DD1SB/ARDF-TX/hardware/2m/review/M5B-E6R2/README.md

# RF2M M5B-E6R2 evaluation review

**GO for five bare evaluation PCBs.** Independent engineering review reported
no concrete blocker for that evaluation scope. Physical RF, thermal and
operational qualification remains **NOT_RUN**. No boards or stencils have been
ordered and no hardware energized. No acceptance tag or production release.

The implementation is published as commit
[`2fff321`](https://github.com/DD1SB/ARDF-TX/commit/2fff32131dd0f7da3c46fef47c04713a55df89d8).
See the [final reproduction/publication record](../../../../docs/M5B_E6R2_FINAL_PUBLICATION.md)
for the fresh verification run and publication scope. Existing implementation
logs and gate records retain their original execution-time provenance.

- [Decision](../../../../docs/M5B_E6R2_REVIEW_DECISION.md),[implementation](../../../../docs/M5B_E6R2_IMPLEMENTATION.md),[first article](../../../../docs/M5B_E6R2_FIRST_ARTICLE_TEST.md).
- [Native project](../../RF2M.kicad_pro),[native snapshot](RF2M-M5B-E6R2-native.zip),[schematic PDF](RF2M.pdf),[netlist](RF2M.net.xml).
- [Fabrication ZIP](fabrication/RF2M-M5B-E6R2_JLCPCB_5boards.zip),[full top stencil](fabrication/RF2M-M5B-E6R2_FULL_TOP_STENCIL.zip),[manufacturing](../../../../docs/M5B_E6R2_MANUFACTURING.md).
- [ERC](ERC.json),[DRC](DRC.rpt),[DFM](JLCPCB-DFM.json),[electrical/native results](verification.json),[final gate record](final-review.json).
- [Complete native3D](RF2M-3D.png),[top](RF2M-3D-top.png),[bottom](RF2M-3D-bottom.png),[mechanical drawings/STEP](mechanical/).
- Population BOMs: [BUCK4S](BOM_BUCK4S.csv),[BOOST2S](BOM_BOOST2S.csv),[TRAIN_ONLY](BOM_TRAIN_ONLY.csv),[shared cooler](shared-heatsink-BOM.csv),[costs](costs.json).
- [Package audit](COMPONENT_FOOTPRINT_AUDIT.md),[simulation](simulation-results.json),[source regressions](source-assembly-regression.json),[ground graph](ground-contact-audit.json).
- [Executed final report](FINAL_REPRODUCTION.md), [reproduce](REPRODUCE.md), [fresh CAM comparison](final-reproduction.json), [repeat ZIP comparison](archive-repack-comparison.json), [SHA256 inventory](SHA256SUMS).

Historical E5/E6/E6R1 evidence is immutable. `baseline-E5-native.zip` captures
starting native sources. Development drafts/failures are retained for audit;
**development/** is not manufacturing data. In particular,the initial mirrored
BD139 draft is deliberately rejected. Use only the final fabrication directory.

The complete new cooling geometry is dimensioned. Upper controller/carrier
views retain the historical study transform and are identified reference
envelopes,not a newly qualified housing. Package plastic/fin details are
simplifications; mounting planes,formed leads,hardware and cutouts are explicit.
