DD1SB/ARDF-TX/hardware/controller/review/M6-L2/README.md

# M6-L2 controller engineering candidate

The authoritative editable design is [CTRL.kicad_pro](../../CTRL.kicad_pro), [root schematic](../../CTRL.kicad_sch), [PCB](../../CTRL.kicad_pcb), its referenced sheets, [symbol library](../../ARDF_CTL.kicad_sym) and [footprint library](../../ARDF_CTL.pretty/). This is a focused revision of the independently reviewed [M6-L1 baseline](../M6-L1/README.md), not a controller architecture replacement. RF80, RF2M and historical reviews are unchanged.

Start with the [engineering GO/HOLD decision](../../../../docs/M6_L2_REVIEW_DECISION.md), [electrical change report](ELECTRICAL-CHANGES.md) and [reproduction commands](REPRODUCE.md). All physical qualification is NOT_RUN. Nothing here constitutes a supplier upload, purchase, manufacturing order, production release or acceptance tag.

| Review subject | Evidence |
|---|---|
| Exact ESP32 identity, all 40 contacts and exposed pad | [Module review](../../../../docs/M6_L2_ESP32_MODULE.md), [manufacturer pin matrix](ESP32-manufacturer-pin-matrix.json), [separate manufacturer DXF comparison](ESP32-footprint-DXF-audit.json) |
| External antenna access, coax routing and conditional RF-board installation | [Mechanical drawing](antenna-mechanical-review.svg), [native anchors and clearances](mechanical-interface.json), [module/mechanical discussion](../../../../docs/M6_L2_ESP32_MODULE.md) |
| Original FoxPro2 references and independently written protocol | [Protocol specification](../../../../docs/M6_L2_FOXPRO2_PROTOCOL.md), [reference URLs/hashes and rights](source-register.json), [third-party notices](../../../../THIRD_PARTY_NOTICES.md) |
| FoxPro connector, analog decision and UART selection | [Hardware review](../../../../docs/M6_L2_FOXPRO2_HARDWARE.md), [TRS cable continuity drawing](FoxPro-TRS-continuity.svg), [native schematic PDF](CTRL-M6-L2.pdf) |
| Electrical fault/logic/current bounds | [Actual resistor-derived calculations](FoxPro-GPIO-electrical-calculations.json), [routed bus/power scenarios](L2-bus-power-layout-calculations.json), [actual connected ground network](native-ground-connectivity.json) |
| Eight-line expansion and strap limitations | [GPIO review](../../../../docs/M6_L2_GPIO_EXPANSION.md), [complete actual MCU allocation](GPIO-allocation.csv), [GPIO45 access limitation](GPIO45-access-limitation.json) |
| Component identities, package terminals and lands | [Native component audit](new-component-footprint-audit.json), [independent critical-map/mutation audit](L2-native-negative-regression.json), [historical pad/copper comparison](L1-L2-change-audit.json) |
| Population and costs | [All-parts BOM](BOM-all.csv), [reference delta](BOM-delta.csv), [48 populations](population-variants.json), [stock/MOQ observations](sourcing-index.json), [quantity costs](costs.json), [MOQ purchase rounding](MOQ-purchase-model.csv), [manufacturing review](../../../../docs/M6_L2_MANUFACTURING.md) |
| Protocol encoder/decoder and timed peer | [C11 core](../../../../firmware/controller_hw/foxpro2.c), [transport](../../../../firmware/controller_hw/foxpro2_transport.c), [independent simulator/tests](../../../../firmware/controller_hw/test_foxpro2.py), [coverage and limits](TEST-COVERAGE.md), [actual host logs](host-test-results.json) |
| Original protection and RF regressions | [Electrical](electrical-regression.json), [protection](protection-regression.json), [USB](USB-ESD-review.json), [RF80](RF80-protocol-regression.json), [RF2M](RF2M-protocol-regression.json), [frozen RF/historical files](frozen-files.json) |
| KiCad checks and standard manufacturing | [CAD counts](CAD-results.json), [ERC](ERC.json), [DRC](DRC.json), [readable DRC](DRC.rpt), [exported connectivity](CTRL.net.xml), [DFM](JLCPCB-DFM.json), [DFM mutations](DFM-regression.json), [standard fabrication profile](JLCPCB-standard-profile.json) |
| Fresh schematic and board views | [Schematic PDF](CTRL-M6-L2.pdf), [top](PCB-top.svg), [mirrored bottom](PCB-bottom.svg), [assembly top](assembly-top.pdf), [mirrored assembly bottom](assembly-bottom.pdf) |
| Real native 3D views | [Base isometric](assembly-3D-isometric.png), [top](assembly-3D-top.png), [bottom](assembly-3D-bottom.png), [both options and LoRa](assembly-3D-BOTH-top.png), [both options underside](assembly-3D-BOTH-bottom.png) |
| Fabrication and stencil | [Gerbers and separate PTH/NPTH drills](fabrication/), [five bare-board ZIP](ARDF_TX_CTRL_M6-L2_JLCPCB_5pcs_BARE.zip), [full top stencil ZIP](ARDF_TX_CTRL_M6-L2_FULL_TOP_STENCIL.zip), [package contents/hashes](fabrication-package-audit.json), [actual export geometry/hole/paste checks](fabrication-geometry-audit.json), [settings](FABRICATION-INSTRUCTIONS.txt) |
| Reproducibility and integrity | [Commands](REPRODUCE.md), [SHA-256 list](SHA256SUMS), [review/source inventory](inventory.json), [compatibility contract](../../../../docs/M6_L2_COMPATIBILITY.md) |

Each `BOM-<RF>__<LoRa>__<option>.csv` and corresponding placement CSV is a specific population. BASE/GPIO retain recovery R300/R301; FOXPRO/BOTH replace them with R302/R303. The open service links are never fitted in standard builds. A no-LoRa/no-FoxPro/no-GPIO build remains valid. FoxPro battery voltage is unavailable for both 2S and 4S; it is not a calibrated voltage-reading mode.

The manufacturer STEP is retrieved into a local reference cache for rendering, not redistributed as MIT material. Existing connector/RTC dimension-only envelopes retain their qualifications. Conditional spacing in the mechanical review is an installation constraint, not measured fit or RF coexistence evidence. Physical qualification of assembled controllers, genuine FoxPro2, antennas, accessories, protection faults, power sequencing and RF/thermal integration is Gate G and remains NOT_RUN.
