DD1SB/ARDF-TX/hardware/2m/review/M5B-E5/README.md

# RF2M M5B-E5 review candidate

**GO for independent evaluation-board review.** Active native authority: `hardware/2m/RF2M.kicad_pcb`. Baseline E4R1 `2f9982c1b72cd97ba4dad6c992143032b309cca7` is archived. This package is for independent engineering review, not manufacturing release.

Read the six `docs/M5B_E5_*.md` reports, review-gates.json, current ERC/DRC/DFM, compact-engineering.json, thermal-model.json and dimensioned mechanical views. `development/` holds intermediate placement/routing analysis and is not a fabrication dataset. The revisioned fabrication ZIP is distinct from native source and stencil archives. Historical controller, RF80 and E4R1 packages are unchanged. All physical tests are NOT_RUN.
