DD1SB/ARDF-TX/hardware/2m/review/M5A-R0/README.md

# M5A-R0 review package

**Electrical candidate only. Not a PCB manufacturing package.**

- [Schematic PDF](RF2M.pdf), [XML netlist](RF2M.net.xml), [actual ERC report](erc.json).
- [Critical physical/function pin assertions](pinout-audit.json), [digital verification](verification.json), [preserved earlier-work hashes](preserved-baseline.json).
- [Itemized6/10/20 variant BOM](RF2M_BOM.csv), [all reference positions](RF2M_positions.csv), [cost classification/totals](costs.json).
- [Explicit power/RF assumptions and arithmetic](calculations.json), [pack/runtime rows](endurance.csv), [ideal behavioral-loop result](am-loop-result.json).
- [Engineering decision](../../../../docs/M5_2M_REVIEW_DECISION.md), [staged physical gates](../../../../docs/M5_2M_TEST_PLAN.md), [source/access log](../../../../docs/M5_2M_SOURCES.md).

The native project is two directories above. Package drawings/large-signal matching/hot SOA and real power/reset/isolation tests remain OPEN. Zero ERC and static logic tests do not demonstrate RF performance, safe analog startup or manufacturing readiness. The checksums generated by the finish script identify these review files, not a hardware release.
