DD1SB/ARDF-TX/hardware/2m/review/M5B-E4R1/stencil/README.md

Q501-onlyF.Paste exportedfromtheactualnativefootprint. Standard0.12mmframeless304stainless,laser-cut. Source5windows+G/Dpaste,nootherparts. NOTpartofbare-PCBfabricationZIP. Verifyalignment/depositsandqualifyprofile/firstjointbeforeenergy. Noorderauthorized.
