DD1SB/ARDF-TX/hardware/80m/review/M3B-E1/routing/README.md

# Local routing provenance

2026-10-14. Initial placement/constrained RF trees, ordinary ground fanout and local FreeRouting2.5.0 session. **Historical routing input**, preceding final KiCad via/clearance/package/metadata corrections. These do not replace the reviewed native PCB or current manufacturing exports. No design was uploaded.

Ground was ignored by the local router and subsequently filled/connected in native KiCad. Final native edits resolved minimum-width neckdowns, one Fox enable tree, ground islands, pin/footprint fields and silkscreen. Rerunning the initial placement is destructive to final routing and is not part of normal verification. See the current board and [review record](../../../../../docs/M3B_PCB_LAYOUT_REVIEW.md).
