DD1SB/ARDF-TX/hardware/2m/review/M5B-E6R2/development/pre-flat-pin-correction/README.md

# REJECTED DRAFT — DO NOT MANUFACTURE

The initial flat BD139 footprint mirrored the ST front-view lead order.
This snapshot is deliberately incorrect negative evidence,not a fabrication candidate.
Only the final review/fabrication directory contains the corrected E6R2 dataset.
The native negative test must reject this saved draft. No board was ordered or energized.
