DD1SB/ARDF-TX/hardware/2m/review/M5B-E5/development/source-evidence/README.md

Fresh native plots,translated coordinate frames E4R1vsE5. Colored mask is opening,not ink. Via automatic mask suppression is not guaranteed closure:one explicit opening exposes16holes. Analysis only,not fabrication data.
