DD1SB/ARDF-TX/hardware/2m/review/M5B-E4/development/evidence/README.md

# Native source-area comparison

E3 files are freshly plotted from the frozen E3 native board; E4 files are
freshly plotted from the active candidate. These are analysis views only.
Colored F.Mask regions are openings, and the white source squares are mask
islands. F.Paste shows the proposed stencil slots. SVG plotting can include
drill marks; the separate Gerber mask/paste layers are authoritative fabrication
artwork. Cropping changes the viewport only. No physical assembly is depicted.
