DD1SB/ARDF-TX/hardware/2m/review/M5B-E3/development/implementation/README.md

# Point-in-time layout implementation aids

Non-final development provenance. These scripts record intermediate E2-to-E3 edits and routing investigations; some intermediate trials were deliberately replaced. They are not a regeneration pipeline and must not be run against the finished board. The final native KiCad design and Git delta are authoritative. Routine checks use the active tools/m5b_e3.py workflow in the review README.
