DD1SB/ARDF-TX/docs/M5B_E5_THERMAL_MECHANICAL.md

# M5B-E5 thermal and mechanical review

The E4R1 source joint is retained: 16 intentionally open source vias + 20 side + 8 end + 54 wing = 98. Source copper is 2.7 × 5 mm, continuous mask opening 2.1 × 5 mm, five paste windows total 6.765 mm², local stainless stencil 0.12 mm. No mask islands, filled/capped vias, guaranteed tenting or solder-fill conduction credit. [Source geometry/assembly gate](../hardware/2m/review/M5B-E5/source-assembly-DFM.json) and the Gerber/drill region audit bind this to the final board. The preserved controlled print/reflow, first-article X-ray and thermal process still applies. Edge inspection cannot establish hidden wet area.

PA cooling retains the 15 × 44 × 10 mm bar and Fischer SK81 100 SA (100 × 100 × 15 mm). The square sink rotates in plane so its channels run along board X; bar/contact/mount coordinates do not change relative to Q501. Sink native bounds X42..142/Y20..120, bar X84.5..99.5/Y28..72; holes H5/H6 (92,32)/(92,68). Extrusion-local taps are (12,50)/(48,50) after rotation. Minimum SK81-to-OD9 corner washer clearance is 12.5 mm. Underside projection is 25.2 mm; lowest Z=−26.8 relative to RF top. No package pressure or mounting load through solder joints.

Same-boundary FVM predictions at 40°C/4 W remain approximately 91°C nominal, 122°C conservative and 138°C with poor joint/contact. The conservative 110°C target remains NOT_MET. The 125°C engineering limit is conditional and physically OPEN. Selected mesh 0.1→0.05 mm changes source-to-bar resistance about 0.021 K/W; the retained 1 K/W allowance is not a bound on physical assembly uncertainty. All 2/3/4/5 W, 25/40°C, barrel 10/15/18/25 µm, solder/TIM/contact and lost-via sensitivities are retained. Fin rotation adds an explicit +0.25 K/W (+1°C at 4 W) sensitivity, not an asserted measurement. A 5°C inlet rise adds 5°C; sink 4→6 K/W adds 8°C. A sealed warm box is unsupported.

The existing Fischer SK10075SA pass heatsink is retained, rotated in its mounting plane: 75 mm along X, 40 mm forward projection, 66 mm along Z. A simple 15 × 20 × 5 mm stock aluminum spacer with one 4 mm clearance hole separates it from D45H11. Native sink box X80.04..155.04/Y−22.5..17.5/Z−20..46 leaves 2.5 mm from the PA sink. Both fin channels are upright with UP=−boardX. Independently support the heavy sink using ordinary brackets; do not hang it from transistor leads. [Manufacturer-authored drawing](https://docs.rs-online.com/0660/0900766b80f3d711.pdf).

Insulate the VPA collector tab with GS220P mica/grease and correctly installed IB6 shoulder hardware, M3×12 with verified thread engagement. At 4.24 W pass loss, catalogue sink 1.9 K/W + 1 K/W interface predicts case 52.3°C at 40°C. Conservative 2.85 + 1.5 K/W predicts 58.4°C. The 60°C case stop is unchanged; raised inlet temperature or 5.5 W can violate it. Hot SOA, sensor contact/lag, interface pressure and airflow remain unqualified.

BD139 remains at its original compact location, with an 8.5 mm body standoff and separately insulated MOD_SINK tab. Fischer FK213SA32 SOT32 catalogue dimensions 25.4 × 18 × 13 mm / 21 K/W support a reserved installed envelope X126.28..144.28/Y22.55..37.55/Z2..42. Verify exact incoming hole pattern, pose, lead protrusion and small-quantity supply before assembly. GS32P and suitable nylon hardware; do not force a TO220 shoulder washer into BD139. At 1.1 W, the conservative case/junction estimates are about 76/87°C, not measurements. [Manufacturer-authored catalogue](https://www.farnell.com/datasheets/17590.pdf).

Native 3D additions are explicitly clearance envelopes, not manufacturer STEP or proof of enclosure fit. Copper, source joint and PA values remain unchanged; real assembly fit and all thermal qualifications remain OPEN.
