DD1SB/ARDF-TX/docs/M5B_E3_THERMAL_MECHANICAL.md

# M5B-E3 thermal, power and mechanical review

The board remains180 ×140 mm with the six original3.2 mm NPTH mounts. The1.6 mm material adds0.8 mm to the clamping stack; do not bend the board to compensate. The source, flange and connector pad mappings remain manufacturer-specific. [critical-package-audit.json](../hardware/2m/review/M5B-E3/critical-package-audit.json) and [engineering-regression.json](../hardware/2m/review/M5B-E3/engineering-regression.json) verify actual nets and copper geometry, with the two documented connector-hole changes.

The PD source remains2.7 ×5 mm copper, electricalGND. Its array is now **32 ordinary0.80/0.30 vias**,4×8 on 0.6 mm pitch, with 1.6/0.3=5.33 nominal aspect ratio. The thermal calculation uses a copper barrel only, k385 W/mK. Parallel barrel resistance is approximately 7.66 K/W at 18 µm plating,9.19 K/W at 15 µm and 13.78 K/W at 10 µm. E2's12 vias at 0.8 mm/25 µm were approximately 7.35 K/W. JLC publishes **18 µm average**, not a guaranteed minimum at every barrel. No minimum-plating negotiation or solder-fill credit is required or claimed.

With RθJC3 K/W, spreading/contact2, TIM1 and sink3.5 K/W,4 W PA heat at 40°C ambient predicts approximately 109°C junction at 18 µm,115°C at 15 µm and 133°C at 10 µm. Thus the barrel model is not thermal qualification. The initial heat budget is≤4 W and engineering junction limit125°C; the real path must be measured on the first staged assembly. At1 W carrier ERP,−1 dBd gain,0.75 dB output loss and 80% AM, average PA-planeRF is approximately 1.98 W. Assumed PA efficiencies35–50% imply approximately 3.67–1.98 W heat;30% would exceed the budget. Measure averageV(t)I(t), RF power and temperature; do not infer efficiency from the ST fixed-supply reference.

Ordinary top mask caps are0.4 mm squares over0.3 mm holes. Segmented source mask/paste allows wetting around them; bottom holes/contact are open. Mask tenting is not a hermetic plug. It is not electrical insulation or proof against solder wicking. Inspect hidden-pad joint quality, mask coverage and solder loss during controlled manual reflow. No filled/capped via process is requested. The14 ×12 mm bottom window x105–119/y49–61 has no foreign copper. Use the retained16 ×44 ×8 mm spreader,0.15–0.25 mm insulatingTIM k≥3 W/mK and dielectric rating≥100 V, a separate GND strap, and the lower sink. Verify flatness, pressure and electrical isolation rather than assuming ideal contact.

D45H11 pin2/tab is liveVPA; BD139 pin2/tab is liveMOD_SINK. Keep their insulated thermal hardware separate from the grounded PA assembly. Retain pass-sink≤3.5 K/W plus≤1 K/W interface, measured case≤60°C, junction≤125°C and the approximately 66°C NTC trip. The insulated NTC must be bonded to the case and strain-relieved. The unchanged no-tone/high-current model can exceed60°C at continuous full power; competition duty and sine-AM average reduce heat, but **continuous full-carrier operation is unqualified**. Do not raise the trip threshold to hide this. Reduce energy and stop if the acceptance limits are exceeded.

[power-native-main-paths.json](../hardware/2m/review/M5B-E3/power-native-main-paths.json) finds actual contacting pad/track/via paths for all11 main-current connections. It charges every traversed track its full80°C resistance and excludes thin long sense branches. Input routes are evaluated at 3 A, regulator/pass rails2 A andPA supply1.8 A. Calculated worst individual connection drop is 0.290 V (VMOD); VPA is 0.130 V. These are conservative full-current bounds, not measured droop. Main routes are predominantly0.7–1.5 mm; the 0.3502 mm boost-pad necks are only1.56/0.77 mm. Their spreading estimate is separated from an inappropriate isolated-long-trace current rule. The all-branch net totals deliberately overcount branches and must not be read as actual full-load heating of sense stubs.

Copper30 µm would raise the 35 µm resistance estimates17%; inspect rail headroom under crest current. The nominal upstream9.02 V,7.2 V crest and series-pass operating point are unchanged. Include shunt, switch, inductor and connector drops separately. The0.068 Ω shunt dissipates0.272 W at 2 A; R413 dissipates0.152 W at 180 mA. Ground-plane resistance is modeled separately; actual return distribution and converter loops require current/temperature qualification.

J101's20 holes are now1.30 mm with 1.90 mm lands. The Wurth61202021621 drawing002.001 specifies square0.64±0.15 mm pins: maximum diagonal1.117 mm, below JLC's1.22 mm minimum finished hole. Its3±0.15 mm tail leaves≥1.09 mm below a1.76 mm board. J301's1.80 mm holes retain existing lands; its nominal1.14 mm square posts have1.612 mm diagonal versus 1.72 mm minimum holes. JST specifies1.6 mm boards. The normalSMA retains1.50/1.70 mm holes; its nominal1.02 mm square shell pins and 3.94 mm tails remain compatible with 1.6 mm construction. Confirm incoming plating/burrs, lead dimensions, fit and polarity before soldering. TRAINMMCX is SMT and thickness-independent.

Retain40 mm corner standoffs, trim leads≤2.5 mm and keep≥5 mm from unrelated conductive fixture parts. Adjust external sink mounting by 0.8 mm; do not use transistor leads as mechanical supports. Cable strain relief and open-bench support remain required. Actual KiCad top/bottom/isometric views were inspected; custom models are dimensional envelopes and three standard connector body models remain absent. The2D package audit is authoritative. No final enclosure fit is claimed. All physical thermal/mechanical tests are **NOT_RUN**.
