DD1SB/ARDF-TX/docs/M3_80M_SCHEMATIC_REVIEW.md

# M3A-R1 — 80 m electrical schematic review

> **2026-10-15 correction notice:** This is a historical pre-E2 record. E1/R1 ST BD140 pin/orientation claims and the E1 manufacturing recommendation are superseded by [M3B-E2 corrections](M3B_E2_CORRECTIONS.md) and the [E2 decision](M3B_E2_REVIEW_DECISION.md). Use E2 assembly/netlist files: Q403 **1B/2C/3E**, illustrated ST face toward **PCB+Y**, and U311 TI DBZ **1K/2REF/3A**. E1 drawings are not build instructions. Frozen historical checks are not current E2 verification.

Date: **2026-10-14**. Revision **M3A-R0**. **Review schematic; no hardware built or measured.** No previous ARDF-TX KiCad schematic existed in this repository; the M2 source designs were research material. The new design is under [hardware/80m](../hardware/80m/README.md), with a [KiCad project](../hardware/80m/RF80.kicad_pro), [editable root schematic](../hardware/80m/RF80.kicad_sch), [PDF](../hardware/80m/review/RF80.pdf), [netlist](../hardware/80m/review/RF80.xml), [electrical manifest](../hardware/80m/RF80.electrical.json) and project symbol/footprint libraries. There is **no PCB file**. Proposed ADR-0010/0011 remain proposed; this mission supplies narrowly scoped schematic authority.

Current control verification: [R1 logic audit](M3A_R1_LOGIC_AUDIT.md), [simplification](M3A_R1_SIMPLIFICATION.md) and [verification](M3A_R1_VERIFICATION.md). R0 is retained in Git tag `m3a-r0`; no prior functional PASS applies to its incorrect timer polarity.

## Sheet map and provenance

| Sheets | Electrical implementation | Reuse / new work |
| --- | --- | --- |
|01 | Dedicated3.3 V controller interface, Si5351A-B-GT,25 MHz crystal, pulls/decoupling/probe pads | OpenARDF local-source principle; crystal mode rather than copied TCXO. No extra MCU, RTC, EEPROM or UI. |
|02–04 | MCP100 POR; dual74HC123 lease/SCL inhibit; real multiunit gates; rearm latch; latched power bits; independent key/path permits | ARDF-TX autonomous fail-off implementation. Spare gates provide shared key-tail logic for both paths. |
|05–07 | Shared fused/reverse-protected pack input; TPS54302 buck, feedback selection, TPS22810 output isolation; reference/comparators; high-side current sense; thermal window | New bounded4S implementation replacing proposed boost+LTC3600. Fox retains input/sense only; watt converter/driver/final DNP. |
|08/08b–09 | LM5134B, IRF610,9+9T bifilar transformer and original elliptic LPF; BD140 drain integrator and shared key-tail inhibit | SignalSlinger/Flex RF core and filter; QCX/W6JL shaping mechanism adapted in transistor/RC/base drive. |
|10–11 | TinyFox three-NAND mechanism with SN74AC00DR buffer, shaped low rail, rail-following NPN clock/mute, separate filter/pad/JST port | TinyFox buffer mechanism with stronger AC-family output drive; our isolation, shaped input,50 Ω filter/calibration and protection are **new unmeasured adaptations**. |

Named global nets provide explicit sheet connections; native resistor/capacitor/transistor/gate symbols and actual pin numbers are used throughout. The extracted library is local and editable. [Attribution/licences](../hardware/80m/LICENSES.md) retain OpenARDF MIT and KiCad library notices; original drawings and firmware are not represented as ARDF-TX work.

## Power and normal PA

J301 supplies an **externally protected** pack; F3011.5 A candidate fuse and SS34 reverse barrier are shared. Only NORMAL population contains the buck, output switch, shunt/sensor, driver, final, shaper, transformer, normal filter and terminal. 4S input12.0/14.4/16.8 V is the normal test envelope. Fox-only uses protected2S1P and the controller's separately regulated3.3 V; it still connects J301 for safe pack sensing. No raw battery pin feeds an ESP32/Si5351/HC00 rail.

TPS54302 supports4.5–28 V input,3 A output and400 kHz switching; **EN maximum7 V** is respected by3.3 V permission and a local pull-down. Its factory250-piece DDCT reel does not impose a customer MOQ: cut tape1 is the observed procurement form. The original candidate SRP5030TA-100M was rejected because3.5 A saturation is below possible converter fault-current peaks. **SRP7050TA-100M** has4 A thermal /7.5 A saturation rating at25°C and69 mΩ maximum DCR. Its manufacturer land pattern is supplied separately. [TI buck](https://www.ti.com/lit/ds/symlink/tps54302.pdf), [Bourns selected inductor](https://www.bourns.com/docs/product-datasheets/srp7050ta.pdf).

At16.8 V/7.96 V/10 µH/400 kHz, nominal ripple is `Vout(1−Vout/Vin)/(L f)=1.05 A pp`; at−20% L it is1.31 A. With an estimated0.85 A output load, peak is1.51 A, well below7.5 A nominal saturation. Actual current-limit tolerance, hot saturation, input diode loss, effective output capacitance and stability remain gates. Two22 µF/25 V output ceramics are **not44 µF guaranteed under bias**. Input10 µF/35 V ceramics and100 nF bypass are named in the BOM. SMBJ17A is provisional: its nominal27.6 V clamp is close to the buck's operating ceiling. Capture real cable transients; no clamp rating substitutes for that test.

Feedback uses typical0.596 V reference,137 kΩ upper and20 kΩ base lower resistor. Latched selections connect91 kΩ or24.9 kΩ in parallel with the lower resistor:

| PWR1/PWR0 sampled at arm | Initial pre-shaper rail | Intended calibrated output |
| --- | ---: | --- |
|00 |4.679 V | Sprint0.85 W initially; independently calibrate within0.3–1 W |
|01 |5.576 V | Extended Classic1.2 W |
|10 |7.958 V | Full Classic3 W; calibration aim3.15 W so uncertainty can establish≥3 W |
|11 | Buck would be8.855 V from the resistor network | **Hardware fault; no operation permitted** |

These are calculated voltages, **not predicted measured RF powers**. Calibrate fixed E96 feedback resistors per mode, with driver≥4.0 V and permitted pre-shaper rail≤8.6 V. Power depends on drive, shaper drop, transformer, filter, load and device temperature; no linear-voltage assumption. Supply selection is held until rearm, preventing GPIO glitches from changing an armed PA rail. Driver supply is unshaped; drain is shaped. LM5134 **B**, not A, accepts3.3 V with2.4 V VIH;4–12.6 V operating limit applies even though14 V is the absolute maximum. Its input rating is independent of VDD; local47 kΩ pulls prevent a floating input when the source disappears.

TPS22810 input must remain≤18 V (20 V absolute), including failed-buck/input transients. The28 V passive stress model is outside that system rating and cannot qualify the provisional input clamp or upstream parts. This coordination is OPEN before unrestricted4S. TPS22810 after the buck provides an actual rail-disconnect element independently of buck switching state. It is **not reverse-blocking**: external rail injection is prohibited. QOD through100 Ω discharges the isolated reservoir; CT4.7 nF is an initial slew value to accommodate the new driver reservoir. Startup inrush and rise time must be measured. Retuning/faults mute the driver and remove both enables. Safe driver voltage during a converter-short trip remains unmeasured: the OV threshold is about8.97 V, and fault testing must keep LM5134 VDD≤12.6 V. Current-limited power tests precede unrestricted4S operation.

The shared key-tail receives raw CW_KEY, while captured ARM_ACCEPT requires KEY low at the raw ARM edge. Driver INB is pulled to VDRV and requires both PA_PERMIT and KEY_TAIL through series sinks; Fox mute requires FOX_PERMIT and that same tail. R453 is now100 Ω, rather than1 kΩ, to clamp the unarmed tail decisively. Qualify10–80 ms hold and3–8 ms RF edges; no measured edge exists. Fresh ARM low≥20 ms and first KEY≥250 ms after ARM remain required. Captured path/withdrawal reset prevents a tail passing to the other branch.

R4104.7 Ω/1 W and C40447 µF/25 V Panasonic25SVPF47M provide driver dV/dt limitation, with fast bypass remaining on VDRV. The manufacturer's C6 lands match the native KiCad capacitor pattern. [Actual passive simulation](M3A_R1_DRIVER_SIMULATION.json) gives12.107 V maximum for an imposed28 V/20 µs fault and0.5 Ω ESR; slower isolation or higher ESR fails. Neither comparator/load-switch timing nor full clamp/thermal behavior is proven. Require measured VDRV≤12.6 V, isolation≤20 µs, ESR≤0.5 Ω over0–50°C and pulse-resistor qualification before unrestricted4S. Low-current sink switches are BSS138BK with±20 V gate tolerance; Q404's ≈70 mA base sink remains DMN2056U. R409 grounds the driver stack midpoint.

## Drain shaping, current and thermal calculations

BD140 emitter=VPA_LOAD, collector=VPA_SHAPED, base=SHAPE_BASE;100 Ω/1 W key resistor to a logic-level DMN2056U sink,1 kΩ emitter-base pull-up and22 µF nonpolar integration capacitor. This implements the documented PNP integrator; its new capacitance and operating point require measured3–8 ms RF edges. No large PA reservoir follows the shaper. The driver decoupling is upstream.

For3.15 W, assumed60% drain efficiency and7.6 V drain give0.691 A. At7.96 V rail, pessimistic1.0 V VBE gives `(7.96−1.0)/100−1.0/1000=68.6 mA` base drive: forced beta10.1. Key resistor dissipation is0.484 W; at8.98 V the calculation is0.637 W. Its2512/1 W rating must still be temperature-derated. At an assumed0.5 V pass drop, steady shaper loss is0.346 W. A resistive edge surrogate gives approximately `Vs I/4=1.38 W` peak; this is **not the switching-PA SOA trajectory**. Measure collector current and VCE during every edge/mismatch, apply hot repetitive SOA, and bound junction temperature. ST BD140 has80 V/1.5 A limits,10 K/W junction-case and100 K/W junction-ambient reference figures; at0.5 W/50°C the simple free-air estimate is100°C. It is not a thermal pass.

The referenceMPS751 alternative would have less useful thermal margin and weaker pulse evidence; it is not populated. The 2 m modulator remains untouched. [ST BD140 datasheet](https://www.st.com/resource/en/datasheet/bd140.pdf).

R3300.05 Ω high-side shunt and INA180A1 gain20 produce1 V/A. A filtered comparator trips nominal 1.251 A. The input pair uses 10 Ω/10 nF to reject RF; a 30 kΩ/10 kΩ output divider produces 0.25 V/A, and its 1 nF capacitor gives 7.5 µs filtering. The independently divided trip reference is 0.312657 V. Require≤100 µs complete fault mute, or a faster limit if hot SOA demands it. Grounded instruments cannot bypass this high-side shunt. Sensor pins are **1 OUT,2 GND,3 IN+,4 IN−,5 VS**. The T packaging is selected because the cheaper R package had contradictory/OOS stock. Price at ten remains estimated. [INA180](https://www.ti.com/lit/ds/symlink/ina180.pdf).

TL431A provides the regulated 2.495 V reference, biased from 3.3 V through 180 Ω. Voltage and current thresholds each have independent dividers from this node. Pack and PA signals divide by 31.9, keeping them below 0.878 V even at 28 V. Nominal protected-input UV thresholds are 5.810 V common and 11.070 V for the 4S backstop; PA OV is 8.973 V. Add the measured reverse-barrier drop to obtain raw-pack thresholds. These are backstops, not replacements for controller operational endpoints of 6.0/12.0 V or external cell-level BMS protection. The thermal hub uses 1.5 kΩ/1 kΩ and is about 0.897–0.940 V under its varying loads; both thermal comparisons use ratios from that same hub. The design calculation establishes at least 2.10 mA TL431 cathode current at the stated worst low supply after branch loads, and comparator inputs below 0.941 V versus the conservative 1.135 V common-mode ceiling at 3.135 V supply. No capacitor is placed directly across the TL431. Reference stability, offsets, input bias and tolerance remain physical gates. See [reproducible calculations](M3_80M_CALCULATIONS.json). Thermal divider10 kΩ/NTC10 kΩ (B25/50=3380 K; approximate trip calculation uses3434 K25/85 reference) with60.4 kΩ/10 kΩ reference gives nominal case trip near80°C. Second comparator detects an open sensor; a short trips hot. **TH301 must be thermally attached to the insulated IRF610 case**, not merely placed somewhere on the board. Its wire/attachment and thermal lag are unquoted ancillary work. Fox-only omits U312 and all watt references/thermal branches; R336 is removed. U314 retains independent common UV; R228 clamps the unused PA guard low and R348/R349 bias its unused comparator half. The full population omits those three Fox-only links.

Aim heat sink **≤10 K/W**, insulated from the drain tab, and measure TJ≤110°C at50°C ambient. The €2 sink/interface/attachment provision is an estimate; exact mechanical MPN/SOA sign-off remains open. A minimum duty cycle does not remove continuous beacon or edge stress.

## Windings and independent antennas

| Part | Reproducible starting recipe / connections | Qualification |
| --- | --- | --- |
| T401 | **Amidon FT-50A-43**, material43,12.7 mm OD/7.92 mm ID/6.35 mm high; AL480 nH/turn² supplier data. Two24 cm lengths AWG24 enameled Cu (~0.51 mm bare), laid bifilar, **9 core passages each**. Identify Astart1, Afinish2, Bstart3, Bfinish4; join2+3 at drain,1 at shaped supply,4 at RF_RAW. Series-aiding; effective2:1 RF voltage /4:1 impedance transform. Each winding nominal38.9 µH. | Verify continuity, start marks and polarity at low voltage before connecting PA. Correct core is the taller **50A**, not unverified50-43 or material61. Source [Amidon](https://www.amidoncorp.com/ft-50a-43/); small-quantity material price/stock is OPEN. |
| L410/L411 | **Micrometals T60-2** material2 red/clear iron powder,20 passages AWG24; author's46 cm length is a start, provide leads. OD15.24/15.75 mm coated maximum; ID8.53/8.03 mm minimum; height5.94/6.45 mm max. AL6.5 nH gives2.60 µH theoretical; reference labels2.7 µH. | Measure actual inductance/Q and filter response, adjust turns only from measurements. [Manufacturer](https://datasheets.micrometals.com/T60-2-DataSheet.pdf), [TME sourcing route](https://www.tme.eu/en/details/t60-2/ring-ferrites/micrometals/). Own formed-lead footprint; dry-fit required. |
| L510/L511 | **Bourns78F2R7J-RC**, purchased axial2.7 µH±5%, ferrite DR core/wound copper. Body≤7.11×2.79 mm; lead0.51 mm;10.16 mm formed lead pitch. | Published Q≥50 at7.9 MHz, SRF≥95 MHz/DCR≤0.28 Ω; **3.55 MHz loss unmeasured**. Low-power branch only. [Manufacturer](https://www.bourns.com/docs/product-datasheets/78f_series.pdf). |

Normal elliptic LPF retains series470 nF, two2.7 µH, shunts1100/1800/1100 pF and91 pF **across the second coil**. Each1100 pF is1000+100 pF. C0G100 V parts are named;470 nF100 V X7R block needs RF loss/voltage verification. It is not a generic Butterworth filter. Coil axes/spacing, shielding and drain-loop geometry remain evaluation-layout requirements.

Long antenna: J401 defined50 Ω plane → separate L-match/loading accessory → long vertical and defined counterpoise;15–50 µH variometer is a DF1FO starting precedent, **not a final universal match**. Compact: J502 → dedicated loading/coupling accessory → approximately30 cm radiator and explicitly recorded compact return. TinyFox100 µH +1.6–15 pF is a reference starting network, not a validated30 cm/50 Ω solution. Effective5–15 pF requires roughly402–134 µH for simple resonance at3.55 MHz; tap/coupling and coil loss must match the actual enclosure/pack. Exact accessory winding/return dimensions remain **OPEN**, honestly outside the completed RF-board winding recipes. Do not send normal RF into it or substitute a Classic wire. Retain8.38/10.25 EUR compact/long accessory budgets pending measurements and quotations.

## Foxoring branch and its limits

R50127 Ω/1 W feeds the PNP integrator; Q501MMBT3906 shapes VFOX. Q503MMBT3904 collector pull-up to VFOX and a Schottky Baker clamp translate the clock, so the AC00 clock input follows its own supply rather than injecting3.3 V during the ramp. R50510 kΩ limits source drive to roughly0.26 mA; Si5351's smallest2 mA drive setting is adequate in this **calculation**, loaded edge quality remains a test. RC and saturation delay affect duty cycle.

Three SN74AC00DR NAND outputs have **individual 22 Ω ballast**, rather than directly tied push-pull pins, and own DC block/elliptic filter/calibration pi pad. Gate enable follows VFOX through Q504; both Fox permission and a genuine shared key-tail are required. This independently masks RF during startup and even if the shaping transistor shorts. The spare gate's inputs are grounded. No watt output selector or relay exists. The PA converter, driver and final are entirely unnecessary in Fox-only population.

The HC00 option was evaluated at 3.3 V. Its CMOS input thresholds and low input-current requirements are compatible, but its small-current output guarantees and the loss of shaped rail voltage leave little conducted-power margin. For example, a 3.0 V rail, 20 Ω internal resistance per gate, original 47 Ω ballast, 0.7 dB filter loss and a 2.4 dB pad give only about **8.5 mW**. That internal resistance is an assumption, not a datasheet guarantee. Therefore select **SN74AC00DR**, retaining the TinyFox NAND mechanism but adapting the drive family, ballast and fixed pad. It costs €0.278 versus €0.103 for HC00 at ten. The DR reel/cut-tape device is Active; the D tube SKU's end-of-life listing is not substituted. [TI AC00 datasheet](https://www.ti.com/lit/ds/symlink/sn74ac00.pdf), [current price/stock](https://eu.mouser.com/en/ProductDetail/Texas-Instruments/SN74AC00DR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).

AC00 recommends 2–6 V supply and ±12 mA output operation at 3 V, with 2.1/0.9 V input thresholds. Rail-following inputs address the level requirement. Input and output conditions below 2 V during shaping remain uncharacterized. Measure the loaded amplitude, each gate current, clock edges, envelope and supply ramp; do not infer nominal RF power from drive-current ratings.

For the selected branch, R501 is **27 Ω/1 W**, ballast is **22 Ω per gate**, and the starting 50 Ω pi pad is **750 Ω shunts /6.8 Ω series**, about **1.17 dB** ideally. Fixed calibration may increase attenuation; **at least 1 dB** is required by the fault budget. A 2.6 V rail and assumed 20 Ω internal resistance per gate give about **10.8 mW after 0.7 dB filter loss and the starting pad**. This is a feasibility calculation, not a guarantee: rail drop, actual output impedance, filter input reactance and gate-current peaks need measurements. If 9–11 mW cannot be achieved with all ratings/shaping/fault limits, stop for the retained BJT-buffer fallback review; do not silently raise the supply or reuse the watt PA.

With the valid controller maximum 3.6 V, the maximum extractable power through 27 Ω is `V²/(4R)=120 mW`. Two conservative input-drive budgets add `2×V²/10k=2.6 mW`; minimum 1 dB available-power attenuation gives **less than 98.4 mW available fault power**, including −1% feed/input resistor tolerance. Qualify the pad loss and tolerance across the fault spectrum/load cases, not just nominal matched S21. This is not nominal 10 mW, a spectral result, or a claim that a damaged logic chip survives every short. The compact network must withstand **100 mW fault input plus measured stored-energy transients**. The 1 W feed resistor withstands `3.6²/27=0.48 W` under a short. Pad bypass, raw battery injection into J101 and deliberately miswired external adapters are outside this bound and prohibited. Normal PA copper cannot route to J502; layout/near-field isolation still needs testing. An RF detector is omitted conditionally because of this bounded source, independent RF mute and separate port; external calibration and physical fault tests remain mandatory.

## Interface and fail-off contract

J101 keyed2×8 IDC, candidate Wurth61201621621; pinout viewed by numbered PCB pads:

| Pin | Function | Pin | Function |
| ---: | --- | ---: | --- |
|1 | V3V3 bounded3.3 V |2 | logic ground |
|3 | SCL open drain |4 | logic ground |
|5 | SDA open drain |6 | LEASE20 Hz waveform, rising edges every50 ms |
|7 | ARM |8 | CW_KEY |
|9 | PA_REQ |10 | FOX_REQ |
|11 | PWR0 |12 | PWR1 |
|13 | MUTE_N, low inhibits |14 | FAULT_N open drain |
|15 | PACK4_OK from controller validated pack/voltage |16 | logic ground |

J301 VH2:1 pack positive,2 dedicated power return. J401 screw terminal:1 normal RF,2 RF return. J502 XH3:1 Fox RF,2 compact return,3 accessory-presence short to2. Dissimilar shells prevent direct mating. J502 does not guarantee sequential contacts: **disarm before plugging**; its presence trips normal permission independently. No raw voltage travels in the IDC harness. Proposed logic budget≤100 mA steady/200 mA startup, normal pack branch≤1.5 A; these are connector/fixture requirements, not measured currents. Dedicated raw return and short RF current loops meet at a controlled ground point; measure any current diverted through the control-ground harness.

One dedicated HF I²C bus is preferred: each module's Si5351 has0x60, and any local SCL activity trips HF. Do not assume unrestricted shared HF/VHF bus traffic while HF is armed. No I²C isolation switch is needed **on this RF module** because all source/control logic uses the same always-powered3.3 V domain; controller/fixture must not drive bus lines when that domain is absent. The source powers down PLL/outputs during idle when validated; no unmeasured standby saving is booked.

HC123 physical Q13 now supplies LEASE_OK; /Q12 supplies BUS_HOLDOFF_N. A spare HC74 witness blocks reset-release false progress. BUS_QUIET additionally requires POR_N and SCL/SDA high. Timing capacitors connect to grounded CEXT6/14; D201/D202 retain power-down clamps. R201330 kΩ/1 µF gives132.3–220.0 ms in the assumed K/RC range;47 kΩ/100 nF bus holdoff gives1.884–3.133 ms. These bounds are not manufacturer worst-case guarantees.

One HC174 captures path/power/key-low acceptance at raw ARM; health faults asynchronously clear it. A delayed HC74 clock can only arm a surviving accepted context. Mode changes while armed are ignored; invalid11, conflicting requests, selected-request withdrawal and any common/request-conditioned health loss clear acceptance. Restoration with ARM high cannot rearm in the pin-derived model. PA trips share open collectors, so Fox can omit watt monitoring. Asynchronous reset pulse widths/races, diode margins, collapse/backpower and physical fail-off remain OPEN. [Exact physical pins, equations and state table](M3A_R1_LOGIC_AUDIT.md) supersede R0 control descriptions.

Startup:3.3 V stable/POR complete; ARM/KEY/requests/MUTE low; configure/verify Si5351; choose path/mode and validated pack; ensure both dummy loads/accessories appropriate; MUTE high, regular software-progress lease, ARM low≥20 ms then high; wait≥250 ms before keying. Key-up retains the source/driver until the measured envelope tail completes. Before retune, disarm/MUTE low; any unannounced SCL transition also trips hardware. Emergency shutdown can truncate an edge. Communications loss is covered by the **progress lease contract**; hardware detects SCL activity but does not authenticate bus transactions/frequency readback.

## Remaining electrical decisions

Before an evaluation PCB: close active-part/local stock and passive voltage/footprint reviews; sign off transformer winding polarity; confirm bulk effective capacitance/stability and OV transient protection calculations; attach the NTC reliably; review3–8 ms shaping starts on both branches and the Fox current/output uncertainty. Generic schematic ERC cannot close these. Low-cost external loads, current logger, probes and spectrum instruments replace onboard meters; the [test plan](M3_80M_TEST_PLAN.md) specifies the physical go/no-go gates.
