DD1SB/ARDF-TX/docs/M2_POWER_ARCHITECTURE_CHECKS.md

# Power-review documentation and arithmetic checks

Date: **2026-10-14**. **Documentation/calculation checks only; all hardware gates NOT RUN.** The five requested review documents, dated source/requirement supplements, candidate workbook and proposed ADR-0011 are complete. Earlier workbooks, simulations and accepted ADR bodies are preserved, with explicit dated annotations where the user changed the requirement.

| Check | Result |
| --- | --- |
| `python3 tools/m1_analysis.py --check` | PASS: local document links, 73 traced requirements, original M1 deliverables and arithmetic. Parser now catches whitespace in local link destinations. |
| `python3 tools/m1_costs.py --check` | PASS: preserved 117-line/68-part M1 catalog and 6/10/20 baskets. |
| `python3 tools/m2_rf_analysis.py --check` | PASS: preserved eight AM calculation cases; not a transistor simulation. |
| `python3 tools/m2_system_costs.py --check` | PASS: preserved 48 original M2 material baskets. |
| `python3 tools/m2_checks.py` | PASS: preserved preparation requirements/gates and existing ideal-filter simulation consistency. No RF gate passed. |
| `python3 tools/foxoring_costs.py --check` | PASS: original ten/twenty-unit audit and EUR48.05 historical bridge preserved. |
| `python3 tools/m2_80m_analysis.py --check` | PASS: preserved 16 reference/proposal baskets, ten HF profiles and six comparison deliverables. |
| `python3 tools/m2_power_architecture.py --check` | PASS: 70 profiles, all six packs and four capacity/energy cases, 48 complete fleet baskets, 63 standalone board/pack baskets; generated files, manual board/pack summaries, equal-cell energy, manufacturer minimum Wh and AM-headroom assertions. |

The source reachability command was:

```bash
python3 tools/m1_analysis.py --external-links --link-date 2026-10-14 --link-report docs/M2_POWER_EXTERNAL_LINKS.json --link-scope docs/M2_POWER_ARCHITECTURE_SOURCES.md
```

[Separate dated report](M2_POWER_EXTERNAL_LINKS.json): **36 requested URLs, 28 HTTP200, eight unresolved**. Restricted requests: Littelfuse mobile PDF, DigiKey AP63200, DigiKey TPS54302 and Microchip MCP1703A. Timeouts: LTC3600, Micro Crystal RTC, ST D45H11 and ST PD55008-E. Browser/manufacturer evidence available through other retrievals is distinguished in [the source register](M2_POWER_ARCHITECTURE_SOURCES.md); failed direct requests are not erased or replaced by guesses. A 200 response/first 1024 bytes does not verify stock, document contents or regulatory compliance. Earlier full-repository source audit remains unchanged.

No battery discharge experiment, RF power/PEP, envelope/gain, thermal/SOA, spectrum, pack-fault or field-range measurement exists for the derived design. No new battery/RF simulation was run. [P1–P6](M2_POWER_ARCHITECTURE_DECISION.md) and [H0–H9](M2_80M_VALIDATION_GATES.md) remain required physical tests. No project CAD, Gerber, order, fabrication or production firmware was created.
