DD1SB/ARDF-TX/docs/M2_POWER_ARCHITECTURE_SOURCES.md

# Power reassessment: dated evidence register

Retrieved **2026-10-14** unless an earlier observation is explicitly retained. OBSERVED prices are source observations, often indexed/cached, not reserved baskets or qualified parts. ESTIMATE and RESERVE are not supplier prices. No original datasheet/CAD artwork is redistributed in this reassessment. [Earlier RF schematic provenance](M2_80M_REFERENCE_COMPARISON.md), [M2 sources](M2_SOURCES.md) and [Fox audit sources](FOXORING_COST_SOURCES.md) remain intact.

| ID | Primary source / variant | Verified facts used | Missing evidence / access boundary |
| --- | --- | --- | --- |
| PWR-RULE | [Official IARU index](https://www.iaru-r1.org/about-us/committees-and-working-groups/ardf/documents/ardf-rules/); [2025 Part B](https://www.iaru-r1.org/wp-content/uploads/2025/01/ARDF-Rules_B_2025.pdf), pp.10,14–15,17 | Index still lists 2025; T2.6/T2.8/S6/FT2.6/F27.3 power/mode/antenna limits reread. T2.2 requires common parameters and T2.4 off-slot silence. | Legal authorization remains national. ERP carrier convention and receiver field protocol remain organiser inputs. No IARU battery/endurance rule invented. |
| PWR-25R | [Samsung manufacturer document via NKON](https://www.nkon.nl/en/amfile/file/download/file/229/product/1754/), version 1.0,2014, §§3/7 | 2.45 Ah minimum at 10 A to 2.5 V;2.50 Ah at 0.2C;20A25°C; AC1kHz initial impedance≤18mΩ; temperature and 250-cycle 60% condition. | Browser text retrieved. Direct curl 403; no proprietary PDF copied to repository. Lot/DC resistance/3.0 V energy unknown. |
| PWR-25R-PRICE | [NKON new 25R](https://www.nkon.nl/en/samsung-18650-inr18650-25r.html), product 1754/EAN8438493100709 | NetEUR1.94 single,1.73≥10,1.64≥50,1.56≥100,1.48≥200; supplier welded U/Z tagsEUR0.62/cell. Shows 08-10-2026 date and add-to-cart. | Stock quantity not guaranteed. Tags add average 3 business days, possibly 2weeks. Old/reclaimed clearance excluded. |
| PWR-M35A | [Molicel M35A V2-80096](https://www.molicel.com/wp-content/uploads/INR18650M35A-V2-80096.pdf); [same manufacturer document via NKON](https://www.nkon.nl/en/amfile/file/download/file/126/product/4518/) | 3.35 Ah minimum/3.50 Ah typical,10 A maximum discharge,1.7 A standard/maximum charge,2.5 V discharge endpoint; temperature limits. | Both PDFs readable. DC resistance and cycling requirements not established from this one-page sheet; no claim of equivalent 25R current/temperature/life. |
| PWR-M35A-PRICE | [NKON M35A](https://www.nkon.nl/en/molicel-inr18650-m35a-3500mah-10a.html), product 4518/EAN7417940530154 | In stock; netEUR3.30 single,3.16≥30,3.00≥100; U/Z tagsEUR0.62. | No invented ten-piece discount. Total same-cell demand across one fleet determines break. Stock not reserved. |
| PWR-ALT-CELL | [NKON GA Green product 4519](https://www.nkon.nl/en/catalog/product/view/id/4519); [35E](https://www.nkon.nl/en/samsung-inr18650-35e.html) | GA stock listing and 3.45 Ah/10 A supplier class, net singleEUR3.21 indexed. Existing 35E direct out-of-stock audit retained. | GA manufacturer/lot/full breaks unresolved; no costed substitution.35E/reclaimed prices not used as available production basis. |
| PWR-BUCK | [TI TPS54302 Rev.C, March 2026](https://www.ti.com/lit/ds/symlink/tps54302.pdf); [product](https://www.ti.com/product/TPS54302) | Active;4.5–28 V,3 A,400 kHz,45 µA typical quiescent/2 µA shutdown, internal compensation/soft start/pulse skip. EN absolute maximum 7 V, floating EN can start. | Readable primary PDF. Efficiency/dropout/RF noise on our hardware unknown. DDCT/DDCR are reel packaging variants, not forced reel customerMOQ. |
| PWR-BUCK-PRICE | [Mouser 595-TPS54302DDCT](https://www.mouser.de/ProductDetail/Texas-Instruments/TPS54302DDCT?qs=zEmsApcVOkXGTx6CMk2KtQ%3D%3D); [DDCR](https://www.mouser.de/de/ProductDetail/Texas-Instruments/TPS54302DDCR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) | DDCT indexedEUR1.59/1.18/1.08 at 1/10/25, stock 7661 in older cache; newer family search 4639. DDCR cheaperEUR0.86@10 but incoming 31Dec 2026/May 2027 listing. | DDCT is priced candidate, **live basket OPEN**. DigiKey 296-44542-1-ND [page](https://www.digikey.ie/en/products/detail/texas-instruments/TPS54302DDCT/6123254) found; DE page cache miss, no new quote. No cheap backorder or factoryreelMOQ substituted. |
| PWR-AP | [Diodes AP63200/01/03/05 DS41326Rev 3-2](https://www.diodes.com/assets/Datasheets/AP63200-AP63201-AP63203-AP63205.pdf); [MouserAP63200](https://www.mouser.de/de/ProductDetail/Diodes-Incorporated/AP63200WU-7?qs=u16ybLDytRZrauj7eRB5tw%3D%3D); [DigiKey](https://www.digikey.de/de/products/detail/diodes-incorporated/AP63200WU-7/9858423) | 3.8–32 V/2 A; AP63200 adjustable 500 kHz,03 fixed 3.3V1.1 MHz. Indexed prices .501@10Mouser / .446@10DigiKey. | Mouser 0 stock with late 2026 incoming. DigiKey oldAT index 1619 conflicts with directDE out-of-stock. Not preferred currently buildable cost basis. No package pin compatibility assumed. |
| PWR-OLD-REG | [TPS62160](https://www.ti.com/lit/ds/symlink/tps62160.pdf); [LTC3600](https://www.analog.com/media/en/technical-documentation/data-sheets/3600fd.pdf); [MCP1703A](https://www.microchip.com/en-us/product/MCP1703A) | Input operating ceilings 17 V /15 V /16 V respectively. | Original regulators cannot be silently carried onto raw 4S; LTC also needs bounded old 2S boost output. Readable manufacturer sources. |
| PWR-FET | [Nexperia PMPB20XPE](https://assets.nexperia.com/documents/data-sheet/PMPB20XPE.pdf); [Diodes DMP4015SPS manufacturer datasheet hosted by Mouser](https://www.mouser.com/datasheet/2/115/DMP4015SPS-219285.pdf) | Original raw FET20V lacks transient margin. Existing DMP candidate is 40 V with package/rating review retained. | Original exact DMP suffix/lifecycle and measured hot current/gate-clamp limits must close. DMP4015SPSW is a different variant; its data not silently used to qualifySPS-13. |
| PWR-TVS | [Littelfuse SMBJ series](https://m.littelfuse.com/~/media/electronics/datasheets/tvs_diodes/littelfuse_tvs_diode_smbj_datasheet.pdf.pdf) | SMBJ17A:17 V standoff,18.9–20.9 V breakdown,27.6 V clamp at specified pulse test. | Exact-vendor cost estimatedEUR0.35, not observed quote. Clamp/parasitics/charger tolerance must satisfy 28 V buck operation. SMBJ8.5A removed, not paralleled. |
| PWR-PA | [ST PD55008-E Rev 2](https://www.st.com/resource/en/datasheet/pd55008-e.pdf), pp.3–4 | Drain breakdown 40 V, gate±20 V;8 W/15–17dB gain at 500 MHz,12.5 V,150 mA; output changes with voltage in manufacturer plots. | Correct -e primary PDF browser-readable. Non-e direct PDF failed HTTP/2; no numerical 144 MHz AM/gain or 16.8 V performance guarantee. |
| PWR-AM | [ST D45H11](https://www.st.com/resource/en/datasheet/d45h11.pdf); [existing detailed review](M2_VHF_RF_REVIEW.md) | Exact-vendor SOA/thermal requirements and feedback concept retained. | Hot DC SOA digitization, loop stability, helper heat, MMIC drive margin still OPEN. No simulation/measurement replaced by ratings. |
| PWR-PCM4 | [LaskaKit LA123070](https://www.laskakit.cz/en/ochrana-li-ion-baterie-4s-30a/) | NetEUR1.91, indexed 27 stock; vendorOV4.25±.05 V,UV 2.54 V,OC35A, S-8254 A/AOD403 references. | Exact IC suffix/threshold/lot/balancing unknown. **Balancing not established**; reserve and balance allowance added.35 A claim is not our fault limit. |
| PWR-CHARGE4 | [LaskaKit LA123020C,16.8V2A](https://www.laskakit.cz/en/nabijecka-li-ion-baterii-do-zasuvky-4s-16-8v-2a/); [LA123103B,4 A](https://www.laskakit.cz/en/nabijecka-li-ion-baterii-do-zasuvky-4s-16-8v-4a/) |2 A comparatorEUR8.07 net/stock 1;4 A comparatorEUR19.96 net/stock 8. Seller calls CC-CV; no balancing. |2 A exceeds M35A 1P maximum charge 1.7 A.4 A not universal cell-safe. Qualified 1A16.8 V charger budgetEUR20 is an **estimate**, accuracy/termination/protection OPEN. |
| PWR-RTC/LORA | [MicroCrystal RV-3032](https://www.microcrystal.com/en/products/real-time-clock-rtc-modules/rv-3032-c7); [Semtech primary RF selection guide](https://www.semtech.com/uploads/design-support/SG-SEMTECH-WIRELESSRF.pdf) | RTC backup switchover and typical 160 nA timekeeping; SX1262 bare-chip typicalRX4.6 mA. | Neither establishes complete controller/Silicontra module current, hold-up leakage or lawful LoRa airtime. Exact Silicontra MPN remains OPEN. |
| PWR-REFS | [ON7YD](https://www.qsl.net/on7yd/atx80.htm), [SignalSlinger](https://github.com/OpenARDF/SignalSlinger), [FlexFox80](https://github.com/OpenARDF/FlexFox80), [QCX](https://qrp-labs.com/qcx.html), [DF1FO](https://df1fo.darc.de/index.html#80mTX), [HG0HK](https://ardf.hu/content/technika/UTX80m/andras_paal.html) | Actual previously pinned schematics/BOMs and publisher measurement conditions retained from completed 80 m milestone. | No new 4S hardware test exists. HG0HK circuit/licence still incomplete; no invented adaptation. Source links/dates/versions remain in earlier evidence matrix. |

Price treatment: use sources' explicit net EUR where shown; retain M1/M2 distributor exVAT planning convention. Supplier checkout VAT, freight and stock can differ. Illustrative German 19% VAT is separate, not attributed to every foreign source. External reachability checks test status/first bytes, not actual stock, authenticity, safe thresholds or license rights.
