DD1SB/ARDF-TX/docs/M2_POWER_ARCHITECTURE_TABLES.md

# Reproducible power and material tables

Date: 2026-10-14. **MODELED / ESTIMATED, NOT MEASURED.**

Generated by `python3 tools/m2_power_architecture.py --write`. Read the five power-review documents for qualifications.

## Profiles and minimum modeled packs

| Profile | Mean W | 12h Wh | 24h Wh | 2.45Ah minimum 12 / 24h | 3.35Ah minimum 12 / 24h | Energy window |
| --- | ---: | ---: | ---: | --- | --- | ---: |
| HF 1W 2S economy | 0.652 | 7.82 | 15.64 | 2S1P / 2S2P | 2S1P / 2S2P | 1.00 |
| HF 1.2W 2S economy | 0.692 | 8.30 | 16.61 | 2S1P / 2S2P | 2S1P / 2S2P | 1.00 |
| Sprint 0.3W 2S economy | 0.341 | 4.09 | 8.17 | 2S1P / 2S1P | 2S1P / 2S1P | 1.00 |
| Sprint 0.5W 2S economy | 0.429 | 5.15 | 10.31 | 2S1P / 2S1P | 2S1P / 2S1P | 1.00 |
| Sprint 0.85W 2S economy | 0.585 | 7.02 | 14.04 | 2S1P / 2S2P | 2S1P / 2S1P | 1.00 |
| Sprint 1W 2S economy | 0.652 | 7.82 | 15.64 | 2S1P / 2S2P | 2S1P / 2S2P | 1.00 |
| HF 1W 2S high | 0.733 | 8.80 | 17.59 | 2S1P / 2S2P | 2S1P / 2S2P | 1.00 |
| HF 1.2W 2S high | 0.781 | 9.37 | 18.73 | 2S1P / 2S2P | 2S1P / 2S2P | 1.00 |
| HF 1.5W 2S high | 0.923 | 11.08 | 22.15 | 2S1P / 2S2P | 2S1P / 2S2P | 1.00 |
| HF 2W 2S high | 1.100 | 13.20 | 26.41 | 2S2P / 2S3P | 2S1P / 2S2P | 1.00 |
| HF 3W 2S high | 1.536 | 18.43 | 36.87 | 2S2P / 2S4P | 2S2P / 2S3P | 1.00 |
| HF 5W 2S high | 2.431 | 29.17 | 58.35 | 2S3P / NONE | 2S2P / 2S4P | 1.00 |
| Sprint 0.3W 2S high | 0.367 | 4.40 | 8.81 | 2S1P / 2S1P | 2S1P / 2S1P | 1.00 |
| Sprint 0.5W 2S high | 0.472 | 5.66 | 11.32 | 2S1P / 2S1P | 2S1P / 2S1P | 1.00 |
| Sprint 0.85W 2S high | 0.655 | 7.85 | 15.71 | 2S1P / 2S2P | 2S1P / 2S2P | 1.00 |
| Sprint 1W 2S high | 0.733 | 8.80 | 17.59 | 2S1P / 2S2P | 2S1P / 2S2P | 1.00 |
| HF 1W 4S buck | 0.659 | 7.90 | 15.81 | 4S1P / 4S1P | 4S1P / 4S1P | 1.00 |
| HF 1.2W 4S buck | 0.699 | 8.39 | 16.78 | 4S1P / 4S1P | 4S1P / 4S1P | 1.00 |
| HF 1.5W 4S buck | 0.820 | 9.84 | 19.69 | 4S1P / 4S1P | 4S1P / 4S1P | 1.00 |
| HF 2W 4S buck | 0.973 | 11.67 | 23.35 | 4S1P / 4S2P | 4S1P / 4S1P | 1.00 |
| HF 3W 4S buck | 1.343 | 16.12 | 32.23 | 4S1P / 4S2P | 4S1P / 4S2P | 1.00 |
| HF 5W 4S buck | 2.106 | 25.27 | 50.55 | 4S2P / NONE | 4S1P / 4S2P | 1.00 |
| Sprint 0.3W 4S buck | 0.348 | 4.17 | 8.34 | 4S1P / 4S1P | 4S1P / 4S1P | 1.00 |
| Sprint 0.5W 4S buck | 0.436 | 5.24 | 10.47 | 4S1P / 4S1P | 4S1P / 4S1P | 1.00 |
| Sprint 0.85W 4S buck | 0.592 | 7.10 | 14.21 | 4S1P / 4S1P | 4S1P / 4S1P | 1.00 |
| Sprint 1W 4S buck | 0.659 | 7.90 | 15.81 | 4S1P / 4S1P | 4S1P / 4S1P | 1.00 |
| Fox 10mW 2S | 0.350 | 4.20 | 8.40 | 2S1P / 2S1P | 2S1P / 2S1P | 1.00 |
| VHF 0.25W ERP 2S boost | 1.273 | 15.27 | 30.55 | 2S2P / 2S3P | 2S1P / 2S2P | 1.00 |
| VHF 0.3W ERP 2S boost | 1.376 | 16.51 | 33.02 | 2S2P / 2S3P | 2S2P / 2S3P | 1.00 |
| VHF 0.5W ERP 2S boost | 1.651 | 19.81 | 39.62 | 2S2P / 2S4P | 2S2P / 2S3P | 1.00 |
| VHF 0.75W ERP 2S boost | 1.994 | 23.92 | 47.85 | 2S3P / NONE | 2S2P / 2S4P | 1.00 |
| VHF 1W ERP 2S boost | 2.355 | 28.26 | 56.52 | 2S3P / NONE | 2S2P / 2S4P | 1.00 |
| VHF 0.25W ERP 4S buck | 1.244 | 14.93 | 29.86 | 4S1P / 4S2P | 4S1P / 4S1P | 1.00 |
| VHF 0.3W ERP 4S buck | 1.343 | 16.11 | 32.22 | 4S1P / 4S2P | 4S1P / 4S2P | 1.00 |
| VHF 0.5W ERP 4S buck | 1.605 | 19.27 | 38.53 | 4S1P / 4S2P | 4S1P / 4S2P | 1.00 |
| VHF 0.75W ERP 4S buck | 1.934 | 23.20 | 46.40 | 4S2P / NONE | 4S2P / NONE | 0.65 |
| VHF 1W ERP 4S buck | 2.279 | 27.35 | 54.70 | 4S2P / NONE | 4S2P / NONE | 0.65 |
| VHF 0.25W ERP 4S direct | 1.615 | 19.39 | 38.77 | 4S1P / 4S2P | 4S1P / 4S2P | 1.00 |
| VHF 0.3W ERP 4S direct | 1.761 | 21.13 | 42.26 | 4S1P / 4S2P | 4S1P / 4S2P | 1.00 |
| VHF 0.5W ERP 4S direct | 1.906 | 22.87 | 45.74 | 4S2P / NONE | 4S1P / 4S2P | 1.00 |
| VHF 0.75W ERP 4S direct | 1.906 | 22.87 | 45.74 | 4S2P / NONE | 4S2P / NONE | 0.65 |
| VHF 1W ERP 4S direct | 2.245 | 26.94 | 53.88 | 4S2P / NONE | 4S2P / NONE | 0.65 |
| HF beacon 1W 2S high | 3.105 | 37.26 | 74.52 | 2S4P / NONE | 2S3P / NONE | 1.00 |
| HF beacon 1.2W 2S high | 3.343 | 40.11 | 80.22 | 2S4P / NONE | 2S3P / NONE | 1.00 |
| HF beacon 3W 2S high | 7.121 | 85.45 | 170.89 | NONE / NONE | NONE / NONE | 1.00 |
| HF beacon 5W 2S high | 11.596 | 139.15 | 278.29 | NONE / NONE | NONE / NONE | 1.00 |
| HF beacon 1W 4S buck | 2.705 | 32.46 | 64.93 | 4S2P / NONE | 4S2P / NONE | 1.00 |
| HF beacon 1.2W 4S buck | 2.907 | 34.89 | 69.78 | 4S2P / NONE | 4S2P / NONE | 1.00 |
| HF beacon 3W 4S buck | 6.128 | 73.53 | 147.06 | NONE / NONE | NONE / NONE | 1.00 |
| HF beacon 5W 4S buck | 9.942 | 119.31 | 238.62 | NONE / NONE | NONE / NONE | 1.00 |
| Sprint beacon 0.3W 2S economy | 1.143 | 13.71 | 27.43 | 2S2P / 2S3P | 2S1P / 2S2P | 1.00 |
| Sprint beacon 0.5W 2S economy | 1.587 | 19.05 | 38.09 | 2S2P / 2S4P | 2S2P / 2S3P | 1.00 |
| Sprint beacon 0.85W 2S economy | 2.365 | 28.38 | 56.76 | 2S3P / NONE | 2S2P / 2S4P | 1.00 |
| Sprint beacon 1W 2S economy | 2.698 | 32.38 | 64.76 | 2S3P / NONE | 2S3P / NONE | 1.00 |
| Sprint beacon 0.3W 4S buck | 1.150 | 13.80 | 27.59 | 4S1P / 4S2P | 4S1P / 4S1P | 1.00 |
| Sprint beacon 0.5W 4S buck | 1.594 | 19.13 | 38.26 | 4S1P / 4S2P | 4S1P / 4S2P | 1.00 |
| Sprint beacon 0.85W 4S buck | 2.372 | 28.46 | 56.93 | 4S2P / NONE | 4S1P / 4S2P | 1.00 |
| Sprint beacon 1W 4S buck | 2.705 | 32.46 | 64.93 | 4S2P / NONE | 4S2P / NONE | 1.00 |
| VHF beacon 0.25W ERP 2S boost | 5.804 | 69.65 | 139.29 | NONE / NONE | NONE / NONE | 1.00 |
| VHF beacon 0.3W ERP 2S boost | 6.320 | 75.84 | 151.67 | NONE / NONE | NONE / NONE | 1.00 |
| VHF beacon 0.5W ERP 2S boost | 7.693 | 92.32 | 184.64 | NONE / NONE | NONE / NONE | 1.00 |
| VHF beacon 1W ERP 2S boost | 11.214 | 134.57 | 269.14 | NONE / NONE | NONE / NONE | 1.00 |
| Dual full 5W HF + 1W ERP 2S boost | 4.656 | 55.87 | 111.74 | NONE / NONE | 2S4P / NONE | 1.00 |
| Dual reduced 1.2W HF + .30W ERP 2S boost | 1.938 | 23.26 | 46.51 | 2S3P / NONE | 2S2P / 2S4P | 1.00 |
| VHF beacon 0.25W ERP 4S buck | 5.632 | 67.58 | 135.17 | NONE / NONE | NONE / NONE | 1.00 |
| VHF beacon 0.3W ERP 4S buck | 6.125 | 73.51 | 147.01 | NONE / NONE | NONE / NONE | 1.00 |
| VHF beacon 0.5W ERP 4S buck | 7.439 | 89.27 | 178.54 | NONE / NONE | NONE / NONE | 1.00 |
| VHF beacon 1W ERP 4S buck | 10.807 | 129.68 | 259.37 | NONE / NONE | NONE / NONE | 0.65 |
| Dual full 5W HF + 1W ERP 4S buck | 4.248 | 50.98 | 101.95 | NONE / NONE | NONE / NONE | 0.65 |
| Dual reduced 1.2W HF + .30W ERP 4S buck | 1.905 | 22.86 | 45.71 | 4S1P / 4S2P | 4S1P / 4S2P | 1.00 |

## Complete candidate material and shared fleet allocations

| Configuration | Batch | Unit material EUR | Fleet cash EUR/unit | Observed material EUR | Estimates/reserves EUR |
| --- | ---: | ---: | ---: | ---: | ---: |
| Fox 2S1P 25R | 6 | 64.47 | 77.97 | 23.75 | 40.72 |
| Fox 2S1P 25R | 10 | 57.83 | 65.93 | 21.12 | 36.72 |
| Fox 2S1P 25R | 20 | 57.83 | 62.68 | 21.12 | 36.72 |
| HF economy 2S2P 25R | 6 | 101.36 | 114.86 | 32.87 | 68.50 |
| HF economy 2S2P 25R | 10 | 92.92 | 101.02 | 28.42 | 64.50 |
| HF economy 2S2P 25R | 20 | 92.56 | 97.41 | 28.06 | 64.50 |
| HF high 2S2P 25R | 6 | 114.43 | 127.93 | 41.65 | 72.79 |
| HF high 2S2P 25R | 10 | 104.02 | 112.12 | 35.23 | 68.79 |
| HF high 2S2P 25R | 20 | 103.66 | 108.51 | 34.87 | 68.79 |
| HF high 4S1P 25R | 6 | 105.78 | 120.11 | 32.36 | 73.43 |
| HF high 4S1P 25R | 10 | 98.24 | 106.84 | 28.81 | 69.43 |
| HF high 4S1P 25R | 20 | 97.68 | 103.03 | 28.25 | 69.43 |
| HF 5W 2S2P M35A | 6 | 120.71 | 134.21 | 47.93 | 72.79 |
| HF 5W 2S2P M35A | 10 | 109.74 | 117.84 | 40.95 | 68.79 |
| HF 5W 2S2P M35A | 20 | 109.74 | 114.59 | 40.95 | 68.79 |
| HF 5W 4S1P M35A | 6 | 112.06 | 126.39 | 38.64 | 73.43 |
| HF 5W 4S1P M35A | 10 | 103.96 | 112.56 | 34.53 | 69.43 |
| HF 5W 4S1P M35A | 20 | 103.76 | 109.11 | 34.33 | 69.43 |
| VHF 2S2P M35A | 6 | 132.22 | 145.72 | 54.49 | 77.73 |
| VHF 2S2P M35A | 10 | 121.29 | 129.39 | 47.57 | 73.73 |
| VHF 2S2P M35A | 20 | 121.09 | 125.94 | 47.37 | 73.73 |
| VHF 2S3P 25R | 6 | 131.24 | 144.74 | 52.91 | 78.33 |
| VHF 2S3P 25R | 10 | 120.33 | 128.43 | 46.01 | 74.33 |
| VHF 2S3P 25R | 20 | 119.65 | 124.50 | 45.33 | 74.33 |
| VHF 2S3P M35A | 6 | 139.82 | 153.32 | 61.49 | 78.33 |
| VHF 2S3P M35A | 10 | 129.45 | 137.55 | 55.13 | 74.33 |
| VHF 2S3P M35A | 20 | 128.29 | 133.14 | 53.97 | 74.33 |
| VHF 2S4P 25R | 6 | 136.54 | 150.04 | 57.61 | 78.93 |
| VHF 2S4P 25R | 10 | 125.45 | 133.55 | 50.53 | 74.93 |
| VHF 2S4P 25R | 20 | 124.61 | 129.46 | 49.69 | 74.93 |
| VHF 4S1P M35A | 6 | 134.66 | 148.99 | 53.50 | 81.16 |
| VHF 4S1P M35A | 10 | 124.13 | 132.73 | 46.98 | 77.16 |
| VHF 4S1P M35A | 20 | 124.13 | 129.48 | 46.98 | 77.16 |
| VHF 4S2P 25R | 6 | 138.98 | 153.31 | 56.62 | 82.36 |
| VHF 4S2P 25R | 10 | 128.29 | 136.89 | 49.94 | 78.36 |
| VHF 4S2P 25R | 20 | 127.65 | 133.00 | 49.30 | 78.36 |
| VHF direct 4S2P 25R | 6 | 139.65 | 153.98 | 55.44 | 84.21 |
| VHF direct 4S2P 25R | 10 | 129.26 | 137.86 | 49.06 | 80.21 |
| VHF direct 4S2P 25R | 20 | 128.42 | 133.77 | 48.22 | 80.21 |
| Universal 2S4P 25R | 6 | 198.15 | 211.65 | 74.59 | 123.57 |
| Universal 2S4P 25R | 10 | 183.42 | 191.52 | 65.86 | 117.57 |
| Universal 2S4P 25R | 20 | 181.39 | 186.24 | 63.82 | 117.57 |
| Universal 4S2P 25R | 6 | 190.49 | 204.82 | 65.50 | 125.00 |
| Universal 4S2P 25R | 10 | 177.12 | 185.72 | 58.13 | 119.00 |
| Universal 4S2P 25R | 20 | 175.63 | 180.98 | 56.63 | 119.00 |
| Universal 4S2P M35A | 6 | 201.93 | 216.26 | 76.94 | 125.00 |
| Universal 4S2P M35A | 10 | 189.28 | 197.88 | 70.29 | 119.00 |
| Universal 4S2P M35A | 20 | 187.15 | 192.50 | 68.15 | 119.00 |

## Thermal calculations (same assumed PA conversion component)

| ERP W | Upstream V | Center V | Crest headroom V | Tone pass mean / peak W | No-tone pass W |
| ---: | ---: | ---: | ---: | --- | ---: |
| 1.00 | 12.0 | 6.667 | -0.001 | 2.31 / 3.54 | 3.31 |
| 1.00 | 13.5 | 6.667 | 1.499 | 3.24 / 4.33 | 4.24 |
| 1.00 | 14.4 | 6.667 | 2.399 | 3.80 / 4.84 | 4.80 |
| 1.00 | 16.8 | 6.667 | 4.799 | 5.29 / 6.35 | 6.29 |
| 0.30 | 12.0 | 4.000 | 4.800 | 3.23 / 3.71 | 3.62 |
| 0.30 | 13.5 | 4.000 | 6.300 | 3.91 / 4.55 | 4.30 |
| 0.30 | 14.4 | 4.000 | 7.200 | 4.32 / 5.09 | 4.71 |
| 0.30 | 16.8 | 4.000 | 9.600 | 5.41 / 6.67 | 5.79 |

## Sensitivity

| Case | Added state | Pack | Cell Ah | W | Runtime h |
| --- | --- | --- | ---: | ---: | ---: |
| HF3 4S nominal | absent | 4S1P | 2.45 | 1.343 | 17.0 |
| HF3 4S nominal | 10% RX | 4S1P | 2.45 | 1.349 | 16.9 |
| HF3 4S nominal | continuous RX | 4S1P | 2.45 | 1.388 | 16.5 |
| HF3 4S nominal | poor controller idle | 4S1P | 2.45 | 1.523 | 15.0 |
| HF3 4S poor PA/converter | absent | 4S1P | 2.45 | 2.001 | 11.4 |
| HF3 4S poor PA/converter | 10% RX | 4S1P | 2.45 | 2.007 | 11.4 |
| HF3 4S poor PA/converter | continuous RX | 4S1P | 2.45 | 2.046 | 11.2 |
| HF3 4S poor PA/converter | poor controller idle | 4S1P | 2.45 | 2.181 | 10.5 |
| HF5 4S nominal | absent | 4S1P | 3.35 | 2.106 | 14.6 |
| HF5 4S nominal | 10% RX | 4S1P | 3.35 | 2.112 | 14.6 |
| HF5 4S nominal | continuous RX | 4S1P | 3.35 | 2.151 | 14.3 |
| HF5 4S nominal | poor controller idle | 4S1P | 3.35 | 2.286 | 13.5 |
| HF5 4S poor PA/converter | absent | 4S1P | 3.35 | 3.201 | 9.6 |
| HF5 4S poor PA/converter | 10% RX | 4S1P | 3.35 | 3.207 | 9.6 |
| HF5 4S poor PA/converter | continuous RX | 4S1P | 3.35 | 3.246 | 9.5 |
| HF5 4S poor PA/converter | poor controller idle | 4S1P | 3.35 | 3.381 | 9.1 |
| VHF full 4S nominal | absent | 4S2P | 2.45 | 2.279 | 13.0 |
| VHF full 4S nominal | 10% RX | 4S2P | 2.45 | 2.285 | 13.0 |
| VHF full 4S nominal | continuous RX | 4S2P | 2.45 | 2.324 | 12.8 |
| VHF full 4S nominal | poor controller idle | 4S2P | 2.45 | 2.459 | 12.1 |
| VHF full 4S poor PA | absent | 4S2P | 2.45 | 2.674 | 11.1 |
| VHF full 4S poor PA | 10% RX | 4S2P | 2.45 | 2.680 | 11.1 |
| VHF full 4S poor PA | continuous RX | 4S2P | 2.45 | 2.719 | 10.9 |
| VHF full 4S poor PA | poor controller idle | 4S2P | 2.45 | 2.854 | 10.4 |
| VHF reduced fixed bias | absent | 4S1P | 3.35 | 1.343 | 23.0 |
| VHF reduced fixed bias | 10% RX | 4S1P | 3.35 | 1.349 | 22.9 |
| VHF reduced fixed bias | continuous RX | 4S1P | 3.35 | 1.388 | 22.2 |
| VHF reduced fixed bias | poor controller idle | 4S1P | 3.35 | 1.523 | 20.3 |
| VHF reduced optimistic lower bias | absent | 4S1P | 3.35 | 1.007 | 30.6 |
| VHF reduced optimistic lower bias | 10% RX | 4S1P | 3.35 | 1.013 | 30.4 |
| VHF reduced optimistic lower bias | continuous RX | 4S1P | 3.35 | 1.052 | 29.3 |
| VHF reduced optimistic lower bias | poor controller idle | 4S1P | 3.35 | 1.187 | 26.0 |
| VHF full lower crest, UNQUALIFIED | absent | 4S1P | 3.35 | 2.257 | 11.6 |
| VHF full lower crest, UNQUALIFIED | 10% RX | 4S1P | 3.35 | 2.263 | 11.6 |
| VHF full lower crest, UNQUALIFIED | continuous RX | 4S1P | 3.35 | 2.302 | 11.4 |
| VHF full lower crest, UNQUALIFIED | poor controller idle | 4S1P | 3.35 | 2.437 | 10.8 |
| Fox retained audit allowance | absent | 2S1P | 2.45 | 0.350 | 32.7 |
| Fox retained audit allowance | 10% RX | 2S1P | 2.45 | 0.356 | 32.1 |
| Fox retained audit allowance | continuous RX | 2S1P | 2.45 | 0.395 | 28.9 |
| Fox retained audit allowance | poor controller idle | 2S1P | 2.45 | 0.530 | 21.6 |
