DD1SB/ARDF-TX/hardware/2m/review/M5B-E5/THREE_BOARD_READINESS.md

# Three separate five-board prototype datasets

No combined promotional order,upload,CAMacceptance,quote orpurchase is implied.

|PCB|Revision|Dimensions|Five-boardarchive|Physical|
|---|---|---|---|---|
|Controller|M6-L1|[100, 100]|hardware/80m/production/review/M4A-V1R1/three-board-order/CTRL_M6-L1_JLCPCB_5boards.zip|NOT_RUN|
|RF80|M4A-V1R1|[150, 110]|hardware/80m/production/review/M4A-V1R1/fabrication/RF80-V1R1_JLCPCB_5boards.zip|NOT_RUN|
|RF2M|M5B-E5|[150, 110]|hardware/2m/review/M5B-E5/fabrication/RF2M-M5B-E5_JLCPCB_5boards.zip|NOT_RUN|

All2L/1.6mm/1oz/green/white/lead-freeHASL. SourcecommitsandhashesareintheJSONmatrix. Controller/RF80archivesandE4R1remainimmutable. SupplierCAMmustcheckordinaryholes/mask/drillinterpretation;sourceassemblyreflowandthermalqualificationremainOPEN. E5 replacesE4R1onlyafterindependentreviewanduserauthorization.
