DD1SB/ARDF-TX/docs/M5B_E5_COMMON_ENCLOSURE.md

# M5B-E5 common enclosure study

The mandatory controller+RF80 and controller+RF2M configurations share 150 × 110 mm RF boards and the 140 × 100 mm mounting pattern. Read-only controller dimensions remain 100 × 100 mm with asymmetric holes. Rotate it 180°, local origin (65,20), independent posts (160,78),(70,115),(70,25),(160,25). Controller bottom Z=53 mm. A 170 × 120 × 3 mm insulating carrier, bottom Z45, uses 40 mm nylon posts + 5 mm spacers and 5 mm controller posts. It is simple drilled/cut stock sheet, not a fourth electrical PCB.

The primary internal envelope study is 180 × 200 × 125 mm, external protected battery, UP=−boardX. Reserve separate open inlet/exhaust paths for the rear PA plenum and front pass sink; do not seal both into a shared warm air volume. Begin thermal qualification on the supported open frame, then measure the actual case inlet temperature. A weatherproof final enclosure is not qualified. The front bay supports the pass heatsink outside the RF outline; the underside PA sink has a vented plenum. Fin channels must remain upright and inlet temperature must be measured. RF80 retains its own thermal/service envelope unmodified. This is a dimensioned compatible envelope study, not a selected or thermally qualified final enclosure.

The carrier has a rear antenna cutout X109..162/Y110..120. ESP antenna keepout is approximately X111..159/Y111.75..132.75, with 15 mm surrounding clearance, no metal/battery/cable and 53 mm separation from RF PCB. USB near X165/Y100 needs an open service bay and accessible plug opening. LoRa pigtail routes left/rear outside ESP clearance, using the controller's band-specific antenna. Follow Espressif guidance; RF immunity and cable fit remain NOT_RUN.

RF2M initially uses a 150 mm keyed, continuity-tested IDC; RF80 220 mm. Pin 1 remains straight-through, with a cable half-twist where connector orientation requires. Start I²C at 100 kHz: 4.7 kΩ/200 pF illustrative rise ≈0.80 µs; measure actual cable capacitance and fail-off. Normal/training outputs use side-access right-angle pigtails and strain relief. Separate fused battery harnesses carry PA current. Four corner supports are insulating; only grounded bar fixings use metal washers.

Beside the RF board, the controller needs at least 260 × 110 mm board plane with a 10 mm gap; a wider case is the alternative, not a claimed fit in the RF footprint. Optional dual-RF study places RF2M top Z0, RF80 top Z55 and controller bottom Z100, requiring at least 170 mm case depth, separate vent paths and verified RF shielding/service access. It remains HOLD for thermal/EMC integration. Neither simultaneous transmission nor acceptance of this taller arrangement is required for the two mandatory configurations.

See dimensioned top, bottom and section SVGs and common-mechanical-platform.json in the E5 review. Actual plug fit, cooling, insulator integrity and mounting preload must be verified before operation.
