DD1SB/ARDF-TX/docs/M5B_E5_RF_PRESERVATION.md

# M5B-E5 RF preservation

The seven ST-derived TL603–TL609 structures retain their actual 2.741 mm widths, pad-to-pad lengths, orientations, L/C values and internal placement. The PHA-1+, PD54008L-E and normal matching/filter group translates 20 mm left. This preserves its analytical distributed network; it does not prove physical gain, stability, AM or spectrum. [Native assertions](../hardware/2m/review/M5B-E5/compact-engineering.json) verify each line and package, not only schematic equality.

The recalculated nominal model at 144.7 MHz uses H=1.50 mm, Er=4.5, copper=0.035 mm: Z0≈50.005 Ω, effective Er≈3.3947. Broad ordinary-FR4 thickness/material/etch sensitivity spans approximately 39.4–63.4 Ω. Dielectric loss is about 0.044 dB/100 mm plus a conductor lower bound about 0.020 dB/100 mm. Solder mask and component transitions remain model uncertainties. Exact line delays, electrical lengths, input match and elliptic response are in [RF analysis](../hardware/2m/review/M5B-E5/RF-analysis.json) and its CSVs. No controlled-impedance service is required or claimed.

A local bottom-layer control corridor opens between X29 and X35.5 under the synthesizer/buffer periphery. This permits the isolated slow I²C branch to escape congested clock/power fanouts. No controlled matching line or PA ground return is moved. The resulting narrow control slot and source-clock return require spectral/jitter/immunity commissioning; see source-control-corridor.json.

Si5351-to-buffer clock wiring and the independent training clock are rerouted; they are not ST matching lines. CLK_NORMAL total copper shortens 15.956→13.258 mm (minimum width 0.20→0.15 mm, no vias); CLK_TRAIN increases 190.839→210.954 mm and 5→9 vias. NORMAL_CLOCK_BUF remains 2 mm / 0.35 mm, and TRAIN_CLOCK_BUF 3.280 mm / 0.20 mm. These totals include branches. An ideal uniform 0.15 mm microstrip over 1.5 mm FR4 is about 142 Ω / effective Er2.985, not a 50 Ω port. The additional training wire contributes roughly 6° at 144.7 MHz in that comparison. Actual mixed-layer returns, via transitions, CMOS source impedance and high-impedance buffer loading require waveform/ringing and off-path emission tests; these simple line estimates do not establish S11 or clock noise margins. Their full widths, lengths, via counts and nominal phase comparisons are reported separately. Clock ringing, buffer loading, source harmonics and local returns require commissioning. Training connector and filter membership remain unchanged. Normal/training connector centre separation decreases from approximately 87.94 mm to 63.794 mm; measured port isolation remains NOT_RUN.

One bottom-layer routing corridor changes: the matching-region track keepout ends at X168.6 instead of X170, allowing the modulator control conductor near X169 beyond the matching structures. Continuous ground beneath the distributed line bodies and all SMA ground contacts is retained. A simple infinite-plane estimate assigns about 0.4% of return-current density to a 0.15 mm slot at 4 mm lateral offset and 1.5 mm height; this is a locality estimate, not an EM solution or measured S11. See [peripheral return change](../hardware/2m/review/M5B-E5/RF-peripheral-return-change.json). RF pickup/stability and harmonics must be measured with the new placement.

The final native audit additionally compares all 36 original normal RF signal copper tracks/vias under the rigid translation; redundant autorouter additions are removed, not treated as matching improvements. All 26 ST component poses are preserved.

The complete source → PHA → final → filter → output path must be accepted at controlled dummy-load commissioning, including 144.500–144.900 MHz and configured legal training frequencies. Physical gain, carrier/PEP/ERP, sinusoidal AM depth, compression, oscillation, harmonics and port isolation remain NOT_RUN.
