DD1SB/ARDF-TX/docs/M6_L1_ANTENNA_FEED.md

# M6-L1 antenna-feed analysis

Retain the existing **0.45 mm × 5.25 mm** straight F.Cu route, (97.89,33.75) to (97.89,28.50) mm. There are no series components, signal vias or RF stubs. The endpoints are U70 antenna pin 21 and J7 signal pad 1. Neither module nor connector moves. The native geometry audit identifies the local top-ground correction and unchanged signal/pad/mask/paste/drill geometry in [native-preservation.json](../hardware/controller/review/M6-L1/native-preservation.json) and [fabrication-equivalence.json](../hardware/controller/review/M6-L1/fabrication-equivalence.json).

This is a **locally discontinuous grounded-coplanar/microstrip hybrid**. The middle section has approximately 0.255 mm top-ground gaps; the module land widens to 0.80 mm and the U.FL land to 1.05 mm. At the connector the right top-ground gap grows to about 2.4 mm because of the required underbody keep-out. Bottom GND is continuous under the route and the sampled ±1 mm corridor. The local GND stitch is at (95,29) mm, roughly 3 mm from the launch; top ground also joins the module's ground terminals. That is not zero-inductance grounding. Native 5 µm transverse / 50 µm longitudinal sections and the actual via geometry are exported in [antenna-native-geometry.json](../hardware/controller/review/M6-L1/antenna-native-geometry.json), with [an annotated view](../hardware/controller/review/M6-L1/antenna-feed-detail.svg).

The model uses Qucs' conductor-backed CPW conformal mapping (equations 12.10–12.17, elliptic integrals evaluated by AGM), cascaded lossy ABCD sections, with a conventional narrow microstrip comparison. Larger measured gaps bracket the asymmetric launch. Nominal substrate separation is 1.53 mm after two nominal 35 µm copper layers; ordinary finished-board thickness is 1.6 mm. Nominal FR4 Er = 4.5. The independent sensitivity sweep includes substrate separation 1.37–1.69 mm, Er 4.0–5.0, copper 30–45 µm, width ±20%, extra gap ±0.05 mm, loss tangent 0.015–0.030, conductor-loss allowance and effective-permittivity mask increment 0–0.25. These are engineering ranges, not a factory RF-material guarantee. JLCPCB publishes ±10% finished thickness, ±20% track-width tolerance, nominal two-layer Er 4.5 and mask Er 3.8; no controlled impedance is ordered. [JLCPCB](https://jlcpcb.com/capabilities/pcb-capabilities/), [Qucs model](https://qucs.github.io/tech/node86.html).

| Band | Electrical length | Delay | Calculated line RL | Calculated line IL | Worst material/model IL |
|---|---:|---:|---:|---:|---:|
| 433 MHz | 4.67° | 30.0 ps | 33.4 dB | 0.025 dB | 0.061 dB |
| 868 MHz | 9.37° | 30.0 ps | 27.4 dB | 0.045 dB | 0.160 dB |

Nominal local characteristic impedance varies approximately **52–105 Ω** over the pads/launch; the whole-line arithmetic mean is about **65.5 Ω** in the segmented model. It is not a uniform 50 Ω line. Nominal effective Er is about 2.88–3.19. Calculated dissipative line loss alone is 0.022/0.035 dB at 433/868 MHz; the table adds matched-port mismatch. The full material/model sweep gives minimum line-only return loss about 22.3/16.3 dB. The worst calculated line insertion loss corresponds to less than 4% power loss. The short line is therefore credible for this evaluation PCB without adding a matching network or widening it into adjacent module ground lands.

Reference planes are explicitly the **module terminal-21 carrier solder-land centre and U.FL signal solder-land centre**, with nominal 50 Ω module/load assumptions. To relate those to the internal module antenna port and the mated cable, a separate sensitivity adds 0–1.5 nH series and 0–0.35 pF shunt at each end. Its nominal-material minimum calculated return loss is about 19.9/14.1 dB at 433/868 MHz. Those parasitics are illustrative, not measured or guaranteed bounds. Infinite equipotential grounds, HASL roughness, mask fields, the finite ground plane and unequal return geometry limit the model. The microstrip comparison is a topology sensitivity, not a statement that actual top copper disappears. It does not replace a 3D EM model or VNA measurement, and does not bound an arbitrarily mismatched antenna.

The same connector/feed serves both bands; external antennas differ. A band-correct 50 Ω antenna and commissioned pigtail are mandatory. No dual-band antenna is assumed. Preserve the ESP32 antenna all-layer keep-out; route the coax north along the J7 side, away from its printed antenna and the RF-module heatsinks. RF2M harmonics can fall near both LoRa bands, so initial LoRa TX uses quiet/off-slot windows. Receiver blocking, actual antenna match, emissions and coexistence are NOT_RUN. See [variant and power contract](M6_L1_LORA_VARIANTS.md).
