DD1SB/ARDF-TX/docs/M6_L1_LORA_VARIANTS.md

# M6-L1 optional radio, power and assembly contract

One PCB and one U70/J7 footprint support these independent radio options on any of the four existing base-controller populations:

| Assembly option | Trusted configuration | U70 | Antenna |
|---|---|---|---|
| NO_LORA | NONE | DNP | None; J7/R70/R71/C70/C71 DNP |
| LORA_433 | SX1262TR4_GC_433 | SX1262TR4-GC, C42381681 | Commissioned 433 MHz system |
| LORA_868 | SX1262TR8_GC_868 | SX1262TR8-GC, C42381682 | Commissioned 868 MHz system |

The native master retains an 868 MHz orderable MPN as its **DNP default**, with the 433 alternate selected in its own assembly BOM. All six optional positions must be fitted together for either radio option. Both options share identical copper; no GPIO, IDC connector, RTC, battery protection, USB or RF enable changes. [Twelve complete population BOMs and costs](../hardware/controller/review/M6-L1/LoRa-populations.json) cover the orthogonal choices; the old UNIVERSAL_LORA_OPEN name is superseded.
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
