DD1SB/ARDF-TX/docs/M6_L1_MODULE_COMPATIBILITY.md

# M6-L1 module and connector compatibility

The existing single U70 landing is nominally compatible with **SX1262TR4-GC / SX1262ZTR4-GC** and **SX1262TR8-GC / SX1262ZTR8-GC**. This is a documented supplier alias, not an inference from the SX1262 chip name. LCSC C42381681 links a manufacturer ZTR4 V2.0 PDF byte-identical to the official download. C42381682 links ZTR8 V2.0, also byte-identical to Silicontra's newer official download. The requested ZTR8 V1.0 has the same pin/land topology. Revision V2.0 versus V1.0 is a document revision; no TR-prefix-specific alternate package is indicated. The source URLs and exact downloaded hashes are in [manufacturer-evidence.json](../hardware/controller/review/M6-L1/manufacturer-evidence.json).
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
