DD1SB/ARDF-TX/docs/assets/80m-reference/FlexFox80-RF-source.png

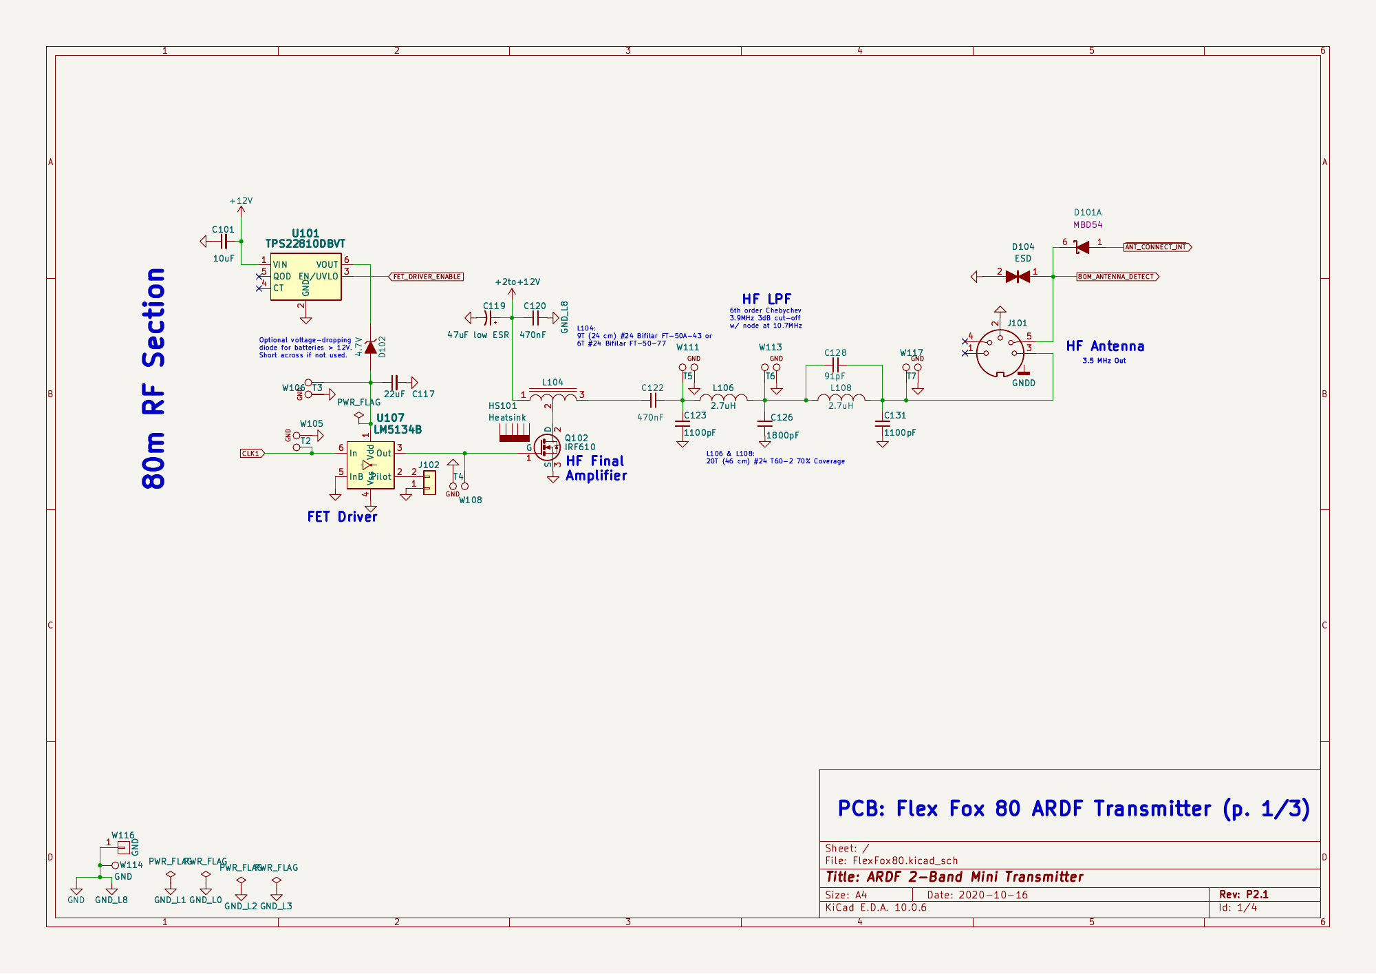
docs/assets/80m-reference/FlexFox80-RF-source.png
