DD1SB/ARDF-TX/docs/assets/80m-reference/SignalSlinger-filter-source.png

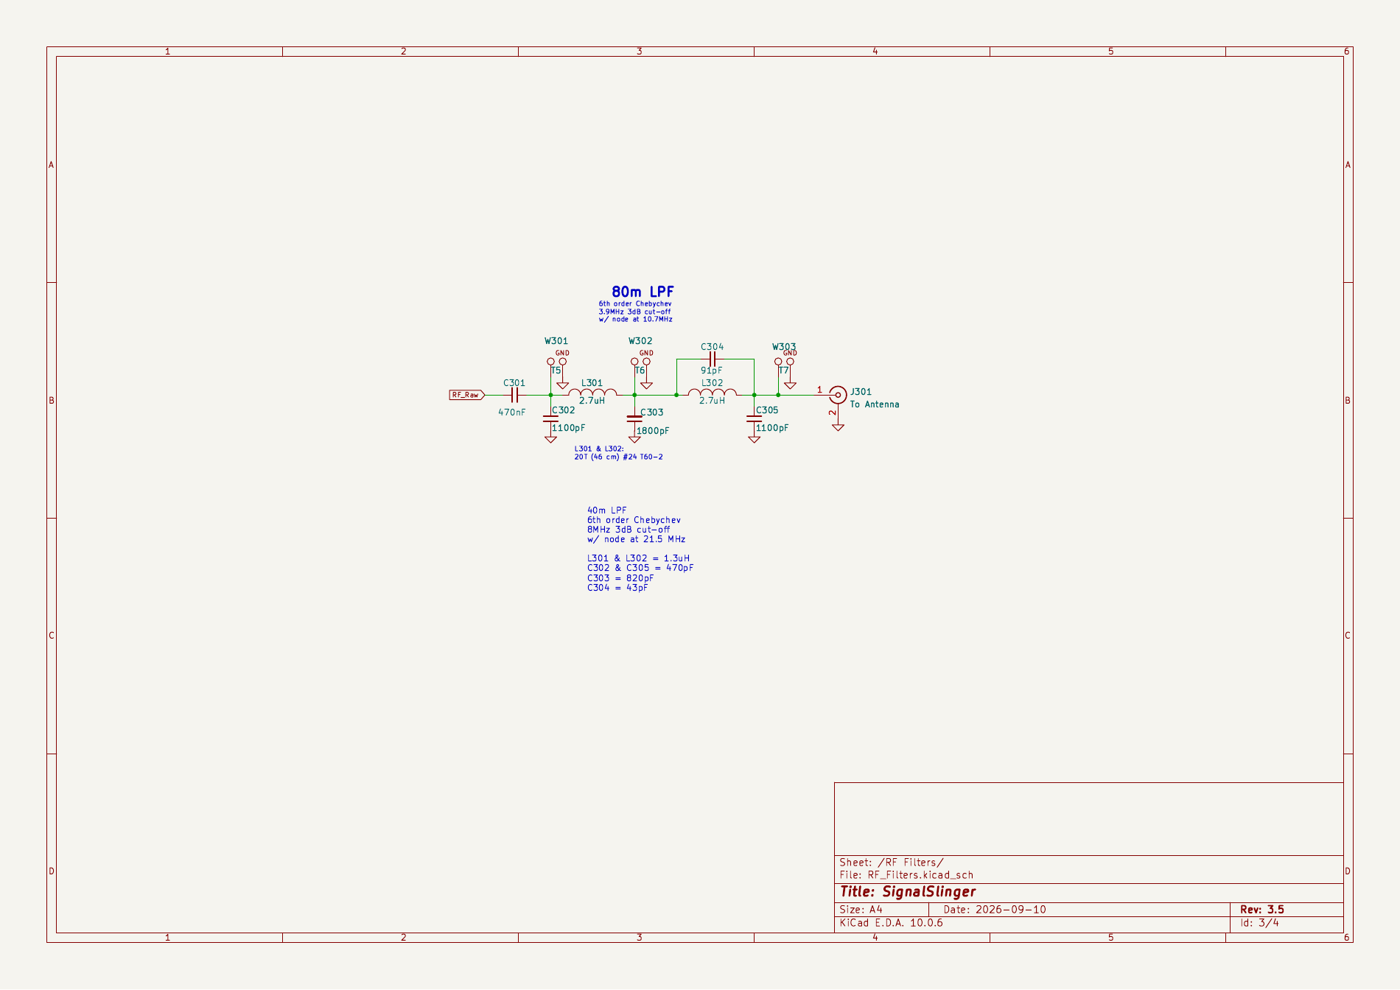
docs/assets/80m-reference/SignalSlinger-filter-source.png
