DD1SB/ARDF-TX/docs/assets/80m-reference/SignalSlinger-RF-source.png

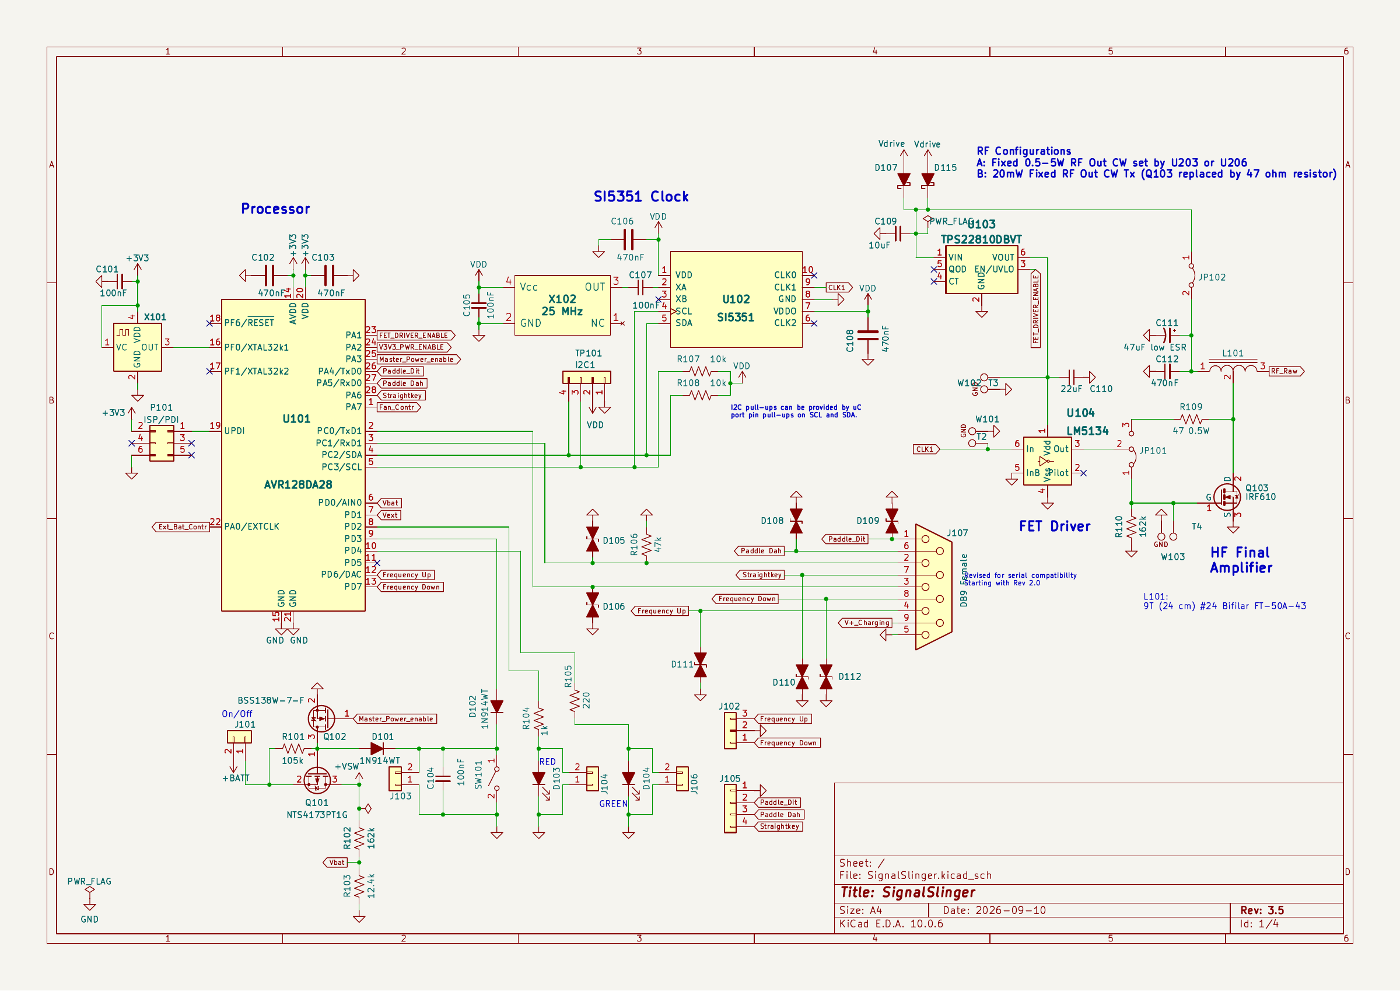
docs/assets/80m-reference/SignalSlinger-RF-source.png
