DD1SB/ARDF-TX/hardware/2m/review/M5B-E2/copper-after.png

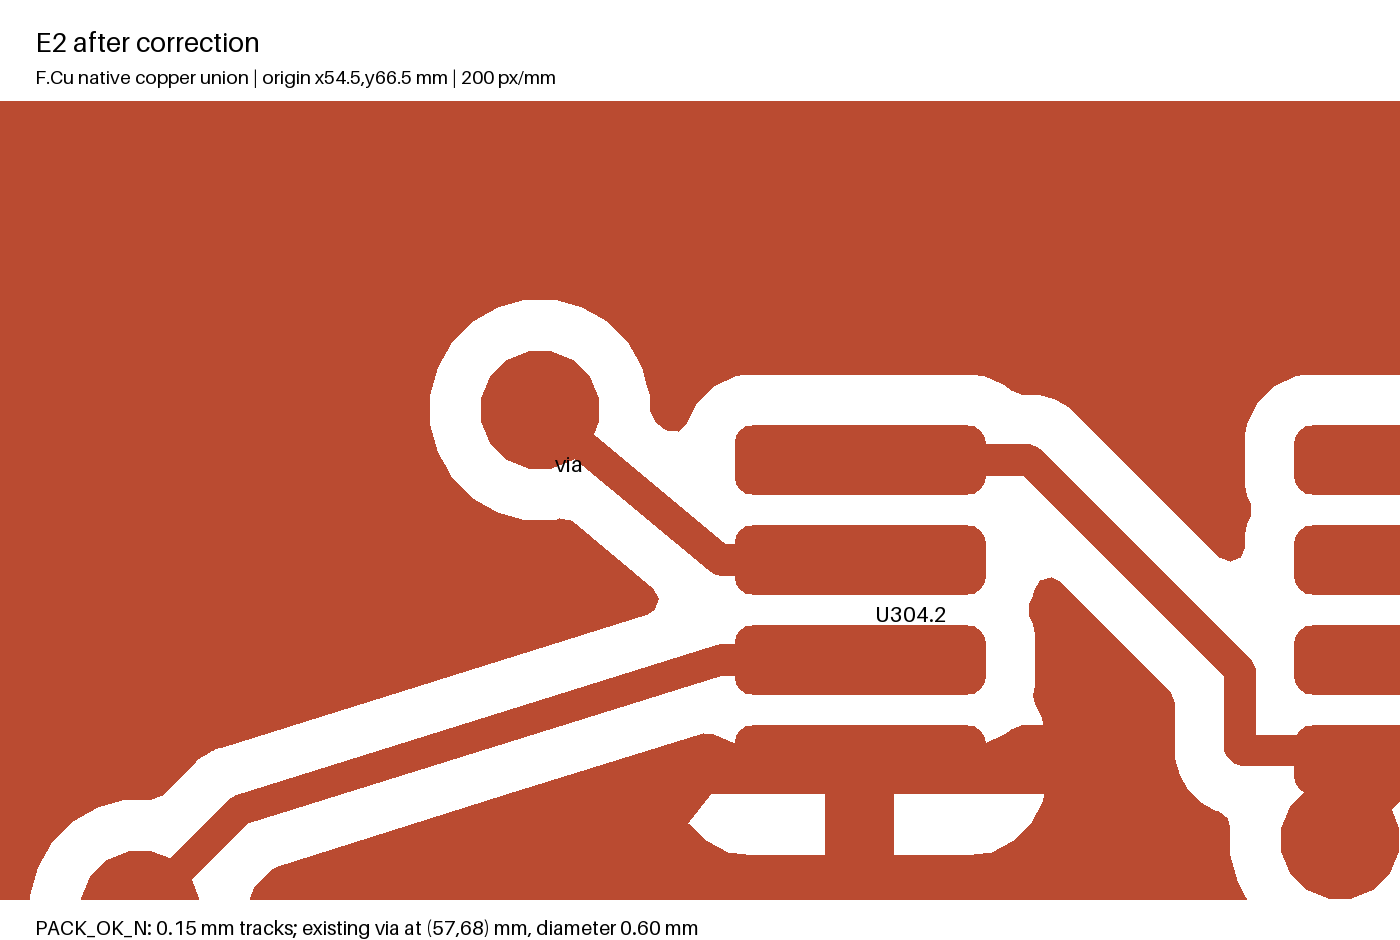
hardware/2m/review/M5B-E2/copper-after.png
