DD1SB/ARDF-TX/hardware/2m/review/M5B-E2/copper-before.png

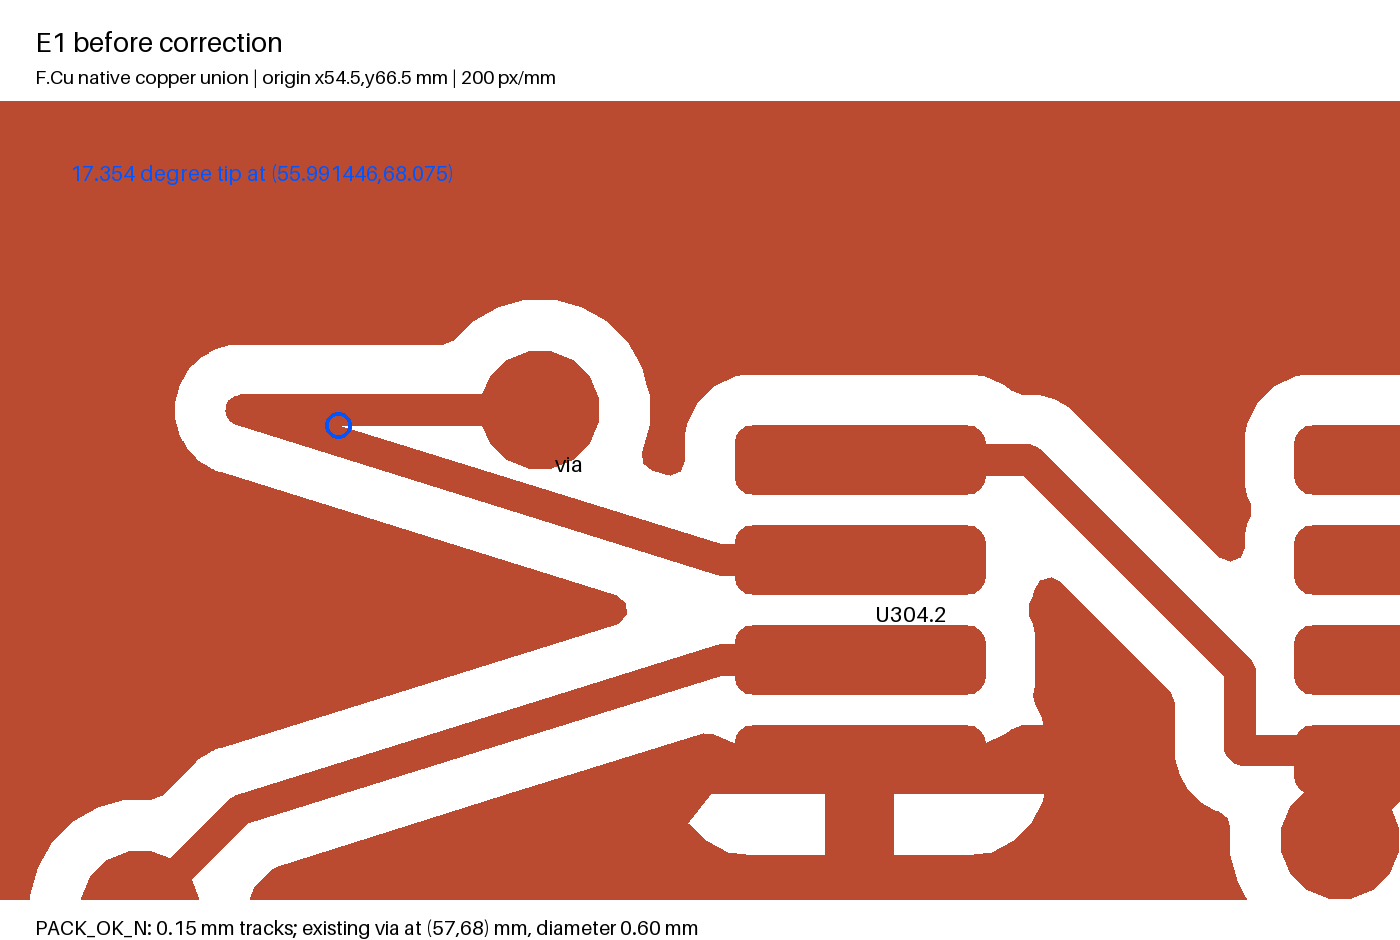
hardware/2m/review/M5B-E2/copper-before.png
