DD1SB/ARDF-TX/hardware/2m/review/M5B-E4R1/RF2M-3D-bottom.png

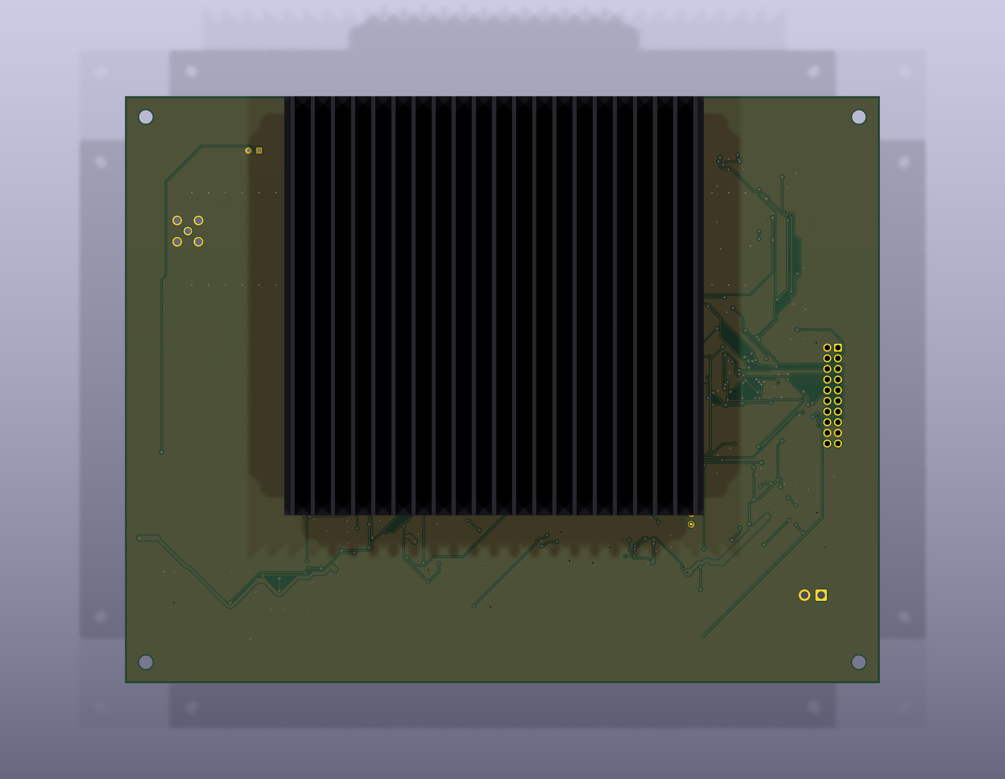
hardware/2m/review/M5B-E4R1/RF2M-3D-bottom.png
