DD1SB/ARDF-TX/hardware/2m/review/M5B-E5/development/current-3D.png

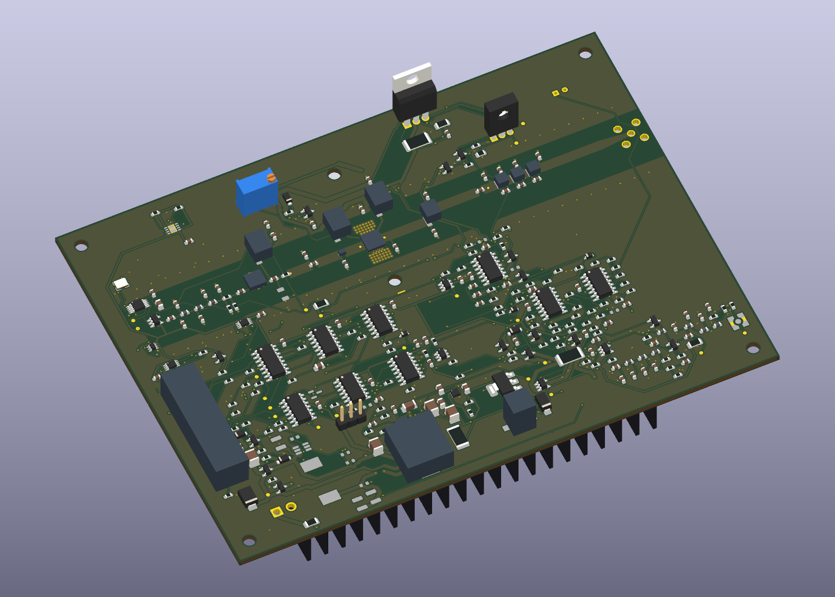
hardware/2m/review/M5B-E5/development/current-3D.png
