DD1SB/ARDF-TX/hardware/2m/review/M5B-E5/RF2M-3D-top.png

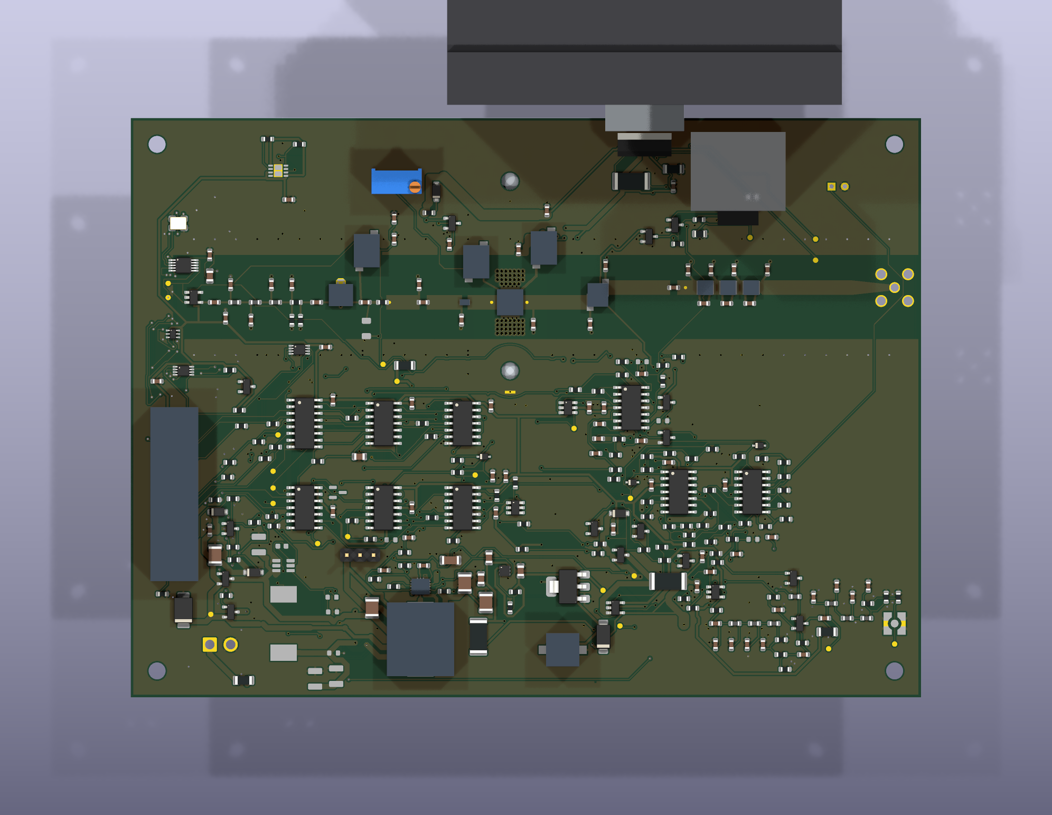
hardware/2m/review/M5B-E5/RF2M-3D-top.png
