DD1SB/ARDF-TX/hardware/2m/review/M5B-E6/common-cooler-concept.png

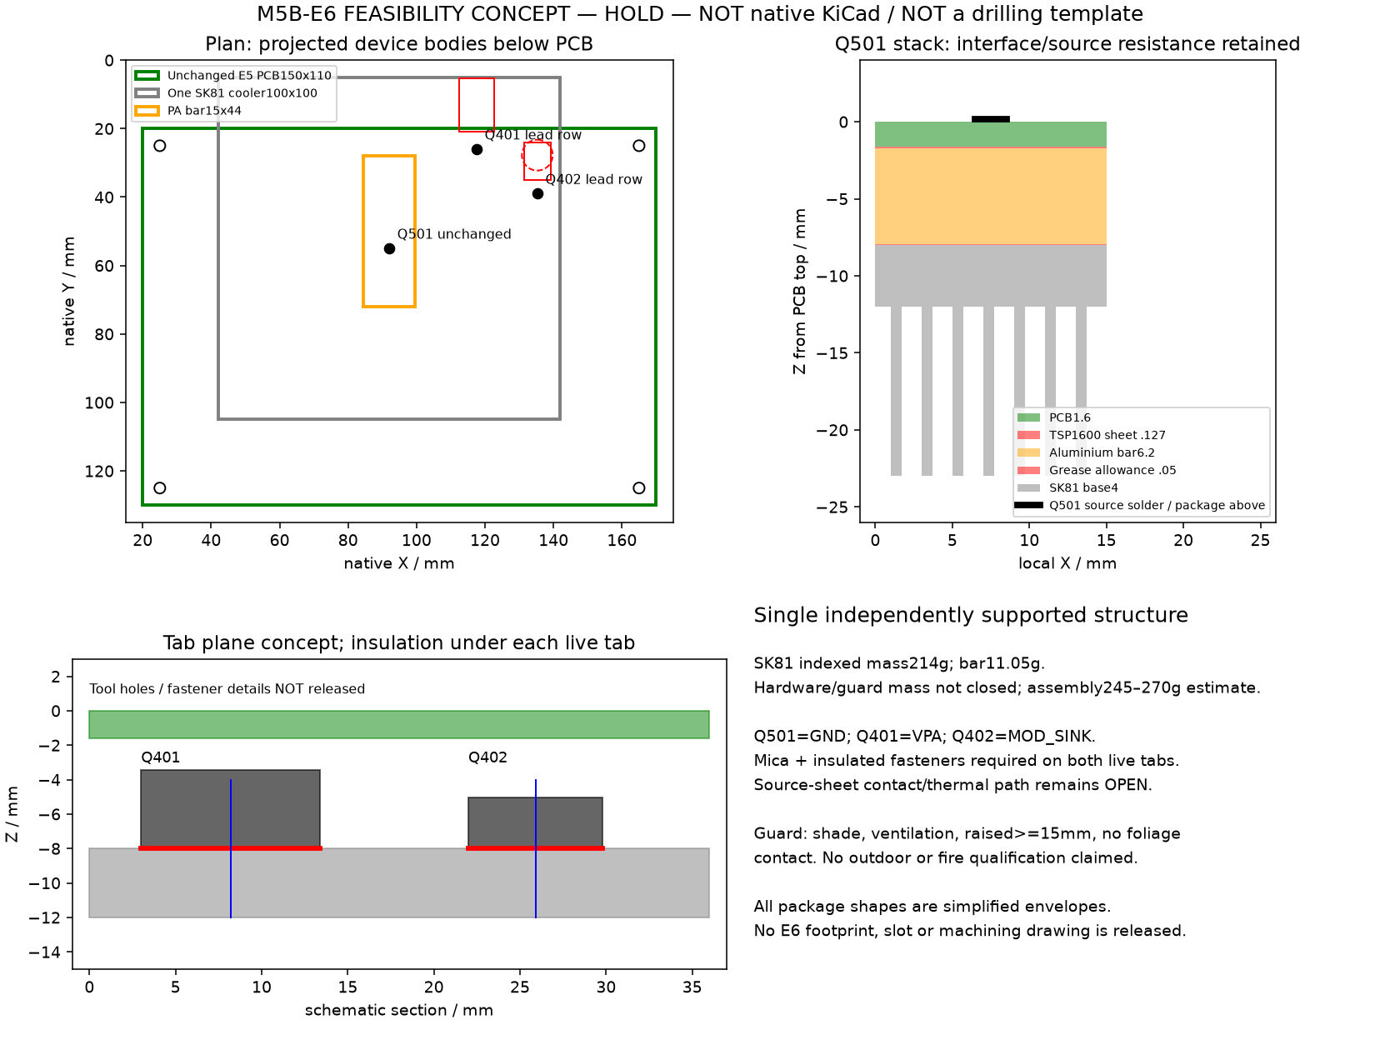
hardware/2m/review/M5B-E6/common-cooler-concept.png
