DD1SB/ARDF-TX/hardware/2m/review/M5B-E6/fault-response.png

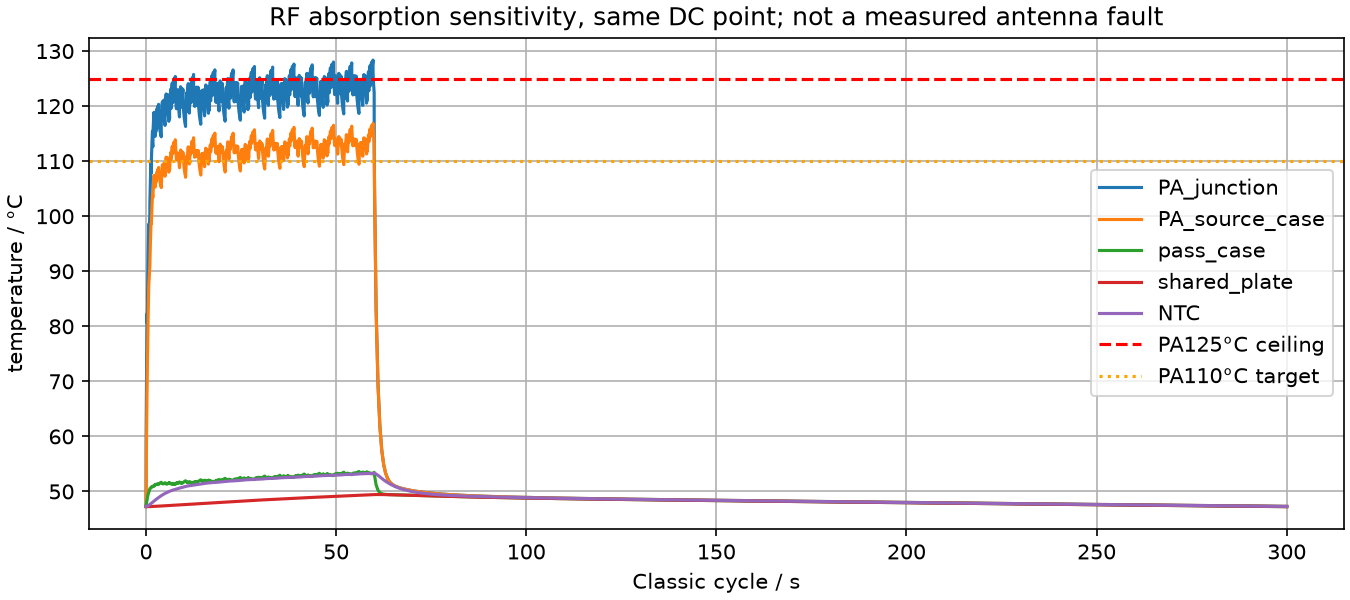
hardware/2m/review/M5B-E6/fault-response.png
