DD1SB/ARDF-TX/hardware/2m/review/M5B-E6/transient-responses.png

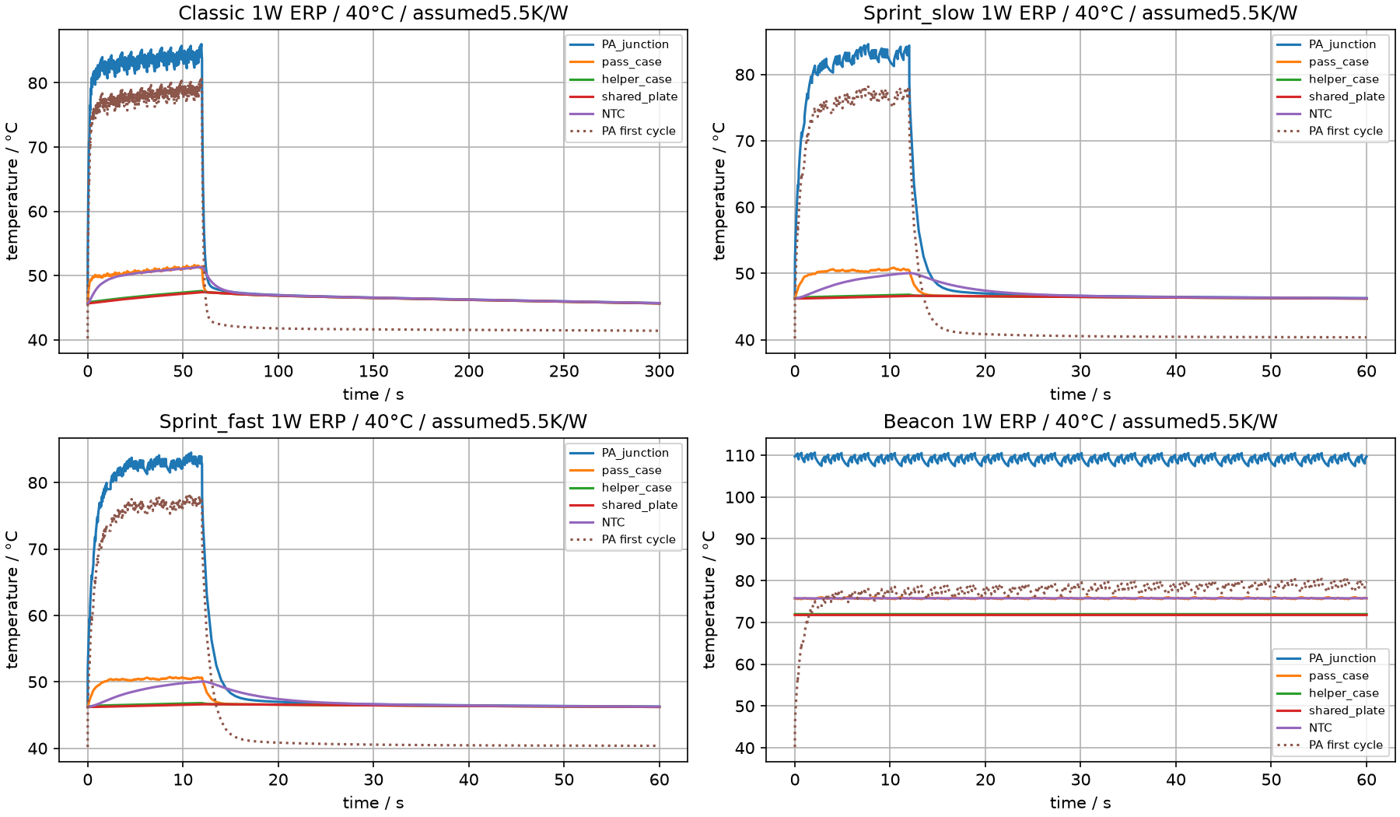
hardware/2m/review/M5B-E6/transient-responses.png
