DD1SB/ARDF-TX/hardware/2m/review/M5B-E6R1/01-carrier-comparison.png

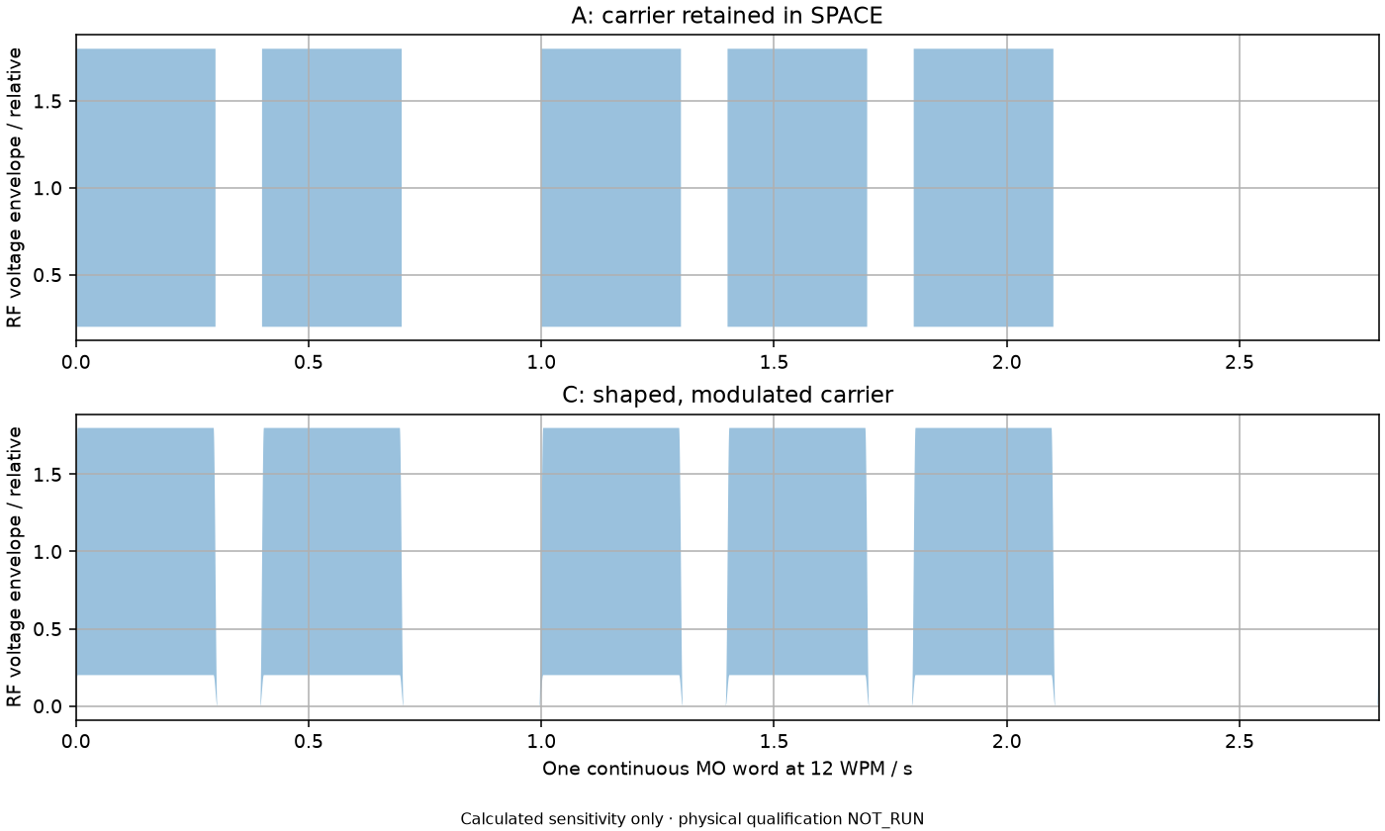
hardware/2m/review/M5B-E6R1/01-carrier-comparison.png
