DD1SB/ARDF-TX/hardware/2m/review/M5B-E6R1/02-device-power.png

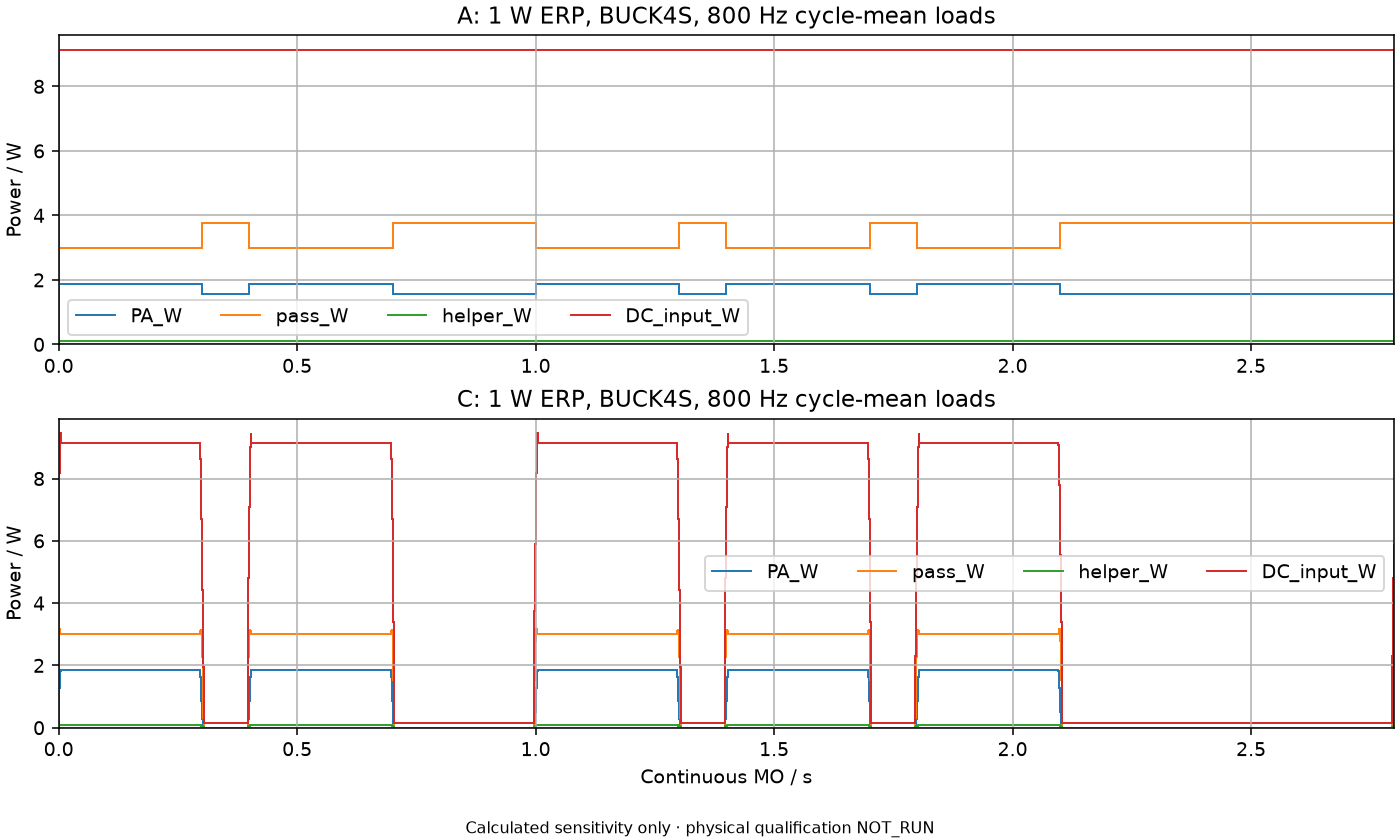
hardware/2m/review/M5B-E6R1/02-device-power.png
