DD1SB/ARDF-TX/hardware/2m/review/M5B-E6R1/03-PA-junction.png

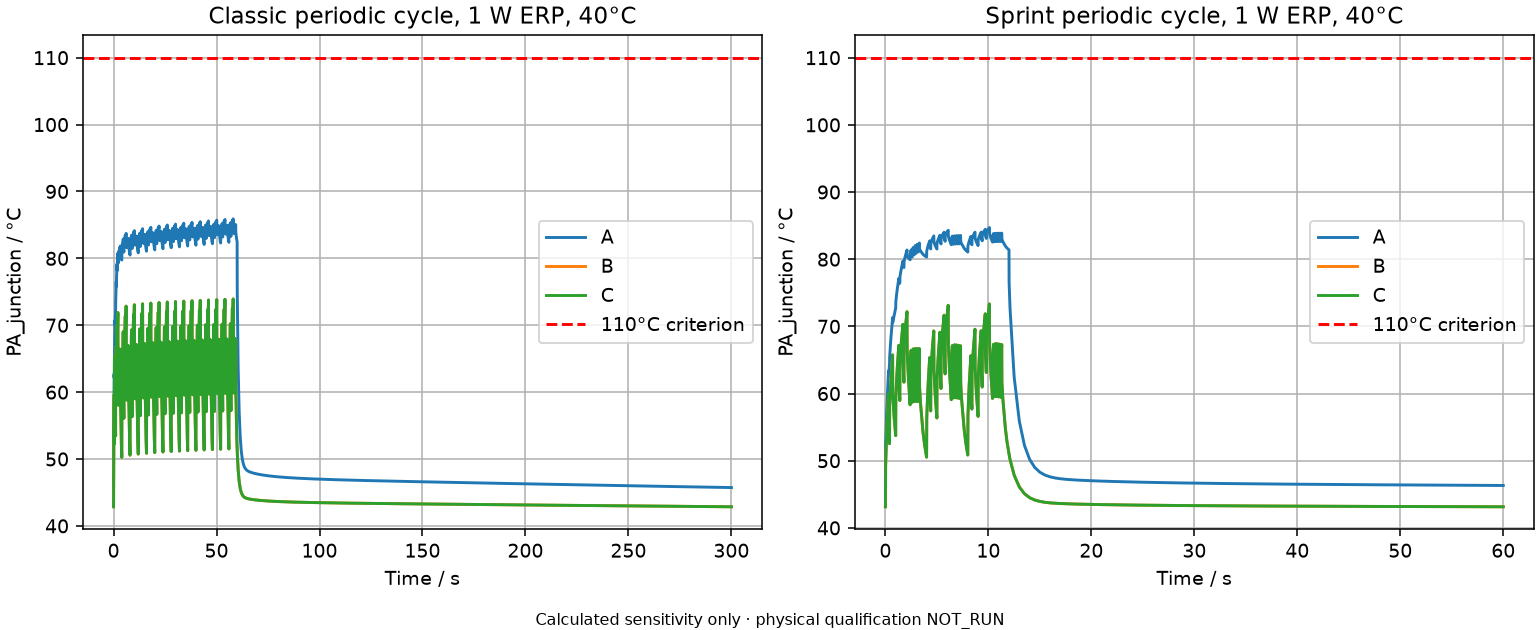
hardware/2m/review/M5B-E6R1/03-PA-junction.png
