DD1SB/ARDF-TX/hardware/2m/review/M5B-E6R1/04-pass-case.png

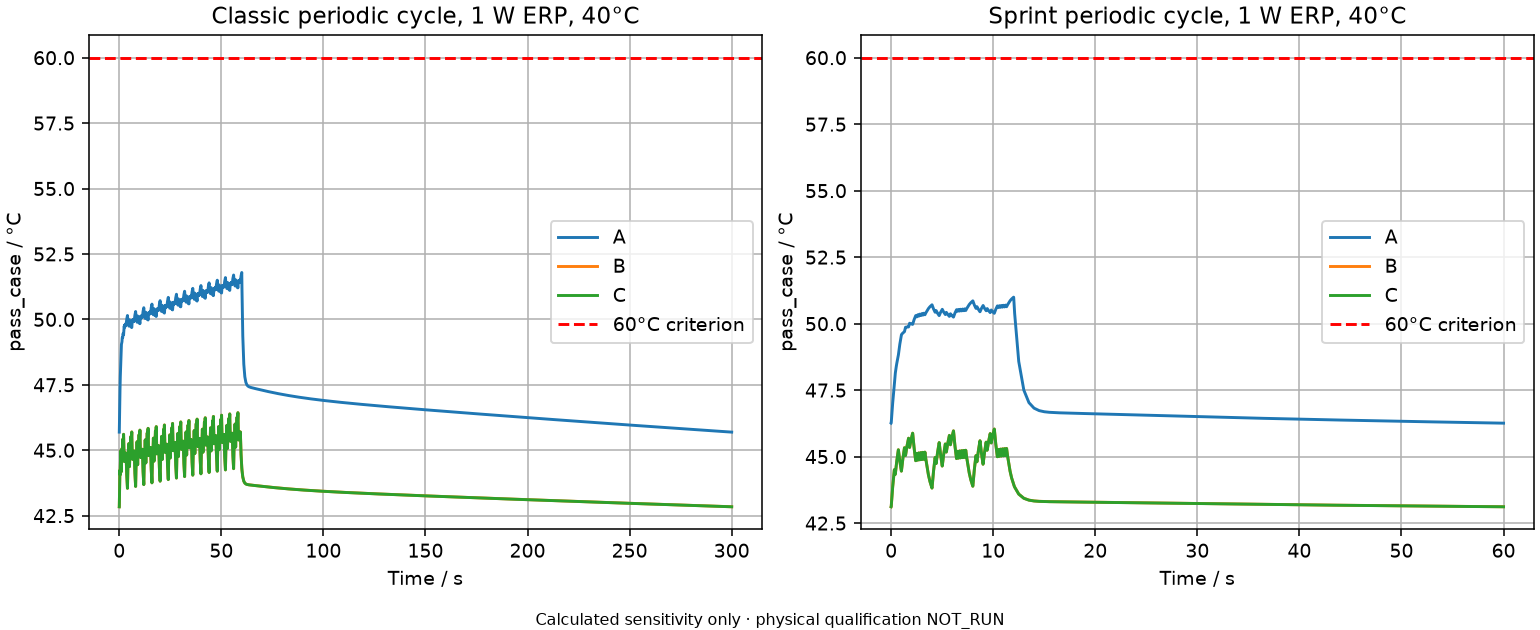
hardware/2m/review/M5B-E6R1/04-pass-case.png
