DD1SB/ARDF-TX/hardware/2m/review/M5B-E6R1/05-continuous-MO.png

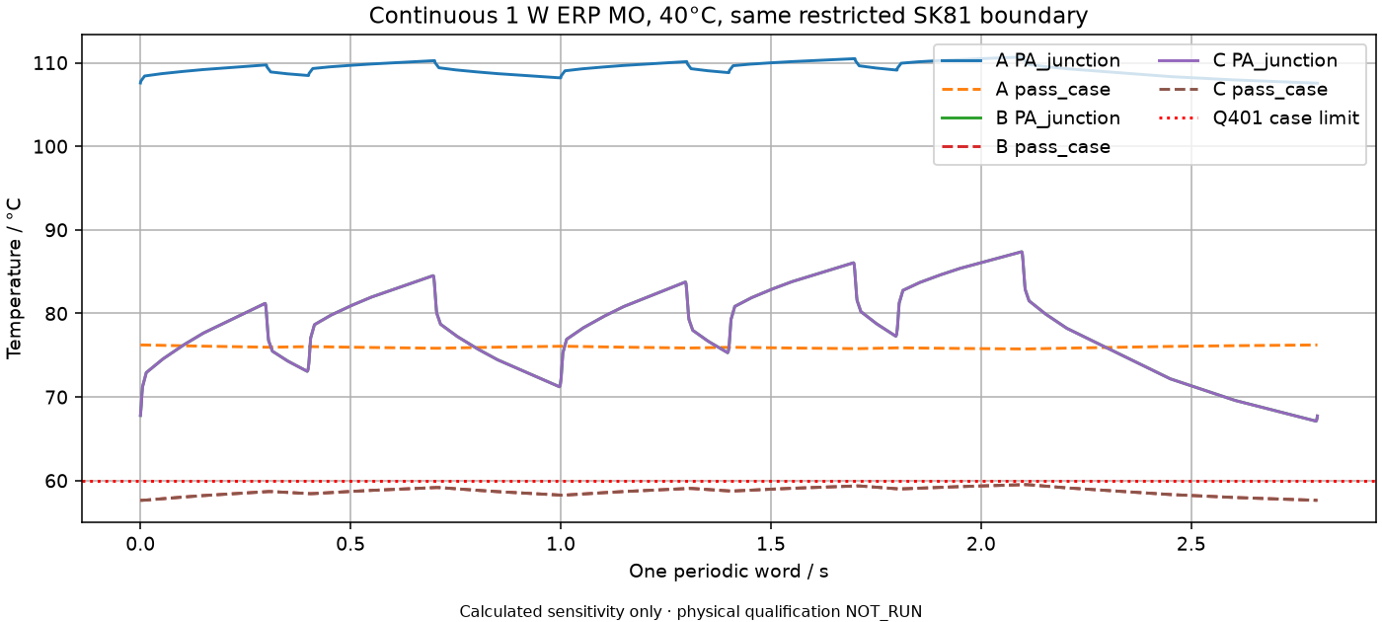
hardware/2m/review/M5B-E6R1/05-continuous-MO.png
