DD1SB/ARDF-TX/hardware/2m/review/M5B-E6R1/06-local-fault-sensitivity.png

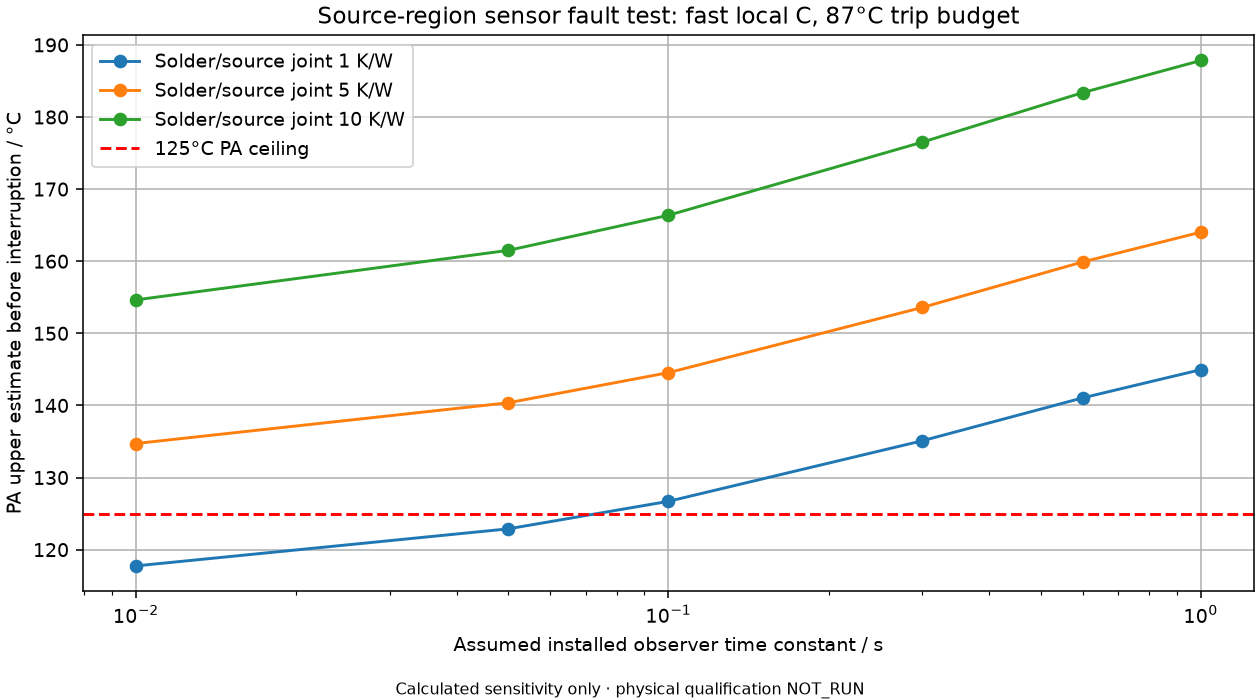
hardware/2m/review/M5B-E6R1/06-local-fault-sensitivity.png
