DD1SB/ARDF-TX/hardware/2m/review/M5B-E6R1/08-ideal-keying-spectrum.png

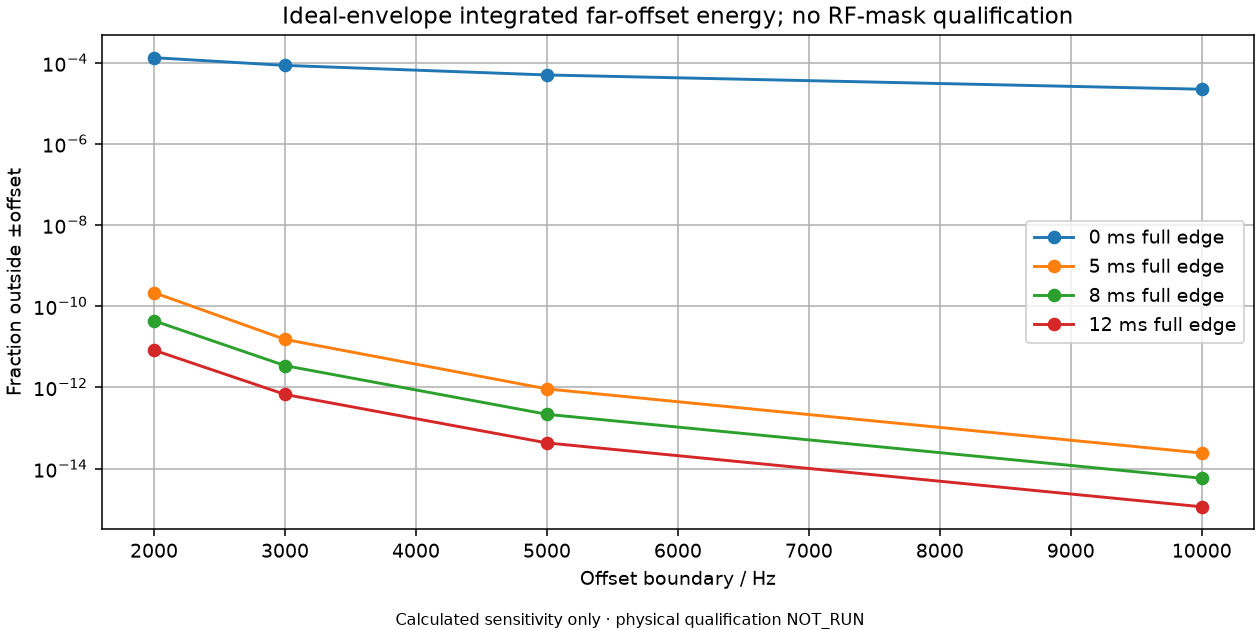
hardware/2m/review/M5B-E6R1/08-ideal-keying-spectrum.png
