DD1SB/ARDF-TX/hardware/2m/review/M5B-E6R2/development/route-mask-CLOCK_OFF-0.png

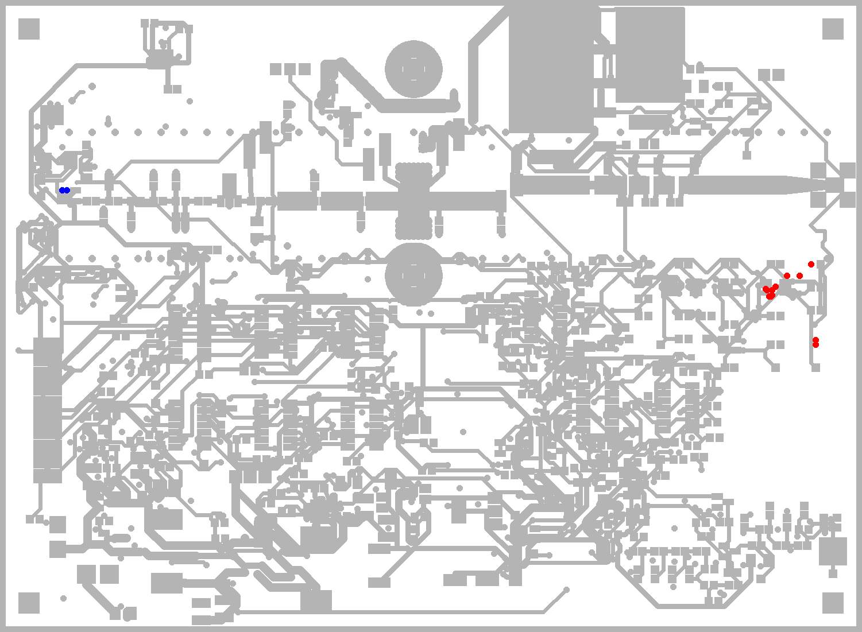
hardware/2m/review/M5B-E6R2/development/route-mask-CLOCK_OFF-0.png
