DD1SB/ARDF-TX/hardware/2m/review/M5B-E6R2/mechanical/complete-isometric.png

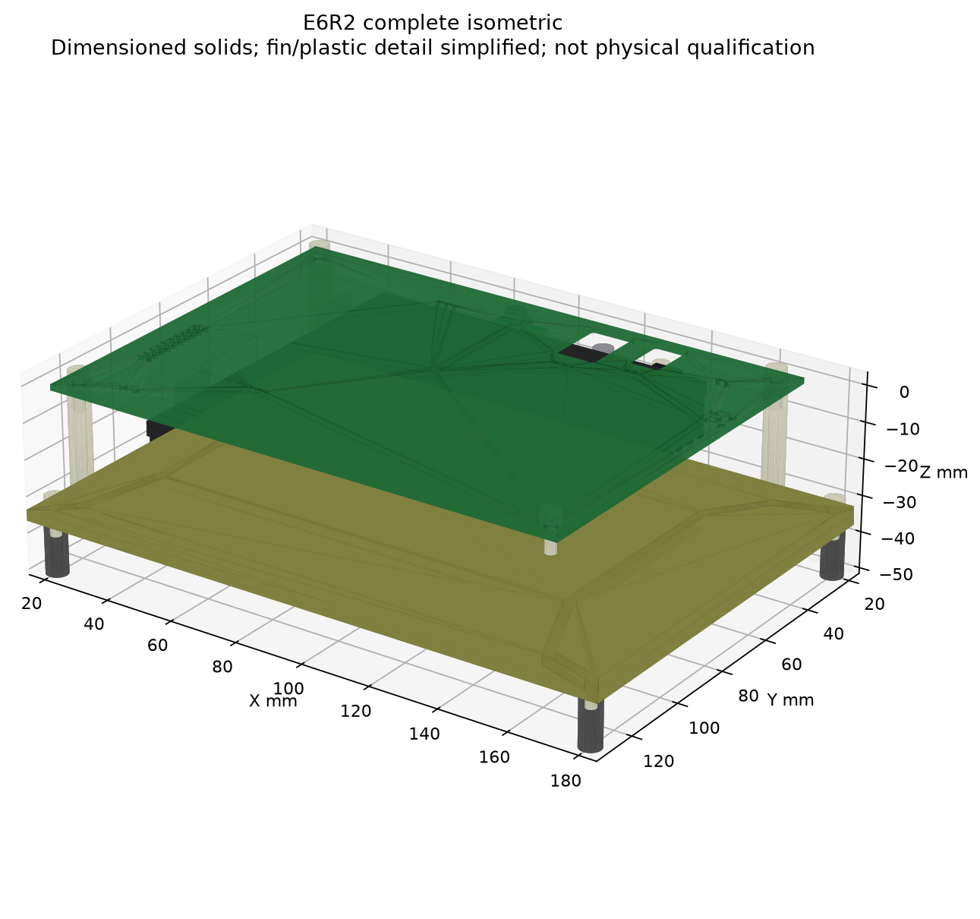
hardware/2m/review/M5B-E6R2/mechanical/complete-isometric.png
