DD1SB/ARDF-TX/hardware/2m/review/M5B-E6R2/mechanical/section-Q401-Q402.png

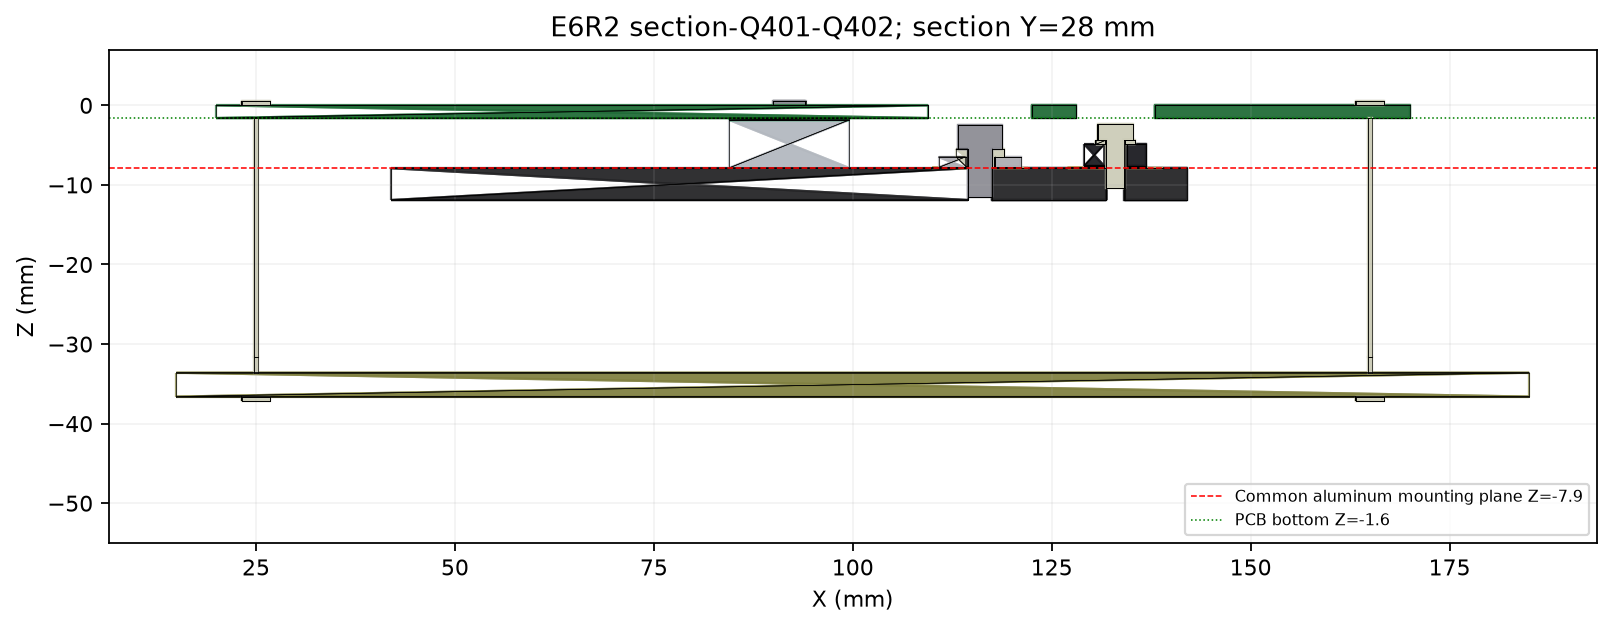
hardware/2m/review/M5B-E6R2/mechanical/section-Q401-Q402.png
