DD1SB/ARDF-TX/hardware/2m/review/M5B-E6R2/mechanical/section-Q401.png

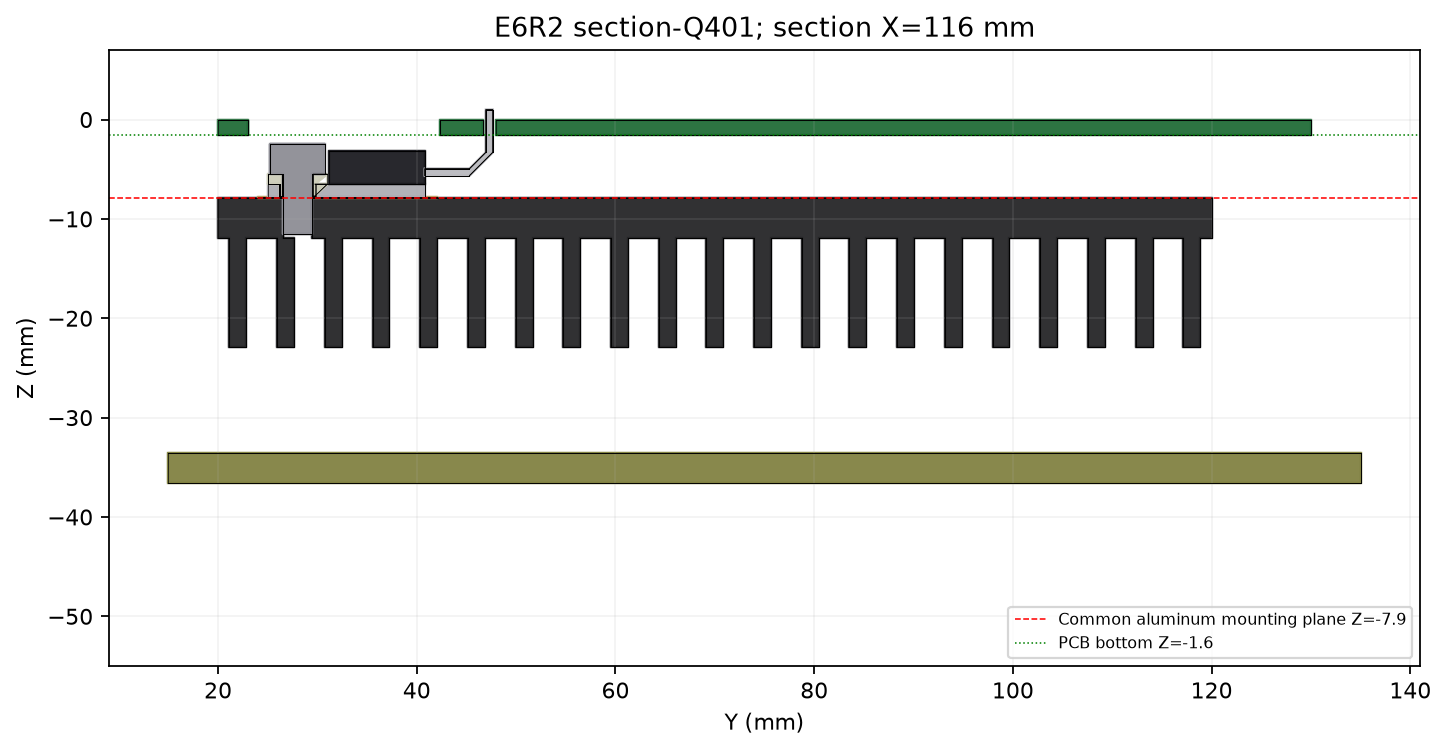
hardware/2m/review/M5B-E6R2/mechanical/section-Q401.png
