DD1SB/ARDF-TX/hardware/80m/handoff/M4A-E2/reference-package/RF80-3D-top.png

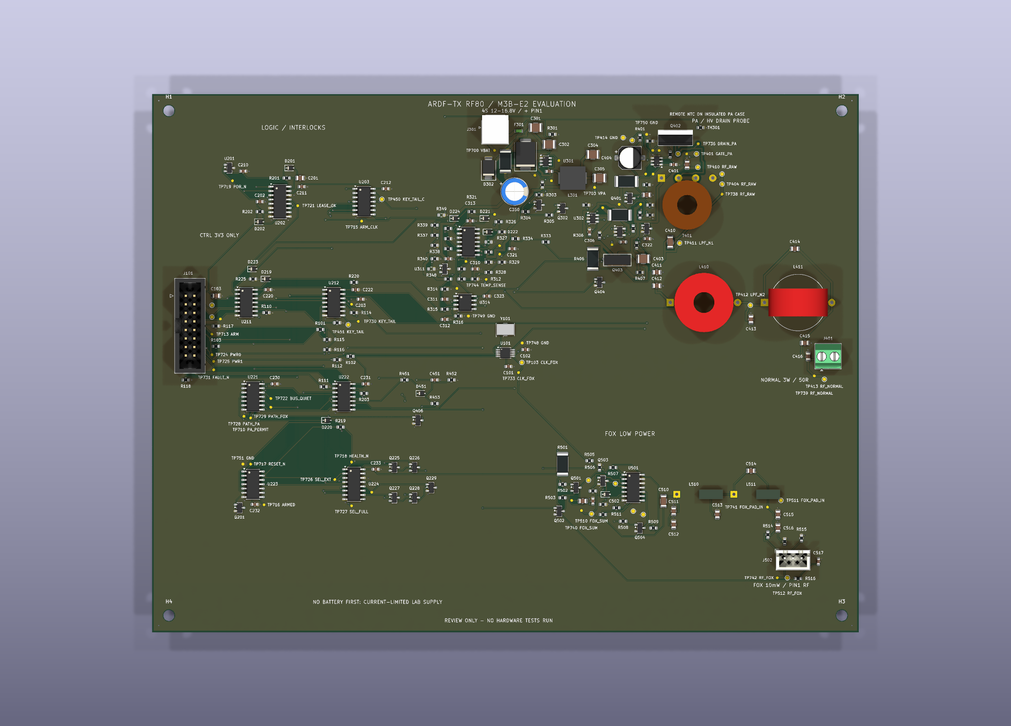
hardware/80m/handoff/M4A-E2/reference-package/RF80-3D-top.png
