DD1SB/ARDF-TX/hardware/80m/handoff/M4A-E2/reference-package/RF80-Q403-3D.png

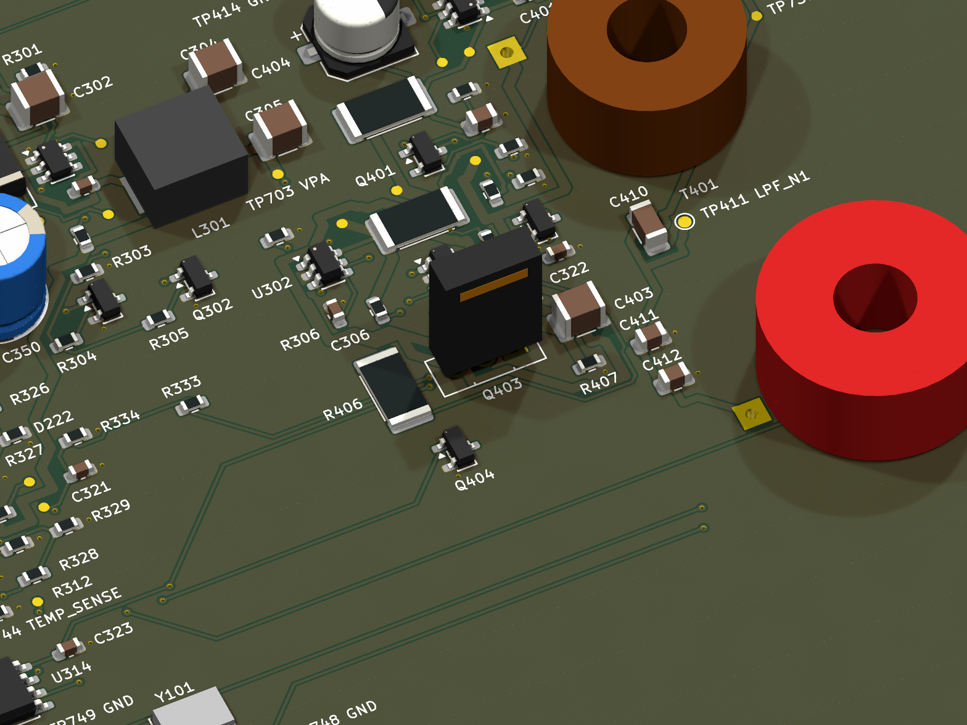
hardware/80m/handoff/M4A-E2/reference-package/RF80-Q403-3D.png
