DD1SB/ARDF-TX/hardware/80m/production/review/M4A-V1R1/RF80_V1-3D.png

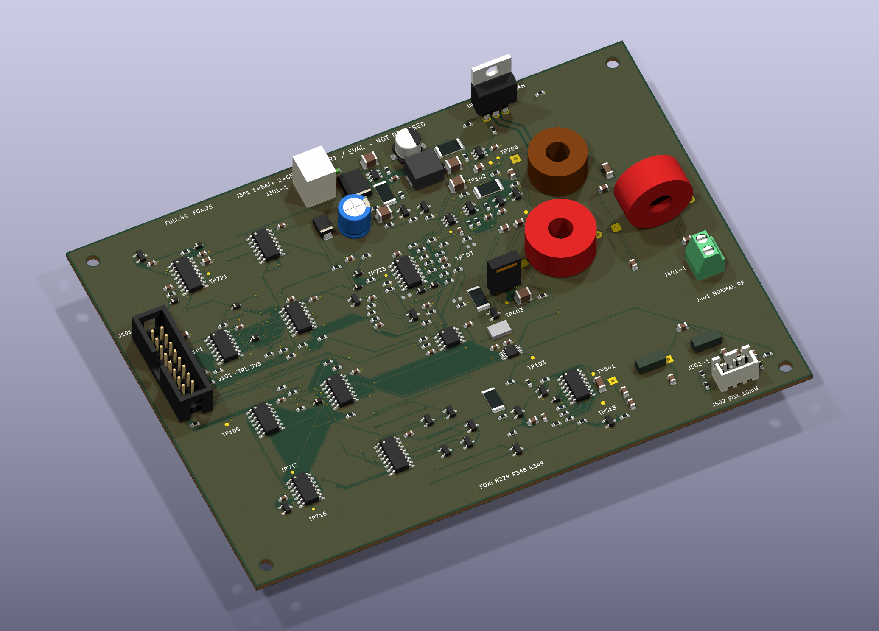
hardware/80m/production/review/M4A-V1R1/RF80_V1-3D.png
