DD1SB/ARDF-TX/hardware/controller/review/M6-C1R1/CTRL-3D-bottom.png

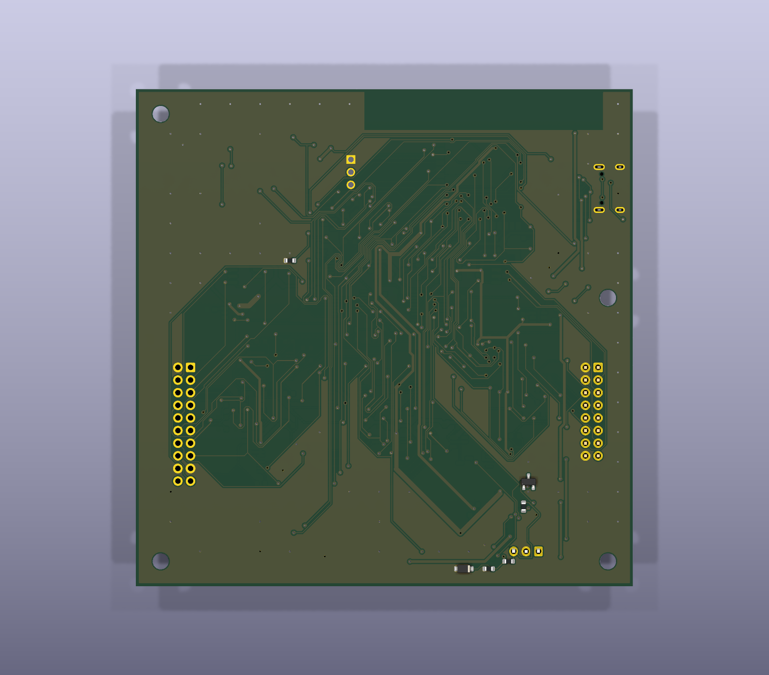
hardware/controller/review/M6-C1R1/CTRL-3D-bottom.png
