DD1SB/ARDF-TX/hardware/controller/review/M6-L1/antenna-feed-detail.png

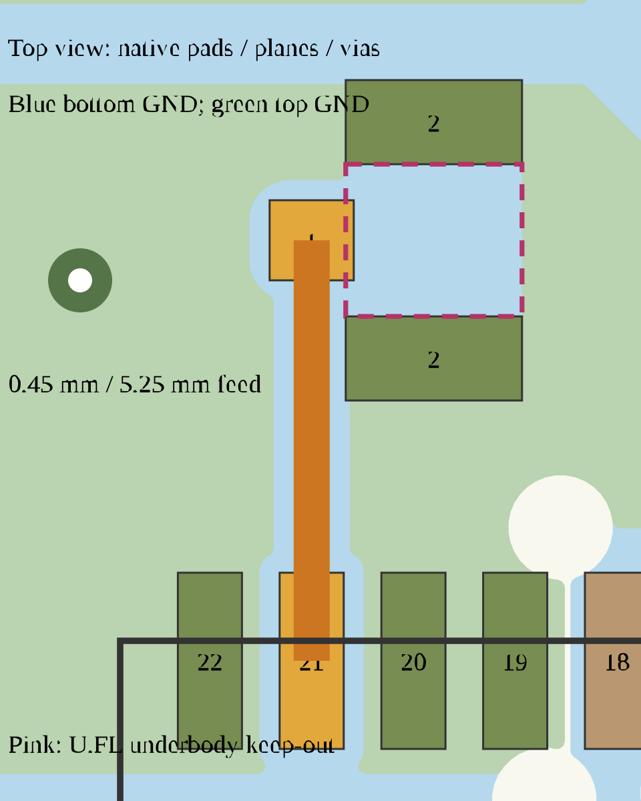
hardware/controller/review/M6-L1/antenna-feed-detail.png
