DD1SB/ARDF-TX/hardware/controller/review/M6-L1/Hirose-keepout-comparison.png

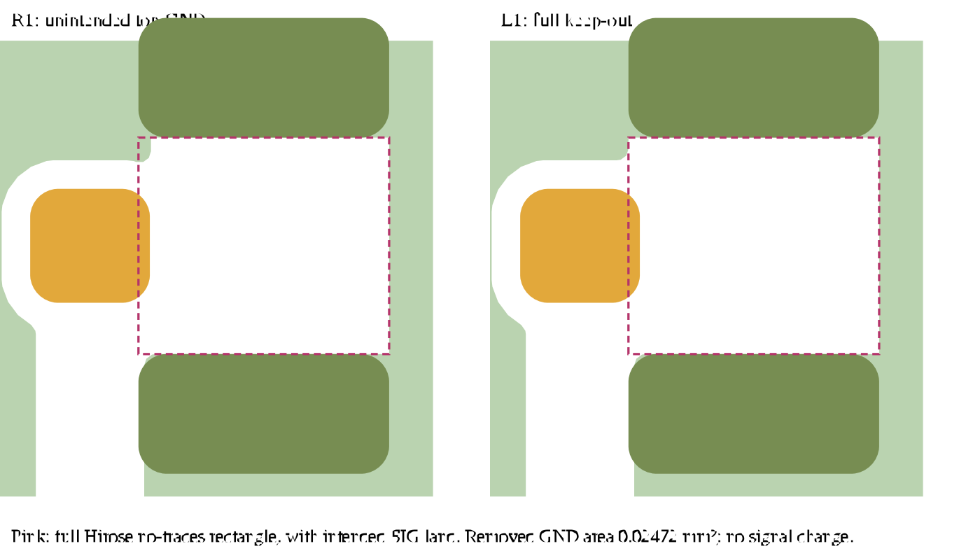
hardware/controller/review/M6-L1/Hirose-keepout-comparison.png
