DD1SB/ARDF-TX/hardware/controller/review/M6-L1/LoRa-native-overview.png

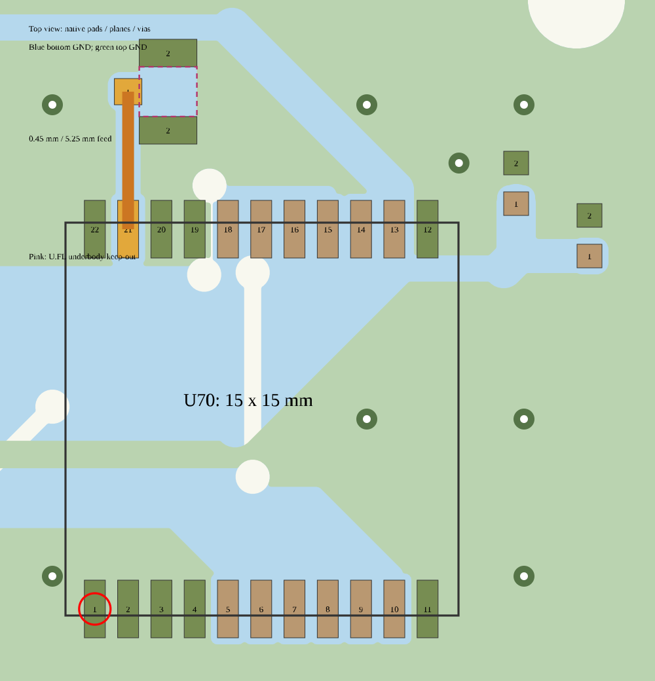
hardware/controller/review/M6-L1/LoRa-native-overview.png
