DD1SB/ARDF-TX/hardware/controller/review/M6-L1/normalized-module-views.png

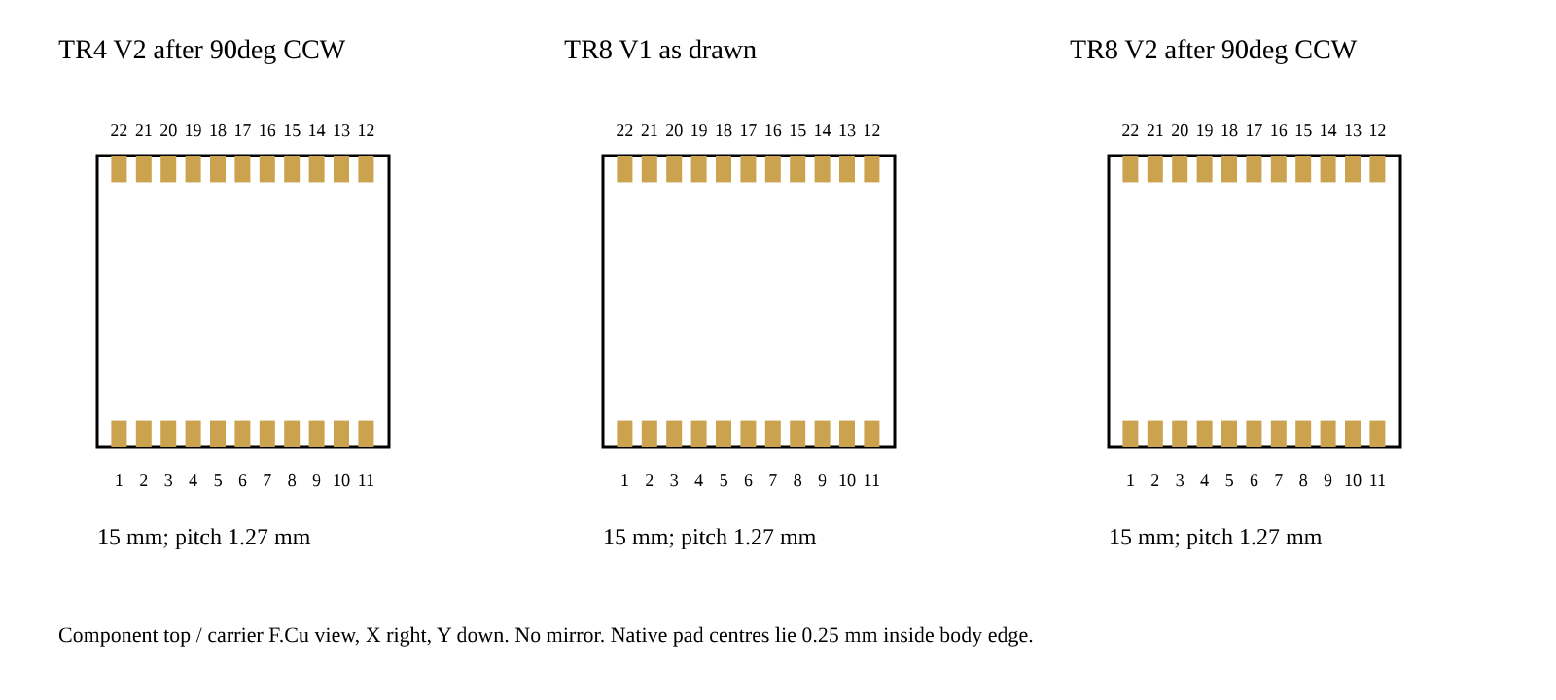
hardware/controller/review/M6-L1/normalized-module-views.png
