DD1SB/ARDF-TX/docs/M5B_E2_COST_DELTA.md

# M5B-E2 cost delta

EUR net; VAT, shipping and labor separate. **No component, MPN, value, population or quantity changes. E1-to-E2 component delta is €0.00 at every quantity.** Copper corrections and the rule change require no purchased parts.

| Population | 6 each | 10 each | 20 each | Fitted parts / ICs | Unquoted at10 |
| --- | ---: | ---: | ---: | ---: | ---: |
| BOOST2S | €54.33 | €50.27 | €49.94 | 272 / 25 | €28.09 |
| BUCK4S | €52.76 | €49.03 | €48.71 | 268 / 25 | €27.95 |
| TRAIN_ONLY | €14.11 | €14.11 | €14.11 | 103 / 13 | €10.02 |

These totals are regenerated from the unchanged manifest using E1 price inputs. [The itemized ledger](../hardware/2m/review/M5B-E2/RF2M_BOM.csv) includes exact MPN, package, block, supplier, MOQ/multiple, pooled demand, availability, price and evidence class for 6/10/20 units. `costs.json`, `E1-E2-cost-delta.json` and generated `COST_SUMMARY.md` preserve full totals. Probe pads and TL structures are not purchased components or ICs.

No new quotation or stock assurance was obtained. Observed prices retain their dates; historical observations remain historical; estimated positions remain unquoted. Critical holds remain: L301 SRP1265A-100M indexed zero stock/backorder; L634 0603HC-47NXJRW non-stocked MOQ1 with indicated nine-week lead time and €0.75 estimated price; U950 conflicting regional inventory and €0.664 estimate. J701, C409 and choke observations are not reserved stock. Confirm exact suffixes and fleet/spare delivery before procurement.

Five 180 × 140 mm, 0.8 mm/70 µm/ENIG bare boards remain an **engineering estimate of €60–100 net per batch**, with €10–25 shipping separately. No actual quote, promotional price or guaranteed supplier premium is assumed. The combined 0.15 mm/70 µm, core, annulus and mask requirements can affect cost. Retained 6/10/20 production-context PCB estimates are €12/€9/€7 each, conditional on the real process.

External thermal materials remain €12/full board estimated: separate sinks, spreader, insulation and fasteners. Harness €3 and antenna/feed €12 are separate allowances. At ten, a 4S installed-module allowance remains €49.03 + €9 PCB + €12 thermal + €3 harness = **€73.03**, or €85.03 with provisional antenna/feed. Controller, battery/BMS, charging, enclosure and labor are excluded. Training does not require the normal PA, converter or watt-level heat hardware.

The optional R651 49.9 Ω driver-test load is approximately €0.025 estimated; reusable coax, probes and shared RF instruments are separate test accessories. No fictitious assembly/calibration labor saving is booked. All tables exclude VAT; destination-specific tax and import treatment remain procurement matters.
