DD1SB/ARDF-TX/docs/M5A_R3_COMPONENT_MODERNIZATION.md

# M5A-R3 — component modernization and sourcing

Dated 2026-10-15. **PRIVATE CONSTRUCTION DERIVATIVE / NOT RELEASED. All ARDF-TX hardware tests NOT_RUN.** No orders, PCB fabrication, assembly or transmission. M5A-R1 remains the archived fallback; RF80, M4A, the controller and accepted ADRs are unchanged.

**No current-production, quote-backed fleet RF component set was established.** The chosen circuit is a faithful review candidate with a blocked physical implementation, not a claim that NOS labels prove reproducibility.

| Original function | R3 choice | Why/change | Current evidence and pin/package consequence |
| --- | --- | --- | --- |
| Crystal oscillator/first doubler | Si5351 plus gated72MHz fundamental filter | Programmability; removes T1/T2 and original local scheduler | CLK0=RF/2, retained T3 doubles; CLK2=RF for training. Same PLL_A=6×RF with MS0=12/MS2=6. New input level requires end-to-end alignment |
| T3 BF981 | Philips BF981 retained | Retain original doubler and matching; do not substitute an unqualified BF998 | [Dönberg](https://www.donberg.ie/search?group=&maxlines=100&page=1&query=PHILIPS&wordflag=and) lists Philips,pack5/€15net. Six boards allocate10devices,€5/board;10/20 allocate€3. NOS quantity/spares not confirmed. [Philips Dec1990](https://datasheet.octopart.com/BF981-NXP-Semiconductors-datasheet-180991380.pdf),p155:1S2D3G2 4G1,SOT103; physical landing OPEN |
| T4 2N4427 | Central2N4427 numeric symbol; exact supplier manufacturer OPEN | Retain RF stage, not a new MMIC | [Central datasheet/PDN](https://my.centralsemi.com/datasheets/2n4427.PDF):1E2B3C,TO39,400mA. Appended PDN01114(2019) explicitly EOL. [Dönberg](https://www.donberg.ie/catalogue/semiconductors/semiconductors_2-2n/2n_4427.html) €5.90net,pack1,unidentified maker. **Not a Central quote**;≥10mm body stand-off/possible sink retained |
| T5 MRF237 | ASI MRF237 evaluation symbol ONLY | Exact original part family, not a newly designed LDMOS PA; manufacturer remains unresolved at available EU listing | [ASI manufacturer datasheet RevA, mirror](https://pdf.dzsc.com/F23/MRF237.pdf):1E2B3C,TO39,1A,22°C/W. [Manufacturer MRF catalog](https://www.adsemi.com/families/MRF) lists device, no fleet quote or delivery commitment. [Dönberg](https://www.donberg.ie/catalogue/semiconductors/semiconductors_md-mz/mrf_237.html) €31.90net,pack1 but maker unspecified. **Cannot apply that listing to ASI as verified sourcing** |
| Motorola MRF237 alternative identity | Not substituted into ASI symbol/PCB | User warned physical manufacturer variants differ | [Original Motorola sheet](https://datasheet4u.com/pdf/1114783/MRF237.pdf) specifies case79-03 STYLE5 and **640mA** continuous, not ASI1A. Retrieved two-page sheet lacks the separate complete case-style pin legend. Motorola numeric pin mapping remains UNVERIFIED. Original article's1A statement cannot override the exact maker's sheet |
| L4–8 | Original Neosid00511732 /00511830 /00511631 | Keep factory tuning coils and original coupling/placement | [Neosid geometry/table](https://neosid.de/import-data/product-pdf/neoFilterspulen_5_7_10.pdf),p3.29,7.1E:bottom view A/E,7.5mm can dimension,12mm height,3.5±0.3mm leads. Current [red-coil listing](https://neosid.de/produkte/filter-und-spulenbausaetze/abgleichbare-filterspulen/53506/helix-filter-7.1e/51-nh) conflicts in nominal label with catalog range. [BEC](https://bec.co.uk/product-category/neosid/helix-filter-7-1e-51-nh/) says in stock,price by request. €3 each is **estimate**, not quote; count/lot/landing confirmation OPEN |
| DR2/3/4 | Original choke ranges and VK200 construction | No arbitrary RF chip substitution | Exact current maker, SRF/current, mechanical outline and supply OPEN. Minimum requirements and ranges are on schematic. Not counted as qualified magnetics |
| BD676 T8 | ST TIP127 | Currently listed ST Darlington; same series collector-supply mechanism, different package | [ST product](https://www.st.com/en/power-transistors/tip127.html), [DS0854 Rev5](https://www.st.com/resource/en/datasheet/tip127.pdf):1B2C/tab3E,TO220. Original onsemi BD6761E2C3B is **not pin-compatible**. Retain bias/filter values; recalibrate current, carrier and sine depth. €0.75 estimate,not factory500-unit price |
| NE555/local timing | Common ESP32-S3 filteredPWM, existing RF2M reconstruction | Avoid duplicate contest controller; provide sineAM | No S3 analog DAC assumed. Preserve AF filter and Darlington input mechanism; controller must store new revision-specific calibration |
| R0/R1 premium driver/final chain | Removed from active R3 | Not the selected proven RF circuit | PHA-1+/PHA-13HLN+,PD54008/PD55008,D45H11 and dedicated5V MMIC regulator absent from fitted R3 positions; original fallback archived |

RF Parts genuine Motorola/Microsemi listings encountered export restrictions; they are not booked as a German fleet source. Marketplace assertions and broker inventories were not accepted as production sourcing. No contacts or quote requests were sent.

## Physical pin audit versus actual footprint readiness

[Machine-readable pin audit](../hardware/2m/review/M5A-R3/pinout-audit.json) checks **31 numeric schematic device maps** against actual exported nets. It explicitly separates verified terminal numbers from approved PCB landings. Mutations swapping ASI base/collector, Central emitter/collector, TIP127 base/emitter and BF981 gates must fail.

**No RF power footprint is guessed.** Q901/Q902/Q903 lack approved footprints. SOT103 lead trimming, original TO39 height/cooling and exact final manufacturer must be resolved together. The ASI drawing does not authorize placing a different MRF237 maker on its pin numbering. TIP127 tab is modulatedVPA; use electrical insulation from ground/other live devices and account for interface thermal resistance. Choke/trimmer/connector geometry and TPS611781 RNW landing are also OPEN.

There are19 unset physical footprint fields, including optional populations; ERC's warning count is smaller because some custom symbols have no footprint filter. **An unflagged custom symbol is not a qualified footprint.** The PDF/netlist are electrically reviewable; a manufacture-ready PCB is not defensible yet.
