DD1SB/ARDF-TX/docs/M3B_COMPONENT_QUALIFICATION.md

# M3B — component and footprint qualification

> **2026-10-15 correction notice:** This is a historical pre-E2 record. E1/R1 ST BD140 pin/orientation claims and the E1 manufacturing recommendation are superseded by [M3B-E2 corrections](M3B_E2_CORRECTIONS.md) and the [E2 decision](M3B_E2_REVIEW_DECISION.md). Use E2 assembly/netlist files: Q403 **1B/2C/3E**, illustrated ST face toward **PCB+Y**, and U311 TI DBZ **1K/2REF/3A**. E1 drawings are not build instructions. Frozen historical checks are not current E2 verification.

Date: **2026-10-14**, M3B-E1. This is a package/pinout/landing review, **not incoming inspection or a released procurement list**. Current materials and exact supplier codes are in the generated [workbook](M3B_COMPONENT_WORKBOOK.md)/[CSV](M3B_BOM.csv). Historical indexed prices are not fresh stock reservations. The [dated source log](M3B_SOURCES.md) identifies inaccessible documents and model substitutions.

## Critical mappings

| Reference / exact candidate | Package and physical pin verification | Footprint / mechanical treatment | Remaining gate |
| --- | --- | --- | --- |
|U401 **LM5134BMF/NOPB** |TI DBV/SOT23-6:1 VDD,2 PILOT NC,3 OUT,4 GND,5 INB active-high inhibit,6 IN;0.95 mm pitch, body2.9×1.6 mm nominal |KiCad SOT-23-6: center columns±1.1375 mm,1.325×0.6 lands; standard3D body. Clock/inhibit physical pad nets checked |Exact EU cut-tape basket and hot rail-fault response OPEN; do not substitute LM5134 suffix/pin mapping blindly |
|Q402 **IRF610PBF-BE3** |Vishay TO220AB:1 G,2 D,3 S; tab D;200 V rating is not a measured RF peak margin |Local **TO220_Vertical_1p3Drill** derived from KiCad vertical TO220.2.54 mm pitch,1.905 mm lands, **1.3 mm finished holes** |Vishay general TO220AB max lead1.01×0.61 mm has1.18 mm diagonal;1.3 mm is a conservative drill correction. Exact IRF610-specific body/lead forming and incoming part dry-fit required; general outline is not claimed as an exact lot drawing |
|Q403 **ST BD140** |SOT32/TO126; **1 emitter,2 collector,3 base** from retained original internal diagram; ST device, no alternate-vendor pinout assumed |KiCad TO126-3 vertical,2.28 mm pitch,1.0 mm drill, native standard body model |ST primary PDF text accessible, new binary/screenshot fetch incomplete; retained R1 pin review used. Exact incoming lead fit, face orientation and hot SOA remain mandatory; no arbitrary same-name substitution |
|U301 **TPS54302DDCT** |TI DDC/TSOT23-6:1 GND,2 SW,3 VIN,4 FB,5 EN,6 BOOT; EN is not raw-pack tolerant |Native TSOT-23-6; compare DDC drawing, not a generic SOT footprint by pin count. Local boot/input/output loops preserved |Supply startup, feedback selection, hot inductor and converter fault response OPEN |
|U302 **TPS22810DBVR** |TI DBV:1 VIN,2 GND,3 ON,4 CT,5 QOD,6 VOUT |Native SOT-23-6, correct device orientation and logical source/VOUT nets |18 V operation/20 V absolute; actual fault opening≤20 µs not guaranteed by typical timing. Input/driver gates must pass |
|R330 **WSL2512R0500FEA**, U313 **INA180A1IDBVT** |2512 50 mΩ/1%; INA180 DBV1 OUT,2 GND,3 IN+,4 IN−,5 VS |Native2512 and SOT23-5; sense pair independently leaves shunt lands; actual pad mapping checked |Two-terminal shunt is not a four-terminal resistor; Kelvin placement/offset/RF rejection need differential measurement |
|U202 **74HC123D,653** |Nexperia SO16: Q1 **13**, /Q1 **4**, Q2 **5**, /Q2 **12**. Correct R1 Q13 lease and /Q12 holdoff retained |Native SOIC16 3.9×9.9 mm,1.27 pitch; power8/16; RC/trigger pins verified in current netlist |RC sensitivity bounds are not guaranteed manufacturer timing corners; power/reset/propagation qualification OPEN |
|U224 **74HC174D,653** |Nexperia SO16: MR1, CP9, GND8,VCC16; D/Q pairs3/2,4/5,6/7,11/10,13/12,14/15 |Same SOIC16 geometry; original raw-ARM context capture and health-clear pins retained |Exact current distributor basket OPEN; reset recovery and delay races physical gate |
|Other HC logic |Original HC00/08/11/21/32/74/14 manufacturer physical-pin maps retained; no pin-polynomial rewrite for routing |Native SOIC14/16 according to actual MPN; HC21 package NC pins remain unconnected |Static truth table does not prove startup under a collapsing rail |
|U501 **SN74AC00DR** |TI SOIC14:1/2→3,4/5→6,9/10→8,12/13→11;GND7,VCC14; fourth gate grounded/NC output |Native SOIC14 3.9×8.7 mm,1.27 pitch. Three outputs retain individual summing resistors; no direct CMOS output paralleling |Supply shaping passes below2 V during edges; output/logic behavior, rail-following input clamp, backpower and10 mW calibration must be measured |
|U101 **SI5351A-B-GT** |Skyworks MSOP10,3×3 mm,0.5 pitch:1 VDD,2 XA,3 XB,4 SCL,5 SDA,6 CLK2,7 VDDO,8 GND,9 CLK1 NC,10 CLK0 |Native MSOP10; 0.15 mm rule suits its pad gap; standard3D model resolves |Frequency/reference calibration, clock-off leakage/spurs and source/LoRa immunity remain OPEN |
|Y101 **ABM3B-25.000MHZ-10-1-U-T** |Abracon5×3.2 mm, active pads1/3; pads2/4 grounded. CL10 pF part, not the similarly named18 pF version |Native5032 four-pad land. Local conservative dimension envelope replaces missing installed KiCad model; source height1.1 mm max, model allows1.3 mm |Chamfer may be on1 or4 per maker; inspect drawing/marking, not chamfer alone. No claim of shipped frequency stability/calibration |
|L301 **SRP7050TA-100M** |Bourns10 µH, maker body7.3±0.3×6.6±0.3 mm,4.8±0.2 high; original recommendation outer land width8.4/gap2.5/height3.5 mm |Local SRP7050TA lands follow maker recommendation; conservative7.6×6.9×5 mm model |Heat/ripple/peak-current qualification at real frequency/load; broad “≥3 A” schematic caption does not replace actual part selection |
|C404 **25SVPF47M** |Panasonic47 µF25 V ±20%, native6.3 mm polymer can. Manufacturer30 mΩ at100 kHz20°C is not all-temperature transient ESR |Native6.3×5.9 mm body/land; polarity visible |Minimum37.6 µF credited; ESR≤0.5 Ω at relevant temperature/fault waveform remains qualification gate |
|C350 **EEUFR1V101** |Panasonic100 µF35 V ±20%,8 mm diameter,11.5 mm long,3.5 mm lead pitch,0.6 mm lead |Native CP radialD8/P3.5;0.8 mm drill; polarity/body verified against original table |Hot/inrush/pulse life and exact basket OPEN |
|F301 **046701.5NR** |Littelfuse467 is **0603**, not the R1 assigned1206.1.5 A32 V; nominalI²t0.0766 A²s; interrupt35 A |Corrected local maker reflow lands: outer2.54 mm,gap0.36,width1.02;0.725 mm pad centers. Own dimension model |Upstream BMS/fault-current and pulse-life coordination; no assumption of unlimited Li-ion interruption |
|J101 **Wurth61201621621** |2×8 IDC,2.54 pitch; body27.98±0.2 mm; row span17.78; maker finished hole1.1±0.15 mm |Cached native keyed body, pads1.9 mm, **holes1.2 mm** within maker recommendation; same pin1/keying, native3D |Exact mating cable key/pin1 and hole-finish tolerance check before assembly |
|J301 **B2P-VH(LF)(SN)** |JST VH vertical2way,3.96 pitch, makerB=7.86 mm; height10.9 mm/header envelope8.5 mm |NativeJST VH pad/drill1.7 mm. Missing installed/downloadable model replaced by **own labeled dimensional envelope**, not a false supplier model |Verify mating housing/contact/wire gauge/pin1 polarity; common keyed power interface remains only for protected4S normal use |
|J401 **Phoenix1727010** |MKDS1/2-3.81, **3.81 mm**, not3.50 mm1751248 |Native exact3.81 terminal footprint,1.1 mm drill/native body |Coax/load adapter is external; short RF return and manual screw orientation inspection |
|J502 **B3B-XH-A(LF)(SN)** |JST XH vertical3way,2.50 pitch, separate from normal terminal |Native exactXH footprint and body |Pin1 RF/pin2 return/pin3 identity; matching accessory and mating cable still required |

## Wound parts and assembly checks

**T401** is the original **FT-50A-43**, not the thinner FT50-43 substituted by name. Core dimensions are nominal12.7 mm OD/7.92 mm ID/6.35 mm high. Wind two **9-turn AWG24 enamel wires**, about24 cm each as a starting length, bifilar and same sense. Astart1/dot, Afinish2, Bstart3/dot, Bfinish4;2+3 join the drain. One pass through the hole is one turn. Confirm series-aiding phasing with a low-energy generator before fitting the PA. Starting AL480 nH implies38.9 µH per winding; this is a calculation, not a measured transformer. The formed-lead fixture now has inline1/2/3/4 at5.08 mm pitch,2/3 adjacent,1 mm drills. The magnetic/electrical reference is unchanged; lead geometry is new and needs dry-fit and RF testing.

**L410/L411** retain MicrometalsT60-2, **20 turns AWG24**, approximately46 cm starting wire length. Nominal AL6.5 nH gives2.60 µH; original labeled2.7 µH is retained pending measurement/trimming to the original filter response. Core nominal15.24/8.53/5.94 mm; use max15.75/min8.03/max6.45 envelope plus winding. L410 flat, L411 upright and orthogonal. Do not substitute unidentified powdered-iron material or explain away a wrong measured inductance. Local models include winding allowance and do not certify winding parasitics.

**L510/L511** retain Bourns **78F2R7J-RC**2.7 µH ±5%, original axial landing/forming and current limits; these are not the watt filter toroids. Core/wire suppliers and estimate status are retained in the BOM. No unknown marketplace “equivalent” has been qualified.

## Availability and procurement blockers

Manufacturer pin/package documentation was reviewed or retained from R1; **no blanket statement of all parts in stock is justified**. Existing observations retain date/localization limitations. LM5134B exact EU cut-tape supply, HC174 basket, custom-wound core availability, capacitor ESR evidence, pulse-resistor qualification and harness/contact exact codes must be settled before component procurement. MOQ1 cut-tape assumptions are explicit in the CSV; no reel-only purchase or nonexistent supplier number is invented. Exact incoming component inspection and a1:1 printed-footprint fit are Stage0 gates.

The board has no purchased test connectors beyond the original module connectors. Native standard-body models and eight own dimensional envelopes are identified separately. No heatsink, sensor bond or exact connector mating clearance is qualified merely by a3D picture. These uncertainties do not prevent a **bare evaluation board** from being independently reviewed; they block unrestricted hardware commissioning and product release.
