DD1SB/ARDF-TX/docs/M3B_E2_COMPONENT_WORKBOOK.md

# M3B-E2 — itemized component workbook

Date: **2026-10-15**. Generated from the current manifest; E1 preserved separately. EUR net. Same MPNs pooled across each population; **ordered quantities are per MPN pool**, not repeated per reference. Historical observations retain the exact source limitations; estimated values and OPEN supplier codes are unquoted. No order is authorized. PCB, batteries, antenna, harness mates, thermal fixture, labor and instruments are separate. All 74 test pads and four mounting holes are fabricated features, not purchased parts. TH301 is one purchased remote sensor, not two.

| Population | Physical purchases | ICs | 1 board | 3 boards, each | 5 boards, each | 6 | 10 | 20 |
| --- | ---: | ---: | ---: | ---: | ---: | ---: | ---: | ---: |
| Full | 196 | 18 | 32.317 | 32.065 | 31.981 | 31.896 | 27.311 | 27.311 |
| Fox | 115 | 13 | 13.759 | 12.273 | 12.081 | 12.081 | 10.815 | 10.468 |

## Full

| MPN / refs | Footprint | Supplier / code / MOQ / multiple | Price provenance / availability | Unit price at batch 1 / 6 / 10 / 20 | Allocated per board at 1 / 6 / 10 / 20 |
| --- | --- | --- | --- | ---: | ---: |
| 1727010; J401 | TerminalBlock_Phoenix:TerminalBlock_Phoenix_MKDS-1-2-3.81_1x02_P3.81mm_Horizontal | Phoenix/TME/DigiKey; 1727010; distributorcode OPEN; MOQ1; multiple1 | ESTIMATE; Exact basket/stock OPEN; [source](https://www.phoenixcontact.com/en-us/products/pcb-terminal-block-mkds-1-2-381-1727010) | 1.0000 / 1.0000 / 1.0000 / 1.0000 | 1.0000 / 1.0000 / 1.0000 / 1.0000 |
| 25SVPF47M; C404 | Capacitor_SMD:CP_Elec_6.3x5.9 | DigiKey; P16513CT-ND; MOQ1; multiple1 | OBSERVED_R1_INDEX; DE index48247; direct fetch cache miss; Active/cut tape MOQ1; basket recheck; [source](https://www.digikey.de/en/products/detail/panasonic-electronic-components/25SVPF47M/4204845) | 1.5000 / 1.5000 / 0.9730 / 0.9730 | 1.5000 / 1.5000 / 0.9730 / 0.9730 |
| 74HC00D,653; U212 | Package_SO:SOIC-14_3.9x8.7mm_P1.27mm | Mouser; 771-74HC00D-T; MOQ1; multiple1 | OBSERVED_M2; M2 indexedNexperia SOICstock; exactcurrentcut-tapebasketOPEN; [source](https://assets.nexperia.com/documents/data-sheet/74HC_HCT00.pdf) | 0.1720 / 0.1720 / 0.1030 / 0.1030 | 0.1720 / 0.1720 / 0.1030 / 0.1030 |
| 74HC08D,653; U222 | Package_SO:SOIC-14_3.9x8.7mm_P1.27mm | Mouser; 771-74HC08D-T; MOQ1; multiple1 | OBSERVED_M2; 37703 cached EU; [source](https://eu.mouser.com/ProductDetail/Nexperia/74HC08D653?qs=P62ublwmbi%2FQCxm29EB%2FyA%3D%3D) | 0.1630 / 0.1630 / 0.1140 / 0.1140 | 0.1630 / 0.1630 / 0.1140 / 0.1140 |
| 74HC11D,653; U221 | Package_SO:SOIC-14_3.9x8.7mm_P1.27mm | Mouser; 771-74HC11D-T; MOQ1; multiple1 | ESTIMATE; Exact basket/stock OPEN; [source](https://assets.nexperia.com/documents/data-sheet/74HC_HCT11.pdf) | 0.1600 / 0.1600 / 0.1600 / 0.1600 | 0.1600 / 0.1600 / 0.1600 / 0.1600 |
| 74HC123D,653; U202 | Package_SO:SOIC-16_3.9x9.9mm_P1.27mm | Mouser; 771-74HC123D-T; MOQ1; multiple1 | OBSERVED_M2; 1037 newer EU vs zero older NL/BR; conflict; [source](https://eu.mouser.com/en/ProductDetail/Nexperia/74HC123D653?qs=P62ublwmbi%2FMZUrC9zEqyg%3D%3D) | 0.3270 / 0.3270 / 0.2190 / 0.2190 | 0.3270 / 0.3270 / 0.2190 / 0.2190 |
| 74HC14D,653; U203 | Package_SO:SOIC-14_3.9x8.7mm_P1.27mm | Mouser; 771-74HC14D-T; MOQ1; multiple1 | OBSERVED_M3; Mouser indexed862904; actualbasketOPEN; [source](https://www.mouser.es/ProductDetail/Nexperia/74HC14D653?qs=P62ublwmbi8OHaKXqv2GmQ%3D%3D) | 0.1720 / 0.1720 / 0.1180 / 0.1180 | 0.1720 / 0.1720 / 0.1180 / 0.1180 |
| 74HC174D,653; U224 | Package_SO:SOIC-16_3.9x9.9mm_P1.27mm | Nexperia/DigiKey/Mouser; OPEN exact74HC174D,653 cut-tape SKU; MOQ1; multiple1 | ESTIMATE; Nexperia Production; exact local basket OPEN; 175/Toshiba NRND not substituted; [source](https://assets.nexperia.com/documents/data-sheet/74HC_HCT174.pdf) | 0.3500 / 0.3500 / 0.2500 / 0.2500 | 0.3500 / 0.3500 / 0.2500 / 0.2500 |
| 74HC21D,653; U211 | Package_SO:SOIC-14_3.9x8.7mm_P1.27mm | Mouser; 771-74HC21D-T; MOQ1; multiple1 | OBSERVED_M3; IndexedCanada18895,EURSpainprice; localizedbasketOPEN; [source](https://assets.nexperia.com/documents/data-sheet/74HC21.pdf) | 0.2410 / 0.2410 / 0.1660 / 0.1660 | 0.2410 / 0.2410 / 0.1660 / 0.1660 |
| 74HC74D,653; U223 | Package_SO:SOIC-14_3.9x8.7mm_P1.27mm | Mouser; 771-74HC74D-T; MOQ1; multiple1 | OBSERVED_M2; 623 older NL;1590 newer USD; [source](https://nl.mouser.com/ProductDetail/Nexperia/74HC74D653?qs=P62ublwmbi8VnJ1KG1%2FblQ%3D%3D) | 0.1810 / 0.1810 / 0.1230 / 0.1230 | 0.1810 / 0.1810 / 0.1230 / 0.1230 |
| 78F2R7J-RC; L510, L511 | ARDF_TX:78F_Axial | DigiKey/Mouser; OPEN; exactSKU78F2R7J-RC; MOQ1; multiple1 | ESTIMATE; Exact basket/stock OPEN; [source](https://www.bourns.com/docs/product-datasheets/78f_series.pdf) | 0.3000 / 0.3000 / 0.3000 / 0.3000 | 0.6000 / 0.6000 / 0.6000 / 0.6000 |
| ABM3B-25.000MHZ-10-1-U-T; Y101 | Crystal:Crystal_SMD_5032-4Pin_5.0x3.2mm | Mouser/DigiKey; 815-ABM3B-25-T / 300-8218-1-ND; MOQ1; multiple1 | ESTIMATE; Mouser indexed 2381; net EUR price not captured; [source](https://abracon.com/parametric/crystals/ABM3B-25.000MHZ-10-1-U-T) | 0.4000 / 0.4000 / 0.4000 / 0.4000 | 0.4000 / 0.4000 / 0.4000 / 0.4000 |
| Amidon FT-50A-43 + AWG24 enamel Cu; T401 | ARDF_TX:FT50A43_Inline_4Terminal | Amidon/Akizuki; FT-50A-43 / Akizuki131662; MOQ1; multiple1 | ESTIMATE; Exact basket/stock OPEN; [source](https://www.amidoncorp.com/ft-50a-43/) | 0.9500 / 0.9500 / 0.9500 / 0.9500 | 0.9500 / 0.9500 / 0.9500 / 0.9500 |
| B2P-VH(LF)(SN); J301 | Connector_JST:JST_VH_B2P-VH_1x02_P3.96mm_Vertical | Mouser; 306-B2P-VHLFSN; MOQ1; multiple1 | OBSERVED_M3; 108526 indexed EUR MOQ1; [source](https://www.jst-mfg.com/product/pdf/eng/eVH.pdf) | 0.1380 / 0.1380 / 0.1150 / 0.1150 | 0.1380 / 0.1380 / 0.1150 / 0.1150 |
| B3B-XH-A(LF)(SN); J502 | Connector_JST:JST_XH_B3B-XH-A_1x03_P2.50mm_Vertical | Mouser; 306-B3BXHALFSNP; MOQ1; multiple1 | ESTIMATE; Exact basket/stock OPEN; [source](https://www.jst-mfg.com/product/pdf/eng/eXH.pdf) | 0.1600 / 0.1600 / 0.1600 / 0.1600 | 0.1600 / 0.1600 / 0.1600 / 0.1600 |
| BAT54WS-7-F; D201, D202, D219, D220, D221, D222, D223, D224, D451, D501 | Diode_SMD:D_SOD-323 | OPEN; OPEN; MOQ1; multiple1 | ESTIMATE; Exact basket/stock OPEN; [source](https://www.diodes.com/datasheet/download/BAT54WS.pdf) | 0.1000 / 0.1000 / 0.1000 / 0.1000 | 1.0000 / 1.0000 / 1.0000 / 1.0000 |
| BD140; Q403 | ARDF_TX:ST_BD140_SOT32_1p3Drill | Mouser; 511-BD140; MOQ1; multiple1 | OBSERVED_M3; STActive;MouserDEindexed5060;basketOPEN; [source](https://www.st.com/resource/en/datasheet/bd140.pdf) | 0.5850 / 0.5850 / 0.2640 / 0.2640 | 0.5850 / 0.5850 / 0.2640 / 0.2640 |
| BSS138BK,215; Q201, Q225, Q226, Q227, Q228, Q229, Q301, Q302, Q401, Q405, Q406, Q502 | Package_TO_SOT_SMD:SOT-23 | Mouser; 771-BSS138BK215; MOQ1; multiple1 | MIXED_ESTIMATE; EUR ten-price indexed0.099; single/100 estimates; EU stock conflict OPEN; [source](https://assets.nexperia.com/documents/data-sheet/BSS138BK.pdf) | 0.0990 / 0.0990 / 0.0600 / 0.0600 | 1.1880 / 1.1880 / 0.7200 / 0.7200 |
| C0805C101J1GACTU; C412, C416, C512, C516 | Capacitor_SMD:C_0805_2012Metric | OPEN; OPEN; MOQ1; multiple1 | ESTIMATE; Exact basket/stock OPEN; Unquoted | 0.1000 / 0.1000 / 0.1000 / 0.1000 | 0.4000 / 0.4000 / 0.4000 / 0.4000 |
| C0805C102J1GACTU; C411, C415, C511, C515 | Capacitor_SMD:C_0805_2012Metric | OPEN; OPEN; MOQ1; multiple1 | ESTIMATE; Exact basket/stock OPEN; Unquoted | 0.1000 / 0.1000 / 0.1000 / 0.1000 | 0.4000 / 0.4000 / 0.4000 / 0.4000 |
| C0805C182J1GACTU; C413, C513 | Capacitor_SMD:C_0805_2012Metric | OPEN; OPEN; MOQ1; multiple1 | ESTIMATE; Exact basket/stock OPEN; Unquoted | 0.1200 / 0.1200 / 0.1200 / 0.1200 | 0.2400 / 0.2400 / 0.2400 / 0.2400 |
| C0805C910J1GACTU; C414, C514 | Capacitor_SMD:C_0805_2012Metric | OPEN; OPEN; MOQ1; multiple1 | ESTIMATE; Exact basket/stock OPEN; Unquoted | 0.1200 / 0.1200 / 0.1200 / 0.1200 | 0.2400 / 0.2400 / 0.2400 / 0.2400 |
| C3216X7R2A474K160AB; C410, C510 | Capacitor_SMD:C_1206_3216Metric | OPEN; OPEN; MOQ1; multiple1 | ESTIMATE; Exact basket/stock OPEN; Unquoted | 0.2200 / 0.2200 / 0.2200 / 0.2200 | 0.4400 / 0.4400 / 0.4400 / 0.4400 |
| C3225X7R1V106M250AC; C301, C302 | Capacitor_SMD:C_1210_3225Metric | OPEN; OPEN; MOQ1; multiple1 | ESTIMATE; Exact basket/stock OPEN; Unquoted | 0.4500 / 0.4500 / 0.4500 / 0.4500 | 0.9000 / 0.9000 / 0.9000 / 0.9000 |
| CC0603JRNPO9BN102; C321 | Capacitor_SMD:C_0603_1608Metric | OPEN; OPEN; MOQ1; multiple1 | ESTIMATE; Exact basket/stock OPEN; Unquoted | 0.0400 / 0.0400 / 0.0400 / 0.0400 | 0.0400 / 0.0400 / 0.0400 / 0.0400 |
| CC0603JRNPO9BN472; C306 | Capacitor_SMD:C_0603_1608Metric | OPEN; OPEN; MOQ1; multiple1 | ESTIMATE; Exact basket/stock OPEN; Unquoted | 0.0400 / 0.0400 / 0.0400 / 0.0400 | 0.0400 / 0.0400 / 0.0400 / 0.0400 |
| CC0603KRX7R8BB104; C101, C102, C202, C203, C210, C211, C212, C220, C222, C230, C231, C232, C233, C303, C310, C313, C322, C323, C401, C451, C502 | Capacitor_SMD:C_0603_1608Metric | Mouser; 603-CC603KRX7R8BB104; MOQ1; multiple1 | OBSERVED_M2; 20401272 newer EU index; DE20582958; [source](https://www.mouser.de/de/ProductDetail/YAGEO/CC0603KRX7R8BB104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) | 0.0400 / 0.0240 / 0.0240 / 0.0240 | 0.8400 / 0.5040 / 0.5040 / 0.5040 |
| CC0603KRX7R9BB103; C311, C312, C320, C517 | Capacitor_SMD:C_0603_1608Metric | OPEN; OPEN; MOQ1; multiple1 | ESTIMATE; Exact basket/stock OPEN; Unquoted | 0.0350 / 0.0350 / 0.0350 / 0.0350 | 0.1400 / 0.1400 / 0.1400 / 0.1400 |
| CC0603KRX7R9BB104; C314 | Capacitor_SMD:C_0603_1608Metric | Mouser; OPEN; MOQ1; multiple1 | ESTIMATE; 20401272 newer EU index; DE20582958; [source](https://yageogroup.com/download/specsheet/CC0603KRX7R9BB104) | 0.0350 / 0.0350 / 0.0350 / 0.0350 | 0.0350 / 0.0350 / 0.0350 / 0.0350 |
| CC0805KKX7R9BB105; C103, C201, C402, C501 | Capacitor_SMD:C_0805_2012Metric | OPEN; OPEN; MOQ1; multiple1 | ESTIMATE; Exact basket/stock OPEN; Unquoted | 0.0800 / 0.0800 / 0.0800 / 0.0800 | 0.3200 / 0.3200 / 0.3200 / 0.3200 |
| CRCW2512100RFKEG; R406 | Resistor_SMD:R_2512_6332Metric | OPEN; OPEN; MOQ1; multiple1 | ESTIMATE; Exact basket/stock OPEN; Unquoted | 0.1000 / 0.1000 / 0.1000 / 0.1000 | 0.1000 / 0.1000 / 0.1000 / 0.1000 |
| CRCW25121R50FKEG; R350 | Resistor_SMD:R_2512_6332Metric | Vishay/Mouser; OPEN; MOQ1; multiple1 | ESTIMATE; Exact basket/stock OPEN; [source](https://www.vishay.com/docs/20035/dcrcwe3.pdf) | 0.1500 / 0.1500 / 0.1500 / 0.1500 | 0.1500 / 0.1500 / 0.1500 / 0.1500 |
| CRCW25124R70FKEG; R410 | Resistor_SMD:R_2512_6332Metric | OPEN; OPEN; MOQ1; multiple1 | ESTIMATE; Exact basket/stock OPEN; Unquoted | 0.1000 / 0.1000 / 0.1000 / 0.1000 | 0.1000 / 0.1000 / 0.1000 / 0.1000 |
| DMN2056U-7; Q404 | Package_TO_SOT_SMD:SOT-23 | Mouser; 621-DMN2056U-7; MOQ1; multiple1 | OBSERVED_M3; Retained R0 stock observation; [source](https://www.diodes.com/datasheet/download/DMN2056U.pdf) | 0.3350 / 0.3350 / 0.1470 / 0.1470 | 0.3350 / 0.3350 / 0.1470 / 0.1470 |
| EEUFR1V101; C350 | Capacitor_THT:CP_Radial_D8.0mm_P3.50mm | Panasonic/Mouser; OPEN; exact manufacturer MPN EEUFR1V101; MOQ1; multiple1 | ESTIMATE; Exact basket/stock OPEN; [source](https://na.industrial.panasonic.com/products/capacitors/aluminum-electrolytic-capacitors/aluminum-electrolytic-capacitors-radial-lead-type/series/83367/model/83807) | 0.4500 / 0.4500 / 0.4500 / 0.4500 | 0.4500 / 0.4500 / 0.4500 / 0.4500 |
| GRM21BR71H104KA01L; C405 | Capacitor_SMD:C_0805_2012Metric | OPEN; OPEN; MOQ1; multiple1 | ESTIMATE; Exact basket/stock OPEN; [source](https://www.murata.com/en-eu/products/productdetail?partno=GRM21BR71H104KA01L) | 0.1000 / 0.1000 / 0.1000 / 0.1000 | 0.1000 / 0.1000 / 0.1000 / 0.1000 |
| GRM32ER71E226KE15L; C304, C305, C403 | Capacitor_SMD:C_1210_3225Metric | OPEN; OPEN; MOQ1; multiple1 | ESTIMATE; Exact basket/stock OPEN; Unquoted | 0.4500 / 0.4500 / 0.4500 / 0.4500 | 1.3500 / 1.3500 / 1.3500 / 1.3500 |
| INA180A1IDBVT; U313 | Package_TO_SOT_SMD:SOT-23-5 | Mouser/DigiKey; 595-INA180A1IDBVT / exact DigiKey code OPEN; MOQ1; multiple1 | MIXED_ESTIMATE; Mouser indexed2890; price0.96 one observed, ten0.70 ESTIMATE; R package OOS not substituted; [source](https://www.ti.com/lit/ds/symlink/ina180.pdf) | 0.9600 / 0.9600 / 0.7000 / 0.7000 | 0.9600 / 0.9600 / 0.7000 / 0.7000 |
| IRF610PBF-BE3; Q402 | ARDF_TX:TO220_Vertical_1p3Drill | Farnell; 4853567; MOQ1; multiple1 | OBSERVED_M2; 614 in Farnell DE index (about 2-month-old cache); no reservation; [source](https://de.farnell.com/vishay/irf610pbf-be3/mosfet-n-kanal-200v-3-3a-to-220ab/dp/4853567) | 1.1100 / 1.1100 / 0.6220 / 0.6220 | 1.1100 / 1.1100 / 0.6220 / 0.6220 |
| LM339BIDR; U312 | Package_SO:SOIC-14_3.9x8.7mm_P1.27mm | OPEN; OPEN; MOQ1; multiple1 | ESTIMATE; Exact basket/stock OPEN; [source](https://www.ti.com/lit/ds/symlink/lm339b.pdf) | 0.2500 / 0.2500 / 0.2500 / 0.2500 | 0.2500 / 0.2500 / 0.2500 / 0.2500 |
| LM393BIDR; U314 | Package_SO:SOIC-8_3.9x4.9mm_P1.27mm | Mouser; 595-LM393BIDR; MOQ1; multiple1 | OBSERVED_M2; 6986 cached EU vs7644 US; basket OPEN; [source](https://eu.mouser.com/en/ProductDetail/Texas-Instruments/LM393BIDR?qs=BJlw7L4Cy78N8CV%252BGpRosA%3D%3D) | 0.1980 / 0.1980 / 0.1400 / 0.1400 | 0.1980 / 0.1980 / 0.1400 / 0.1400 |
| LM5134BMF/NOPB; U401 | Package_TO_SOT_SMD:SOT-23-6 | Mouser; 595-LM5134BMF/NOPB; MOQ1; multiple1 | OBSERVED_M2; EU stock conflict:510 US indexed; DE incoming30Nov. Local basket MUST close.; [source](https://www.ti.com/lit/ds/symlink/lm5134.pdf) | 2.1700 / 2.1700 / 1.6200 / 1.6200 | 2.1700 / 2.1700 / 1.6200 / 1.6200 |
| Littelfuse 046701.5NR; F301 | ARDF_TX:Fuse_467_0603 | OPEN; OPEN; MOQ1; multiple1 | ESTIMATE; Exact basket/stock OPEN; [source](https://www.littelfuse.com/assetdocs/fuse-467-datasheet?assetguid=4a59f034-1cca-460e-a5ba-e1e66247c76d) | 0.3000 / 0.3000 / 0.3000 / 0.3000 | 0.3000 / 0.3000 / 0.3000 / 0.3000 |
| MCP100T-300I/TT; U201 | Package_TO_SOT_SMD:SOT-23 | Mouser; 579-MCP100T-300I/TT; MOQ1; multiple1 | OBSERVED_M2; 3723 US vs3538 AU indexed; EU live basket OPEN; aggregator counts excluded; [source](https://www.mouser.it/ProductDetail/Microchip-Technology/MCP100T-300I-TT?qs=8U9qMIGhlkokseONjNxnUg%3D%3D) | 0.3610 / 0.3610 / 0.3610 / 0.3610 | 0.3610 / 0.3610 / 0.3610 / 0.3610 |
| MMBT3904,215; Q503, Q504 | Package_TO_SOT_SMD:SOT-23 | OPEN; OPEN; MOQ1; multiple1 | ESTIMATE; Exact basket/stock OPEN; [source](https://assets.nexperia.com/documents/data-sheet/MMBT3904.pdf) | 0.1000 / 0.1000 / 0.1000 / 0.1000 | 0.2000 / 0.2000 / 0.2000 / 0.2000 |
| MMBT3906,215; Q501 | Package_TO_SOT_SMD:SOT-23 | OPEN; OPEN; MOQ1; multiple1 | ESTIMATE; Exact basket/stock OPEN; [source](https://assets.nexperia.com/documents/data-sheet/MMBT3906.pdf) | 0.1000 / 0.1000 / 0.1000 / 0.1000 | 0.1000 / 0.1000 / 0.1000 / 0.1000 |
| Micrometals T60-2 + AWG24 Cu; L410, L411 | ARDF_TX:T60_2_20T | TME; T60-2; MOQ1; multiple1 | ESTIMATE; Exact basket/stock OPEN; [source](https://datasheets.micrometals.com/T60-2-DataSheet.pdf) | 0.8500 / 0.8500 / 0.8500 / 0.8500 | 1.7000 / 1.7000 / 1.7000 / 1.7000 |
| NCP18XH103F03RB; TH301 | Resistor_SMD:R_0603_1608Metric | OPEN; OPEN; MOQ1; multiple1 | ESTIMATE; Exact basket/stock OPEN; [source](https://www.murata.com/en-us/products/productdetail?partno=NCP18XH103F03RB) | 0.1000 / 0.1000 / 0.1000 / 0.1000 | 0.1000 / 0.1000 / 0.1000 / 0.1000 |
| RC0603FR-07100KL; R103, R409, R506 | Resistor_SMD:R_0603_1608Metric | OPEN; OPEN; MOQ1; multiple1 | ESTIMATE; Exact basket/stock OPEN; Unquoted | 0.0300 / 0.0300 / 0.0300 / 0.0300 | 0.0900 / 0.0900 / 0.0900 / 0.0900 |
| RC0603FR-07100RL; R306, R453 | Resistor_SMD:R_0603_1608Metric | OPEN; OPEN; MOQ1; multiple1 | ESTIMATE; Exact basket/stock OPEN; Unquoted | 0.0300 / 0.0300 / 0.0300 / 0.0300 | 0.0600 / 0.0600 / 0.0600 / 0.0600 |
| RC0603FR-0710KL; R225, R314, R325, R316, R318, R327, R329, R334, R335, R338, R340, R401, R404, R505, R508, R509, R516 | Resistor_SMD:R_0603_1608Metric | Mouser; 603-RC0603FR-0710KL; MOQ1; multiple1 | OBSERVED_M2; 3405942 cached DE; [source](https://www.mouser.de/en/ProductDetail/YAGEO/RC0603FR-0710KL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) | 0.0120 / 0.0070 / 0.0070 / 0.0070 | 0.2040 / 0.1190 / 0.1190 / 0.1190 |
| RC0603FR-0710RL; R331, R332 | Resistor_SMD:R_0603_1608Metric | OPEN; OPEN; MOQ1; multiple1 | ESTIMATE; Exact basket/stock OPEN; Unquoted | 0.0300 / 0.0300 / 0.0300 / 0.0300 | 0.0600 / 0.0600 / 0.0600 / 0.0600 |
| RC0603FR-07127KL; R315 | Resistor_SMD:R_0603_1608Metric | OPEN; OPEN; MOQ1; multiple1 | ESTIMATE; Exact basket/stock OPEN; Unquoted | 0.0300 / 0.0300 / 0.0300 / 0.0300 | 0.0300 / 0.0300 / 0.0300 / 0.0300 |
| RC0603FR-07137KL; R302 | Resistor_SMD:R_0603_1608Metric | OPEN; OPEN; MOQ1; multiple1 | ESTIMATE; Exact basket/stock OPEN; Unquoted | 0.0300 / 0.0300 / 0.0300 / 0.0300 | 0.0300 / 0.0300 / 0.0300 / 0.0300 |
| RC0603FR-07180RL; R310 | Resistor_SMD:R_0603_1608Metric | OPEN; OPEN; MOQ1; multiple1 | ESTIMATE; Exact basket/stock OPEN; Unquoted | 0.0300 / 0.0300 / 0.0300 / 0.0300 | 0.0300 / 0.0300 / 0.0300 / 0.0300 |
| RC0603FR-071K3L; R339 | Resistor_SMD:R_0603_1608Metric | OPEN; OPEN; MOQ1; multiple1 | ESTIMATE; Exact basket/stock OPEN; Unquoted | 0.0300 / 0.0300 / 0.0300 / 0.0300 | 0.0300 / 0.0300 / 0.0300 / 0.0300 |
| RC0603FR-071K5L; R311, R503 | Resistor_SMD:R_0603_1608Metric | OPEN; OPEN; MOQ1; multiple1 | ESTIMATE; Exact basket/stock OPEN; Unquoted | 0.0300 / 0.0300 / 0.0300 / 0.0300 | 0.0600 / 0.0600 / 0.0600 / 0.0600 |
| RC0603FR-071KL; R312, R405, R451, R502, R504 | Resistor_SMD:R_0603_1608Metric | OPEN; OPEN; MOQ1; multiple1 | ESTIMATE; Exact basket/stock OPEN; Unquoted | 0.0300 / 0.0300 / 0.0300 / 0.0300 | 0.1500 / 0.1500 / 0.1500 / 0.1500 |
| RC0603FR-0720KL; R303 | Resistor_SMD:R_0603_1608Metric | OPEN; OPEN; MOQ1; multiple1 | ESTIMATE; Exact basket/stock OPEN; Unquoted | 0.0300 / 0.0300 / 0.0300 / 0.0300 | 0.0300 / 0.0300 / 0.0300 / 0.0300 |
| RC0603FR-0722RL; R510, R511, R512 | Resistor_SMD:R_0603_1608Metric | OPEN; OPEN; MOQ1; multiple1 | ESTIMATE; Exact basket/stock OPEN; Unquoted | 0.0300 / 0.0300 / 0.0300 / 0.0300 | 0.0900 / 0.0900 / 0.0900 / 0.0900 |
| RC0603FR-0724K9L; R305 | Resistor_SMD:R_0603_1608Metric | OPEN; OPEN; MOQ1; multiple1 | ESTIMATE; Exact basket/stock OPEN; Unquoted | 0.0300 / 0.0300 / 0.0300 / 0.0300 | 0.0300 / 0.0300 / 0.0300 / 0.0300 |
| RC0603FR-072K2L; R219, R220, R321 | Resistor_SMD:R_0603_1608Metric | OPEN; OPEN; MOQ1; multiple1 | ESTIMATE; Exact basket/stock OPEN; Unquoted | 0.0300 / 0.0300 / 0.0300 / 0.0300 | 0.0900 / 0.0900 / 0.0900 / 0.0900 |
| RC0603FR-07309KL; R313, R324 | Resistor_SMD:R_0603_1608Metric | OPEN; OPEN; MOQ1; multiple1 | ESTIMATE; Exact basket/stock OPEN; Unquoted | 0.0300 / 0.0300 / 0.0300 / 0.0300 | 0.0600 / 0.0600 / 0.0600 / 0.0600 |
| RC0603FR-0730KL; R333 | Resistor_SMD:R_0603_1608Metric | OPEN; OPEN; MOQ1; multiple1 | ESTIMATE; Exact basket/stock OPEN; Unquoted | 0.0300 / 0.0300 / 0.0300 / 0.0300 | 0.0300 / 0.0300 / 0.0300 / 0.0300 |
| RC0603FR-07330KL; R201, R452 | Resistor_SMD:R_0603_1608Metric | OPEN; OPEN; MOQ1; multiple1 | ESTIMATE; Exact basket/stock OPEN; Unquoted | 0.0300 / 0.0300 / 0.0300 / 0.0300 | 0.0600 / 0.0600 / 0.0600 / 0.0600 |
| RC0603FR-07470RL; R507 | Resistor_SMD:R_0603_1608Metric | OPEN; OPEN; MOQ1; multiple1 | ESTIMATE; Exact basket/stock OPEN; Unquoted | 0.0300 / 0.0300 / 0.0300 / 0.0300 | 0.0300 / 0.0300 / 0.0300 / 0.0300 |
| RC0603FR-0747KL; R110, R111, R112, R113, R114, R115, R116, R117, R118, R202, R203, R301, R307, R402, R408 | Resistor_SMD:R_0603_1608Metric | OPEN; OPEN; MOQ1; multiple1 | ESTIMATE; Exact basket/stock OPEN; Unquoted | 0.0300 / 0.0300 / 0.0300 / 0.0300 | 0.4500 / 0.4500 / 0.4500 / 0.4500 |
| RC0603FR-074K7L; R101, R102, R407 | Resistor_SMD:R_0603_1608Metric | OPEN; OPEN; MOQ1; multiple1 | ESTIMATE; Exact basket/stock OPEN; Unquoted | 0.0300 / 0.0300 / 0.0300 / 0.0300 | 0.0900 / 0.0900 / 0.0900 / 0.0900 |
| RC0603FR-0760K4L; R337 | Resistor_SMD:R_0603_1608Metric | OPEN; OPEN; MOQ1; multiple1 | ESTIMATE; Exact basket/stock OPEN; Unquoted | 0.0300 / 0.0300 / 0.0300 / 0.0300 | 0.0300 / 0.0300 / 0.0300 / 0.0300 |
| RC0603FR-0761K9L; R317 | Resistor_SMD:R_0603_1608Metric | OPEN; OPEN; MOQ1; multiple1 | ESTIMATE; Exact basket/stock OPEN; Unquoted | 0.0300 / 0.0300 / 0.0300 / 0.0300 | 0.0300 / 0.0300 / 0.0300 / 0.0300 |
| RC0603FR-0769K8L; R328 | Resistor_SMD:R_0603_1608Metric | OPEN; OPEN; MOQ1; multiple1 | ESTIMATE; Exact basket/stock OPEN; Unquoted | 0.0300 / 0.0300 / 0.0300 / 0.0300 | 0.0300 / 0.0300 / 0.0300 / 0.0300 |
| RC0603FR-076R8L; R514 | Resistor_SMD:R_0603_1608Metric | OPEN; OPEN; MOQ1; multiple1 | ESTIMATE; Exact basket/stock OPEN; Unquoted | 0.0300 / 0.0300 / 0.0300 / 0.0300 | 0.0300 / 0.0300 / 0.0300 / 0.0300 |
| RC0603FR-07750RL; R513, R515 | Resistor_SMD:R_0603_1608Metric | OPEN; OPEN; MOQ1; multiple1 | ESTIMATE; Exact basket/stock OPEN; Unquoted | 0.0300 / 0.0300 / 0.0300 / 0.0300 | 0.0600 / 0.0600 / 0.0600 / 0.0600 |
| RC0603FR-0778K7L; R326 | Resistor_SMD:R_0603_1608Metric | OPEN; OPEN; MOQ1; multiple1 | ESTIMATE; Exact basket/stock OPEN; Unquoted | 0.0300 / 0.0300 / 0.0300 / 0.0300 | 0.0300 / 0.0300 / 0.0300 / 0.0300 |
| RC0603FR-0791KL; R304 | Resistor_SMD:R_0603_1608Metric | OPEN; OPEN; MOQ1; multiple1 | ESTIMATE; Exact basket/stock OPEN; Unquoted | 0.0300 / 0.0300 / 0.0300 / 0.0300 | 0.0300 / 0.0300 / 0.0300 / 0.0300 |
| RC0603JR-070RL; R403 | Resistor_SMD:R_0603_1608Metric | OPEN; OPEN; MOQ1; multiple1 | ESTIMATE; Exact basket/stock OPEN; Unquoted | 0.0300 / 0.0300 / 0.0300 / 0.0300 | 0.0300 / 0.0300 / 0.0300 / 0.0300 |
| RC2512FR-0727RL; R501 | Resistor_SMD:R_2512_6332Metric | OPEN; OPEN; MOQ1; multiple1 | ESTIMATE; Exact basket/stock OPEN; Unquoted | 0.0800 / 0.0800 / 0.0800 / 0.0800 | 0.0800 / 0.0800 / 0.0800 / 0.0800 |
| SI5351A-B-GT; U101 | Package_SO:MSOP-10_3x3mm_P0.5mm | DigiKey; 336-2399-5-ND; MOQ1; multiple1 | OBSERVED_M2; 10254 earlier index; [source](https://www.digikey.de/en/products/detail/skyworks-solutions-inc/SI5351A-B-GT/3679847) | 1.8700 / 1.8700 / 1.3880 / 1.3880 | 1.8700 / 1.8700 / 1.3880 / 1.3880 |
| SMBJ17A; D302 | Diode_SMD:D_SMB | OPEN; OPEN; MOQ1; multiple1 | ESTIMATE; Exact basket/stock OPEN; [source](https://www.littelfuse.com/assetdocs/littelfuse_tvs_diode_smbj_datasheet.pdf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) | 0.3500 / 0.3500 / 0.3500 / 0.3500 | 0.3500 / 0.3500 / 0.3500 / 0.3500 |
| SN74AC00DR; U501 | Package_SO:SOIC-14_3.9x8.7mm_P1.27mm | Mouser; 595-SN74AC00DR; MOQ1; multiple1 | OBSERVED_M3; 2369EUindexed;ActiveDRcut-tapeMOQ1;D-tubeEOLnotselected; [source](https://www.ti.com/lit/ds/symlink/sn74ac00.pdf) | 0.4040 / 0.4040 / 0.2780 / 0.2780 | 0.4040 / 0.4040 / 0.2780 / 0.2780 |
| SRP7050TA-100M; L301 | ARDF_TX:SRP7050TA | Mouser; 652-SRP7050TA-100M; MOQ1; multiple1 | OBSERVED_M3; CurrentEURindex; exactstocknumberOPEN; [source](https://www.bourns.com/docs/product-datasheets/srp7050ta.pdf) | 0.9630 / 0.9630 / 0.7920 / 0.7920 | 0.9630 / 0.9630 / 0.7920 / 0.7920 |
| SS34-E3/57T; D301 | Diode_SMD:D_SMC | OPEN; OPEN; MOQ1; multiple1 | ESTIMATE; Exact basket/stock OPEN; Unquoted | 0.1800 / 0.1800 / 0.1800 / 0.1800 | 0.1800 / 0.1800 / 0.1800 / 0.1800 |
| TL431AIDBZR; U311 | Package_TO_SOT_SMD:SOT-23 | OPEN; OPEN; MOQ1; multiple1 | ESTIMATE; Exact basket/stock OPEN; [source](https://www.ti.com/lit/ds/symlink/tl431.pdf) | 0.2500 / 0.2500 / 0.2500 / 0.2500 | 0.2500 / 0.2500 / 0.2500 / 0.2500 |
| TPS22810DBVR; U302 | Package_TO_SOT_SMD:SOT-23-6 | OPEN; OPEN; MOQ1; multiple1 | ESTIMATE; Exact basket/stock OPEN; [source](https://www.ti.com/lit/ds/symlink/tps22810.pdf) | 0.5200 / 0.5200 / 0.5200 / 0.5200 | 0.5200 / 0.5200 / 0.5200 / 0.5200 |
| TPS54302DDCT; U301 | Package_TO_SOT_SMD:TSOT-23-6 | Mouser; 595-TPS54302DDCT; MOQ1; multiple1 | OBSERVED_M2; New EUR index3137; direct browser failed; basket OPEN; [source](https://www.ti.com/lit/ds/symlink/tps54302.pdf) | 1.5900 / 1.5900 / 1.1800 / 1.1800 | 1.5900 / 1.5900 / 1.1800 / 1.1800 |
| WSL2512R0500FEA; R330 | Resistor_SMD:R_2512_6332Metric | OPEN; OPEN; MOQ1; multiple1 | ESTIMATE; Exact basket/stock OPEN; Unquoted | 0.1800 / 0.1800 / 0.1800 / 0.1800 | 0.1800 / 0.1800 / 0.1800 / 0.1800 |
| Wurth 61201621621; J101 | ARDF_TX:Wurth_61201621621 | Wurth/Mouser; OPEN; MOQ1; multiple1 | ESTIMATE; Exact basket/stock OPEN; Unquoted | 0.6000 / 0.6000 / 0.6000 / 0.6000 | 0.6000 / 0.6000 / 0.6000 / 0.6000 |

## Fox

| MPN / refs | Footprint | Supplier / code / MOQ / multiple | Price provenance / availability | Unit price at batch 1 / 6 / 10 / 20 | Allocated per board at 1 / 6 / 10 / 20 |
| --- | --- | --- | --- | ---: | ---: |
| 74HC00D,653; U212 | Package_SO:SOIC-14_3.9x8.7mm_P1.27mm | Mouser; 771-74HC00D-T; MOQ1; multiple1 | OBSERVED_M2; M2 indexedNexperia SOICstock; exactcurrentcut-tapebasketOPEN; [source](https://assets.nexperia.com/documents/data-sheet/74HC_HCT00.pdf) | 0.1720 / 0.1720 / 0.1030 / 0.1030 | 0.1720 / 0.1720 / 0.1030 / 0.1030 |
| 74HC08D,653; U222 | Package_SO:SOIC-14_3.9x8.7mm_P1.27mm | Mouser; 771-74HC08D-T; MOQ1; multiple1 | OBSERVED_M2; 37703 cached EU; [source](https://eu.mouser.com/ProductDetail/Nexperia/74HC08D653?qs=P62ublwmbi%2FQCxm29EB%2FyA%3D%3D) | 0.1630 / 0.1630 / 0.1140 / 0.1140 | 0.1630 / 0.1630 / 0.1140 / 0.1140 |
| 74HC11D,653; U221 | Package_SO:SOIC-14_3.9x8.7mm_P1.27mm | Mouser; 771-74HC11D-T; MOQ1; multiple1 | ESTIMATE; Exact basket/stock OPEN; [source](https://assets.nexperia.com/documents/data-sheet/74HC_HCT11.pdf) | 0.1600 / 0.1600 / 0.1600 / 0.1600 | 0.1600 / 0.1600 / 0.1600 / 0.1600 |
| 74HC123D,653; U202 | Package_SO:SOIC-16_3.9x9.9mm_P1.27mm | Mouser; 771-74HC123D-T; MOQ1; multiple1 | OBSERVED_M2; 1037 newer EU vs zero older NL/BR; conflict; [source](https://eu.mouser.com/en/ProductDetail/Nexperia/74HC123D653?qs=P62ublwmbi%2FMZUrC9zEqyg%3D%3D) | 0.3270 / 0.3270 / 0.2190 / 0.2190 | 0.3270 / 0.3270 / 0.2190 / 0.2190 |
| 74HC14D,653; U203 | Package_SO:SOIC-14_3.9x8.7mm_P1.27mm | Mouser; 771-74HC14D-T; MOQ1; multiple1 | OBSERVED_M3; Mouser indexed862904; actualbasketOPEN; [source](https://www.mouser.es/ProductDetail/Nexperia/74HC14D653?qs=P62ublwmbi8OHaKXqv2GmQ%3D%3D) | 0.1720 / 0.1720 / 0.1180 / 0.1180 | 0.1720 / 0.1720 / 0.1180 / 0.1180 |
| 74HC174D,653; U224 | Package_SO:SOIC-16_3.9x9.9mm_P1.27mm | Nexperia/DigiKey/Mouser; OPEN exact74HC174D,653 cut-tape SKU; MOQ1; multiple1 | ESTIMATE; Nexperia Production; exact local basket OPEN; 175/Toshiba NRND not substituted; [source](https://assets.nexperia.com/documents/data-sheet/74HC_HCT174.pdf) | 0.3500 / 0.3500 / 0.2500 / 0.2500 | 0.3500 / 0.3500 / 0.2500 / 0.2500 |
| 74HC21D,653; U211 | Package_SO:SOIC-14_3.9x8.7mm_P1.27mm | Mouser; 771-74HC21D-T; MOQ1; multiple1 | OBSERVED_M3; IndexedCanada18895,EURSpainprice; localizedbasketOPEN; [source](https://assets.nexperia.com/documents/data-sheet/74HC21.pdf) | 0.2410 / 0.2410 / 0.1660 / 0.1660 | 0.2410 / 0.2410 / 0.1660 / 0.1660 |
| 74HC74D,653; U223 | Package_SO:SOIC-14_3.9x8.7mm_P1.27mm | Mouser; 771-74HC74D-T; MOQ1; multiple1 | OBSERVED_M2; 623 older NL;1590 newer USD; [source](https://nl.mouser.com/ProductDetail/Nexperia/74HC74D653?qs=P62ublwmbi8VnJ1KG1%2FblQ%3D%3D) | 0.1810 / 0.1810 / 0.1230 / 0.1230 | 0.1810 / 0.1810 / 0.1230 / 0.1230 |
| 78F2R7J-RC; L510, L511 | ARDF_TX:78F_Axial | DigiKey/Mouser; OPEN; exactSKU78F2R7J-RC; MOQ1; multiple1 | ESTIMATE; Exact basket/stock OPEN; [source](https://www.bourns.com/docs/product-datasheets/78f_series.pdf) | 0.3000 / 0.3000 / 0.3000 / 0.3000 | 0.6000 / 0.6000 / 0.6000 / 0.6000 |
| ABM3B-25.000MHZ-10-1-U-T; Y101 | Crystal:Crystal_SMD_5032-4Pin_5.0x3.2mm | Mouser/DigiKey; 815-ABM3B-25-T / 300-8218-1-ND; MOQ1; multiple1 | ESTIMATE; Mouser indexed 2381; net EUR price not captured; [source](https://abracon.com/parametric/crystals/ABM3B-25.000MHZ-10-1-U-T) | 0.4000 / 0.4000 / 0.4000 / 0.4000 | 0.4000 / 0.4000 / 0.4000 / 0.4000 |
| B2P-VH(LF)(SN); J301 | Connector_JST:JST_VH_B2P-VH_1x02_P3.96mm_Vertical | Mouser; 306-B2P-VHLFSN; MOQ1; multiple1 | OBSERVED_M3; 108526 indexed EUR MOQ1; [source](https://www.jst-mfg.com/product/pdf/eng/eVH.pdf) | 0.1380 / 0.1380 / 0.1150 / 0.1150 | 0.1380 / 0.1380 / 0.1150 / 0.1150 |
| B3B-XH-A(LF)(SN); J502 | Connector_JST:JST_XH_B3B-XH-A_1x03_P2.50mm_Vertical | Mouser; 306-B3BXHALFSNP; MOQ1; multiple1 | ESTIMATE; Exact basket/stock OPEN; [source](https://www.jst-mfg.com/product/pdf/eng/eXH.pdf) | 0.1600 / 0.1600 / 0.1600 / 0.1600 | 0.1600 / 0.1600 / 0.1600 / 0.1600 |
| BAT54WS-7-F; D201, D202, D219, D220, D223, D224, D451, D501 | Diode_SMD:D_SOD-323 | OPEN; OPEN; MOQ1; multiple1 | ESTIMATE; Exact basket/stock OPEN; [source](https://www.diodes.com/datasheet/download/BAT54WS.pdf) | 0.1000 / 0.1000 / 0.1000 / 0.1000 | 0.8000 / 0.8000 / 0.8000 / 0.8000 |
| BSS138BK,215; Q201, Q225, Q226, Q227, Q228, Q229, Q406, Q502 | Package_TO_SOT_SMD:SOT-23 | Mouser; 771-BSS138BK215; MOQ1; multiple1 | MIXED_ESTIMATE; EUR ten-price indexed0.099; single/100 estimates; EU stock conflict OPEN; [source](https://assets.nexperia.com/documents/data-sheet/BSS138BK.pdf) | 0.2200 / 0.0990 / 0.0990 / 0.0600 | 1.7600 / 0.7920 / 0.7920 / 0.4800 |
| C0805C101J1GACTU; C512, C516 | Capacitor_SMD:C_0805_2012Metric | OPEN; OPEN; MOQ1; multiple1 | ESTIMATE; Exact basket/stock OPEN; Unquoted | 0.1000 / 0.1000 / 0.1000 / 0.1000 | 0.2000 / 0.2000 / 0.2000 / 0.2000 |
| C0805C102J1GACTU; C511, C515 | Capacitor_SMD:C_0805_2012Metric | OPEN; OPEN; MOQ1; multiple1 | ESTIMATE; Exact basket/stock OPEN; Unquoted | 0.1000 / 0.1000 / 0.1000 / 0.1000 | 0.2000 / 0.2000 / 0.2000 / 0.2000 |
| C0805C182J1GACTU; C513 | Capacitor_SMD:C_0805_2012Metric | OPEN; OPEN; MOQ1; multiple1 | ESTIMATE; Exact basket/stock OPEN; Unquoted | 0.1200 / 0.1200 / 0.1200 / 0.1200 | 0.1200 / 0.1200 / 0.1200 / 0.1200 |
| C0805C910J1GACTU; C514 | Capacitor_SMD:C_0805_2012Metric | OPEN; OPEN; MOQ1; multiple1 | ESTIMATE; Exact basket/stock OPEN; Unquoted | 0.1200 / 0.1200 / 0.1200 / 0.1200 | 0.1200 / 0.1200 / 0.1200 / 0.1200 |
| C3216X7R2A474K160AB; C510 | Capacitor_SMD:C_1206_3216Metric | OPEN; OPEN; MOQ1; multiple1 | ESTIMATE; Exact basket/stock OPEN; Unquoted | 0.2200 / 0.2200 / 0.2200 / 0.2200 | 0.2200 / 0.2200 / 0.2200 / 0.2200 |
| CC0603KRX7R8BB104; C101, C102, C202, C203, C210, C211, C212, C220, C222, C230, C231, C232, C233, C323, C451, C502 | Capacitor_SMD:C_0603_1608Metric | Mouser; 603-CC603KRX7R8BB104; MOQ1; multiple1 | OBSERVED_M2; 20401272 newer EU index; DE20582958; [source](https://www.mouser.de/de/ProductDetail/YAGEO/CC0603KRX7R8BB104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) | 0.0400 / 0.0280 / 0.0240 / 0.0240 | 0.6400 / 0.4480 / 0.3840 / 0.3840 |
| CC0603KRX7R9BB103; C311, C312, C517 | Capacitor_SMD:C_0603_1608Metric | OPEN; OPEN; MOQ1; multiple1 | ESTIMATE; Exact basket/stock OPEN; Unquoted | 0.0350 / 0.0350 / 0.0350 / 0.0350 | 0.1050 / 0.1050 / 0.1050 / 0.1050 |
| CC0603KRX7R9BB104; C314 | Capacitor_SMD:C_0603_1608Metric | Mouser; OPEN; MOQ1; multiple1 | ESTIMATE; 20401272 newer EU index; DE20582958; [source](https://yageogroup.com/download/specsheet/CC0603KRX7R9BB104) | 0.0350 / 0.0350 / 0.0350 / 0.0350 | 0.0350 / 0.0350 / 0.0350 / 0.0350 |
| CC0805KKX7R9BB105; C103, C201, C501 | Capacitor_SMD:C_0805_2012Metric | OPEN; OPEN; MOQ1; multiple1 | ESTIMATE; Exact basket/stock OPEN; Unquoted | 0.0800 / 0.0800 / 0.0800 / 0.0800 | 0.2400 / 0.2400 / 0.2400 / 0.2400 |
| LM393BIDR; U314 | Package_SO:SOIC-8_3.9x4.9mm_P1.27mm | Mouser; 595-LM393BIDR; MOQ1; multiple1 | OBSERVED_M2; 6986 cached EU vs7644 US; basket OPEN; [source](https://eu.mouser.com/en/ProductDetail/Texas-Instruments/LM393BIDR?qs=BJlw7L4Cy78N8CV%252BGpRosA%3D%3D) | 0.1980 / 0.1980 / 0.1400 / 0.1400 | 0.1980 / 0.1980 / 0.1400 / 0.1400 |
| Littelfuse 046701.5NR; F301 | ARDF_TX:Fuse_467_0603 | OPEN; OPEN; MOQ1; multiple1 | ESTIMATE; Exact basket/stock OPEN; [source](https://www.littelfuse.com/assetdocs/fuse-467-datasheet?assetguid=4a59f034-1cca-460e-a5ba-e1e66247c76d) | 0.3000 / 0.3000 / 0.3000 / 0.3000 | 0.3000 / 0.3000 / 0.3000 / 0.3000 |
| MCP100T-300I/TT; U201 | Package_TO_SOT_SMD:SOT-23 | Mouser; 579-MCP100T-300I/TT; MOQ1; multiple1 | OBSERVED_M2; 3723 US vs3538 AU indexed; EU live basket OPEN; aggregator counts excluded; [source](https://www.mouser.it/ProductDetail/Microchip-Technology/MCP100T-300I-TT?qs=8U9qMIGhlkokseONjNxnUg%3D%3D) | 0.3610 / 0.3610 / 0.3610 / 0.3610 | 0.3610 / 0.3610 / 0.3610 / 0.3610 |
| MMBT3904,215; Q503, Q504 | Package_TO_SOT_SMD:SOT-23 | OPEN; OPEN; MOQ1; multiple1 | ESTIMATE; Exact basket/stock OPEN; [source](https://assets.nexperia.com/documents/data-sheet/MMBT3904.pdf) | 0.1000 / 0.1000 / 0.1000 / 0.1000 | 0.2000 / 0.2000 / 0.2000 / 0.2000 |
| MMBT3906,215; Q501 | Package_TO_SOT_SMD:SOT-23 | OPEN; OPEN; MOQ1; multiple1 | ESTIMATE; Exact basket/stock OPEN; [source](https://assets.nexperia.com/documents/data-sheet/MMBT3906.pdf) | 0.1000 / 0.1000 / 0.1000 / 0.1000 | 0.1000 / 0.1000 / 0.1000 / 0.1000 |
| RC0603FR-07100KL; R103, R506 | Resistor_SMD:R_0603_1608Metric | OPEN; OPEN; MOQ1; multiple1 | ESTIMATE; Exact basket/stock OPEN; Unquoted | 0.0300 / 0.0300 / 0.0300 / 0.0300 | 0.0600 / 0.0600 / 0.0600 / 0.0600 |
| RC0603FR-07100RL; R453 | Resistor_SMD:R_0603_1608Metric | OPEN; OPEN; MOQ1; multiple1 | ESTIMATE; Exact basket/stock OPEN; Unquoted | 0.0300 / 0.0300 / 0.0300 / 0.0300 | 0.0300 / 0.0300 / 0.0300 / 0.0300 |
| RC0603FR-0710KL; R225, R314, R316, R505, R508, R509, R516 | Resistor_SMD:R_0603_1608Metric | Mouser; 603-RC0603FR-0710KL; MOQ1; multiple1 | OBSERVED_M2; 3405942 cached DE; [source](https://www.mouser.de/en/ProductDetail/YAGEO/RC0603FR-0710KL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) | 0.0860 / 0.0120 / 0.0120 / 0.0070 | 0.6020 / 0.0840 / 0.0840 / 0.0490 |
| RC0603FR-07127KL; R315 | Resistor_SMD:R_0603_1608Metric | OPEN; OPEN; MOQ1; multiple1 | ESTIMATE; Exact basket/stock OPEN; Unquoted | 0.0300 / 0.0300 / 0.0300 / 0.0300 | 0.0300 / 0.0300 / 0.0300 / 0.0300 |
| RC0603FR-07180RL; R310 | Resistor_SMD:R_0603_1608Metric | OPEN; OPEN; MOQ1; multiple1 | ESTIMATE; Exact basket/stock OPEN; Unquoted | 0.0300 / 0.0300 / 0.0300 / 0.0300 | 0.0300 / 0.0300 / 0.0300 / 0.0300 |
| RC0603FR-071K5L; R503 | Resistor_SMD:R_0603_1608Metric | OPEN; OPEN; MOQ1; multiple1 | ESTIMATE; Exact basket/stock OPEN; Unquoted | 0.0300 / 0.0300 / 0.0300 / 0.0300 | 0.0300 / 0.0300 / 0.0300 / 0.0300 |
| RC0603FR-071KL; R451, R502, R504 | Resistor_SMD:R_0603_1608Metric | OPEN; OPEN; MOQ1; multiple1 | ESTIMATE; Exact basket/stock OPEN; Unquoted | 0.0300 / 0.0300 / 0.0300 / 0.0300 | 0.0900 / 0.0900 / 0.0900 / 0.0900 |
| RC0603FR-0722RL; R510, R511, R512 | Resistor_SMD:R_0603_1608Metric | OPEN; OPEN; MOQ1; multiple1 | ESTIMATE; Exact basket/stock OPEN; Unquoted | 0.0300 / 0.0300 / 0.0300 / 0.0300 | 0.0900 / 0.0900 / 0.0900 / 0.0900 |
| RC0603FR-072K2L; R219, R220 | Resistor_SMD:R_0603_1608Metric | OPEN; OPEN; MOQ1; multiple1 | ESTIMATE; Exact basket/stock OPEN; Unquoted | 0.0300 / 0.0300 / 0.0300 / 0.0300 | 0.0600 / 0.0600 / 0.0600 / 0.0600 |
| RC0603FR-07309KL; R313 | Resistor_SMD:R_0603_1608Metric | OPEN; OPEN; MOQ1; multiple1 | ESTIMATE; Exact basket/stock OPEN; Unquoted | 0.0300 / 0.0300 / 0.0300 / 0.0300 | 0.0300 / 0.0300 / 0.0300 / 0.0300 |
| RC0603FR-07330KL; R201, R452 | Resistor_SMD:R_0603_1608Metric | OPEN; OPEN; MOQ1; multiple1 | ESTIMATE; Exact basket/stock OPEN; Unquoted | 0.0300 / 0.0300 / 0.0300 / 0.0300 | 0.0600 / 0.0600 / 0.0600 / 0.0600 |
| RC0603FR-07470RL; R507 | Resistor_SMD:R_0603_1608Metric | OPEN; OPEN; MOQ1; multiple1 | ESTIMATE; Exact basket/stock OPEN; Unquoted | 0.0300 / 0.0300 / 0.0300 / 0.0300 | 0.0300 / 0.0300 / 0.0300 / 0.0300 |
| RC0603FR-0747KL; R110, R111, R112, R113, R114, R115, R116, R117, R118, R202, R203 | Resistor_SMD:R_0603_1608Metric | OPEN; OPEN; MOQ1; multiple1 | ESTIMATE; Exact basket/stock OPEN; Unquoted | 0.0300 / 0.0300 / 0.0300 / 0.0300 | 0.3300 / 0.3300 / 0.3300 / 0.3300 |
| RC0603FR-074K7L; R101, R102 | Resistor_SMD:R_0603_1608Metric | OPEN; OPEN; MOQ1; multiple1 | ESTIMATE; Exact basket/stock OPEN; Unquoted | 0.0300 / 0.0300 / 0.0300 / 0.0300 | 0.0600 / 0.0600 / 0.0600 / 0.0600 |
| RC0603FR-076R8L; R514 | Resistor_SMD:R_0603_1608Metric | OPEN; OPEN; MOQ1; multiple1 | ESTIMATE; Exact basket/stock OPEN; Unquoted | 0.0300 / 0.0300 / 0.0300 / 0.0300 | 0.0300 / 0.0300 / 0.0300 / 0.0300 |
| RC0603FR-07750RL; R513, R515 | Resistor_SMD:R_0603_1608Metric | OPEN; OPEN; MOQ1; multiple1 | ESTIMATE; Exact basket/stock OPEN; Unquoted | 0.0300 / 0.0300 / 0.0300 / 0.0300 | 0.0600 / 0.0600 / 0.0600 / 0.0600 |
| RC0603JR-070RL; R228, R348, R349 | Resistor_SMD:R_0603_1608Metric | OPEN; OPEN; MOQ1; multiple1 | ESTIMATE; Exact basket/stock OPEN; Unquoted | 0.0300 / 0.0300 / 0.0300 / 0.0300 | 0.0900 / 0.0900 / 0.0900 / 0.0900 |
| RC2512FR-0727RL; R501 | Resistor_SMD:R_2512_6332Metric | OPEN; OPEN; MOQ1; multiple1 | ESTIMATE; Exact basket/stock OPEN; Unquoted | 0.0800 / 0.0800 / 0.0800 / 0.0800 | 0.0800 / 0.0800 / 0.0800 / 0.0800 |
| SI5351A-B-GT; U101 | Package_SO:MSOP-10_3x3mm_P0.5mm | DigiKey; 336-2399-5-ND; MOQ1; multiple1 | OBSERVED_M2; 10254 earlier index; [source](https://www.digikey.de/en/products/detail/skyworks-solutions-inc/SI5351A-B-GT/3679847) | 1.8700 / 1.8700 / 1.3880 / 1.3880 | 1.8700 / 1.8700 / 1.3880 / 1.3880 |
| SN74AC00DR; U501 | Package_SO:SOIC-14_3.9x8.7mm_P1.27mm | Mouser; 595-SN74AC00DR; MOQ1; multiple1 | OBSERVED_M3; 2369EUindexed;ActiveDRcut-tapeMOQ1;D-tubeEOLnotselected; [source](https://www.ti.com/lit/ds/symlink/sn74ac00.pdf) | 0.4040 / 0.4040 / 0.2780 / 0.2780 | 0.4040 / 0.4040 / 0.2780 / 0.2780 |
| SS34-E3/57T; D301 | Diode_SMD:D_SMC | OPEN; OPEN; MOQ1; multiple1 | ESTIMATE; Exact basket/stock OPEN; Unquoted | 0.1800 / 0.1800 / 0.1800 / 0.1800 | 0.1800 / 0.1800 / 0.1800 / 0.1800 |
| TL431AIDBZR; U311 | Package_TO_SOT_SMD:SOT-23 | OPEN; OPEN; MOQ1; multiple1 | ESTIMATE; Exact basket/stock OPEN; [source](https://www.ti.com/lit/ds/symlink/tl431.pdf) | 0.2500 / 0.2500 / 0.2500 / 0.2500 | 0.2500 / 0.2500 / 0.2500 / 0.2500 |
| Wurth 61201621621; J101 | ARDF_TX:Wurth_61201621621 | Wurth/Mouser; OPEN; MOQ1; multiple1 | ESTIMATE; Exact basket/stock OPEN; Unquoted | 0.6000 / 0.6000 / 0.6000 / 0.6000 | 0.6000 / 0.6000 / 0.6000 / 0.6000 |

[CSV with required/ordered/leftover quantities](M3B_E2_BOM.csv). [All basket and functional-block totals](M3B_E2_COSTS.json). [Evaluation versus production scope](M3B_EVALUATION_BOM.md).
