DD1SB/ARDF-TX/docs/FOXORING_COST_BOM.md

# Foxoring-only itemized candidate BOM

Date: **2026-10-13**. **No parts purchased; no ordering release or hardware validation.**

Generated by `python3 tools/foxoring_costs.py --write`. Read [the audit](FOXORING_COST_AUDIT.md) for scope, sources, safety/qualification and TinyFox/Fixle comparison. The original M1/M2 figures remain historical records.

ESP32-S3/RTC controller and the **same 80 m PCB with the M1 Fox-only population** are unchanged. Silicontra LoRa footprint remains unpopulated; optional module and RF/antenna additions cost zero in this population. The optional-footprint contract is retained; exact Silicontra MPN/land pattern remains OPEN as in M1, with no layout claim. No fourth transmitter PCB or replacement MCU. The protection circuit to be procured belongs inside the external battery pack.

Prices are EUR ex VAT planning. OBSERVED means a supplier observation, not purchased or qualified. ESTIMATE means unquoted material allowance; RESERVE is unspent provision, not a physical line item. Exact electrical values, footprints and stock remain open. All quoted discounts use actual aggregated same-MPN quantities.

## Totals and cost scopes

| Scope | Ten units: EUR/unit | Twenty units: EUR/unit |
| --- | ---: | ---: |
| Preserved M1 controller/RF/compact antenna | 29.06 | 29.02 |
| Old M2 scope, individual charger + allocations | 77.11 | 73.82 |
| Candidate complete unit material, including protected pack | 53.53 | 53.49 |
| Recommended unit material budget, including BMS replacement reserve | 55.24 | 55.20 |
| Recommended fleet cash budget per unit, shared charging + EUR60 freight | 63.34 | 60.05 |
| Candidate fleet if EUR1.29 BMS passes qualification | 61.63 | 58.34 |
| Unquoted consolidation sensitivity: EUR40 fleet freight | 61.34 | 59.05 |
| Individual EUR15 chargers + EUR1 adapters, same audited hardware | 77.74 | 74.45 |

Shared charging uses **one charger per ten packs**: one/two chargers for ten/twenty transmitters. It changes fleet logistics, not the transmitter's RF/timing/safety. Charger and adapter are fleet equipment to purchase, reusable across events, itemized separately below. A serial schedule may take roughly 30–40 h per ten fully discharged packs at 1 A including CV tail; this is a planning example, not a measured charging time. No packs are paralleled.

## Exact bridge from M1 to old M2

| Addition beyond M1 baseline | Ten-unit EUR/unit | Twenty-unit EUR/unit |
| --- | ---: | ---: |
| Additional RF guard provision | 0.75 | 0.75 |
| Mandatory transmitter power/RF connector material | 2.20 | 2.20 |
| Wire/coax/crimps/strain relief | 2.50 | 2.50 |
| Bare PCB fabrication incl assumed MOQ5 leftovers | 6.00 | 6.00 |
| Outer enclosure/seals/mounting | 4.50 | 4.50 |
| External qualified 2S charger, one per unit | 10.00 | 10.00 |
| Shared provisioning fixture allocation | 0.50 | 0.25 |
| Shipping allocation for consolidated fleet baskets | 6.00 | 3.00 |
| New reference cells, 2 x P | 8.00 | 8.00 |
| Qualified balancing/protection BMS | 3.00 | 3.00 |
| Pack fuse/tabs/insulation/restraint/assembly material | 4.00 | 4.00 |
| Pack-side mating power connector | 0.60 | 0.60 |
| Total difference | 48.05 | 44.80 |

## Itemized unit material and functional provisions

Batch purchase allocation, rather than rounded row sums, determines totals. Unit/extended prices below retain four decimals where useful; the CSV/JSON keep exact decimals and pooled purchases. Group labels are accounting scopes, not additional boards. Quantities for functional material sets are explicit allowances; supplier minimums and unused bulk spools remain unquoted rather than being presented as confirmed purchase counts.

| Assembly / part | Qty/unit; needed 10 / 20 | Candidate / supplier code | Price evidence / stock | MOQ / multiple | Unit EUR at 10 / 20 fleets | Extended EUR/unit at 10 / 20 |
| --- | --- | --- | --- | --- | --- | --- |
| controller / S3 | 1; 10 / 20 | ESP32-S3-WROOM-1-N4; [Mouser](https://eu.mouser.com/en/ProductDetail/Espressif-Systems/ESP32-S3-WROOM-1-N4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): 356-ESP32-S3WROOM1N4 | OBSERVED; 3318 earlier index; new price page stock uncaptured | 1 / 1 | 3.8800 / 3.8800 | 3.8800 / 3.8800 |
| controller / RTC | 1; 10 / 20 | RV-3032-C7-32.768KHZ-2.5PPM-TA-QA; [DigiKey](https://www.digikey.de/en/products/detail/micro-crystal-ag/RV-3032-C7-32-768KHZ-2-5PPM-TA-QA/16273065): 2195-RV-3032-C7-32.768KHZ-2.5PPM-TA-QACT-ND | OBSERVED; 759 earlier EUR; 1389 newer USD index | 1 / 1 | 2.0320 / 2.0320 | 2.0320 / 2.0320 |
| controller / BUCK | 1; 10 / 20 | TPS62160DGKT; [DigiKey](https://www.digikey.de/de/products/detail/texas-instruments/TPS62160DGKT/3074519): 296-30318-1-ND | OBSERVED; 4588 earlier index | 1 / 1 | 1.4080 / 1.4080 | 1.4080 / 1.4080 |
| controller / RAWFET | 2; 20 / 40 | PMPB20XPE,115; [DigiKey](https://www.digikey.de/en/products/detail/nexperia-usa-inc/PMPB20XPE-115/4021003): 1727-1368-1-ND | OBSERVED; 6245 earlier index | 1 / 1 | 0.4460 / 0.4460 | 0.8920 / 0.8920 |
| controller / TVS | 1; 10 / 20 | SMBJ8.5A; [Mouser](https://www.mouser.de/de/ProductDetail/Littelfuse/SMBJ8.5A?qs=JJML70Qc14ta9WvVjIPjwg%3D%3D): 576-SMBJ8.5A | OBSERVED; 211 DE vs130 FR cached | 1 / 1 | 0.2360 / 0.2360 | 0.2360 / 0.2360 |
| controller / POR | 1; 10 / 20 | MCP100T-300I/TT; [Mouser](https://www.mouser.it/ProductDetail/Microchip-Technology/MCP100T-300I-TT?qs=8U9qMIGhlkokseONjNxnUg%3D%3D): 579-MCP100T-300I/TT | OBSERVED; 3723 US vs3538 AU indexed; EU live basket OPEN; aggregator counts excluded | 1 / 1 | 0.3610 / 0.3610 | 0.3610 / 0.3610 |
| controller / CMP | 1; 10 / 20 | LM393BIDR; [Mouser](https://eu.mouser.com/en/ProductDetail/Texas-Instruments/LM393BIDR?qs=BJlw7L4Cy78N8CV%252BGpRosA%3D%3D): 595-LM393BIDR | OBSERVED; 6986 cached EU vs7644 US; basket OPEN | 1 / 1 | 0.1400 / 0.1240 | 0.1400 / 0.1240 |
| controller / BUCKIND | 1; 10 / 20 | Buck inductor MPN/value OPEN; OPEN: OPEN | ESTIMATE; UNVERIFIED | 1 / 1 assumed | 0.4500 / 0.4500 | 0.4500 / 0.4500 |
| controller / FUSE | 3; 30 / 60 | Branch fuse exact MPN/rating OPEN; OPEN: OPEN | ESTIMATE; UNVERIFIED | 1 / 1 assumed | 0.2200 / 0.2200 | 0.6600 / 0.6600 |
| controller / INTERFACE | 2; 20 / 40 | Polarized logic PCB connector candidate family OPEN; OPEN: OPEN | ESTIMATE; UNVERIFIED | 1 / 1 assumed | 0.4500 / 0.4500 | 0.9000 / 0.9000 |
| controller / BUTTON | 1; 10 / 20 | Momentary pushbutton exact MPN OPEN; OPEN: OPEN | ESTIMATE; UNVERIFIED | 1 / 1 assumed | 0.1200 / 0.1200 | 0.1200 / 0.1200 |
| controller / C100N | 6; 60 / 120 | CC0603KRX7R8BB104; [Mouser](https://www.mouser.de/de/ProductDetail/YAGEO/CC0603KRX7R8BB104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): 603-CC603KRX7R8BB104 | OBSERVED; 20401272 newer EU index; DE20582958 | 1 / 1 | 0.0240 / 0.0240 | 0.1440 / 0.1440 |
| controller / CBULK | 3; 30 / 60 | 10-22uF25V X7R MPN/value OPEN; OPEN: OPEN | ESTIMATE; UNVERIFIED | 1 / 1 assumed | 0.1600 / 0.1600 | 0.4800 / 0.4800 |
| controller / R10K | 8; 80 / 160 | RC0603FR-0710KL; [Mouser](https://www.mouser.de/en/ProductDetail/YAGEO/RC0603FR-0710KL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): 603-RC0603FR-0710KL | OBSERVED; 3405942 cached DE | 1 / 1 | 0.0070 / 0.0070 | 0.0560 / 0.0560 |
| controller / RES | 12; 120 / 240 | E24/E96 resistor other values MPN OPEN; OPEN: OPEN | ESTIMATE; UNVERIFIED | 1 / 1 assumed | 0.0250 / 0.0250 | 0.3000 / 0.3000 |
| controller / SMALLBJT | 3; 30 / 60 | MMBT3904/MMBT3906 equivalent stocked MPN OPEN; OPEN: OPEN | ESTIMATE; UNVERIFIED | 1 / 1 assumed | 0.1000 / 0.1000 | 0.3000 / 0.3000 |
| controller / DIODE | 3; 30 / 60 | Small signal/clamp diode exact MPN OPEN; OPEN: OPEN | ESTIMATE; UNVERIFIED | 1 / 1 assumed | 0.0800 / 0.0800 | 0.2400 / 0.2400 |
| controller / BEAD | 2; 20 / 40 | Ferrite bead exact MPN OPEN; OPEN: OPEN | ESTIMATE; UNVERIFIED | 1 / 1 assumed | 0.0800 / 0.0800 | 0.1600 / 0.1600 |
| 80m / SYNTH | 1; 10 / 20 | SI5351A-B-GT; [DigiKey](https://www.digikey.de/en/products/detail/skyworks-solutions-inc/SI5351A-B-GT/3679847): 336-2399-5-ND | OBSERVED; 10254 earlier index | 1 / 1 | 1.3880 / 1.3880 | 1.3880 / 1.3880 |
| 80m / CRYSTAL | 1; 10 / 20 | 25/27MHz crystal exact MPN OPEN; OPEN: OPEN | ESTIMATE; UNVERIFIED | 1 / 1 assumed | 0.4000 / 0.4000 | 0.4000 / 0.4000 |
| 80m / MONO | 1; 10 / 20 | 74HC123D,653; [Mouser](https://eu.mouser.com/en/ProductDetail/Nexperia/74HC123D653?qs=P62ublwmbi%2FMZUrC9zEqyg%3D%3D): 771-74HC123D-T | OBSERVED; 1037 newer EU vs zero older NL/BR; conflict | 1 / 1 | 0.2190 / 0.2190 | 0.2190 / 0.2190 |
| 80m / LATCH | 1; 10 / 20 | 74HC74D,653; [Mouser](https://nl.mouser.com/ProductDetail/Nexperia/74HC74D653?qs=P62ublwmbi8VnJ1KG1%2FblQ%3D%3D): 771-74HC74D-T | OBSERVED; 623 older NL;1590 newer USD | 1 / 1 | 0.1230 / 0.1230 | 0.1230 / 0.1230 |
| 80m / AND | 1; 10 / 20 | 74HC08D,653; [Mouser](https://eu.mouser.com/ProductDetail/Nexperia/74HC08D653?qs=P62ublwmbi%2FQCxm29EB%2FyA%3D%3D): 771-74HC08D-T | OBSERVED; 37703 cached EU | 1 / 1 | 0.1140 / 0.1140 | 0.1140 / 0.1140 |
| 80m / POR | 1; 10 / 20 | MCP100T-300I/TT; [Mouser](https://www.mouser.it/ProductDetail/Microchip-Technology/MCP100T-300I-TT?qs=8U9qMIGhlkokseONjNxnUg%3D%3D): 579-MCP100T-300I/TT | OBSERVED; 3723 US vs3538 AU indexed; EU live basket OPEN; aggregator counts excluded | 1 / 1 | 0.3610 / 0.3610 | 0.3610 / 0.3610 |
| 80m / CMP | 1; 10 / 20 | LM393BIDR; [Mouser](https://eu.mouser.com/en/ProductDetail/Texas-Instruments/LM393BIDR?qs=BJlw7L4Cy78N8CV%252BGpRosA%3D%3D): 595-LM393BIDR | OBSERVED; 6986 cached EU vs7644 US; basket OPEN | 1 / 1 | 0.1400 / 0.1240 | 0.1400 / 0.1240 |
| 80m / INTERFACE | 1; 10 / 20 | Polarized logic PCB connector candidate family OPEN; OPEN: OPEN | ESTIMATE; UNVERIFIED | 1 / 1 assumed | 0.4500 / 0.4500 | 0.4500 / 0.4500 |
| 80m / SHUNT | 1; 10 / 20 | Low-ohm1% current shunt MPN/value OPEN; OPEN: OPEN | ESTIMATE; UNVERIFIED | 1 / 1 assumed | 0.1000 / 0.1000 | 0.1000 / 0.1000 |
| 80m / NTC | 1; 10 / 20 | 10k NTC MPN OPEN; OPEN: OPEN | ESTIMATE; UNVERIFIED | 1 / 1 assumed | 0.1000 / 0.1000 | 0.1000 / 0.1000 |
| 80m / BEAD | 3; 30 / 60 | Ferrite bead exact MPN OPEN; OPEN: OPEN | ESTIMATE; UNVERIFIED | 1 / 1 assumed | 0.0800 / 0.0800 | 0.2400 / 0.2400 |
| 80m / DIODE | 6; 60 / 120 | Small signal/clamp diode exact MPN OPEN; OPEN: OPEN | ESTIMATE; UNVERIFIED | 1 / 1 assumed | 0.0800 / 0.0800 | 0.4800 / 0.4800 |
| 80m / SMALLFET | 3; 30 / 60 | 2N7002 equivalent exact stocked MPN OPEN; OPEN: OPEN | ESTIMATE; UNVERIFIED | 1 / 1 assumed | 0.1000 / 0.1000 | 0.3000 / 0.3000 |
| 80m / SHIELD | 1; 10 / 20 | RF shield frame/lid material exact MPN OPEN; OPEN: OPEN | ESTIMATE; UNVERIFIED | 1 / 1 assumed | 0.7000 / 0.7000 | 0.7000 / 0.7000 |
| 80m / R10K | 8; 80 / 160 | RC0603FR-0710KL; [Mouser](https://www.mouser.de/en/ProductDetail/YAGEO/RC0603FR-0710KL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): 603-RC0603FR-0710KL | OBSERVED; 3405942 cached DE | 1 / 1 | 0.0070 / 0.0070 | 0.0560 / 0.0560 |
| 80m / OPAMP | 1; 10 / 20 | LM2904BIDR; [Mouser](https://eu.mouser.com/ProductDetail/Texas-Instruments/LM2904BIDR?qs=9r4v7xj2LnnFewvbXZMeJA%3D%3D): 595-LM2904BIDR | OBSERVED; 546 cached EU | 1 / 1 | 0.1420 / 0.1420 | 0.1420 / 0.1420 |
| 80m / RFCOIL | 2; 20 / 40 | VHF aircoil/80m choke MPN or winding recipe OPEN; OPEN: OPEN | ESTIMATE; UNVERIFIED | 1 / 1 assumed | 0.1200 / 0.1200 | 0.2400 / 0.2400 |
| 80m / C0G | 4; 40 / 80 | C0G50-100V RF capacitor MPN/value OPEN; OPEN: OPEN | ESTIMATE; UNVERIFIED | 1 / 1 assumed | 0.1000 / 0.1000 | 0.4000 / 0.4000 |
| 80m / RFDET | 1; 10 / 20 | RF Schottky detector exact MPN OPEN; OPEN: OPEN | ESTIMATE; UNVERIFIED | 1 / 1 assumed | 0.1500 / 0.1500 | 0.1500 / 0.1500 |
| 80m / SMALLBJT | 2; 20 / 40 | MMBT3904/MMBT3906 equivalent stocked MPN OPEN; OPEN: OPEN | ESTIMATE; UNVERIFIED | 1 / 1 assumed | 0.1000 / 0.1000 | 0.2000 / 0.2000 |
| 80m / PADRES | 6; 60 / 120 | RF pad/current-limit resistor MPN/value OPEN; OPEN: OPEN | ESTIMATE; UNVERIFIED | 1 / 1 assumed | 0.0600 / 0.0600 | 0.3600 / 0.3600 |
| 80m / TRIM | 1; 10 / 20 | Calibration trimmer exact MPN/value OPEN; OPEN: OPEN | ESTIMATE; UNVERIFIED | 1 / 1 assumed | 0.1800 / 0.1800 | 0.1800 / 0.1800 |
| 80m / C100N | 6; 60 / 120 | CC0603KRX7R8BB104; [Mouser](https://www.mouser.de/de/ProductDetail/YAGEO/CC0603KRX7R8BB104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): 603-CC603KRX7R8BB104 | OBSERVED; 20401272 newer EU index; DE20582958 | 1 / 1 | 0.0240 / 0.0240 | 0.1440 / 0.1440 |
| 80m / CBULK | 2; 20 / 40 | 10-22uF25V X7R MPN/value OPEN; OPEN: OPEN | ESTIMATE; UNVERIFIED | 1 / 1 assumed | 0.1600 / 0.1600 | 0.3200 / 0.3200 |
| 80m / RES | 12; 120 / 240 | E24/E96 resistor other values MPN OPEN; OPEN: OPEN | ESTIMATE; UNVERIFIED | 1 / 1 assumed | 0.0250 / 0.0250 | 0.3000 / 0.3000 |
| compact80 / FOXTUNE | 1; 10 / 20 | Compact highL loading/coupling coil former/core/wire OPEN; OPEN: OPEN | ESTIMATE; UNVERIFIED | 1 / 1 assumed | 1.3000 / 1.3000 | 1.3000 / 1.3000 |
| compact80 / RFCAPTRIM | 1; 10 / 20 | RF-voltage-rated tuning element exact MPN OPEN; OPEN: OPEN | ESTIMATE; UNVERIFIED | 1 / 1 assumed | 3.0000 / 3.0000 | 3.0000 / 3.0000 |
| compact80 / HVCAP | 4; 40 / 80 | RF C0G capacitor >=500 V candidate, exact values/MPN OPEN; OPEN: OPEN | ESTIMATE; UNVERIFIED | 1 / 1 assumed | 0.2500 / 0.2500 | 1.0000 / 1.0000 |
| compact80 / PADRES | 3; 30 / 60 | RF pad/current-limit resistor MPN/value OPEN; OPEN: OPEN | ESTIMATE; UNVERIFIED | 1 / 1 assumed | 0.0600 / 0.0600 | 0.1800 / 0.1800 |
| compact80 / ACCESSKEY | 1; 10 / 20 | Keyed accessory plug/identity/contact exact MPN OPEN; OPEN: OPEN | ESTIMATE; UNVERIFIED | 1 / 1 assumed | 0.5500 / 0.5500 | 0.5500 / 0.5500 |
| compact80 / ACCESSCASE | 1; 10 / 20 | Cartridge support/insulation/strain relief OPEN; OPEN: OPEN | ESTIMATE; UNVERIFIED | 1 / 1 assumed | 0.6000 / 0.6000 | 0.6000 / 0.6000 |
| compact80 / FOXRAD | 1; 10 / 20 | 30cm radiator and defined compact counterpoise material OPEN; OPEN: OPEN | ESTIMATE; UNVERIFIED | 1 / 1 assumed | 1.4000 / 1.4000 | 1.4000 / 1.4000 |
| compact80 / LOWPROTECT | 1; 10 / 20 | Compact-network lowcap protection/damping components OPEN; OPEN: OPEN | ESTIMATE; UNVERIFIED | 1 / 1 assumed | 0.3500 / 0.3500 | 0.3500 / 0.3500 |
| 80m / BUSISO | 1; 10 / 20 | Dual I2C bus isolation switch e.g. SN74LVC2G66DCUR; exact selection OPEN; OPEN: OPEN | ESTIMATE; UNVERIFIED | 1 / 1 assumed | 0.2500 / 0.2500 | 0.2500 / 0.2500 |
| controller / LED | 1; 10 / 20 | Status LED exact MPN OPEN; OPEN: OPEN | ESTIMATE; UNVERIFIED | 1 / 1 assumed | 0.0600 / 0.0600 | 0.0600 / 0.0600 |
| low_guard / LOWGUARD | 1; 10 / 20 | M2 low-branch guard and drive-input limit reserve; OPEN: Exact incremental parts/counts OPEN | RESERVE; Not a separately quoted component | 1 / 1 assumed | 0.7500 / 0.7500 | 0.7500 / 0.7500 |
| pack / CELL25R | 2; 20 / 40 | New Samsung INR18650-25R flat-top cell, regular listing; [NKON](https://www.nkon.nl/en/samsung-18650-inr18650-25r.html): INR18650-25R; product 1754, EAN 8438493100709 | OBSERVED; Orderable page/category; exact stock count not captured; direct page date 08-10-2026 | 1 / 1 | 1.7300 / 1.7300 | 3.4600 / 3.4600 |
| pack / CELLTABS | 2; 20 / 40 | Supplier pre-welded U or Z solder tags per cell; [NKON](https://www.nkon.nl/en/samsung-18650-inr18650-25r.html): Solder-tag option for product 1754; geometry OPEN | OBSERVED; Production on demand, average 3 business days, up to 2 weeks quoted | 1 / 1 | 0.6200 / 0.6200 | 1.2400 / 1.2400 |
| pack / PACKPCM | 1; 10 / 20 | External-pack 2S protection and balancing candidate; [LaskaKit](https://www.laskakit.cz/en/ochrana-li-ion-baterie-2s-20a/): LA123112 | OBSERVED; 25 pieces shown; delivery 16-10-2026; stock not reserved | 1 / 1 | 1.2900 / 1.2900 | 1.2900 / 1.2900 |
| qualification_reserve / PCMRESERVE | 1; 10 / 20 | Protection-device replacement/qualification material reserve; OPEN: OPEN | RESERVE; Not a physical purchased component | 1 / 1 assumed | 1.7100 / 1.7100 | 1.7100 / 1.7100 |
| pack / PACKFUSE | 1; 10 / 20 | Pack fuse/current-protective element; OPEN: OPEN | ESTIMATE; Unquoted | 1 / 1 assumed | 0.2200 / 0.2200 | 0.2200 / 0.2200 |
| pack / PACKPAPER | 1; 10 / 20 | Cell positive-ring and fish-paper/barrier material set; OPEN: OPEN | ESTIMATE; Unquoted bulk-material allocation | 1 / 1 assumed | 0.3500 / 0.3500 | 0.3500 / 0.3500 |
| pack / PACKSHRINK | 1; 10 / 20 | Pack heat-shrink sleeve and tape; OPEN: OPEN | ESTIMATE; Unquoted bulk-material allocation | 1 / 1 assumed | 0.2500 / 0.2500 | 0.2500 / 0.2500 |
| pack / PACKREST | 1; 10 / 20 | Cell spacer/restraint and terminal cover set; OPEN: OPEN | ESTIMATE; Unquoted | 1 / 1 assumed | 0.4000 / 0.4000 | 0.4000 / 0.4000 |
| pack / PACKLEADS | 1; 10 / 20 | Short protected-pack and cell-sense leads/strain relief; OPEN: OPEN | ESTIMATE; Unquoted material set | 1 / 1 assumed | 0.2800 / 0.2800 | 0.2800 / 0.2800 |
| power_connector / POWERPLUG | 4; 40 / 80 | Polarized 2S power plug half e.g. XT30, exact supplier MPN OPEN; OPEN: OPEN | ESTIMATE; UNVERIFIED | 1 / 1 assumed | 0.6000 / 0.6000 | 2.4000 / 2.4000 |
| low_connector / LOWPORT | 1; 10 / 20 | Dissimilar keyed low-power PCB socket with identity/interlock MPN OPEN; OPEN: OPEN | ESTIMATE; UNVERIFIED | 1 / 1 assumed | 0.4000 / 0.4000 | 0.4000 / 0.4000 |
| harness / POWERWIRE | 1; 10 / 20 | Transmitter-side power/return wire and crimps; OPEN: OPEN | ESTIMATE; Unquoted set | 1 / 1 assumed | 0.6000 / 0.6000 | 0.6000 / 0.6000 |
| harness / LOGICWIRE | 1; 10 / 20 | Controller-RF logic harness mating contacts/ribbon; OPEN: OPEN | ESTIMATE; Unquoted set | 1 / 1 assumed | 0.9000 / 0.9000 | 0.9000 / 0.9000 |
| harness / RFWIRE | 1; 10 / 20 | Short low-power RF interconnect and return termination; OPEN: OPEN | ESTIMATE; Unquoted set | 1 / 1 assumed | 0.4000 / 0.4000 | 0.4000 / 0.4000 |
| harness / HARNESSREST | 1; 10 / 20 | Transmitter harness tie/heat-shrink/strain restraint; OPEN: OPEN | ESTIMATE; Unquoted set | 1 / 1 assumed | 0.6000 / 0.6000 | 0.6000 / 0.6000 |
| fabrication / FABCTRL | 1; 10 / 20 | Bare existing controller PCB fabrication; OPEN: Existing design, no fabrication files released | ESTIMATE; No quote; outline/layers/finish open | 5 / 5 assumed | 3.0000 / 3.0000 | 3.0000 / 3.0000 |
| fabrication / FABRF | 1; 10 / 20 | Bare existing full-outline 80m PCB, Fox-only population; OPEN: Existing design, no fabrication files released | ESTIMATE; No quote; unchanged common outline | 5 / 5 assumed | 3.0000 / 3.0000 | 3.0000 / 3.0000 |
| enclosure / SHELL | 1; 10 / 20 | ABS transmitter enclosure with supplied lid gasket/screws, candidate 115x90x55mm; [Pollin](https://www.pollin.de/p/modulgehaeuse-abs-115x90x55-mm-ip65-lichtgrau-460311): 460311 | OBSERVED_LIST_BASIS; 1-3 business days shown; stock quantity uncaptured | 1 / 1 | 3.2800 / 3.2800 | 3.2800 / 3.2800 |
| enclosure / BOARDMOUNT | 1; 10 / 20 | Board standoff/internal screw/retaining material set; OPEN: OPEN | ESTIMATE; Unquoted | 1 / 1 assumed | 0.4000 / 0.4000 | 0.4000 / 0.4000 |
| enclosure / GROMMETS | 1; 10 / 20 | Cable/antenna penetration grommet or boot material set; OPEN: OPEN | ESTIMATE; Unquoted | 1 / 1 assumed | 0.4500 / 0.4500 | 0.4500 / 0.4500 |
| enclosure / CASESEAL | 1; 10 / 20 | Penetration sealing/anchor/strain-restraint material; OPEN: OPEN | ESTIMATE; Unquoted | 1 / 1 assumed | 0.3000 / 0.3000 | 0.3000 / 0.3000 |
| assembly_material / CONSUMABLE | 1; 10 / 20 | Solder/flux/cleaning material allocation; OPEN: OPEN | ESTIMATE; Unquoted material-use allocation | 1 / 1 assumed | 0.4000 / 0.4000 | 0.4000 / 0.4000 |
| assembly_material / LABEL | 1; 10 / 20 | Unit/pack identification and setup label; OPEN: OPEN | ESTIMATE; Unquoted | 1 / 1 assumed | 0.1000 / 0.1000 | 0.1000 / 0.1000 |

## Assembly/scope subtotals

| Scope | EUR/unit: 10 | EUR/unit: 20 |
| --- | ---: | ---: |
| controller | 12.82 | 12.80 |
| 80m | 7.86 | 7.84 |
| compact80 | 8.38 | 8.38 |
| low_guard | 0.75 | 0.75 |
| pack | 7.49 | 7.49 |
| qualification_reserve | 1.71 | 1.71 |
| power_connector | 2.40 | 2.40 |
| low_connector | 0.40 | 0.40 |
| harness | 2.50 | 2.50 |
| fabrication | 6.00 | 6.00 |
| enclosure | 4.43 | 4.43 |
| assembly_material | 0.50 | 0.50 |

## Price evidence exposure of unit budget

These classify prices, not proof that supplier claims or the hardware are qualified. The RF guard and BMS reserve are separated from material quotes. Labor, tooling capital and freight are not hidden inside component lines.

| Class | Batch EUR: 10 | Batch EUR: 20 |
| --- | ---: | ---: |
| OBSERVED | 211.06 | 421.48 |
| ESTIMATE | 316.70 | 633.40 |
| RESERVE | 24.60 | 49.20 |

## Shared fleet equipment, freight and cash budgets

| Equipment / scope | Qty/fleet: 10 / 20 | Unit EUR | Batch EUR: 10 / 20 | Class |
| --- | --- | ---: | --- | --- |
| Qualified external 8.4V CC-CV 0.5-1A 2S charger / CHARGER | 1 / 2 | 15.00 | 15.00 / 30.00 | ESTIMATE; quote/qualification open |
| Shared charger-to-protected-pack keyed adapter / CHARGEADAPTER | 1 / 2 | 1.00 | 1.00 / 2.00 | ESTIMATE; quote/qualification open |
| Shared passive service-pad programming cable/probe fixture / PROVISION | 1 / 1 | 5.00 | 5.00 / 5.00 | ESTIMATE; quote/qualification open |
| Consolidated fleet freight | one budget / one budget | — | 60.00 / 60.00 | ESTIMATE; actual routes/baskets open |

| Fleet budget | Ten units EUR | Twenty units EUR |
| --- | ---: | ---: |
| Budgeted unit material | 552.36 | 1104.08 |
| Shared equipment | 21.00 | 37.00 |
| Freight | 60.00 | 60.00 |
| Total, before labor/instruments/spares/VAT | 633.36 | 1201.08 |

A shared EUR5 provisioning cable is not the RF test laboratory. Assembly/pack/tab soldering, winding, programming, calibration, field work and instrument access are **labor/capital OPEN**, not paid/free services implicitly supplied with the BOM. Consumables are included. The scope assumes one accepted unit per planned component set; reject/spare allowance and bulk-material leftovers need separate cash planning.

## Protected 2S1P endurance check — calculations only

Two 25R cells preserve the 2S domain and use a lower capacity explicitly. Aging80% × discharge-window90% × temperature90% is still an assumption. The 0.350 W Foxoring load is the M2 full-key-down allowance, not a measured current.

| Cell capacity basis | Usable Wh | Runtime at 0.350 W | Runtime with +0.045 W LoRa RX | 24h mean-power ceiling |
| --- | ---: | ---: | ---: | ---: |
| 2.50 Ah | 11.664 | 33.3 h | 29.5 h | 0.486 W |
| 2.45 Ah | 11.431 | 32.7 h | 28.9 h | 0.476 W |

No LoRa is populated here. Pack compatibility does not mean this smaller capacity meets full-power Classic/Sprint/VHF endurance. Use the conservative 2.45 Ah ceiling for this Foxoring candidate; actual pack capacity, cold performance, cell imbalance, RF end-of-run level and peak/trip behavior remain measured gates.

[Machine-readable bill](FOXORING_COST_BOM.csv), [totals](FOXORING_COST_TOTALS.json), [additional part/allowance catalog](FOXORING_COST_PARTS.json) and [source log](FOXORING_COST_SOURCES.md).
