DD1SB/ARDF-TX/docs/FOXORING_COST_SOURCES.md

# Foxoring cost audit — dated source log

Retrieved **2026-10-13**. OBSERVED is an inspected listing, PUBLISHER is a source's report, ESTIMATE is our allowance, CALCULATION is our model. **No purchases, supplier contacts, project measurements or new simulations occurred.** Earlier [M1 sources](M1_COST_SOURCES.md) and [M2 sources](M2_SOURCES.md) remain attributed historical records; this log resolves the Foxoring-specific price/scope questions.

| ID | Primary/source location | Inspected evidence | Boundary / cost treatment |
| --- | --- | --- | --- |
| FOX-BASE | [M1 workbook](M1_COSTED_BOM.md), [catalog](M1_COST_PARTS.json), [CSV](M1_COST_BOM.csv) | €29.06/€29.02 controller + reduced RF + compact accessory at 10/20. Complete accessories €8.38. | Internal calculations, partly unquoted counts/material. Preserve populations/prices; no current inventory guarantee. |
| FOX-OLD-M2 | [M2 JSON](M2_SYSTEM_COST.json), Fox-only/2S1P ten-unit row | €77.11: core + guard + complete accessory + pack/outer mechanics/fabrication/wiring + individual charger/fixture/freight allocations. | Internal original planning model, no quote/purchase. All €48.05 additions traced. |
| FOX-CELL | [NKON new regular 25R](https://www.nkon.nl/en/samsung-18650-inr18650-25r.html), specification and quantity table | Product 1754/EAN8438493100709; net €1.94/€1.73/€1.64 at 1/10/50. 2500 mAh typical, 2450 mAh supplier minimum; unprotected flat-top. | Page allows Add to Cart, category orderable; exact count not captured, page date 08-10-2026. New regular listing selected, old/reclaimed excluded. Buy demand20/40; both use ≥10 break. Stock/lot and shipping open. |
| FOX-CELL-DS | [Samsung SDI 25R specification via NKON](https://www.nkon.nl/en/amfile/file/download/file/229/product/1754/), Feb2014 Rev1.0 §3/§7 | Primary cell capacity, 3.6 V, standard CC-CV conditions, operating temperature and cycle-test conditions inspected. | Manufacturer primary document via distributor; exact delivered revision/lot required. Old high-current cycle/cold tests are not low-drain pack-runtime measurements. No confidential-marked complete source copy committed. |
| FOX-TABS | Same NKON product, solder-tag options | U/Z pre-attached tabs €0.75 gross / **€0.62 net per cell**; on-demand time average3 business days, possibly2 weeks. | Observed service price, two per pack; no unpriced spot welder. Geometry/pack assembly review open. |
| FOX-35E-STATUS | [NKON 35E](https://www.nkon.nl/en/samsung-inr18650-35e.html) | Direct page now shows **out of stock**, €2.14 net single, next break50 €1.85. | Supersedes the earlier index's in-stock observation. Not assumed available; no false ten-piece break. Two cells cost €4.28 net if stock returns, €0.82 more than selected 25R pair. |
| FOX-PCM | [LaskaKit 2S protection/balancer](https://www.laskakit.cz/en/ochrana-li-ion-baterie-2s-20a/), codeLA123112 | **€1.29 net / €1.56 gross**, stock25, arrival16-10-2026. Seller describes both-cell voltage/short/current protection and balancing, <30 µA idle; seller's datasheet discussion says no manufacturer datasheet available. | Candidate publisher specification only. Samples/lot identity, balancing, trips/leakage/current coordination remain mandatory. Reserve €1.71 to retain €3 protection budget until qualified; no free-shipping/20A qualification claim. |
| FOX-PCM-NOT | [NKON 2S2004-D5A](https://www.nkon.nl/en/2s-bms-1mos-2004d.html) | €1.20 net; direct product page **out of stock, discontinued, will not be restocked**. | Category still appeared orderable; direct page governs. Excluded. Balancing/threshold evidence also incomplete. |
| FOX-CASE | [Pollin ABS case](https://www.pollin.de/p/modulgehaeuse-abs-115x90x55-mm-ip65-lichtgrau-460311), code460311 | Current €3.80 gross, regular€3.90, delivery1–3 business days; lid gasket and screws supplied, nominal115×90×55 mm. | Exact stock count/unchanged-board fit and modified weather performance open. Use conservative regular-price net€3.28, German19% VAT basis; no sale/quantity discount assumed. Internal mounting/penetration material separately estimated. |
| FOX-CASE-COMP | [Farnell G3107](https://de.farnell.com/multicomp-pro/g3107/box-abs-ip65-120x80x55mm/dp/1526653), code1526653; [RS2069101](https://de.rs-online.com/web/p/universalgehause/2069101) | Farnell net€11.24/9.67/9.19 at1/5/15 for120×80×55; RS net€12.13 single,120×80×75.2. | Valid costlier alternatives if fit/environment demands them; do not silently budget industrial branded case at €3. Direct final stock/quantity open. |
| FOX-CHARGE | [Accessoires Energie 2S charger](https://accessoires-energie.com/en/de-de/products/chargeur-8-4v-1a-pour-batterie-lithium-ion-2s), SKU CH-8.4V-1A-ION-5.5X2.1 | €12.50 **gross**, 8.4 V/1 A, EU mains, barrel output; in-stock page, related snippet only2 available. | CC-CV/termination accuracy and VAT jurisdiction not fully documented. Comparator only; €15 **estimated net qualified charger budget**, not a converted quote, +€1 keyed adapter. No parallel charging. |
| FOX-CHARGE-COMP | [Reichelt ANSMANN1001-0085](https://www.reichelt.de/de/de/shop/produkt/ladegeraet_powerline_vario_x_fuer_akkupacks_und_akkus-266318), ANS1001-0085; [Enerpower 2S manual](https://enerpower.de/wp/wp-content/uploads/2016/03/Enerpower_2S_Charger_Manual_DE_EN.pdf) | Reichelt €22.40 incl19% VAT, in-stock; sliding-contact universal pack charger uses external USB supply. Enerpower manual documents a dedicated CCCV family. | Different connector/supply/current scopes; not substituted at €15 without full source/specification/adapter price. Exact appropriate charging option remains open. |
| FOX-FREIGHT | [NKON order/shipping policy](https://www.nkon.nl/pt/orderingshipping) | Shipping price depends on destination/cart; no fixed verified fleet quote. | Retain old €60 fleet estimate; €40 consolidation sensitivity remains unquoted. No assumed free delivery or current old promotional coupon. |
| FOX-TINY-MANUAL | [TinyFox author manual, ARDF-France mirror](https://ardf.r-e-f.org/ressources/vente/Tinyfox-Documentation-fr-site.pdf), documentation2.2pre4 dated2011-03-26, hardware2.0 | Authors DL3SDO/DL3SFB; AA/boost, crystal/logic RF, ATtiny13, 30cm antenna and environment-dependent tuning; firmware GNU GPL declaration. | Inspected primary-authored translated manual. No conducted10mW/250m/off-slot qualification established. Public drawings/code not copied; GPL declaration does not license every external artifact. |
| FOX-TINY-COST | [OE6AVD first-person report, QSP07–08/2019](https://www.oevsv.at/export/shared/.content/.galleries/qsp_downloadgallery/2019_qsp_downloadgallery/QSP_07-08_2019.pdf), p.12 | Historical material cost€15–30 depending sources; kit not then offered. Author reports ~500m audibility without ground with30cm telescopic antenna. | Historical author costs/field experience, not current quote or modern competition pass. Source country observations are not project transmission authorization. |
| FOX-FIXLE | [DF1FO Fixle.doc](https://df1fo.darc.de/DOC/Fixle.doc), current link from [author index](https://df1fo.darc.de/) datedSeptember2026 | Downloaded and read with antiword. Larger-batch table€5.65/about€6; includes PCB/case/holder/wire, CR2032 not priced. Coin-cell/ATtiny25/crystal RF, longer antenna/return and author field experience. | No current distributor basket/tax normalization or calibrated conducted10mW/spectrum/compact30cm qualification. Author limited-stock component kit is not repeatable distributor pricing. No full document/code/CAD copied. |

Access failures: TinyFox HTTP/HTTPS website opens failed, so its current price is unknown. Browser cannot render Fixle's MS Word type; direct download/antiword succeeded. NKON category direct download returned HTTP403; direct product/browser text and quantity tables were available. Early guessed NKON short URLs failed; only the subsequently verified product1754 canonical URL supports the selected cell. The Ansmann specialist-shop page returned a cache miss; no price is inferred from it. Inventory/date differences are retained, rather than turning category/index claims into reserved stock.

Fixle source identity: downloaded2026-10-13, SHA-256 `cbcf76118949498c05f94ba7b3e820edab2aaeac83f169b565fbf34813e6cfdb`. The source file remains temporary, outside deliverables. Only short factual summaries and original calculations are published here. No third-party schematic, firmware, PCB, footprint or complete article is reproduced.
