DD1SB/ARDF-TX/docs/M1_COST_SOURCES.md

# M1 cost-rework dated source supplement

Retrieved **2026-10-13**. This extends [research-register.md](research-register.md); source identifiers below are research evidence, not approval to copy or order. OBSERVED means a distributor/manufacturer page or search-index extract inspected on this date. Cache age, conflicting country views and failed detailed access prevent a claim of live reserved stock or binding price. The [catalog](M1_COST_PARTS.json) records each
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
