DD1SB/ARDF-TX/hardware/2m/review/M5B-E6R1/07-cooler-mass-cost.png

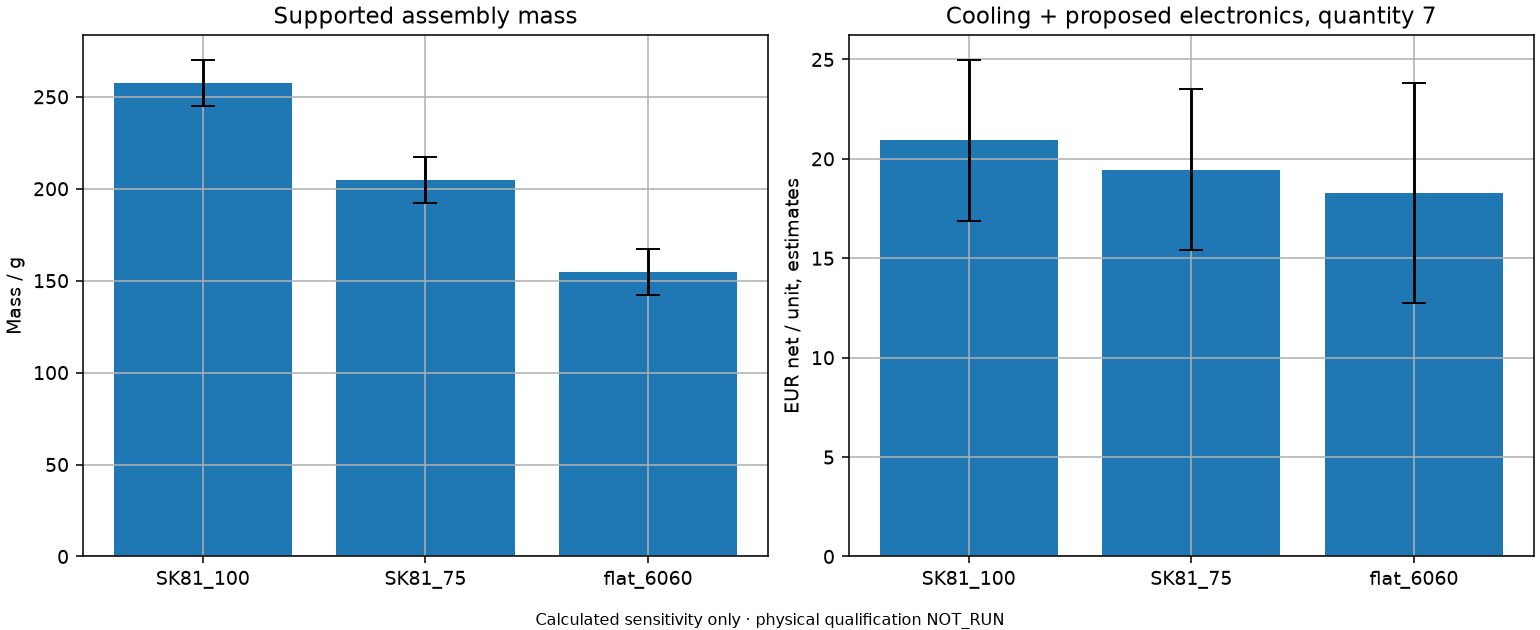
hardware/2m/review/M5B-E6R1/07-cooler-mass-cost.png
