DD1SB/ARDF-TX/hardware/2m/review/M5B-E6R2/mechanical/complete-mechanical-stack.step

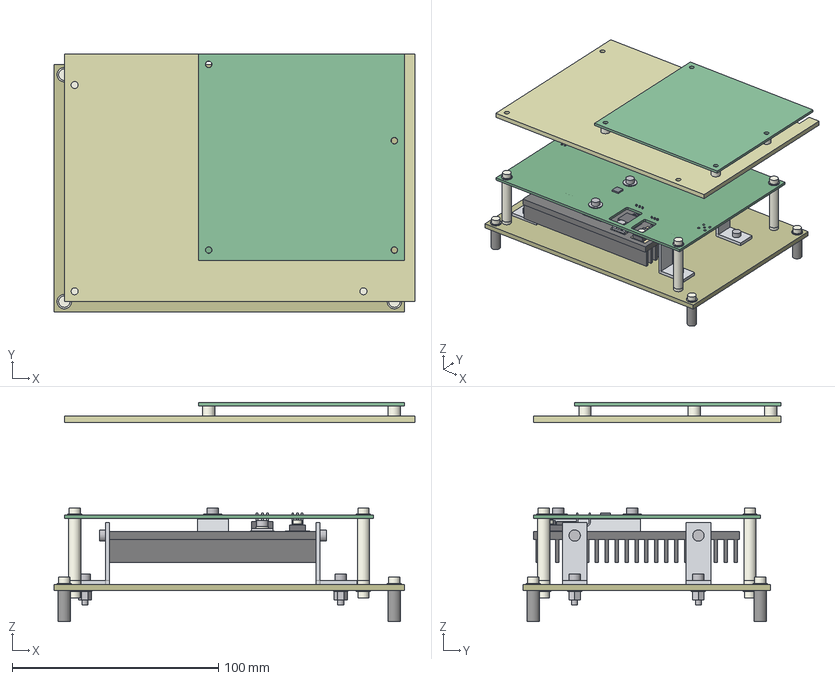
[picture p54: CAD file, 2026-10-21]
hardware/2m/review/M5B-E6R2/mechanical/complete-mechanical-stack.step
175.0 x 125.0 x 106.2 mm
SK81_100
source_bar_15x44x6
source_insulating_TIM
Q401_mica
Q401_tab
Q401_body
Q401_lead1
Q401_lead2
Q401_lead3
Q401_IB6
Q401_M3x6
Q402_mica
Q402_tab
Q402_body
Q402_lead3
Q402_lead2
Q402_lead1
Q402_PA66washer
Q402_M2p5x6_PA66
bracket_42_40
support_M3_42_40
bracket_42_100
support_M3_42_100
bracket_142_40
support_M3_142_40
bracket_142_100
support_M3_142_100
barwasher_32.0
bar_M3x12_32.0
barwasher_68.0
bar_M3x12_68.0
foot_M3x12_30.0_40.0
foot_washer_30.0_40.0
foot_locknut_30.0_40.0
foot_M3x12_30.0_100.0
foot_washer_30.0_100.0
foot_locknut_30.0_100.0
foot_M3x12_154.0_40.0
foot_washer_154.0_40.0
foot_locknut_154.0_40.0
foot_M3x12_154.0_100.0
foot_washer_154.0_100.0
foot_locknut_154.0_100.0
RF2M_native_board
Q501_package_envelope
insulating_carrier_170x120x3
PCB_post_0
PCB_spacer_0
PCB_top_PA66bolt_0
PCB_top_PA66washer_0
PCB_bottom_PA66bolt_0
PCB_bottom_PA66washer_0
PCB_post_1
PCB_spacer_1
PCB_top_PA66bolt_1
PCB_top_PA66washer_1
PCB_bottom_PA66bolt_1
PCB_bottom_PA66washer_1
PCB_post_2
PCB_spacer_2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
