DD1SB/ARDF-TX/hardware/2m/review/M5B-E6R2/development/pre-flat-pin-correction/Q402_CommonPlane_E6R2.step

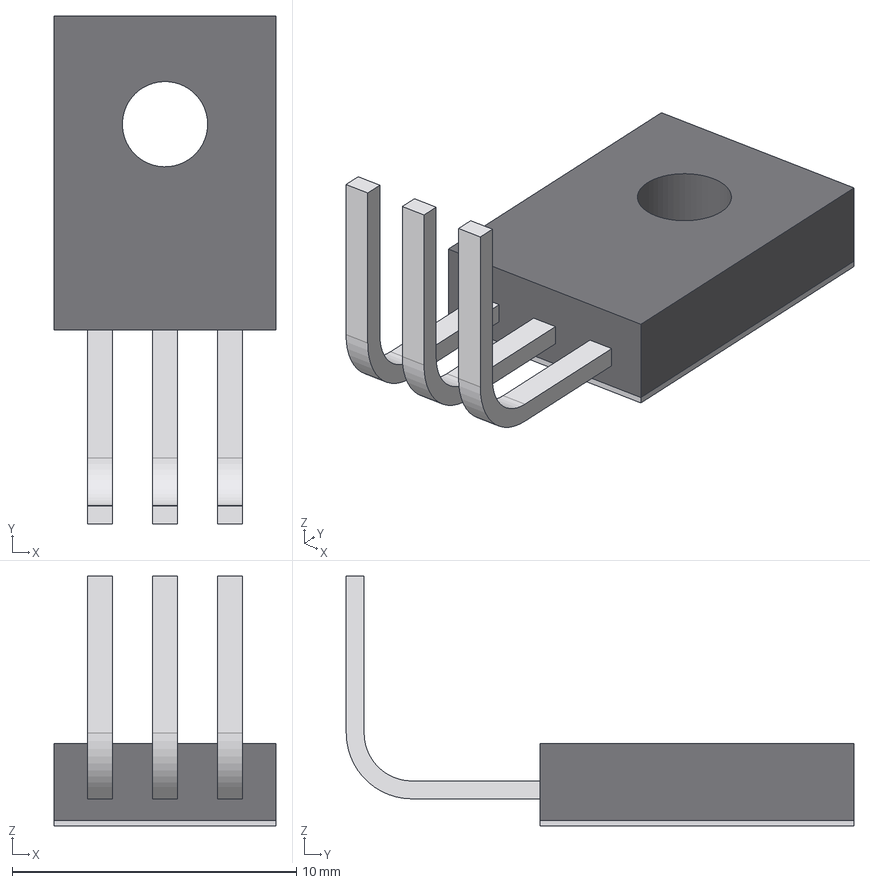
[picture p55: CAD file, 2026-10-21]
hardware/2m/review/M5B-E6R2/development/pre-flat-pin-correction/Q402_CommonPlane_E6R2.step
7.80 x 17.9 x 8.80 mm
Q402_tab
Q402_body
Q402_lead1
Q402_lead2
Q402_lead3
