DD1SB/ARDF-TX/docs/M6_C1_MANUFACTURING.md

# M6-C1 — manufacturing and assembly contract

Order options are ordinary JLCPCB2-layer FR4,1.6mm,1oz, green mask, white legend, lead-free HASL and ordinary unfilled plated through vias. No controlled-impedance service, filled vias, blind vias, custom stackup or factory assembly is required. The controller outline is100×100mm. The native stack metadata uses a nominal FR4 core for visualization/calculation only; it is not a custom factory dielectric specification.

Design policy is0.15mm minimum copper width/spacing, generally0.20mm signal and0.50mm power routes;0.80/0.30mm vias give0.25mm nominal annuli. Preferred copper-edge margin is0.50mm. Green mask webs are≥0.10mm, with0.03mm pad expansion. Finished-hole tolerance is treated as−0.08/+0.13mm and hole position±0.075mm, rather than specifying an exceptional finished-hole process. Consult the generated native-geometry audit for actual minima and any explicit findings. No commercial CAM acceptance or quotation has occurred.

IDC connectors use1.10mm nominal finished holes: expected1.02–1.23mm fits the Würth0.95–1.25mm recommended interval. JST XH straight leads are0.64mm square; a1.10mm hole allows the0.905mm diagonal plus assembly tolerance. JST's drawing explicitly calls its hole dimensions guidelines and permits larger holes for hard board material. The footprint has adequate solder annulus. Verify actual connector identity and first-article fit rather than relying on schematic symbols or distributor preview drawings.

ESP32-WROOM's optional tiny thermal through holes are omitted. Its manufacturer-size SMD ground lands remain, with ground planes and ordinary vias outside the hidden solder land. No guaranteed tenting or solder-filled vias are credited. USB4105 shield lands are enlarged locally to preserve0.25mm nominal annuli; outer land tips are trimmed0.10mm to protect locator-hole clearance without moving any terminal/hole. These deliberate land deviations require first-part fit/fillet inspection. Copper test pads are intentional bodyless features; their geometry is audited, not given decorative component courtyards.

Use a standard stainless stencil and controlled reflow for the RTC, ESP module and fine-pitch logic. Keep paste off the CR1220 holder's central PCB negative contact; inspect cleanliness, spring pressure and HASL contact flatness, then test backup retention. Do not install the primary coin cell before cleaning/reflow. The exact optional Silicontra module identity and land-pattern tolerance remain an explicit population HOLD; leave the entire LoRa group DNP on the first base controller. No primary function depends on LoRa.

Assembly variants and every DNP reference are exported separately. FOX_MIN additionally omits the PACK4 buffer and PA/PWR/pack4 series/pull components (ten positions listed in the population export), physically withholding the normal-PA request path. RTC, source isolation and safe Fox controls remain necessary. Its component saving versus RF80_FULL is modest; the MCU and compensated RTC dominate the base cost. RF2M_FULL omits the RF80 connector/bank; UNIVERSAL fits both banks. DEBUG UART and LoRa are independently optional. The single universal board avoids another controller platform; no simultaneous full-power dual-band requirement is introduced.

The final review directory separates `fabrication/` outputs from analysis artifacts. Regenerate Gerbers/drills from the final native board, inspect layer names and PTH/NPTH division, then run the inventory/checksum command. The package is for independent engineering review only. Upload, quote submission, ordering and manufacture require separate authorization.

Published capability references, retrieved2026-10-18: [JLCPCB capabilities](https://jlcpcb.com/capabilities/pcb-capabilities/), [copper weight](https://jlcpcb.com/help/article/jlcpcb-copper-weight). The versioned JSON profile distinguishes vendor limits, preferred design margins and manual/physical review items.
