DD1SB/ARDF-TX/docs/M5A_R3_BUILD_PLAN.md

# M5A-R3 — one integrated build and acceptance plan

Dated 2026-10-15. **PRIVATE CONSTRUCTION DERIVATIVE / NOT RELEASED. All ARDF-TX hardware tests NOT_RUN.** No orders, PCB fabrication, assembly or transmission. M5A-R1 remains the archived fallback; RF80, M4A, the controller and accepted ADRs are unchanged.

**Build is presently NO_GO.** No PA coupon or repeated transistor-development program is requested. Resolve the short purchasing/package list and independent schematic review first; only then prepare one integrated PCB following the original RF placement. No procurement/layout/fabrication is authorized by this document.

## Before a board can be prepared

1. Confirm one genuine manufacturer-specific BF981/2N4427/MRF237 fleet set and spare stock, with supplier price/quantity/lead time and actual package drawings. An unbranded listing cannot be placed on the ASI pin map. Resolve Neosid00511830 range/core and all five coil outlines; approve original chokes/trimmers or explicitly re-review any change. Do not substitute another PA type.
2. Close the defined OPEN landings, particularly RF power packages, coils/trimmers, TPS611781 RNW and connectors. Preserve private-use attribution and obtain written author permission before commercial distribution. No article is copied into the handoff.
3. Independent reviewer checks the editable [RF2M schematic](../hardware/2m/RF2M.kicad_sch), [PDF](../hardware/2m/review/M5A-R3/RF2M.pdf), physical pin report and source-to-net table. Retain RF placement/ground copper from original Fig3/4; keep switching converter/source apart from final/output and training port. Do not assert the raster is a calibrated CAD board.

## Limited-step commissioning of that one board — all NOT_RUN

| Step | Action and limit | Pass / stop condition |
| --- | --- | --- |
|1 Inspection | Check actual device makers/pins; coil colors/values; TO39 geometry, T4≥10mm stand-off, final-to-ground thermal contact, TIP127 live-tab insulation; continuity/shorts | Every actual lead matches signed pin report; unconfirmed manufacturer STOP |
|2 Low-voltage control | Bounded3.3V bench supply initially100mA limit, PA battery absent. Configure clocks only into fixtures/dummy loads. Exercise reset, missing progress, MUTE, SCL, rawARM, invalid modes, heldARM recovery | Normal/training enables never overlap; no heldARM recovery after fault; RF normal source gate inhibited. Any unexpected state STOP |
|3 Power only | No RF source/final activation. Current-limited6–8.4V for2S population, initially0.1A input then raise only for dummy-load tests;4S only correct assembly. Verify rails on dummy load before RF; no direct pack | Boost10.90/13.81V or buck10.79/13.79V within reviewed tolerance; measure current trip≈0.594A, OV≈15.04V, NTC window/open/short. No oscillatory restart or overshoot exposing parts |
|4 Slot supply sequencing | Scope permit, NORMAL_RC/NORMAL_OFF, VMOD/VPA/current and source. Bound inrush at low energy; inspect470u upstream,1u switched rail and gateRC. Measure shutdown as well as start | RF source starts only after stable rail; clock disables promptly and drain discharges within a bounded interval. Initial engineering shutdown gate≤20ms total, source≤1ms, no unscheduled emission above documented analyzer floor. These are targets, not simulated PASS |
|5 Original RF alignment | One integrated board,50ohm≥10W load. Start reduced rail/current limit; original L4/L5 with≤1pF weak RF probe, then L6/C19, then L7/C23/L8. Do not confuse fixed C20 with C23 trimmer. Initial tuning pulses≤2s with cooling; no unattended carrier | Desired doubled RF, adequate drive and no self-oscillation. Do not exceed approved current/temperature. If source adaptation cannot drive retained chain, STOP for the smallest reviewed correction; do not start a separate PA redesign |
|6 Carrier and AM calibration | Set both PWM offsets equal, KEY initially0; set VR2 from RF carrier. Increase sine from small depth; use RF detector/oscilloscope at calibrated connector. Calibrate full/reduced converter and AF amplitude profiles |70–80% depth, nominal75%;≤5% engineering envelope THD; sidebands within1dB engineering symmetry; no clipping/strong AM-to-PM impairment. Expected ERP includes measured antenna/feed and uncertainty. Full target capability5.135W connectorPEP at m=.8 sizing basis, not claimed from original3W lower bound. If missing, do not silently lower target |
|7 Spectrum/thermal/faults | All required frequencies, both supply endpoints/profiles, carrier-only and sineAM; long active slot and continuous-beacon special case. Controlled mismatch/low-energy faults only; no destructive pack faults | Legal national unwanted-emission mask, <50ppm stability, output belowERP ceiling with uncertainty; safe maker-specific junction/SOA/case limits and66C sensor response. Inhibit/reset/lease/bus faults must remove both source and supply and require a fresh ARM |
|8 Training and final installation | Normal PA off/DNP; calibrate separateMCX1uW nominal, optional1–10uW fixed-pad variants. Exercise normal PA while observing isolated training port on one complete board. Horizontal omnidirectional antenna at2–3m | No electrical watt-path transfer, bounded off/normal-to-training coupling; initial isolation goal≥60dB and no damaging leaked power. Finite sensitivity/noise floor documented. Field range as separately agreed; no invented IARU2mtraining distance |
|9 Endurance and records | Log actual power, currents, temperatures, cell voltage/cutoff and modulation over12h full/24h reduced at20% scheduled duty; run continuous beacon separately | Both RF settings remain compliant for required duration under defined cell/temperature conditions. One serial-numbered end-to-end record per transmitter; modeled hours do not pass this test |

## Necessary shared instruments

Current-limited adjustable laboratory supply; calibrated50ohm≥10W dummy load; VHF power meter plus calibrated RF detector/oscilloscope or a power instrument that measures PEP; spectrum analyzer with suitable attenuation/protection; counter/reference; low-capacitance RF probe; DMM/current and temperature logging. VNA is useful to resolve a failed output/input alignment, not a separate mandatory development board. Use a rated low-capacitance probe for final collector peaks: probe capacitance itself alters VHF tuning. Exact instrument frequency/accuracy/noise floors must be recorded.

One full commissioning process may be performed by an experienced amateur-radio technician. Batch units then use the same recorded reference settings plus per-unit carrier/depth, spectrum, quiet/fault and thermal acceptance. Assembly/calibration labor remains unmeasured; it cannot be booked as savings. Unrestricted field use, continuous beacon operation and Li-ion pack activation require the prior safety/RF gates to pass and separate user authorization.
