DD1SB/ARDF-TX/hardware/controller/review/M6-L2/FABRICATION-INSTRUCTIONS.txt

ARDF-TX controller M6-L2 — controlled bare evaluation candidate
Quantity: five bare PCBs. No assembly or component procurement.
100 x 100 mm; 2 copper layers; standard FR4; 1.6 mm; 1 oz.
Green solder mask; white legend; lead-free HASL.
Separate plated and non-plated Excellon drill files.
Ordinary unfilled through-vias: no blind/micro/filled via or special stackup.
Component PTH and optional headers are soldered conventionally.
The separate full-top stencil export includes optional top SMD lands.
Check the revision decision, CAD/DFM results and SHA-256 inventory first.
Independent review remains required. This local archive is not an order,
an acceptance tag, production release or authorization to upload/order.
