DD1SB/ARDF-TX/hardware/2m/review/M5B-E4R1/MANUFACTURING.md

# E4R1 standard fabrication dataset

Review only:5bareboards,180×140 mm,2layerstandardFR4,1.6 mm,1oz, green/white, lead-freeHASL, ordinaryPTHvias, no impedancecontrol/customstackup/fill/cap/plug/assembly service. SeparatePTH/NPTHdrills and physical-nettieE-test accompany9Gerbers. Do not include development analysis or stencil artwork in the bare-PCBZIP. No supplierCAMorquotehasoccurred. See docs/M5B_E4R1_MANUFACTURING.md for exact assembly, thermalcontact and first-jointqualification requirements. Source-onlystencil0.12 mm is a separate ordinary accessory, not a premium PCBprocess.
