DD1SB/ARDF-TX/hardware/80m/production/review/M4A-V1R1/manufacturing-notes.md

# RF80-V1R1 — five individual bare boards

Order configuration: standard two-layer FR4,150×110mm,1.6mm,1oz,green mask,white legend,lead-free HASL,ordinary PTH,quantity5. No press-fit precision, special drilling, controlled impedance, custom stackup, via filling or panelization. **No upload/order authorized.**

Use only `fabrication/RF80-V1R1_JLCPCB_5boards.zip`. Nine Gerber layers plus separate PTH/NPTH. Keep drill maps, job data and reports outside the manufacturing ZIP. Factory must route the closed150×110mm Edge.Cuts centreline; do not add its plottingstroke to finishedsize.

Component finished holes ordinary−0.08/+0.13mm. J101/Q402/Q4031.4mm,J502/J4011.3mm,J3011.9mm. Vias0.6/0.3mm retained; their finished diameters are not component-fit guarantees. Maskweb0.10mm/expansion0.025mm. Details: [profile](JLCPCB-standard-profile.json), [nativeDFM](JLCPCB-DFM.json), [holes](finished-hole-audit.json).

After independent review and explicit upload approval, verify standard order settings, recognizeddimensions/layers, separatedPTH/NPTH, no premium precision service, ordinaryHASL and quote/CAM result. Nothing submitted yet. No individually negotiated process is required. Final incoming-hole/lead-fit and solderability inspection is required before soldering. Full andFox builds share identical barePCB; use population.csv, not fullrender, forFox-onlyDNP.
