DD1SB/ARDF-TX/hardware/80m/handoff/M4A-E2/reference-package/manufacturing-notes.md

# RF80 M3B-E2 — manufacturing/assembly review notes

Date: **2026-10-15**. Review data only; do not transmit to a manufacturer or place an order without explicit user authorization and independent review. This document does not authorize soldering or power-up.

- Profile centerline **210.00×160.00mm**,2copper layers,FR4 nominal1.60mm,35µm outer copper. The Gerber job's210.05×160.05mm bounding box includes the0.05mm profile stroke; manufacture to the edge centerline. No controlled-impedance/blind/buried/microvia requirement.
- Minimum copper width/spacing0.15/0.15mm; drain spacing0.60mm; copper-edge0.50mm. Ordinary0.60/0.30mm vias, tented. Global mask expansion0.025mm, minimum web0.075mm. Confirm supplier capability, registration/annular-ring allowances and economical solderable finish; CAD finish is unspecified, not a request for unsolderable bare copper.
- **372PTH**, including329vias; **4NPTH3.20mm**. Keep NPTH unplated. Finished-hole requirements: J101 **1.20±0.05mm**, J502 **0.95±0.05mm**; Q402/Q403 **1.30±0.05mm**, require≥1.25mm and incoming lead dry-fit. Do not accept an ordinary±0.10mm connector tolerance without a reviewed landing change. PCB nominal hole values must be treated consistently with finished-hole compensation.
- Q403 **ST BD140 only**, SOT32: **1B→SHAPE_BASE,2C→VPA_SHAPED,3E→VPA_LOAD**. Installed ST illustrated face toward **PCB+Y/bottom edge**; top view west3E/middle2C/east1B. Gold stripe in the own model marks that face only. Do not infer the actual device's orientation from another vendor's BD140 label. Form2.28mm pitch without body stress; body stand-off2mm. Own model is an envelope, not a drilling template or qualified heatsink drawing.
- U311 **TI TL431AIDBZR/DBZ**:1K+2REF→VREF_2V5,3A→GND. Do not substitute TL432 or another package pinout. Verify1:1 footprint orientation/diode bands/IC pin1 before soldering.
- Q402 **Vishay IRF610**:1G2D3S/tabD. Heatsink and thermocouple electrically insulated where needed; verify sink/bolt/washer/body clearances. BD140/PA hot SOA and actual cooling are not qualified. Bond/insulate remote NTC and provide strain relief; detached intact sensor is a separate mechanical hazard.
- T401 FT-50A-43 retains9+9turnAWG24 same-sense bifilar, Astart1(dot),Afinish2,Bstart3(dot),Bfinish4;2+3drain. Original L410/L411 T60-2,20turnAWG24, orthogonal mounting, original elliptic filter values. Wind/phase/measure/dry-fit before power; stabilize without conductive clamps near RF nodes. Own winding envelopes include allowance but do not prove parasitics or winding quality.
- All purchased parts mount on top except the remote NTC; bottom has tracks/vias/protruding THT leads, no fitted SMD population. Bottom assembly view includes mask openings to locate holes. Fit ≥10mm insulating bench standoffs, trim leads, keep exposed drain/collector and probes away from conductive supports.
- **195 rows** in full placement CSV; remote purchased NTC is not a pick-and-place footprint. Optional/DNP features/test pads are omitted. Use population-map.csv and BOM for actual full/Fox populations, not a placement file as a purchase list. Fox-only omits all NORMAL parts and fits its population links. No expensive test connectors are required by the probe pads.
- First tests after separate authorization use isolated current-limited lab supplies. **U401/Q402 absent until bounded input/driver fault gates pass**. No unrestricted4S battery, wrong positive-voltage supply, direct24/28V injection or destructive Li-ion fault test. Follow E2 Stage0 pin corrections and power restrictions.

All footprints/models are CAD artifacts; independent assembly/mechanical review and incoming dimensional inspection remain necessary. [Full footprint audit](../../../../docs/M3B_E2_FOOTPRINT_AUDIT.md), [power gates](../../../../docs/M3B_E2_POWER_PROTECTION.md), [mechanical drill/model data](mechanical-stackup.json). The material/fabrication quote is pending, not a released manufacturing basket.
