DD1SB/ARDF-TX/hardware/2m/review/M5B-E3/MANUFACTURING.md

# Proposed standard web-order configuration

Select **5 individual PCBs, 180 × 140 mm, 2 layers, standard FR4, 1.6 mm, 1 oz, green mask, white legend and lead-free HASL**. Use ordinary through-vias and standard electrical test. Assembly is manual and staged.

No controlled impedance, custom core, filled/capped/plugged vias, special laminate, edge plating or factory assembly is requested. Do not substitute 2 oz or historical E2 fabrication files. The 1.50 mm dielectric / Dk 4.5 record is an analytical model, not a separately negotiated purchase tolerance.

After explicit authorization, the proposed upload file is `RF2M-M5B-E3-fabrication-review.zip`: nine Gerbers and separate PTH/NPTH drills. Job metadata, drill maps, source CAD, IPC references and analysis are deliberately outside that ZIP. Standard factory electrical test derives physical connectivity from the copper; keep the physical IPC/alias report as an independent reference.

Check SHA-256 inventory and ordinary automated checkout options/price before any order. No RF copper resizing is authorized. HASL planarity, ordinary mask tenting, connector fit and hidden solder joints require incoming/assembly inspection. Tenting is not plugging or insulation. No quotation, factory CAM acceptance, upload or order has occurred.
