DD1SB/ARDF-TX/hardware/2m/review/M5B-E1/MANUFACTURING.md

# RF2M M5B-E1 review-only manufacturing notes

NOT AN ORDER / NOT A PRODUCTION RELEASE. Use final-native files and checksums; do not reuse R4 exports. One integrated two-layer180×140mm board. Proposed0.8mm finished,0.64mm FR4 dielectric,70µm copper each side,ENIG,mask both sides. No blind/buried vias or impedance premium is assumed. Confirm Dk/tolerance,2oz0.15mm features,0.3mm PTH with0.15mm annular rings and0.1mm mask webs. Copper-edge≥0.5mm;NPTH mounts3.2mm. Finished holes:IDC1.1mm,SMA center1.5mm/ground1.7mm;confirm manufacturer drawings and hole tolerance±0.1mm candidate. See drill report for all exact sizes. Dimensions are millimeters.

Review GerberX2 layers/drills and outline as one matched set. The B.Mask thermal window exposes GND with two mask strips retained over source-via columns. Do not remove these tents or merge RNW center pads. Source stencil is a proposal;100µm initial stencil and segmented apertures need assembler review. No via-fill premium assumed. Do not resize RF traces or shorten TL603–609. Confirm intentional net ties against fabrication-net-aliases.json and use RF2M-physical-netties.ipc for E-test; RF2M-logical.ipc retains schematic nets and will otherwise report intentional ties as shorts.

Independent CAM must close the visible unlocated F.Cu sliver warning before an order. Eleven courtyard warnings are non-component TL/probe features. All other manufacturing/connectivity checks remain enabled; no DRC exclusion is present. Do not silently apply CAM edits to RF, thermal or safety nets. Request a real five-board quote;€60–100net/batch plus shipping is an estimate only. Procurement, assembly, controlled power-up and RF activation each need separate authorization.
