DD1SB/ARDF-TX/hardware/controller/review/M6-L2/assembly-3D-BOTH-top.png

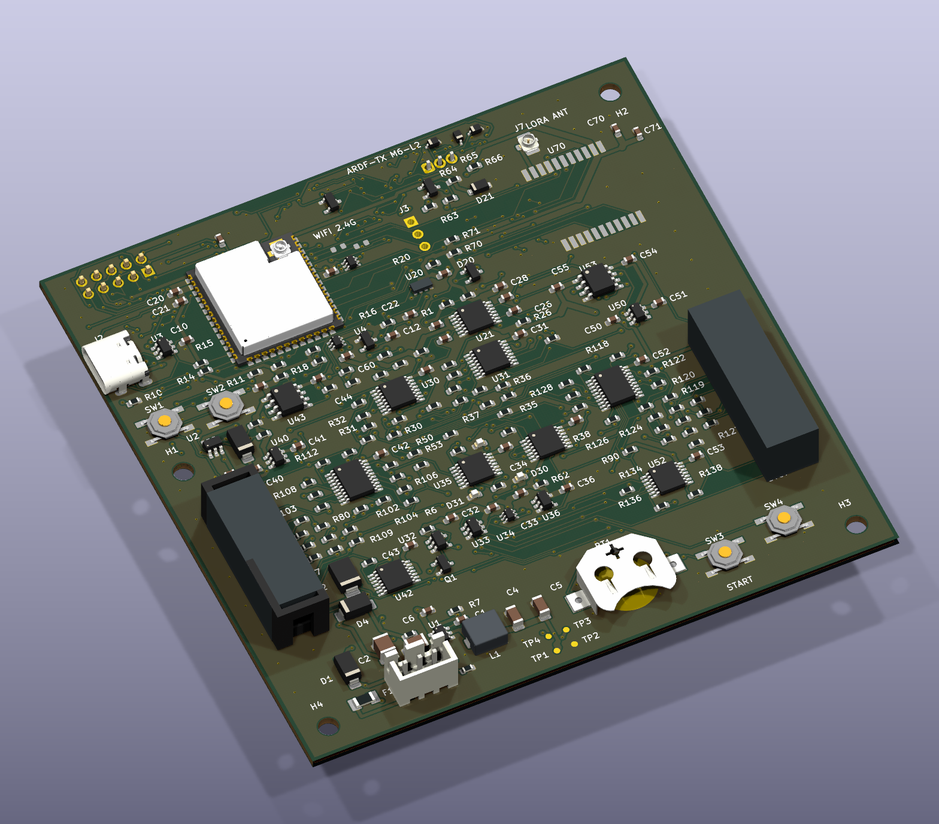
hardware/controller/review/M6-L2/assembly-3D-BOTH-top.png
