DD1SB/ARDF-TX/docs/M5B_E3_BRINGUP.md

# M5B-E3 single-board bring-up considerations

All entries in `review/M5B-E3/acceptance-register.csv` begin **NOT_RUN**. No assembly or power-up is authorized by this CAD milestone. Preserve the detailed [E1 procedure](M5B_E1_BRINGUP.md) and [E2 sequence](M5B_E2_BRINGUP.md), with the E3 changes below. Use one integrated transmitter and one acceptance record; no separate RF coupons.

1. **Unpowered inspection.** Confirm the exact E3 revision,1.6 mm board and standard1 oz construction, connector holes/identity/polarity, all manufacturer-specific pins, mutually exclusive2S/4S links andTRAIN_ONLYDNP population. Inspect HASL planarity, source mask caps and hidden-pad reflow. Inspect source and RNW joints with suitable magnification and hidden-joint inspection/rework capability. Do not mistake tenting for filled vias. Verify spreader/TIM insulation, its separate GND strap, live pass/helper tabs and adjusted1.6 mm clamping stack. No board bending or conductive sink bridge is acceptable.
2. **Logic only.** Initially omit normal converters, MMIC and final. Apply3.3 V with 100 mA current limit, increasing only after explaining consumption. Verify reset, watchdog, captured ARM/path/profile, key-inactive arming, retuning inhibit, mutually exclusive ports and deliberate rearm. Both physical outputs must remain inactive outside permission. Use only bounded logic fixtures; Boolean tests do not qualify asynchronous pulse widths.
3. **Power only.** Fit exactly one converter population. Start with a current-limited lab input:2Svariant6.0 V/100 mA or4Svariant12.0 V/100 mA; raise current in documented steps with dummy loads. Confirm pack window and 9.02 V/full orselected reduced rail. KeepR952 open and driver/final absent until driver preregulation,5 V regulation and shutdown pass. Sweep normal input6–8.4 or12–16.8 V as applicable. Do not connect wrong-pack voltage as a trial. Test specified faults with bounded current/energy, not a Li-ion pack.
4. **Driver-supply qualification.** Retain E1's two regulators and 18 V-ratedTPS22810. Verify normal approximately 4.8–5.2 V and the defined fault acceptance≤5.7 V before fittingPHA. A bounded16.8 V upstreamfault can exceedTLV767's16 V recommended input while below18 V absolute maximum; this is a fault test, not normal operation or surge immunity. Measure isolation/inhibit timing and repetition. No sole20 µsRC guarantee is assumed.
5. **AM/dummy load.** Test D45H11/BD139 with bounded representative load and proper insulated sinks. Verify sine reconstruction, feedback sign/stability,7.2/4.0/0.8 V starting crest/center/trough and shutdown. These voltages do not establish RF modulation depth. Record crest droop and power-path temperature on 35 µm copper. Limit pass case 60°C and engineering junction 125°C; verify the approximately 66°C sensor trip/lag. Never raise the trip to overcome insufficient cooling.
6. **Normal RF.** Fit the verified RF parts, connect an adequately rated50 Ω load, attenuator/coupler and analyzer. Start with the 10 dB source pad, low bias and low PA supply/current. Use the retained C631/C633/L634 adjustment set only when needed. Measure source/driver level/compression, frequency/stability, carrier power, averageRF, PEP, true 70–80% RF sine AM, sidebands, harmonics and spurs. New microstrip/taper/FR4 behavior requires end-to-end alignment; no manufacturer2-stage power claim proves the derivative. Record off-slot silence and controlled fault withdrawal. Derive PA heat conservatively from averageV(t)I(t)+driveRF−connectorRF. Start below1 W heat; increase in steps only while case/junction estimates remain bounded. Qualify the E3 heat path up to its≤4 W initial budget; at 40°C ambient require inferredTj≤125°C and adequate margin. Stop on excessive heat, drift, instability or poor joints.
7. **Training/isolation.** Normal converter/PA remain absent inTRAIN_ONLY. Verify independentµW output, modulation, calibration, silence and measured normal-to-training isolation. Never infer isolation from separate schematic nets alone.
8. **Operational acceptance.** Verify permitted training frequencies and championship144.500–144.900 MHz configuration, slot timing, watchdog/fault/rearm and both power profiles. ERP calibration must include actual antenna/feed gain and uncertainty. At−1 dBd,1 W carrier ERP needs1.259 Wconductedcarrier and 4.079 WconnectorPEP at 80%AM; these are calculations, not outputs achieved. Assess12 hfull/24 hreduced competition duty separately from continuous beacons. Record RF/thermal/endurance results before any operational release.

Required shared instruments remain a current-limited supply, calibrated RF power/PEP measurement,50 Ω load, spectrum analyzer, oscilloscope/envelope detector, appropriate attenuation/probes and temperature/current logging. A VNA is useful for the bounded alignment if required. Ordinary passive probes can detune exposed RF contacts; prefer calibrated pickup or output-coupler measurements. Hardware qualification and antenna/field tests remain NOT_RUN.
