DD1SB/ARDF-TX/docs/M5A_R4_BUILD_AND_TEST.md

# M5A-R4 — one complete-device build and acceptance

Dated **2026-10-16**. **M5A-R4 electrical candidate — NOT RELEASED.**
All physical tests are **NOT_RUN**. No purchasing, fabrication, assembly or RF operation has occurred.
RF80, M4A and accepted ADRs are unchanged. R3 is preserved at tag `m5a-r3`
(`daf994c`); R0/R1 tags and the R1 native archive remain available.

The next physical implementation is **one integrated transmitter**, not separate coupons. Close the input-network and package holds, review the complete PCB, then obtain manufacturing authorization. This future procedure does not authorize construction or RF operation.

Shared equipment: bounded current-limited DC supply; 50 Ω dummy load rated ≥10 W; calibrated CW/PEP meter or RF envelope detector/scope; spectrum analyzer and suitable attenuation; VNA for limited input/filter alignment; current and temperature logging. An RF generator may inject an existing integrated driver test node. Protect instruments from watt-level RF and drain-node DC. Record exact MPNs, serial, variant, calibration, ambient, pack, antenna/feed and uncertainty.

1. **Inspect unpowered.** Confirm gate-left/drain-right/center-source orientation, source soldering, ST pass/helper pinouts and live tabs. Verify exclusive converter population, pack ID/UV settings, DNPs and independent connectors. Check no normal-to-training conductive RF connection. Inspect sink insulation and thermistor attachment. Never install a generic unverified final footprint.
2. **Commission 3.3 V.** Disconnect the PA pack. Start at 3.30 V with 100 mA limit and raise only after demand is explained; the ≤150 mA header budget is not measured. Configure clocks into bounded loads. Check fresh ARM with KEY/SLOT low, heartbeat expiry, reset, I²C activity/stuck levels, held-ARM recovery, invalid requests and captured selections. Fault/reset must remove both permits. Scope clear, clock/OE and driver timing; Boolean tests do not prove it.
3. **Check supply and AM using temporary loads on the same board.** Ground bias trim and inhibit RF. Start 2S at 6 V or 4S at 12 V with 100 mA limit and no final conduction. Verify 9.02 V boost or 9.00/7.51 V buck, initially ±3%. Increase to 0.5 A only for explained bounded loads. Precharge the reservoir before ARM; measure inrush, 5 V stability and reduced-rail dropout. Calibrate current/OV trips. Observe pass center/crest/trough and ringing into a temporary resistive load. No unrestricted pack.
4. **Align normal RF at low energy.** Connect dummy load and protected meters. Enable the driver only after rail qualification; start low source drive. Establish gate Idq from 50 mA; exceeding 200 mA requires thermal justification. Begin with low drain command and ≤0.5 A PSU limit. Increase only as demand is explained; never bypass the nominal 1.8 A trip. Adjust documented input-network positions in one integrated alignment. If gain/backoff cannot be met with a small documented change, stop instead of silently adding a premium chain.
5. **Calibrate carrier/AM.** Measure carrier, PEP and envelope at 144.5/144.7/144.9 MHz and battery endpoints. Establish final gain and ≥3 dB driver backoff. Nominal depth 75%, acceptance 70–80%; initial engineering limits are THD ≤5%, sideband asymmetry ≤1 dB and no clipping. PEP must agree with carrier ×(1+m)² within uncertainty. Measured antenna/feed gain must yield ERP upper bound ≤1 W, reduced lower bound ≥0.25 W. Do not label full power until near-upper performance is demonstrated. Frequency error must stay better than 50 ppm over the temperature/aging budget.
6. **Run one spectrum, shutdown, training and thermal acceptance.** Apply the national emission mask; initially screen harmonics at ≤−60 dBc as an engineering target, not an IARU legal limit. Inspect fractional/PWM products. Exercise SLOT, MUTE, reset, heartbeat loss, I²C and bounded analog faults. Held ARM must not recover. Record off-slot output floor and RBW; initial internal goals normal ≤−70 dBm/training ≤−90 dBm are not literal zero-RF proof. Calibrate training to nominal 1 µW carrier (−30 dBm), declared tolerance and 70–80% AM with the PA/converter off. Measure maximum normal-to-training leakage and bounded-fault isolation. Require no damaging power or uncommanded output. Run 60 s on/240 s off at worst ambient: case ≤60°C, estimated junction ≤125°C, no ordinary thermal trip. Continuous beacons have separate limits.
7. **Qualify bounded faults/endurance.** Initially disconnect the RF driver when injecting representative converter/LDO faults at existing nodes. Require isolation ≤20 µs from worst threshold crossing, driver ≤5.9 V and no reverse/backpower. Qualify input hot-plug before unrestricted 4S use; never short a pack to test the fuse. Measure current and sensor open/short response, RF/drain withdrawal and real 12 h full/24 h reduced profiles under stated cell, aging, temperature and LoRa conditions. Replace assumed currents/efficiencies before selecting fleet packs.

Every hardware test is **NOT_RUN**. A failed envelope, drive, thermal or off-state test blocks replication. The first complete unit may require a recorded correction; original ST fixed-supply results do not validate this derivative. After acceptance, freeze actual alignment values, traces, tolerances and test minutes for repeatable fleet assembly.
