DD1SB/ARDF-TX/docs/M5A_R1_PA_TEST_PLAN.md

# M5A-R1 — smallest decisive PA/AM coupon

Date: **2026-10-15**. **M5A-R1 electrical evaluation candidate — NOT RELEASED. All physical tests NOT_RUN.**

**No PCB is laid out or authorized for fabrication.** The coupon layout is currently NO-GO until readable original ST circuit/package drawings close the named topology/pad/land blockers. Thereafter a small standalone PA coupon, not the integrated transmitter PCB, is the next useful engineering step. Its purpose is to settle final-stage gain, drain-to-RF transfer, stability and crest capability. It may omit the controller/source/watchdog because laboratory enable/current limits control this isolated fixture; the integrated R1 schematic retains full-system interlocks.

## Coupon scope and interfaces

- One PD54008L-E, exact verified Power FLAT land and source thermal contact, removable/tunable 144 MHz input and output matches, gate stopper/bias isolation, output LPF and 50 Ω SMA reference port. Original ST final/output topology must first be traced; do not manufacture the OPEN assumed-impedance harness.
- Separate 50 Ω drive input for a laboratory generator. The PHA-1+ driver may be evaluated on a removable adjoining fixture later; no need to populate both complete alternative MMICs. Keep a calibrated interstage measurement plane and DC block. Integrated board test injection uses C602 omitted and TP604/PA_IN50; never connect a source across an active MMIC output.
- Independent adjustable gate bias with default ground, measurable drain current and separate bounded drain supply. External modulated supply can characterize AM before D45H11/BD139 or a battery converter is fitted. Start gate trim grounded; constrain VGS from−0.5to+15 V, and use a much lower conservative practical drive/bias limit.
- Target the original 0.508 mm FR4/70 µm construction, supplier-declared dielectric/mask. Recalculate every changed microstrip width/length/launch. No0.92 mm trace copied to 1.6 mm FR4. RF ground/vias, exposed source land, thermal attachment and tunable-value pads must be reviewed before routing approval.
- Kelvin DC current connection, drain RF choke/bypass arrangement verified for AM bandwidth, removable load/filter links, thermocouple attachment and short RF probe ground. No large capacitor on the modulated drain. External lab enclosure/attenuation prevents unintended radiation.

## Shared instruments

Current-limited 0–12 V lab supply with bounded overshoot, gate-bias supply, RF generator with calibrated output (external laboratory booster if more drive is needed), VNA with bias isolation, spectrum analyzer through rated 40–60 dB attenuation, calibrated≥10W50Ω dummy load, carrier/PEP power meter, oscilloscope with RF envelope detector, active RF probes≤0.5 pF where needed and appropriate differential voltage probes and current/temperature logging. Use a calibrated directional coupler for mismatch/reflected power. Account for load/filter/cable loss and detector response. Bench connections are conducted into loads; no antenna/RF transmission authorization is implied.

## Staged gates — all NOT_RUN

| Stage | Bounded method | Objective pass/stop criteria |
| --- | --- | --- |
| 0Package/continuity | Microscope, meter; verify exact installed marking/orientation and source thermal land | Exact physical G/D/S assignment agrees with audited symbol/PCB. Any unknown land is STOP. |
| 1Bias only | RF input terminated; drain 1 V/current limit 50 mA, bias 0 V; increase drain toward 4 V in small steps with≤100 mA initial limit | No unexpected current/oscillation; then set proposed Idq 50 mA and investigate 100–200 mA only intentionally. Never turn the trim while unrestricted. |
| 2S mall-signal/stability | Low drive, drain 2/4/6/7.2 V, selected biases; VNA/calibrated gain plus wideband spectrum | Measured match/gain repeatable across 144.5–144.9 MHz; no autonomous oscillation over 50 MHz–1 GHz initially, extend analyzer range for harmonics.50 Ω stability alone does not qualify mismatch. |
| 3CW map | Start−20 dBm input, increase stepwise with output load; drain bounded≤7.5 V initially and current≤1.8 A | Map connector power/gain/current/compression versus voltage. Demonstrate 4.079 W operational crest and investigate 5.135 W connector capability; stop if gain/temperature/current precludes it. Final plane must cover measured filter loss. |
| 4Driver | Independently measure PHA-1+ gain/P1dB at 4.8/5.0/5.2 V and hot/cold conditions | At actual required final drive, ≥3 dB backoff including 1.25 dB input-loss budget/uncertainty. At 20 dB final gain this needs P1dB≥22.11 dBm at the capability test. If failed, retain stronger driver/fallback basket; do not call a cheap MMIC adequate. |
| 5Drain transfer | Fixed drive/bias; slow sweep≈0.5–7.5 V, monitor gate/drain currents and output amplitude/phase | Reproducible monotonic usable transfer; map RF knee, trough leakage and AM-to-PM. Record changing input/output match. No irreversible current, oscillation or hysteresis. |
| 6Low AM | External bounded supply, initially 10%, then 30% RF depth at 800Hz | No envelope clipping, unstable sidebands or bias runaway. Calibrate from RF amplitude, not supply percentage. |
| 7Full AM | Calibrated 75% target, prove 70–80% across band/profile/supply/temperature; then integrate pass loop | RF-envelope THD≤5%, sidebands symmetric≤1 dB initially; maintain carrier/crest capability. Reject if an inverse command cannot produce a sine safely or if trough behavior is unstable. |
| 8Carrier/PEP/ERP | Calibrated carrier, true PEP detector/coupler; actual antenna/feeder measured separately |1.259 W connector carrier corresponds to 1 ERP only under unqualified−1 dBd assumption. Guard event setting below 1 ERP and reduced setting above 0.25ERP including uncertainty. |
| 9Thermal/SOA | Log 1 min on/4 min off, carrier-only and 80% AM at 45 °C intended ambient; energy-limited soak | Case/sensor≤60 °C normal target, estimated Tj≤125 °C, no hot DC/repetitive SOA violation; verify 66 °C sensor trip with mounting delay. No continuous beacon approval from contest test. |
| 10Spectrum | Source, driver and output analyzer measurements; safe attenuators | Applicable country unwanted-emission mask plus project headroom; no imported ST−70 dBc claim. Initial harmonic target≤−60 dBc and no anomalous out-of-band oscillation, revise only to justified stricter legal/project mask. |
| 11Faults/shutdown | Dummy-load rail, MMIC/PA omitted first; bounded LDO-short and converter fault fixtures | Driver≤5.9 V until physical Q304 isolation≤20 µs under defined 10.5 V fixture; no VGS breach, pass short caught, thermal/current/window trip clears ARM. Fault recovery requires deliberate rearm. |
| 12Integrated isolation | Normal output loaded; training port terminated/detected, both directions and off-slot cases | No simultaneous permission; off-slot/inhibited connector output initially≤−60 dBc relative to active carrier and≤1 µW absolute. These are engineering detection gates, not a definition of legal silence. If coupling fails, investigate shielding/layout before release. |

Mismatch testing starts at low voltage/power with a tunable load and reflected-power monitoring, never the original board's claimed 20:1 test applied blindly. Establish a conservative 2:1 all-phase survival gate first; severe/open/short cases require a separate bounded plan. No unrestricted Li-ion fault injection. Check source waveform, local bias/decoupling and switcher spur interaction before connecting the synthesized chain. Training retains calibrated nominal 1 µW/optional 1–10 µW output and true keyed-tone AM; calibrate at its own reference connector.

## Decisive outcome

Accept the economical chain only if the same configuration simultaneously closes gain/backoff, connector carrier/PEP, full 70–80% RF sine AM, spectral, thermal and supply gates. If required gain is too low, use the stronger driver basket and recompute heat/endurance. If the low-voltage final cannot provide the RF envelope or crest safely, return to preserved R0; do not lower the competition requirement to save money. Document raw instrument files, calibration planes, firmware/generator settings, temperature and uncertainty. No test is PASS until actual data exists.

Thermal instruments must have insulated junctions or appropriate isolation: D45H11 and BD139 exposed collectors are different live nets. Never infer PA junction temperature from plastic-top temperature using a source-land RθJC without the actual package heat-flow definition. Use de-embedded couplers at50Ω ports; an ordinary10pF probe can substantially change144MHz matching. A separateDC-coupled modulation amplifier/supply must provide the proposed0–8V envelope at≥2A with sufficient audio bandwidth (initially≥20kHz) and bounded current; an ordinary bench supply is not assumed to follow800Hz. Use insulated thermocouple junctions/isolated logging on live tabs.
