DD1SB/ARDF-TX/docs/M5_2M_TEST_PLAN.md

# M5A staged 2 m evaluation gates

Date: **2026-10-15**. **All physical tests NOT_RUN.** This is a future laboratory procedure after separate approval, not authorization to assemble, energize or transmit. Use the actual RF2M schematic/BOM variants and record instruments, calibration, reference planes, ambient/case temperature, supply limits and raw data. Initial work needs one source/driver/PA assembly, not6–20 transmitters.

## Shared equipment and reference planes

Current-limited3.3 V and adjustable6–17 V laboratory supplies; energy-limited pulse/fault fixture; calibrated RF generator plus a qualified≥+25 dBm temporary driver for standalone PA tests; VNA with DC blocks/bias-safe fixtures; spectrum analyzer covering at least1 GHz; calibrated mean/PEP or envelope measurement;10 W or greater50 Ω dummy load;40 dB protection attenuation with the first section rated for full continuous input; oscilloscope suitable for144 MHz waveforms (approximately500 MHz preferred), differential/low-inductance probes, RF envelope detector, DMM/current logging and independent thermocouples. A low-bandwidth scope/envelope detector can measure AM but cannot qualify the RF gate/drain waveform.

Do not connect the normal PA directly to an analyzer. At5.14 W PEP,40 dB attenuation leaves approximately−2.9 dBm; verify the actual chain's power, peak and DC ratings. De-embed pads, detector, cables and filter loss. Training uses its own calibratedµW-sensitive50 Ω plane; avoid analyzer noise-floor claims without a calibrated source/substitution method.

| Gate | Assembly and bounded stimulus | Objective acceptance / stop condition | Status |
| --- | --- | --- | --- |
| G0 package/inspection | Exact MPN pinouts, RF landing/thermal pad, fuse, shunt, magnetics, mating connectors | No OPEN critical footprint or pulse/current rating; independent review of physical orientation. No assembly based on generic pin count. | NOT_RUN |
| G1 low-voltage logic | Only3.3 V source/logic; start50 mA limit, raise to150 mA after shorts absent; no raw PA supply | Reset default off; valid ARM only with PREPARE and KEY/SLOT low; settled measured ARM delay covers captured-output settling; no false permission on clear release/brownout. | NOT_RUN |
| G2 lease/config/fault state | Inject progress0–100 ms intervals, then loss; SCL pulses/stuck levels; mute; reset with ARM high; conflicting/live path/profile changes | Missing progress disables both paths within250 ms including physical withdrawal. Any SCL low destroys ARM; health recovery while ARM high never rearms. KEY pause leaves intentional in-slot carrier. Capture must not transfer live RF paths. | NOT_RUN |
| G3 converter dummy load | PA/MMIC omitted. Test correct2S or4S population; begin6.5 V2S or12.5 V4S at100 mA input limit with outputs lightly loaded; then increase limits under load |10 V/13.5 V profile rails within agreed±3% target, no excessive startup/feedback-switch overshoot; actual raw UV/OV thresholds and4S full dropout documented. Input FET off for wrong pack; verify PA_RAIL_ADC accuracy and refusal to assert SLOT on missing/low converter rail. Boost compensation/current limit stable with chosen effective L/C. | NOT_RUN |
| G4 driver-fault fixture | MMIC omitted;33 Ω/5 W dummy at driver plane. Bounded step up to14.5 V through actual2.2 Ω/≥80 µF network; initial pulses≤100 µs, energy and peak current limited by fixture | Driver plane remains≤9.5 V, hard trip/disconnect including Q304≤20 µs, no parasitic spike approaching10 V absolute maximum. Verify capacitor ESR≤0.2 Ω and resistor pulse rating; measure PACK_RUN/RAIL_RUN and actual gate decay under the relevant fault. Fail means NO-GO for driver connection. | NOT_RUN |
| G5 AF/series modulator | RF final absent; use a bounded electronic/RF-equivalent load, startVMOD≤6 V and0.2 A; qualify current/thermal control before13.5 V and approximately1 A envelope peaks | Stable load/command steps and sine response with no sustained oscillation; no stored-command burst; correct no-tone baseline; supply feedback/command clipping documented. ≤5% engineering envelopeTHD,70–80% nominal depth after calibration. SOA trajectory/hot case acceptable. Inject the VPA sense threshold using a bounded source with the pass device absent; verify the nominal12.63 V equivalent trip and deliberate rearm. | NOT_RUN |
| G6 synthesizer/source | Source only into calibrated50 Ω, selected clock only;144–148 MHz sweep and repeated power/configuration cycles | Championship range and better50 ppm over qualified temperature/supply/aging budget. Source fundamental sufficient for calculated driver input without violating continuous input ratings. Close-in products/phase noise recorded; harmonic filtering/clock-disable behavior demonstrated. | NOT_RUN |
| G7 driver standalone | CalibratedRF generator,50 Ω load, correct thermal grounding; actual7.75–8.25 V driver rail | Across band/hot samples: P1dB≥27.2 dBm or recalculated gain/backoff gate; required output24.11 dBm at conservative15 dB PA gain has≥3 dB compression reserve. Measure actual compression/spurs and source-drive adequacy. No reliance on bracketing typical data alone. | NOT_RUN |
| G8 PA/matching standalone | Variable drain and calibratedRF generator; initial1–2 V drain/≤0.1 A, grounded bias trim, no modulator connected. Increase only after stability checked | No oscillation during biased/muted/drive/source/load sweeps. Establish≥6.103 W capability before output-filter loss, or recompute for measured filter;≥5.135 W connector capability. Record gain vs drain voltage, drive, temperature and mismatch. Native matching is EVAL TUNE. | NOT_RUN |
| G9 integrated trueAM | Correct50 Ω dummy, full RF load and envelope instrumentation; start reduced carrier | At full sizing plane,1.259 W carrier/4.079 W PEP at80% is an investigation target; actual operatingERP guarded by measured antenna/uncertainty. Depth70–80%, initial envelopeTHD≤5%, sideband symmetry≤1 dB; no flattened crests or unacceptable AM-to-PM. Measure carrier-only and all PWM/tone profiles. | NOT_RUN |
| G10 spectrum/shaping | All band edges/profiles, CW tone marks and scheduled ramps; source, converter and optionalLoRa active combinations | National mask must be selected before compliance claim. Provisional internal harmonic/spur objective≤−60 dBc; close-in products recorded separately. No unapproved keying bursts, PWM sidebands or retune chirp. Reference analyzer dynamic range and attenuation. | NOT_RUN |
| G11 thermal/mismatch | Full/reduced and no-tone, normal20% duty plus continuous-beacon cases;45°C design ambient; bounded2:1 mismatch all phases, then approved worse cases | PA/pass/helper estimated junction≤125°C design gate and within exact SOA; no driver ground lead above95°C. MOSFET drain waveform≤32 V engineering ceiling, never40 V absmax. Current/thermal trip deterministic, no automatic rearm. Mechanically intact thermal contact verified. | NOT_RUN |
| G12 training | Normal stage and converters absent first;3.3 V only, own50 ΩµW reference | Calibrate nominal1 µW carrier, optional1–10 µW pads; record PEP/mean/depth and emission spectrum. Unarmed/between-slot output target<0.1 µW and<−60 dBc where measurement permits; this finite threshold is not an IARU exemption. Correct keyed sine waveform. | NOT_RUN |
| G13 port isolation/faults | Normal into rated load, training port protected instrumented load; source on/off; controlled single faults and external coupling | No conductive watt path; off-port measured below the agreed training ceiling, no damaging power. Initialnormal-to-training isolation target≥80 dB and off-slot silence test with sensitive receiver. PCB/antenna coupling cannot be proven by Boolean or netlist tests. | NOT_RUN |
| G14 endurance/system | Calibrated guard-banded ERP and real pack/cutoff,20% slot duty, cold/aged proxy and optionalLoRa profiles |≥12 h selected maximum and≥24 h selected reduced setting still meeting ERP minimum/modulation; no automatic power reduction. Log every rail/current/temperature and full4S accessible energy. Beacons tested against a separate duration requirement. | NOT_RUN |
| G15 radiated field/legal | Qualified antenna with horizontal near-omnidirectional pattern,2–3 m height, calibrated feeder/gain and lawful site | ERP uncertainty supports selected0.25–1 W interval; no off-slot antenna radiation; country/profile permission valid; correct>200 kHz simultaneous separation. Training field criteria recorded separately. | NOT_RUN |

Before normal RF, G0–G5 must pass; source/driver/PA can then be tested independently. A failed high-energy gate stops that stage while other bounded low-voltage work may continue. At least three independently assembled RF samples must eventually demonstrate repeatability; one tuned sample does not qualify a6–20-unit fleet.

## Measurements simulation cannot replace

Actual144 MHz large-signal gain/stability/matching; driver compression/hot current; RF-envelope depth/THD/AM-to-PM/PEP; off-slot and cross-port leakage; national unwanted emissions; supply fault timing/overshoot and asynchronous reset races; hot SOA/thermal contact; antenna ERP/pattern; real discharge energy and12/24 h runtime. Every resulting report must retain raw data and a NOT_RUN/FAIL/PASS disposition, rather than changing a calculation into a measurement.
