DD1SB/ARDF-TX/docs/M3_80M_TEST_PLAN.md

# M3A — prototype measurements and acceptance gates

**M3A-R1 additions:** [R1-L1–L4/P1/R1–R2/T1/I1](M3A_R1_VERIFICATION.md) supplement every gate below and remain NOT RUN. Test actual Q13//Q12 and heartbeat witness; raw ARM context, pending delayed clock, selected-request withdrawal and KEY-high refusal; comparator/diode/FET margins and asynchronous clear feedback. Converter fault acceptance additionally requires measured≤20 µs total isolation, VDRV≤12.6 V and C404 transient ESR≤0.5 Ω over0–50°C. Power-only/logic qualification precedes unrestricted4S and RF. Tests explicitly reject recovery while ARM stays high.

Date: **2026-10-14**. **Every physical test below is NOT RUN.** ERC, netlist and Boolean checks are design checks, not measurements. No PCB, component order or physical assembly has been authorized or produced.

Propose one small evaluation assembly of the selected IRF610 core, supply, shaper and interlocks, with the separate Fox section. It is a temporary fixture, not a fourth primary product PCB. No competing complete QCX transmitter is needed. Keep replaceable fixed feedback/pad values, gate link R403, removable DC block C410 and labelled current/probe access. Do not key an unfiltered or unmatched bare final because a point is called RF_RAW.

## Shared equipment and reference planes

Use a current-limited programmable 0–20 V supply and a separate bounded 3.3 V logic supply; external ESP32/host fixture for GPIO/I²C/lease; calibrated 50 Ω load rated at least10 W/HF wattmeter; low-level RF sensor/voltmeter for10 mW; oscilloscope of at least100 MHz with suitable low-capacitance drain-rated probe and current measurement; spectrum analyzer with calibrated attenuation through at least1 GHz; VNA/impedance bridge; stable reference/counter; current/Wh logger; thermocouples and controlled ambient to50°C; mismatch fixture; surveyed field locations and representative ARDF receivers. Instrument access, calibration, adapters and laboratory capital remain OPEN.

The 50 Ω planes are **PCB terminals J401** (normal) and **J502 pins1/2** (Fox), using short calibrated/de-embedded adapters. Probe pads are high-impedance observation points, not automatically50 Ω ports. Grounded instruments cannot bypass the high-side current shunt; scope ground must never connect to the drain or positive rail.

## Go/no-go gates

| Gate | Required physical evidence | NO-GO response |
| --- | --- | --- |
| **E0: power-only** | Signed pin/footprint/core review. Valid rails at12.0/14.4/16.8 V; reverse-input blocking, 3.3 V startup/POR, reference thresholds and default-off states. Characterize effective capacitance, buck stability/ripple and soft-start before attaching PA load. | Do not arm RF if any voltage/current or startup behavior is unsafe. |
| **E1: autonomous fail-off** | Test boot, reset/brownout, control unplug, static/stopped lease, stale ARM, conflicting requests, mode11, wrong pack/UV, SCL activity, MUTE low, open/short/hot NTC and OC/OV. Force the RF clock high/low or absent, including key-start; verify OC prevents destructive DC drain conduction. Both RF paths mute; normal rail disconnects; fresh ARM cycle required. Include armed-without-key startup on both paths, shaper shorts, stale key-tail/reset and power-cycle permutations. Qualify key-tail 10–80 ms, longer than both RF decays; ARM low≥20 ms resets it and first KEY waits≥250 ms after arm. Direct inhibit≤1 ms; stopped lease≤250 ms; OC complete mute≤100 µs or faster if SOA requires. Converter-short test must keep LM5134 VDD≤12.6 V without damaging fault energy. | Any uncommanded carrier, automatic restart or excessive transient blocks armed testing. GPIO state alone is insufficient evidence. |
| **E2: source/retuning** | Every channel/divider boundary across3.510–3.600 MHz. Total accuracy better than50 ppm over0–50°C, supply and calibration/aging cases; aim≤10 ppm. Verify independent CLK0/CLK2 mute/readback, quiet retuning and actual off-slot radiation. | Correct source/reference/grounding without silently dropping channels. Test internal clock radiation and inactive VHF-board coupling. |
| **E3: normal power** | Reproduce the reference core with regulated laboratory rails, then add the buck/shaper. Full-power uncertainty interval entirely **3.0–3.3 W**, calibrated near3.15 W. Extended **1.10–1.30 W**, within IARU1–5 W. Initial Sprint target **0.75–0.95 W**, entirely within0.3–1 W. Meet each at all channels and three battery test points. Record post-filter mark power/PEP and scheduled average separately. | Adjust fixed feedback values while driver stays4.0–8.6 V. Otherwise review drive/matching; publisher voltage points do not validate our circuit. |
| **E4: waveforms/efficiency** | Loaded driver/gate/drain voltage and current, all modes/supplies; repetitive drain peak≤100 V, gate peak≤12 V and negative excursions within ratings. Record buck input/output, shaper pass/base, driver and delivered RF power separately. | Resolve ringing, core/polarity/loop or drive problems. DC ratings do not prove RF stress margin. Replace energy assumptions with measured losses. |
| **E5: CW/spectrum** | Both paths have3–8 ms10–90% RF edges, ≤10% overshoot, no DUT clicks in adjacent±20 kHz receiver tests; analyzer settings stated. Project harmonic/spur aim≤−50 dBc where applicable, plus applicable national mask/absolute limits. Off-slot bench search aim≤−70 dBm with declared RBW/detector, receiver on/off and near-field comparisons. | Fix shaping/filter/converter spurs/backfeed. The finite analyzer floor does not redefine IARU silence. Emergency edges may be truncated, but faults must not damage hardware. |
| **E6: Fox output/isolation** |9–11 mW including uncertainty in50 Ω across channels and the allowed3.3 V supply range while the controller is powered from2S6.0–8.4 V. Fixed pad≥1 dB available-power attenuation with tolerances and relevant load/fault-spectrum cases, not only nominal matched insertion loss. Measure AC00 per-gate/supply currents, operation below2 V during ramps, input energy, stored energy and startup/disable transients. Test shaping-transistor shorts and independent RF mute. Retain≥47 dB main-to-Fox isolation; at3.3 W this means≤66 µW at the Fox plane. Compact accessory withstands100 mW fault input plus measured transients. | If the buffer cannot meet10 mW, shaping and ratings together, review the retained BJT fallback. Do not increase supply or attenuate the watt PA into the compact port. Any unintended carrier or unsafe coupling blocks antenna use. |
| **E7: thermal/mismatch** |50°C ambient, actual code/duty and continuous beacon case. Final/shaper/driver/buck junction estimate≤110°C with documented thermal path. Case trip near80°C and open/short detection work. VSWR3:1 phase sweep, then controlled open/short with bounded current/time; trip before hot repetitive SOA is exceeded. | Reprice necessary sink/shaper/core/protection. Indefinite open/short survival and free-air pulse SOA are not presumed. |
| **E8: separate antennas/field** | Long wire plus defined return: complex impedance, tuner loss/reactive voltage/current and≤2:1 source VSWR; symmetric Sprint installation. Separate approximately30 cm Fox radiator, compact return, enclosure/pack and loading/coupling: C/Q/SRF/tap measurements and wet/dry/proximity tests. Independently verify10 mW before/after field testing; **30 m audible /250 m not audible** under an agreed procedure. | Change matching/coupling/geometry/loss while retaining nominal10 mW. A long wire at low power or a dummy-load result alone cannot pass Fox field reach. |
| **E9: endurance/integration/repeatability** | Existing S3/RTC, no-LoRa and optional-LoRa profiles; Classic20%, two concurrent Sprint groups with12 s slots/20%, Fox continuous. Maintain selected full RF output for≥12 h and extended compliant output for≥24 h. Log weakest cell/BMS/aging/cold/peak cases and end-of-run timing/output. Treat continuous finish/spectator beacons separately. Repeat critical RF results on three independent builds before fleet layout. | Improve idle/efficiency or choose a larger allowed pack and recost. Do not claim modeled endurance or automatically change competition power. |

Competition constraints come from [IARU Part B2025](https://www.iaru-r1.org/wp-content/uploads/2025/01/ARDF-Rules_B_2025.pdf), T2.6/S6/FT2.6. Other limits above are **project acceptance targets**. National authorization/emission masks remain the [regulatory review](M1_REGULATORY.md). 80 m connector power is conducted power; A1A mark power equals PEP, whereas duty average depends on schedule/keying. The separate VHF carrier ERP/AM PEP requirements are unchanged.

Retain the [M2 field method](M2_80M_VALIDATION_GATES.md): fixed code/speed/receiver gain/bandwidth/headphones; record radiator/return/coil/tap/case height, pack orientation, soil and weather. Survey multiple30/250 m azimuths including the strongest direction. Use blinded on/off audio trials with a sensitive competition receiver and a beginner receiver. Proposed criterion is≥9/10 correct code at30 m and no above-chance detection at250 m; referee agreement remains OPEN. Physical field work requires later authorization and applicable legal conditions.

Simulation cannot replace drain/gate/current waveforms, delivered power/efficiency, envelope/clicks, spurs/retune/leakage radiation, fault response/energy, winding/filter/hot SOA/thermal behavior, nominal10 mW/field range or battery/timing/LoRa tests. **No analogue RF simulation or prototype measurement was performed in M3A.** Boolean and connectivity checks establish only the stated logical/electrical connections.
