DD1SB/ARDF-TX/hardware/controller/review/M6-L1/BRINGUP.md

# M6-L1 staged option assembly and qualification — NOT_RUN

Retain the R1 [controller procedure](../M6-C1R1/BRINGUP.md) without bypassing pack-ID/USB/power/RTC/default-off tests. No activity below is authorized by this CAD review. RF80/RF2M packs and antennas stay disconnected during controller-only tests.

1. Select the exact base/radio BOM. NO_LORA leaves all six optional positions absent and must pass normal standalone RTC operation. For 433/868, record the purchased label, LCSC code/lot, supplier-linked datasheet hash and actual package measurements. Check pin 1, pitch, 15 mm body, row contact edges, pad depth, height and courtyard fit. Do not mirror the module. Reject an unexplained variant rather than probing RF frequencies.
2. Inspect ordinary HASL flatness and clean/dry flux residue. The castellated lands have no hidden centre solder pad. Use fresh compatible lead-free paste, a standard 0.10 mm stainless stencil and controlled reflow, or controlled edge soldering where the module supplier permits it. Native module aperture area ratio is about2.93 at0.10 mm thickness; nominal deposited volume is0.176 mm³ per land, before metal-content/shrinkage. No source-joint-style filled vias are needed. Inspect each visible castellation for wetting/bridges and continuity; there is no invented guaranteed void fraction. The module's complete assembly profile is not specified: use a profiled initial build within component/paste limits and retain thermal/process records before fleet reproduction.
3. For J7, a practical manual-assembly route is to mask its stencil apertures during paste application and solder its three lands separately with controlled minimal solder. Hirose publishes manual350°C/5s and0.10–0.12 mm metal-mask guidance. Its newer recommended metal apertures are smaller than full native copper lands; do not assume a full-pad paste file exactly reproduces that recommendation. If J7 is reflowed, use the maker's aperture pattern/profile instead of blindly increasing paste. Inspect seating and signal/ground separation with magnification. This stencil/hand-assembly choice uses ordinary processes and changes no PCB fabrication geometry.
4. After the R1 power gates pass, verify3.3 V at U70.13 and local C70/C71 with a scope and bounded source. Exercise a150 mA load-step scenario before relying on the module. Record minimum voltage, ringing, RF-board rail offsets and buck temperature. The local10 µF nominal capacitance is not a transient guarantee. USB-only LoRa TX remains inhibited in the initial contract.
5. With the correct radio identified, hold NSS inactive, reset deliberately and check BUSY/DIO1 and SPI response without transmitting. A chip response cannot determine433 versus868. Configure the selected oscillator/RF-switch/image-calibration settings using its actual supplier driver. Confirm shared-SPI locking: radio clocks never latch595 control bits; control words always reload16 bits atomically before SHIFT_LATCH. Failure of the option must leave autonomous ARDF operation available.
6. Fit a matching50 Ω dummy load/attenuator before any separately authorized RF test. Validate the trusted assembly/antenna/region/airtime record and start at bounded power. Measure actual frequency, power, harmonics, receiver sensitivity and TX current at the selected band; do not discover the band by transmission. VNA checks need calibrated module/connector reference planes, fixtures and de-embedding; do not call a sweep through an energized PA a passive S11 test.
7. Commission the chosen pigtail/antenna in its installation. Keep coax outside the ESP32 antenna keep-out, provide independent strain relief and vertical U.FL insertion/extraction access. Do not load the soldered receptacle with cable tension. Verify LoRa immunity/blocking/coexistence with RF80/RF2M using their existing acceptance procedures. Initial LoRa TX stays in RF-off slots. Record all results; CAD simulation does not close physical Gate E.
