DD1SB/ARDF-TX/hardware/2m/review/M5B-E4R1/BRINGUP.md

# One integrated-board commissioning sequence — all physical tests NOT_RUN

Only after separate authorizations: Stage0unpowered identity/pinout/population/GND/isolation inspection; qualify source print/reflow and first-jointXray before highenergy. Confirm bottomflatness, barcontact, live-tabinsulation and NTCAttachment. Source DCcontinuity does not validate the hiddenjoint or RFreturn.

Stage1bounded3.3V/current-limitedlogic, watchdog/reset/rearm/portdefaultoff. Stage2selectedBOOST2S/BUCK4Spopulation only, bounded benchinput, RFdriver/finalunfitteduntilrails, startup, shutdown and faultresponsepass; keepR952openuntil its railqualification. Never inject unqualified supplyfaults withLi-ionpacks. Stage3modulator representative boundedload, sinecontrol, startup/shutdown, current/thermalprotection, passcase60 °C stop. PreserveE1/E3powerprotection improvements.

Stage4normalRFwith50ohmdummyload, calibratedprotectedpower/PEP/spectrum/envelopemeasurement. Begin≤0.5 W estimatedPAheat, then2/3/4 W stagesonlyifmeasuredthermalmarginpermits. DetermineheatfromaverageV(t) I(t) minusPA-planeRFwithlossuncertainty. Log25/40 °C ambient, source wing, bar, sink, passcaseandcurrenttoequilibrium(<0.2 °C/10min). Do not callplastic-toptemperatureTj. EstablishacceptedjointR/temperaturecorrelationbefore125 °C junctionacceptance; conservative 110 °C targetismissedanalytically. Stopifjoint/contact/SOAconditionsfail; no4 W qualificationpassispreclaimed. Checksourcegroundchangesforoscillationandchangedmatchingwhileadjustingonlyexistingnetworkoptions.

Measurefrequency/stability, carrierpower/PEP, true70–80%RF AM, distortion, harmonics/spursandshutdown/offslotsilence. Stage5independentµWtrainingoutput, modulationandnormal-portisolation, withnormalPAoff/DNPasapplicable. Stage6schedule/legalconfiguration, faults, antennaERP/fieldqualification, and12h/24henduranceunderdefinedconditions. Closed-enclosurethermalperformanceisaseparategate. No stagehasbeenperformed. PreservefullE3/E4bring-up detailswhereunchanged.
