DD1SB/ARDF-TX/hardware/80m/production/review/M4A-V1R1/verification.md

# Current native verification

KiCad10.0.6 ERC0errors/0warnings; DRC0errors/0warnings/unrouted0/parity0. No DRCexclusions, no disabledconfiguredcategories; three inherited ERC informational defaults disclosed in drc-coverage.json. This is current native evidence, not copied E2 acceptance.

Current export tests:604 pad memberships,55 manufacturer devices;256 logiccombinations,31 states,16 timingcorners;12 retained plus28 new negativecases. StandardDFM PASS with29packageholes,354standardvias,all 401drilllocations,26 essentiallegendmarks,actualGerberoutline/strokes/criticalflashesandIPC. Full196purchasedparts includingone off-boardTH301;Fox115. Full on-board placement195,FOX115. All217footprints remain;positions/tracks/vias unchanged.

The historical E1/R1 suite outputs in the preservedM4Areview remain version-specific references, not new proof for this revision. Current actual circuits use correctedBD140/TL431 maps. Groundcontinuity is DC geometry, not RF/thermal qualification. Physicaltests allNOT_RUN; upload/order/assembly/power/RF allnot authorized.

[Reproduction](REPRODUCE.md), [electrical](electrical-equivalence.json), [logic](logic-results.json), [DFMmutations](DFM-regression.json), [holemutations](hole-regression.json), [interfacemutations](interface-regression.json).
