DD1SB/ARDF-TX/hardware/2m/review/M5B-E4/BRINGUP.md

# E4 physical qualification — every test NOT_RUN

HOLD before procurement/manufacture. Resolve the source-joint process and independent engineering review first. No operation is authorized here. Preserve the full [E3 bring-up](../../../../docs/M5B_E3_BRINGUP.md) and E1/E2 procedures; the order remains unpowered→logic→power→modulator→normalRF→training/isolation→operational acceptance.

After separate authorization, inspect exact devices, source joint, ordinary via caps, paste/voiding, selected mutually exclusive population, trimmed leads, bar flatness and screw engagement. Verify PA metal<0.1Ω toGND; D45/BD139 live tabs isolated from both cooling assemblies, and sensor bonded/strain relieved. Record the accepted source-joint inspection method. Do not equate resistance continuity with adequate solder coverage.

Use external bounded current-limited supplies before any battery. Start3.3V logic at100mA limit with driver/final unpopulated. Verify watchdog/interlock/default-off and retained4096/39 CAD behavior in hardware. Test the selected2S or4S converter population at its specified bounded laboratory input, not raw unqualified Li-ion faults. Keep R952 open until driver rail startup/shutdown/fault conditions pass. Preserve E1 independent regulation/isolation; no return to the old conditionalRC protection. Test the modulator into a bounded load before RF, including pass-short shutdown/current/temperature response; case60°C is the acceptance stop, not the higher sensor trip.

For normalRF use a rated50Ω dummy load, calibrated directional/average/PEP power measurement, spectrum analyzer with protection/attenuation, scope/envelope detector, voltage/current logging and insulated fine thermocouples. Start≤0.5W estimated heat, then2/3/4W heat stages. Determine PA average heat from measured averageV(t)I(t) minus calibrated PA-plane averageRF, including output-network loss uncertainty. Keep4W continuous as the qualification case; do not use contest duty to hide a failed continuous thermal path. Log ambient25/40°C, top source-wing temperature, bottom contact/bar, sink base, D45case and sensor readings to equilibrium (temperature change<0.2°C/10min). No plastic-top temperature may be called junction temperature. Inferring junction temperature requires an accepted, uncertainty-bounded source/joint model or calibrated electrical thermometry. Until that exists, the125°C engineering-junction gate remains OPEN and unrestricted high-energy operation is prohibited. Record source-joint quality and measured thermal resistance; stop on unexpected temperature rise, mounting loss, estimated4W excess or passcase60°C.

With thermal limits established, align only the existing documented matching options. Measure carrierfrequency/stability, power/PEP,70–80% RF AM envelope (nominal75%), distortion, spectrum/harmonics, off-slot silence and fault withdrawal. Confirm cooling metal does not introduce oscillation/coupling. Independently measure training µW output, AM and normal/training isolation. AntennaERP, legalfrequency configuration,12h/24h endurance and enclosed/outdoor thermal behavior require later measurements. Preserve each result with instruments/uncertainties/operator; no test is presently PASS.
