DD1SB/ARDF-TX/hardware/2m/review/M5B-E6R2/assembly-bottom.pdf

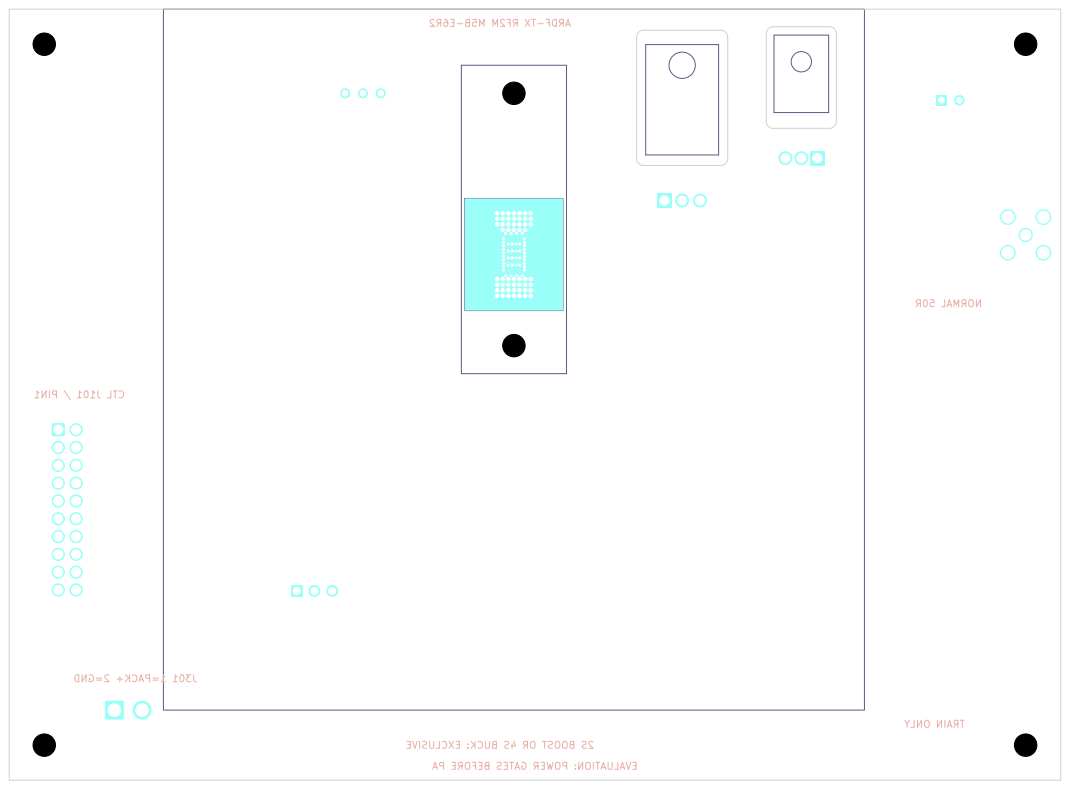
[picture p60: page 1]

EXCLUSIVE BUCK: 4S OR BOOST 2S PA BEFORE GATES POWER EVALUATION: ONLY TRAIN 50R NORMAL
