DD1SB/ARDF-TX/hardware/2m/review/M5B-E6R2/RF2M.pdf

1 | 2 | 3 | 4 | 5 | 6 | 7 | 8 | 9 | 10 | 11

AB

C

D

E

## FGH

AB

C

D

E

# FGH Date: 2026-10-21

Size: A2 | Rev: M5B-E6R2
KiCad E.D.A. 10.0.6 | Id: 1/21

# Title: ARDF-TX 2 m A2A evaluation schematic

# File: RF2M.kicad_sch

# Sheet: /

# ARDF-TX / NOT RELEASED

## 05 Sine reconstruction and series AM modulator File: 05_am.kicad_sch

13 Carrier-keyed A2A: prepared converter, drain/driver readiness and probes File: 13_carrier_keying.kicad_sch 12 Independent driver regulator and integrated alignment links File: 12_m5b_qualification.kicad_sch | 10 Local physical switches and clock sequencing

## File: 10_enable_detail.kicad_sch 06c Original ST elliptic harmonic LPF

File: 06c_st_lpf.kicad_sch | 08 Local voltage, current and thermal trip continued

## File: 08_protectionb1.kicad_sch 07 Independent very-low-power sine-AM training path

## File: 07_training.kicad_sch 05 Sine reconstruction and series AM modulator continued

## File: 05_amb1.kicad_sch 08 Local voltage, current and thermal trip

File: 08_protection.kicad_sch 06 Source filter, economical driver and fixed bias continued

## File: 06_source_driver_biasb1.kicad_sch

02 Minimal independent fail-off and captured ARM context File: 02_interlocks.kicad_sch 03 External protected pack and exclusive conversion populations File: 03_input_power.kicad_sch 01 Interface and local Si5351 source

## File: 01_interface_source.kicad_sch

## 11 External supplies and integrated commissioning

# File: 11_external_contract.kicad_sch 06b ST final-stage matching derivative

File: 06b_st_matching.kicad_sch 07 Independent very-low-power sine-AM training path continued

File: 07_trainingb1.kicad_sch 06 Source filter, economical driver and fixed bias File: 06_source_driver_bias.kicad_sch 04 2S boost and regulated MMIC rail File: 04_boost_driver_supply.kicad_sch 03 External protected pack and exclusive conversion populations continued

File: 03_input_powerb1.kicad_sch | 02 Minimal independent fail-off and captured ARM context continued

File: 02_interlocksb1.kicad_sch M5B-E6R2 / ONE INTEGRATED 144MHz TRUE-AM EVALUATION PCB / NOT RELEASED PHA-1+ and PD54008L-E retained; documented ST output match and elliptic LPF.
2S9Vboost OR4S9V/7.5Vbuck exclusive populations. Separate3.3Vtraining.
Driver: independent5.456V/5V regulation and18V-rated switch. Power-only qualification beforeR952/MMIC.
Input match has bounded same-board tuning;RF gain/AM/thermal/endurance tests NOT_RUN. Review-only PCB/Gerbers. No ordering,fabrication,assembly or RF operation authorized.

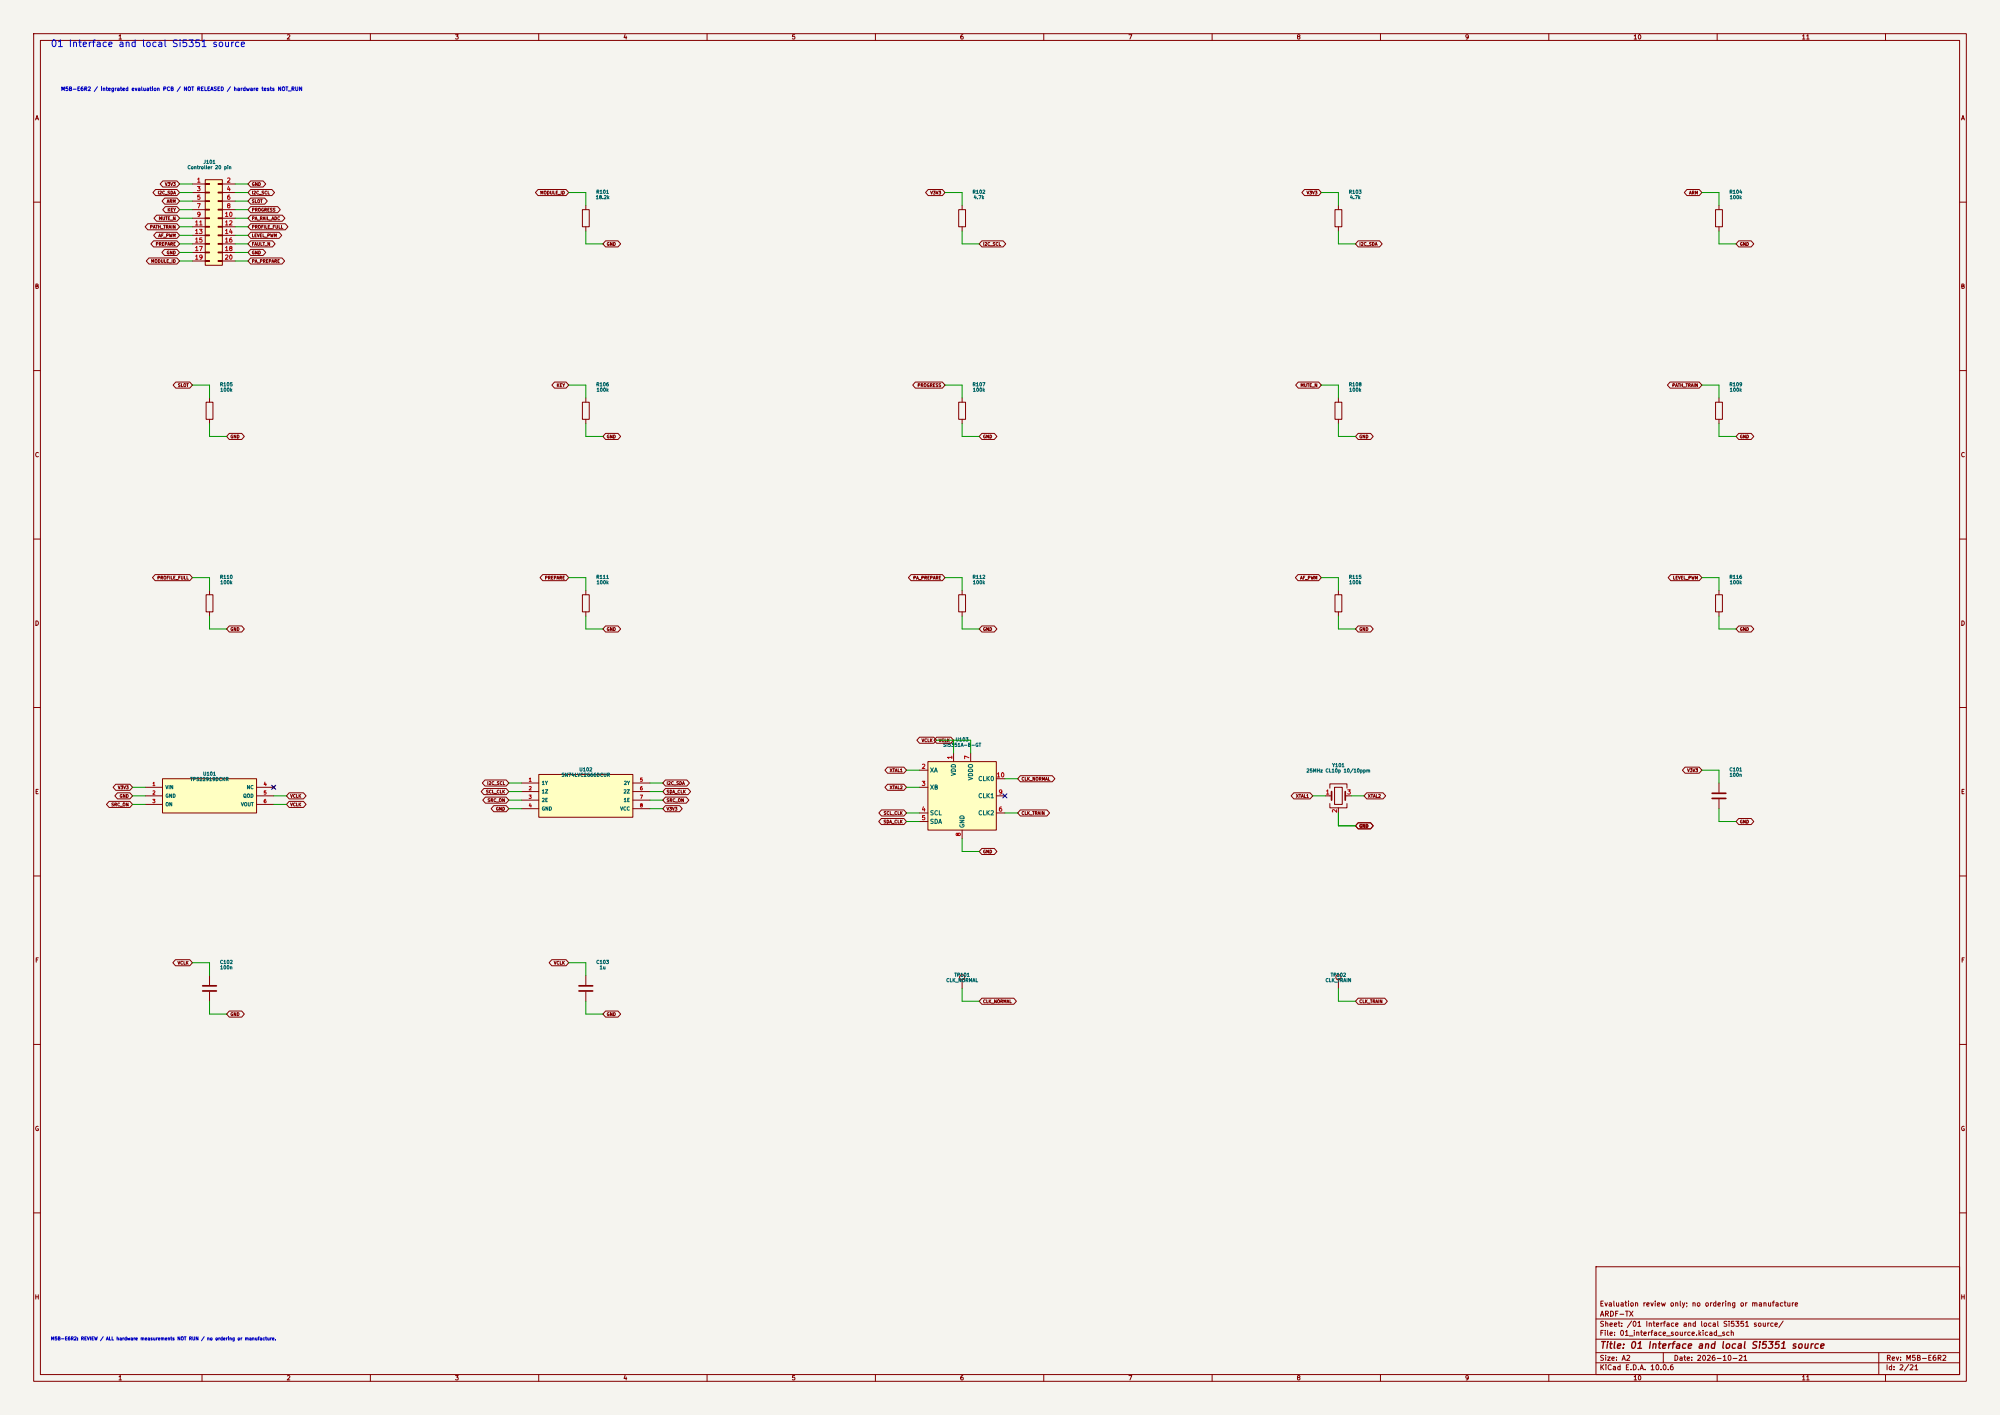
[picture p61: page 2]

SLOT 01 Interface and local Si5351 source

M5B-E6R2 / integrated evaluation PCB / NOT RELEASED / hardware tests NOT_RUN

Evaluation review only; no ordering or manufacture
ARDF-TX
Sheet: /01 Interface and local Si5351 source/
File: 01_interface_source.kicad_sch
Title: 01 Interface and local Si5351 source

M5B-E6R2: REVIEW / ALL hardware measurements NOT RUN / no ordering or manufacture.

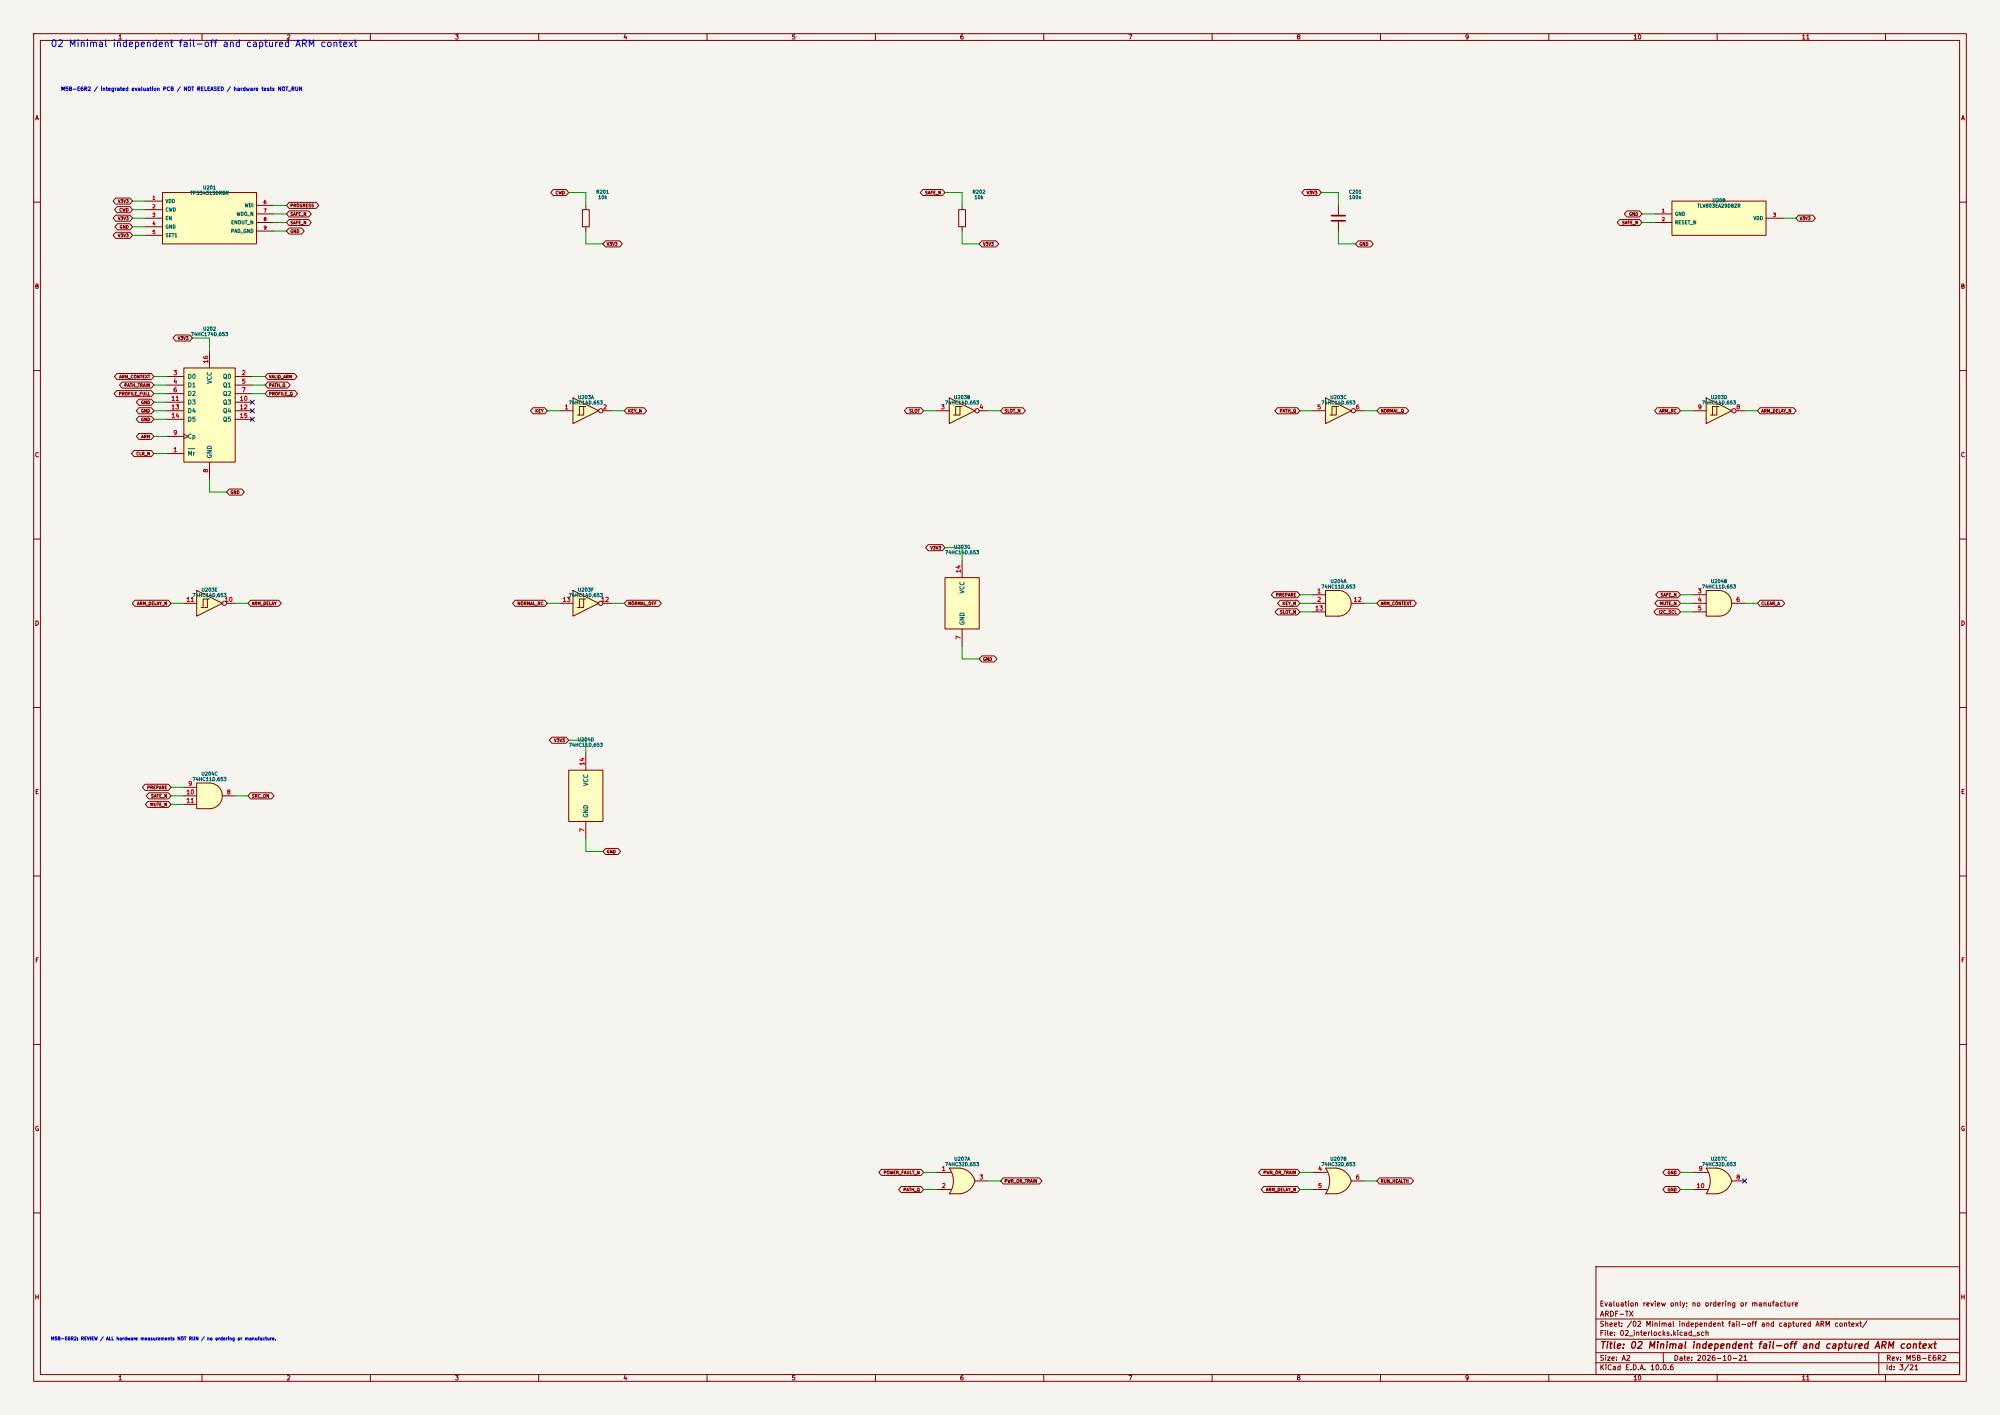
[picture p62: page 3]

02 Minimal independent fail-off and captured ARM context

Sheet: /02 Minimal independent fail-off and captured ARM context/
File: 02_interlocks.kicad_sch
Title: 02 Minimal independent fail-off and captured ARM context

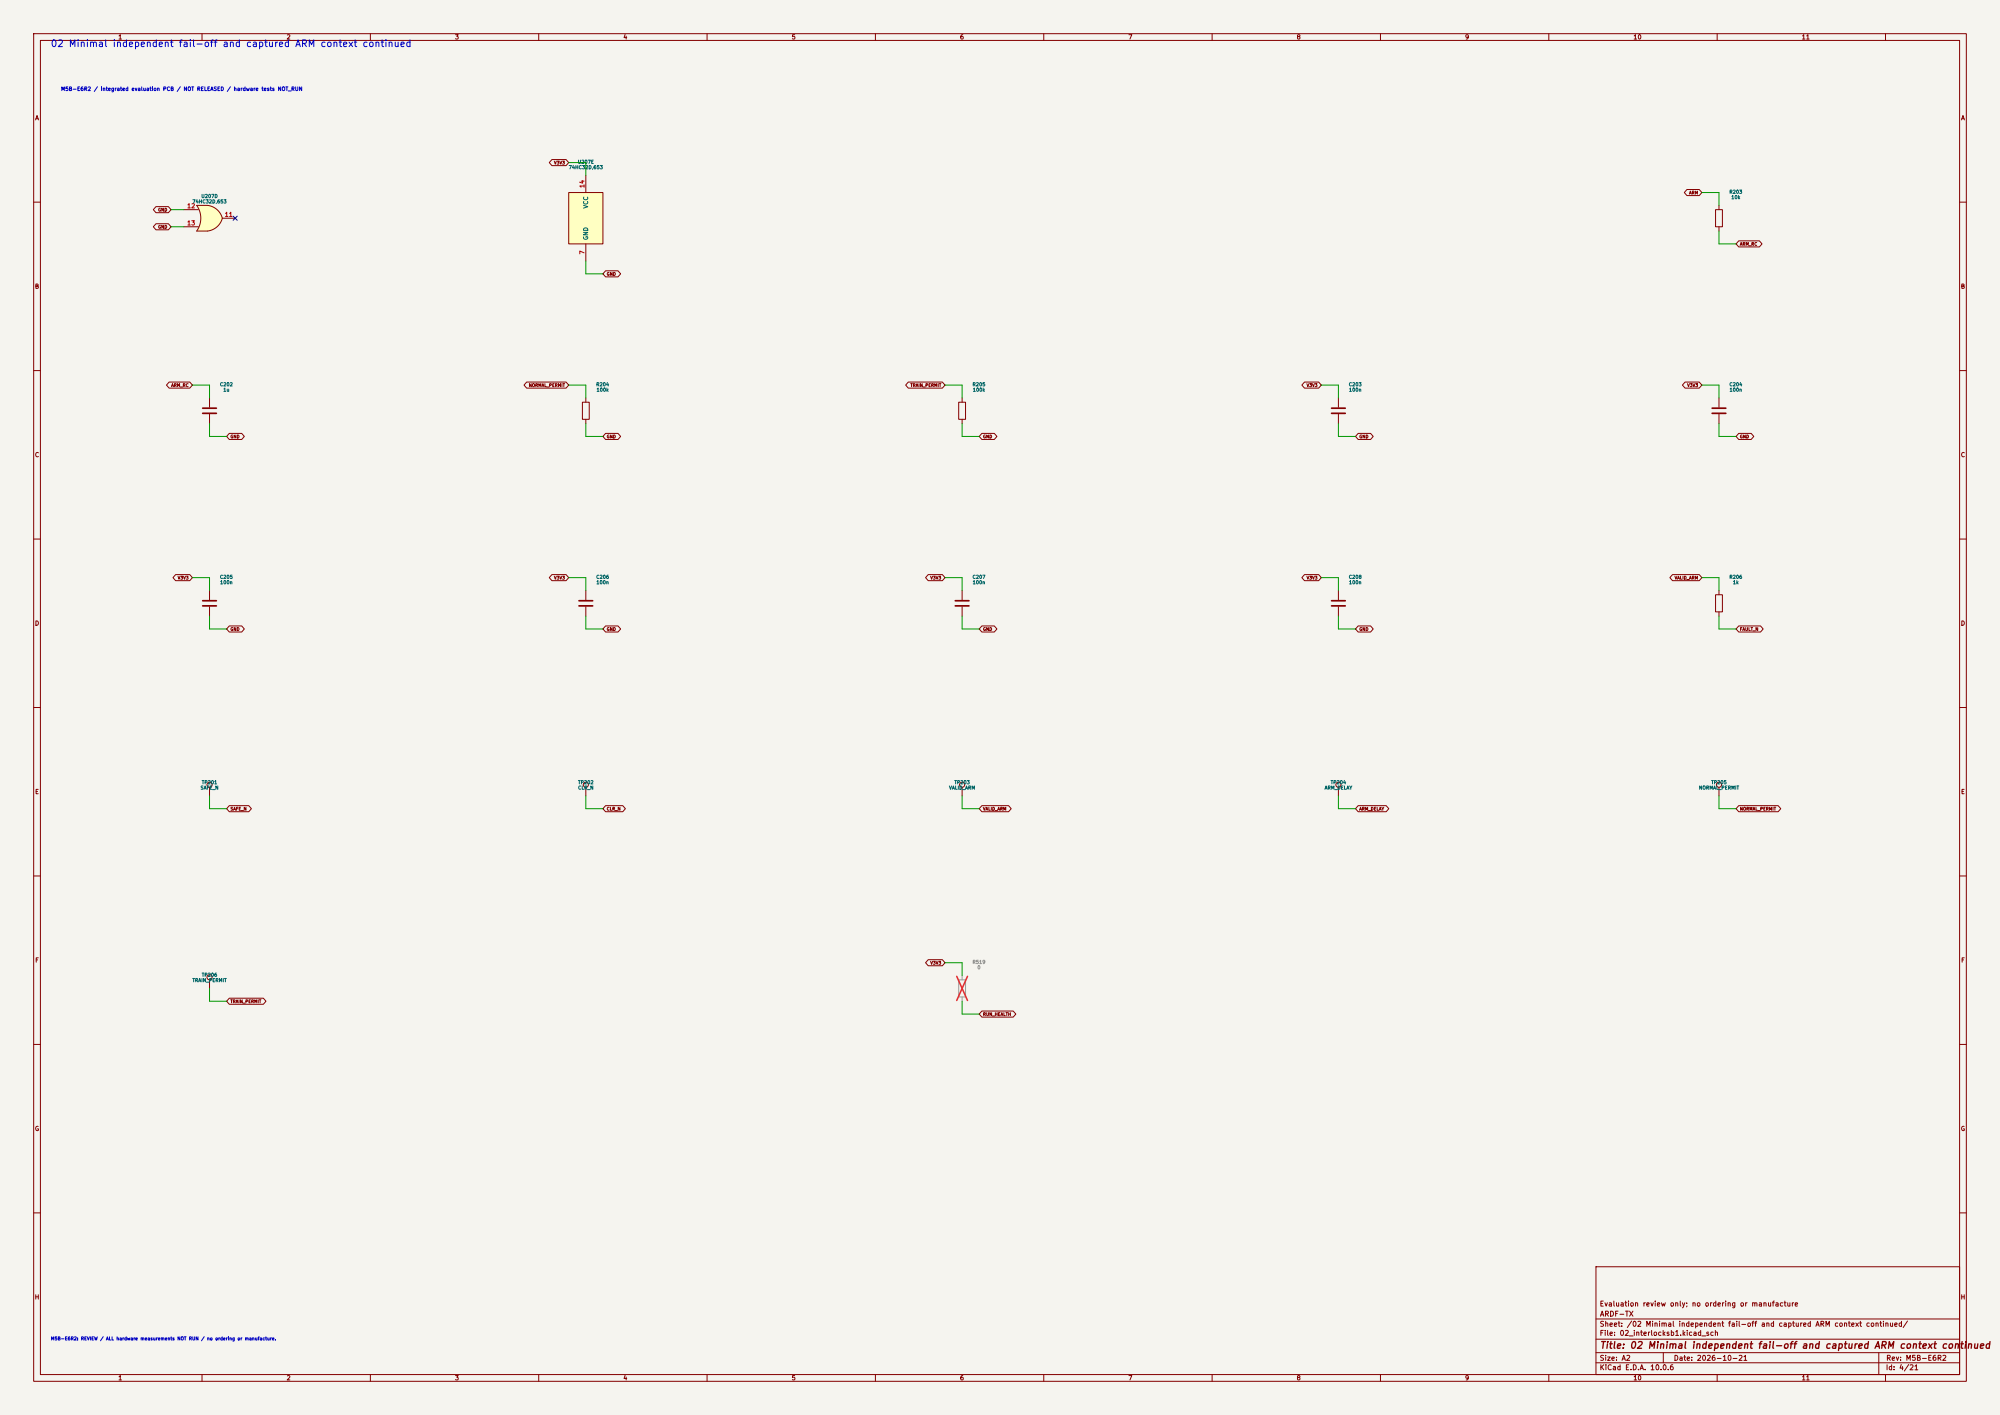
[picture p63: page 4]

02 Minimal independent fail-off and captured ARM context continued

Sheet: /02 Minimal independent fail-off and captured ARM context continued/
File: 02_interlocksb1.kicad_sch
Title: 02 Minimal independent fail-off and captured ARM context continued

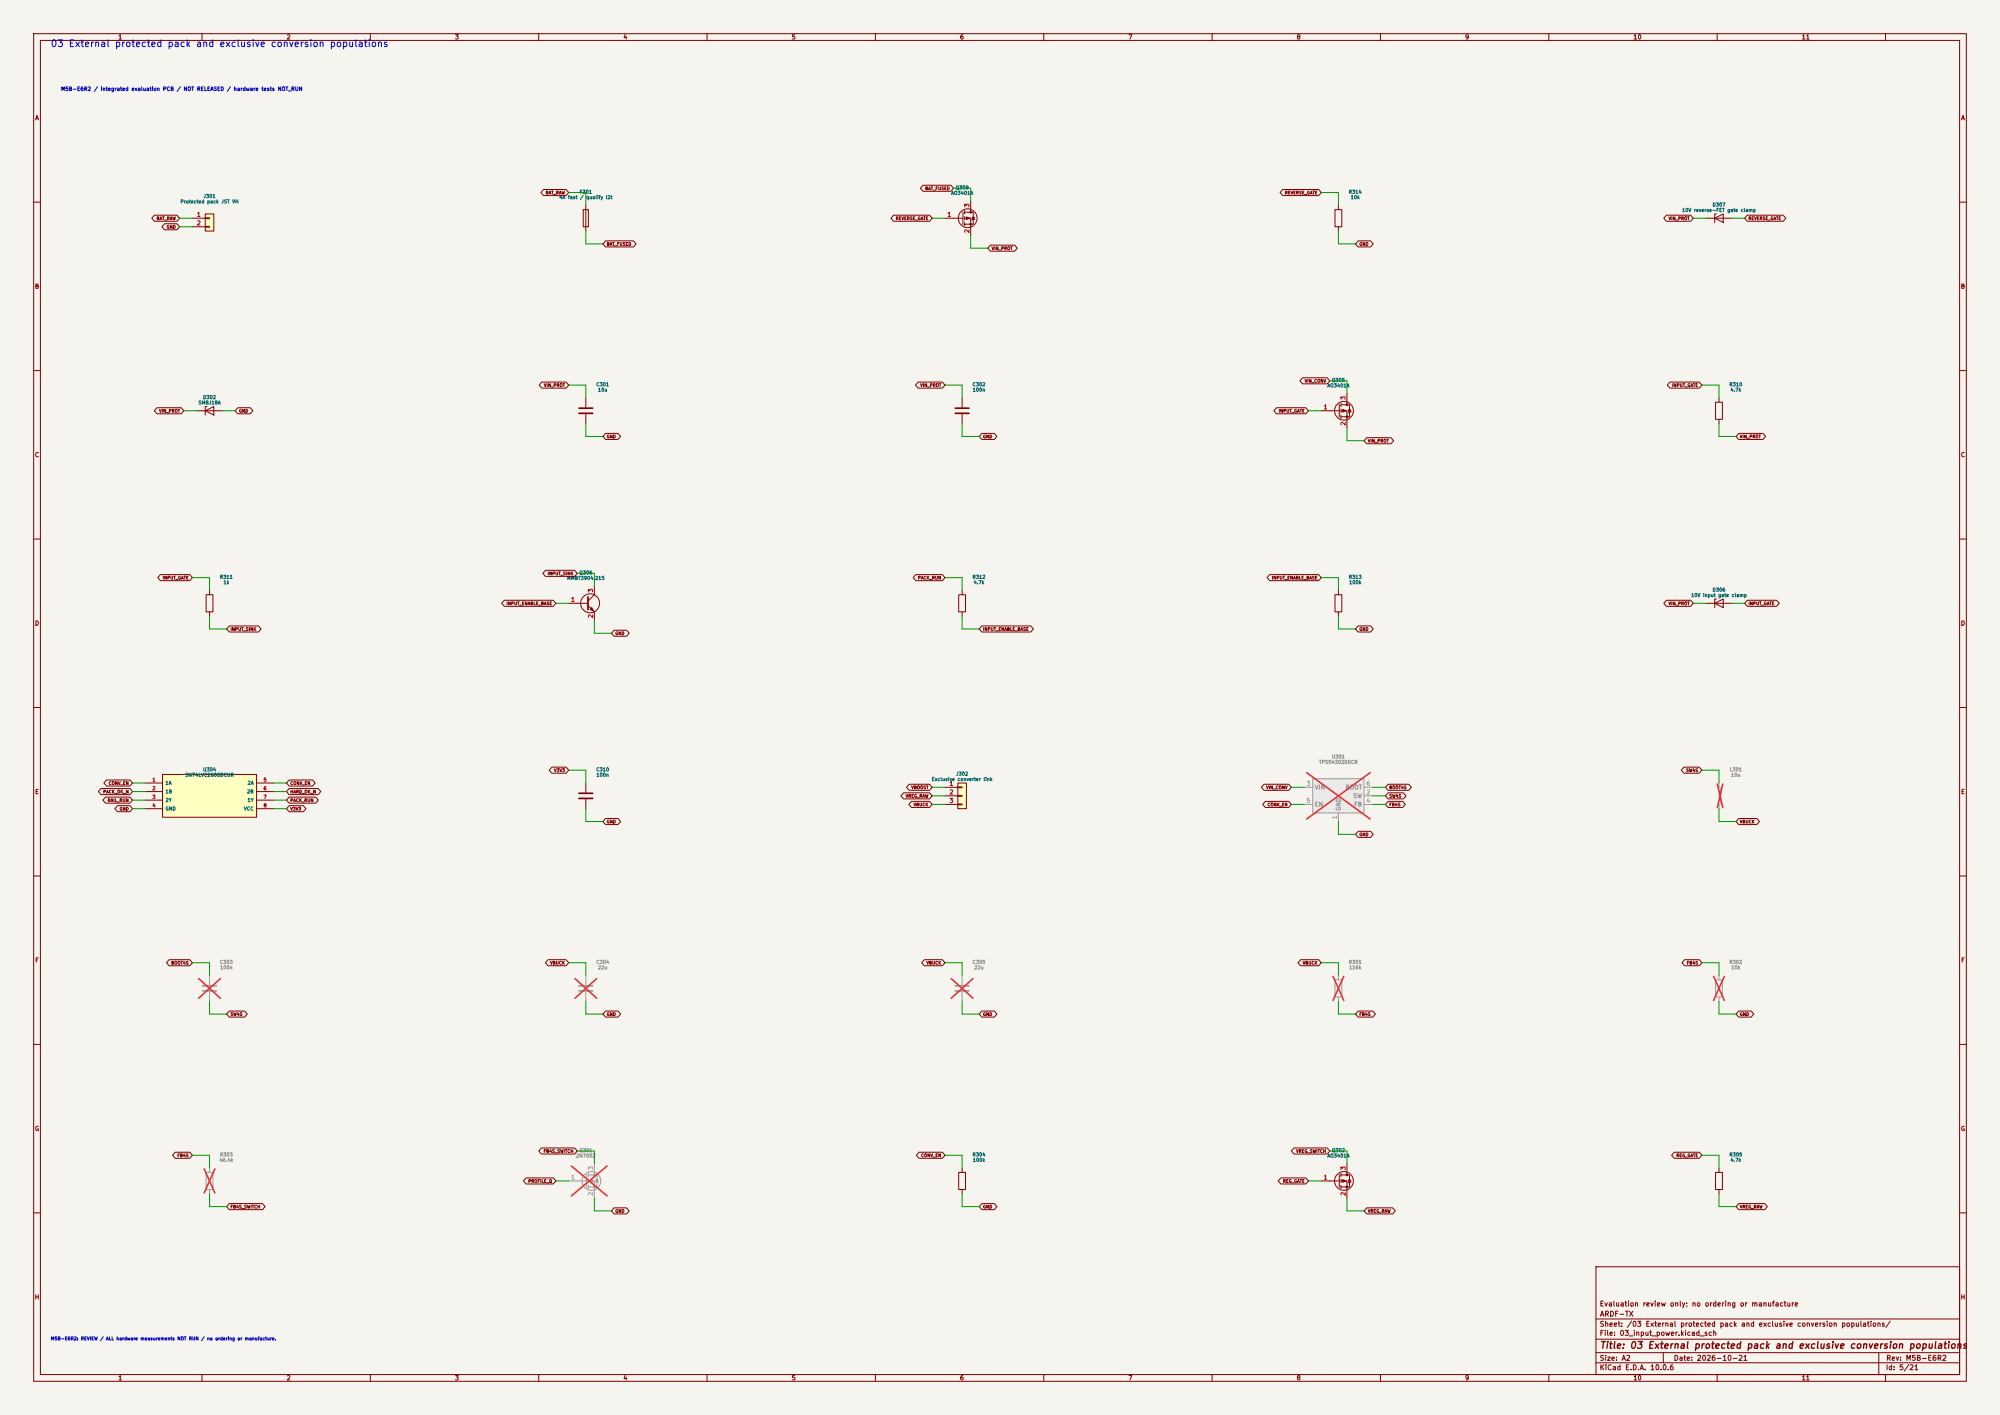
[picture p64: page 5]

BAT_RAW 03 External protected pack and exclusive conversion populations

J301 Protected pack JST VH

10V reverse-FET gate clamp

Sheet: /03 External protected pack and exclusive conversion populations/
File: 03_input_power.kicad_sch
Title: 03 External protected pack and exclusive conversion populations

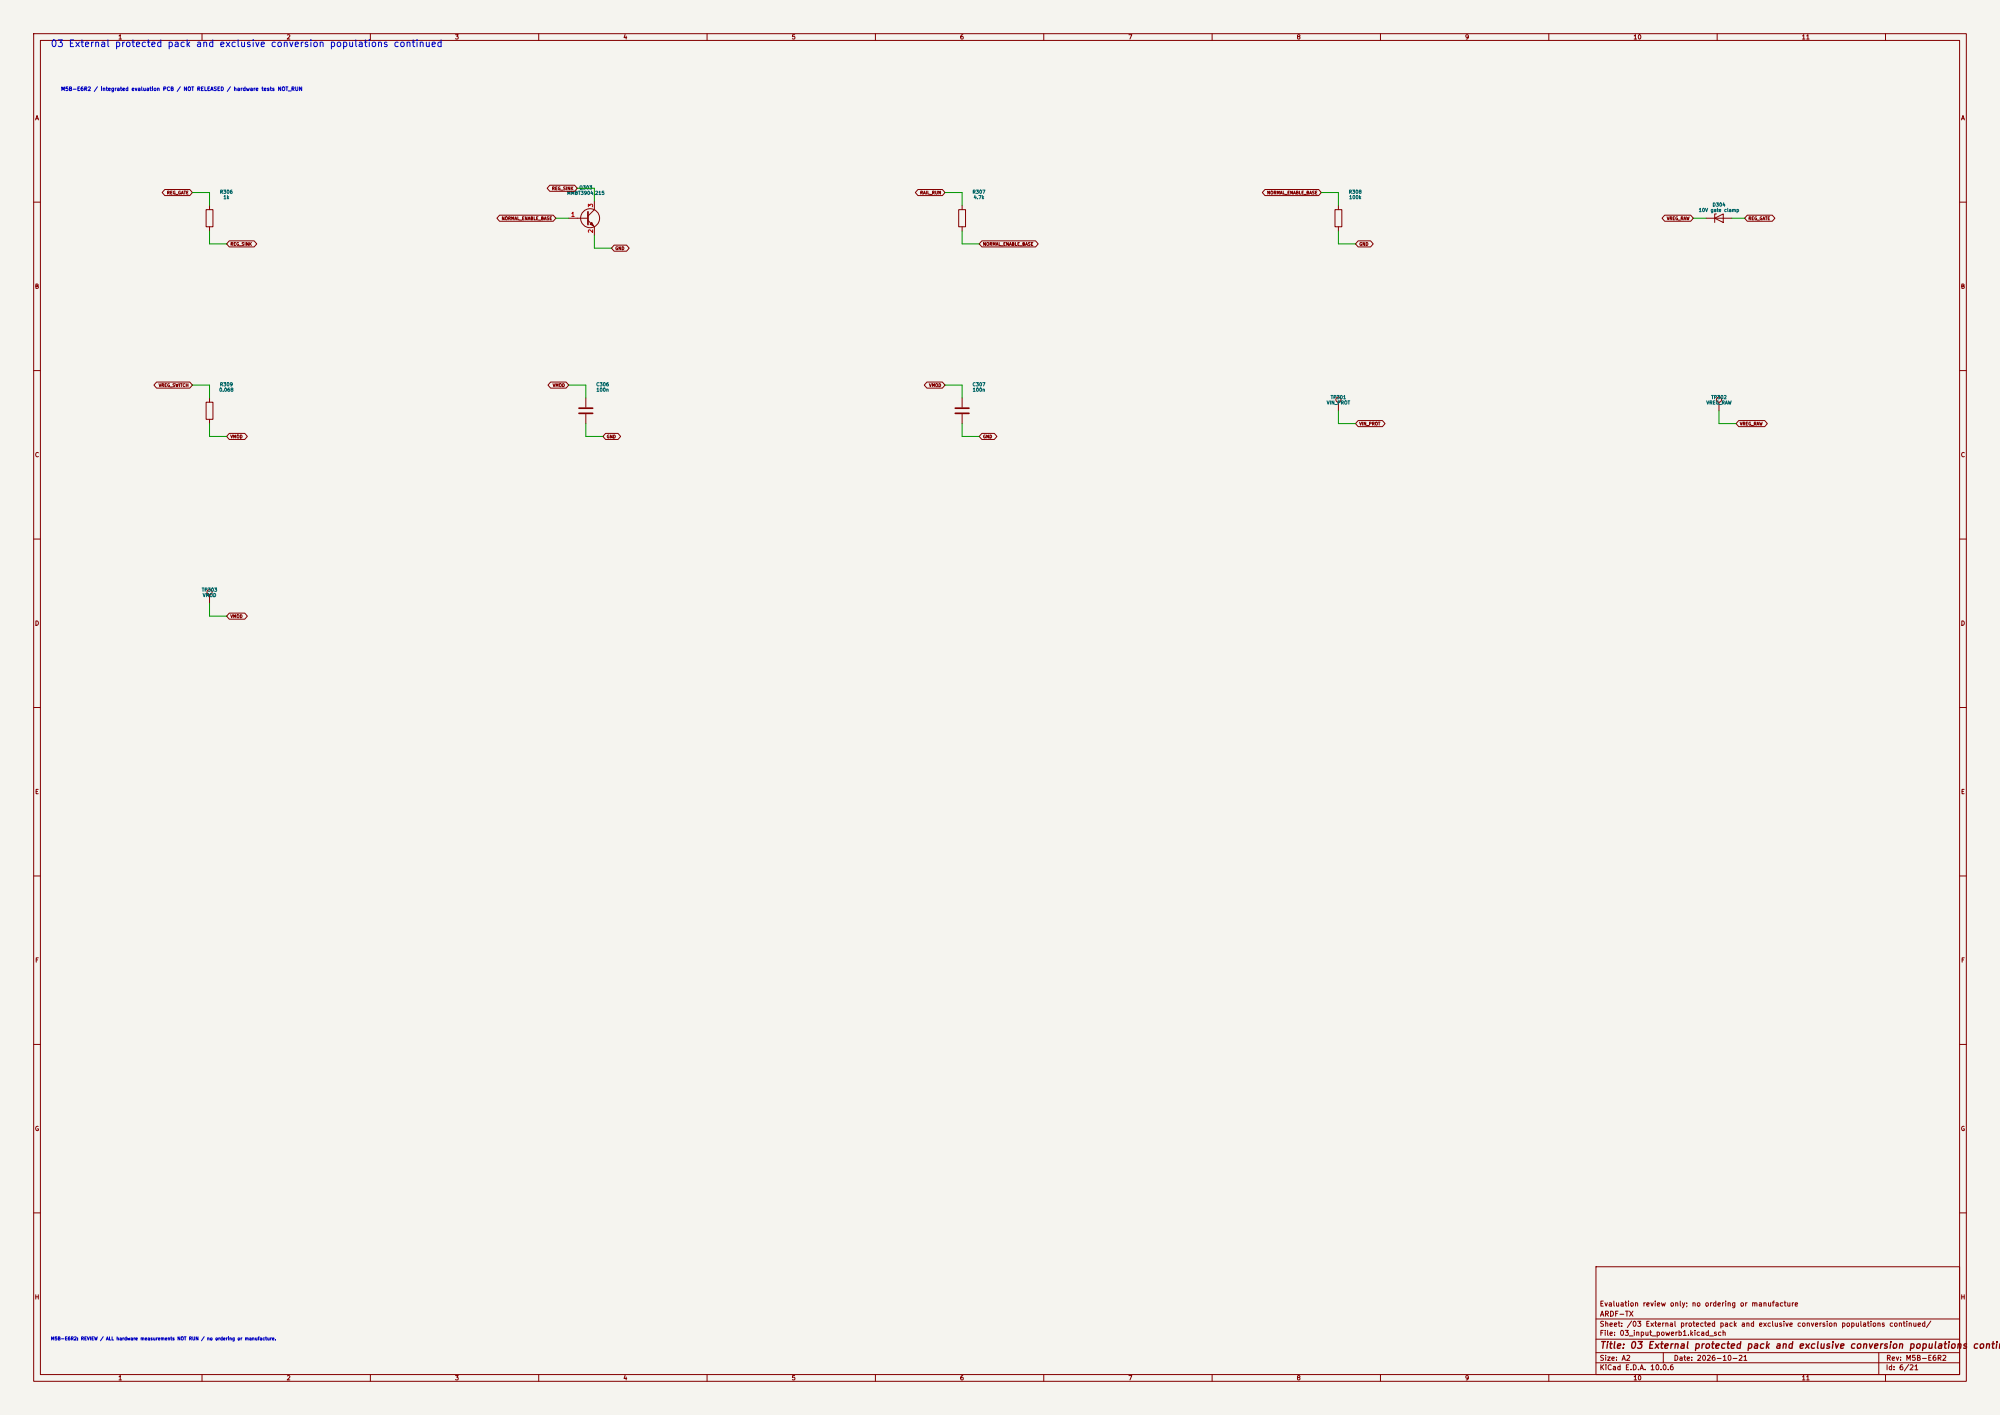
[picture p65: page 6]

GND 03 External protected pack and exclusive conversion populations continued

Sheet: /03 External protected pack and exclusive conversion populations continued/
File: 03_input_powerb1.kicad_sch
Title: 03 External protected pack and exclusive conversion populations continued

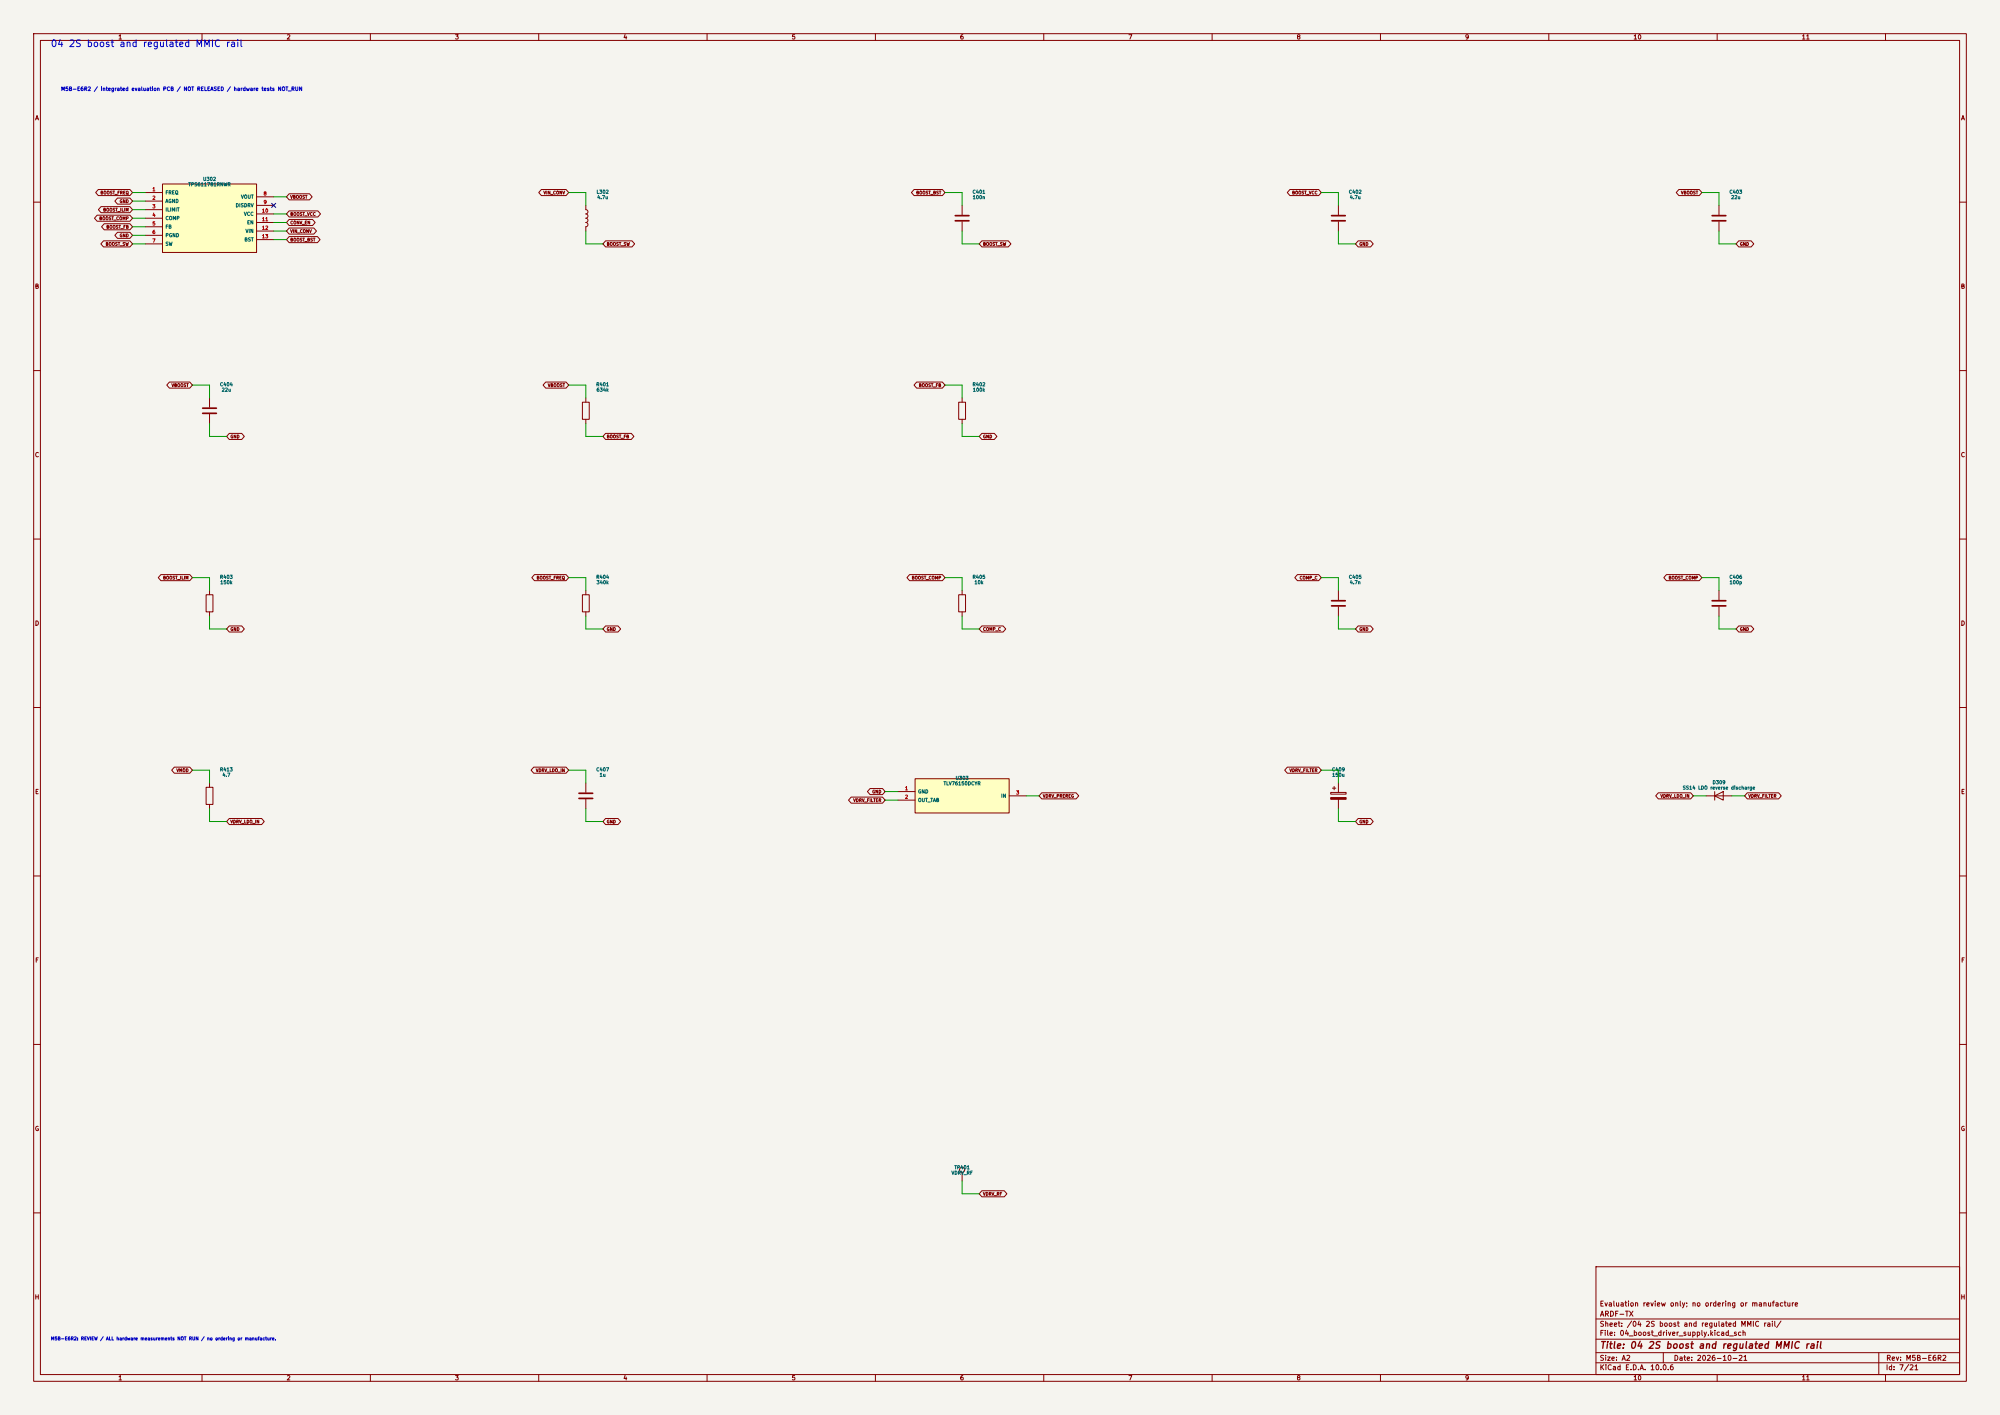
[picture p66: page 7]

04 2S boost and regulated MMIC rail

Sheet: /04 2S boost and regulated MMIC rail/
File: 04_boost_driver_supply.kicad_sch
Title: 04 2S boost and regulated MMIC rail

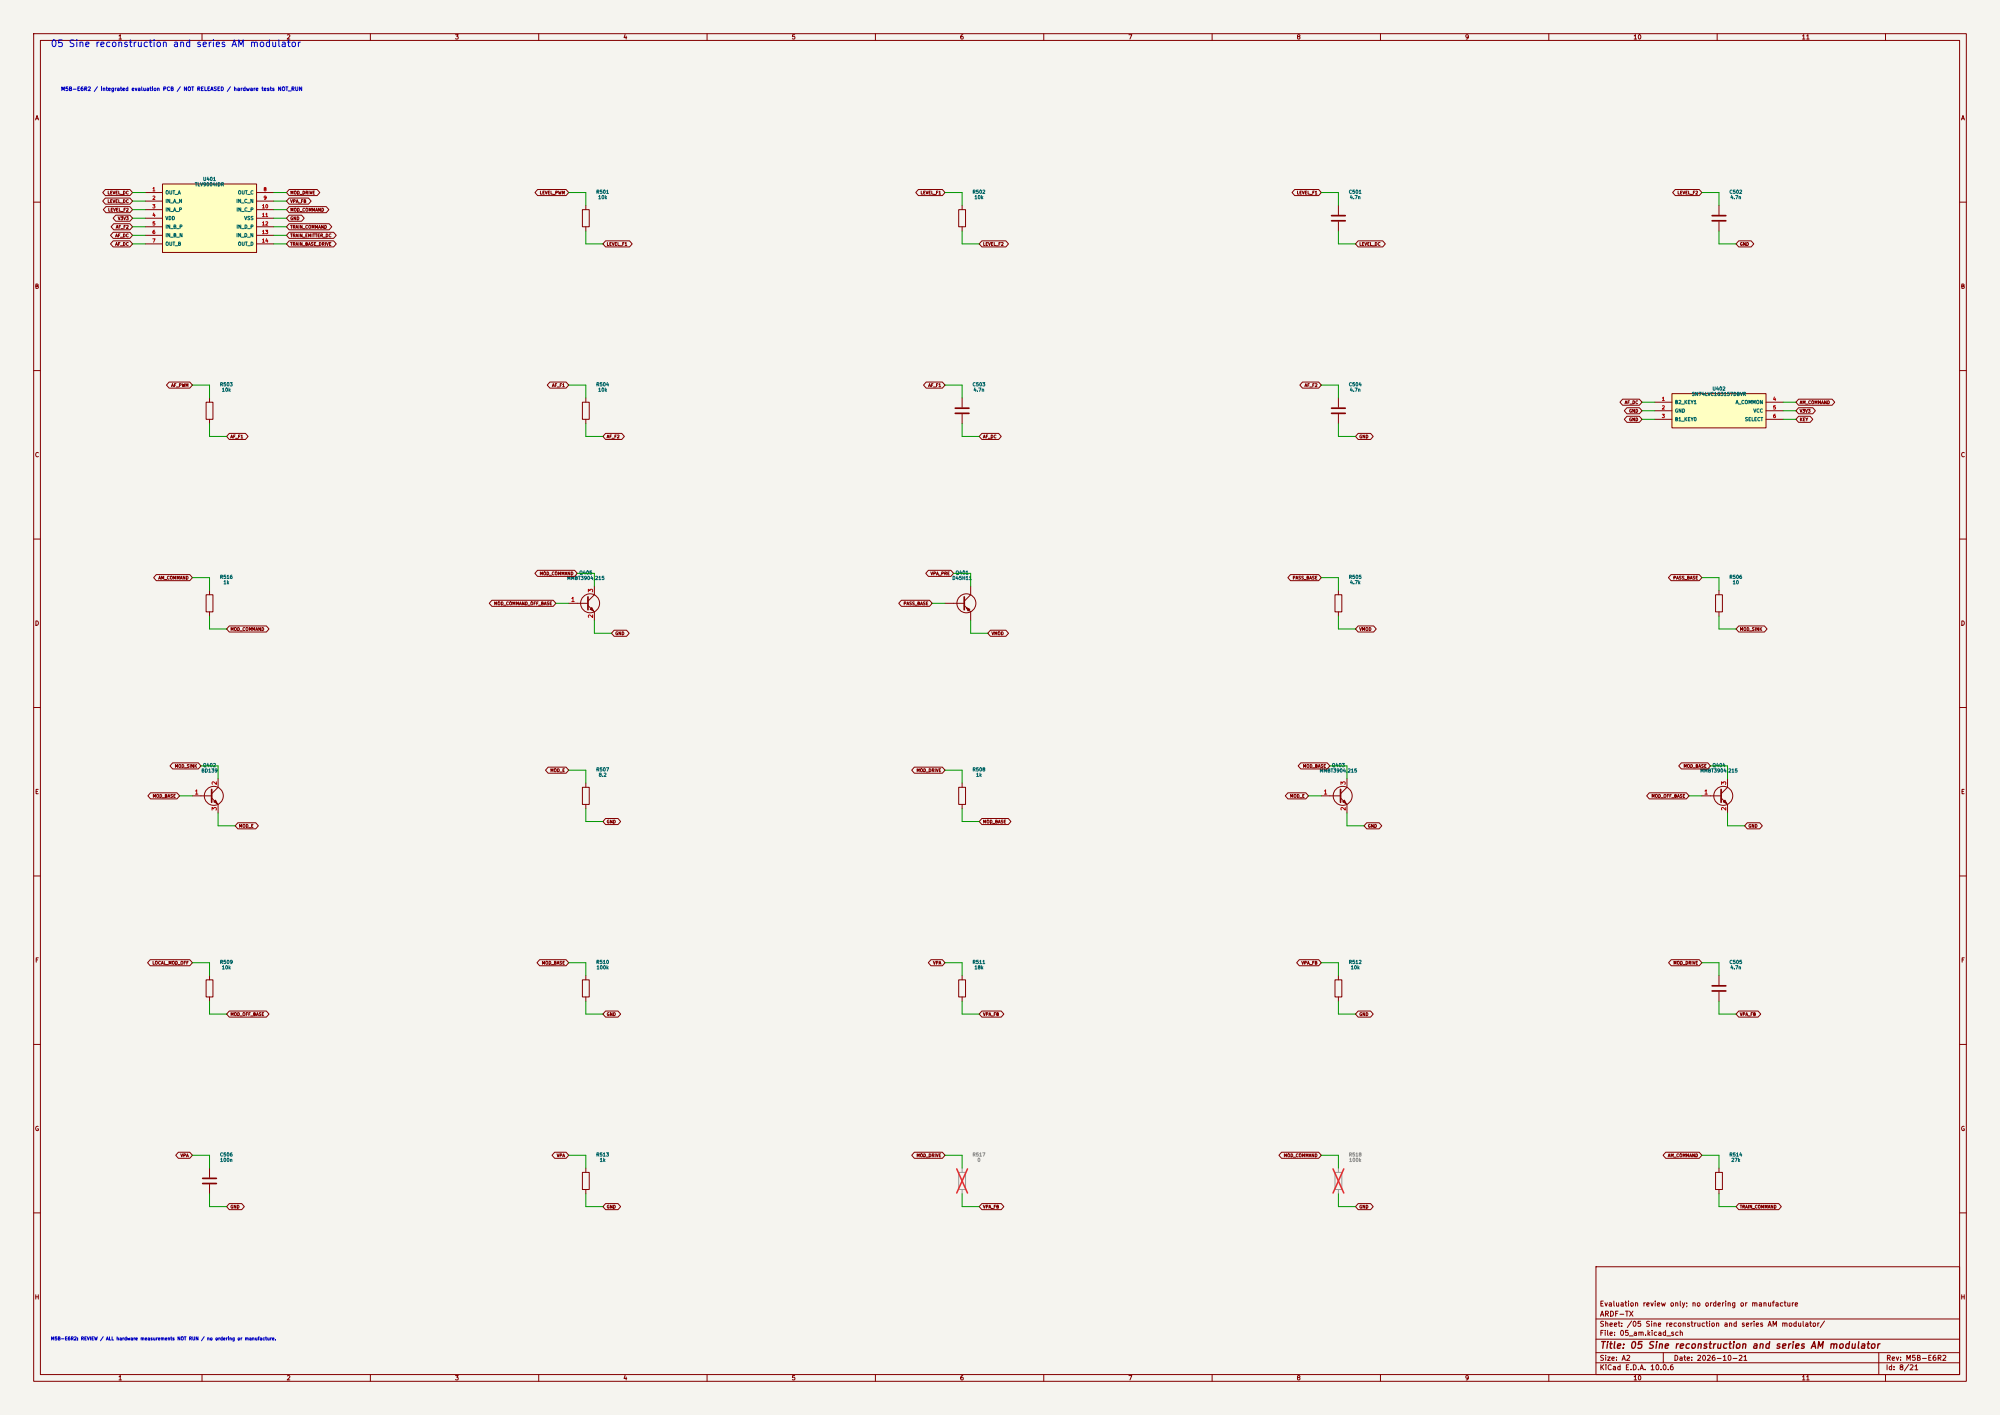
[picture p67: page 8]

05 Sine reconstruction and series AM modulator M5B-E6R2 / integrated evaluation PCB / NOT RELEASED / hardware tests NOT_RUN

Sheet: /05 Sine reconstruction and series AM modulator/
File: 05_am.kicad_sch
Title: 05 Sine reconstruction and series AM modulator

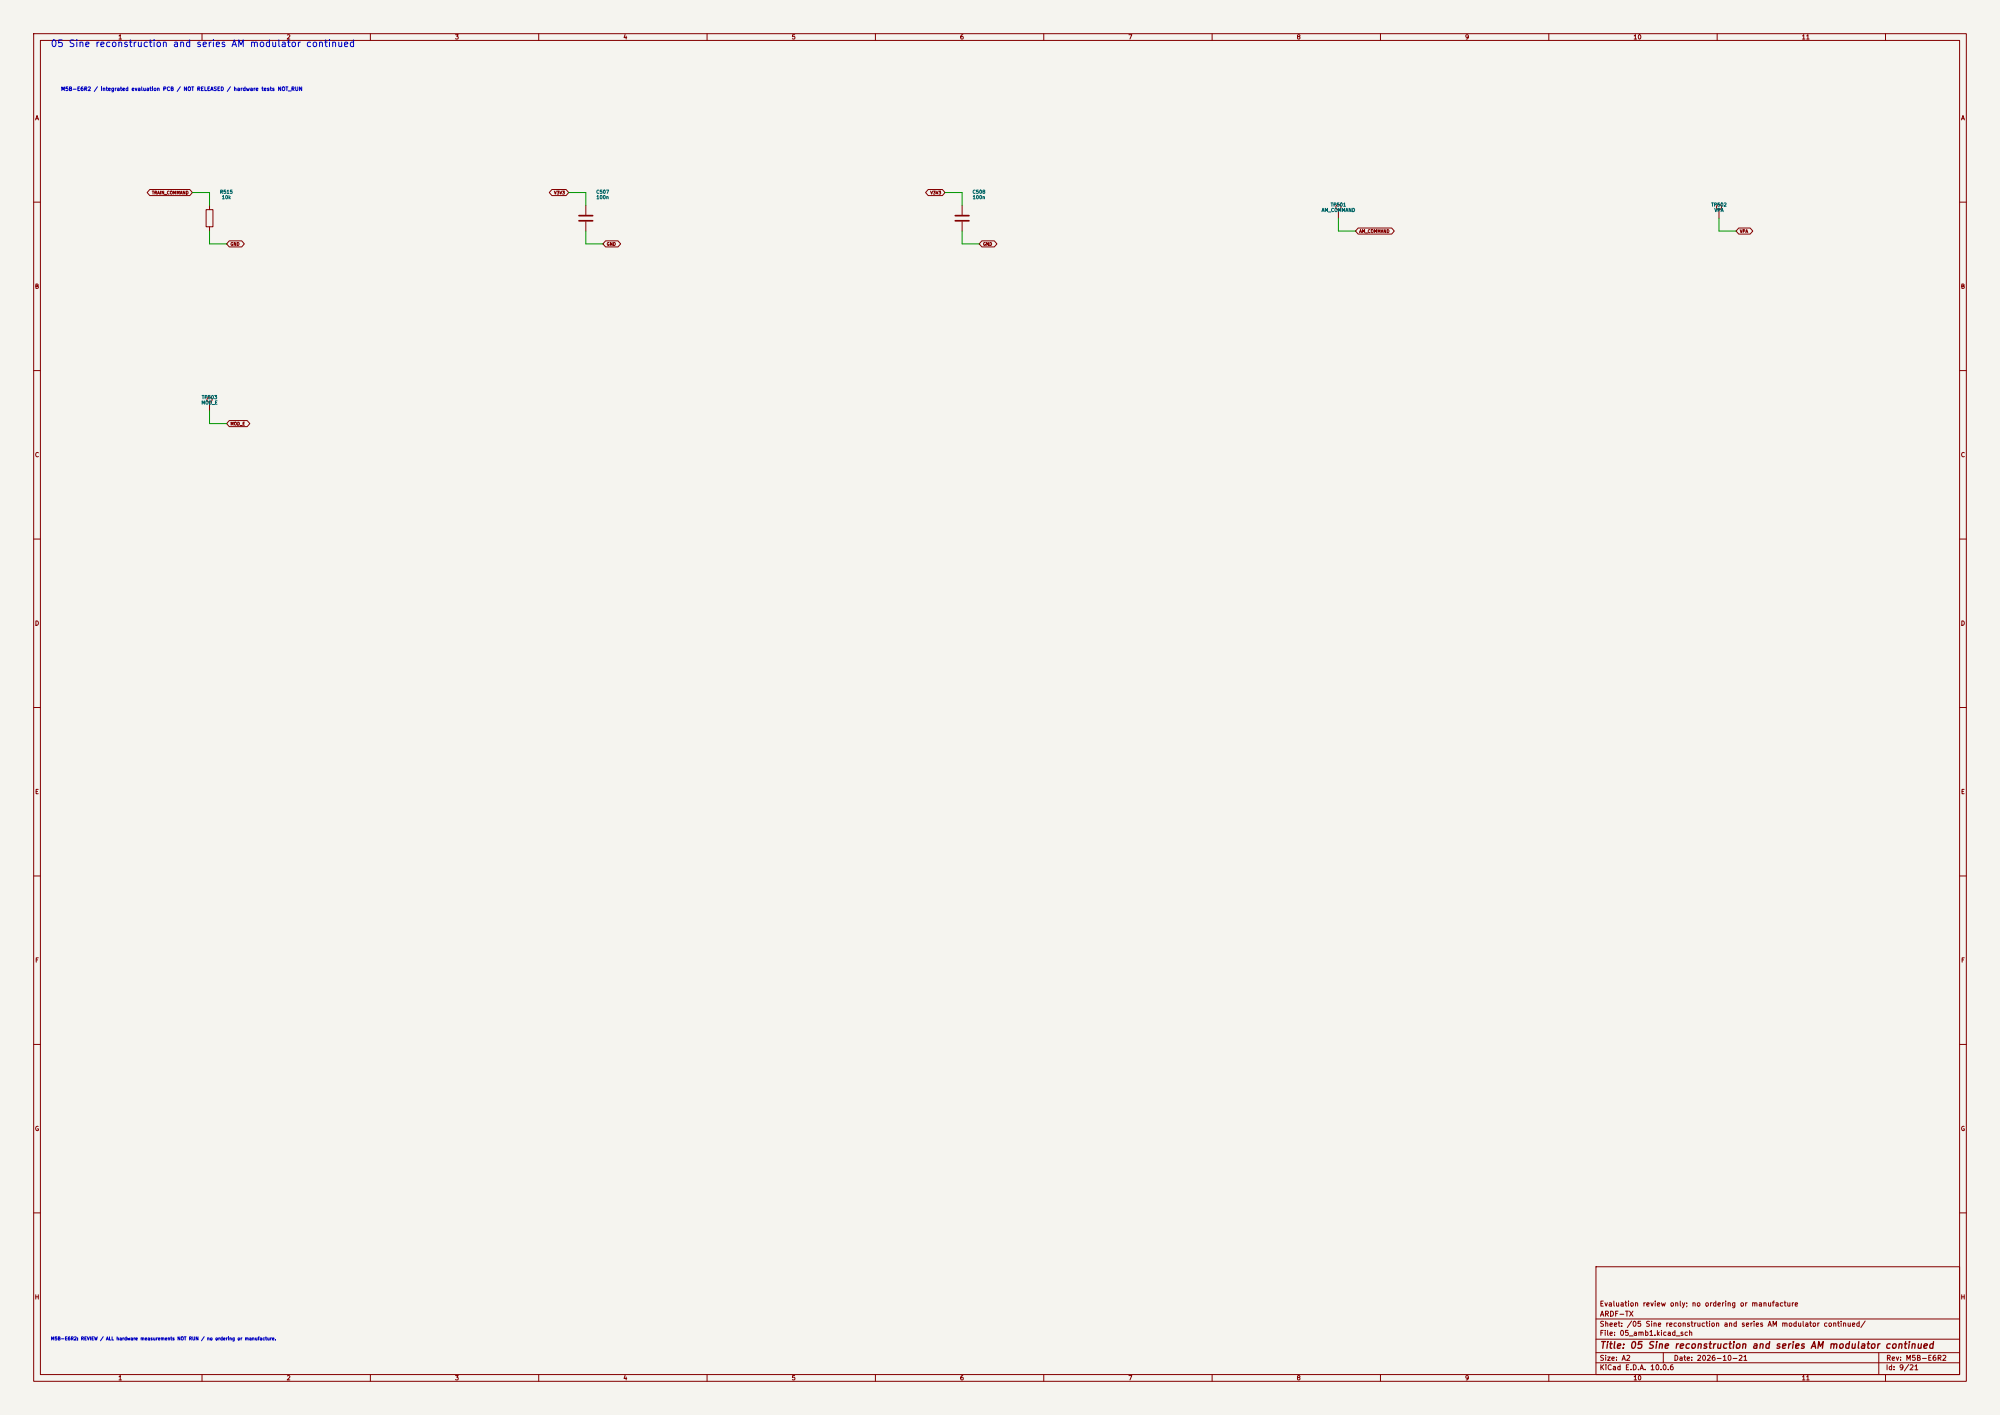
[picture p68: page 9]

Sheet: /05 Sine reconstruction and series AM modulator continued/
File: 05_amb1.kicad_sch
Title: 05 Sine reconstruction and series AM modulator continued

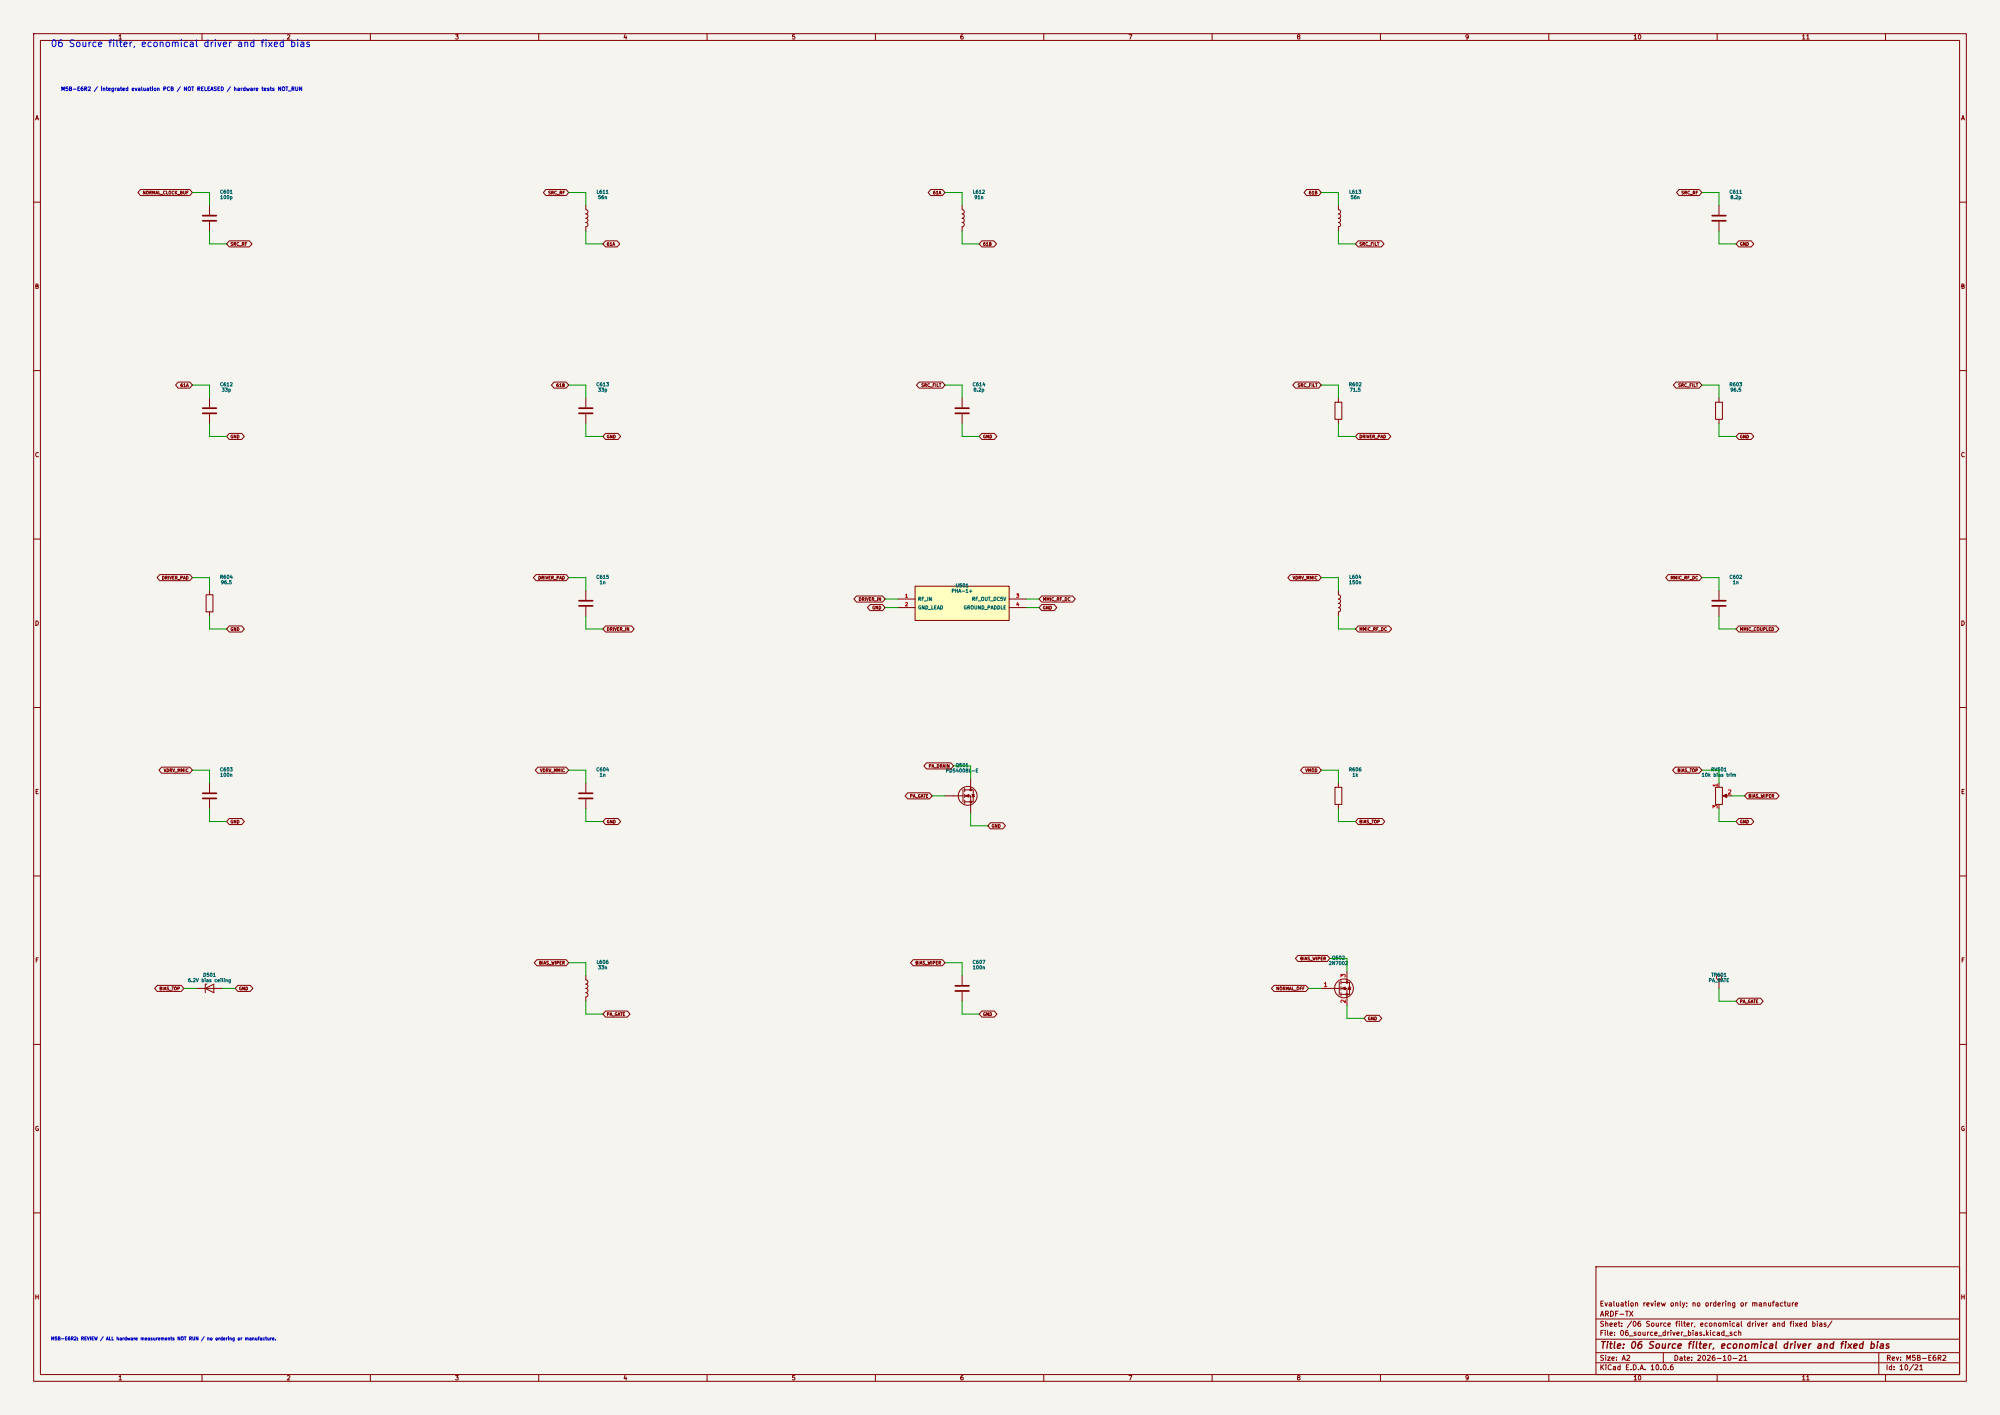
[picture p69: page 10]

06 Source filter, economical driver and fixed bias

Sheet: /06 Source filter, economical driver and fixed bias/
File: 06_source_driver_bias.kicad_sch
Title: 06 Source filter, economical driver and fixed bias

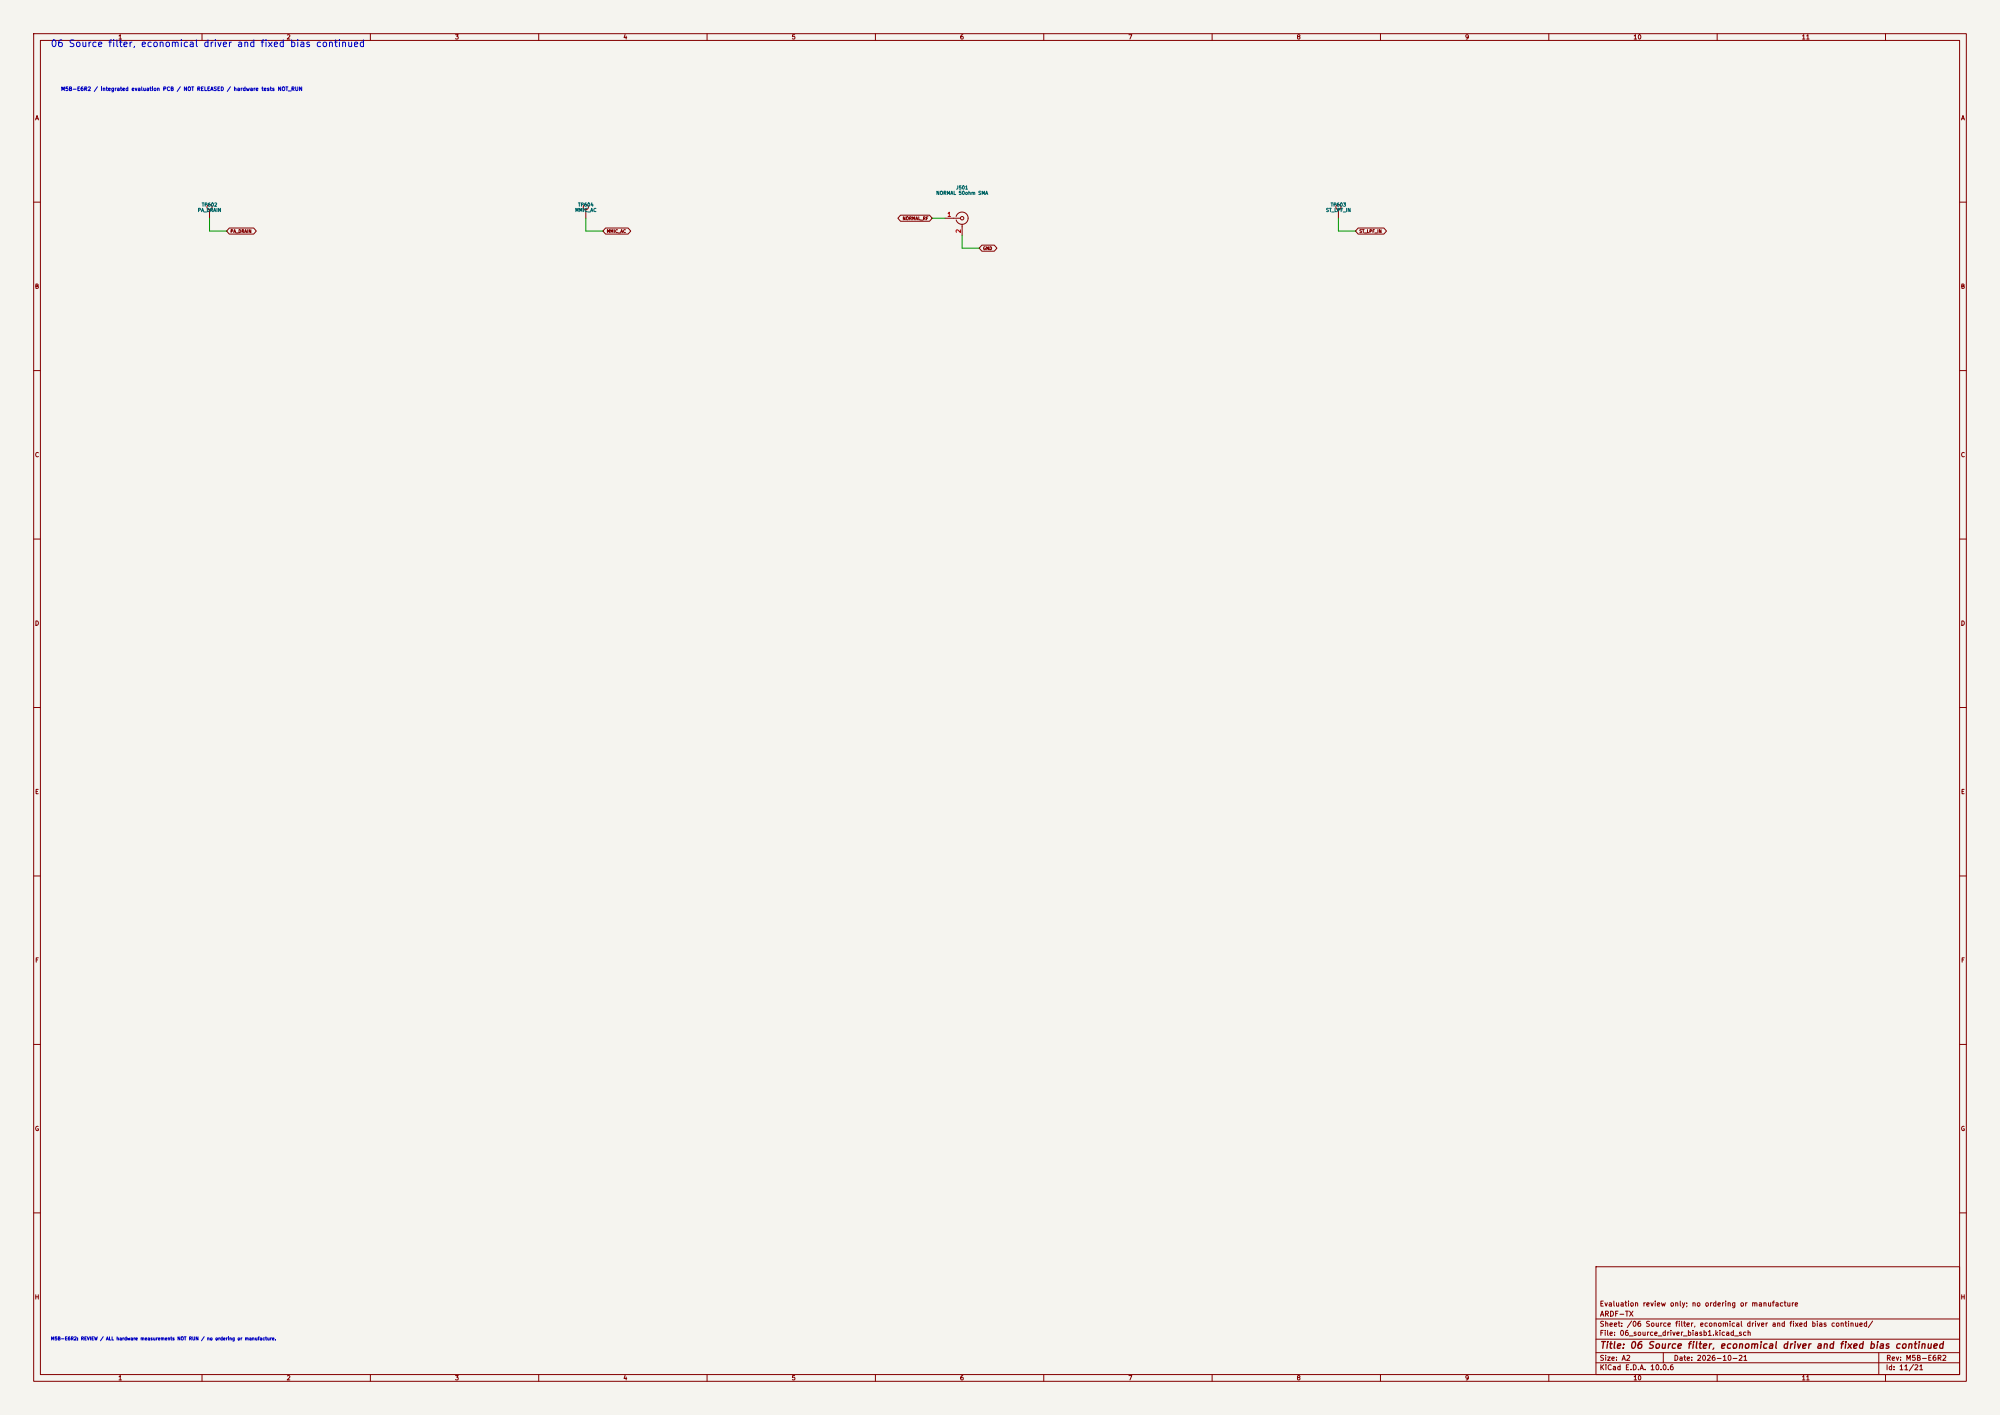
[picture p70: page 11]

GND NORMAL_RF 06 Source filter, economical driver and fixed bias continued

Sheet: /06 Source filter, economical driver and fixed bias continued/
File: 06_source_driver_biasb1.kicad_sch
Title: 06 Source filter, economical driver and fixed bias continued

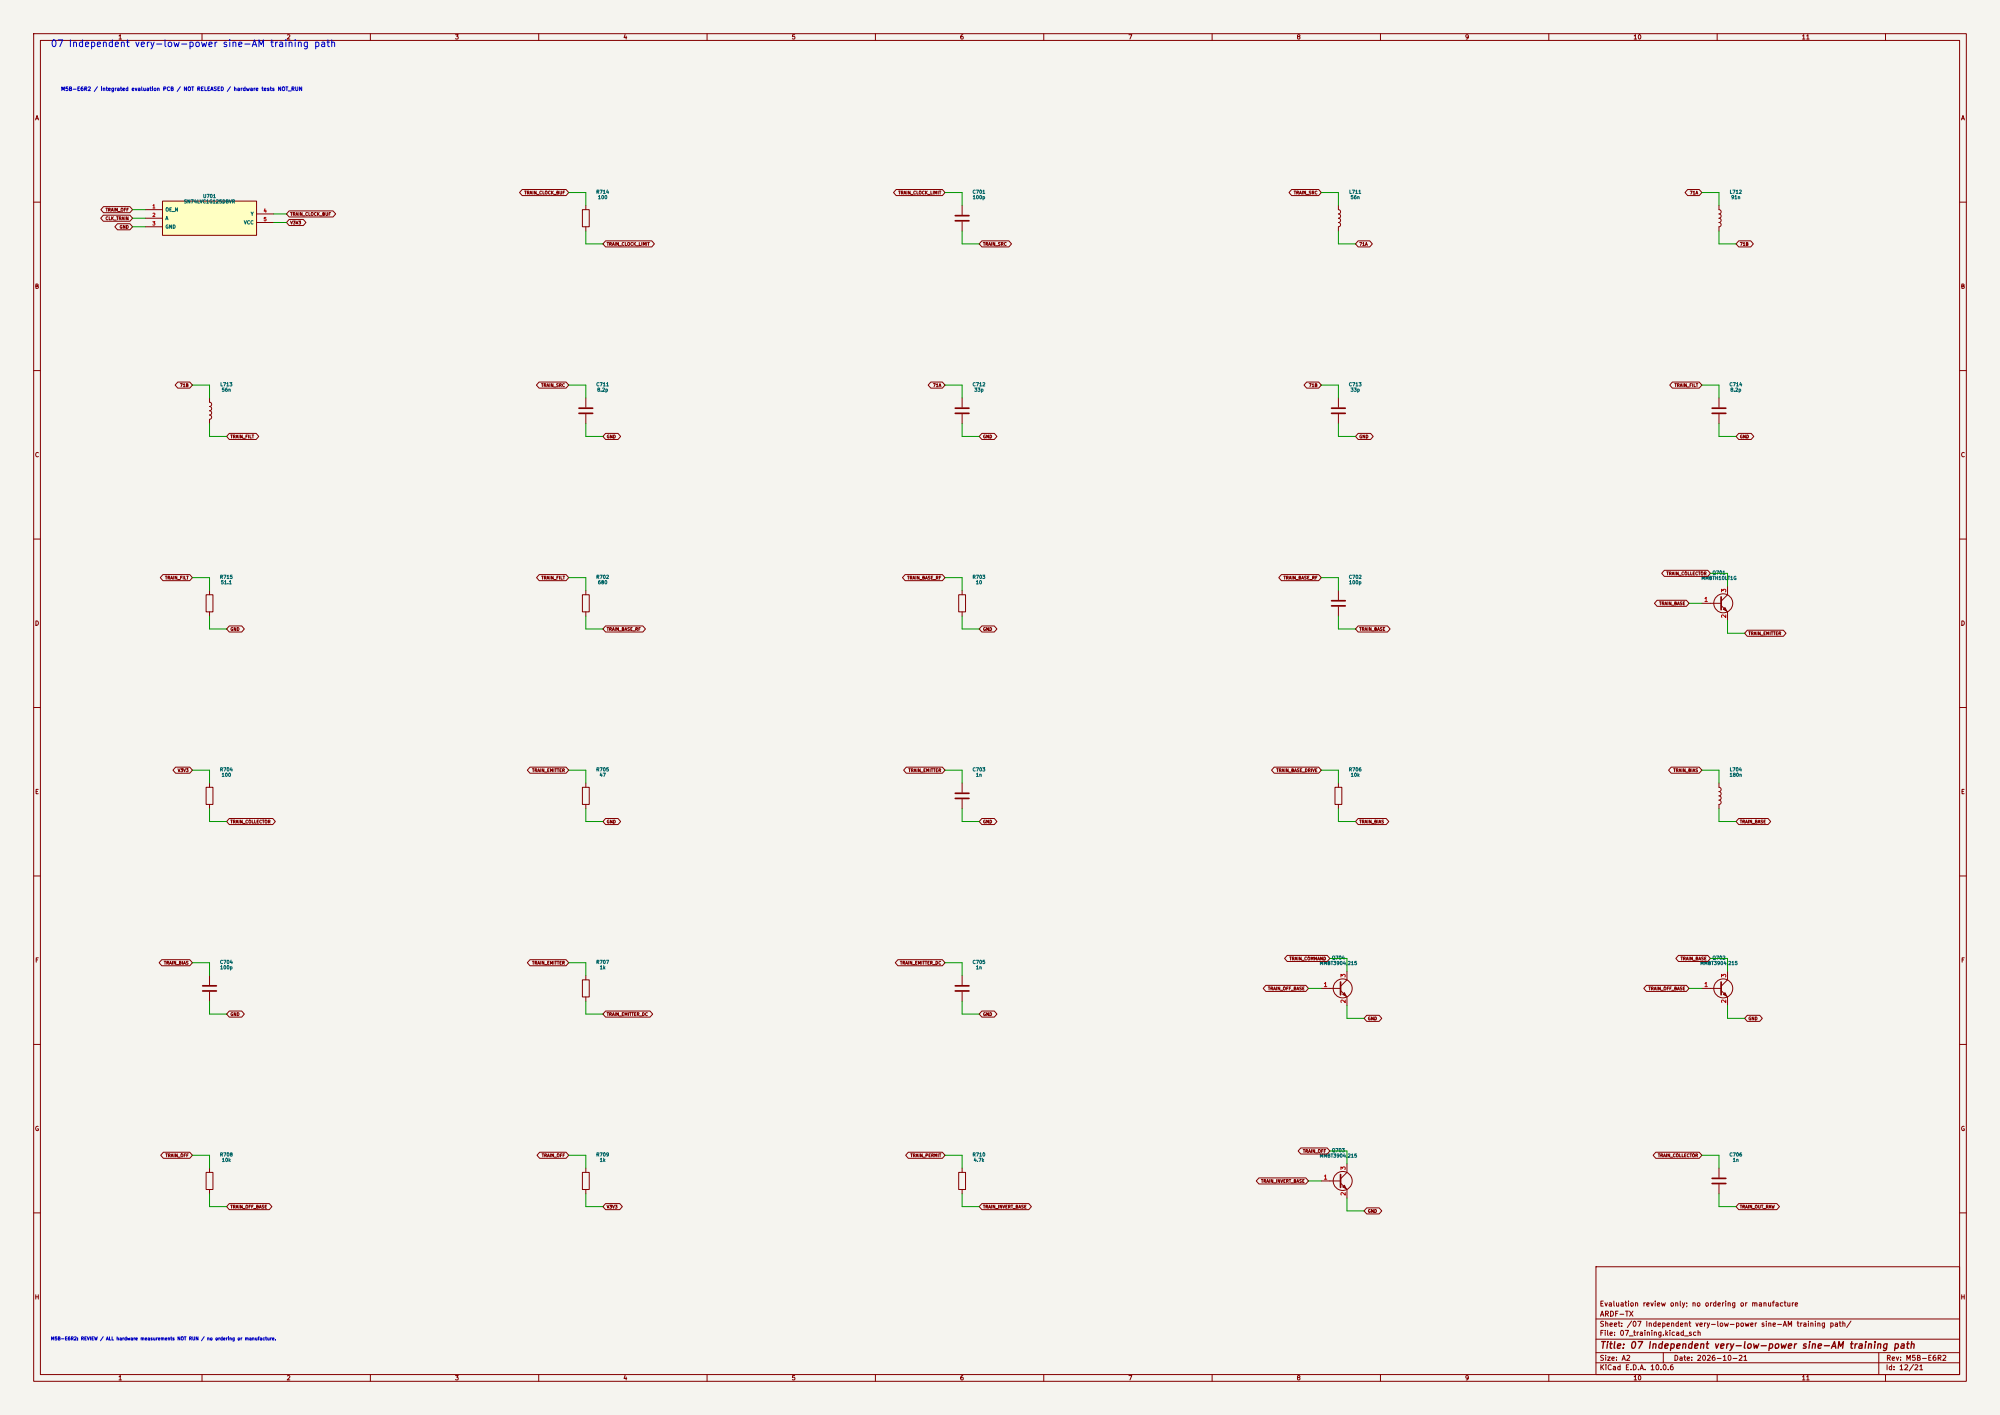
[picture p71: page 12]

07 Independent very-low-power sine-AM training path

Sheet: /07 Independent very-low-power sine-AM training path/
File: 07_training.kicad_sch
Title: 07 Independent very-low-power sine-AM training path

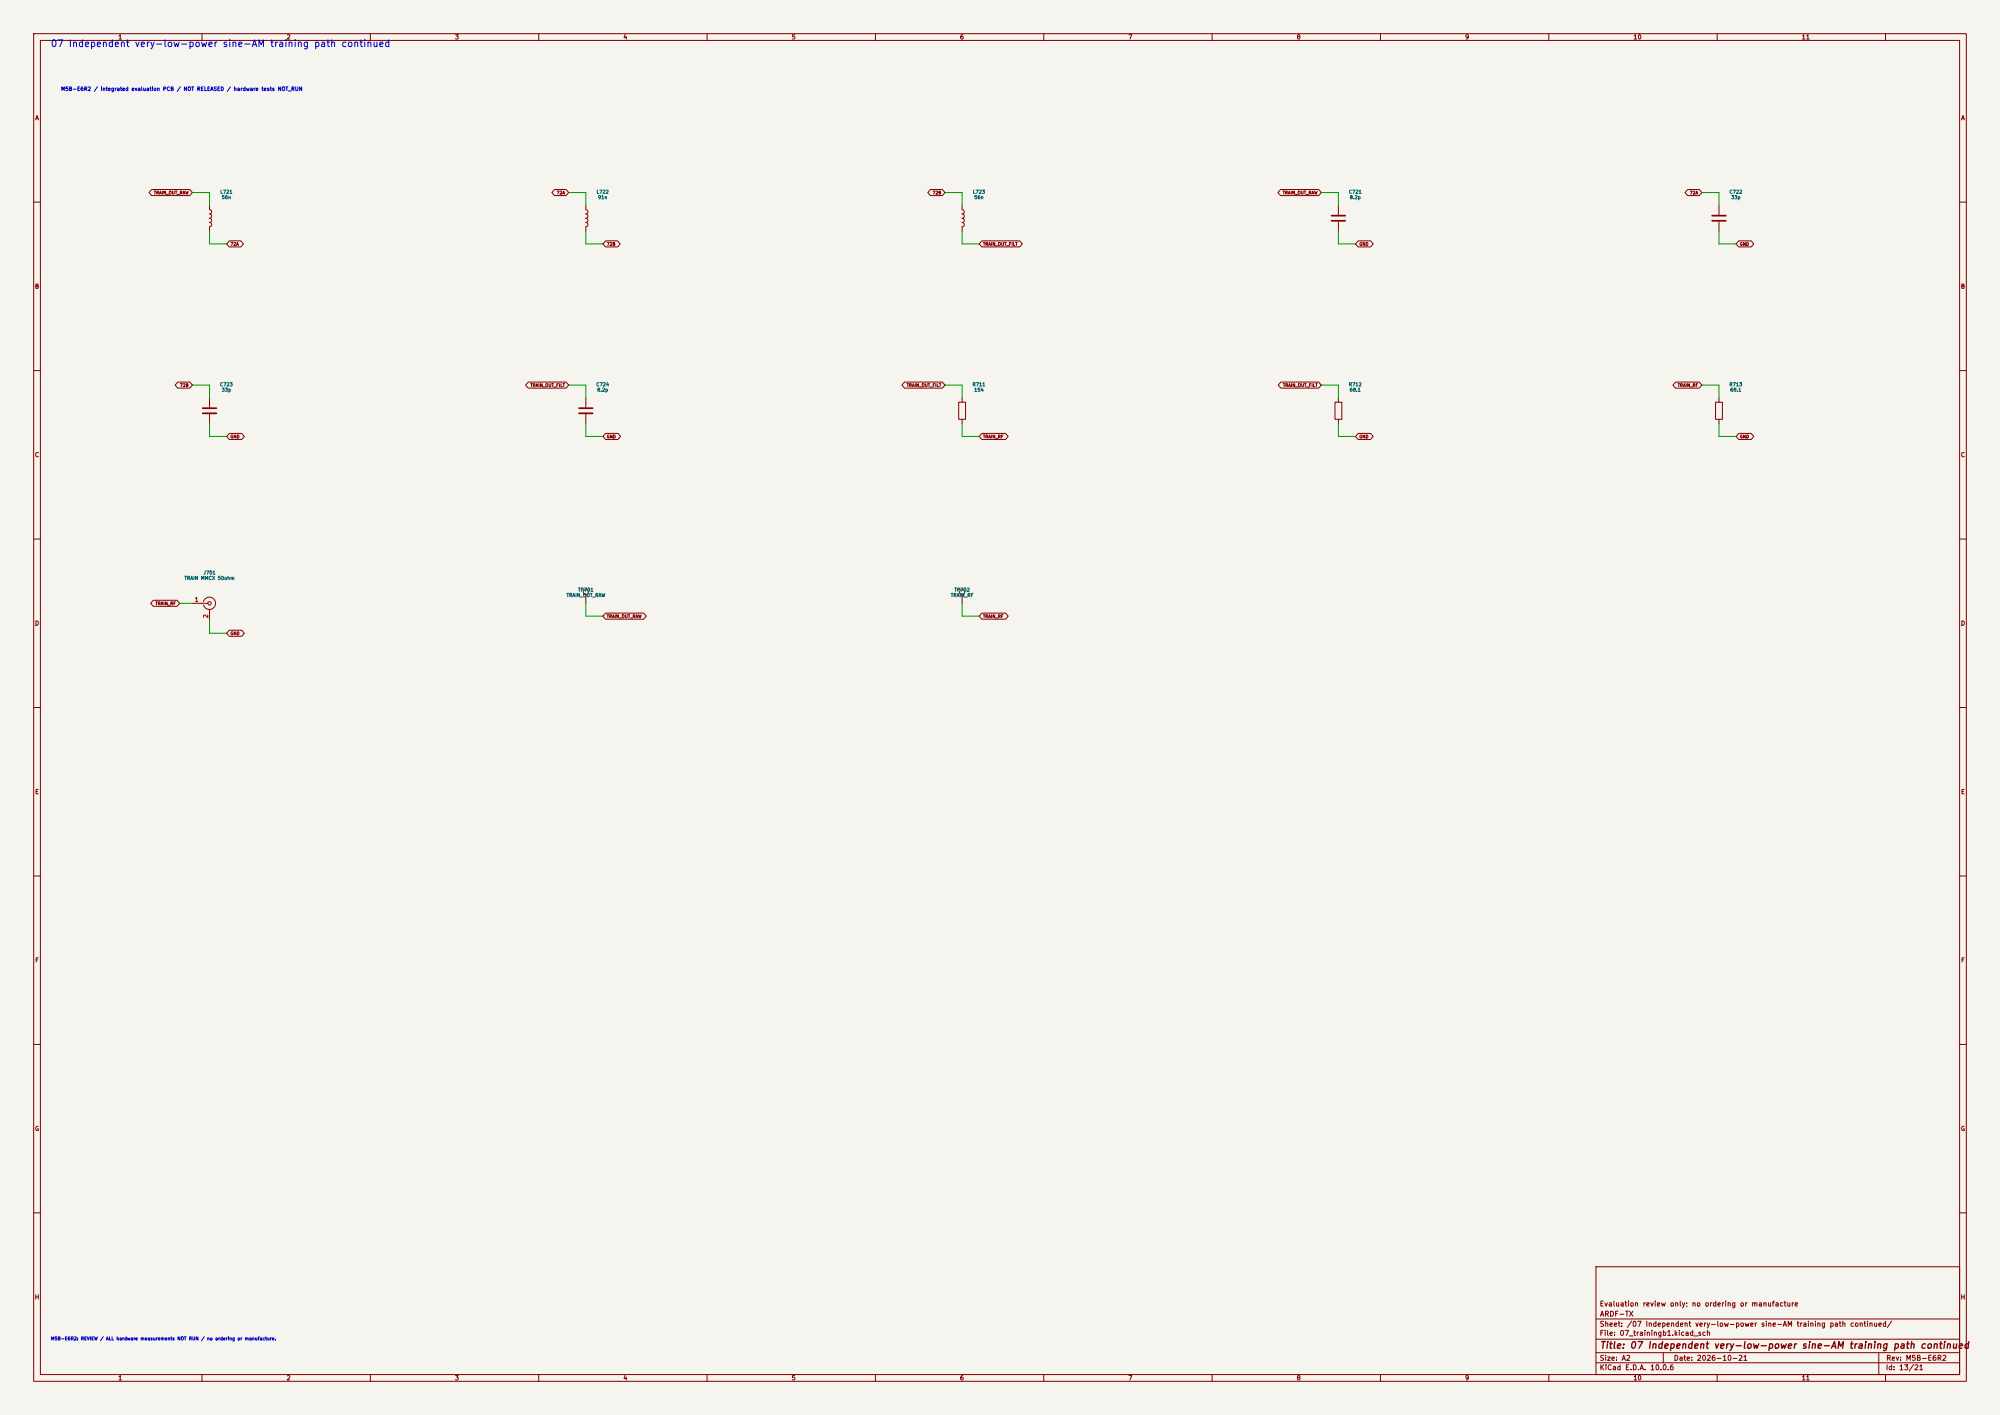
[picture p72: page 13]

07 Independent very-low-power sine-AM training path continued

Sheet: /07 Independent very-low-power sine-AM training path continued/
File: 07_trainingb1.kicad_sch
Title: 07 Independent very-low-power sine-AM training path continued

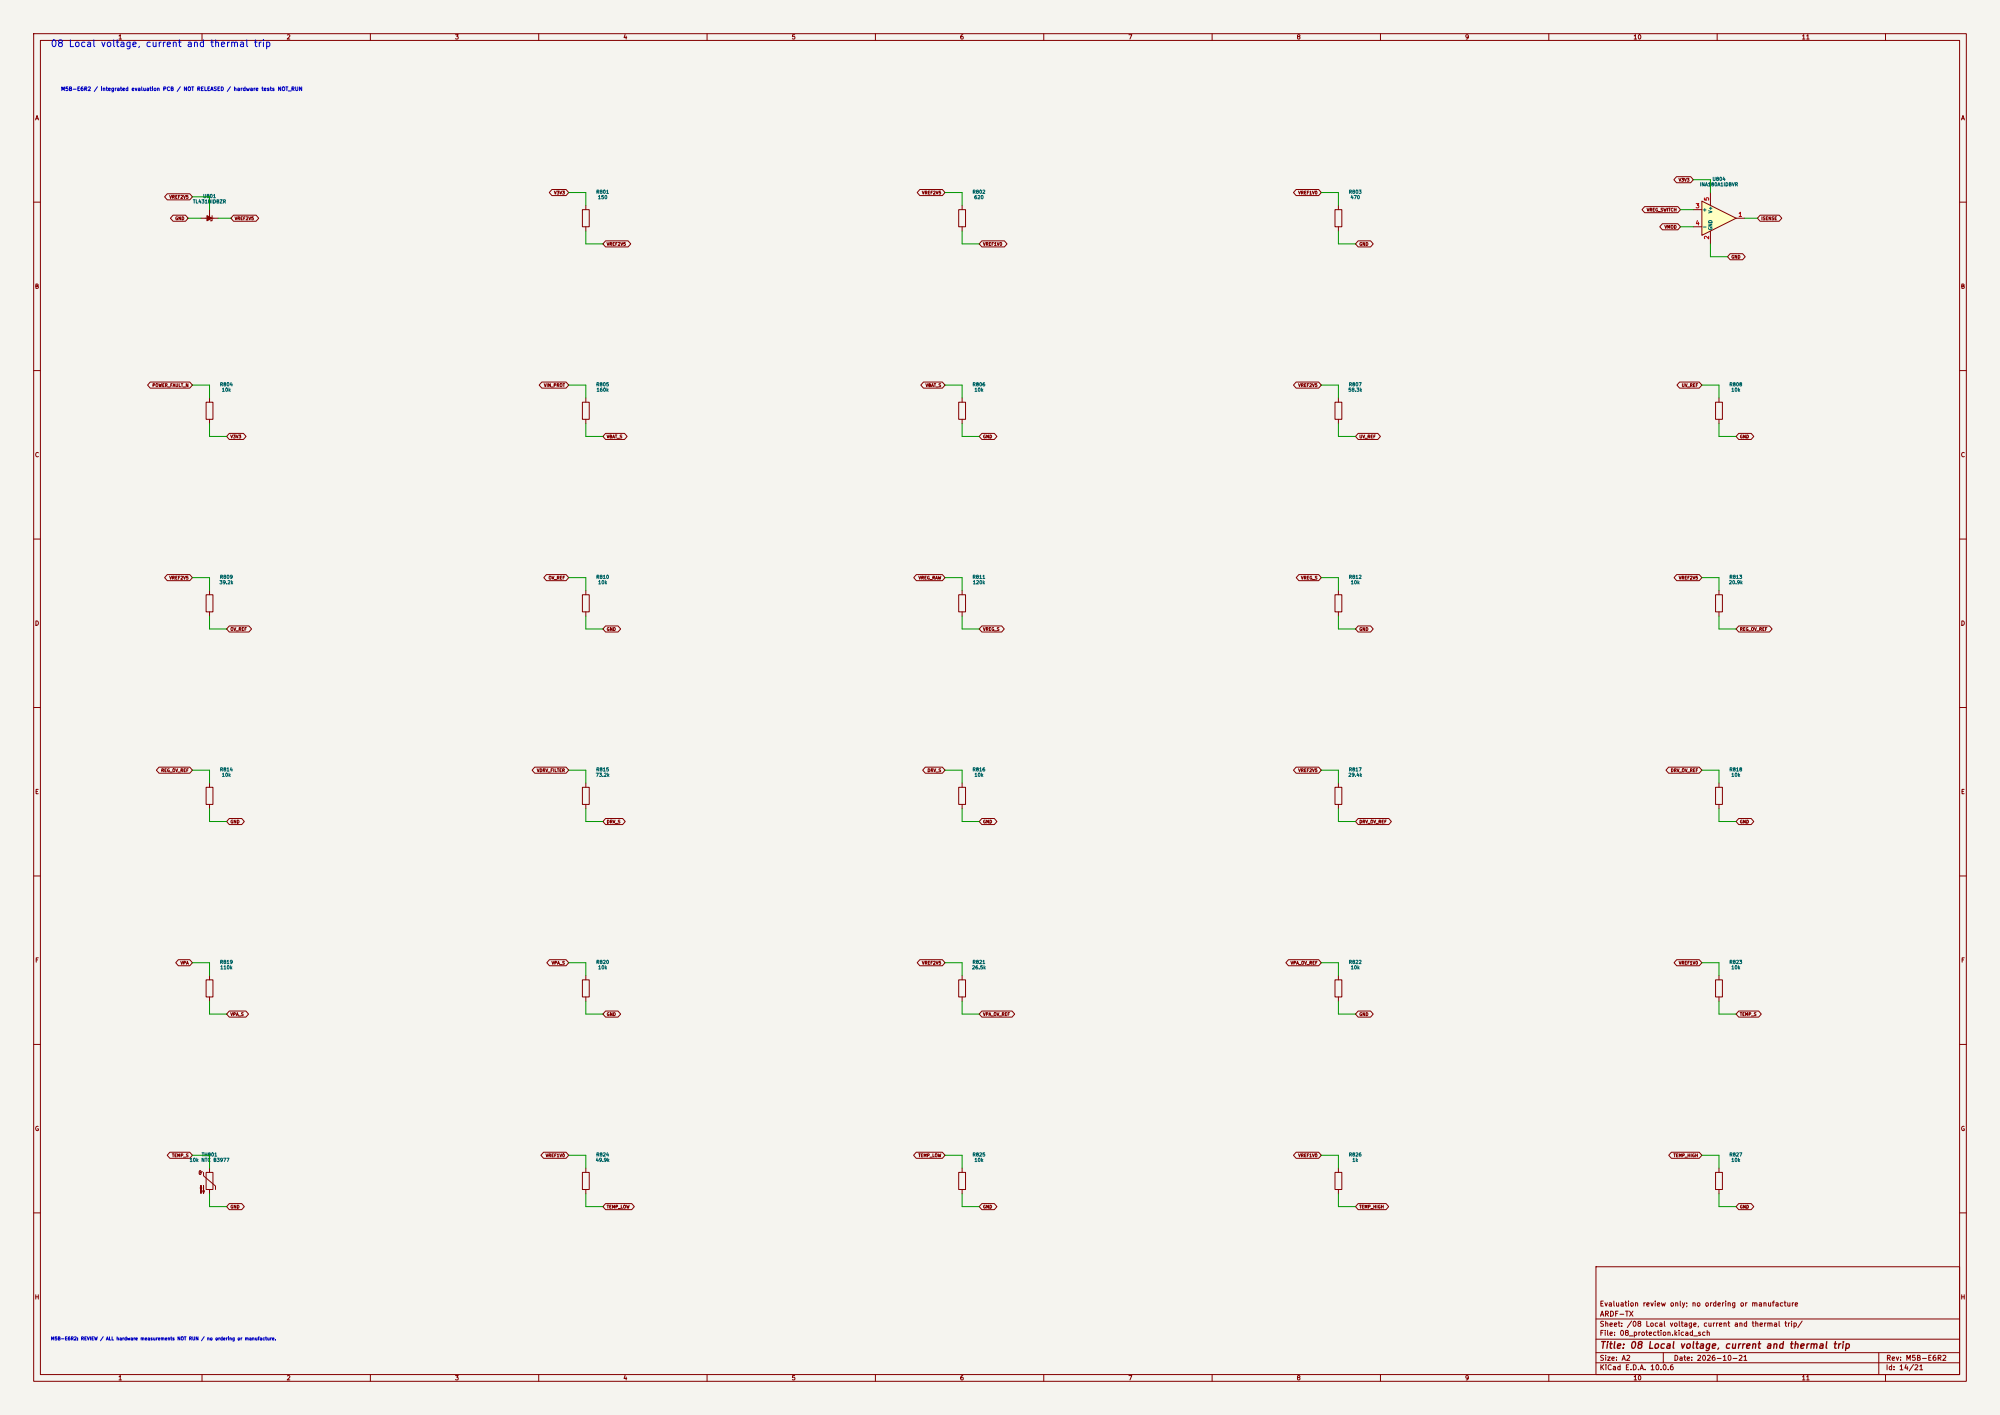
[picture p73: page 14]

08 Local voltage, current and thermal trip

Sheet: /08 Local voltage, current and thermal trip/
File: 08_protection.kicad_sch
Title: 08 Local voltage, current and thermal trip

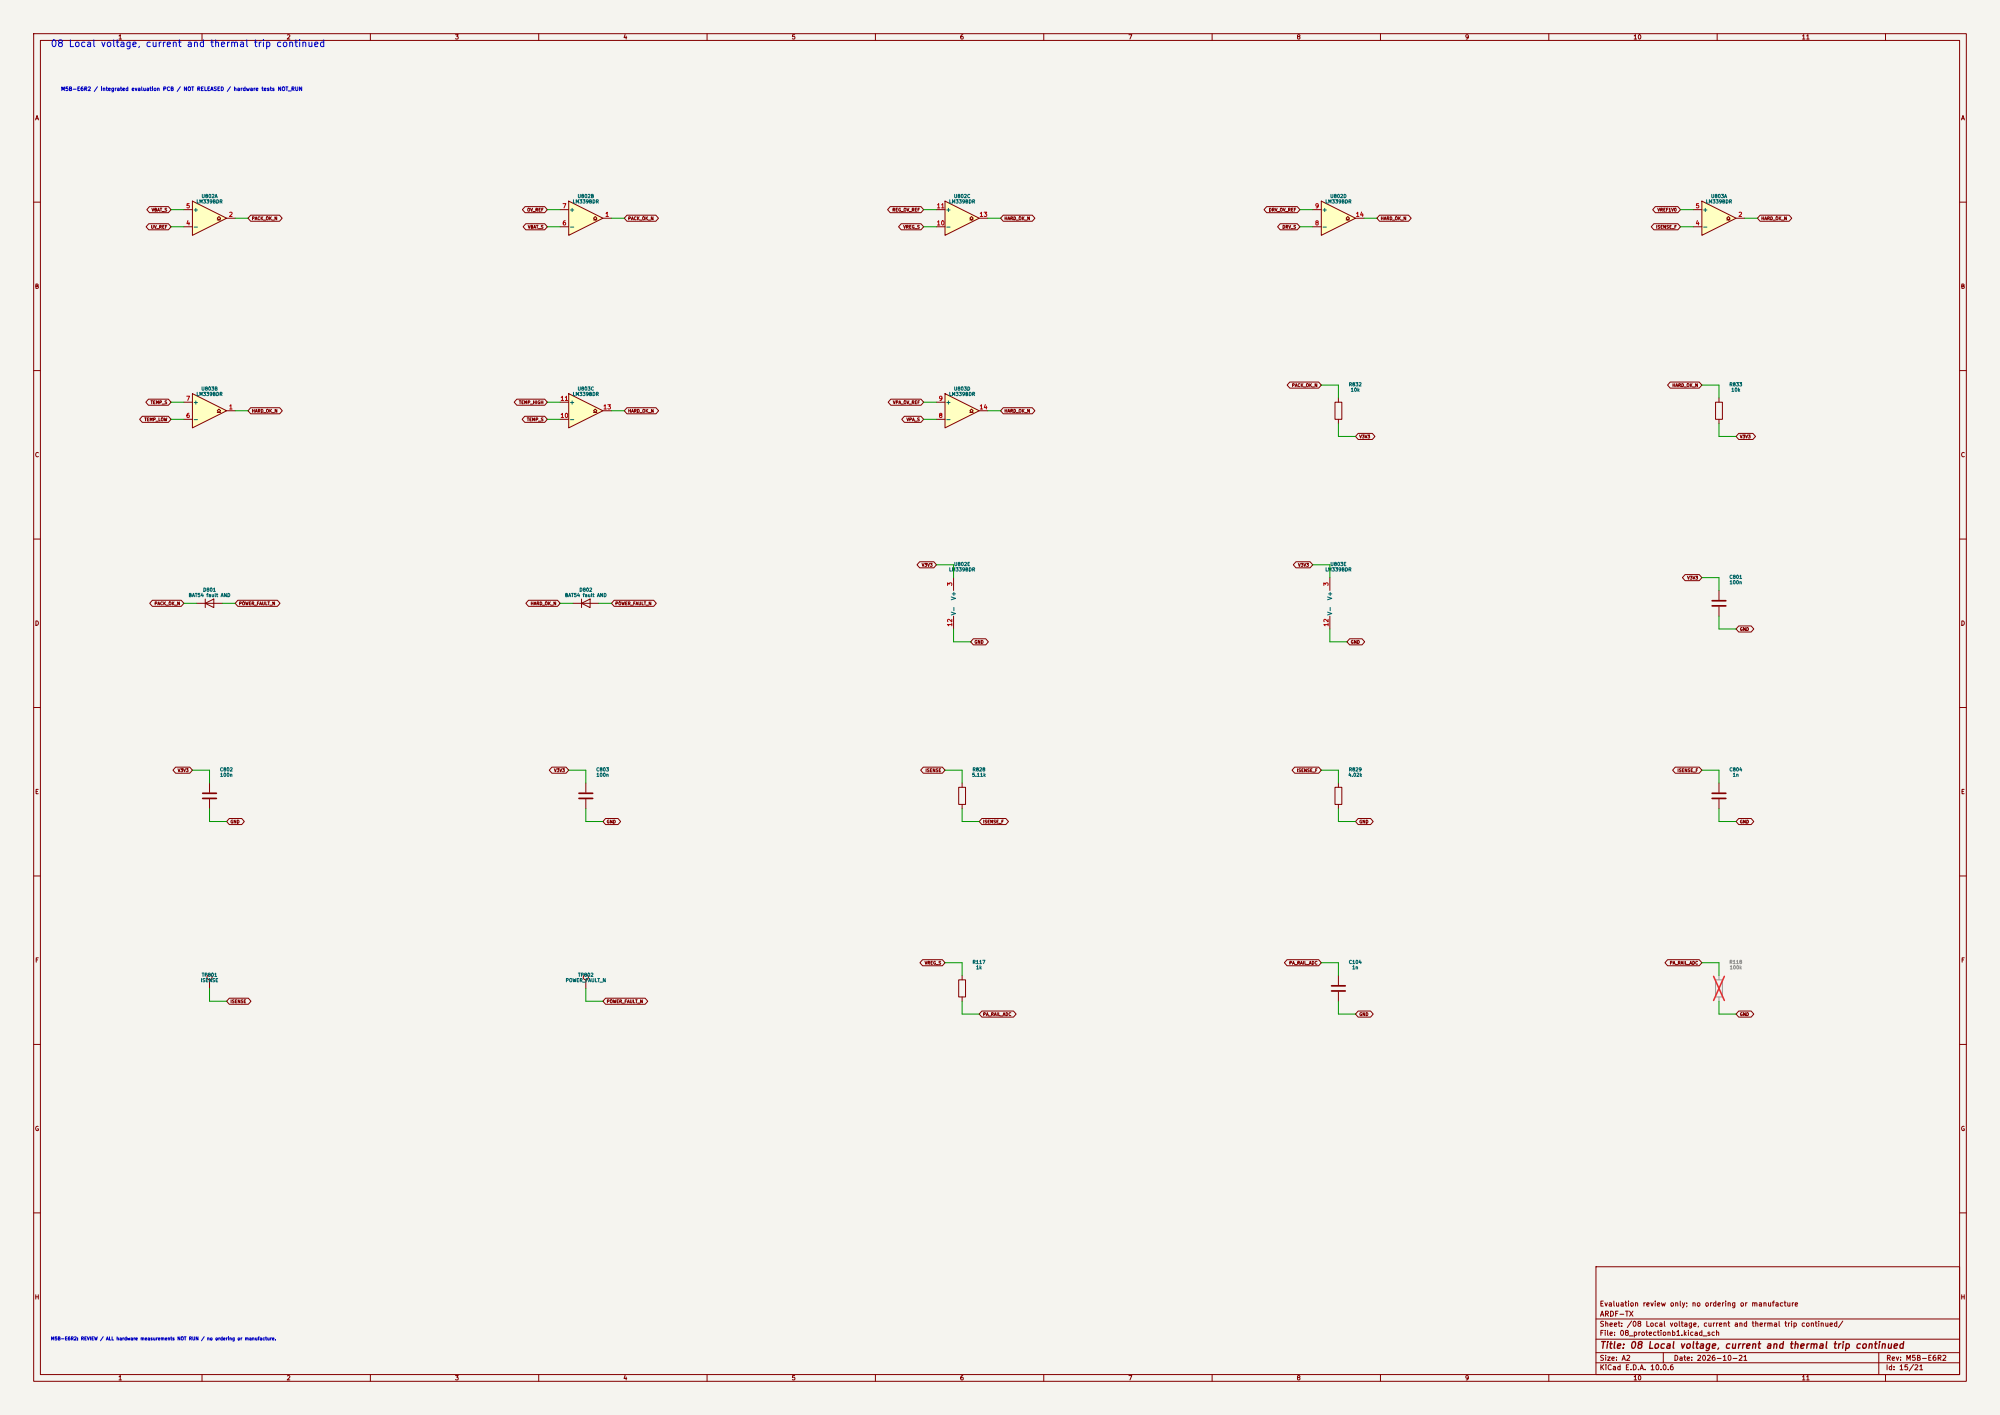
[picture p74: page 15]

V3V3 08 Local voltage, current and thermal trip continued

Sheet: /08 Local voltage, current and thermal trip continued/
File: 08_protectionb1.kicad_sch
Title: 08 Local voltage, current and thermal trip continued

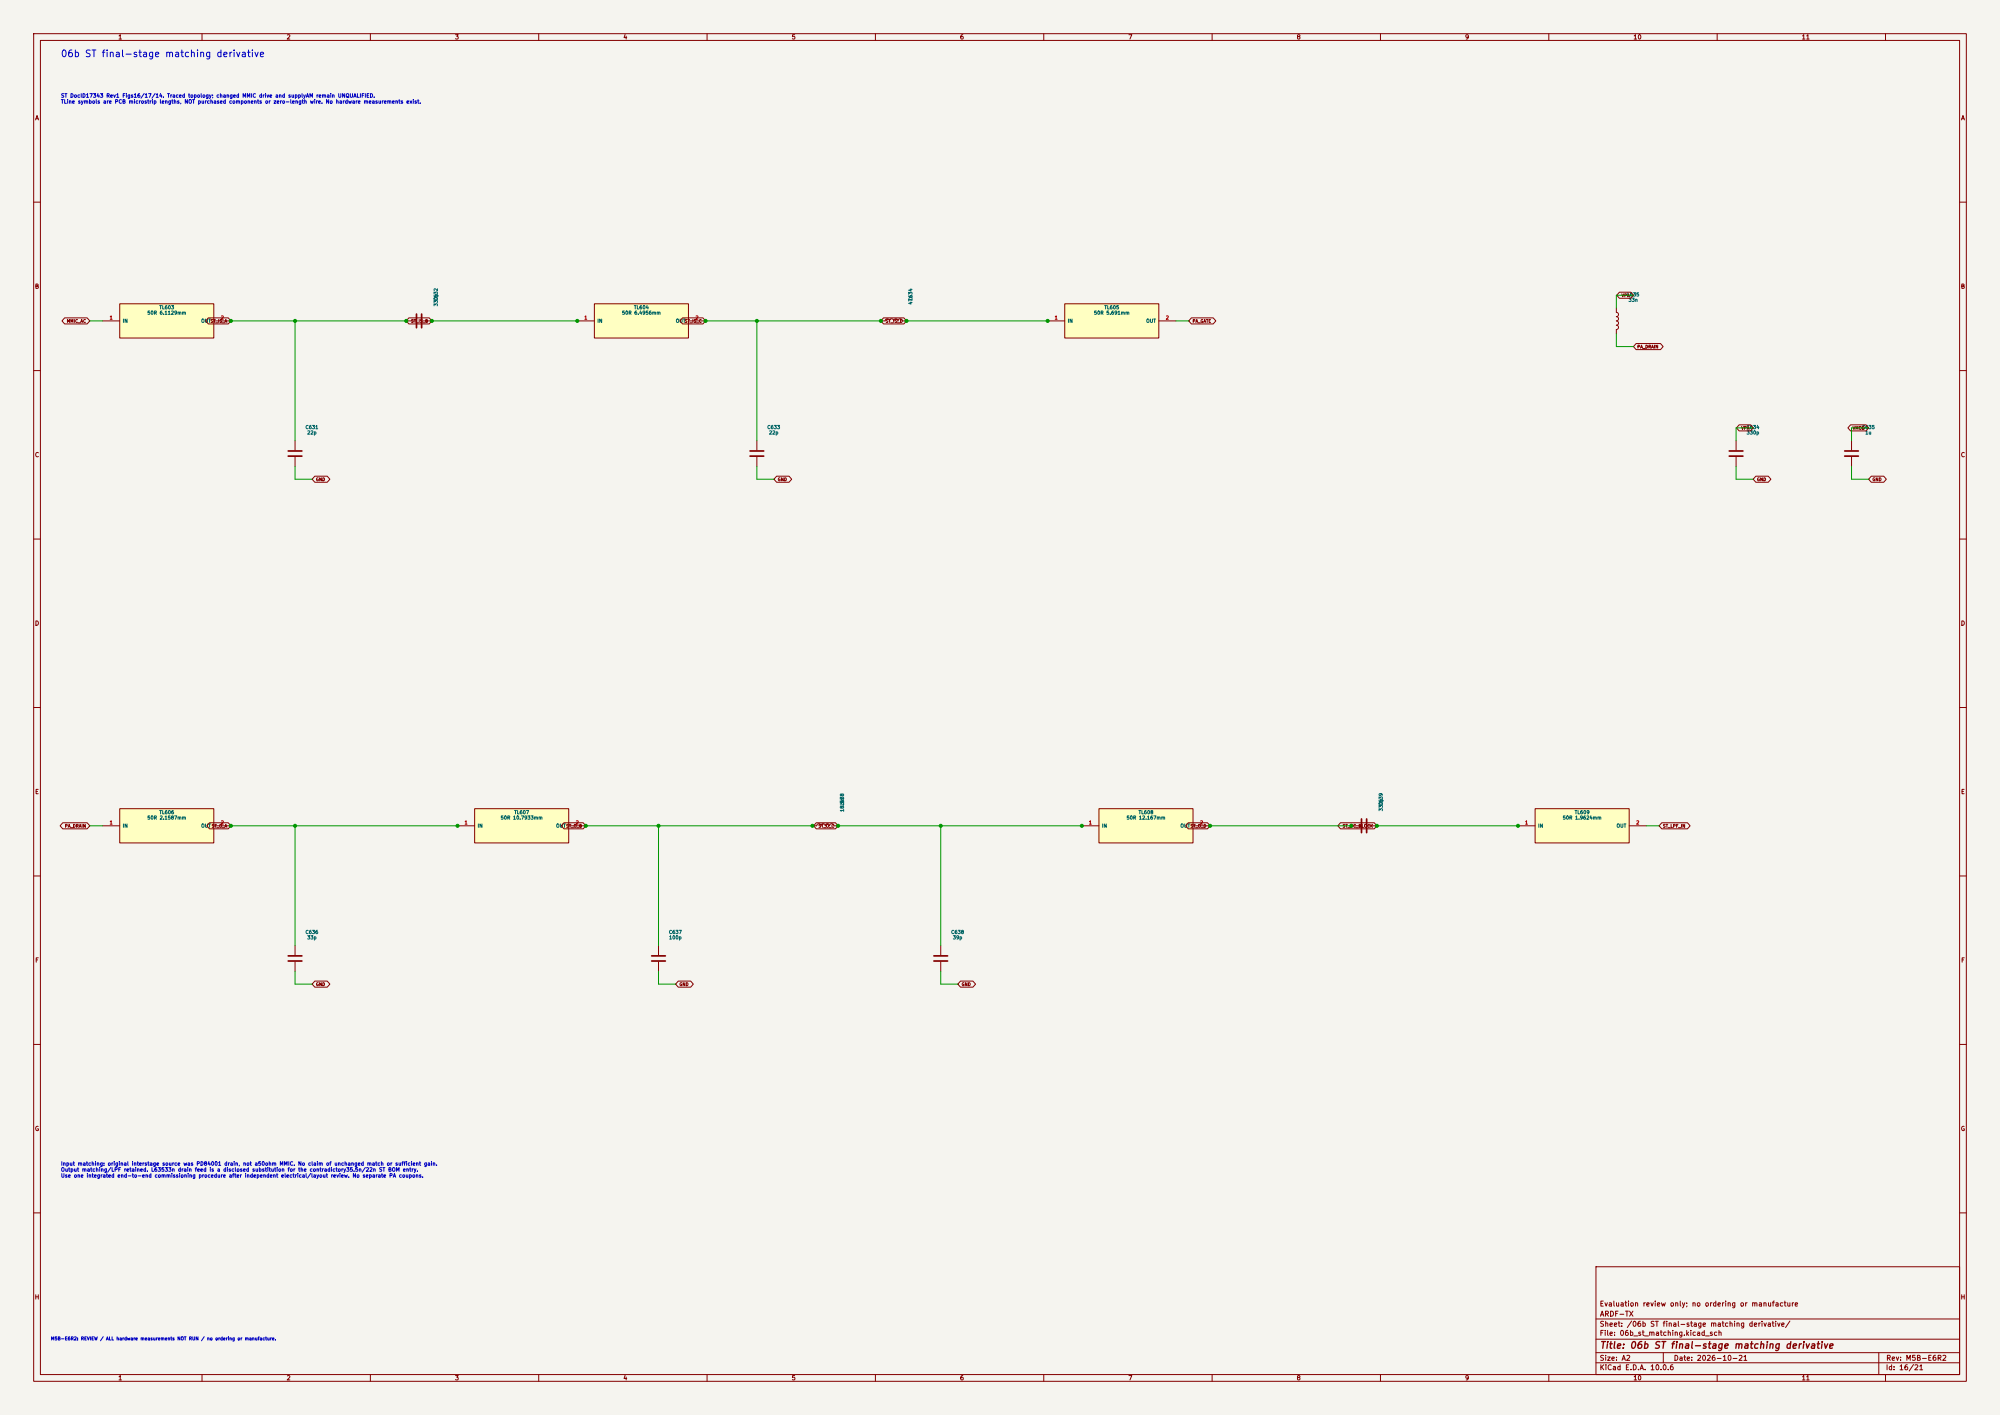
[picture p75: page 16]

06b ST final-stage matching derivative

ST DocID17343 Rev1 Figs16/17/14. Traced topology; changed MMIC drive and supplyAM remain UNQUALIFIED. TLine symbols are PCB microstrip lengths, NOT purchased components or zero-length wire. No hardware measurements exist.

Evaluation review only; no ordering or manufacture C639 330p

Input matching: original interstage source was PD84001 drain, not a50ohm MMIC. No claim of unchanged match or sufficient gain.
Output matching/LPF retained. L63533n drain feed is a disclosed substitution for the contradictory35.5n/22n ST BOM entry. Use one integrated end-to-end commissioning procedure after independent electrical/layout review. No separate PA coupons. M5B-E6R2: REVIEW / ALL hardware measurements NOT RUN / no ordering or manufacture.

Sheet: /06b ST final-stage matching derivative/
File: 06b_st_matching.kicad_sch
Title: 06b ST final-stage matching derivative

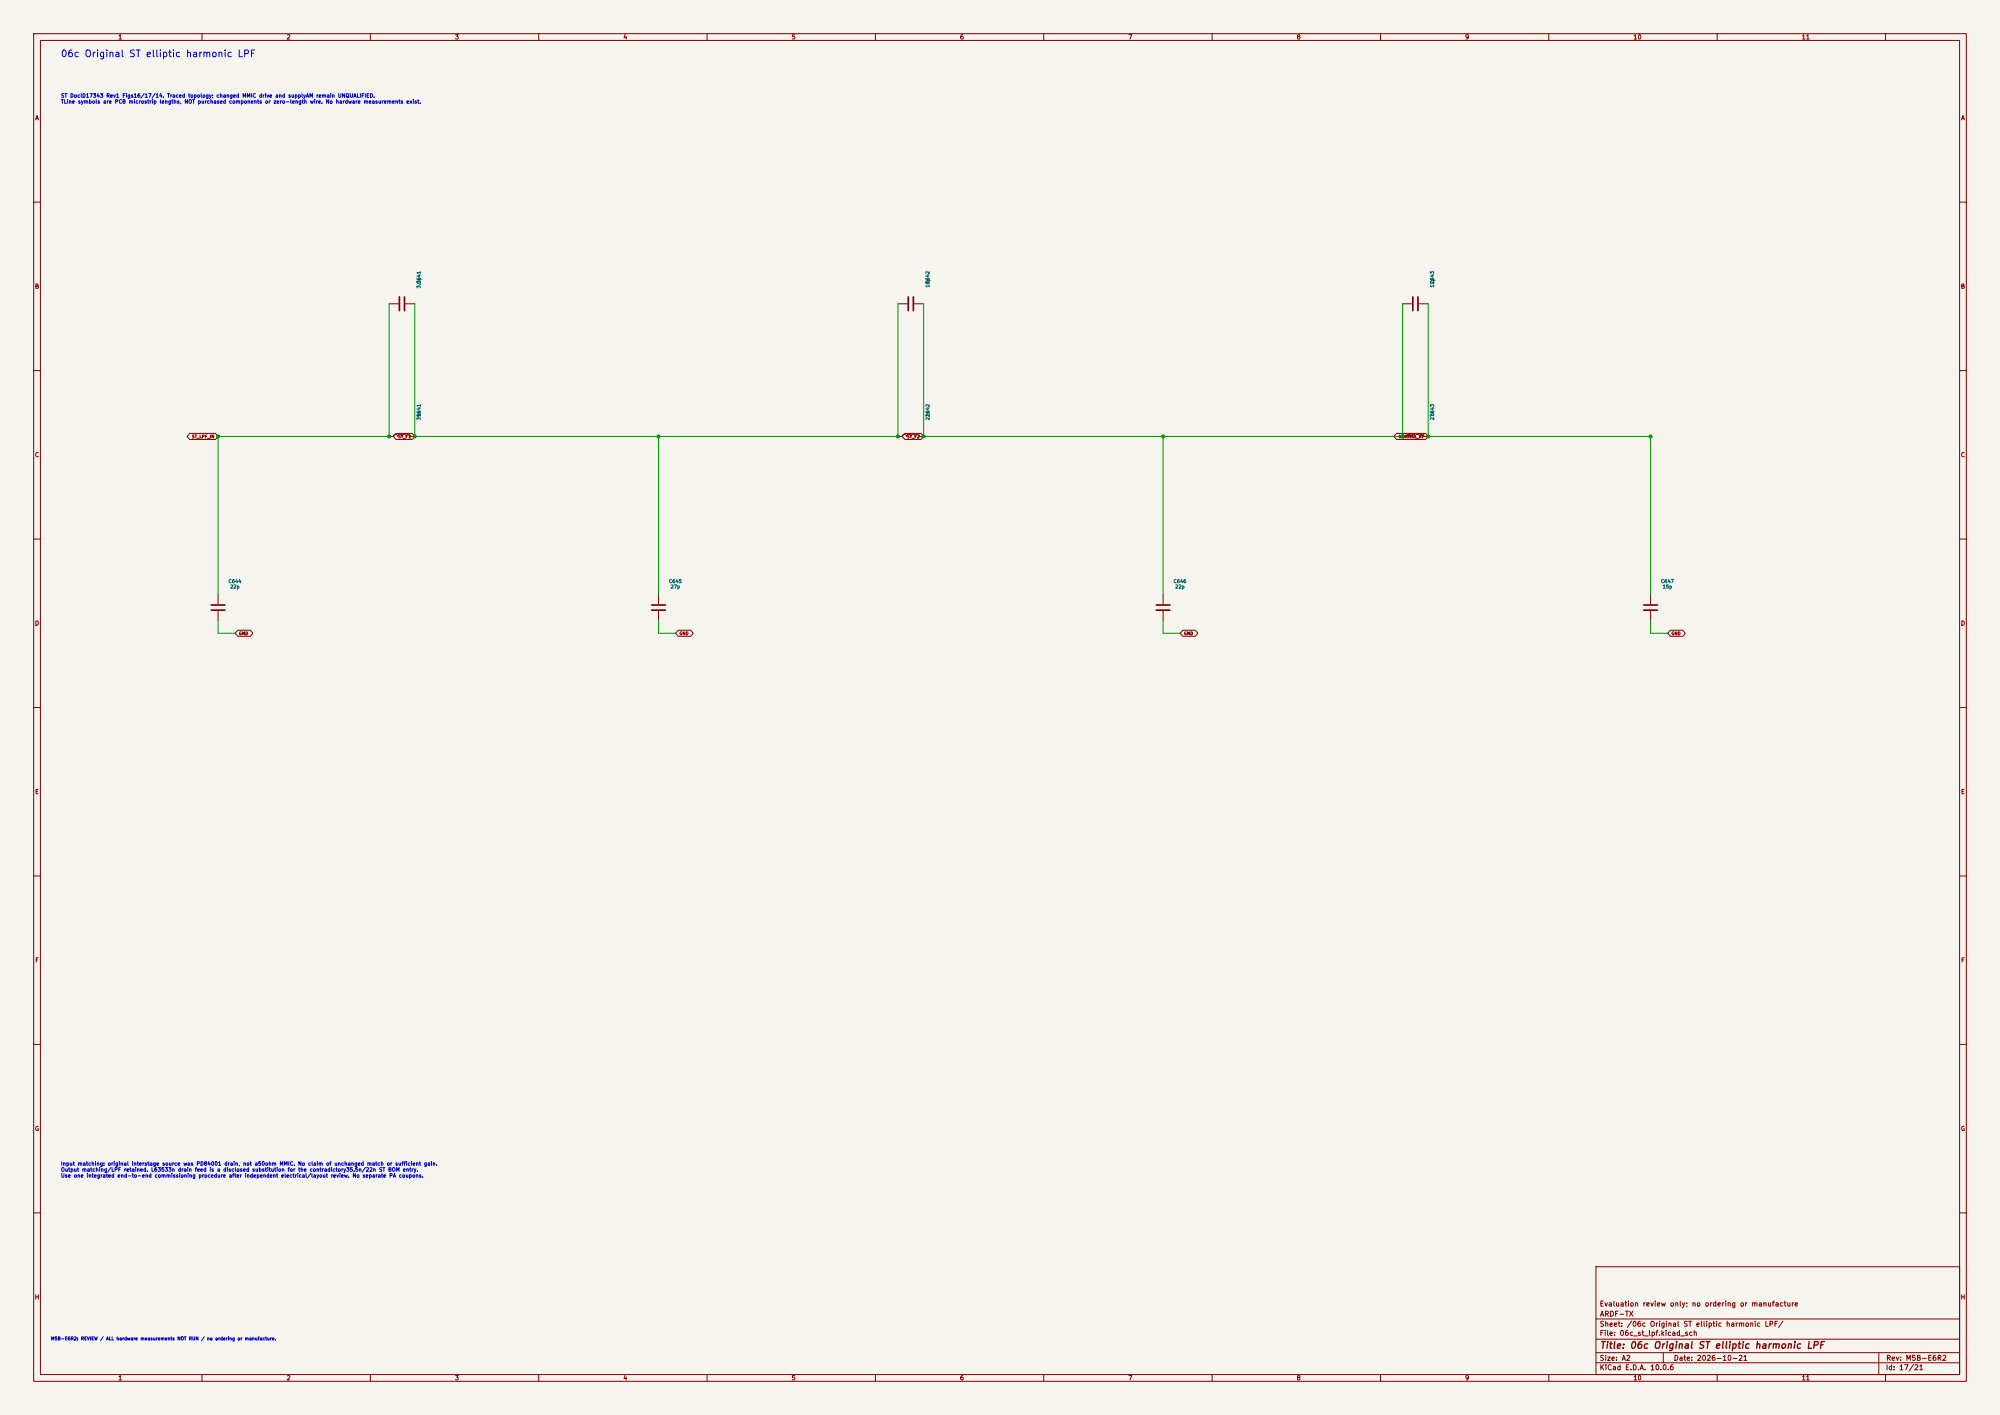
[picture p76: page 17]
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

Sheet: /06c Original ST elliptic harmonic LPF/
File: 06c_st_lpf.kicad_sch
Title: 06c Original ST elliptic harmonic LPF

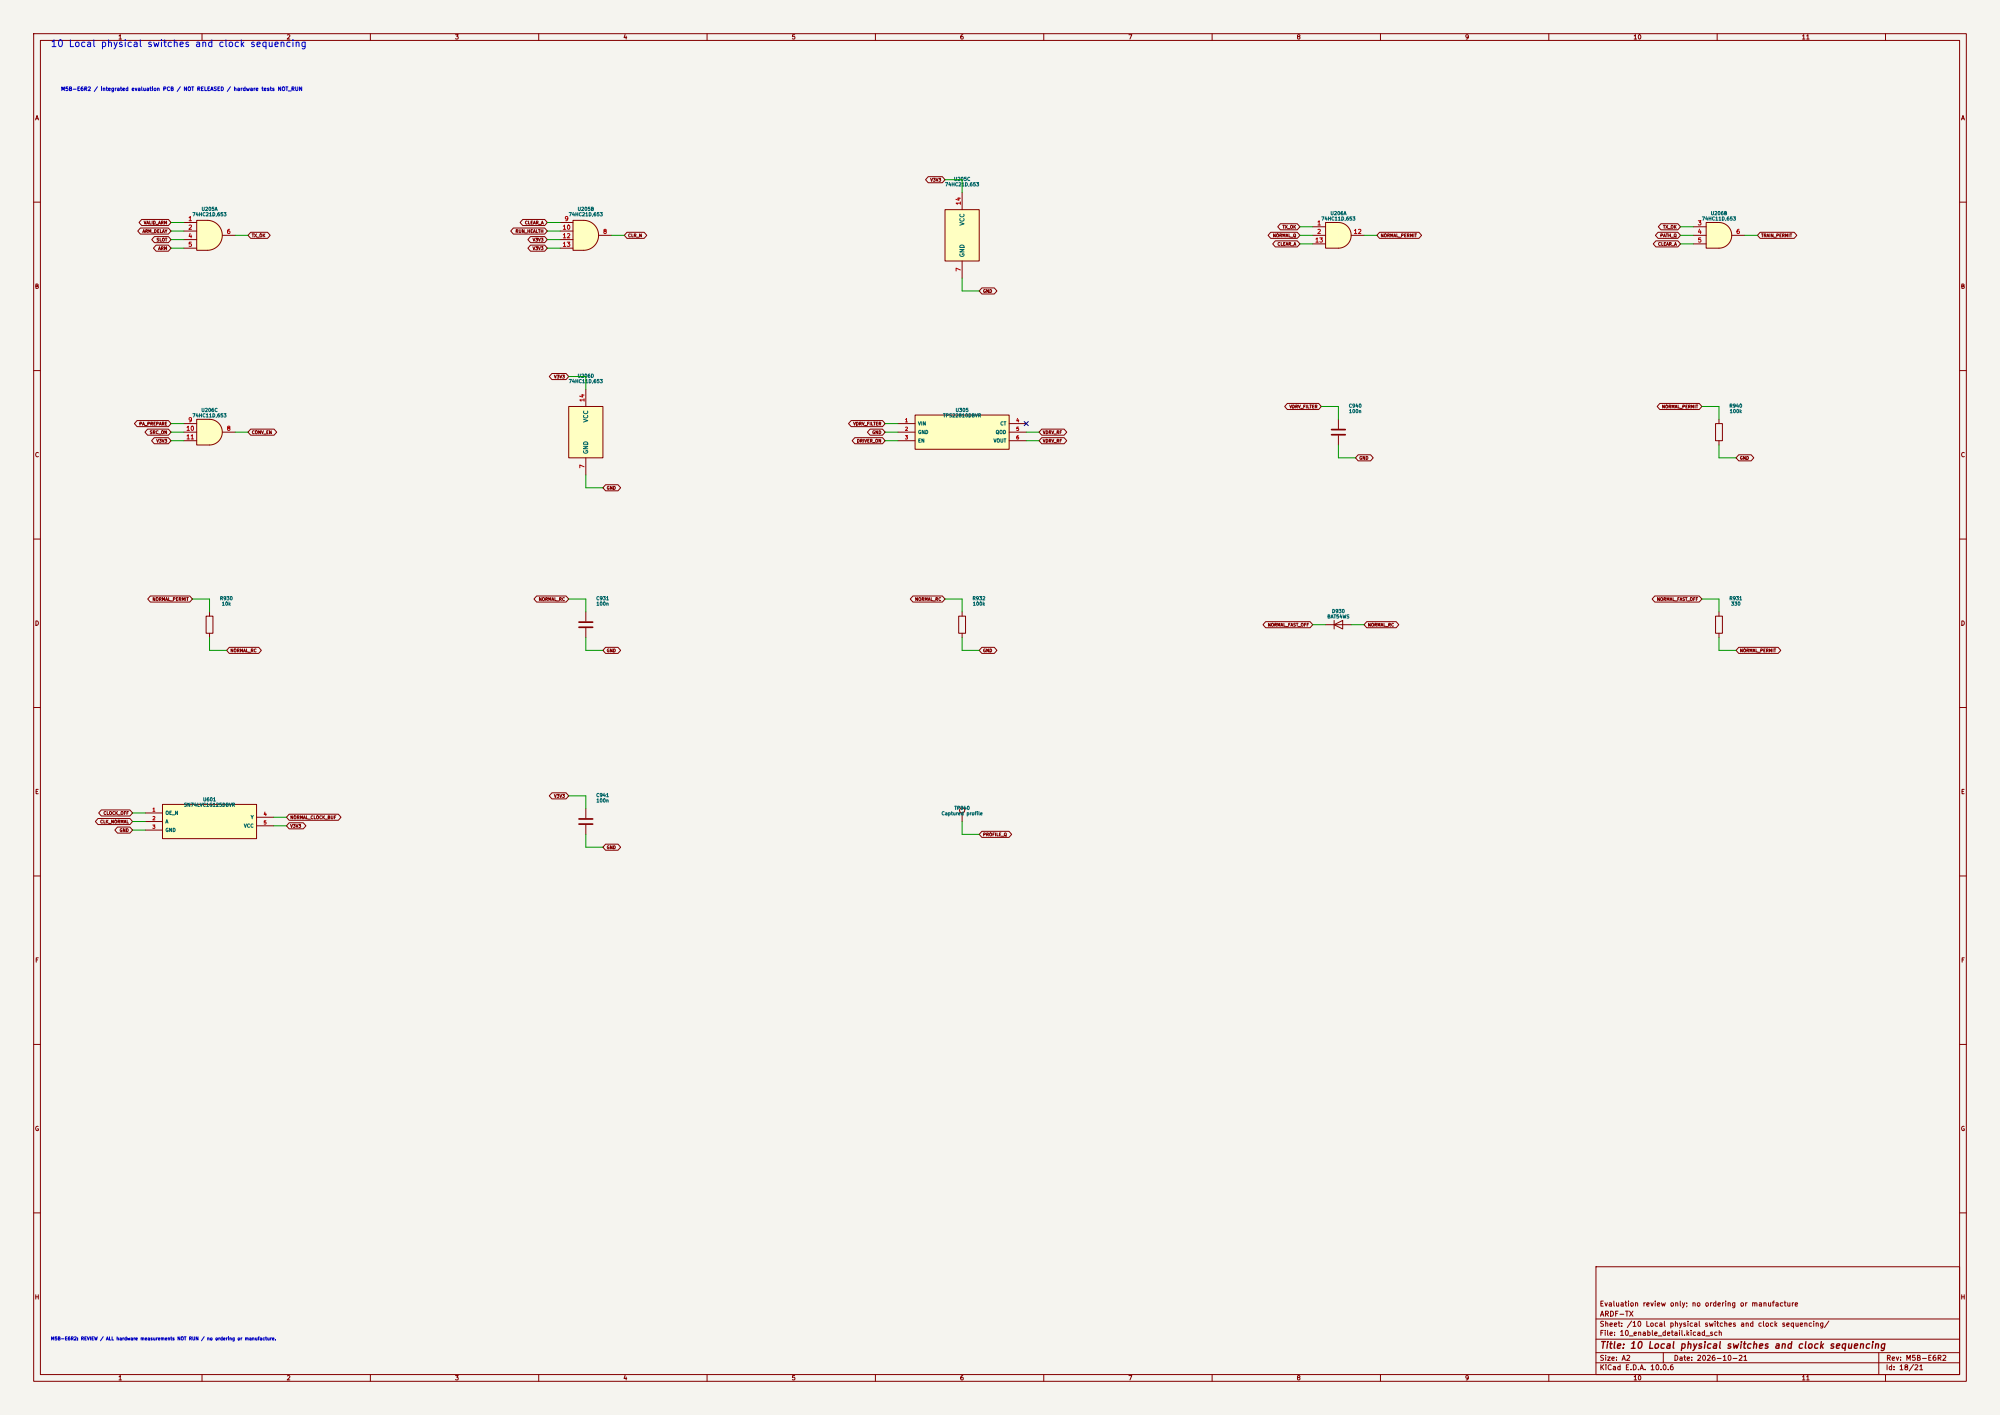
[picture p77: page 18]

10 Local physical switches and clock sequencing

Sheet: /10 Local physical switches and clock sequencing/
File: 10_enable_detail.kicad_sch
Title: 10 Local physical switches and clock sequencing

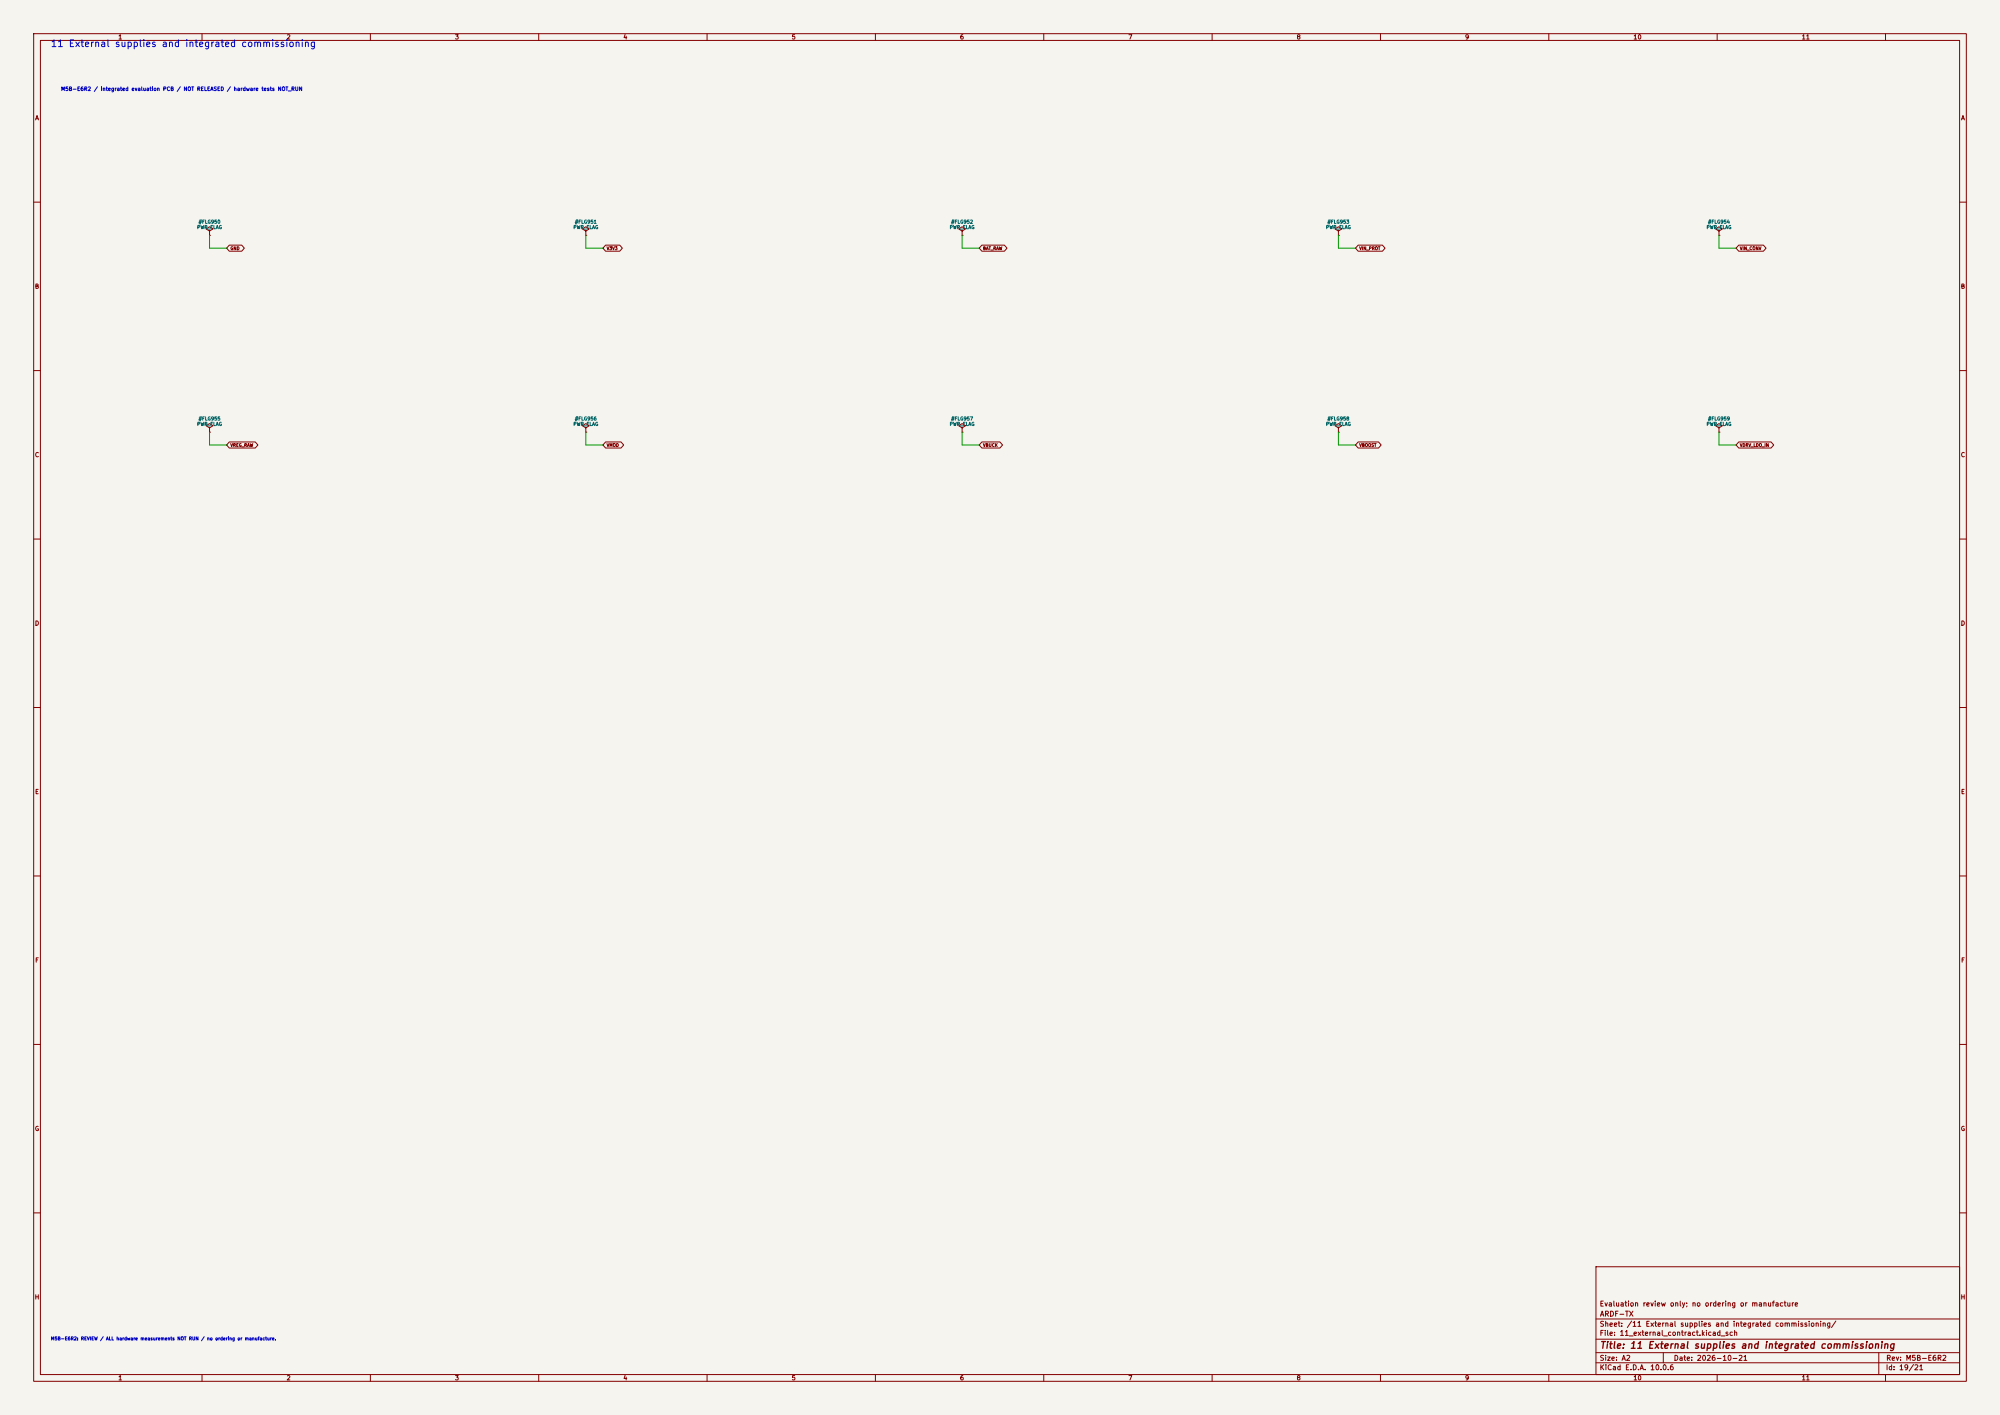
[picture p78: page 19]

11 External supplies and integrated commissioning

Sheet: /11 External supplies and integrated commissioning/
File: 11_external_contract.kicad_sch
Title: 11 External supplies and integrated commissioning

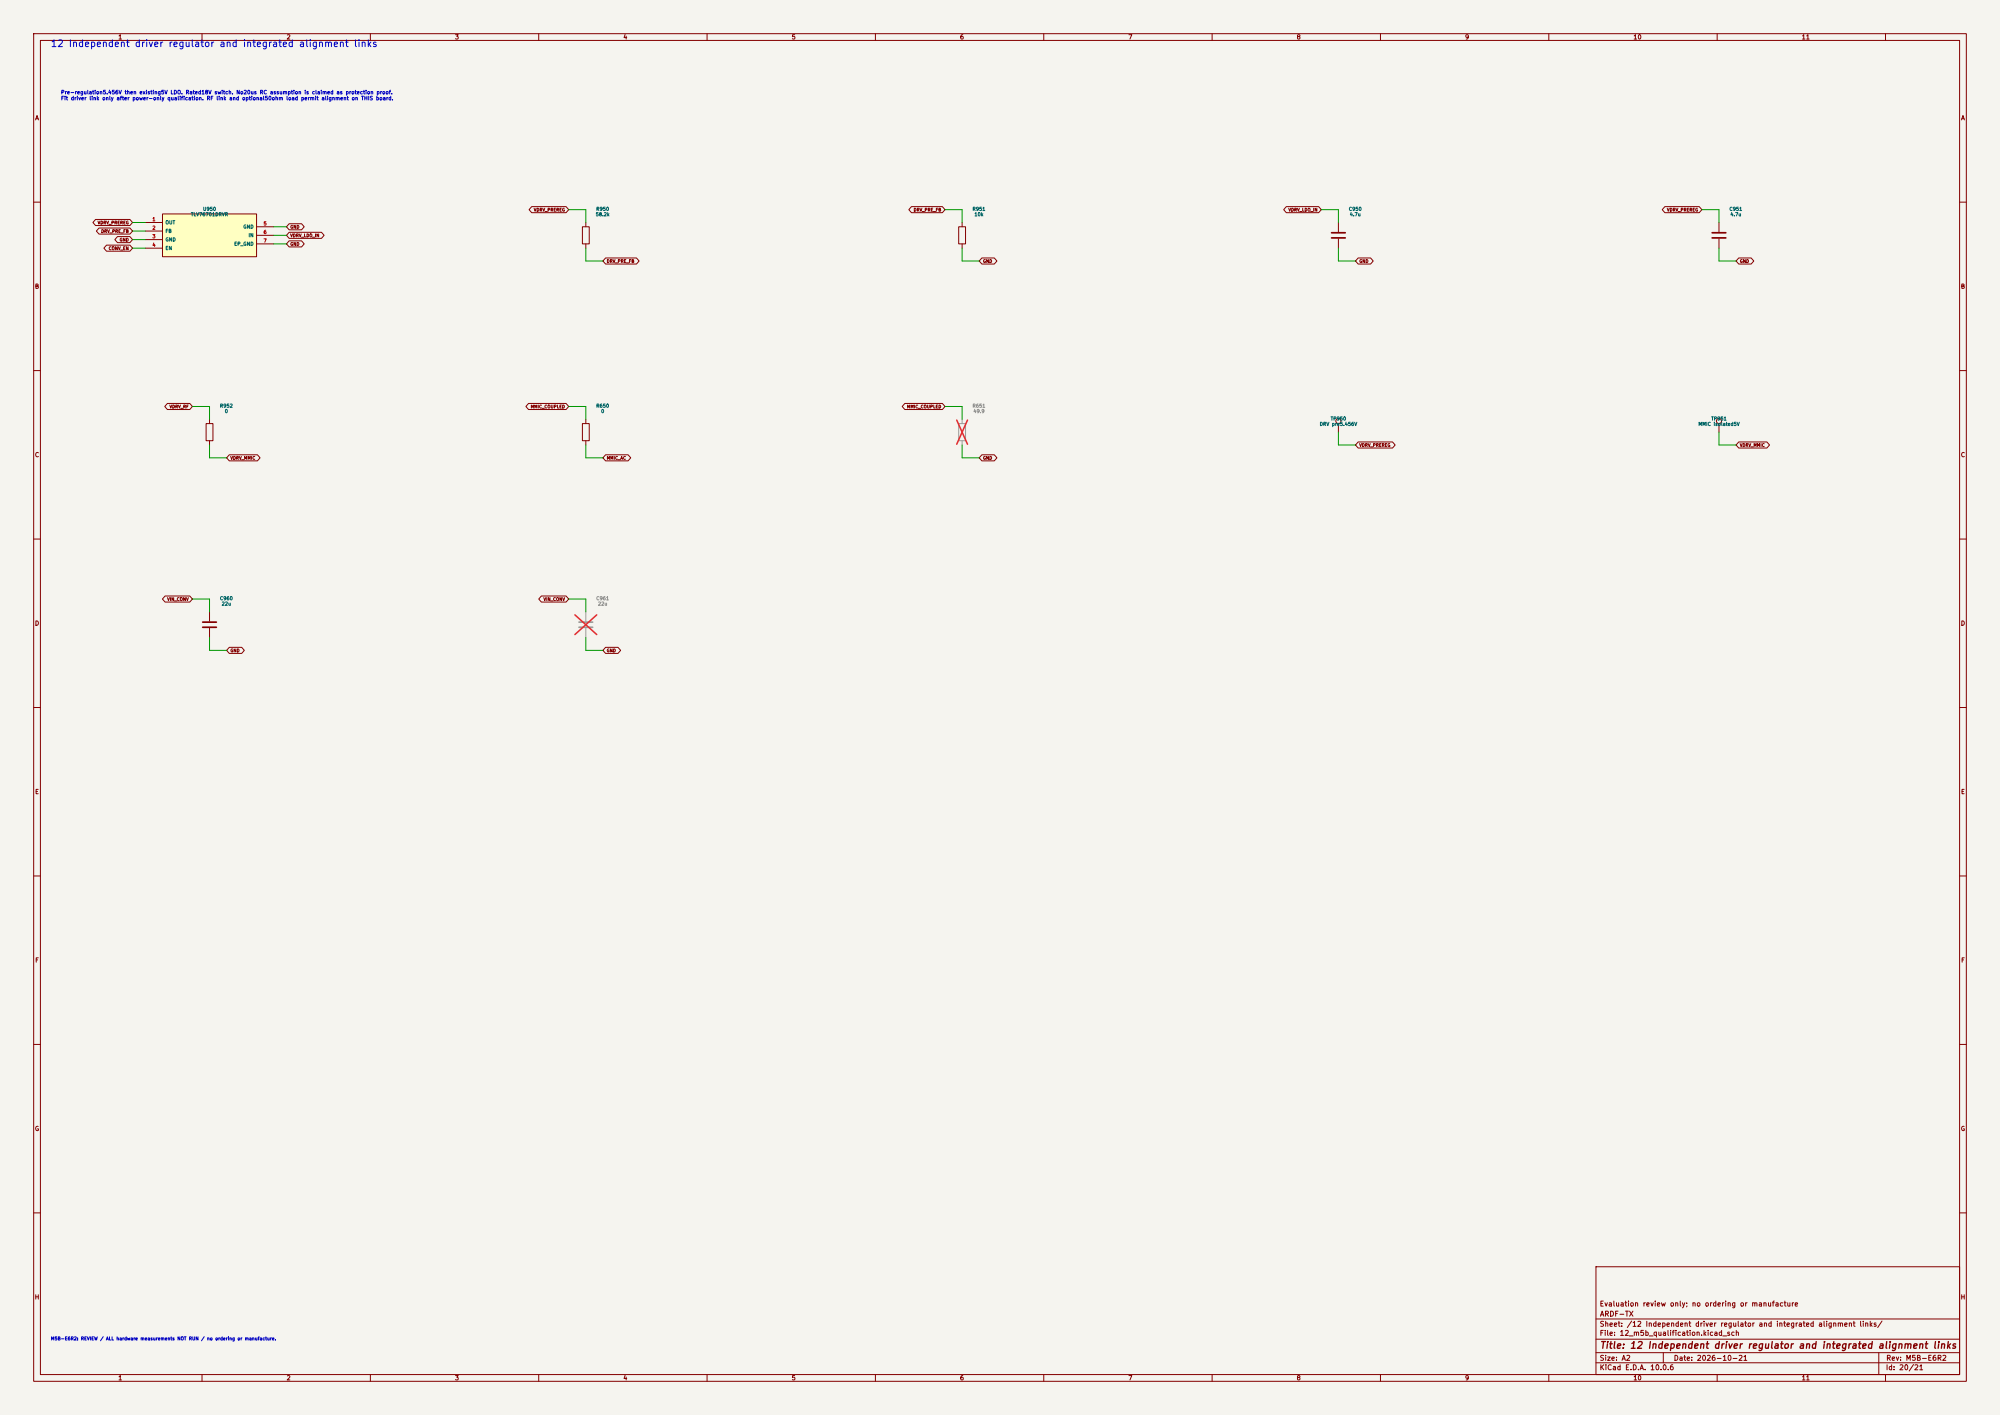
[picture p79: page 20]

DRV_PRE_FB 12 Independent driver regulator and integrated alignment links

Pre-regulation5.456V then existing5V LDO. Rated18V switch. No20us RC assumption is claimed as protection proof. Fit driver link only after power-only qualification. RF link and optional50ohm load permit alignment on THIS board.

Sheet: /12 Independent driver regulator and integrated alignment links/
File: 12_m5b_qualification.kicad_sch
Title: 12 Independent driver regulator and integrated alignment links

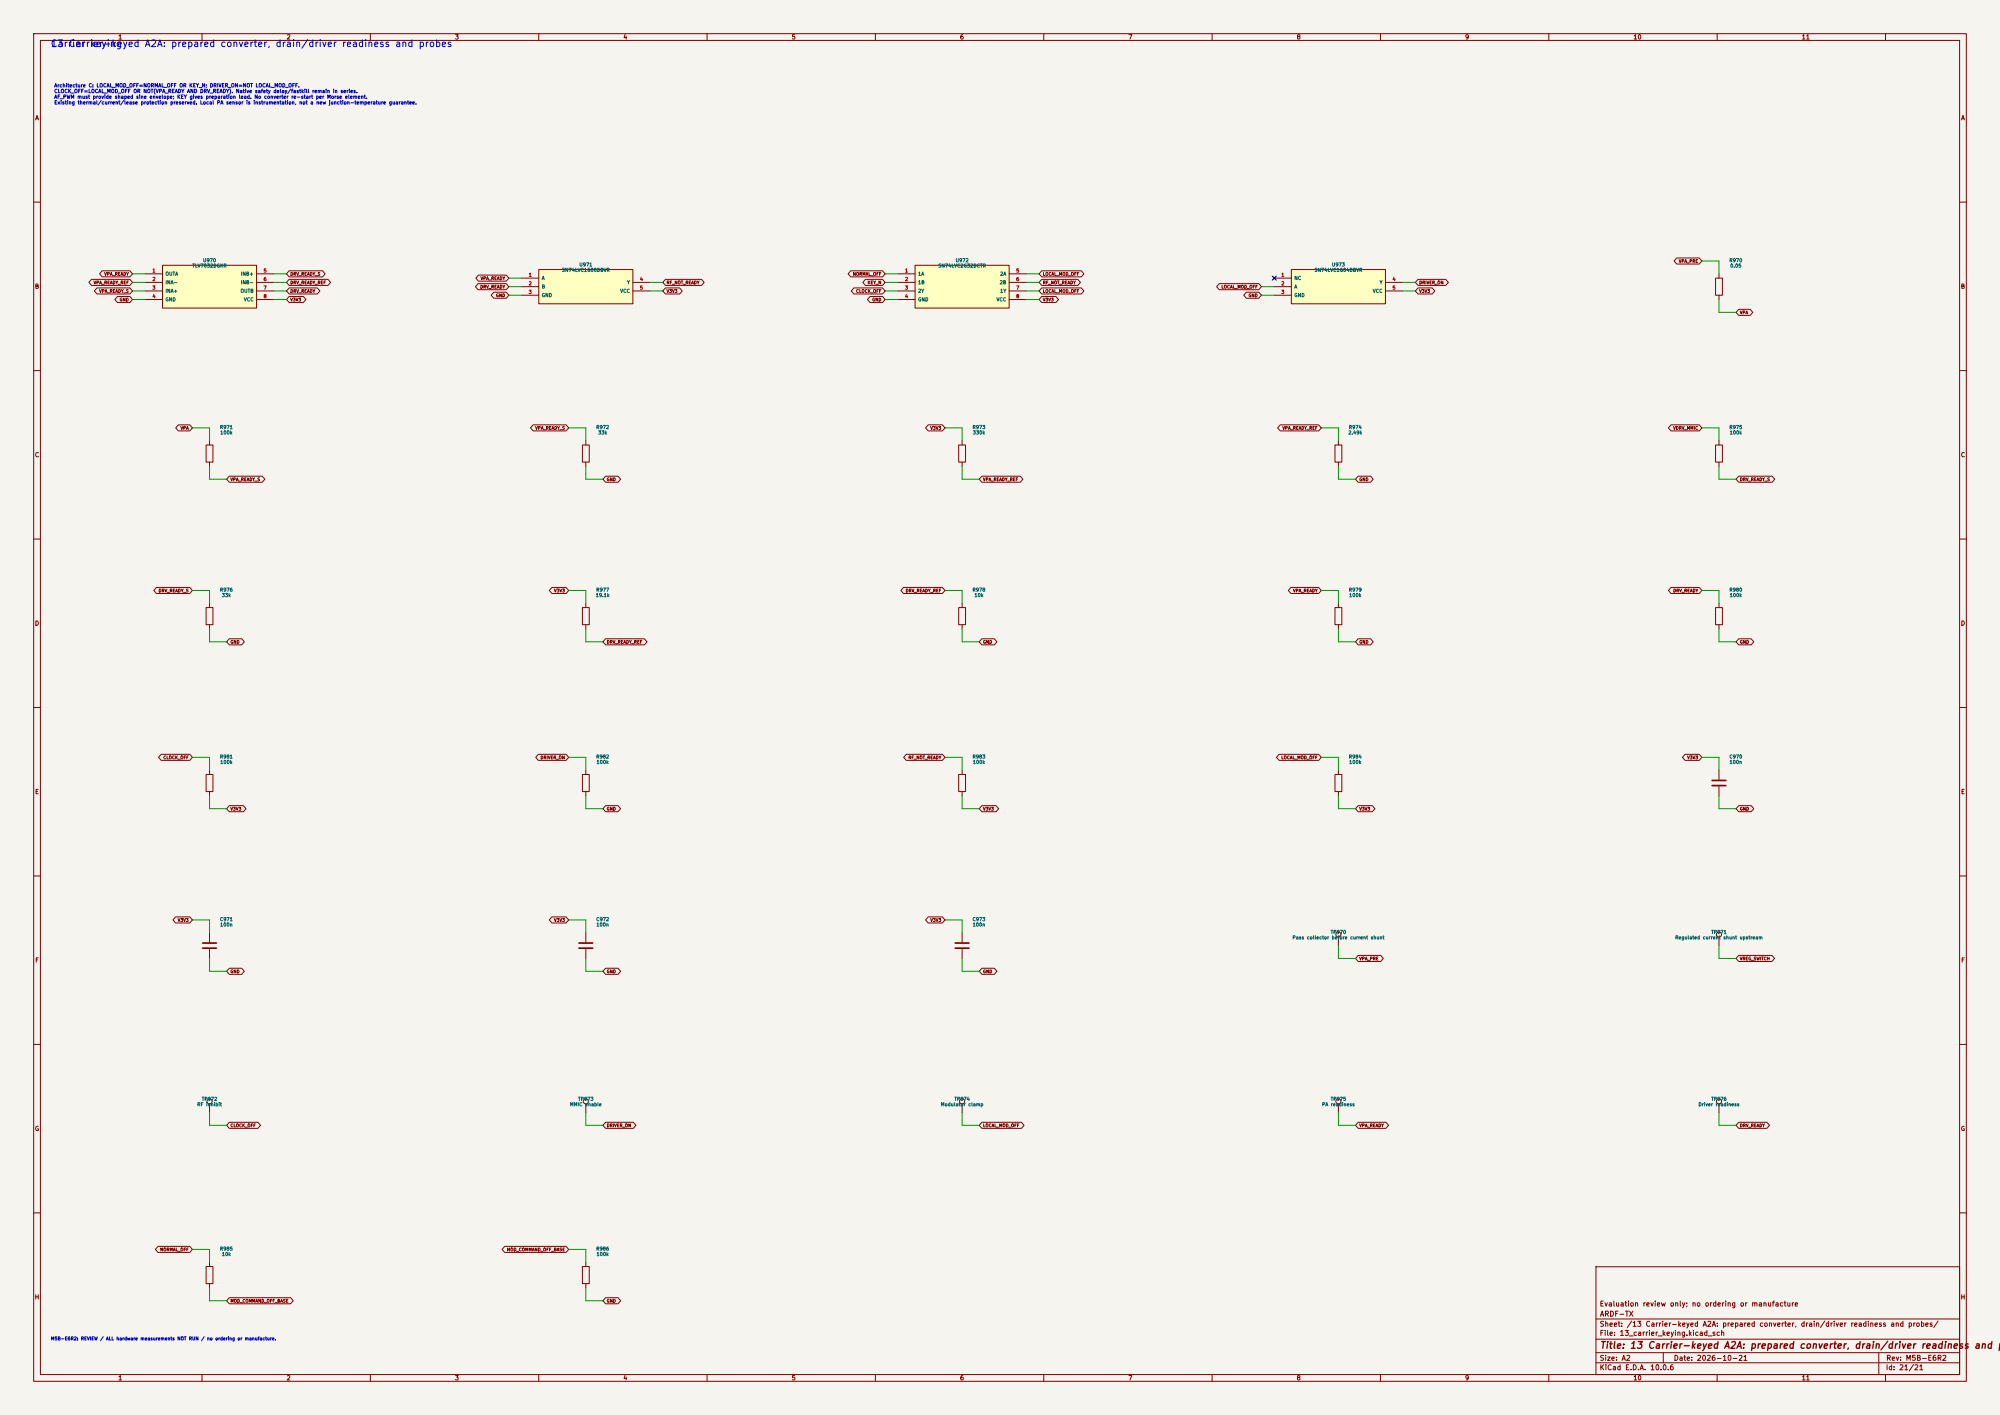
[picture p80: page 21]

LOCAL_MOD_OFF Architecture C: LOCAL_MOD_OFF=NORMAL_OFF OR KEY_N; DRIVER_ON=NOT LOCAL_MOD_OFF. CLOCK_OFF=LOCAL_MOD_OFF OR NOT(VPA_READY AND DRV_READY). Native safety delay/fastkill remain in series. AF_PWM must provide shaped sine envelope; KEY gives preparation lead. No converter re-start per Morse element. Existing thermal/current/lease protection preserved. Local PA sensor is instrumentation, not a new junction-temperature guarantee. Carrier keying

13 Carrier-keyed A2A: prepared converter, drain/driver readiness and probes

TP970 Pass collector before current shunt R981

TP971 Regulated current shunt upstream

Sheet: /13 Carrier-keyed A2A: prepared converter, drain/driver readiness and probes/
File: 13_carrier_keying.kicad_sch
Title: 13 Carrier-keyed A2A: prepared converter, drain/driver readiness and probes
