DD1SB/ARDF-TX/hardware/2m/review/M5B-E6R1/01-carrier-comparison.pdf

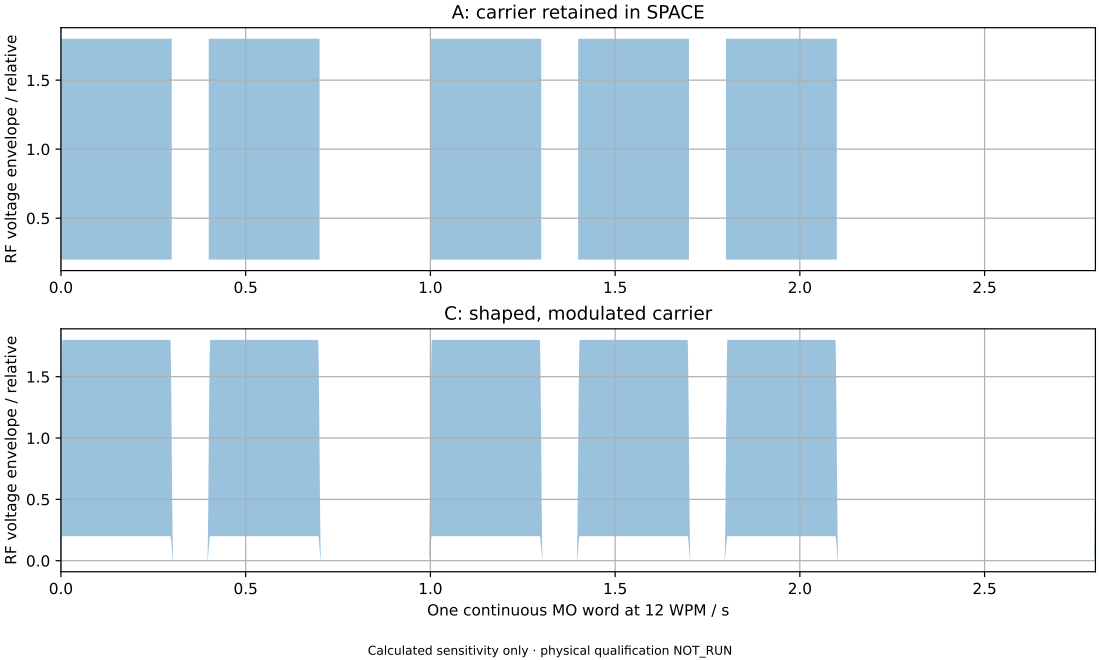
[picture p81: page 1]
fication NOT_RUN

A: carrier retained in SPACE

RF voltage envelope / relative

C: shaped, modulated carrier

One continuous MO word at 12 WPM / s

Calculated sensitivity only · physical quali
