DD1SB/ARDF-TX/hardware/2m/review/M5B-E6R1/05-continuous-MO.pdf

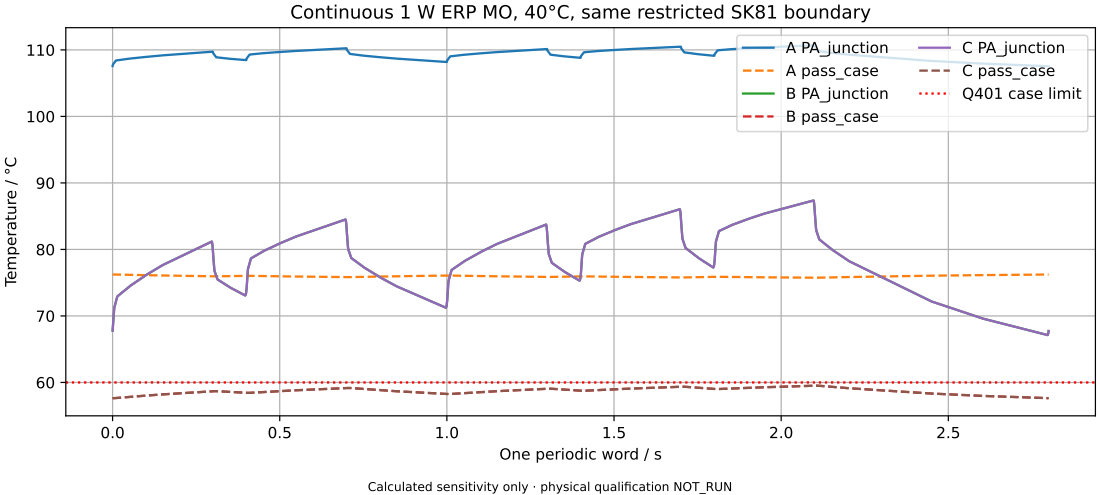
[picture p82: page 1]
Temperature / °C

Continuous 1 W ERP MO, 40°C, same restricted SK81 boundary

A PA_junction | C PA_junction
A pass_case B PA_junction | C pass_case Q401 case limit

B pass_case

One periodic word / s

Calculated sensitivity only · physical qualification NOT_RUN
