DD1SB/ARDF-TX/hardware/2m/review/M5B-E6R1/06-local-fault-sensitivity.pdf

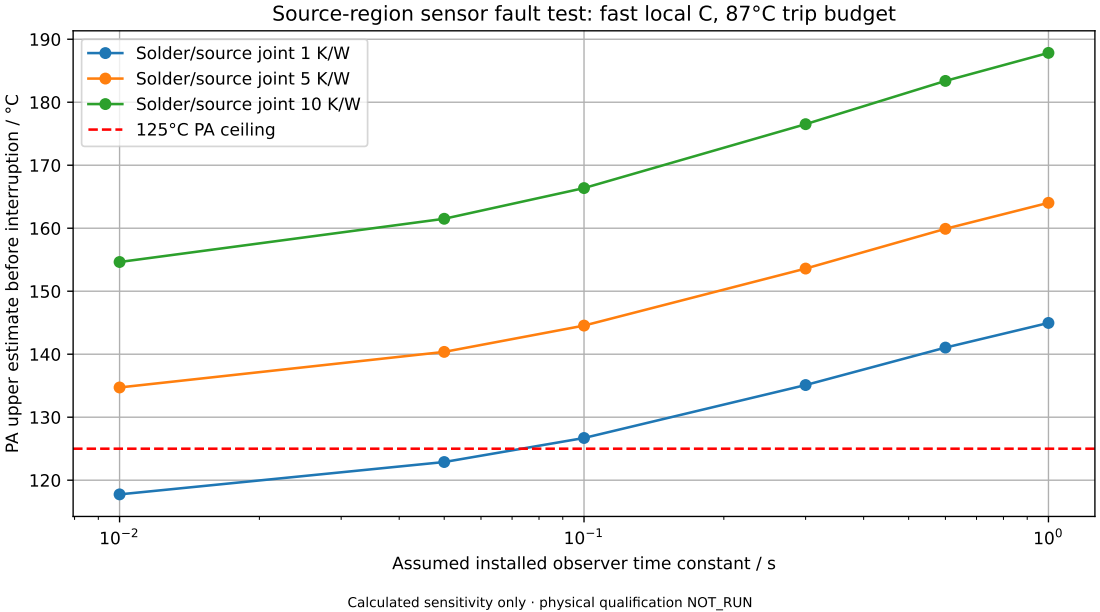
[picture p83: page 1]

Source-region sensor fault test: fast local C, 87°C trip budget

Solder/source joint 1 K/W Solder/source joint 5 K/W

PA upper estimate before interruption / °C

Solder/source joint 10 K/W 125°C PA ceiling

Assumed installed observer time constant / s

Calculated sensitivity only · physical qualification NOT_RUN
