DD1SB/ARDF-TX/hardware/2m/review/M5B-E6/common-cooler-concept.pdf

−5

### M5B-E6 FEASIBILITY CONCEPT — HOLD — NOT native KiCad / NOT a drilling template

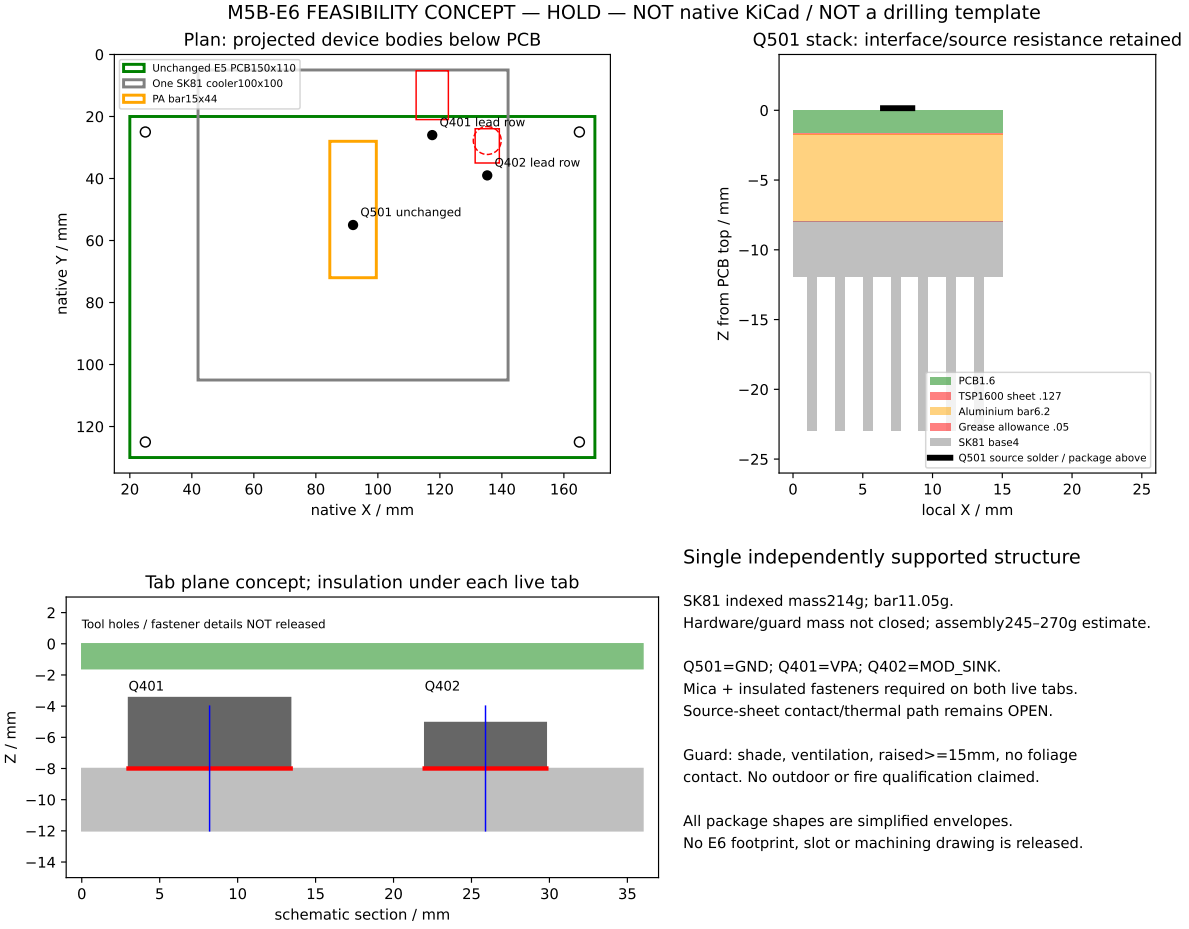
[picture p84: page 1]
native X / mm; native Y / mm; Q501 unchanged; Q401 lead row; Q402 lead row; Unchanged E5 PCB150x110; One SK81 cooler100x100; PA bar15x44; local X / mm; PCB1.6; TSP1600 sheet .127; Aluminium bar6.2; Grease allowance .05; SK81 base4; Q501 source solder / package above; Tool holes / fastener details NOT released

Plan: projected device bodies below PCB

Q501 stack: interface/source resistance retained

Z from PCB top / mm

Single independently supported structure

Tab plane concept; insulation under each live tab

SK81 indexed mass214g; bar11.05g.
Hardware/guard mass not closed; assembly245–270g estimate.

Q501=GND; Q401=VPA; Q402=MOD_SINK.
Mica + insulated fasteners required on both live tabs.
Source-sheet contact/thermal path remains OPEN.

Guard: shade, ventilation, raised>=15mm, no foliage
contact. No outdoor or fire qualification claimed.

All package shapes are simplified envelopes.

No E6 footprint, slot or machining drawing is released.

schematic section / mm
