DD1SB/ARDF-TX/hardware/2m/review/M5B-E6/fault-response.pdf

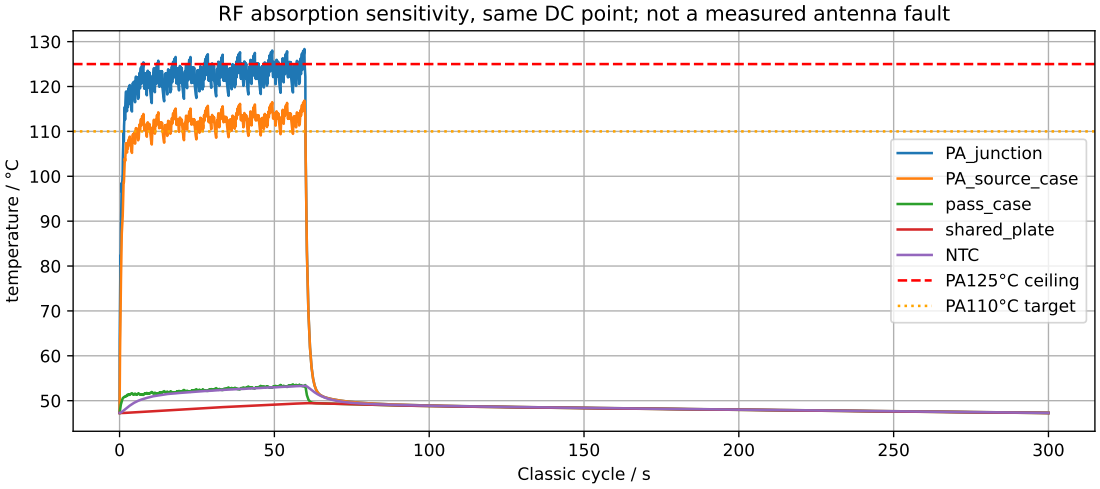
[picture p85: page 1]
Classic cycle / s; temperature / °C

RF absorption sensitivity, same DC point; not a measured antenna fault

PA_junction
PA_source_case pass_case

shared_plate NTC

PA125°C ceiling PA110°C target
