DD1SB/ARDF-TX/hardware/controller/review/M6-L2/CTRL-M6-L2.pdf

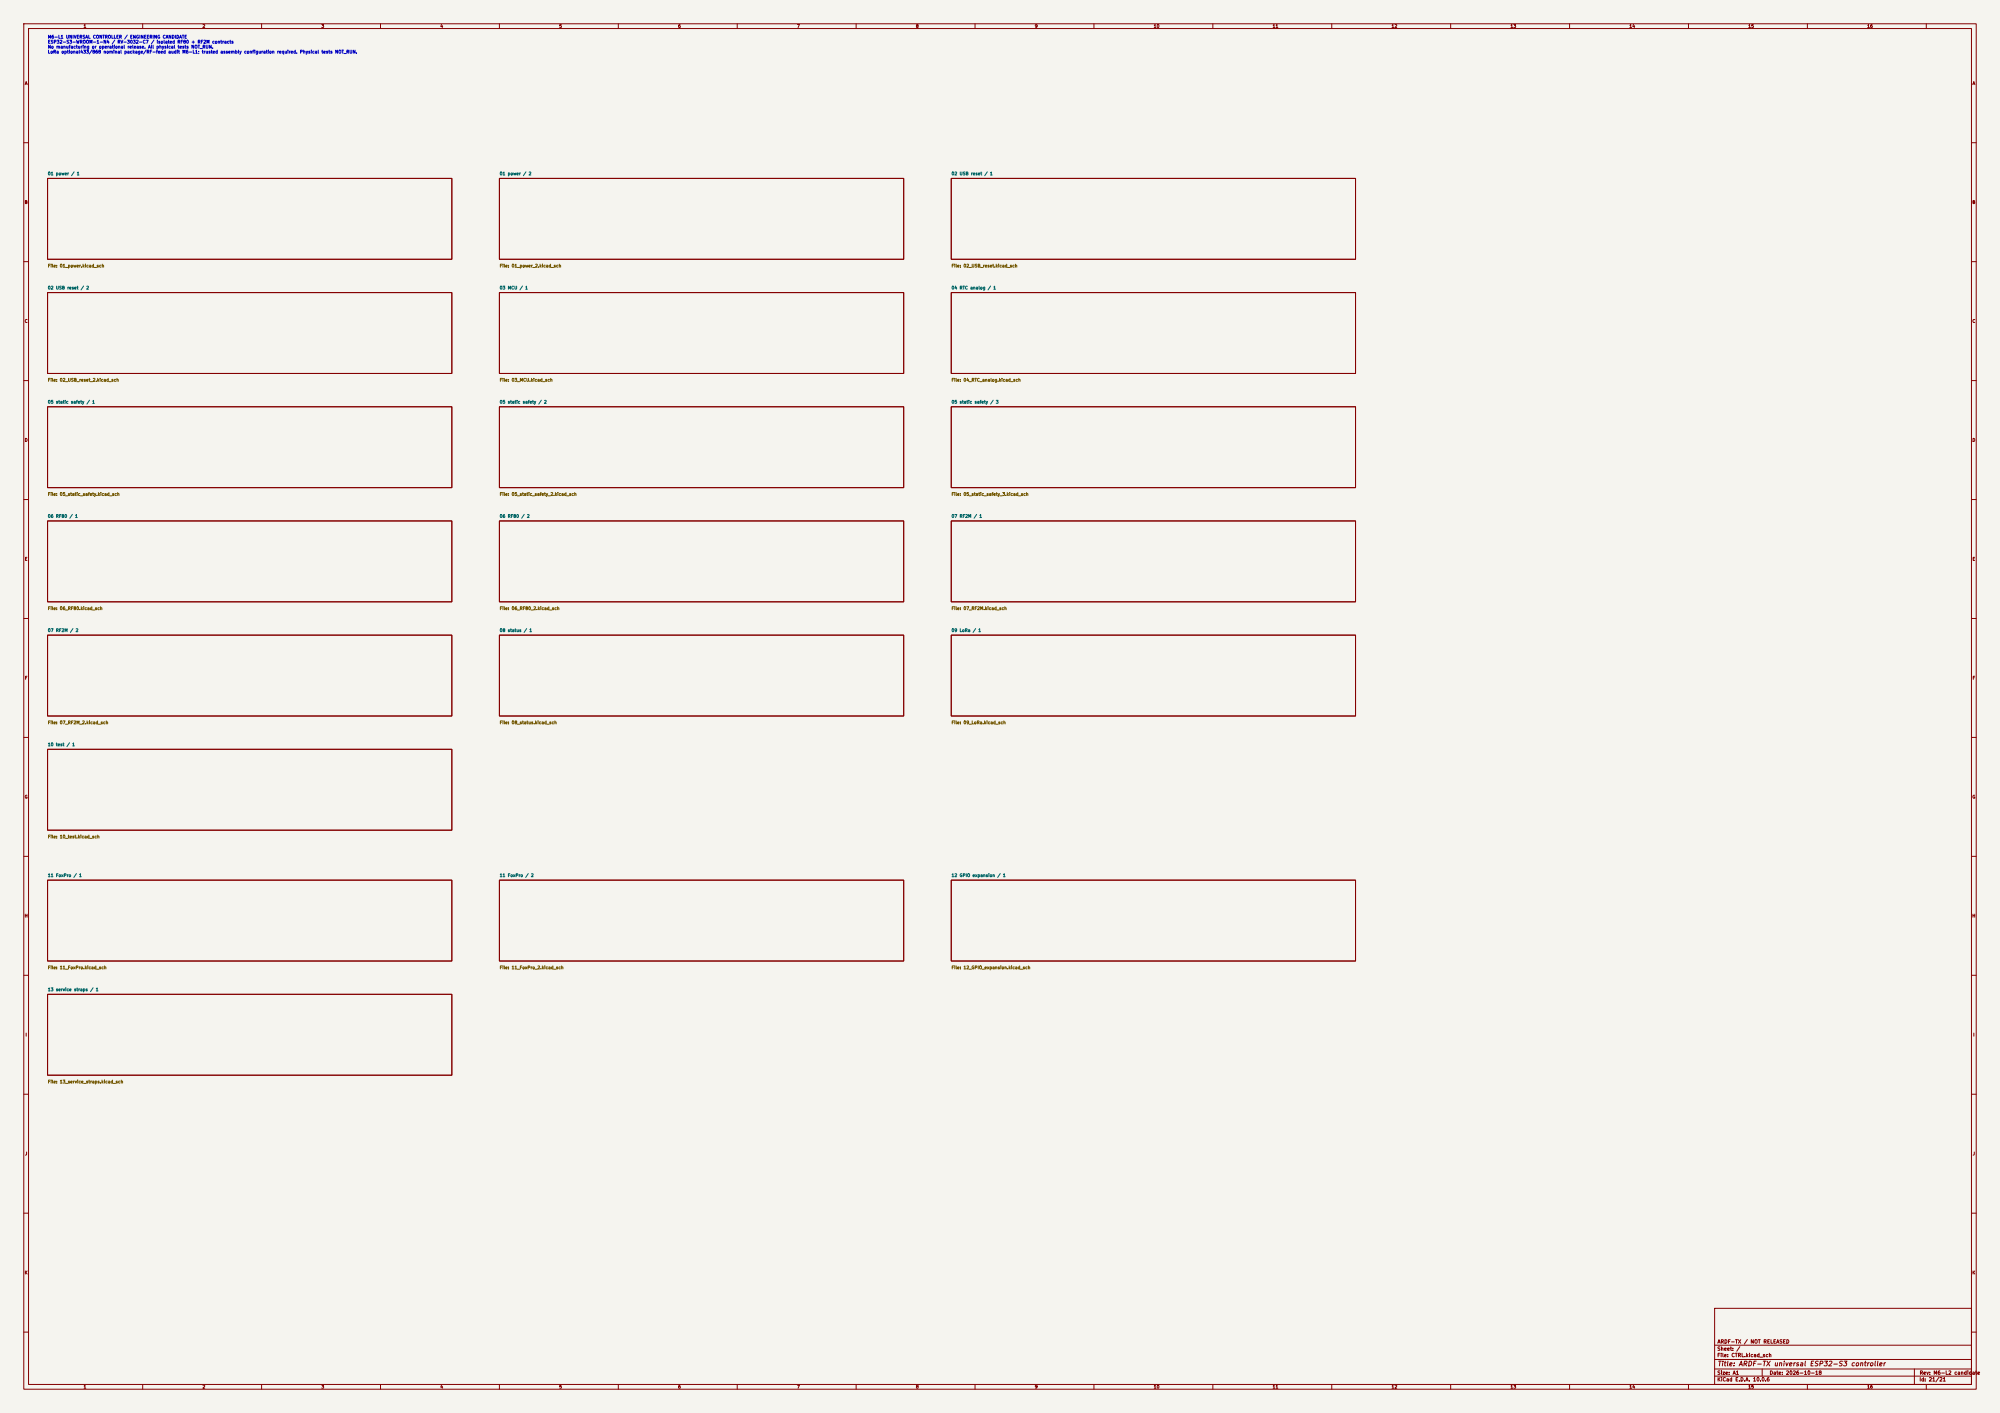
[picture p86: page 1]

File: 02_USB_reset.kicad_sch M6-L1 UNIVERSAL CONTROLLER / ENGINEERING CANDIDATE
ESP32-S3-WROOM-1-N4 / RV-3032-C7 / isolated RF80 + RF2M contracts No manufacturing or operational release. All physical tests NOT_RUN. LoRa optional433/868 nominal package/RF-feed audit M6-L1; trusted assembly configuration required. Physical tests NOT_RUN.

ARDF-TX / NOT RELEASED
Sheet: /
File: CTRL.kicad_sch
Title: ARDF-TX universal ESP32-S3 controller
KiCad E.D.A. 10.0.6

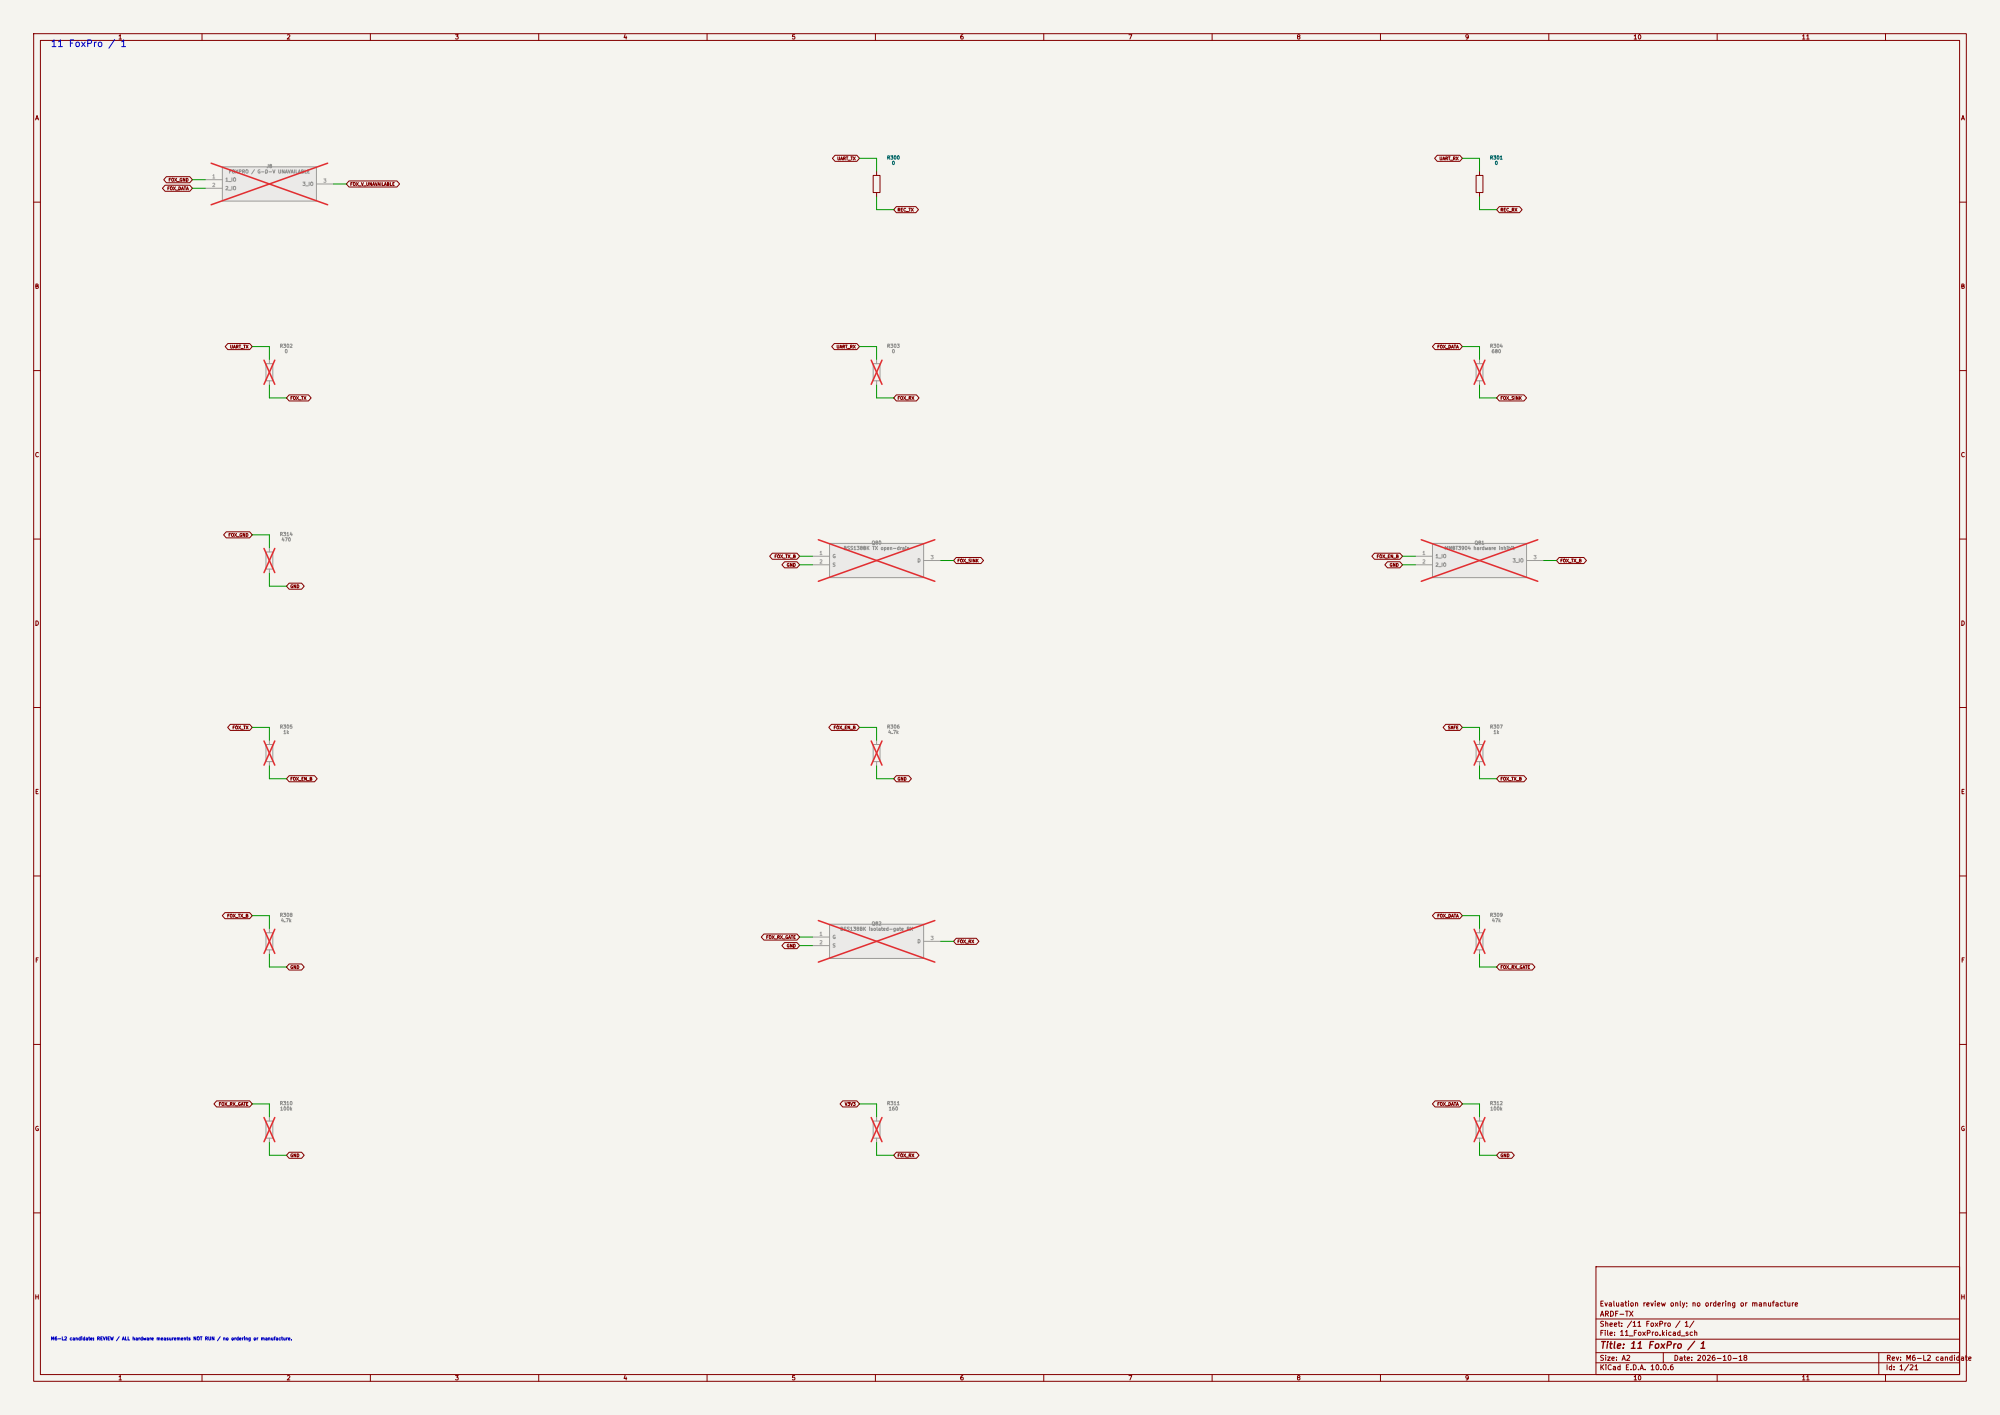
[picture p87: page 2]

Evaluation review only; no ordering or manufacture
ARDF-TX
Sheet: /11 FoxPro / 1/
File: 11_FoxPro.kicad_sch
Title: 11 FoxPro / 1

M6-L2 candidate: REVIEW / ALL hardware measurements NOT RUN / no ordering or manufacture.

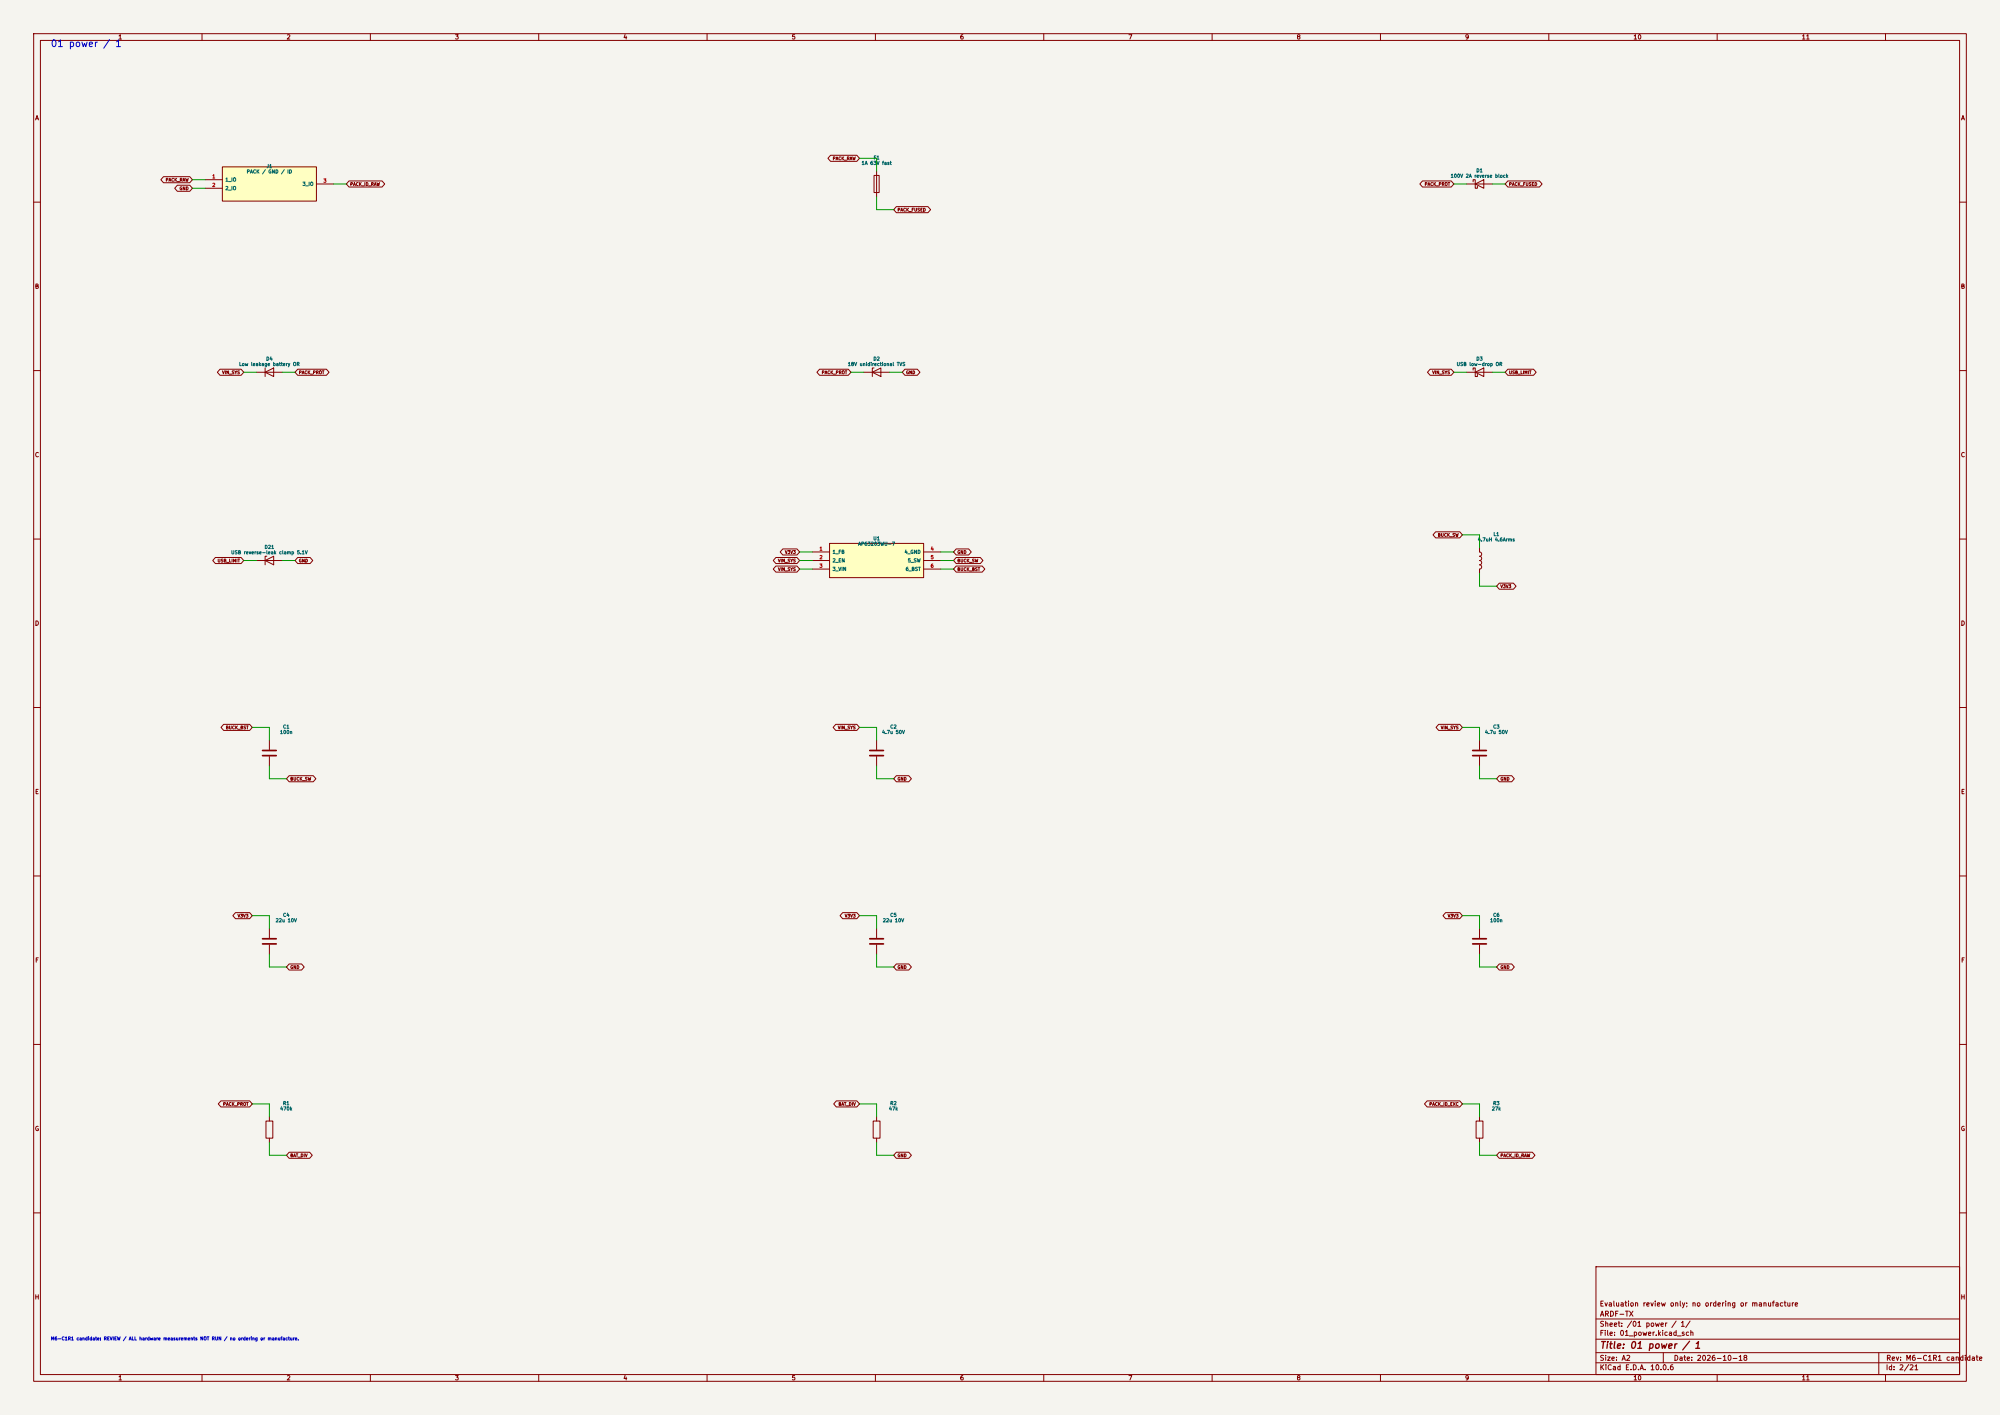
[picture p88: page 3]

100V 2A reverse block D3 USB low-drop OR

Low leakage battery OR

M6-C1R1 candidate: REVIEW / ALL hardware measurements NOT RUN / no ordering or manufacture.

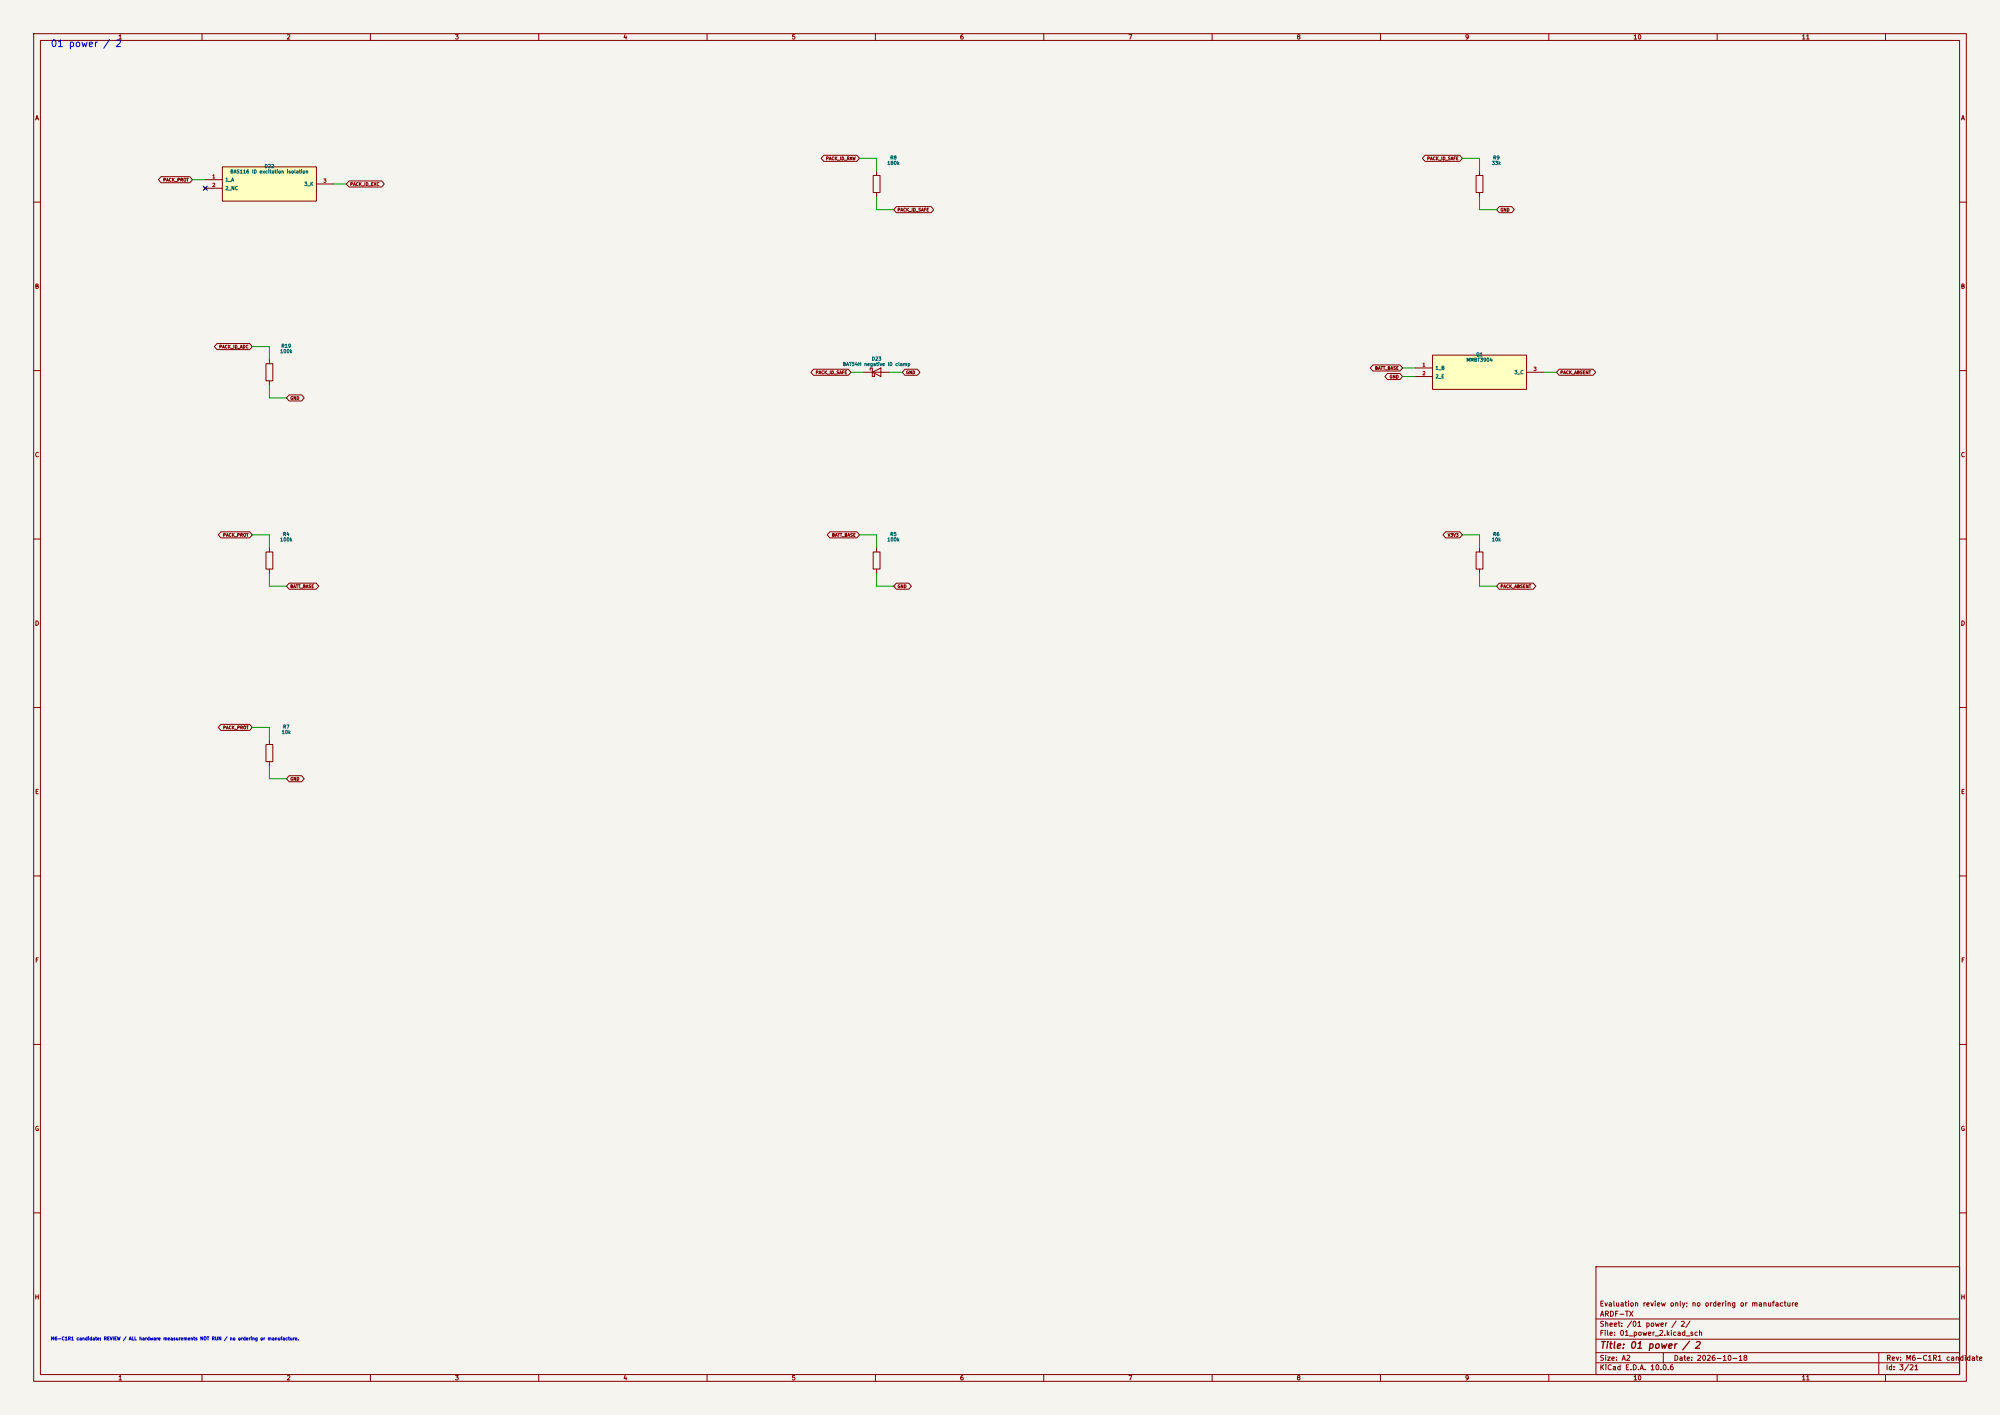
[picture p89: page 4]

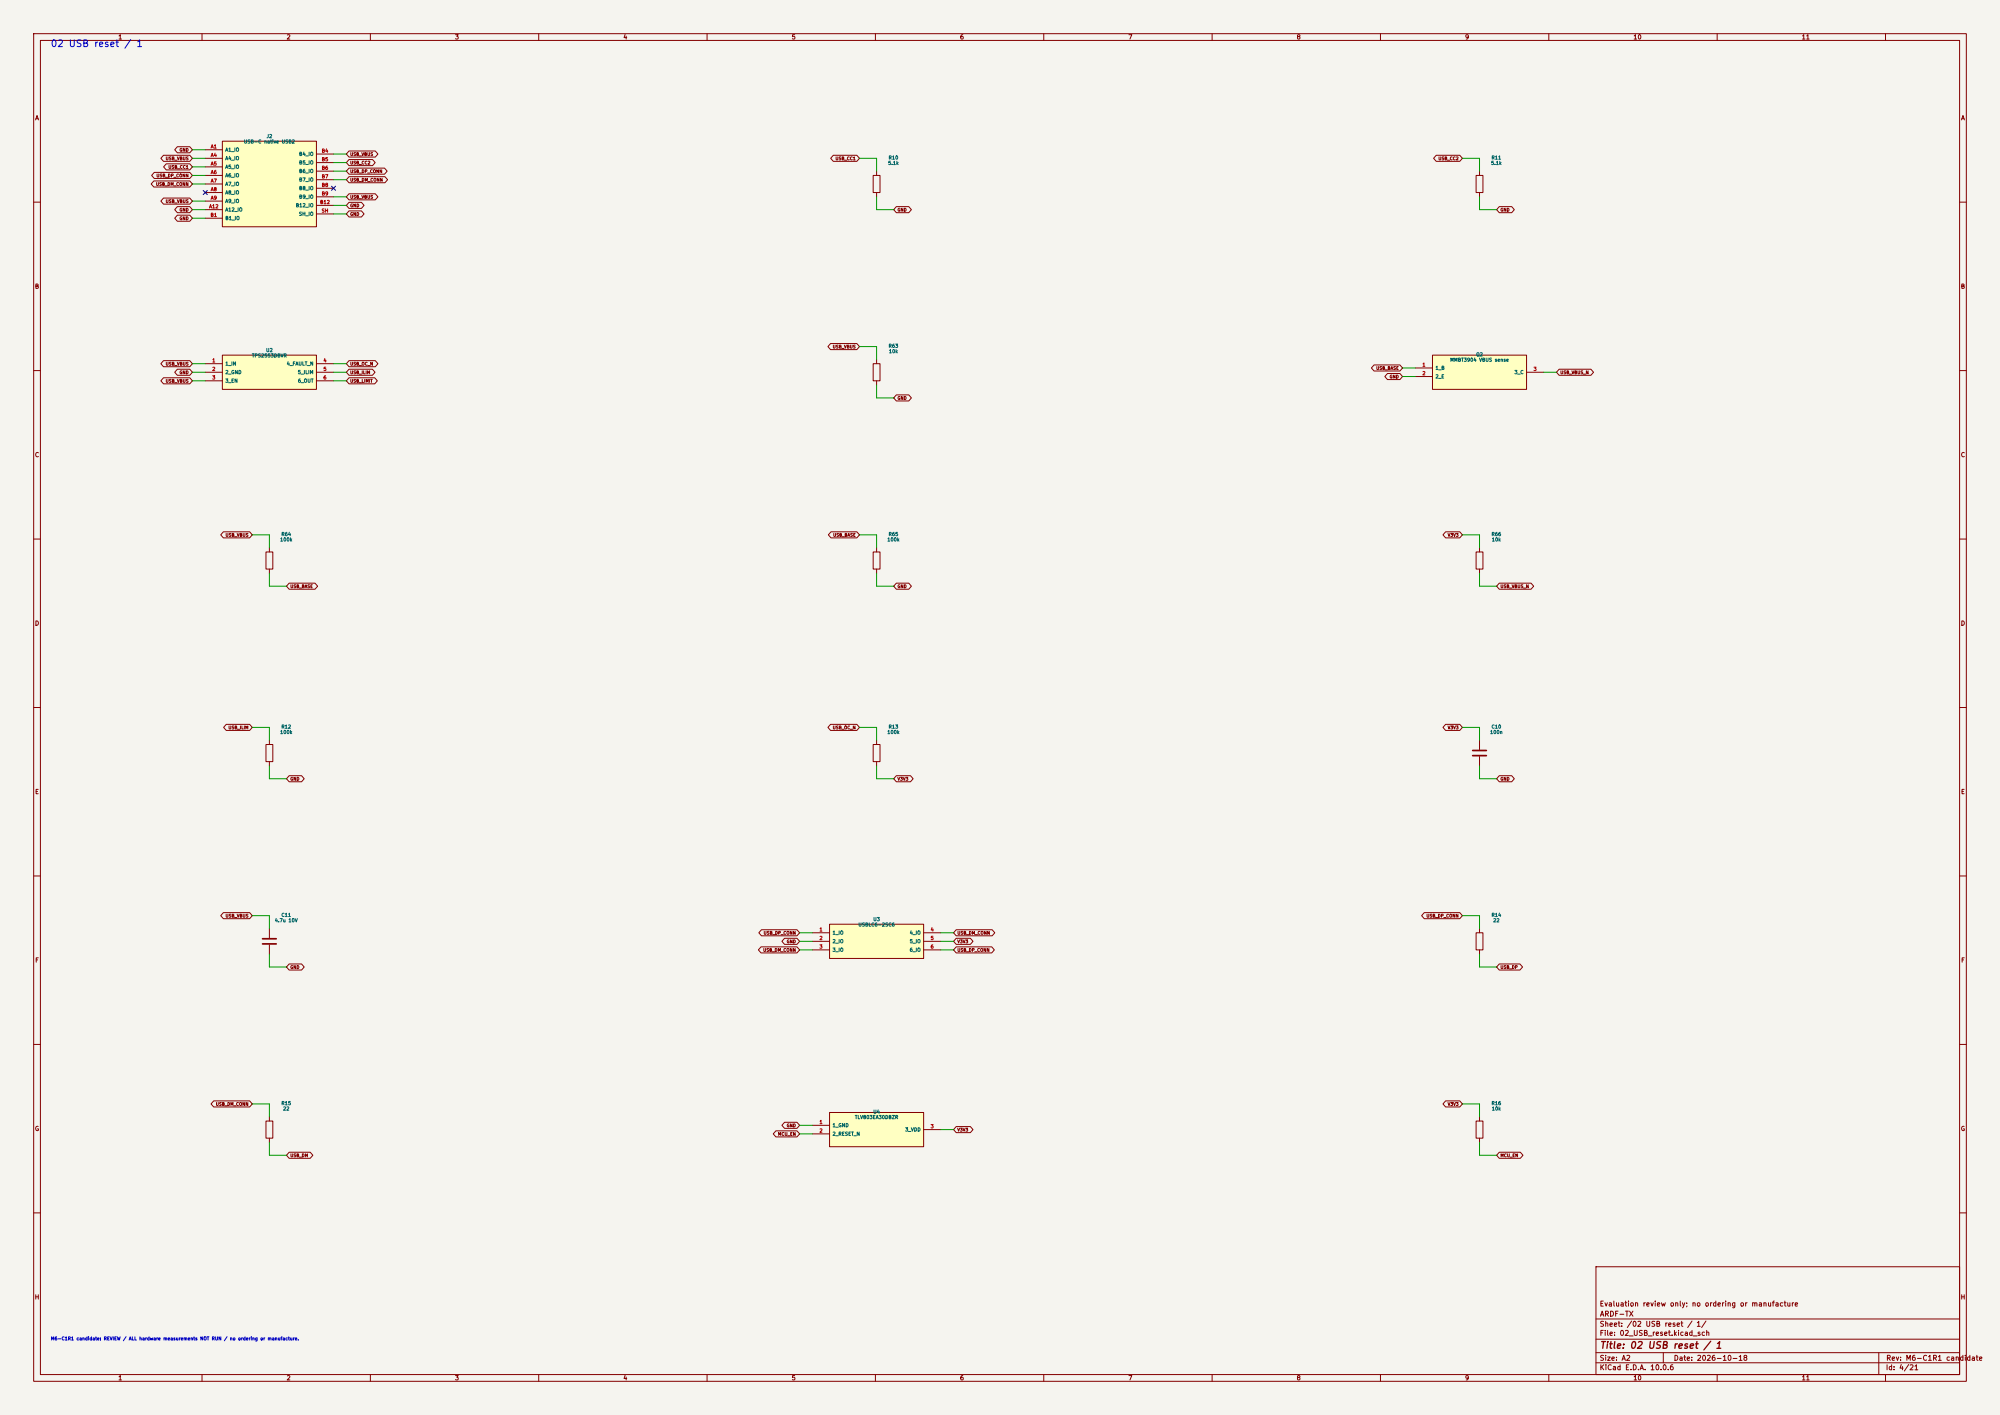
[picture p90: page 5]

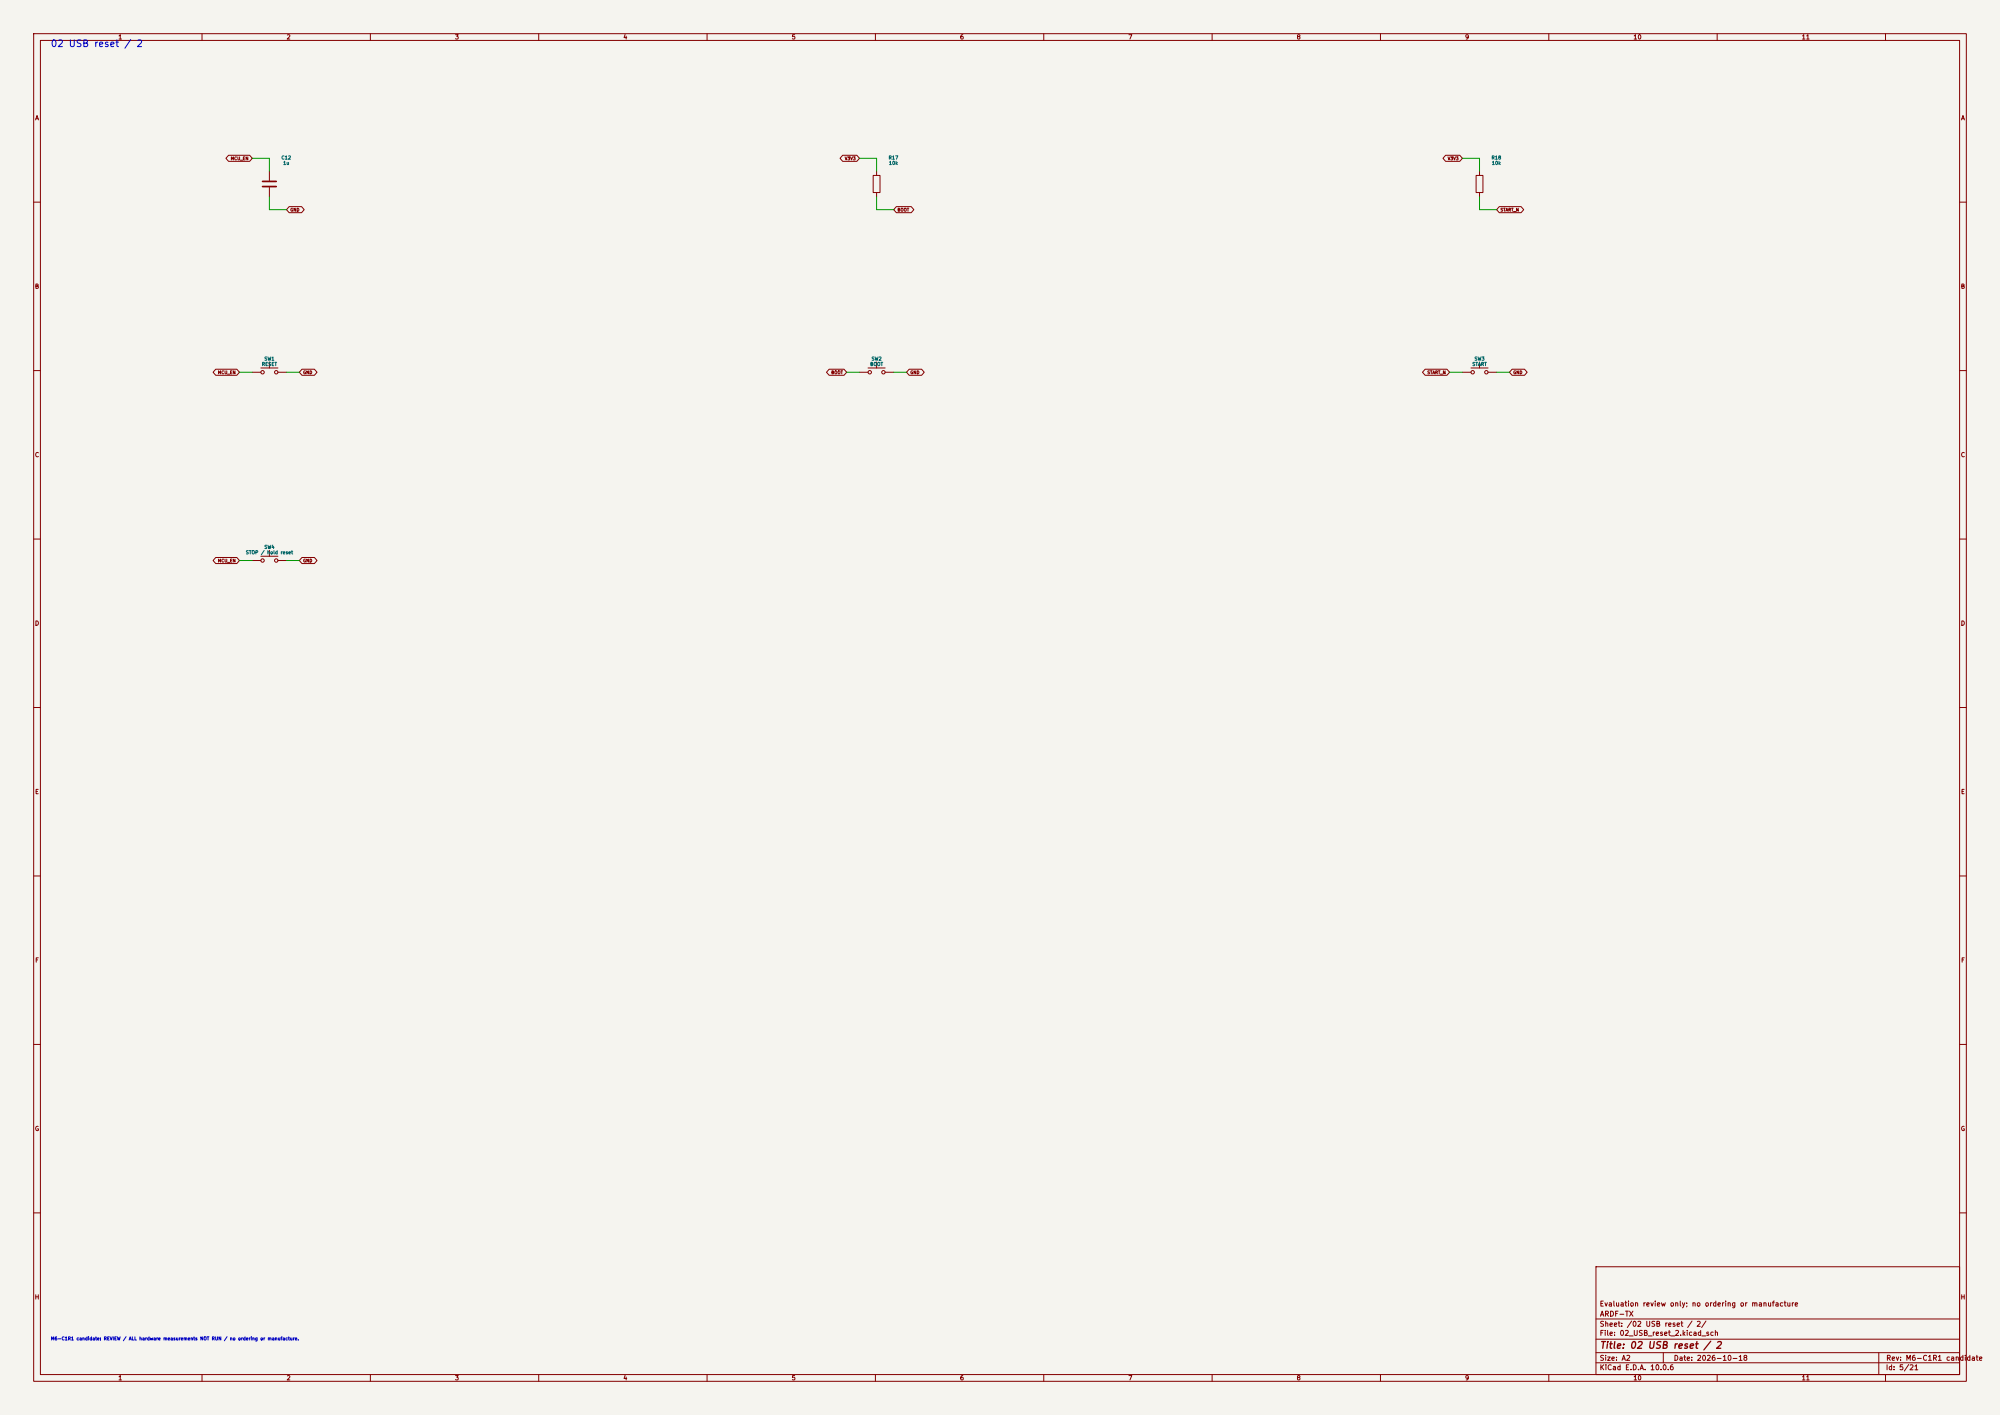
[picture p91: page 6]

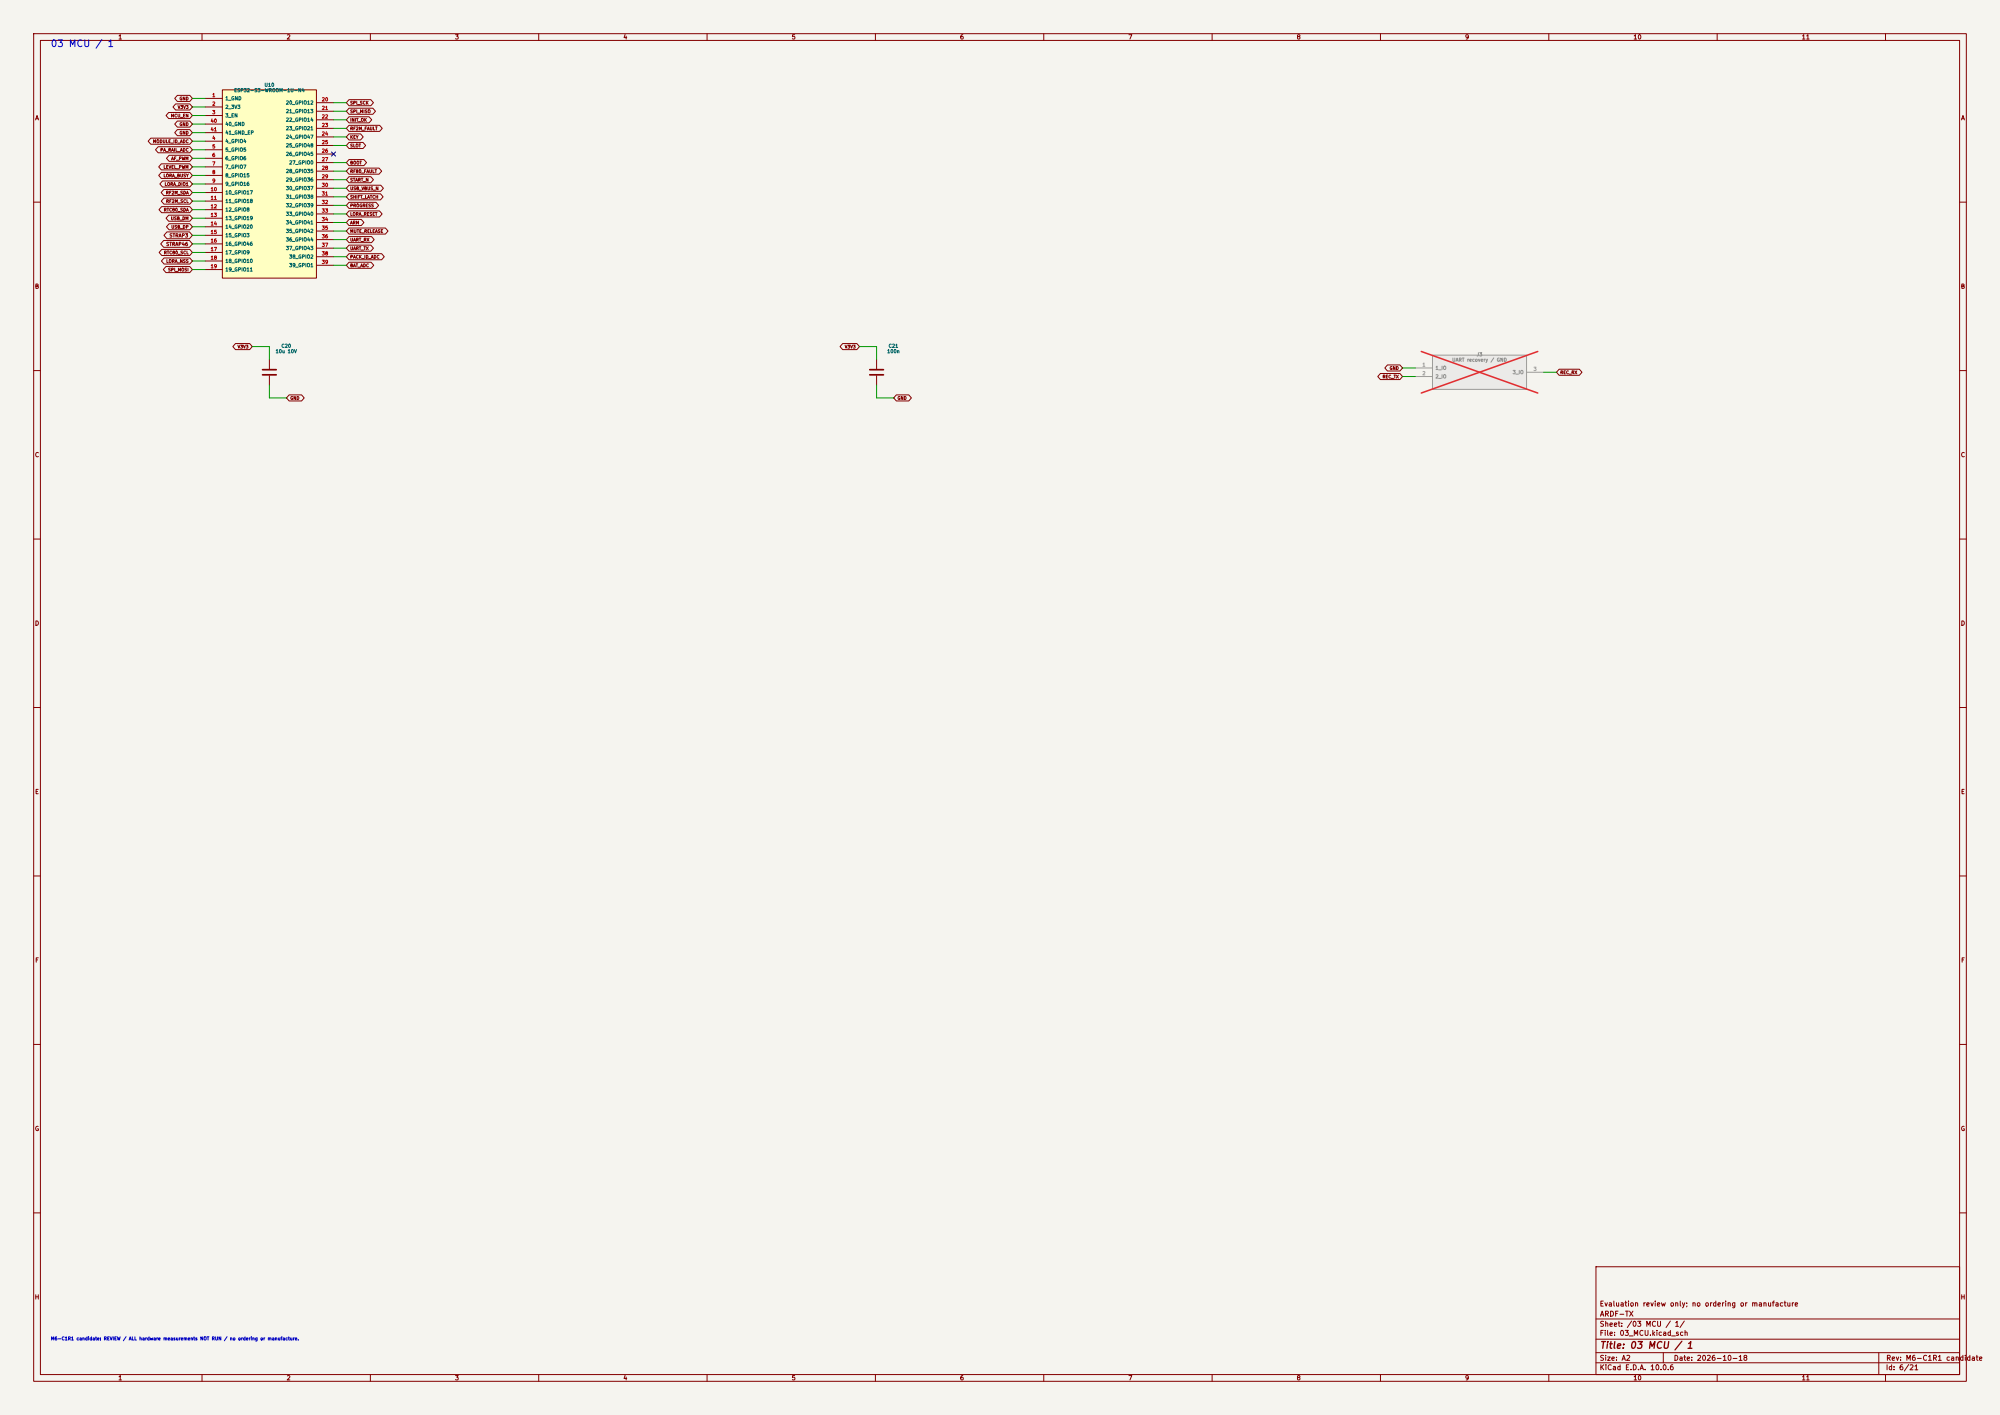
[picture p92: page 7]

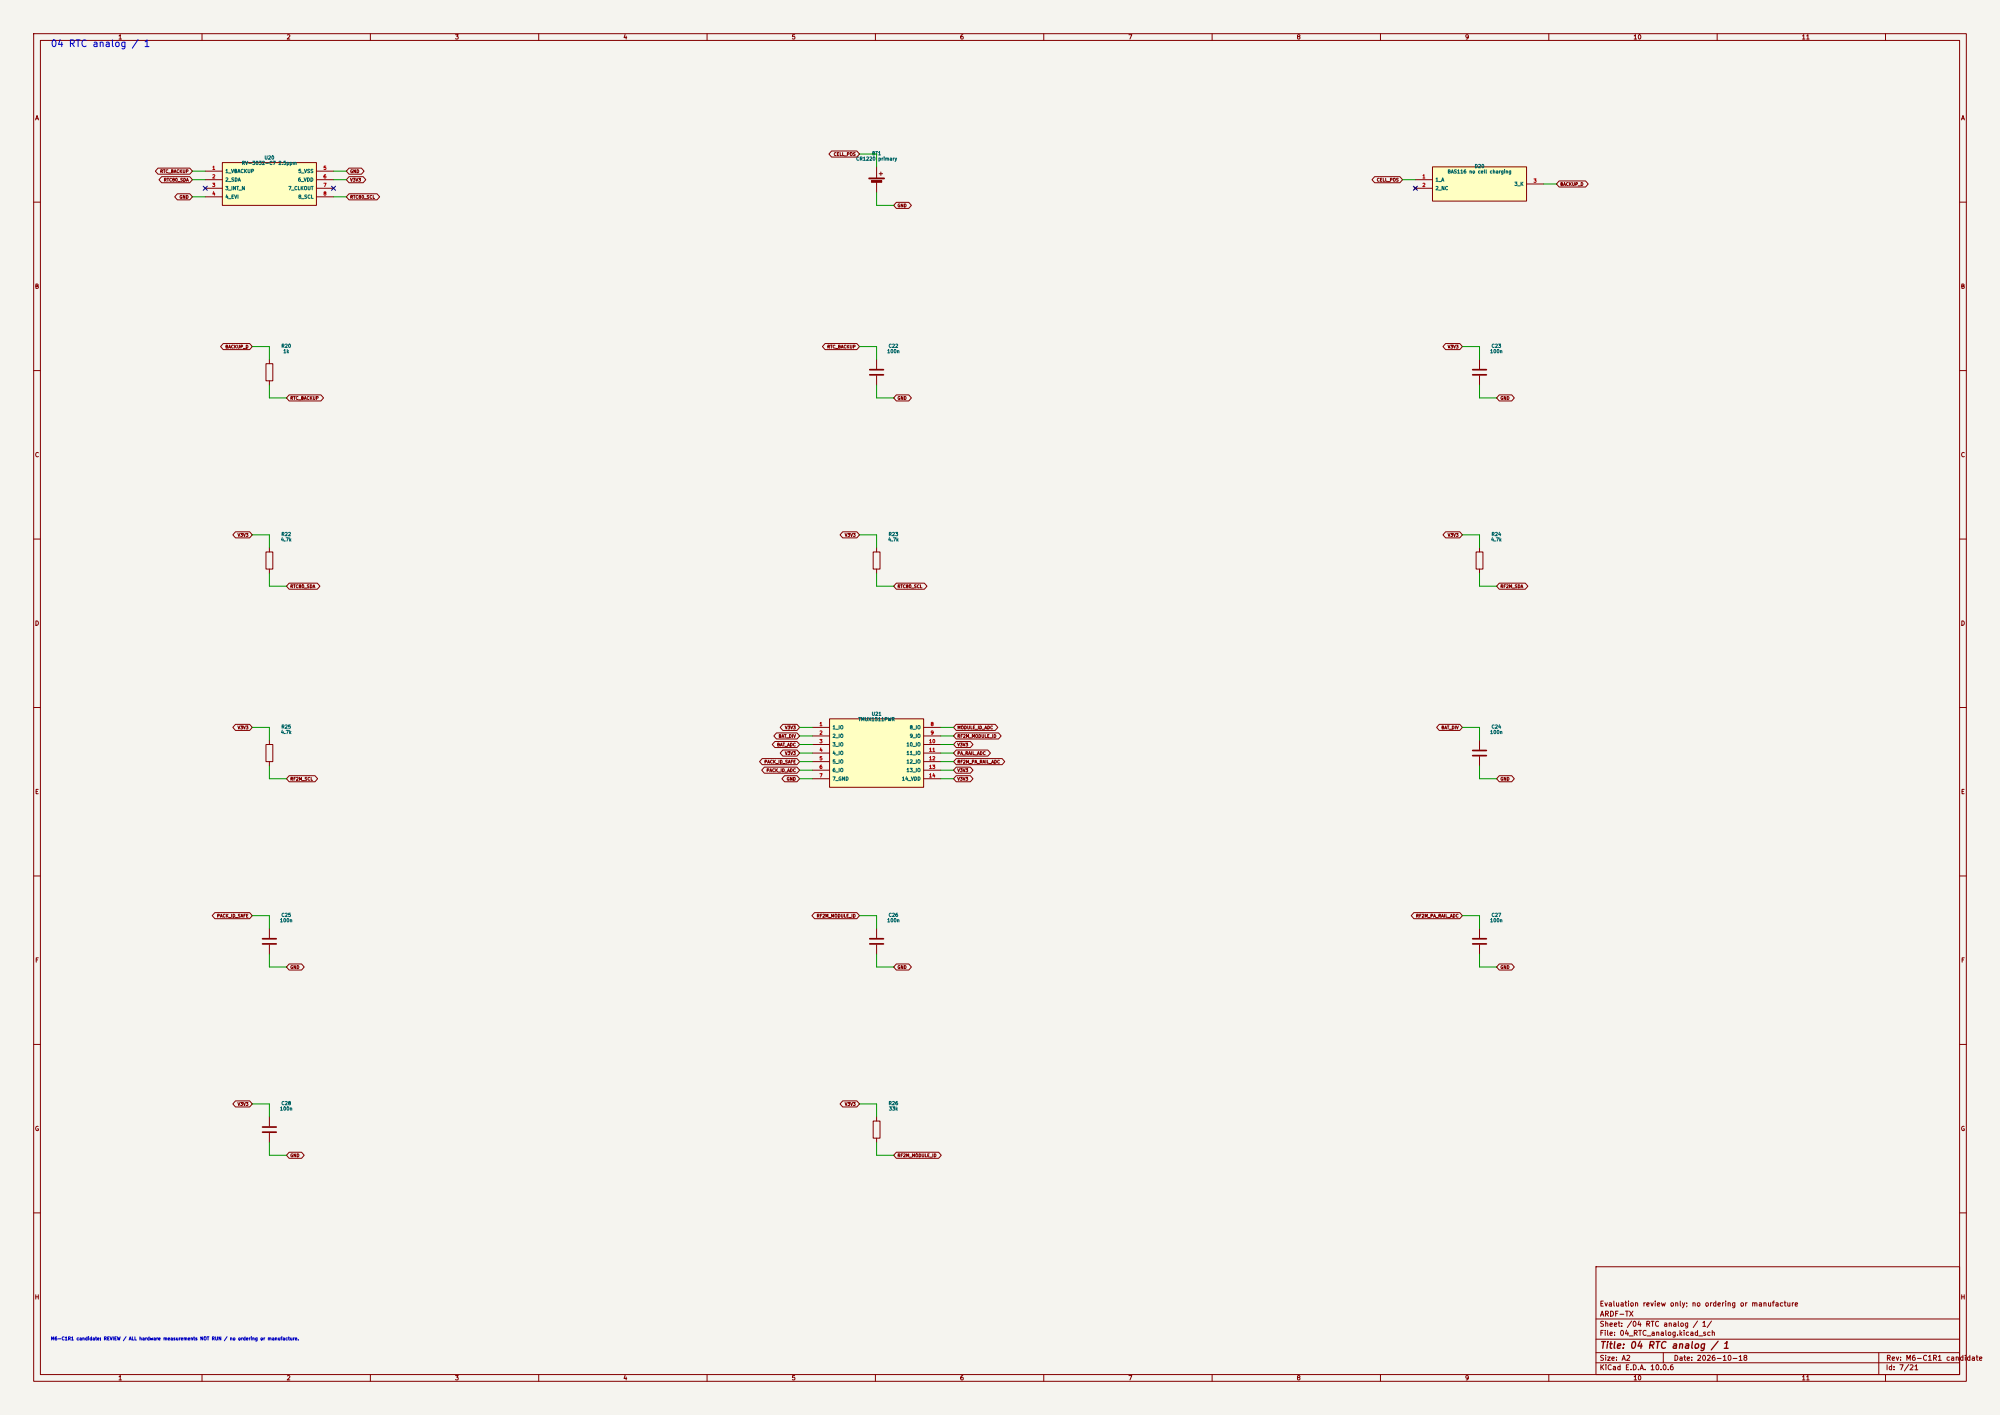
[picture p93: page 8]

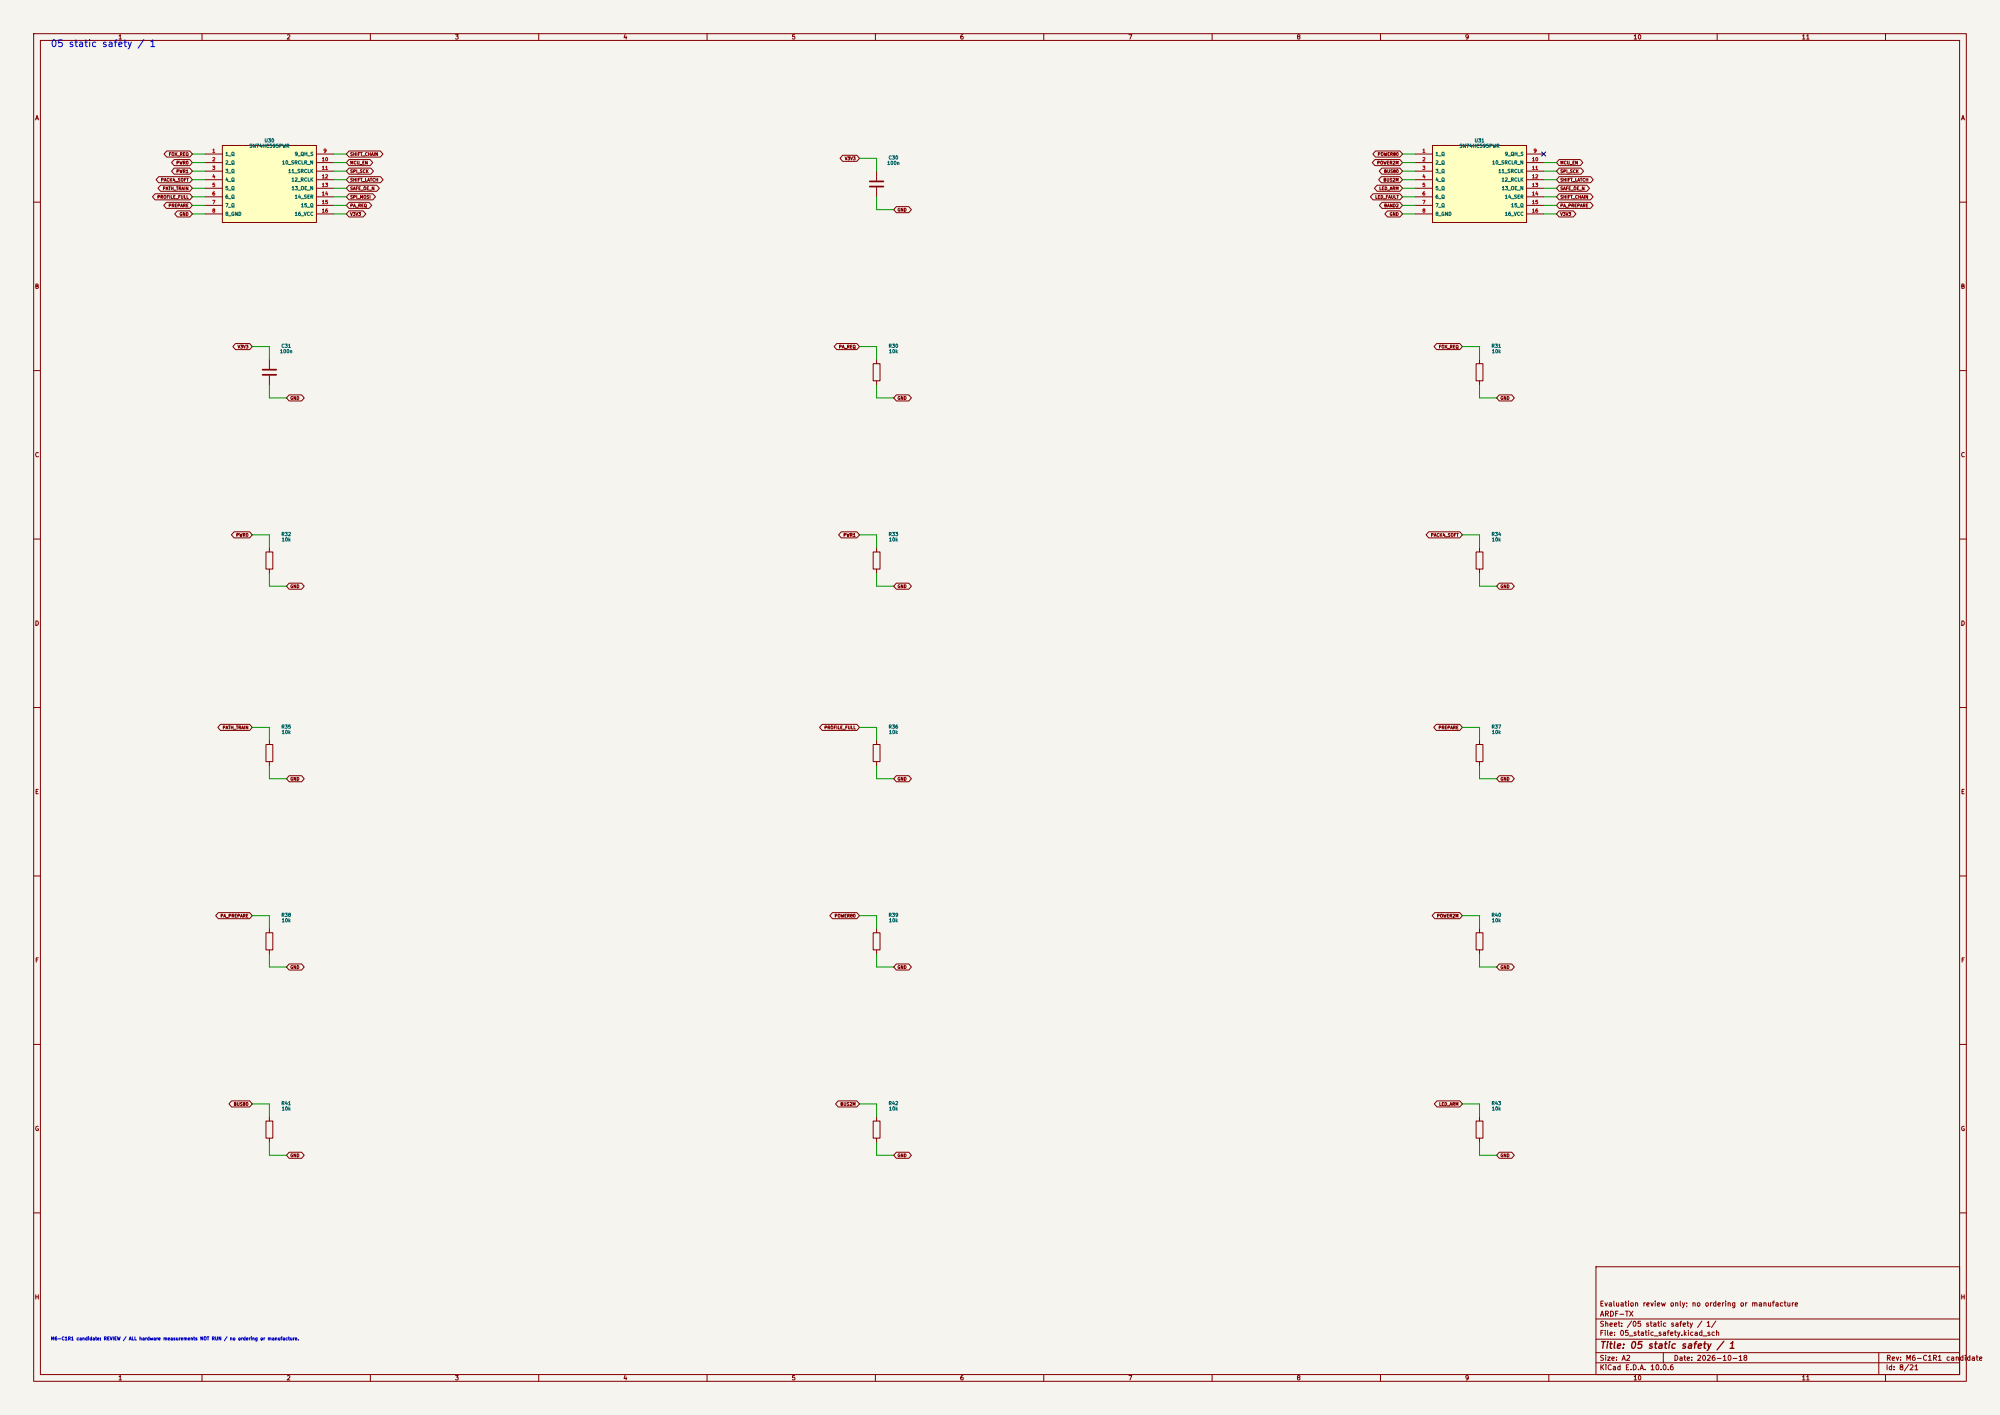
[picture p94: page 9]

BUS2M M6-C1R1 candidate: REVIEW / ALL hardware measurements NOT RUN / no ordering or manufacture.

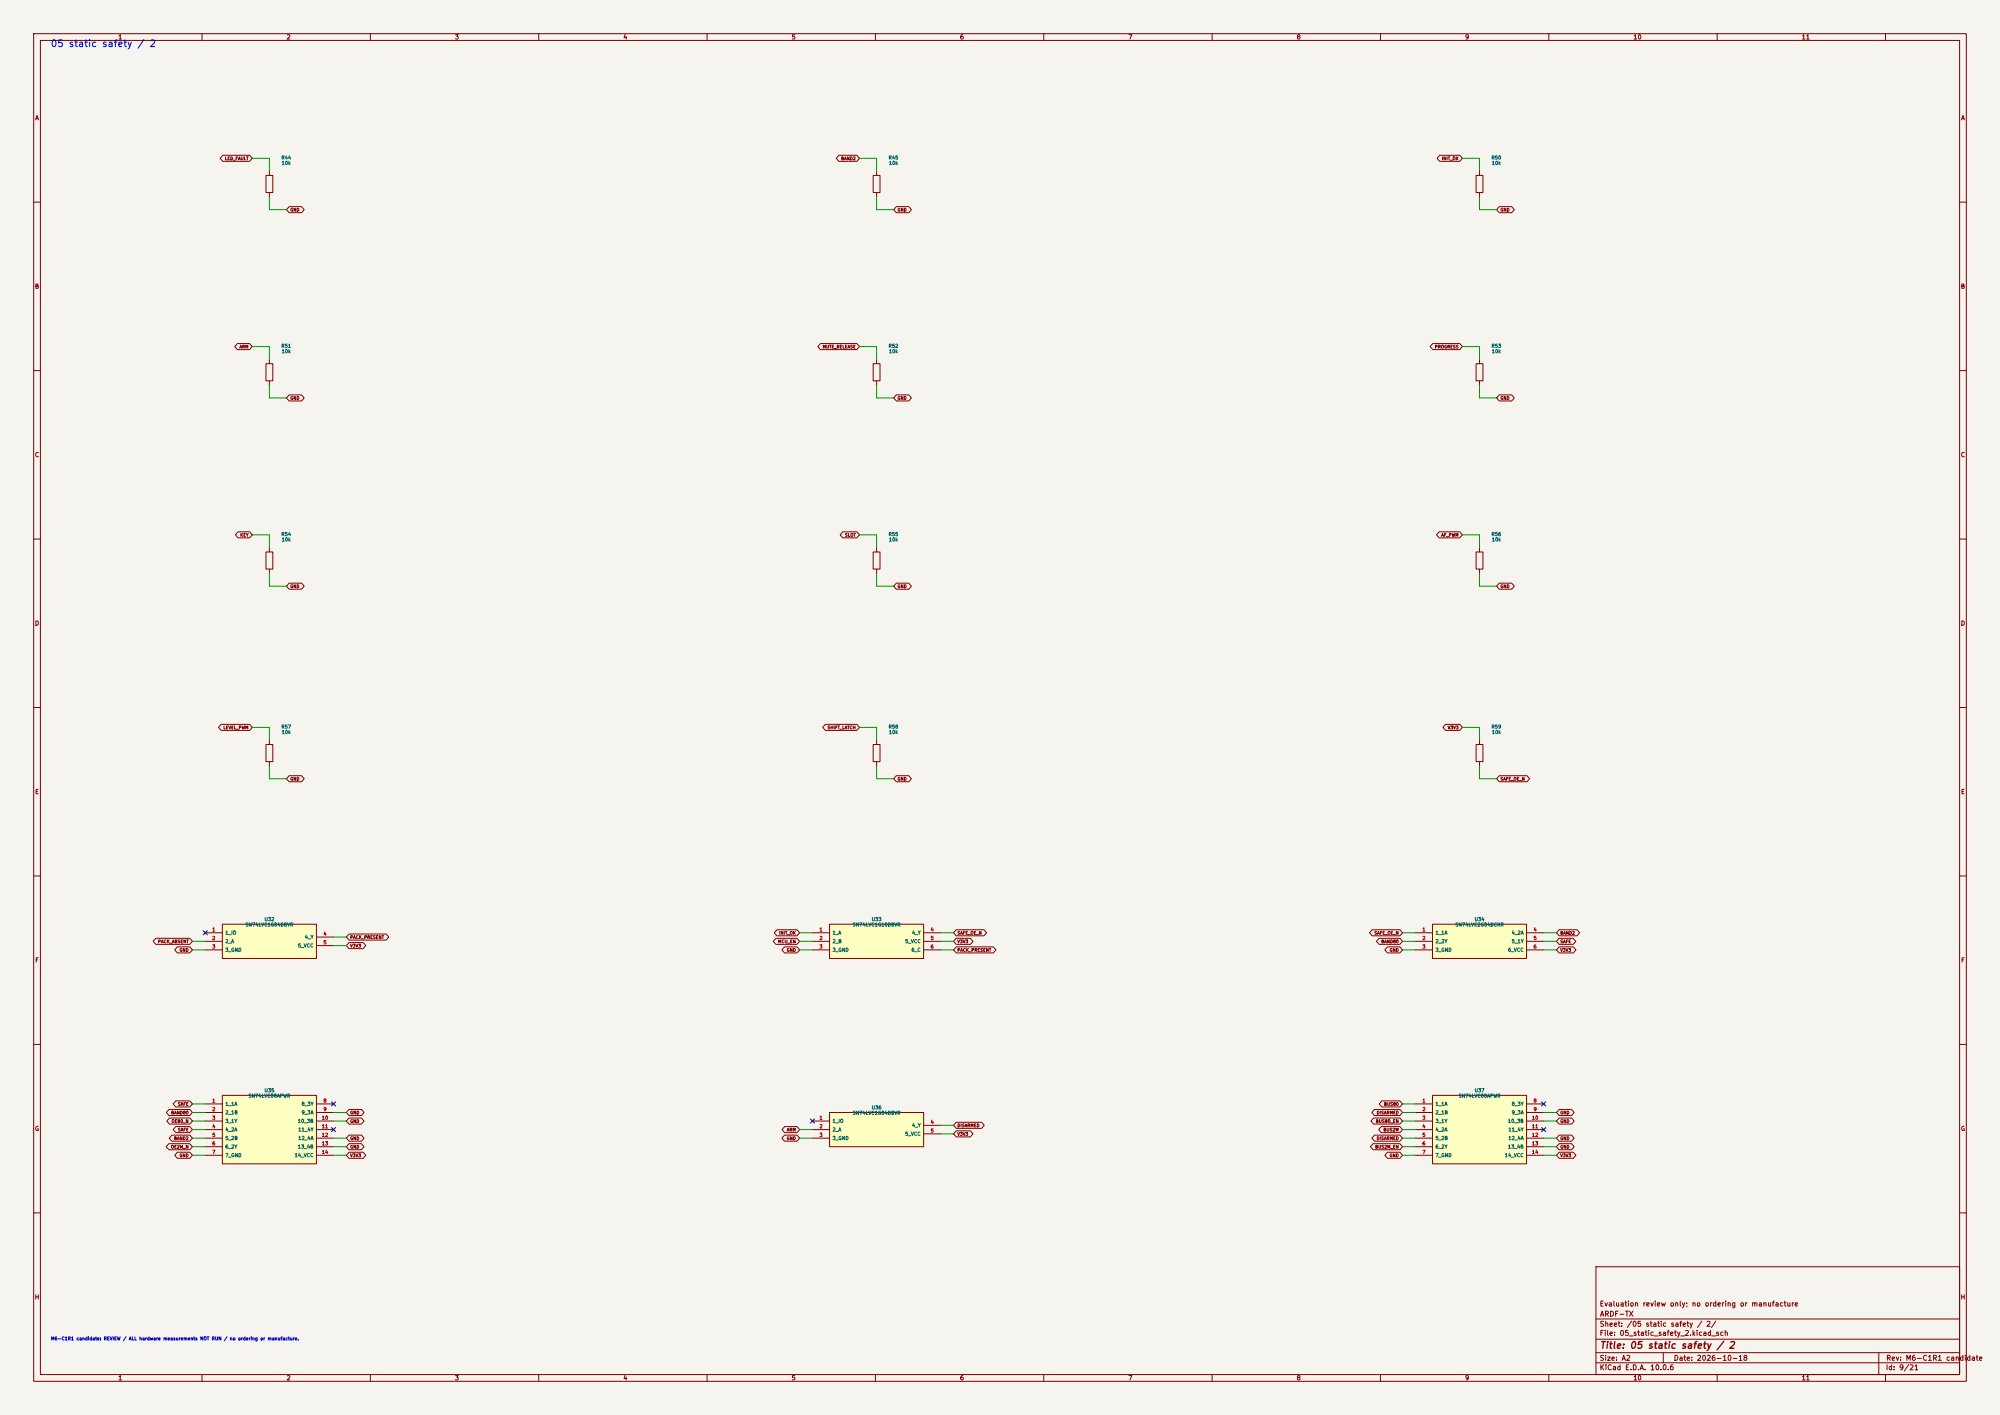
[picture p95: page 10]

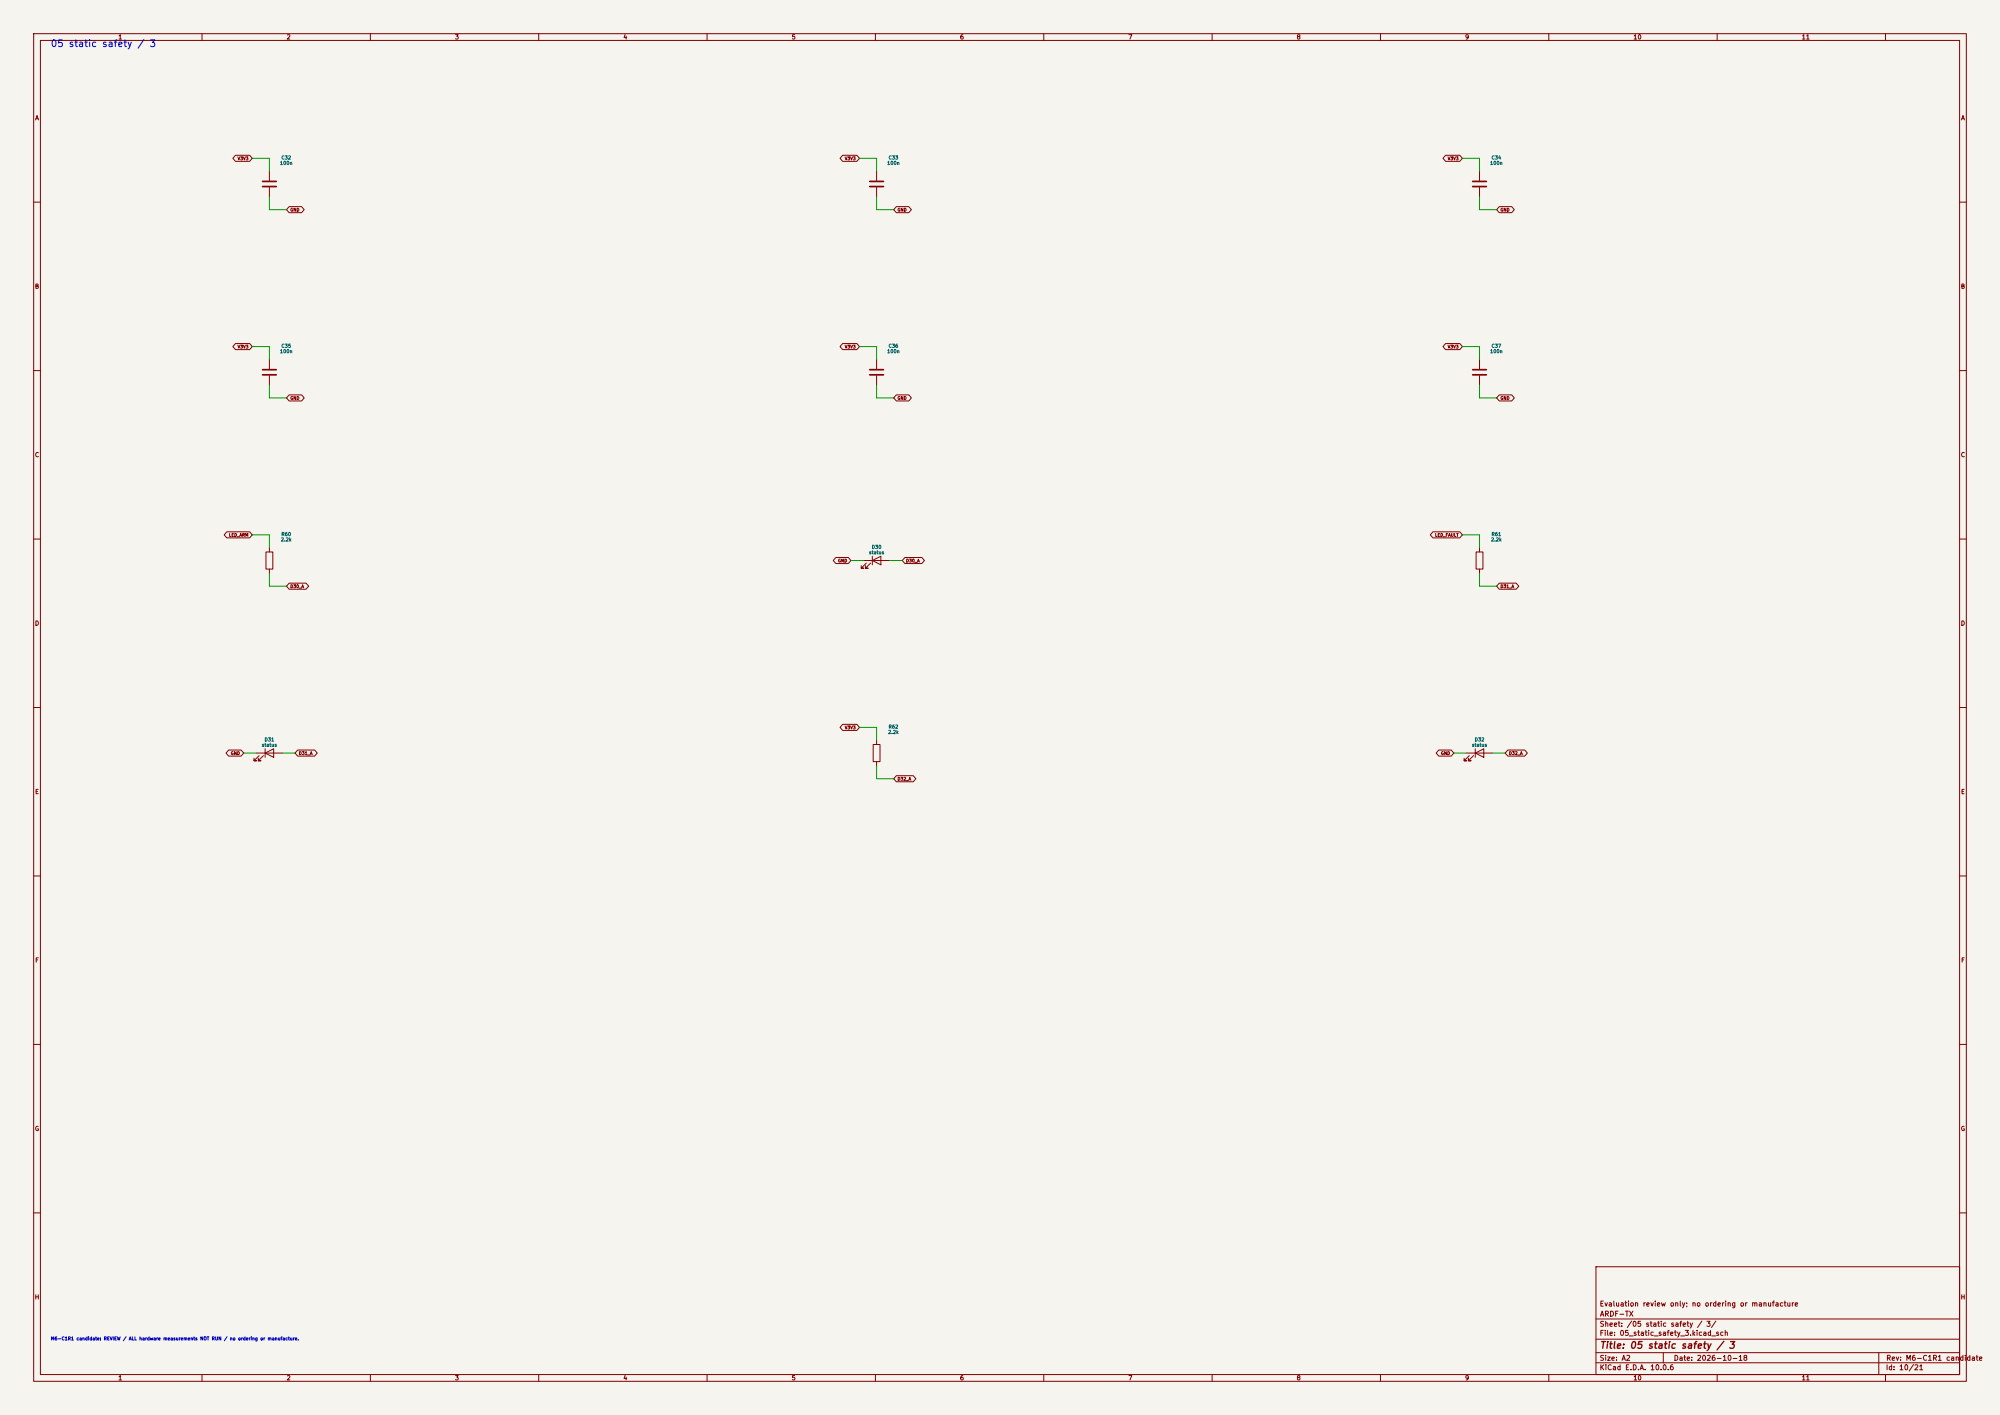
[picture p96: page 11]

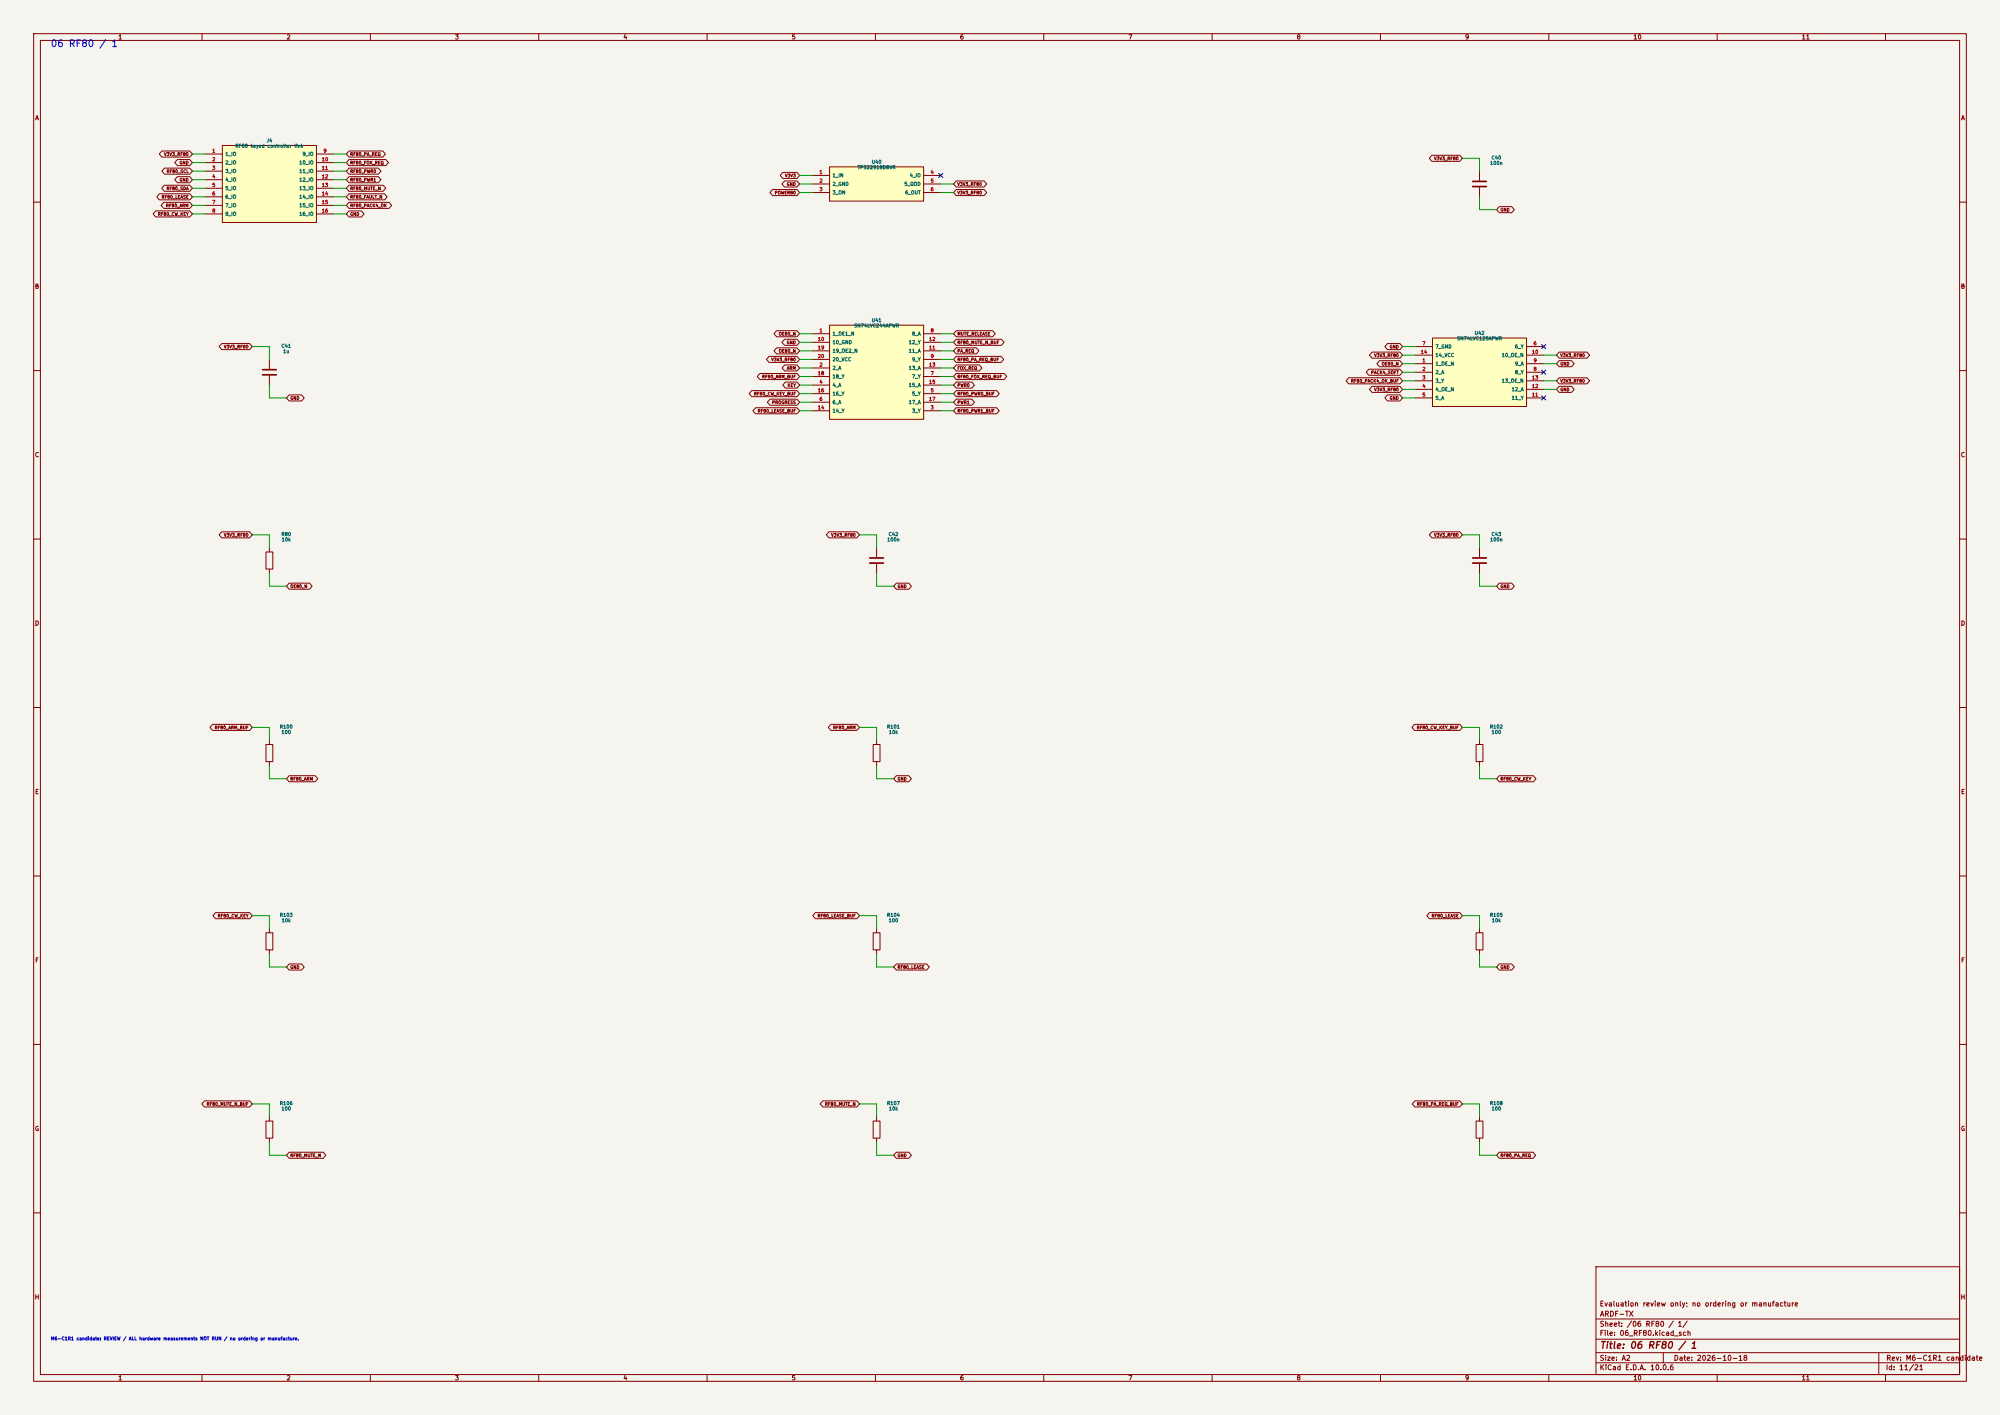
[picture p97: page 12]

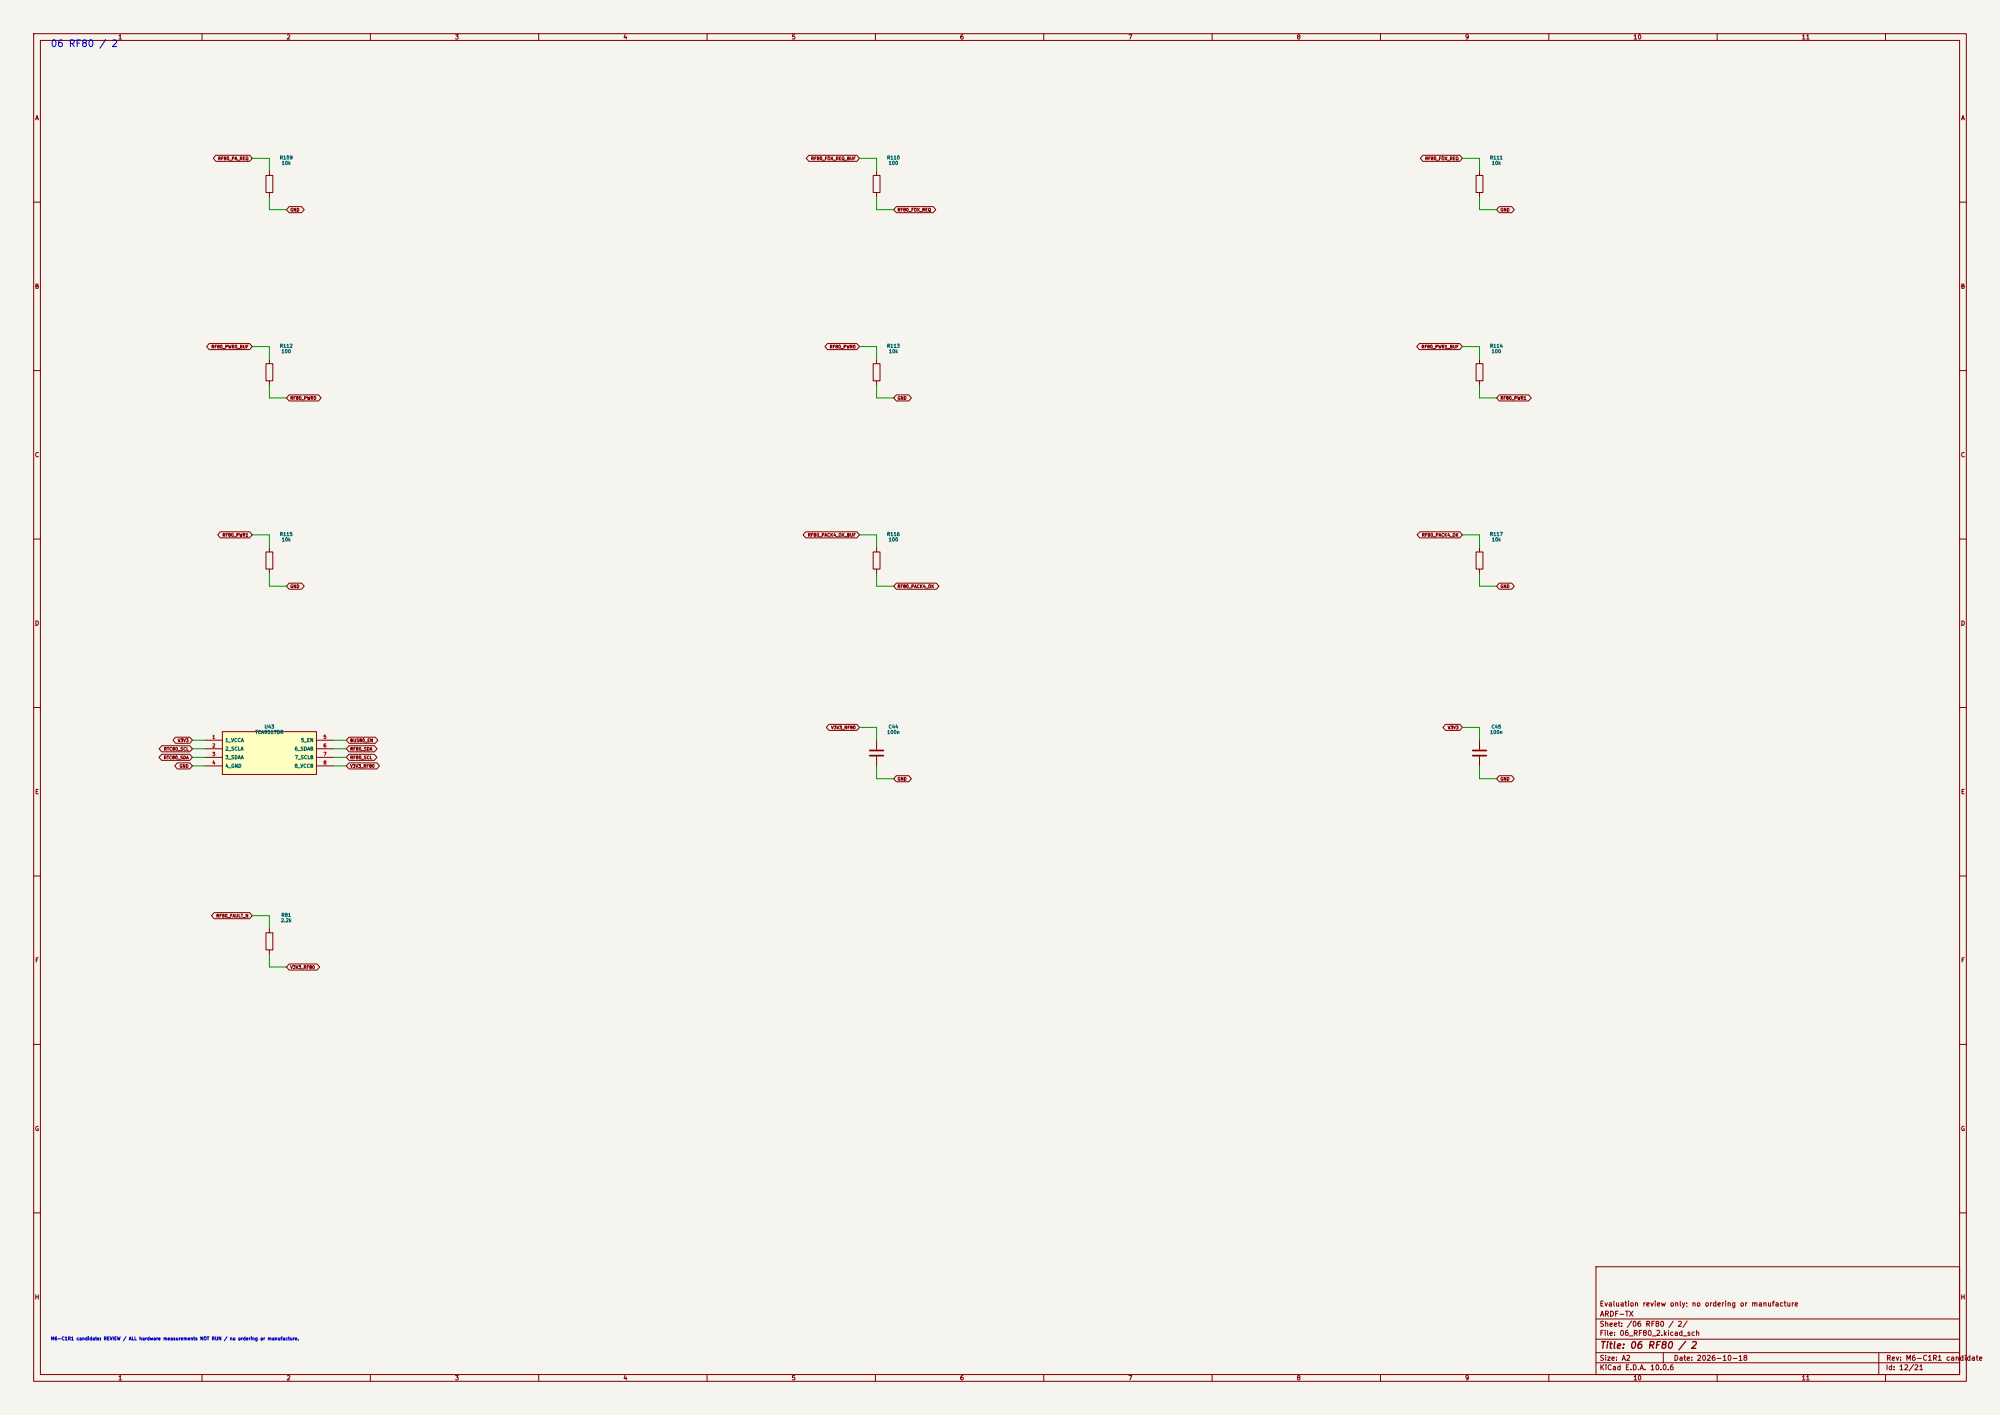
[picture p98: page 13]

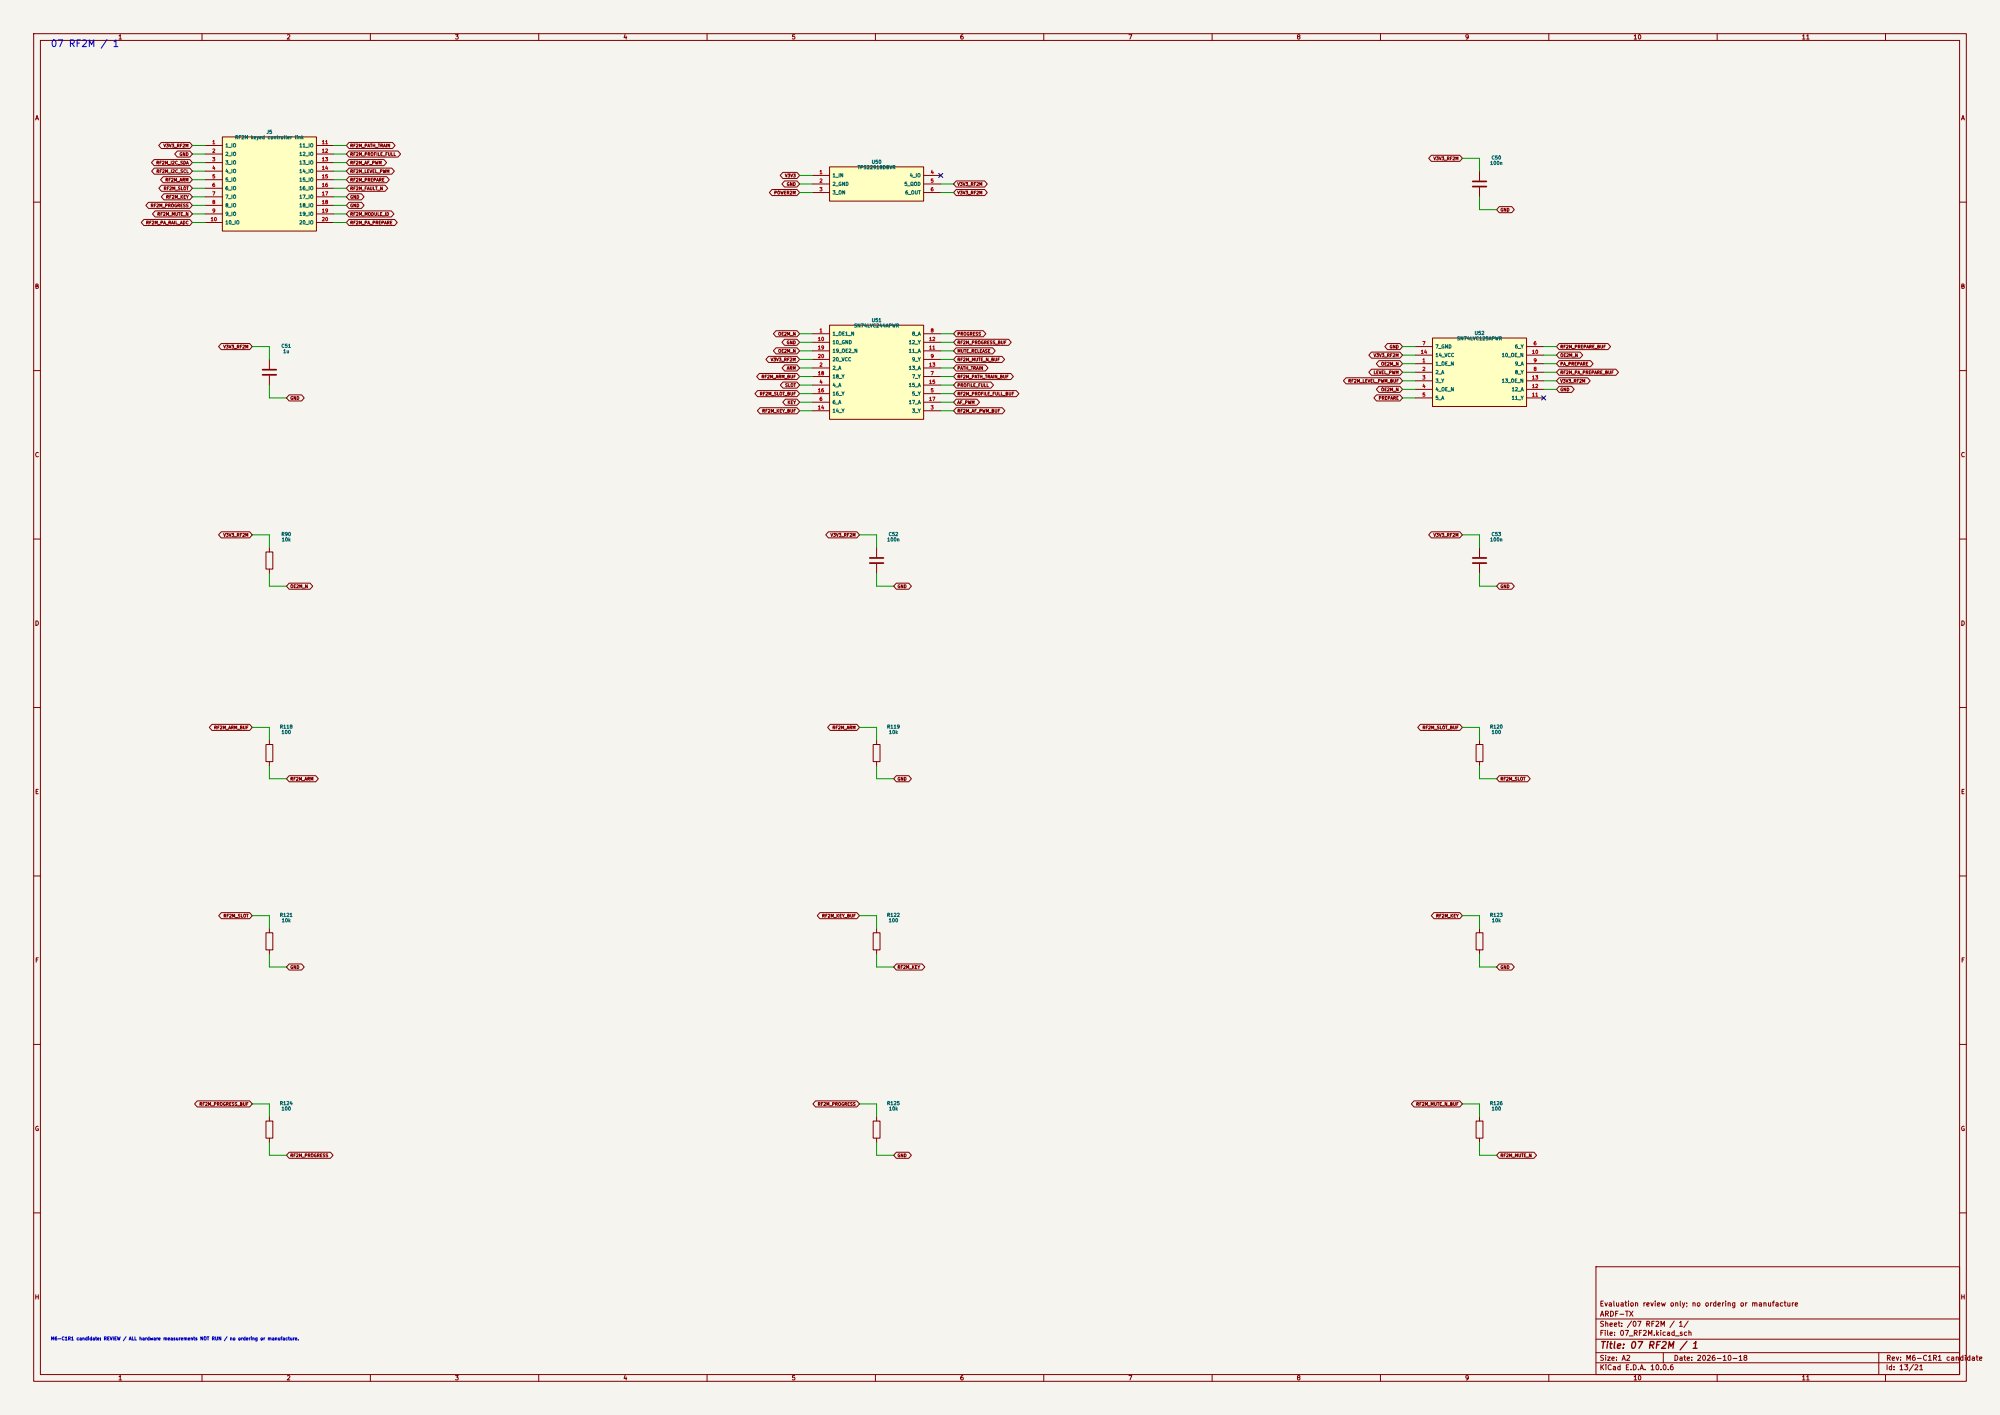
[picture p99: page 14]

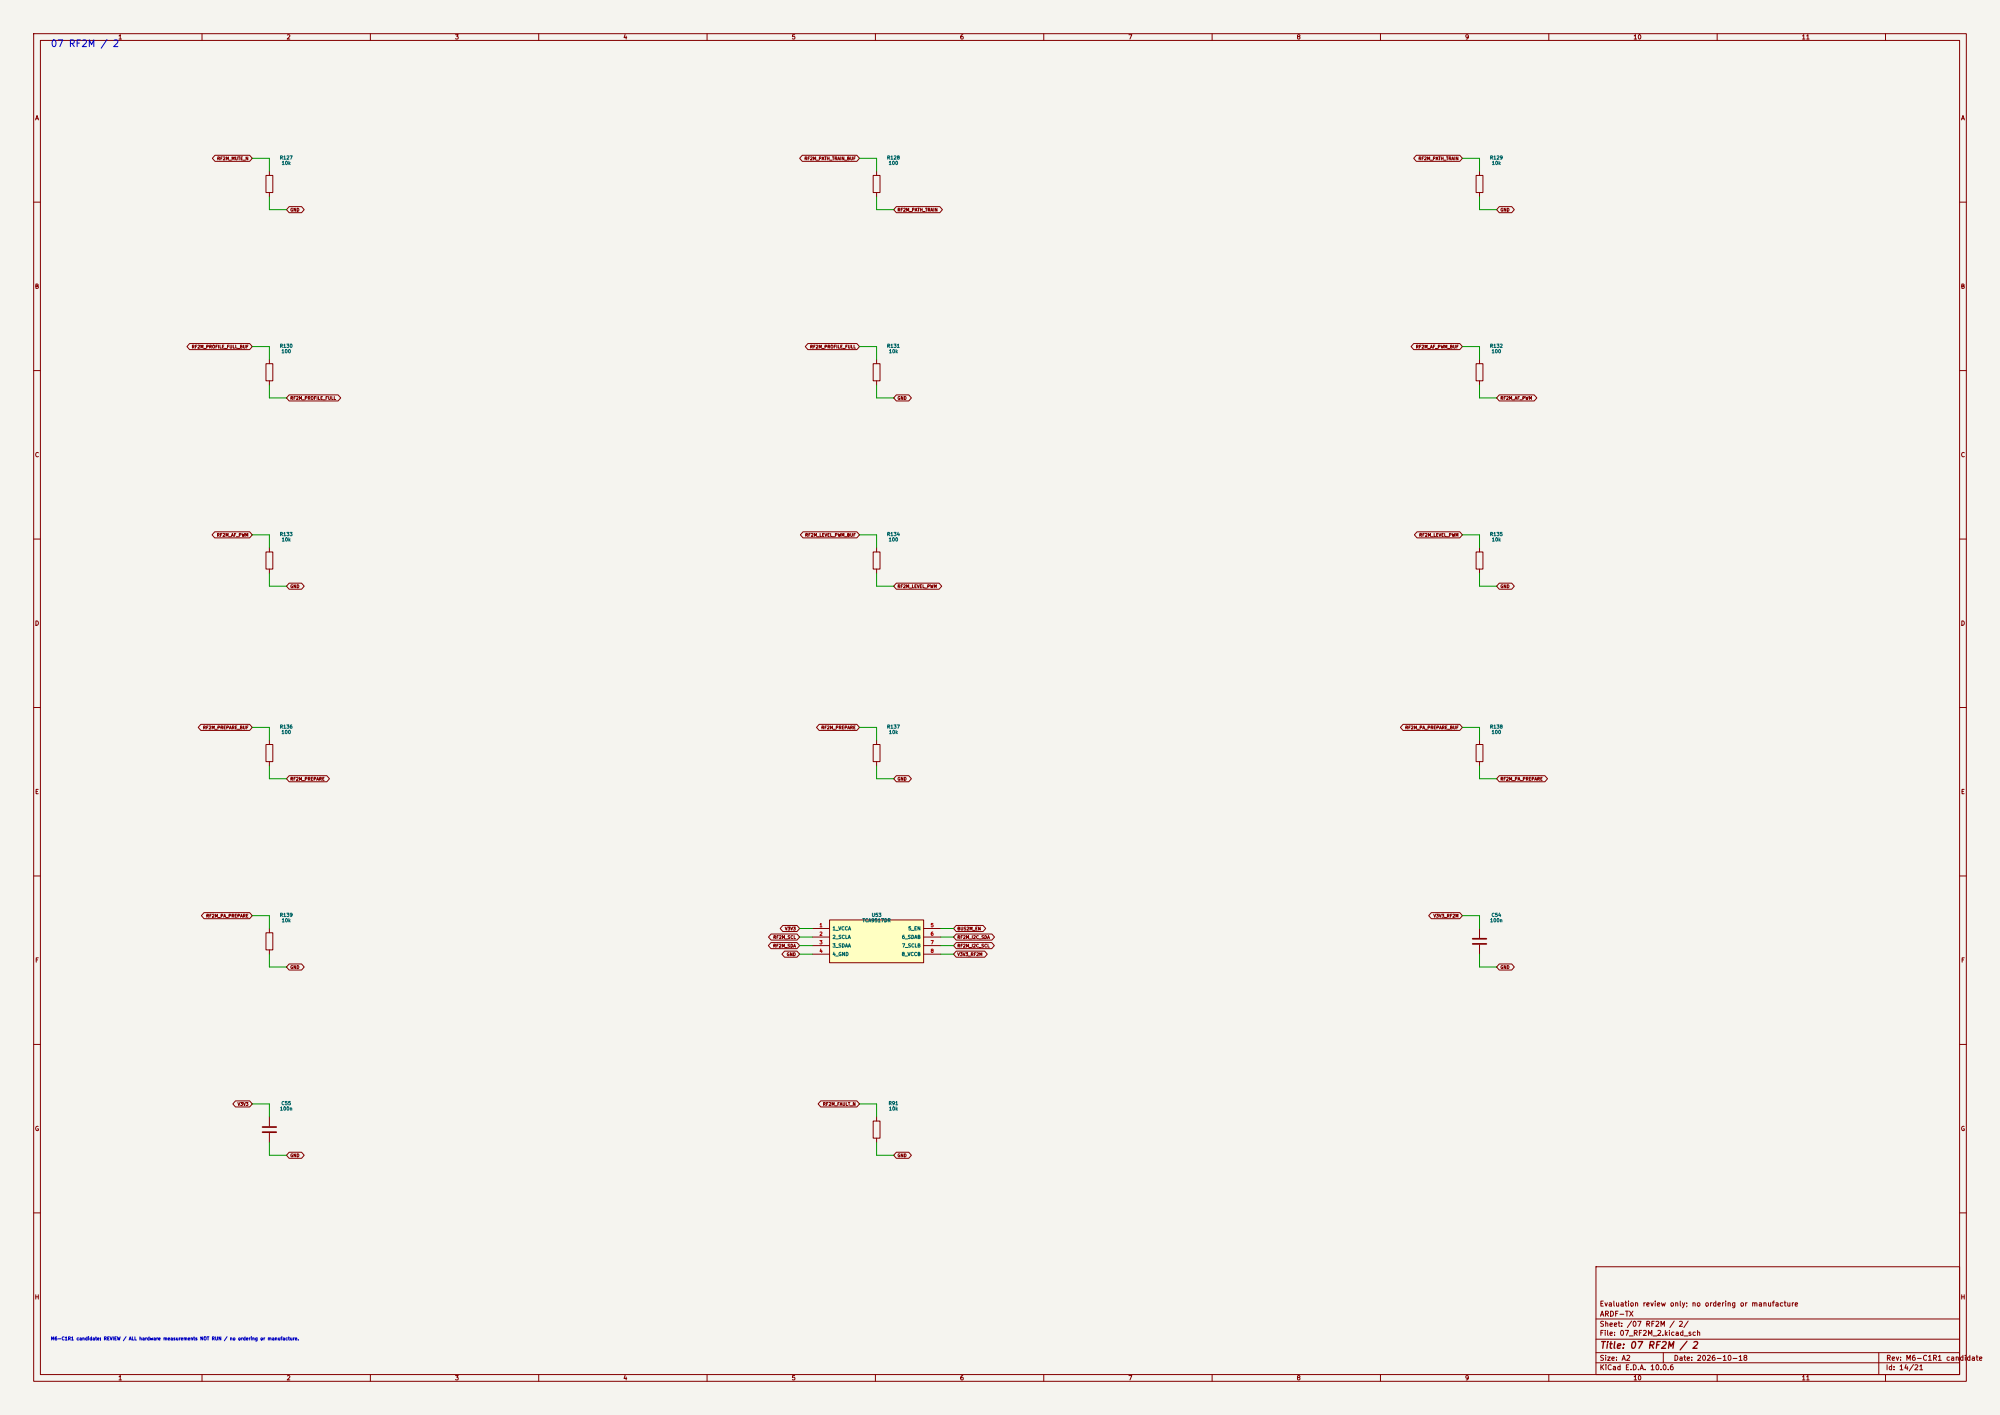
[picture p100: page 15]

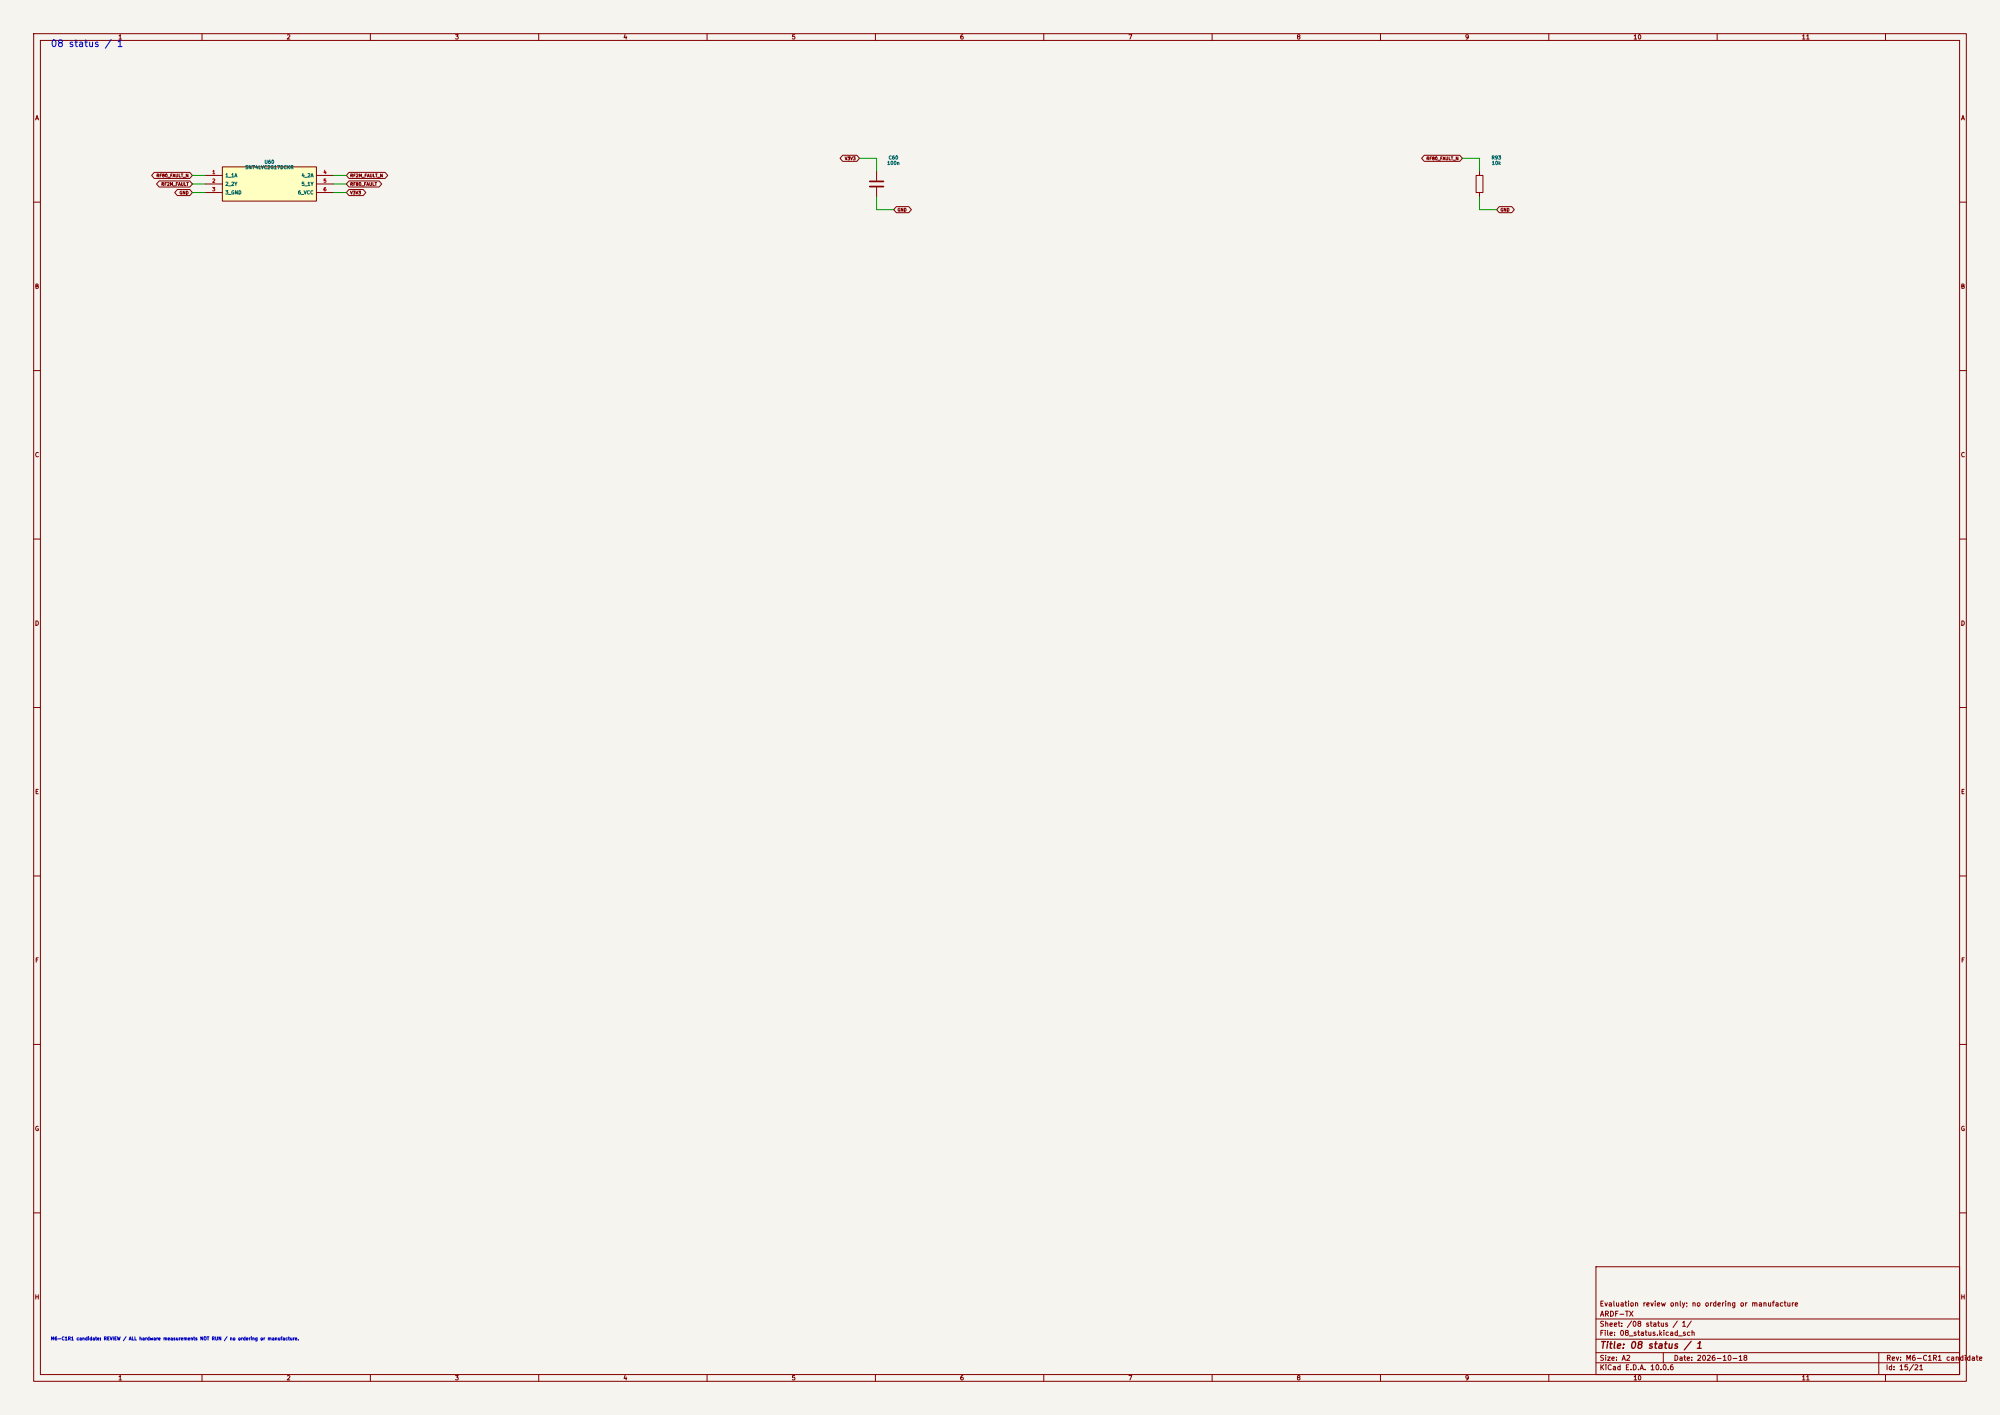
[picture p101: page 16]

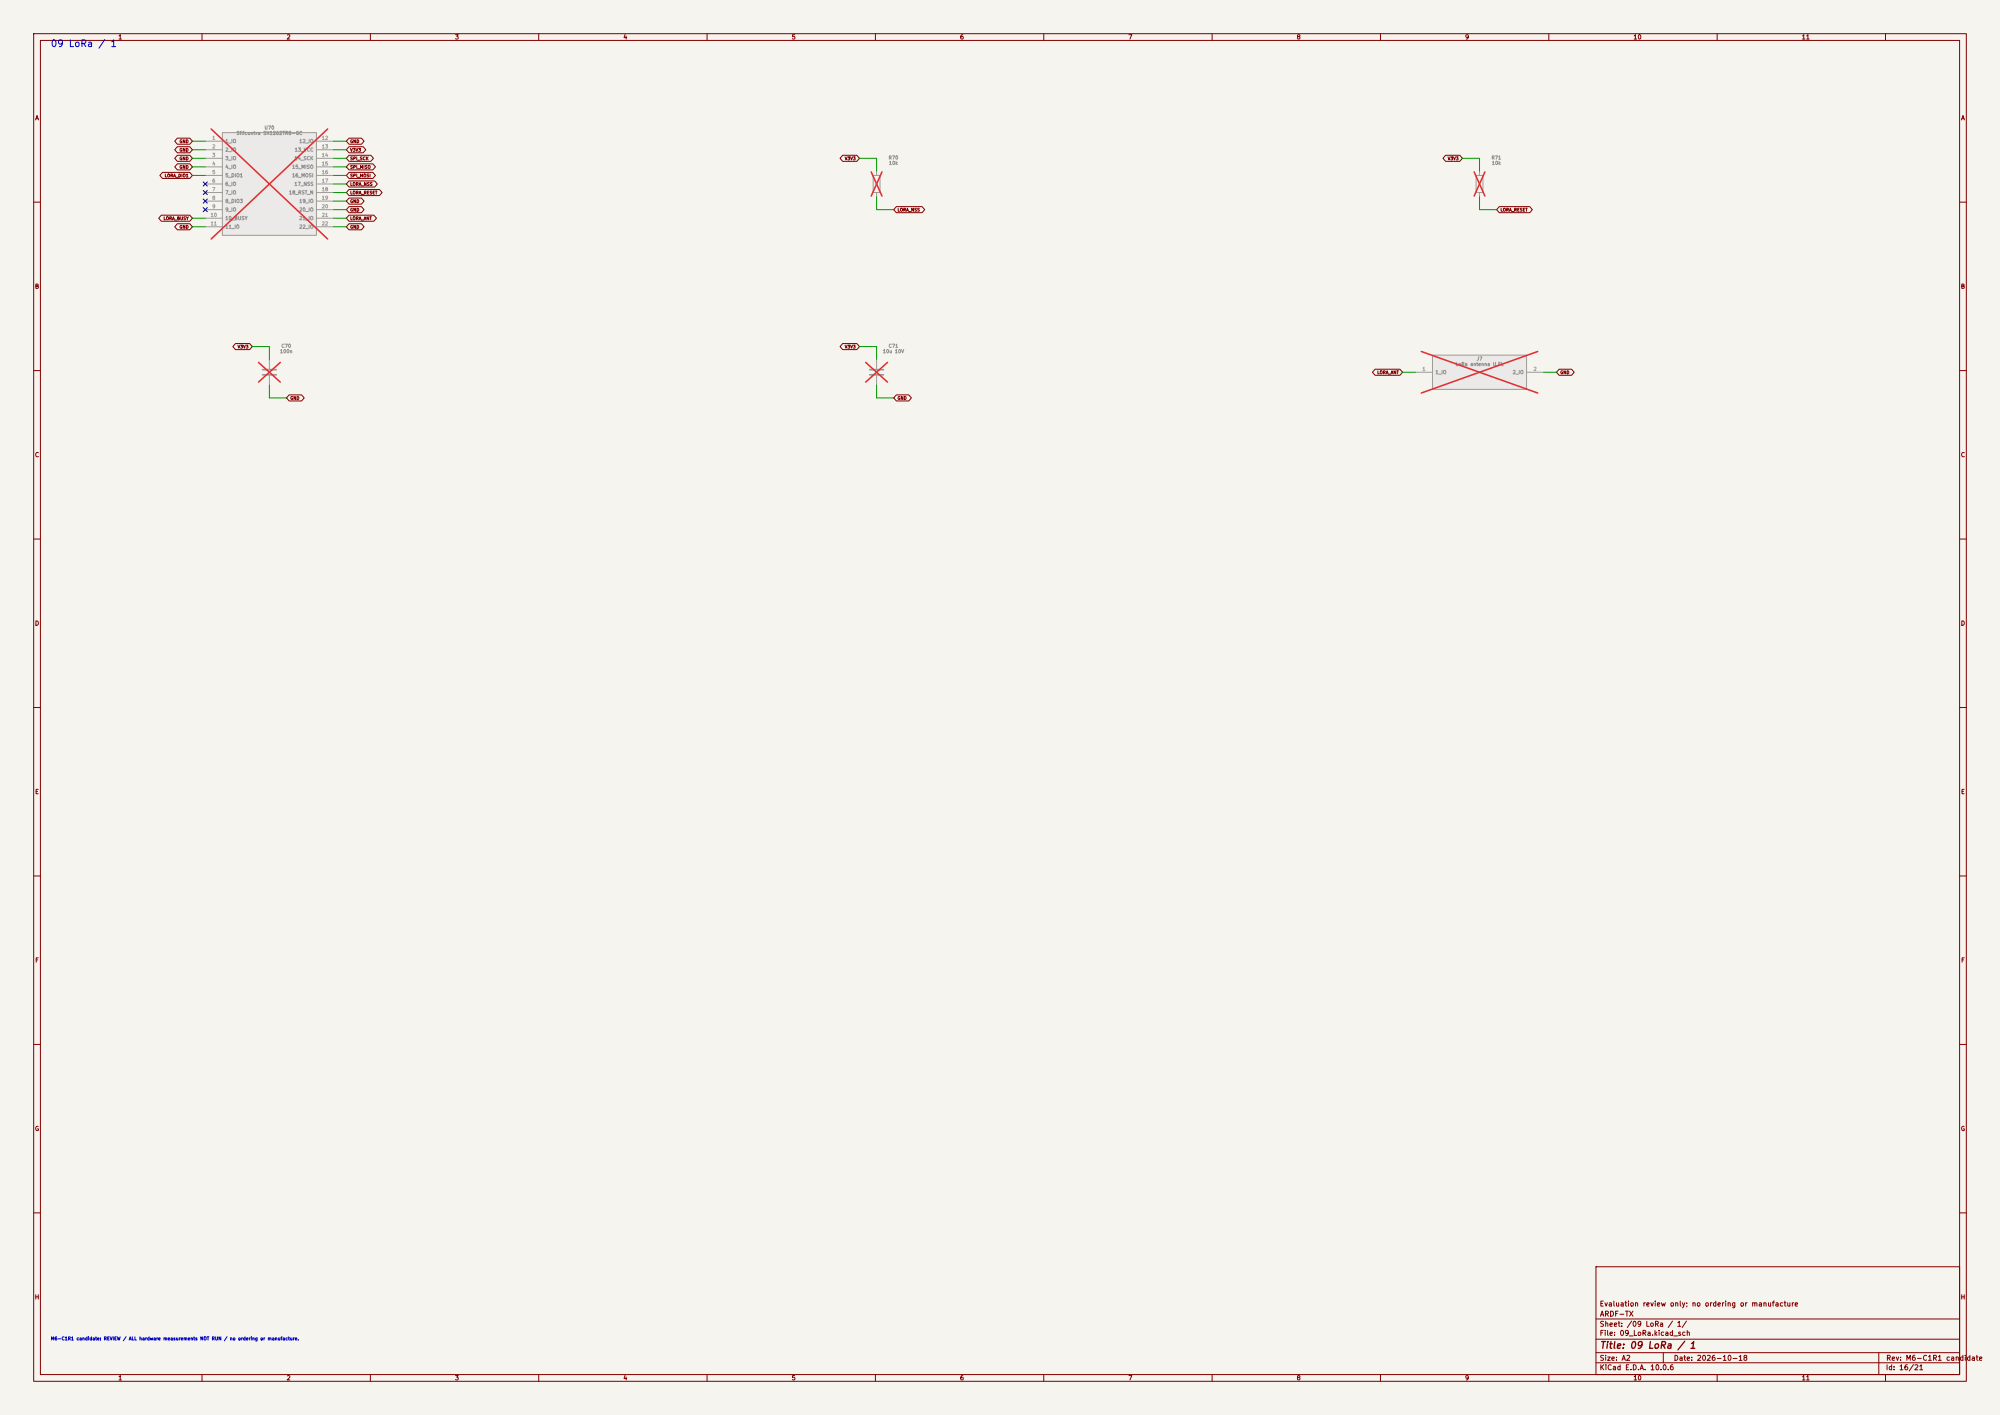
[picture p102: page 17]

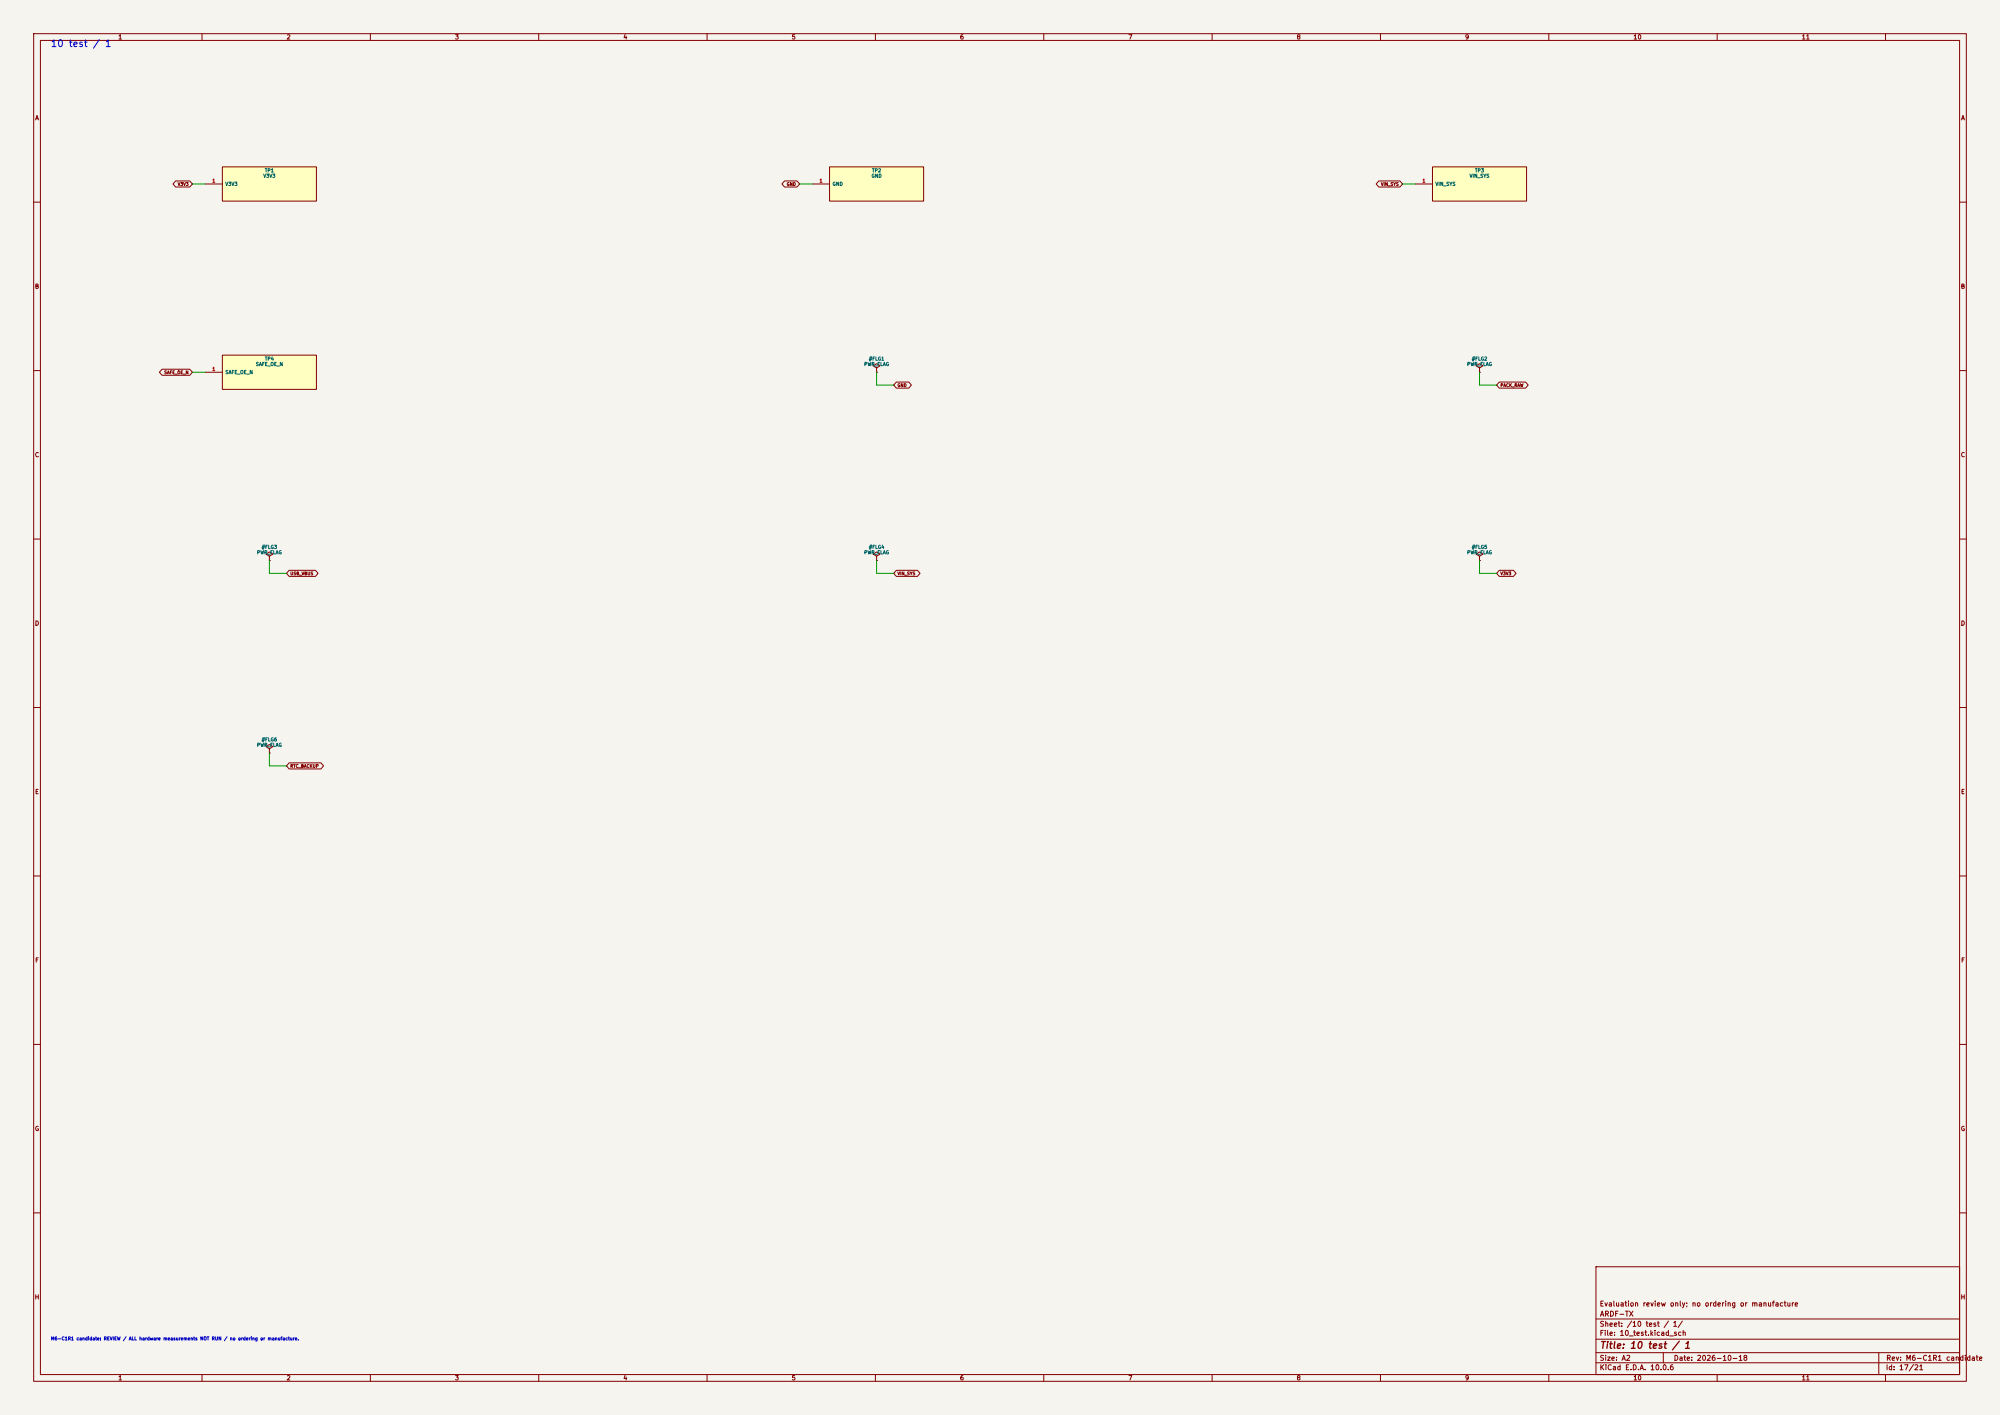
[picture p103: page 18]

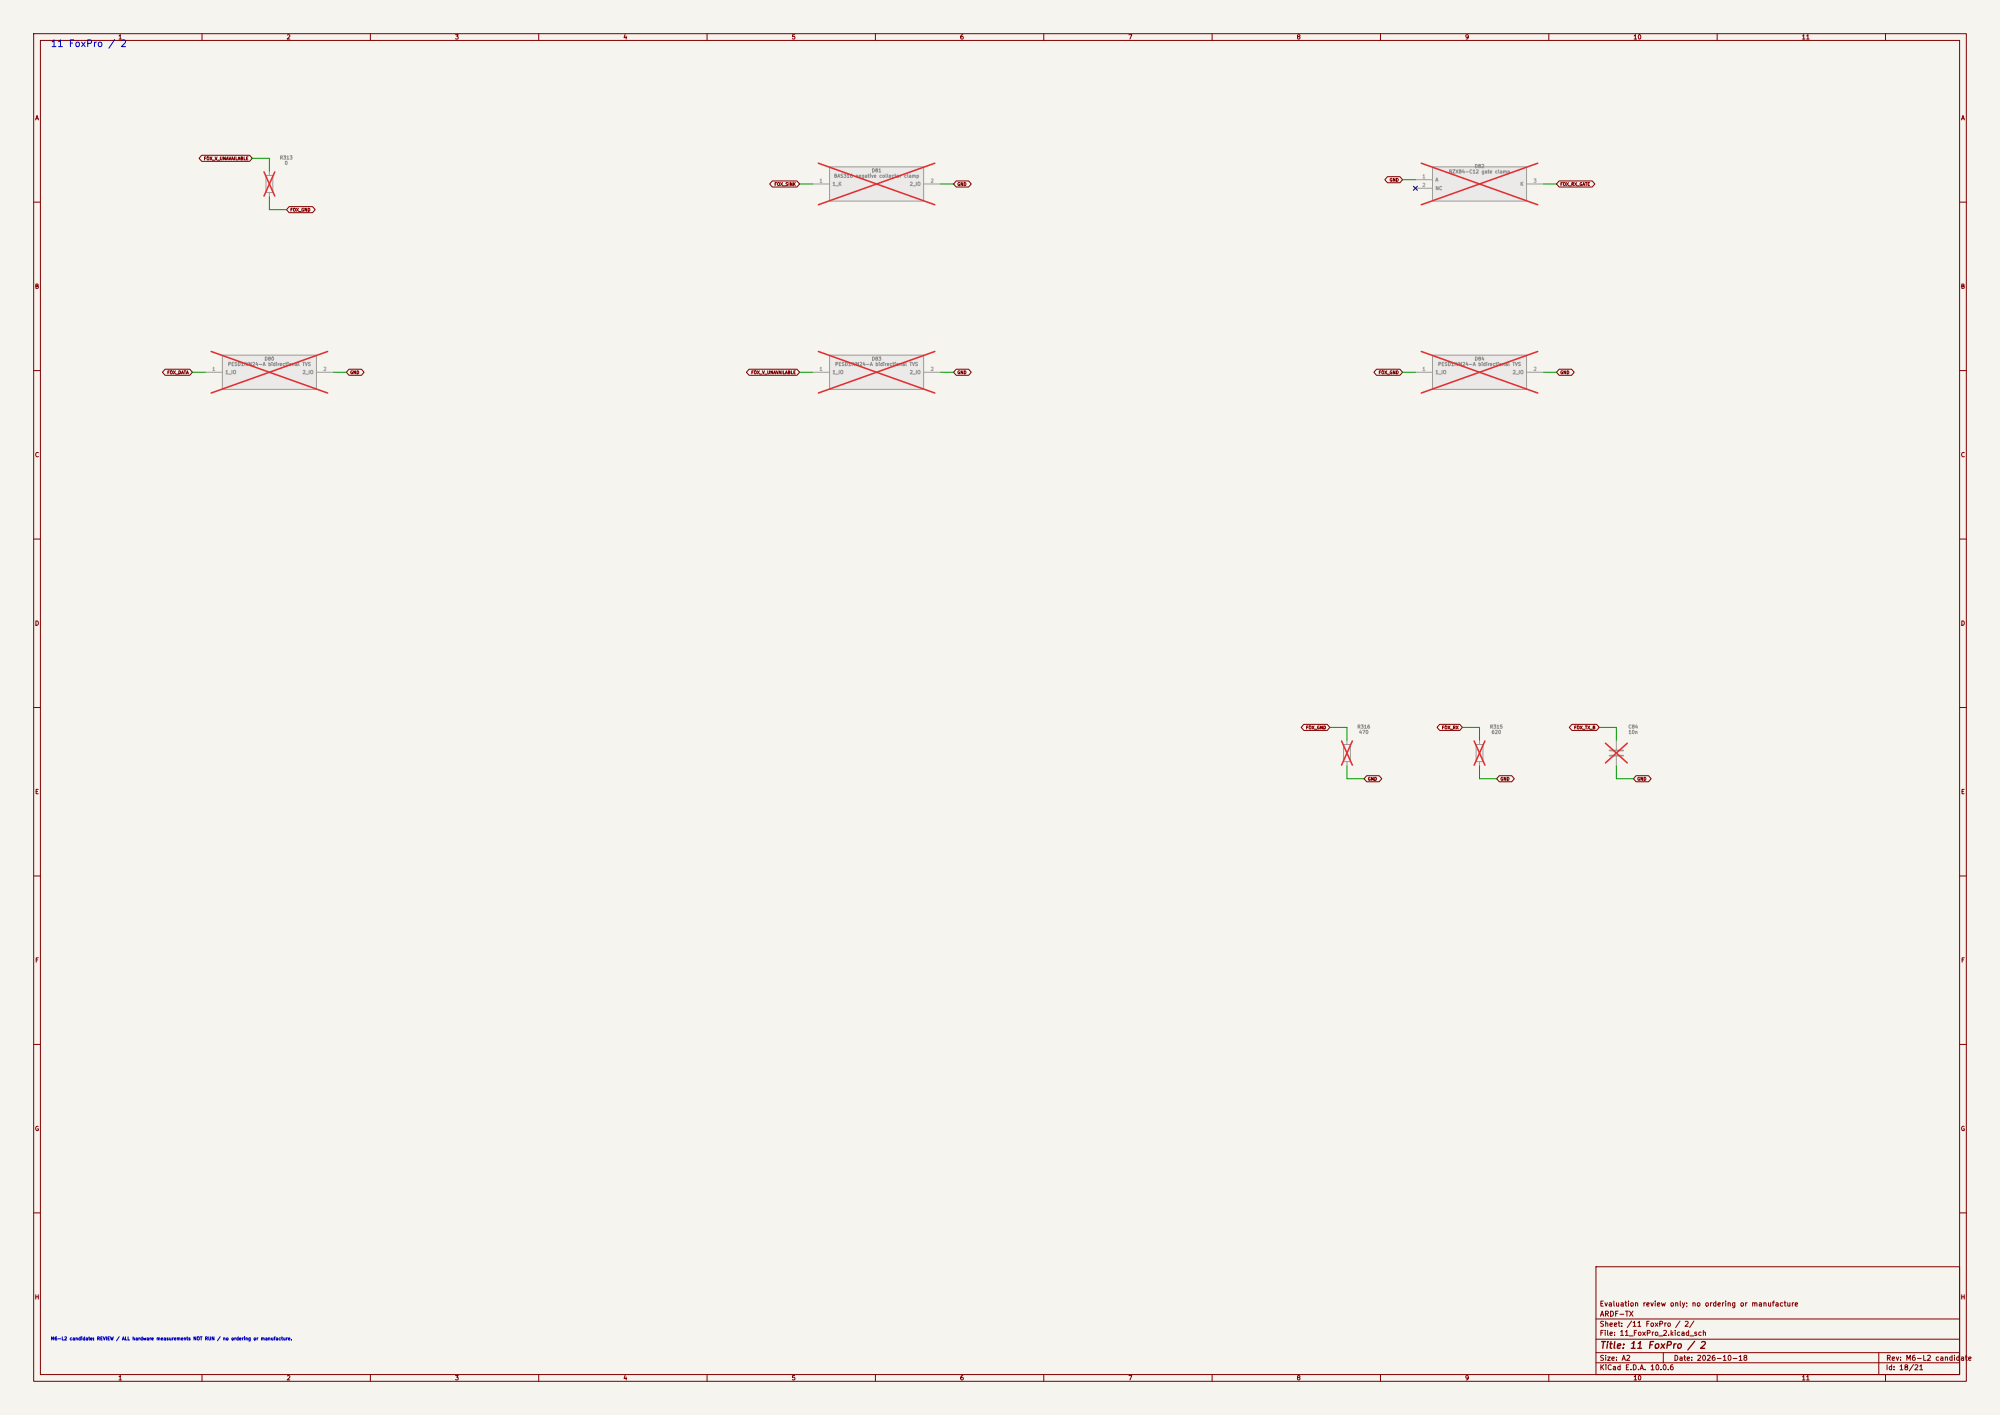
[picture p104: page 19]

M6-L2 candidate: REVIEW / ALL hardware measurements NOT RUN / no ordering or manufacture.

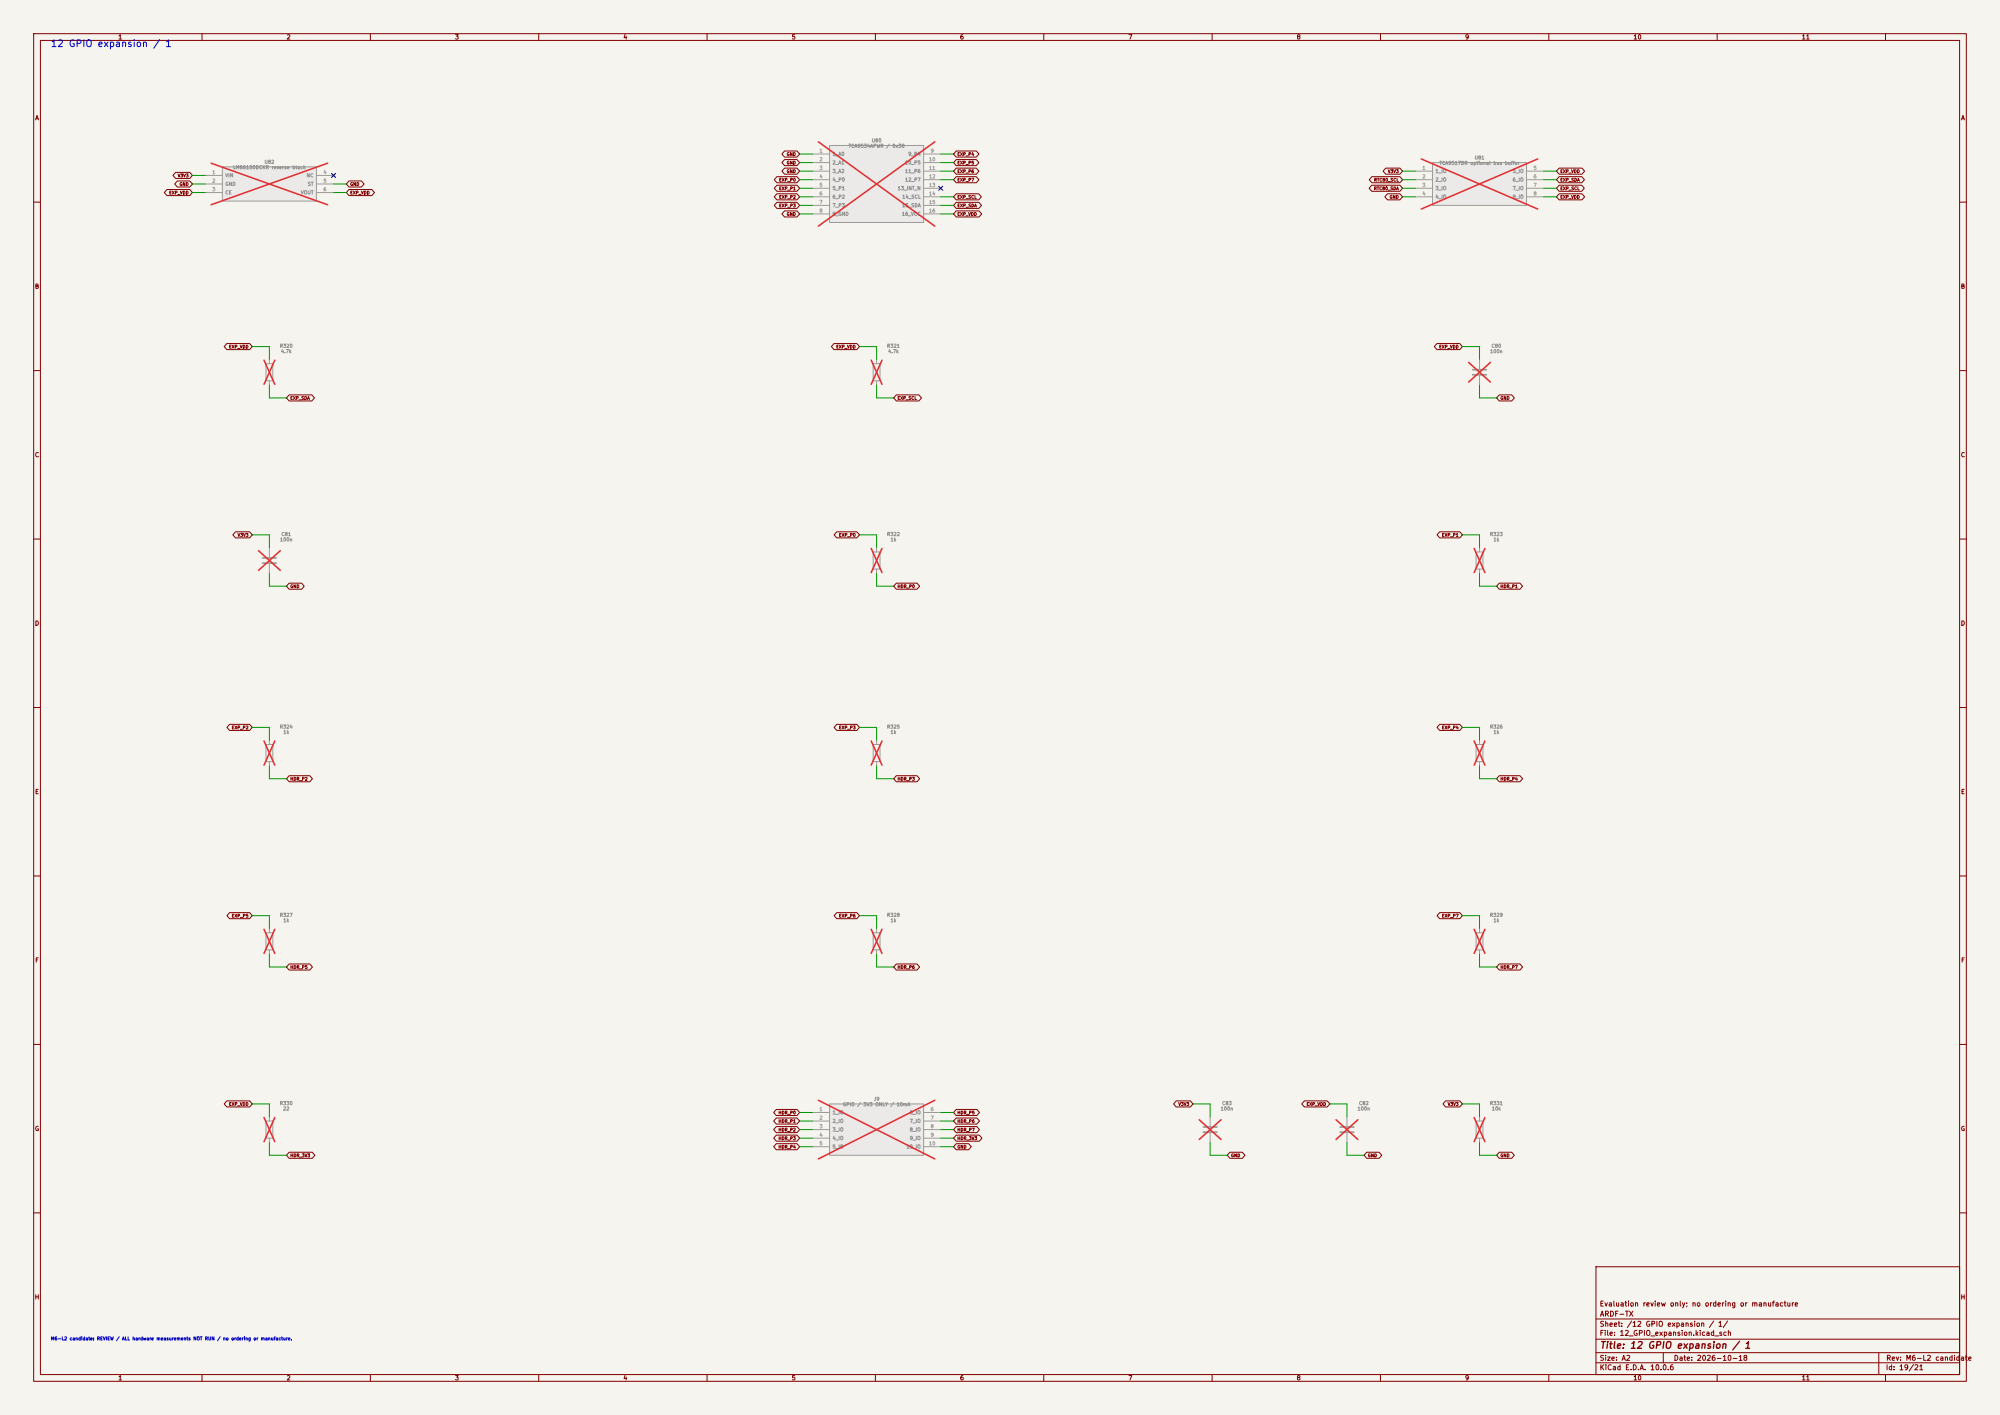
[picture p105: page 20]

M6-L2 candidate: REVIEW / ALL hardware measurements NOT RUN / no ordering or manufacture.

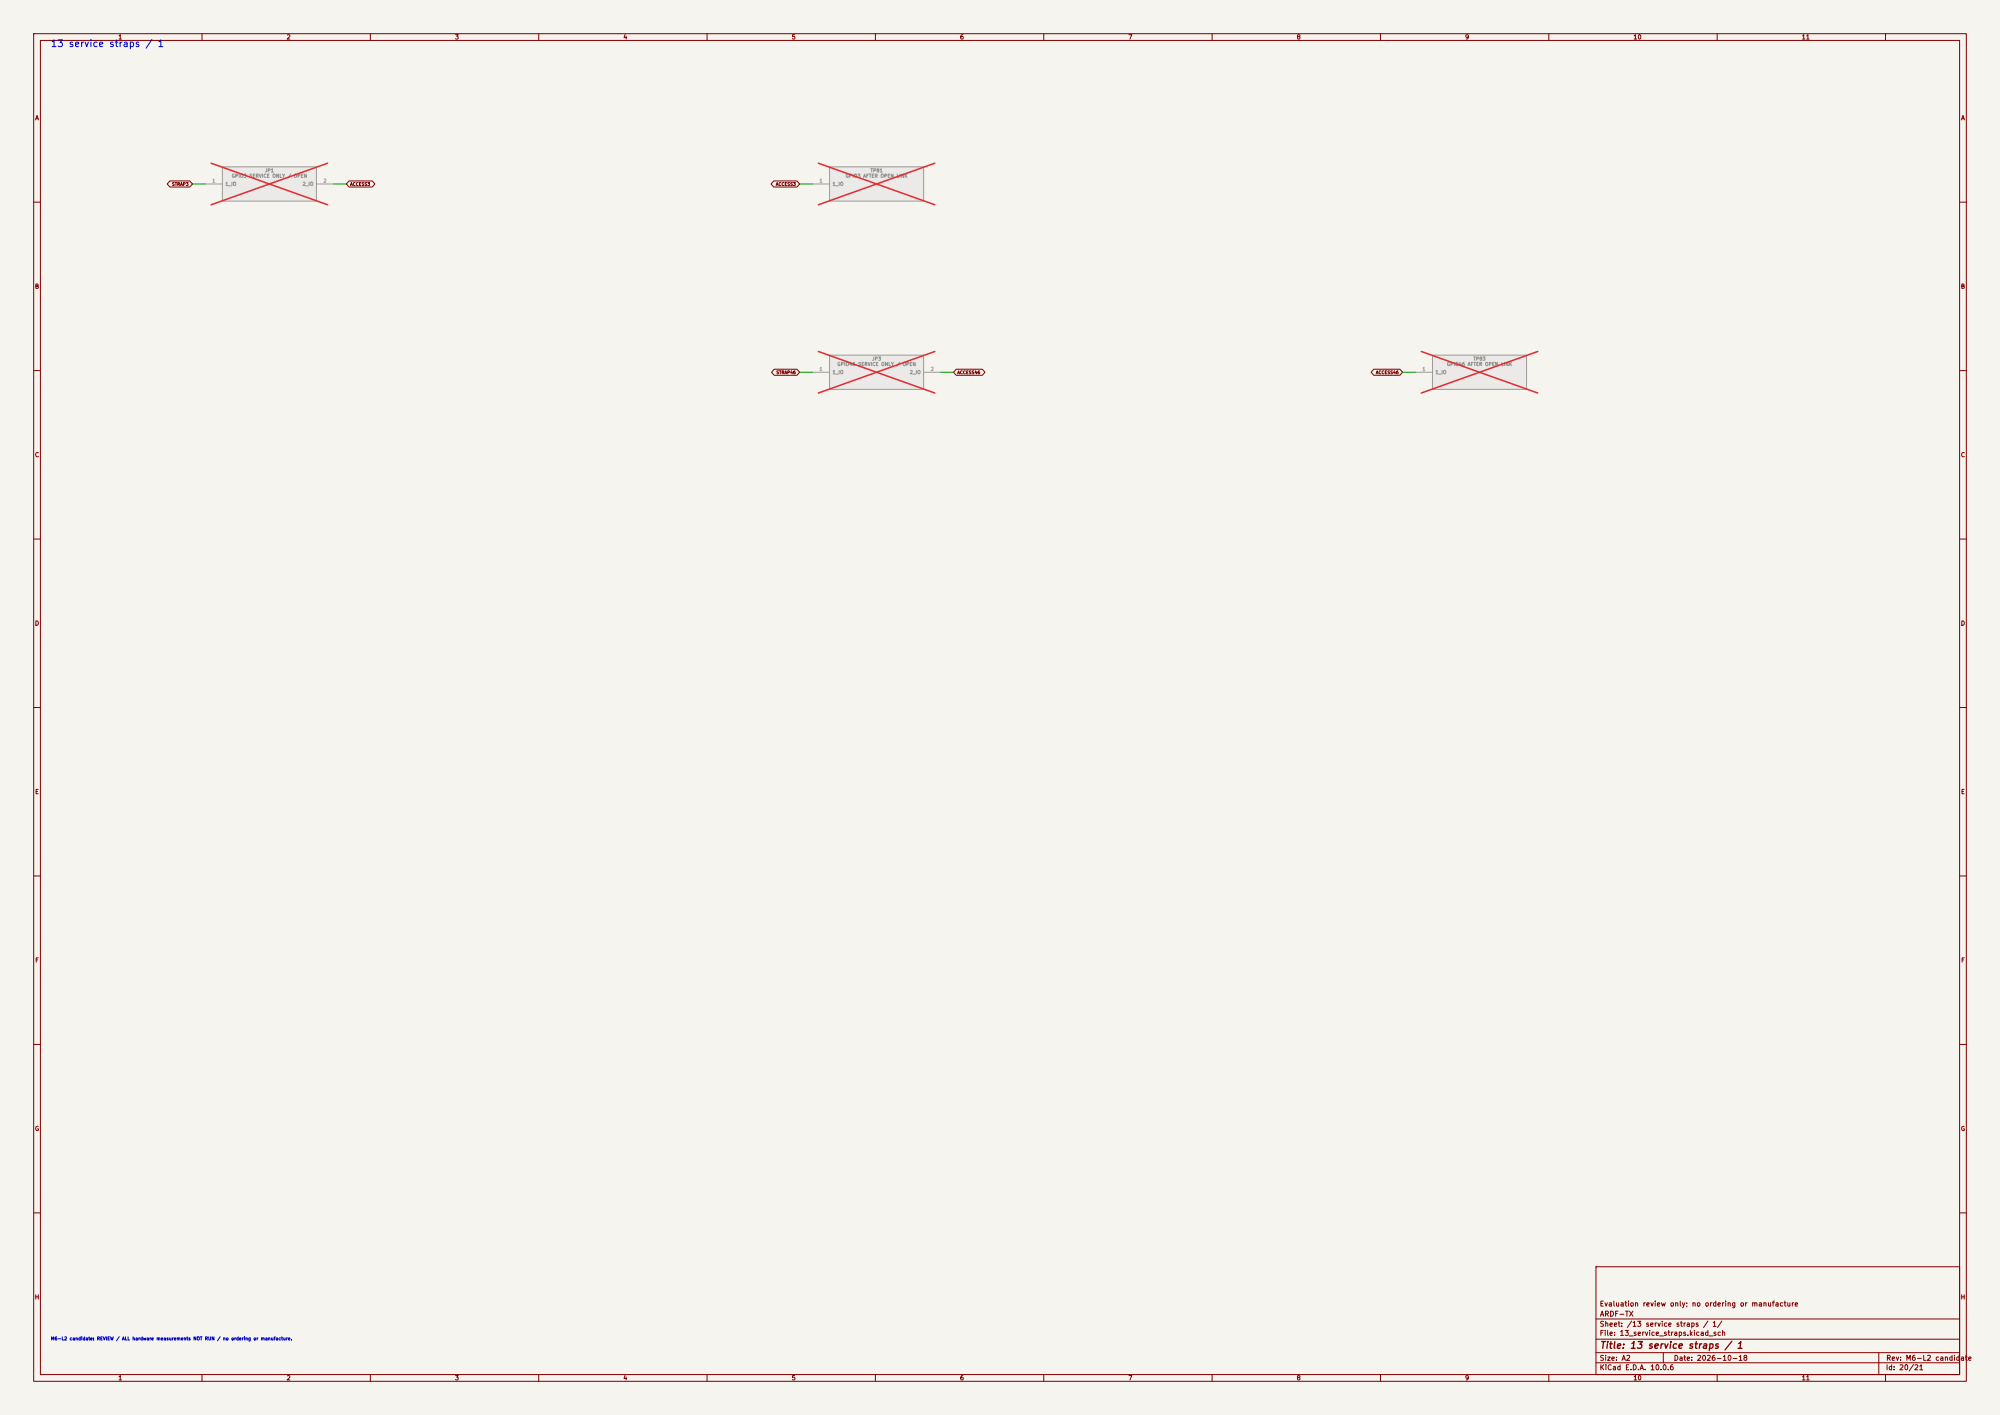
[picture p106: page 21]

M6-L2 candidate: REVIEW / ALL hardware measurements NOT RUN / no ordering or manufacture.
