DD1SB/ARDF-TX/hardware/2m/review/M5B-E5/assembly-bottom.pdf

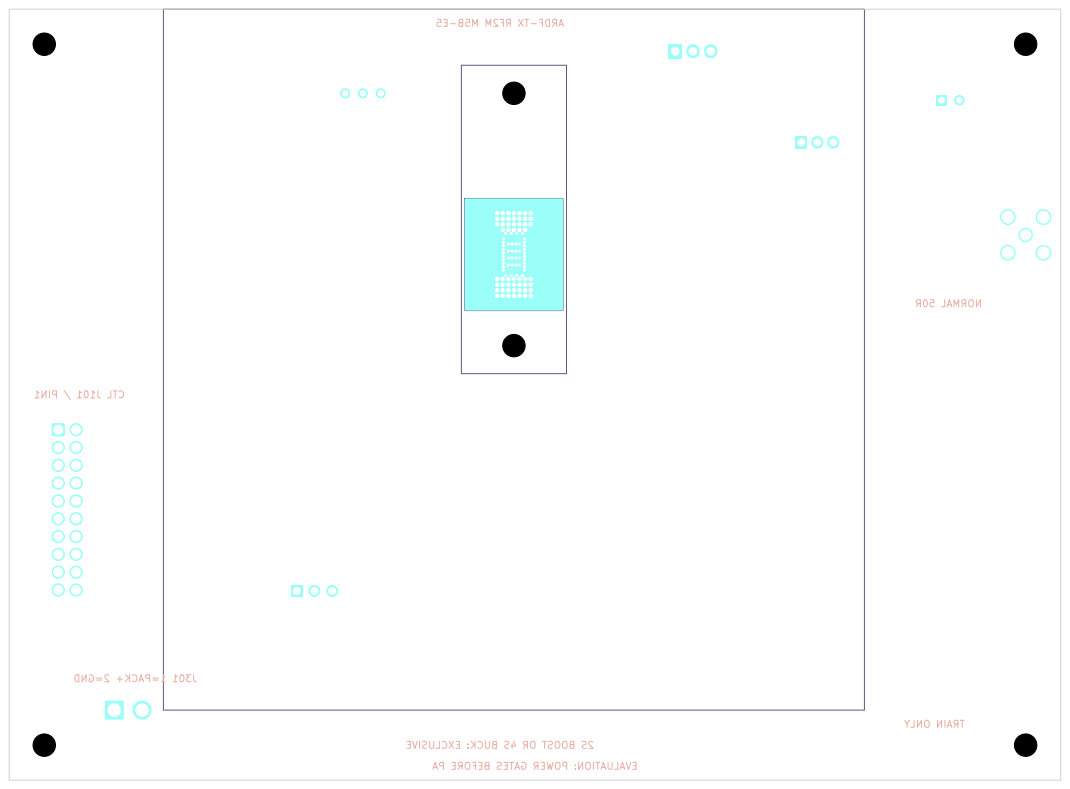
[picture p107: page 1]

EXCLUSIVE BUCK: 4S OR BOOST 2S PA BEFORE GATES POWER EVALUATION: ONLY TRAIN 50R NORMAL
