DD1SB/ARDF-TX/hardware/controller/review/M6-L1/CTRL.pdf

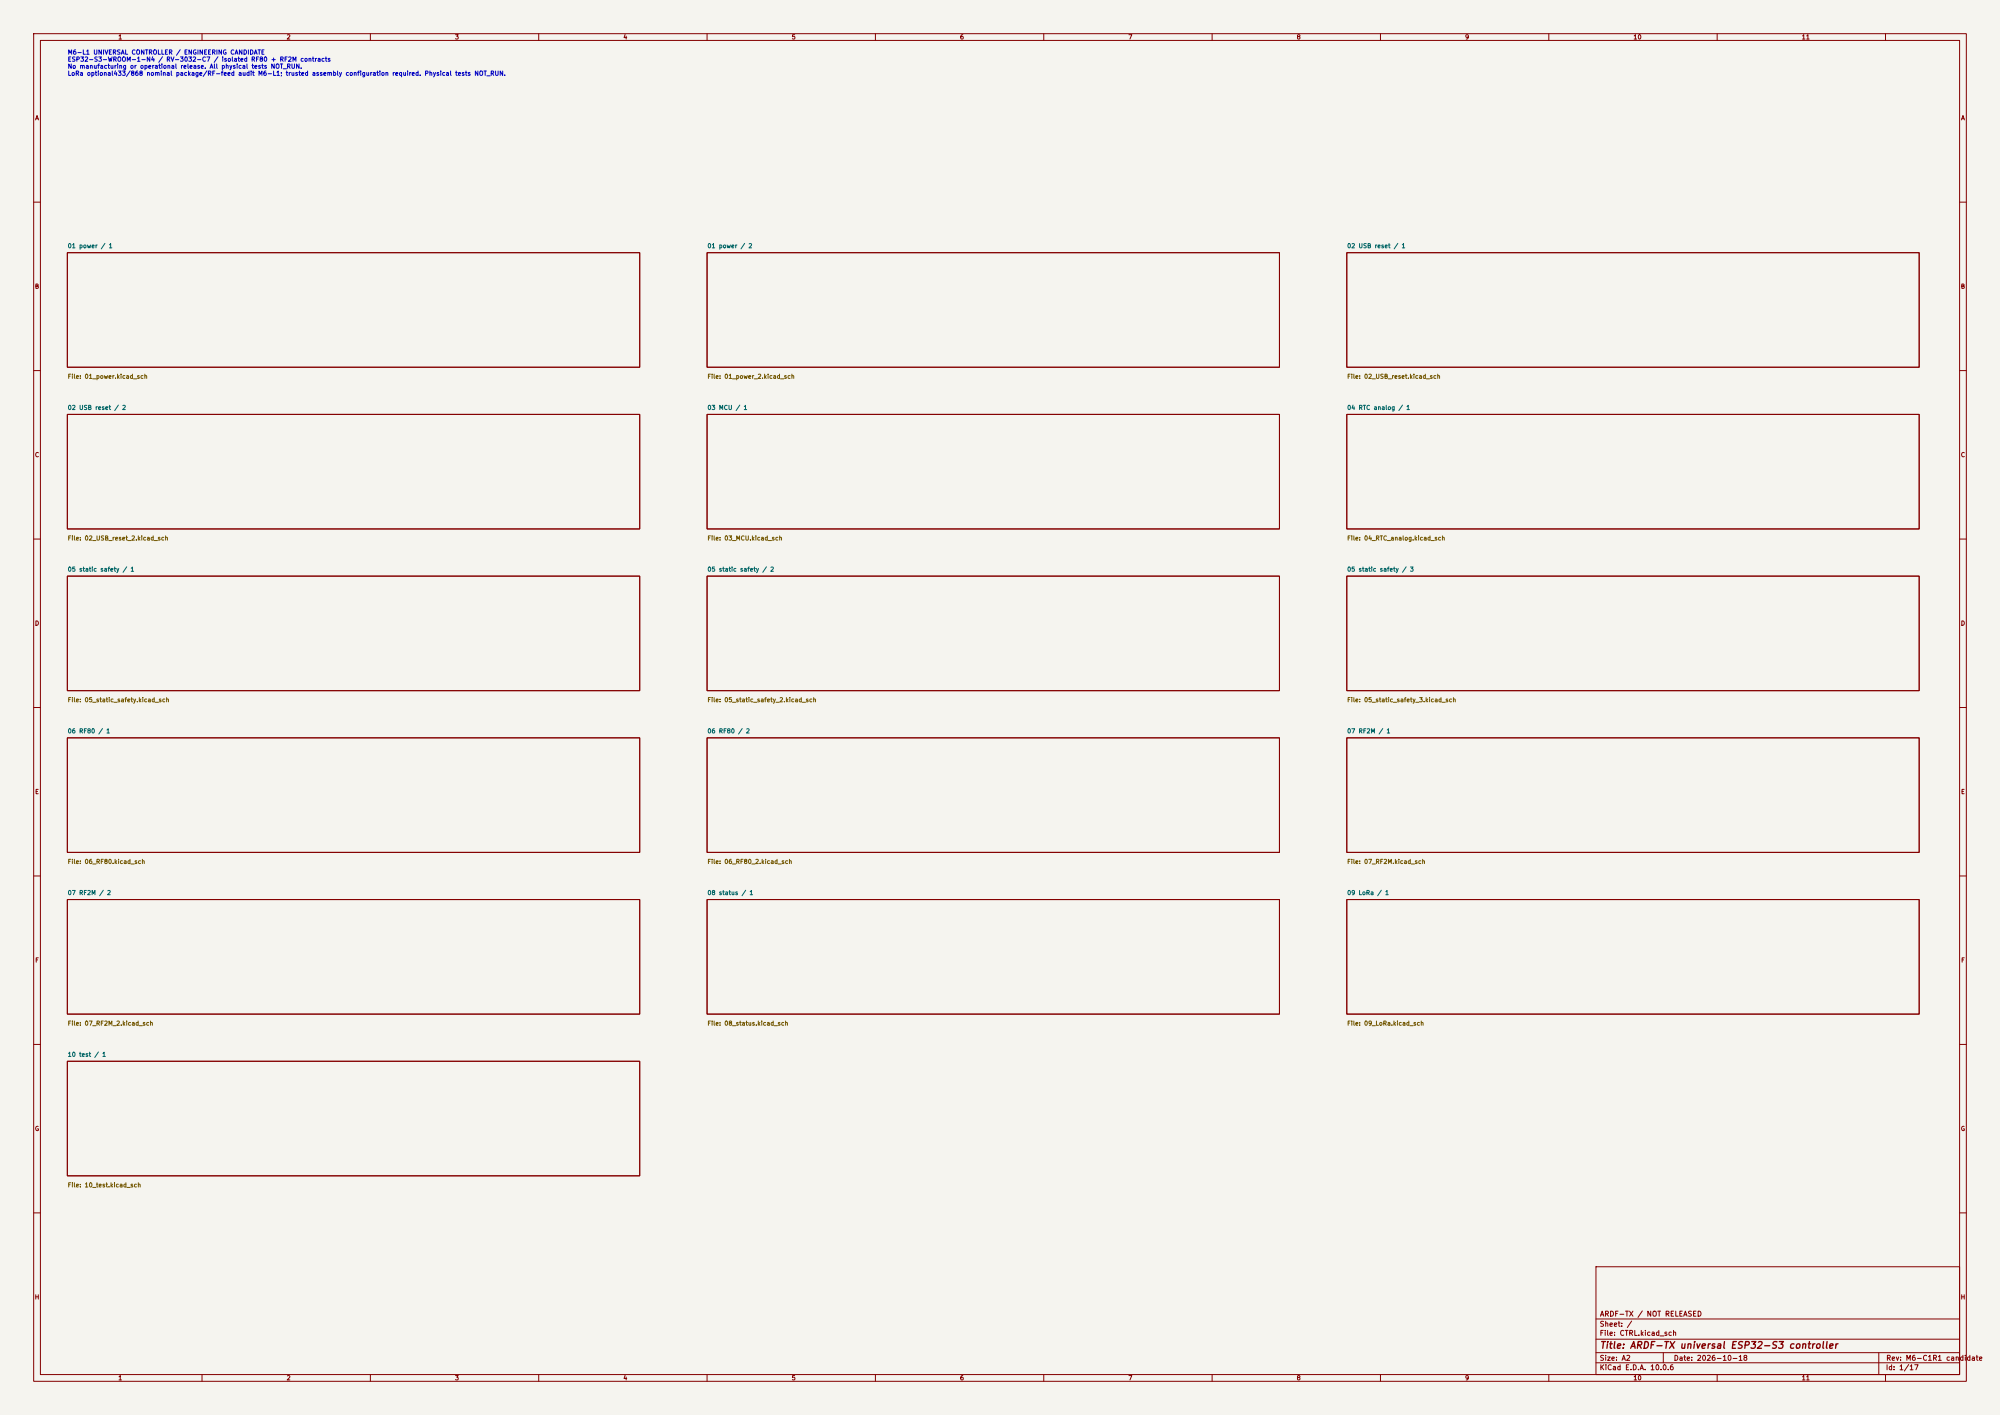
[picture p127: page 1]

File: 02_USB_reset.kicad_sch M6-L1 UNIVERSAL CONTROLLER / ENGINEERING CANDIDATE
ESP32-S3-WROOM-1-N4 / RV-3032-C7 / isolated RF80 + RF2M contracts No manufacturing or operational release. All physical tests NOT_RUN. LoRa optional433/868 nominal package/RF-feed audit M6-L1; trusted assembly configuration required. Physical tests NOT_RUN.

ARDF-TX / NOT RELEASED
Sheet: /
File: CTRL.kicad_sch
Title: ARDF-TX universal ESP32-S3 controller
KiCad E.D.A. 10.0.6

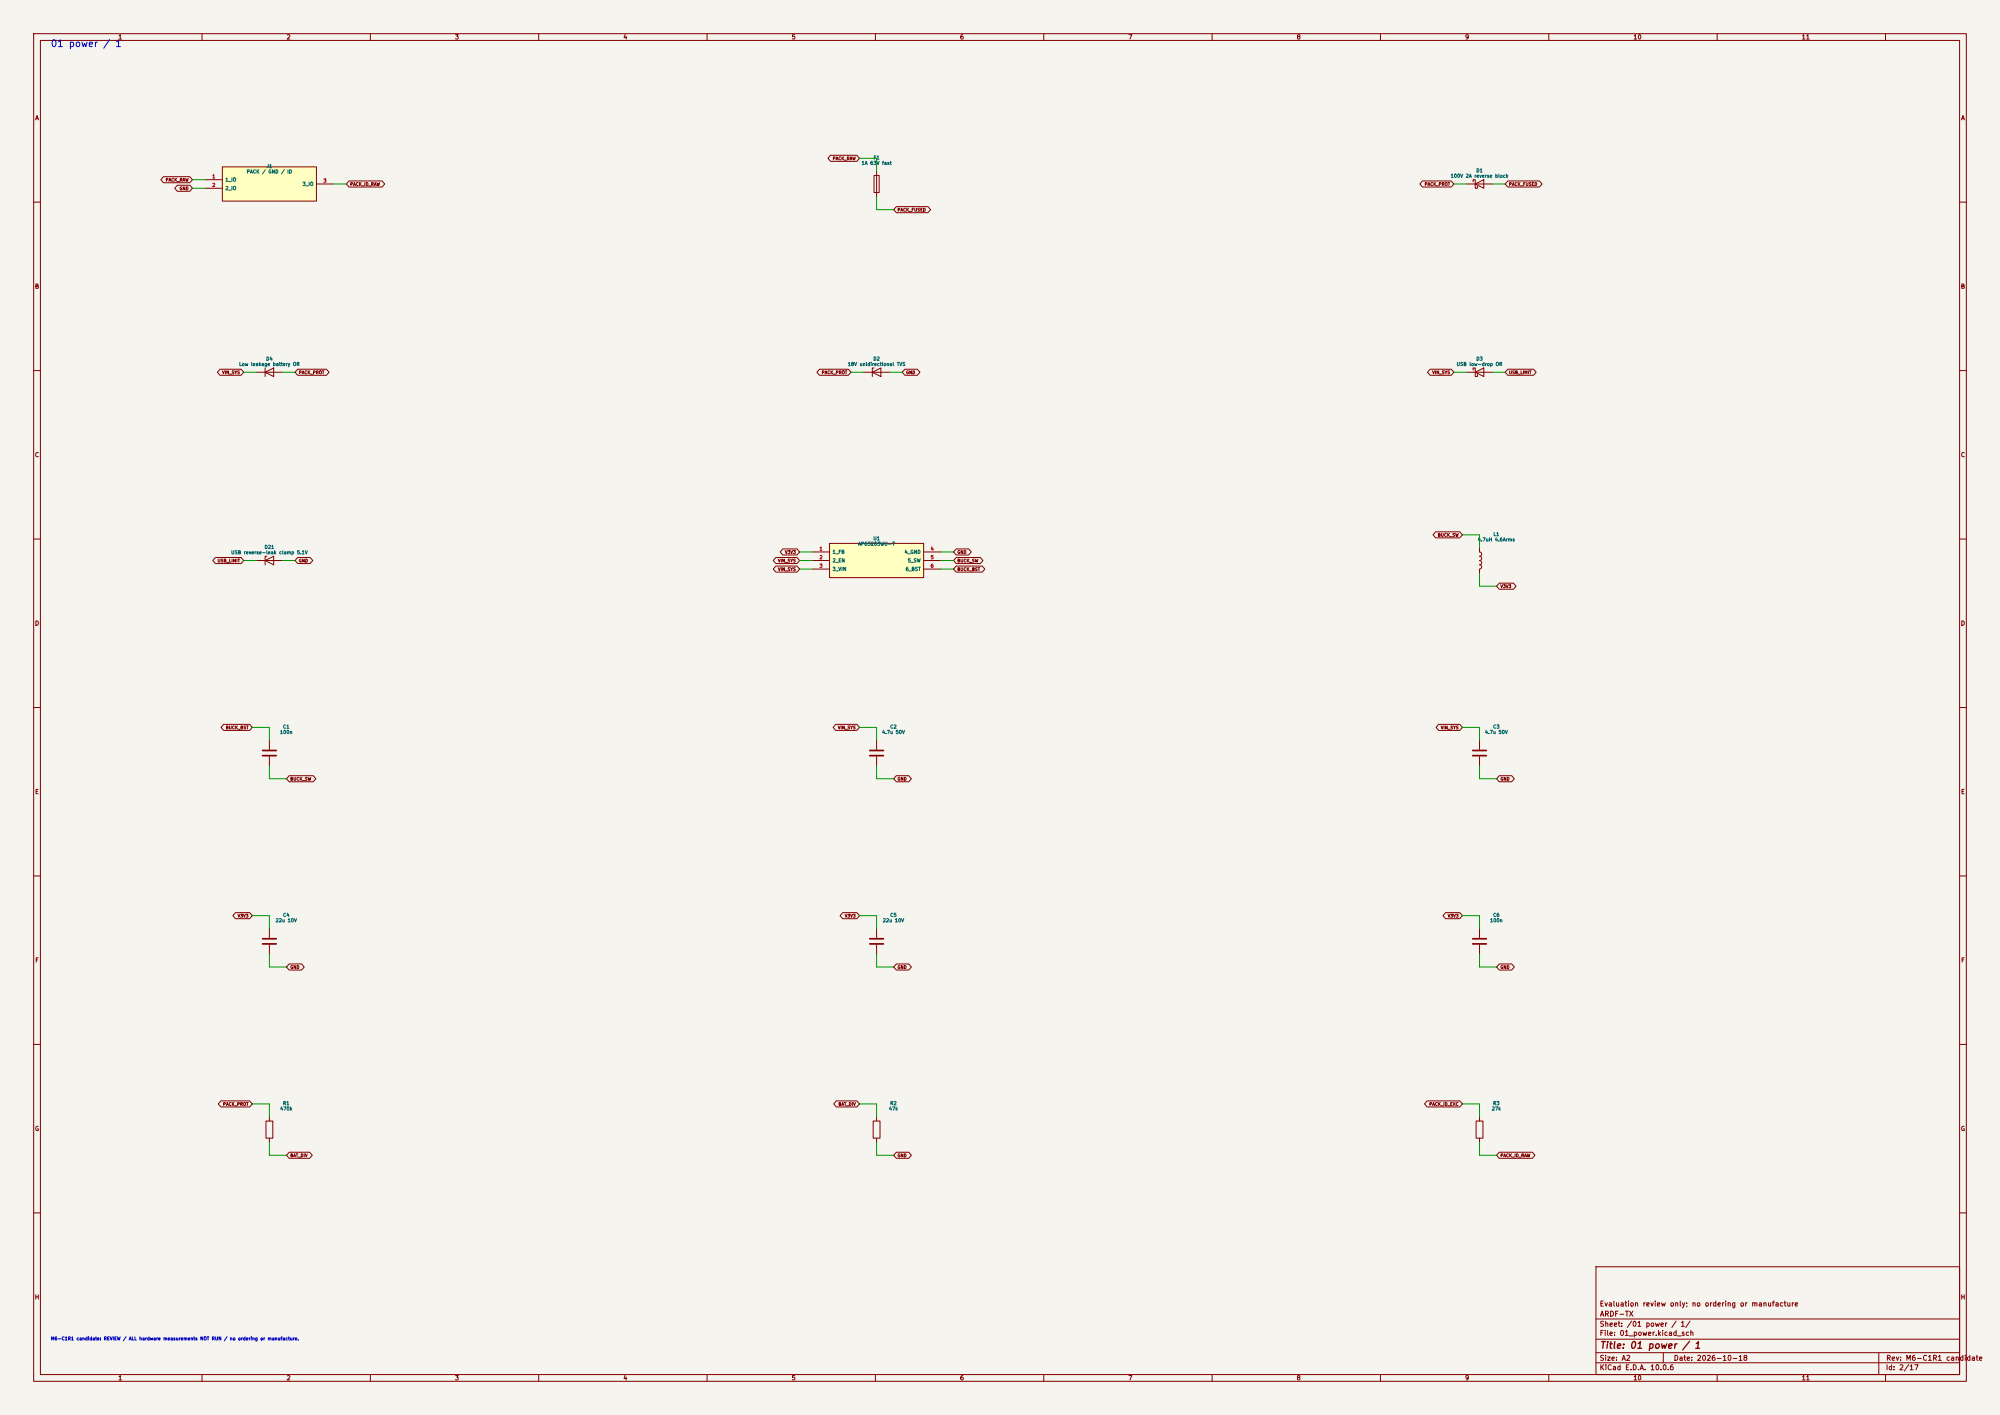
[picture p128: page 2]

100V 2A reverse block D3 USB low-drop OR

Low leakage battery OR

Evaluation review only; no ordering or manufacture
ARDF-TX
Sheet: /01 power / 1/
File: 01_power.kicad_sch
Title: 01 power / 1

M6-C1R1 candidate: REVIEW / ALL hardware measurements NOT RUN / no ordering or manufacture.

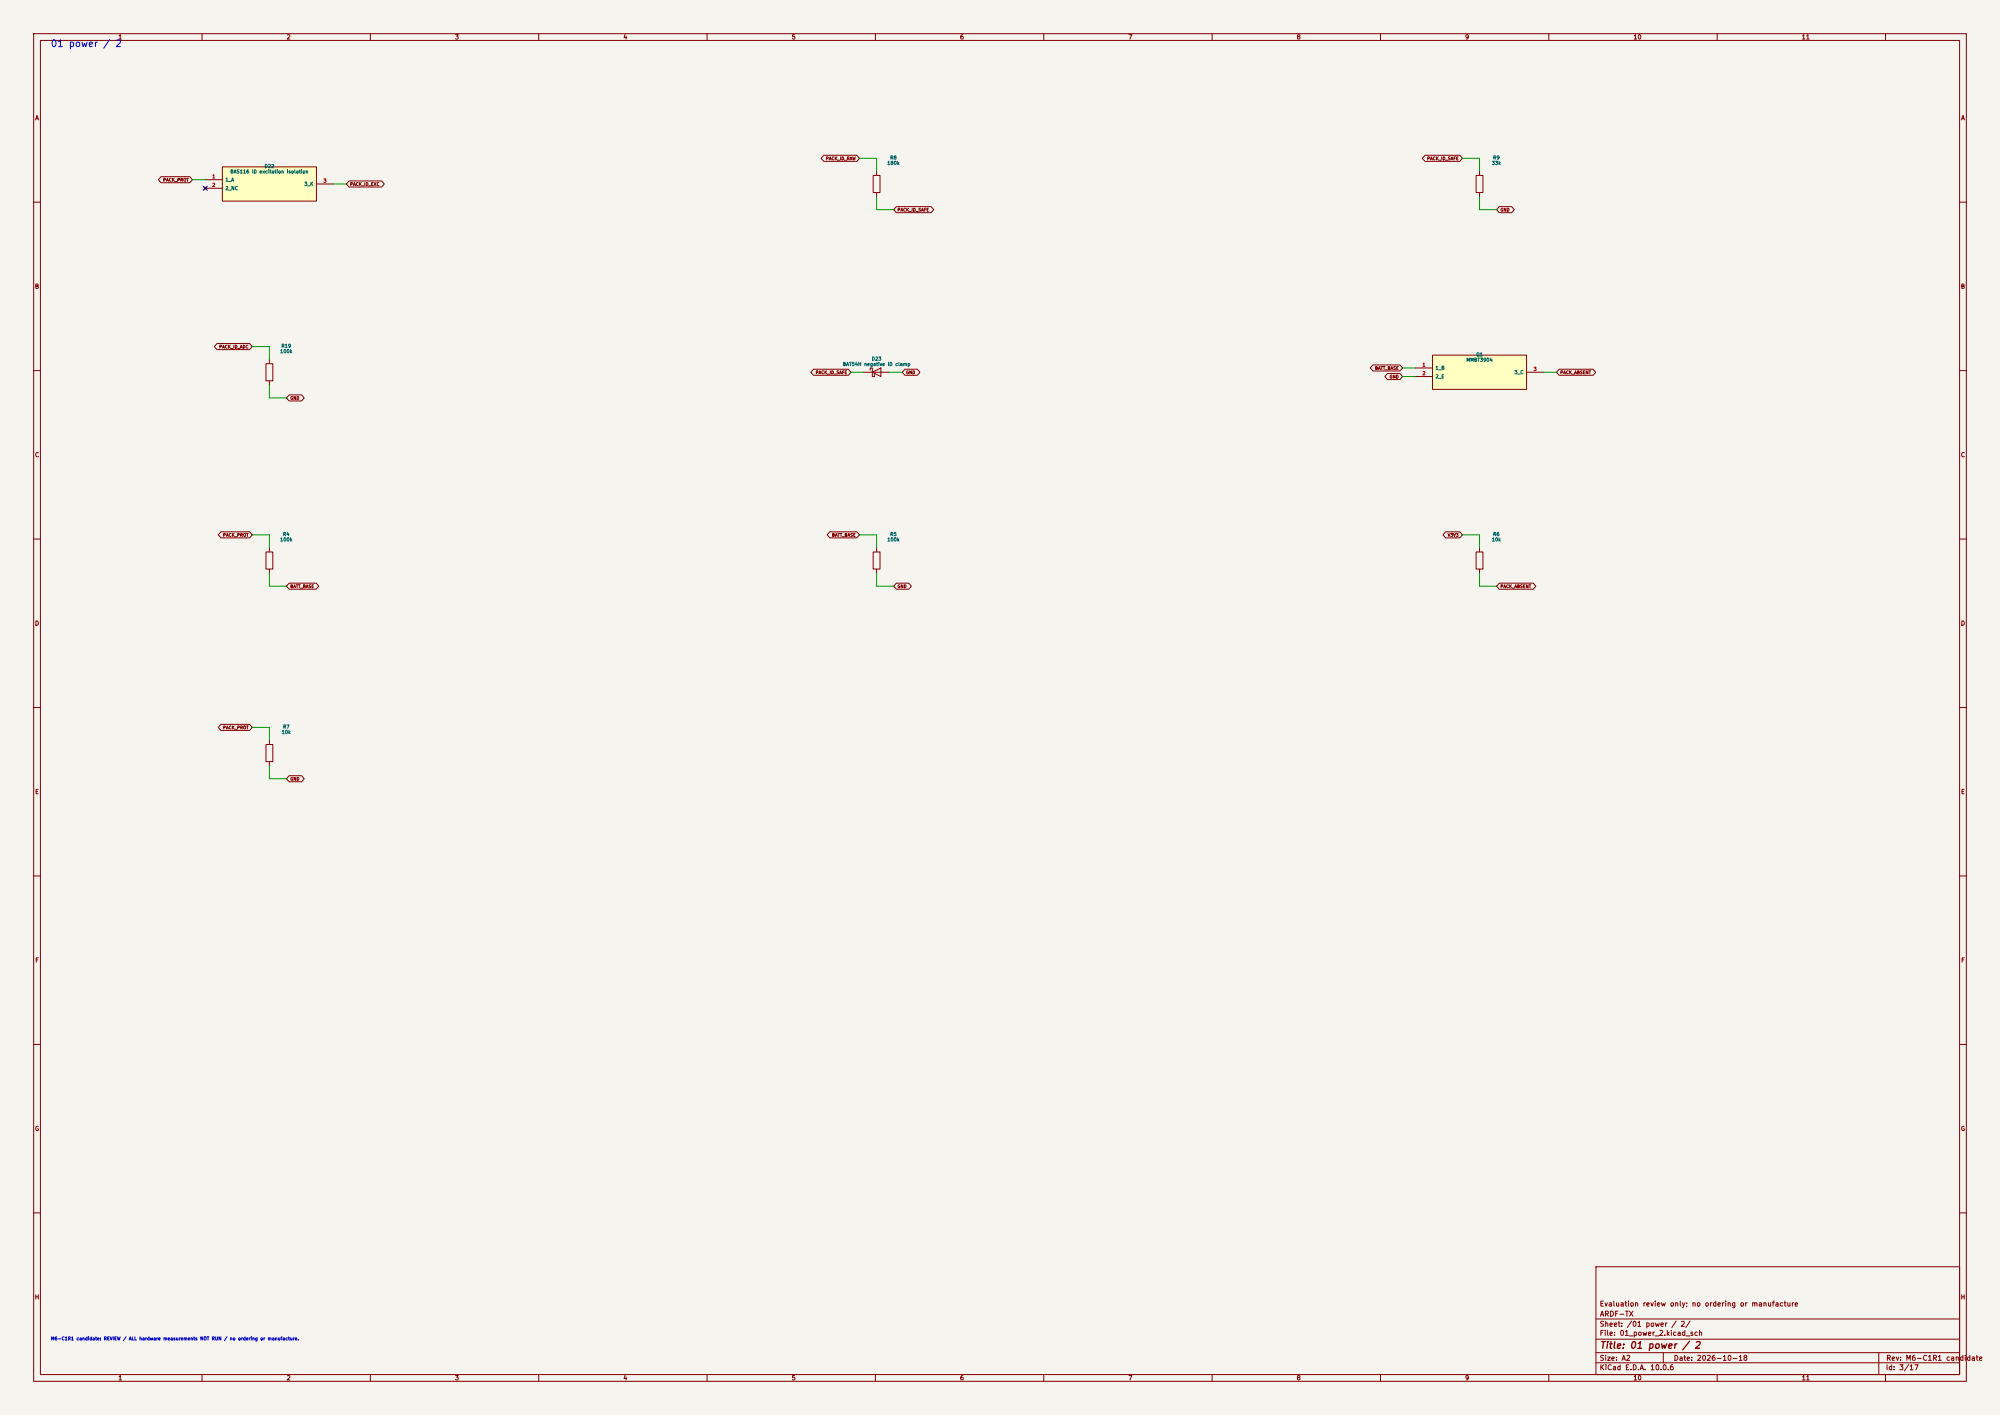
[picture p129: page 3]

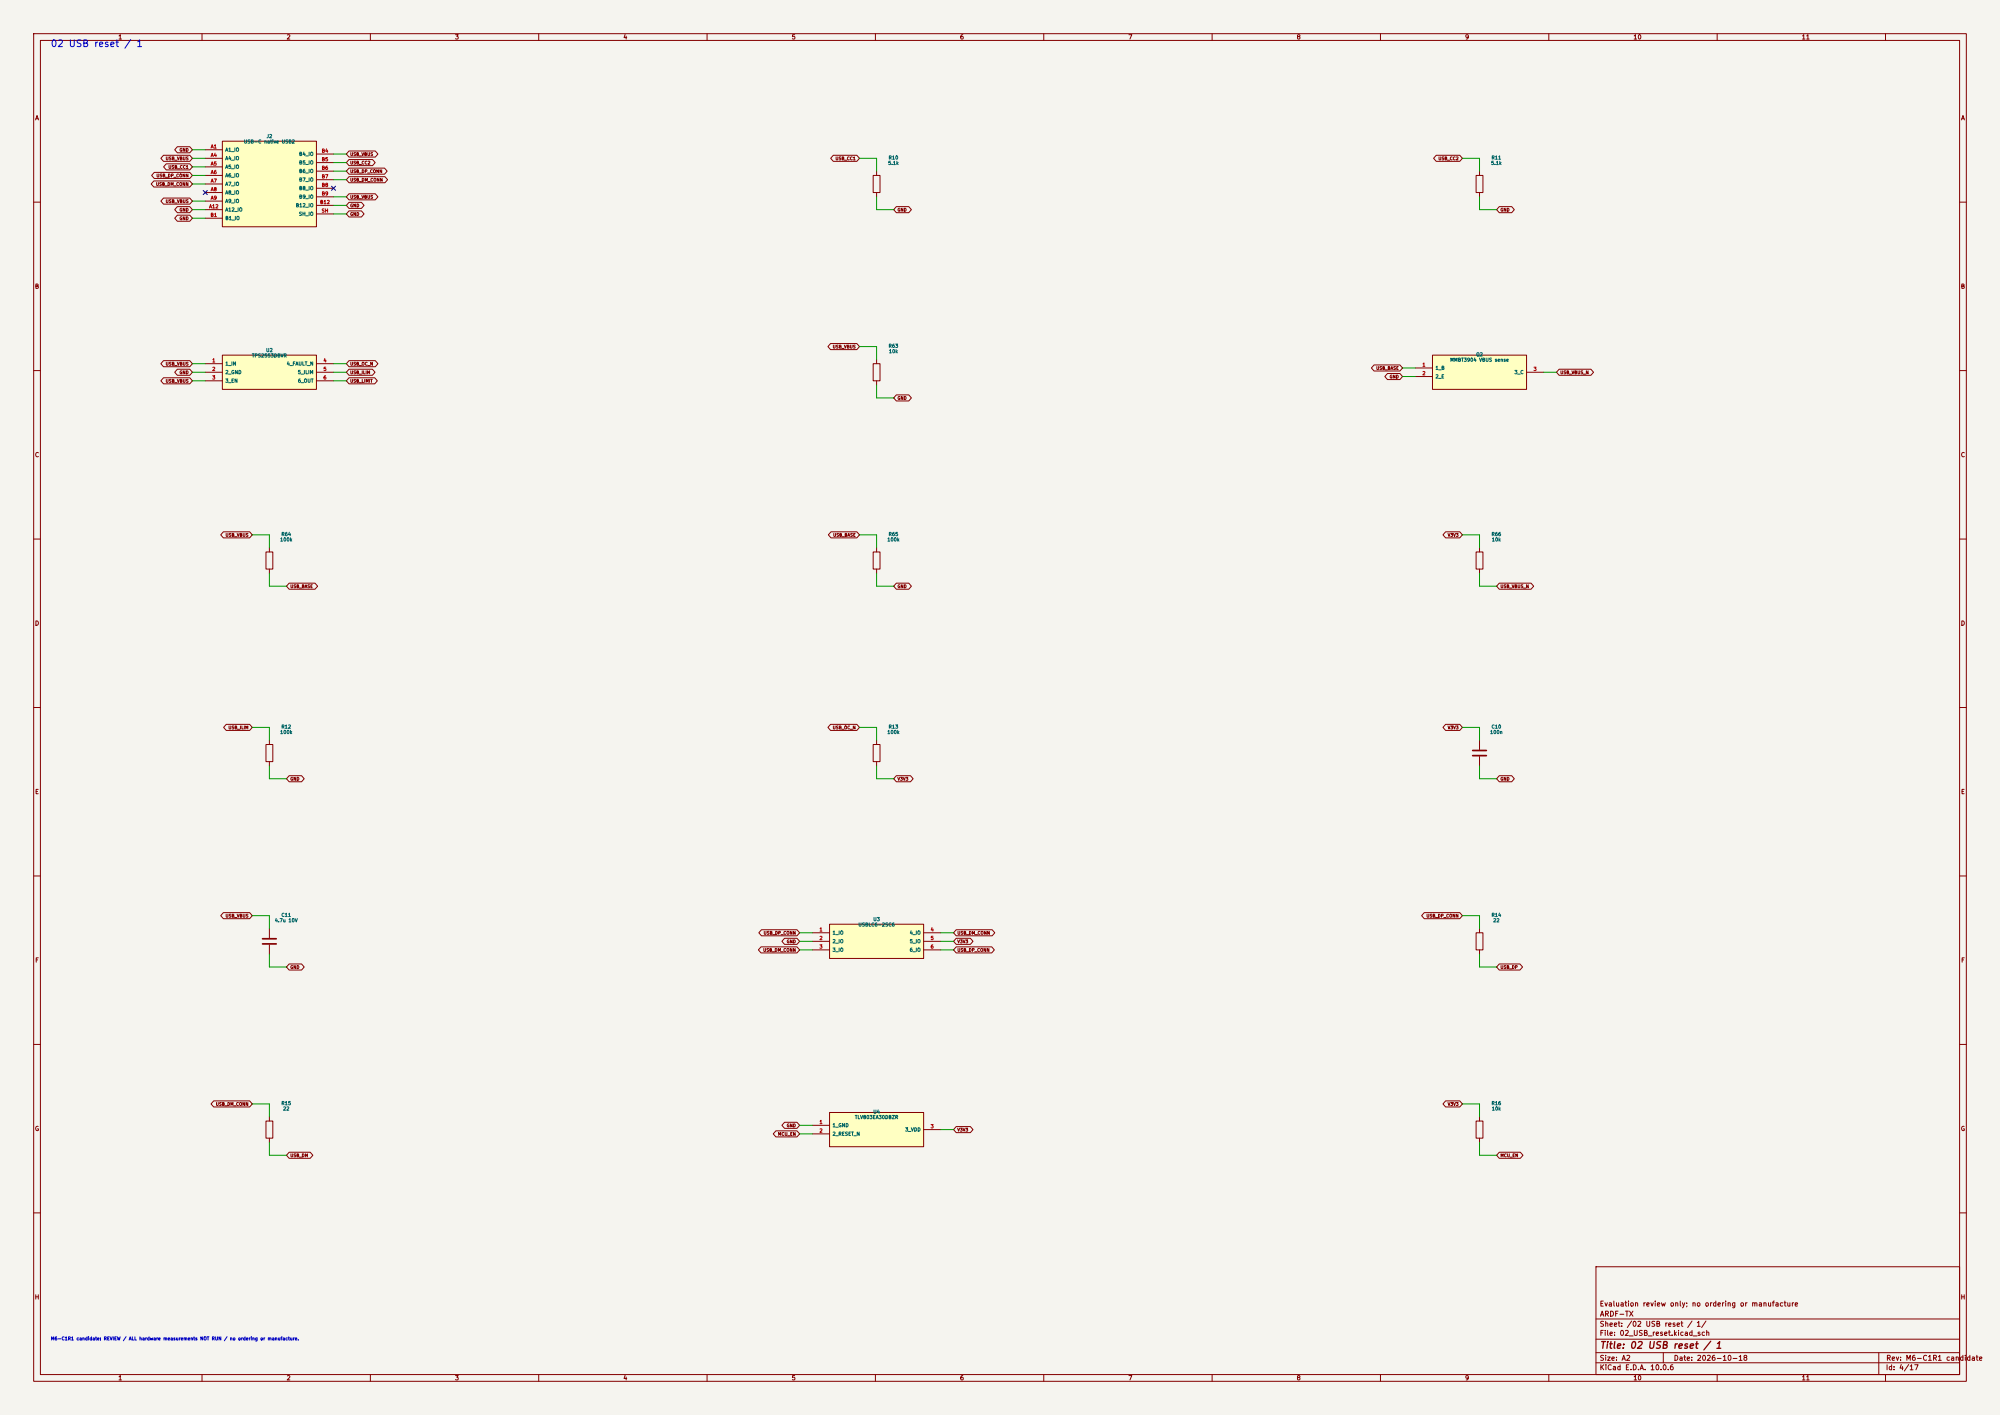
[picture p130: page 4]

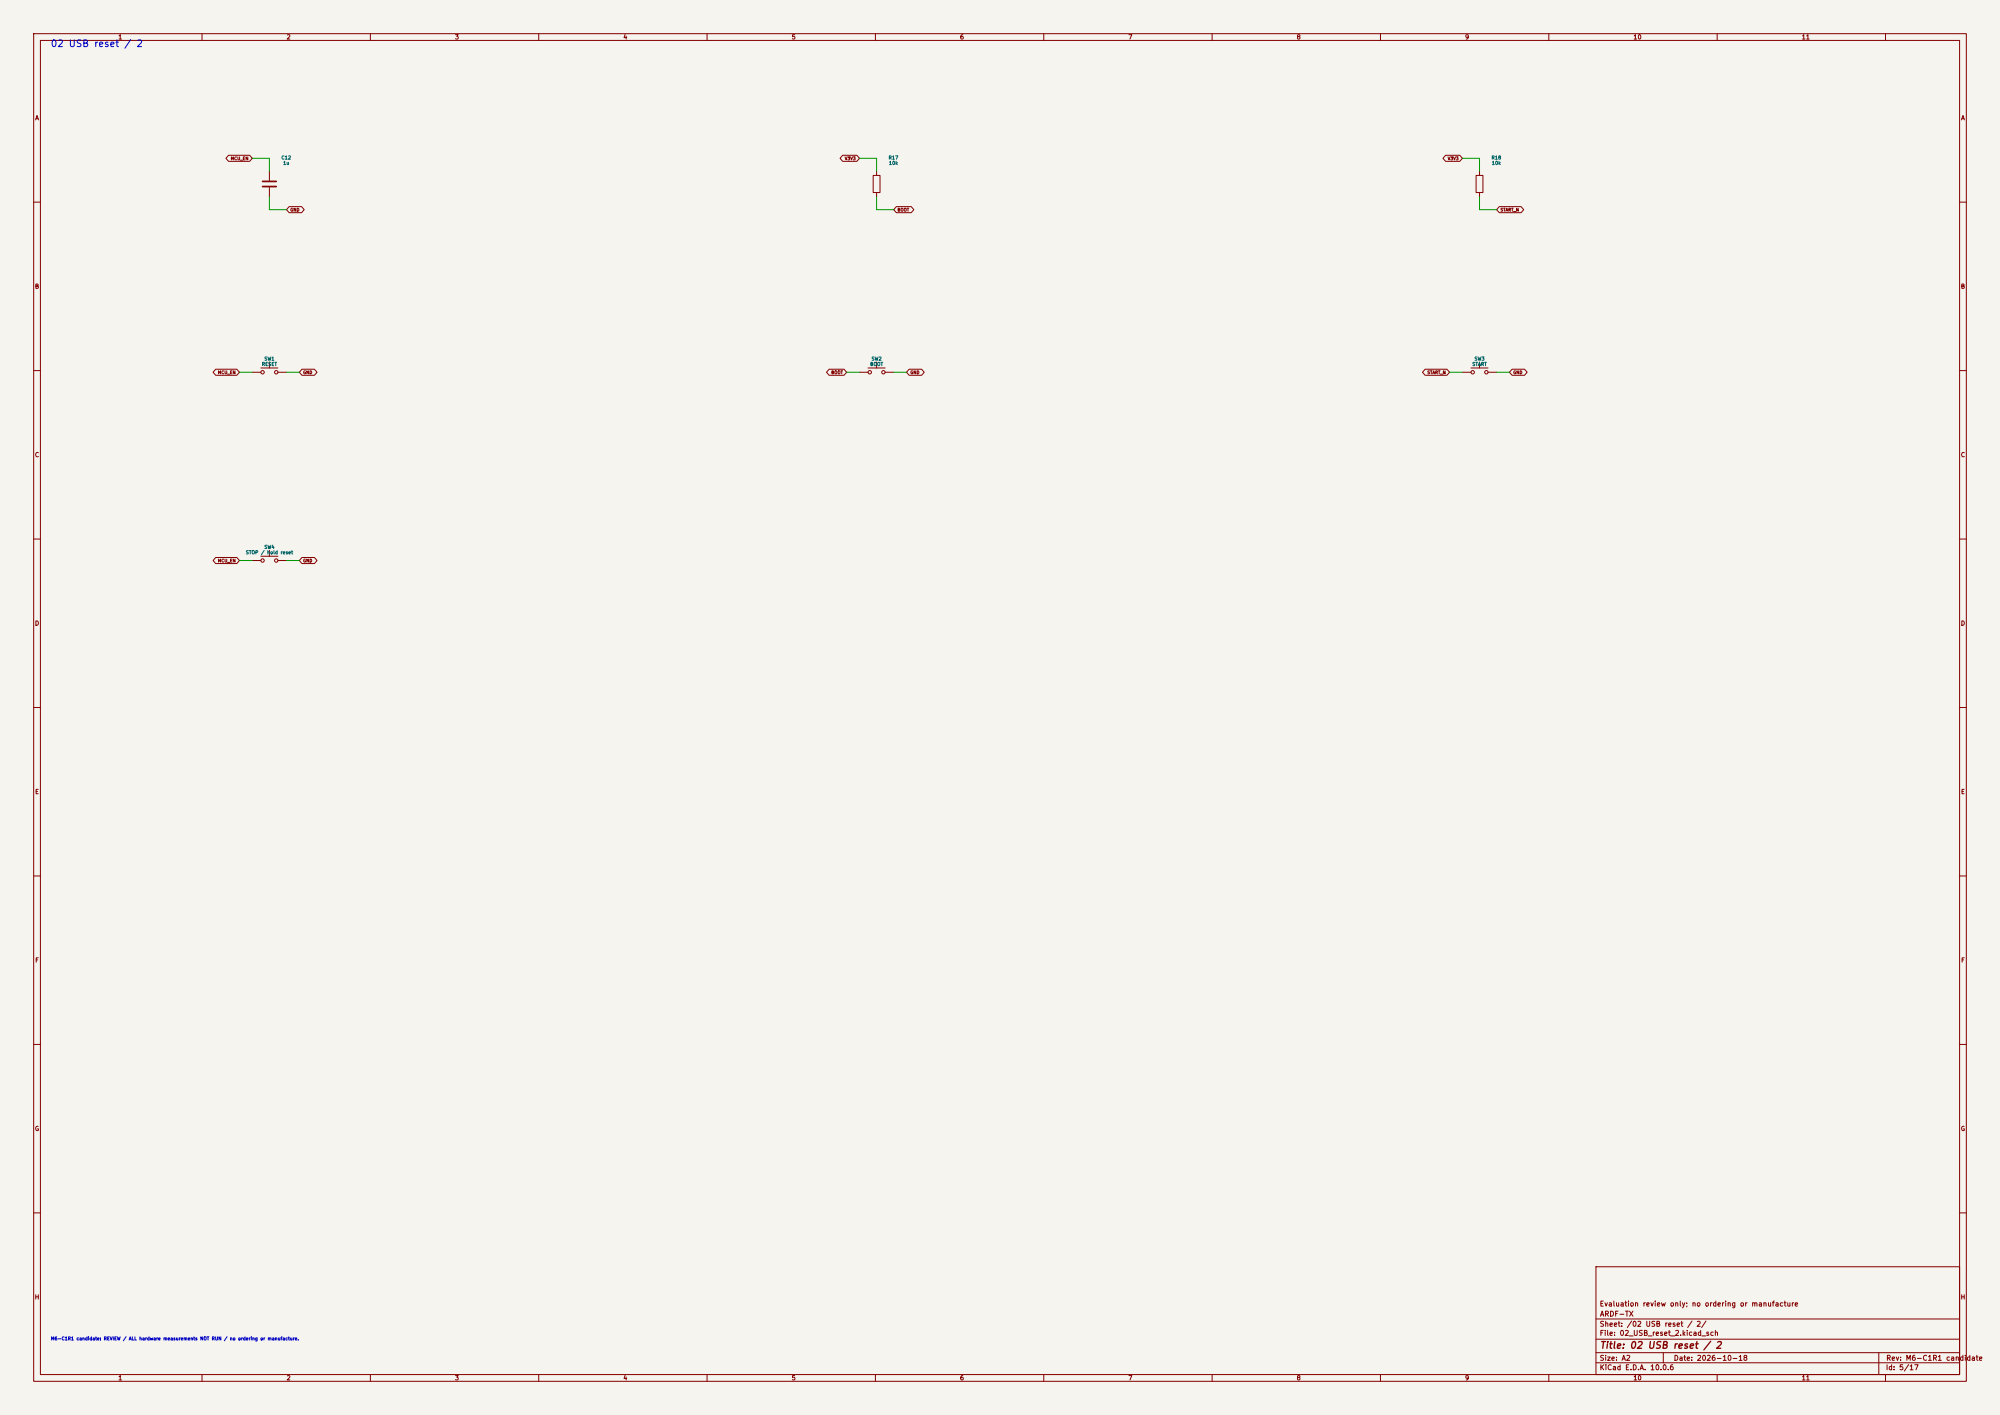
[picture p131: page 5]

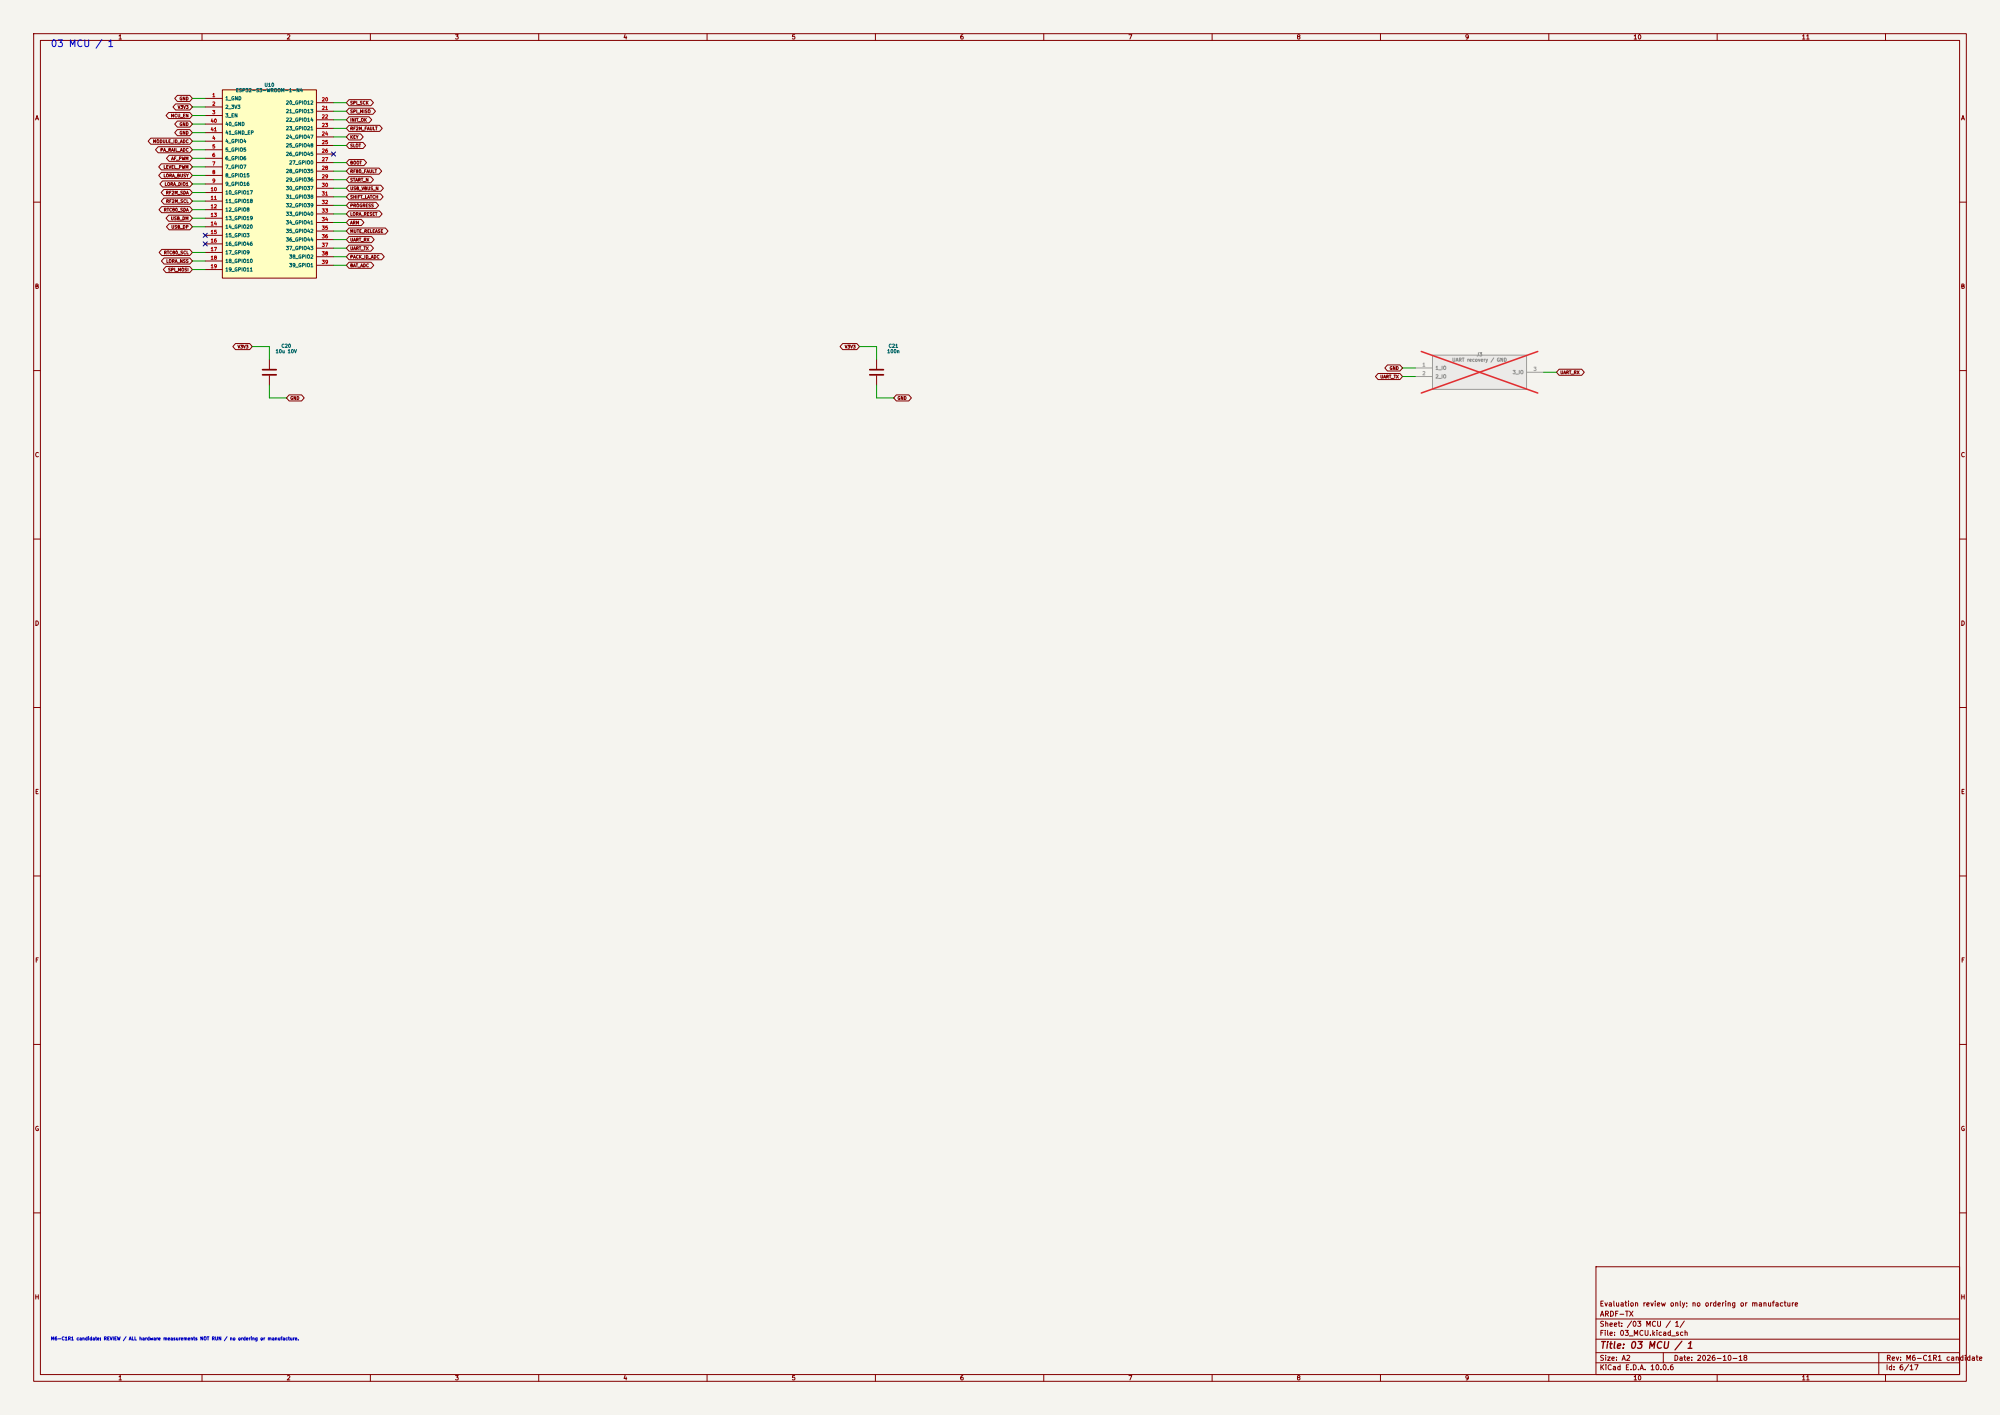
[picture p132: page 6]

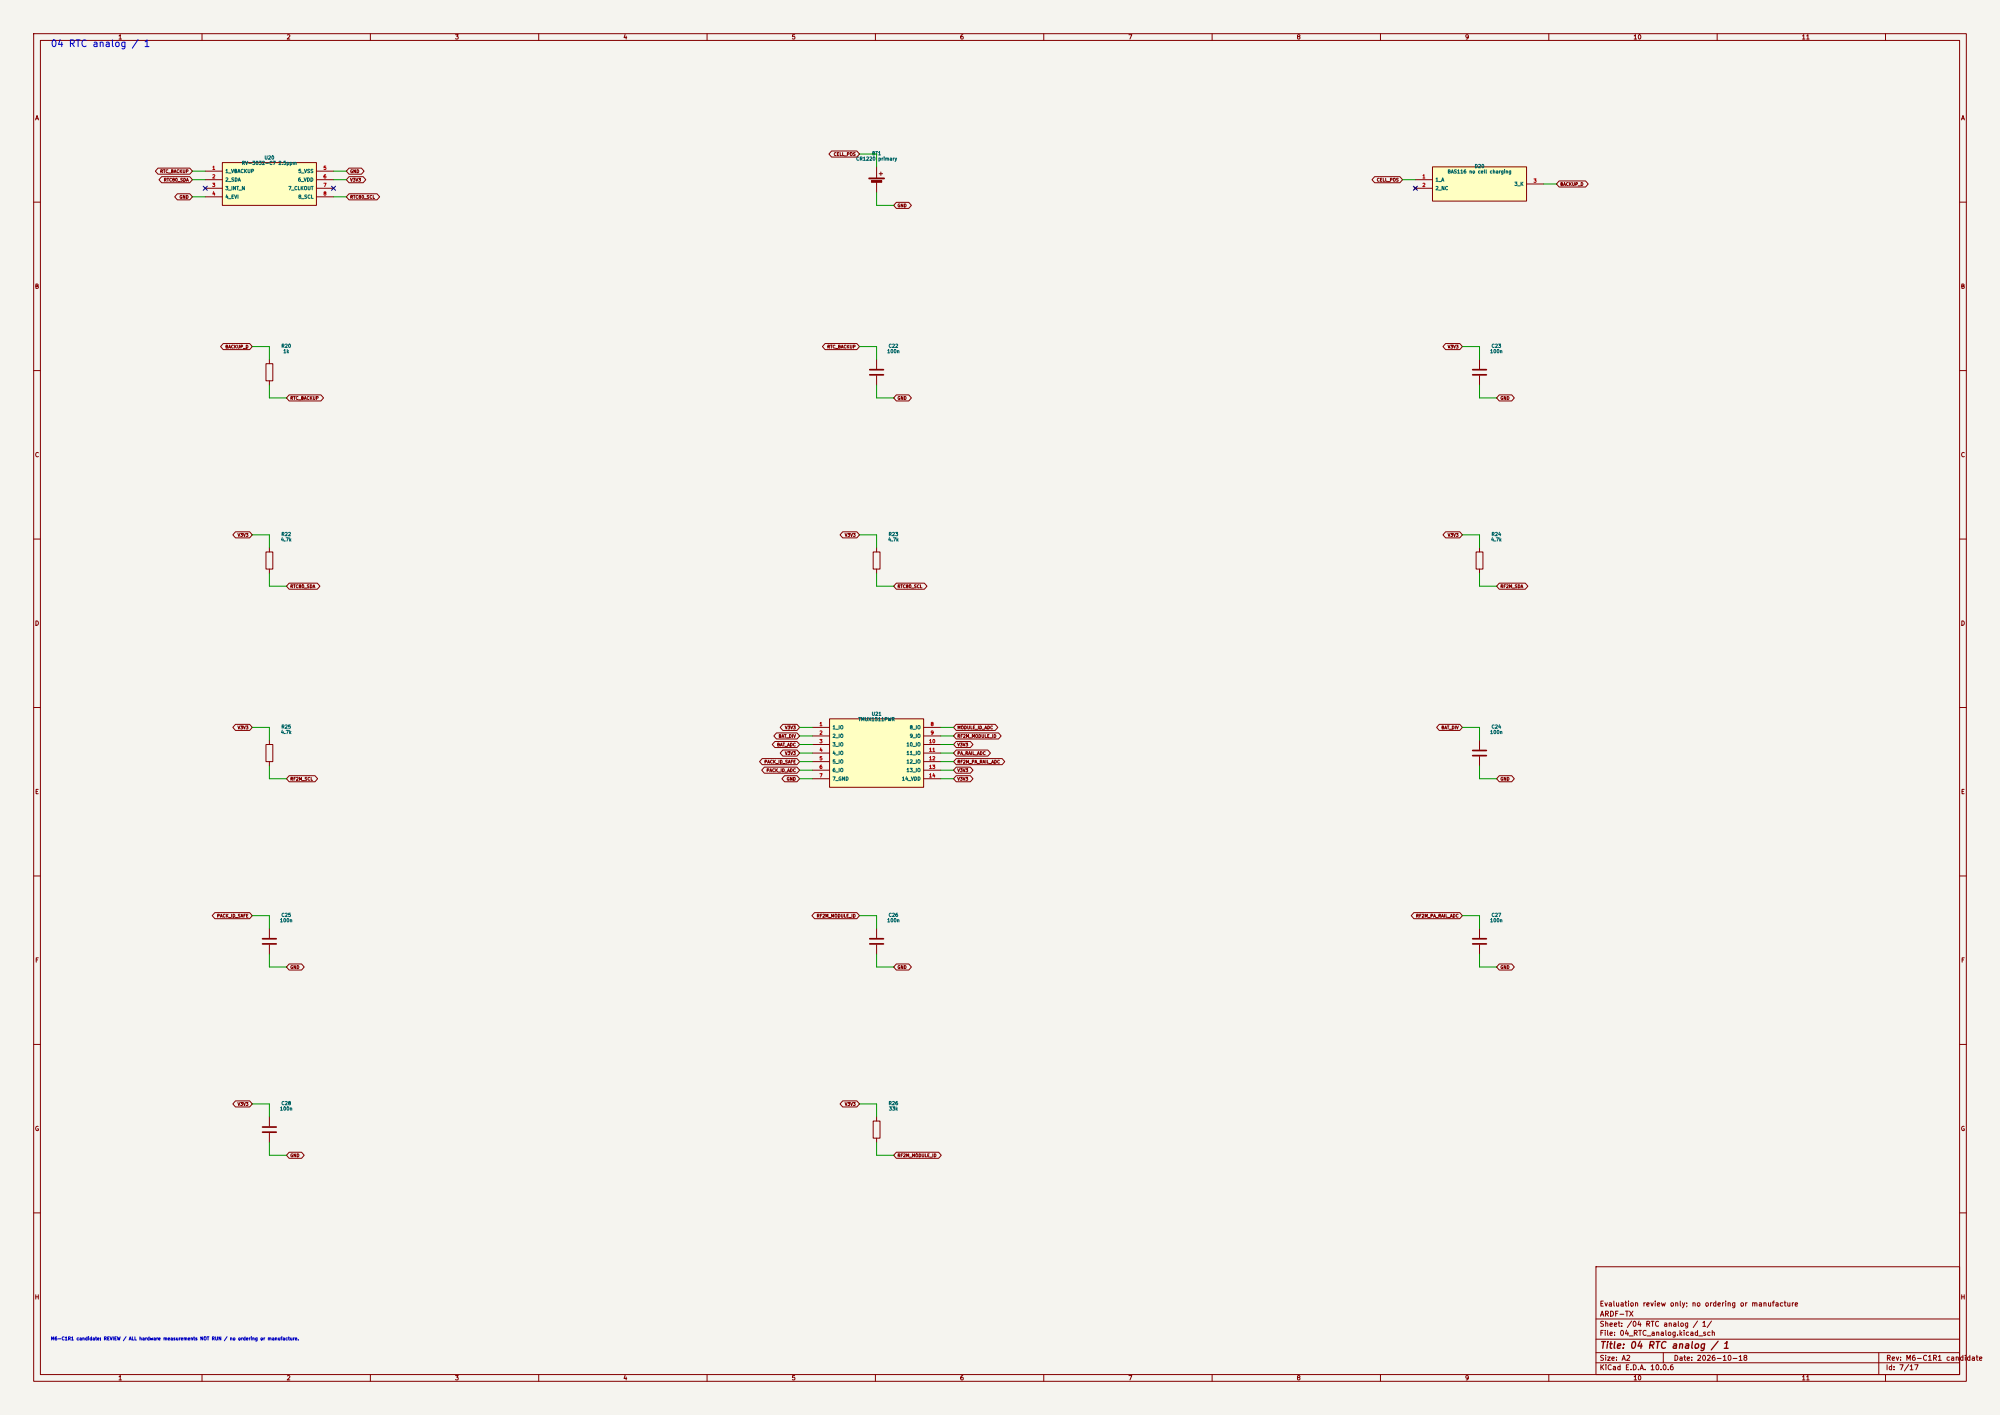
[picture p133: page 7]

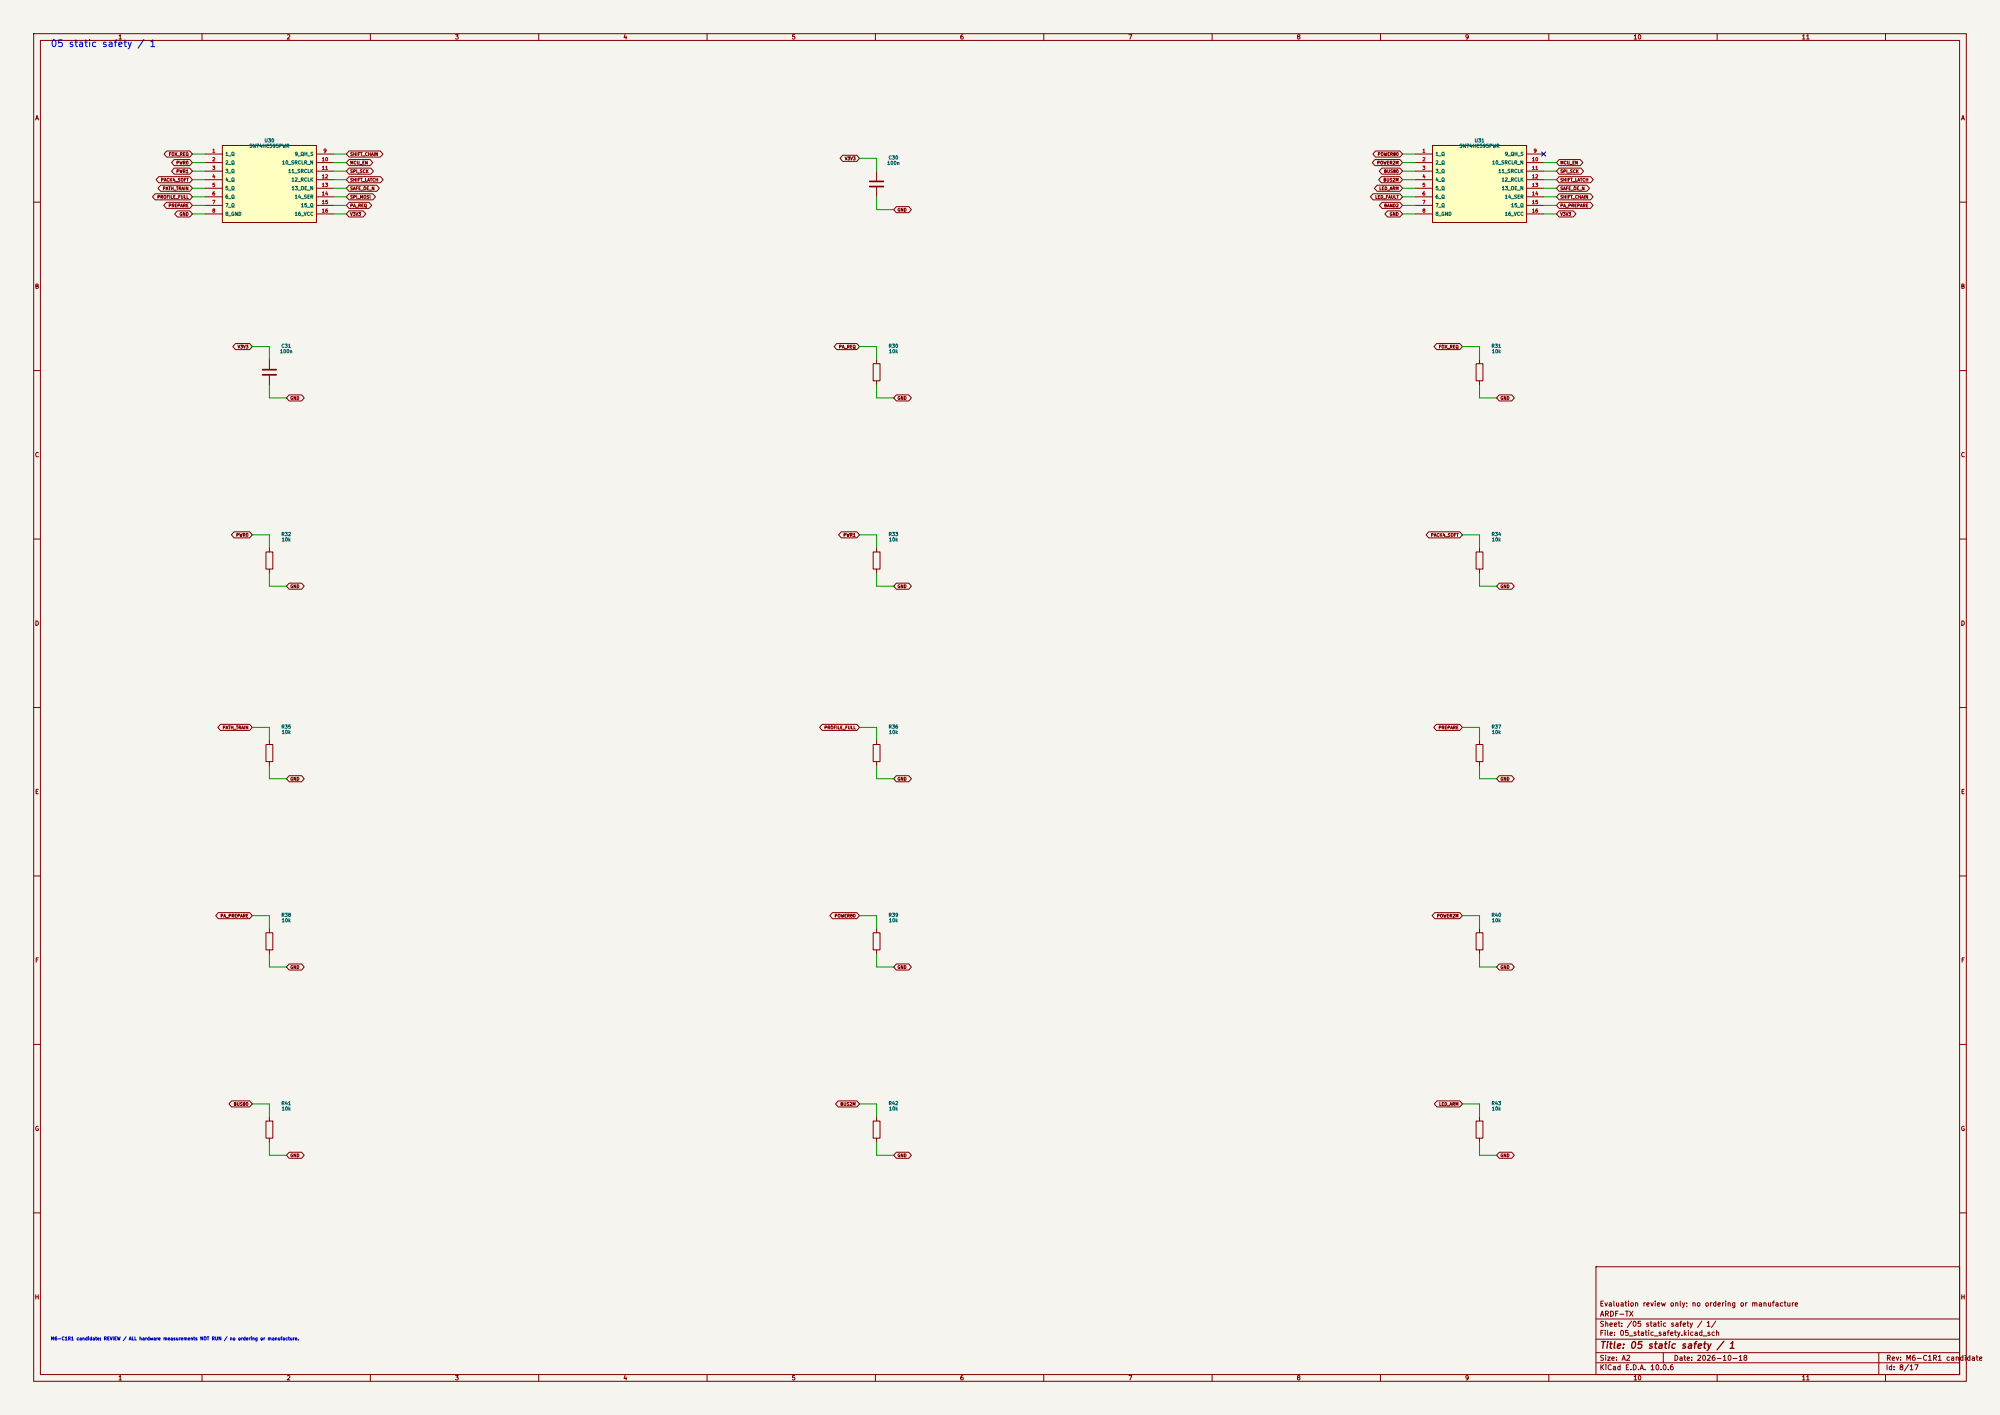
[picture p134: page 8]

BUS2M M6-C1R1 candidate: REVIEW / ALL hardware measurements NOT RUN / no ordering or manufacture.

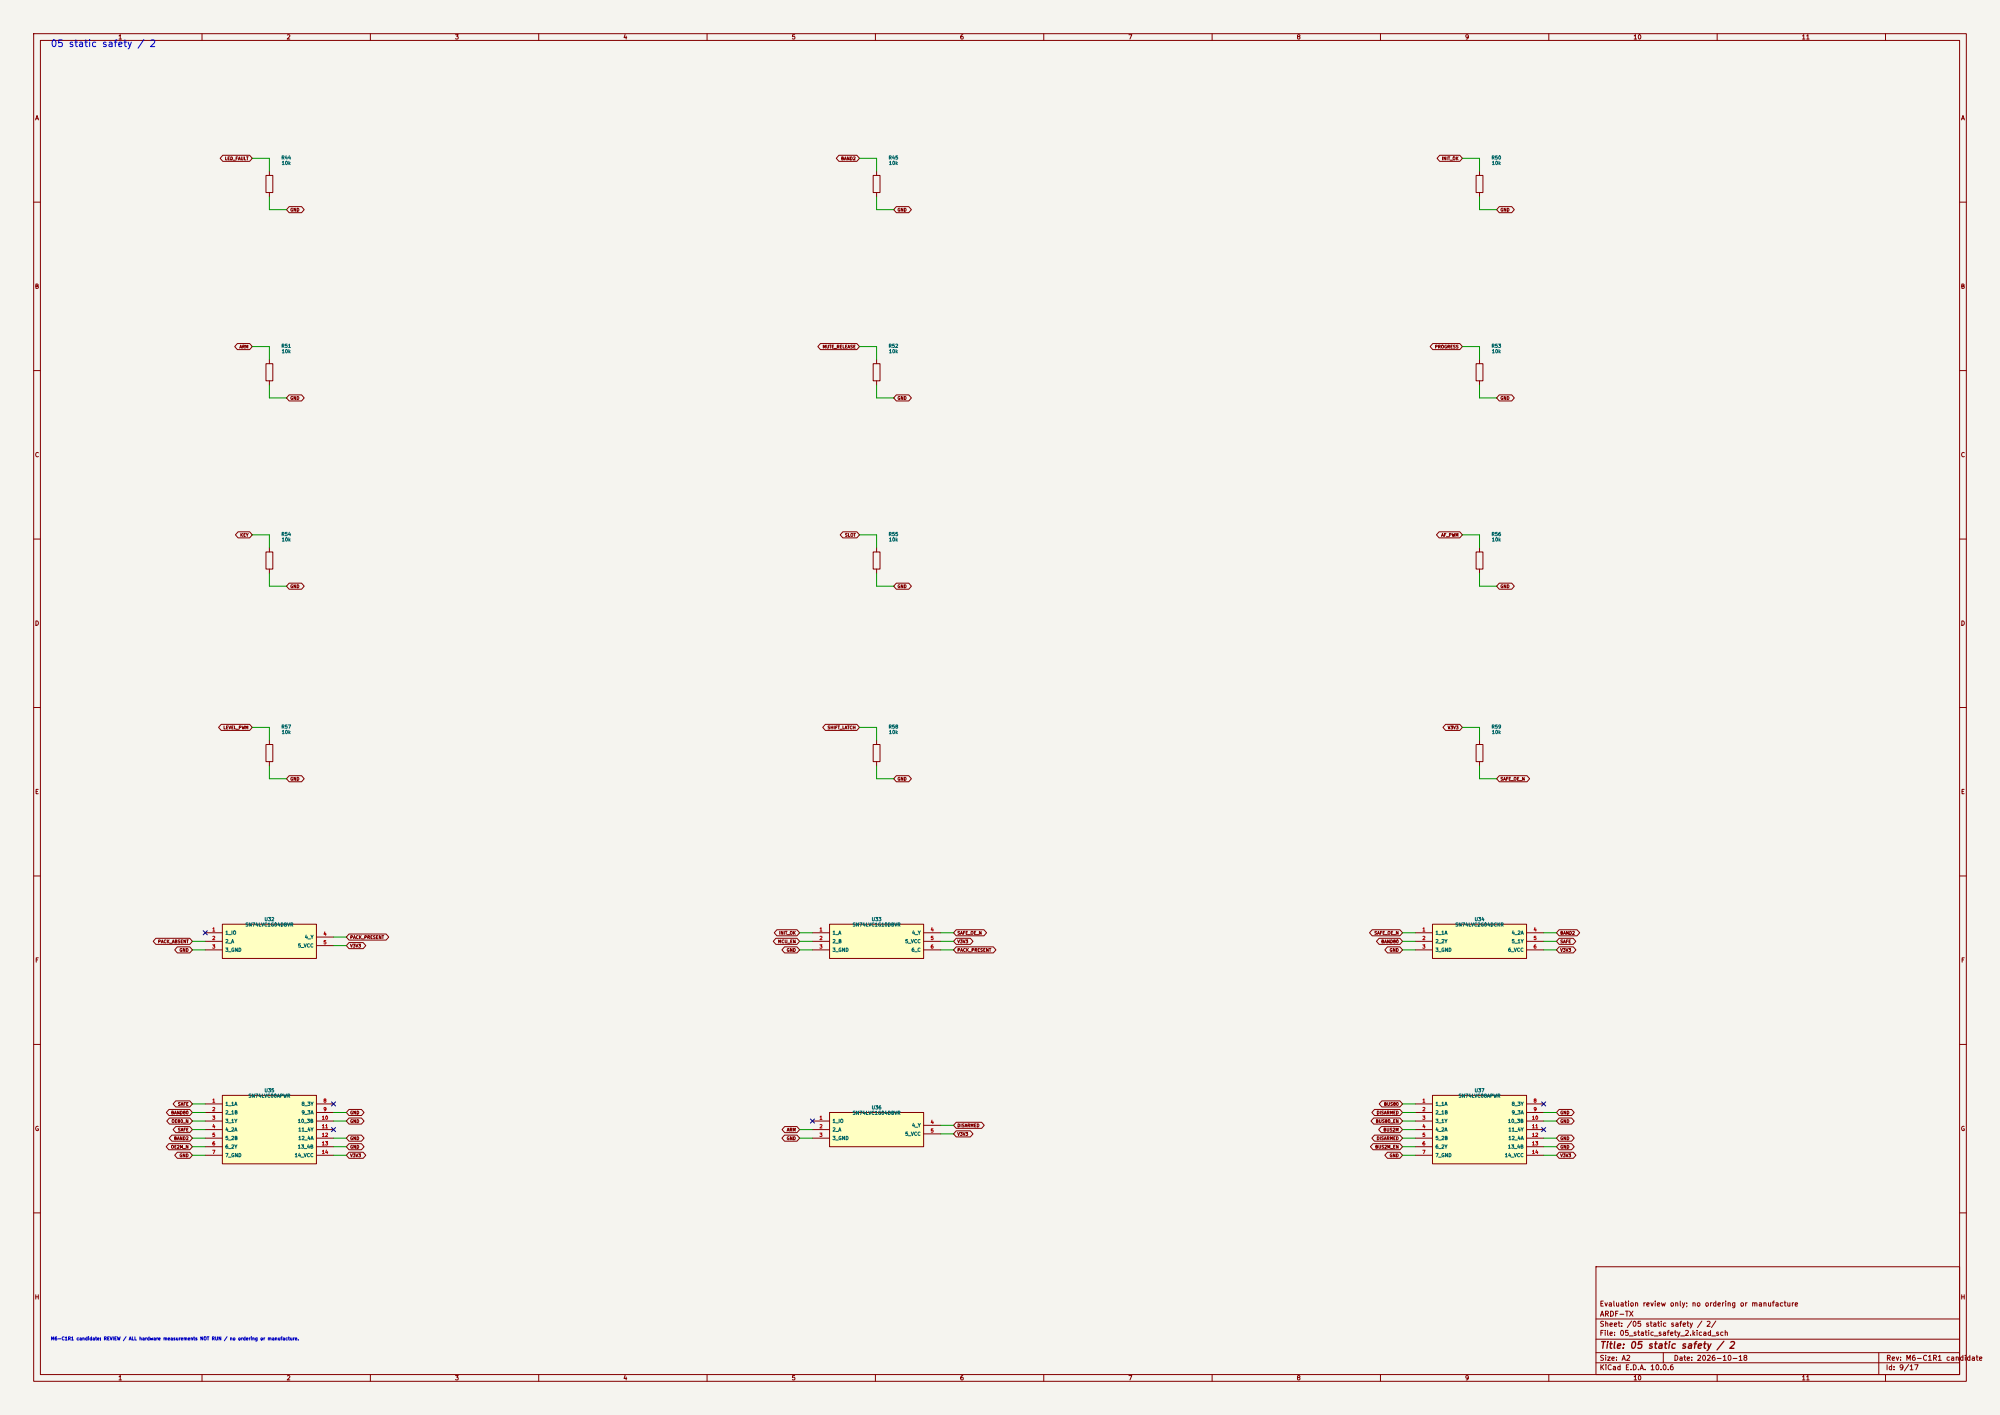
[picture p135: page 9]

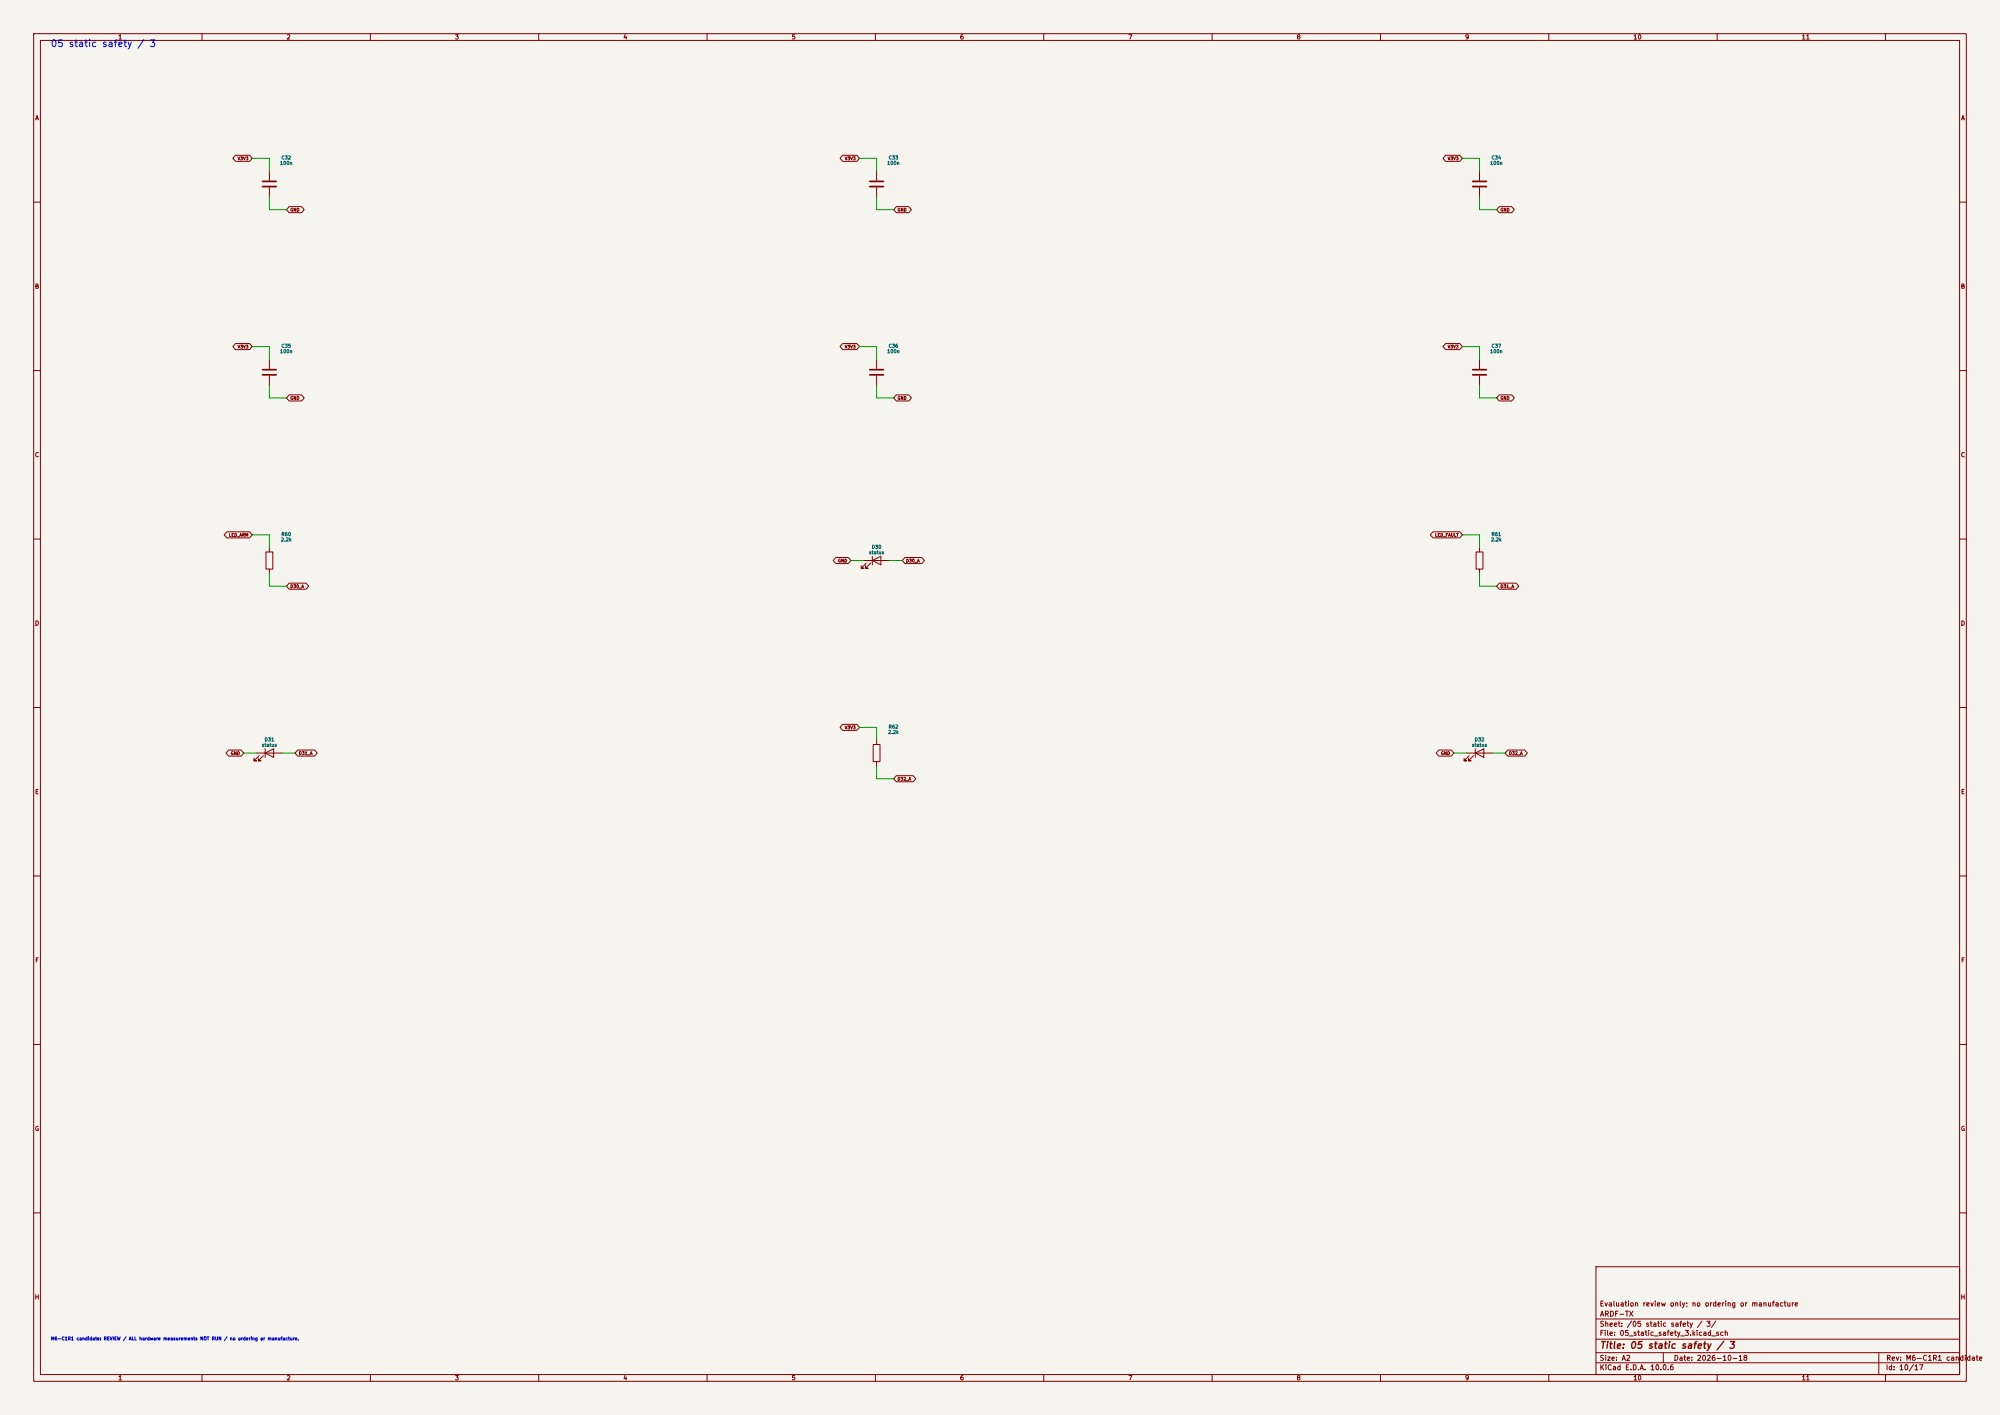
[picture p136: page 10]

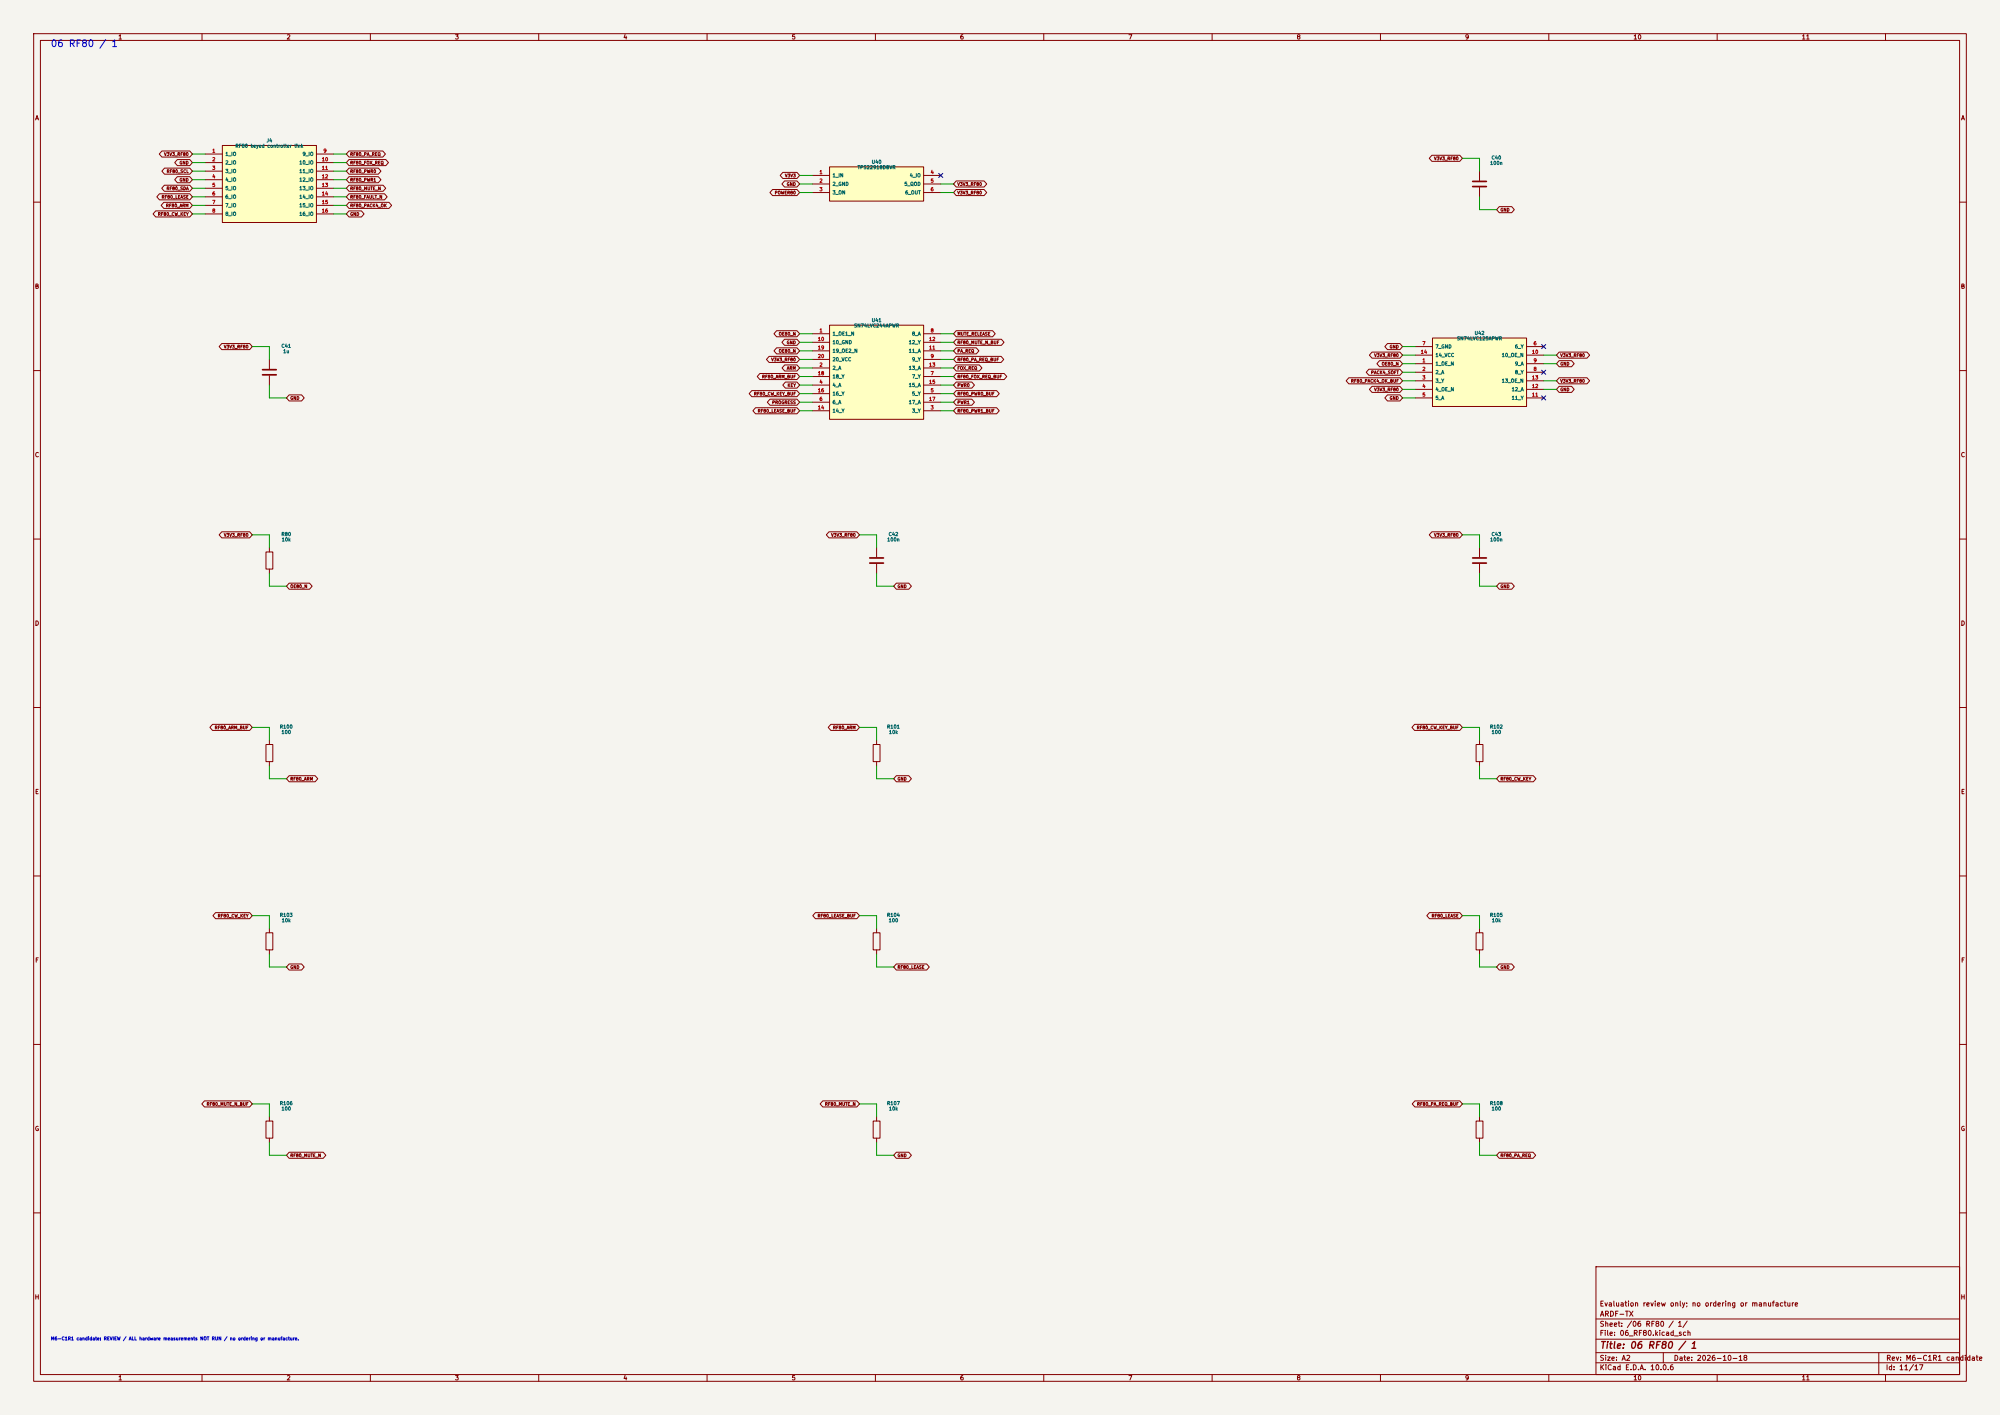
[picture p137: page 11]

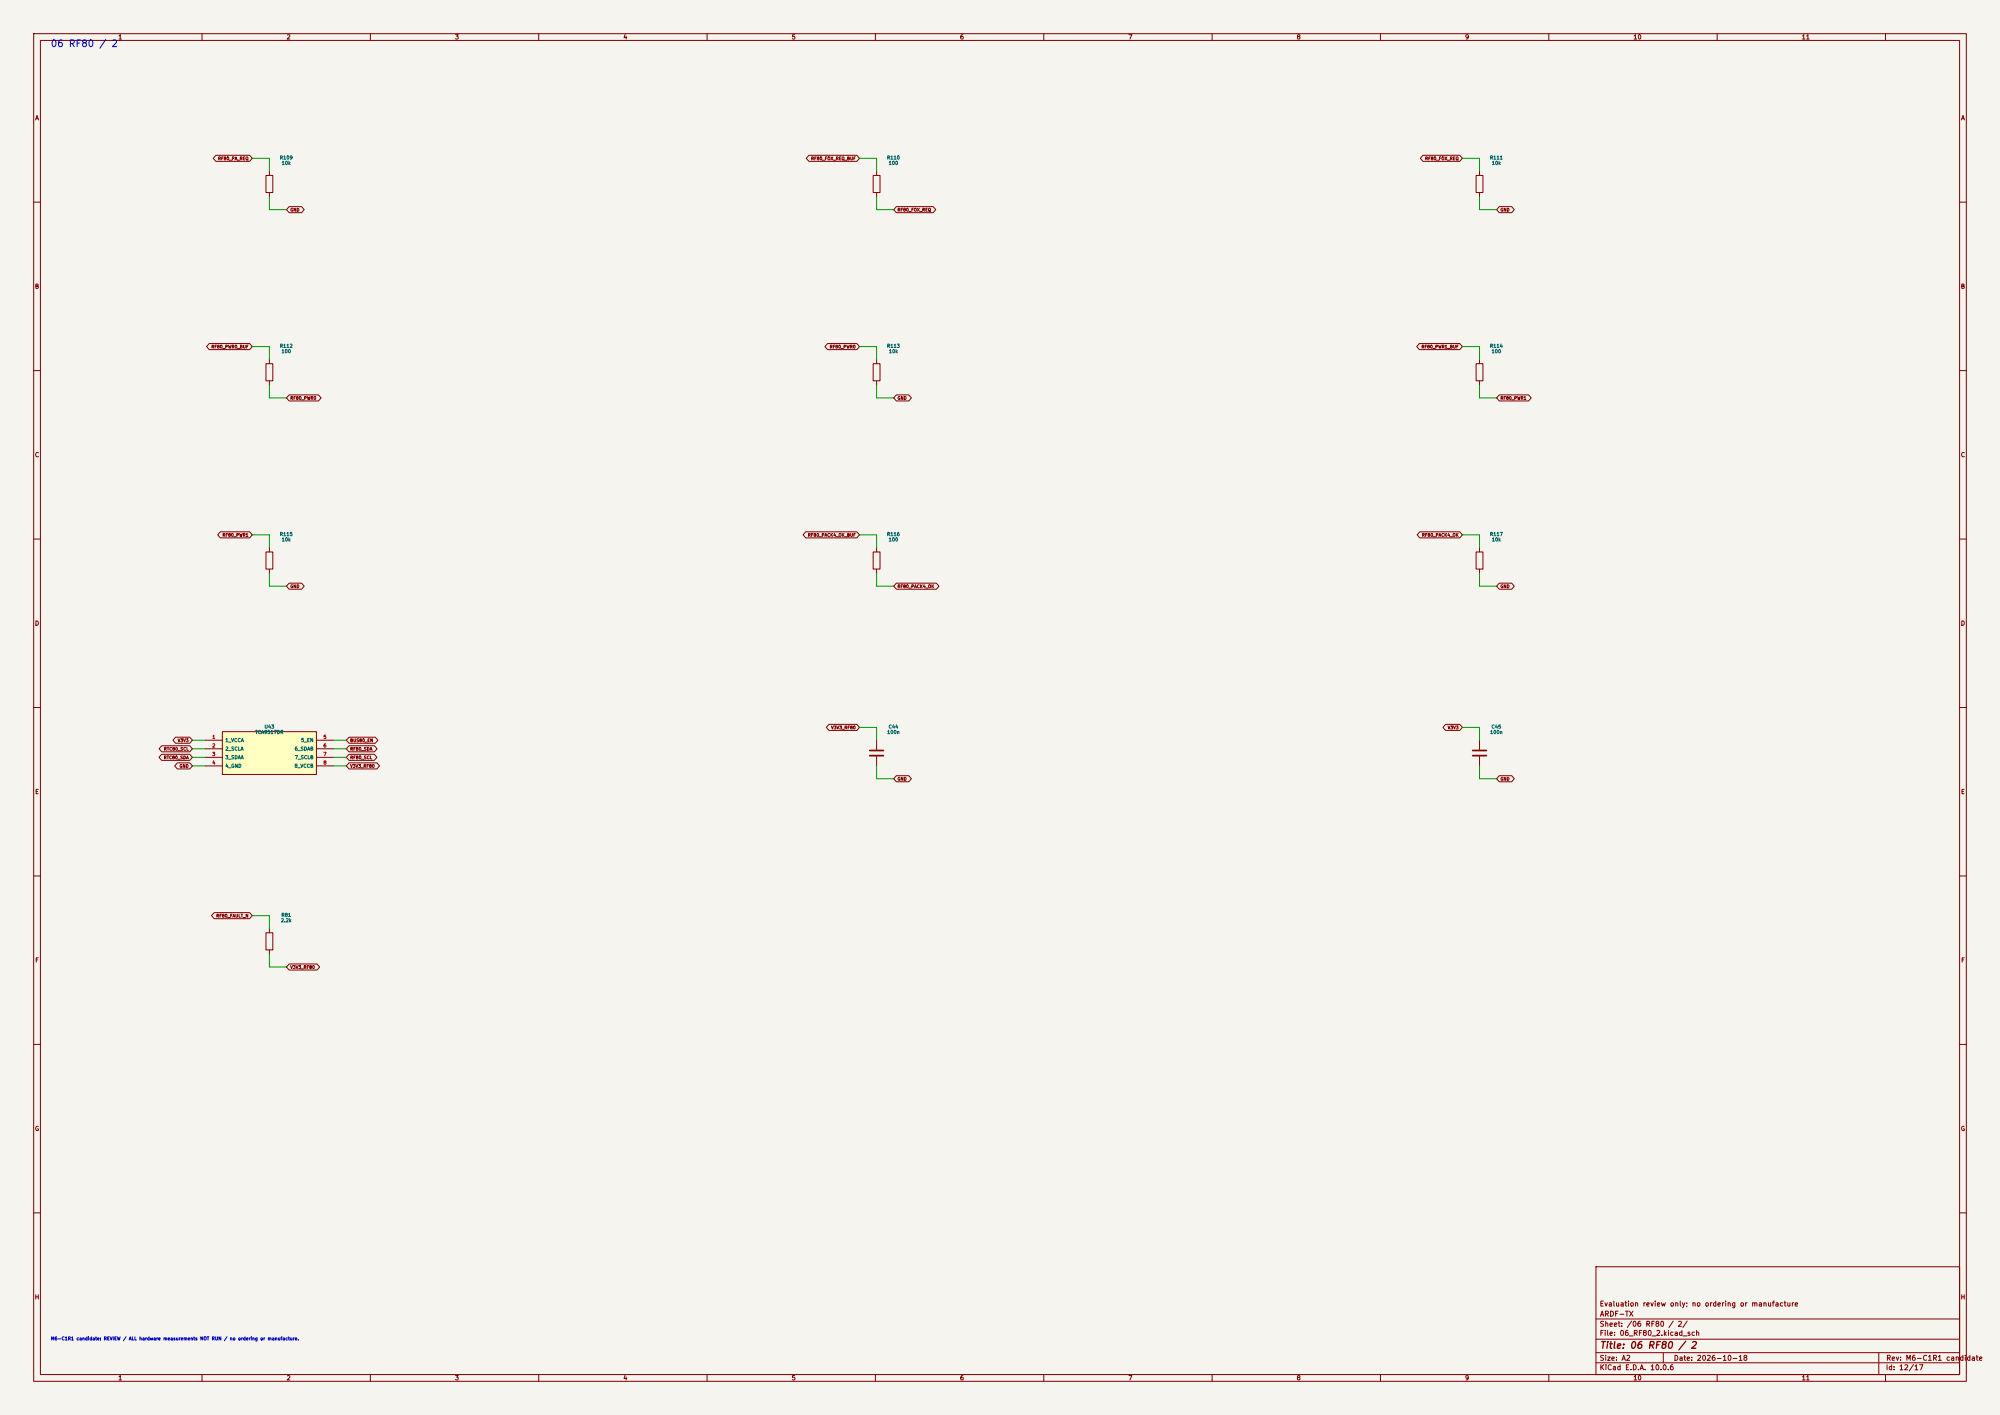
[picture p138: page 12]

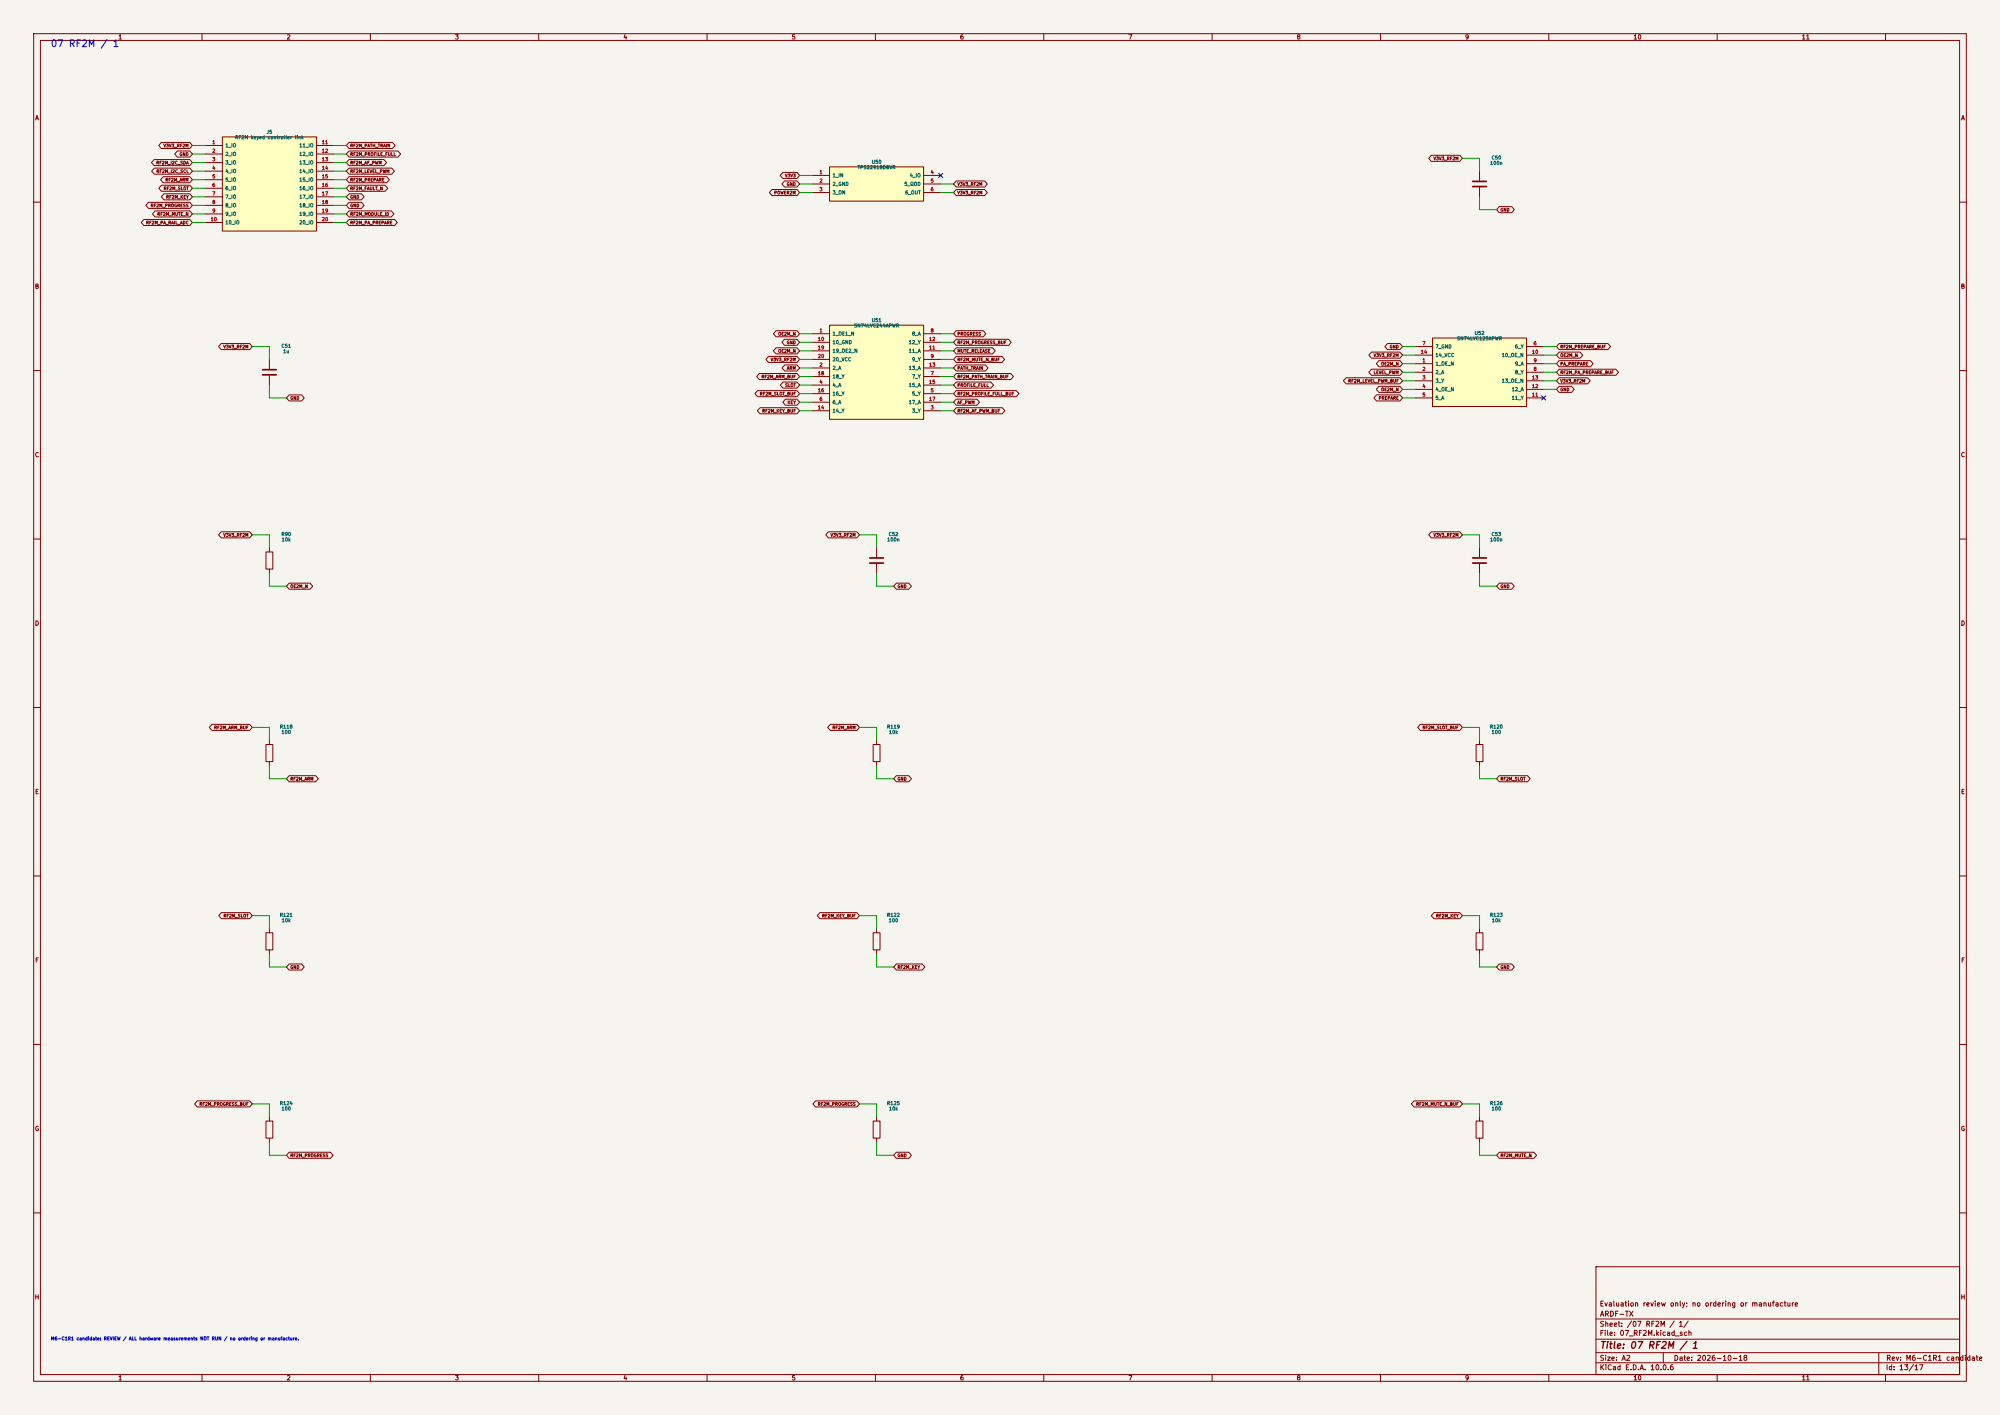
[picture p139: page 13]

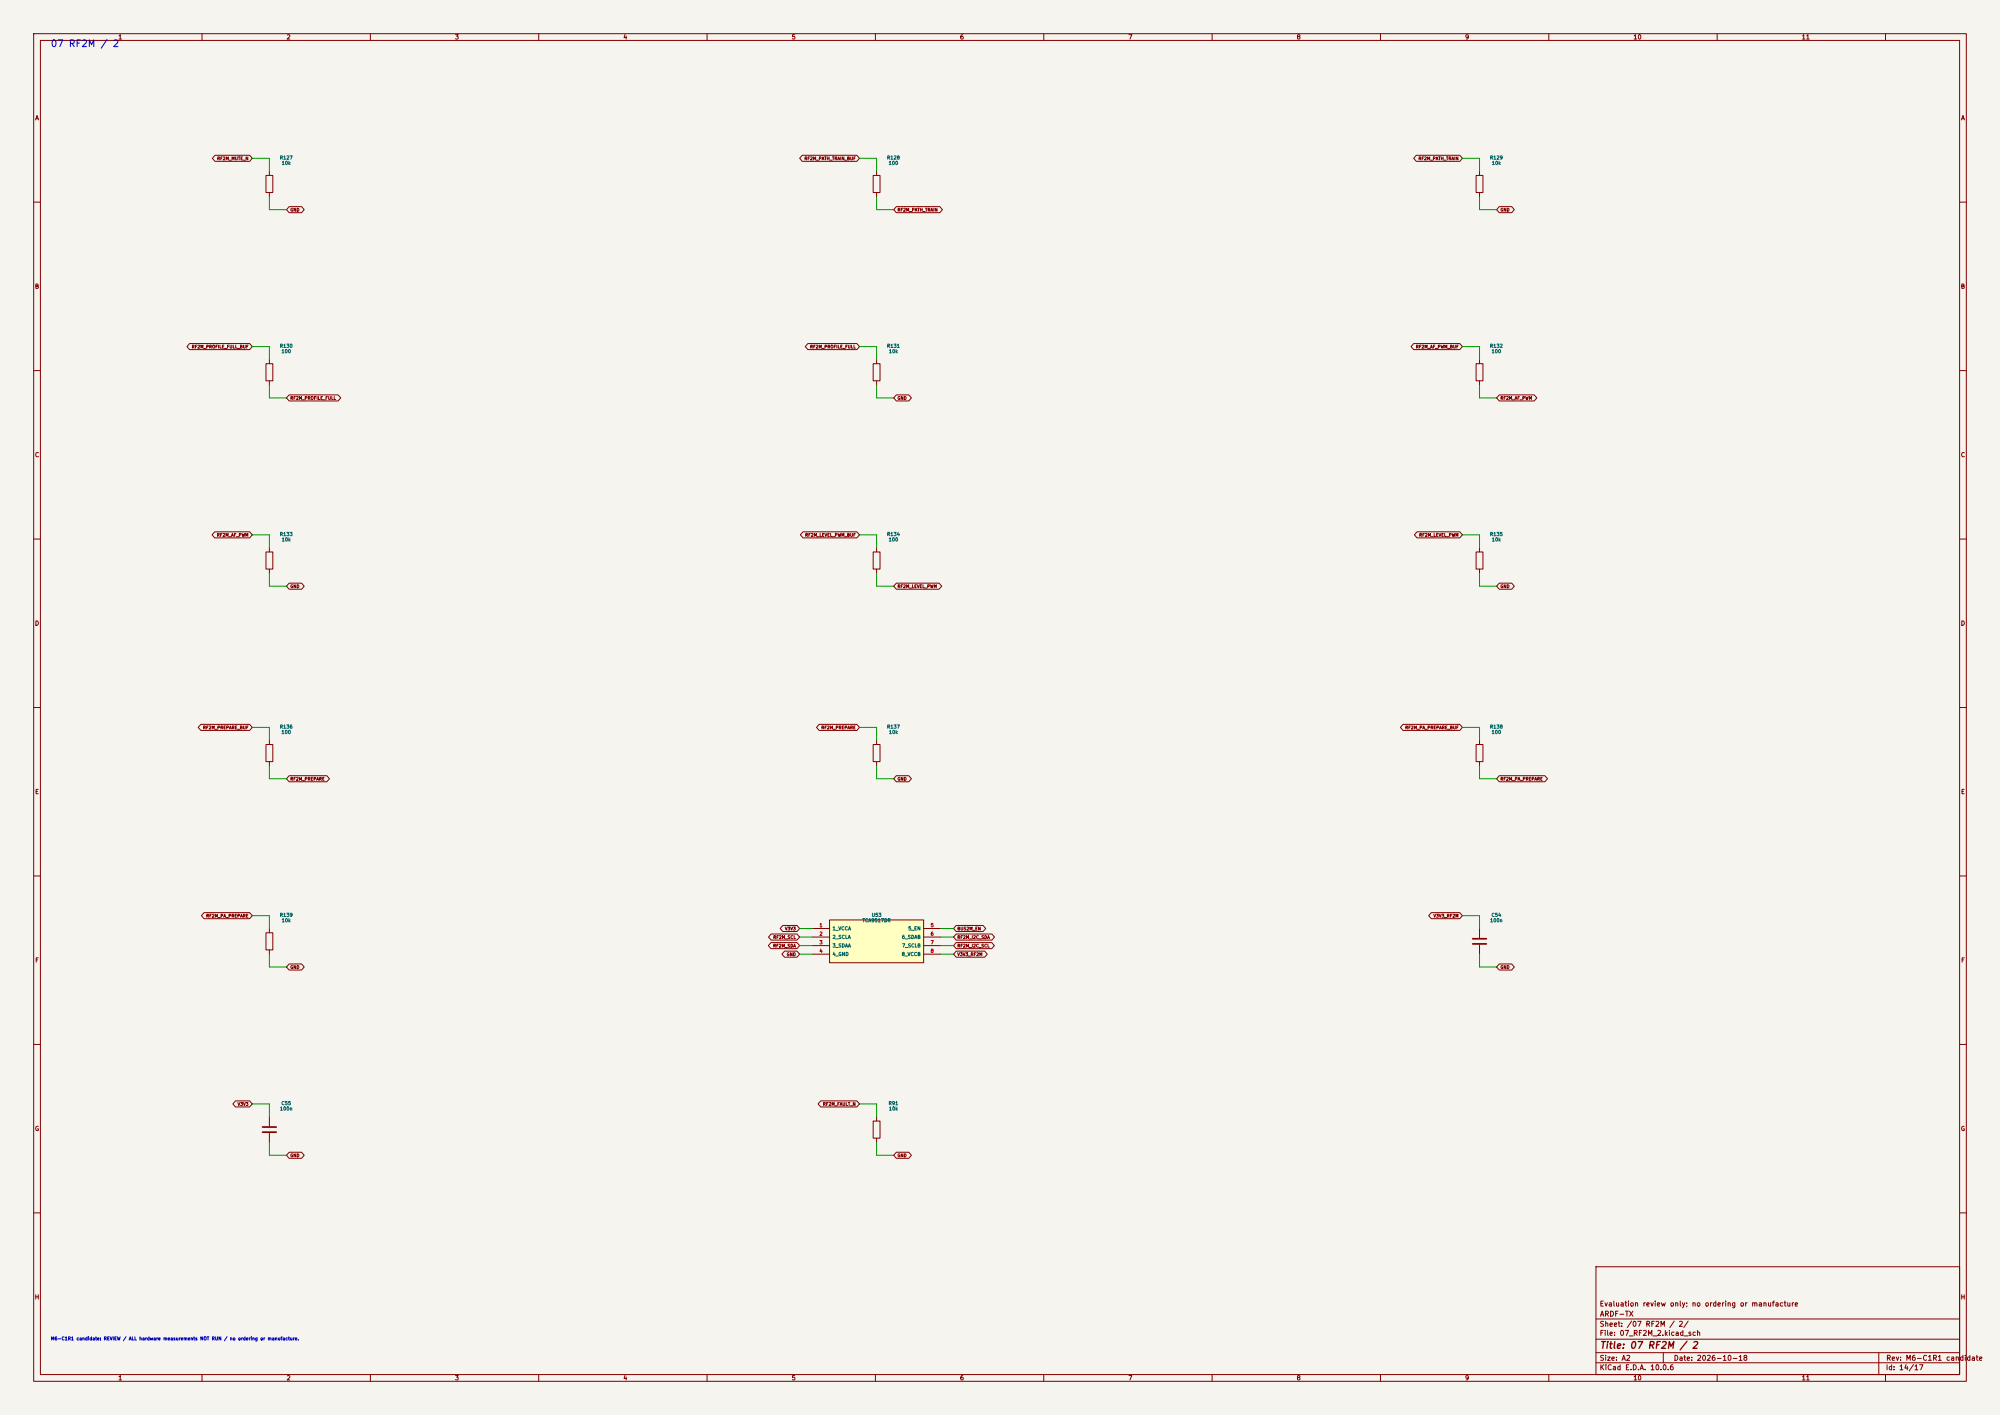
[picture p140: page 14]

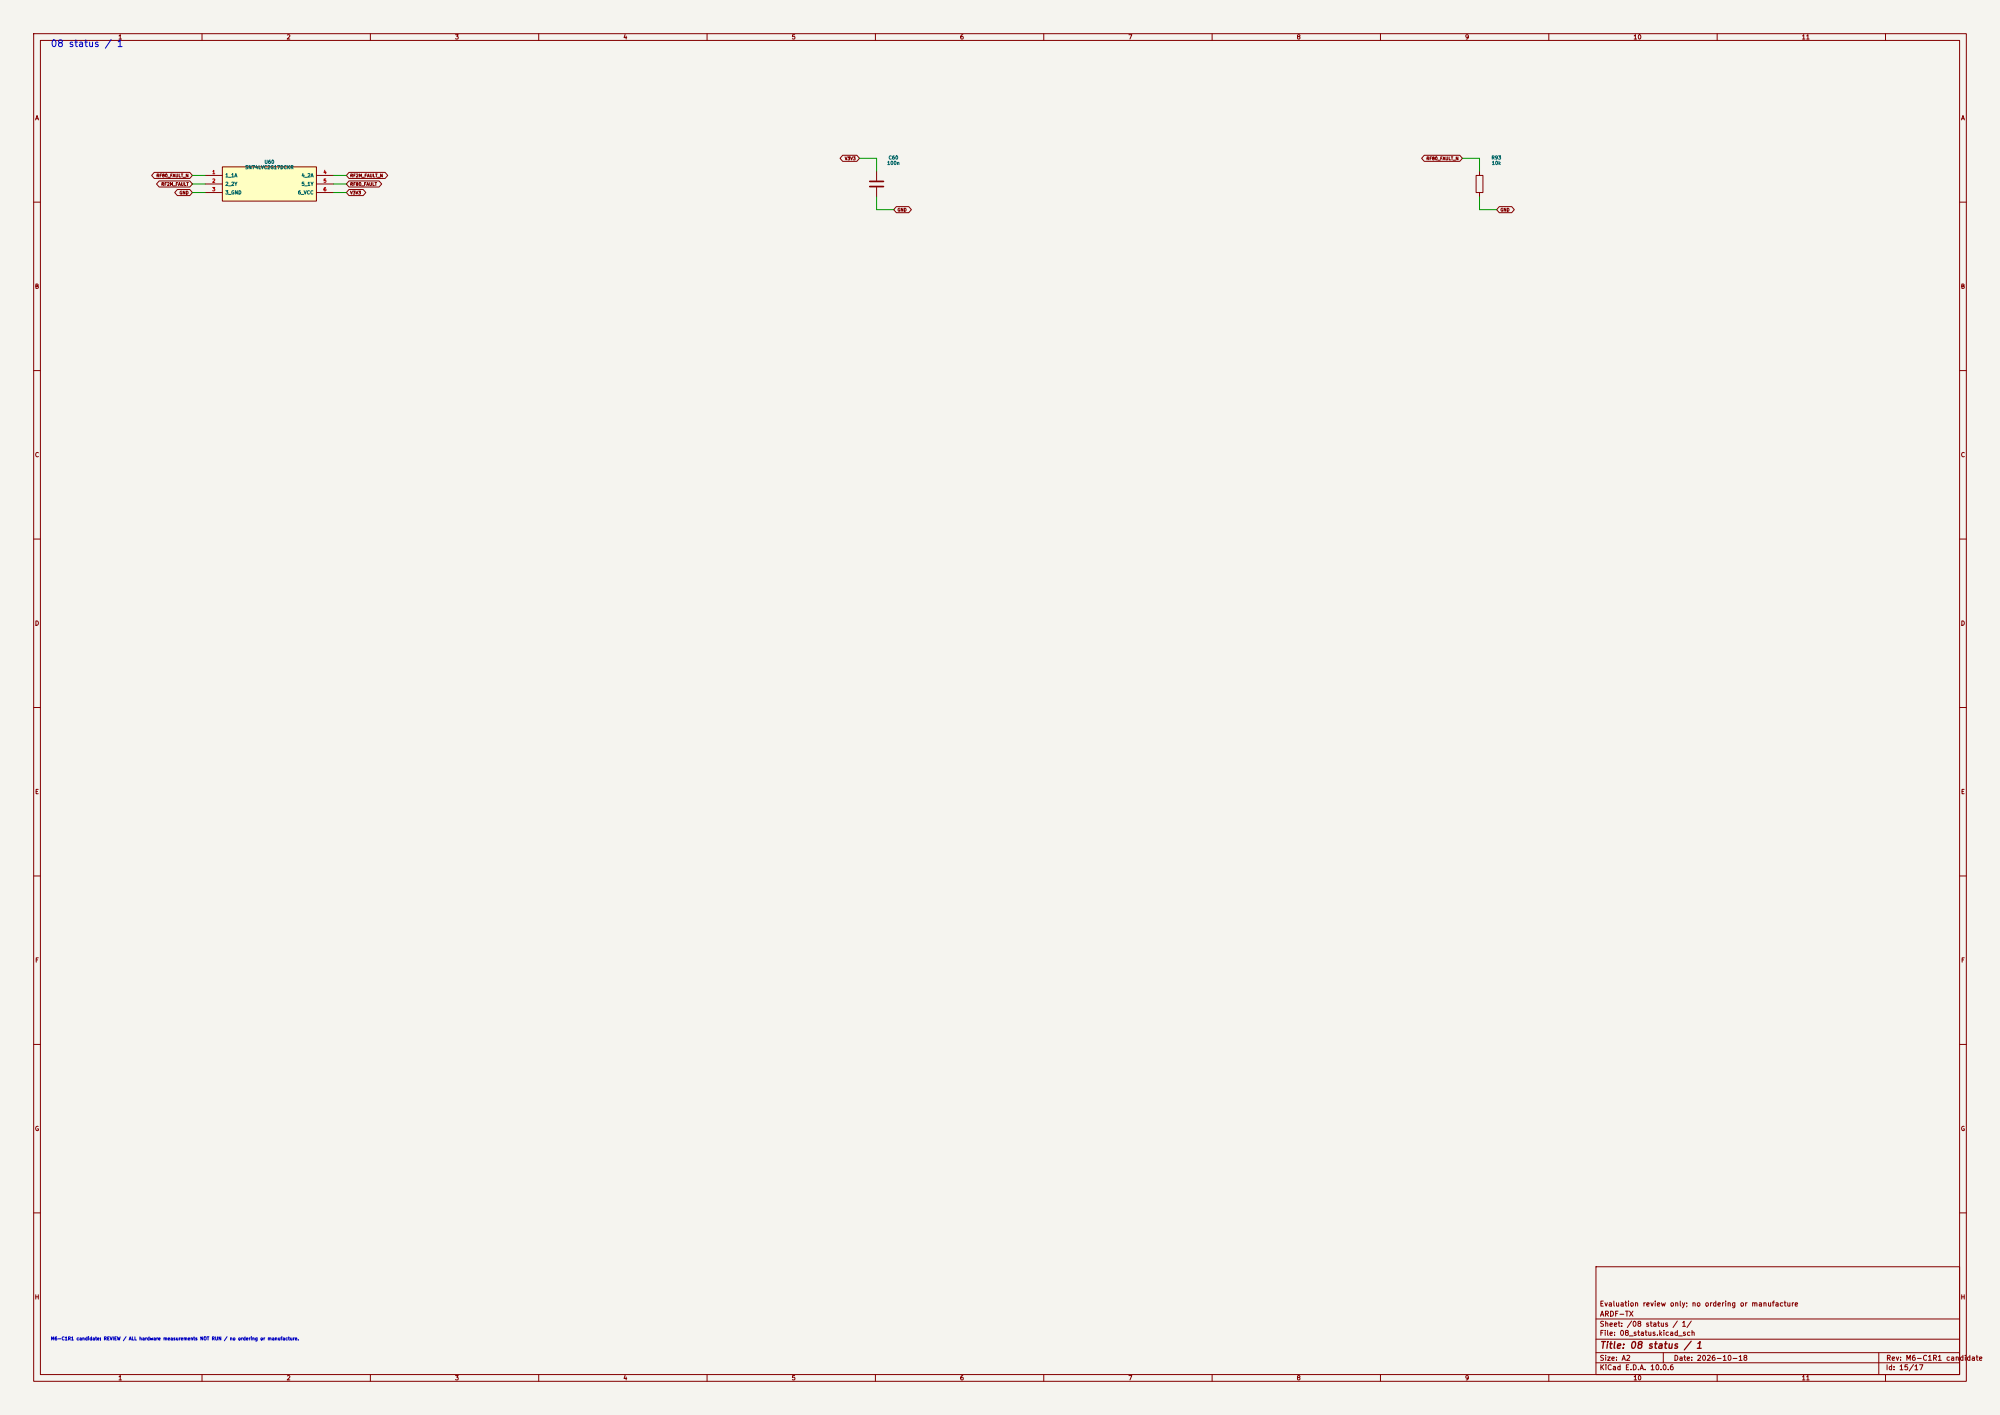
[picture p141: page 15]

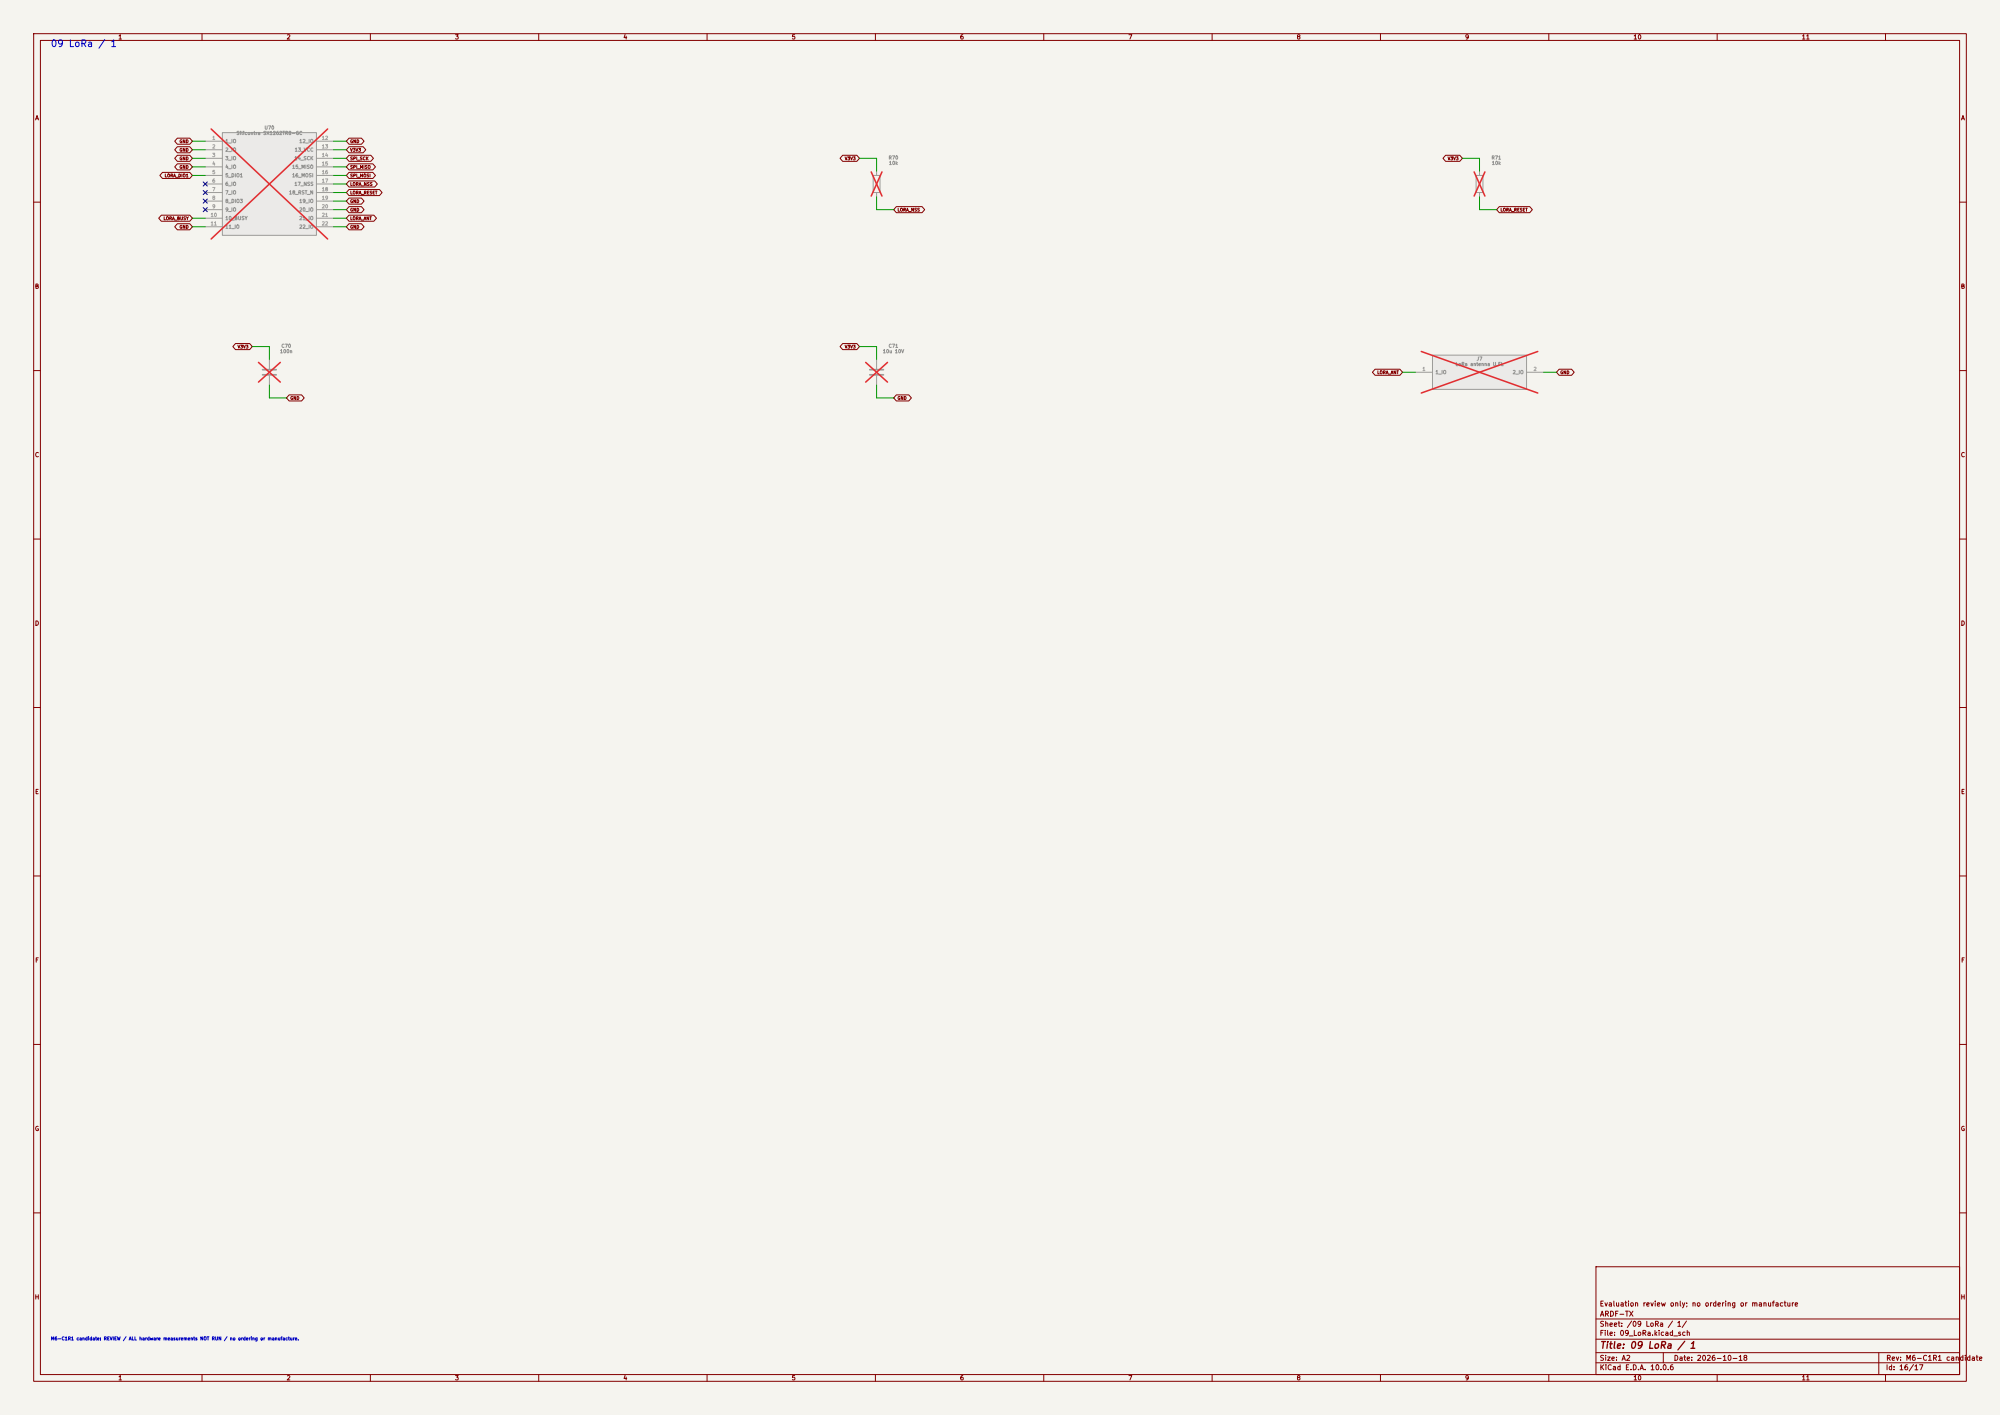
[picture p142: page 16]

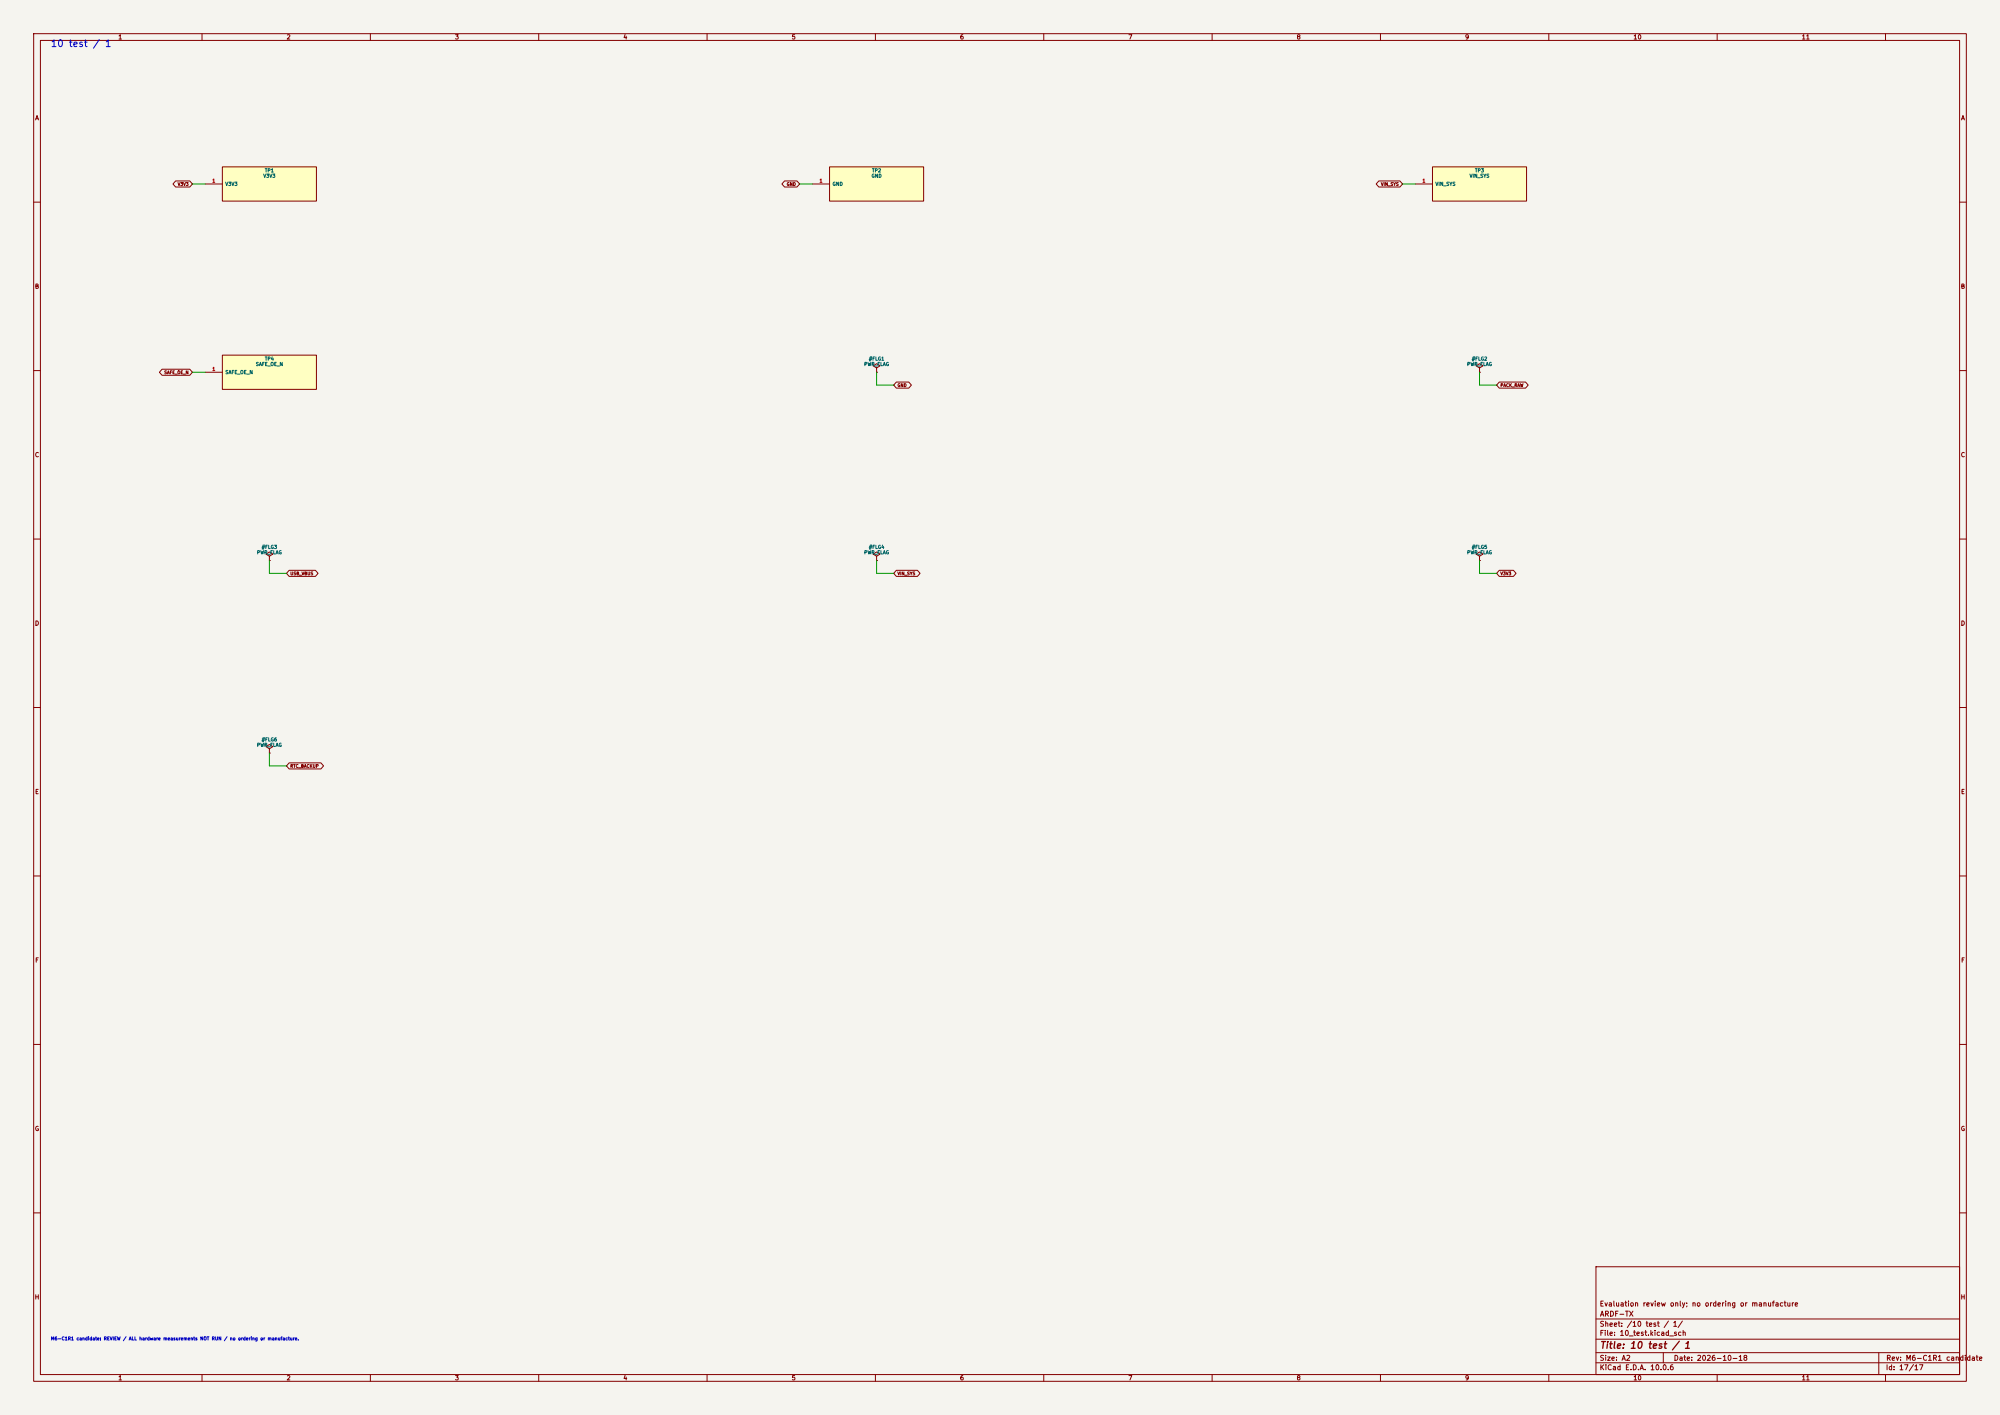
[picture p143: page 17]
