DD1SB/ARDF-TX/hardware/controller/review/M6-C1R1/CTRL.pdf

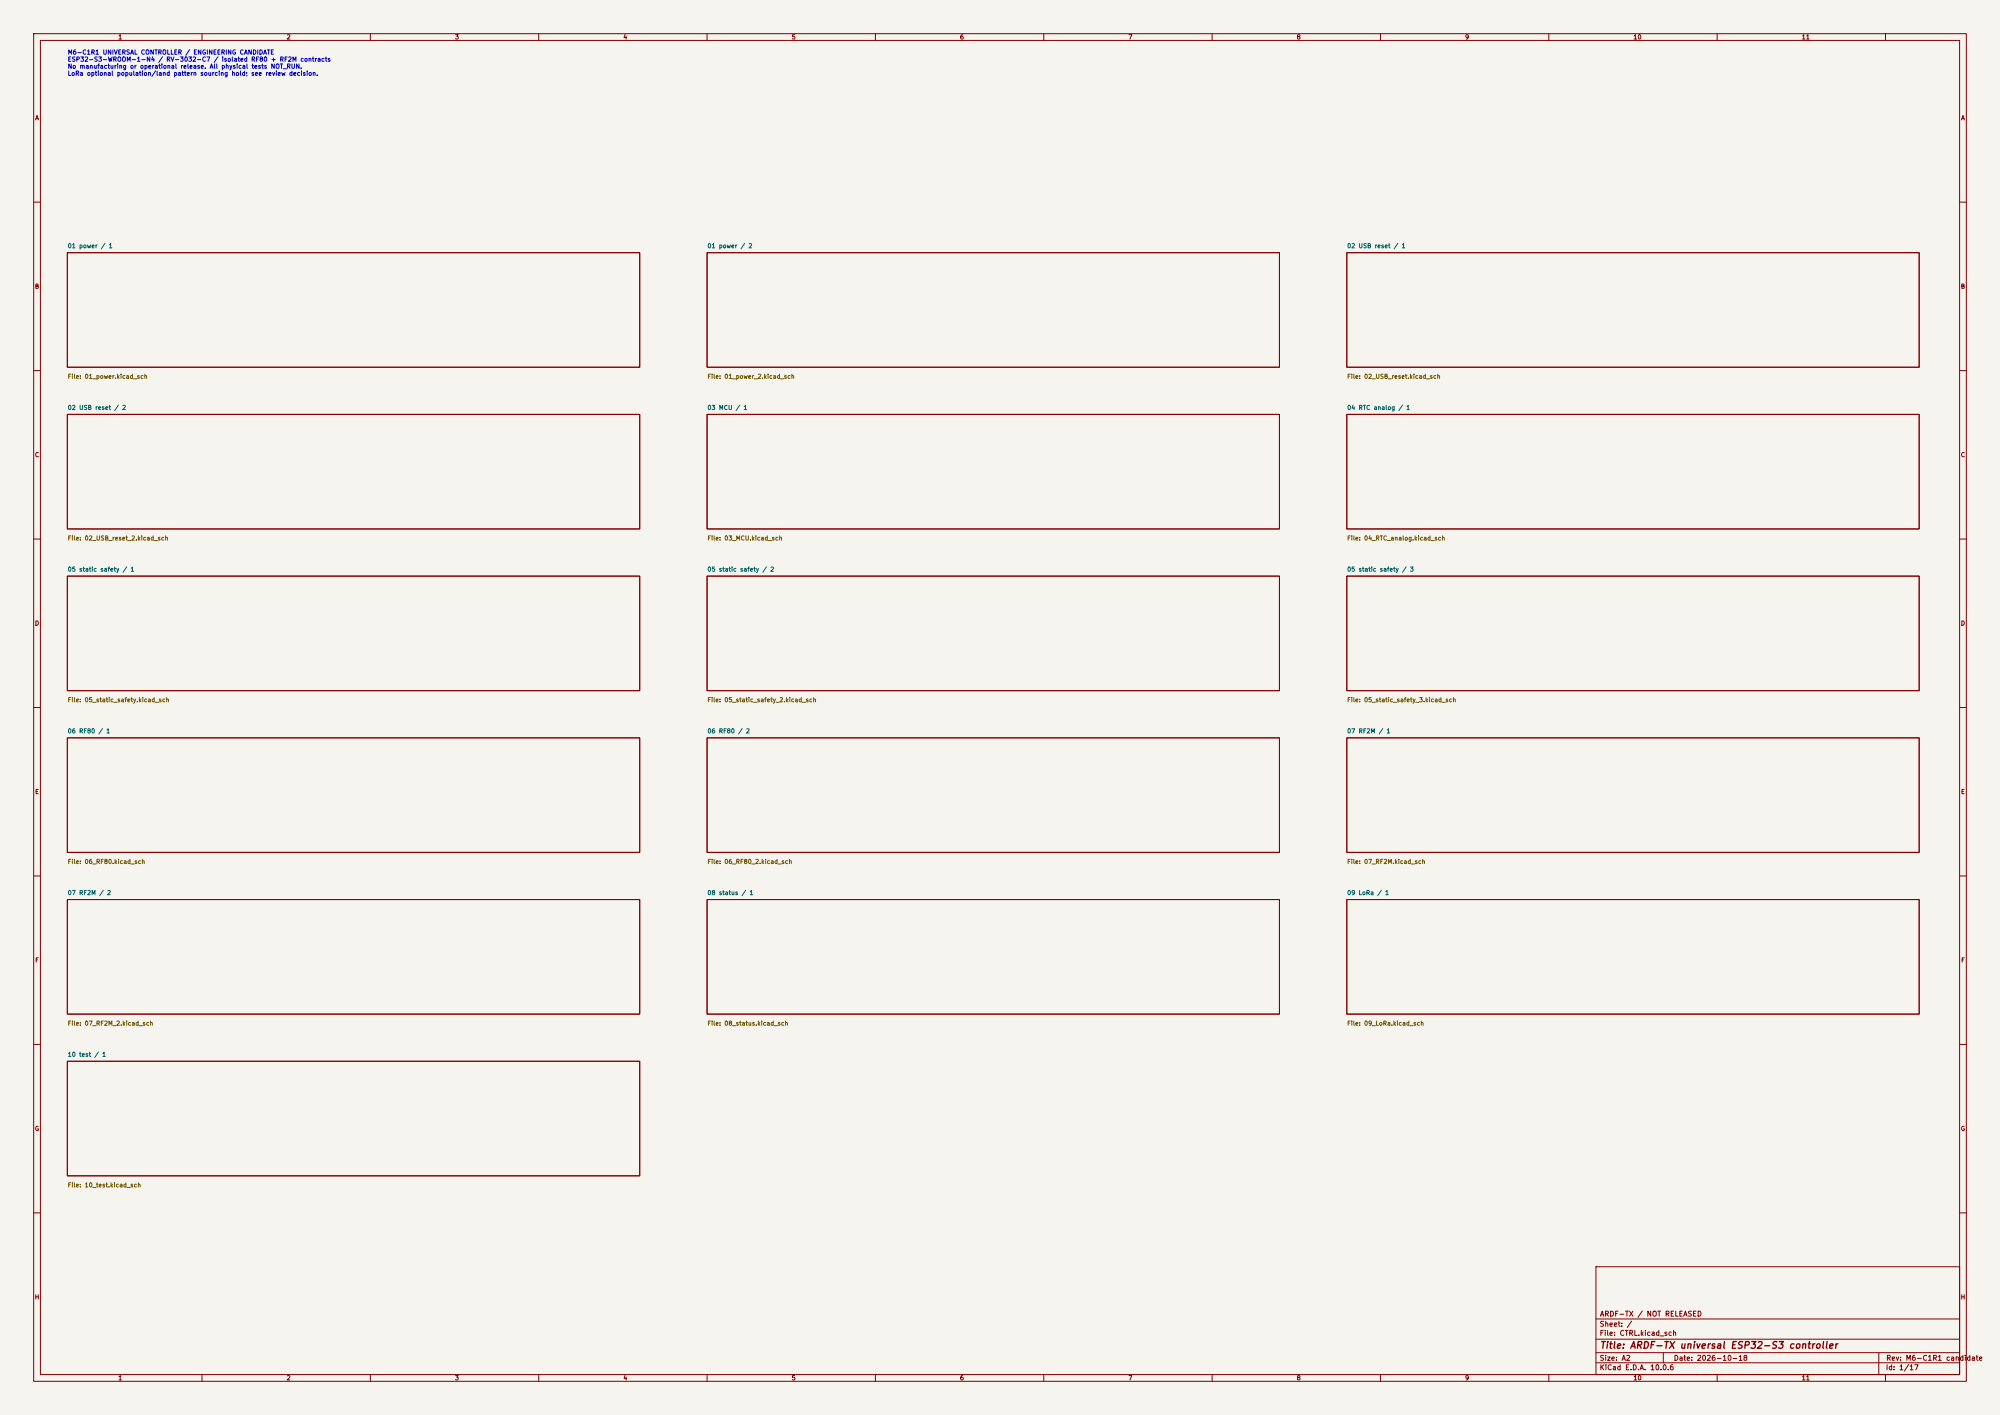
[picture p144: page 1]

File: 02_USB_reset.kicad_sch M6-C1R1 UNIVERSAL CONTROLLER / ENGINEERING CANDIDATE
ESP32-S3-WROOM-1-N4 / RV-3032-C7 / isolated RF80 + RF2M contracts No manufacturing or operational release. All physical tests NOT_RUN. LoRa optional population/land pattern sourcing hold; see review decision.

ARDF-TX / NOT RELEASED
Sheet: /
File: CTRL.kicad_sch
Title: ARDF-TX universal ESP32-S3 controller
KiCad E.D.A. 10.0.6


100V 2A reverse block D3 USB low-drop OR

Low leakage battery OR

Evaluation review only; no ordering or manufacture
ARDF-TX
Sheet: /01 power / 1/
File: 01_power.kicad_sch
Title: 01 power / 1

M6-C1R1 candidate: REVIEW / ALL hardware measurements NOT RUN / no ordering or manufacture.







BUS2M M6-C1R1 candidate: REVIEW / ALL hardware measurements NOT RUN / no ordering or manufacture.








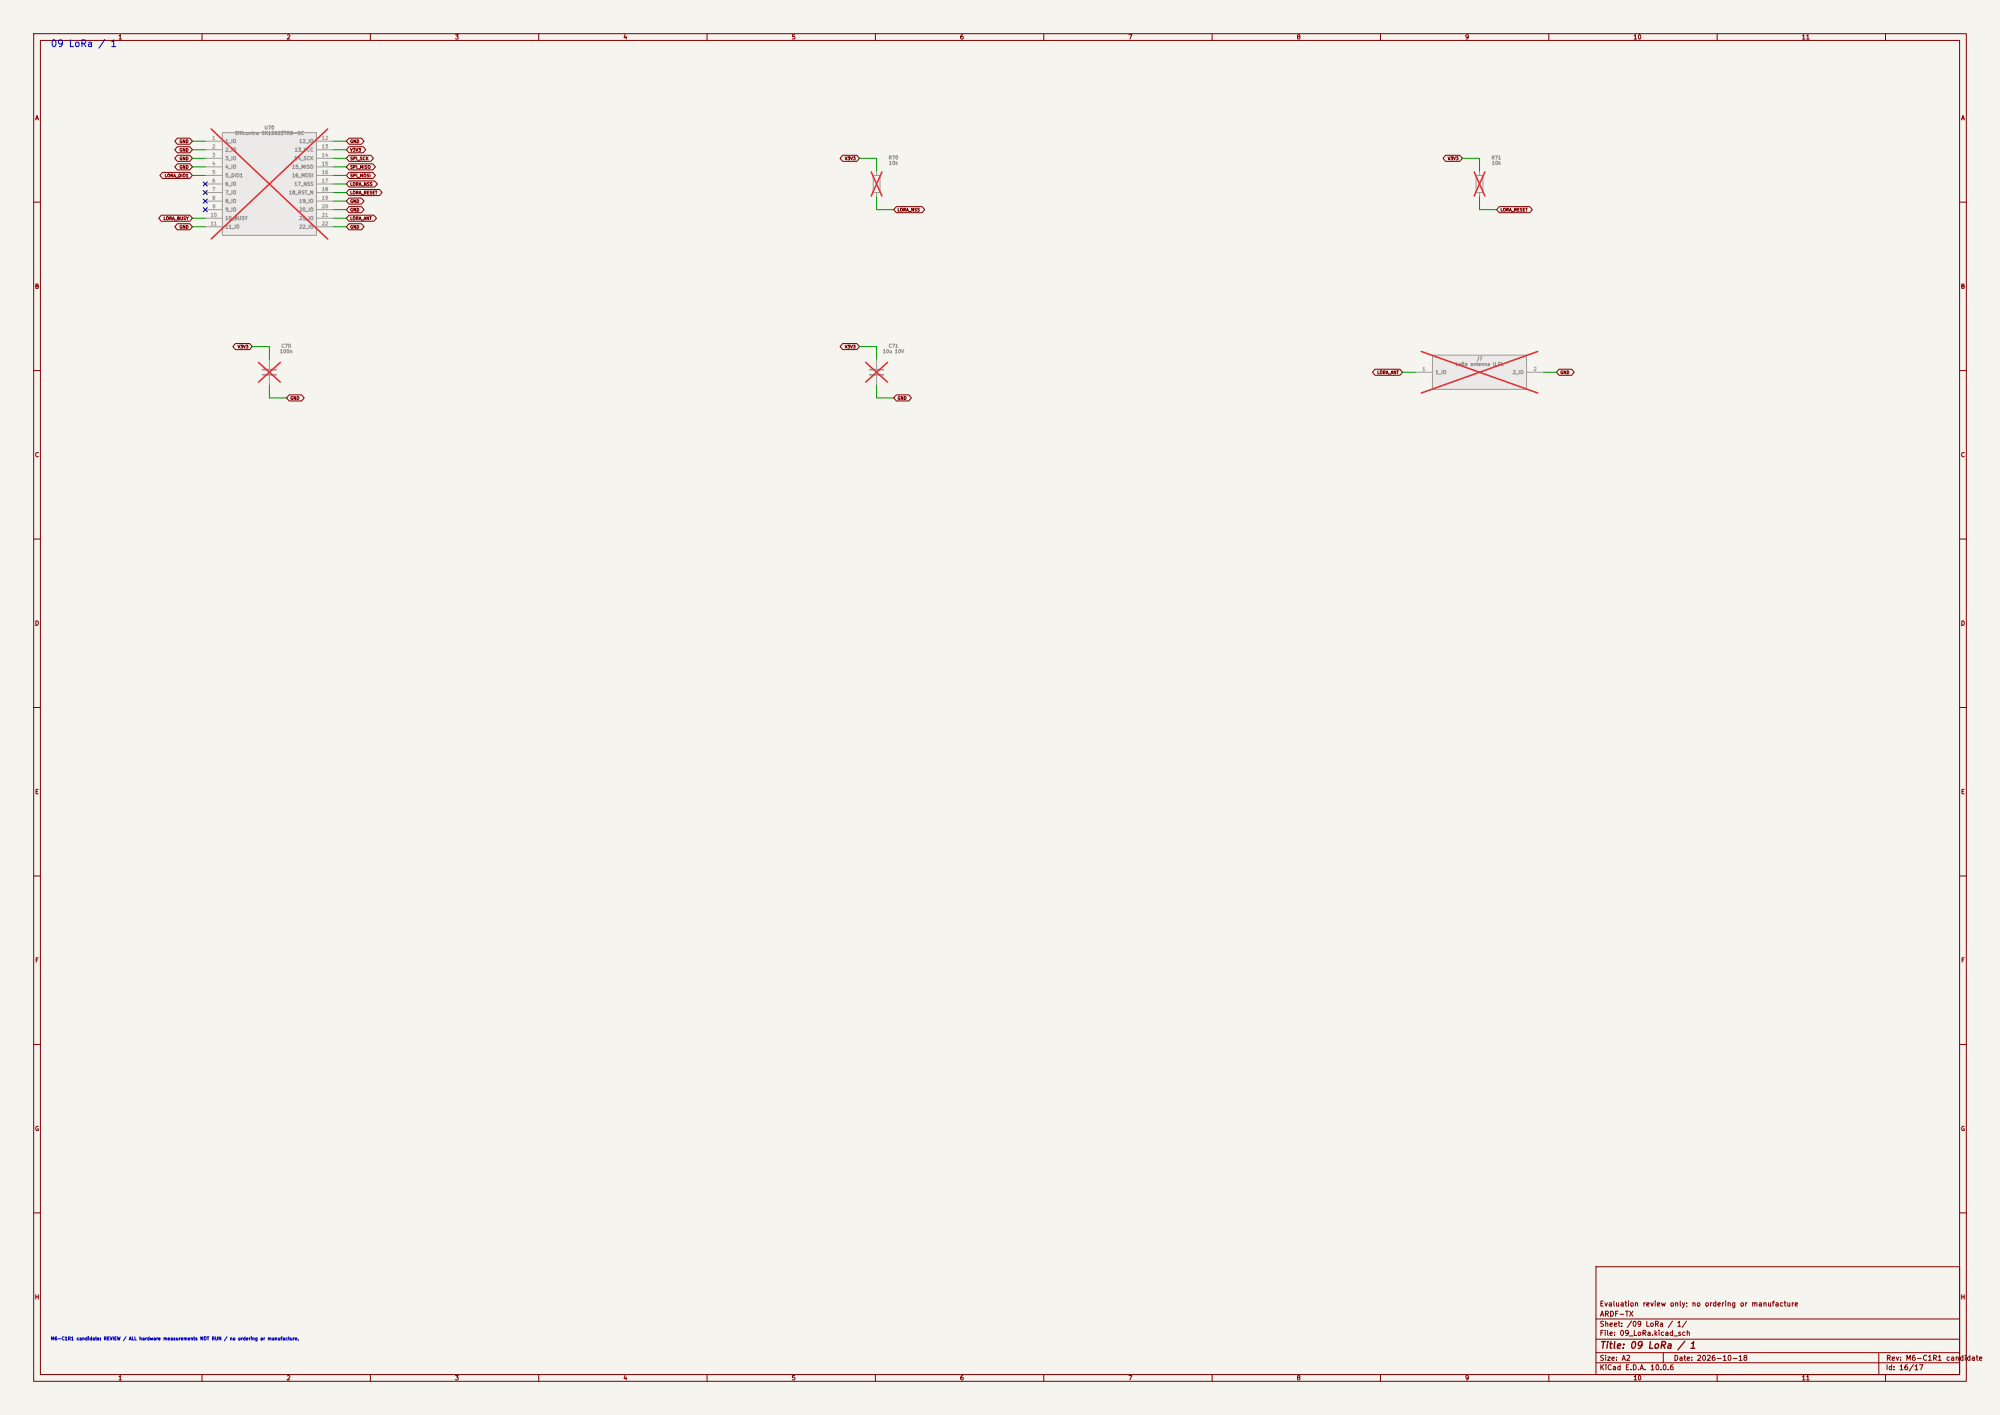
[picture p145: page 16]
