DD1SB/ARDF-TX/hardware/2m/review/M5B-E4R1/assembly-BOOST2S.pdf

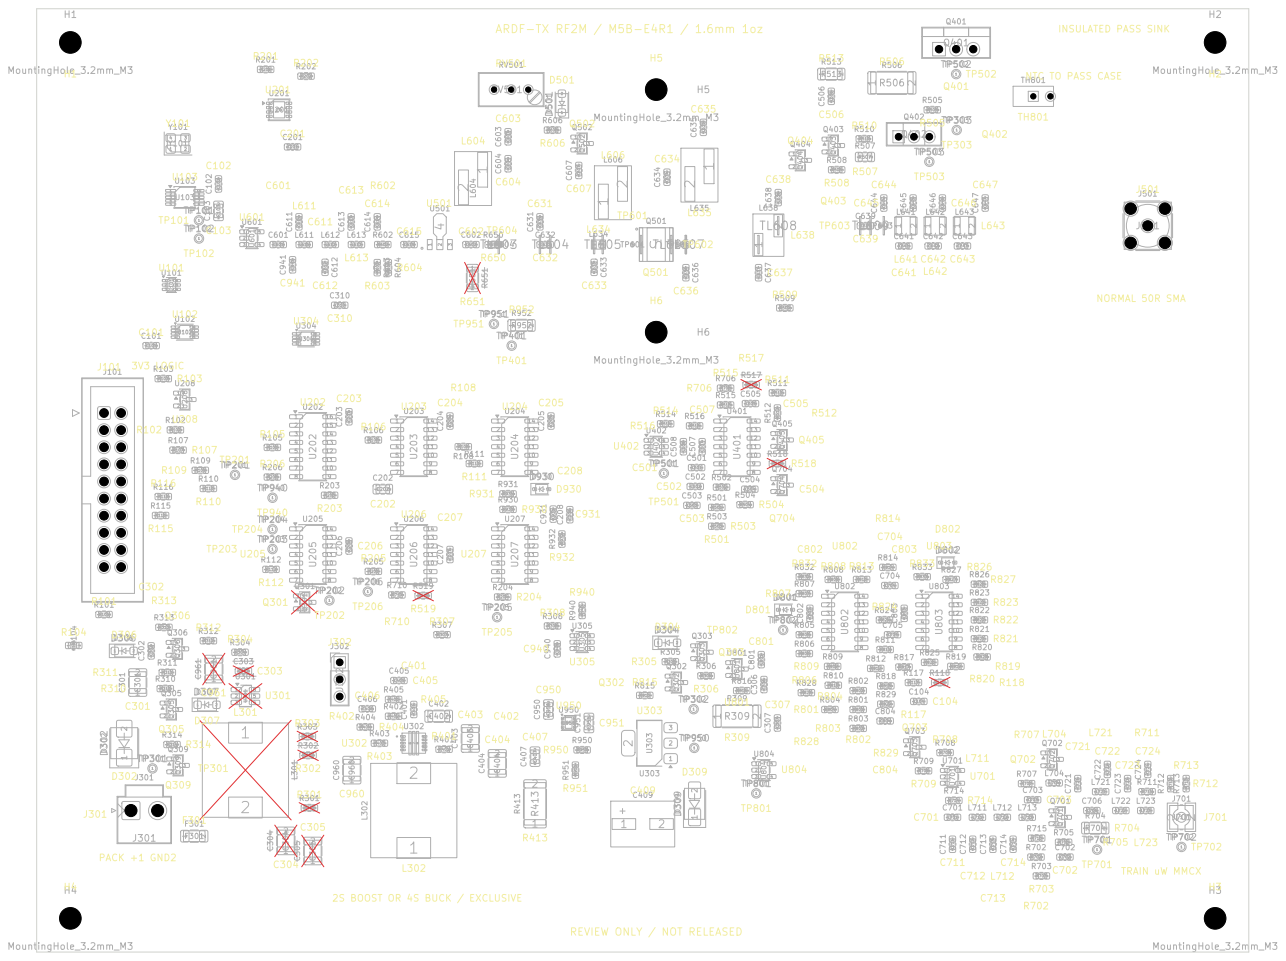
[picture p146: page 1]

INSULATED PASS SINK
NTC TO PASS CASE C721

2S BOOST OR 4S BUCK / EXCLUSIVE R405

J701 REVIEW ONLY / NOT RELEASED
