DD1SB/ARDF-TX/hardware/2m/review/M5B-E2/assembly-BOOST2S.pdf

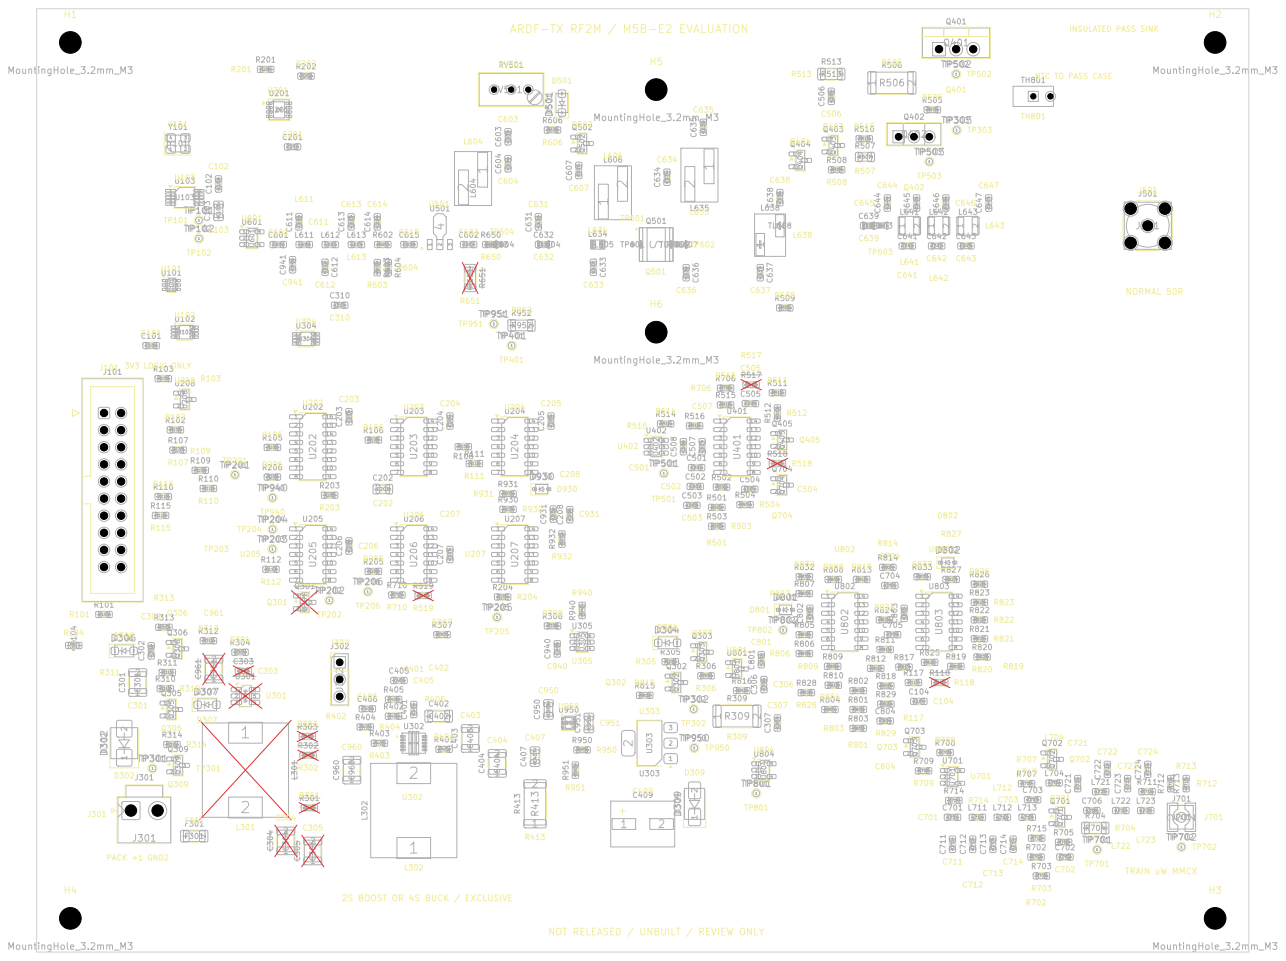
[picture p166: page 1]

NTC TO PASS CASE

J701 2S BOOST OR 4S BUCK / EXCLUSIVE

TRAIN uW MMCX NOT RELEASED / UNBUILT / REVIEW ONLY
