DD1SB/ARDF-TX/hardware/2m/review/M5A-R4/RF2M.pdf

1 | 2 | 3 | 4 | 5 | 6 | 7 | 8 | 9 | 10 | 11

AB

C

D

E

### FGH

AB

C

D

E

## FGH Date: 2026-10-16

Size: A2 | Rev: M5A-R4
KiCad E.D.A. 10.0.6 | Id: 1/19

# Title: ARDF-TX 2 m A2A evaluation schematic

## File: RF2M.kicad_sch

## Sheet: /

## ARDF-TX / NOT RELEASED

03 External protected pack and exclusive conversion populations File: 03_input_power.kicad_sch

## 10 Local physical switches and clock sequencing

## File: 10_enable_detail.kicad_sch 06c Original ST elliptic harmonic LPF

File: 06c_st_lpf.kicad_sch | 08 Local voltage, current and thermal trip continued

## File: 08_protectionb1.kicad_sch 07 Independent very-low-power sine-AM training path

## File: 07_training.kicad_sch 05 Sine reconstruction and series AM modulator continued

## File: 05_amb1.kicad_sch 08 Local voltage, current and thermal trip

File: 08_protection.kicad_sch 06 Source filter, economical driver and fixed bias continued

File: 06_source_driver_biasb1.kicad_sch 05 Sine reconstruction and series AM modulator File: 05_am.kicad_sch

02 Minimal independent fail-off and captured ARM context File: 02_interlocks.kicad_sch 01 Interface and local Si5351 source

## File: 01_interface_source.kicad_sch

## 11 External supplies and integrated commissioning

# File: 11_external_contract.kicad_sch 06b ST final-stage matching derivative

File: 06b_st_matching.kicad_sch 07 Independent very-low-power sine-AM training path continued

File: 07_trainingb1.kicad_sch 06 Source filter, economical driver and fixed bias File: 06_source_driver_bias.kicad_sch 04 2S boost and regulated MMIC rail File: 04_boost_driver_supply.kicad_sch 03 External protected pack and exclusive conversion populations continued

File: 03_input_powerb1.kicad_sch | 02 Minimal independent fail-off and captured ARM context continued

# File: 02_interlocksb1.kicad_sch M5A-R4 / ONE INTEGRATED TRUE-AM CANDIDATE / NOT RELEASED

ST PD54008L-E output network and elliptic LPF traced; PHA-1 interstage adaptation unqualified.
2S BOOST9Vfixed OR4S BUCK9Vfull/7.5Vreduced;exclusive populations. Training3.3V only.
No obsolete multiplier chain or adjustable RF coils. Full RF/AM/thermal acceptance NOT_RUN.
OPEN reservoir/coil/connector definitions and changed interstage match; NO MANUFACTURING. DF782 and TI RNW manufacturer-derived candidate lands checked; thermal/stencil review OPEN. See docs/M5A_R4_REVIEW_DECISION.md.

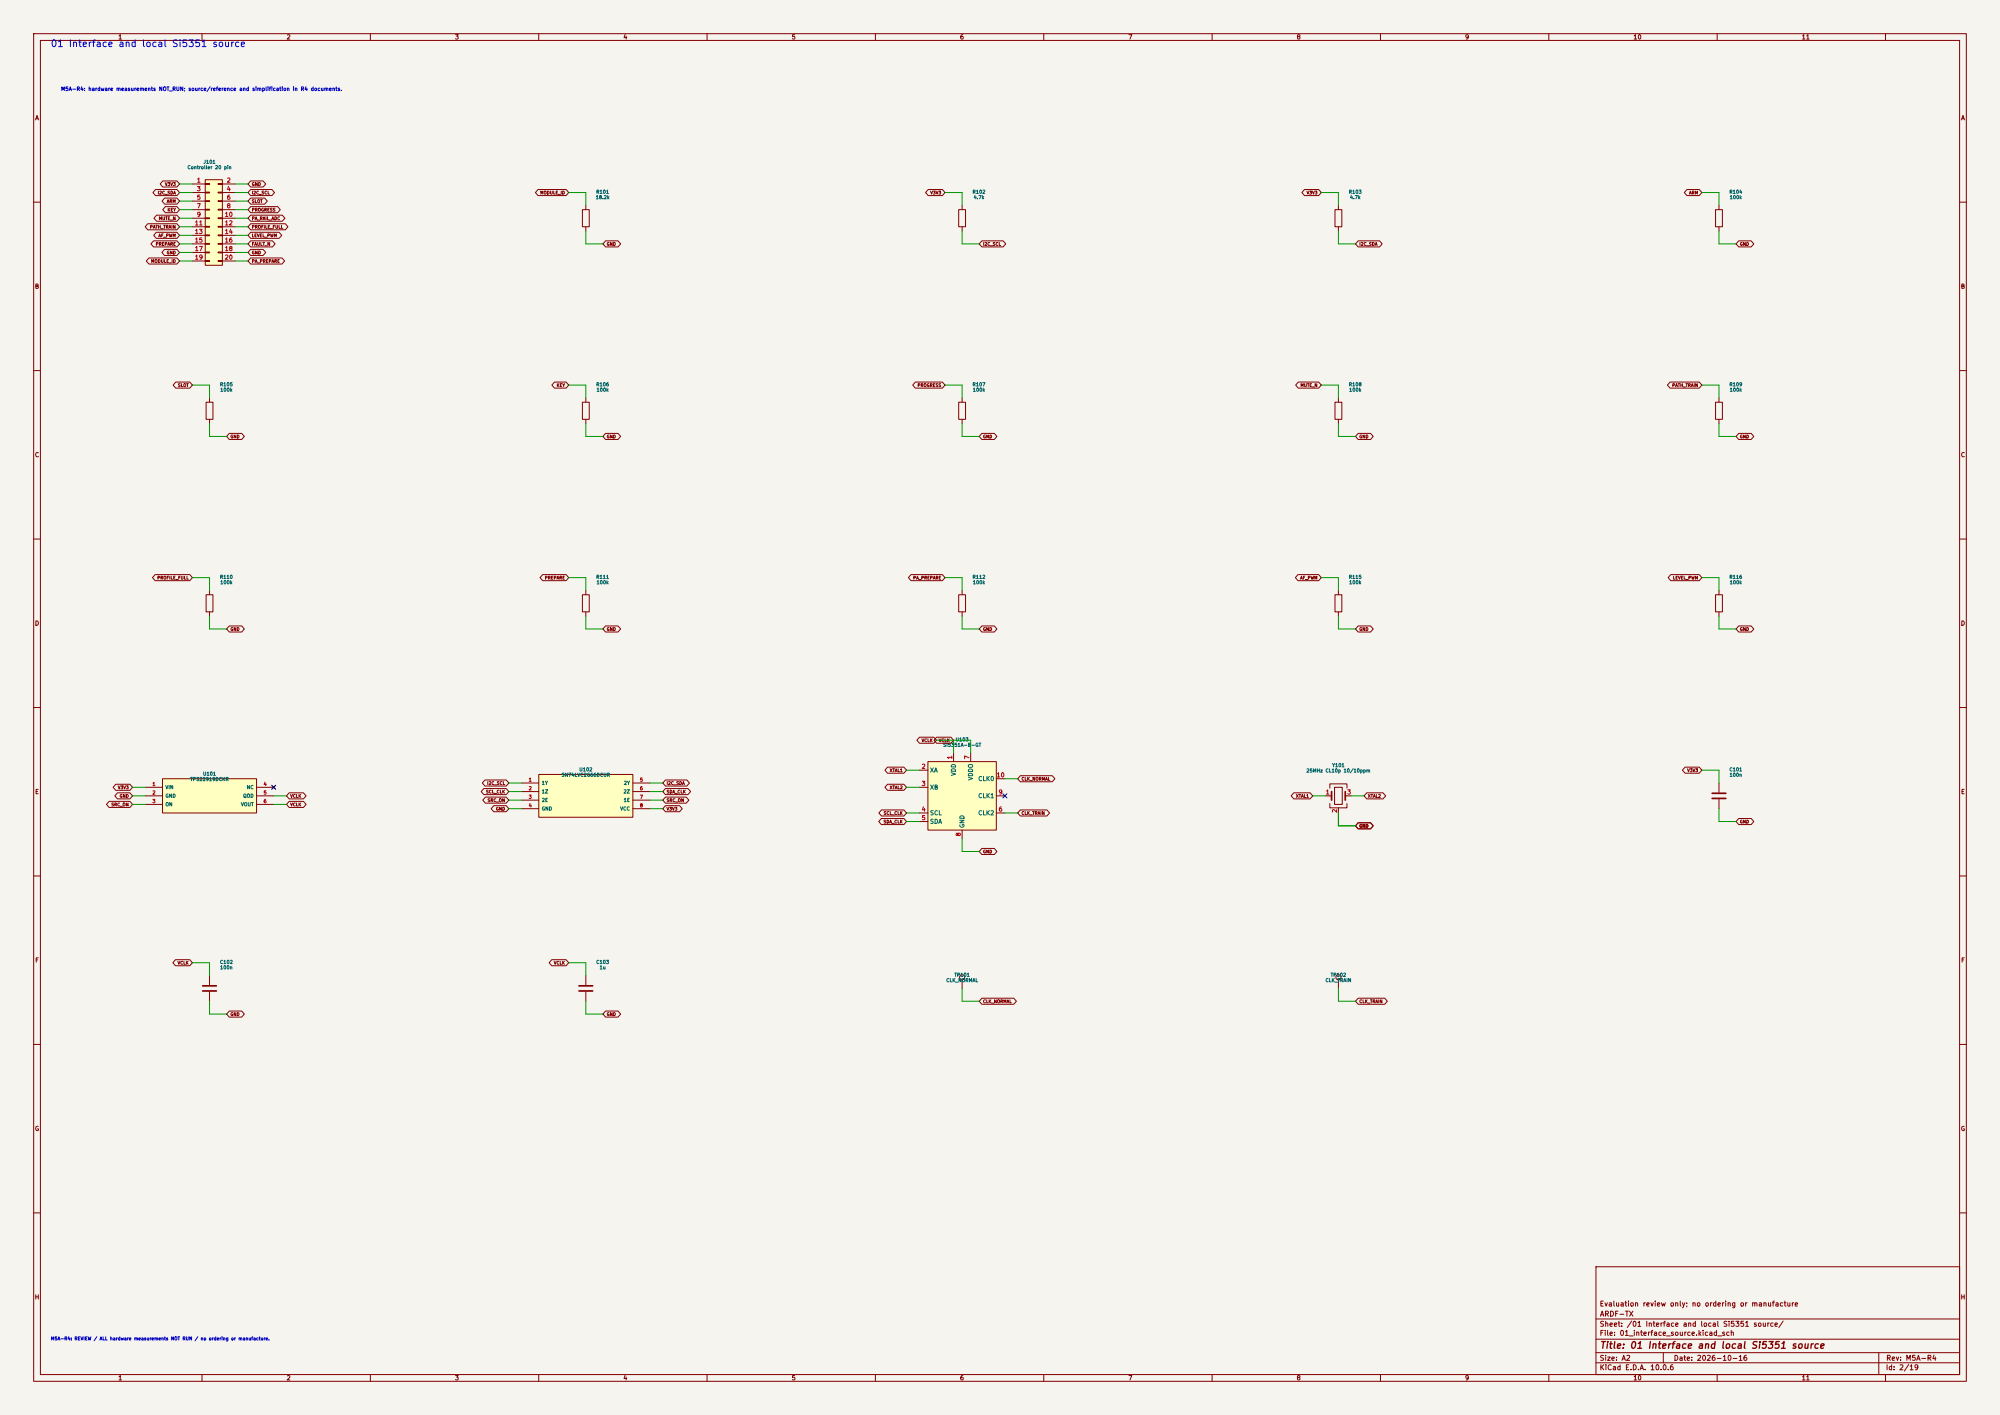
[picture p186: page 2]

SLOT 01 Interface and local Si5351 source

M5A-R4: hardware measurements NOT_RUN; source/reference and simplification in R4 documents.

Evaluation review only; no ordering or manufacture
ARDF-TX
Sheet: /01 Interface and local Si5351 source/
File: 01_interface_source.kicad_sch
Title: 01 Interface and local Si5351 source

M5A-R4: REVIEW / ALL hardware measurements NOT RUN / no ordering or manufacture.

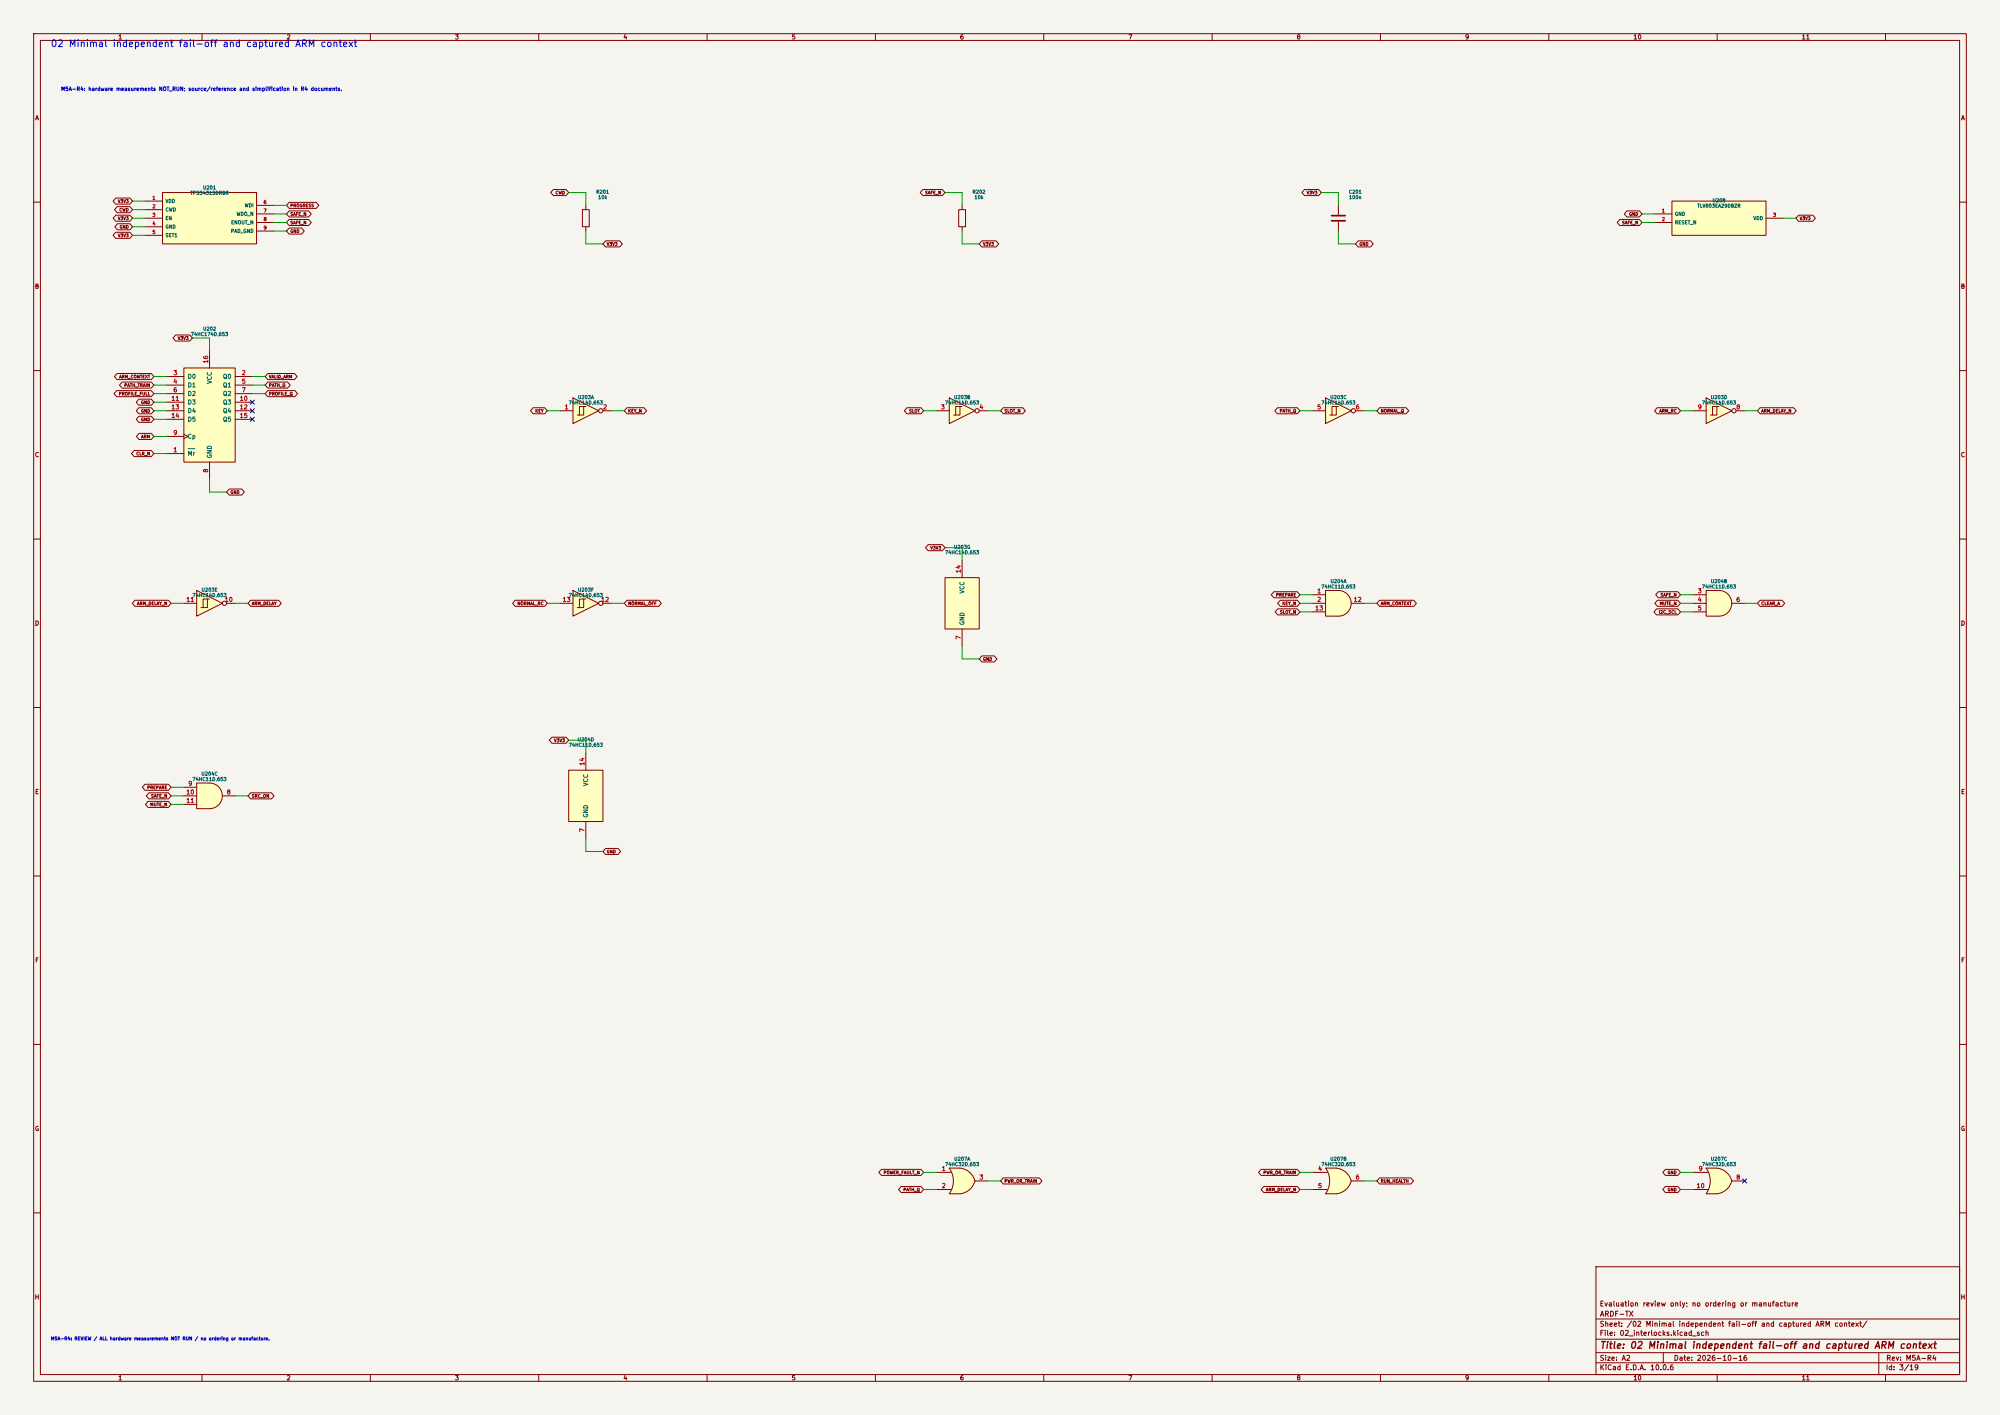
[picture p187: page 3]

02 Minimal independent fail-off and captured ARM context

Sheet: /02 Minimal independent fail-off and captured ARM context/
File: 02_interlocks.kicad_sch
Title: 02 Minimal independent fail-off and captured ARM context

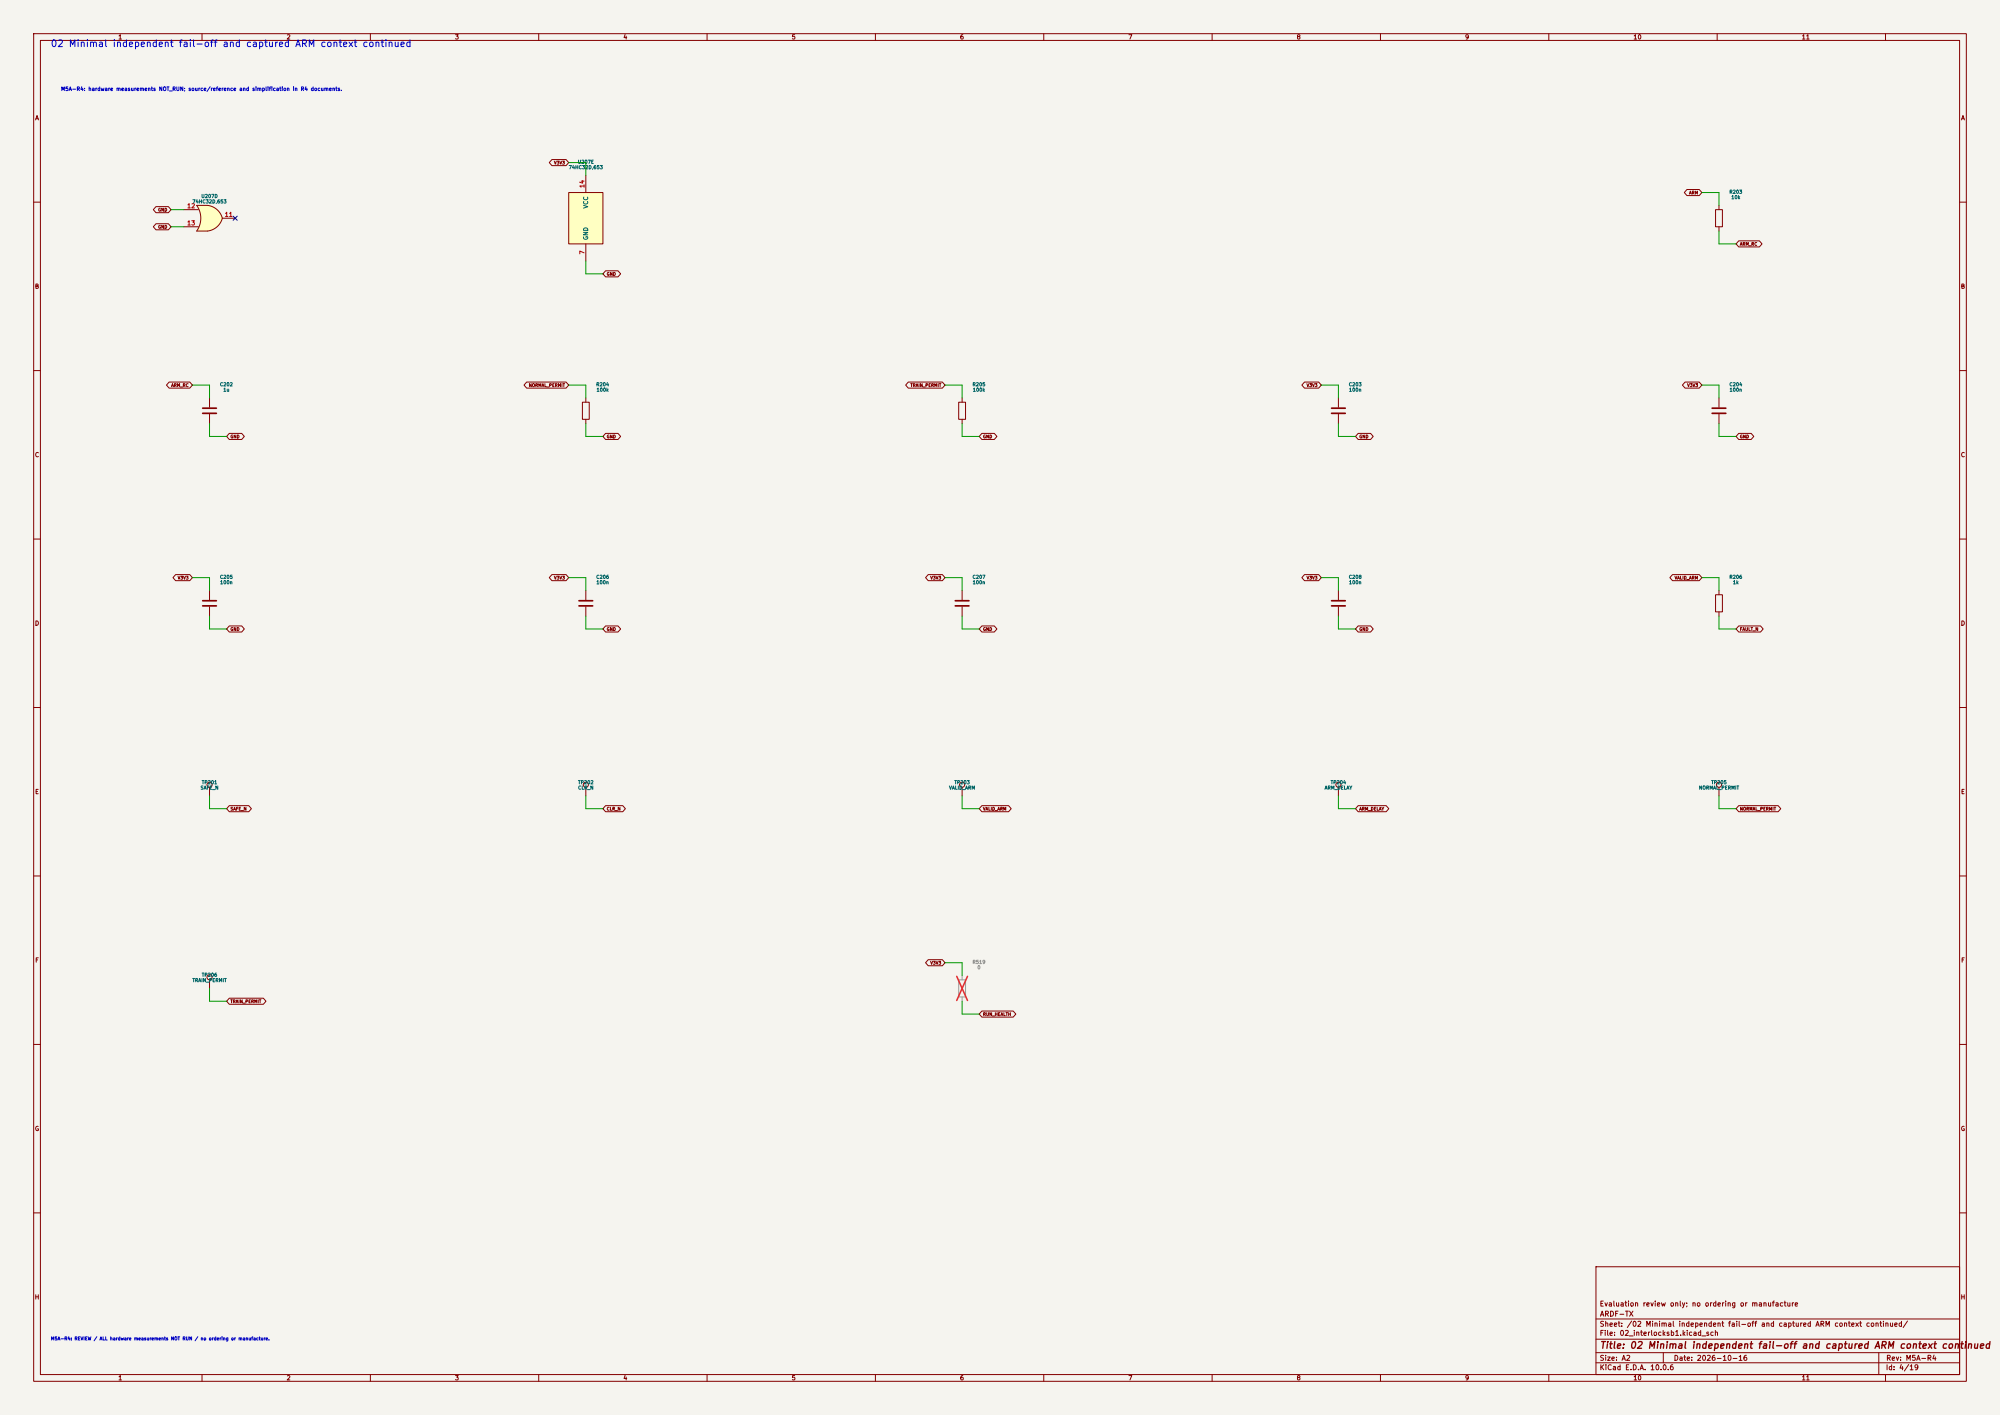
[picture p188: page 4]

02 Minimal independent fail-off and captured ARM context continued

Sheet: /02 Minimal independent fail-off and captured ARM context continued/
File: 02_interlocksb1.kicad_sch
Title: 02 Minimal independent fail-off and captured ARM context continued

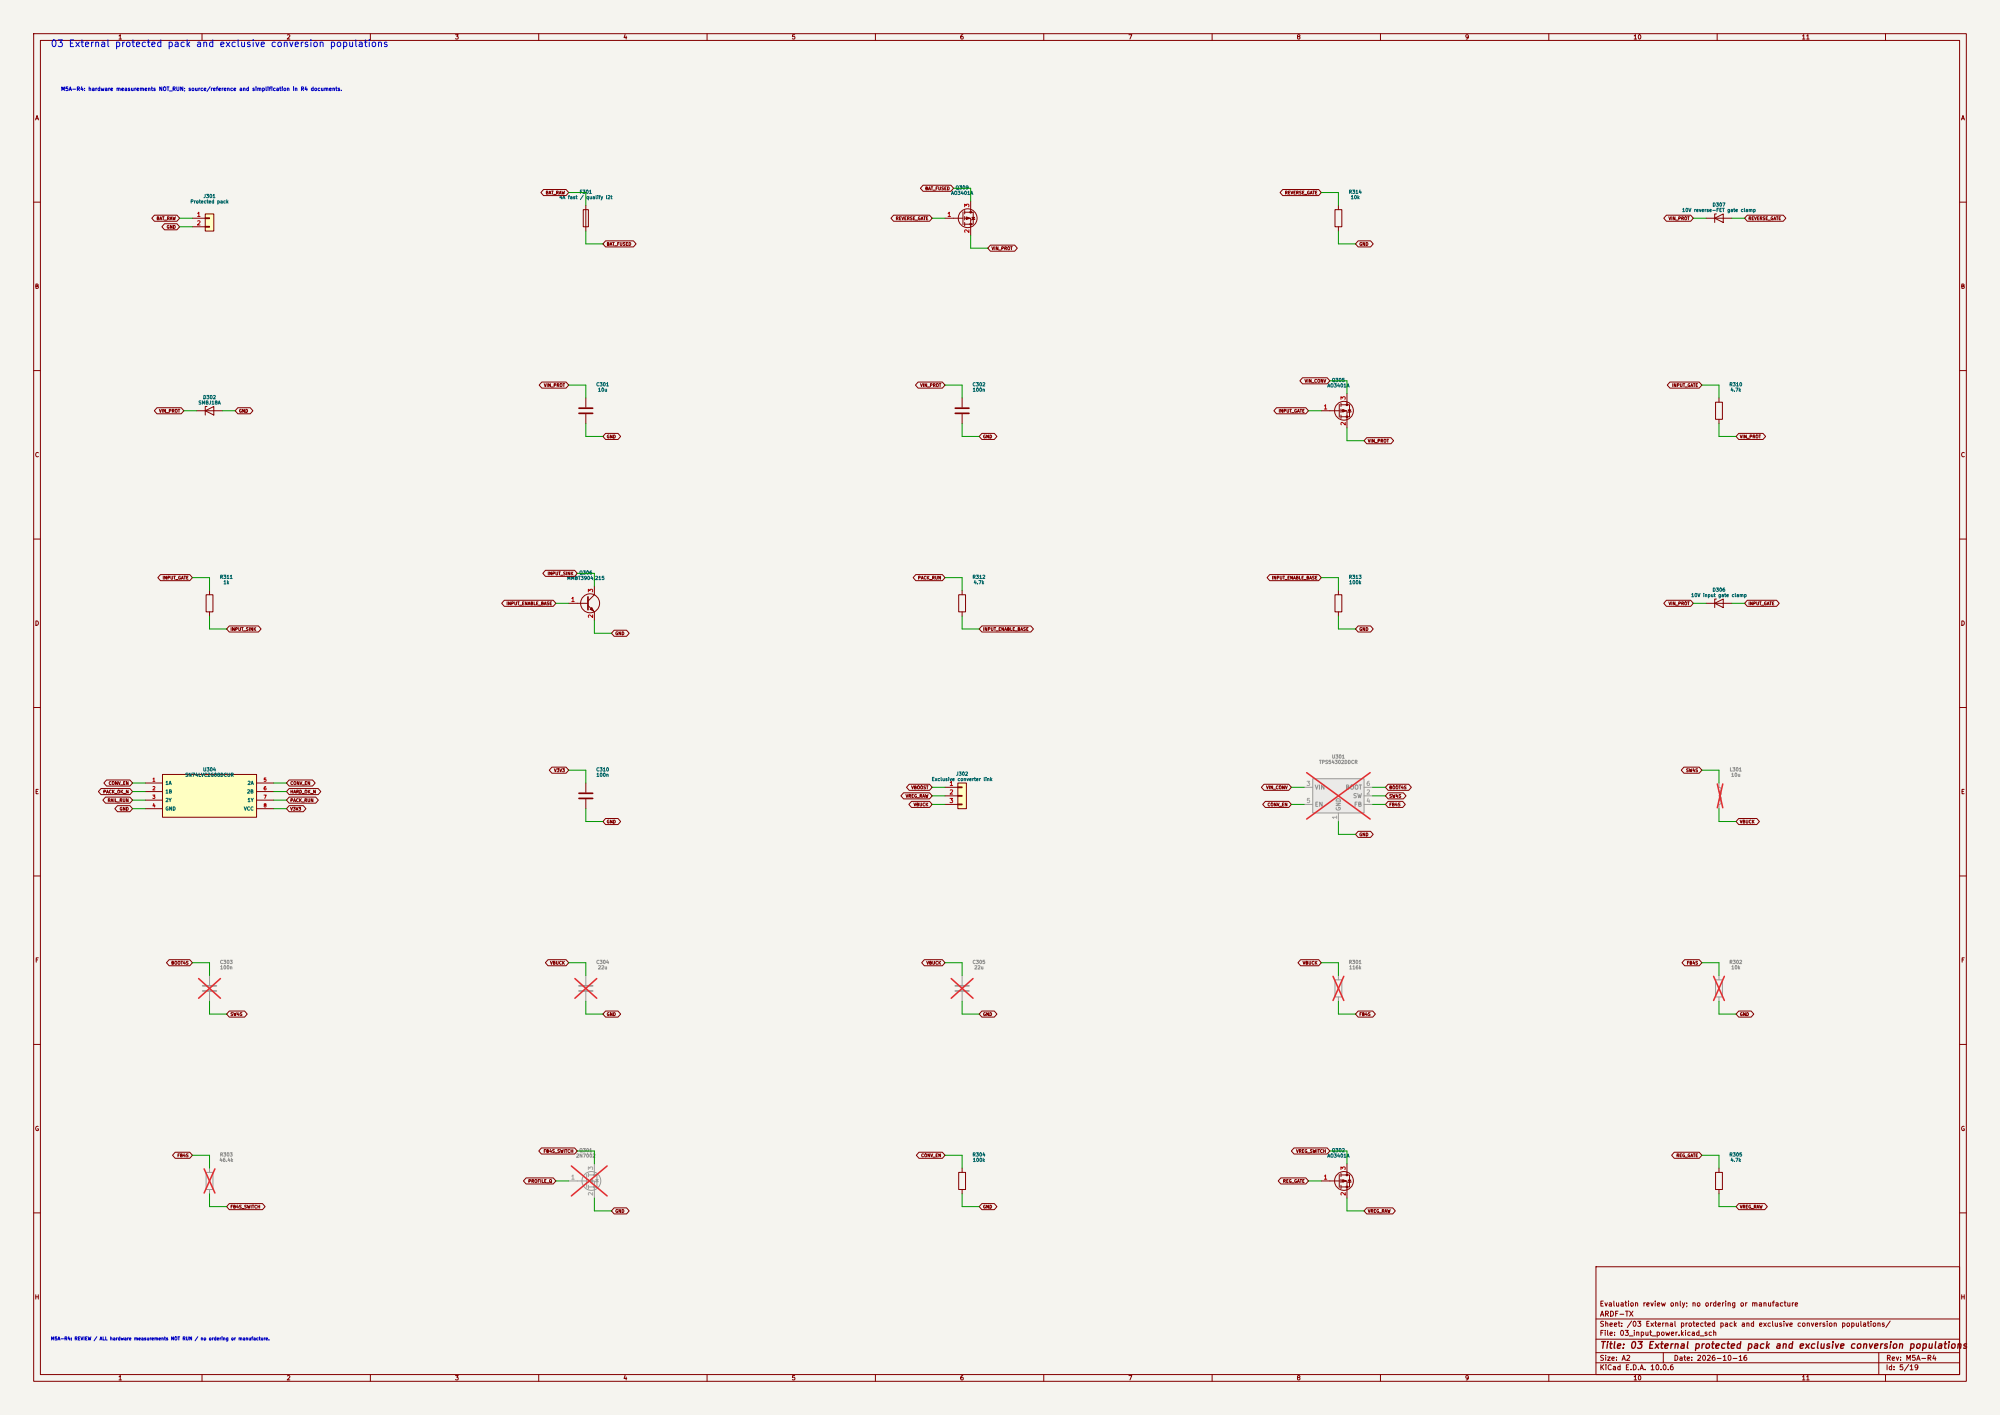
[picture p189: page 5]

BAT_RAW 03 External protected pack and exclusive conversion populations

10V reverse-FET gate clamp

Sheet: /03 External protected pack and exclusive conversion populations/
File: 03_input_power.kicad_sch
Title: 03 External protected pack and exclusive conversion populations

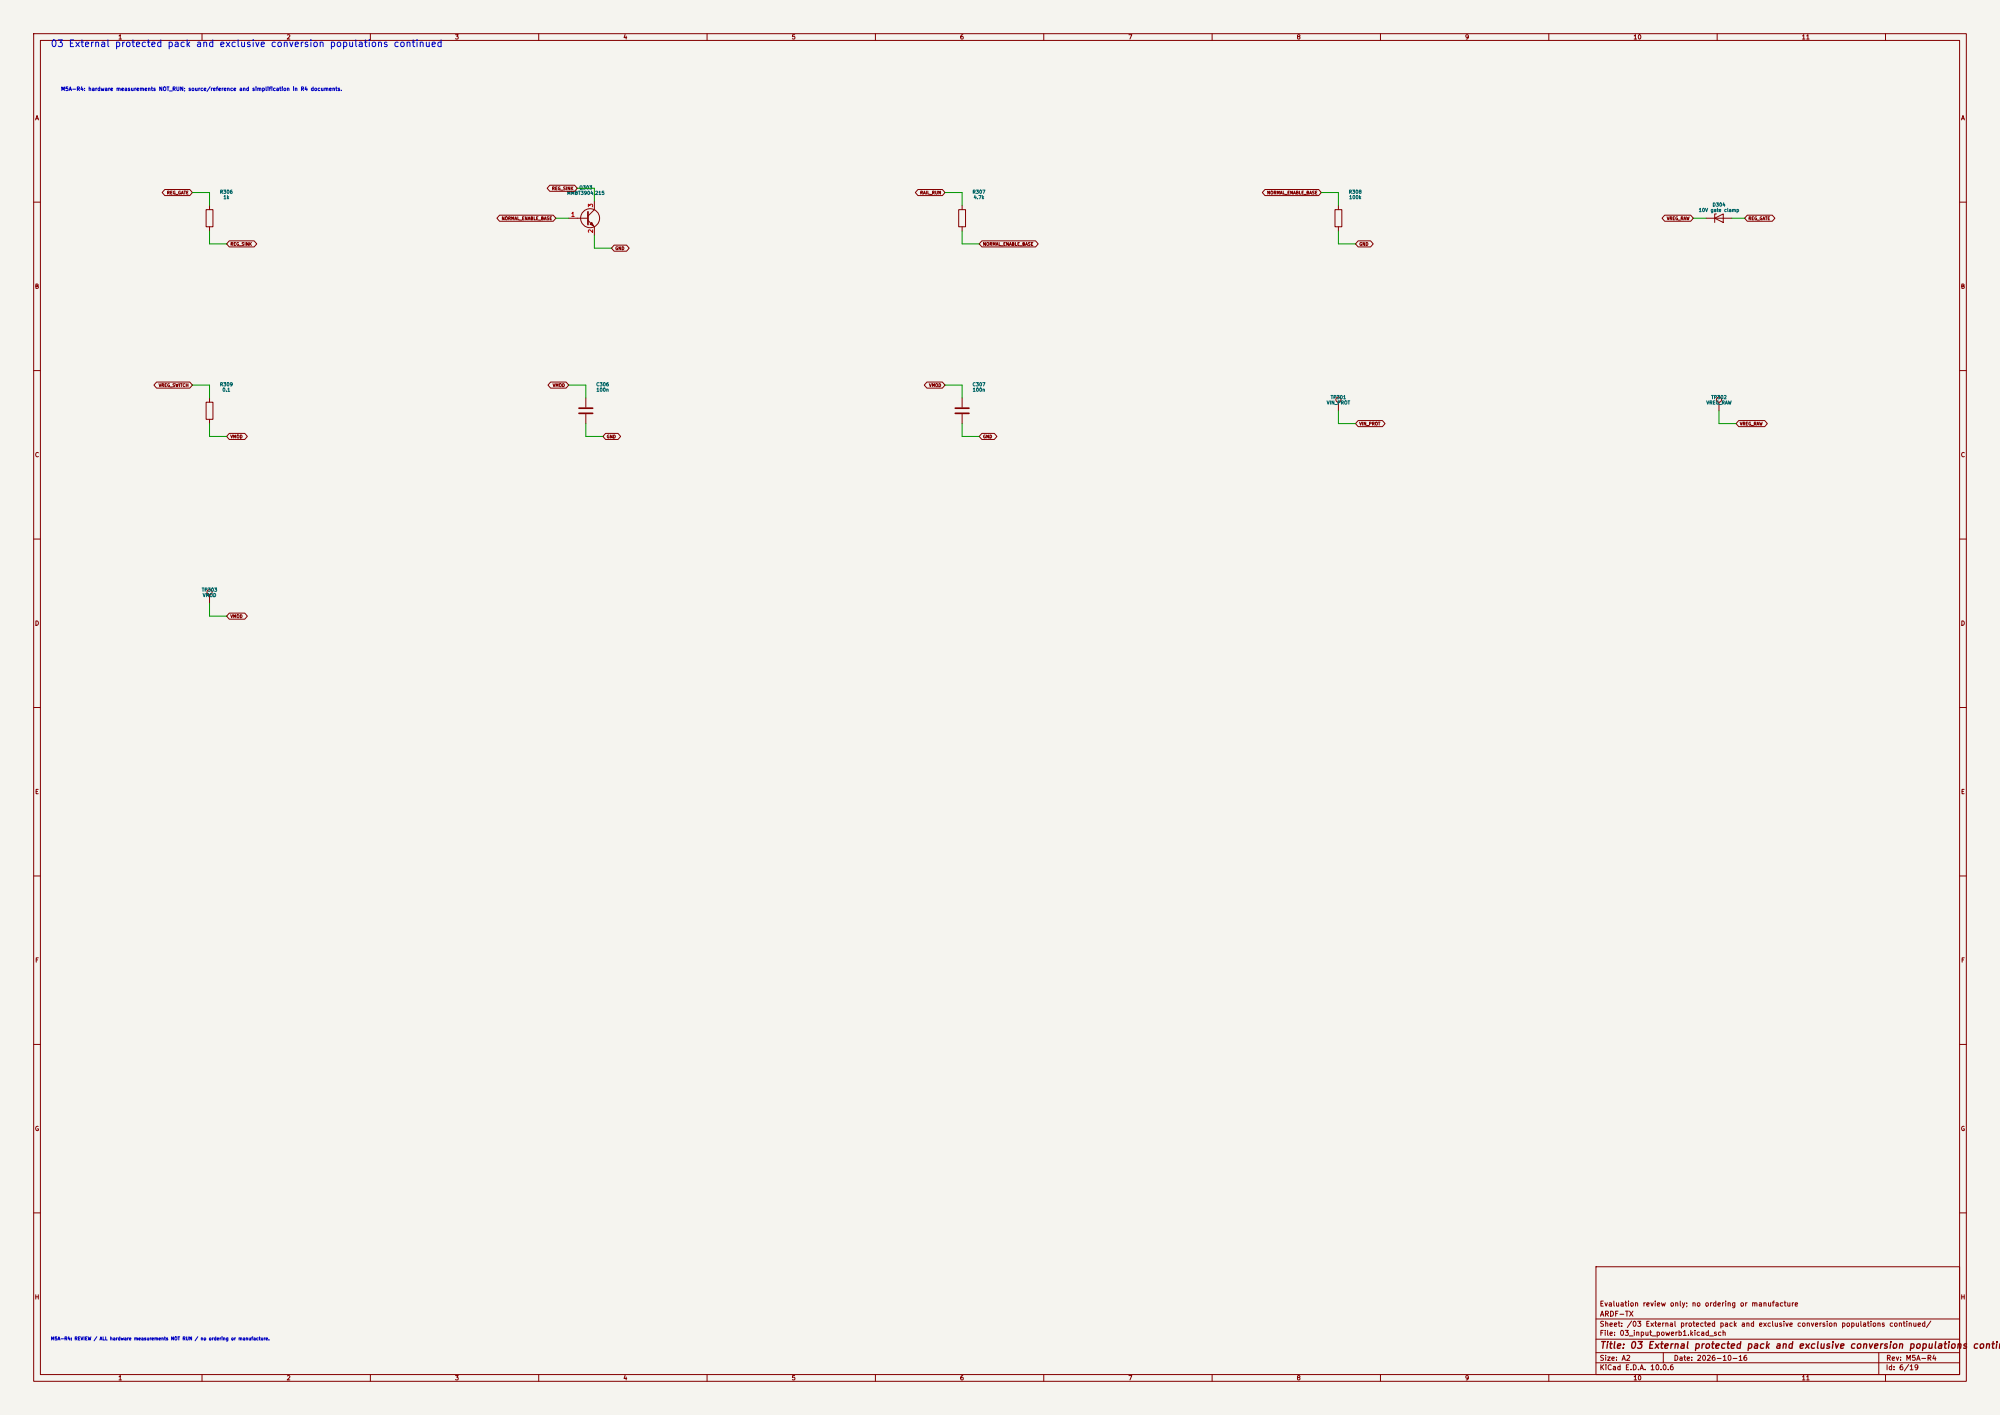
[picture p190: page 6]

GND 03 External protected pack and exclusive conversion populations continued

Sheet: /03 External protected pack and exclusive conversion populations continued/
File: 03_input_powerb1.kicad_sch
Title: 03 External protected pack and exclusive conversion populations continued

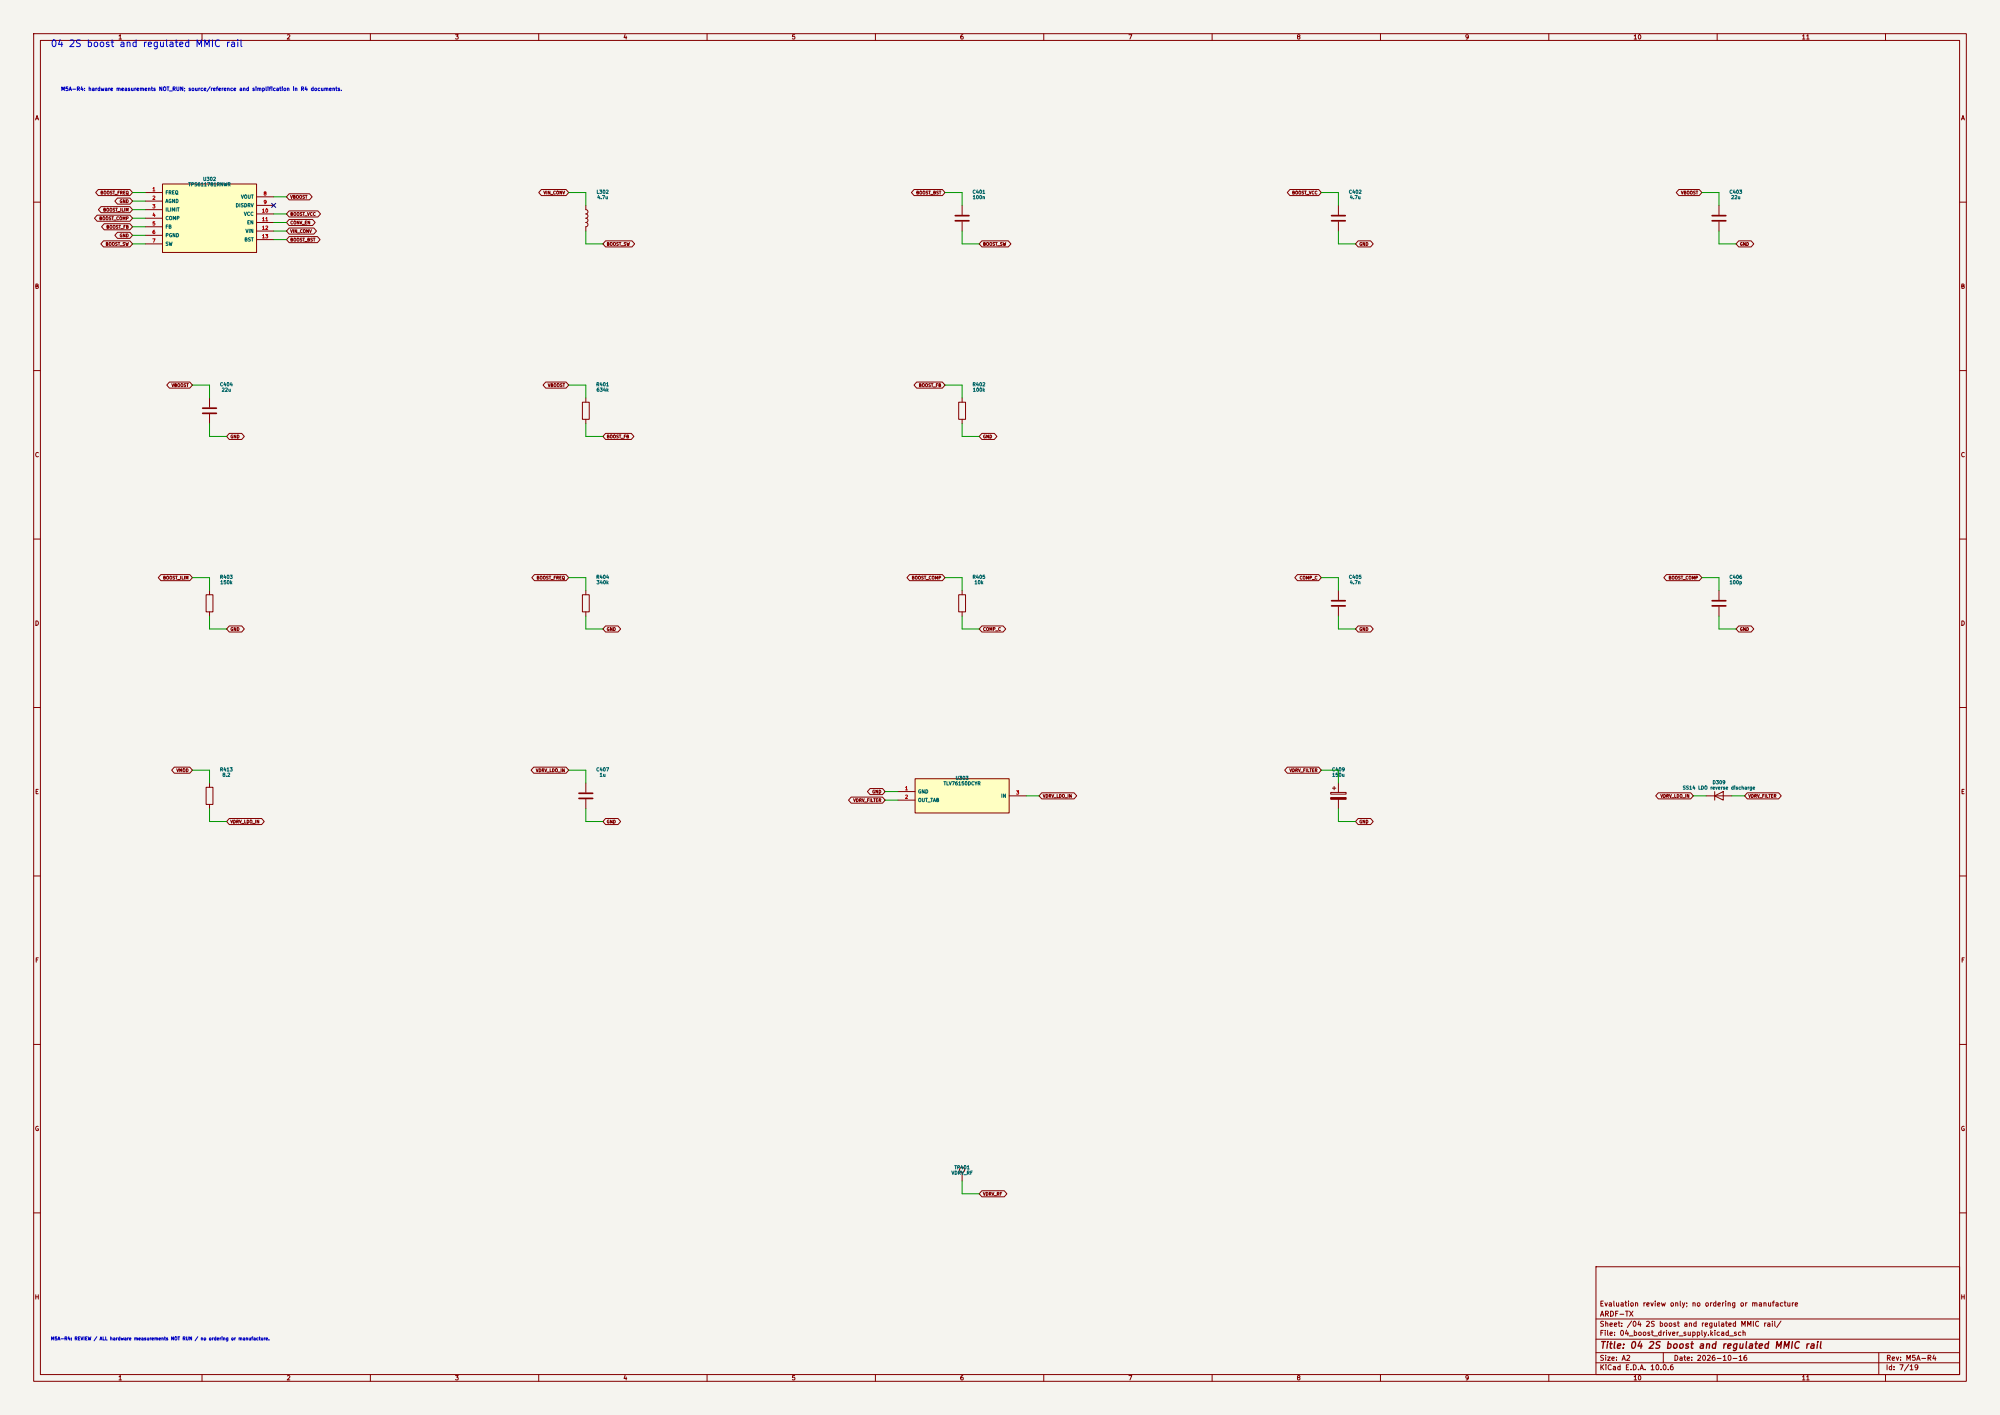
[picture p191: page 7]

04 2S boost and regulated MMIC rail

Sheet: /04 2S boost and regulated MMIC rail/
File: 04_boost_driver_supply.kicad_sch
Title: 04 2S boost and regulated MMIC rail

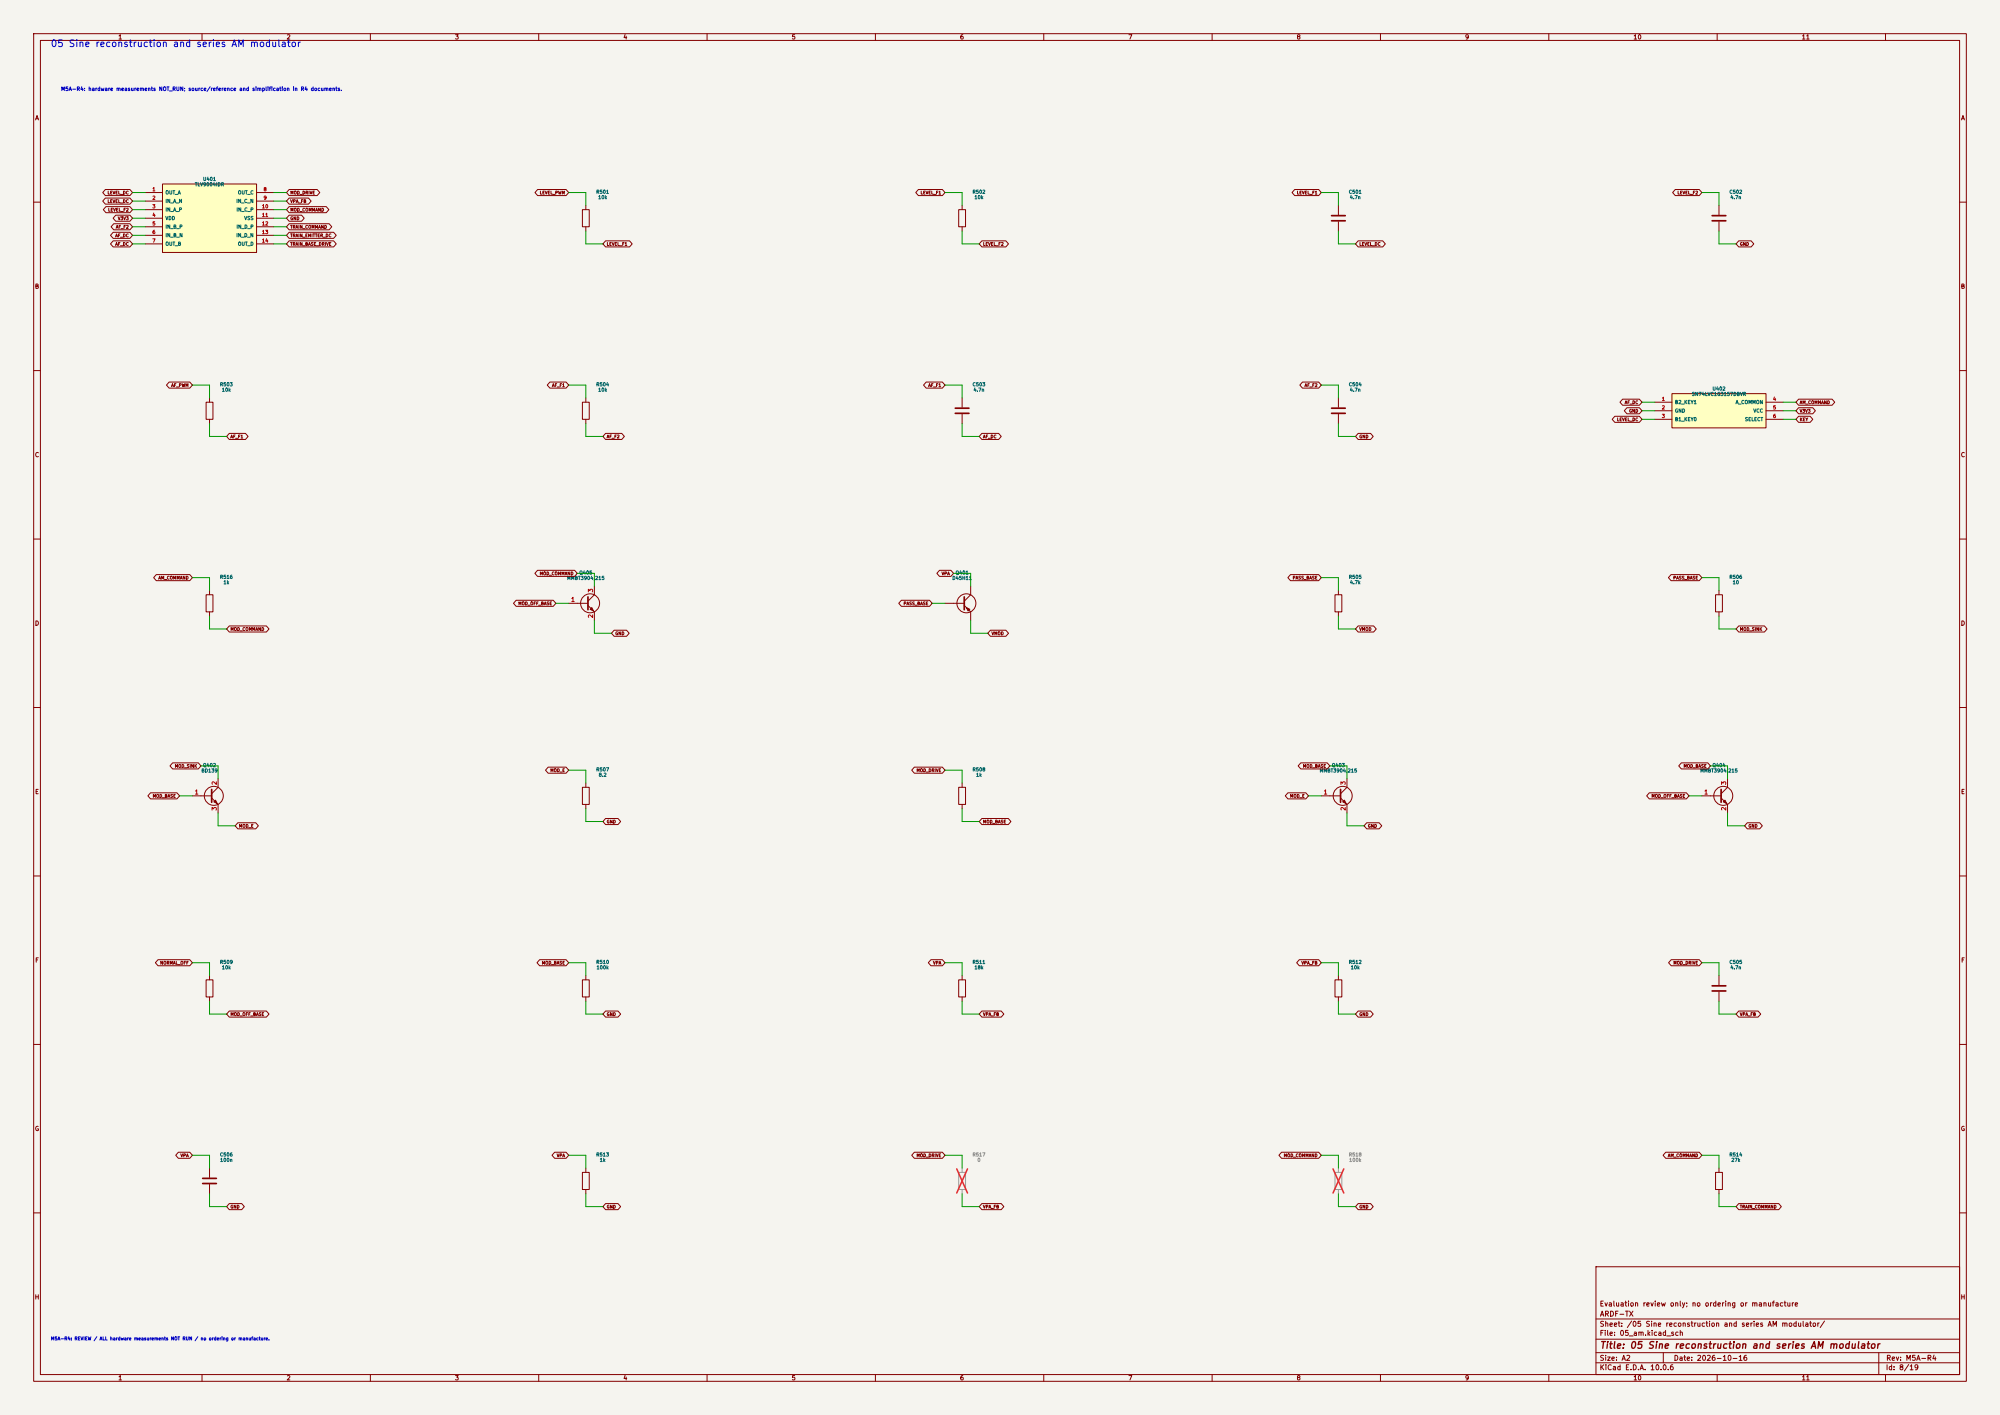
[picture p192: page 8]

05 Sine reconstruction and series AM modulator M5A-R4: hardware measurements NOT_RUN; source/reference and simplification in R4 documents.

Sheet: /05 Sine reconstruction and series AM modulator/
File: 05_am.kicad_sch
Title: 05 Sine reconstruction and series AM modulator

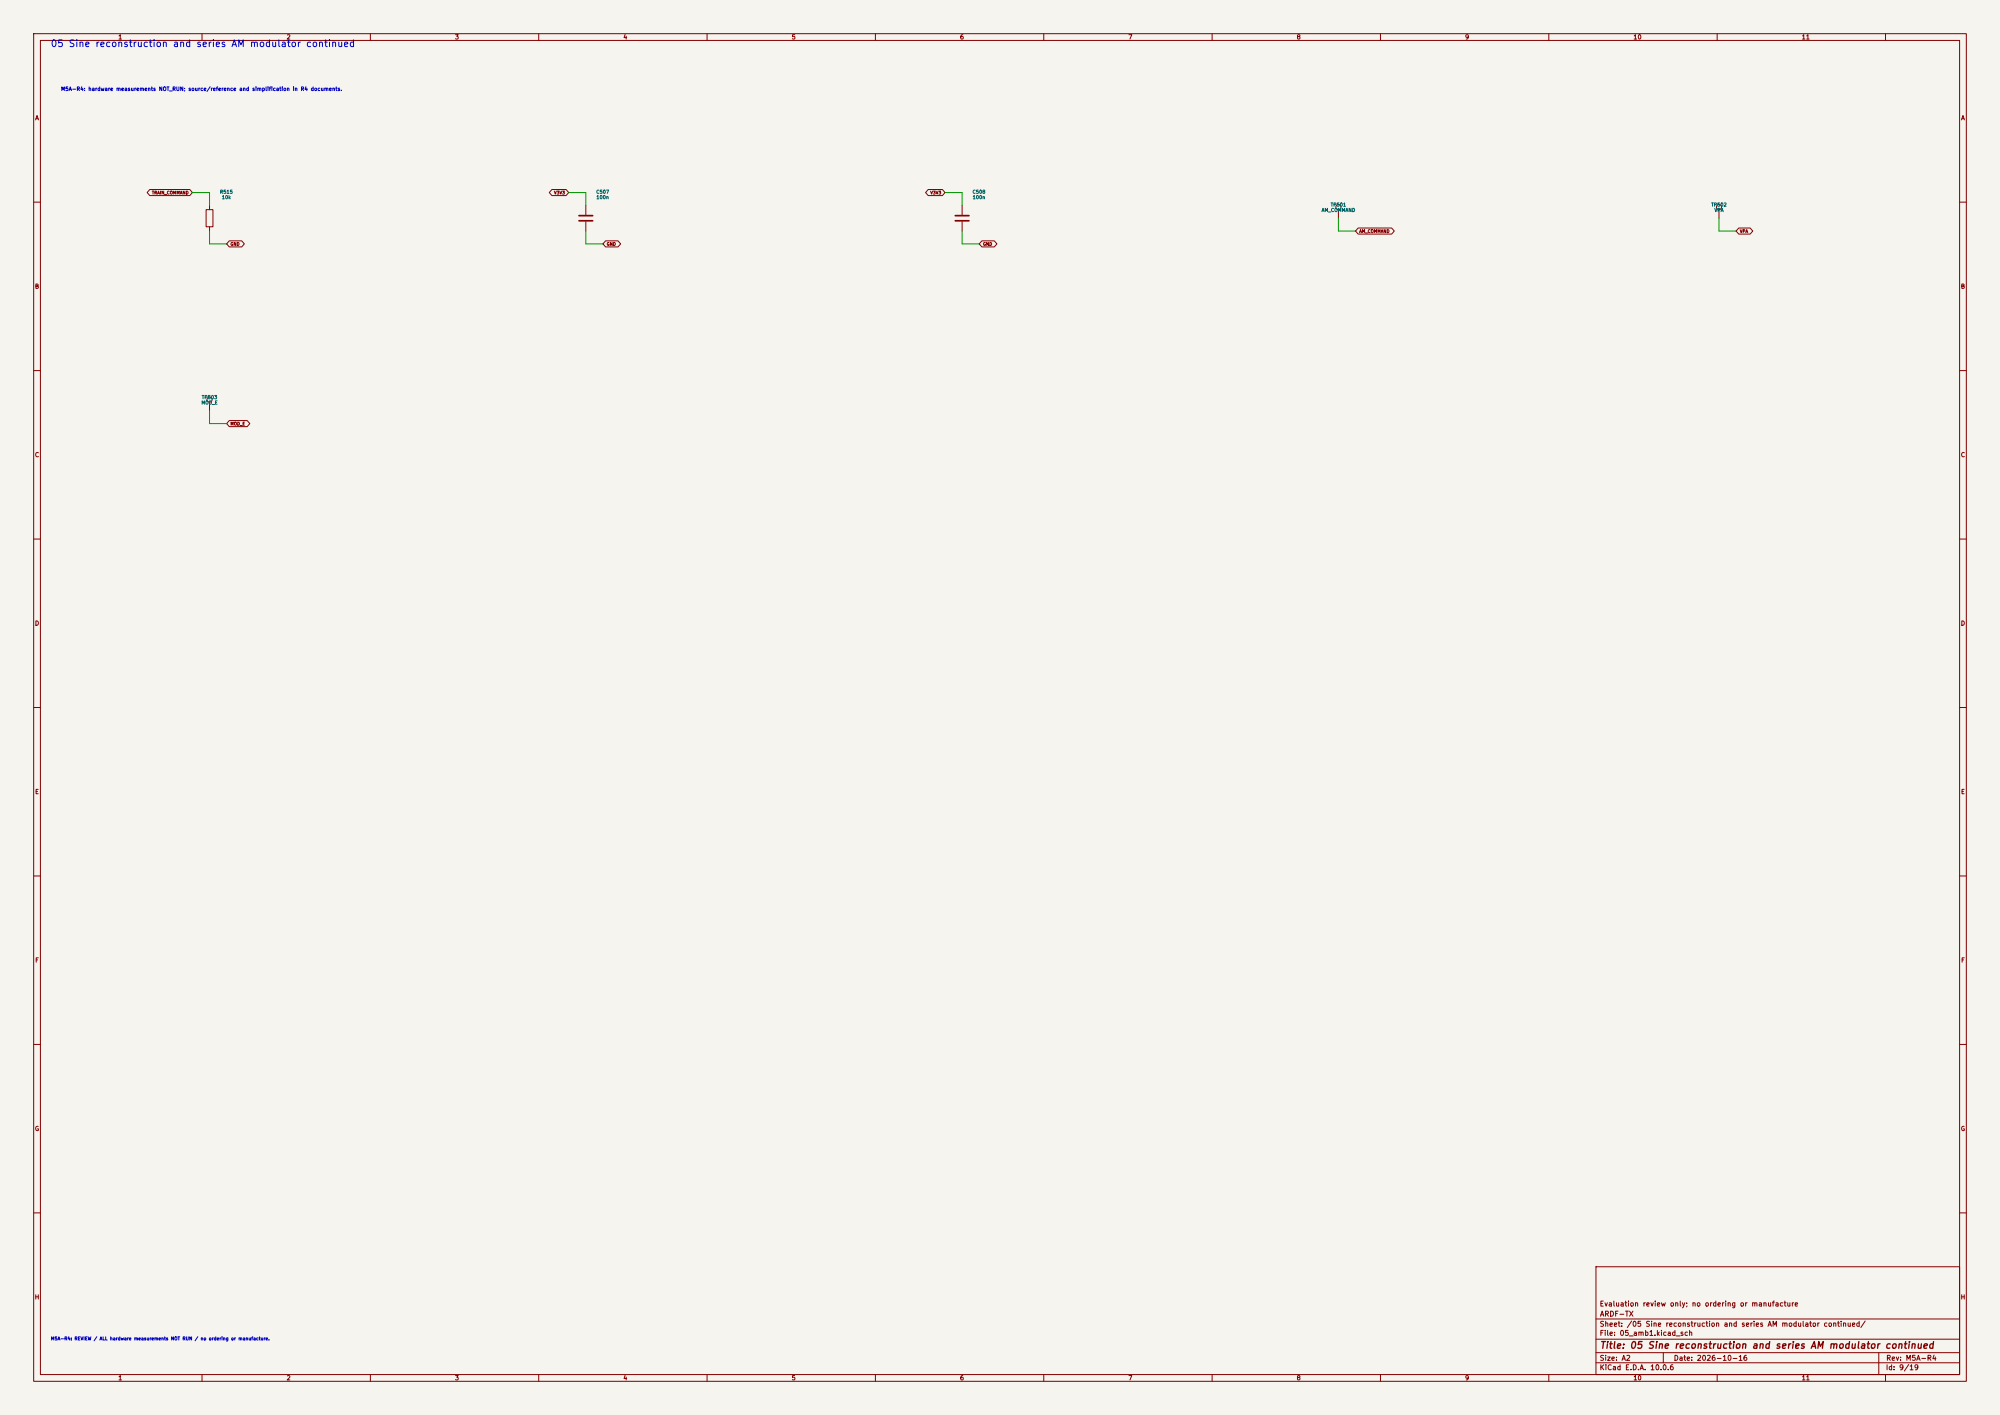
[picture p193: page 9]

Sheet: /05 Sine reconstruction and series AM modulator continued/
File: 05_amb1.kicad_sch
Title: 05 Sine reconstruction and series AM modulator continued

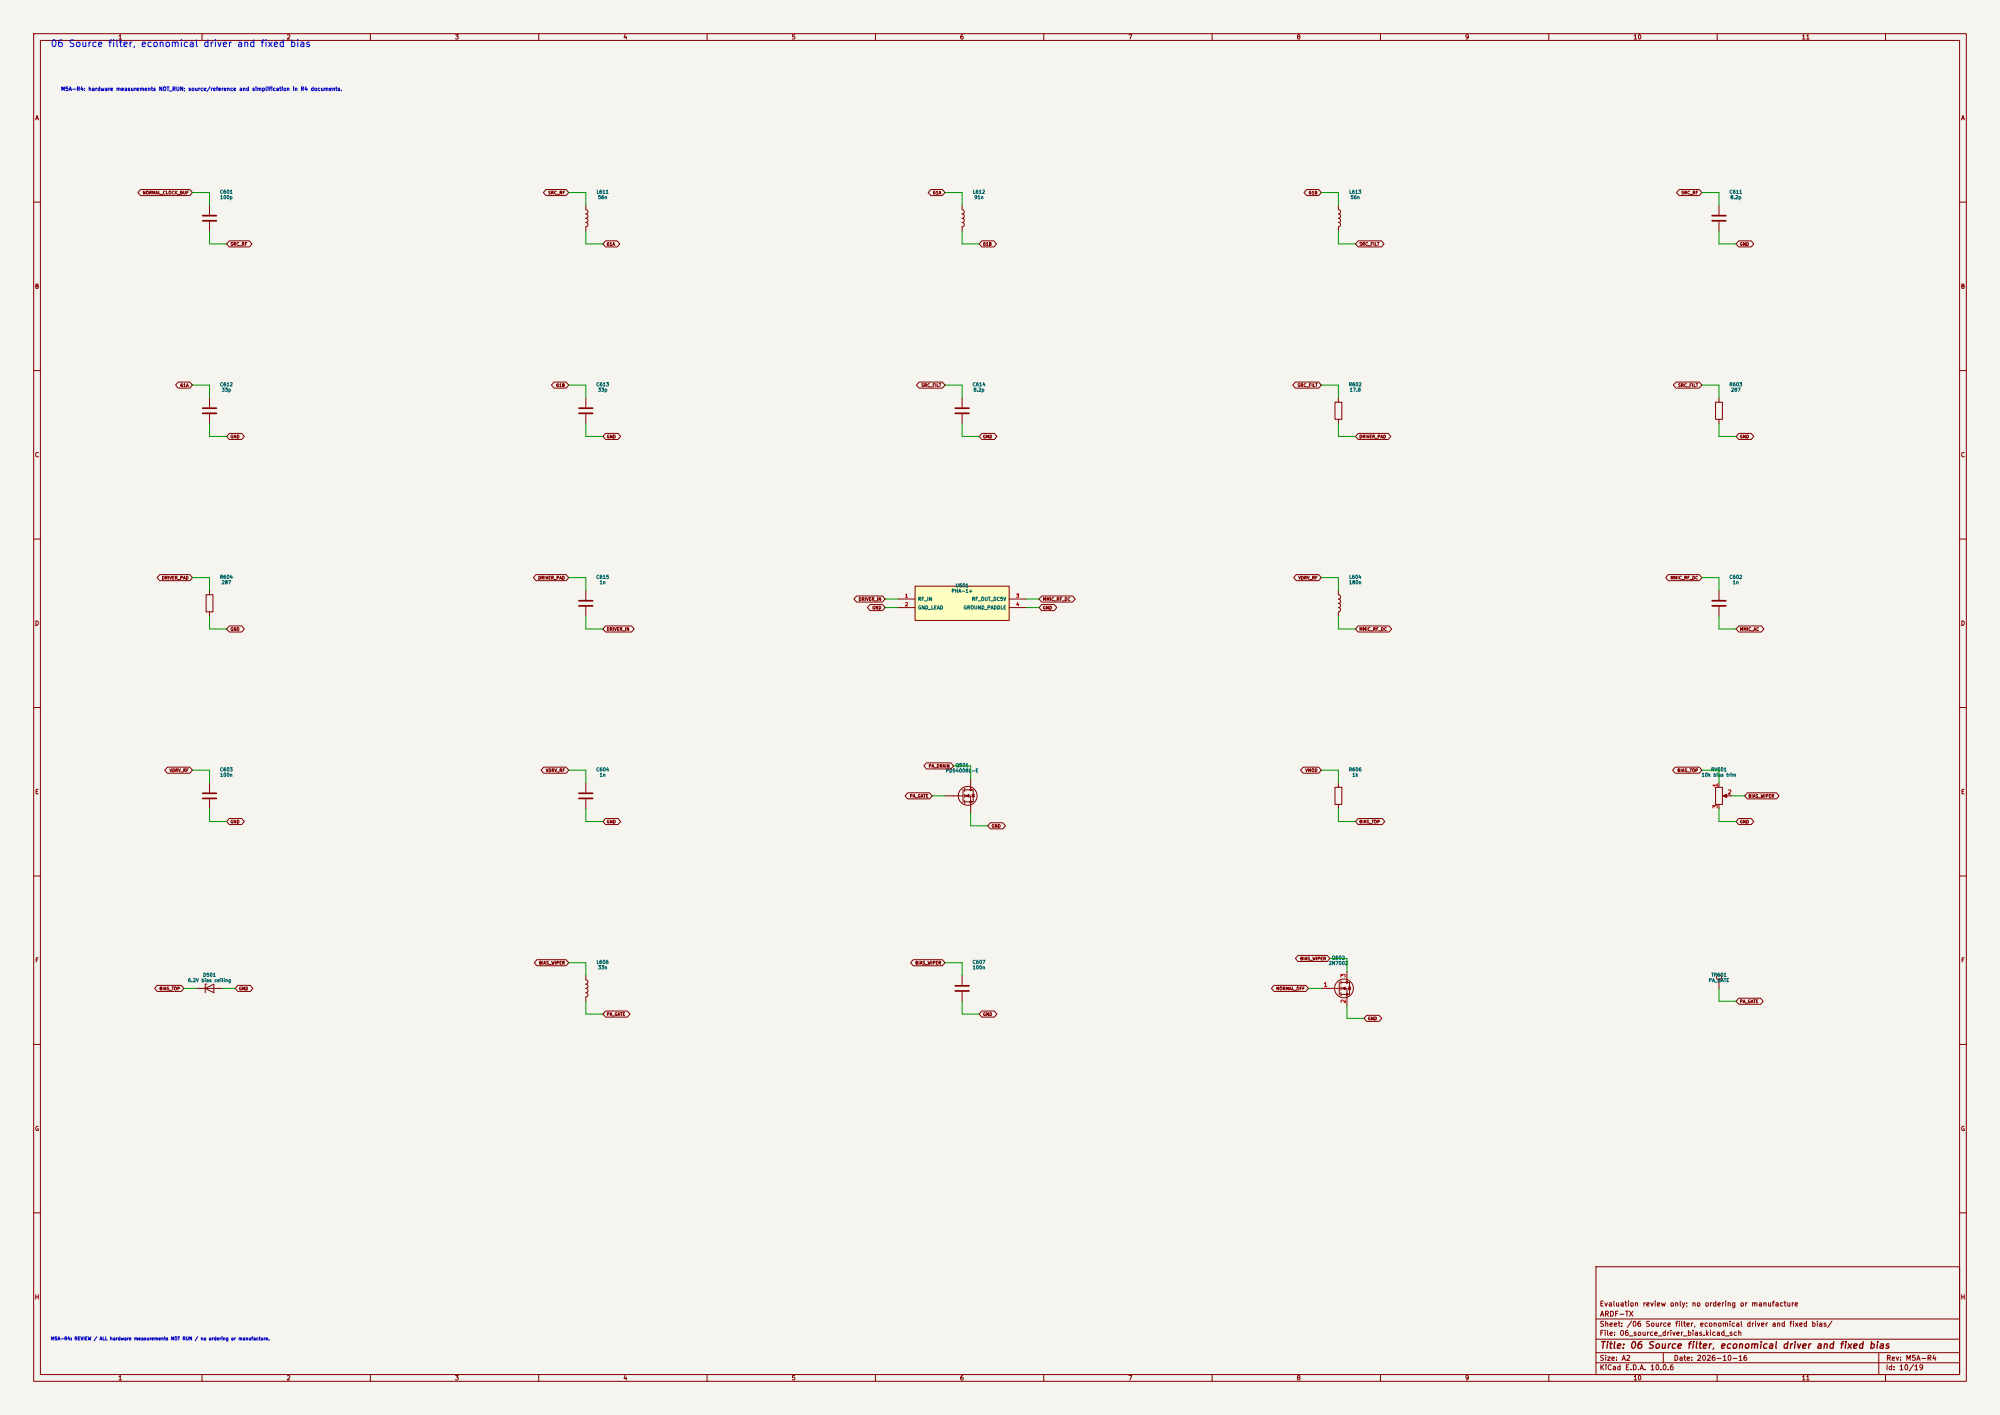
[picture p194: page 10]

06 Source filter, economical driver and fixed bias

Sheet: /06 Source filter, economical driver and fixed bias/
File: 06_source_driver_bias.kicad_sch
Title: 06 Source filter, economical driver and fixed bias

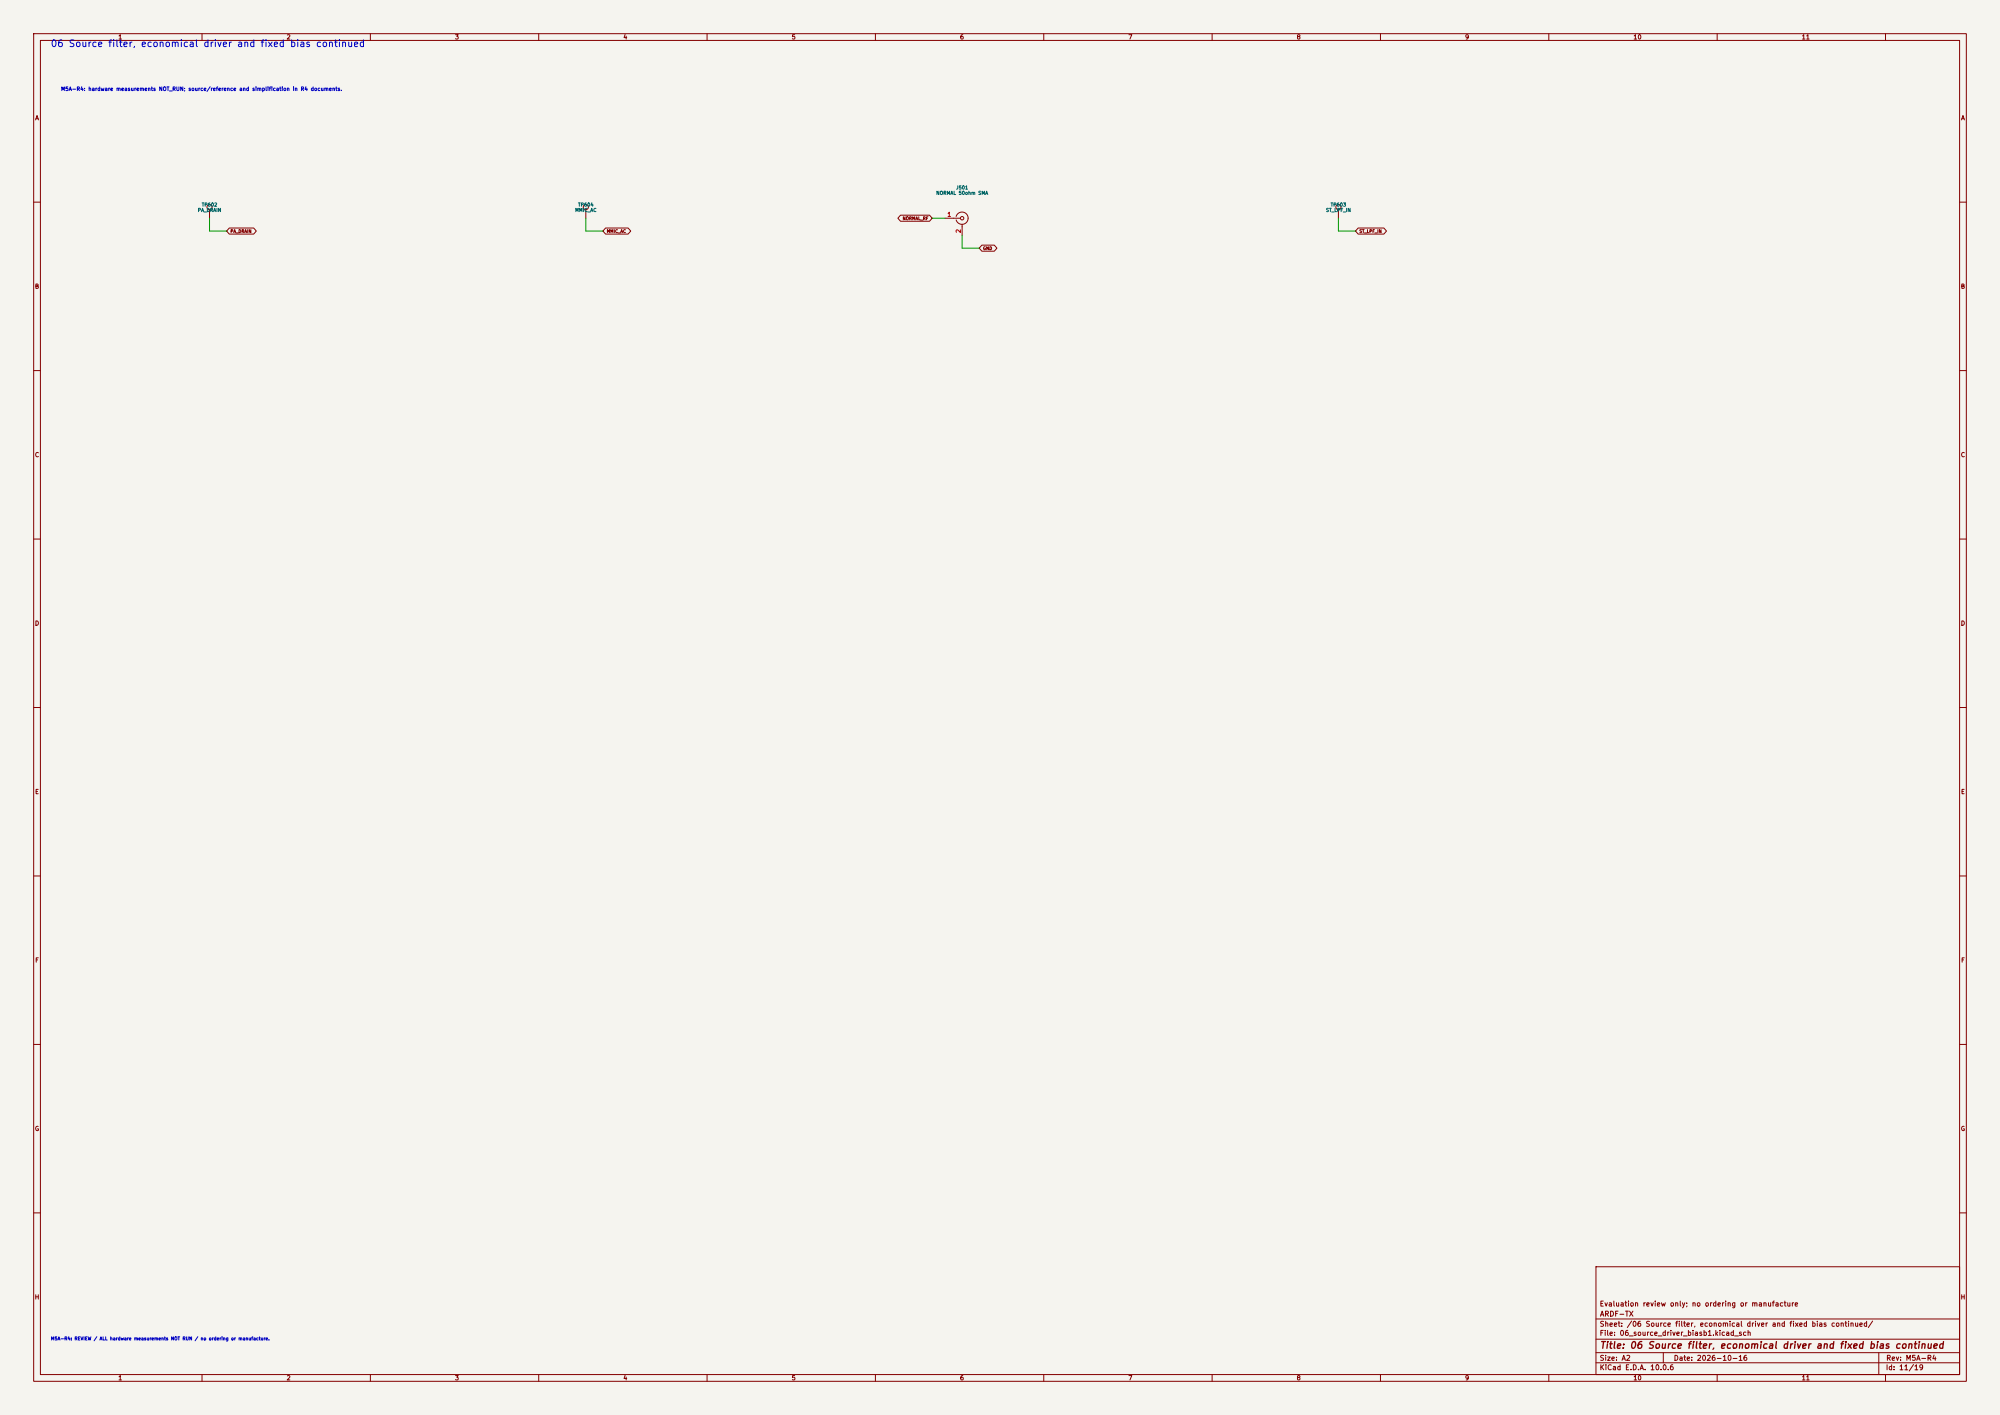
[picture p195: page 11]

GND NORMAL_RF 06 Source filter, economical driver and fixed bias continued

Sheet: /06 Source filter, economical driver and fixed bias continued/
File: 06_source_driver_biasb1.kicad_sch
Title: 06 Source filter, economical driver and fixed bias continued

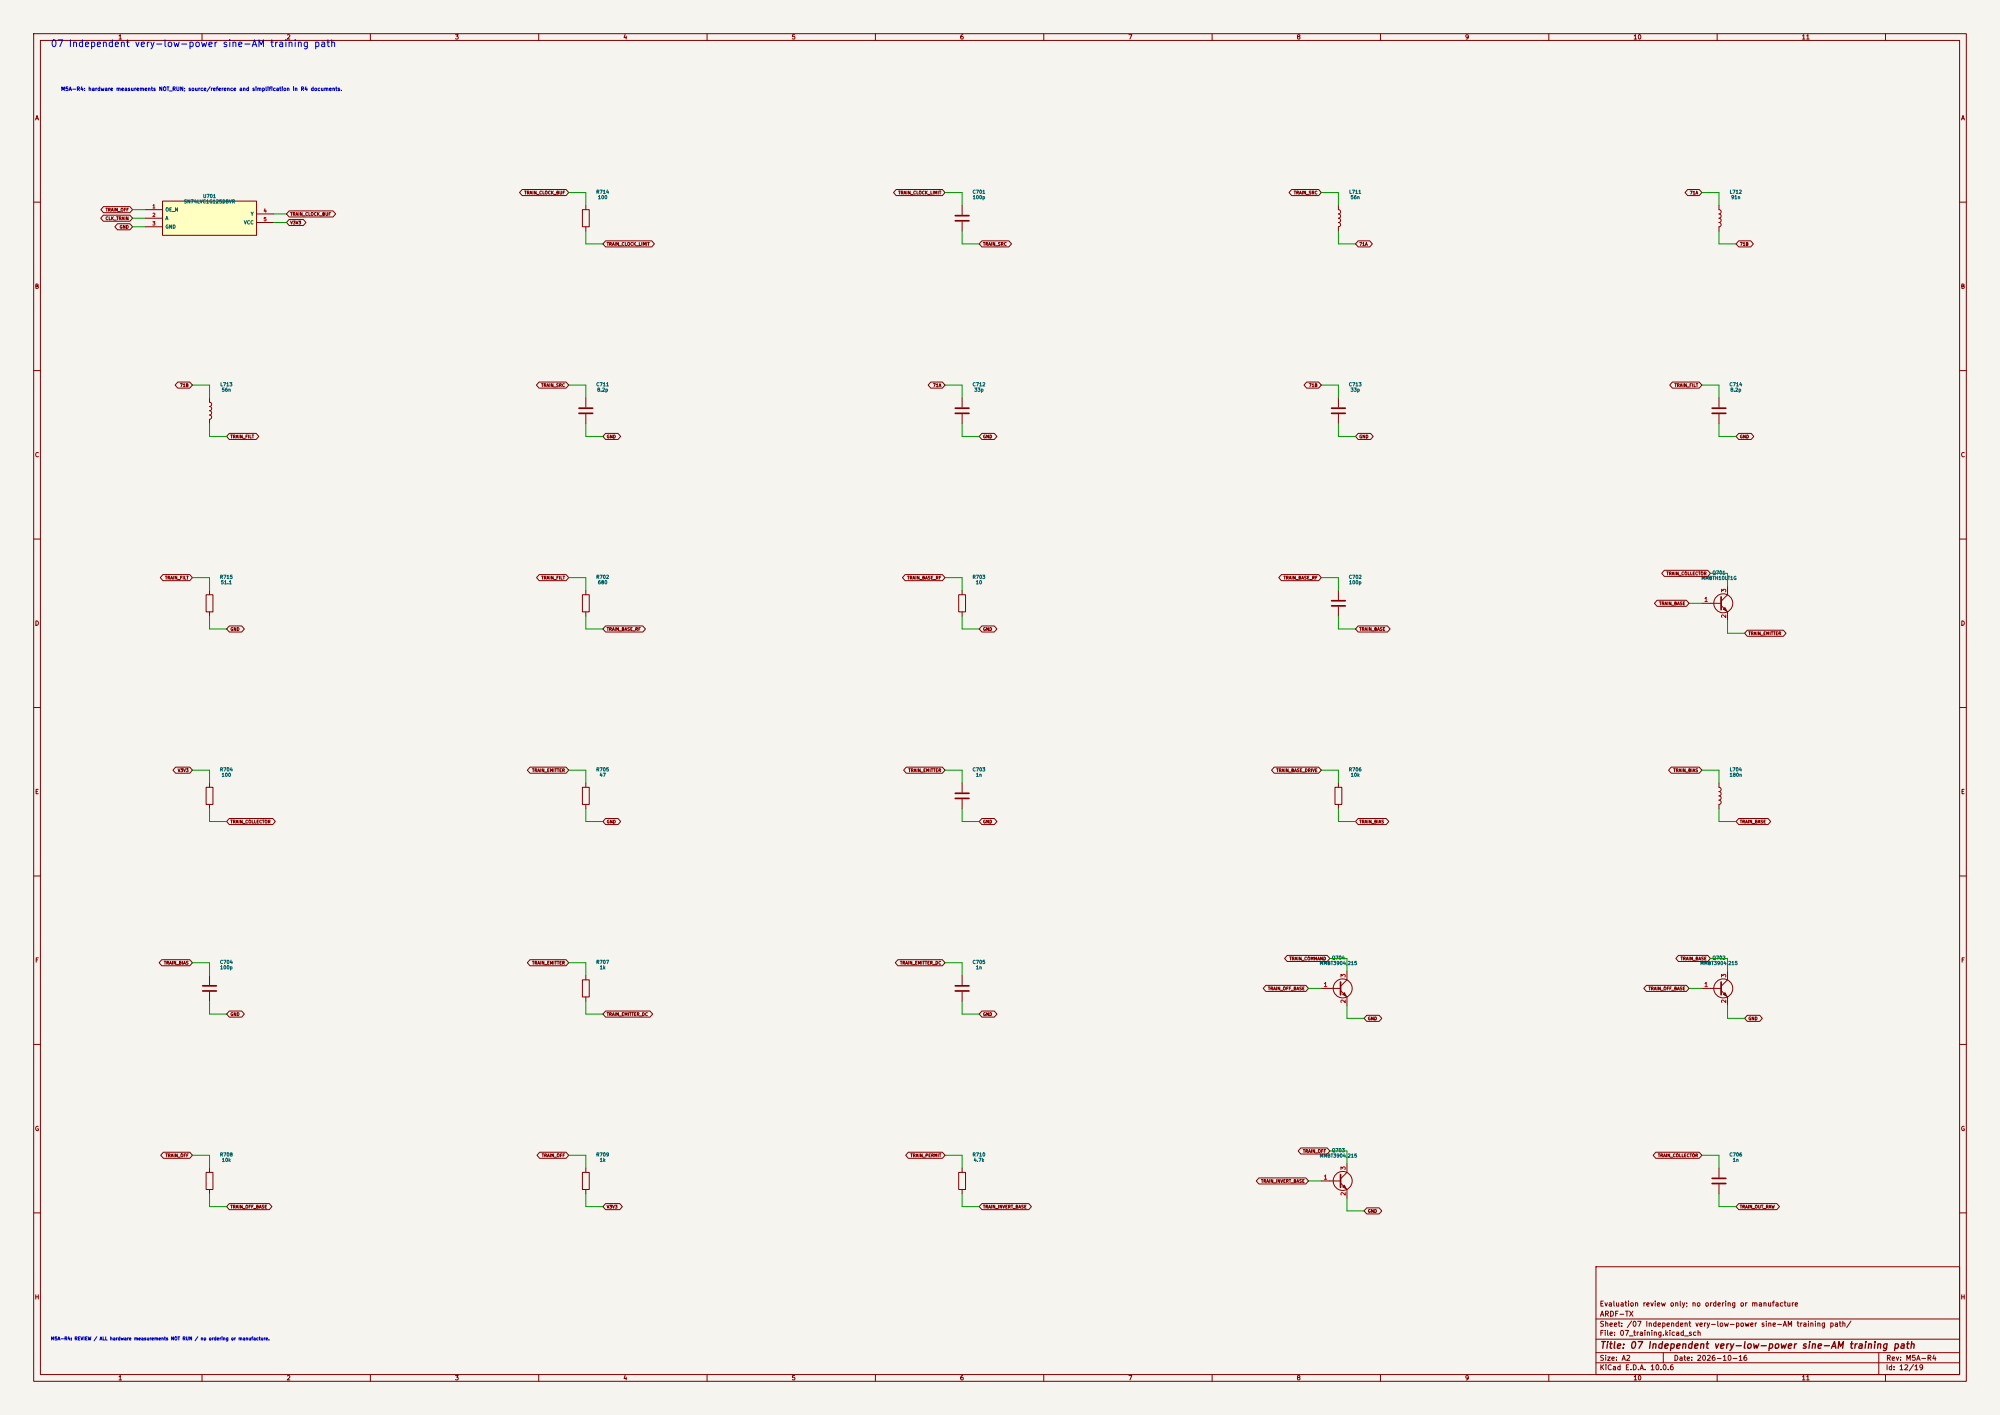
[picture p196: page 12]

07 Independent very-low-power sine-AM training path

Sheet: /07 Independent very-low-power sine-AM training path/
File: 07_training.kicad_sch
Title: 07 Independent very-low-power sine-AM training path

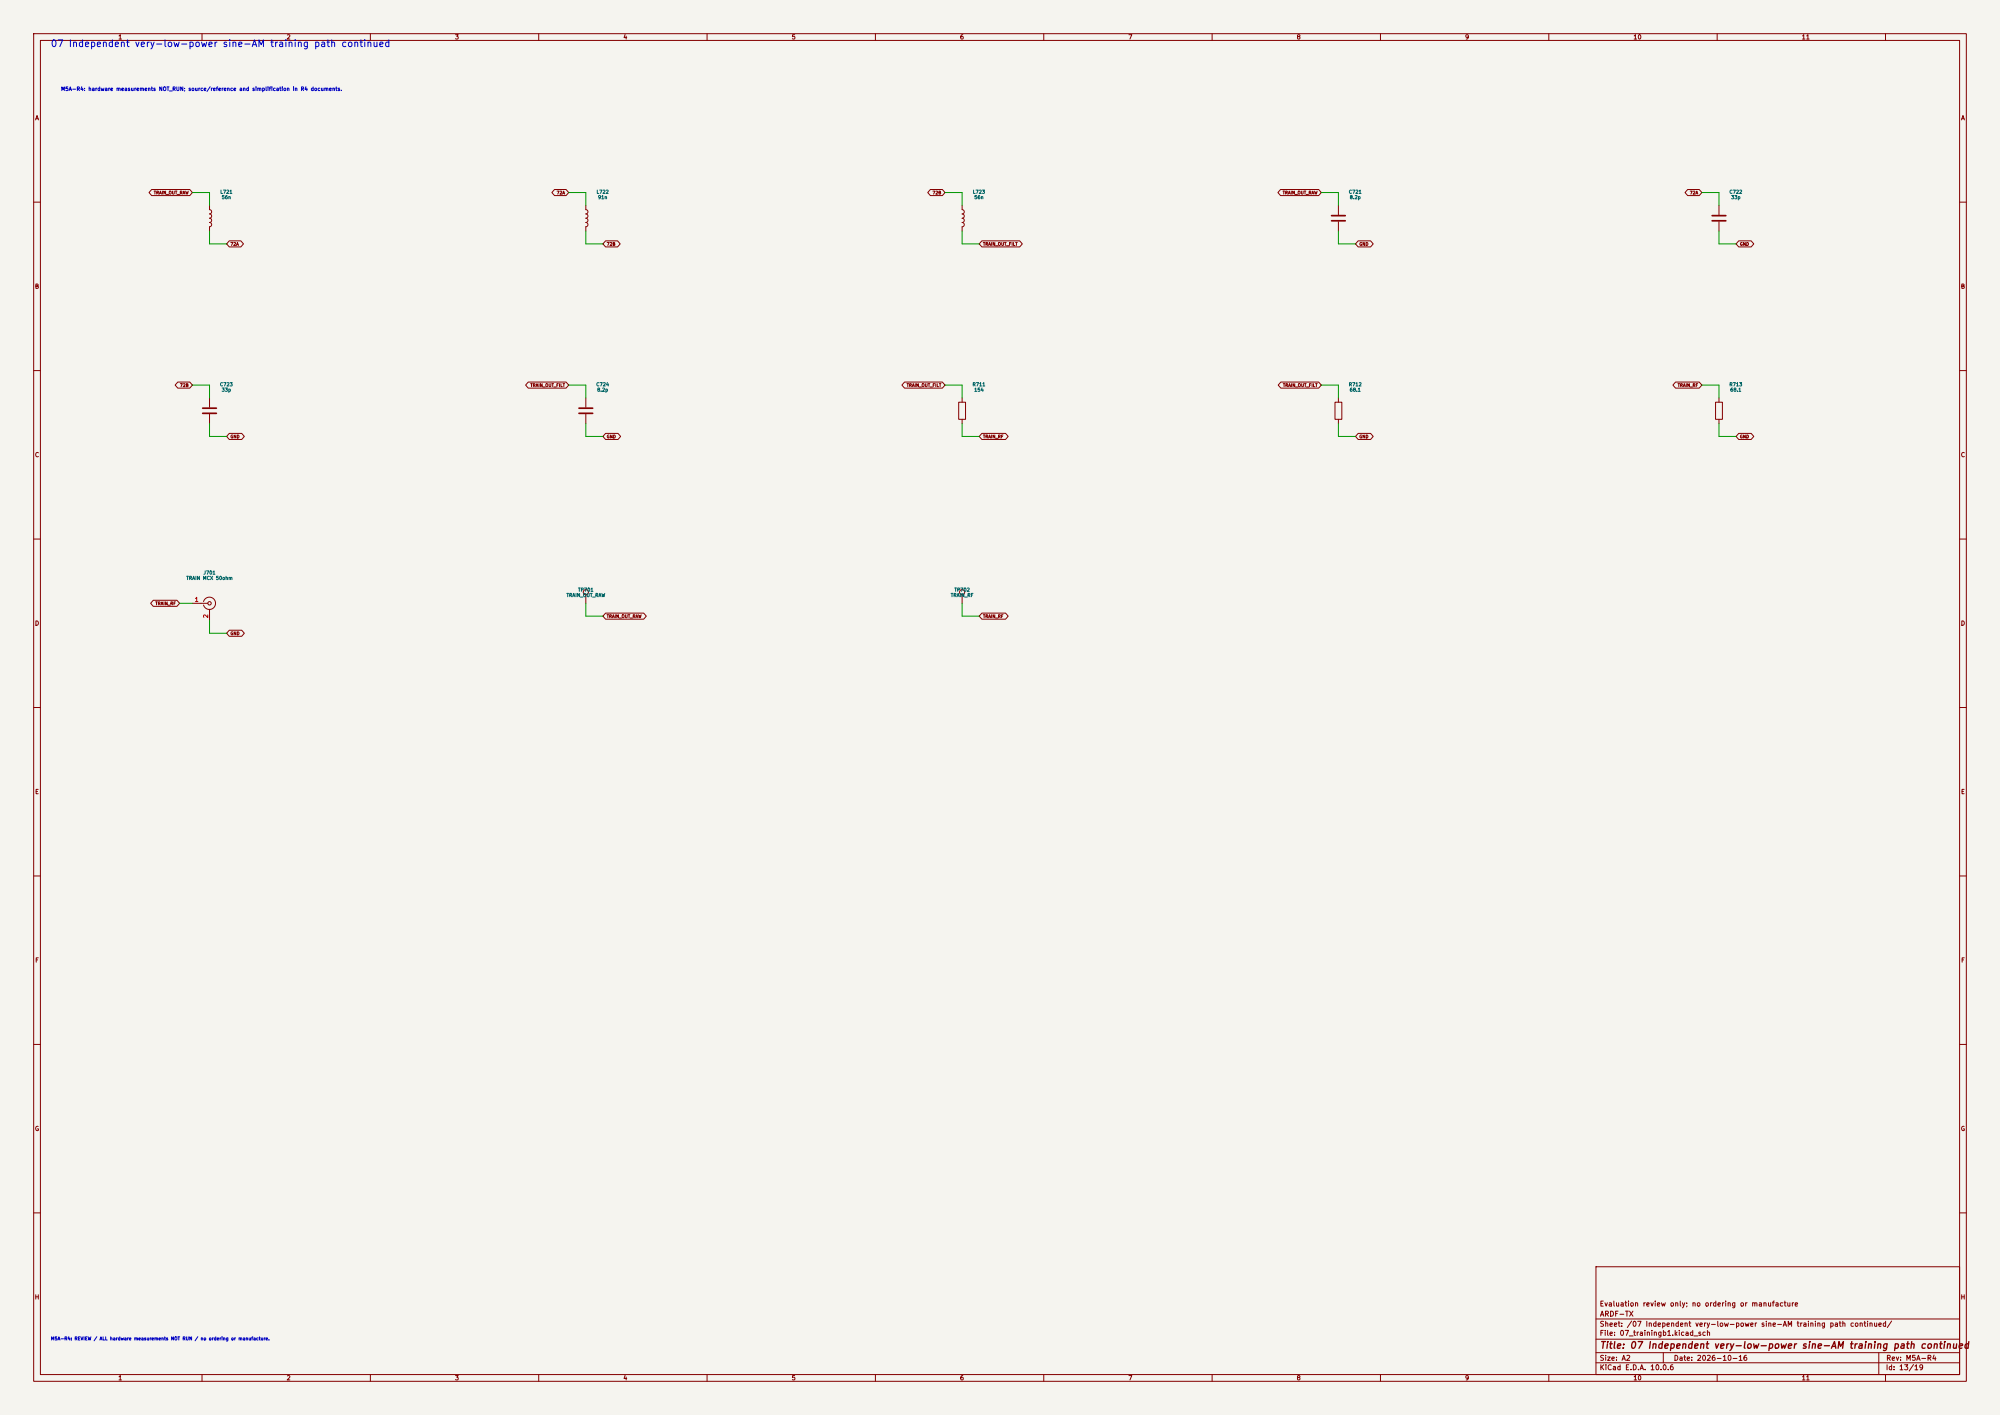
[picture p197: page 13]

07 Independent very-low-power sine-AM training path continued

Sheet: /07 Independent very-low-power sine-AM training path continued/
File: 07_trainingb1.kicad_sch
Title: 07 Independent very-low-power sine-AM training path continued

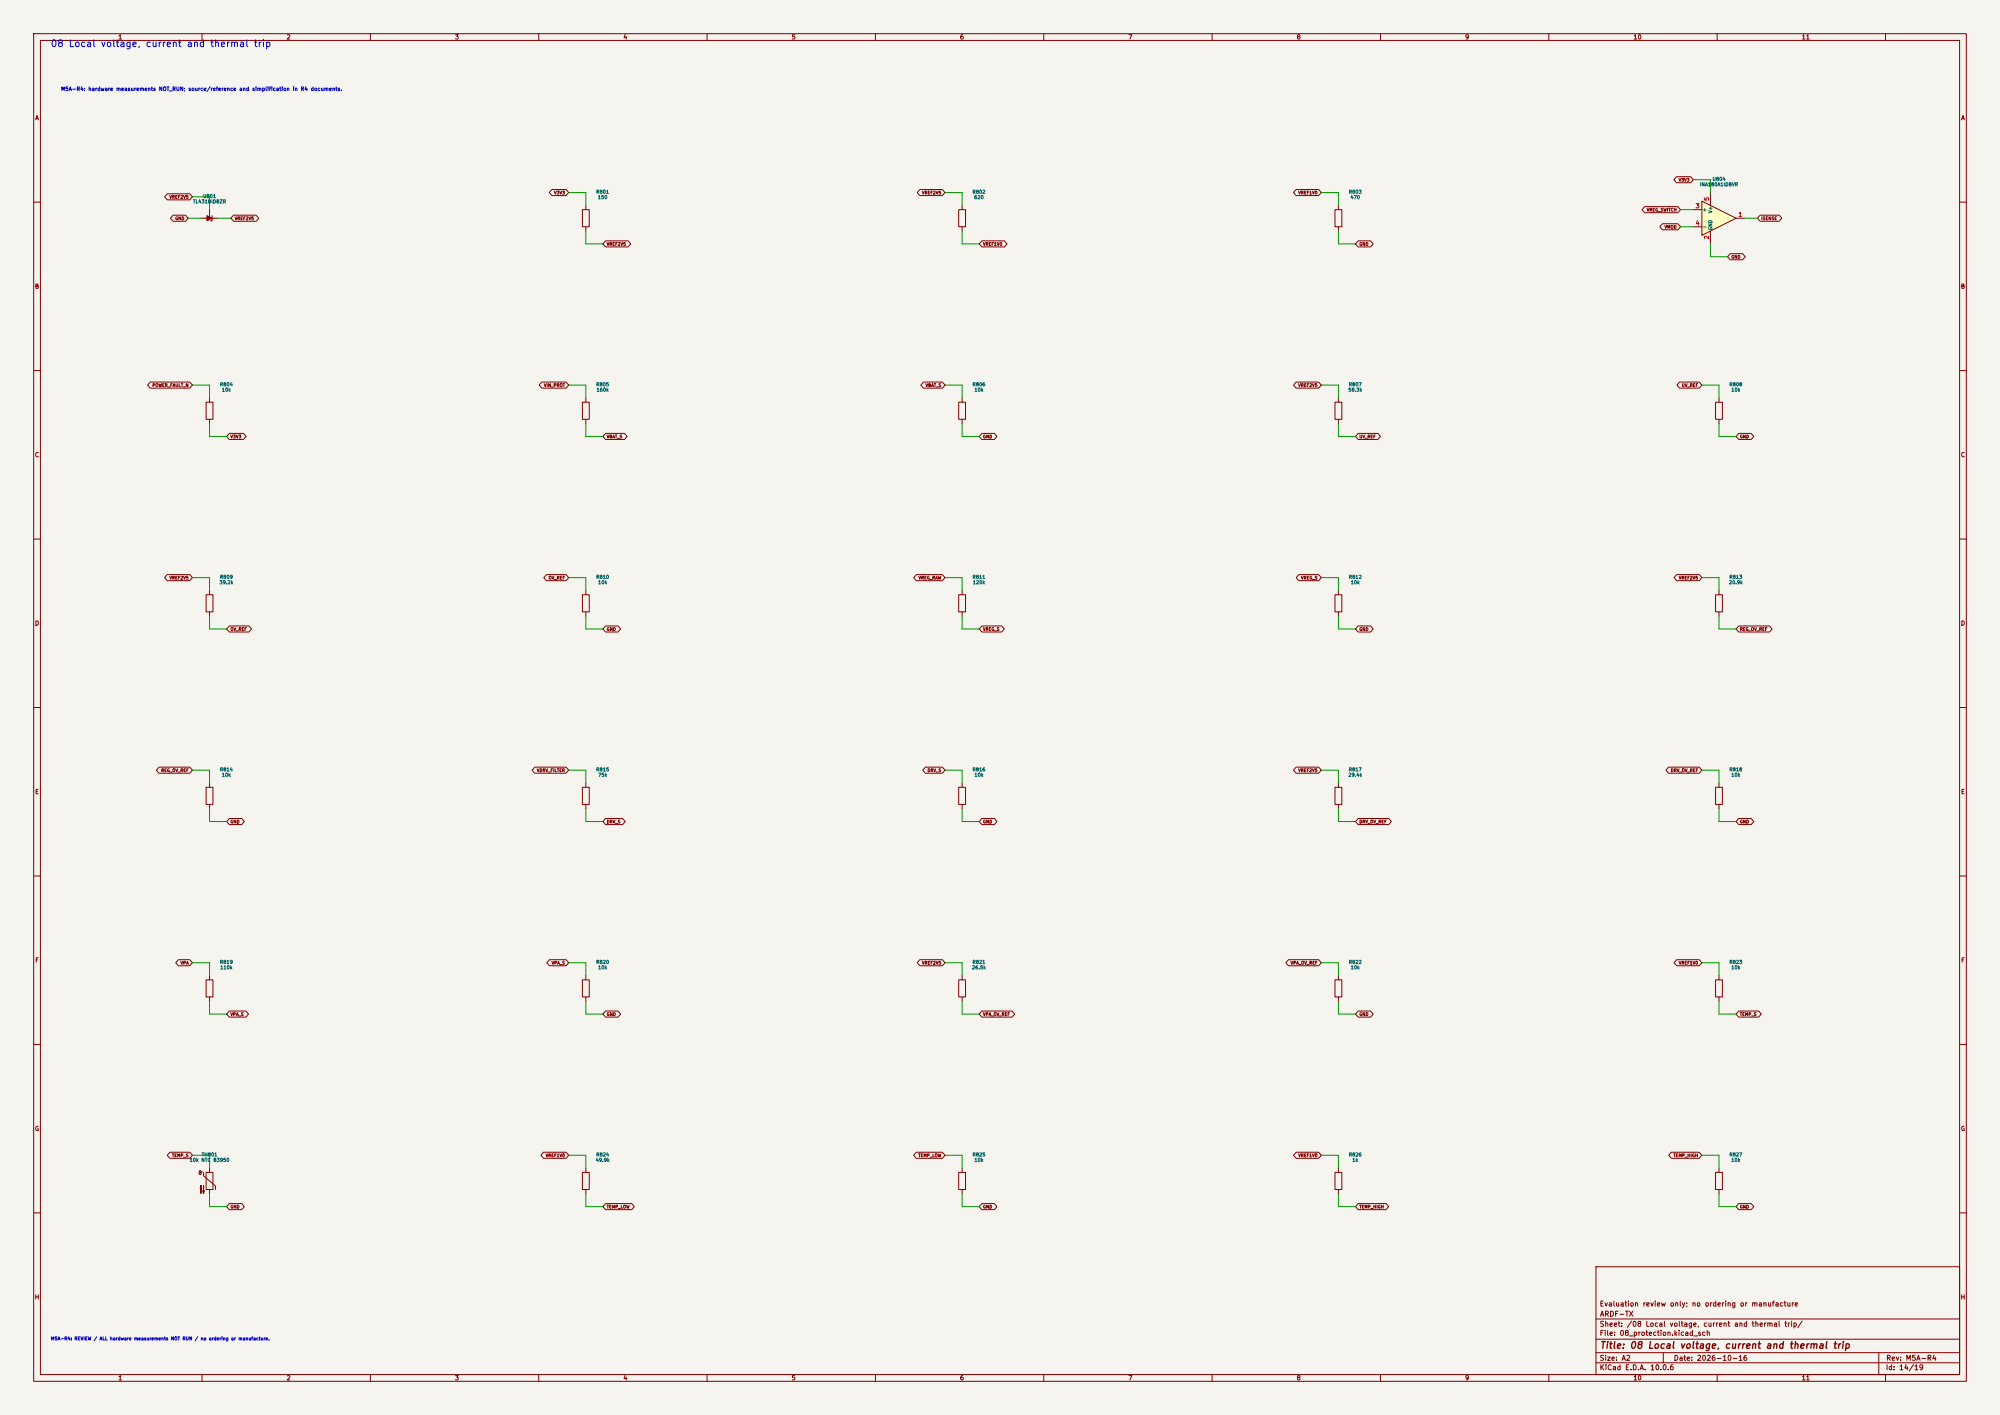
[picture p198: page 14]

08 Local voltage, current and thermal trip

Sheet: /08 Local voltage, current and thermal trip/
File: 08_protection.kicad_sch
Title: 08 Local voltage, current and thermal trip

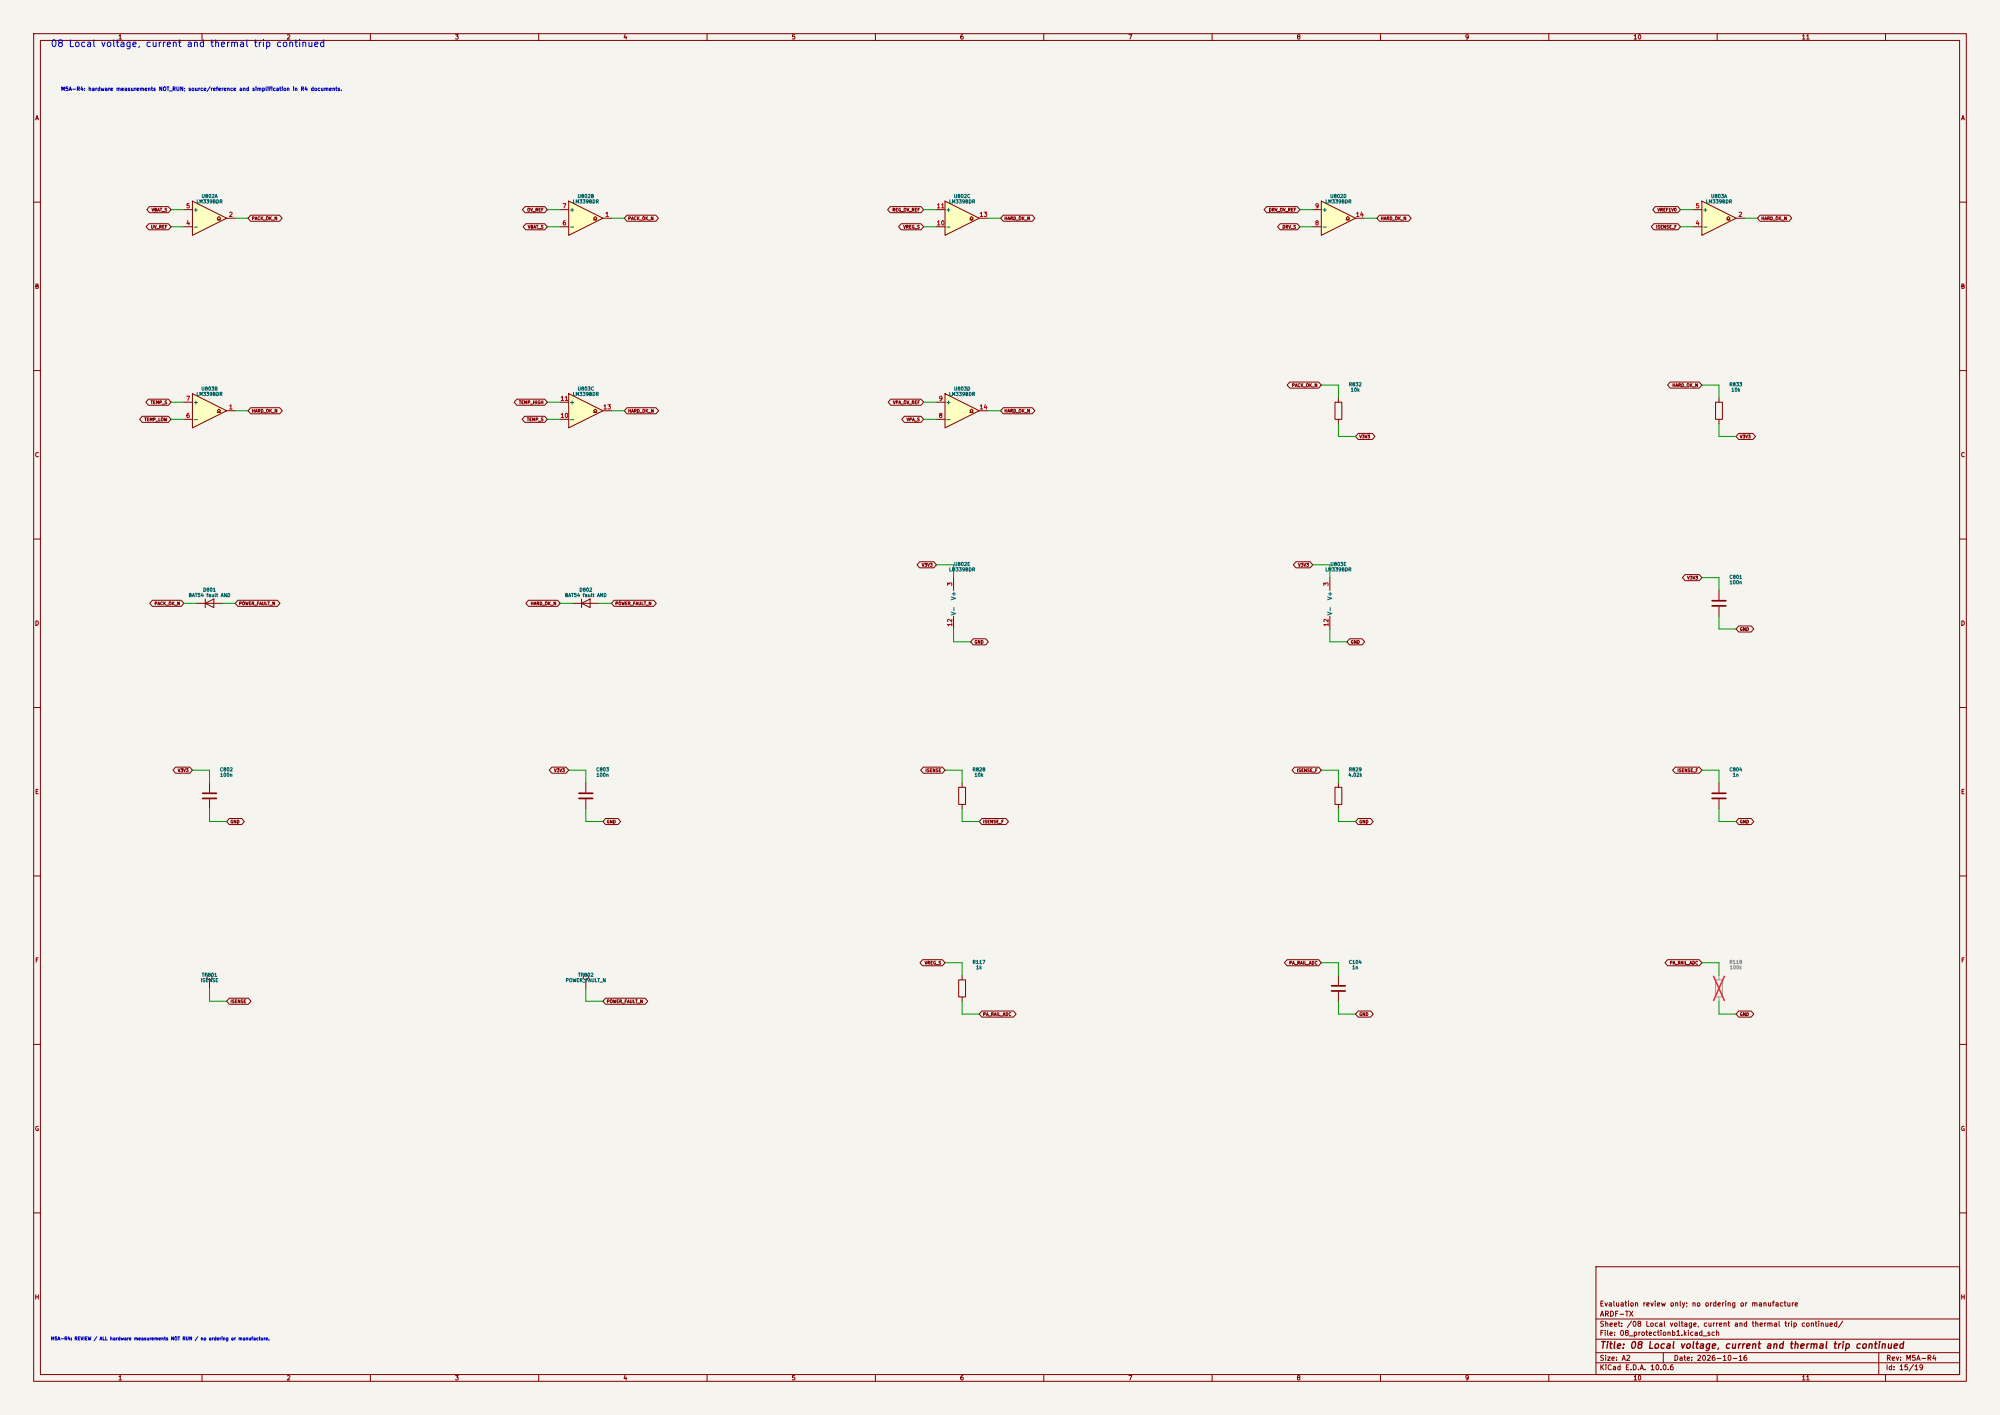
[picture p199: page 15]

V3V3 08 Local voltage, current and thermal trip continued

Sheet: /08 Local voltage, current and thermal trip continued/
File: 08_protectionb1.kicad_sch
Title: 08 Local voltage, current and thermal trip continued

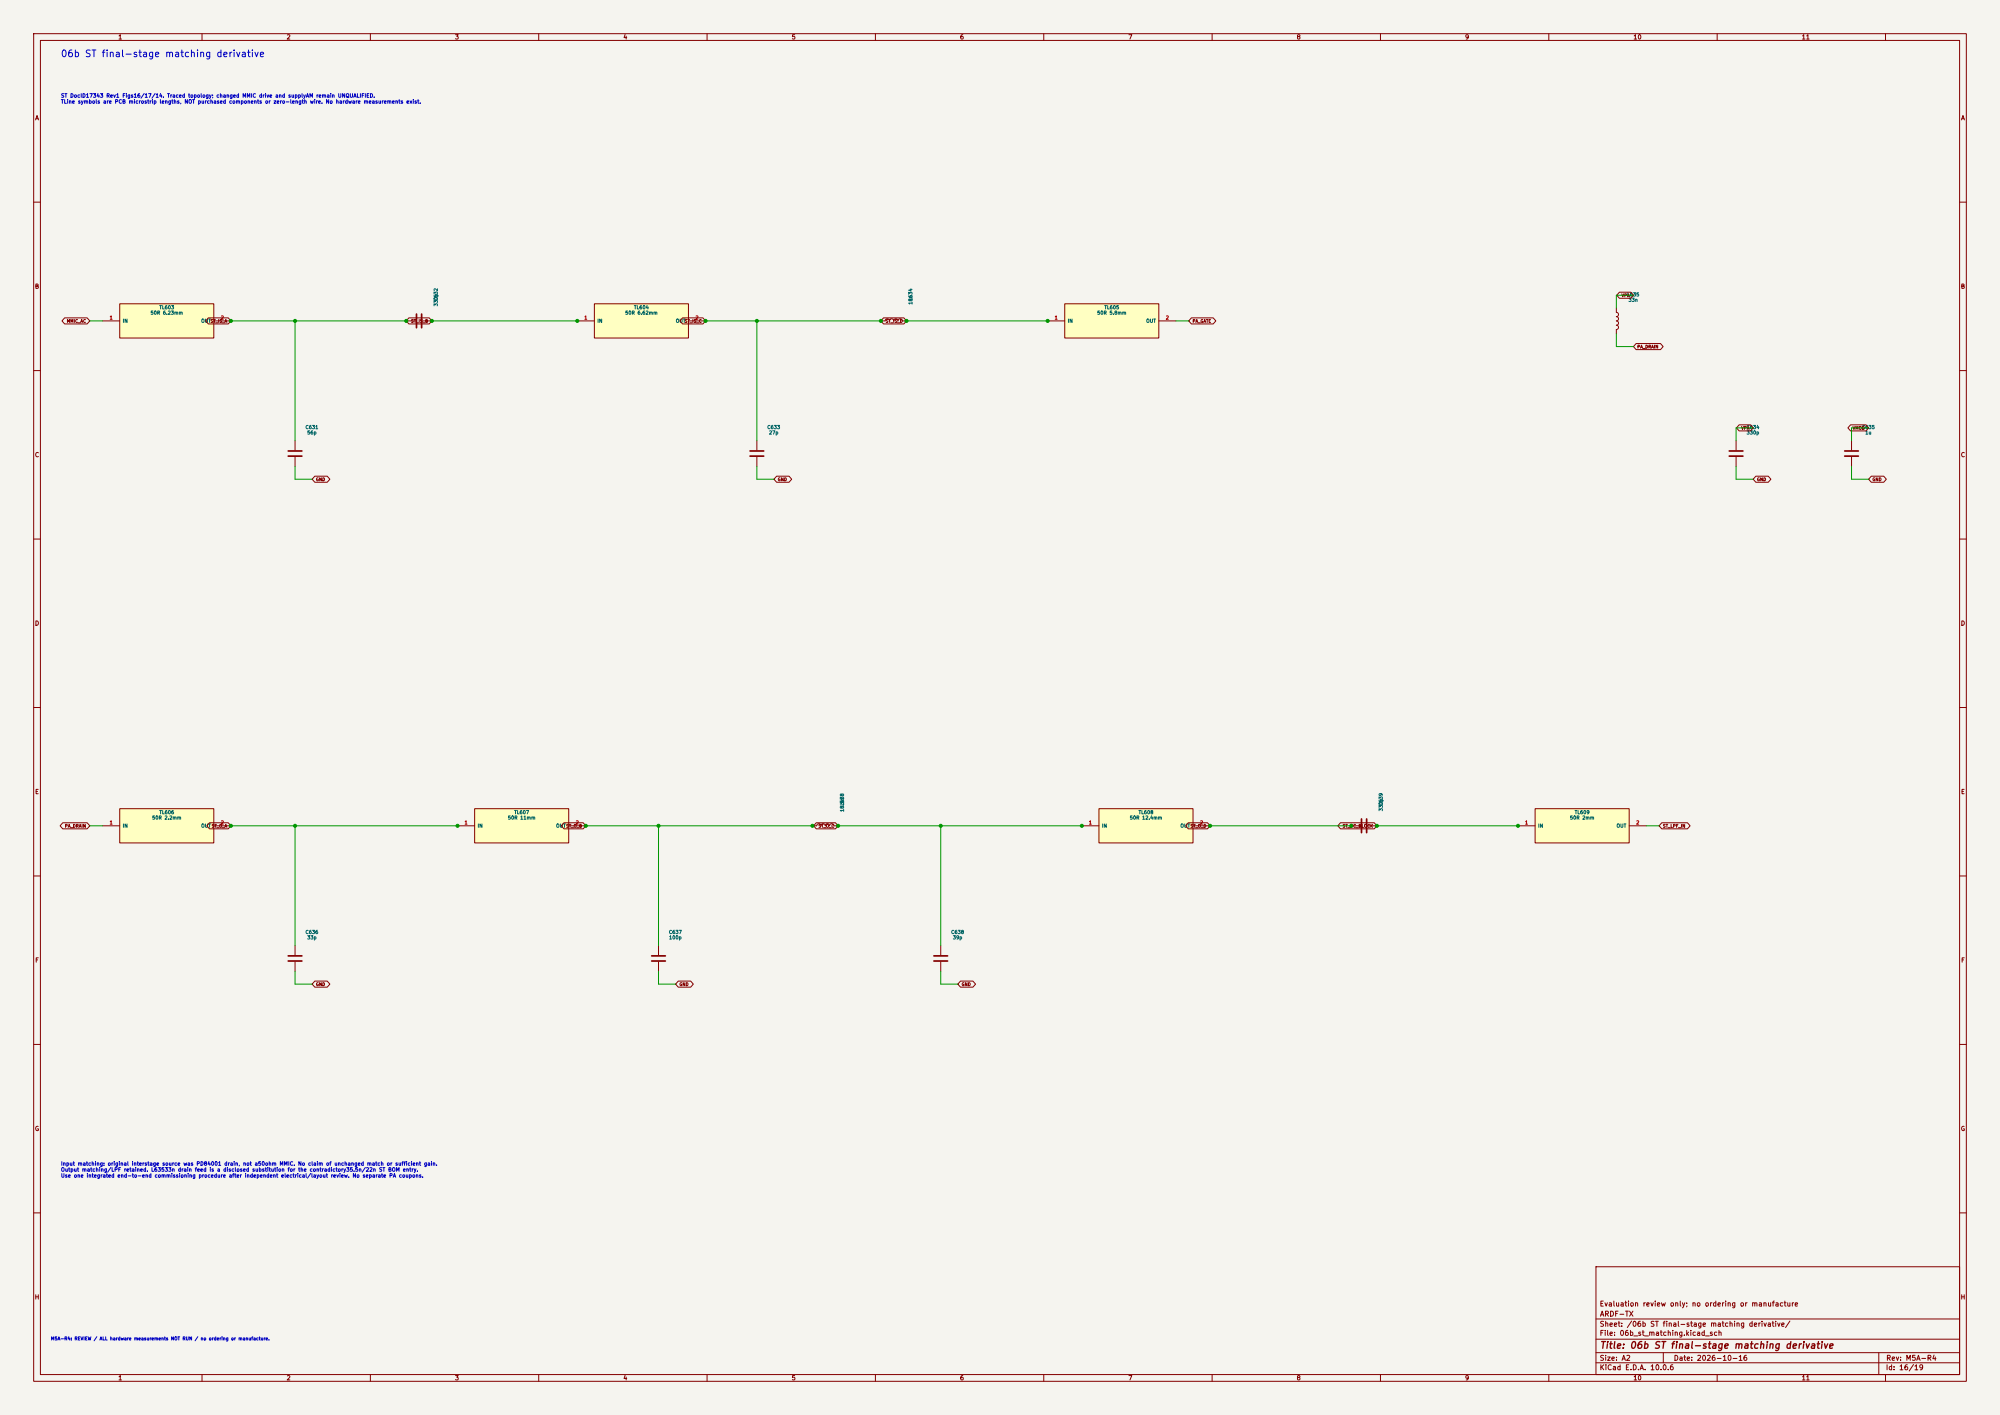
[picture p200: page 16]

06b ST final-stage matching derivative

ST DocID17343 Rev1 Figs16/17/14. Traced topology; changed MMIC drive and supplyAM remain UNQUALIFIED. TLine symbols are PCB microstrip lengths, NOT purchased components or zero-length wire. No hardware measurements exist.

Evaluation review only; no ordering or manufacture C639 330p

Input matching: original interstage source was PD84001 drain, not a50ohm MMIC. No claim of unchanged match or sufficient gain.
Output matching/LPF retained. L63533n drain feed is a disclosed substitution for the contradictory35.5n/22n ST BOM entry. Use one integrated end-to-end commissioning procedure after independent electrical/layout review. No separate PA coupons. M5A-R4: REVIEW / ALL hardware measurements NOT RUN / no ordering or manufacture.

Sheet: /06b ST final-stage matching derivative/
File: 06b_st_matching.kicad_sch
Title: 06b ST final-stage matching derivative

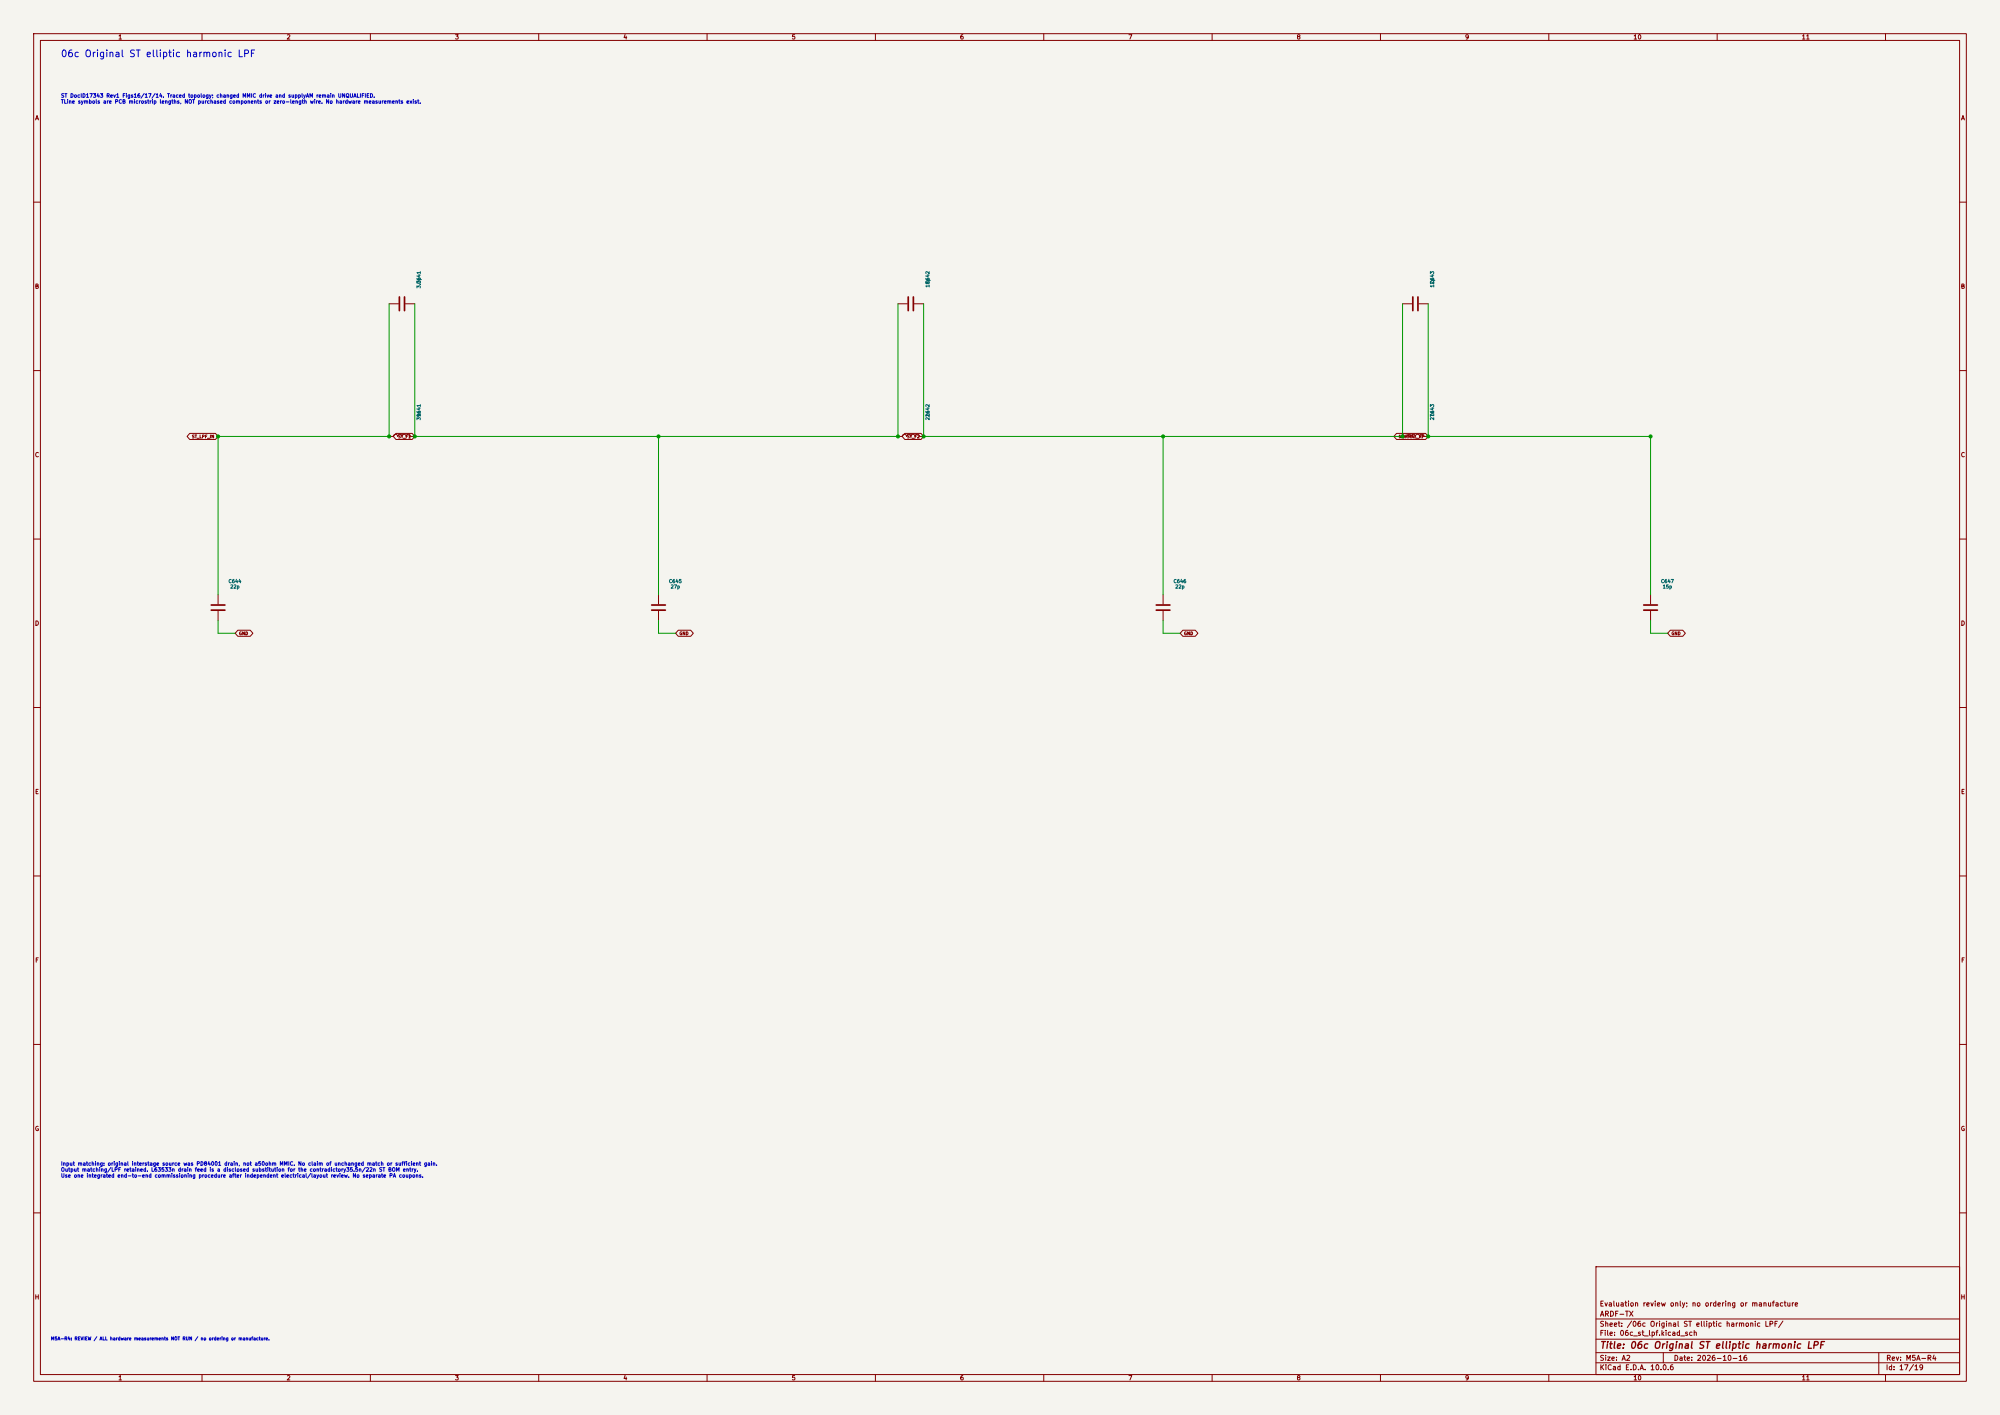
[picture p201: page 17]
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

Sheet: /06c Original ST elliptic harmonic LPF/
File: 06c_st_lpf.kicad_sch
Title: 06c Original ST elliptic harmonic LPF

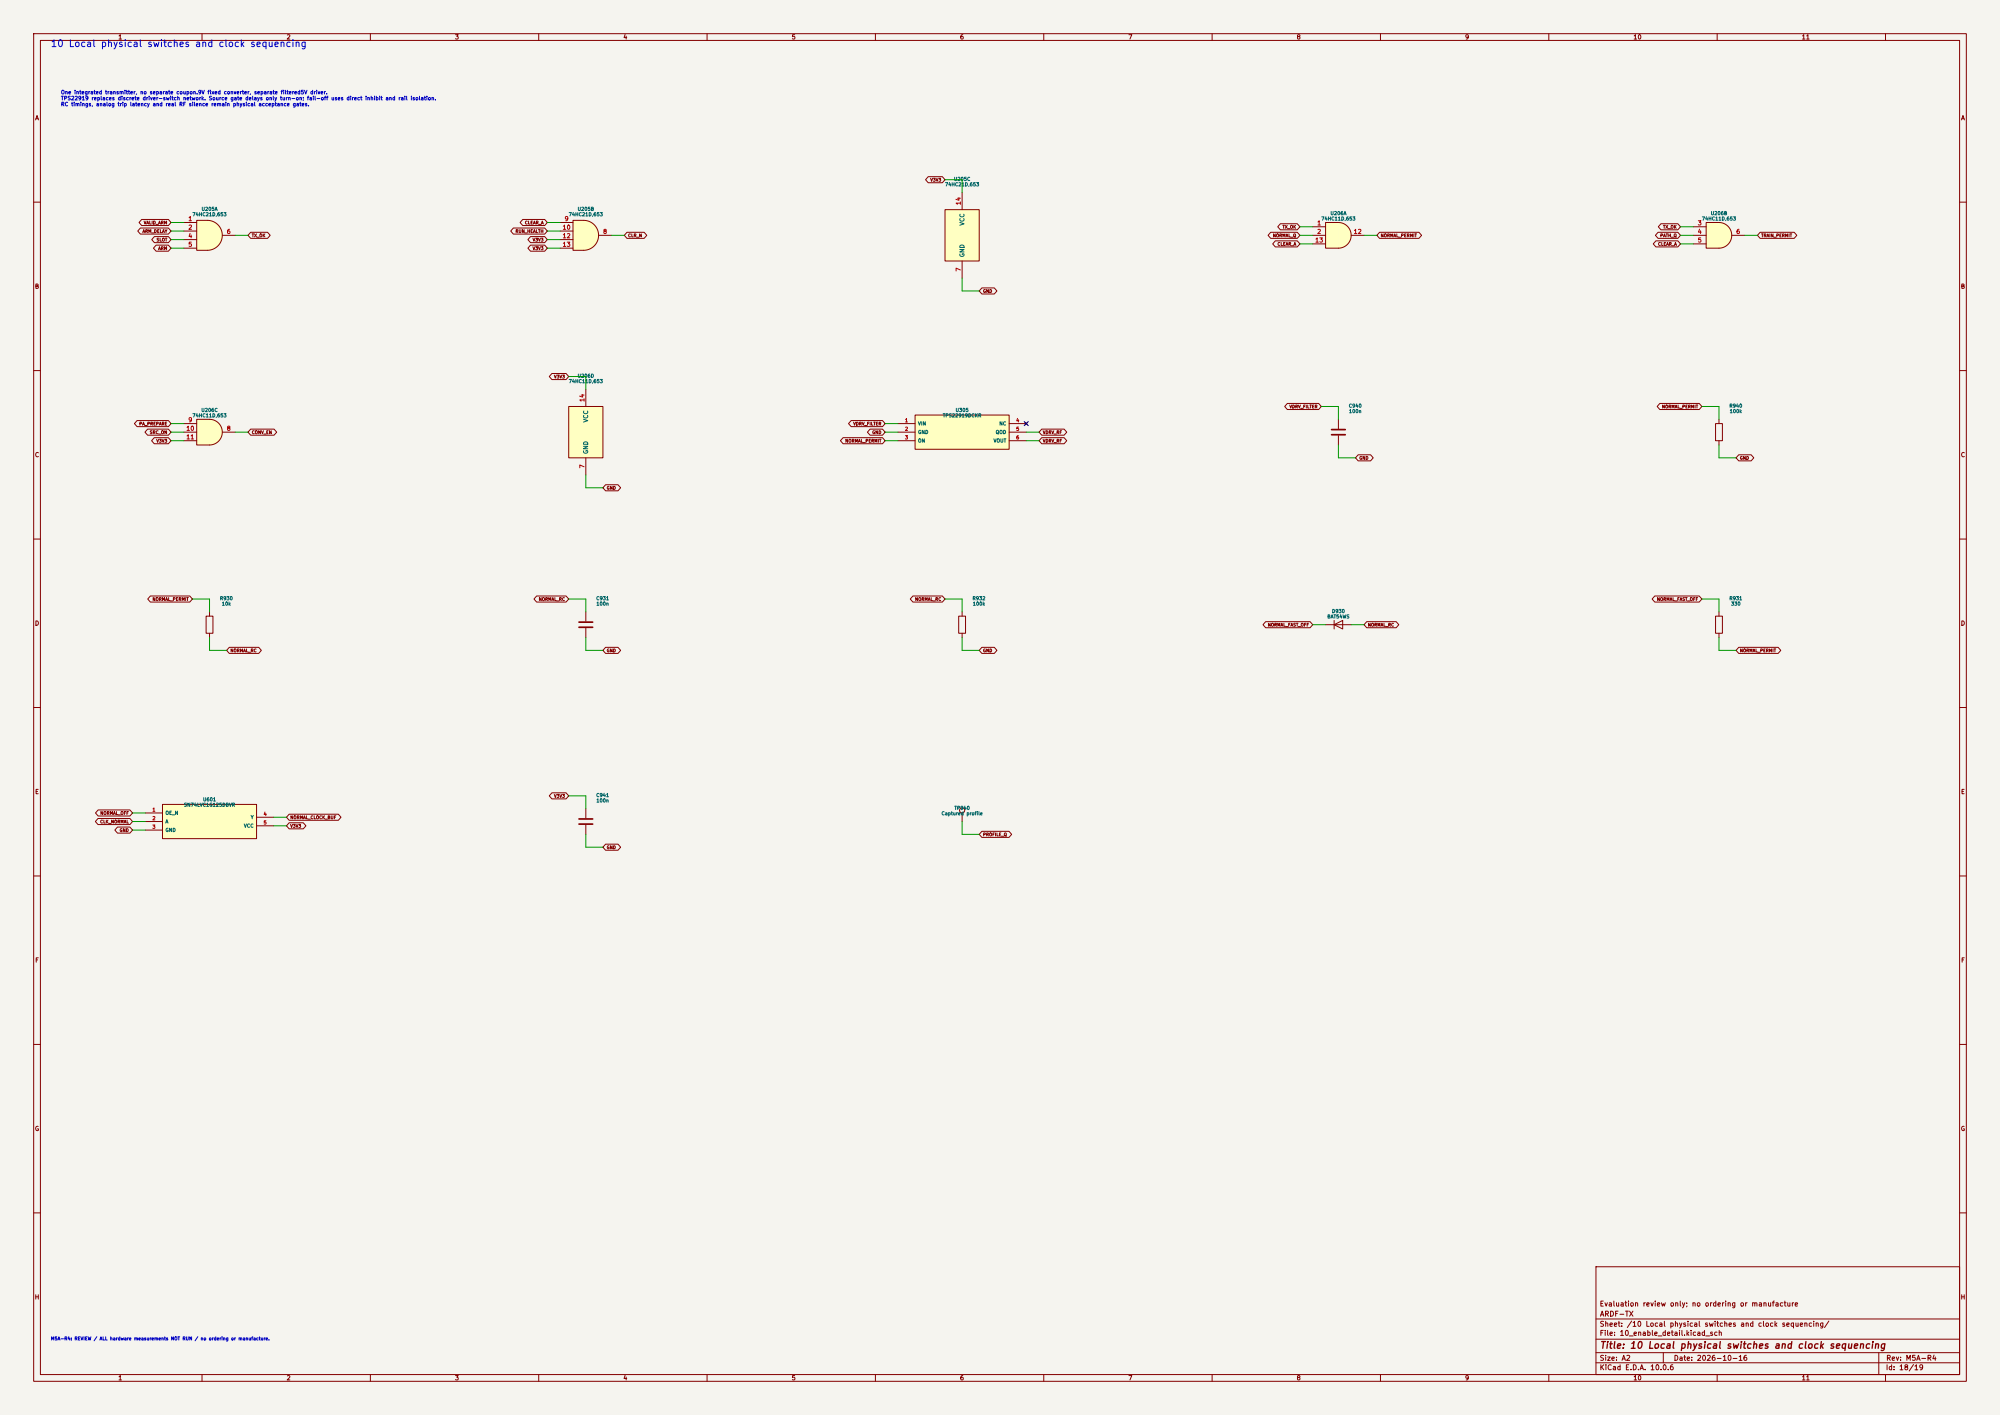
[picture p202: page 18]

10 Local physical switches and clock sequencing

One integrated transmitter, no separate coupon.9V fixed converter, separate filtered5V driver. TPS22919 replaces discrete driver-switch network. Source gate delays only turn-on; fail-off uses direct inhibit and rail isolation. RC timings, analog trip latency and real RF silence remain physical acceptance gates.

Sheet: /10 Local physical switches and clock sequencing/
File: 10_enable_detail.kicad_sch
Title: 10 Local physical switches and clock sequencing

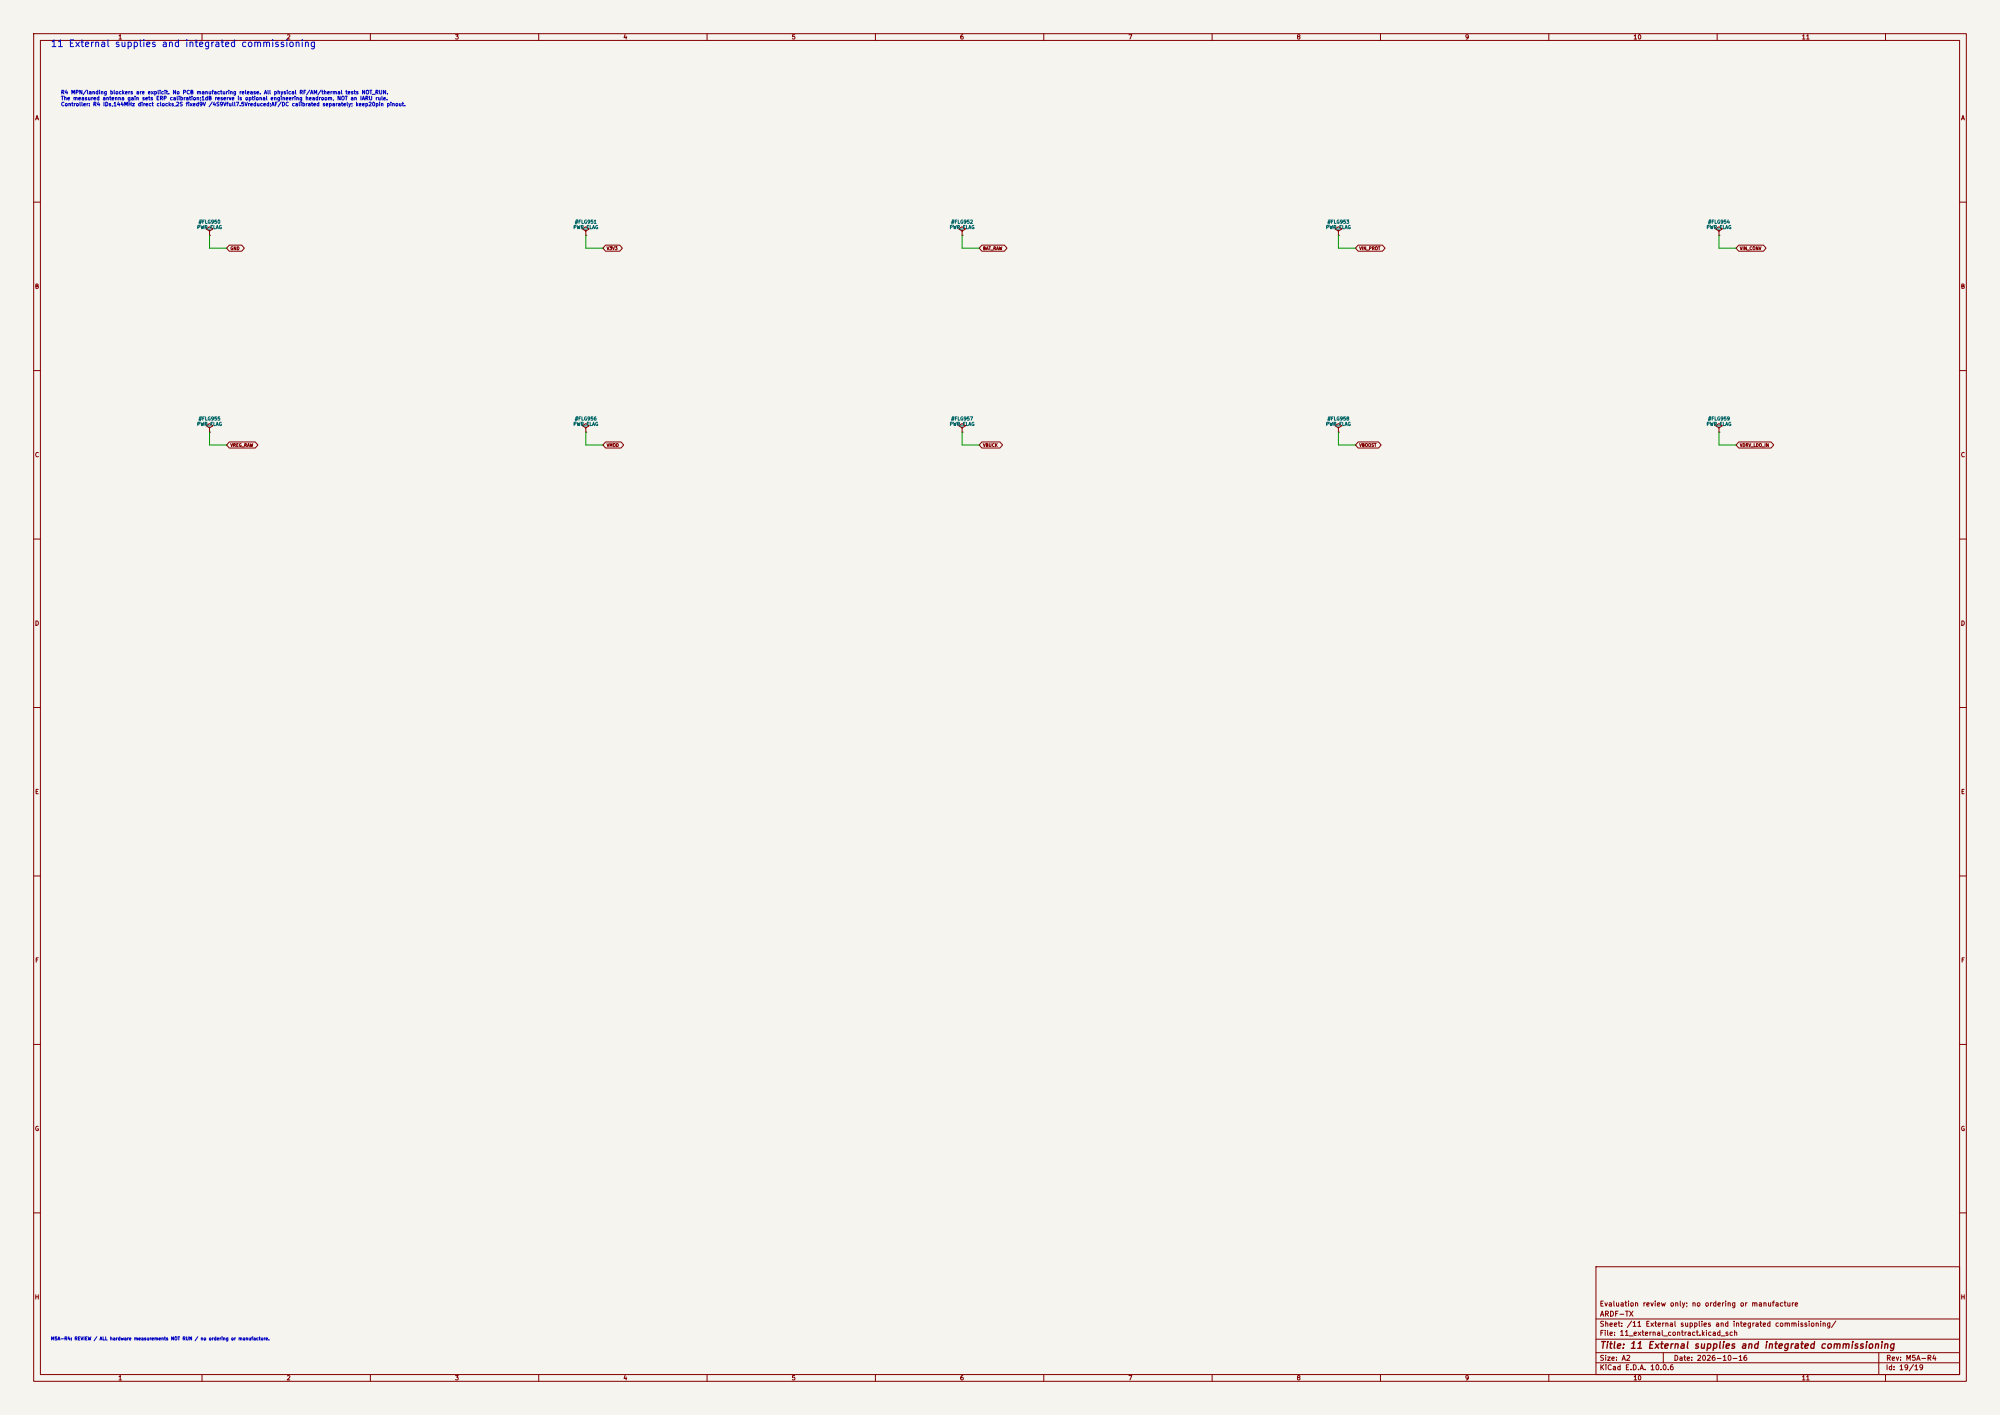
[picture p203: page 19]

11 External supplies and integrated commissioning

R4 MPN/landing blockers are explicit. No PCB manufacturing release. All physical RF/AM/thermal tests NOT_RUN. The measured antenna gain sets ERP calibration;1dB reserve is optional engineering headroom, NOT an IARU rule. Controller: R4 IDs,144MHz direct clocks,2S fixed9V /4S9Vfull7.5Vreduced;AF/DC calibrated separately; keep20pin pinout.

Sheet: /11 External supplies and integrated commissioning/
File: 11_external_contract.kicad_sch
Title: 11 External supplies and integrated commissioning
