DD1SB/ARDF-TX/hardware/80m/review/M3B-E1/assembly.pdf

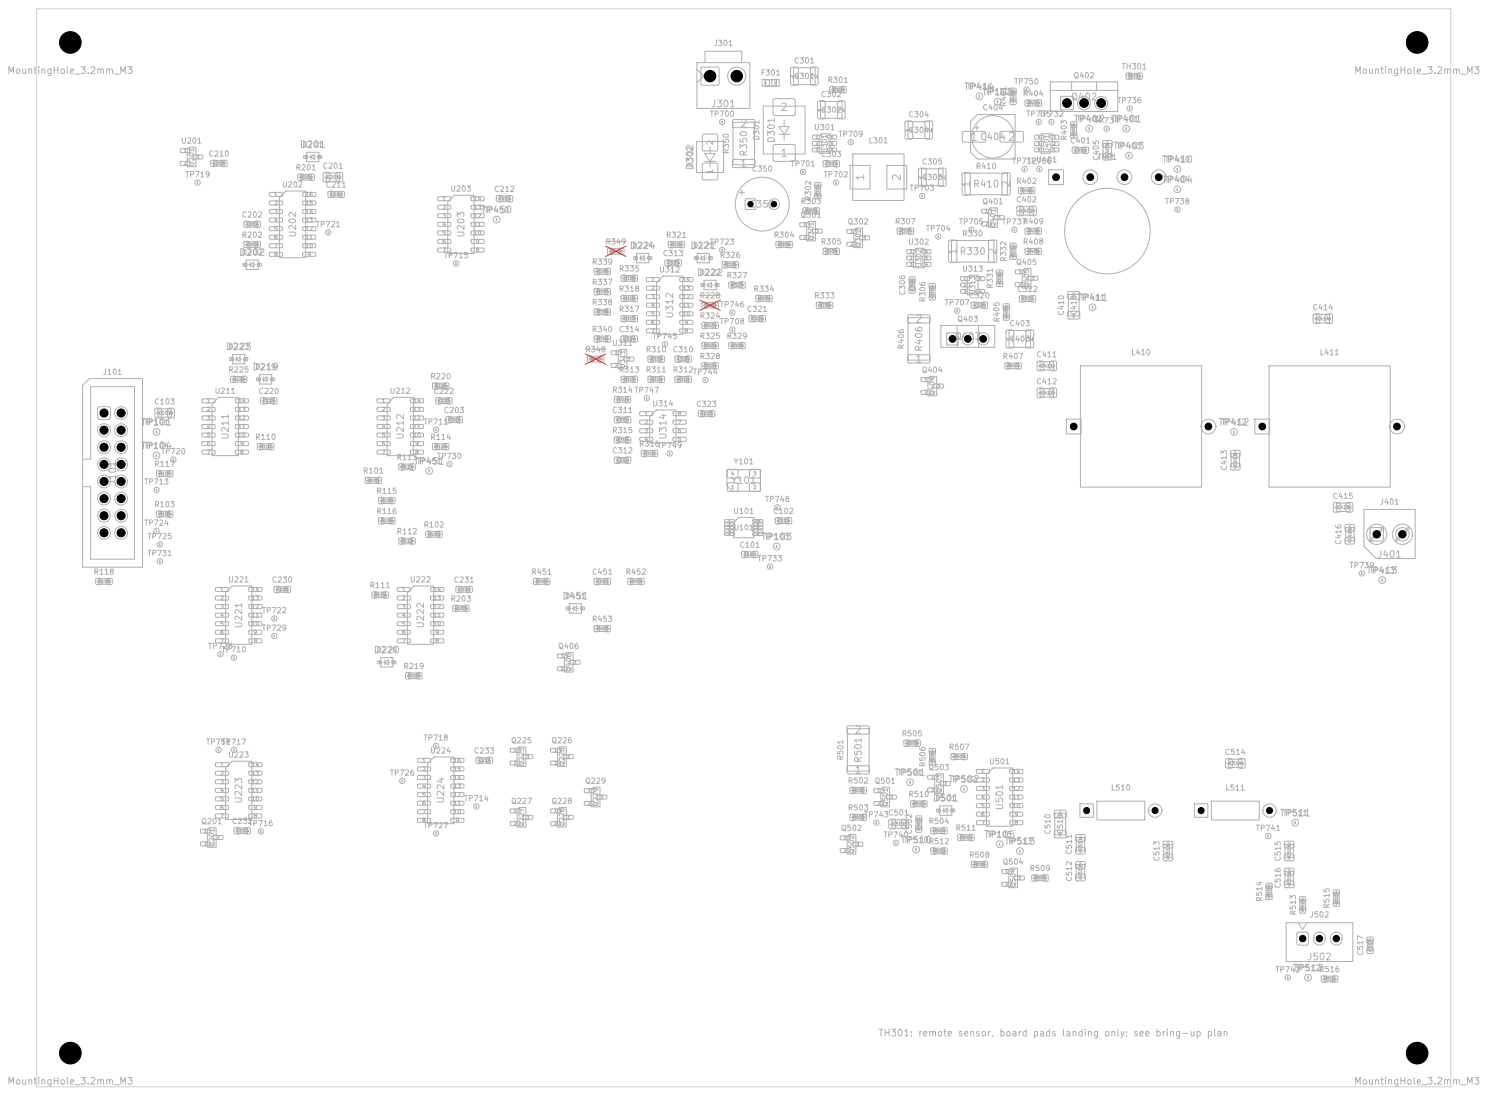
[picture p204: page 1]

TH301: remote sensor, board pads landing only; see bring-up plan
