DD1SB/ARDF-TX/hardware/2m/review/M5B-E6R2/mechanical/dimensioned-mounting.pdf

20

40

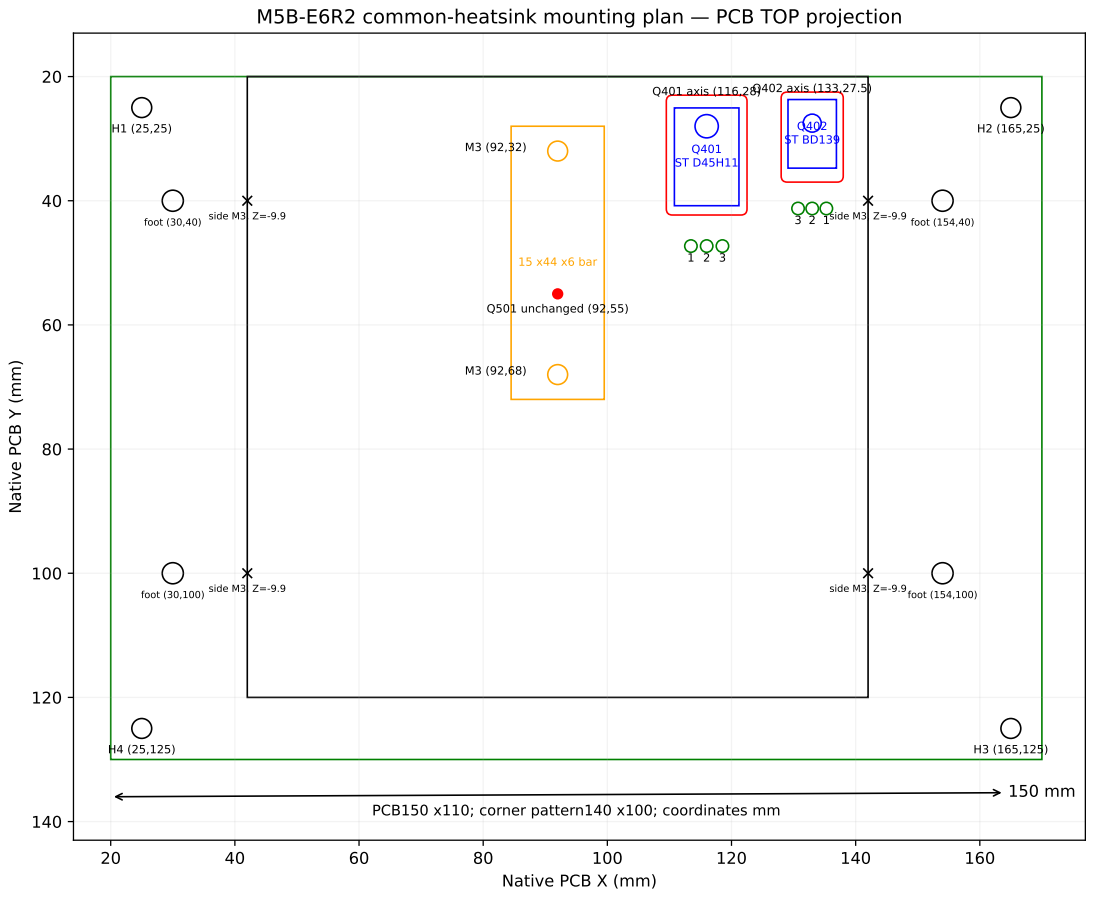
[picture p216: page 1]

M5B-E6R2 common-heatsink mounting plan — PCB TOP projection

H1 (25,25) | M3 (92,32) | | Q401 axis (116,28) Q401 ST D45H11 | Q402 axis (133,27.5) Q402 ST BD139 | H2 (165,25)

side M3, Z=-9.9 foot (30,40) | | 15 x44 x6 bar Q501 unchanged (92,55) | 1 2 3 | side M3, Z=-9.9 3 2 1 | foot (154,40)

Native PCB Y (mm)

side M3, Z=-9.9 foot (30,100) | | side M3, Z=-9.9 | foot (154,100)

H4 (25,125) | PCB150 x110; corner pattern140 x100; coordinates mm | | H3 (165,125) | 150 mm

Native PCB X (mm)
