DD1SB/ARDF-TX/hardware/2m/review/M5B-E6R2/mechanical/keying-transient.pdf

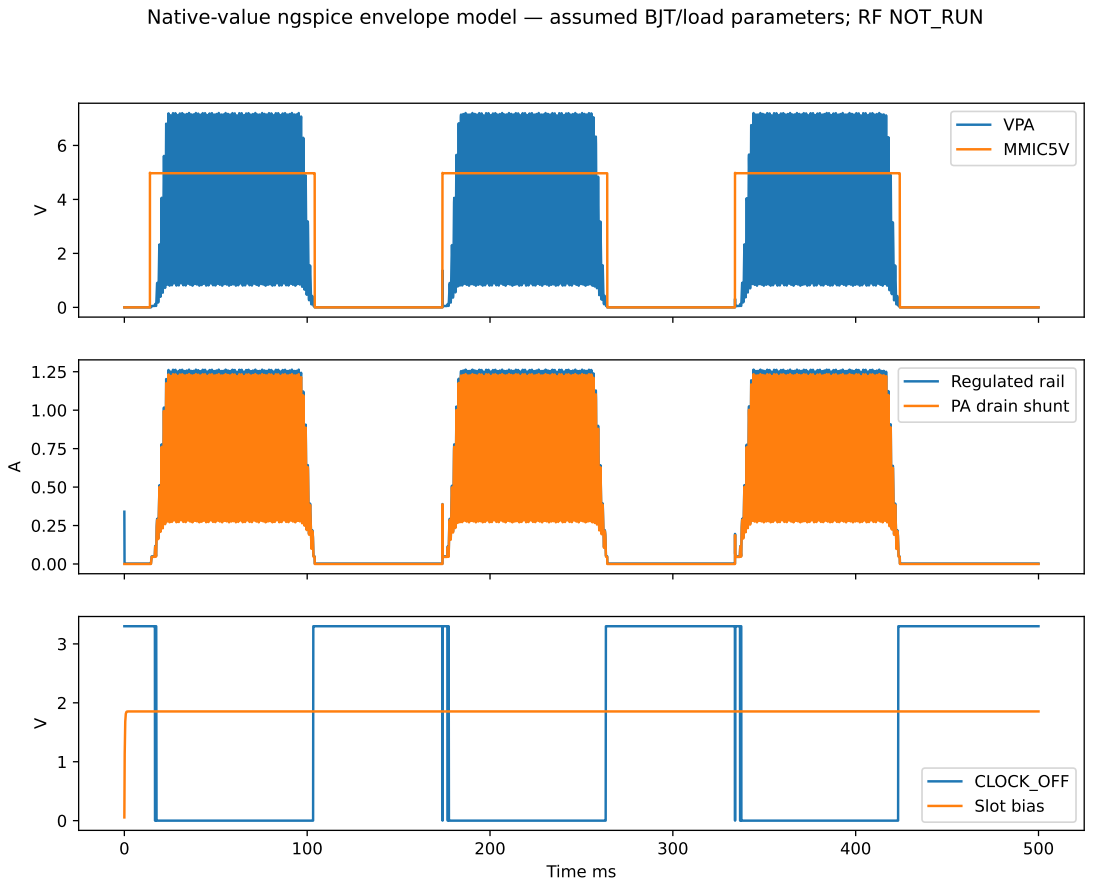
[picture p217: page 1]
VPA; MMIC5V; Time ms; CLOCK_OFF; Slot bias

Native-value ngspice envelope model — assumed BJT/load parameters; RF NOT_RUN

Regulated rail
PA drain shunt
