DD1SB/ARDF-TX/hardware/2m/review/M5B-E6R2/mechanical/section-Q401-Q402.pdf

0

# E6R2 section-Q401-Q402; section Y=28 mm

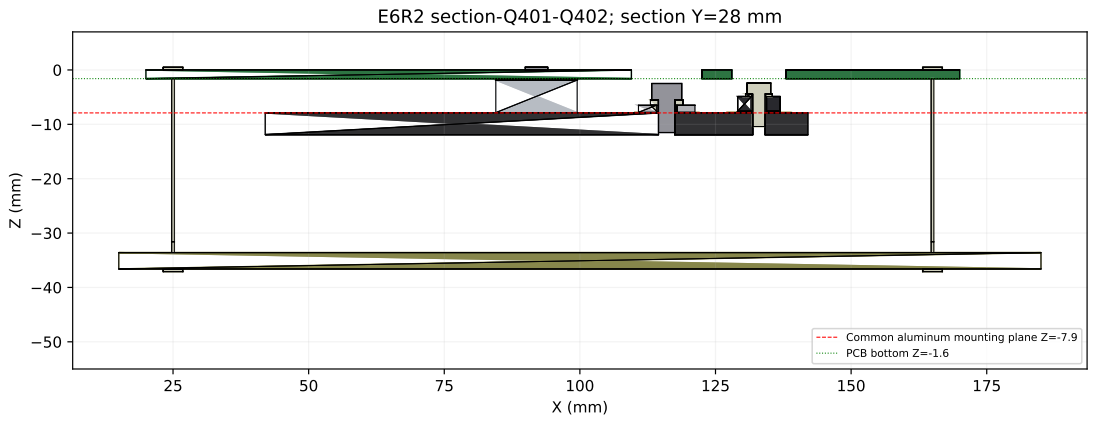
[picture p218: page 1]

Common aluminum mounting plane Z=-7.9
PCB bottom Z=-1.6
