DD1SB/ARDF-TX/hardware/80m/production/review/M4A-V1R1/assembly.pdf

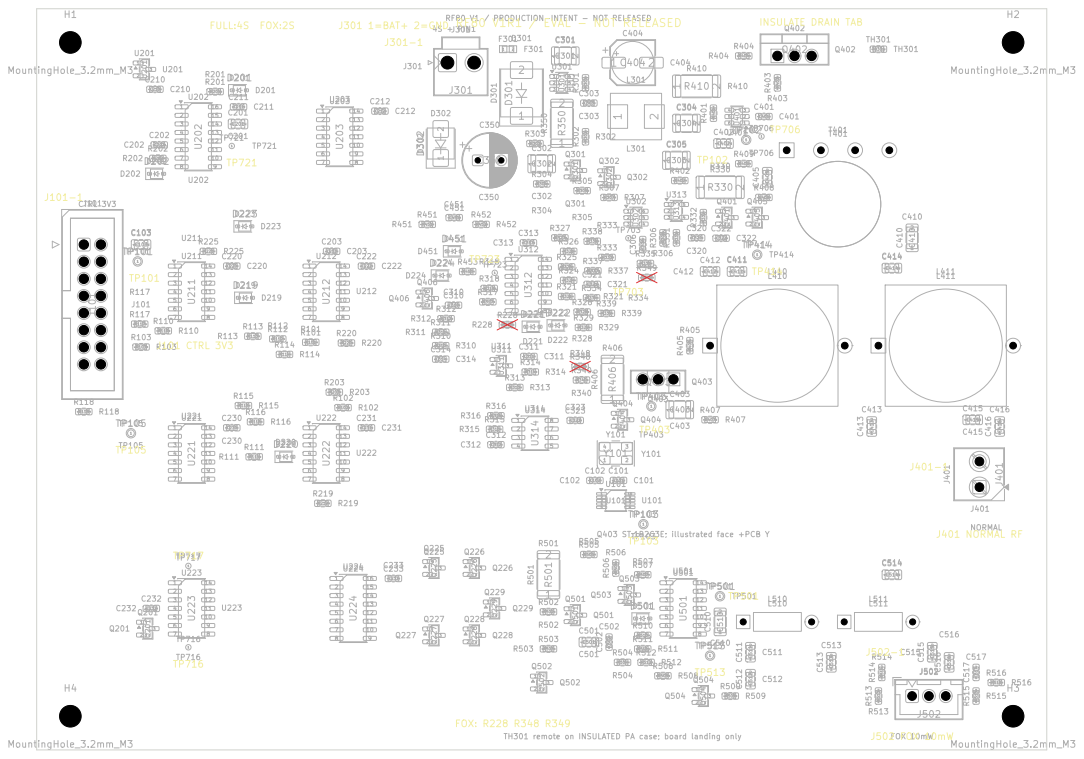
[picture p219: page 1]

F301 U314 R313 C302 R304 RF80 V1 / PRODUCTION-INTENT - NOT RELEASED
J401 NORMAL RF RF80 V1R1 / EVAL - NOT RELEASED

TH301 remote on INSULATED PA case; board landing only
