DD1SB/ARDF-TX/hardware/80m/production/review/M4A-V1/assembly.pdf

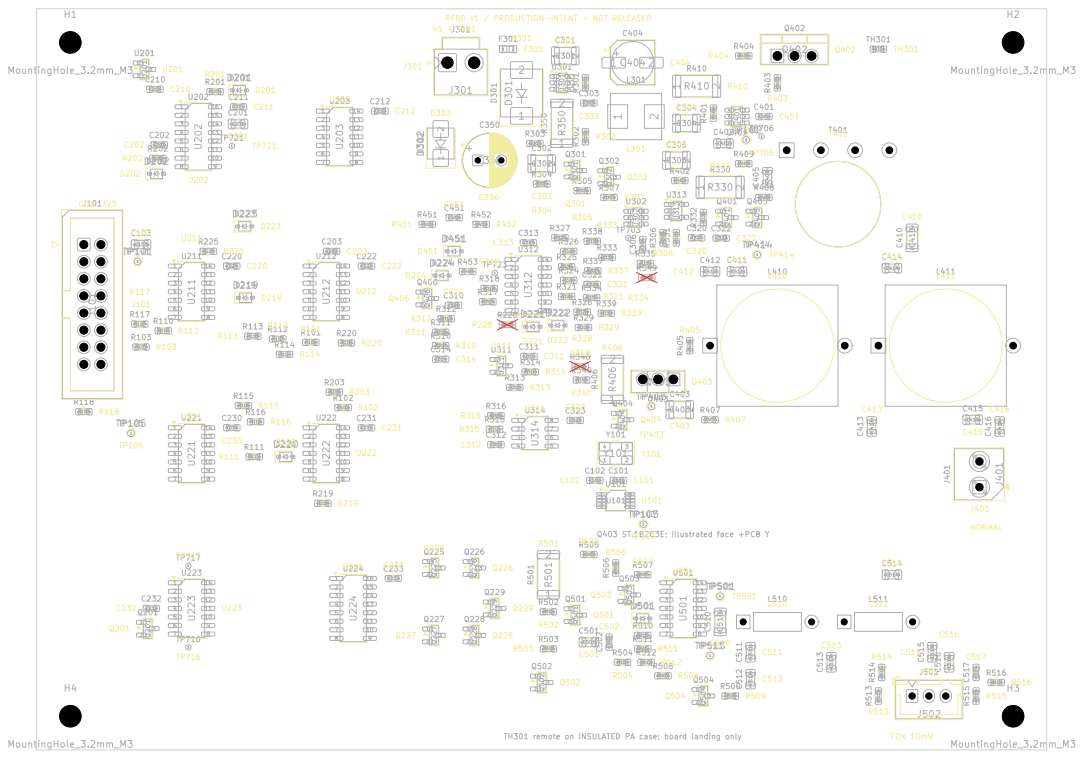
[picture p231: page 1]

F301 U314 R313 C302 R304 RF80 V1 / PRODUCTION-INTENT - NOT RELEASED

TH301 remote on INSULATED PA case; board landing only Q403 ST:1B2C3E; illustrated face +PCB Y
