DD1SB/ARDF-TX/hardware/80m/handoff/M4A-E2/reference-package/assembly.pdf

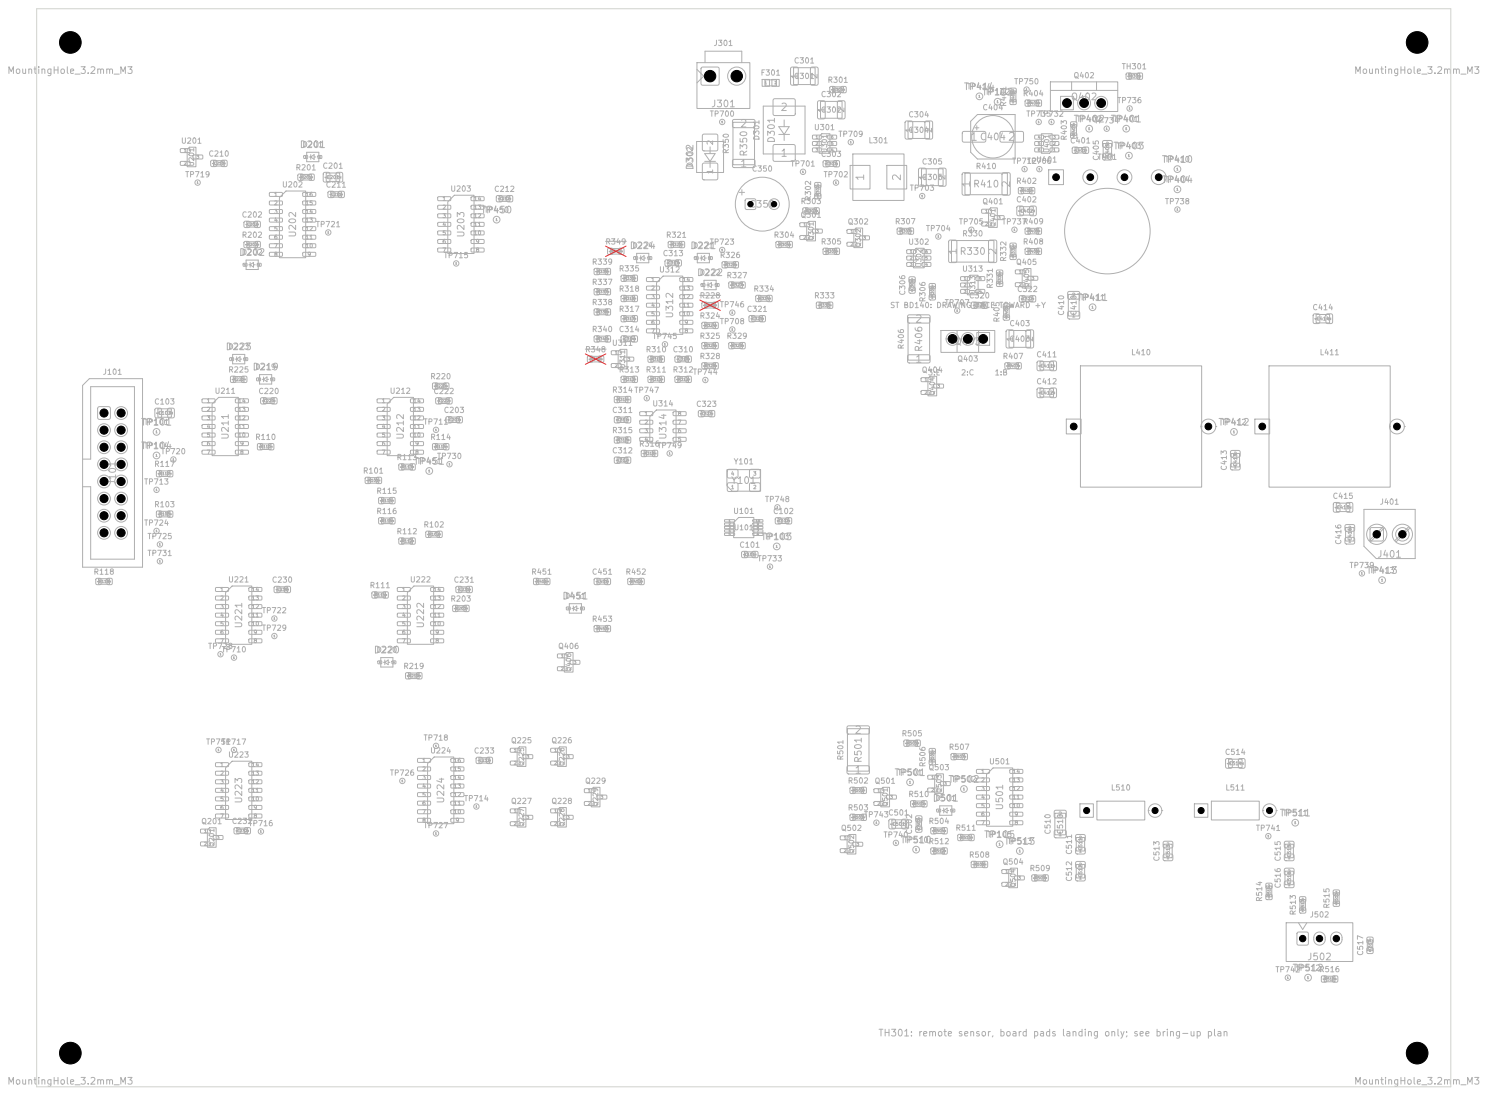
[picture p232: page 1]

ST BD140: DRAWING FACE TOWARD +Y

TH301: remote sensor, board pads landing only; see bring-up plan
