DD1SB/ARDF-TX/hardware/2m/review/M5B-E6R2/assembly-BUCK4S.pdf

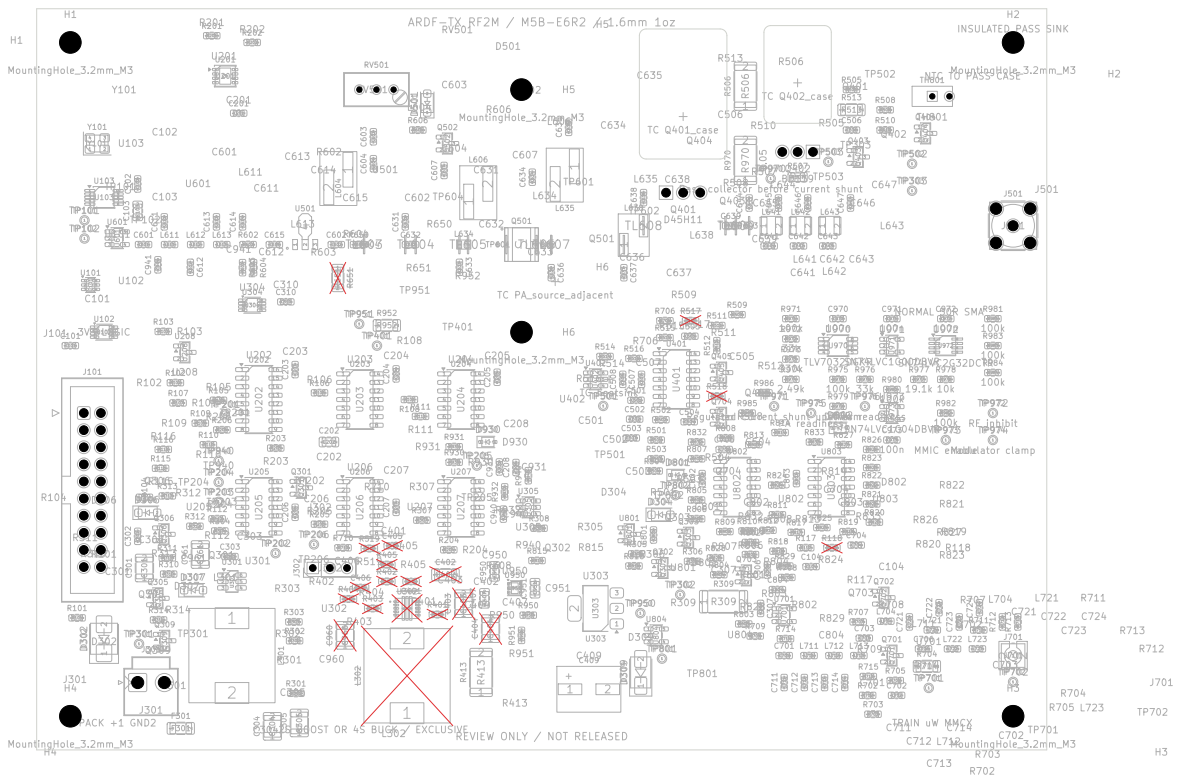
[picture p246: page 1]

TRAIN uW MMCX NORMAL 50R SMA C713

J701 REVIEW ONLY / NOT RELEASED
