DD1SB/ARDF-TX/hardware/2m/review/M5B-E6R1/03-PA-junction.pdf

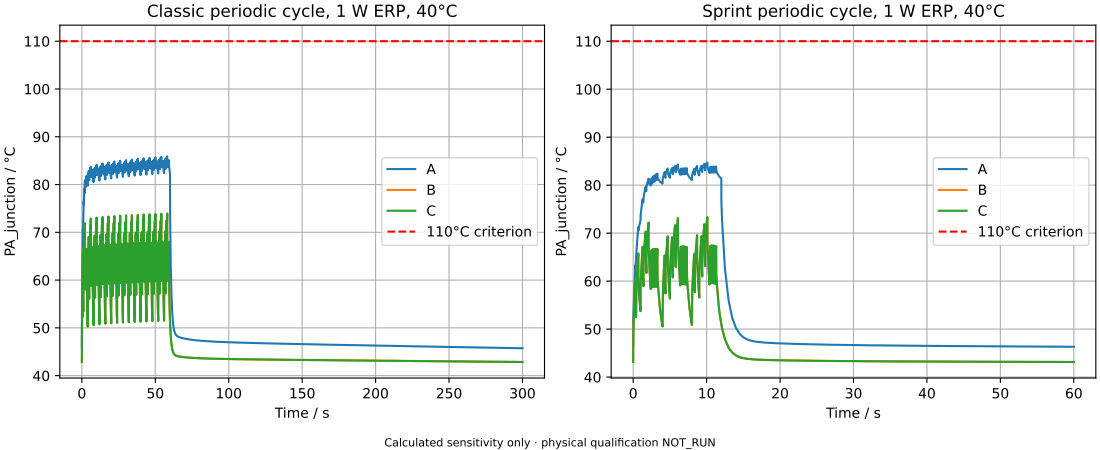
[picture p248: page 1]
Time / s; PA_junction / °C; A B C 110°C criterion

Classic periodic cycle, 1 W ERP, 40°C

Sprint periodic cycle, 1 W ERP, 40°C

Calculated sensitivity only · physical qualification NOT_RUN
