DD1SB/ARDF-TX/hardware/2m/review/M5B-E6R1/04-pass-case.pdf

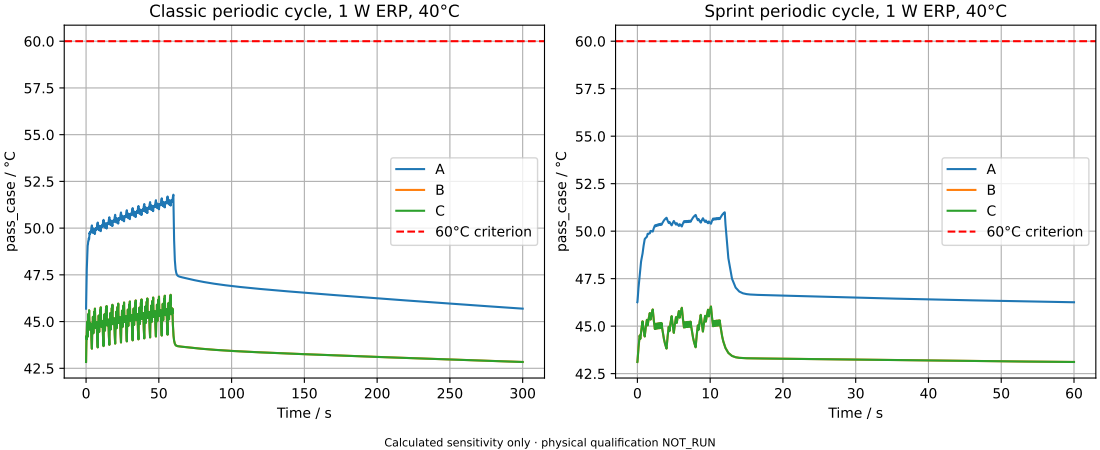
[picture p249: page 1]
Time / s; pass_case / °C; A B C 60°C criterion

Classic periodic cycle, 1 W ERP, 40°C

Sprint periodic cycle, 1 W ERP, 40°C

Calculated sensitivity only · physical qualification NOT_RUN
