DD1SB/ARDF-TX/hardware/2m/review/M5B-E6R1/08-ideal-keying-spectrum.pdf

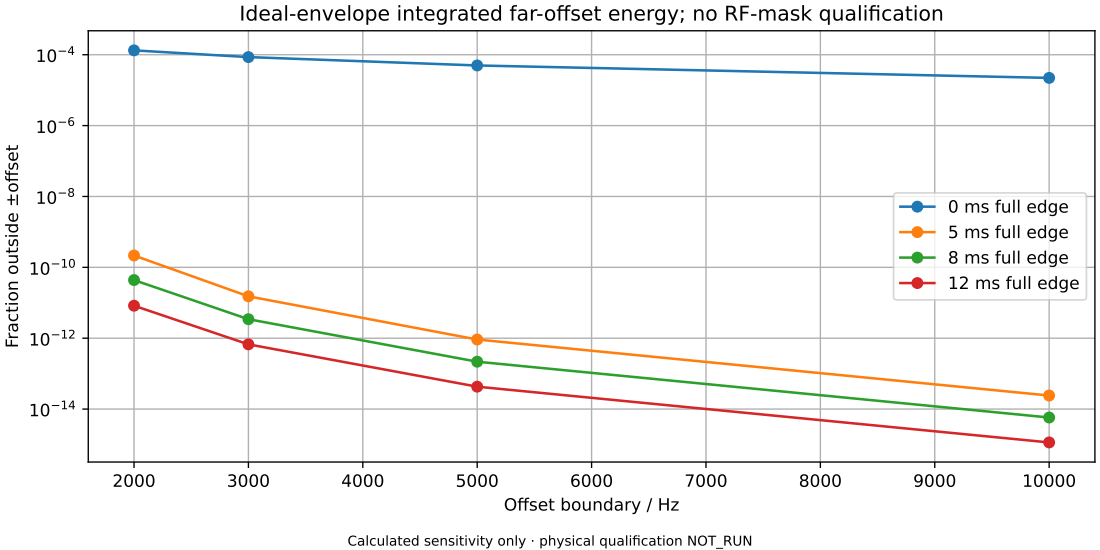
[picture p250: page 1]
Fraction outside ±o; ffset

Ideal-envelope integrated far-offset energy; no RF-mask qualification

0 ms full edge 5 ms full edge 8 ms full edge

12 ms full edge

Offset boundary / Hz

Calculated sensitivity only · physical qualification NOT_RUN
