DD1SB/ARDF-TX/hardware/2m/review/M5B-E6/transient-responses.pdf

70

80

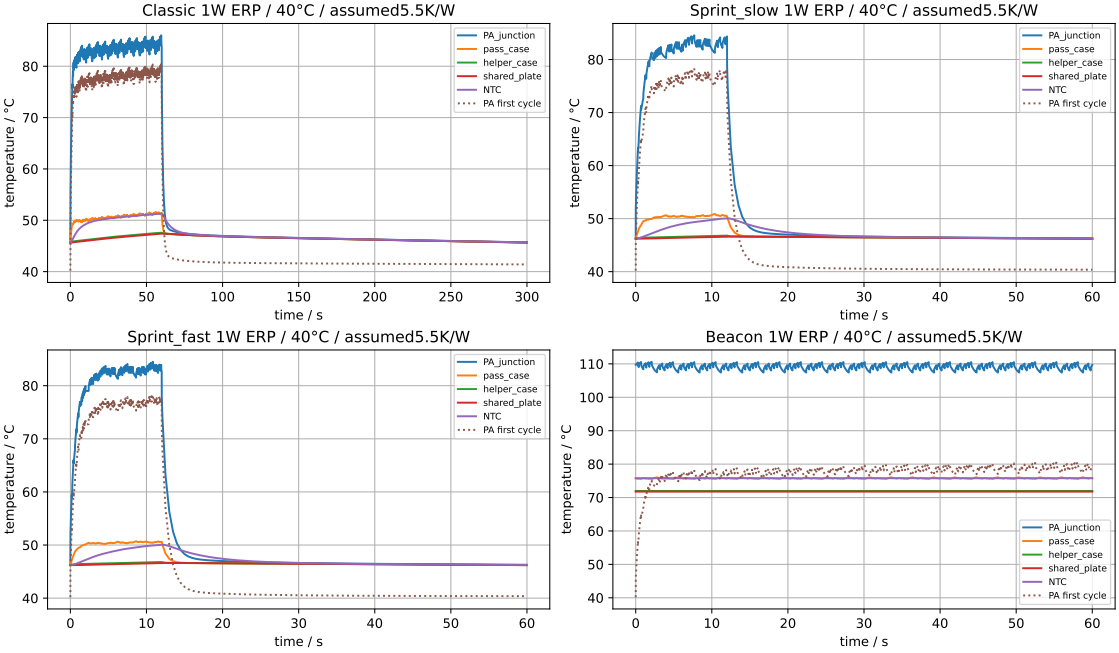
[picture p251: page 1]
time / s; temperature / °C; Classic 1W ERP / 40°C / assumed5.5K/W; PA_junction pass_case helper_case shared_plate NTC PA first cycle; Sprint_slow 1W ERP / 40°C / assumed5.5K/W; Sprint_fast 1W ERP / 40°C / assumed5.5K/W; Beacon 1W ERP / 40°C / assumed5.5K/W

PA_junction pass_case

helper_case shared_plate NTC PA first cycle

PA_junction
pass_case helper_case

shared_plate NTC PA first cycle
