DD1SB/ARDF-TX/hardware/controller/review/M6-L2/assembly-BASE-bottom.pdf

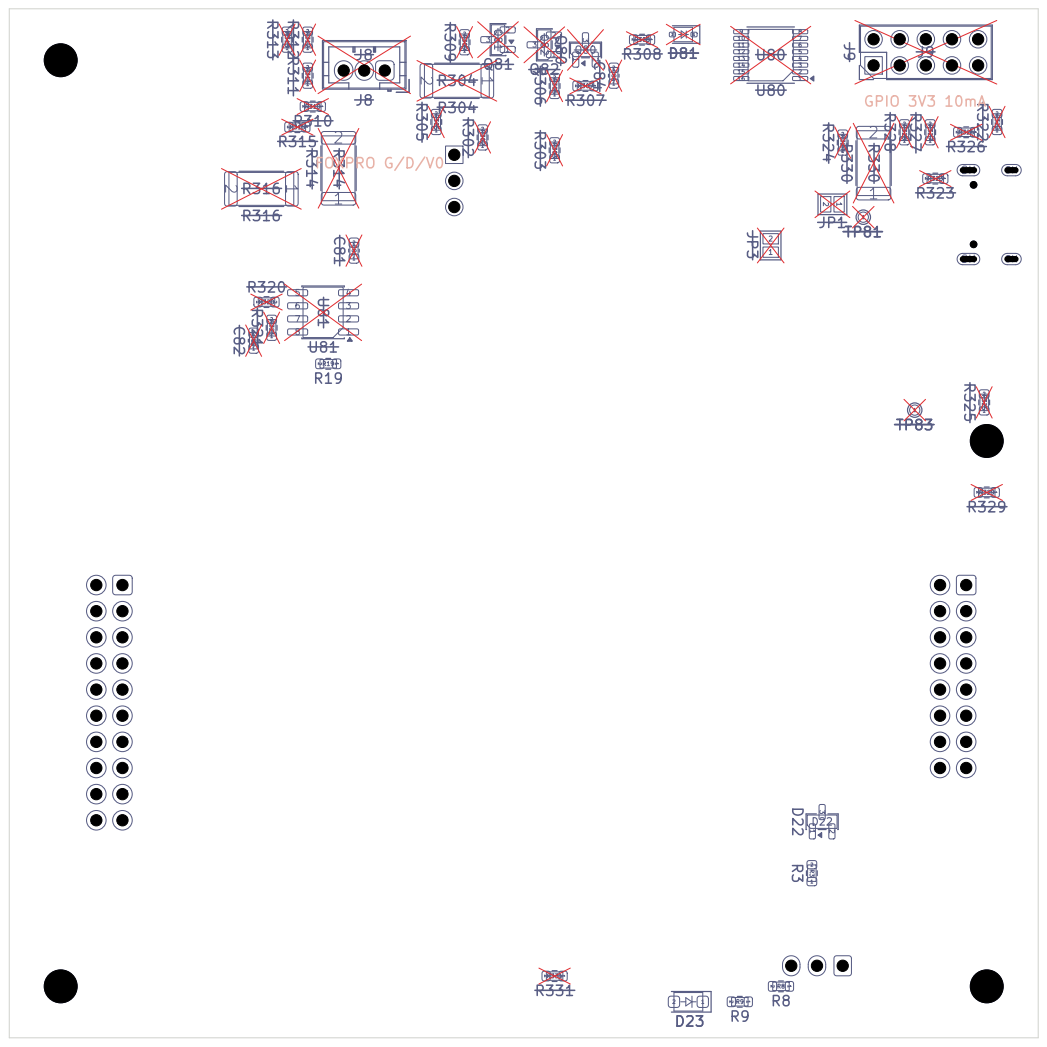
[picture p252: page 1]
