DD1SB/ARDF-TX/hardware/controller/review/M6-L2/assembly-BASE-top.pdf

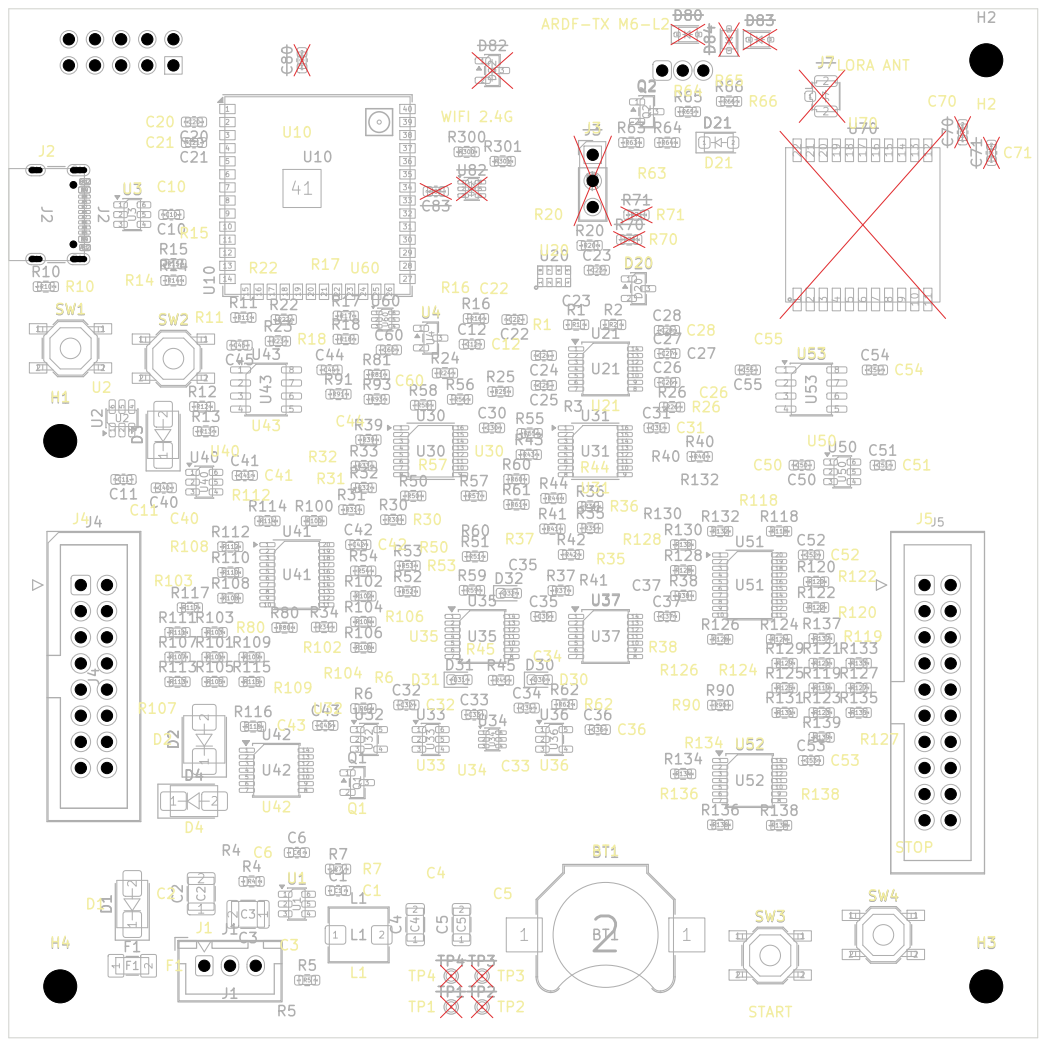
[picture p253: page 1]
