DD1SB/ARDF-TX/hardware/controller/review/M6-L2/assembly-BOTH-bottom.pdf

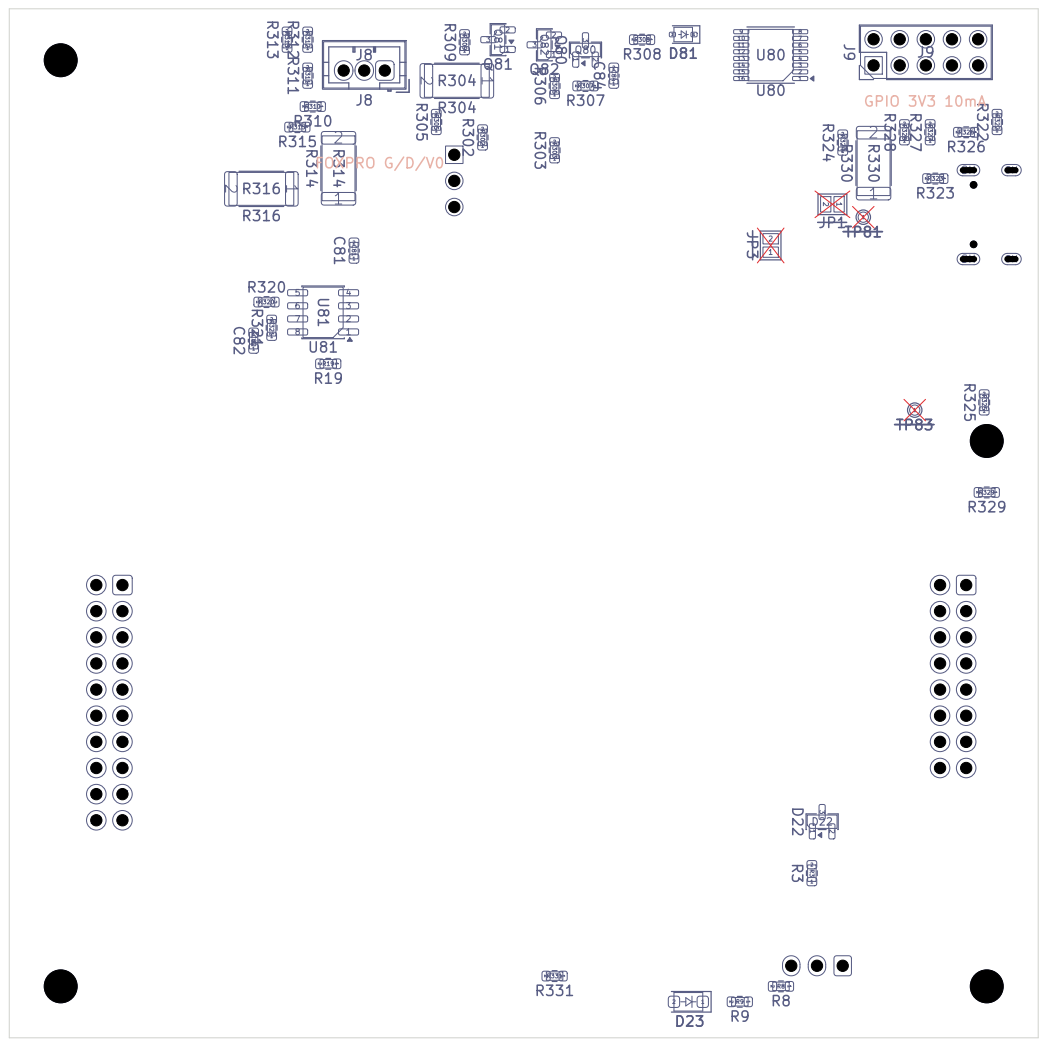
[picture p254: page 1]
