DD1SB/ARDF-TX/hardware/controller/review/M6-L2/assembly-BOTH-top.pdf

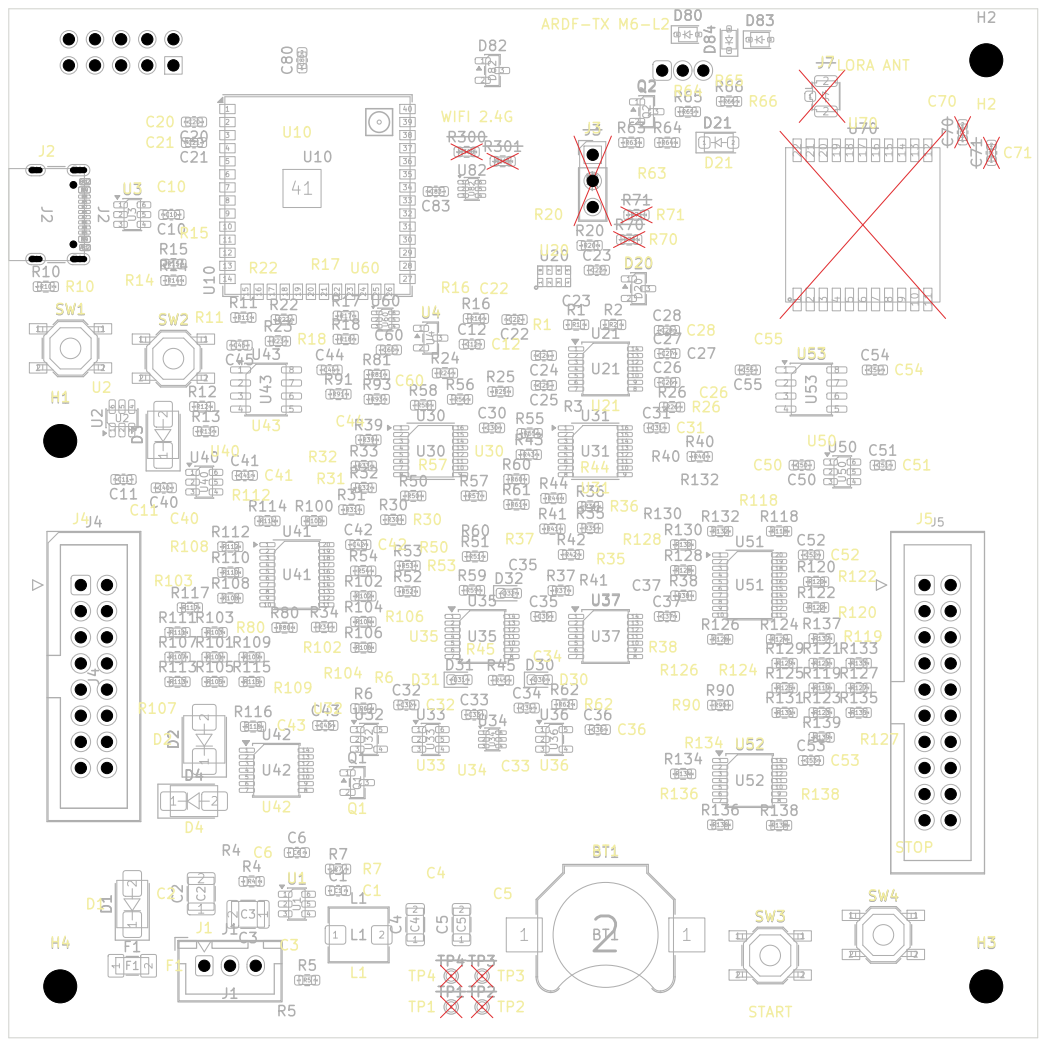
[picture p255: page 1]
