DD1SB/ARDF-TX/hardware/controller/review/M6-L2/assembly-bottom.pdf

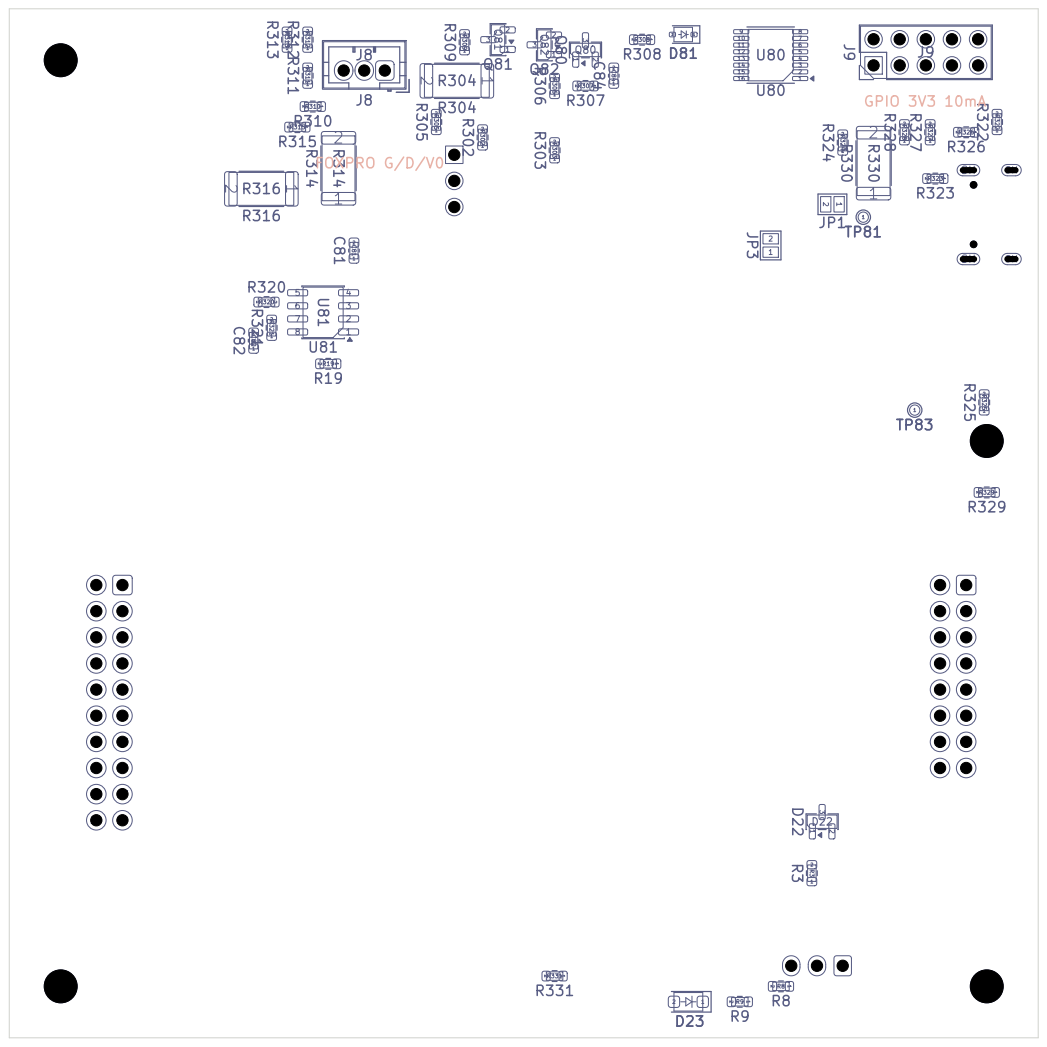
[picture p256: page 1]
