DD1SB/ARDF-TX/hardware/controller/review/M6-L2/assembly-FOXPRO-bottom.pdf

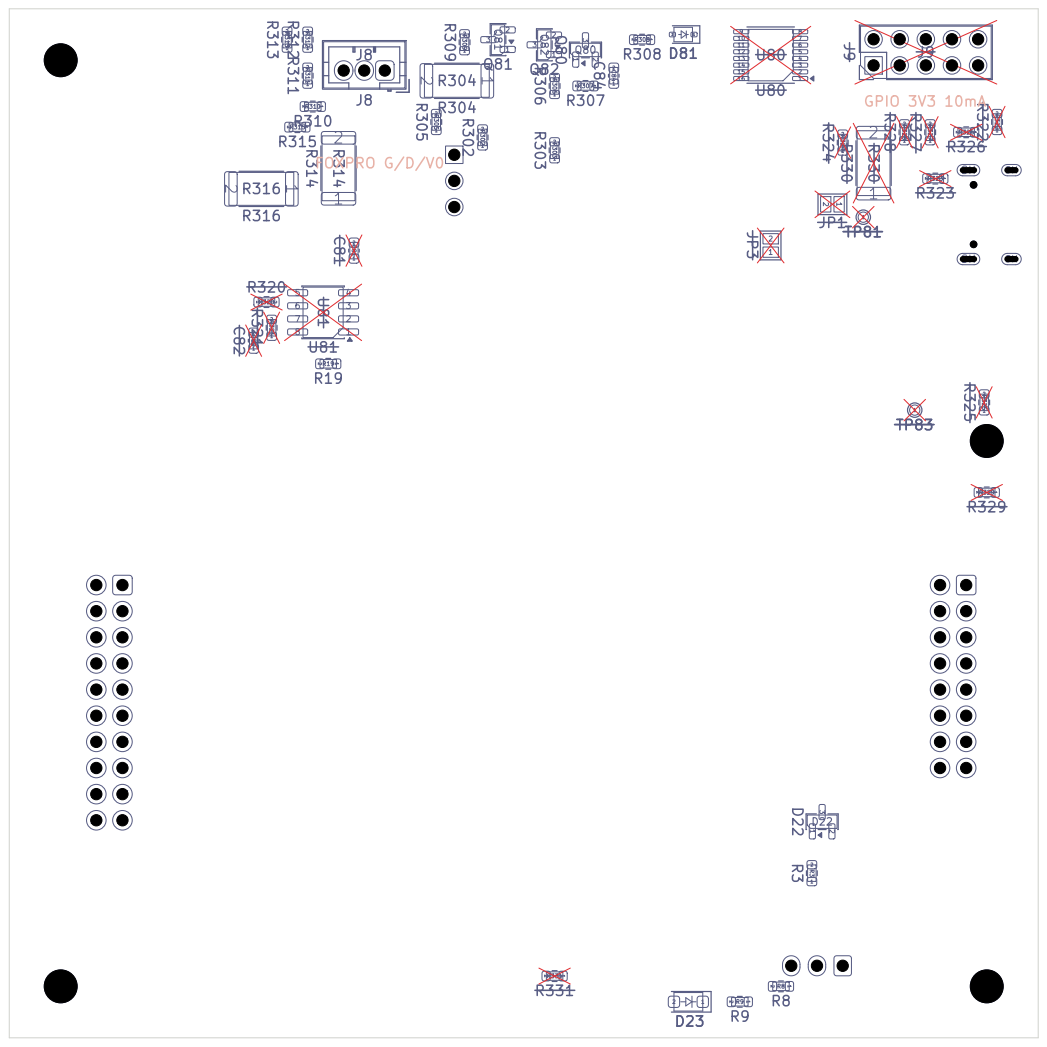
[picture p257: page 1]
