DD1SB/ARDF-TX/hardware/controller/review/M6-L2/assembly-FOXPRO-top.pdf

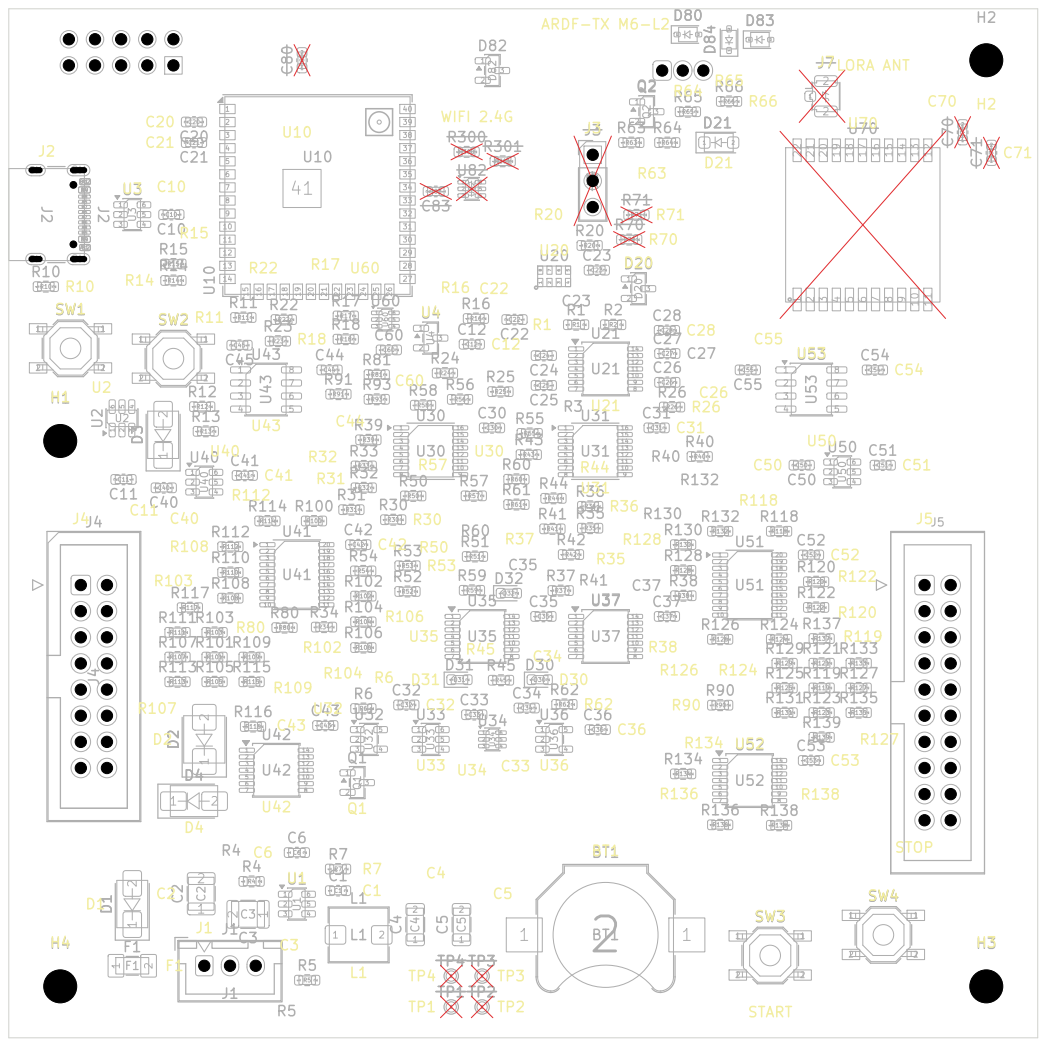
[picture p258: page 1]
