DD1SB/ARDF-TX/hardware/controller/review/M6-L2/assembly-GPIO-bottom.pdf

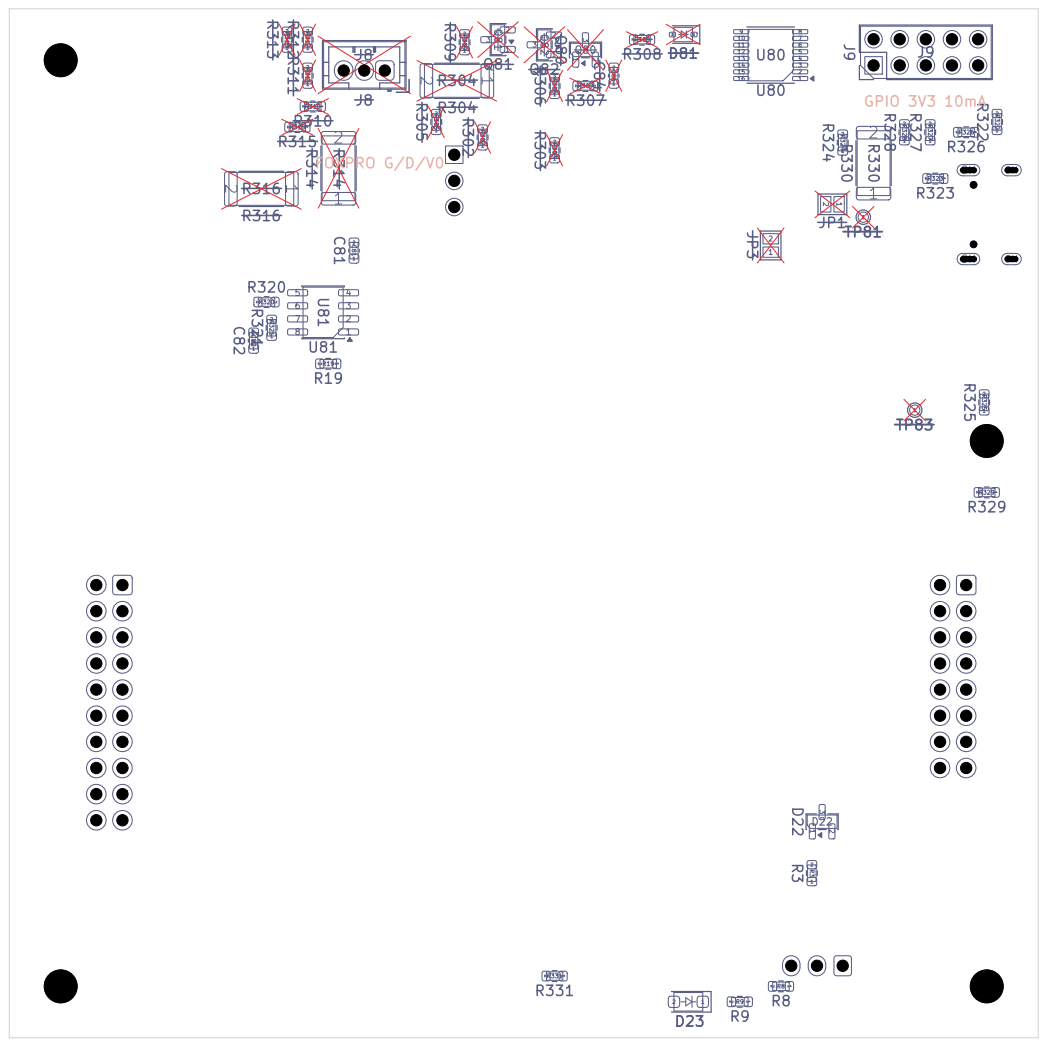
[picture p259: page 1]
