DD1SB/ARDF-TX/hardware/2m/review/M5B-E5/assembly-BOOST2S.pdf

TRAIN uW MMCX NORMAL 50R SMA C713

J701 REVIEW ONLY / NOT RELEASED
