DD1SB/ARDF-TX/hardware/2m/review/M5B-E6R2/mechanical/carrier-stack.pdf

E6R2 carrier stack

Dimensioned solids; fin/plastic detail simplified; not physical qualification
