DD1SB/ARDF-TX/hardware/2m/review/M5B-E6R2/mechanical/complete-isometric.pdf

E6R2 complete isometric

Dimensioned solids; fin/plastic detail simplified; not physical qualification
