DD1SB/ARDF-TX/hardware/2m/review/M5B-E6R2/mechanical/exploded-cooling.pdf

E6R2 exploded cooling

Dimensioned solids; fin/plastic detail simplified; not physical qualification
