DD1SB/ARDF-TX/hardware/2m/review/M5B-E6R2/mechanical/underside.pdf

E6R2 underside

Dimensioned solids; fin/plastic detail simplified; not physical qualification
