DD1SB/ARDF-TX/hardware/2m/review/M5B-E6R2/simulation/BUCK4S-beta60-fault-8ms.cir

* E6R2 native-value transient, BUCK4S, BFpass60, fault, edge0.008s
* TI model per-amplifier family proxy: not a package-coupling model.
.include /tmp/m5b-e6r2/references/tlv9002.lib
.options reltol=.002 abstol=1n vntol=10u method=gear
Vlogic V3V3 0 3.3
Vconv vsource 0 8.9996
Rconv vsource vreg .12
Lfeed vreg vreg_l 100n
Creservoir vreg_l 0 44u
Vfault EXTERNAL_FAULT 0 PWL(0 0 .384999 0 .385 3.3 .5 3.3)
* Behavioral proxy of native INA180/LM339 and asynchronous fault latch.
*10us detector RC is a sensitivity assumption, not a measured delay guarantee.
BCURRENT raw_current_fault 0 V=if(v(VREG_SWITCH,VMOD)>.122196,3.3,0)
Rdelay raw_current_fault current_fault_delay 10k
Cdelay current_fault_delay 0 1n
BLATCH latch_drive 0 V=if(v(current_fault_delay)>1.65 || v(FAULT_LATCH)>1.65,3.3,0)
Rlatch latch_drive FAULT_LATCH 1k
Clatch FAULT_LATCH 0 1n
BEMERGENCY NORMAL_OFF 0 V=if(v(EXTERNAL_FAULT)>1.65 || v(FAULT_LATCH)>1.65,3.3,0)
Vkey KEY 0 PWL(0.000000000 0 0.013999900 0 0.014000000 3.3 0.104099900 3.3 0.104100000 0 0.173999900 0 0.174000000 3.3 0.264099900 3.3 0.264100000 0 0.333999900 0 0.334000000 3.3 0.424099900 3.3 0.424100000 0 0.500000000 0)
BkeyN KEY_N 0 V=3.3-v(KEY)
Boff LOCAL_MOD_OFF 0 V=if(v(NORMAL_OFF)>1.65 || v(KEY_N)>1.65,3.3,0)
Bdriver DRIVER_ON 0 V=3.3-v(LOCAL_MOD_OFF)
Smain vreg_l VREG_SWITCH V3V3 NORMAL_OFF SWMAIN
.model SWMAIN SW(Ron=.03 Roff=1G Vt=1.65 Vh=.05)
R309 VREG_SWITCH VMOD 0.068
C635 VMOD 0 1u
C306 VMOD 0 100n
C307 VMOD 0 100n
* Prepared independent driver regulators, reservoir upstream of U305.
Vdriver drvsource 0 5
Rdriver drvsource VDRV_FILTER .12
C409 VDRV_FILTER 0 150u
S305 VDRV_FILTER VDRV_MMIC DRIVER_ON 0 SWDRV
.model SWDRV SW(Ron=.079 Roff=1G Vt=1.65 Vh=.05)
C603 VDRV_MMIC 0 100n
C604 VDRV_MMIC 0 1n
Bmmic VDRV_MMIC 0 I=.1463*max(v(VDRV_MMIC),0)/5
Bqod VDRV_MMIC 0 I=if(v(DRIVER_ON)<1.65,v(VDRV_MMIC)/120,0)
* Existing slot-qualified gate-bias clamp remains independent of MorseKEY.
R606 VMOD BIAS_TOP 1k
D501 0 BIAS_TOP DBIAS
.model DBIAS D(IS=1p N=1 BV=6.2 IBV=5m)
Rpot_top BIAS_TOP BIAS_WIPER 7k
Rpot_bottom BIAS_WIPER 0 3k
C607 BIAS_WIPER 0 100n
L606 BIAS_WIPER PA_GATE_DC 33n
Cgate PA_GATE_DC 0 80p
M502 BIAS_WIPER NORMAL_OFF 0 0 NCLAMP
.model NCLAMP NMOS(LEVEL=1 VTO=1.5 KP=.1 RD=1 RS=1)
* Actual divider thresholds;3us typical comparator pole is a scenario.
R971 VPA VPA_READY_S 100k
R972 VPA_READY_S 0 33k
R973 V3V3 VPA_READY_REF 330k
R974 VPA_READY_REF 0 2.49k
R975 VDRV_MMIC DRV_READY_S 100k
R976 DRV_READY_S 0 33k
R977 V3V3 DRV_READY_REF 19.1k
R978 DRV_READY_REF 0 10k
BVREADY vr_raw 0 V=if(v(VPA_READY_S)>v(VPA_READY_REF),3.3,0)
Rvr vr_raw VPA_READY 3k
Cvr VPA_READY 0 1n
BDREADY dr_raw 0 V=if(v(DRV_READY_S)>v(DRV_READY_REF),3.3,0)
Rdr dr_raw DRV_READY 3k
Cdr DRV_READY 0 1n
BCLOCK CLOCK_OFF 0 V=if(v(LOCAL_MOD_OFF)>1.65 || v(VPA_READY)<1.65 || v(DRV_READY)<1.65,3.3,0)
Vaf AF_PWM 0 PWL(0.000000000 0 0.000025000 0 0.000050000 0 0.000075000 0 0.000100000 0 0.000125000 0 0.000150000 0 0.000175000 0 0.000200000 0 0.000225000 0 0.000250000 0 0.000275000 0 0.000300000 0 0.000325000 0 0.000350000 0 0.000375000 0 0.000400000 0 0.000425000 0 0.000450000 0 0.000475000 0 0.000500000 0 0.000525000 0 0.000550000 0 0.000575000 0 0.000600000 0 0.000625000 0 0.000650000 0 0.000675000 0 0.000700000 0 0.000725000 0 0.000750000 0 0.000775000 0 0.000800000 0 0.000825000 0 0.000850000 0 0.000875000 0 0.000900000 0 0.000925000 0 0.000950000 0 0.000975000 0 0.001000000 0 0.001025000 0 0.001050000 0 0.001075000 0 0.001100000 0 0.001125000 0 0.001150000 0 0.001175000 0 0.001200000 0 0.001225000 0 0.001250000 0 0.001275000 0 0.001300000 0 0.001325000 0 0.001350000 0 0.001375000 0 0.001400000 0 0.001425000 0 0.001450000 0 0.001475000 0 0.001500000 0 0.001525000 0 0.001550000 0 0.001575000 0 0.001600000 0 0.001625000 0 0.001650000 0 0.001675000 0 0.001700000 0 0.001725000 0 0.001750000 0 0.001775000 0 0.001800000 0 0.001825000 0 0.001850000 0 0.001875000 0 0.001900000 0 0.001925000 0 0.001950000 0 0.001975000 0 0.002000000 0 0.002025000 0 0.002050000 0 0.002075000 0 0.002100000 0 0.002125000 0 0.002150000 0 0.002175000 0 0.002200000 0 0.002225000 0 0.002250000 0 0.002275000 0 0.002300000 0 0.002325000 0 0.002350000 0 0.002375000 0 0.002400000 0 0.002425000 0 0.002450000 0 0.002475000 0 0.002500000 0 0.002525000 0 0.002550000 0 0.002575000 0 0.002600000 0 0.002625000 0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
