DD1SB/ARDF-TX/hardware/2m/RF2M.kicad_pcb

## KiCad design hardware/2m/RF2M.kicad_pcb (2026-10-21)

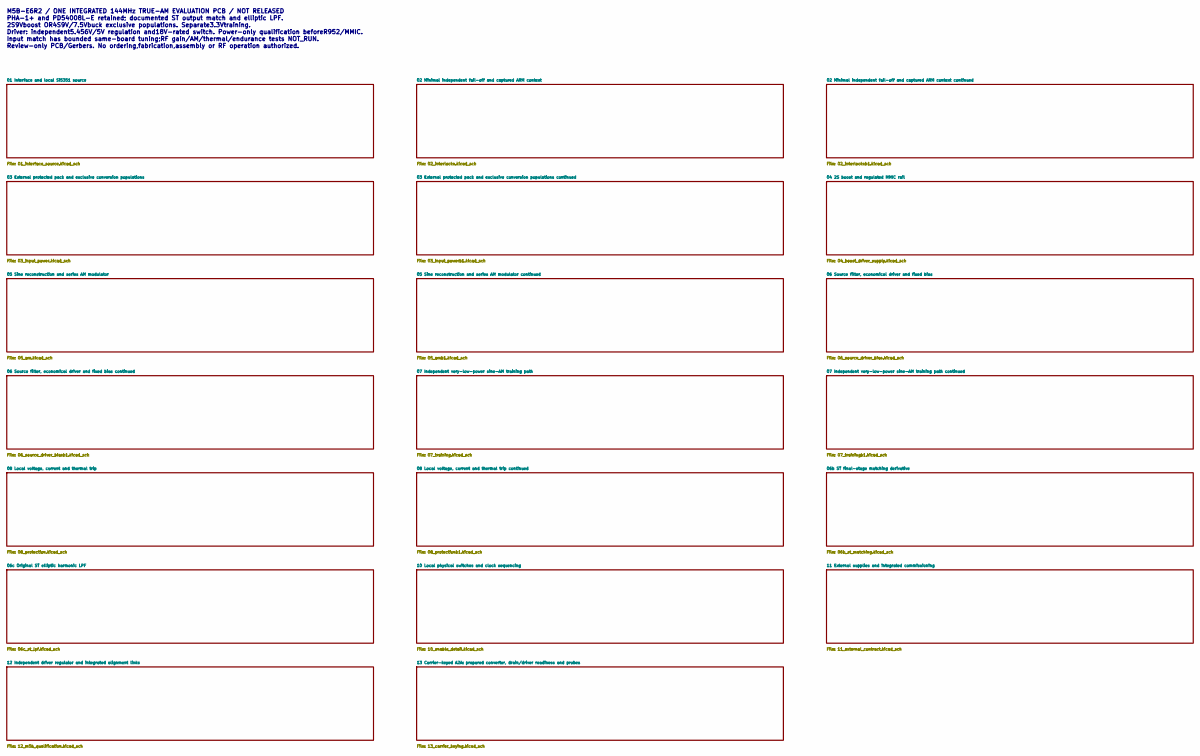
[picture p260: schematic RF2M.kicad_sch, ARDF-TX 2 m A2A evaluation schematic]

Notes on the sheet:
M5B-E6R2 / ONE INTEGRATED 144MHz TRUE-AM EVALUATION PCB / NOT RELEASED PHA-1+ and PD54008L-E retained; documented ST output match and elliptic LPF. 2S9Vboost OR4S9V/7.5Vbuck exclusive populations. Separate3.3Vtraining. Driver: independent5.456V/5V regulation and18V-rated switch. Power-only qualific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

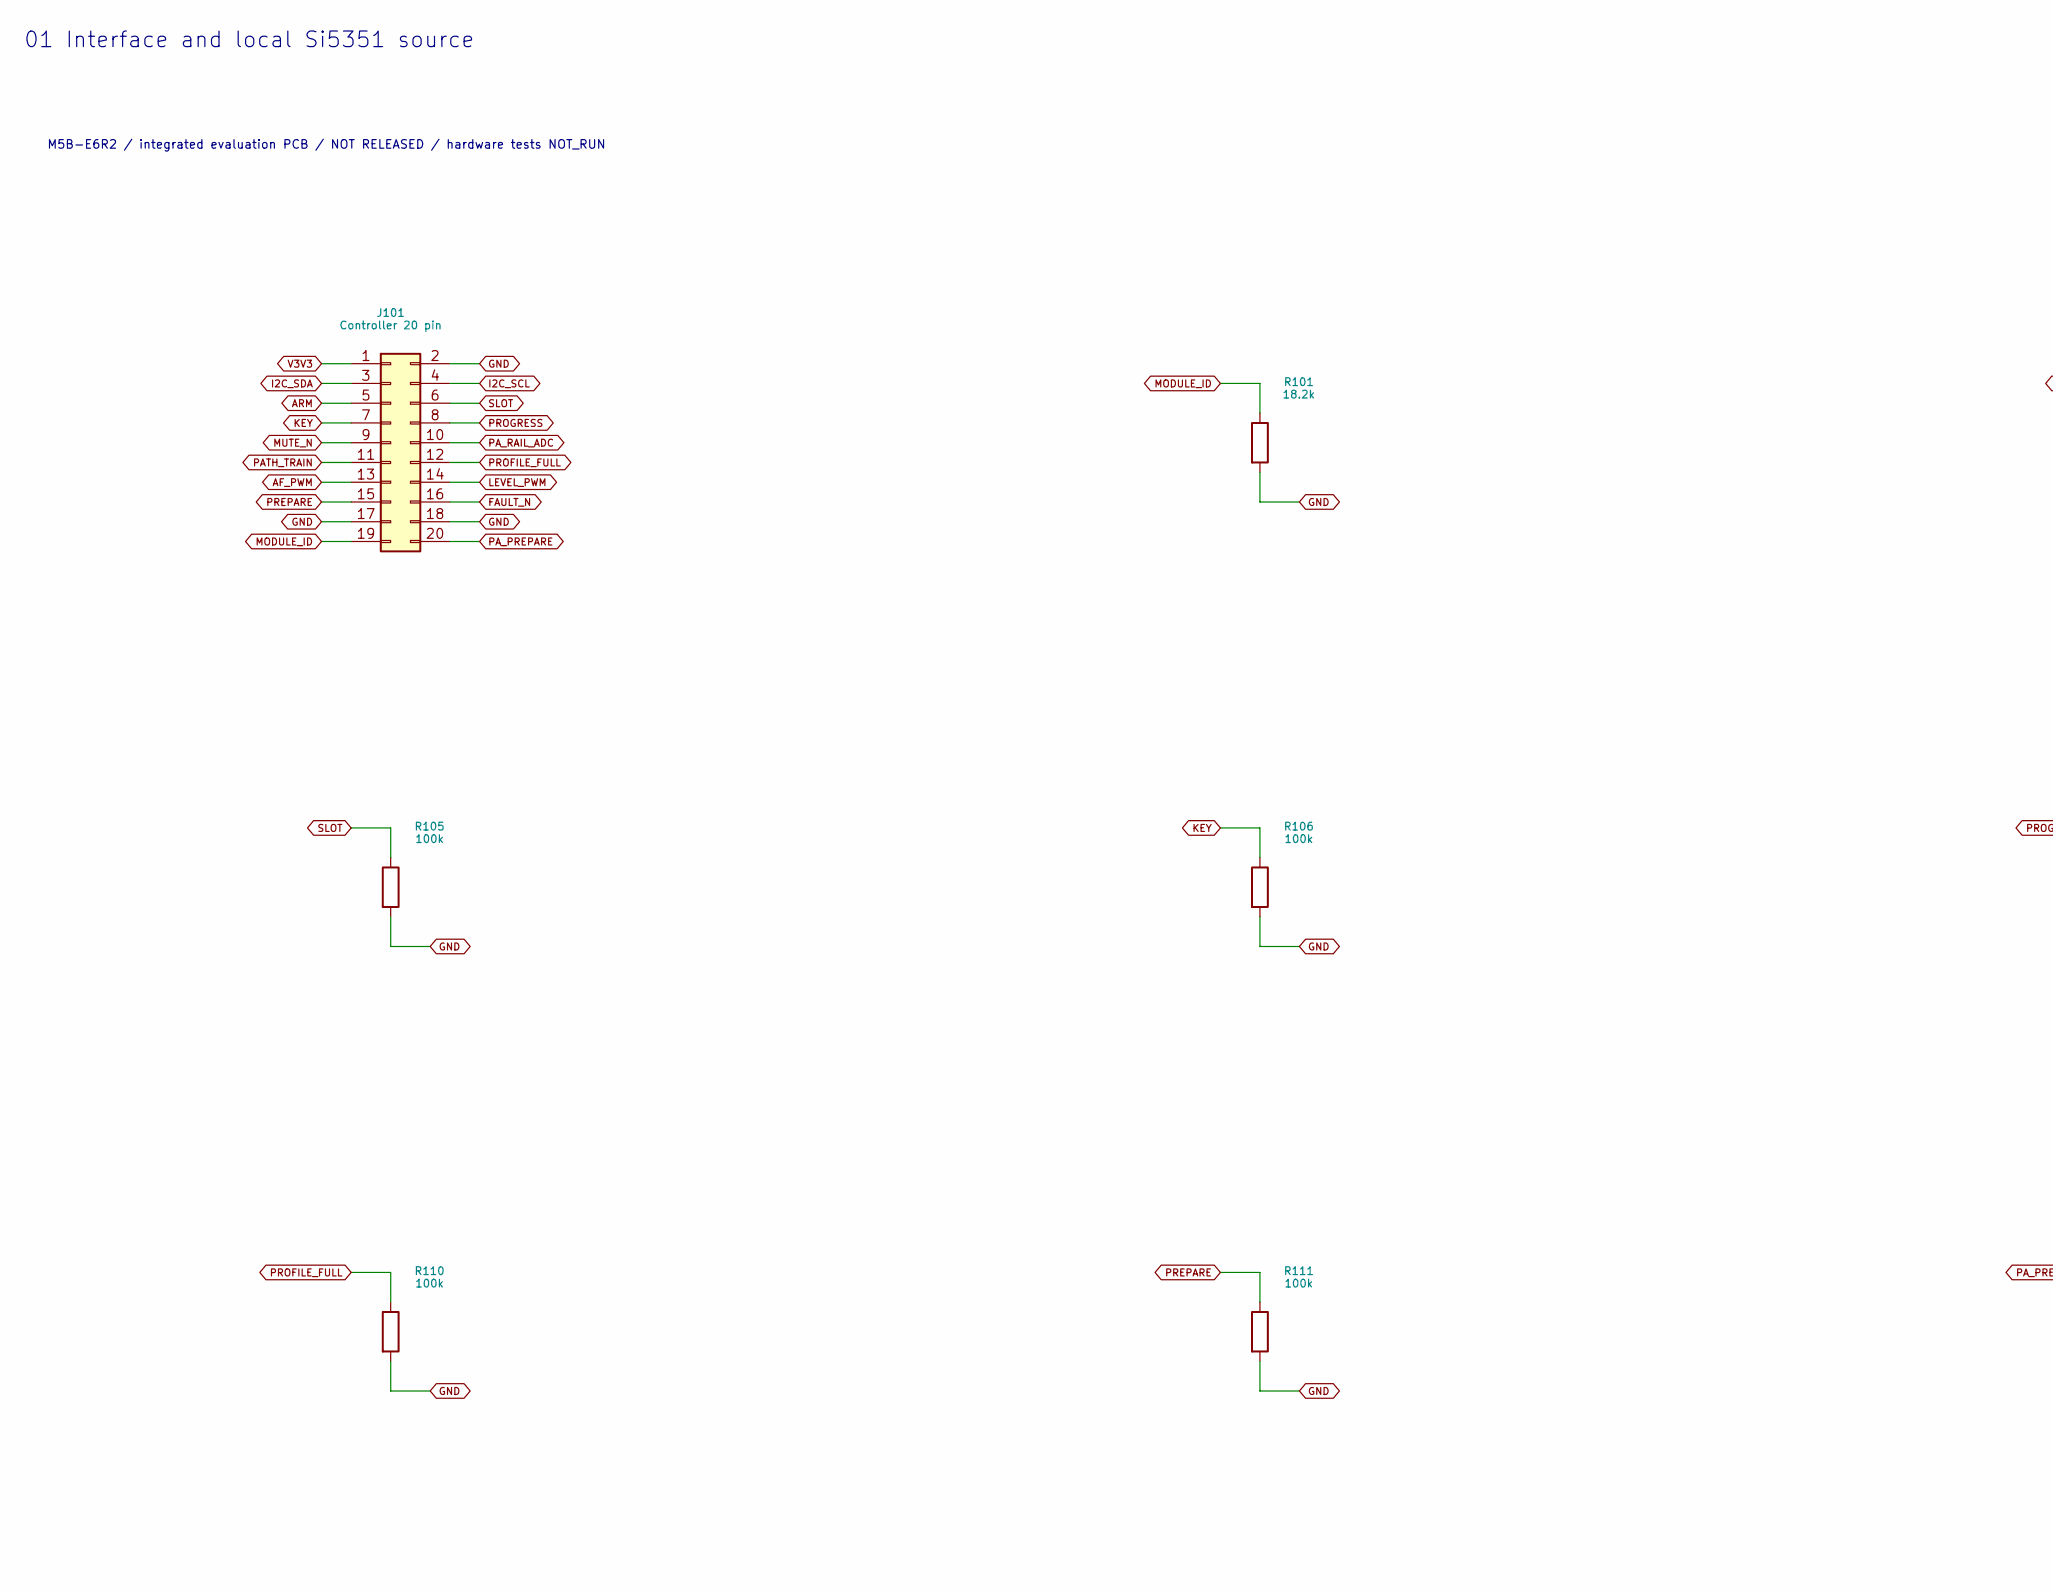
[picture p261: schematic 01_interface_source.kicad_sch, 01 Interface and local Si5351 source, part in row 1, column 1]

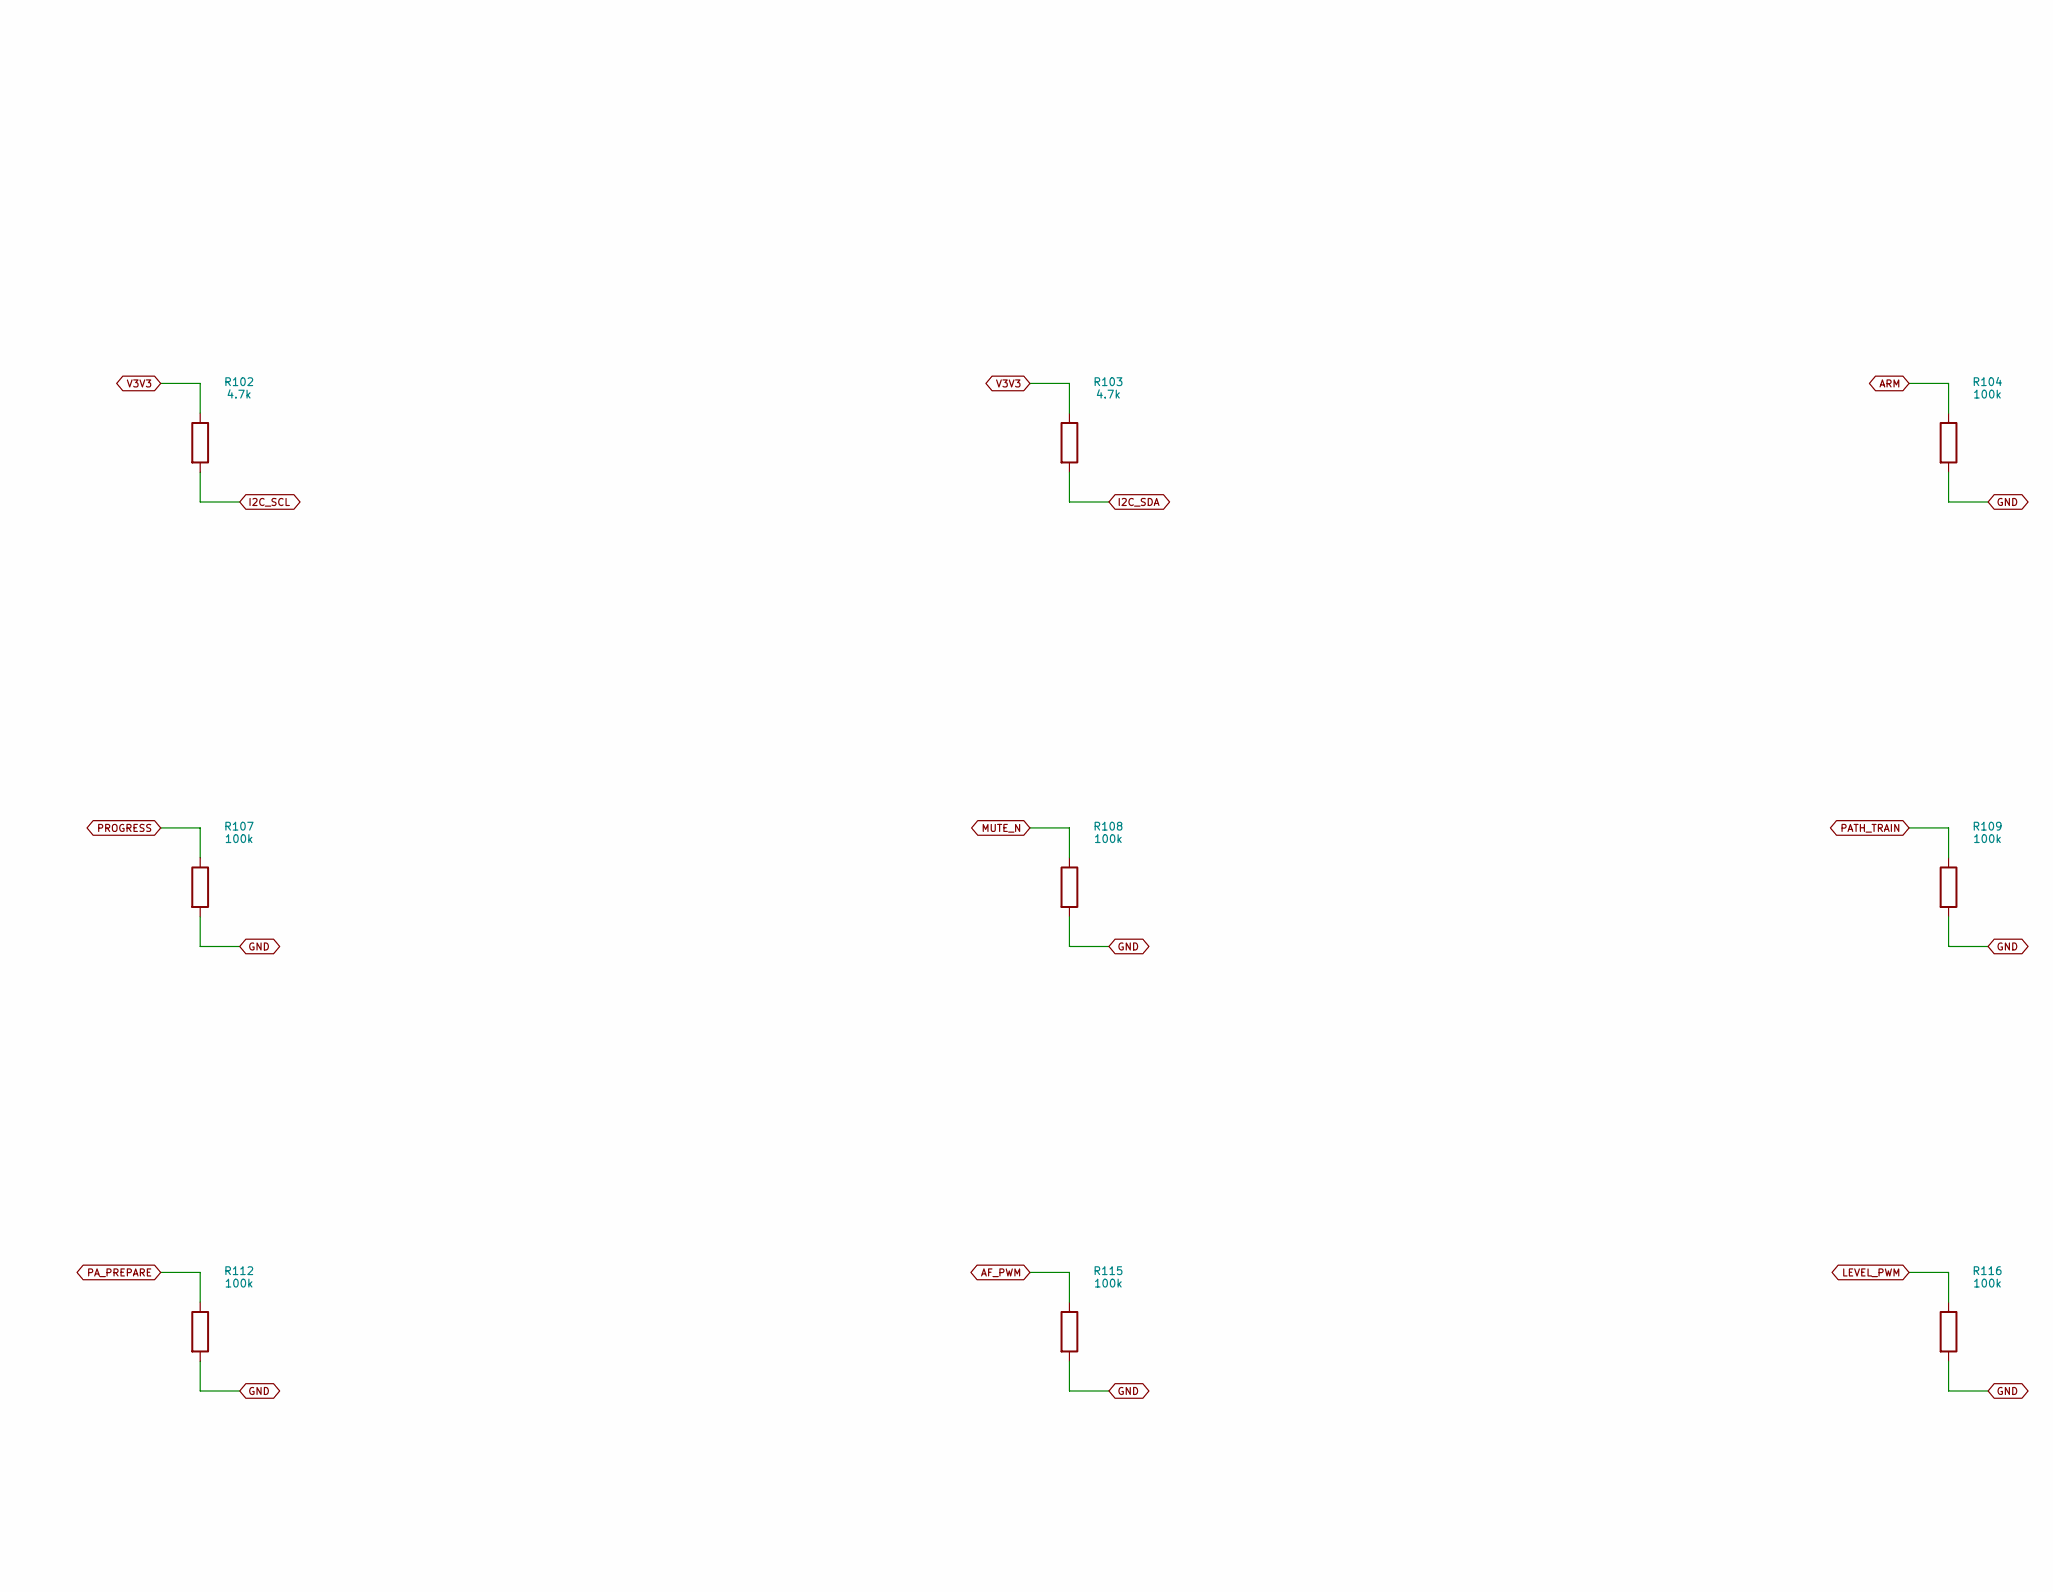
[picture p262: schematic 01_interface_source.kicad_sch, 01 Interface and local Si5351 source, part in row 1, column 2]

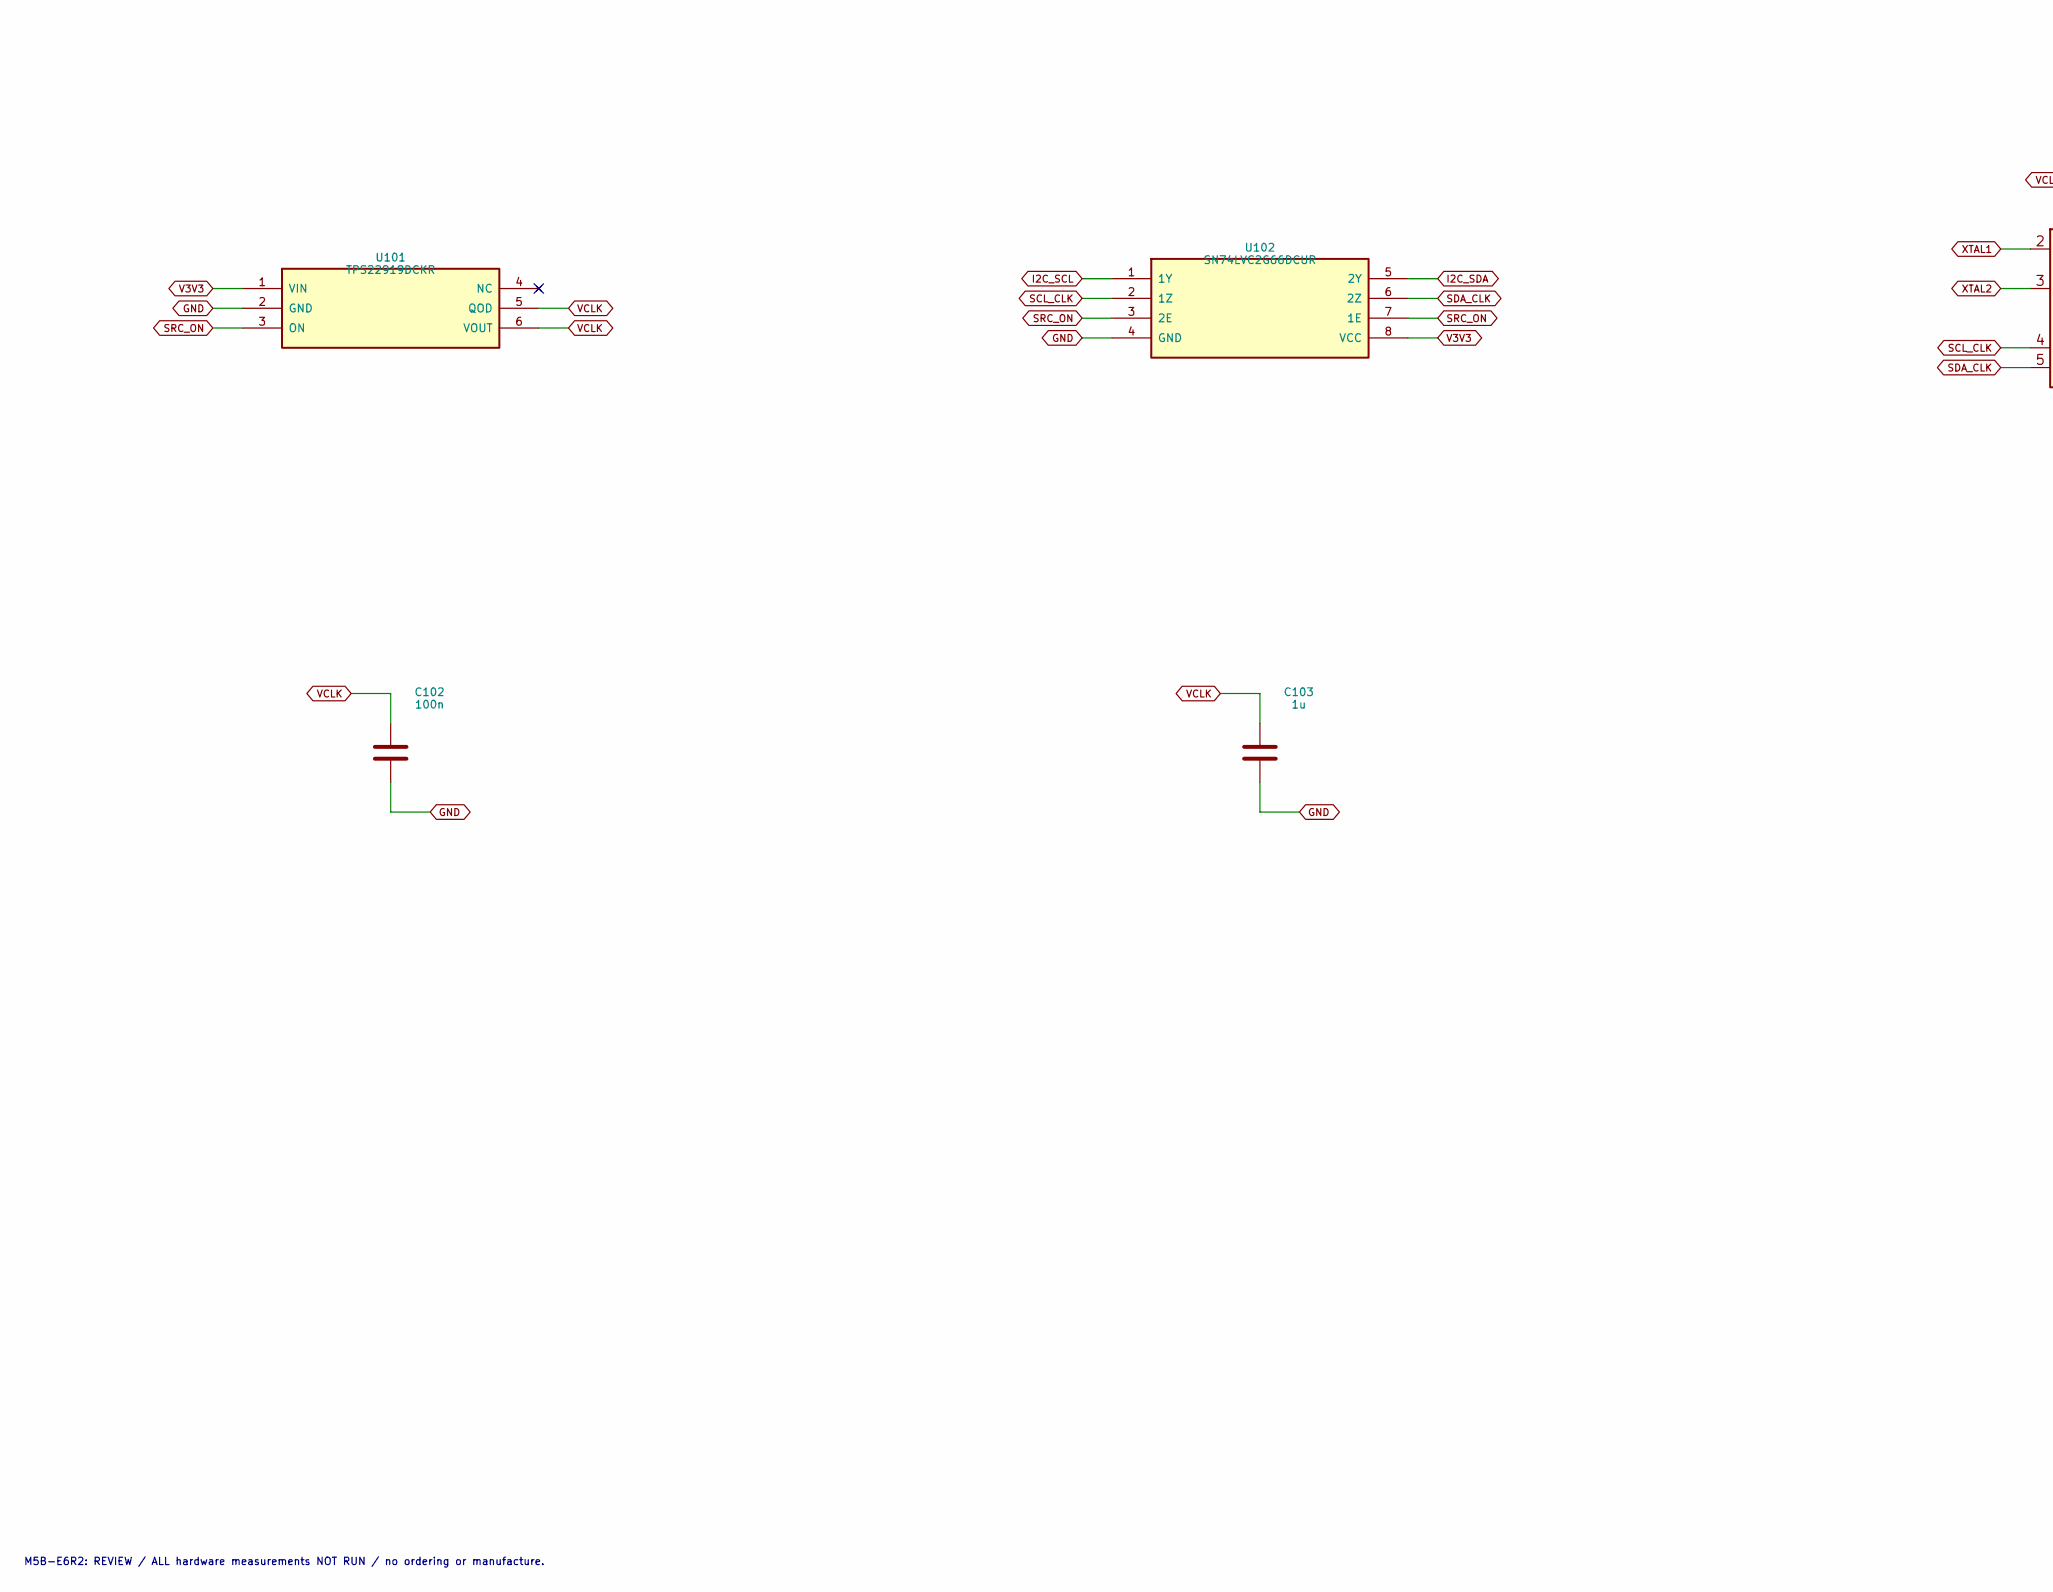
[picture p263: schematic 01_interface_source.kicad_sch, 01 Interface and local Si5351 source, part in row 2, column 1]

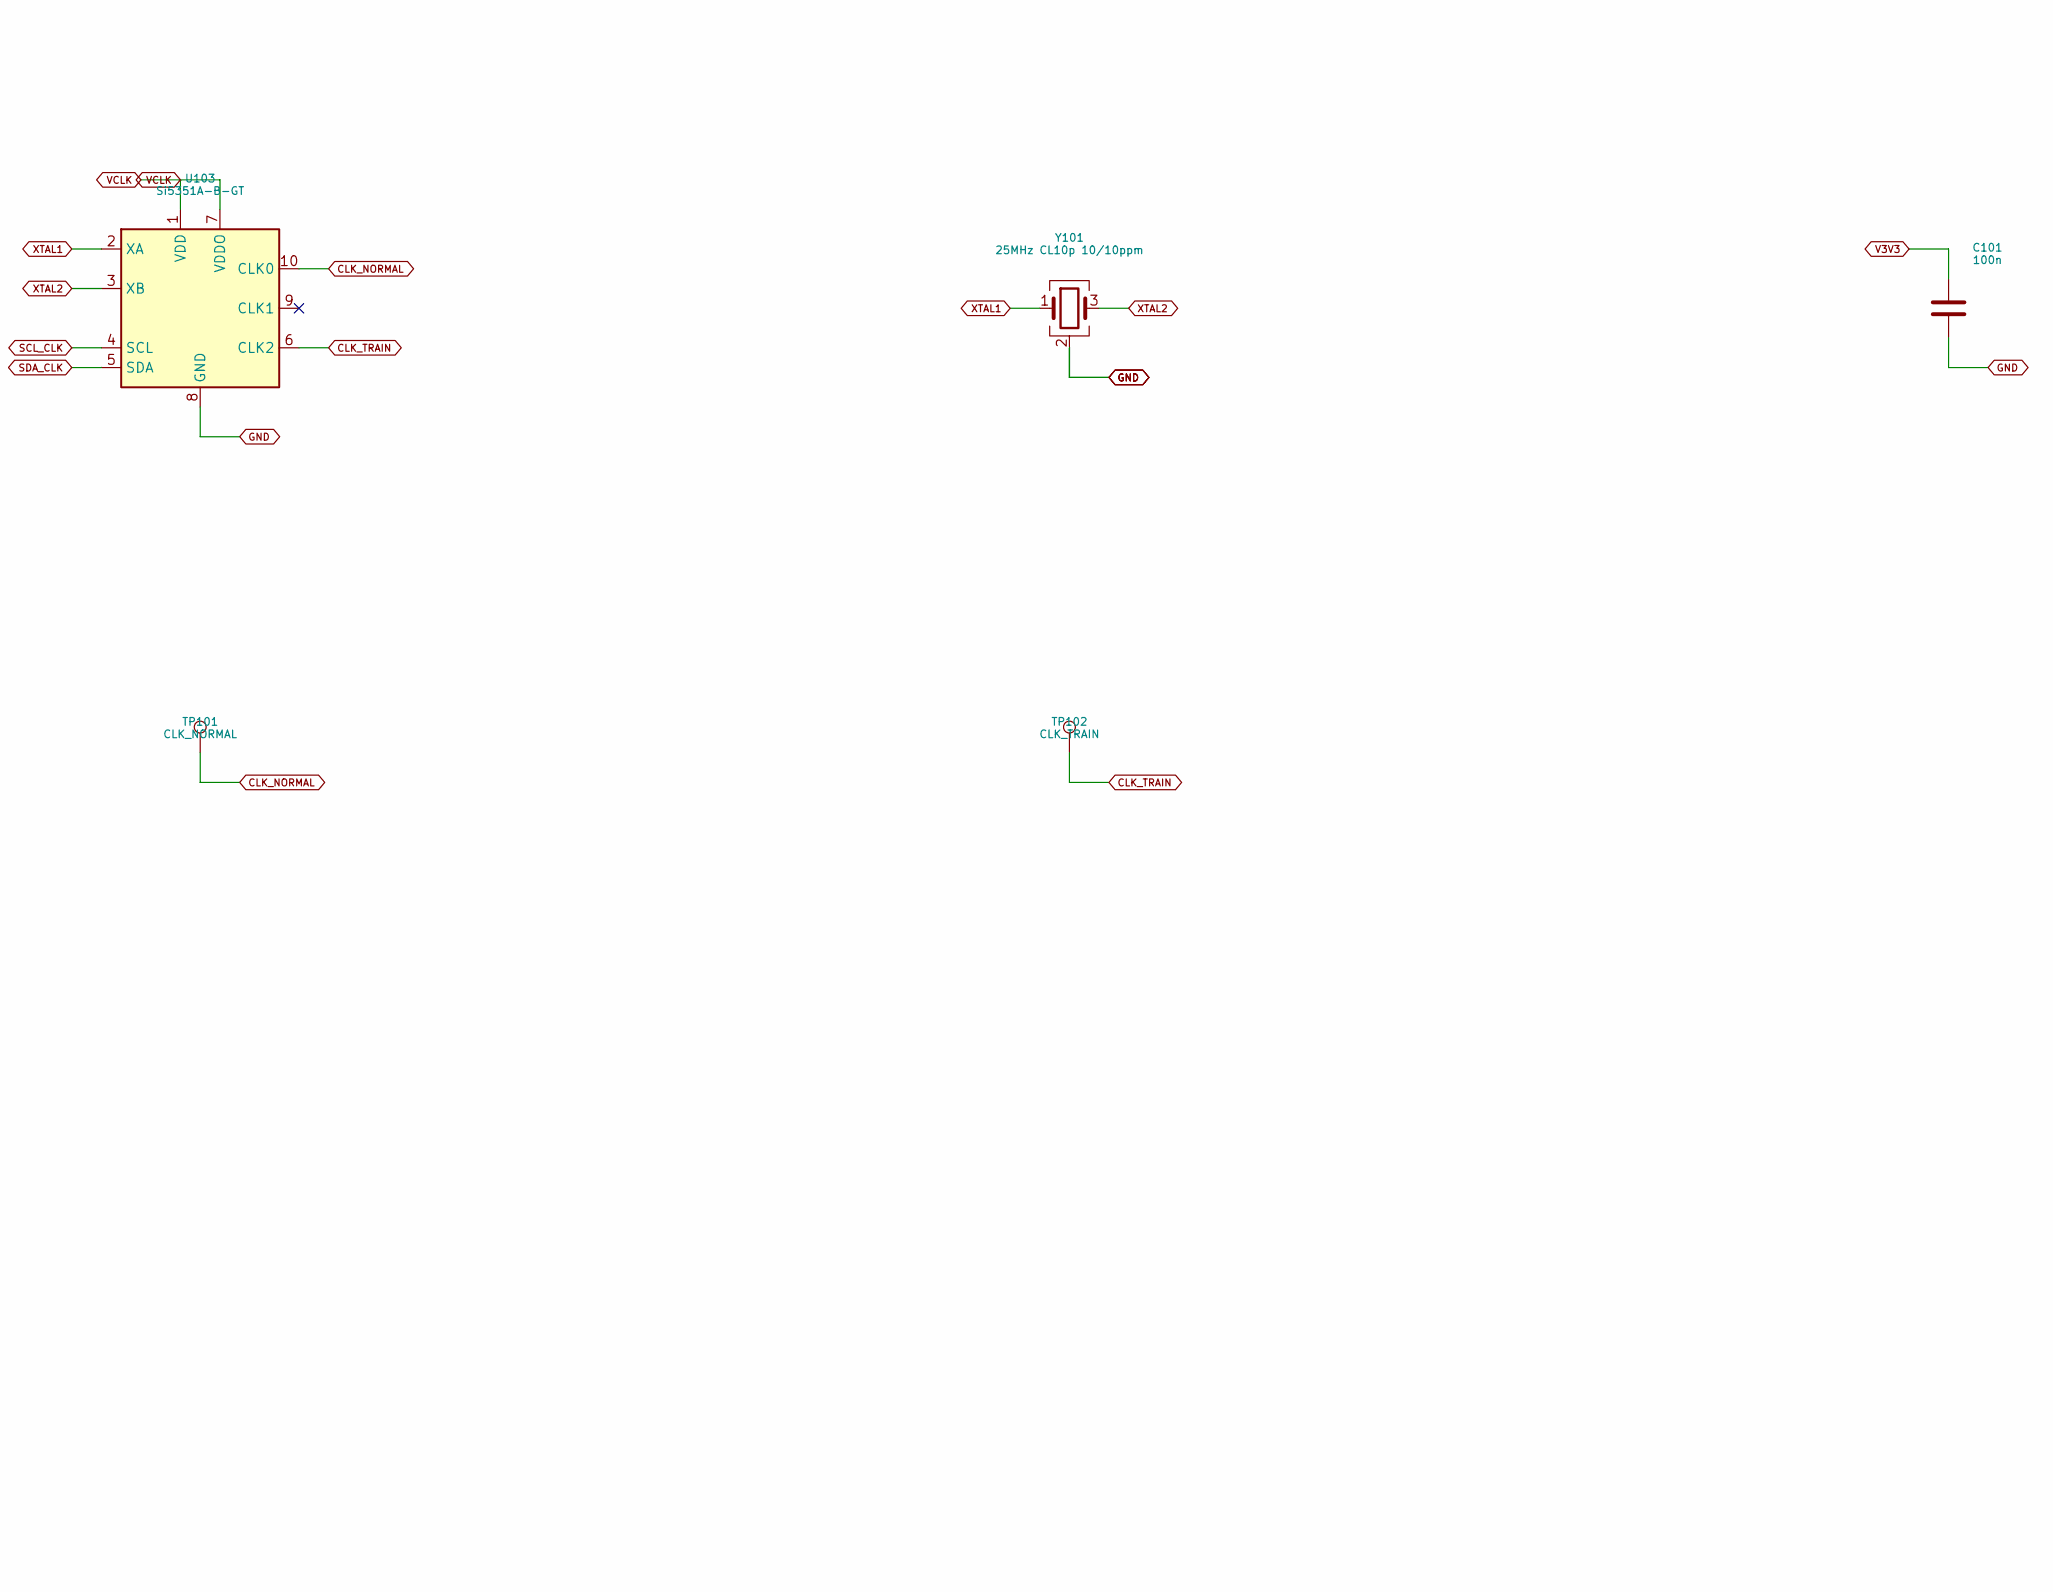
[picture p264: schematic 01_interface_source.kicad_sch, 01 Interface and local Si5351 source, part in row 2, column 2]

Parts:
C101, C102: 100n; C_0603_1608Metric_E3; MPN CC0603KRX7R8BB104
C103: 1u; C_0805_2012Metric_E3; MPN CC0805KKX7R9BB105
J101: Controller 20 pin; WR_BHD_61202021621; MPN 61202021621
R101: 18.2k; R_0603_1608Metric_E3; MPN RC0603FR-0718K2L
R102, R103: 4.7k; R_0603_1608Metric_E3; MPN RC0603FR-074K7L
R104, R105, R106, R107, R108, R109, R110, R111, R112, R115, R116: 100k; R_0603_1608Metric_E3; MPN RC0603FR-07100KL
TP101: CLK_NORMAL; TestPoint_Pad_D1.0mm_E3; MPN PCB feature
TP102: CLK_TRAIN; TestPoint_Pad_D1.0mm_E3; MPN PCB feature
U101: TPS22919DCKR; SOT-363_SC-70-6_E3; MPN TPS22919DCKR
U102: SN74LVC2G66DCUR; VSSOP-8_2.3x2mm_P0.5mm_E3; MPN SN74LVC2G66DCUR
U103: Si5351A-B-GT; MSOP-10_3x3mm_P0.5mm_E3; MPN Si5351A-B-GT
Y101: 25MHz CL10p 10/10ppm; Crystal_SMD_3225-4Pin_3.2x2.5mm_E3; MPN ABM8-25.000MHZ-10-B1U-T

Connections:
AF_PWM: J101.13, R115.1; also elsewhere on the board
ARM: J101.5, R104.1; also elsewhere on the board
CLK_NORMAL: TP101.1, U103.10 (CLK0); also elsewhere on the board
CLK_TRAIN: TP102.1, U103.6 (CLK2); also elsewhere on the board
FAULT_N: J101.16; also elsewhere on the board
GND: C101.2, C102.2, C103.2, J101.2, J101.17, J101.18, R101.2, R104.2, R105.2, R106.2, R107.2, R108.2, R109.2, R110.2, R111.2, R112.2, R115.2, R116.2, U101.2 (GND), U102.4 (GND), U103.8 (GND), Y101.2 (G), Y101.4 (G); also elsewhere on the board
I2C_SCL: J101.4, R102.2, U102.1 (1Y); also elsewhere on the board
I2C_SDA: J101.3, R103.2, U102.5 (2Y)
KEY: J101.7, R106.1; also elsewhere on the board
LEVEL_PWM: J101.14, R116.1; also elsewhere on the board
MODULE_ID: J101.19, R101.1
MUTE_N: J101.9, R108.1; also elsewhere on the board
PATH_TRAIN: J101.11, R109.1; also elsewhere on the board
PA_PREPARE: J101.20, R112.1; also elsewhere on the board
PA_RAIL_ADC: J101.10; also elsewhere on the board
PREPARE: J101.15, R111.1; also elsewhere on the board
PROFILE_FULL: J101.12, R110.1; also elsewhere on the board
PROGRESS: J101.8, R107.1; also elsewhere on the board
SCL_CLK: U102.2 (1Z), U103.4 (SCL)
SDA_CLK: U102.6 (2Z), U103.5 (SDA)
SLOT: J101.6, R105.1; also elsewhere on the board
SRC_ON: U101.3 (ON), U102.3 (2E), U102.7 (1E); also elsewhere on the board
V3V3: C101.1, J101.1, R102.1, R103.1, U101.1 (VIN), U102.8 (VCC); also elsewhere on the board
VCLK: C102.1, C103.1, U101.5 (QOD), U101.6 (VOUT), U103.1 (VDD), U103.7 (VDDO)
XTAL1: U103.2 (XA), Y101.1
XTAL2: U103.3 (XB), Y101.3

Notes on the sheet:
01 Interface and local Si5351 source
M5B-E6R2 / integrated evaluation PCB / NOT RELEASED / hardware tests NOT_RUN
M5B-E6R2: REVIEW / ALL hardware measurements NOT RUN / no ordering or manufacture.
