DD1SB/ARDF-TX/hardware/2m/RF2M.kicad_pcb

## KiCad design hardware/2m/RF2M.kicad_pcb (continued)

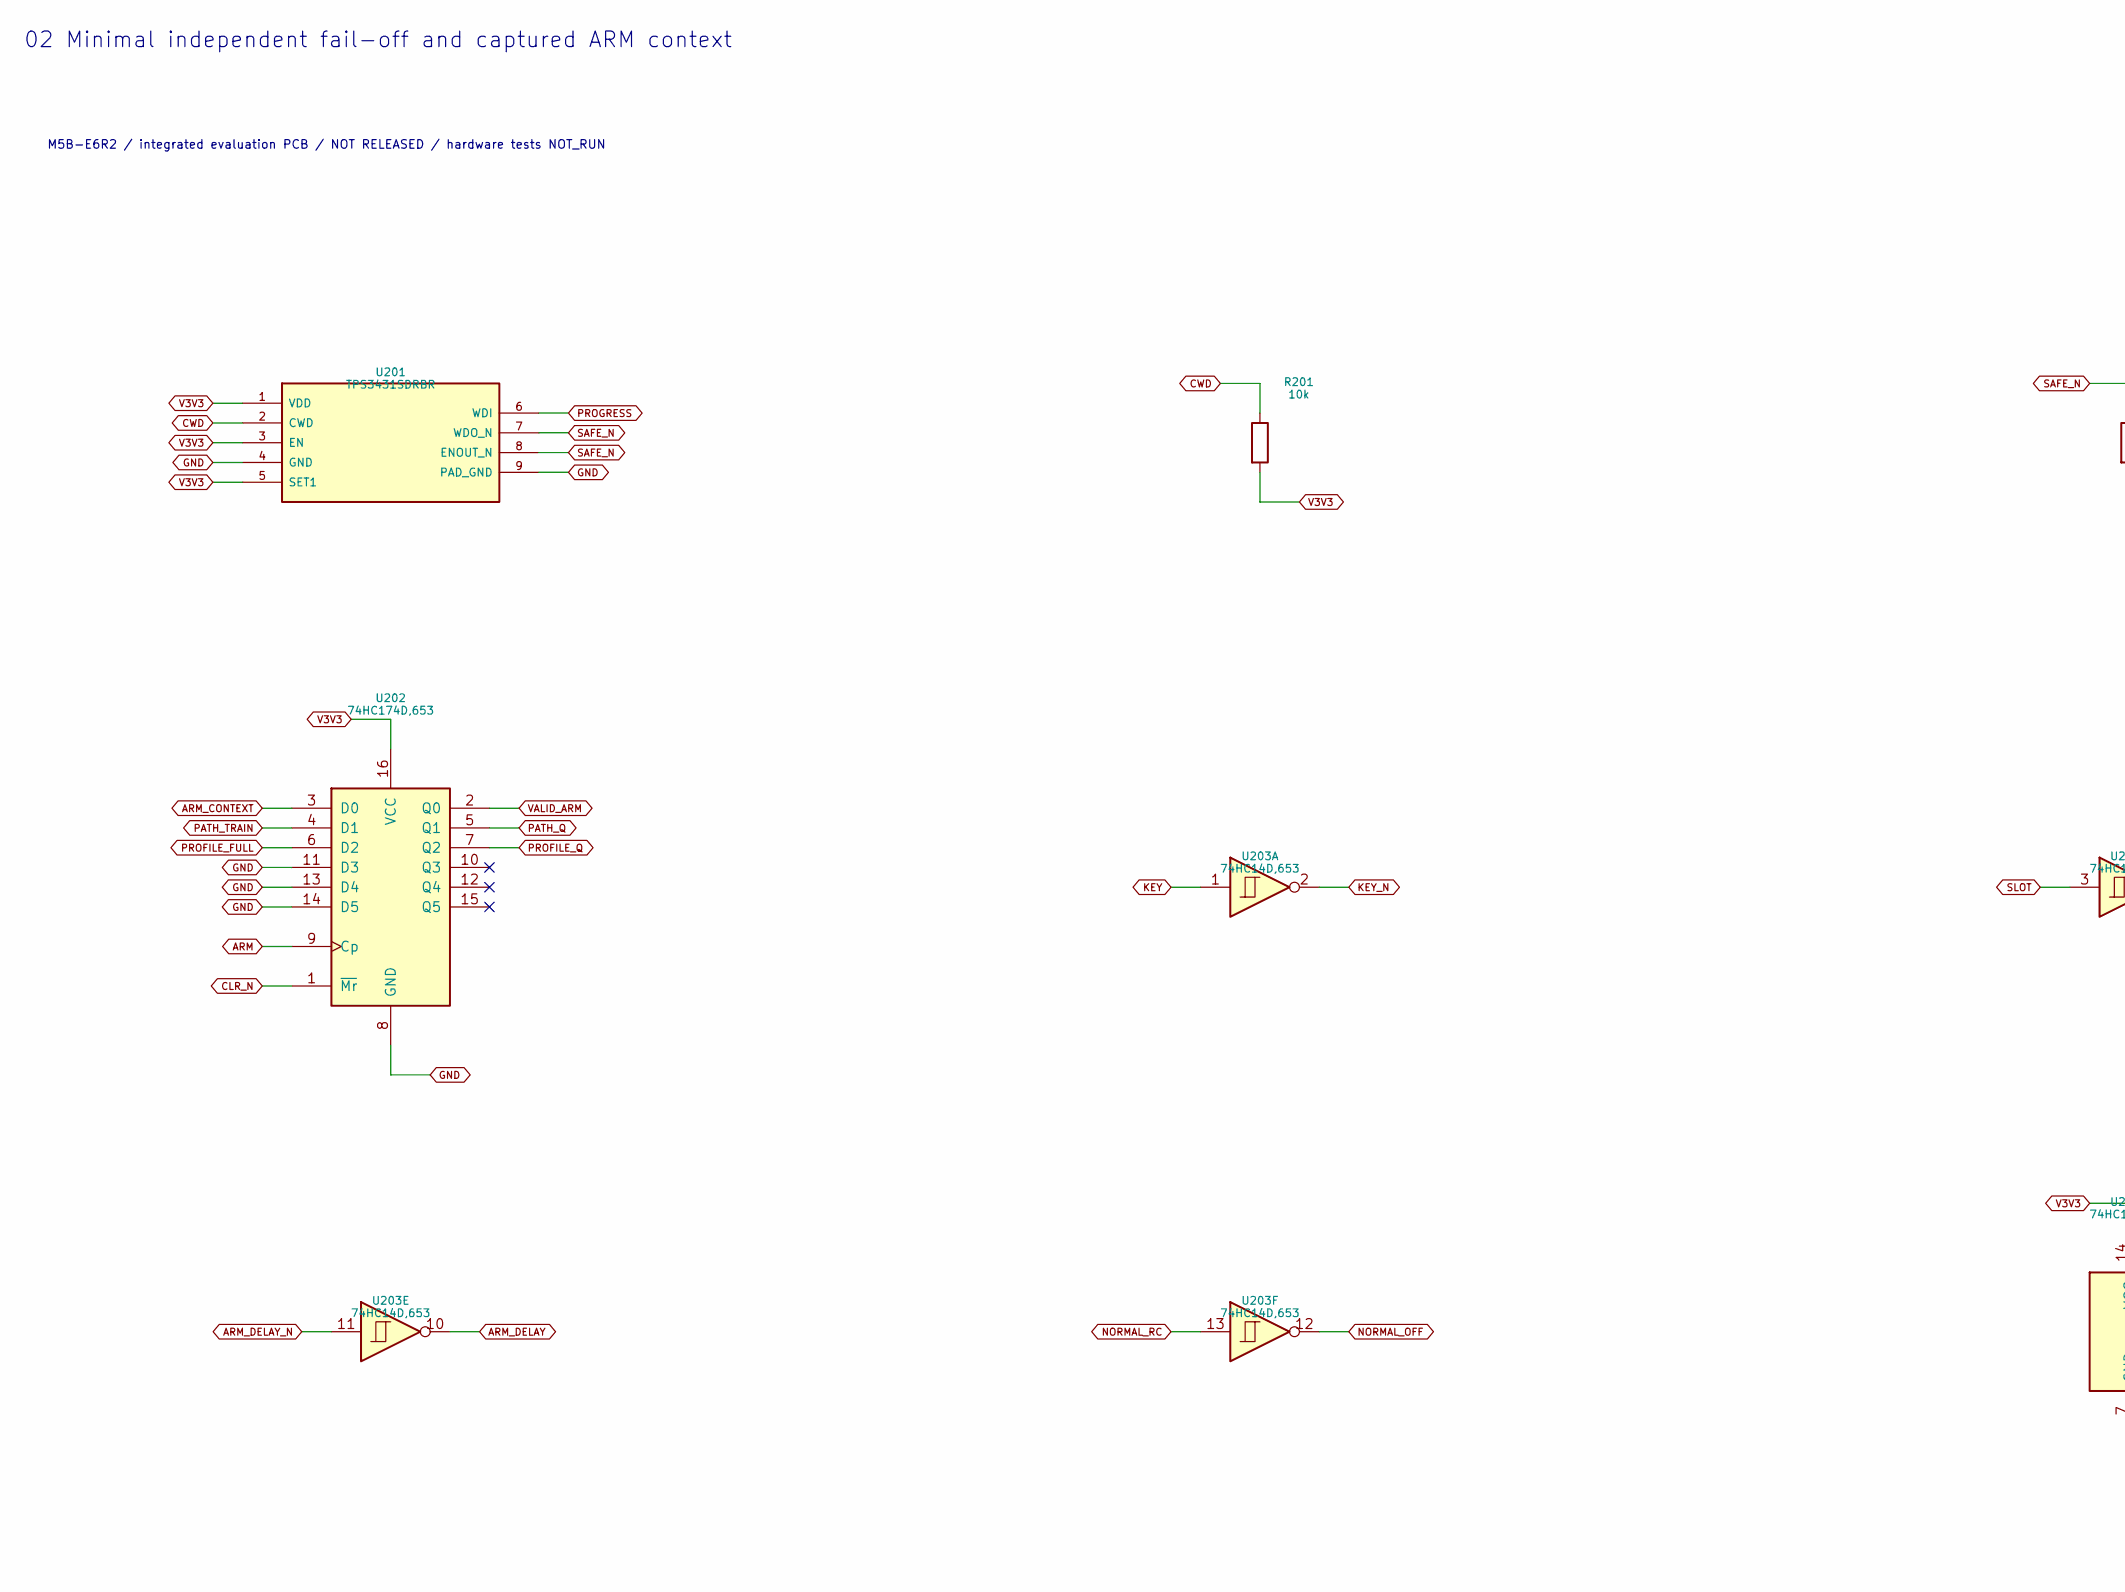
[picture p265: schematic 02_interlocks.kicad_sch, 02 Minimal independent fail-off and captured ARM context, part in row 1, column 1]

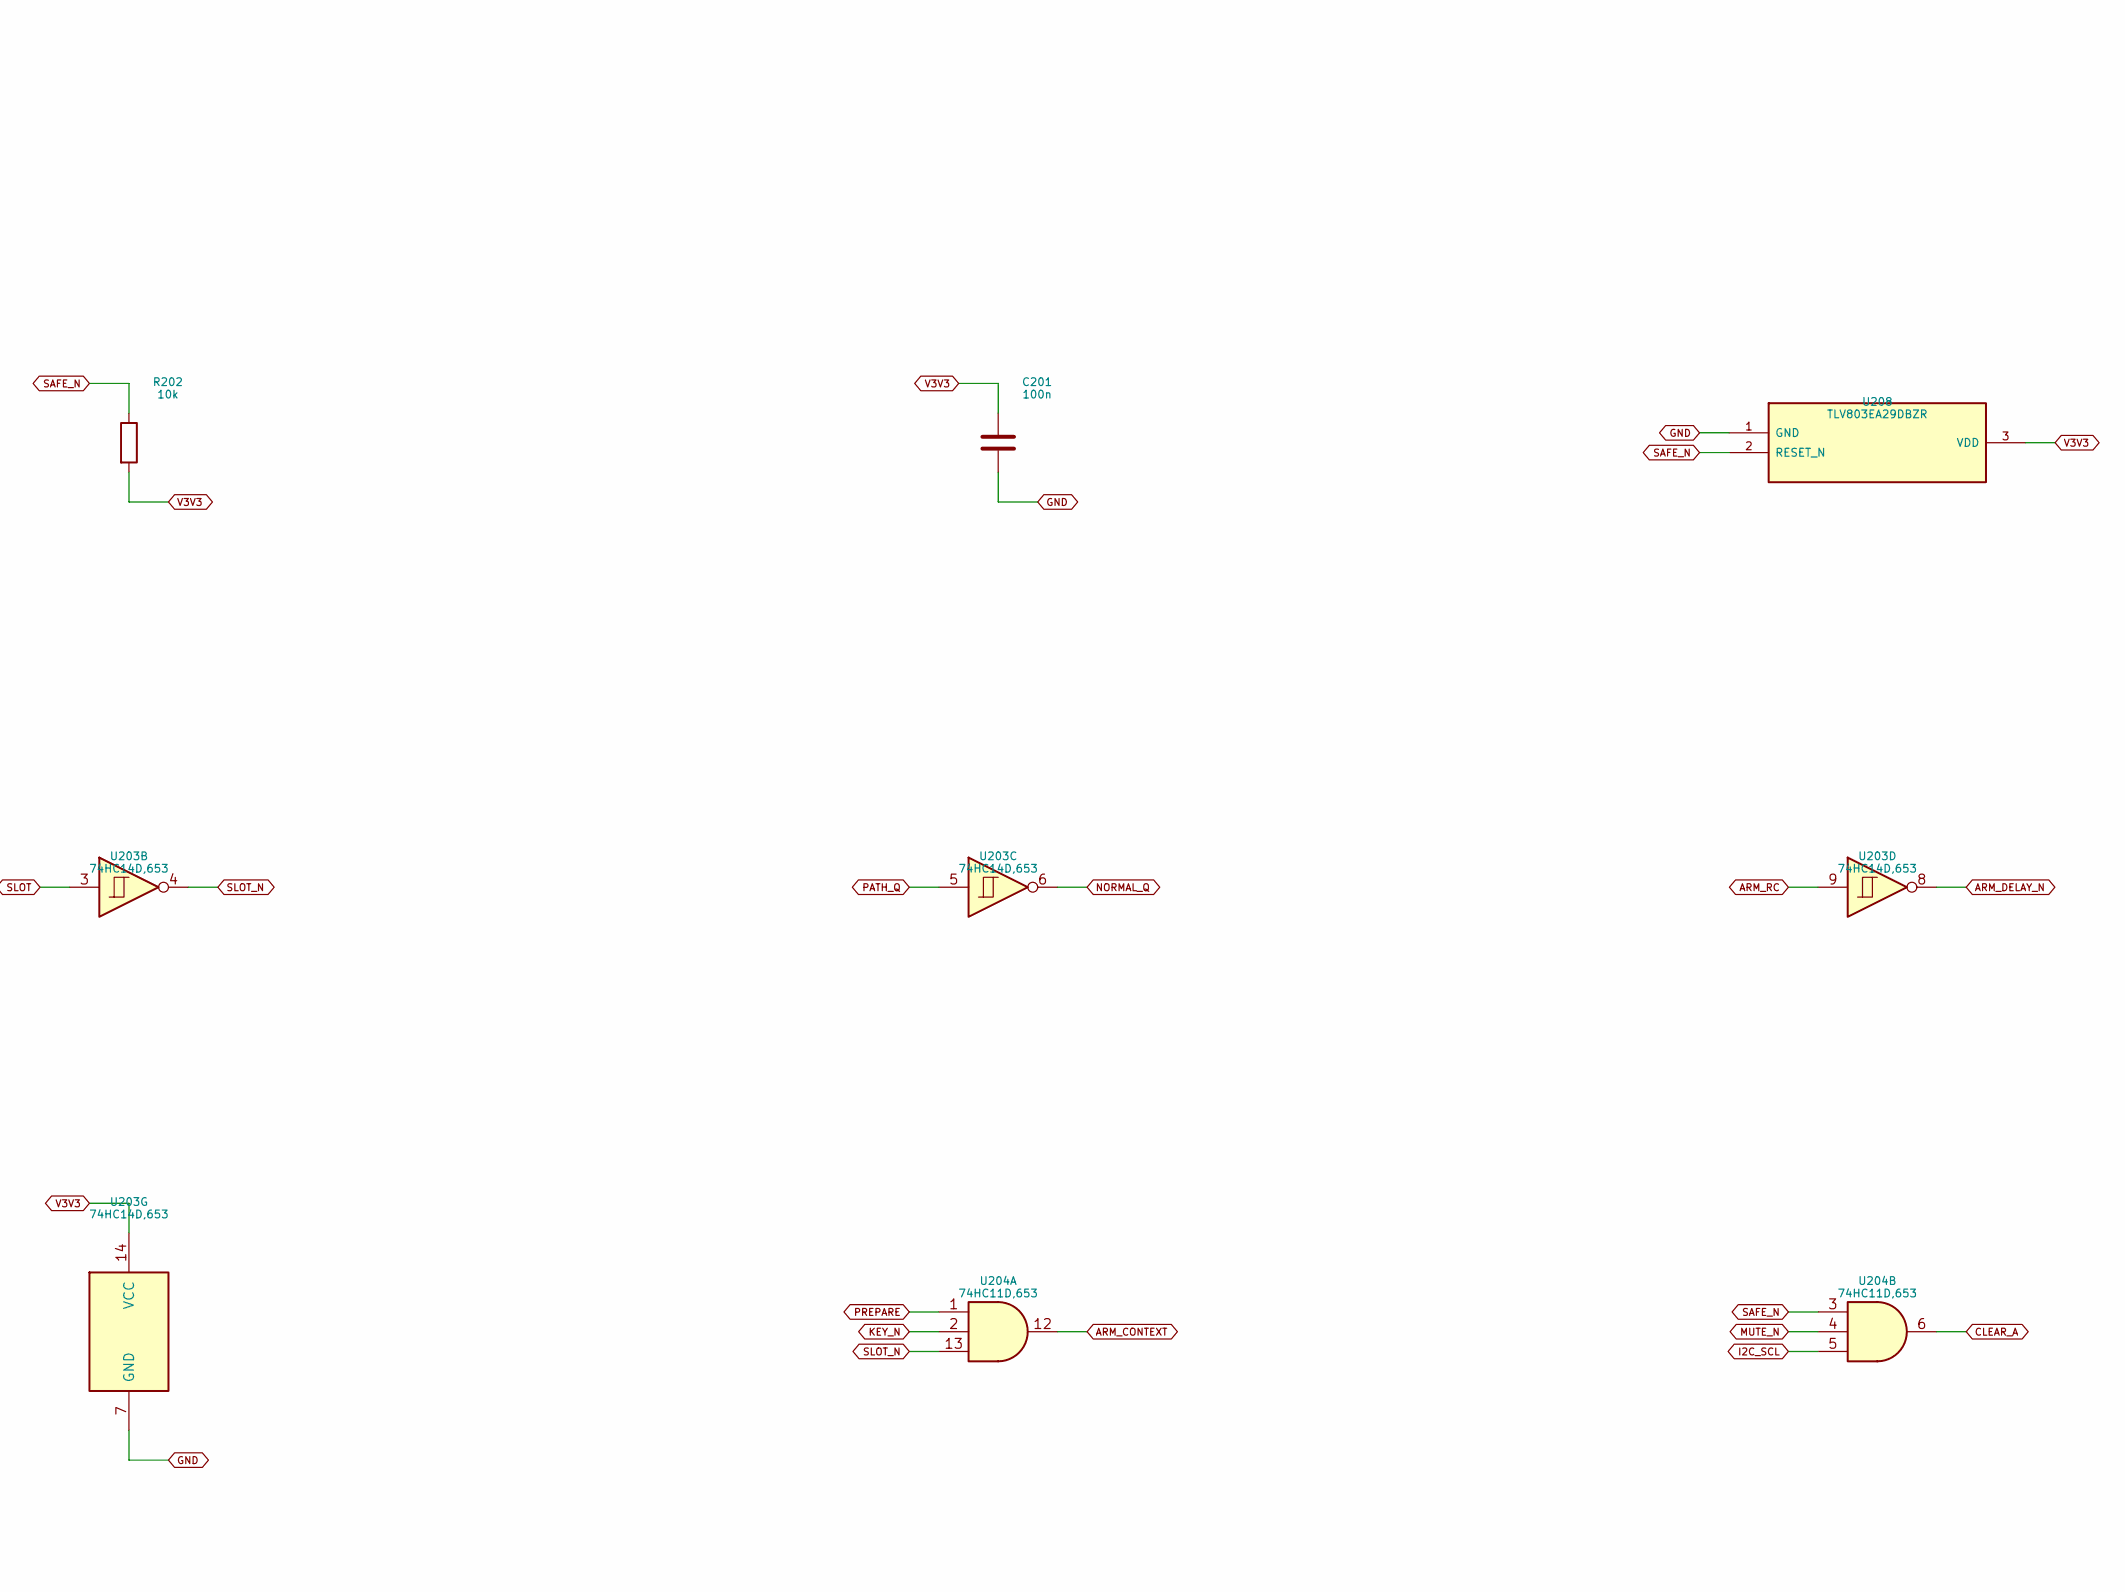
[picture p266: schematic 02_interlocks.kicad_sch, 02 Minimal independent fail-off and captured ARM context, part in row 1, column 2]

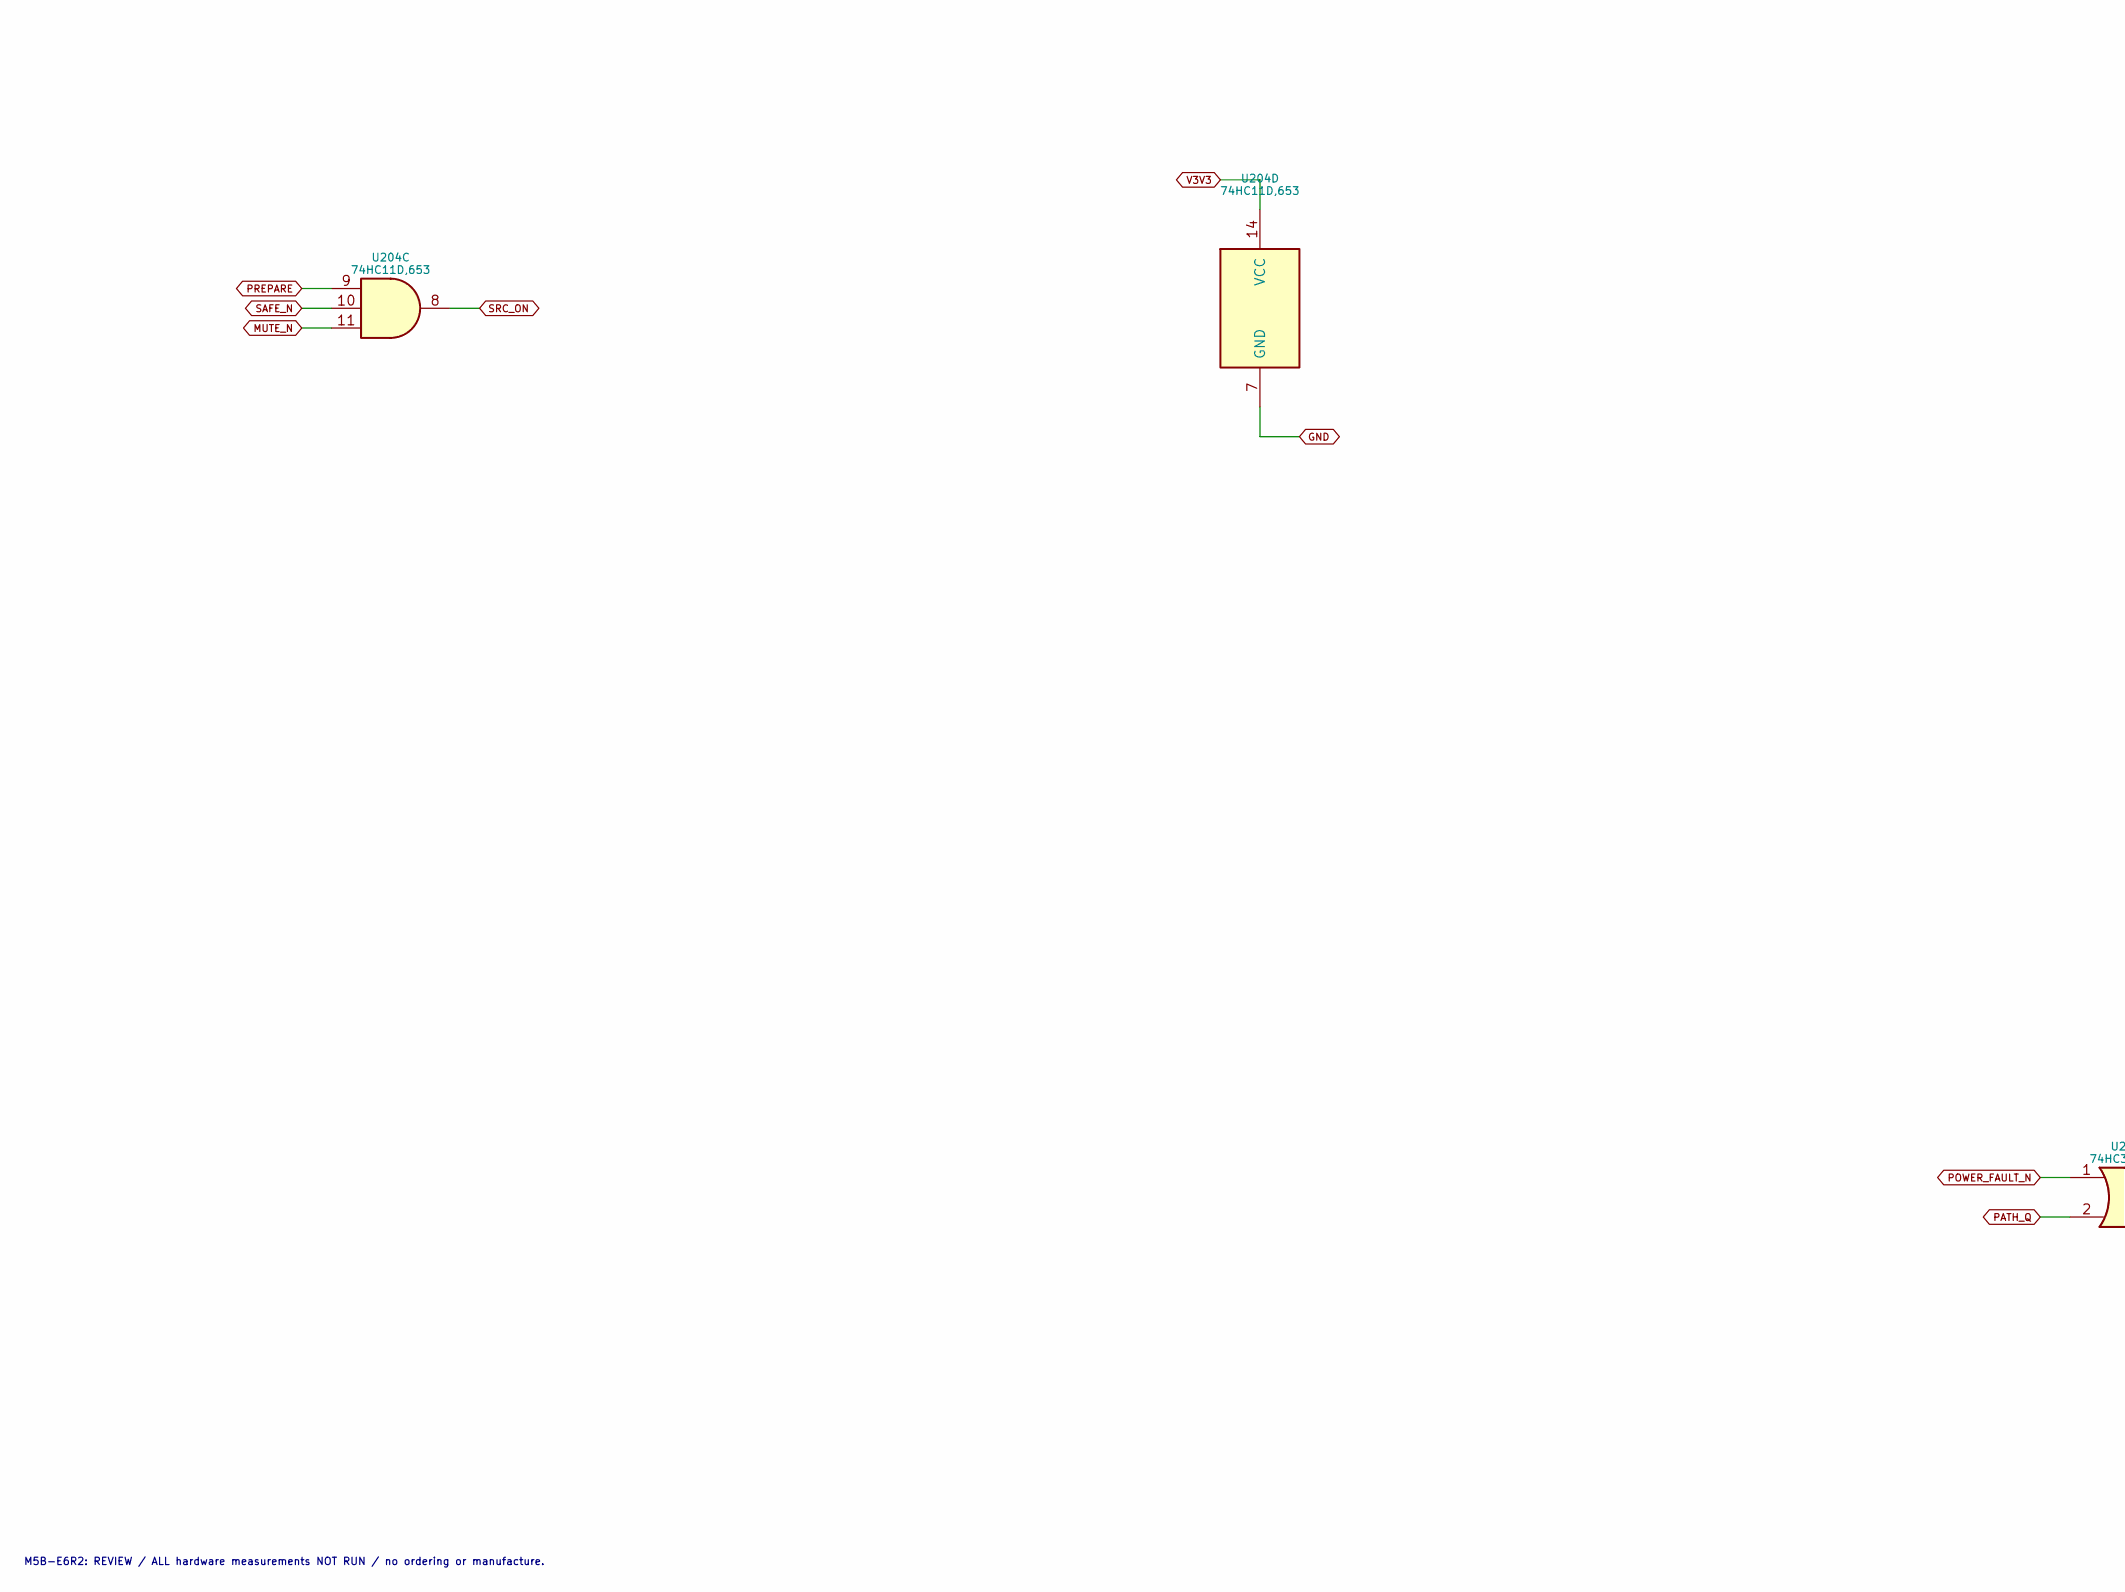
[picture p267: schematic 02_interlocks.kicad_sch, 02 Minimal independent fail-off and captured ARM context, part in row 2, column 1]

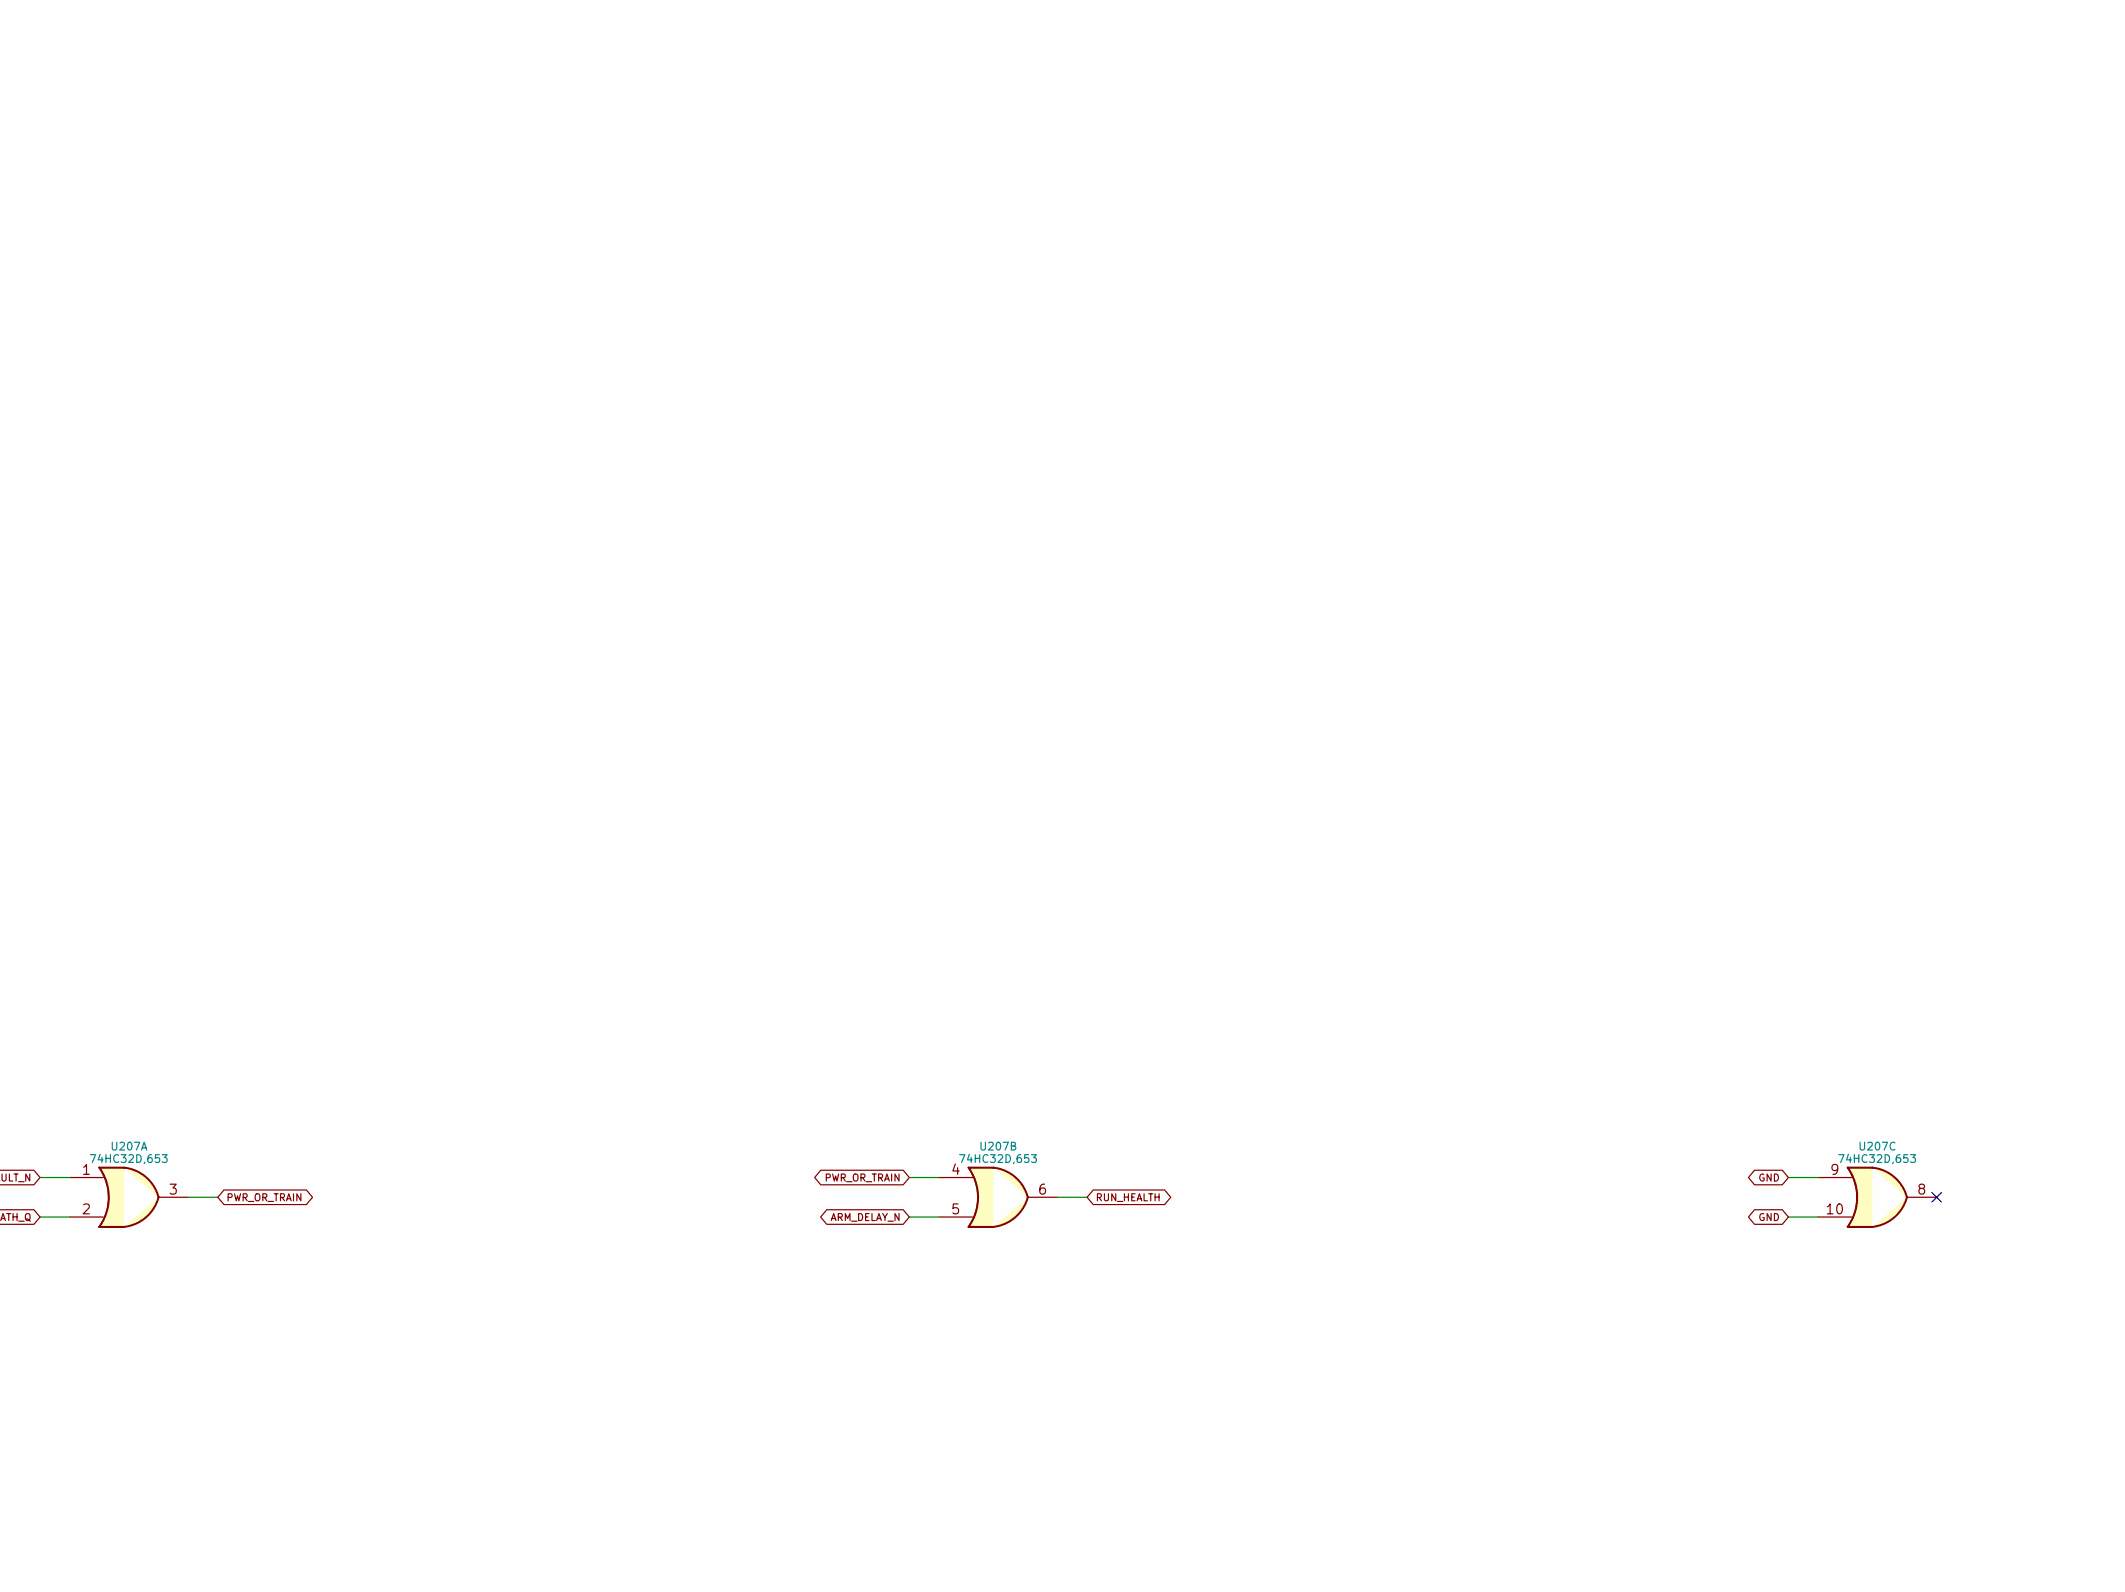
[picture p268: schematic 02_interlocks.kicad_sch, 02 Minimal independent fail-off and captured ARM context, part in row 2, column 2]

Parts:
C201: 100n; C_0603_1608Metric_E3; MPN CC0603KRX7R8BB104
R201, R202: 10k; R_0603_1608Metric_E3; MPN RC0603FR-0710KL
U201: TPS3431SDRBR; VSON-8-1EP_3x3mm_P0.65mm_EP1.65x2.4mm_E3; MPN TPS3431SDRBR
U202: 74HC174D,653; SOIC-16_3.9x9.9mm_P1.27mm_E3; MPN 74HC174D,653
U203: 74HC14D,653; SOIC-14_3.9x8.7mm_P1.27mm_E3; MPN 74HC14D,653
U204: 74HC11D,653; SOIC-14_3.9x8.7mm_P1.27mm_E3; MPN 74HC11D,653
U207: 74HC32D,653; SOIC-14_3.9x8.7mm_P1.27mm_E3; MPN 74HC32D,653
U208: TLV803EA29DBZR; SOT-23_E3; MPN TLV803EA29DBZR

Connections:
ARM: U202.9 (Cp); also elsewhere on the board
ARM_CONTEXT: U202.3 (D0), U204.12
ARM_DELAY: U203.10; also elsewhere on the board
ARM_DELAY_N: U203.8, U203.11, U207.5
ARM_RC: U203.9; also elsewhere on the board
CLEAR_A: U204.6; also elsewhere on the board
CLR_N: U202.1 (~Mr); also elsewhere on the board
CWD: R201.1, U201.2 (CWD)
GND: C201.2, U201.4 (GND), U201.9 (PAD_GND), U202.8 (GND), U202.11 (D3), U202.13 (D4), U202.14 (D5), U203.7 (GND), U204.7 (GND), U207.9, U207.10, U208.1 (GND); also elsewhere on the board
I2C_SCL: U204.5; also elsewhere on the board
KEY: U203.1; also elsewhere on the board
KEY_N: U203.2, U204.2; also elsewhere on the board
MUTE_N: U204.4, U204.11; also elsewhere on the board
NORMAL_OFF: U203.12; also elsewhere on the board
NORMAL_Q: U203.6; also elsewhere on the board
NORMAL_RC: U203.13; also elsewhere on the board
PATH_Q: U202.5 (Q1), U203.5, U207.2; also elsewhere on the board
PATH_TRAIN: U202.4 (D1); also elsewhere on the board
POWER_FAULT_N: U207.1; also elsewhere on the board
PREPARE: U204.1, U204.9; also elsewhere on the board
PROFILE_FULL: U202.6 (D2); also elsewhere on the board
PROFILE_Q: U202.7 (Q2); also elsewhere on the board
PROGRESS: U201.6 (WDI); also elsewhere on the board
PWR_OR_TRAIN: U207.3, U207.4
RUN_HEALTH: U207.6; also elsewhere on the board
SAFE_N: R202.1, U201.7 (WDO_N), U201.8 (ENOUT_N), U204.3, U204.10, U208.2 (RESET_N); also elsewhere on the board
SLOT: U203.3; also elsewhere on the board
SLOT_N: U203.4, U204.13
SRC_ON: U204.8; also elsewhere on the board
V3V3: C201.1, R201.2, R202.2, U201.1 (VDD), U201.3 (EN), U201.5 (SET1), U202.16 (VCC), U203.14 (VCC), U204.14 (VCC), U208.3 (VDD); also elsewhere on the board
VALID_ARM: U202.2 (Q0); also elsewhere on the board

Notes on the sheet:
02 Minimal independent fail-off and captured ARM context
M5B-E6R2 / integrated evaluation PCB / NOT RELEASED / hardware tests NOT_RUN
M5B-E6R2: REVIEW / ALL hardware measurements NOT RUN / no ordering or manufacture.
