DD1SB/ARDF-TX/hardware/2m/RF2M.kicad_pcb

## KiCad design hardware/2m/RF2M.kicad_pcb (continued)

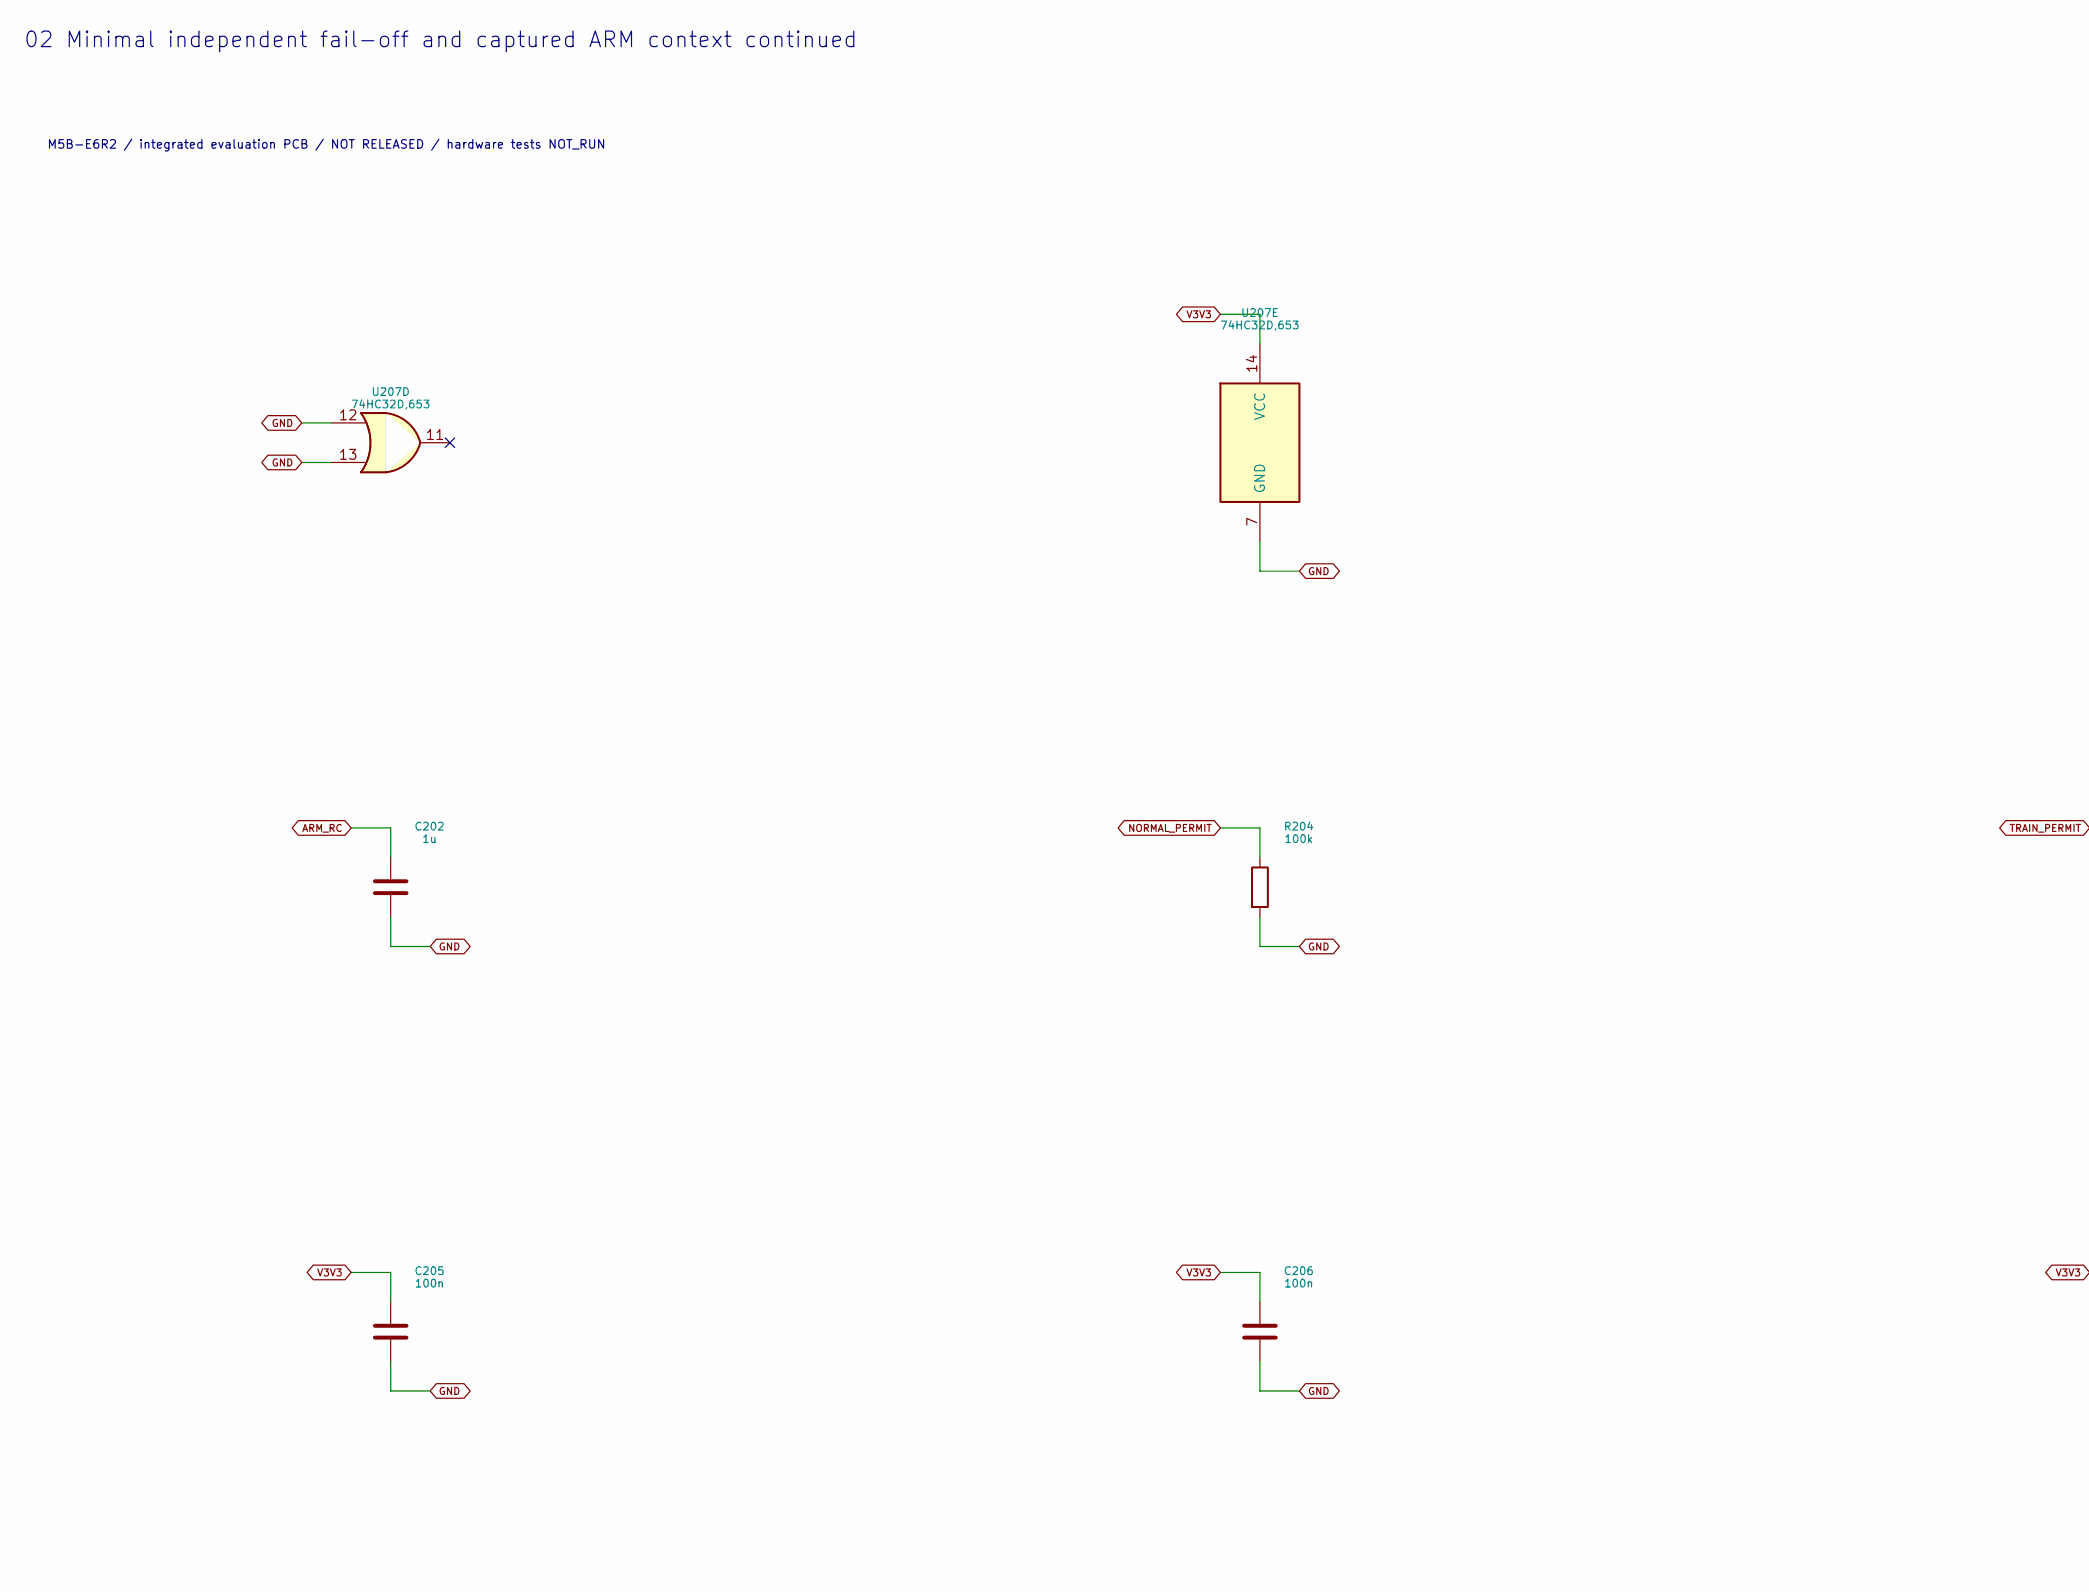
[picture p269: schematic 02_interlocksb1.kicad_sch, 02 Minimal independent fail-off and captured ARM context co…, part in row 1, column 1]

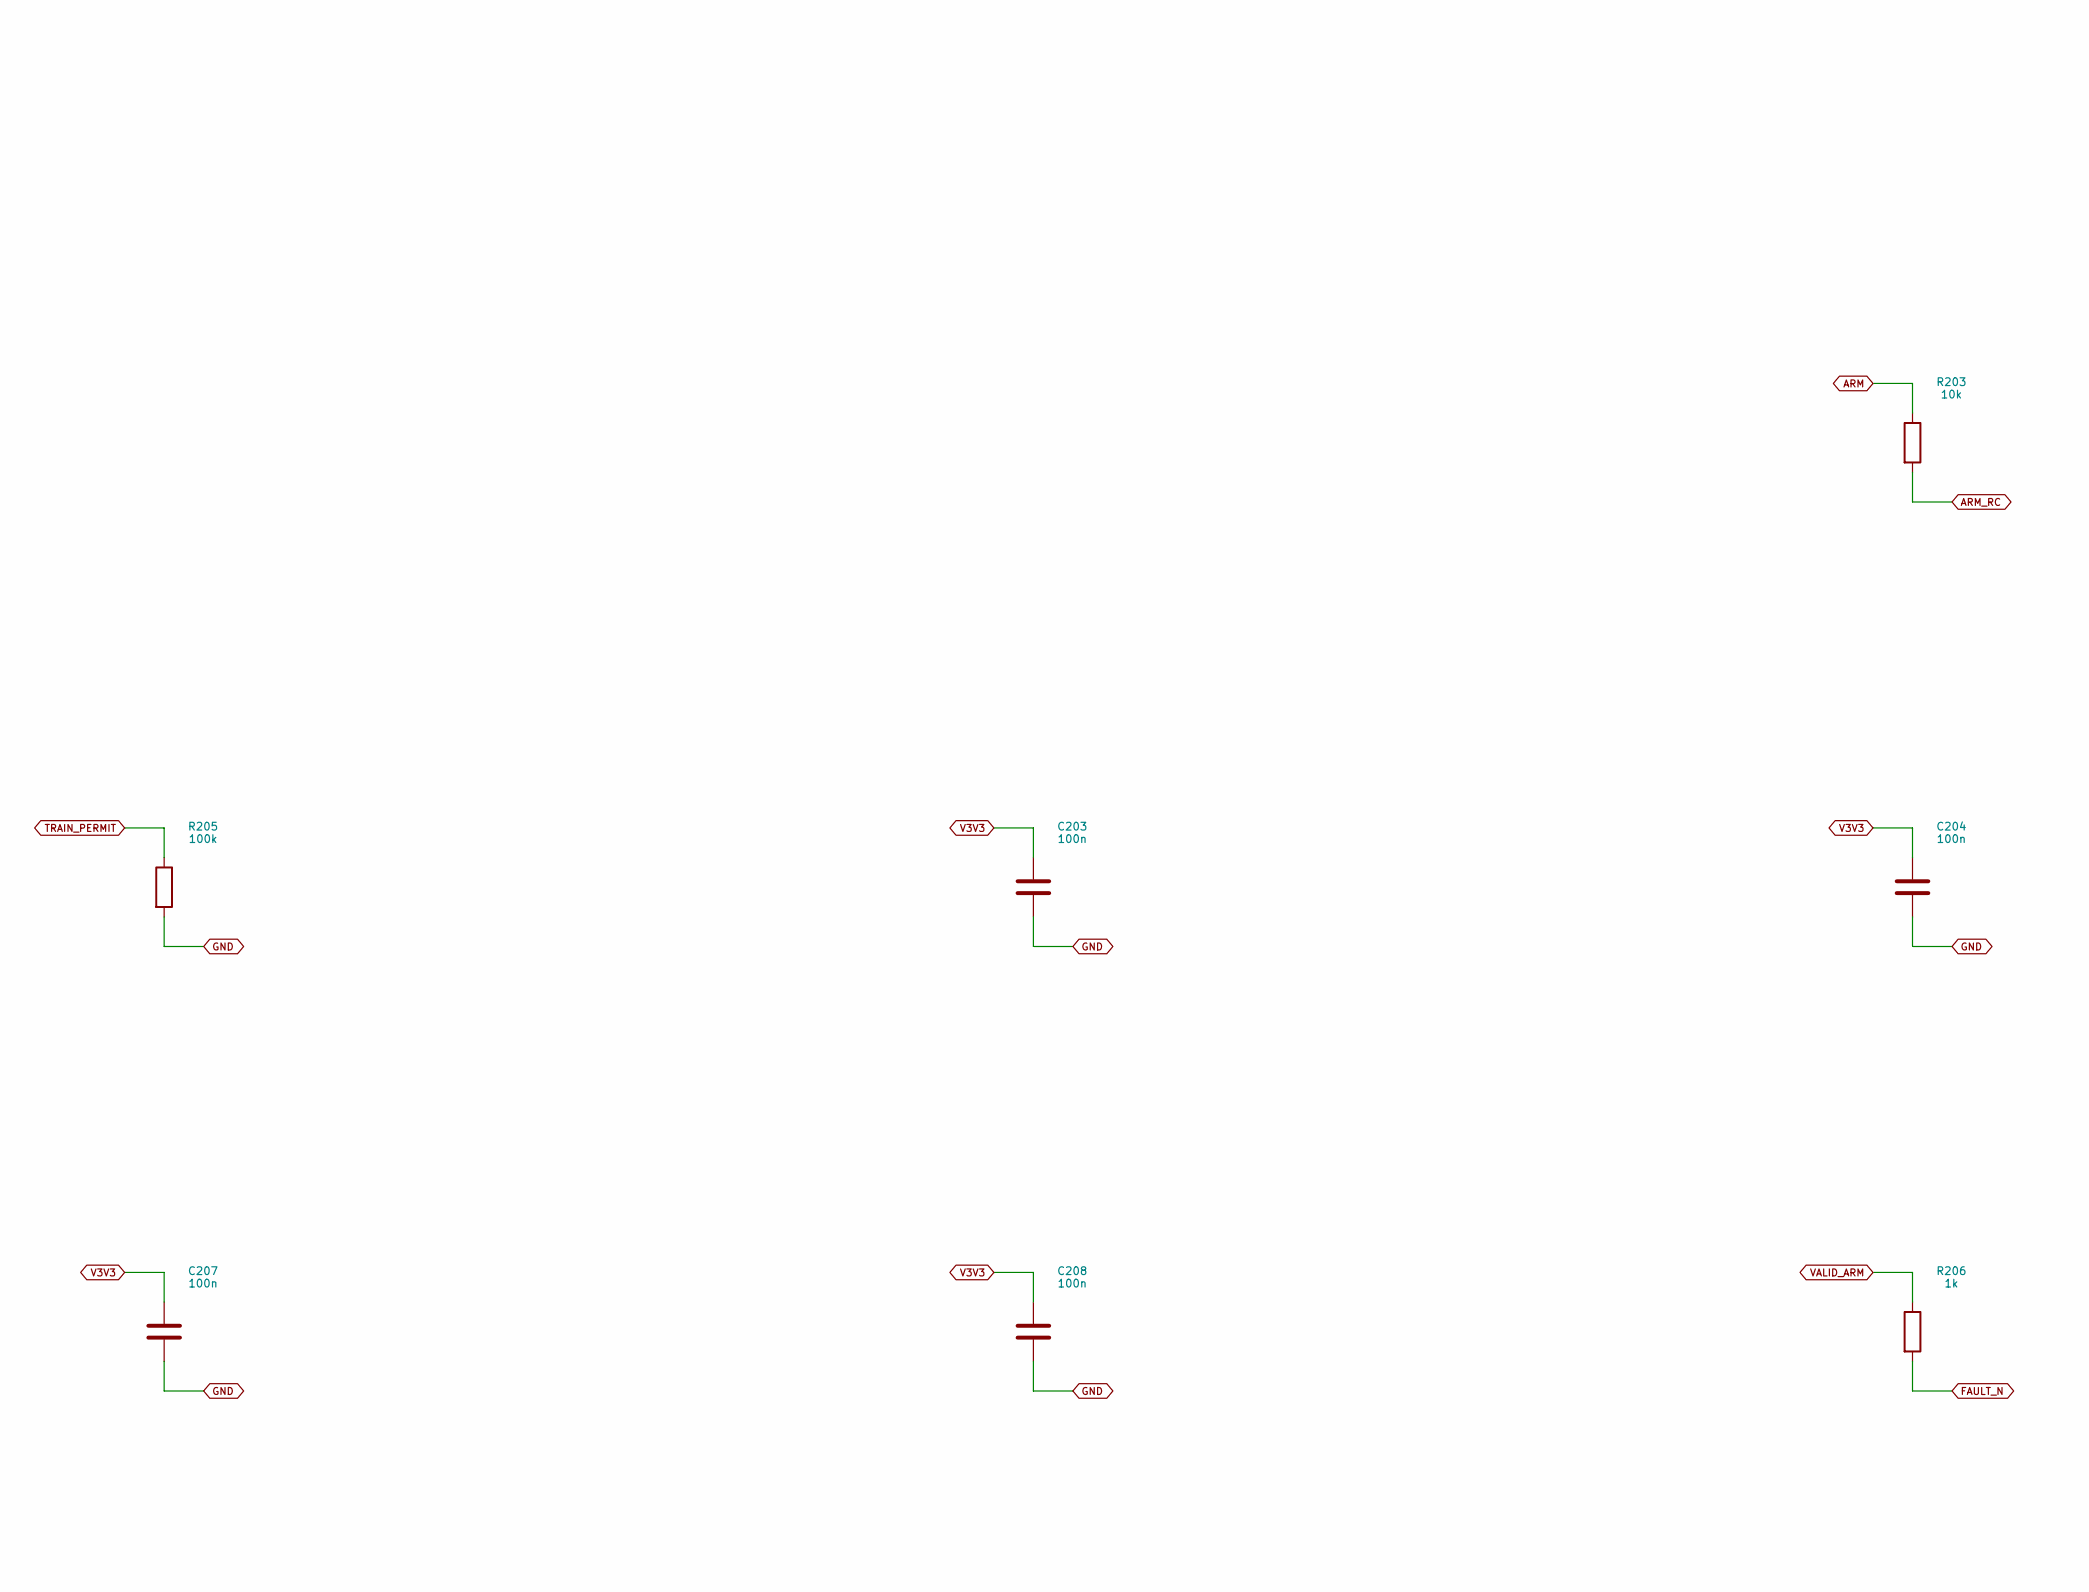
[picture p270: schematic 02_interlocksb1.kicad_sch, 02 Minimal independent fail-off and captured ARM context co…, part in row 1, column 2]

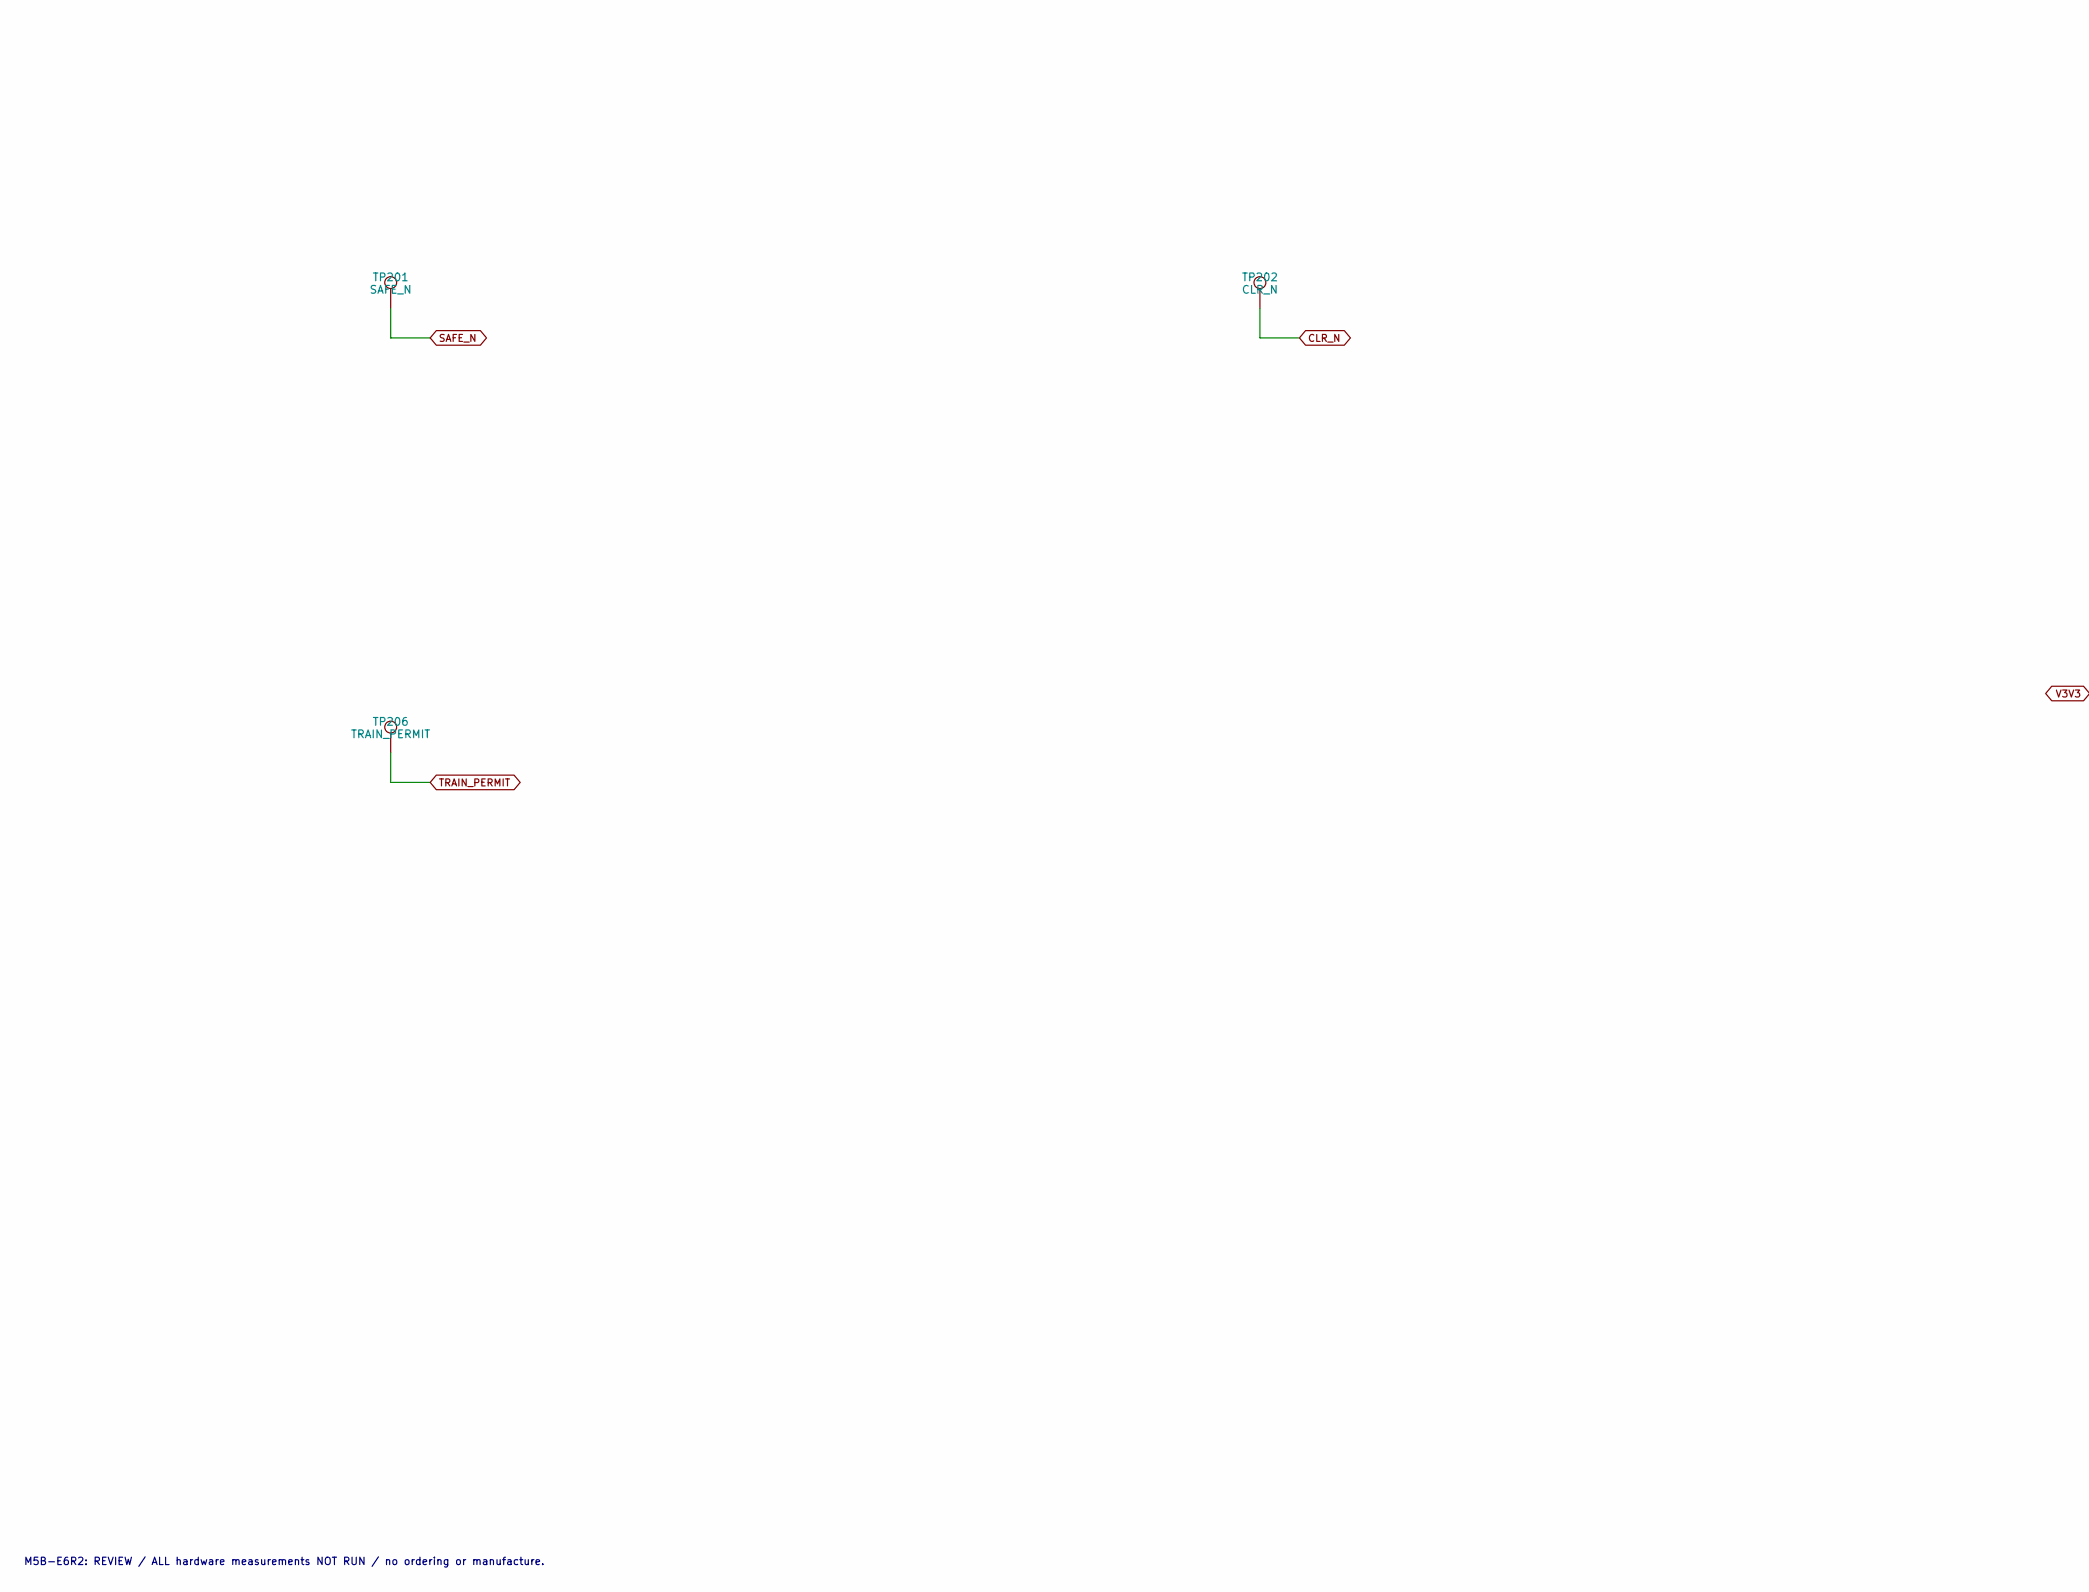
[picture p271: schematic 02_interlocksb1.kicad_sch, 02 Minimal independent fail-off and captured ARM context co…, part in row 2, column 1]

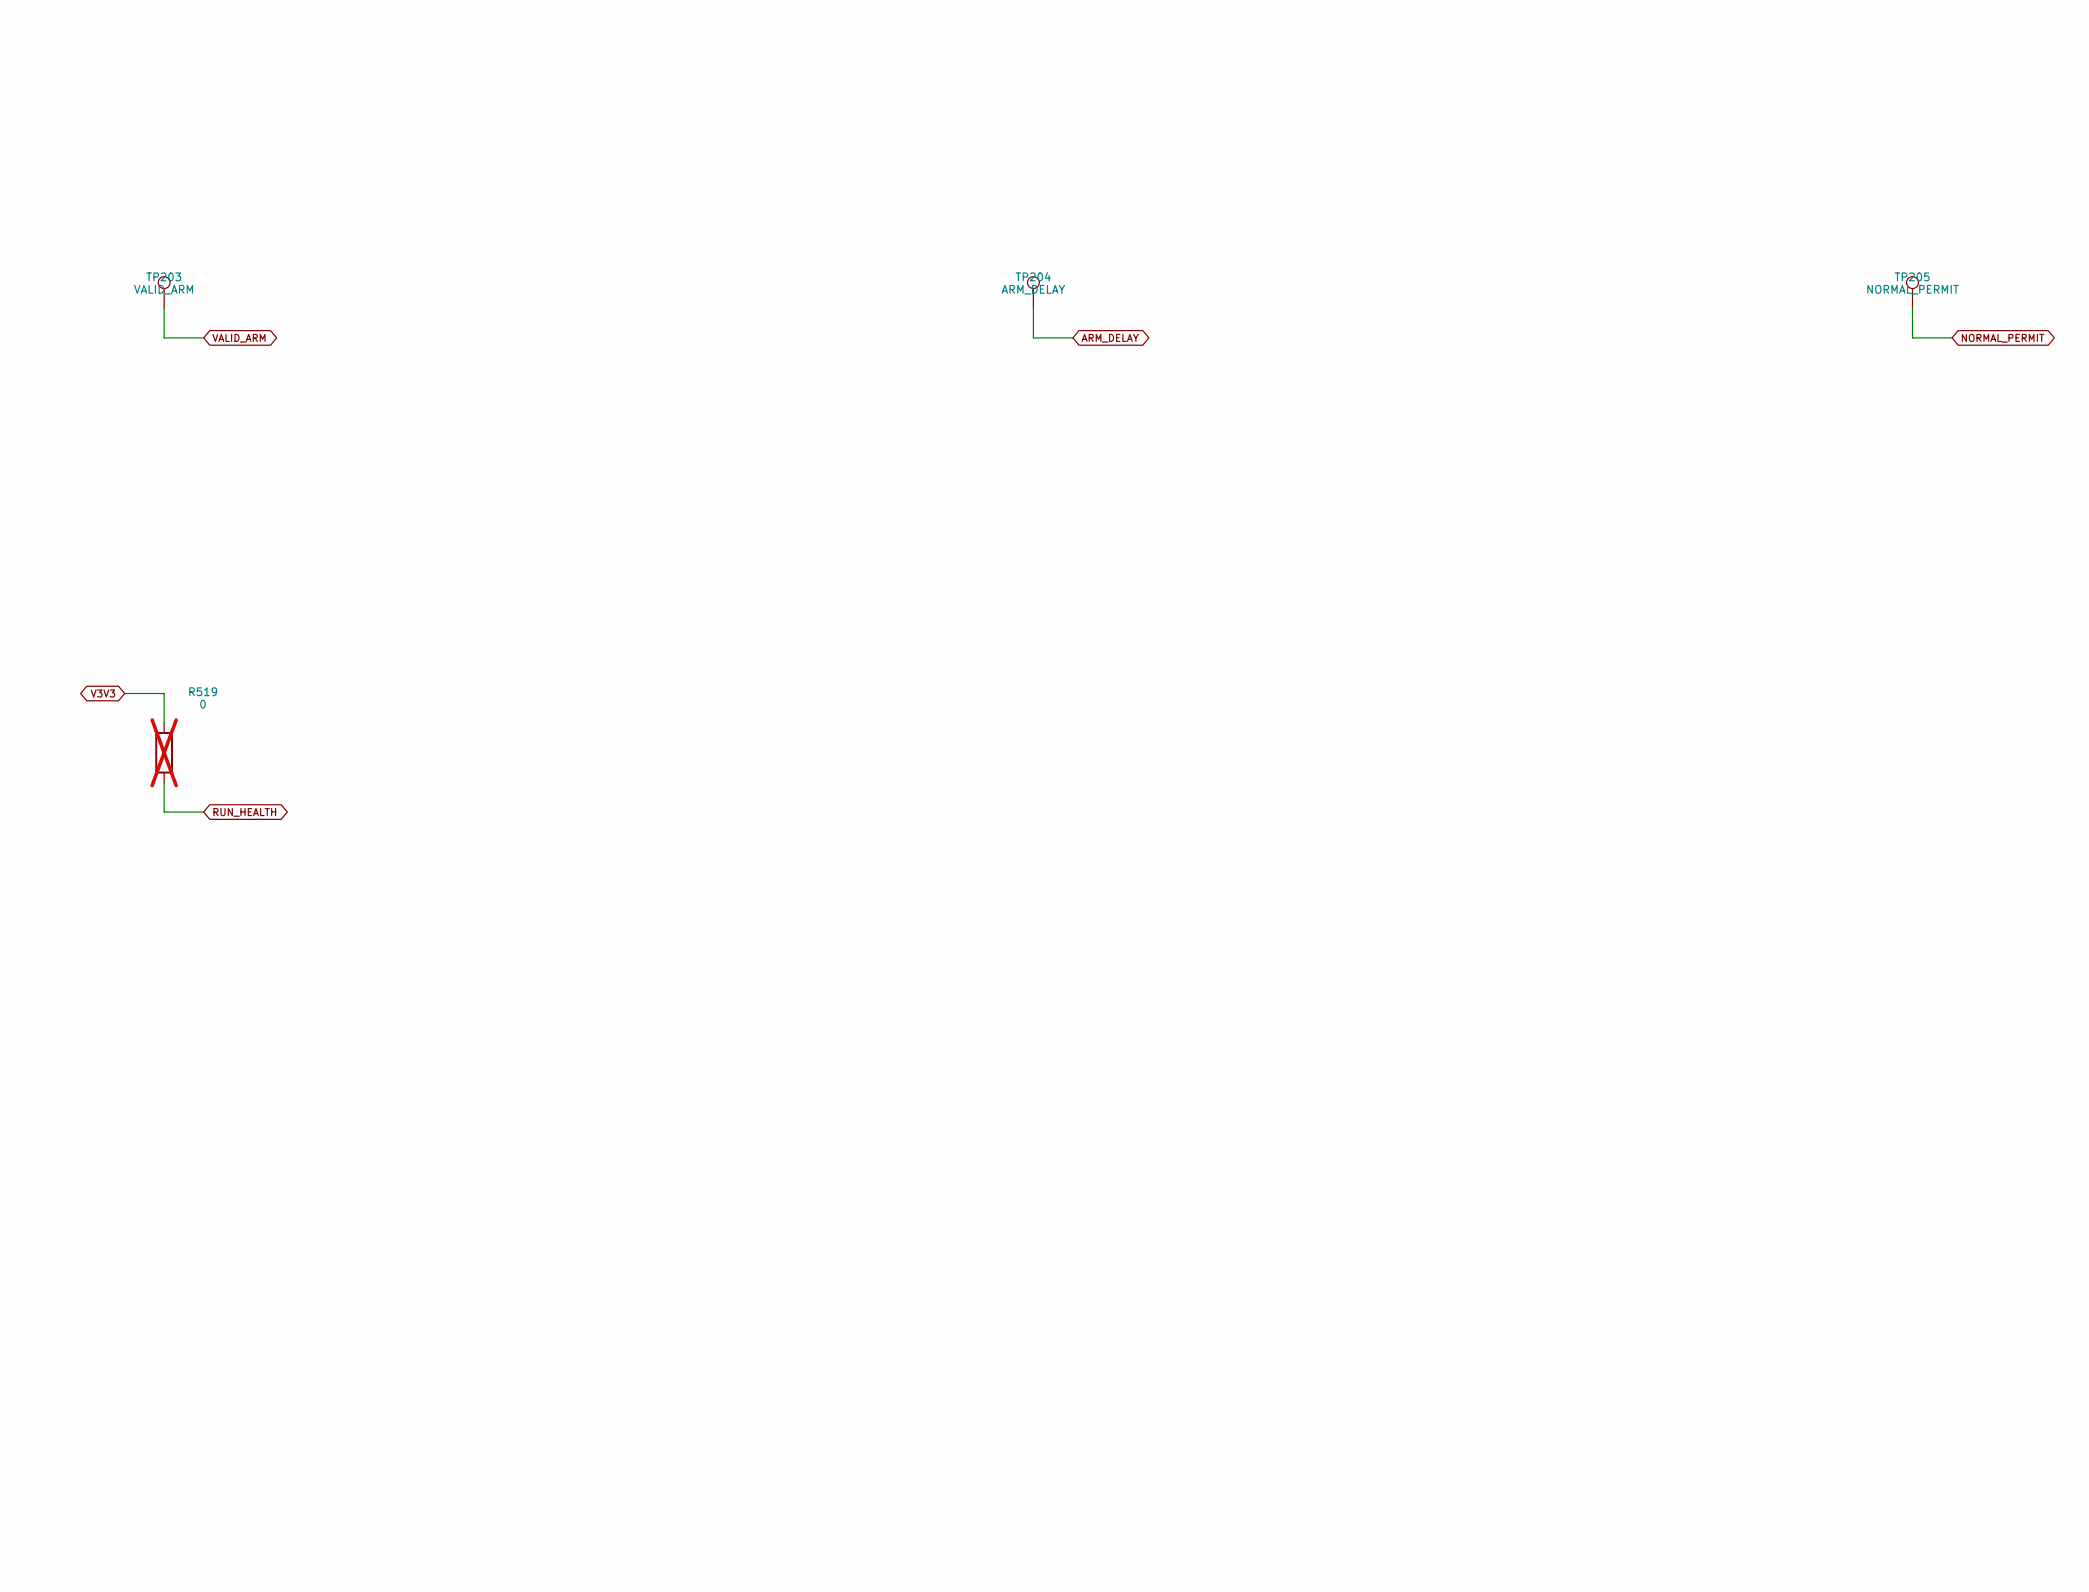
[picture p272: schematic 02_interlocksb1.kicad_sch, 02 Minimal independent fail-off and captured ARM context co…, part in row 2, column 2]

Parts:
C202: 1u; C_0805_2012Metric_E3; MPN CC0805KKX7R9BB105
C203, C204, C205, C206, C207, C208: 100n; C_0603_1608Metric_E3; MPN CC0603KRX7R8BB104
R203: 10k; R_0603_1608Metric_E3; MPN RC0603FR-0710KL
R204, R205: 100k; R_0603_1608Metric_E3; MPN RC0603FR-07100KL
R206: 1k; R_0603_1608Metric_E3; MPN RC0603FR-071KL
R519: 0; R_0603_1608Metric_E3; MPN RC0603JR-070RL; not fitted
TP201: SAFE_N; TestPoint_Pad_D1.0mm_E3; MPN PCB feature
TP202: CLR_N; TestPoint_Pad_D1.0mm_E3; MPN PCB feature
TP203: VALID_ARM; TestPoint_Pad_D1.0mm_E3; MPN PCB feature
TP204: ARM_DELAY; TestPoint_Pad_D1.0mm_E3; MPN PCB feature
TP205: NORMAL_PERMIT; TestPoint_Pad_D1.0mm_E3; MPN PCB feature
TP206: TRAIN_PERMIT; TestPoint_Pad_D1.0mm_E3; MPN PCB feature
U207: 74HC32D,653; SOIC-14_3.9x8.7mm_P1.27mm_E3; MPN 74HC32D,653

Connections:
ARM: R203.1; also elsewhere on the board
ARM_DELAY: TP204.1; also elsewhere on the board
ARM_RC: C202.1, R203.2; also elsewhere on the board
CLR_N: TP202.1; also elsewhere on the board
FAULT_N: R206.2; also elsewhere on the board
GND: C202.2, C203.2, C204.2, C205.2, C206.2, C207.2, C208.2, R204.2, R205.2, U207.7 (GND), U207.12, U207.13; also elsewhere on the board
NORMAL_PERMIT: R204.1, TP205.1; also elsewhere on the board
RUN_HEALTH: R519.2; also elsewhere on the board
SAFE_N: TP201.1; also elsewhere on the board
TRAIN_PERMIT: R205.1, TP206.1; also elsewhere on the board
V3V3: C203.1, C204.1, C205.1, C206.1, C207.1, C208.1, R519.1, U207.14 (VCC); also elsewhere on the board
VALID_ARM: R206.1, TP203.1; also elsewhere on the board

Notes on the sheet:
02 Minimal independent fail-off and captured ARM context continued
M5B-E6R2 / integrated evaluation PCB / NOT RELEASED / hardware tests NOT_RUN
M5B-E6R2: REVIEW / ALL hardware measurements NOT RUN / no ordering or manufacture.
