DD1SB/ARDF-TX/hardware/2m/RF2M.kicad_pcb

## KiCad design hardware/2m/RF2M.kicad_pcb (continued)

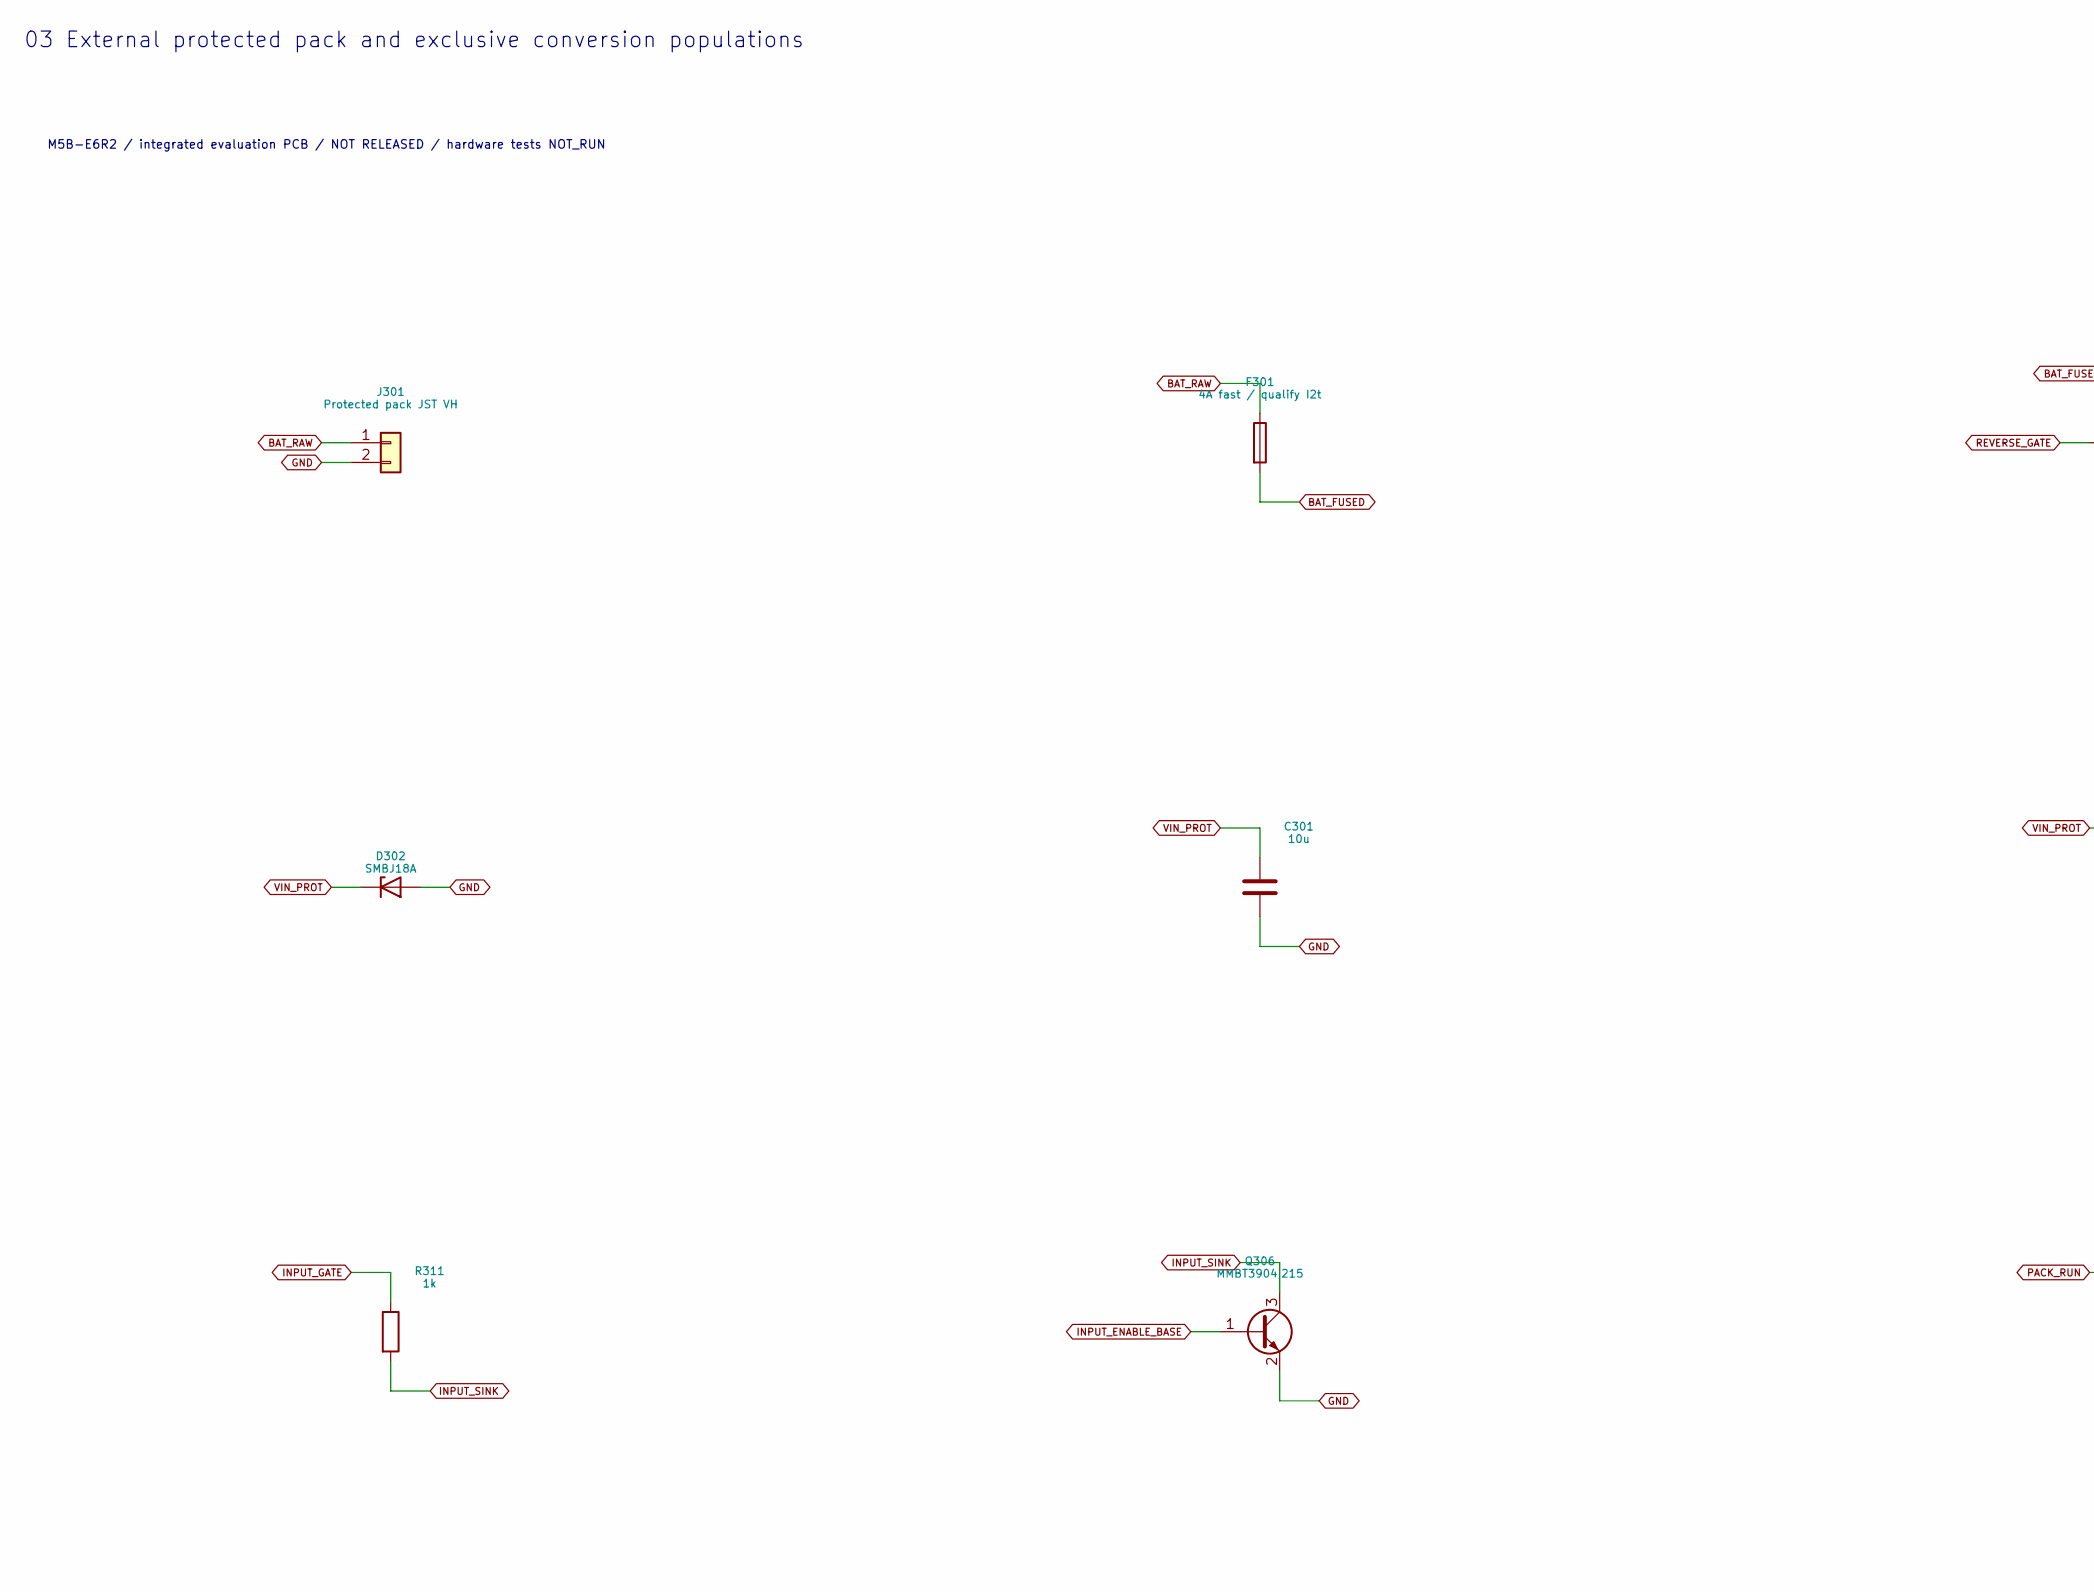
[picture p273: schematic 03_input_power.kicad_sch, 03 External protected pack and exclusive conversion populat…, part in row 1, column 1]

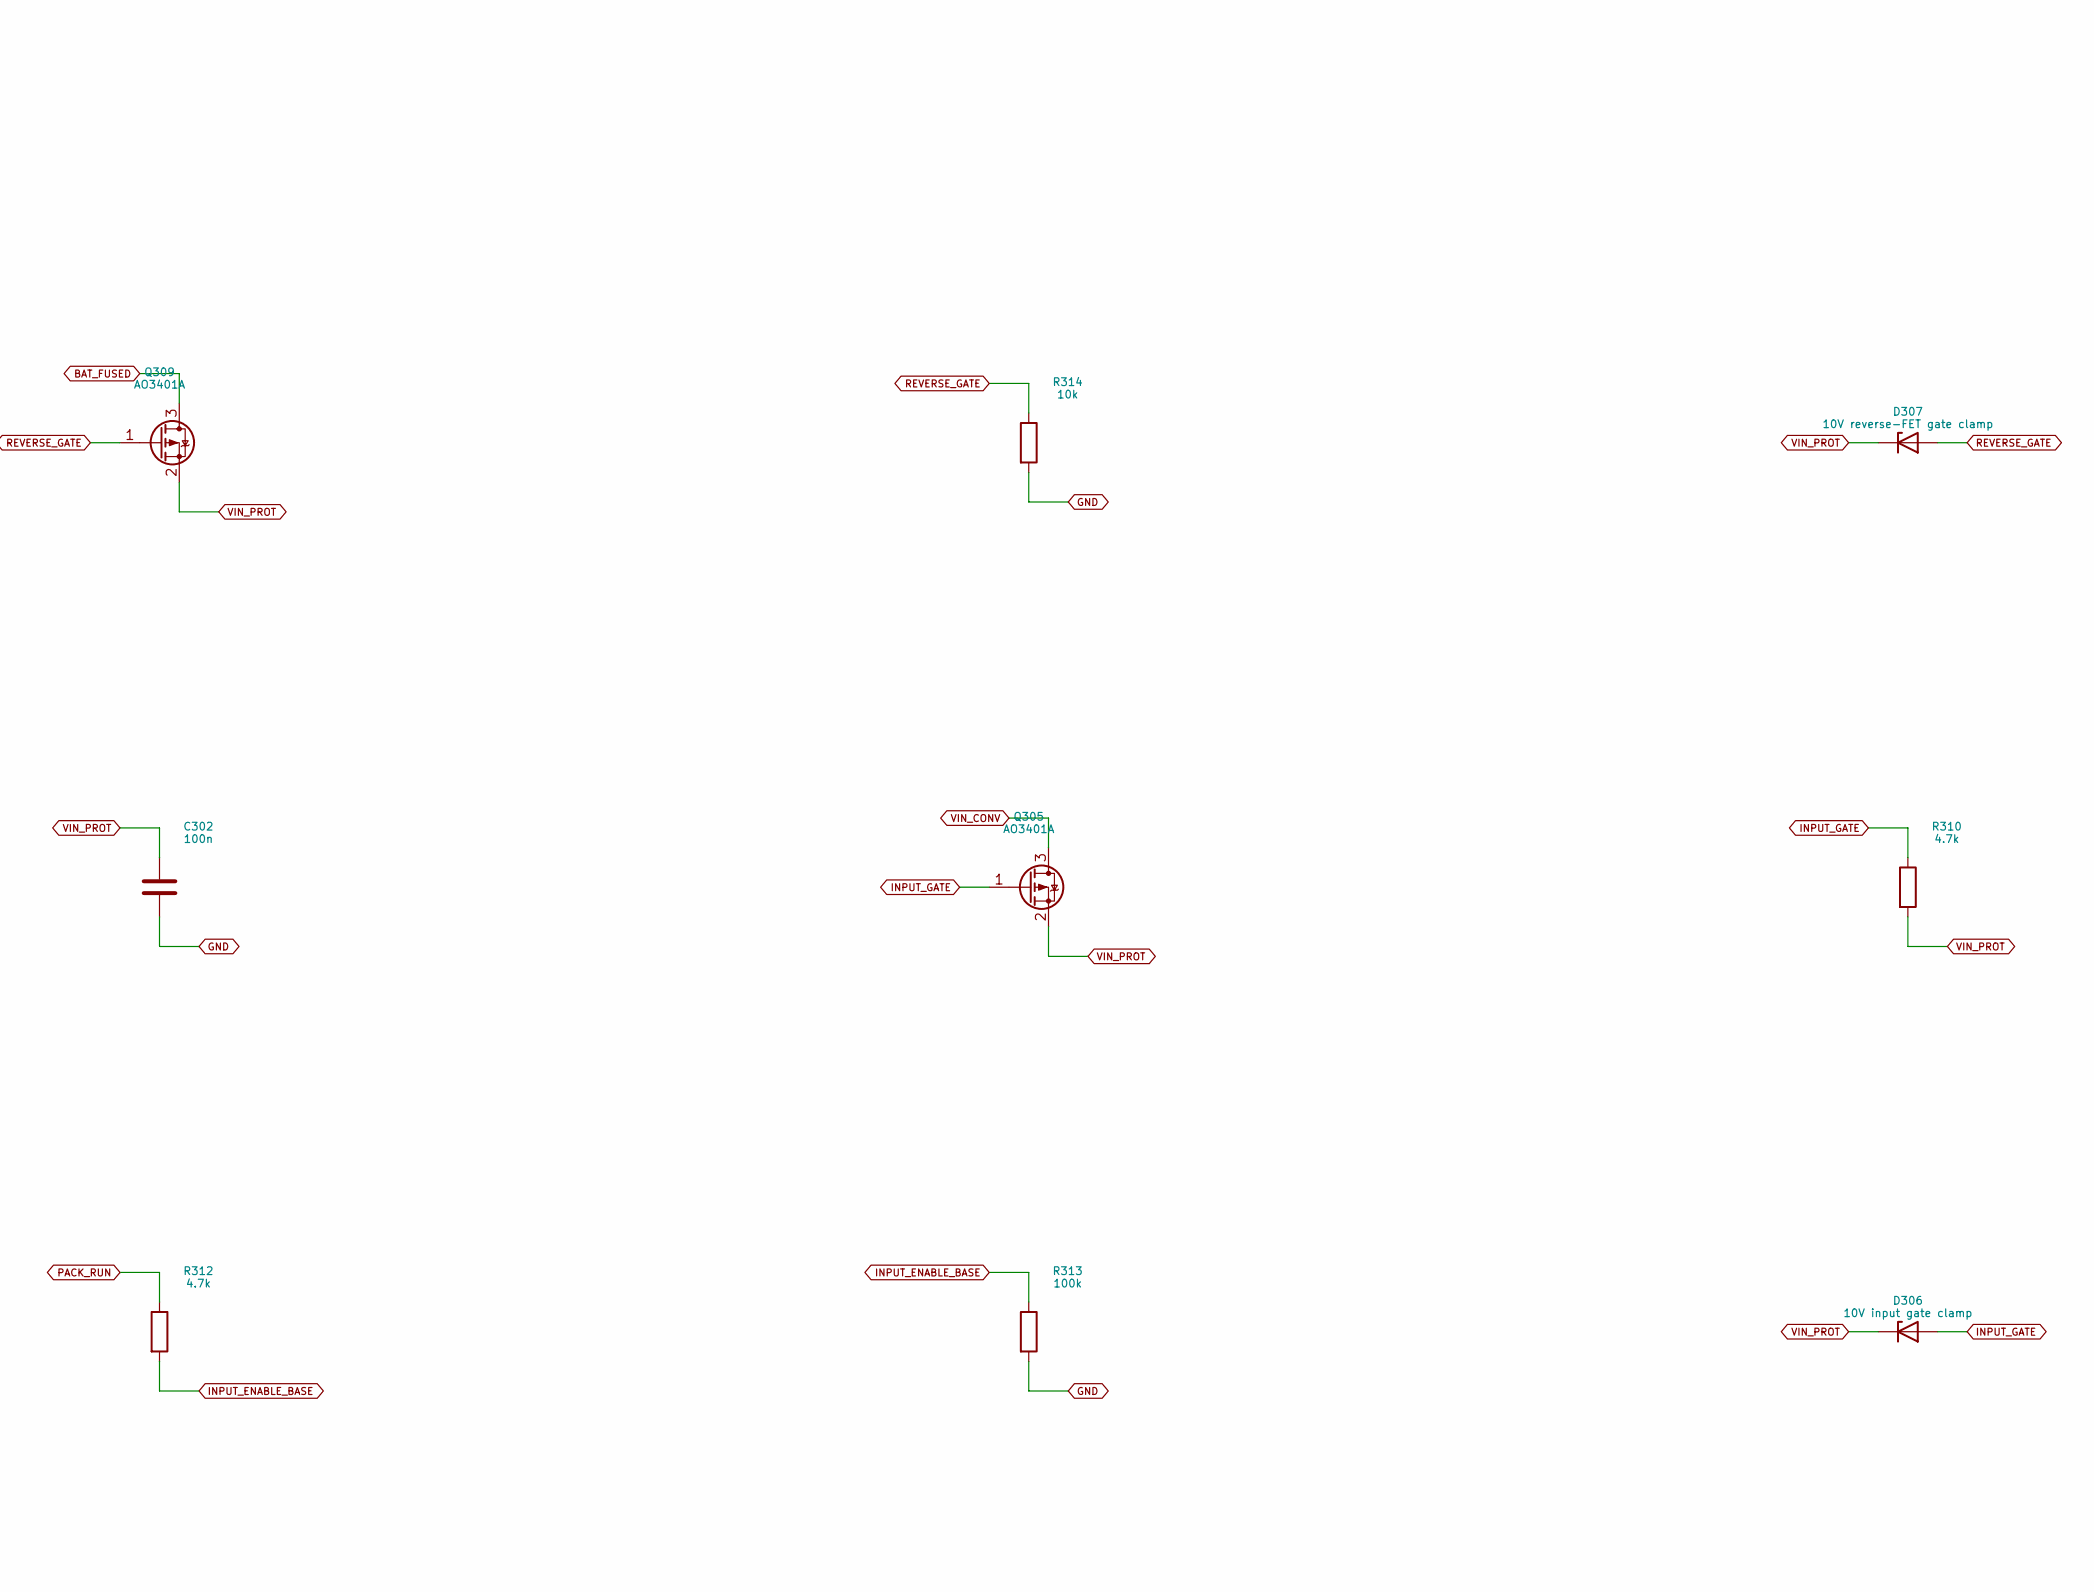
[picture p274: schematic 03_input_power.kicad_sch, 03 External protected pack and exclusive conversion populat…, part in row 1, column 2]

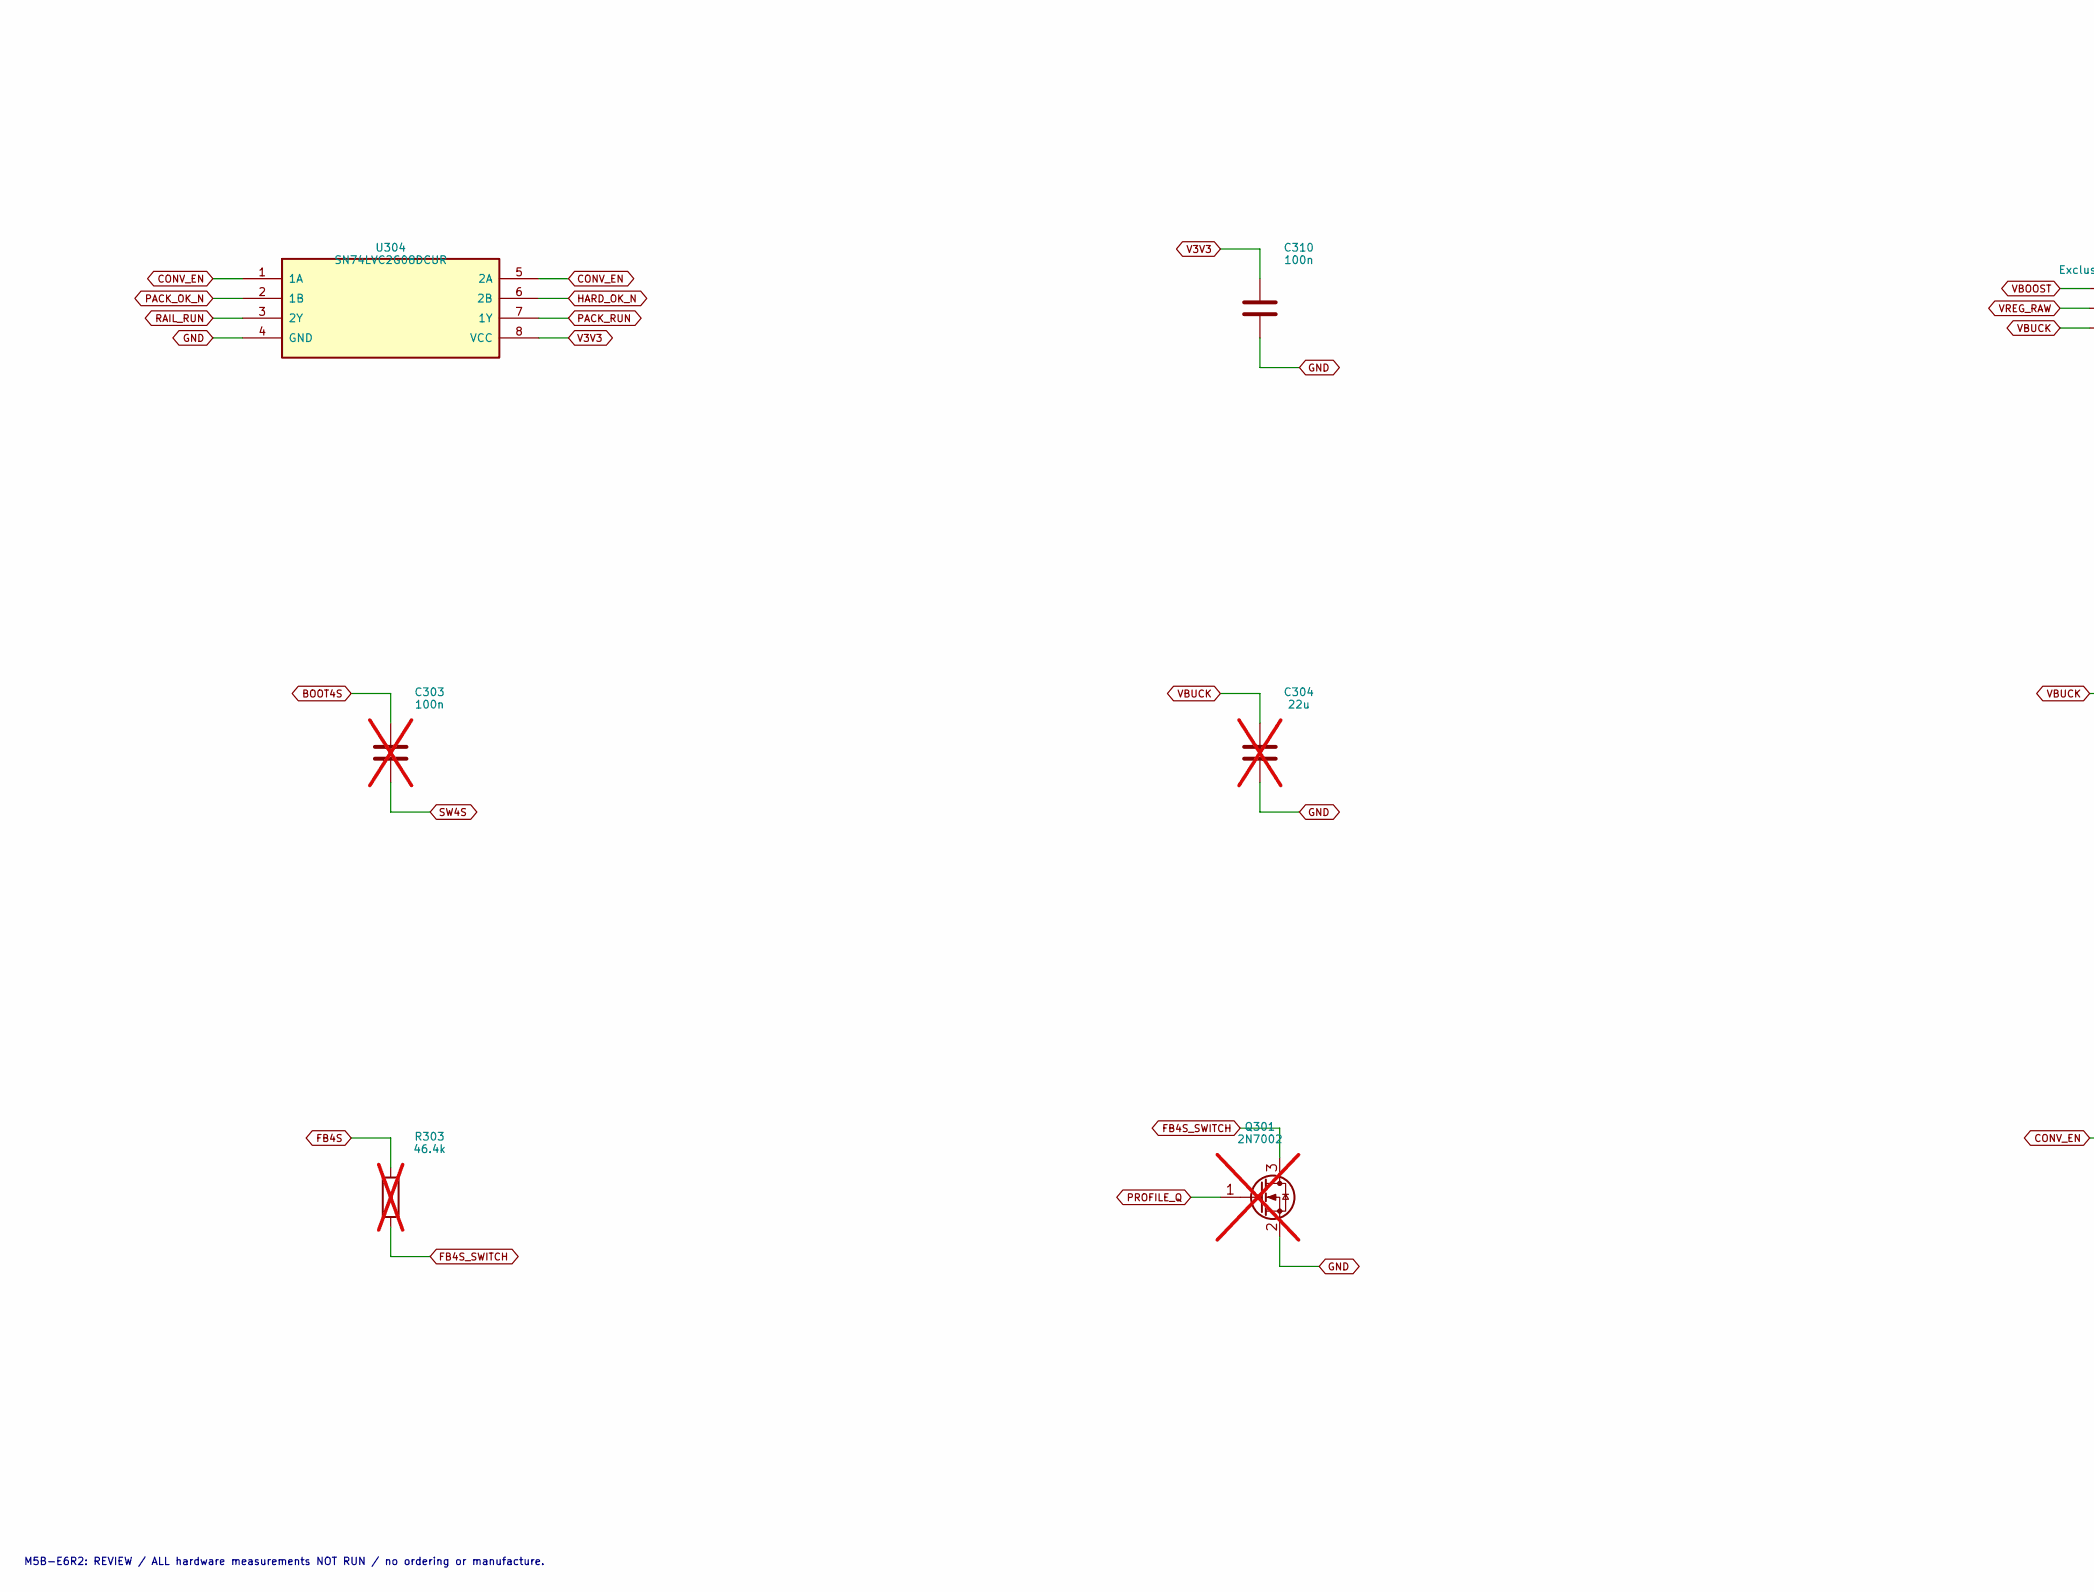
[picture p275: schematic 03_input_power.kicad_sch, 03 External protected pack and exclusive conversion populat…, part in row 2, column 1]

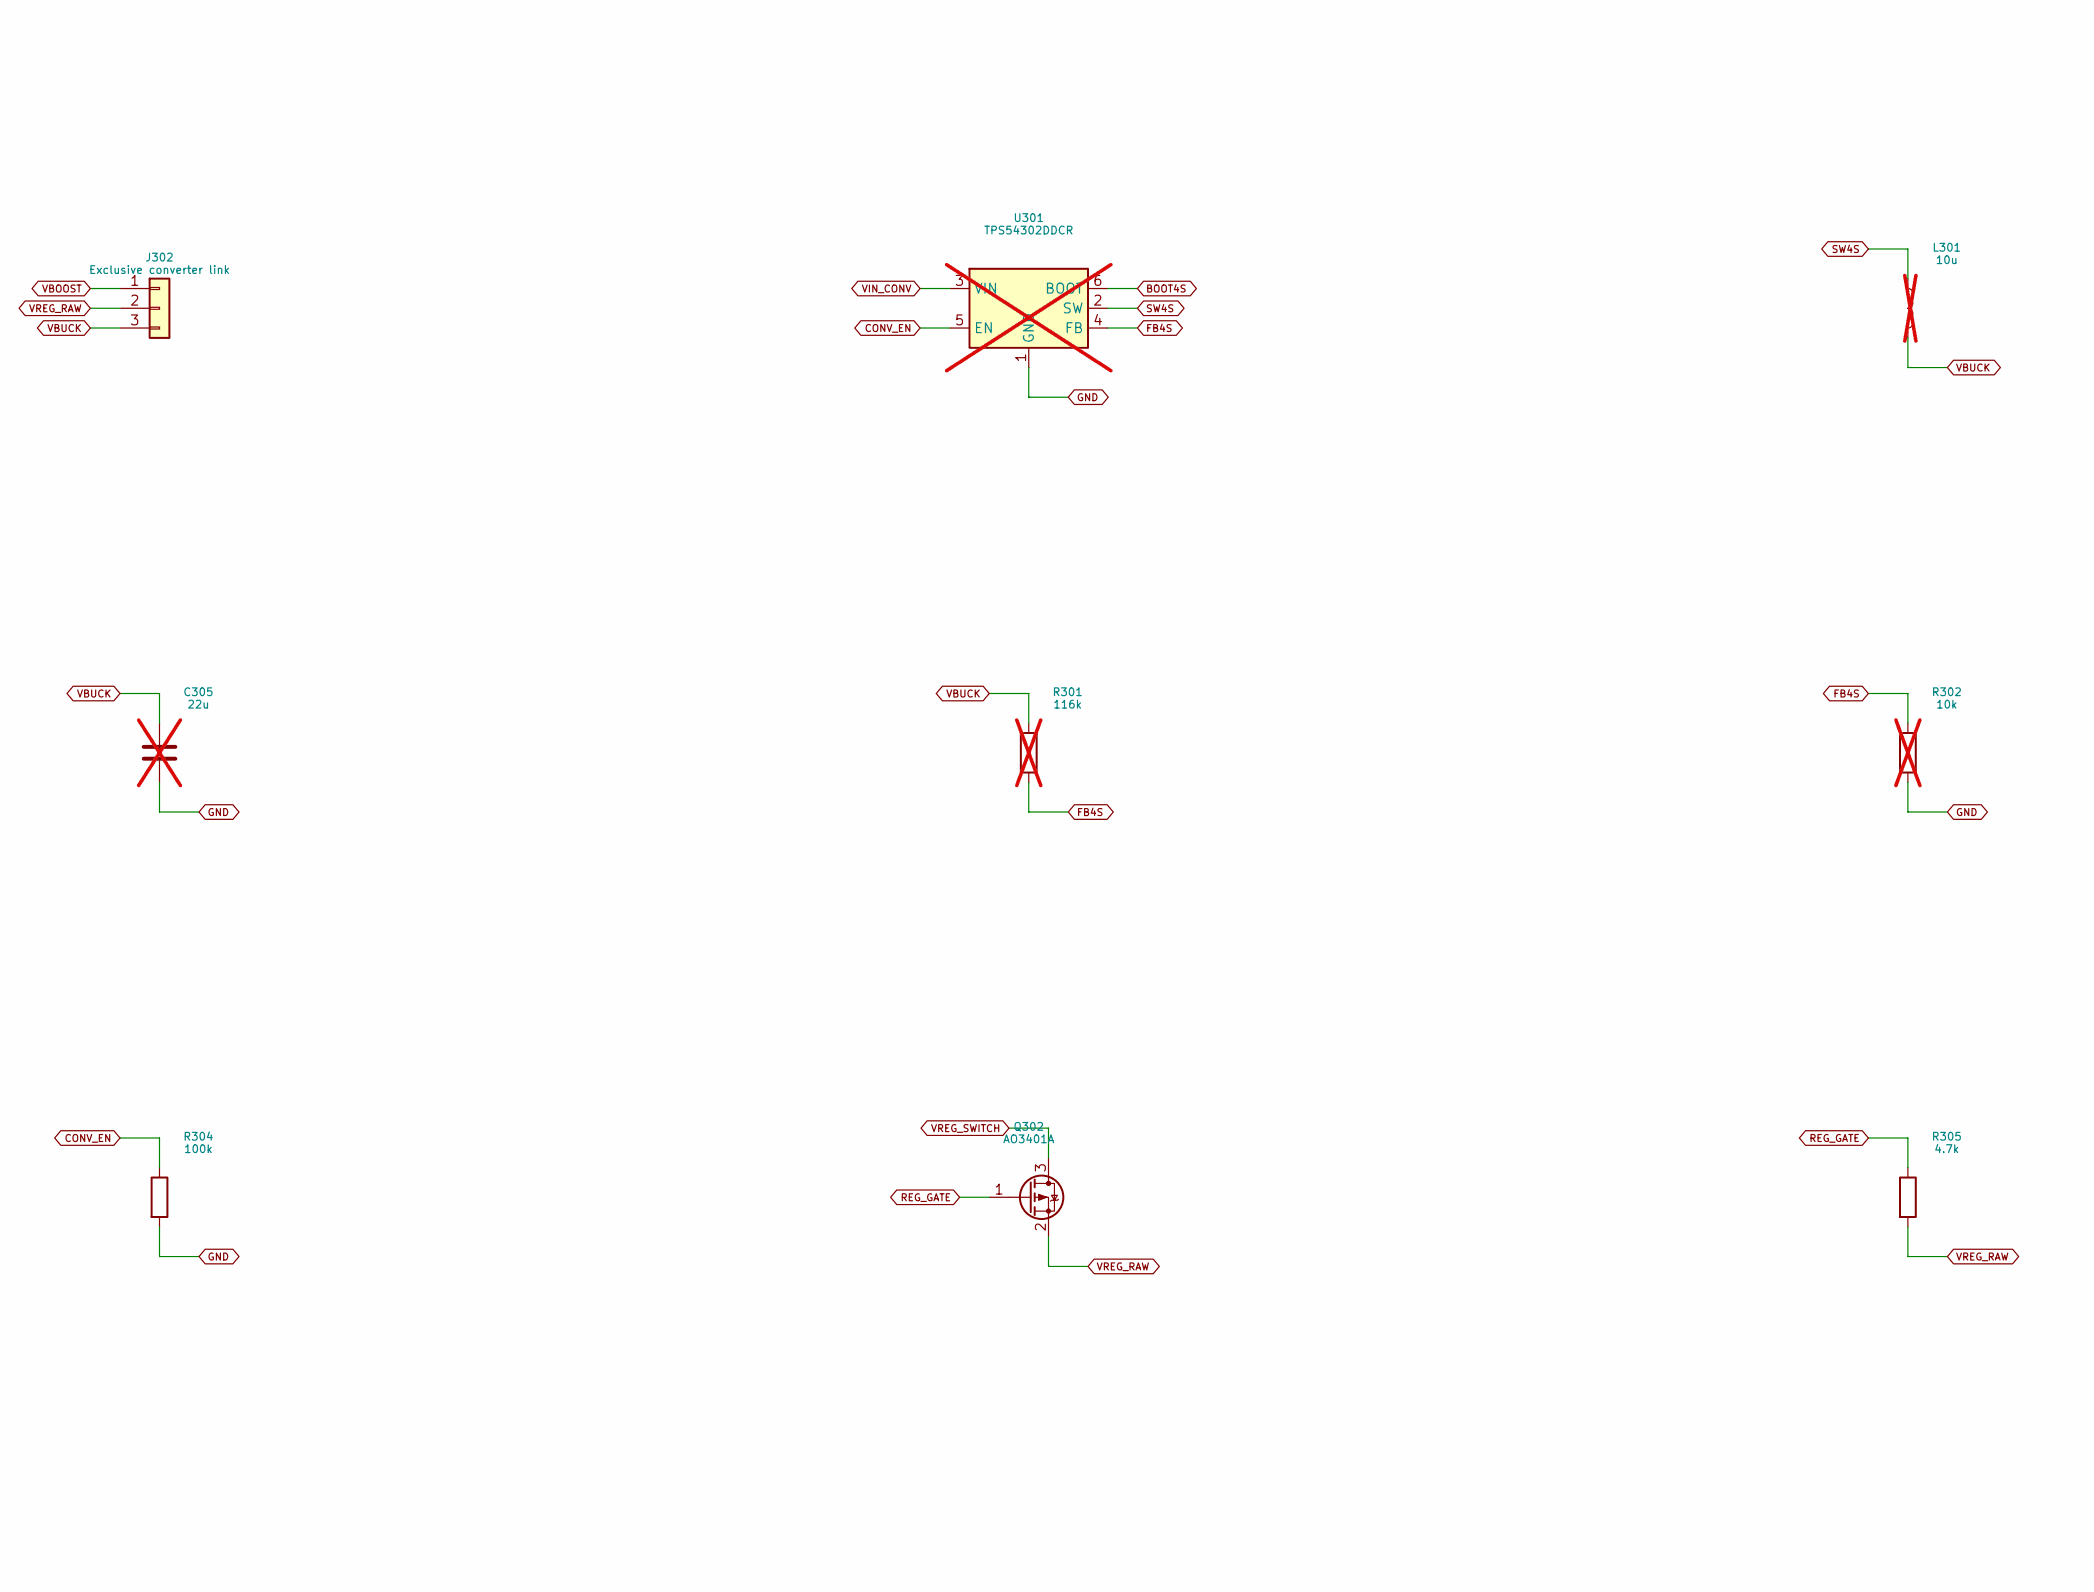
[picture p276: schematic 03_input_power.kicad_sch, 03 External protected pack and exclusive conversion populat…, part in row 2, column 2]

Parts:
C301: 10u; C_1210_3225Metric_E3; MPN C3225X7R1V106M250AC
C302, C310: 100n; C_0603_1608Metric_E3; MPN CC0603KRX7R8BB104
C303: 100n; C_0603_1608Metric_E3; MPN CC0603KRX7R8BB104; not fitted
C304, C305: 22u; C_1210_3225Metric_E3; MPN GRM32ER71E226KE15L; not fitted
D302: SMBJ18A; D_SMB_E3; MPN SMBJ18A-E3/52
D306: 10V input gate clamp; D_SOD-123F_E3; MPN BZT52H-C10,115
D307: 10V reverse-FET gate clamp; D_SOD-123F_E3; MPN BZT52H-C10,115
F301: 4A fast / qualify I2t; Fuse_1206_3216Metric_E3; MPN 0466004.NRHF
J301: Protected pack JST VH; JST_VH_B2P-VH_1x02_P3.96mm_Vertical_E3; MPN B2P-VH(LF)(SN)
J302: Exclusive converter link; PinHeader_1x03_P2.54mm_Vertical_E3; MPN TSW-103-07-G-S
L301: 10u; Bourns_SRP1265A; MPN SRP1265A-100M; not fitted
Q301: 2N7002; SOT-23_E3; MPN 2N7002,215; not fitted
Q302, Q305, Q309: AO3401A; SOT-23_E3; MPN AO3401A
Q306: MMBT3904,215; SOT-23_E3; MPN MMBT3904,215
R301: 116k; R_0603_1608Metric_E3; MPN RC0603FR-07116KL; not fitted
R302: 10k; R_0603_1608Metric_E3; MPN RC0603FR-0710KL; not fitted
R303: 46.4k; R_0603_1608Metric_E3; MPN RC0603FR-0746K4L; not fitted
R304, R313: 100k; R_0603_1608Metric_E3; MPN RC0603FR-07100KL
R305, R310, R312: 4.7k; R_0603_1608Metric_E3; MPN RC0603FR-074K7L
R311: 1k; R_0603_1608Metric_E3; MPN RC0603FR-071KL
R314: 10k; R_0603_1608Metric_E3; MPN RC0603FR-0710KL
U301: TPS54302DDCR; SOT-23-6_Handsoldering_E3; MPN TPS54302DDCR; not fitted
U304: SN74LVC2G08DCUR; VSSOP-8_2.3x2mm_P0.5mm_E3; MPN SN74LVC2G08DCUR

Connections:
BAT_FUSED: F301.2, Q309.3 (D)
BAT_RAW: F301.1, J301.1
BOOT4S: C303.1, U301.6 (BOOT)
CONV_EN: R304.1, U301.5 (EN), U304.1 (1A), U304.5 (2A); also elsewhere on the board
FB4S: R301.2, R302.1, R303.1, U301.4 (FB)
FB4S_SWITCH: Q301.3 (D), R303.2
GND: C301.2, C302.2, C304.2, C305.2, C310.2, D302.2 (A), J301.2, Q301.2 (S), Q306.2 (E), R302.2, R304.2, R313.2, R314.2, U301.1 (GND), U304.4 (GND); also elsewhere on the board
HARD_OK_N: U304.6 (2B); also elsewhere on the board
INPUT_ENABLE_BASE: Q306.1 (B), R312.2, R313.1
INPUT_GATE: D306.2 (A), Q305.1 (G), R310.1, R311.1
INPUT_SINK: Q306.3 (C), R311.2
PACK_OK_N: U304.2 (1B); also elsewhere on the board
PACK_RUN: R312.1, U304.7 (1Y)
PROFILE_Q: Q301.1 (G); also elsewhere on the board
RAIL_RUN: U304.3 (2Y); also elsewhere on the board
REG_GATE: Q302.1 (G), R305.1; also elsewhere on the board
REVERSE_GATE: D307.2 (A), Q309.1 (G), R314.1
SW4S: C303.2, L301.1, U301.2 (SW)
V3V3: C310.1, U304.8 (VCC); also elsewhere on the board
VBOOST: J302.1; also elsewhere on the board
VBUCK: C304.1, C305.1, J302.3, L301.2, R301.1
VIN_CONV: Q305.3 (D), U301.3 (VIN); also elsewhere on the board
VIN_PROT: C301.1, C302.1, D302.1 (K), D306.1 (K), D307.1 (K), Q305.2 (S), Q309.2 (S), R310.2; also elsewhere on the board
VREG_RAW: J302.2, Q302.2 (S), R305.2; also elsewhere on the board
VREG_SWITCH: Q302.3 (D); also elsewhere on the board

Notes on the sheet:
03 External protected pack and exclusive conversion populations
M5B-E6R2 / integrated evaluation PCB / NOT RELEASED / hardware tests NOT_RUN
M5B-E6R2: REVIEW / ALL hardware measurements NOT RUN / no ordering or manufacture.

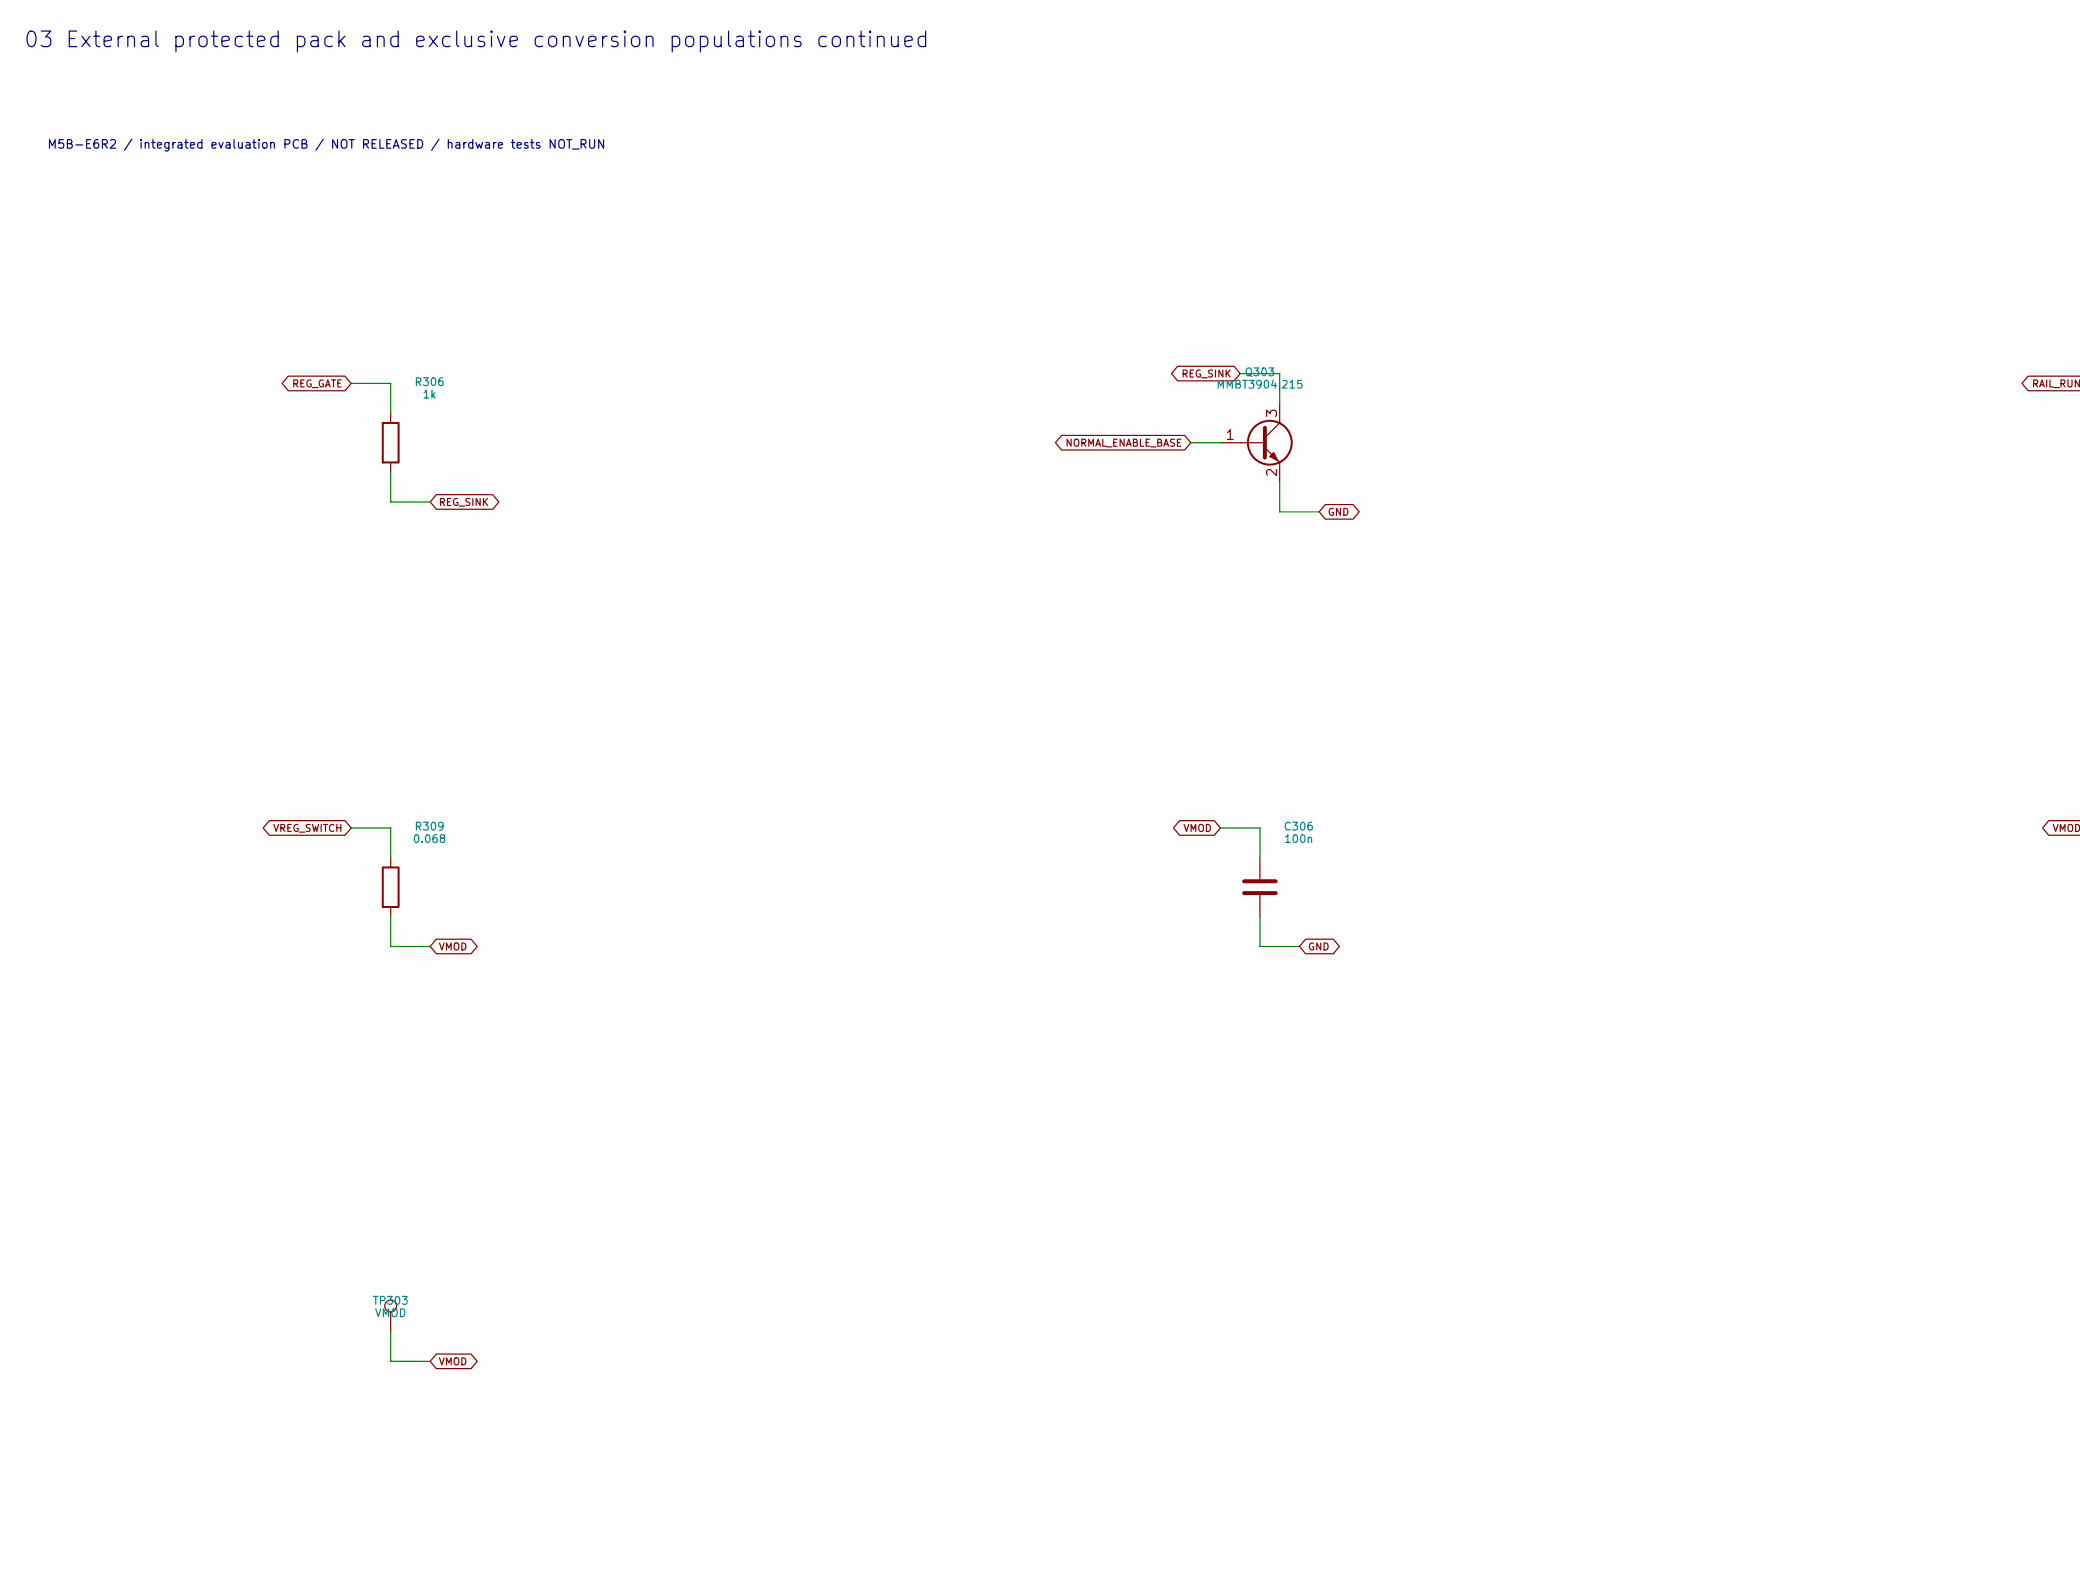
[picture p277: schematic 03_input_powerb1.kicad_sch, 03 External protected pack and exclusive conversion populat…, part in row 1, column 1]

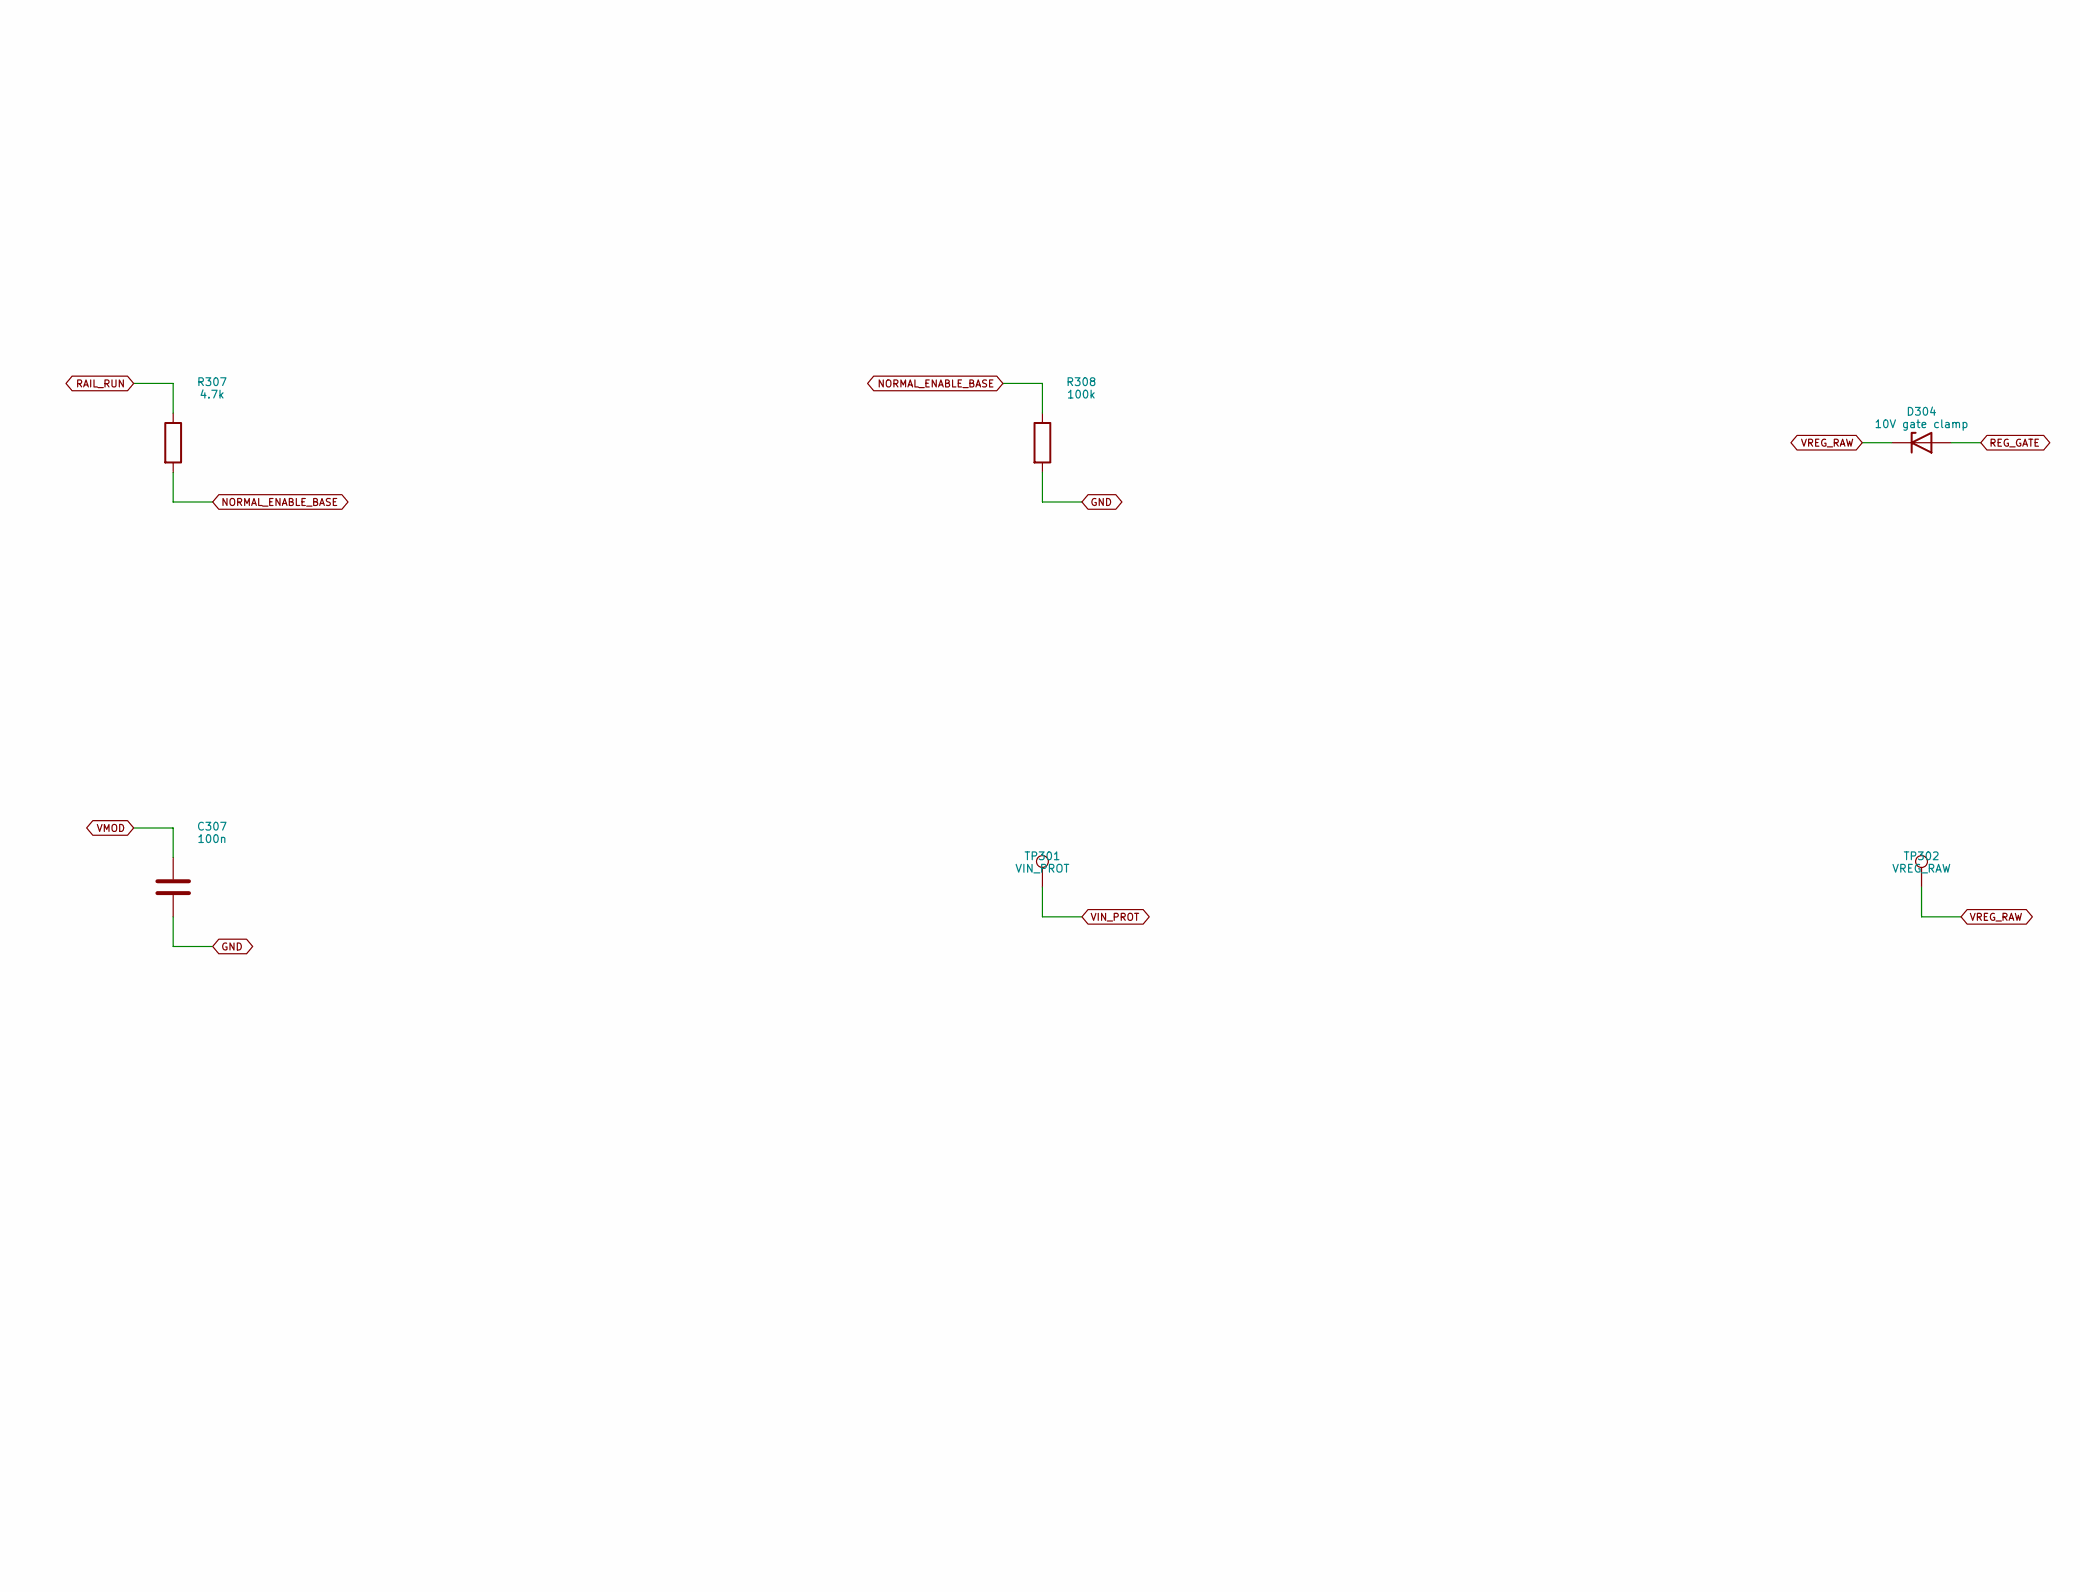
[picture p278: schematic 03_input_powerb1.kicad_sch, 03 External protected pack and exclusive conversion populat…, part in row 1, column 2]

Parts:
C306, C307: 100n; C_0603_1608Metric_E3; MPN CC0603KRX7R8BB104
D304: 10V gate clamp; D_SOD-123F_E3; MPN BZT52H-C10,115
Q303: MMBT3904,215; SOT-23_E3; MPN MMBT3904,215
R306: 1k; R_0603_1608Metric_E3; MPN RC0603FR-071KL
R307: 4.7k; R_0603_1608Metric_E3; MPN RC0603FR-074K7L
R308: 100k; R_0603_1608Metric_E3; MPN RC0603FR-07100KL
R309: 0.068; R_2512_6332Metric_E3; MPN WSL2512R0680FEA
TP301: VIN_PROT; TestPoint_Pad_D1.0mm_E3; MPN PCB feature
TP302: VREG_RAW; TestPoint_Pad_D1.0mm_E3; MPN PCB feature
TP303: VMOD; TestPoint_Pad_D1.0mm_E3; MPN PCB feature

Connections:
GND: C306.2, C307.2, Q303.2 (E), R308.2; also elsewhere on the board
NORMAL_ENABLE_BASE: Q303.1 (B), R307.2, R308.1
RAIL_RUN: R307.1; also elsewhere on the board
REG_GATE: D304.2 (A), R306.1; also elsewhere on the board
REG_SINK: Q303.3 (C), R306.2
VIN_PROT: TP301.1; also elsewhere on the board
VMOD: C306.1, C307.1, R309.2, TP303.1; also elsewhere on the board
VREG_RAW: D304.1 (K), TP302.1; also elsewhere on the board
VREG_SWITCH: R309.1; also elsewhere on the board

Notes on the sheet:
03 External protected pack and exclusive conversion populations continued
M5B-E6R2 / integrated evaluation PCB / NOT RELEASED / hardware tests NOT_RUN
M5B-E6R2: REVIEW / ALL hardware measurements NOT RUN / no ordering or manufacture.
