DD1SB/ARDF-TX/hardware/2m/RF2M.kicad_pcb

## KiCad design hardware/2m/RF2M.kicad_pcb (continued)

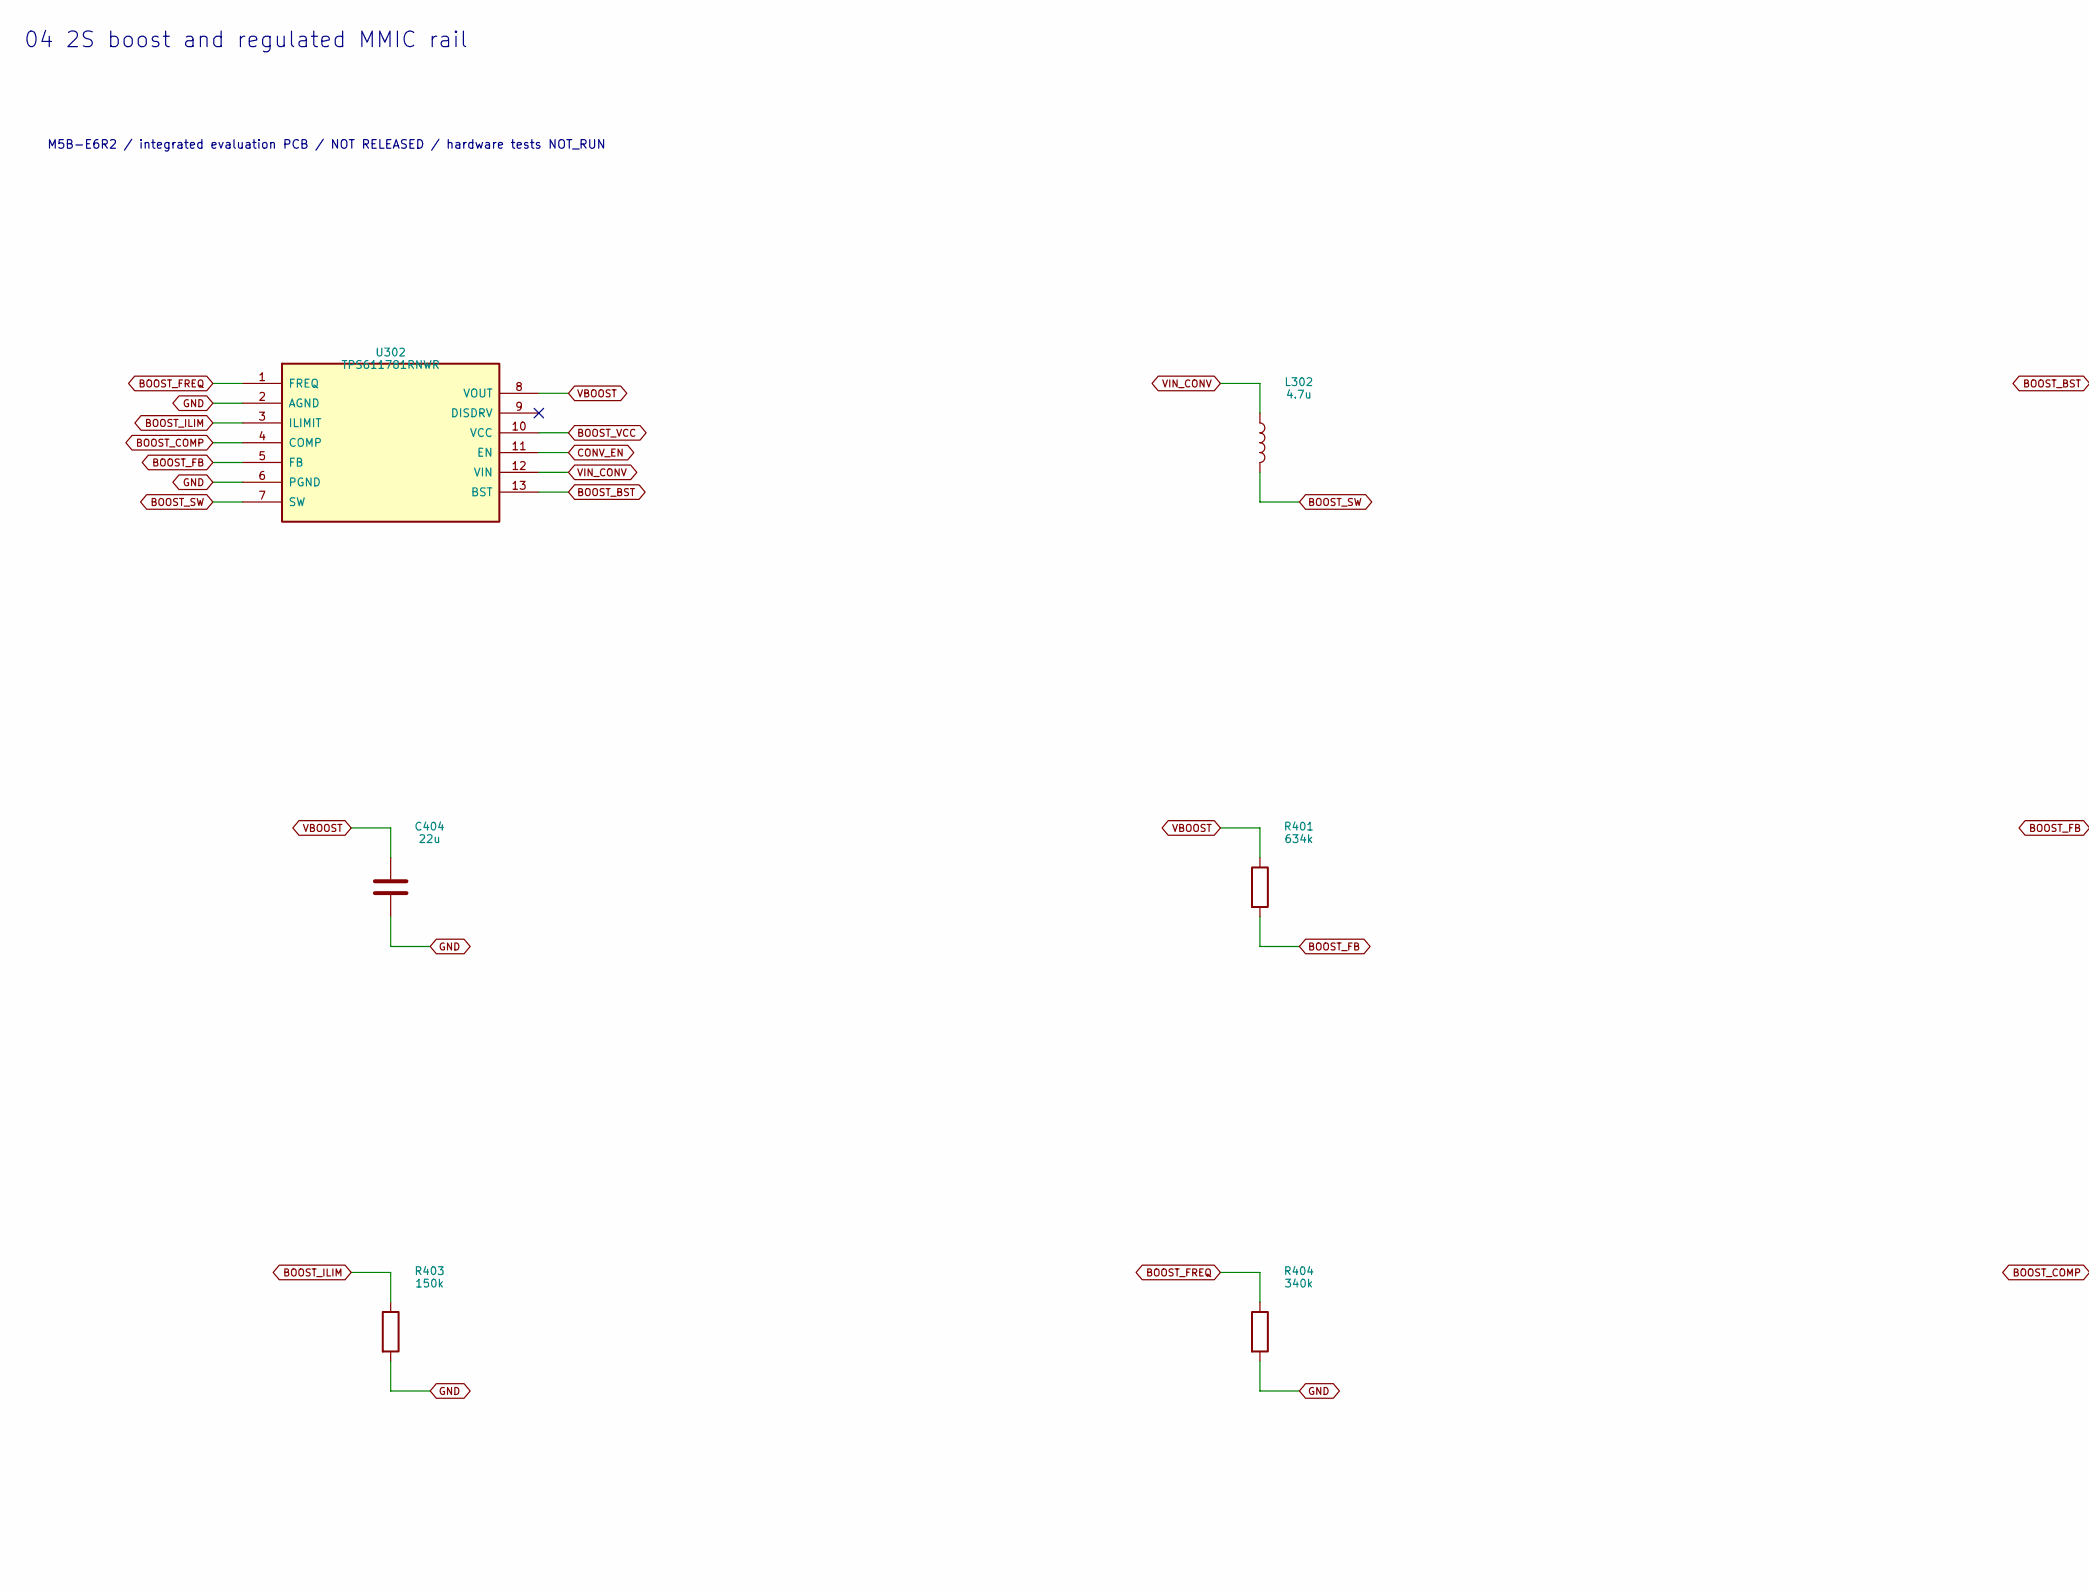
[picture p279: schematic 04_boost_driver_supply.kicad_sch, 04 2S boost and regulated MMIC rail, part in row 1, column 1]

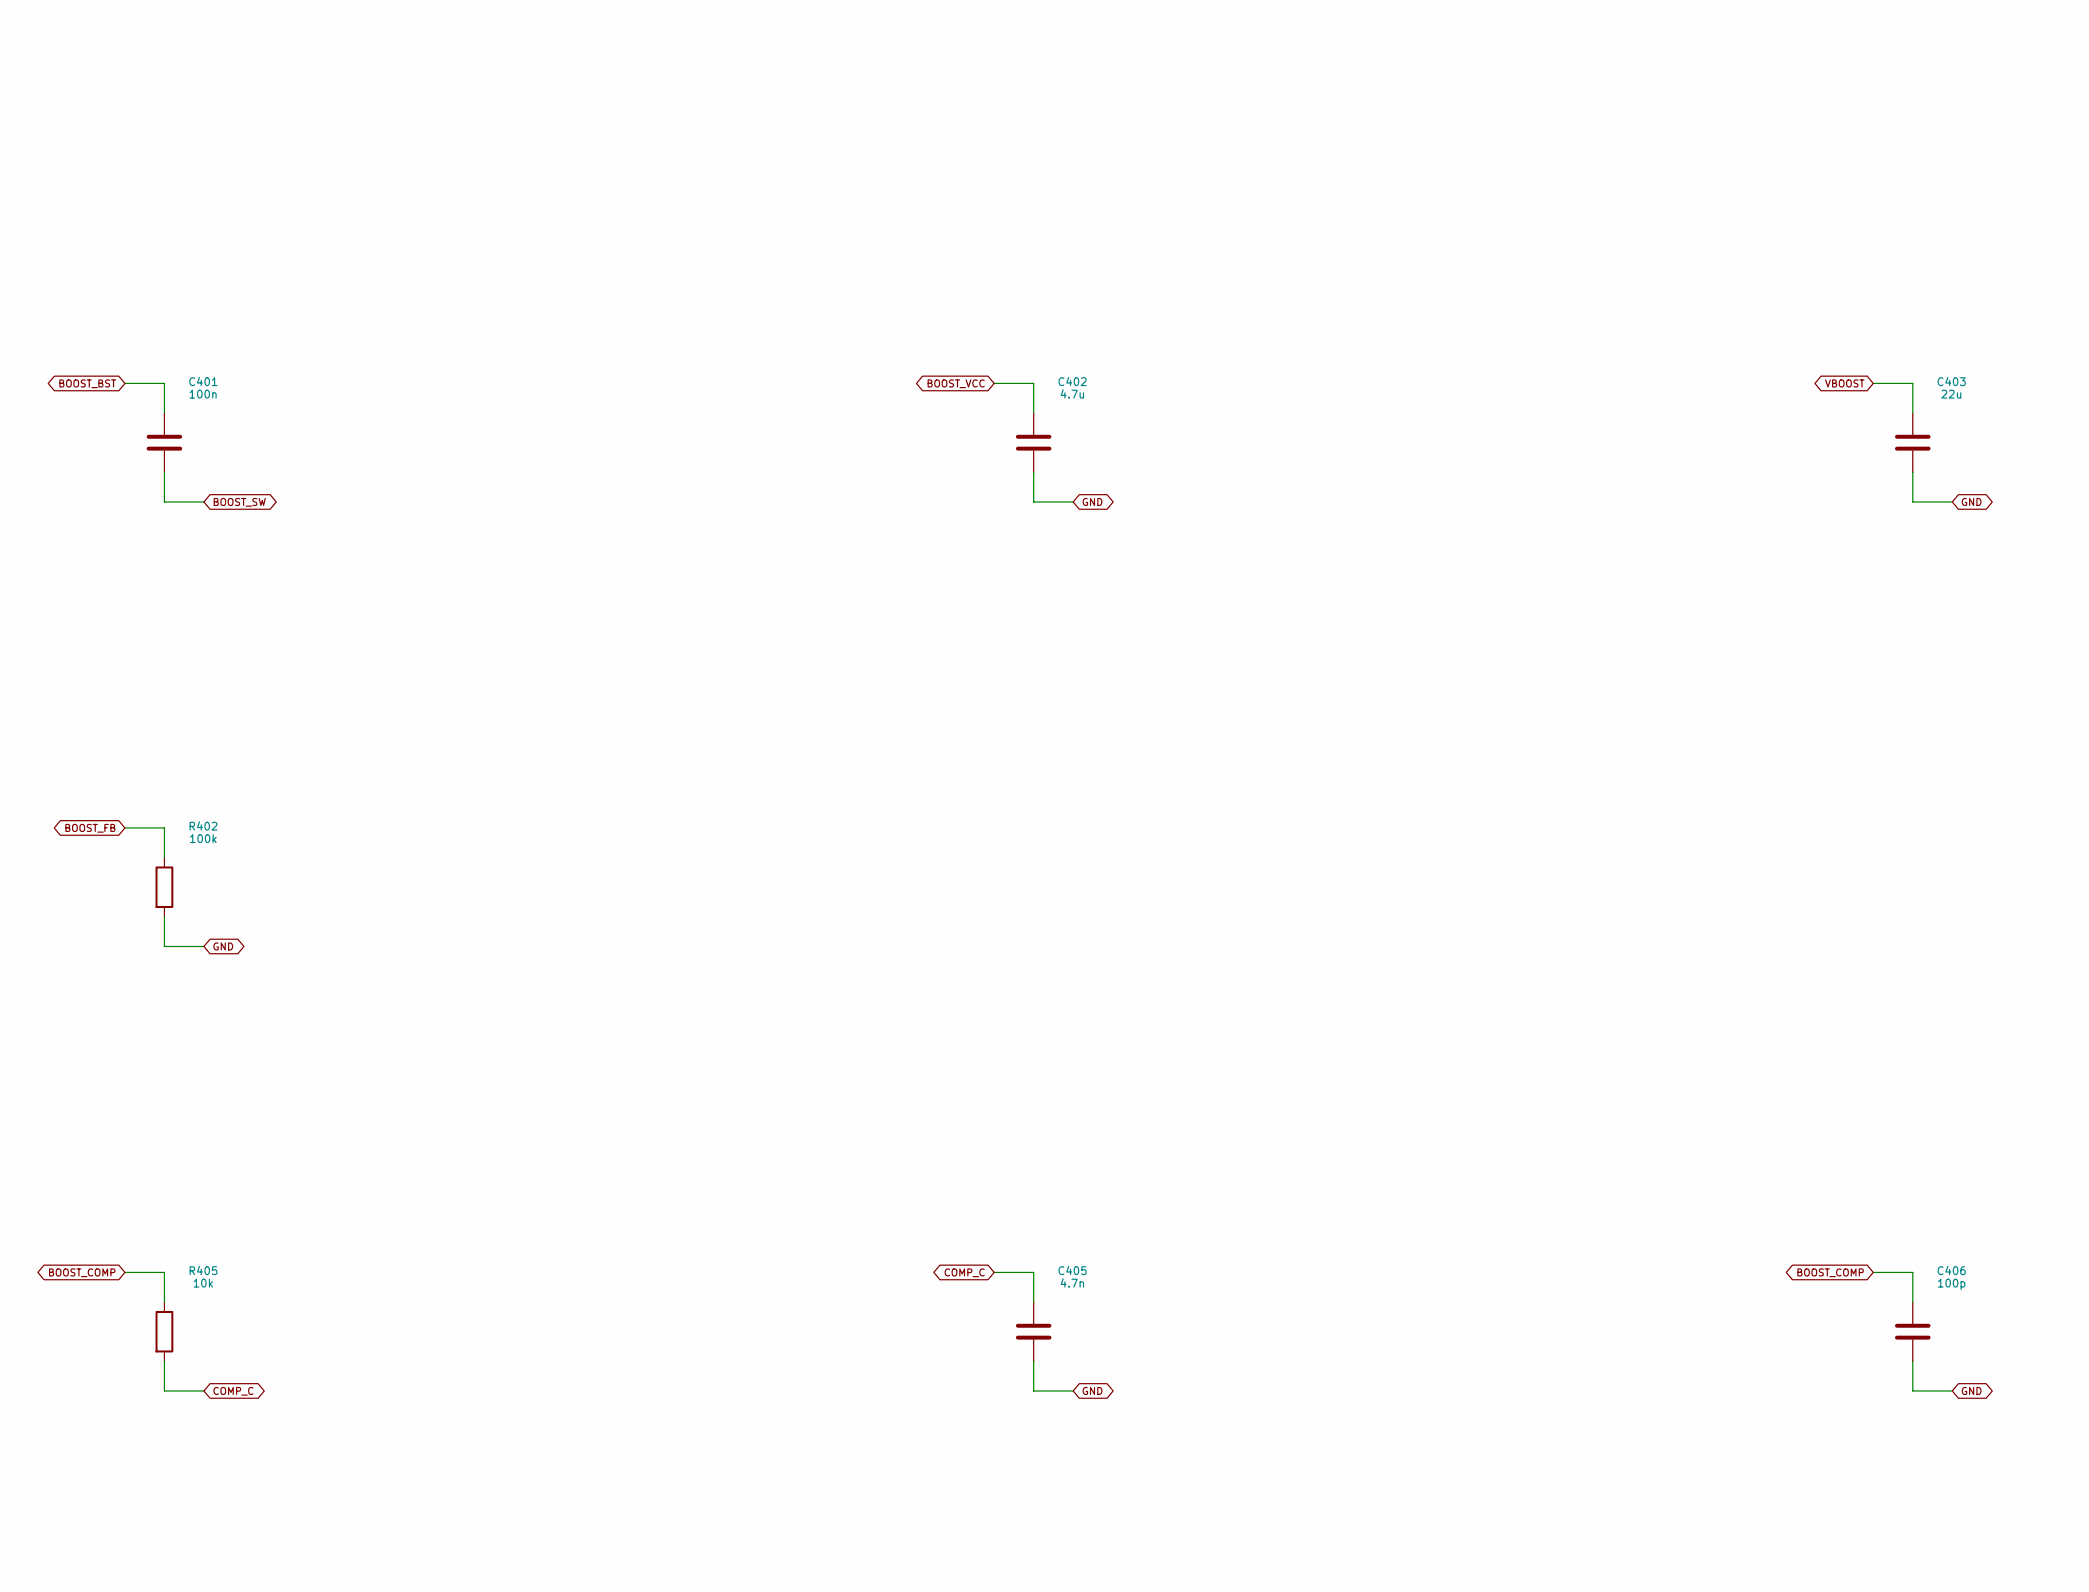
[picture p280: schematic 04_boost_driver_supply.kicad_sch, 04 2S boost and regulated MMIC rail, part in row 1, column 2]

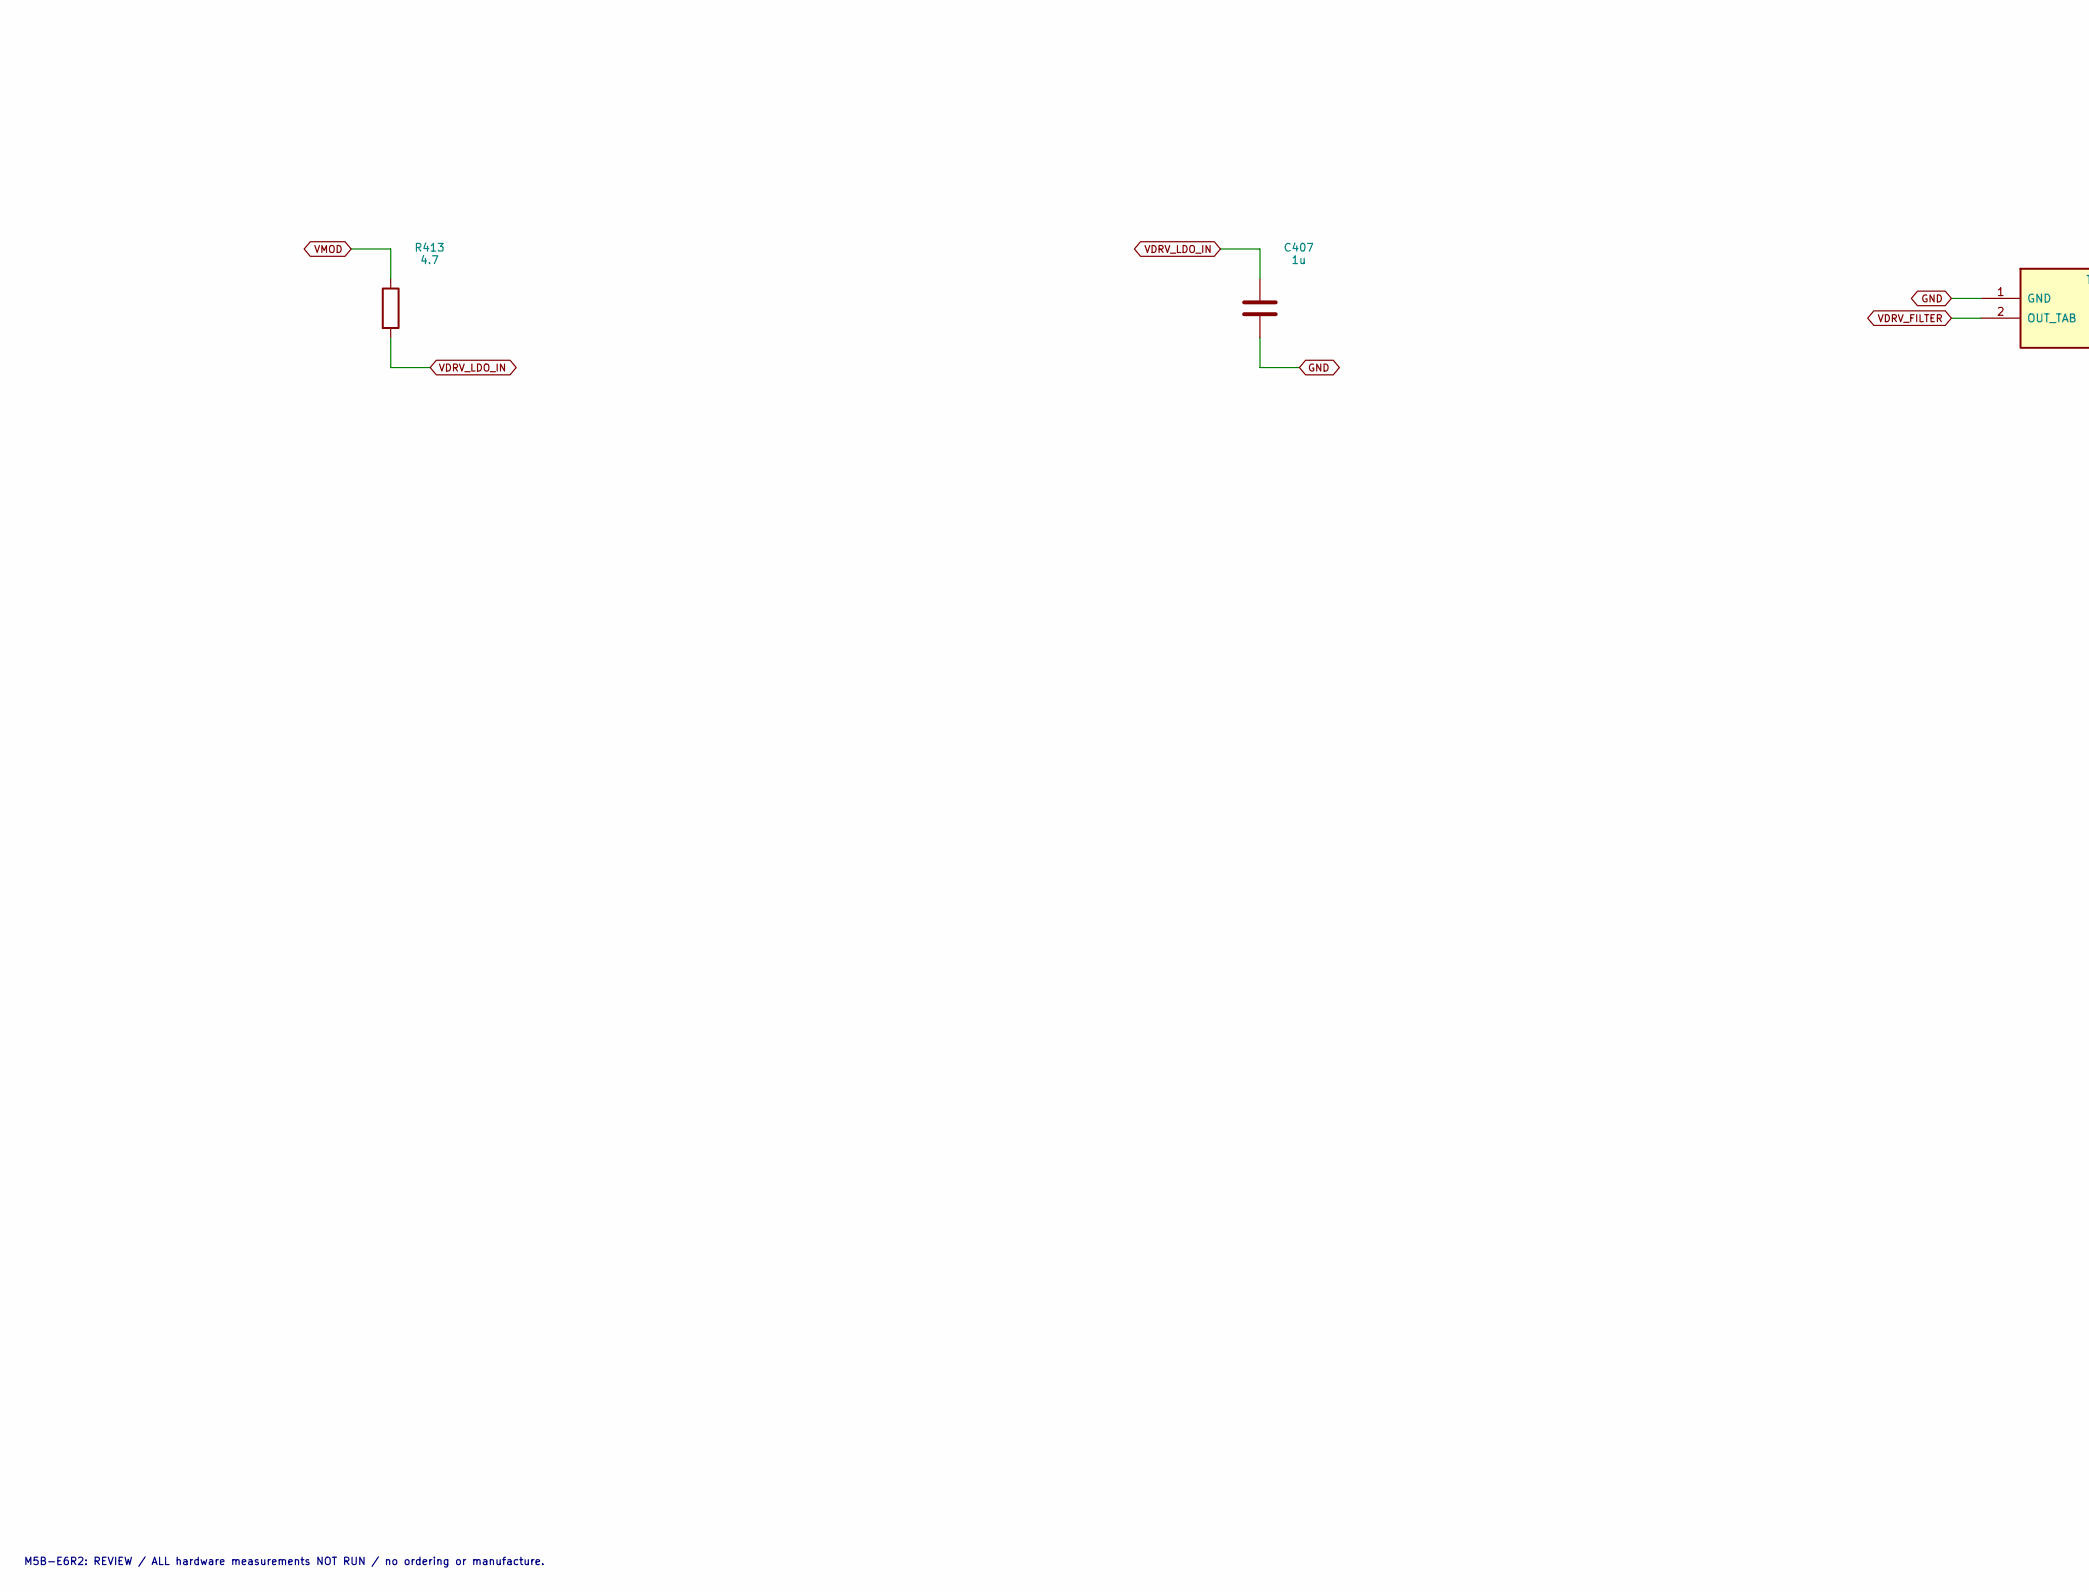
[picture p281: schematic 04_boost_driver_supply.kicad_sch, 04 2S boost and regulated MMIC rail, part in row 2, column 1]

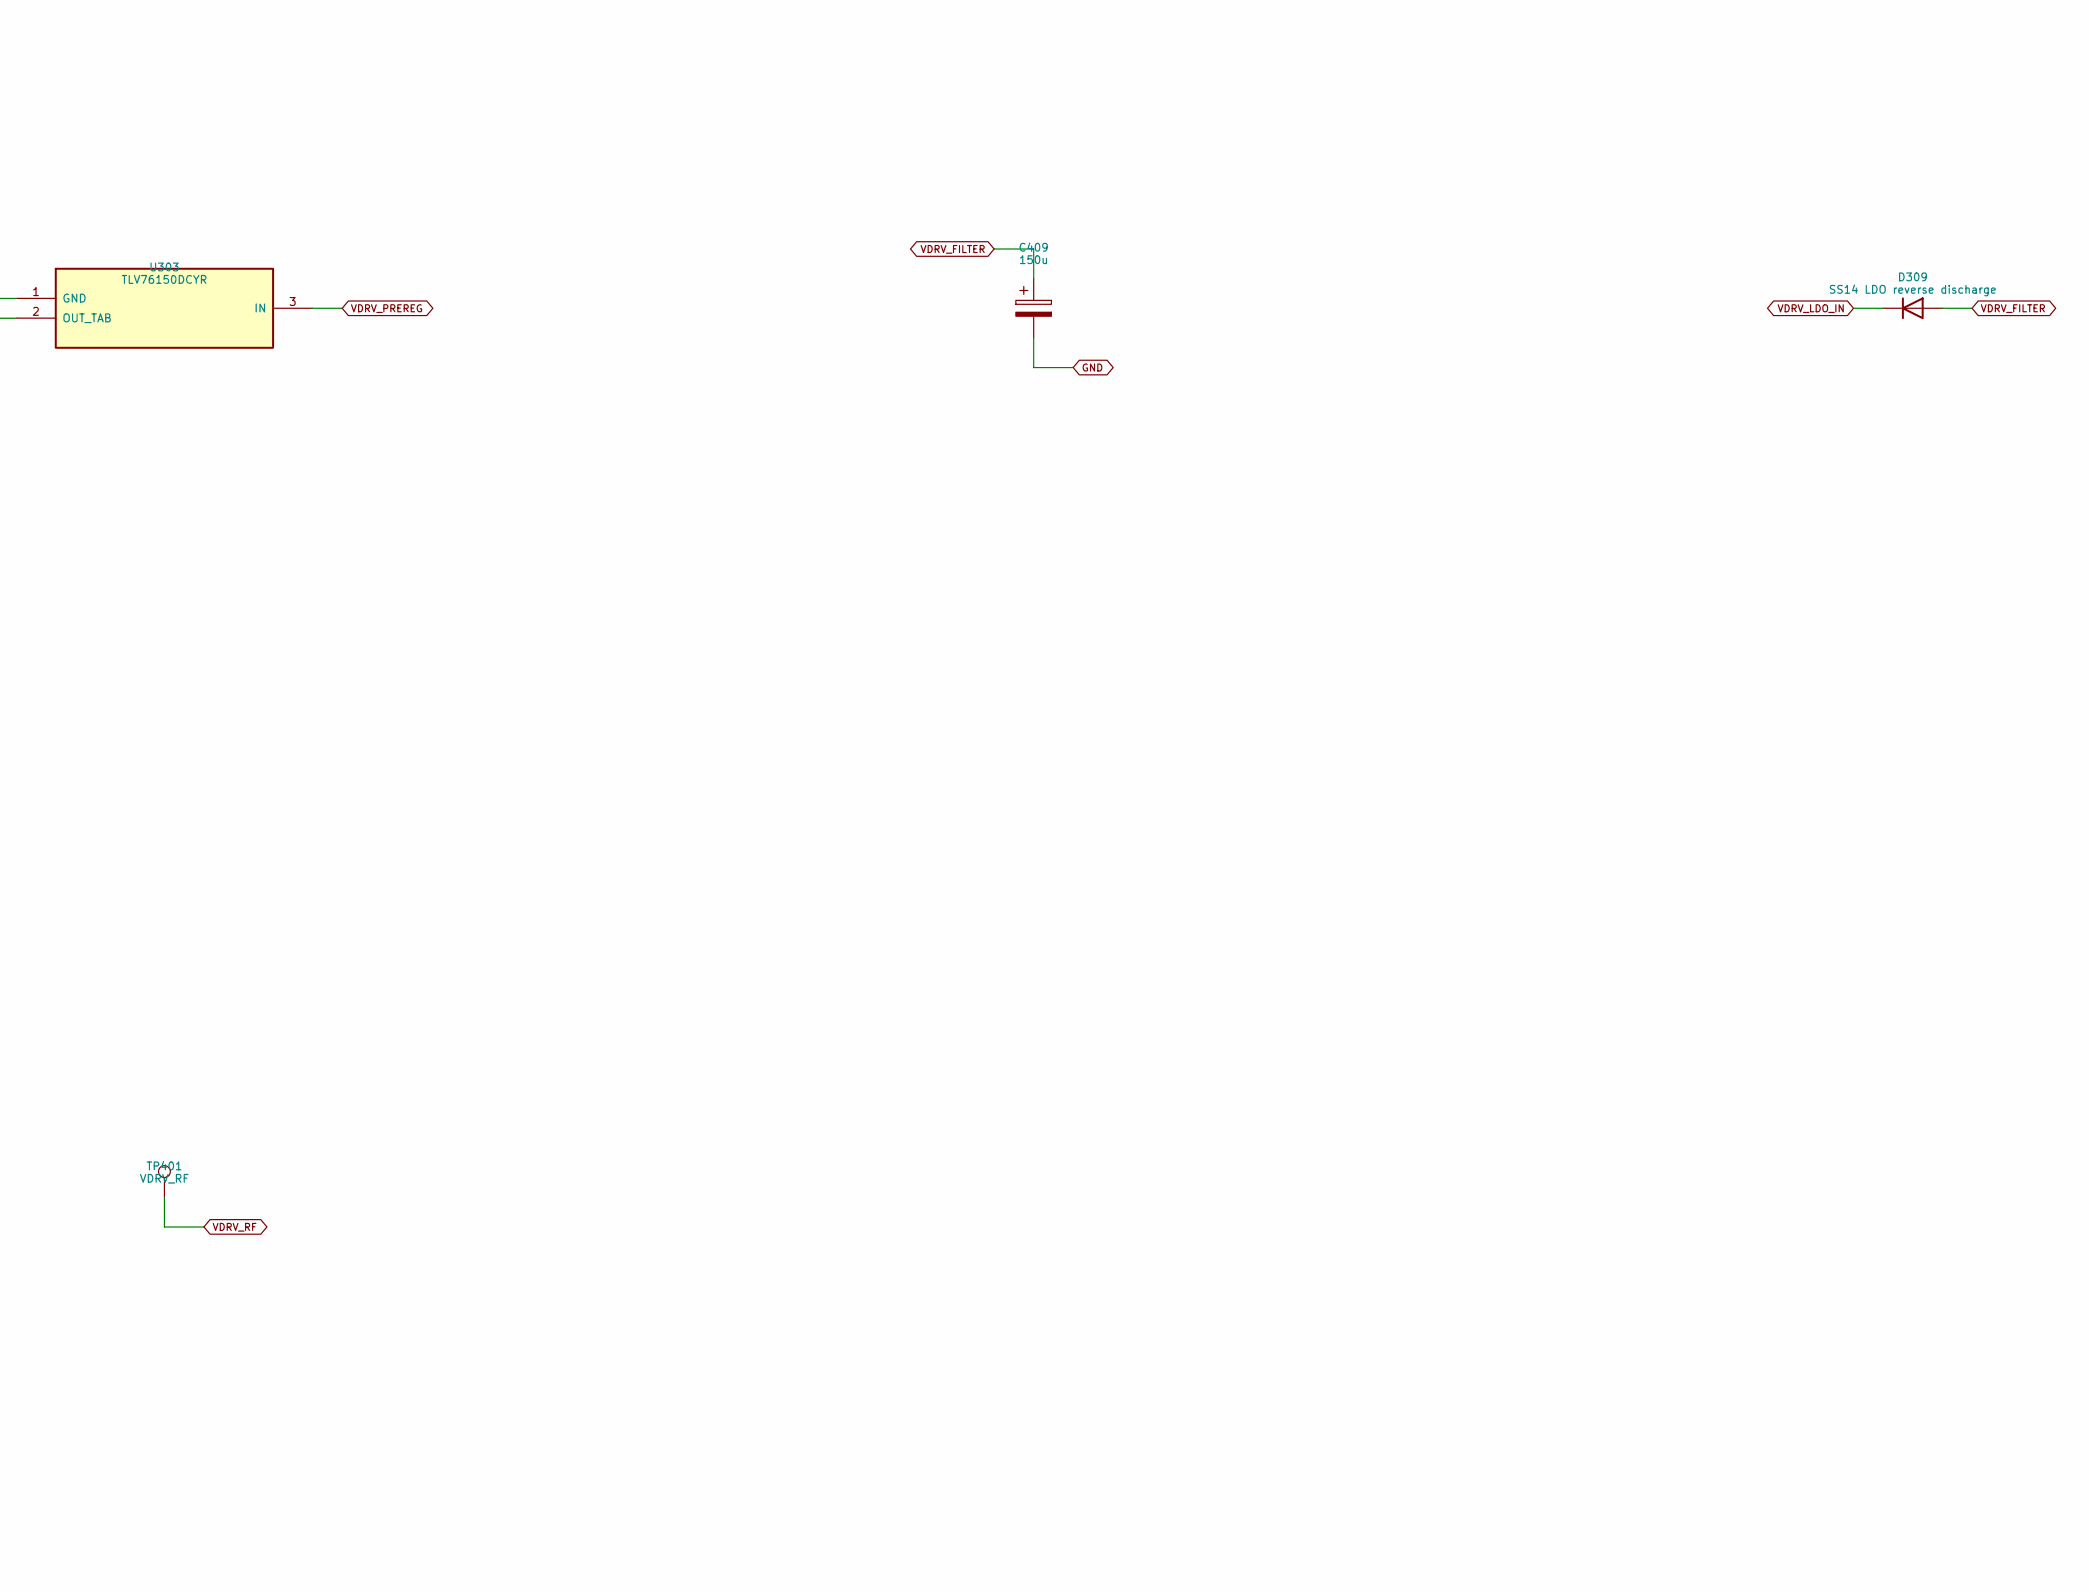
[picture p282: schematic 04_boost_driver_supply.kicad_sch, 04 2S boost and regulated MMIC rail, part in row 2, column 2]

Parts:
C401: 100n; C_0603_1608Metric_E3; MPN CC0603KRX7R8BB104
C402: 4.7u; C_1206_3216Metric_E3; MPN GRM31CR71E475KA88L
C403, C404: 22u; C_1210_3225Metric_E3; MPN GRM32ER71E226KE15L
C405: 4.7n; C_0603_1608Metric_E3; MPN CC0603JRNPO9BN472
C406: 100p; C_0603_1608Metric_E3; MPN CC0603JRNPO9BN101
C407: 1u; C_0805_2012Metric_E3; MPN CC0805KKX7R9BB105
C409: 150u; CP_Panasonic_OSCON_C10; MPN 25SVPG150M
D309: SS14 LDO reverse discharge; D_SMA_E3; MPN SS14-E3/61T
L302: 4.7u; Bourns_SRP1265A; MPN SRP1265A-4R7M
R401: 634k; R_0603_1608Metric_E3; MPN RC0603FR-07634KL
R402: 100k; R_0603_1608Metric_E3; MPN RC0603FR-07100KL
R403: 150k; R_0603_1608Metric_E3; MPN RC0603FR-07150KL
R404: 340k; R_0603_1608Metric_E3; MPN RC0603FR-07340KL
R405: 10k; R_0603_1608Metric_E3; MPN RC0603FR-0710KL
R413: 4.7; R_2512_6332Metric_E3; MPN RC2512FK-074R7L
TP401: VDRV_RF; TestPoint_Pad_D1.0mm_E3; MPN PCB feature
U302: TPS611781RNWR; TI_RNW0013A_4222804C; MPN TPS611781RNWR
U303: TLV76150DCYR; SOT-223-3_TabPin2_E3; MPN TLV76150DCYR

Connections:
BOOST_BST: C401.1, U302.13 (BST)
BOOST_COMP: C406.1, R405.1, U302.4 (COMP)
BOOST_FB: R401.2, R402.1, U302.5 (FB)
BOOST_FREQ: R404.1, U302.1 (FREQ)
BOOST_ILIM: R403.1, U302.3 (ILIMIT)
BOOST_SW: C401.2, L302.2, U302.7 (SW)
BOOST_VCC: C402.1, U302.10 (VCC)
COMP_C: C405.1, R405.2
CONV_EN: U302.11 (EN); also elsewhere on the board
GND: C402.2, C403.2, C404.2, C405.2, C406.2, C407.2, C409.2, R402.2, R403.2, R404.2, U302.2 (AGND), U302.6 (PGND), U303.1 (GND); also elsewhere on the board
VBOOST: C403.1, C404.1, R401.1, U302.8 (VOUT); also elsewhere on the board
VDRV_FILTER: C409.1, D309.2 (A), U303.2 (OUT_TAB); also elsewhere on the board
VDRV_LDO_IN: C407.1, D309.1 (K), R413.2; also elsewhere on the board
VDRV_PREREG: U303.3 (IN); also elsewhere on the board
VDRV_RF: TP401.1; also elsewhere on the board
VIN_CONV: L302.1, U302.12 (VIN); also elsewhere on the board
VMOD: R413.1; also elsewhere on the board

Notes on the sheet:
04 2S boost and regulated MMIC rail
M5B-E6R2 / integrated evaluation PCB / NOT RELEASED / hardware tests NOT_RUN
M5B-E6R2: REVIEW / ALL hardware measurements NOT RUN / no ordering or manufacture.
