DD1SB/ARDF-TX/hardware/2m/RF2M.kicad_pcb

## KiCad design hardware/2m/RF2M.kicad_pcb (continued)

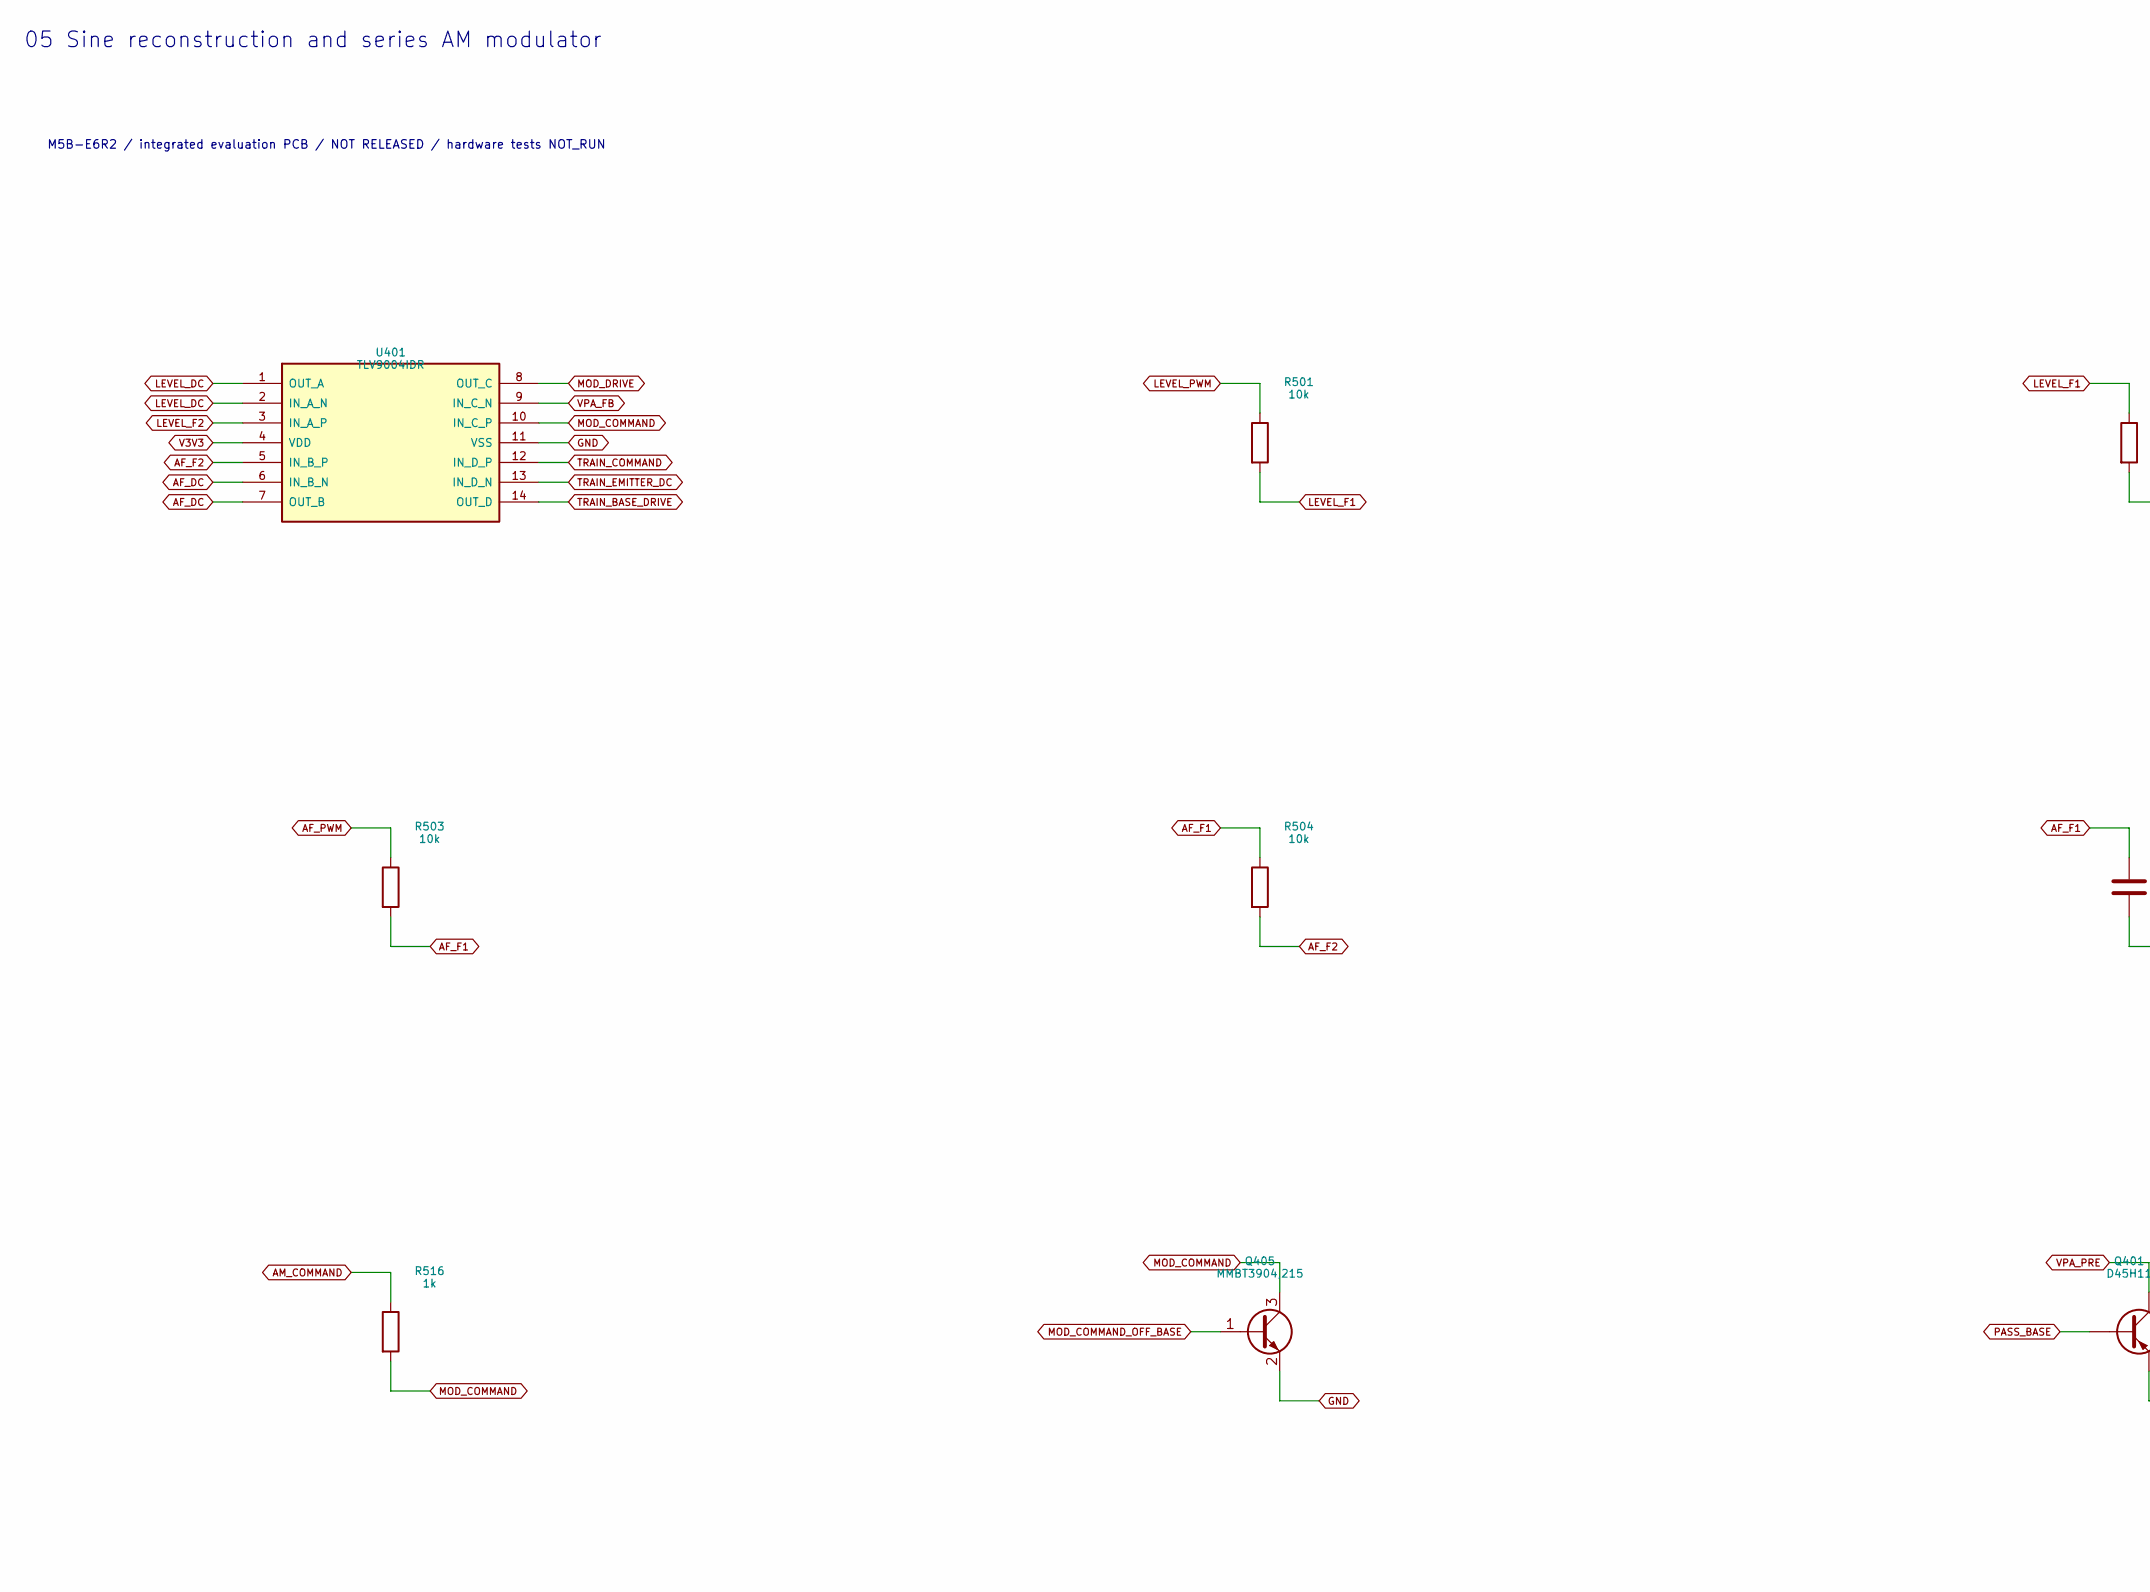
[picture p283: schematic 05_am.kicad_sch, 05 Sine reconstruction and series AM modulator, part in row 1, column 1]

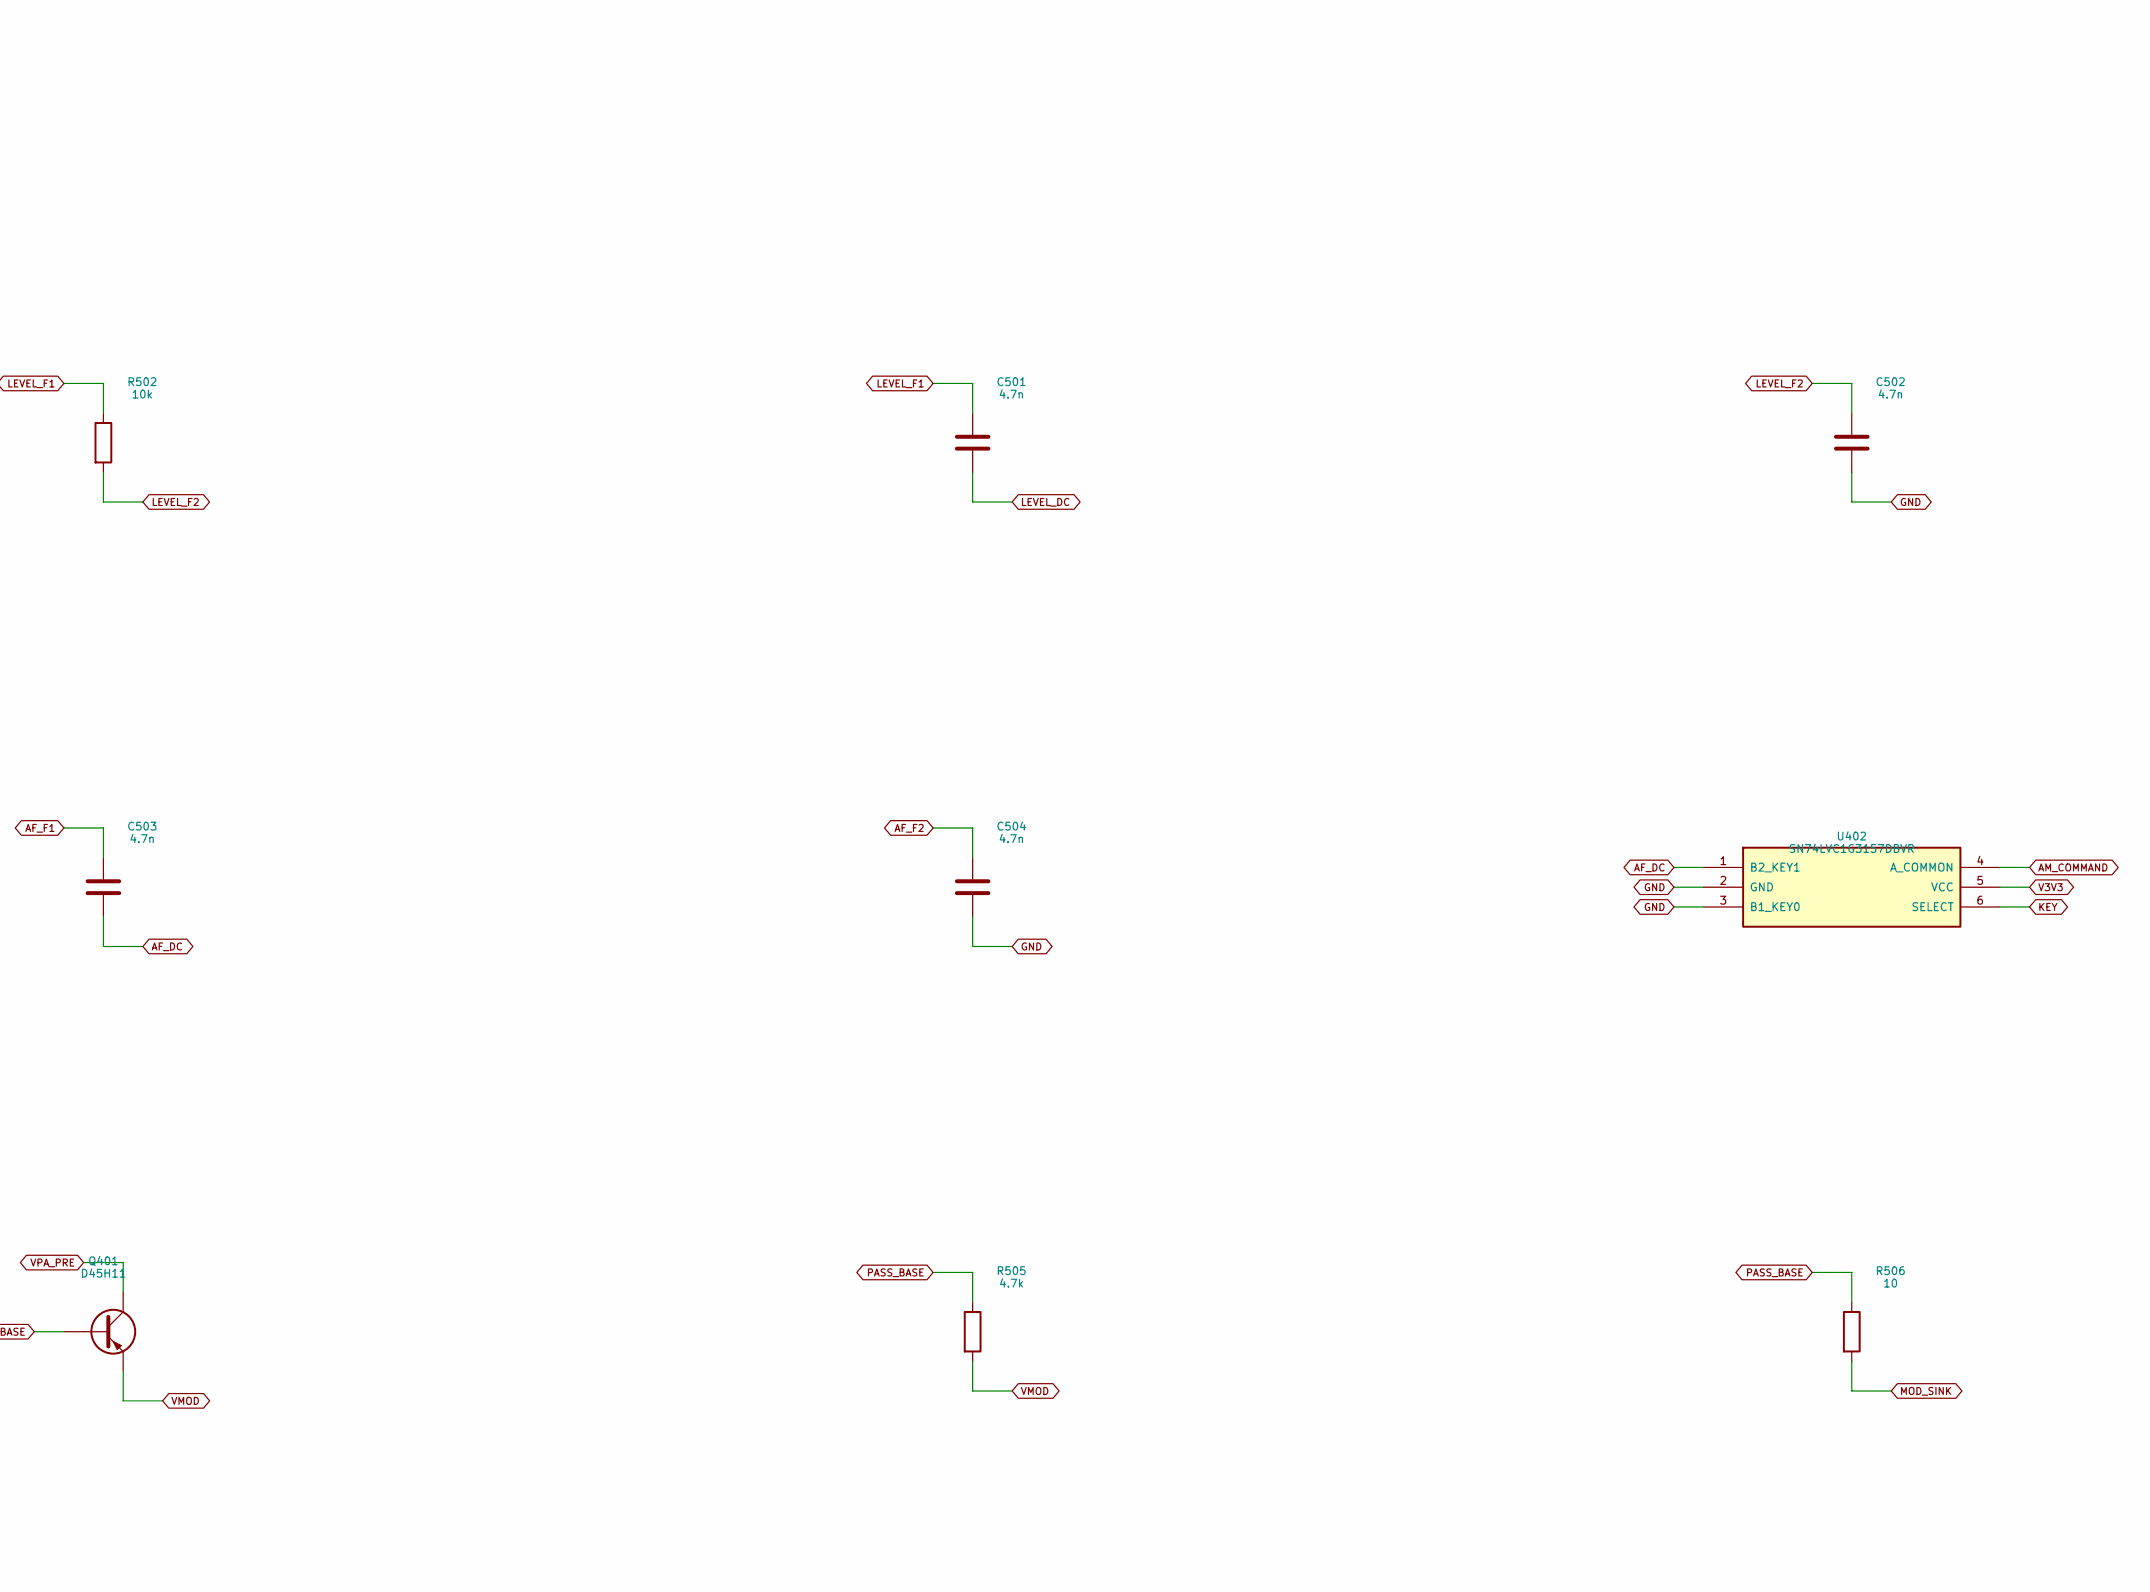
[picture p284: schematic 05_am.kicad_sch, 05 Sine reconstruction and series AM modulator, part in row 1, column 2]

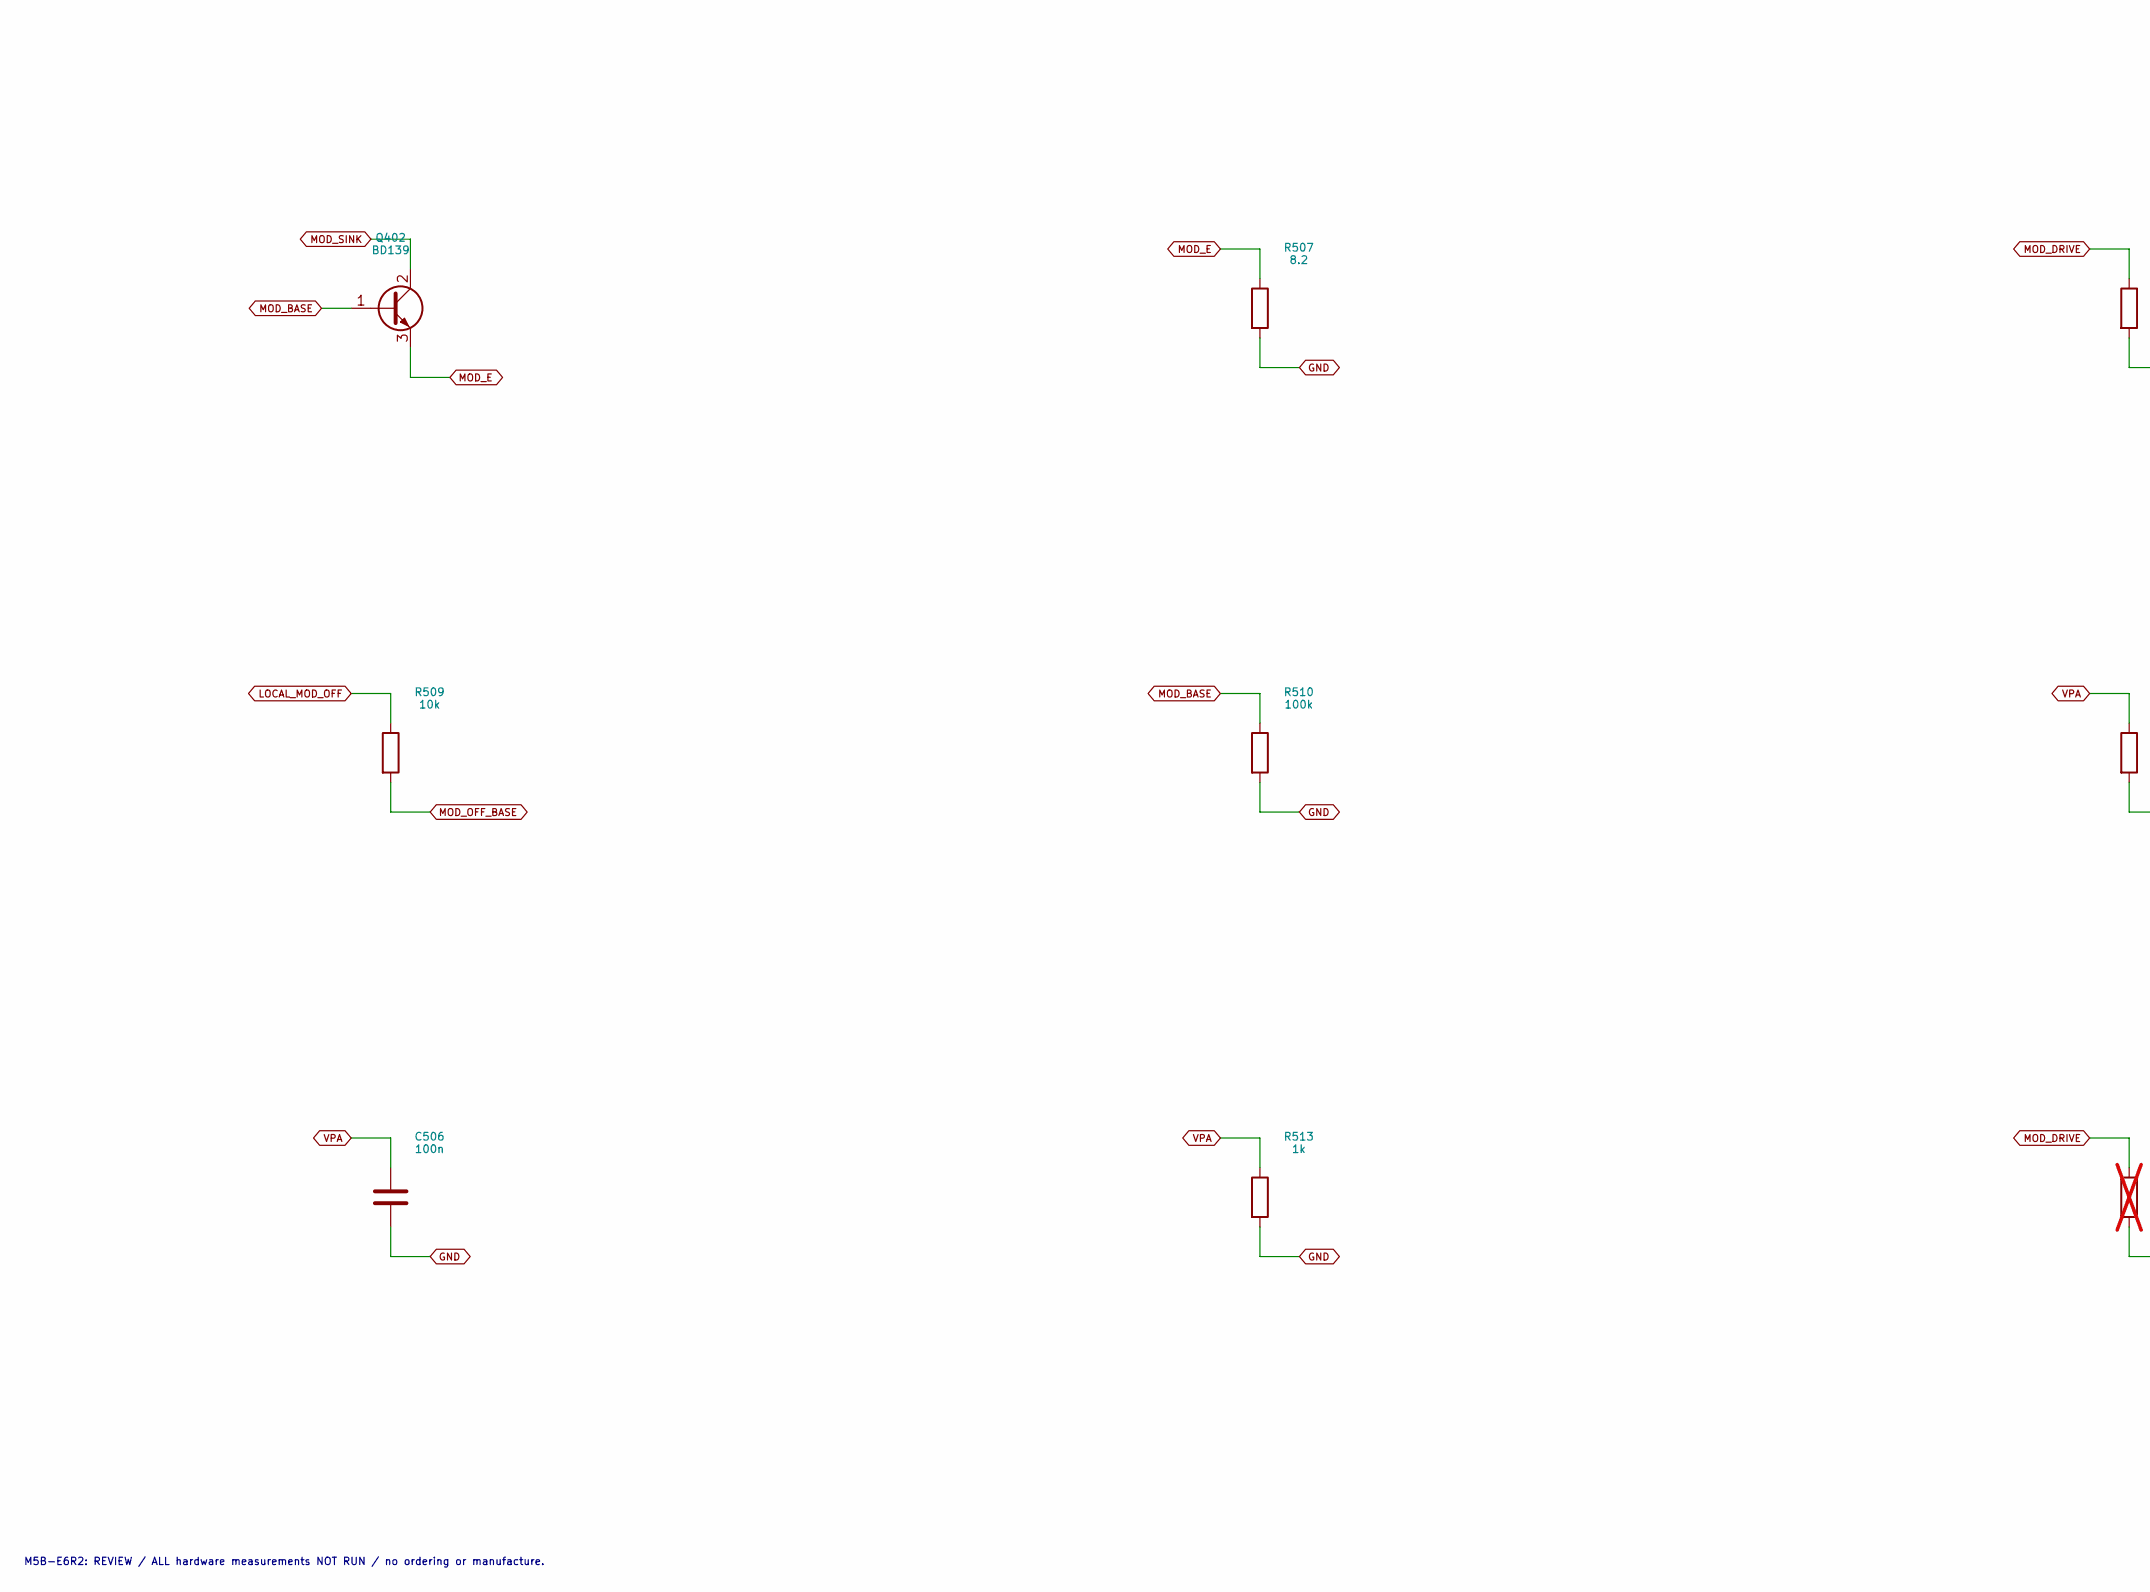
[picture p285: schematic 05_am.kicad_sch, 05 Sine reconstruction and series AM modulator, part in row 2, column 1]

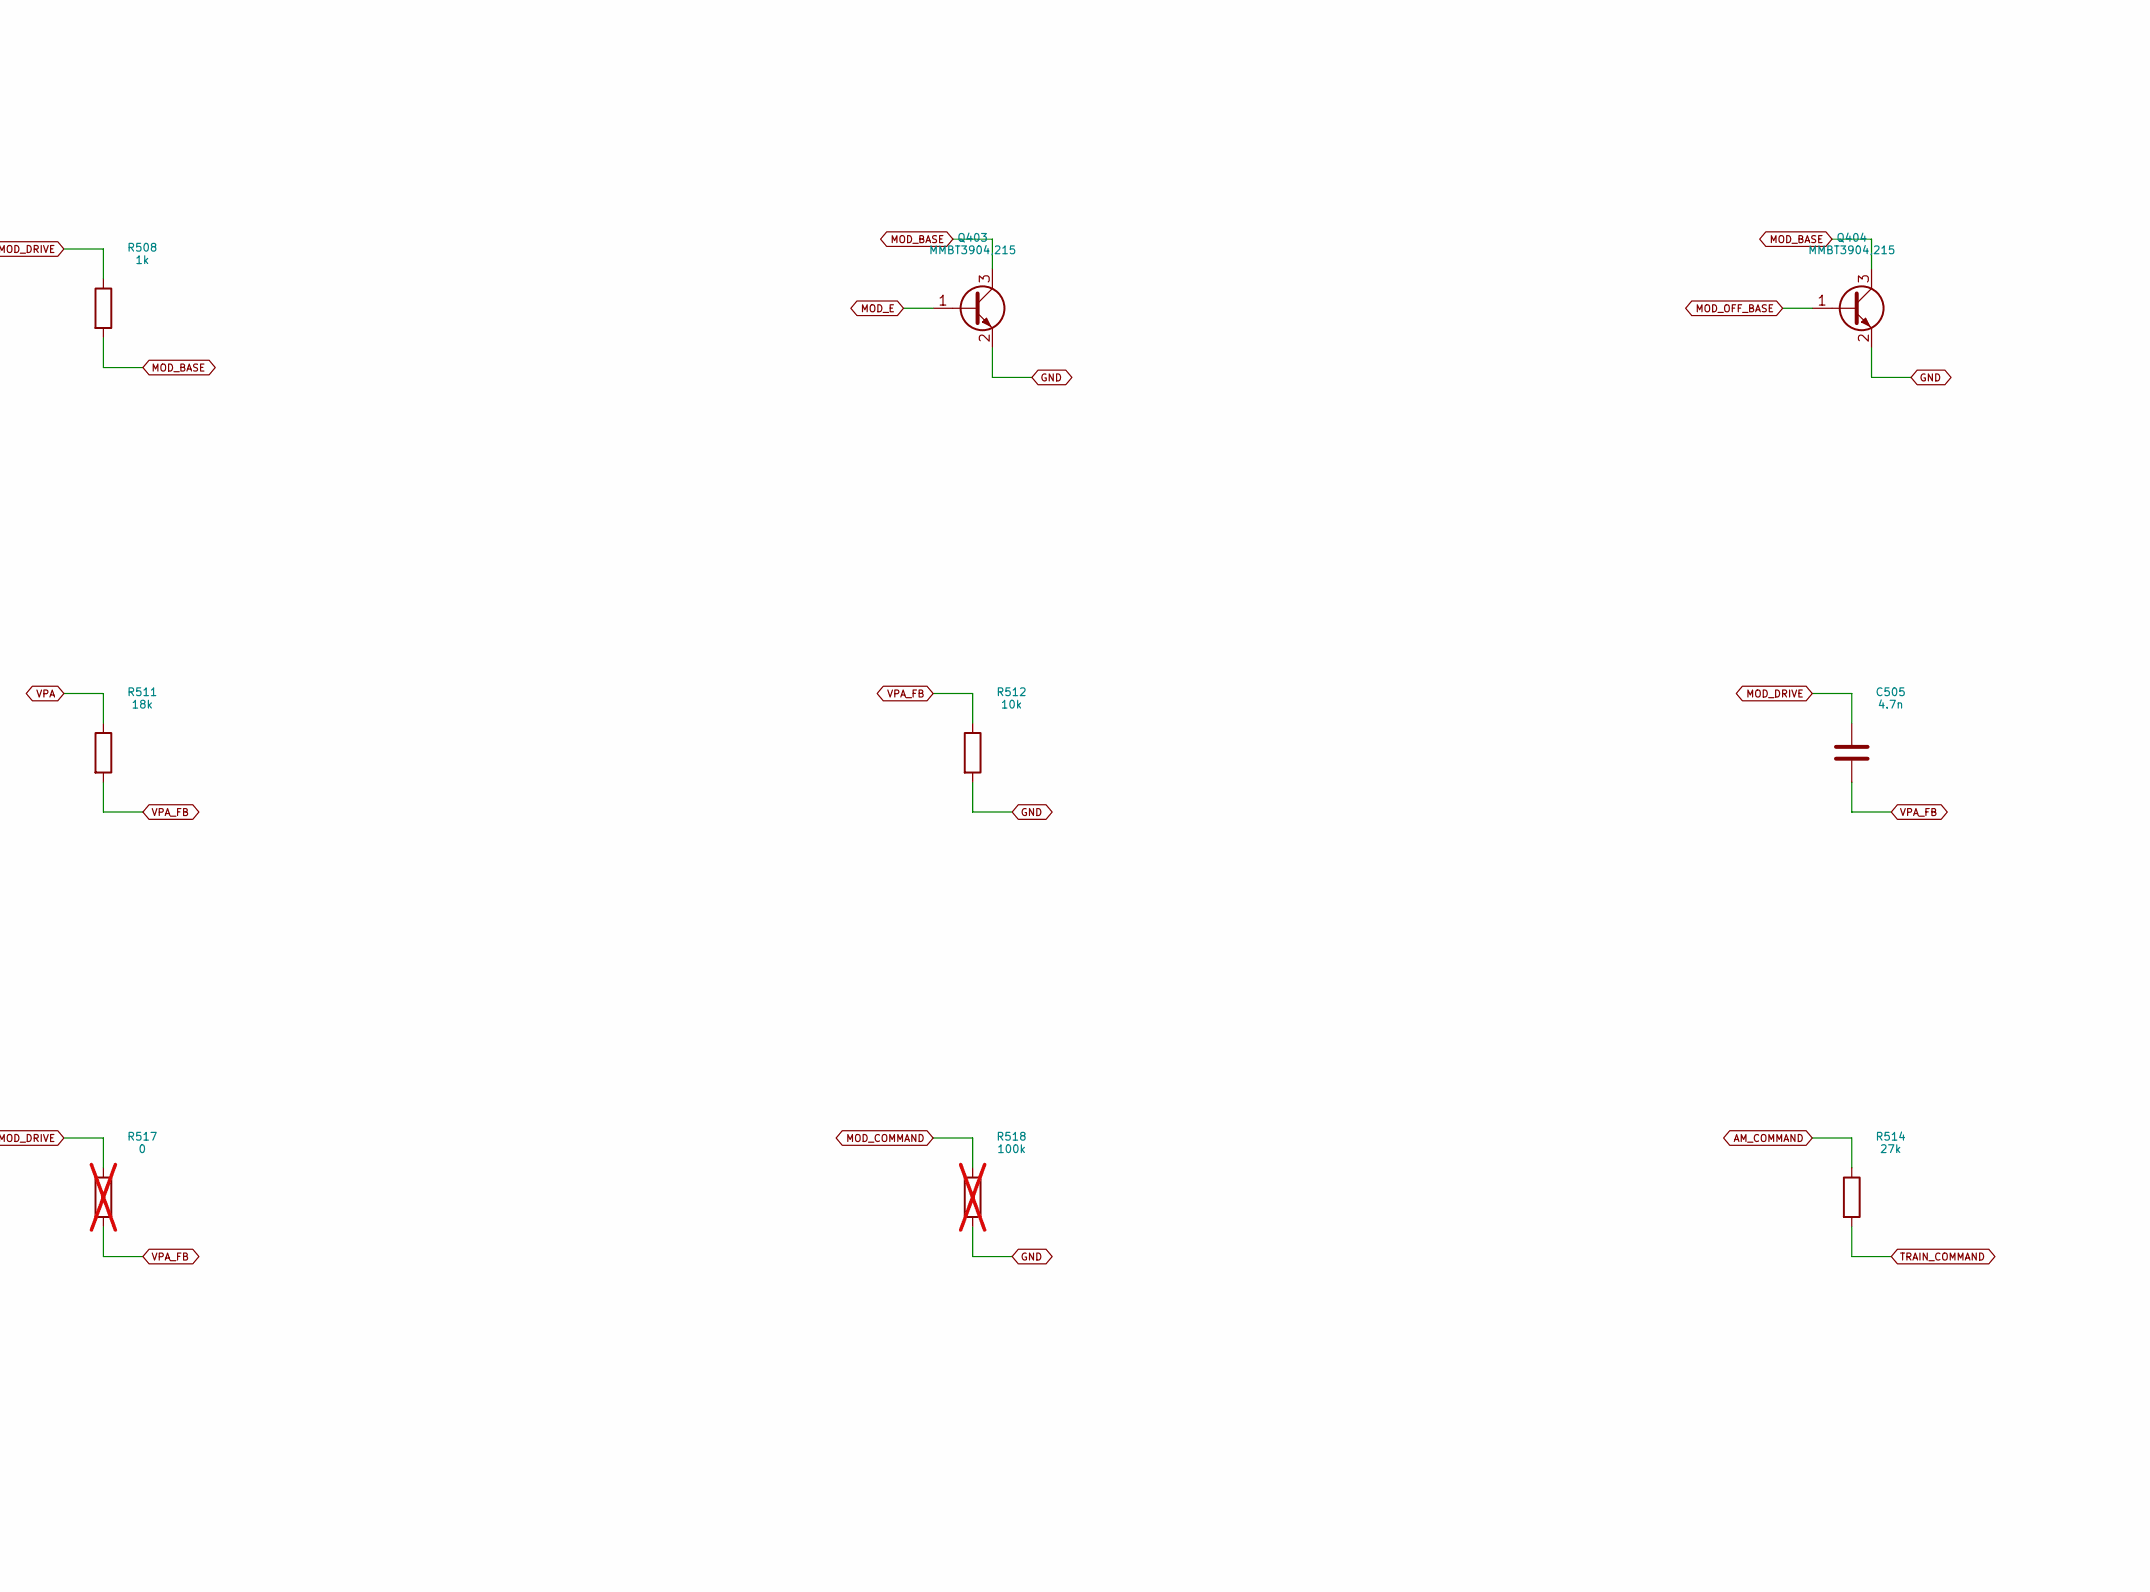
[picture p286: schematic 05_am.kicad_sch, 05 Sine reconstruction and series AM modulator, part in row 2, column 2]

Parts:
C501, C502, C503, C504, C505: 4.7n; C_0603_1608Metric_E3; MPN CC0603JRNPO9BN472
C506: 100n; C_0603_1608Metric_E3; MPN CC0603KRX7R8BB104
Q401: D45H11; TO220_Flat_CommonPlane_E6R2; MPN D45H11
Q402: BD139; TO126_Flat_CommonPlane_E6R2; MPN BD139
Q403, Q404, Q405: MMBT3904,215; SOT-23_E3; MPN MMBT3904,215
R501, R502, R503, R504, R509, R512: 10k; R_0603_1608Metric_E3; MPN RC0603FR-0710KL
R505: 4.7k; R_0603_1608Metric_E3; MPN RC0603FR-074K7L
R506: 10; R_2512_6332Metric_E3; MPN RC2512FK-0710RL
R507: 8.2; R_0805_2012Metric_E3; MPN RC0805FR-078R2L
R508, R516: 1k; R_0603_1608Metric_E3; MPN RC0603FR-071KL
R510: 100k; R_0603_1608Metric_E3; MPN RC0603FR-07100KL
R511: 18k; R_0603_1608Metric_E3; MPN RC0603FR-0718KL
R513: 1k; R_1206_3216Metric_E3; MPN RC1206FR-071KL
R514: 27k; R_0603_1608Metric_E3; MPN RC0603FR-0727KL
R517: 0; R_0603_1608Metric_E3; MPN RC0603JR-070RL; not fitted
R518: 100k; R_0603_1608Metric_E3; MPN RC0603FR-07100KL; not fitted
U401: TLV9004IDR; SOIC-14_3.9x8.7mm_P1.27mm_E3; MPN TLV9004IDR
U402: SN74LVC1G3157DBVR; SOT-23-6_E3; MPN SN74LVC1G3157DBVR

Connections:
AF_DC: C503.2, U401.6 (IN_B_N), U401.7 (OUT_B), U402.1 (B2_KEY1)
AF_F1: C503.1, R503.2, R504.1
AF_F2: C504.1, R504.2, U401.5 (IN_B_P)
AF_PWM: R503.1; also elsewhere on the board
AM_COMMAND: R514.1, R516.1, U402.4 (A_COMMON); also elsewhere on the board
GND: C502.2, C504.2, C506.2, Q403.2 (E), Q404.2 (E), Q405.2 (E), R507.2, R510.2, R512.2, R513.2, R518.2, U401.11 (VSS), U402.2 (GND), U402.3 (B1_KEY0); also elsewhere on the board
KEY: U402.6 (SELECT); also elsewhere on the board
LEVEL_DC: C501.2, U401.1 (OUT_A), U401.2 (IN_A_N)
LEVEL_F1: C501.1, R501.2, R502.1
LEVEL_F2: C502.1, R502.2, U401.3 (IN_A_P)
LEVEL_PWM: R501.1; also elsewhere on the board
LOCAL_MOD_OFF: R509.1; also elsewhere on the board
MOD_BASE: Q402.1 (B), Q403.3 (C), Q404.3 (C), R508.2, R510.1
MOD_COMMAND: Q405.3 (C), R516.2, R518.1, U401.10 (IN_C_P)
MOD_COMMAND_OFF_BASE: Q405.1 (B); also elsewhere on the board
MOD_DRIVE: C505.1, R508.1, R517.1, U401.8 (OUT_C)
MOD_E: Q402.3 (E), Q403.1 (B), R507.1; also elsewhere on the board
MOD_OFF_BASE: Q404.1 (B), R509.2
MOD_SINK: Q402.2 (C), R506.2
PASS_BASE: Q401.1 (B), R505.1, R506.1
TRAIN_BASE_DRIVE: U401.14 (OUT_D); also elsewhere on the board
TRAIN_COMMAND: R514.2, U401.12 (IN_D_P); also elsewhere on the board
TRAIN_EMITTER_DC: U401.13 (IN_D_N); also elsewhere on the board
V3V3: U401.4 (VDD), U402.5 (VCC); also elsewhere on the board
VMOD: Q401.3 (E), R505.2; also elsewhere on the board
VPA: C506.1, R511.1, R513.1; also elsewhere on the board
VPA_FB: C505.2, R511.2, R512.1, R517.2, U401.9 (IN_C_N)
VPA_PRE: Q401.2 (C); also elsewhere on the board

Notes on the sheet:
05 Sine reconstruction and series AM modulator
M5B-E6R2 / integrated evaluation PCB / NOT RELEASED / hardware tests NOT_RUN
M5B-E6R2: REVIEW / ALL hardware measurements NOT RUN / no ordering or manufacture.

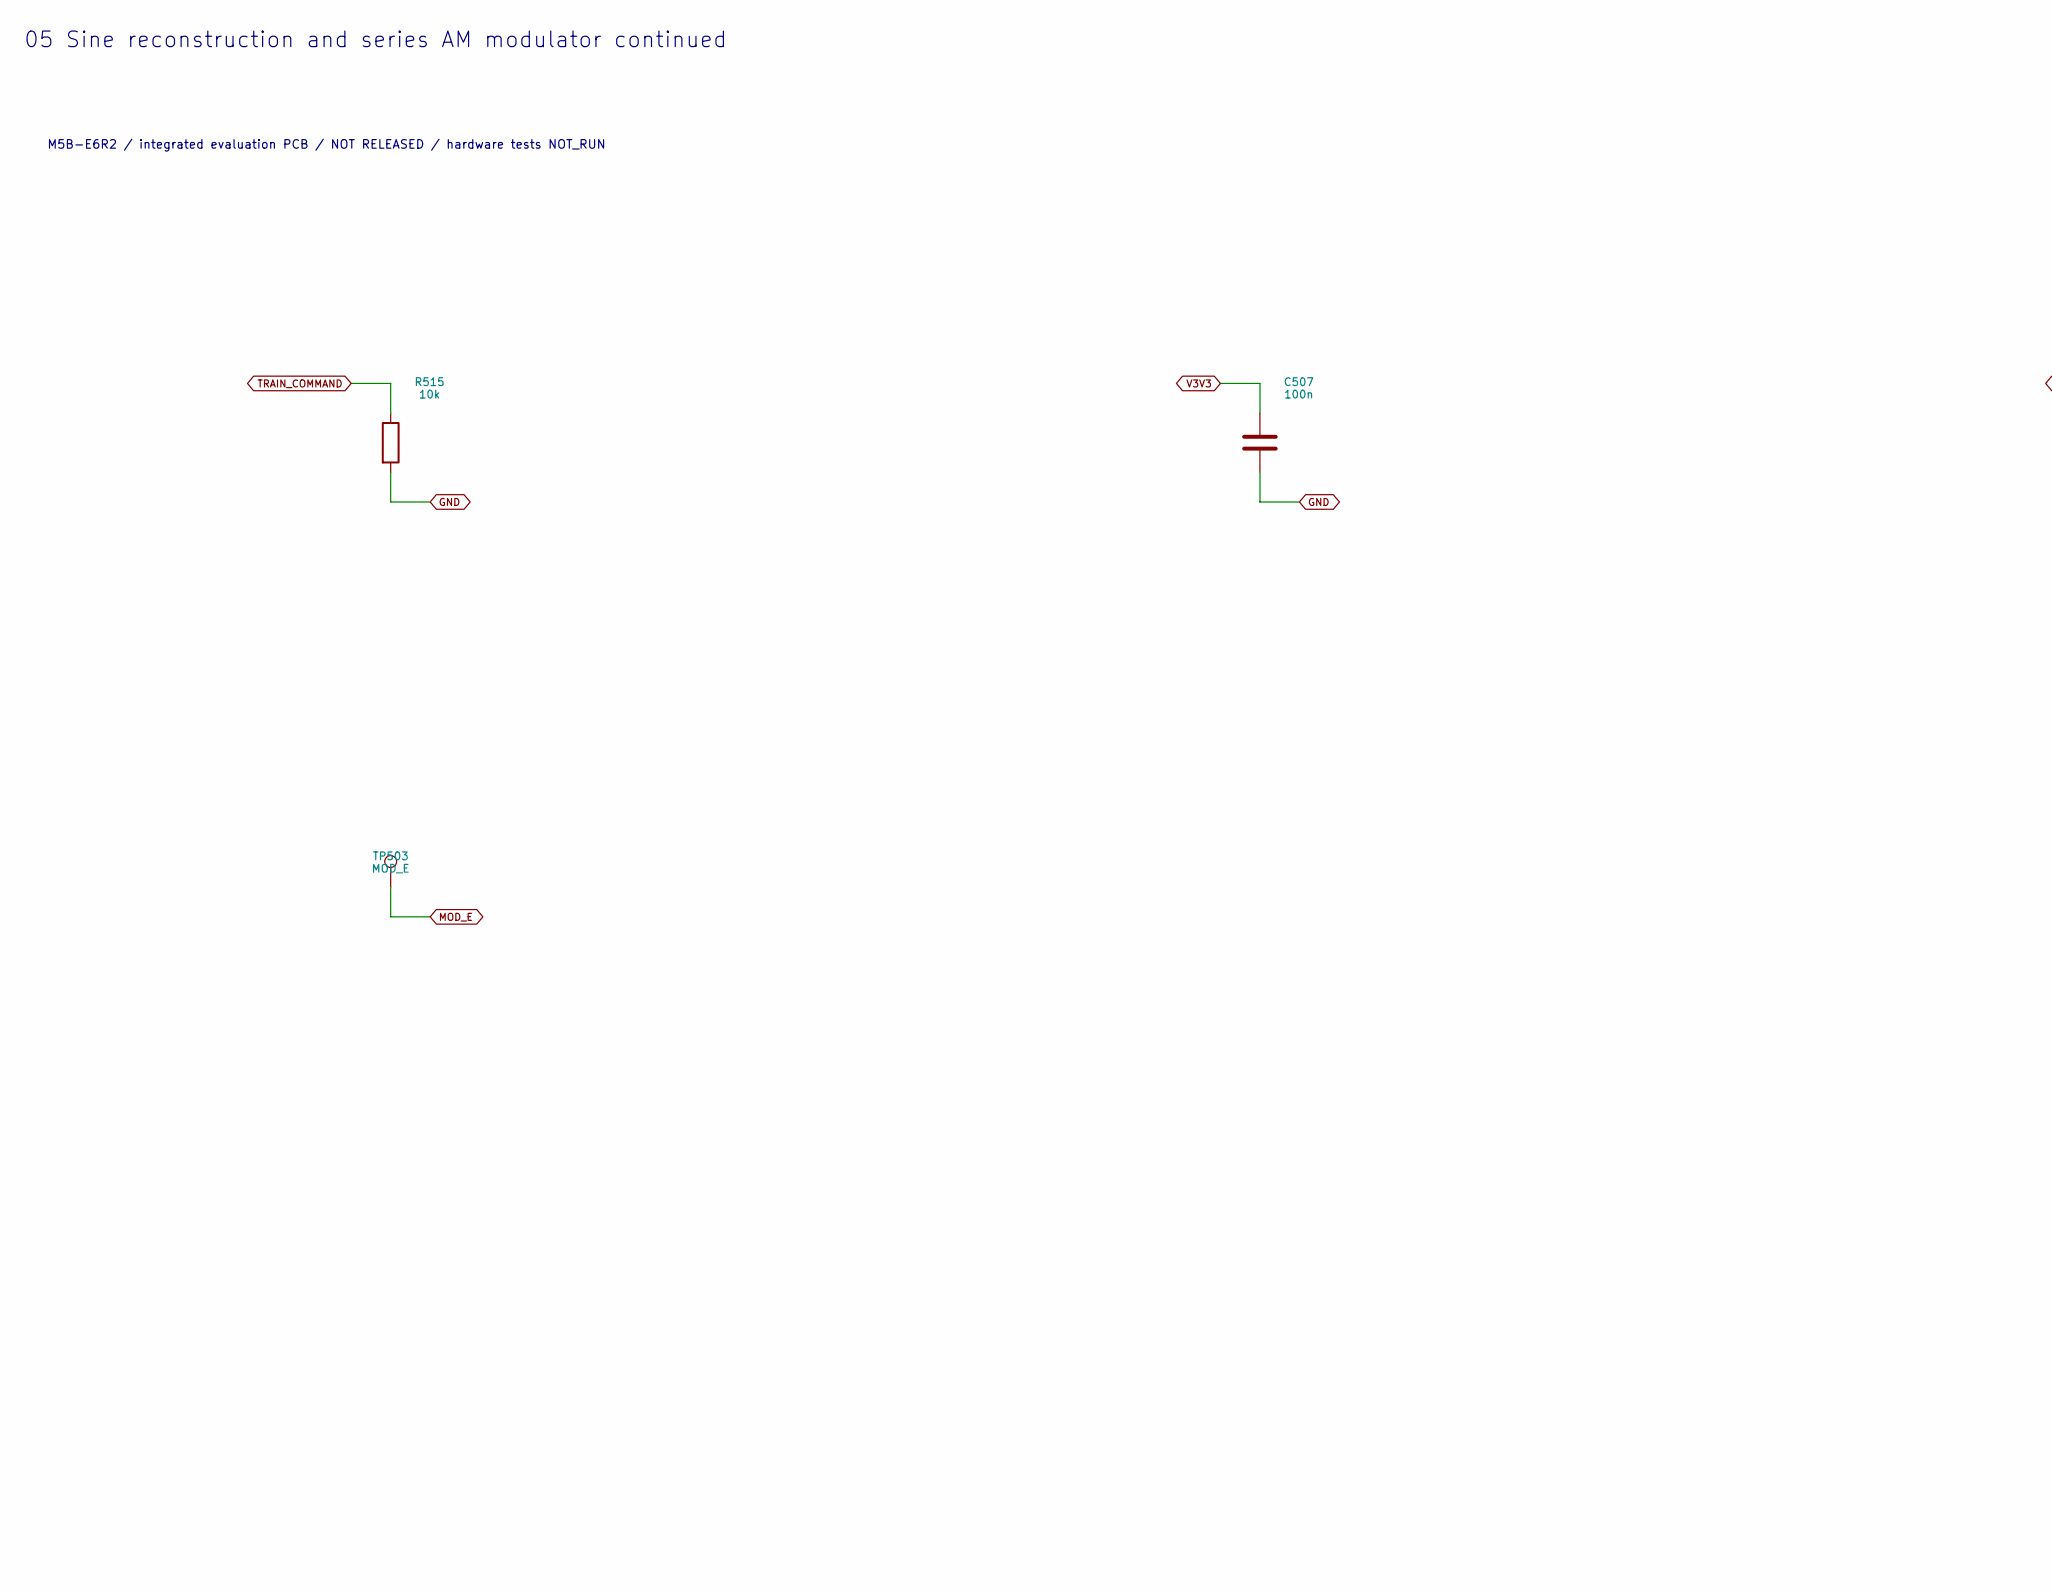
[picture p287: schematic 05_amb1.kicad_sch, 05 Sine reconstruction and series AM modulator continued, part in row 1, column 1]

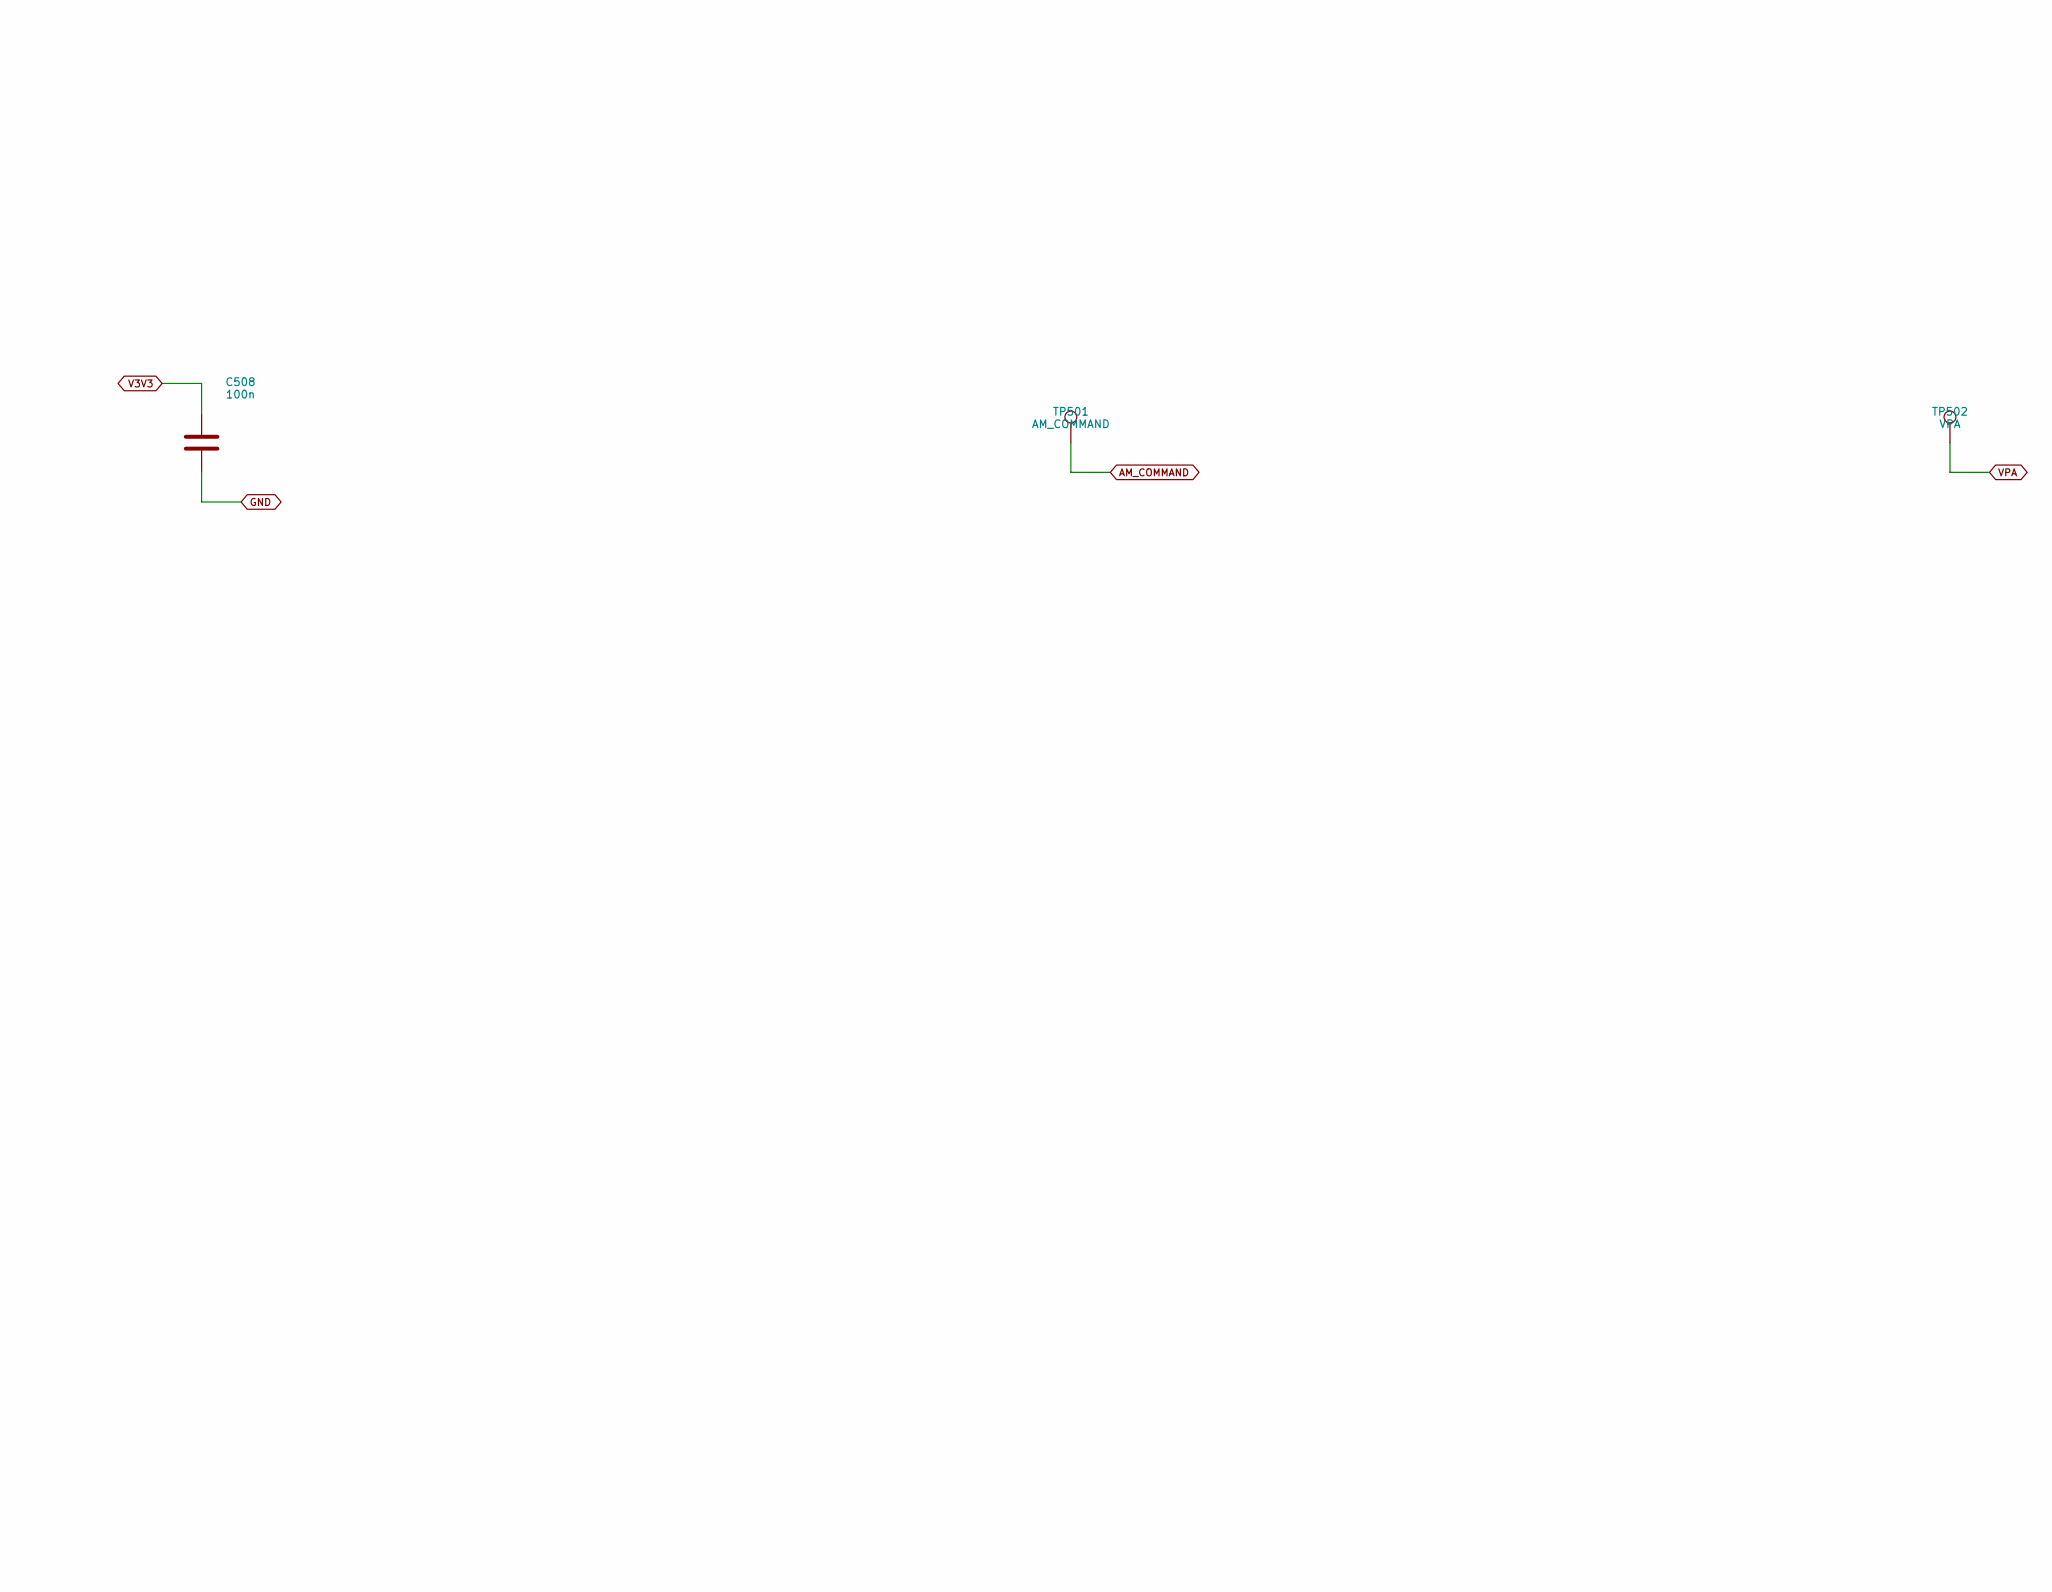
[picture p288: schematic 05_amb1.kicad_sch, 05 Sine reconstruction and series AM modulator continued, part in row 1, column 2]

Parts:
C507, C508: 100n; C_0603_1608Metric_E3; MPN CC0603KRX7R8BB104
R515: 10k; R_0603_1608Metric_E3; MPN RC0603FR-0710KL
TP501: AM_COMMAND; TestPoint_Pad_D1.0mm_E3; MPN PCB feature
TP502: VPA; TestPoint_Pad_D1.0mm_E3; MPN PCB feature
TP503: MOD_E; TestPoint_Pad_D1.0mm_E3; MPN PCB feature

Connections:
AM_COMMAND: TP501.1; also elsewhere on the board
GND: C507.2, C508.2, R515.2; also elsewhere on the board
MOD_E: TP503.1; also elsewhere on the board
TRAIN_COMMAND: R515.1; also elsewhere on the board
V3V3: C507.1, C508.1; also elsewhere on the board
VPA: TP502.1; also elsewhere on the board

Notes on the sheet:
05 Sine reconstruction and series AM modulator continued
M5B-E6R2 / integrated evaluation PCB / NOT RELEASED / hardware tests NOT_RUN
M5B-E6R2: REVIEW / ALL hardware measurements NOT RUN / no ordering or manufacture.
