DD1SB/ARDF-TX/hardware/2m/RF2M.kicad_pcb

## KiCad design hardware/2m/RF2M.kicad_pcb (continued)

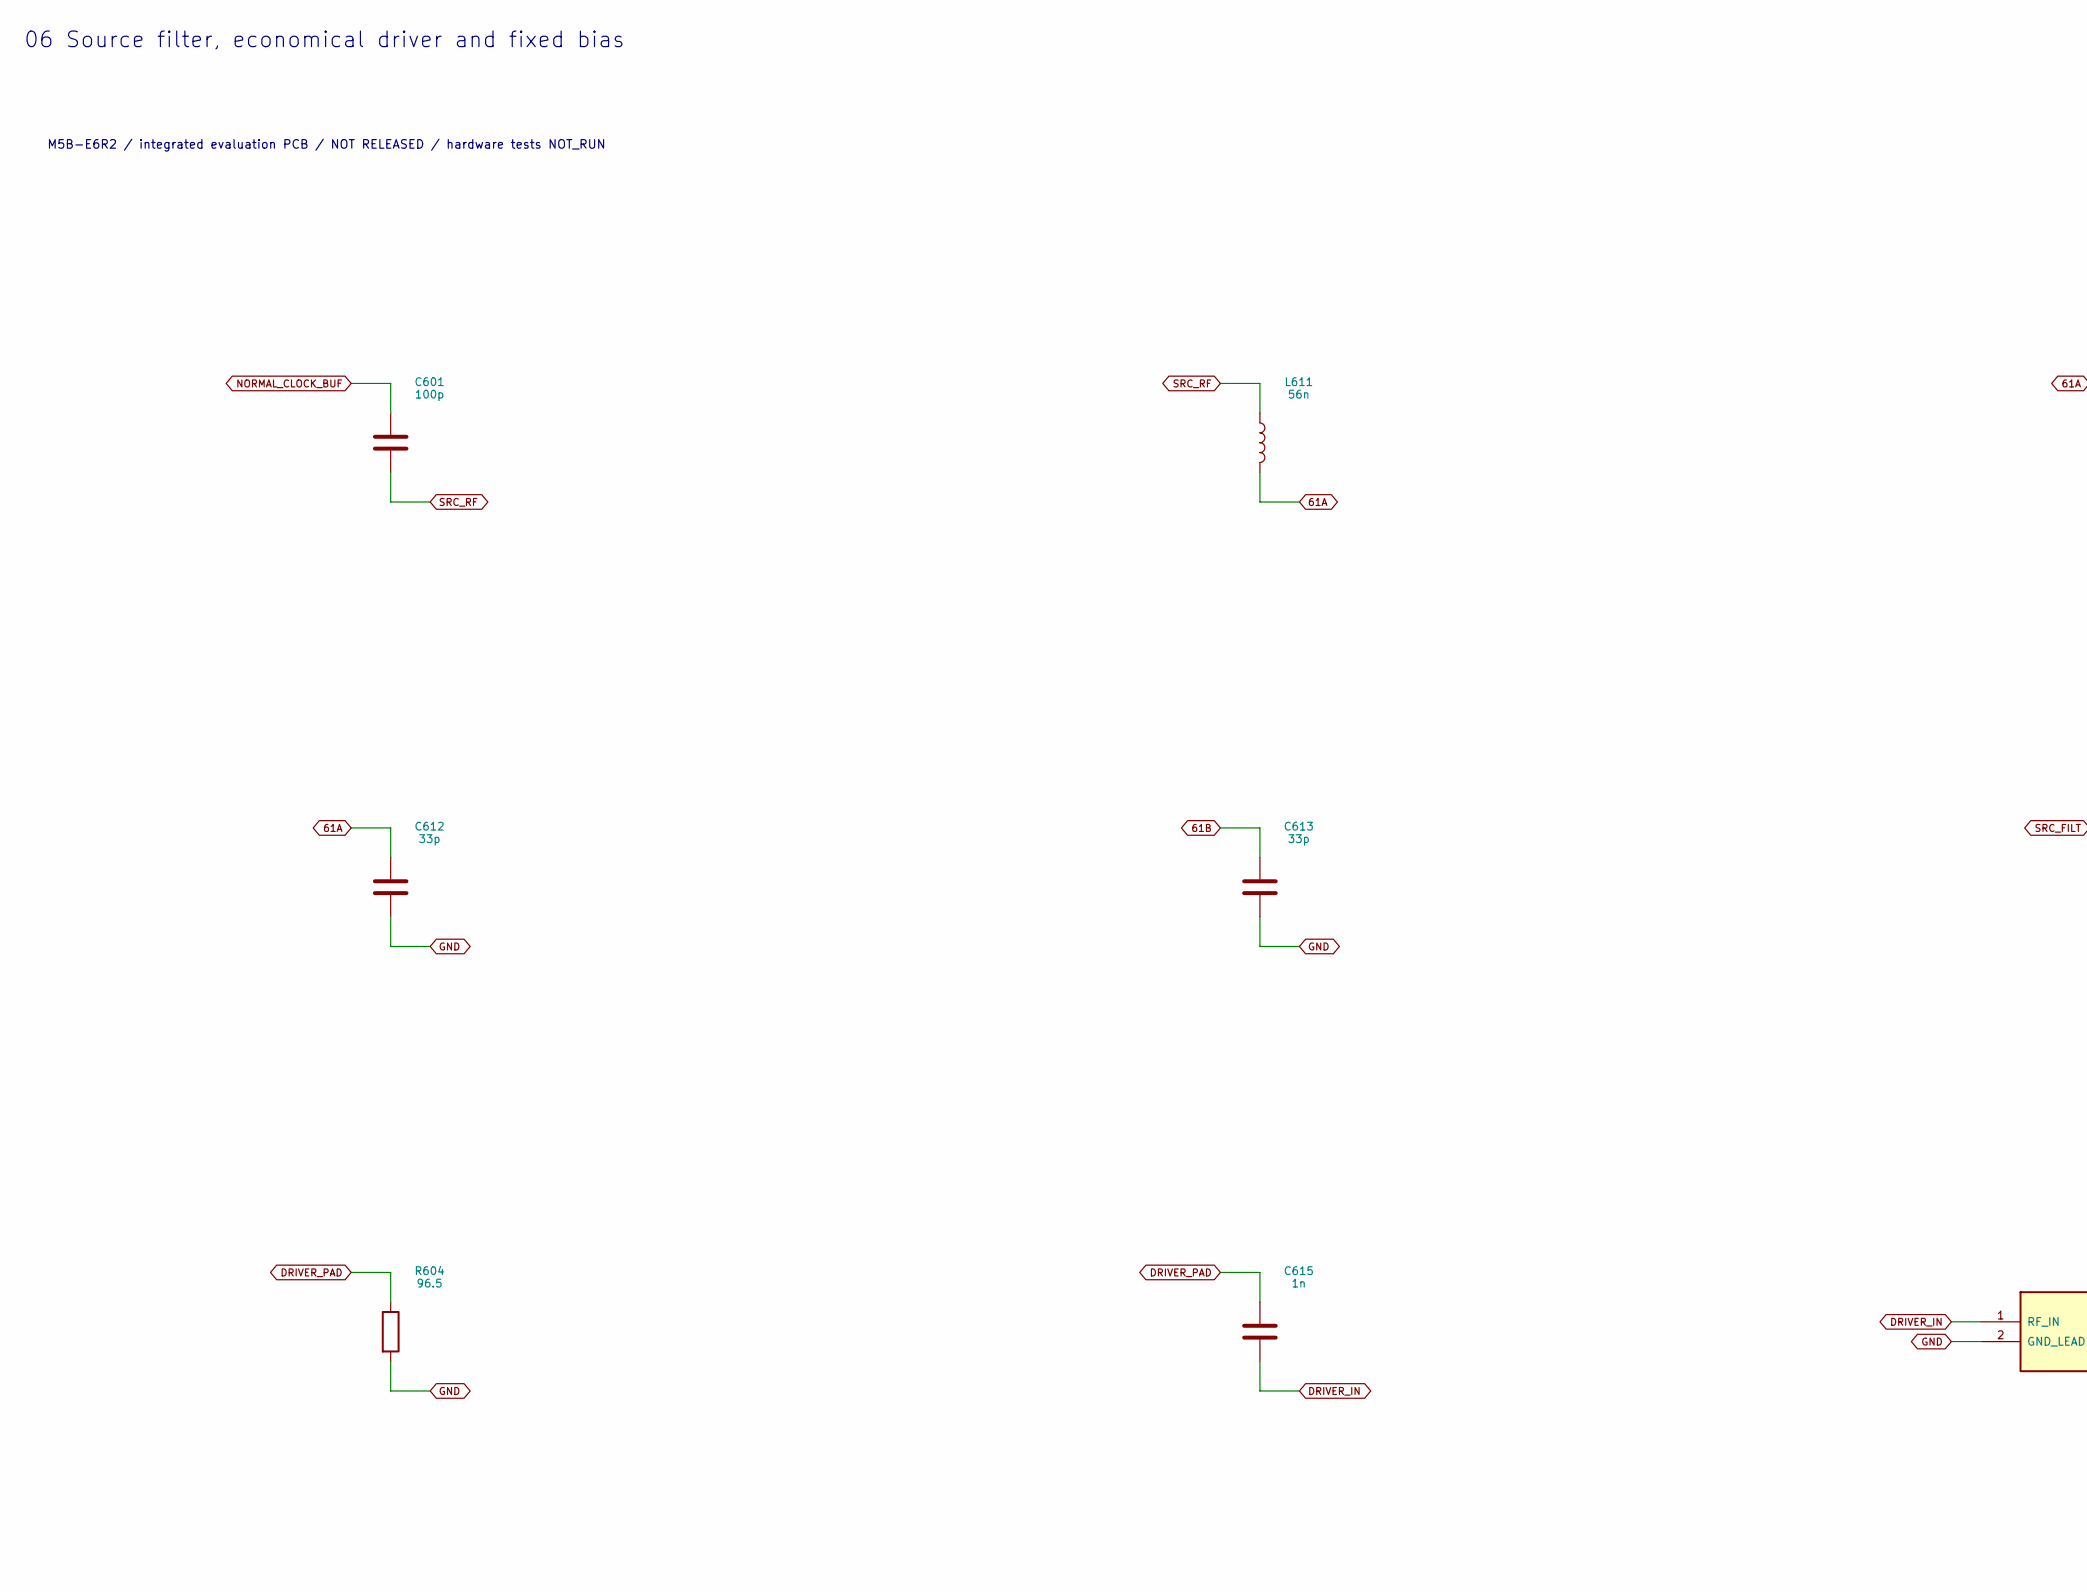
[picture p289: schematic 06_source_driver_bias.kicad_sch, 06 Source filter, economical driver and fixed bias, part in row 1, column 1]

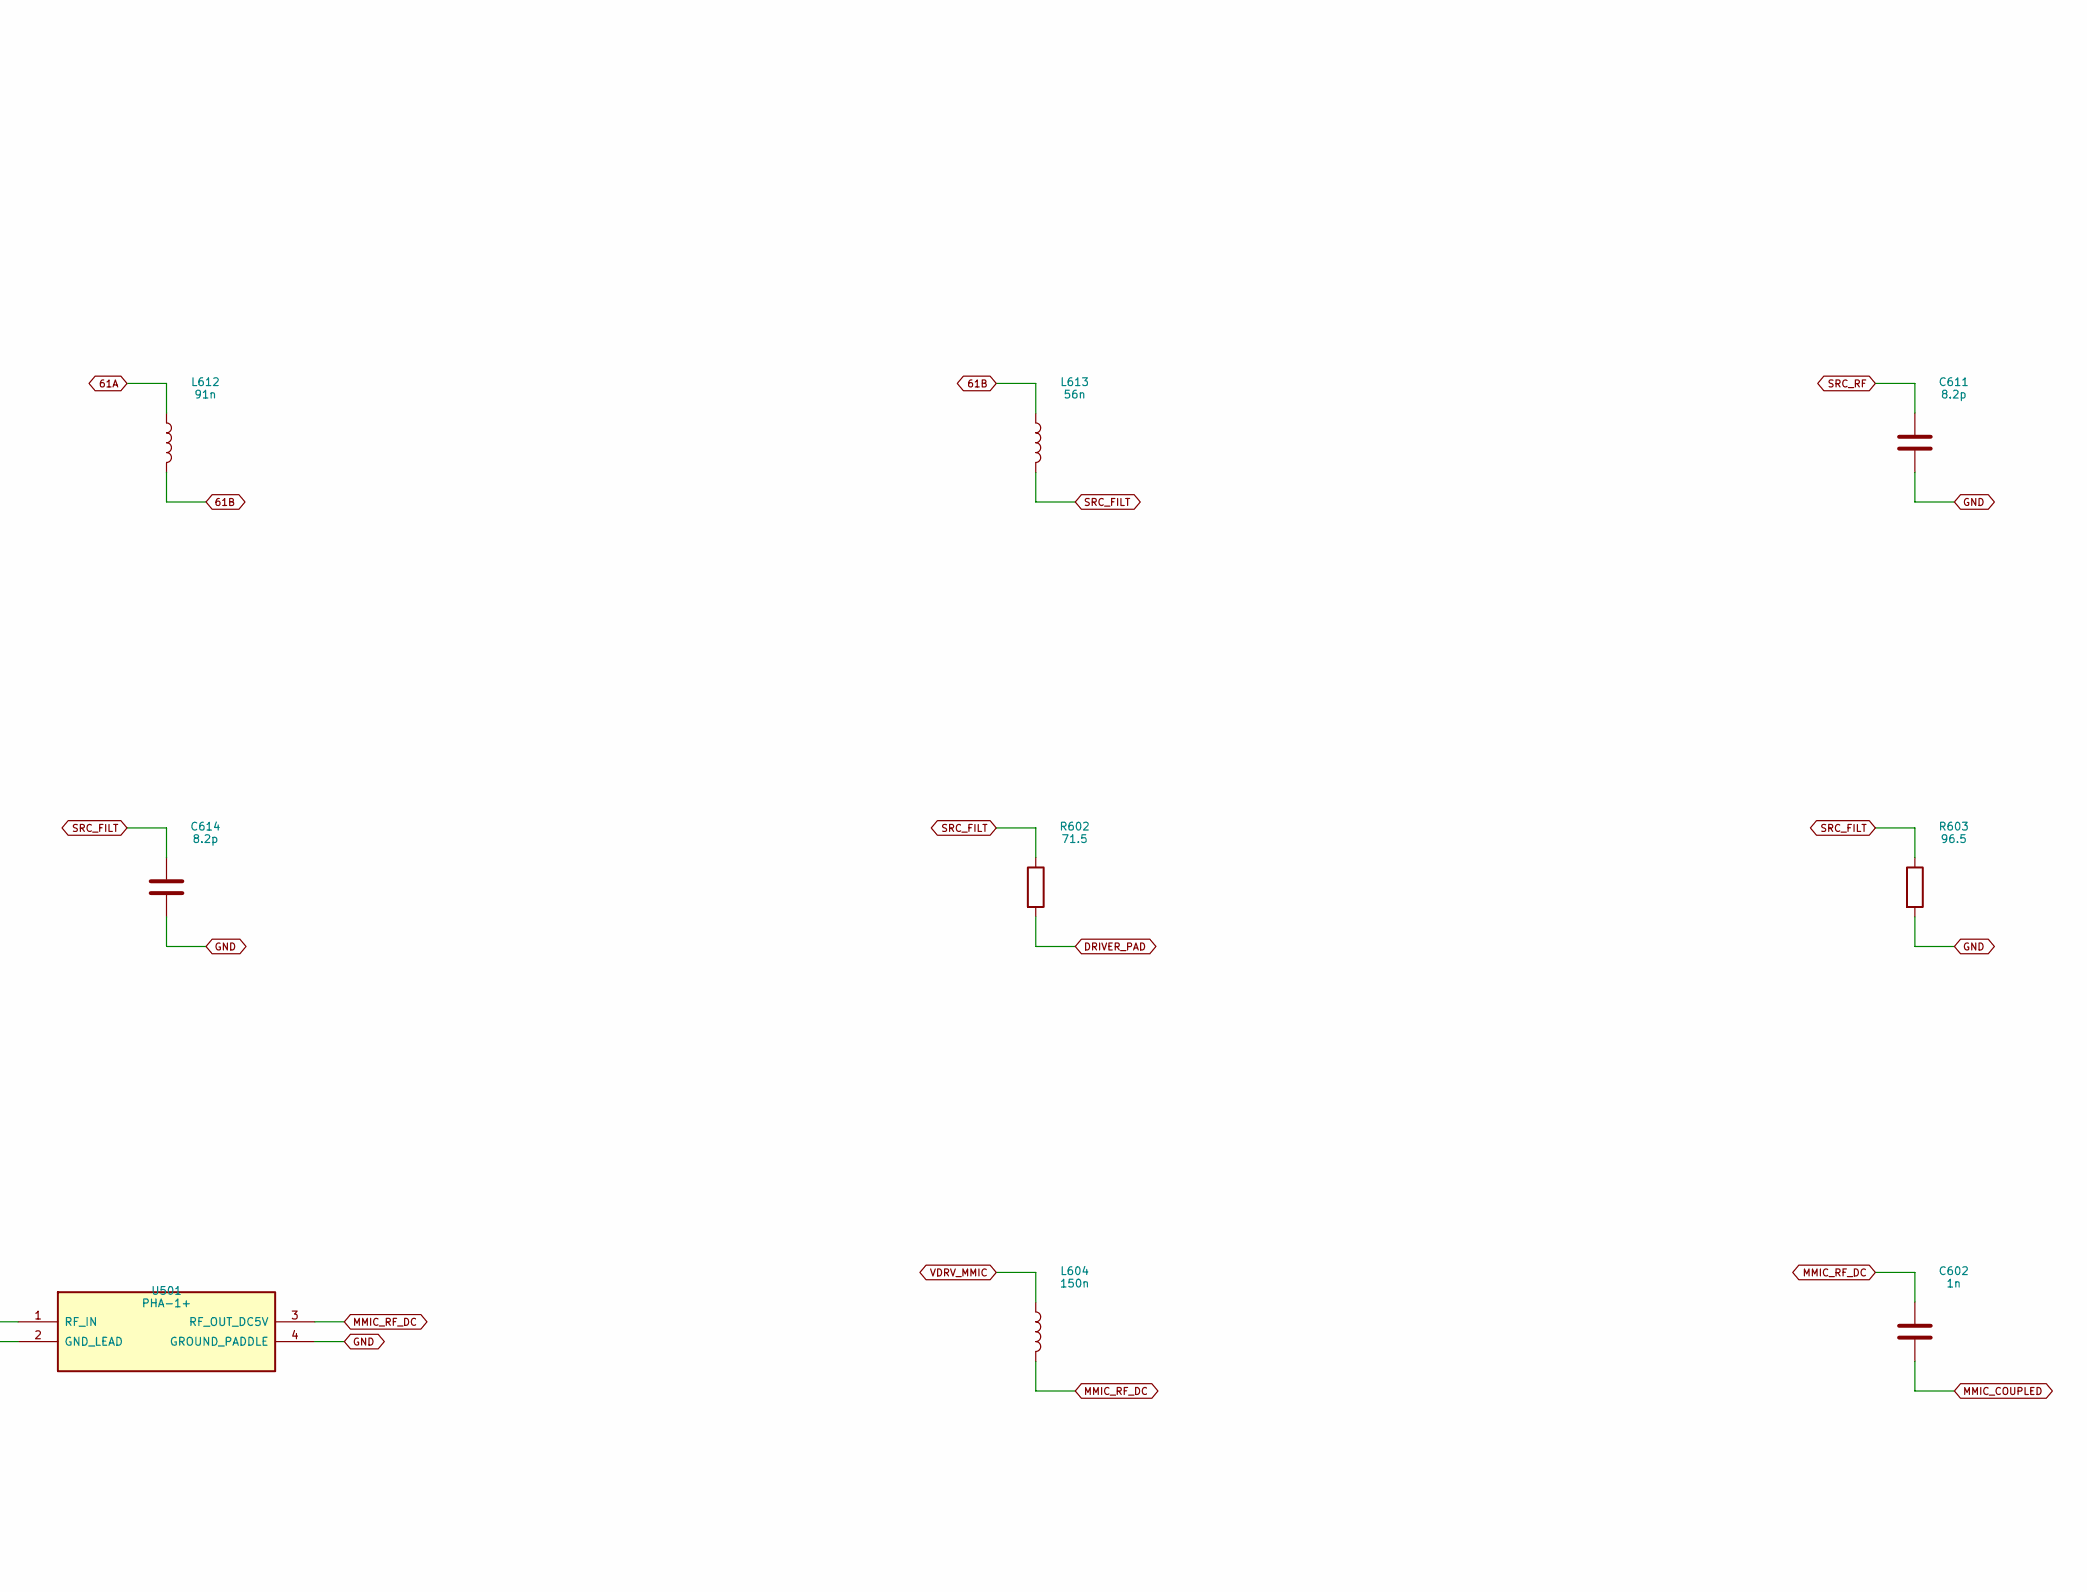
[picture p290: schematic 06_source_driver_bias.kicad_sch, 06 Source filter, economical driver and fixed bias, part in row 1, column 2]

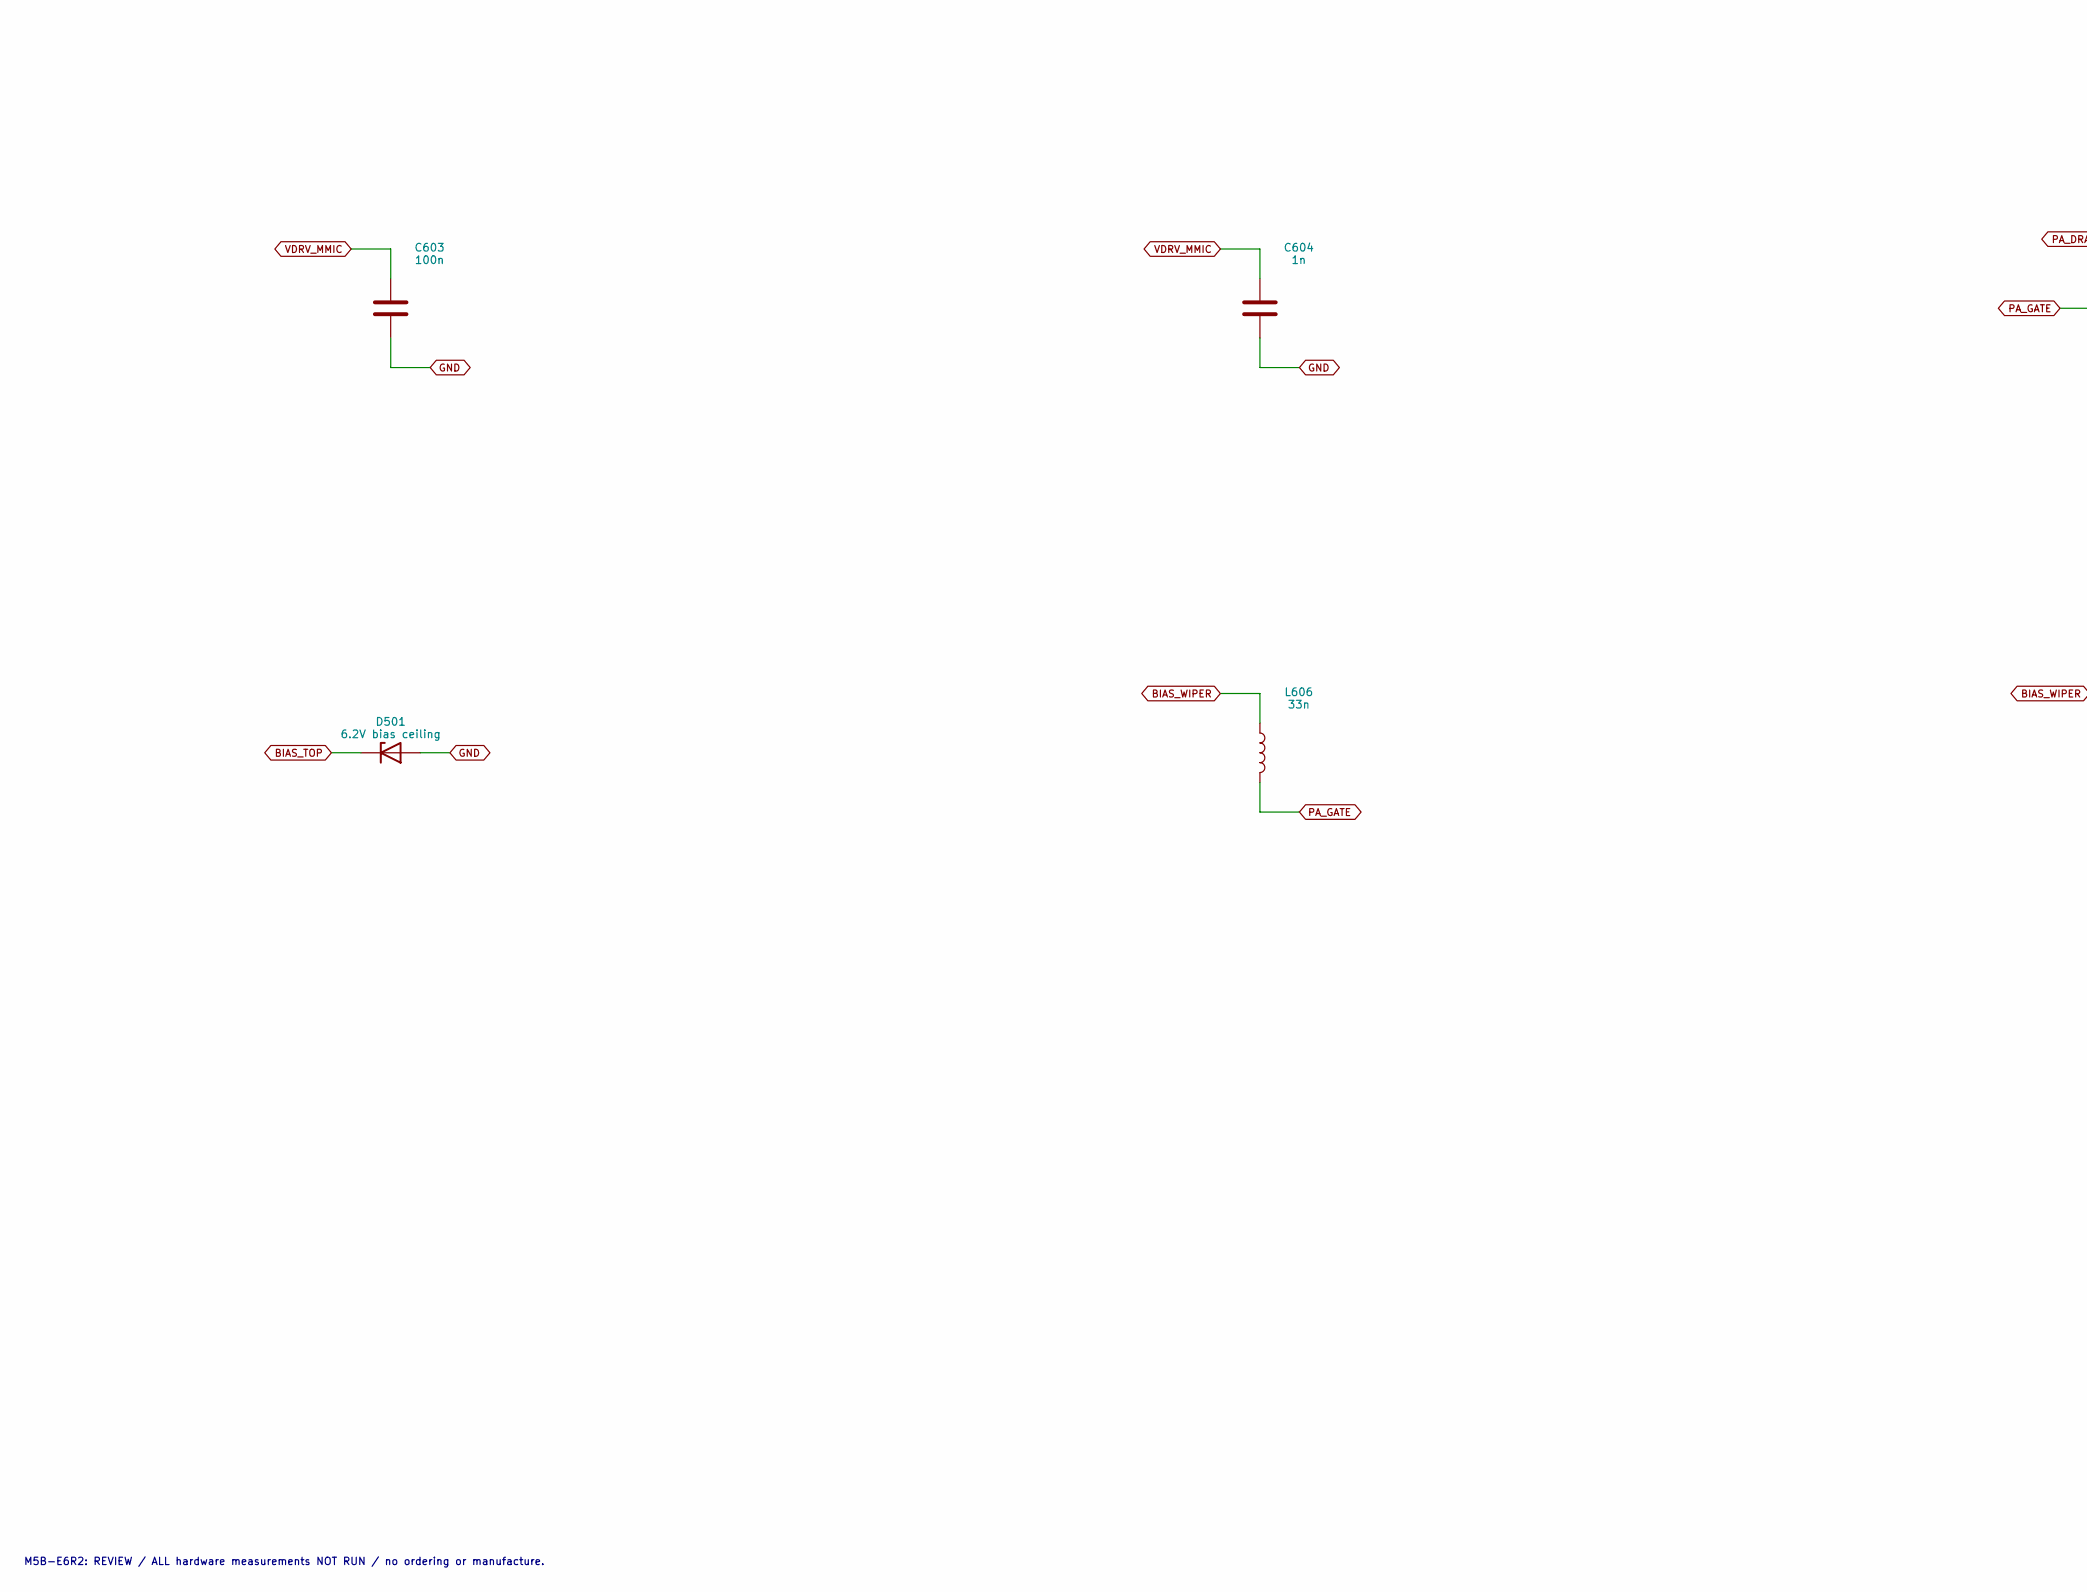
[picture p291: schematic 06_source_driver_bias.kicad_sch, 06 Source filter, economical driver and fixed bias, part in row 2, column 1]

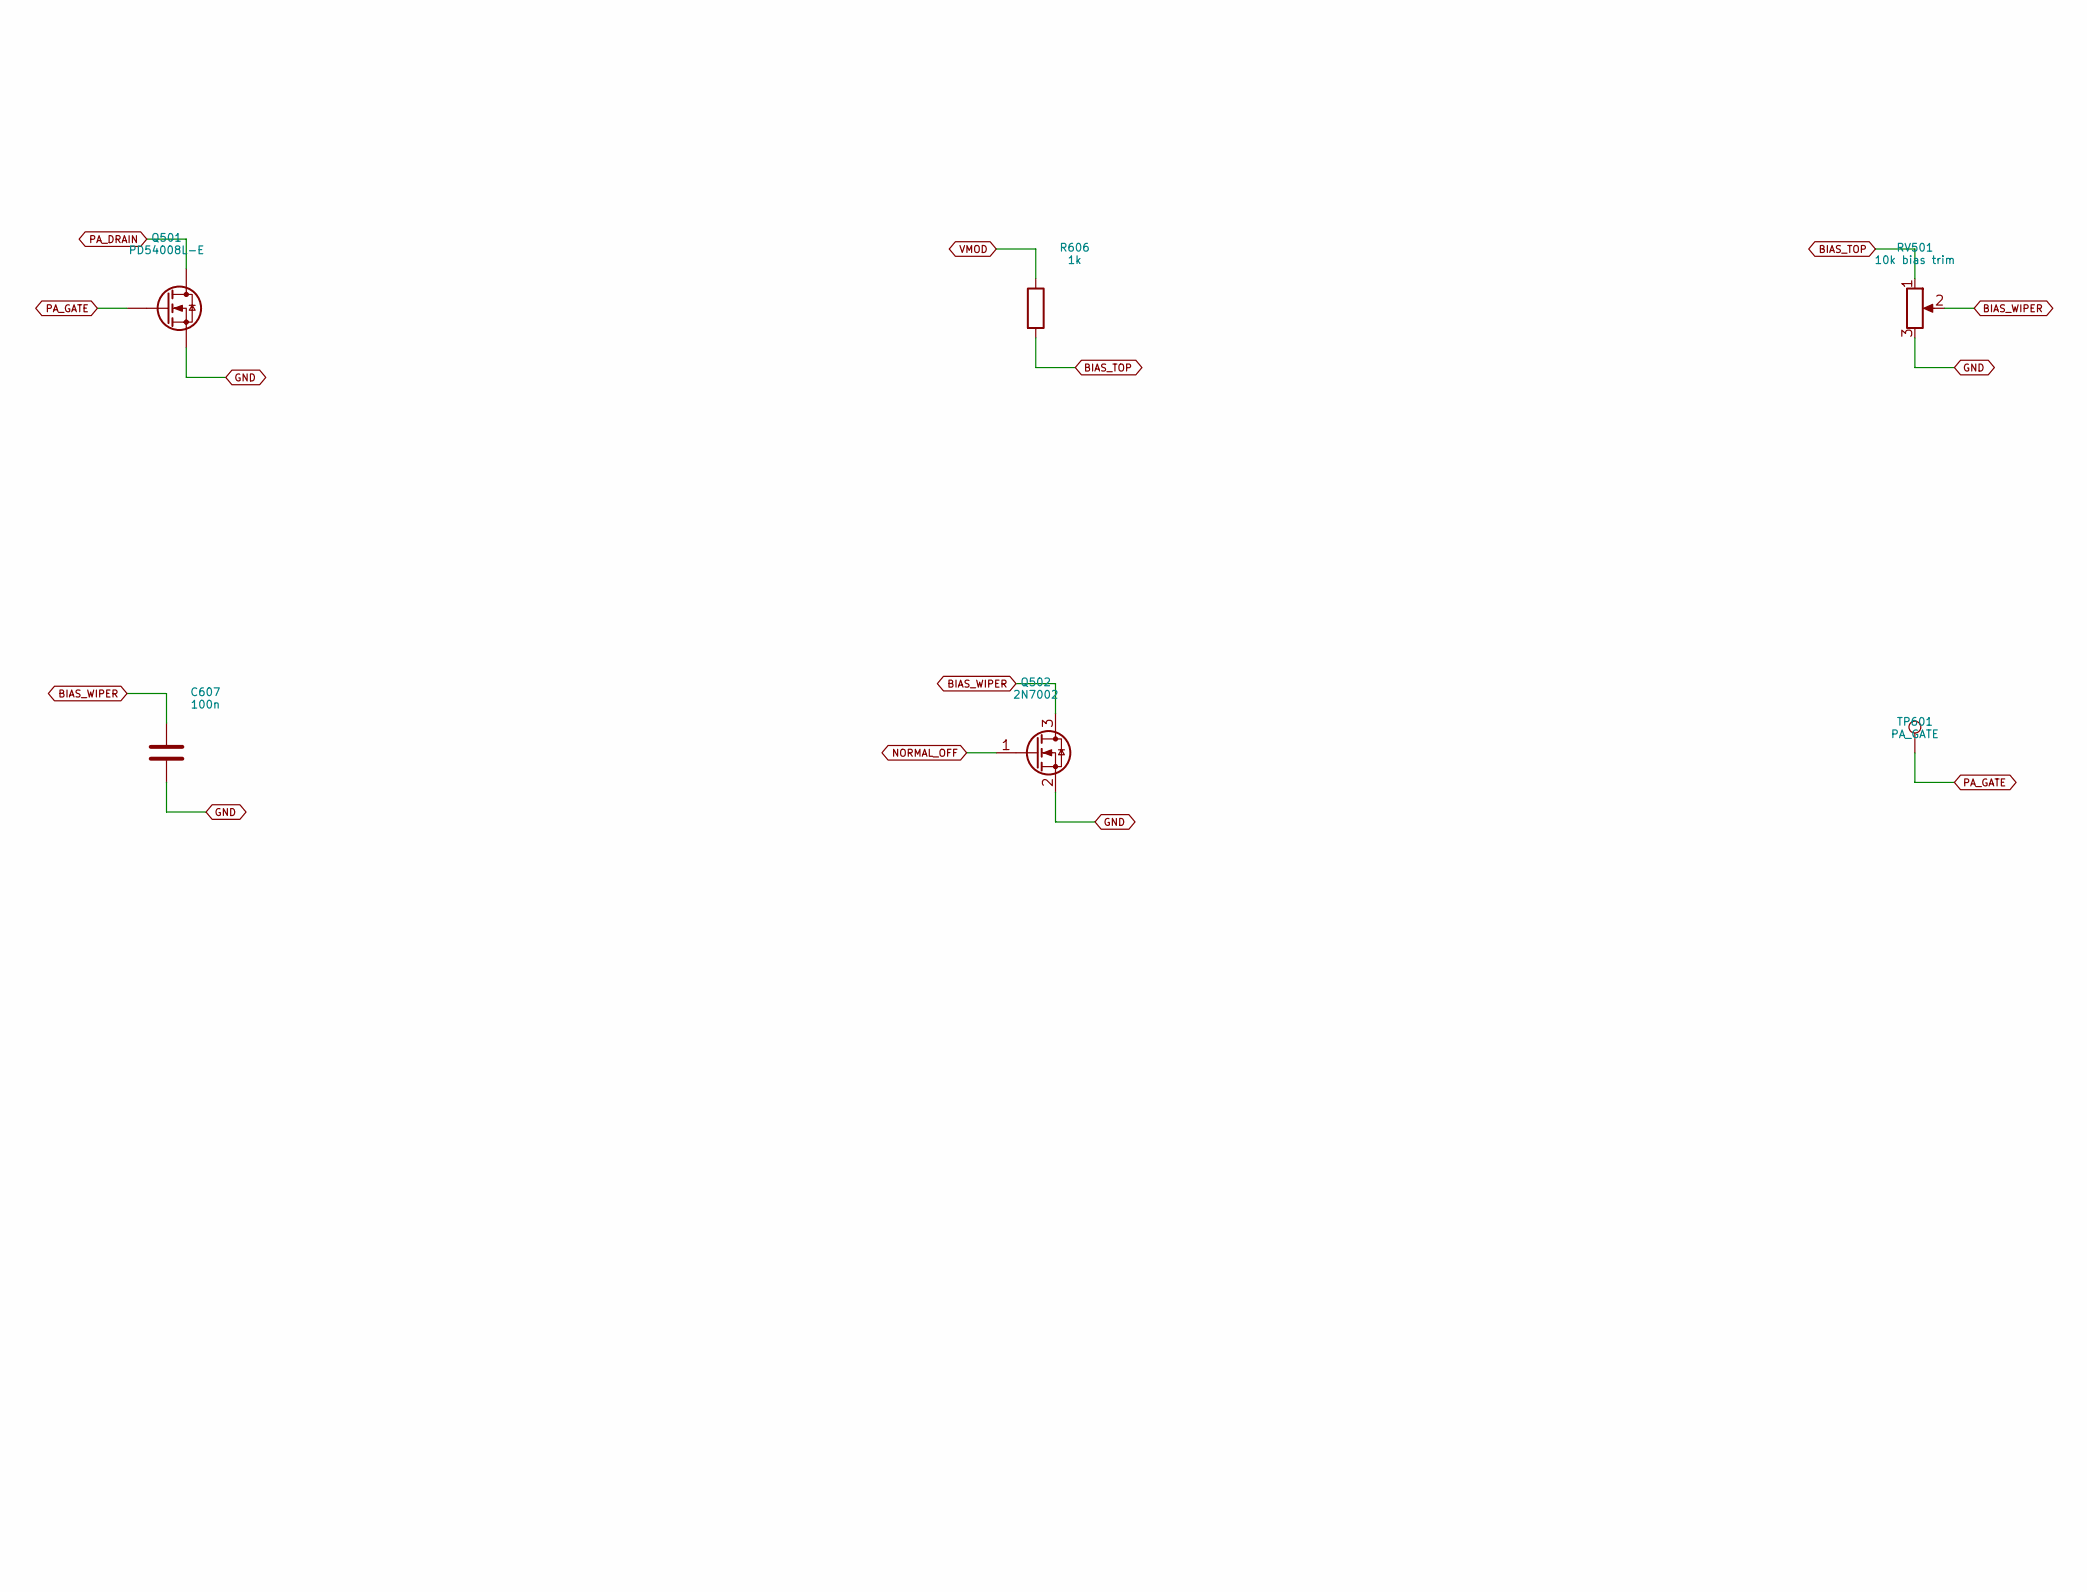
[picture p292: schematic 06_source_driver_bias.kicad_sch, 06 Source filter, economical driver and fixed bias, part in row 2, column 2]

Parts:
C601: 100p; C_0603_1608Metric_E3; MPN CC0603JRNPO9BN101
C602, C604, C615: 1n; C_0603_1608Metric_E3; MPN CC0603JRNPO9BN102
C603, C607: 100n; C_0603_1608Metric_E3; MPN CC0603KRX7R8BB104
C611, C614: 8.2p; C_0603_1608Metric_E3; MPN CC0603CRNPO9BN8R2
C612, C613: 33p; C_0603_1608Metric_E3; MPN CC0603JRNPO9BN330
D501: 6.2V bias ceiling; D_SOD-123F_E3; MPN BZT52H-C6V2,115
L604: 150n; Coilcraft_1812SMS_Doc184; MPN 1812SMS-R15JLC
L606: 33n; Coilcraft_1812SMS_Doc184; MPN 1812SMS-33NJLC
L611, L613: 56n; L_0603_1608Metric_E3; MPN LQW18AN56NG80D
L612: 91n; L_0603_1608Metric_E3; MPN LQW18AN91NG80D
Q501: PD54008L-E; PD54008L_ST_GDS_5x5; MPN PD54008L-E
Q502: 2N7002; SOT-23_E3; MPN 2N7002,215
R602: 71.5; R_0603_1608Metric_E3; MPN RC0603FR-0771R5L
R603, R604: 96.5; R_0603_1608Metric_E3; MPN RC0603FR-0796R5L
R606: 1k; R_0603_1608Metric_E3; MPN RC0603FR-071KL
RV501: 10k bias trim; Potentiometer_Bourns_3296W_Vertical_E3; MPN 3296W-1-103LF
TP601: PA_GATE; Probe_Pad_0p6; MPN PCB feature
U501: PHA-1+; PHA1_DF782_RevG; MPN PHA-1+

Connections:
61A: C612.1, L611.2, L612.1
61B: C613.1, L612.2, L613.1
BIAS_TOP: D501.1 (K), R606.2, RV501.1
BIAS_WIPER: C607.1, L606.1, Q502.3 (D), RV501.2
DRIVER_IN: C615.2, U501.1 (RF_IN)
DRIVER_PAD: C615.1, R602.2, R604.1
GND: C603.2, C604.2, C607.2, C611.2, C612.2, C613.2, C614.2, D501.2 (A), Q501.S, Q502.2 (S), R603.2, R604.2, RV501.3, U501.2 (GND_LEAD), U501.4 (GROUND_PADDLE); also elsewhere on the board
MMIC_COUPLED: C602.2; also elsewhere on the board
MMIC_RF_DC: C602.1, L604.2, U501.3 (RF_OUT_DC5V)
NORMAL_CLOCK_BUF: C601.1; also elsewhere on the board
NORMAL_OFF: Q502.1 (G); also elsewhere on the board
PA_DRAIN: Q501.D; also elsewhere on the board
PA_GATE: L606.2, Q501.G, TP601.1; also elsewhere on the board
SRC_FILT: C614.1, L613.2, R602.1, R603.1
SRC_RF: C601.2, C611.1, L611.1
VDRV_MMIC: C603.1, C604.1, L604.1; also elsewhere on the board
VMOD: R606.1; also elsewhere on the board

Notes on the sheet:
06 Source filter, economical driver and fixed bias
M5B-E6R2 / integrated evaluation PCB / NOT RELEASED / hardware tests NOT_RUN
M5B-E6R2: REVIEW / ALL hardware measurements NOT RUN / no ordering or manufacture.

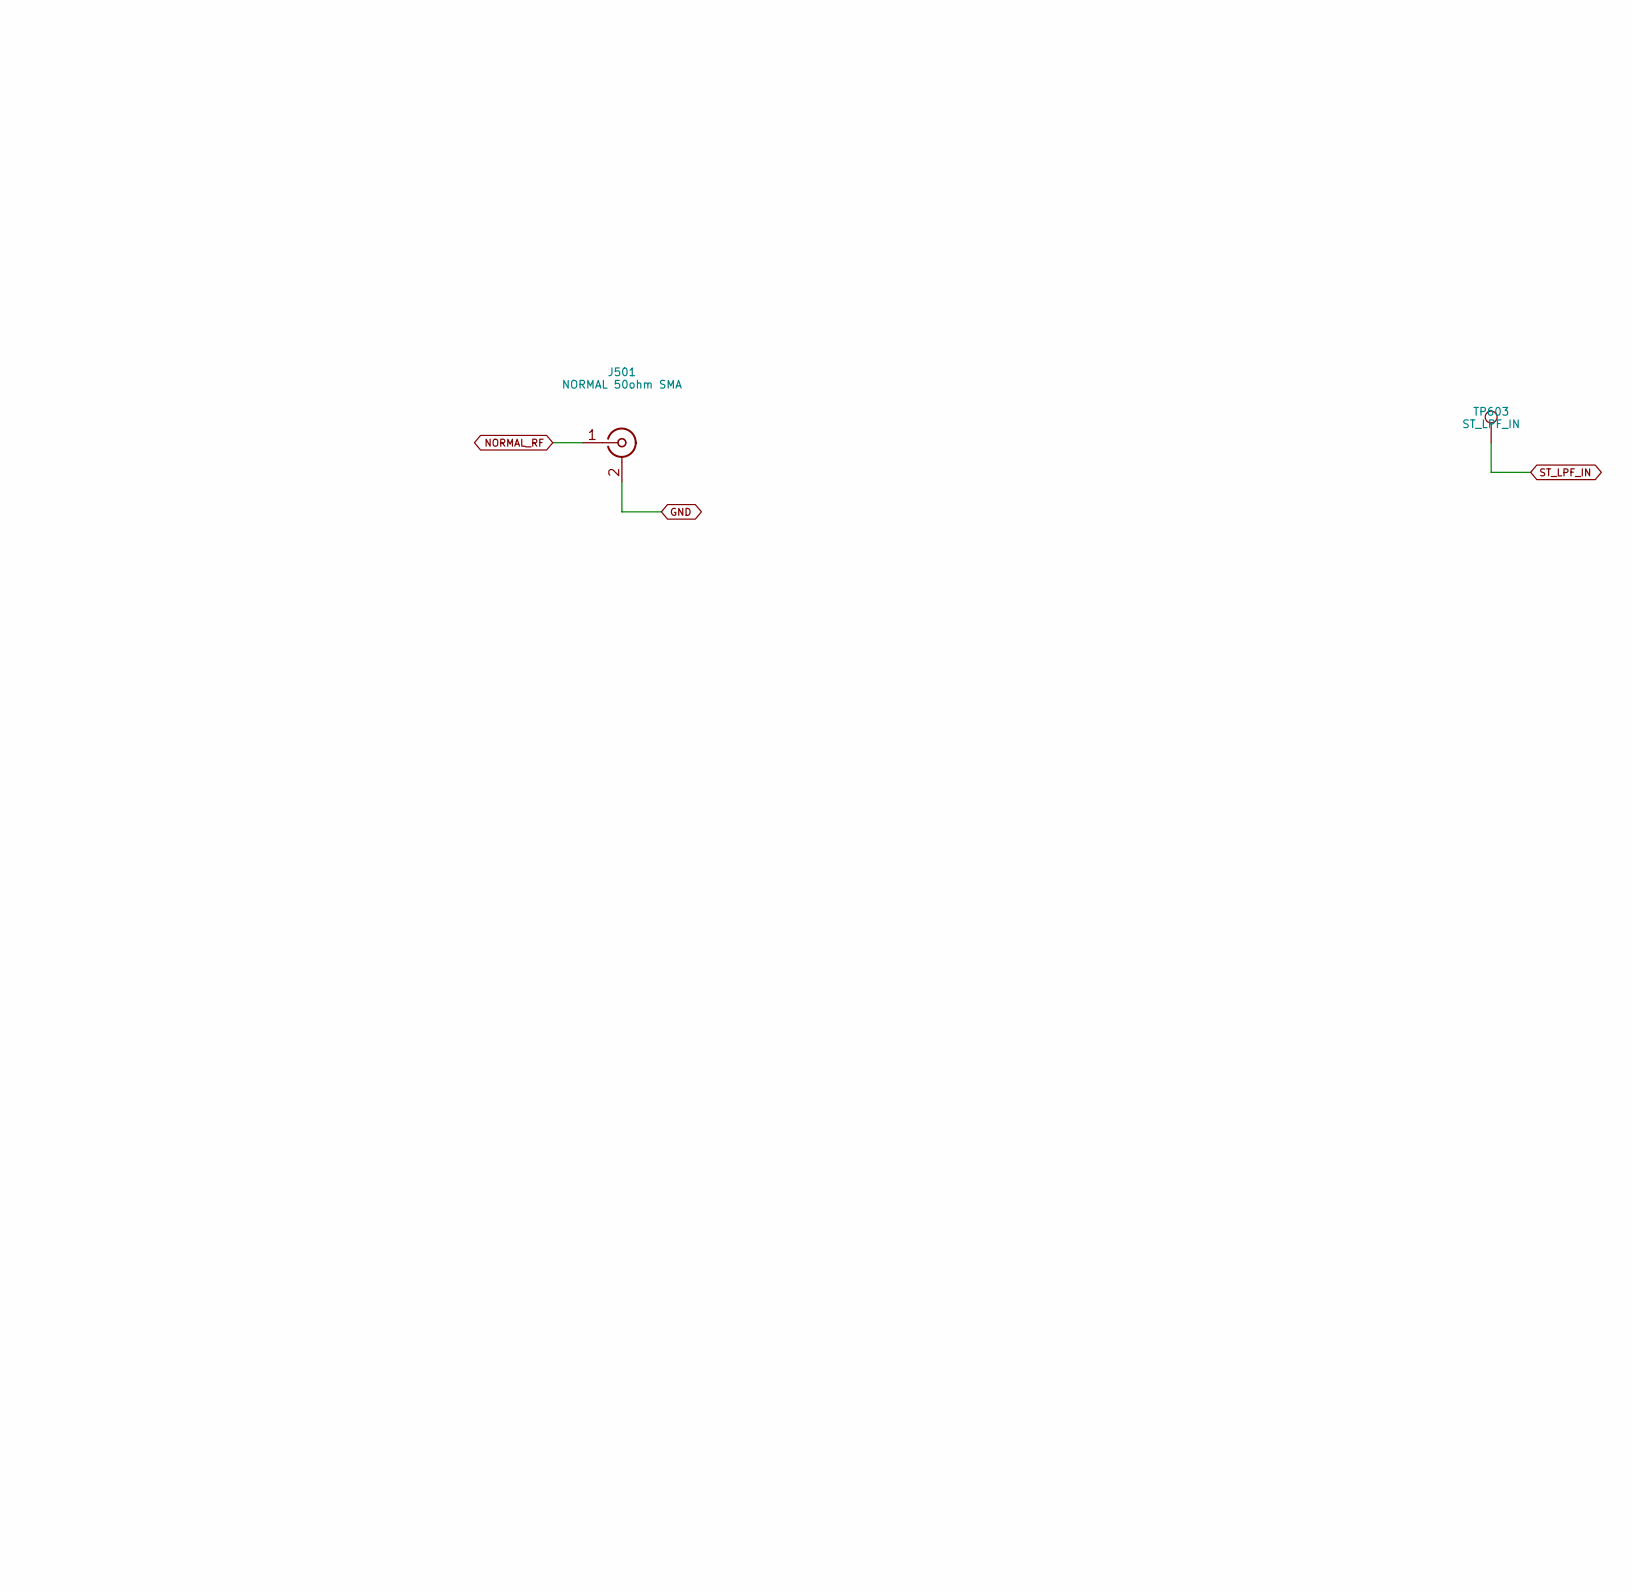
[picture p293: schematic 06_source_driver_biasb1.kicad_sch, 06 Source filter, economical driver and fixed bias continued, part in row 1, column 2]

Parts:
J501: NORMAL 50ohm SMA; SMA_Amphenol_132134_Vertical_E3; MPN 132134
TP602: PA_DRAIN; Probe_Pad_0p6; MPN PCB feature
TP603: ST_LPF_IN; Probe_Pad_0p6; MPN PCB feature
TP604: MMIC_AC; Probe_Pad_0p6; MPN PCB feature

Connections:
GND: J501.2 (Ext); also elsewhere on the board
MMIC_AC: TP604.1; also elsewhere on the board
NORMAL_RF: J501.1 (In); also elsewhere on the board
PA_DRAIN: TP602.1; also elsewhere on the board
ST_LPF_IN: TP603.1; also elsewhere on the board

Notes on the sheet:
06 Source filter, economical driver and fixed bias continued
M5B-E6R2 / integrated evaluation PCB / NOT RELEASED / hardware tests NOT_RUN
M5B-E6R2: REVIEW / ALL hardware measurements NOT RUN / no ordering or manufacture.
