DD1SB/ARDF-TX/hardware/2m/RF2M.kicad_pcb

## KiCad design hardware/2m/RF2M.kicad_pcb (continued)

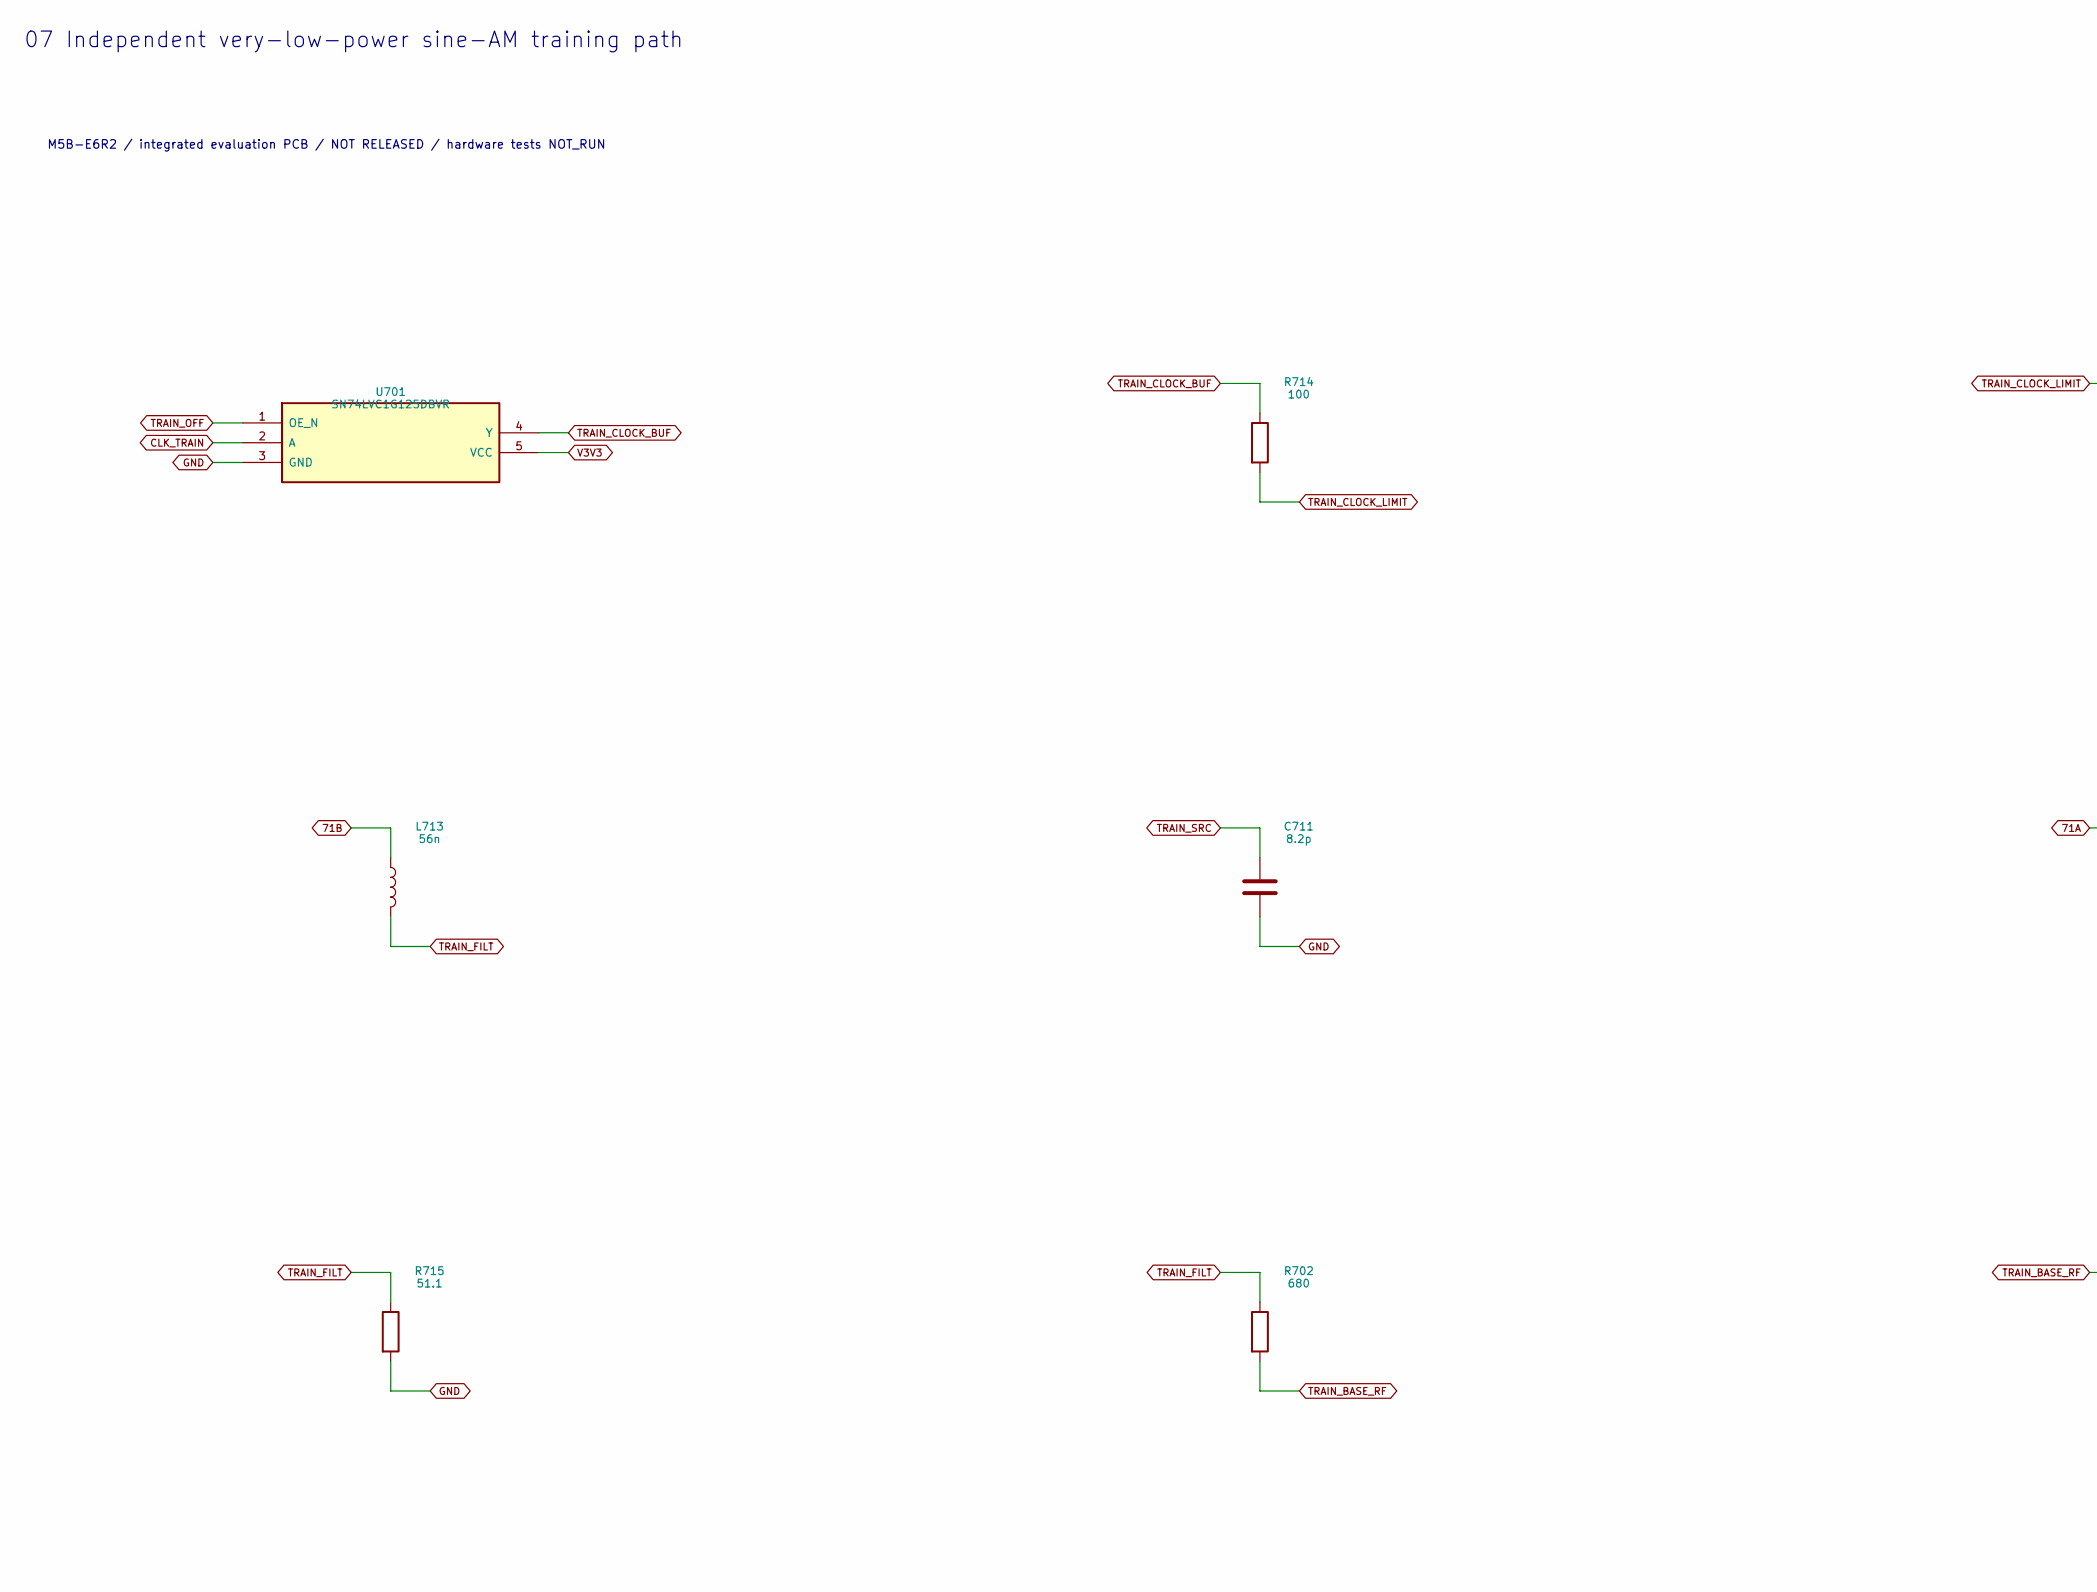
[picture p294: schematic 07_training.kicad_sch, 07 Independent very-low-power sine-AM training path, part in row 1, column 1]

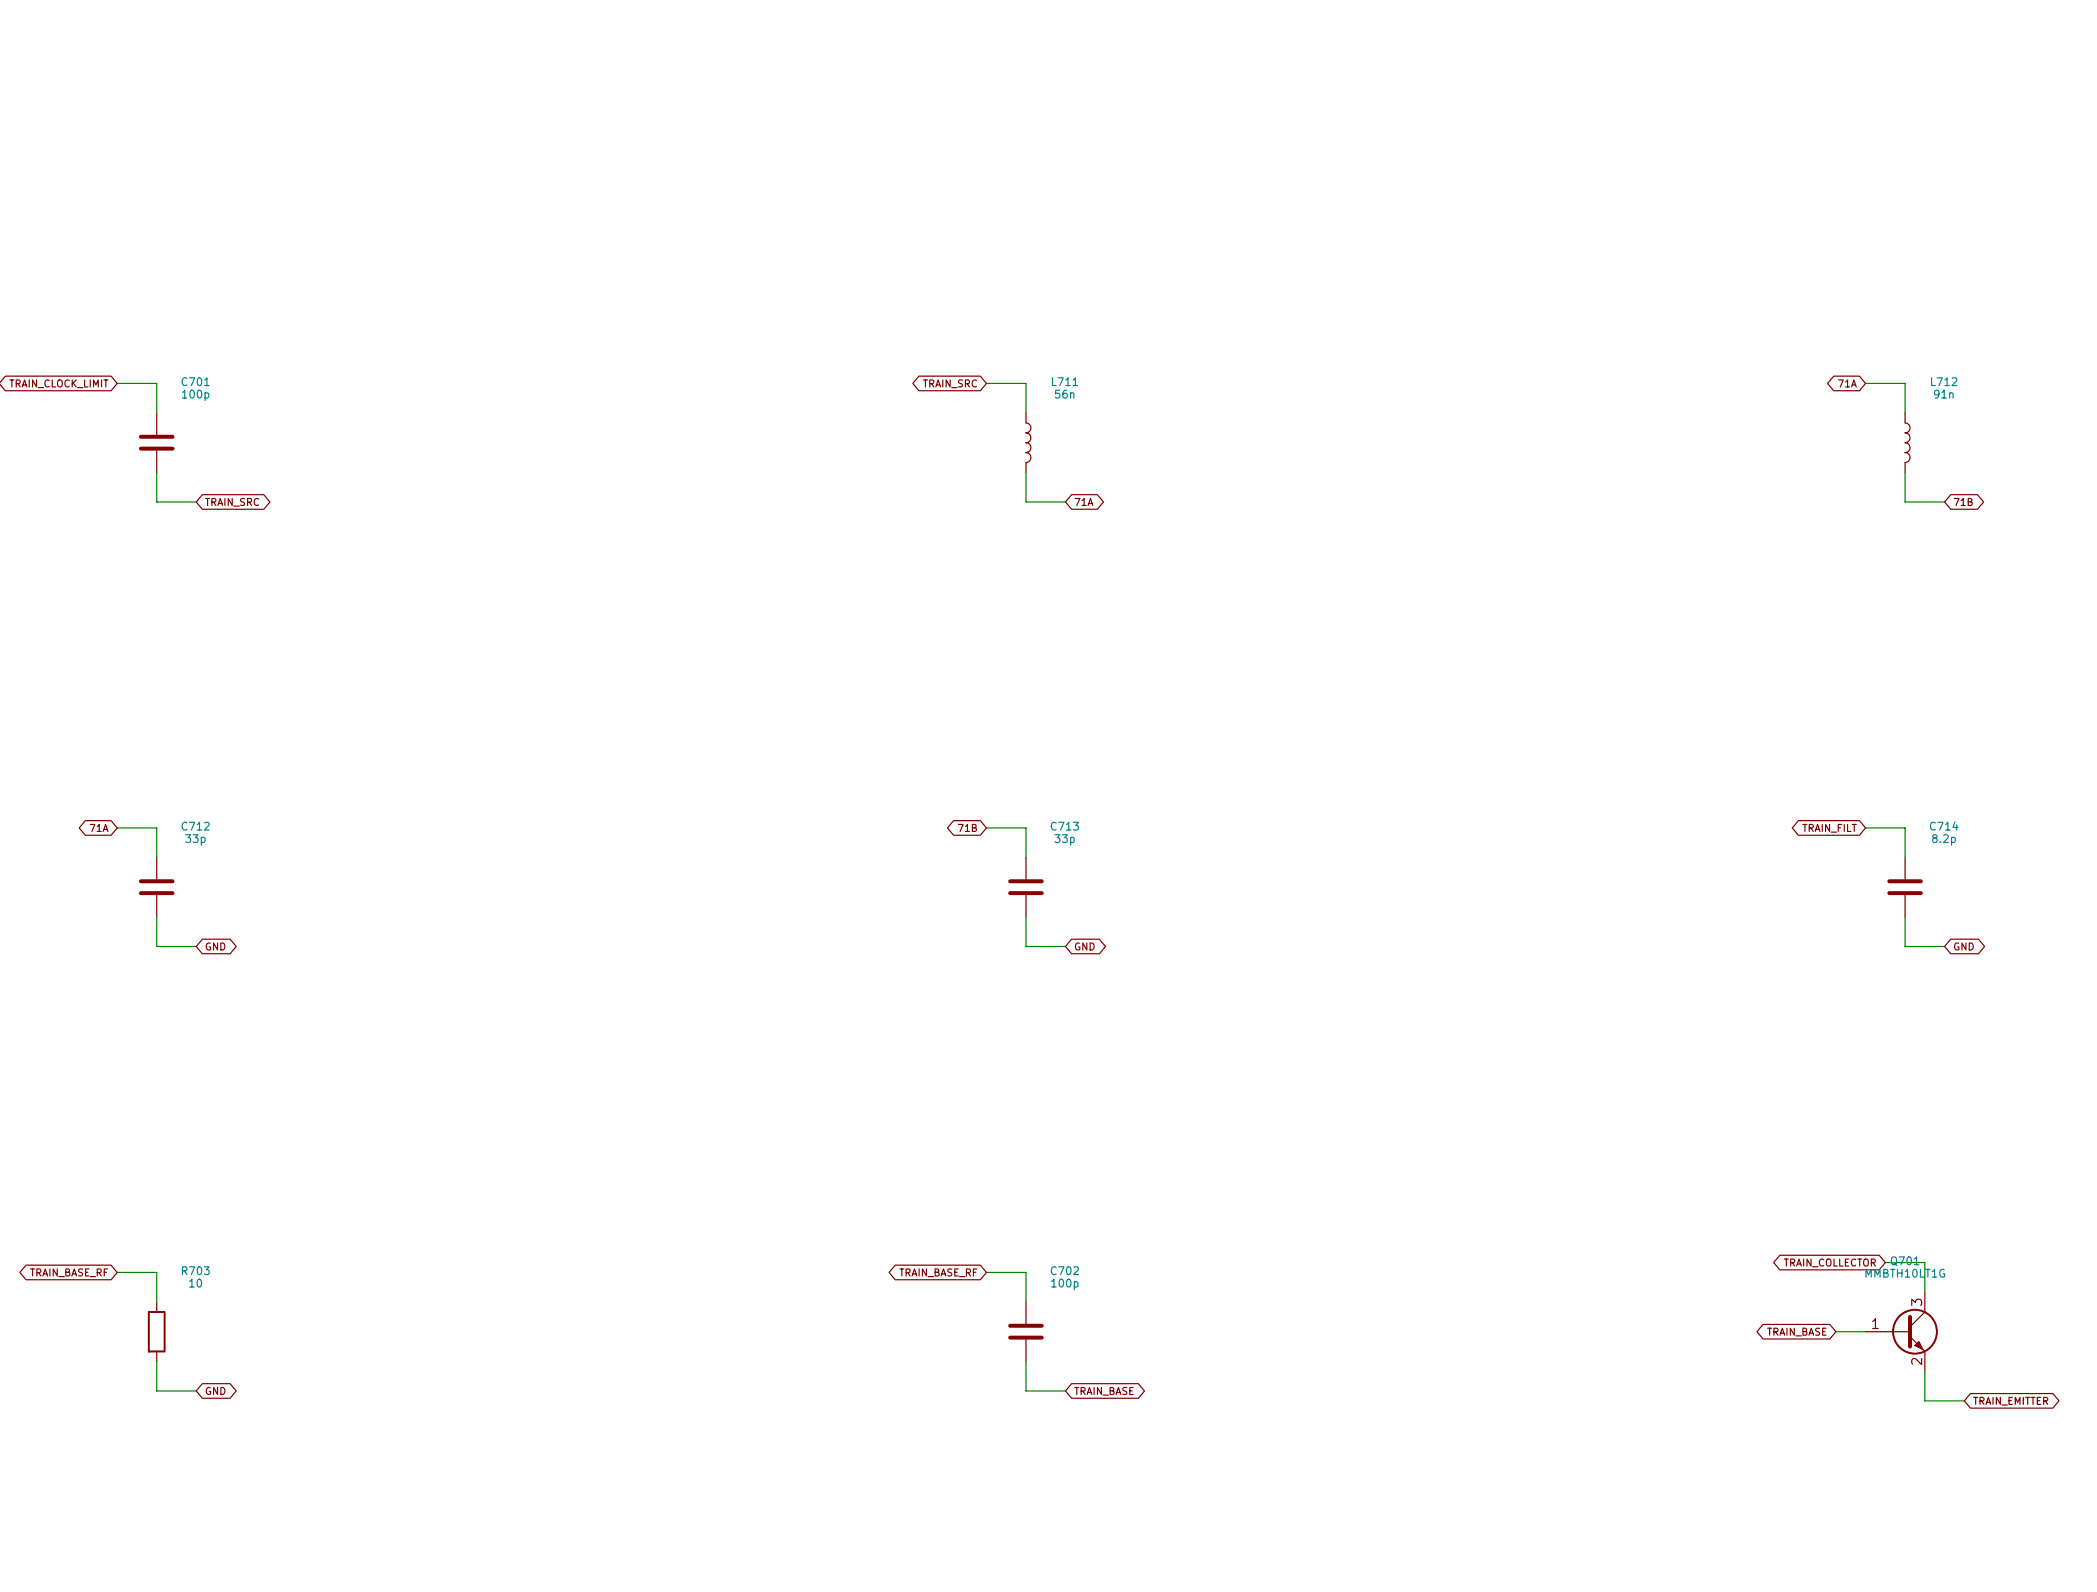
[picture p295: schematic 07_training.kicad_sch, 07 Independent very-low-power sine-AM training path, part in row 1, column 2]

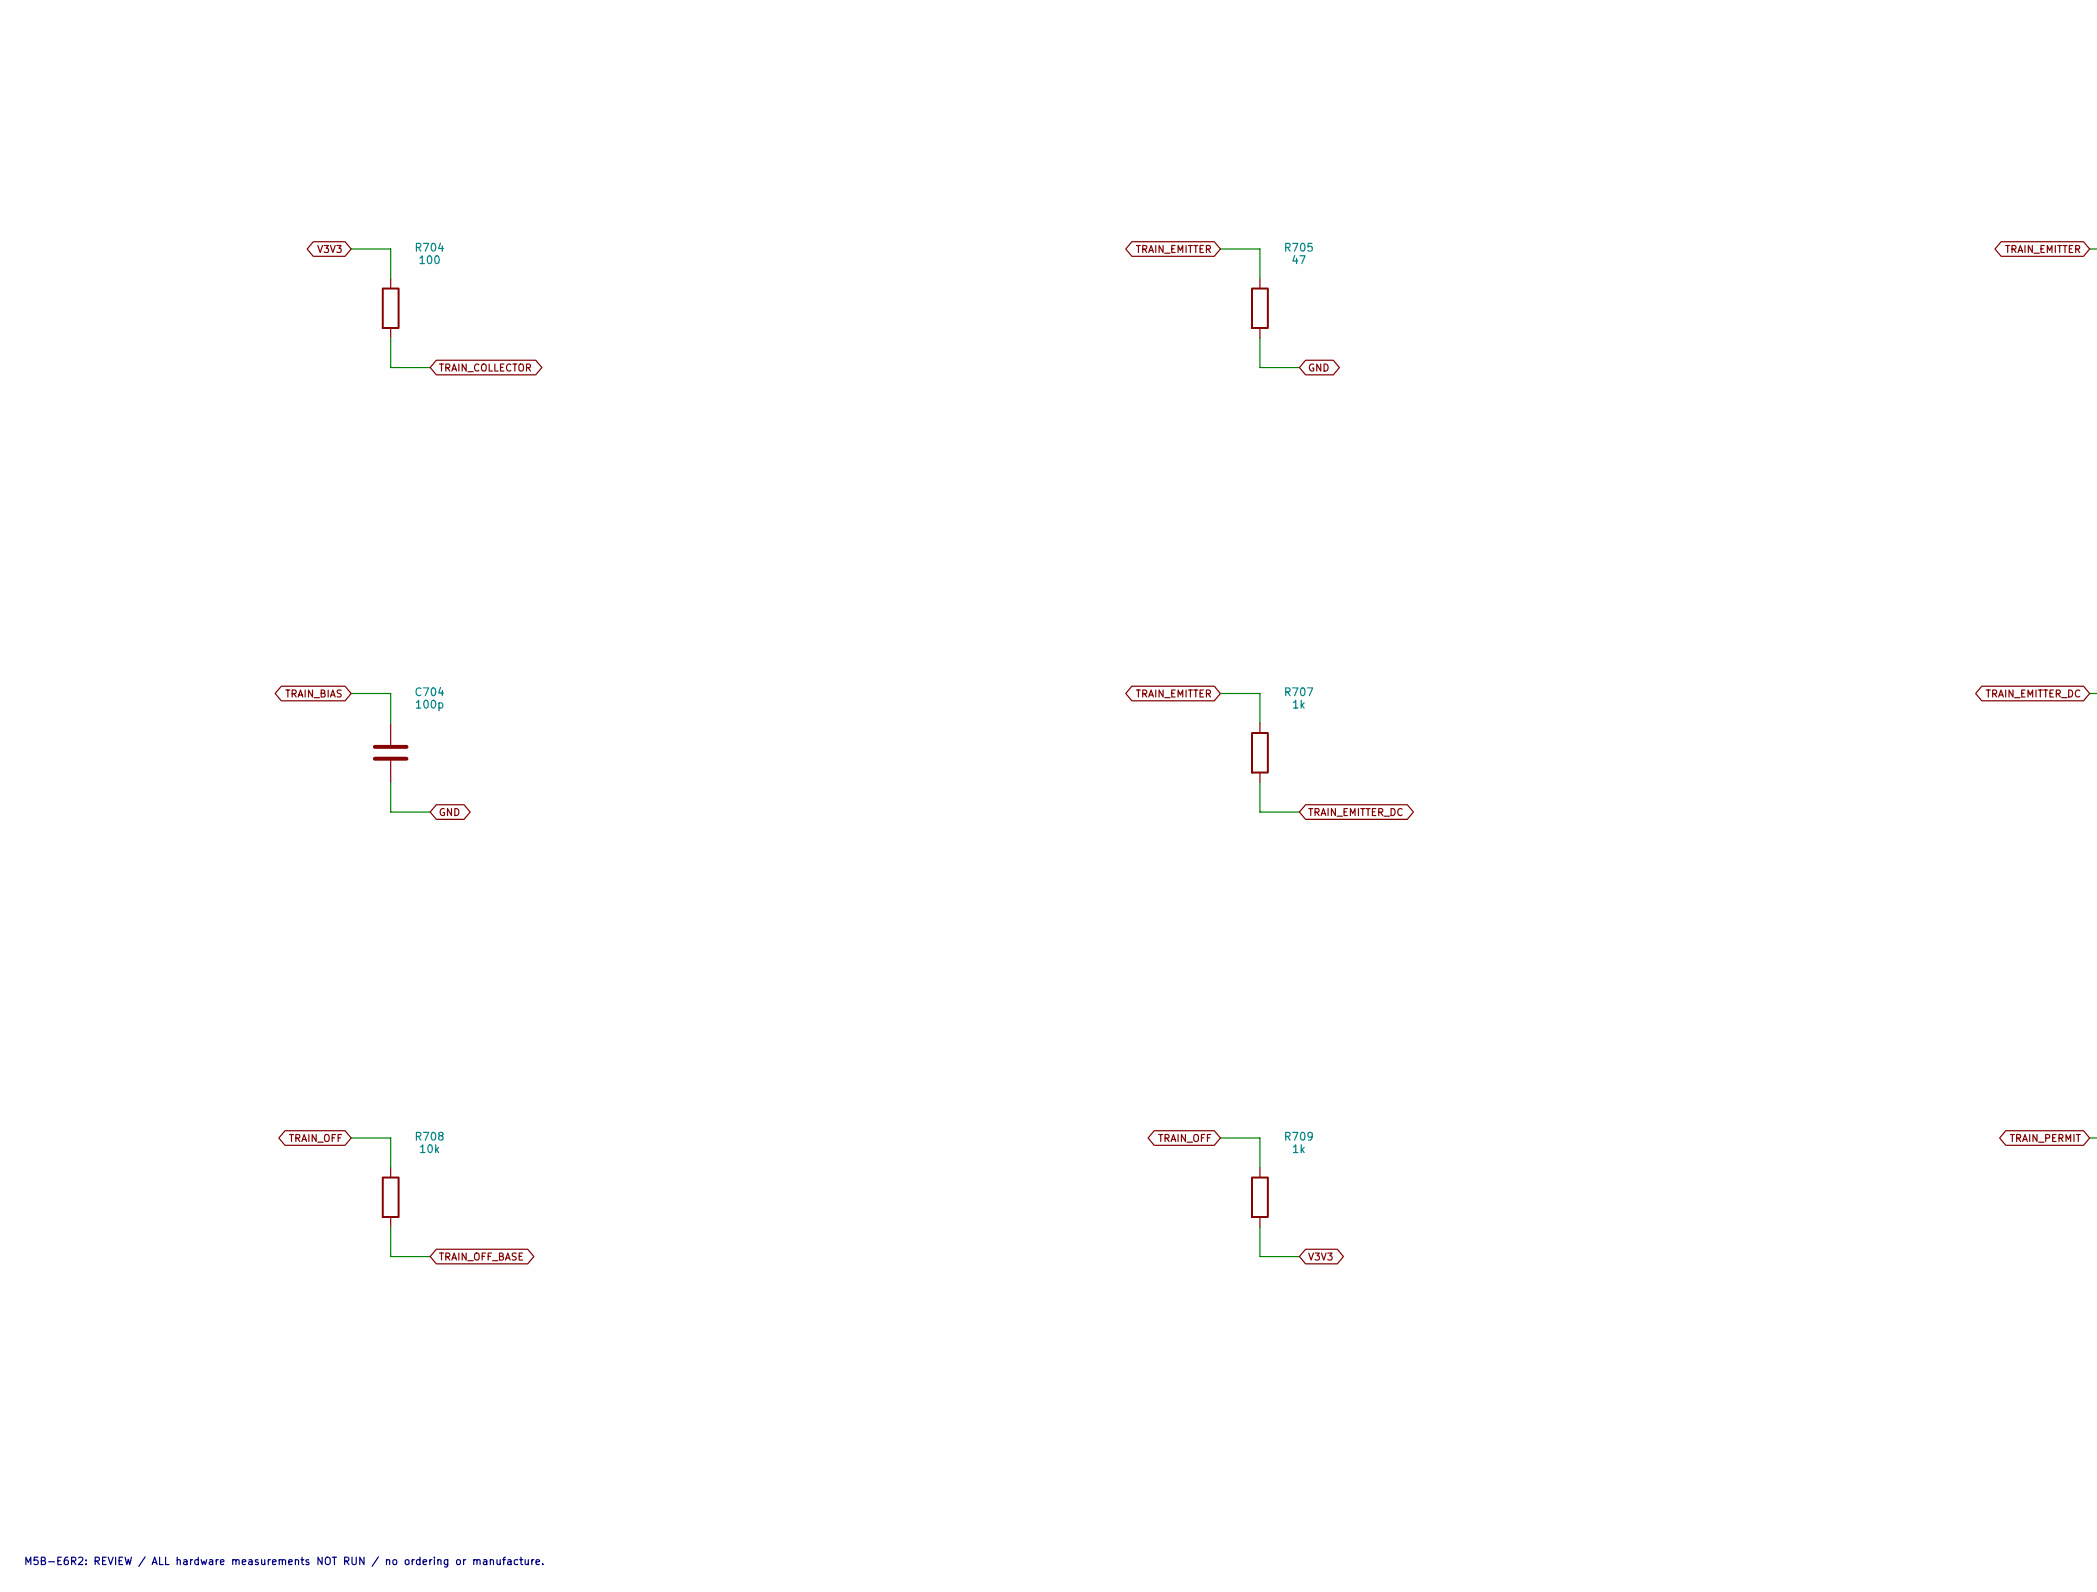
[picture p296: schematic 07_training.kicad_sch, 07 Independent very-low-power sine-AM training path, part in row 2, column 1]

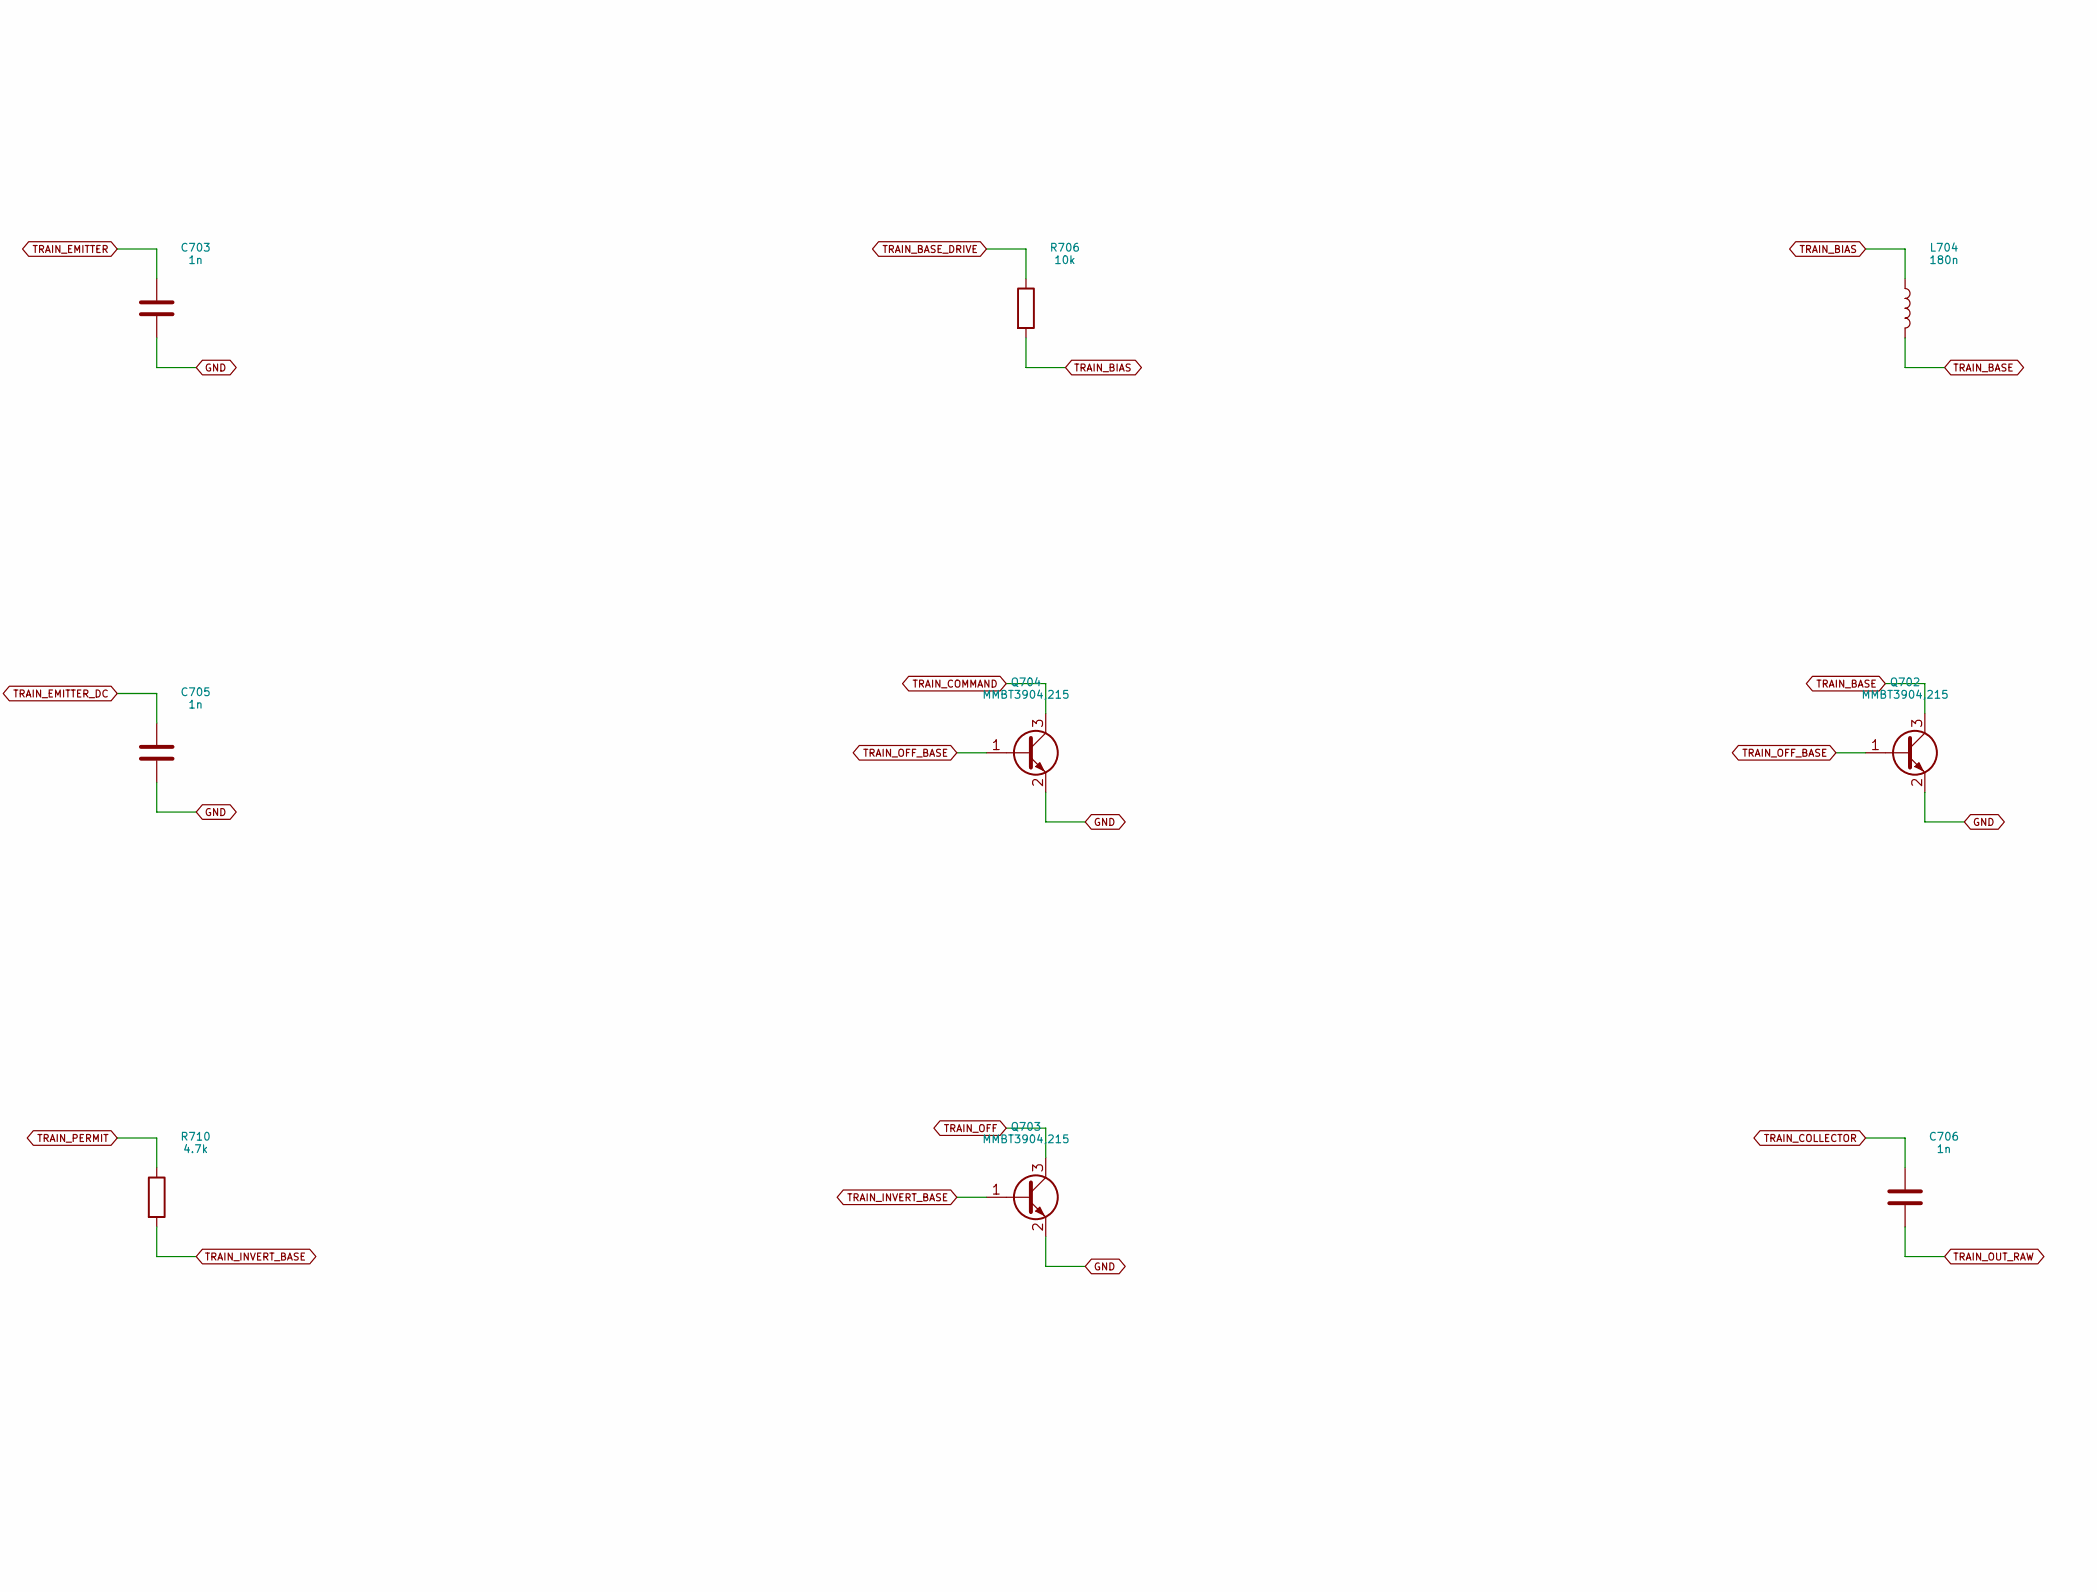
[picture p297: schematic 07_training.kicad_sch, 07 Independent very-low-power sine-AM training path, part in row 2, column 2]

Parts:
C701, C702, C704: 100p; C_0603_1608Metric_E3; MPN CC0603JRNPO9BN101
C703, C705, C706: 1n; C_0603_1608Metric_E3; MPN CC0603JRNPO9BN102
C711, C714: 8.2p; C_0603_1608Metric_E3; MPN CC0603CRNPO9BN8R2
C712, C713: 33p; C_0603_1608Metric_E3; MPN CC0603JRNPO9BN330
L704: 180n; L_0603_1608Metric_E3; MPN LQW18ANR18G80D
L711, L713: 56n; L_0603_1608Metric_E3; MPN LQW18AN56NG80D
L712: 91n; L_0603_1608Metric_E3; MPN LQW18AN91NG80D
Q701: MMBTH10LT1G; SOT-23_E3; MPN MMBTH10LT1G
Q702, Q703, Q704: MMBT3904,215; SOT-23_E3; MPN MMBT3904,215
R702: 680; R_0603_1608Metric_E3; MPN RC0603FR-07680RL
R703: 10; R_0603_1608Metric_E3; MPN RC0603FR-0710RL
R704: 100; R_1206_3216Metric_E3; MPN RC1206FR-07100RL
R705: 47; R_0603_1608Metric_E3; MPN RC0603FR-0747RL
R706, R708: 10k; R_0603_1608Metric_E3; MPN RC0603FR-0710KL
R707, R709: 1k; R_0603_1608Metric_E3; MPN RC0603FR-071KL
R710: 4.7k; R_0603_1608Metric_E3; MPN RC0603FR-074K7L
R714: 100; R_0603_1608Metric_E3; MPN RC0603FR-07100RL
R715: 51.1; R_0603_1608Metric_E3; MPN RC0603FR-0751R1L
U701: SN74LVC1G125DBVR; SOT-23-5_E3; MPN SN74LVC1G125DBVR

Connections:
71A: C712.1, L711.2, L712.1
71B: C713.1, L712.2, L713.1
CLK_TRAIN: U701.2 (A); also elsewhere on the board
GND: C703.2, C704.2, C705.2, C711.2, C712.2, C713.2, C714.2, Q702.2 (E), Q703.2 (E), Q704.2 (E), R703.2, R705.2, R715.2, U701.3 (GND); also elsewhere on the board
TRAIN_BASE: C702.2, L704.2, Q701.1 (B), Q702.3 (C)
TRAIN_BASE_DRIVE: R706.1; also elsewhere on the board
TRAIN_BASE_RF: C702.1, R702.2, R703.1
TRAIN_BIAS: C704.1, L704.1, R706.2
TRAIN_CLOCK_BUF: R714.1, U701.4 (Y)
TRAIN_CLOCK_LIMIT: C701.1, R714.2
TRAIN_COLLECTOR: C706.1, Q701.3 (C), R704.2
TRAIN_COMMAND: Q704.3 (C); also elsewhere on the board
TRAIN_EMITTER: C703.1, Q701.2 (E), R705.1, R707.1
TRAIN_EMITTER_DC: C705.1, R707.2; also elsewhere on the board
TRAIN_FILT: C714.1, L713.2, R702.1, R715.1
TRAIN_INVERT_BASE: Q703.1 (B), R710.2
TRAIN_OFF: Q703.3 (C), R708.1, R709.1, U701.1 (OE_N)
TRAIN_OFF_BASE: Q702.1 (B), Q704.1 (B), R708.2
TRAIN_OUT_RAW: C706.2; also elsewhere on the board
TRAIN_PERMIT: R710.1; also elsewhere on the board
TRAIN_SRC: C701.2, C711.1, L711.1
V3V3: R704.1, R709.2, U701.5 (VCC); also elsewhere on the board

Notes on the sheet:
07 Independent very-low-power sine-AM training path
M5B-E6R2 / integrated evaluation PCB / NOT RELEASED / hardware tests NOT_RUN
M5B-E6R2: REVIEW / ALL hardware measurements NOT RUN / no ordering or manufacture.

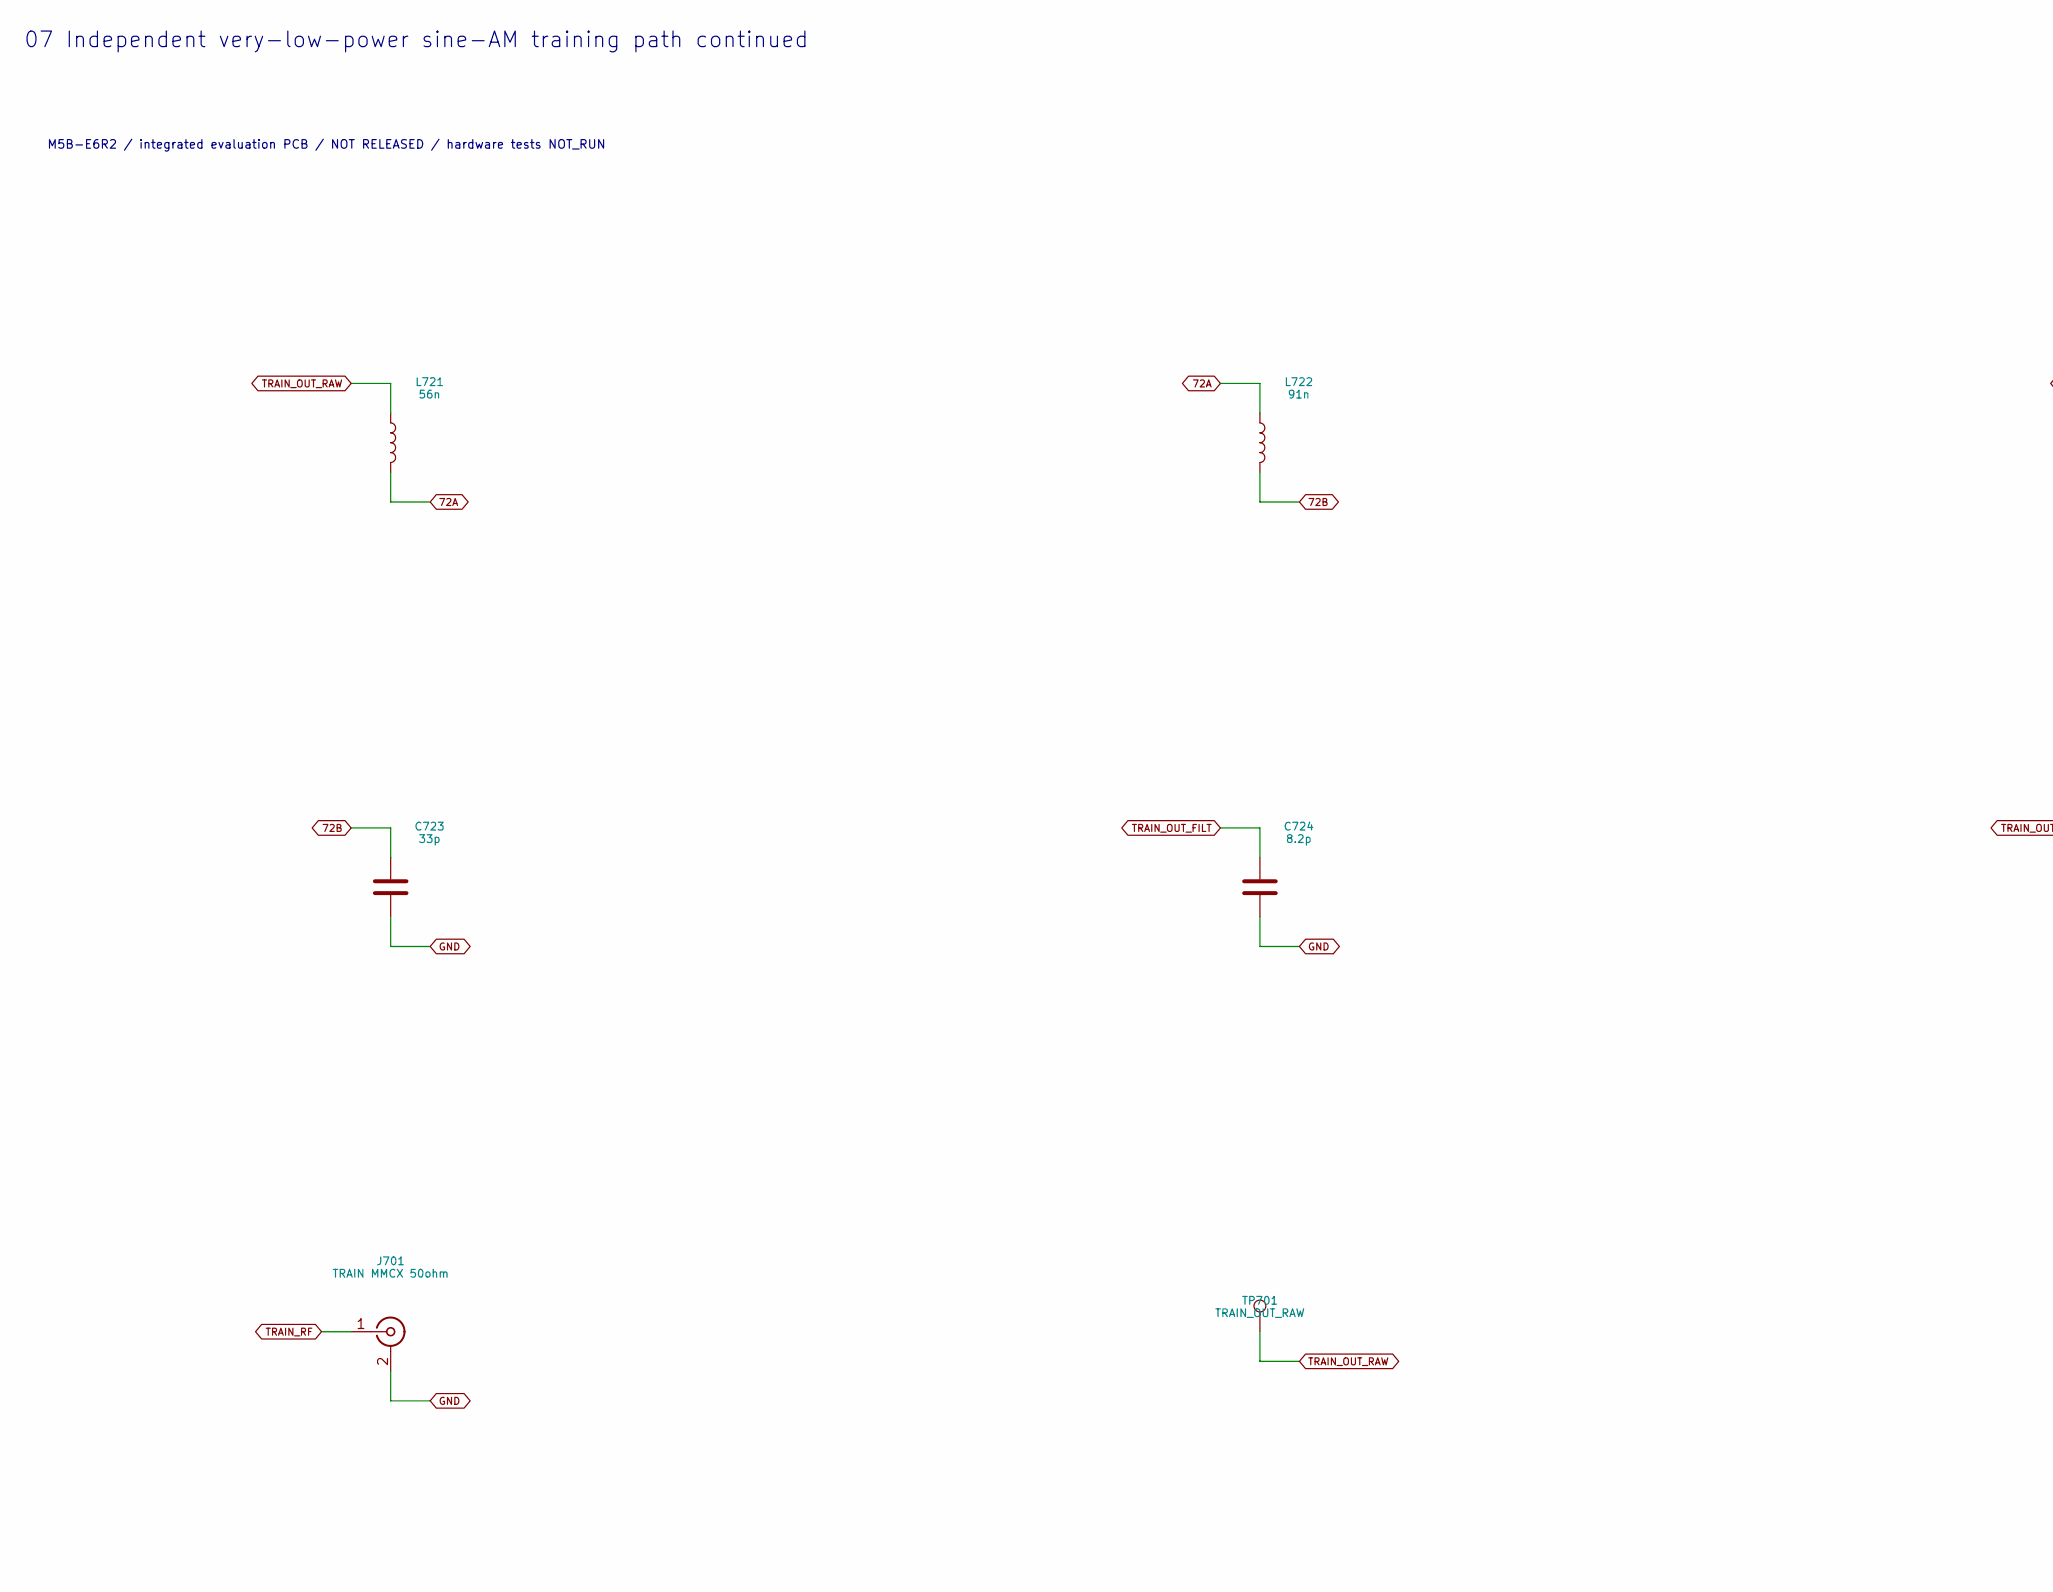
[picture p298: schematic 07_trainingb1.kicad_sch, 07 Independent very-low-power sine-AM training path continu…, part in row 1, column 1]

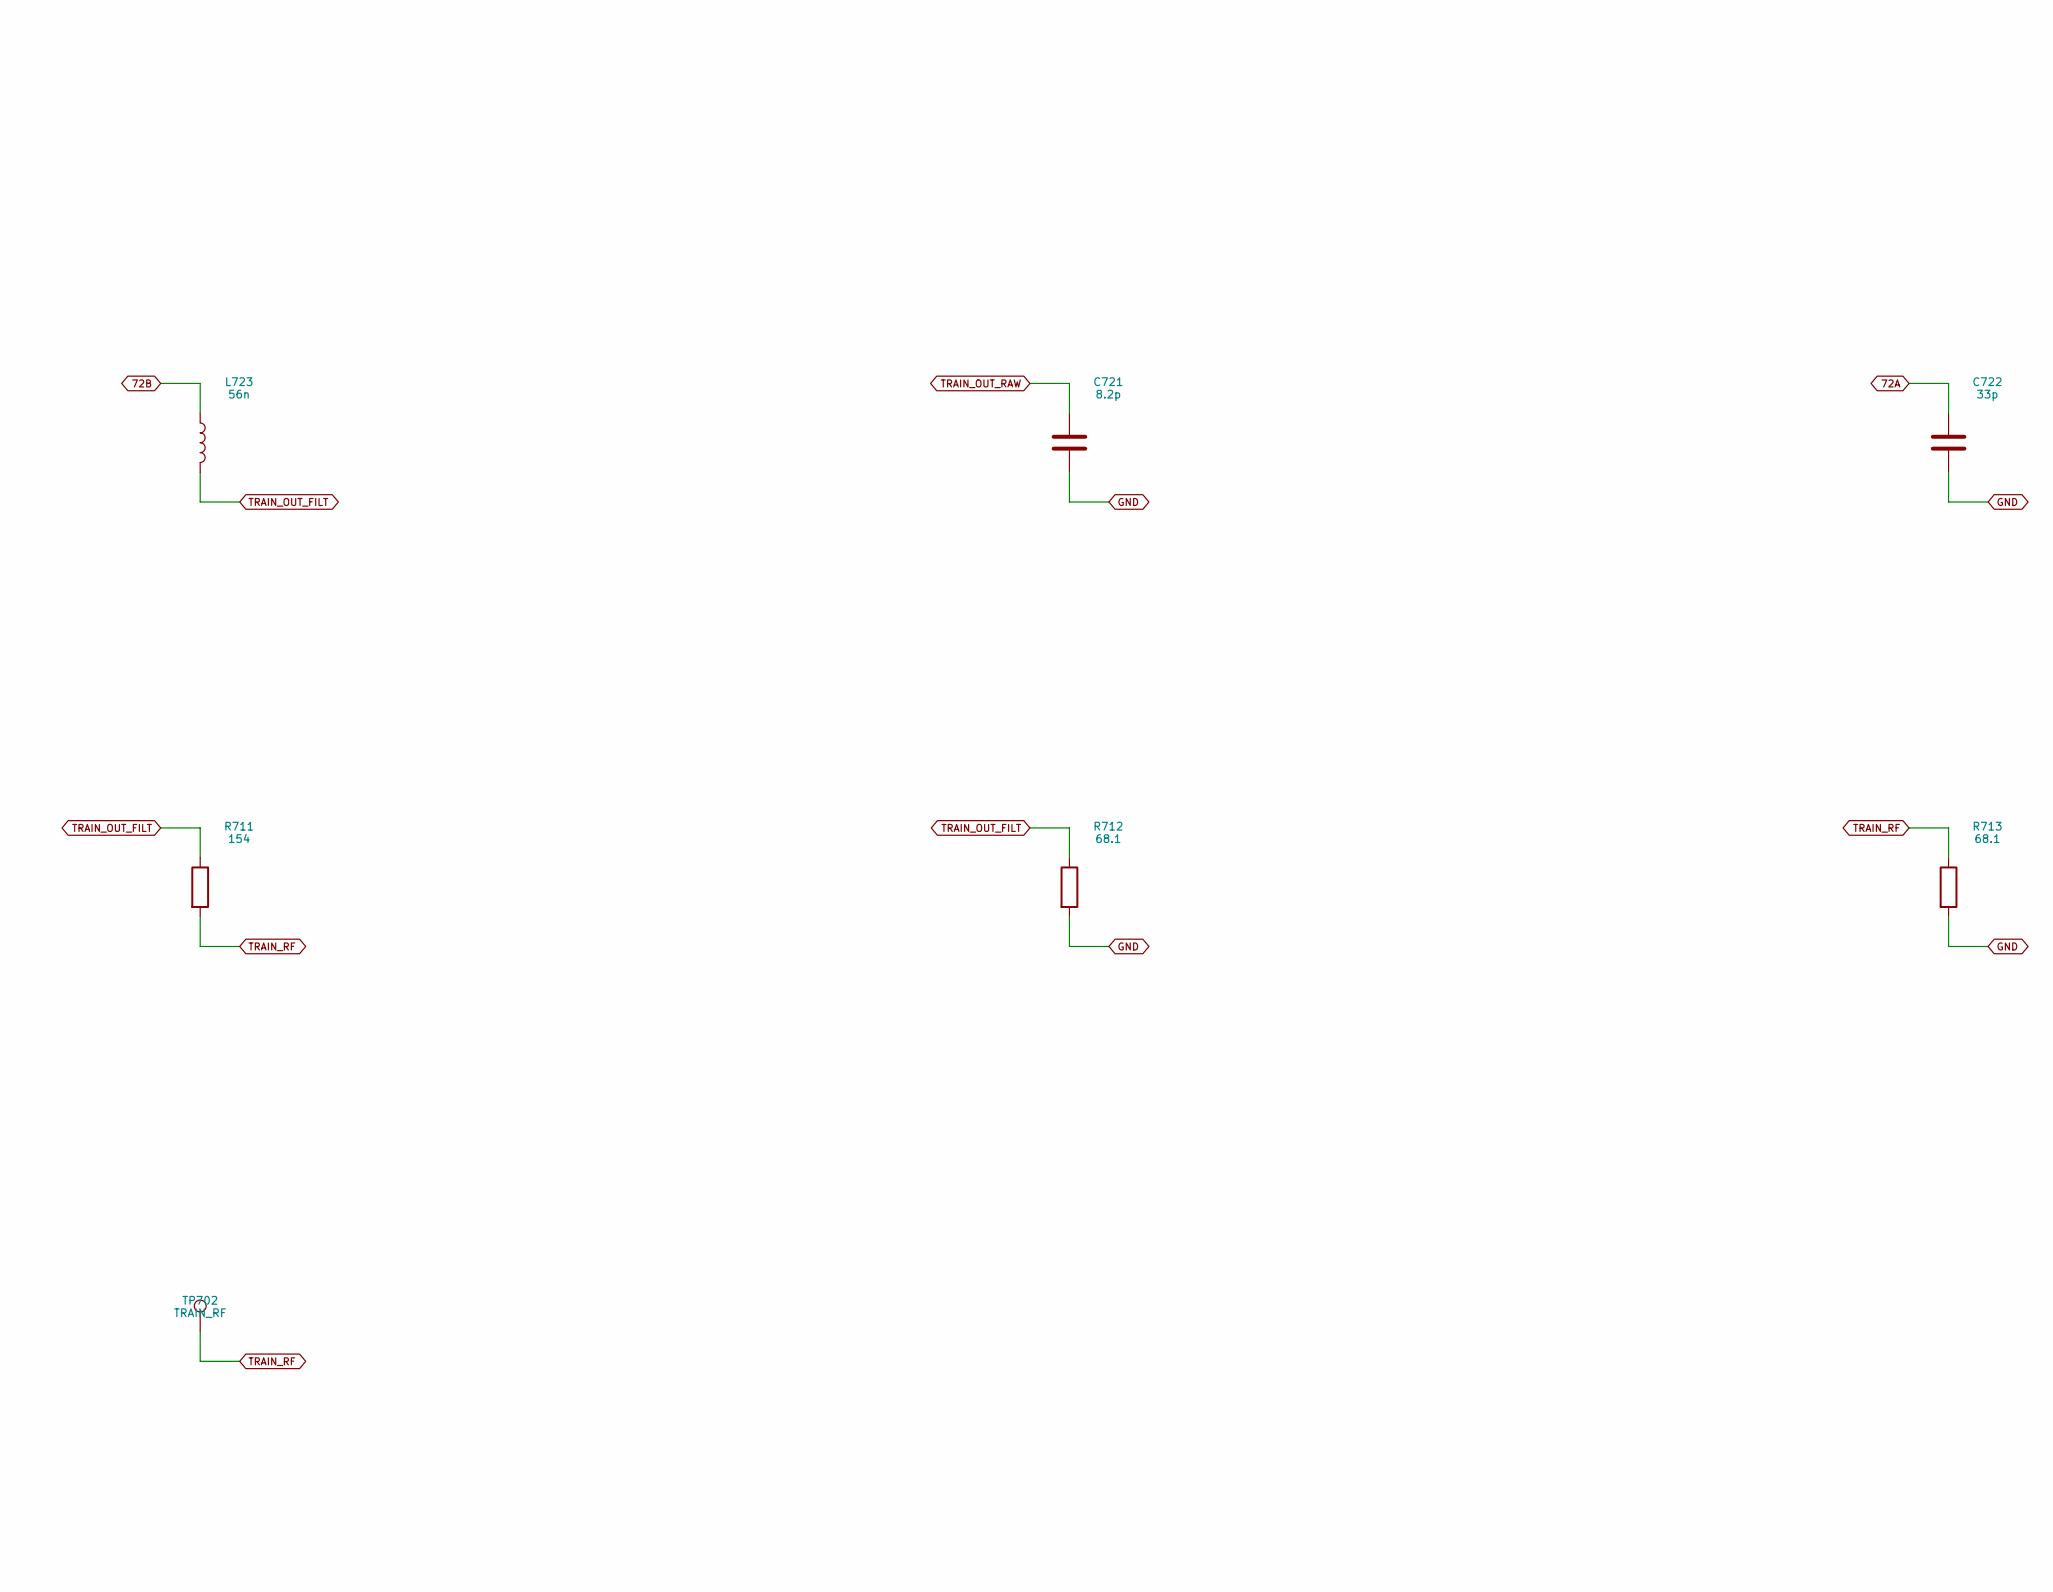
[picture p299: schematic 07_trainingb1.kicad_sch, 07 Independent very-low-power sine-AM training path continu…, part in row 1, column 2]

Parts:
C721, C724: 8.2p; C_0603_1608Metric_E3; MPN CC0603CRNPO9BN8R2
C722, C723: 33p; C_0603_1608Metric_E3; MPN CC0603JRNPO9BN330
J701: TRAIN MMCX 50ohm; WR-MMCX_Wuerth_66012102111404_Vertical_E3; MPN 66012102111404
L721, L723: 56n; L_0603_1608Metric_E3; MPN LQW18AN56NG80D
L722: 91n; L_0603_1608Metric_E3; MPN LQW18AN91NG80D
R711: 154; R_0603_1608Metric_E3; MPN RC0603FR-07154RL
R712, R713: 68.1; R_0603_1608Metric_E3; MPN RC0603FR-0768R1L
TP701: TRAIN_OUT_RAW; TestPoint_Pad_D1.0mm_E3; MPN PCB feature
TP702: TRAIN_RF; TestPoint_Pad_D1.0mm_E3; MPN PCB feature

Connections:
72A: C722.1, L721.2, L722.1
72B: C723.1, L722.2, L723.1
GND: C721.2, C722.2, C723.2, C724.2, J701.2 (Ext), R712.2, R713.2; also elsewhere on the board
TRAIN_OUT_FILT: C724.1, L723.2, R711.1, R712.1
TRAIN_OUT_RAW: C721.1, L721.1, TP701.1; also elsewhere on the board
TRAIN_RF: J701.1 (In), R711.2, R713.1, TP702.1

Notes on the sheet:
07 Independent very-low-power sine-AM training path continued
M5B-E6R2 / integrated evaluation PCB / NOT RELEASED / hardware tests NOT_RUN
M5B-E6R2: REVIEW / ALL hardware measurements NOT RUN / no ordering or manufacture.
