DD1SB/ARDF-TX/hardware/2m/RF2M.kicad_pcb

## KiCad design hardware/2m/RF2M.kicad_pcb (continued)

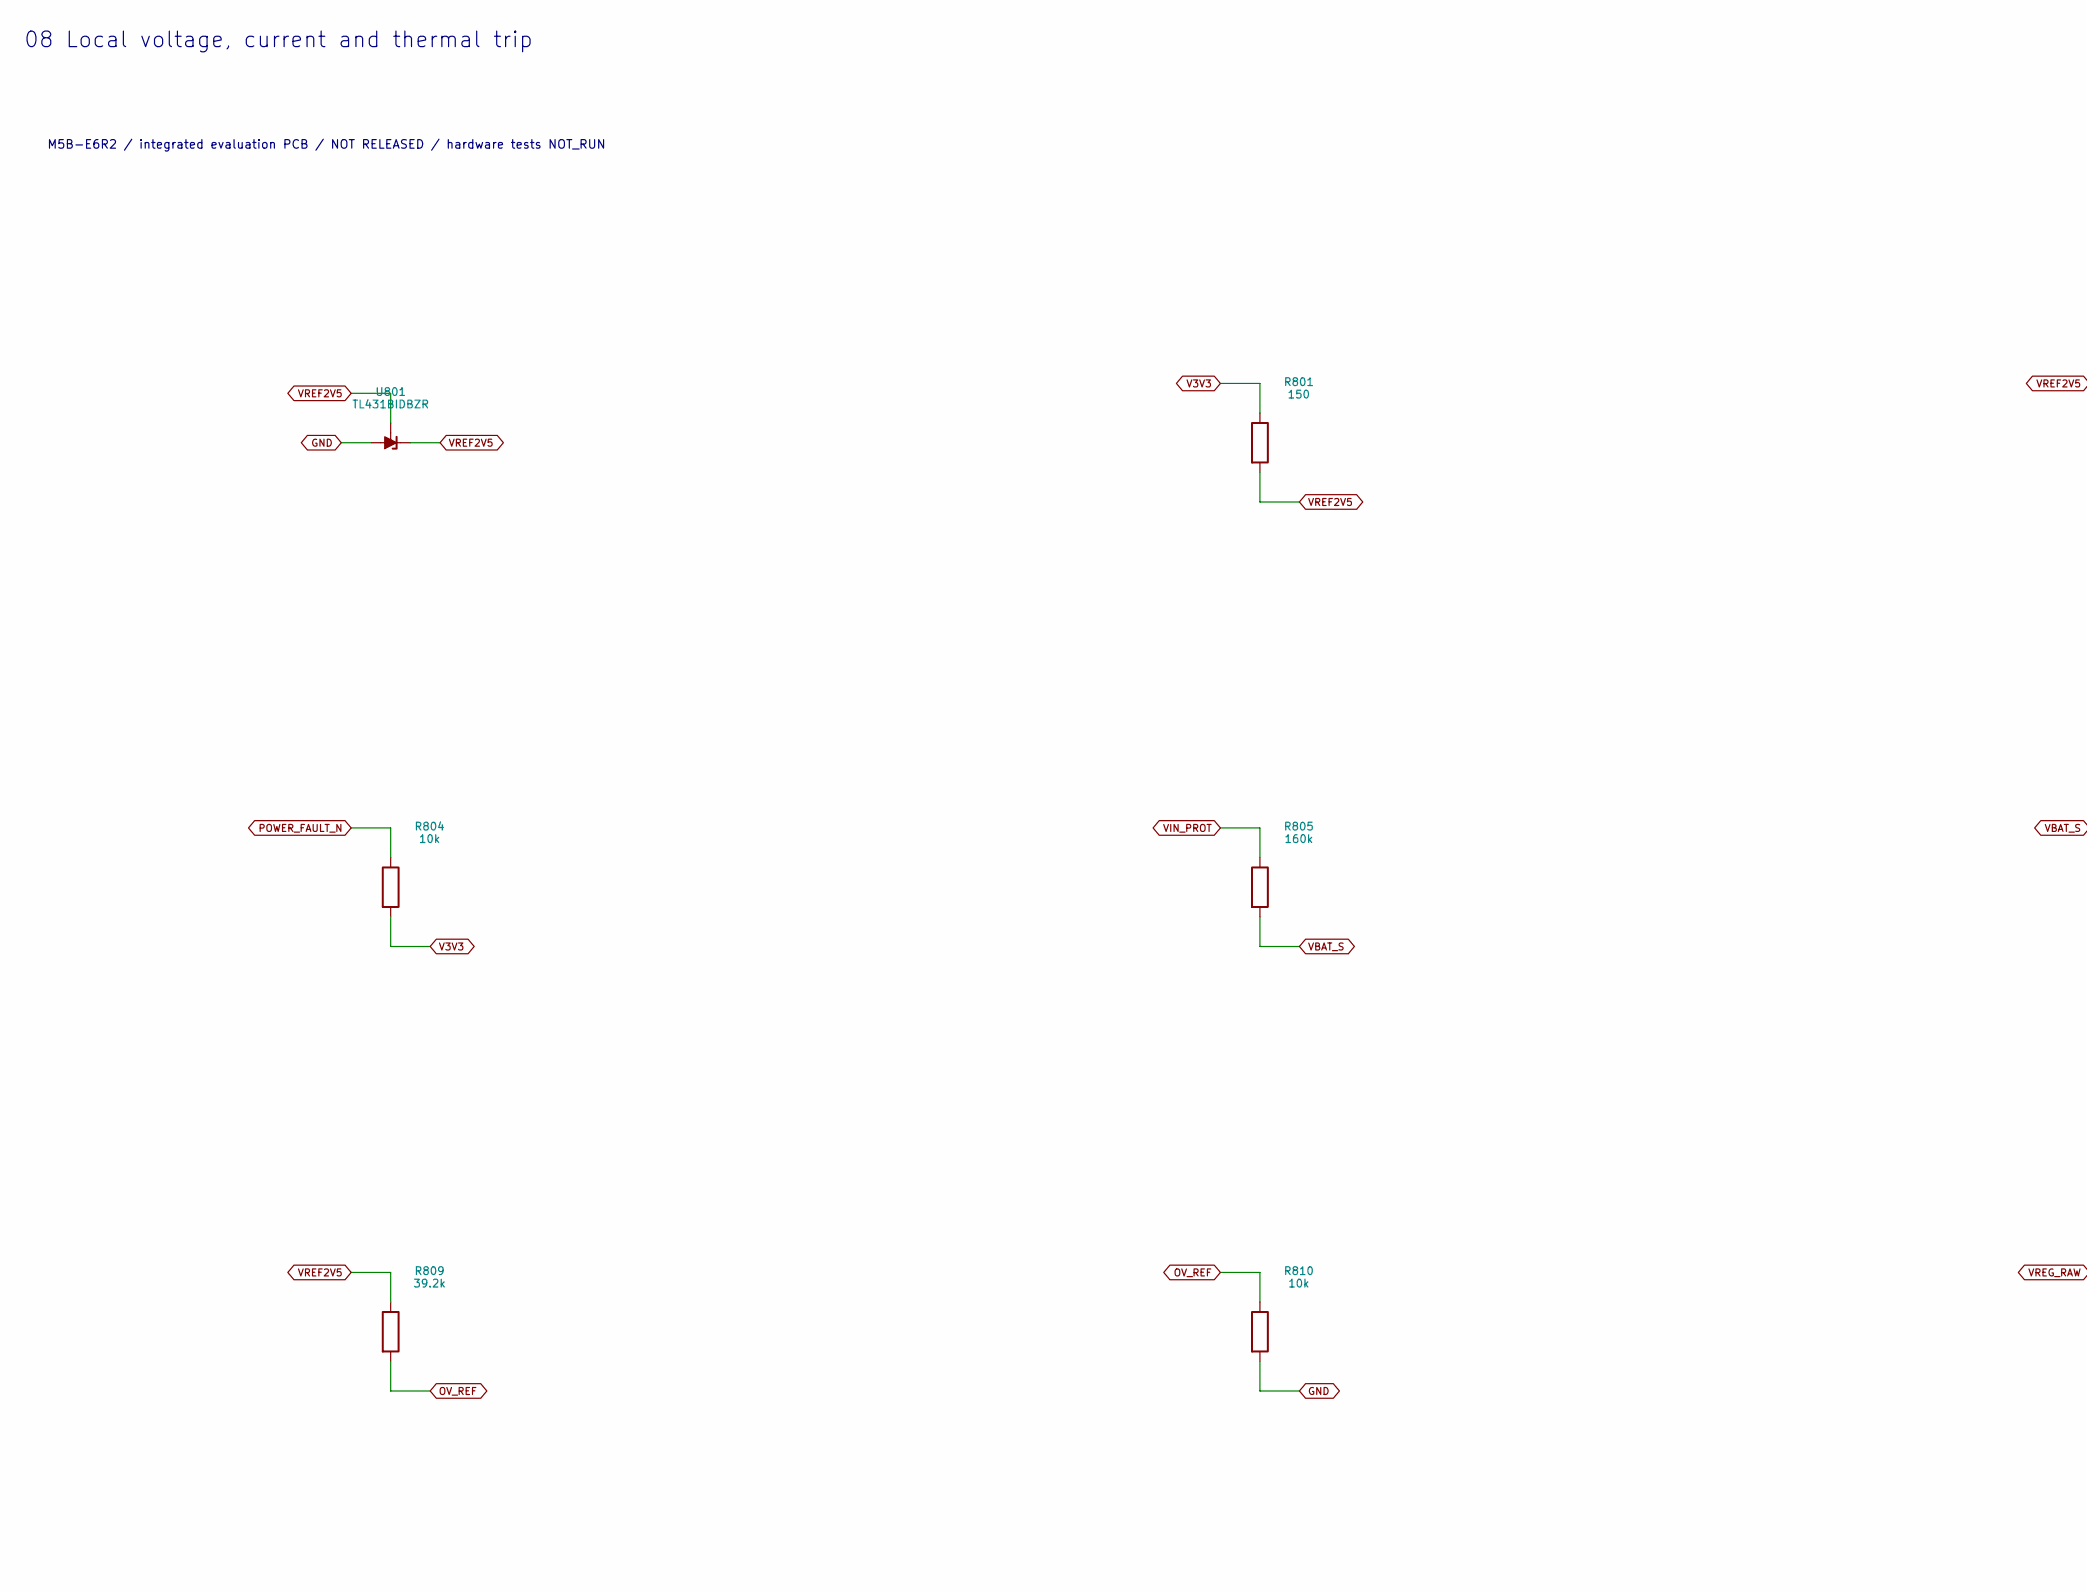
[picture p300: schematic 08_protection.kicad_sch, 08 Local voltage, current and thermal trip, part in row 1, column 1]

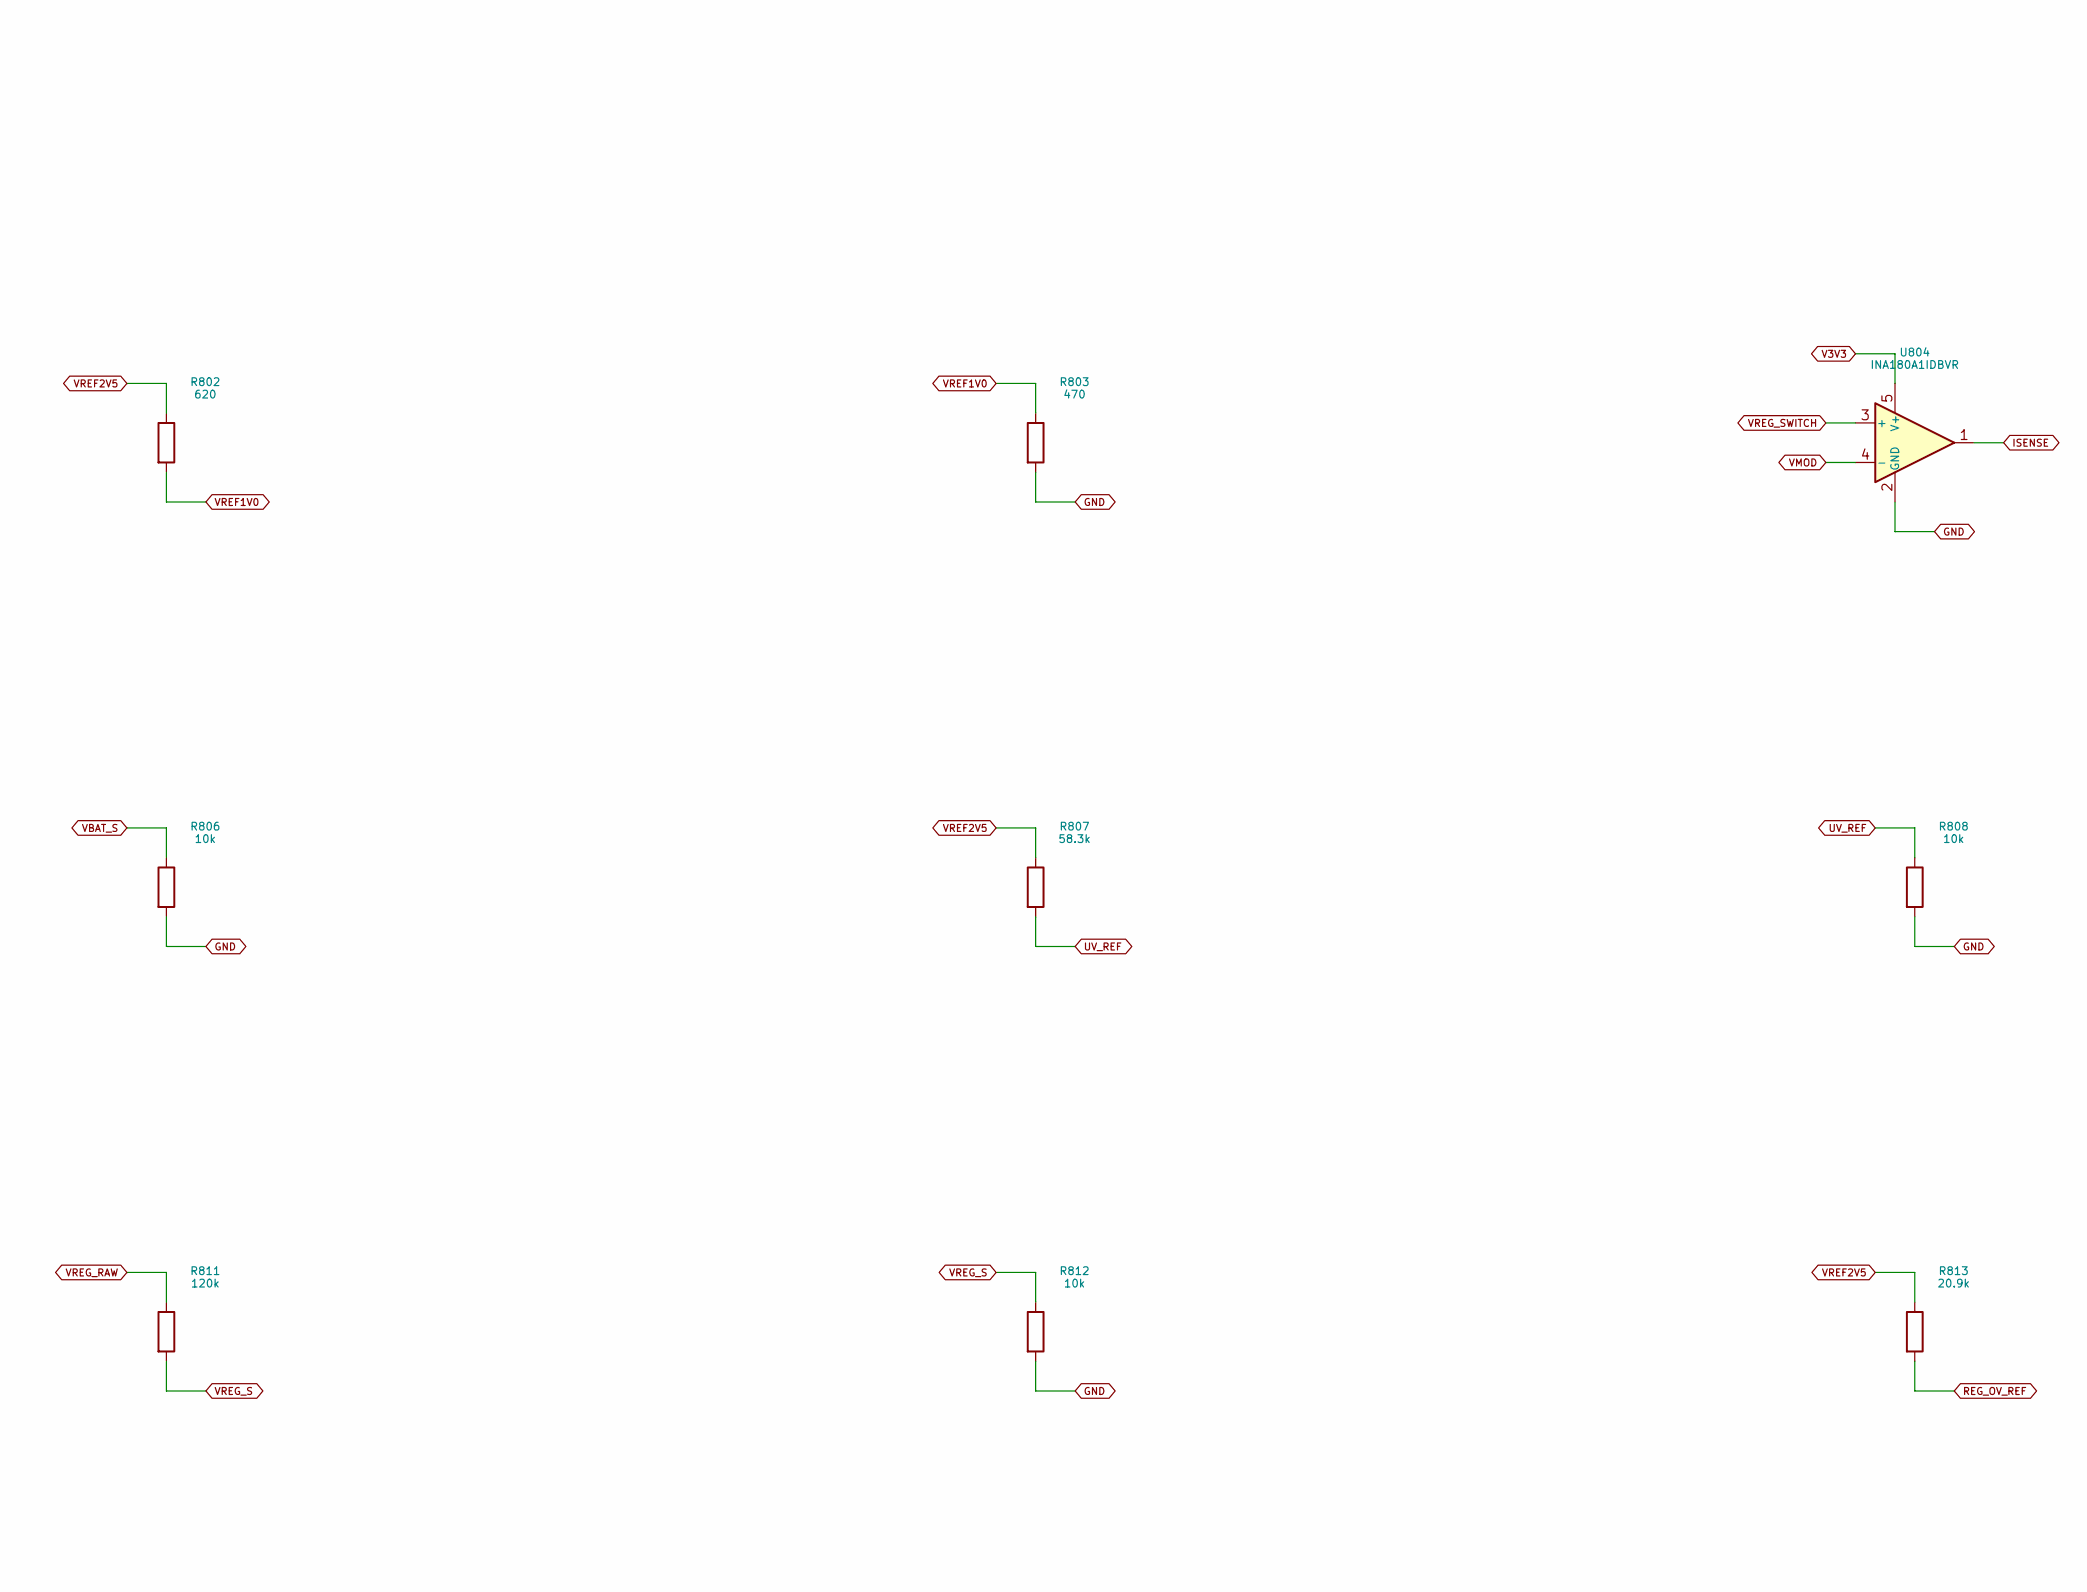
[picture p301: schematic 08_protection.kicad_sch, 08 Local voltage, current and thermal trip, part in row 1, column 2]

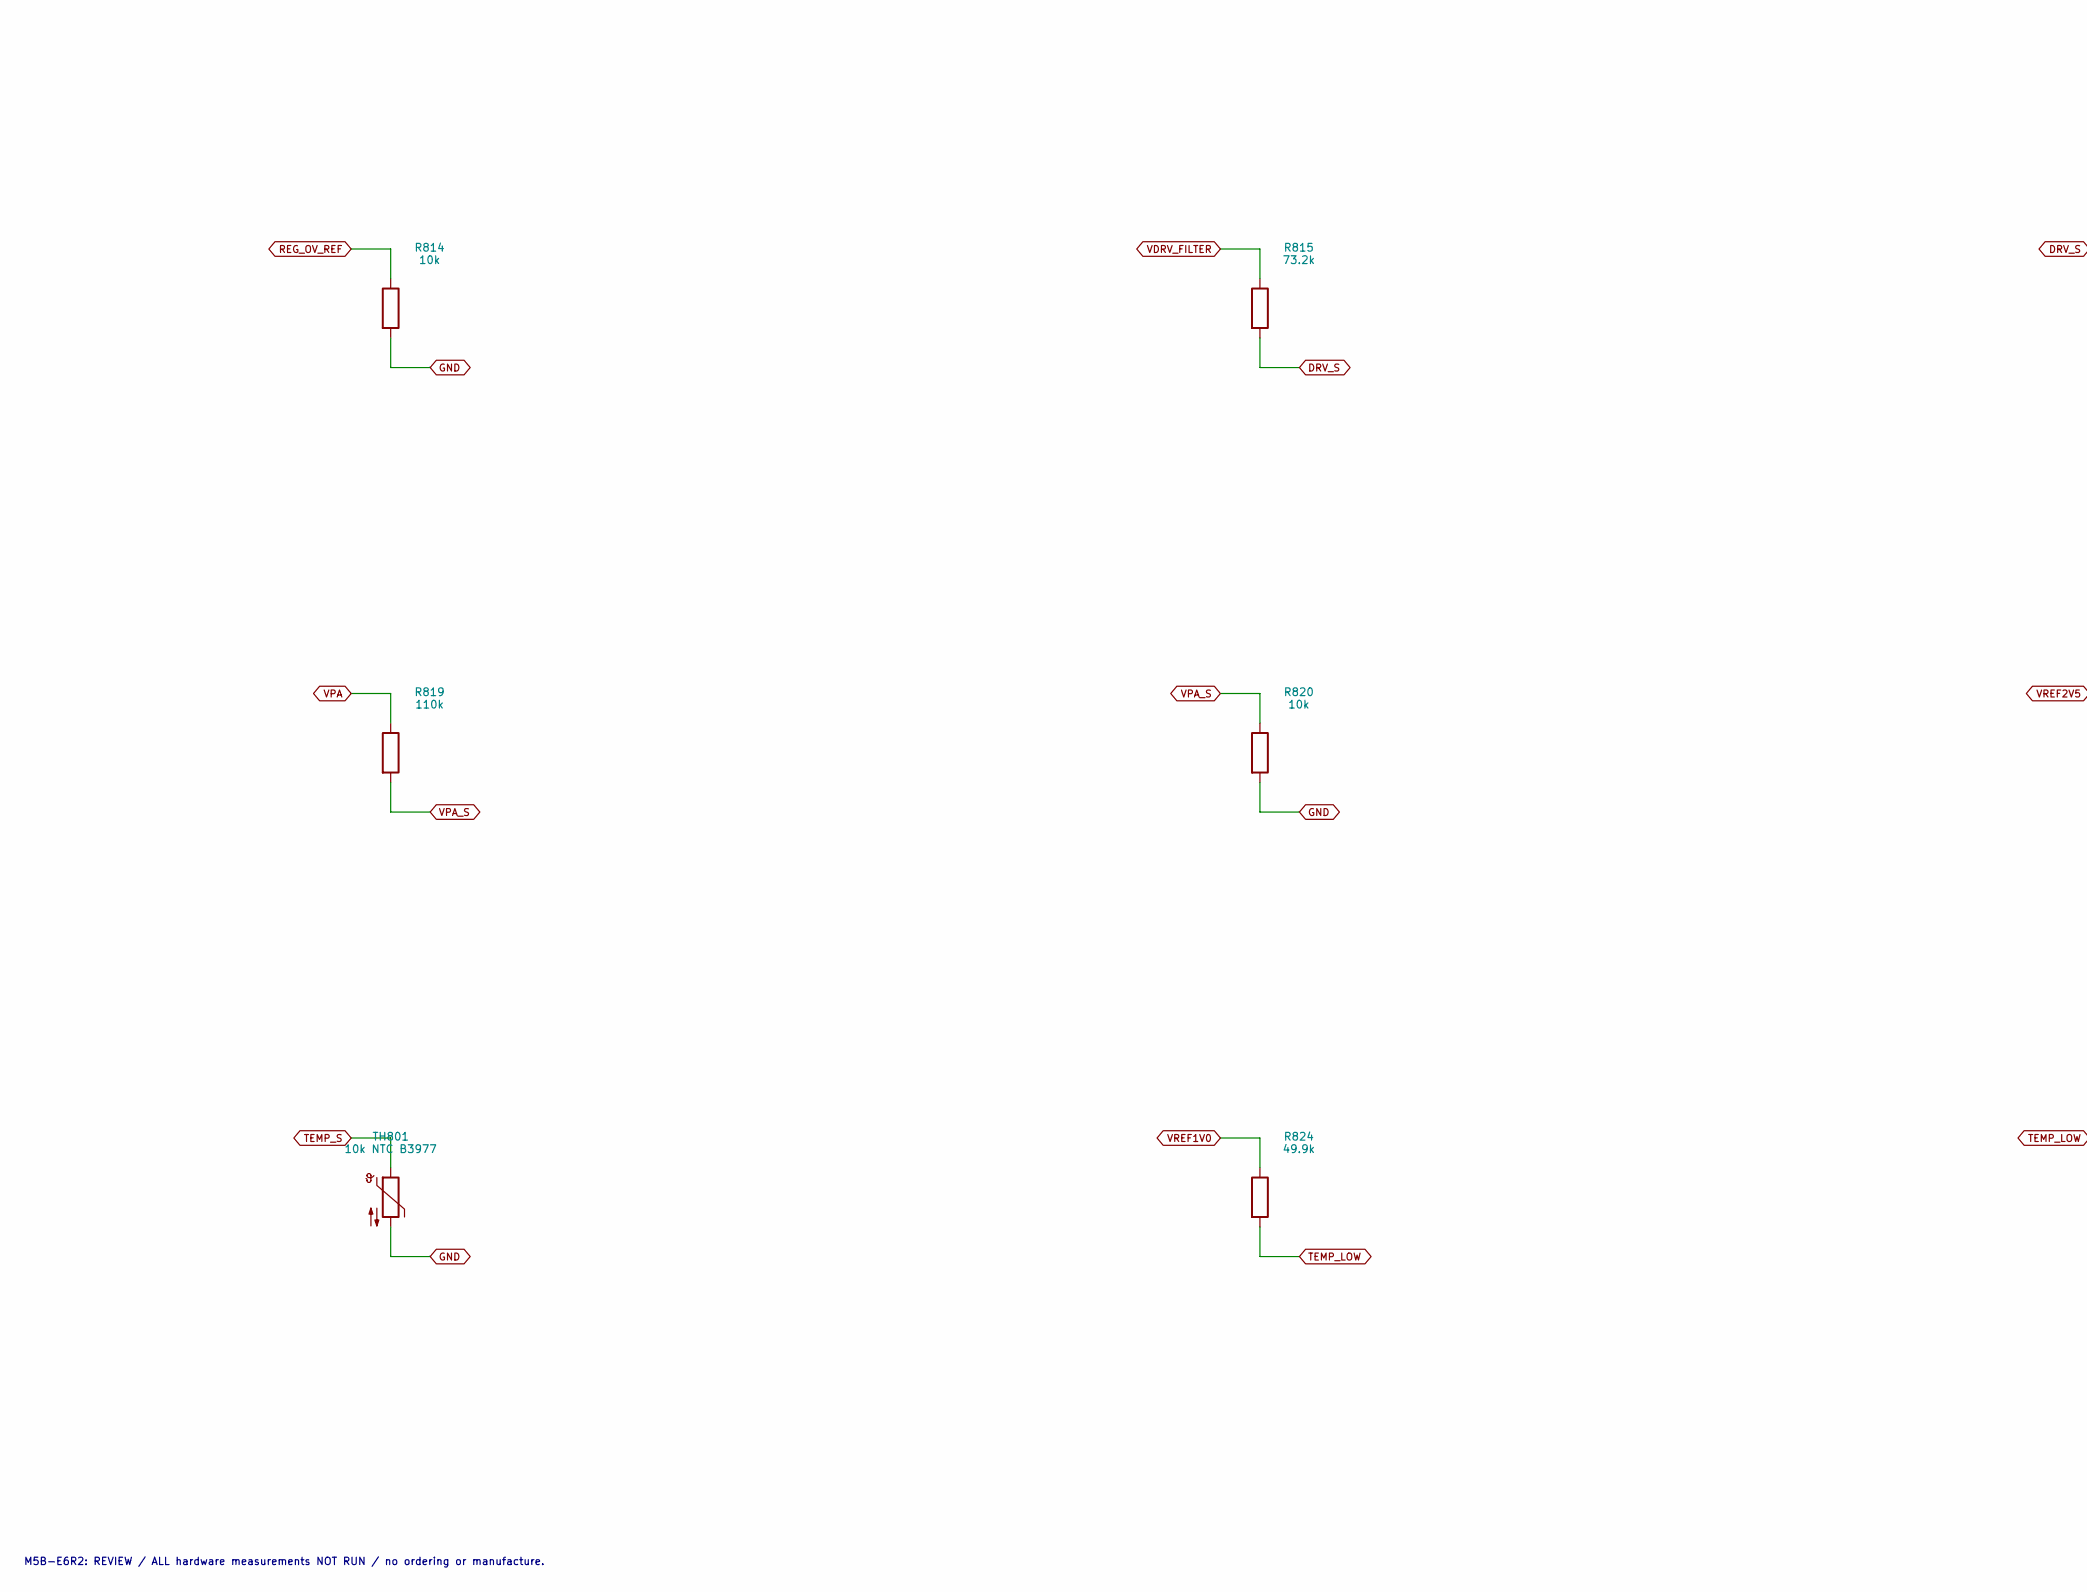
[picture p302: schematic 08_protection.kicad_sch, 08 Local voltage, current and thermal trip, part in row 2, column 1]

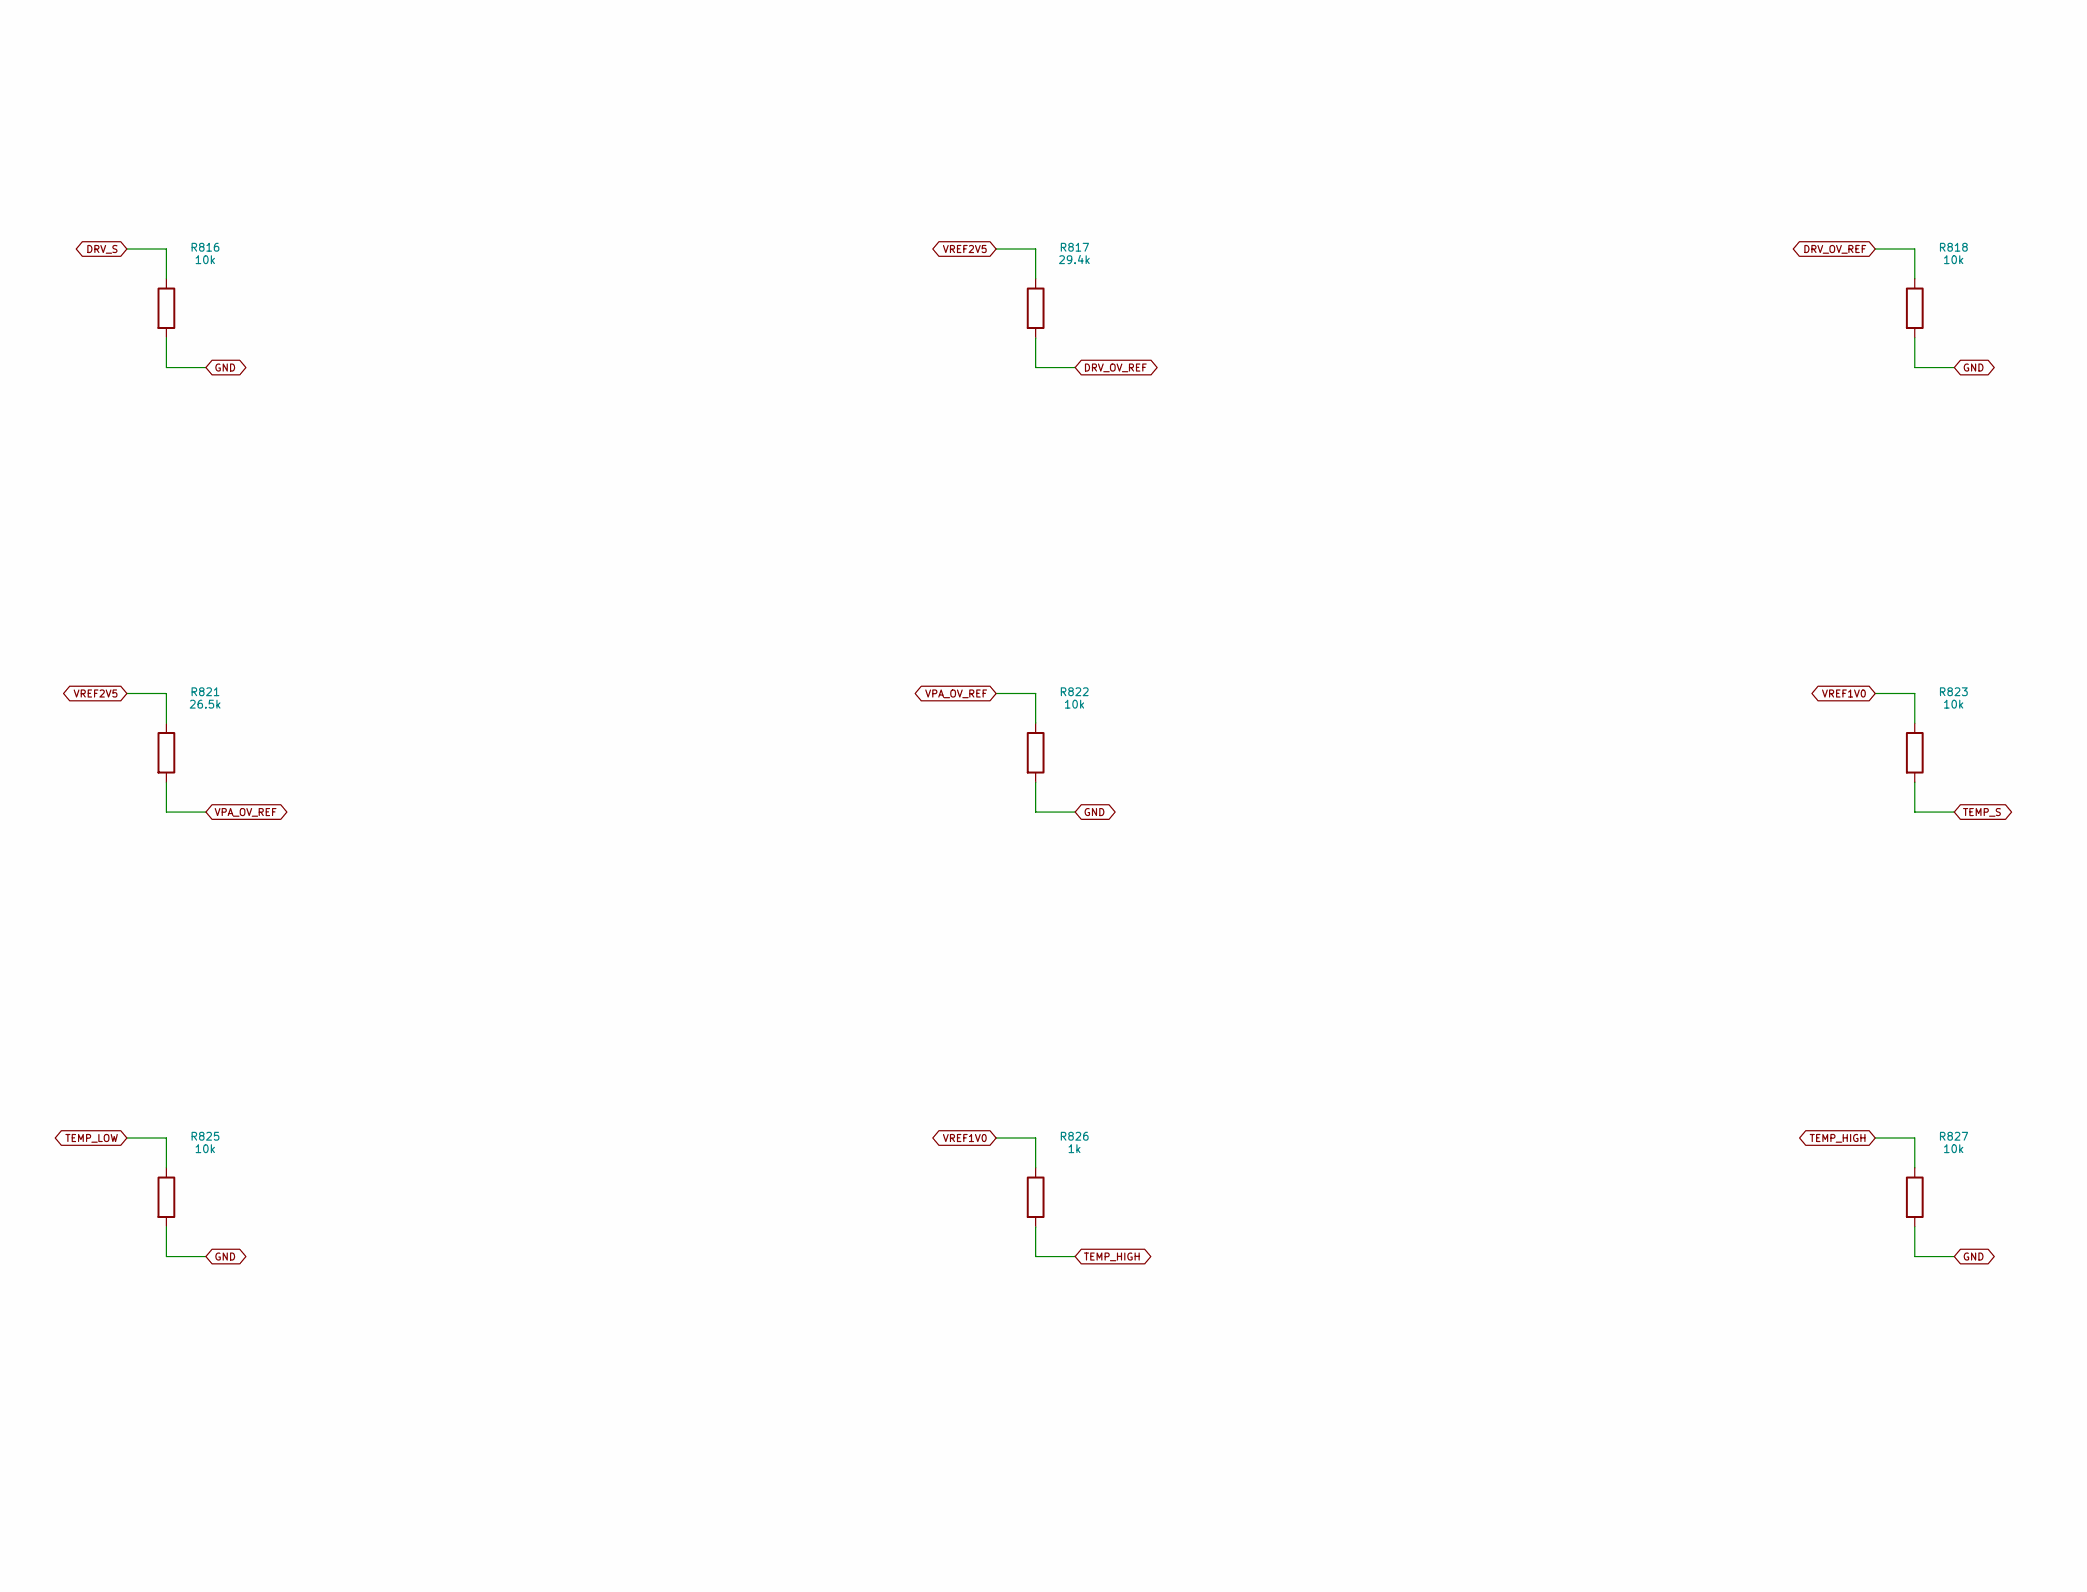
[picture p303: schematic 08_protection.kicad_sch, 08 Local voltage, current and thermal trip, part in row 2, column 2]

Parts:
R801: 150; R_0603_1608Metric_E3; MPN RC0603FR-07150RL
R802: 620; R_0603_1608Metric_E3; MPN RC0603FR-07620RL
R803: 470; R_0603_1608Metric_E3; MPN RC0603FR-07470RL
R804, R806, R808, R810, R812, R814, R820, R822, R823, R825, R827: 10k; R_0603_1608Metric_E3; MPN RC0603FR-0710KL
R805: 160k; R_0603_1608Metric_E3; MPN RC0603FR-07160KL
R807: 58.3k; R_0603_1608Metric_E3; MPN RC0603FR-0758K3L
R809: 39.2k; R_0603_1608Metric_E3; MPN RC0603FR-0739K2L
R811: 120k; R_0603_1608Metric_E3; MPN RC0603FR-07120KL
R813: 20.9k; R_0603_1608Metric_E3; MPN RC0603FR-0720K9L
R815: 73.2k; R_0603_1608Metric_E3; MPN RT0603BRD0773K2L
R816, R818: 10k; R_0603_1608Metric_E3; MPN RT0603BRD0710KL
R817: 29.4k; R_0603_1608Metric_E3; MPN RT0603BRD0729K4L
R819: 110k; R_0603_1608Metric_E3; MPN RC0603FR-07110KL
R821: 26.5k; R_0603_1608Metric_E3; MPN RC0603FR-0726K5L
R824: 49.9k; R_0603_1608Metric_E3; MPN RC0603FR-0749K9L
R826: 1k; R_0603_1608Metric_E3; MPN RC0603FR-071KL
TH801: 10k NTC B3977; NTC_Remote_2Wire; MPN NTCLE100E3103JB0
U801: TL431BIDBZR; SOT-23_E3; MPN TL431BIDBZR
U804: INA180A1IDBVR; SOT-23-5_E3; MPN INA180A1IDBVR

Connections:
DRV_OV_REF: R817.2, R818.1; also elsewhere on the board
DRV_S: R815.2, R816.1; also elsewhere on the board
GND: R803.2, R806.2, R808.2, R810.2, R812.2, R814.2, R816.2, R818.2, R820.2, R822.2, R825.2, R827.2, TH801.2, U801.3 (A), U804.2 (GND); also elsewhere on the board
ISENSE: U804.1; also elsewhere on the board
OV_REF: R809.2, R810.1; also elsewhere on the board
POWER_FAULT_N: R804.1; also elsewhere on the board
REG_OV_REF: R813.2, R814.1; also elsewhere on the board
TEMP_HIGH: R826.2, R827.1; also elsewhere on the board
TEMP_LOW: R824.2, R825.1; also elsewhere on the board
TEMP_S: R823.2, TH801.1; also elsewhere on the board
UV_REF: R807.2, R808.1; also elsewhere on the board
V3V3: R801.1, R804.2, U804.5 (V+); also elsewhere on the board
VBAT_S: R805.2, R806.1; also elsewhere on the board
VDRV_FILTER: R815.1; also elsewhere on the board
VIN_PROT: R805.1; also elsewhere on the board
VMOD: U804.4 (-); also elsewhere on the board
VPA: R819.1; also elsewhere on the board
VPA_OV_REF: R821.2, R822.1; also elsewhere on the board
VPA_S: R819.2, R820.1; also elsewhere on the board
VREF1V0: R802.2, R803.1, R823.1, R824.1, R826.1; also elsewhere on the board
VREF2V5: R801.2, R802.1, R807.1, R809.1, R813.1, R817.1, R821.1, U801.1 (K), U801.2 (REF)
VREG_RAW: R811.1; also elsewhere on the board
VREG_S: R811.2, R812.1; also elsewhere on the board
VREG_SWITCH: U804.3 (+); also elsewhere on the board

Notes on the sheet:
08 Local voltage, current and thermal trip
M5B-E6R2 / integrated evaluation PCB / NOT RELEASED / hardware tests NOT_RUN
M5B-E6R2: REVIEW / ALL hardware measurements NOT RUN / no ordering or manufacture.
