DD1SB/ARDF-TX/hardware/2m/RF2M.kicad_pcb

## KiCad design hardware/2m/RF2M.kicad_pcb (continued)

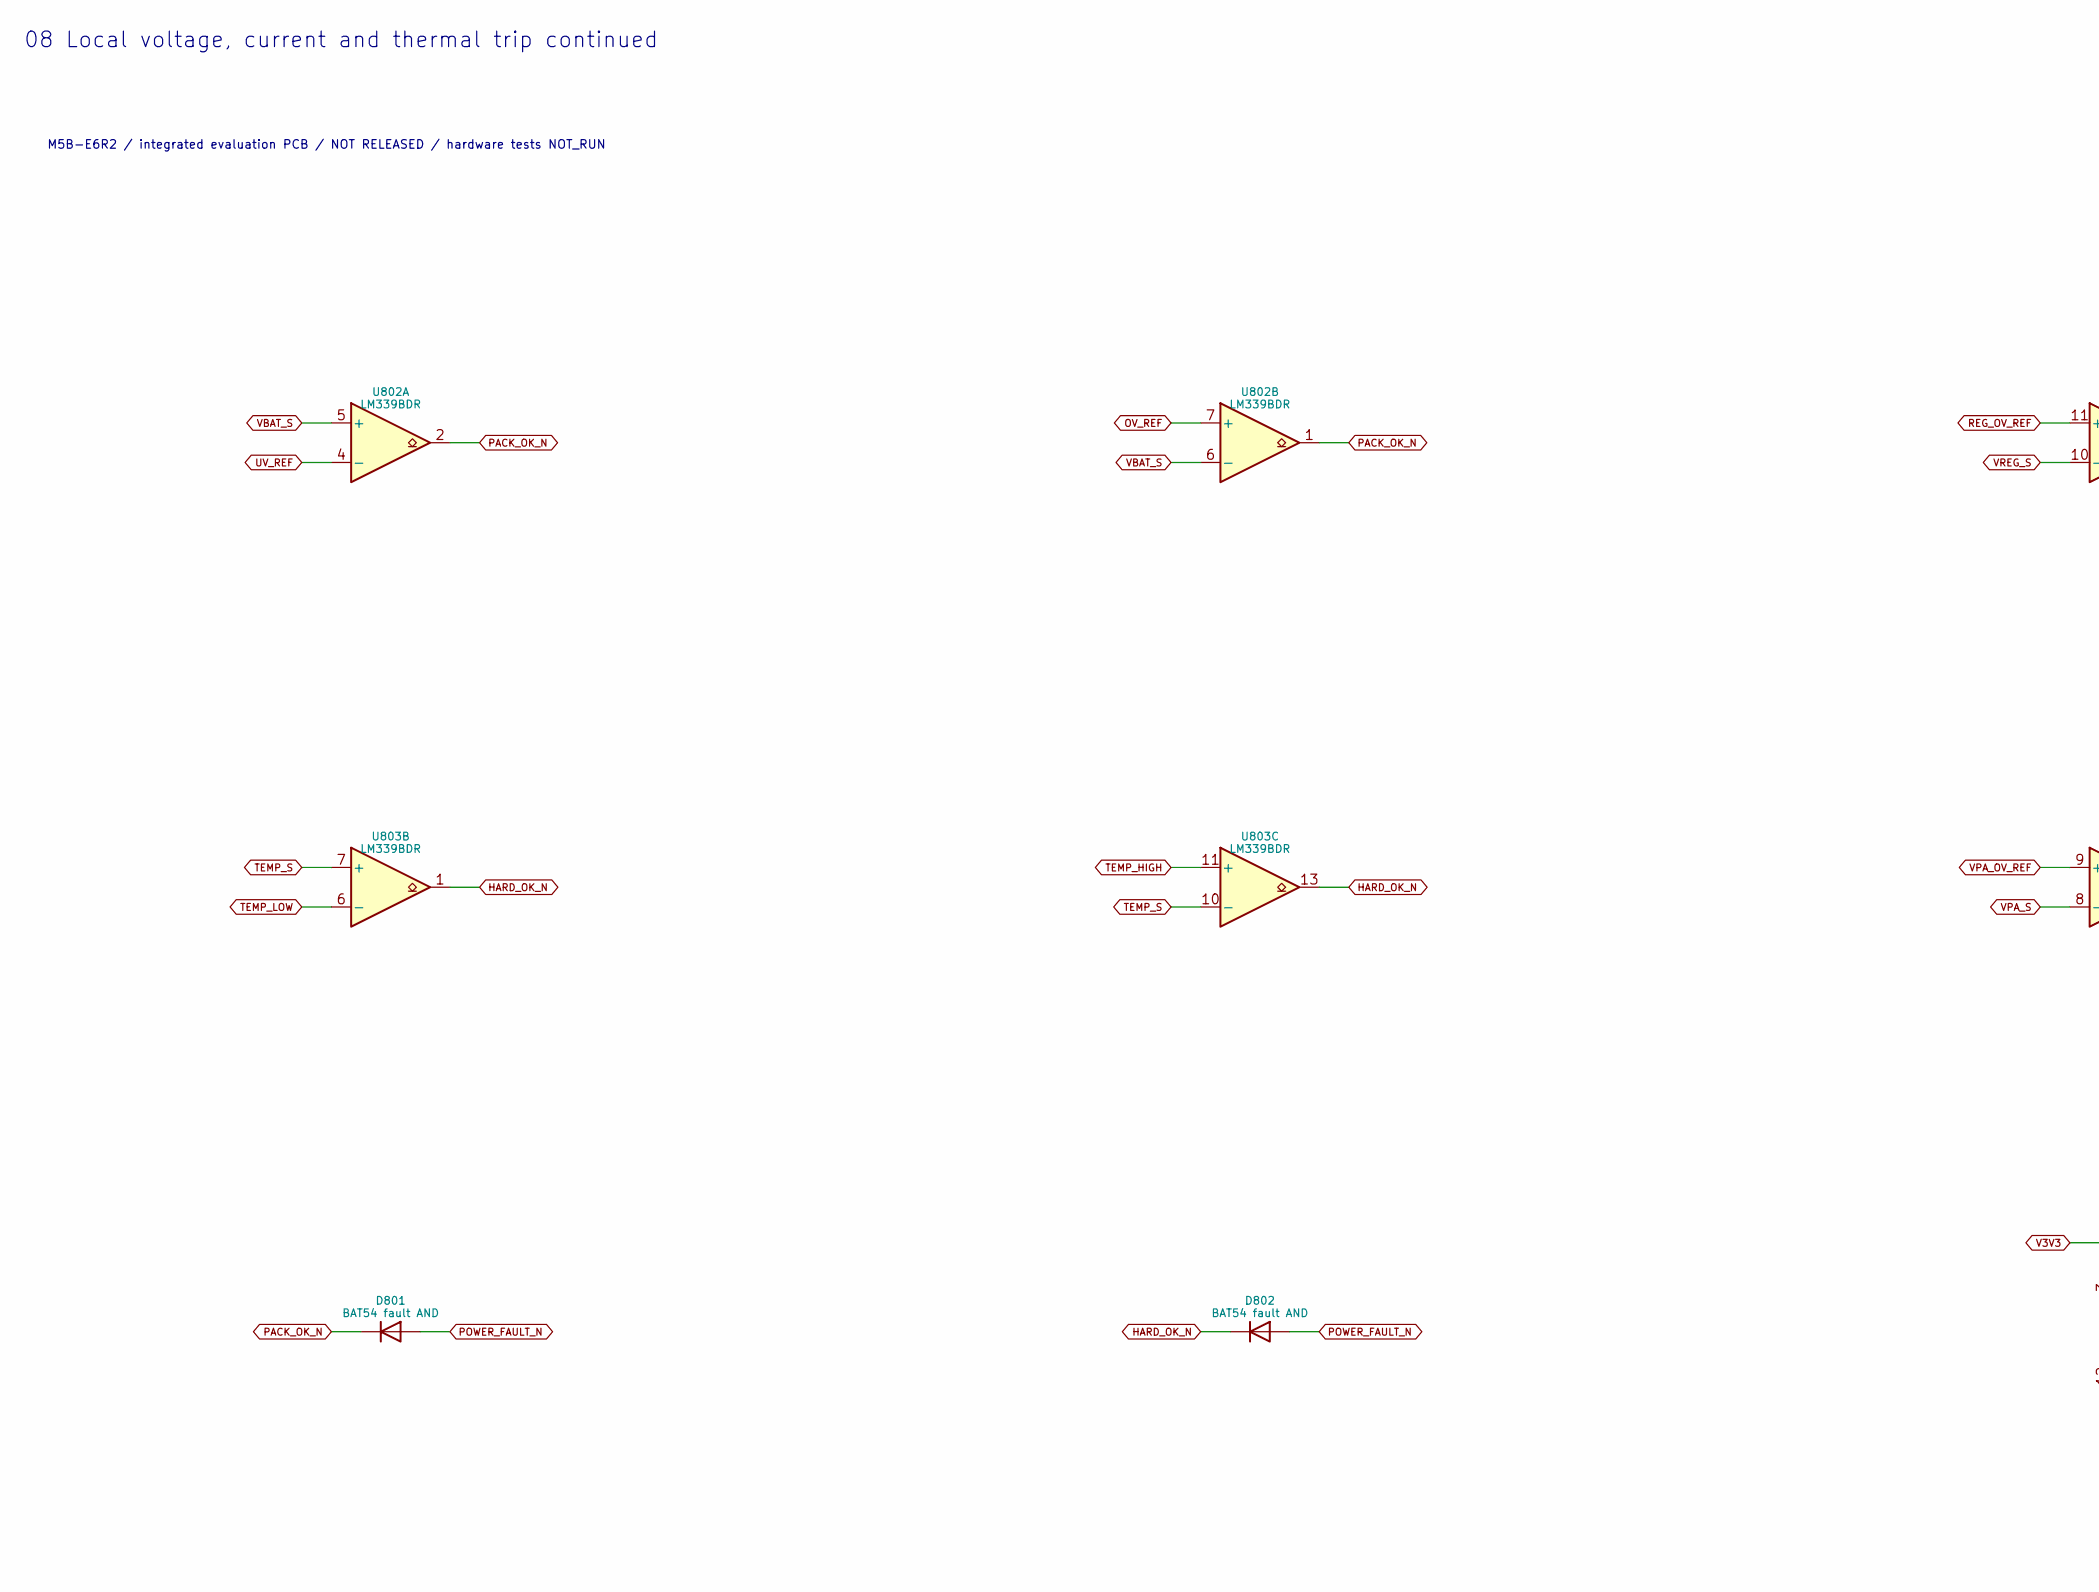
[picture p304: schematic 08_protectionb1.kicad_sch, 08 Local voltage, current and thermal trip continued, part in row 1, column 1]

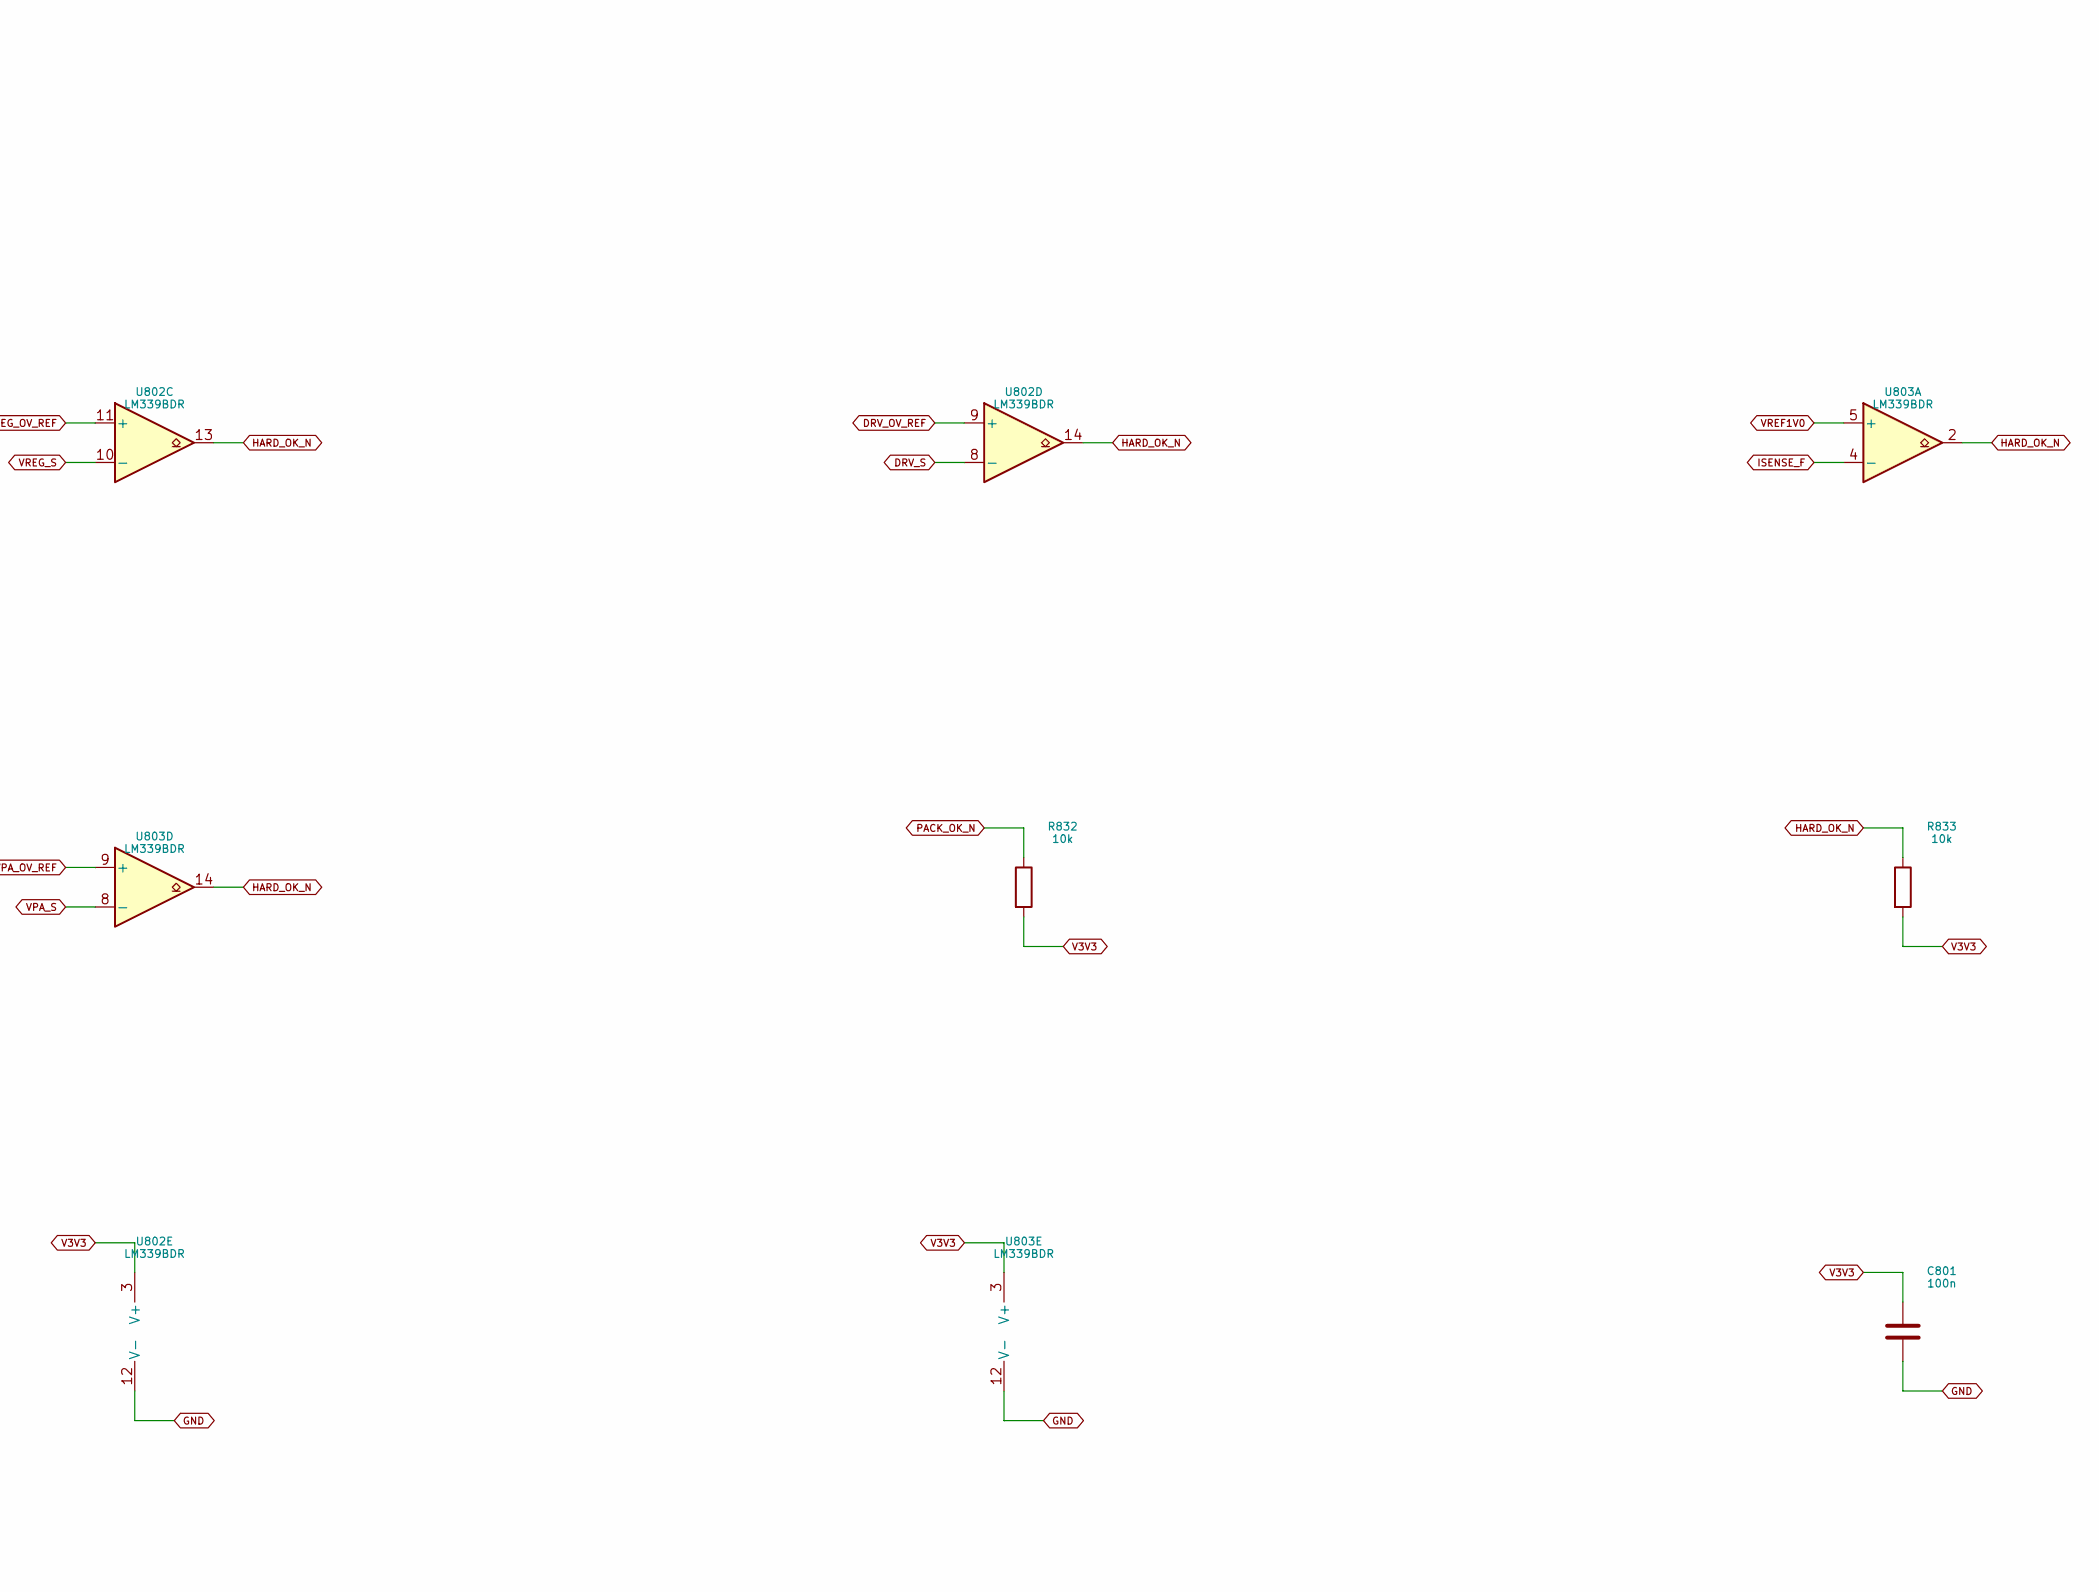
[picture p305: schematic 08_protectionb1.kicad_sch, 08 Local voltage, current and thermal trip continued, part in row 1, column 2]

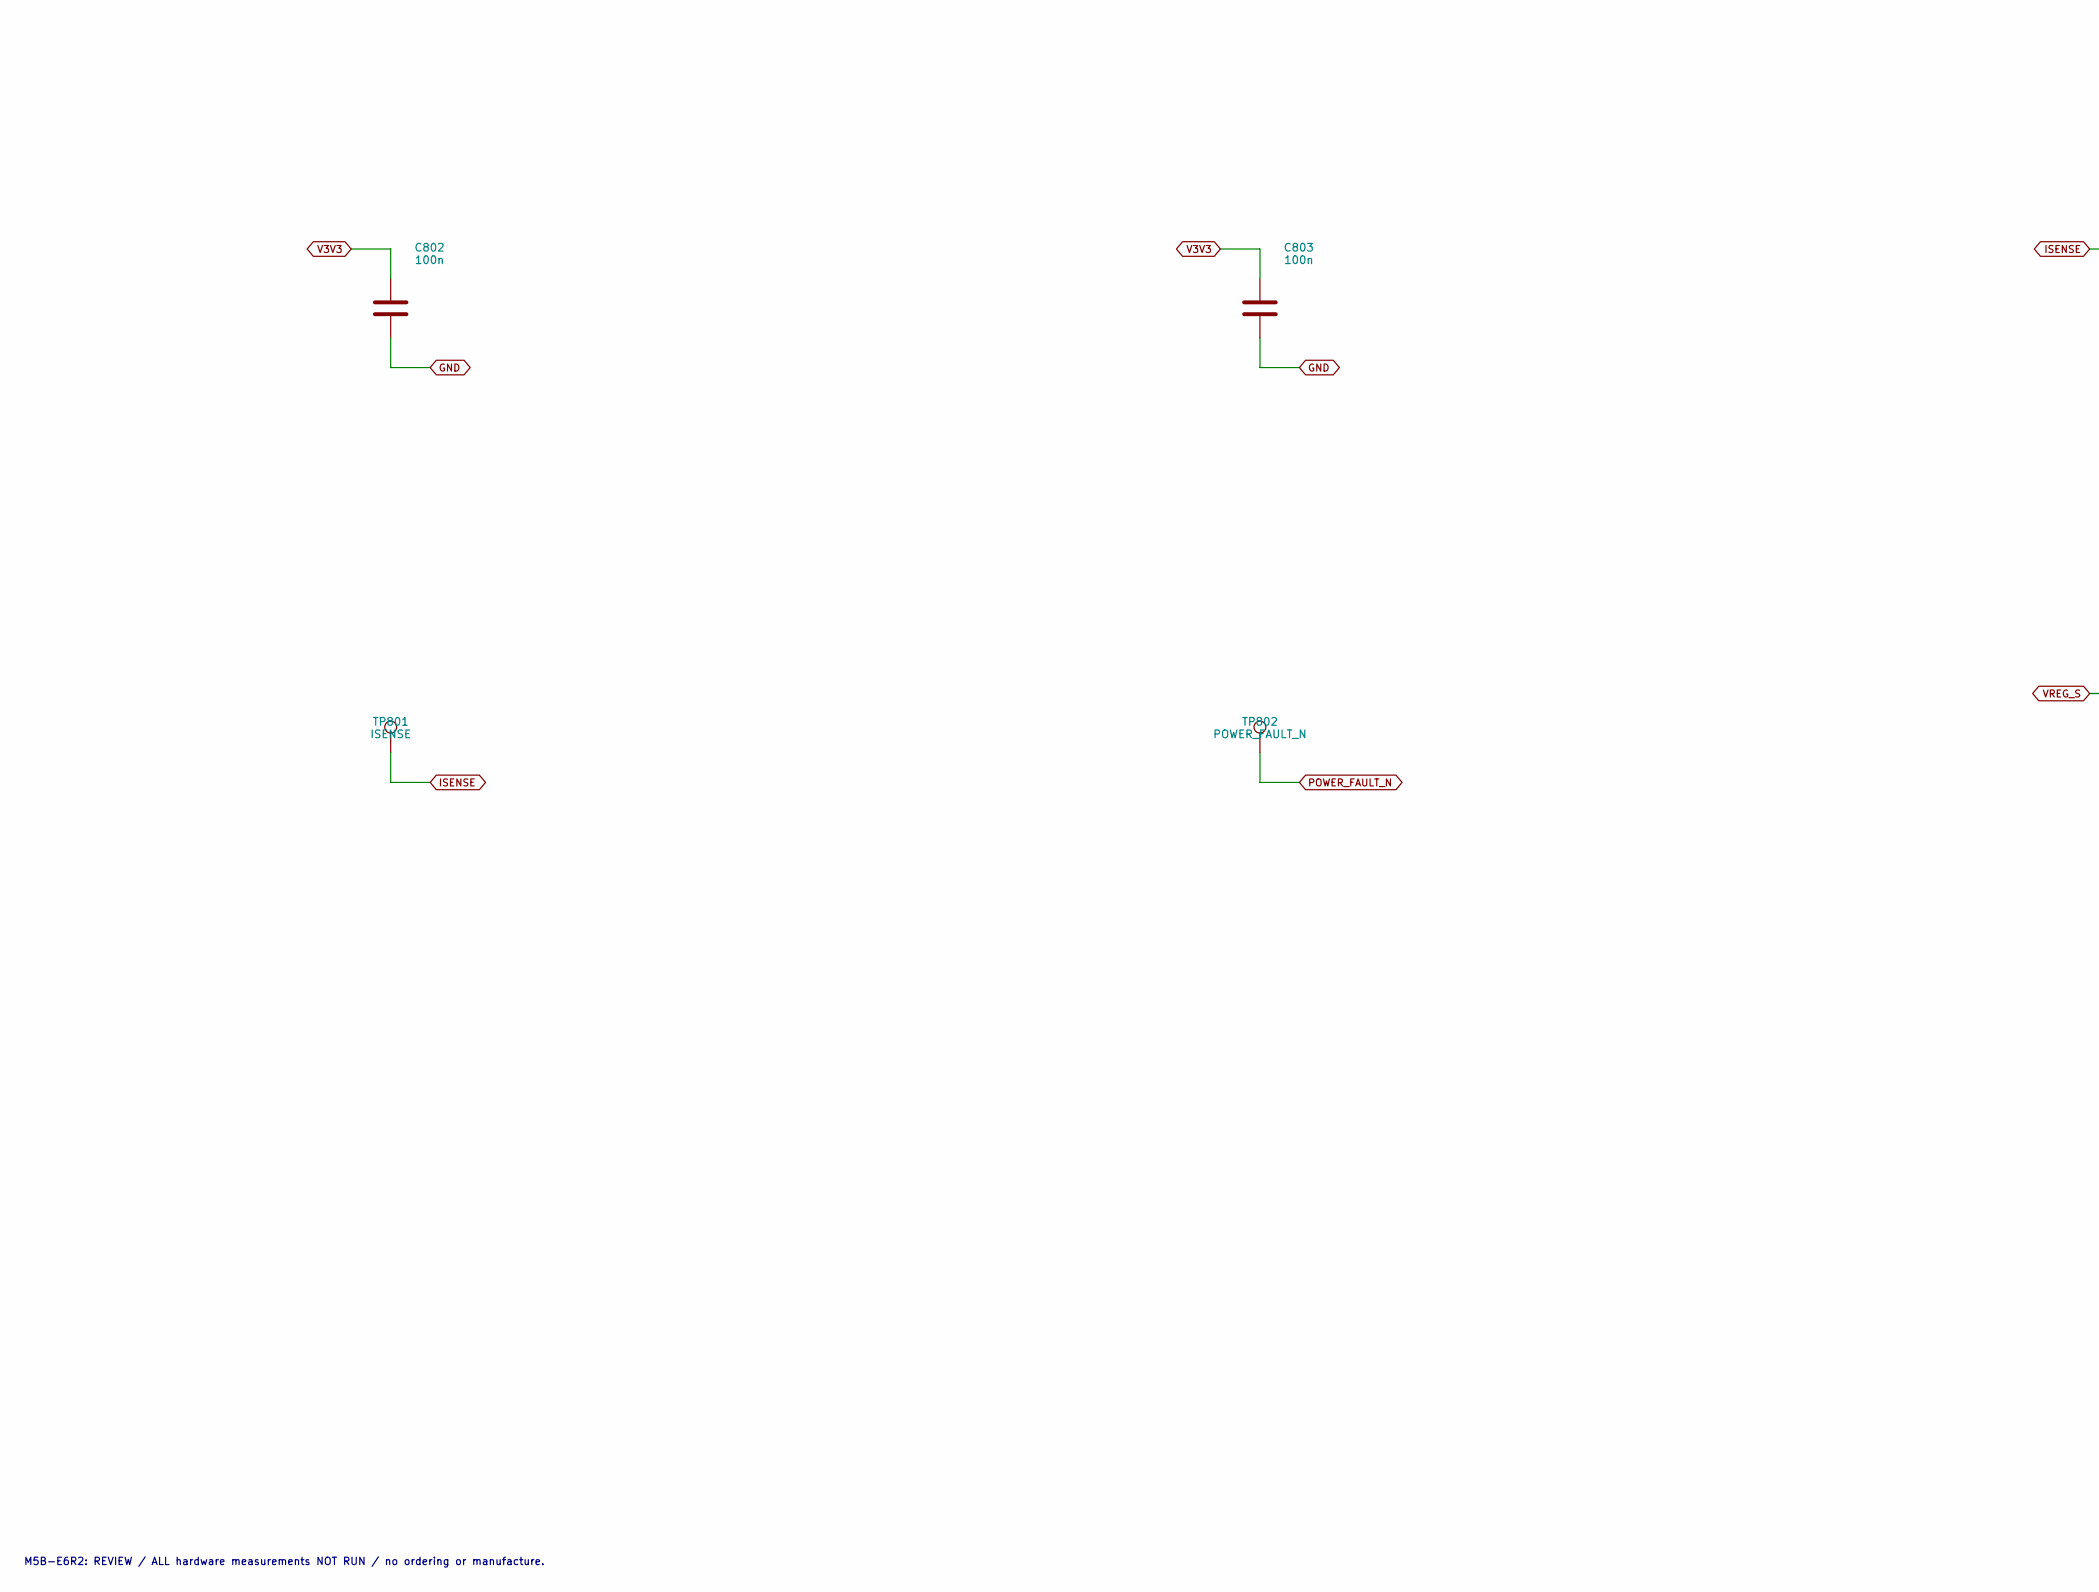
[picture p306: schematic 08_protectionb1.kicad_sch, 08 Local voltage, current and thermal trip continued, part in row 2, column 1]

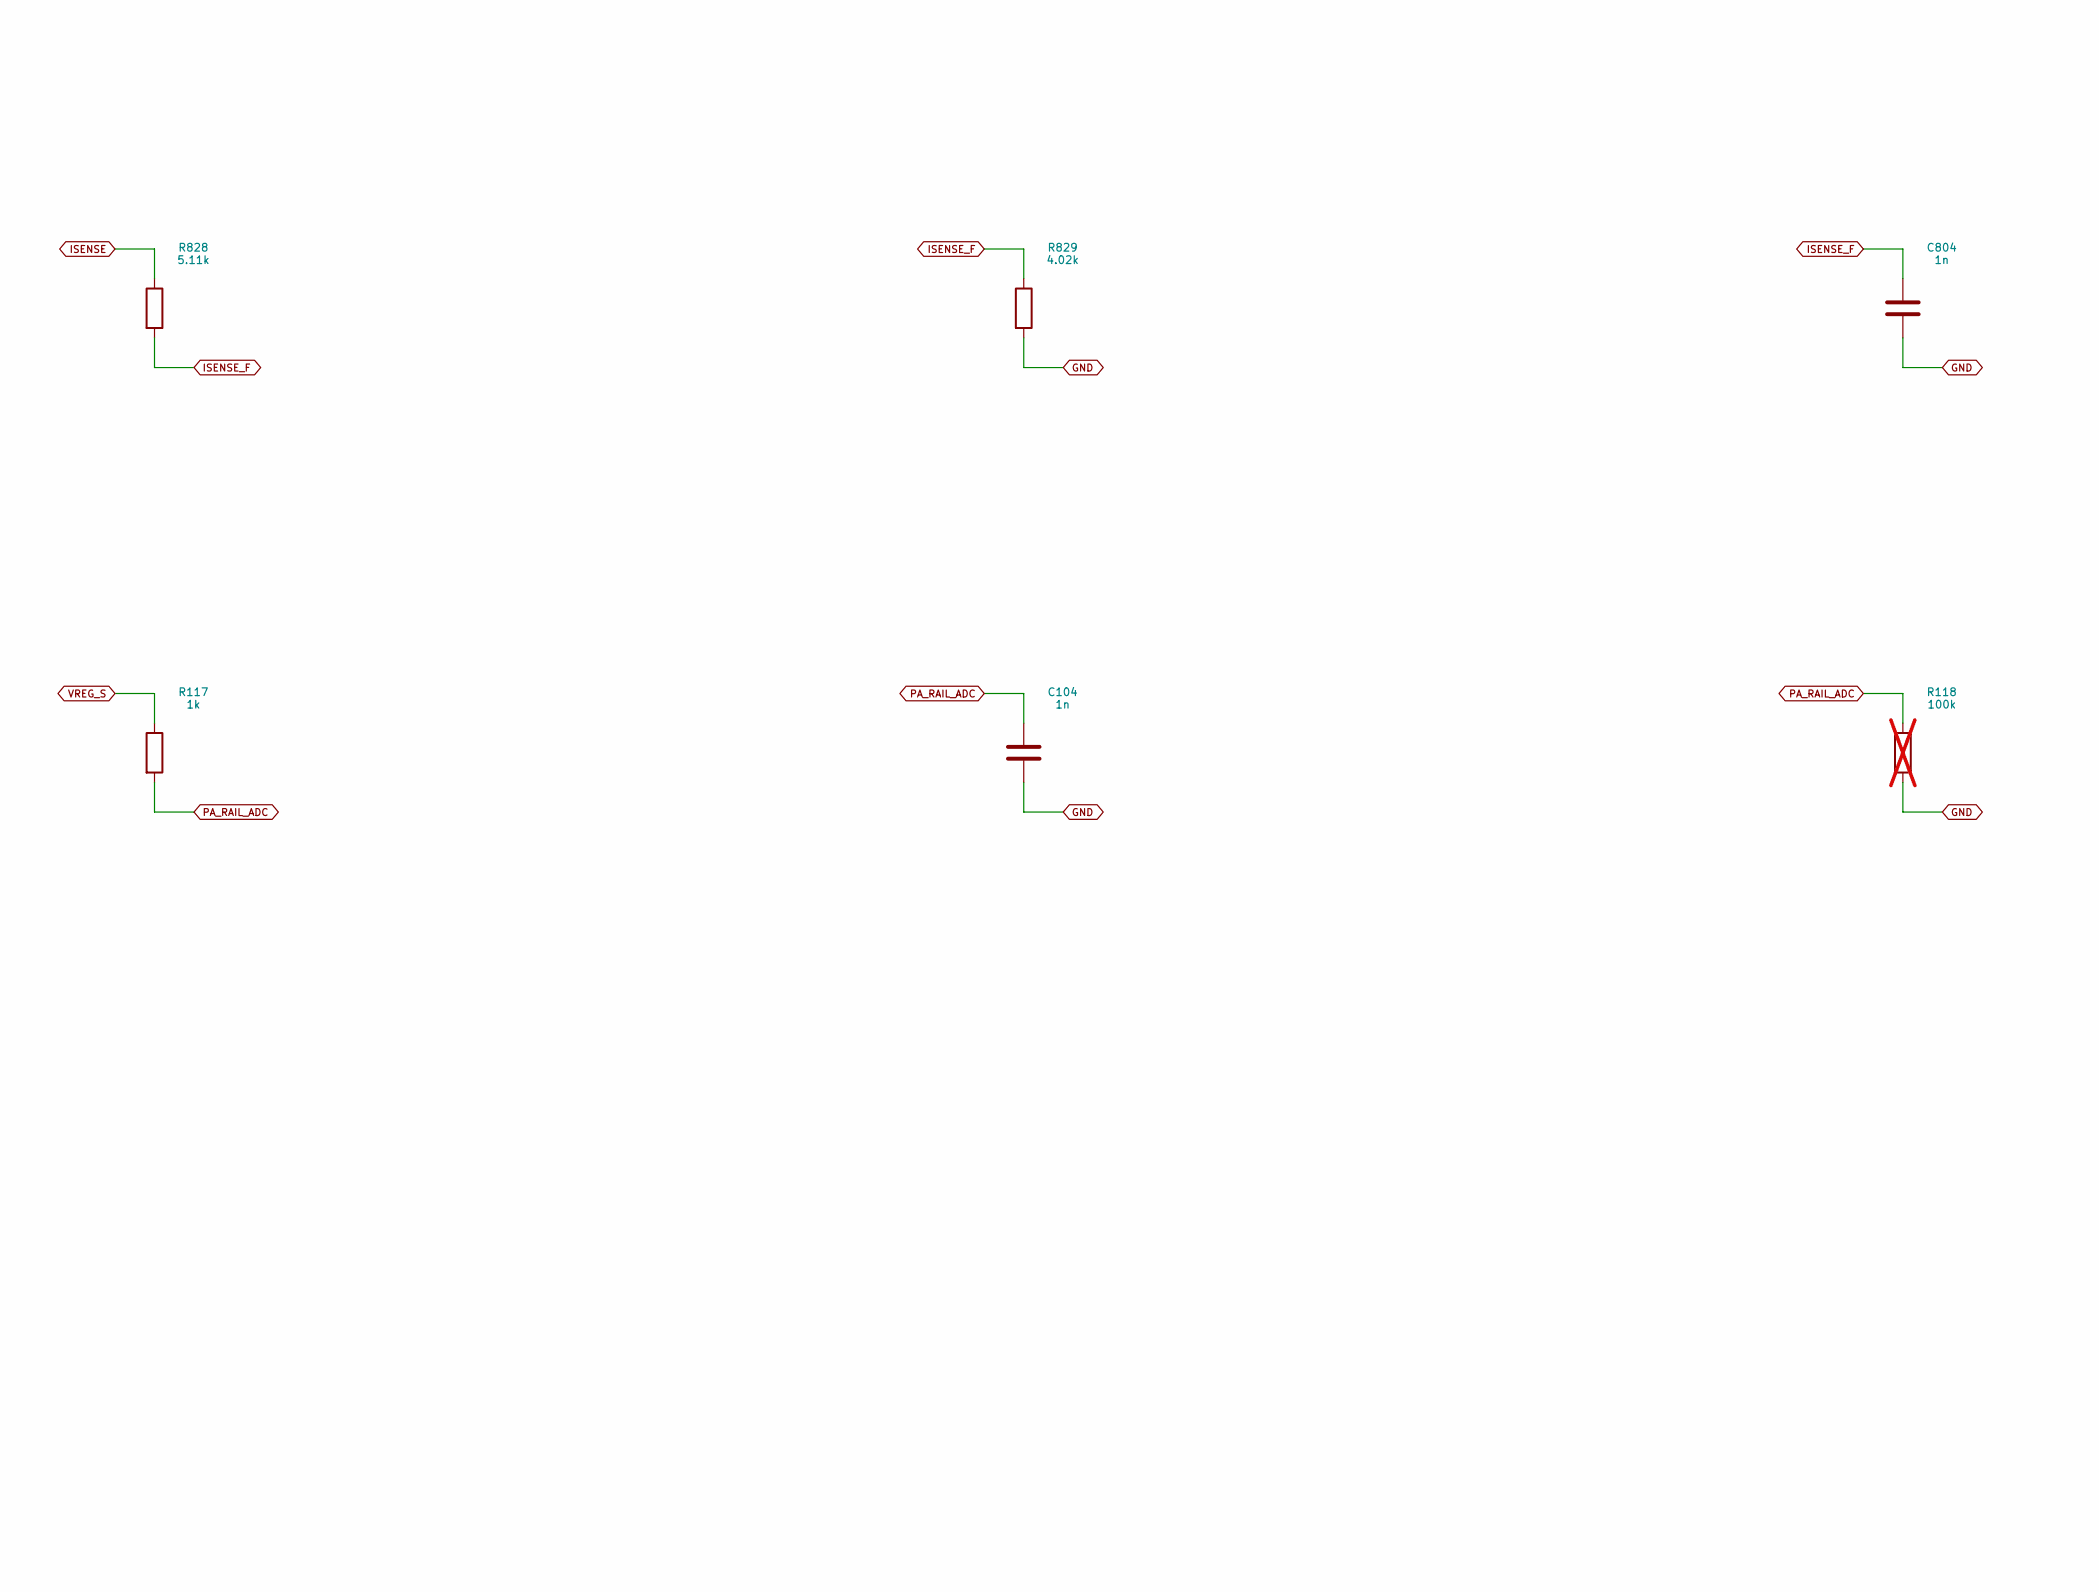
[picture p307: schematic 08_protectionb1.kicad_sch, 08 Local voltage, current and thermal trip continued, part in row 2, column 2]

Parts:
C104, C804: 1n; C_0603_1608Metric_E3; MPN CC0603JRNPO9BN102
C801, C802, C803: 100n; C_0603_1608Metric_E3; MPN CC0603KRX7R8BB104
D801, D802: BAT54 fault AND; D_SOD-323_E3; MPN BAT54WS-7-F
R117: 1k; R_0603_1608Metric_E3; MPN RC0603FR-071KL
R118: 100k; R_0603_1608Metric_E3; MPN RC0603FR-07100KL; not fitted
R828: 5.11k; R_0603_1608Metric_E3; MPN RT0603BRD075K11L
R829: 4.02k; R_0603_1608Metric_E3; MPN RC0603FR-074K02L
R832, R833: 10k; R_0603_1608Metric_E3; MPN RC0603FR-0710KL
TP801: ISENSE; TestPoint_Pad_D1.0mm_E3; MPN PCB feature
TP802: POWER_FAULT_N; TestPoint_Pad_D1.0mm_E3; MPN PCB feature
U802, U803: LM339BDR; SOIC-14_3.9x8.7mm_P1.27mm_E3; MPN LM339BDR

Connections:
DRV_OV_REF: U802.9 (+); also elsewhere on the board
DRV_S: U802.8 (-); also elsewhere on the board
GND: C104.2, C801.2, C802.2, C803.2, C804.2, R118.2, R829.2, U802.12 (V-), U803.12 (V-); also elsewhere on the board
HARD_OK_N: D802.1 (K), R833.1, U802.13, U802.14, U803.1, U803.2, U803.13, U803.14; also elsewhere on the board
ISENSE: R828.1, TP801.1; also elsewhere on the board
ISENSE_F: C804.1, R828.2, R829.1, U803.4 (-)
OV_REF: U802.7 (+); also elsewhere on the board
PACK_OK_N: D801.1 (K), R832.1, U802.1, U802.2; also elsewhere on the board
PA_RAIL_ADC: C104.1, R117.2, R118.1; also elsewhere on the board
POWER_FAULT_N: D801.2 (A), D802.2 (A), TP802.1; also elsewhere on the board
REG_OV_REF: U802.11 (+); also elsewhere on the board
TEMP_HIGH: U803.11 (+); also elsewhere on the board
TEMP_LOW: U803.6 (-); also elsewhere on the board
TEMP_S: U803.7 (+), U803.10 (-); also elsewhere on the board
UV_REF: U802.4 (-); also elsewhere on the board
V3V3: C801.1, C802.1, C803.1, R832.2, R833.2, U802.3 (V+), U803.3 (V+); also elsewhere on the board
VBAT_S: U802.5 (+), U802.6 (-); also elsewhere on the board
VPA_OV_REF: U803.9 (+); also elsewhere on the board
VPA_S: U803.8 (-); also elsewhere on the board
VREF1V0: U803.5 (+); also elsewhere on the board
VREG_S: R117.1, U802.10 (-); also elsewhere on the board

Notes on the sheet:
08 Local voltage, current and thermal trip continued
M5B-E6R2 / integrated evaluation PCB / NOT RELEASED / hardware tests NOT_RUN
M5B-E6R2: REVIEW / ALL hardware measurements NOT RUN / no ordering or manufacture.
