DD1SB/ARDF-TX/hardware/2m/RF2M.kicad_pcb

## KiCad design hardware/2m/RF2M.kicad_pcb (continued)

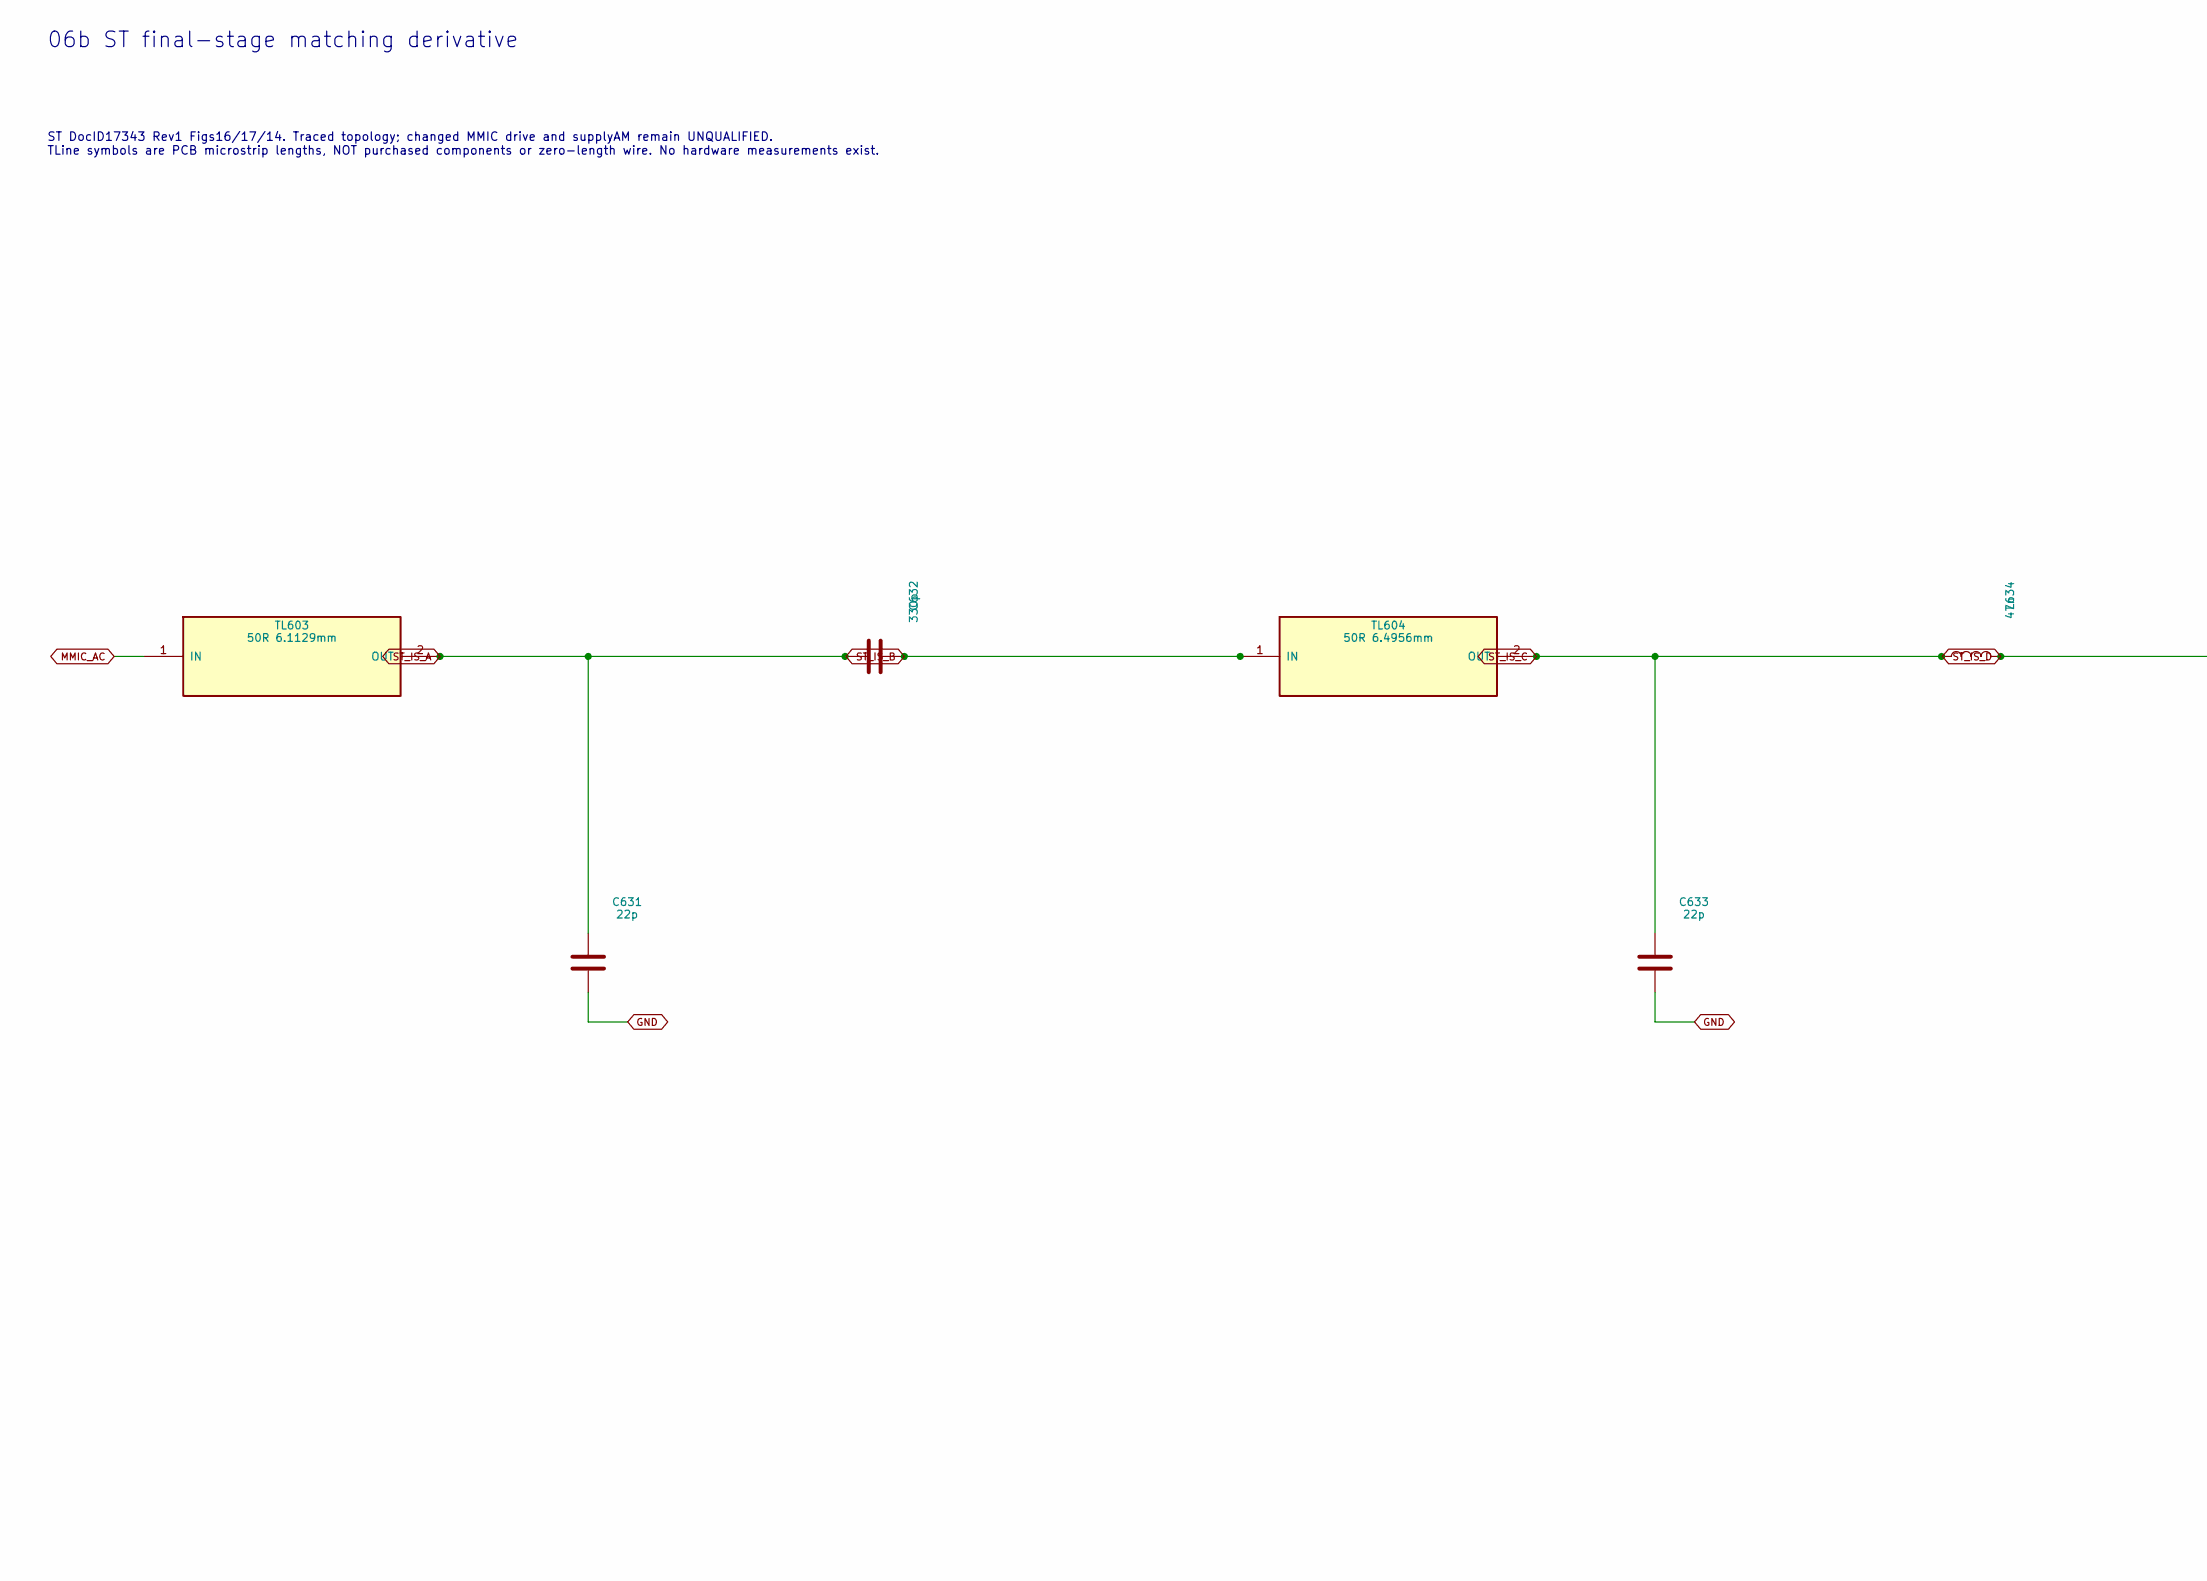
[picture p308: schematic 06b_st_matching.kicad_sch, 06b ST final-stage matching derivative, part in row 1, column 1]

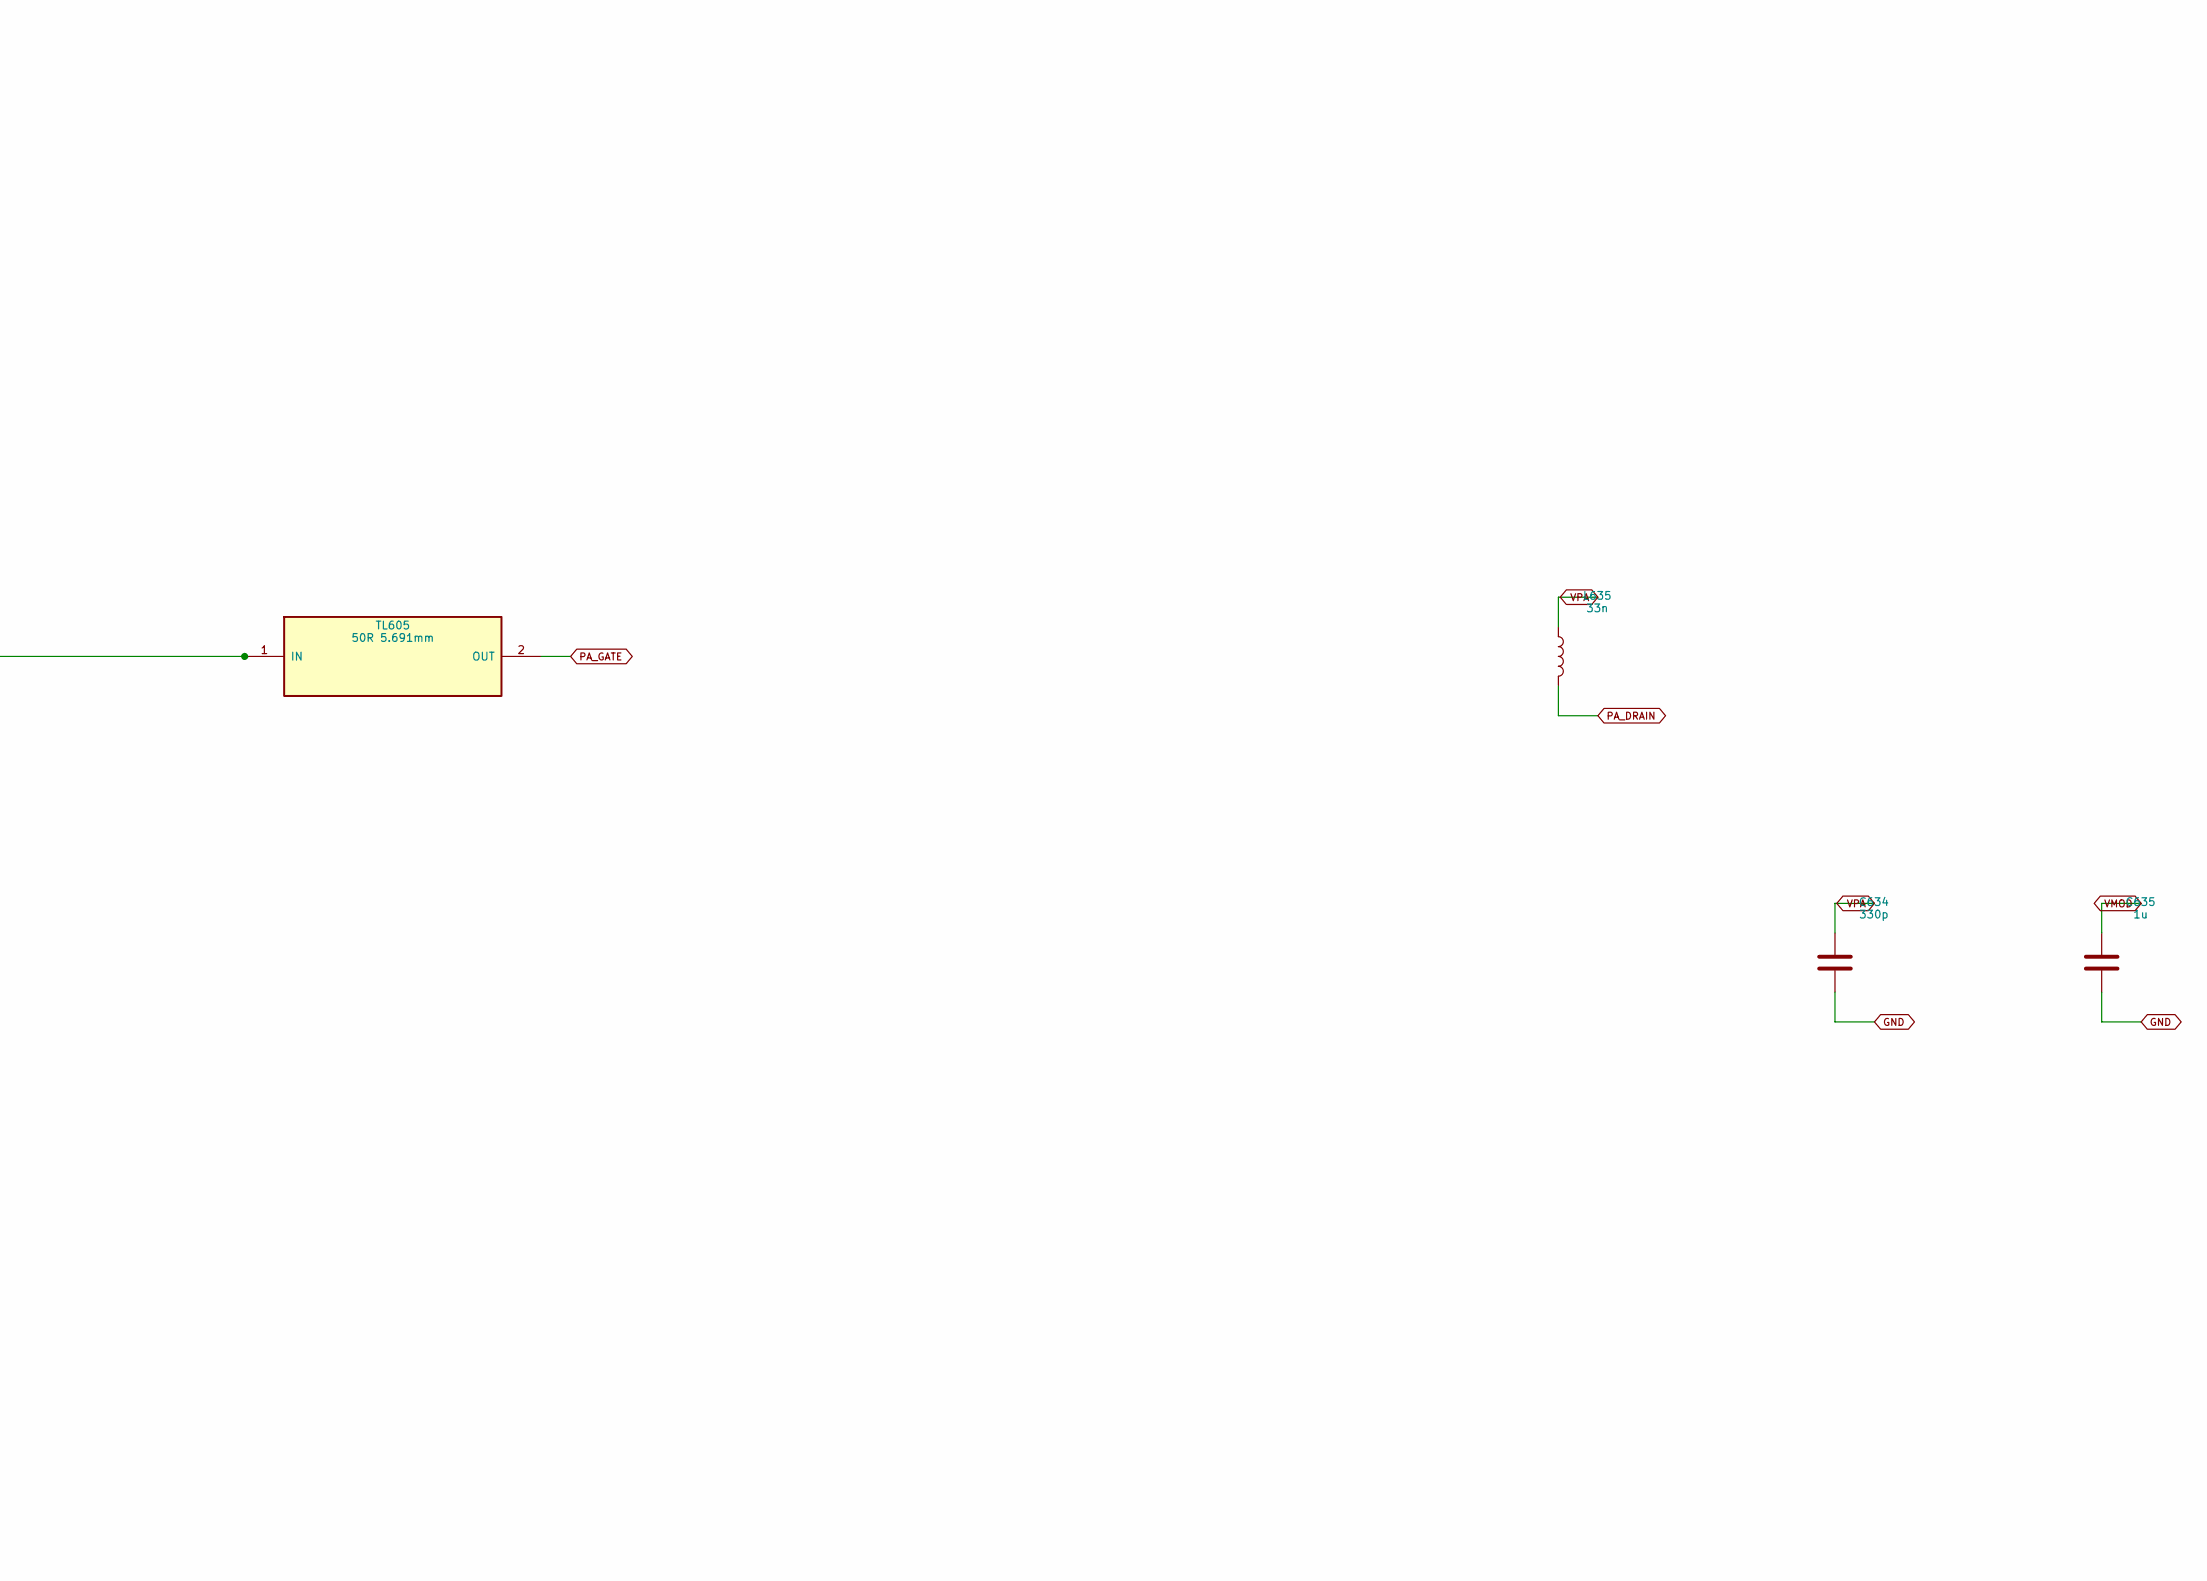
[picture p309: schematic 06b_st_matching.kicad_sch, 06b ST final-stage matching derivative, part in row 1, column 2]

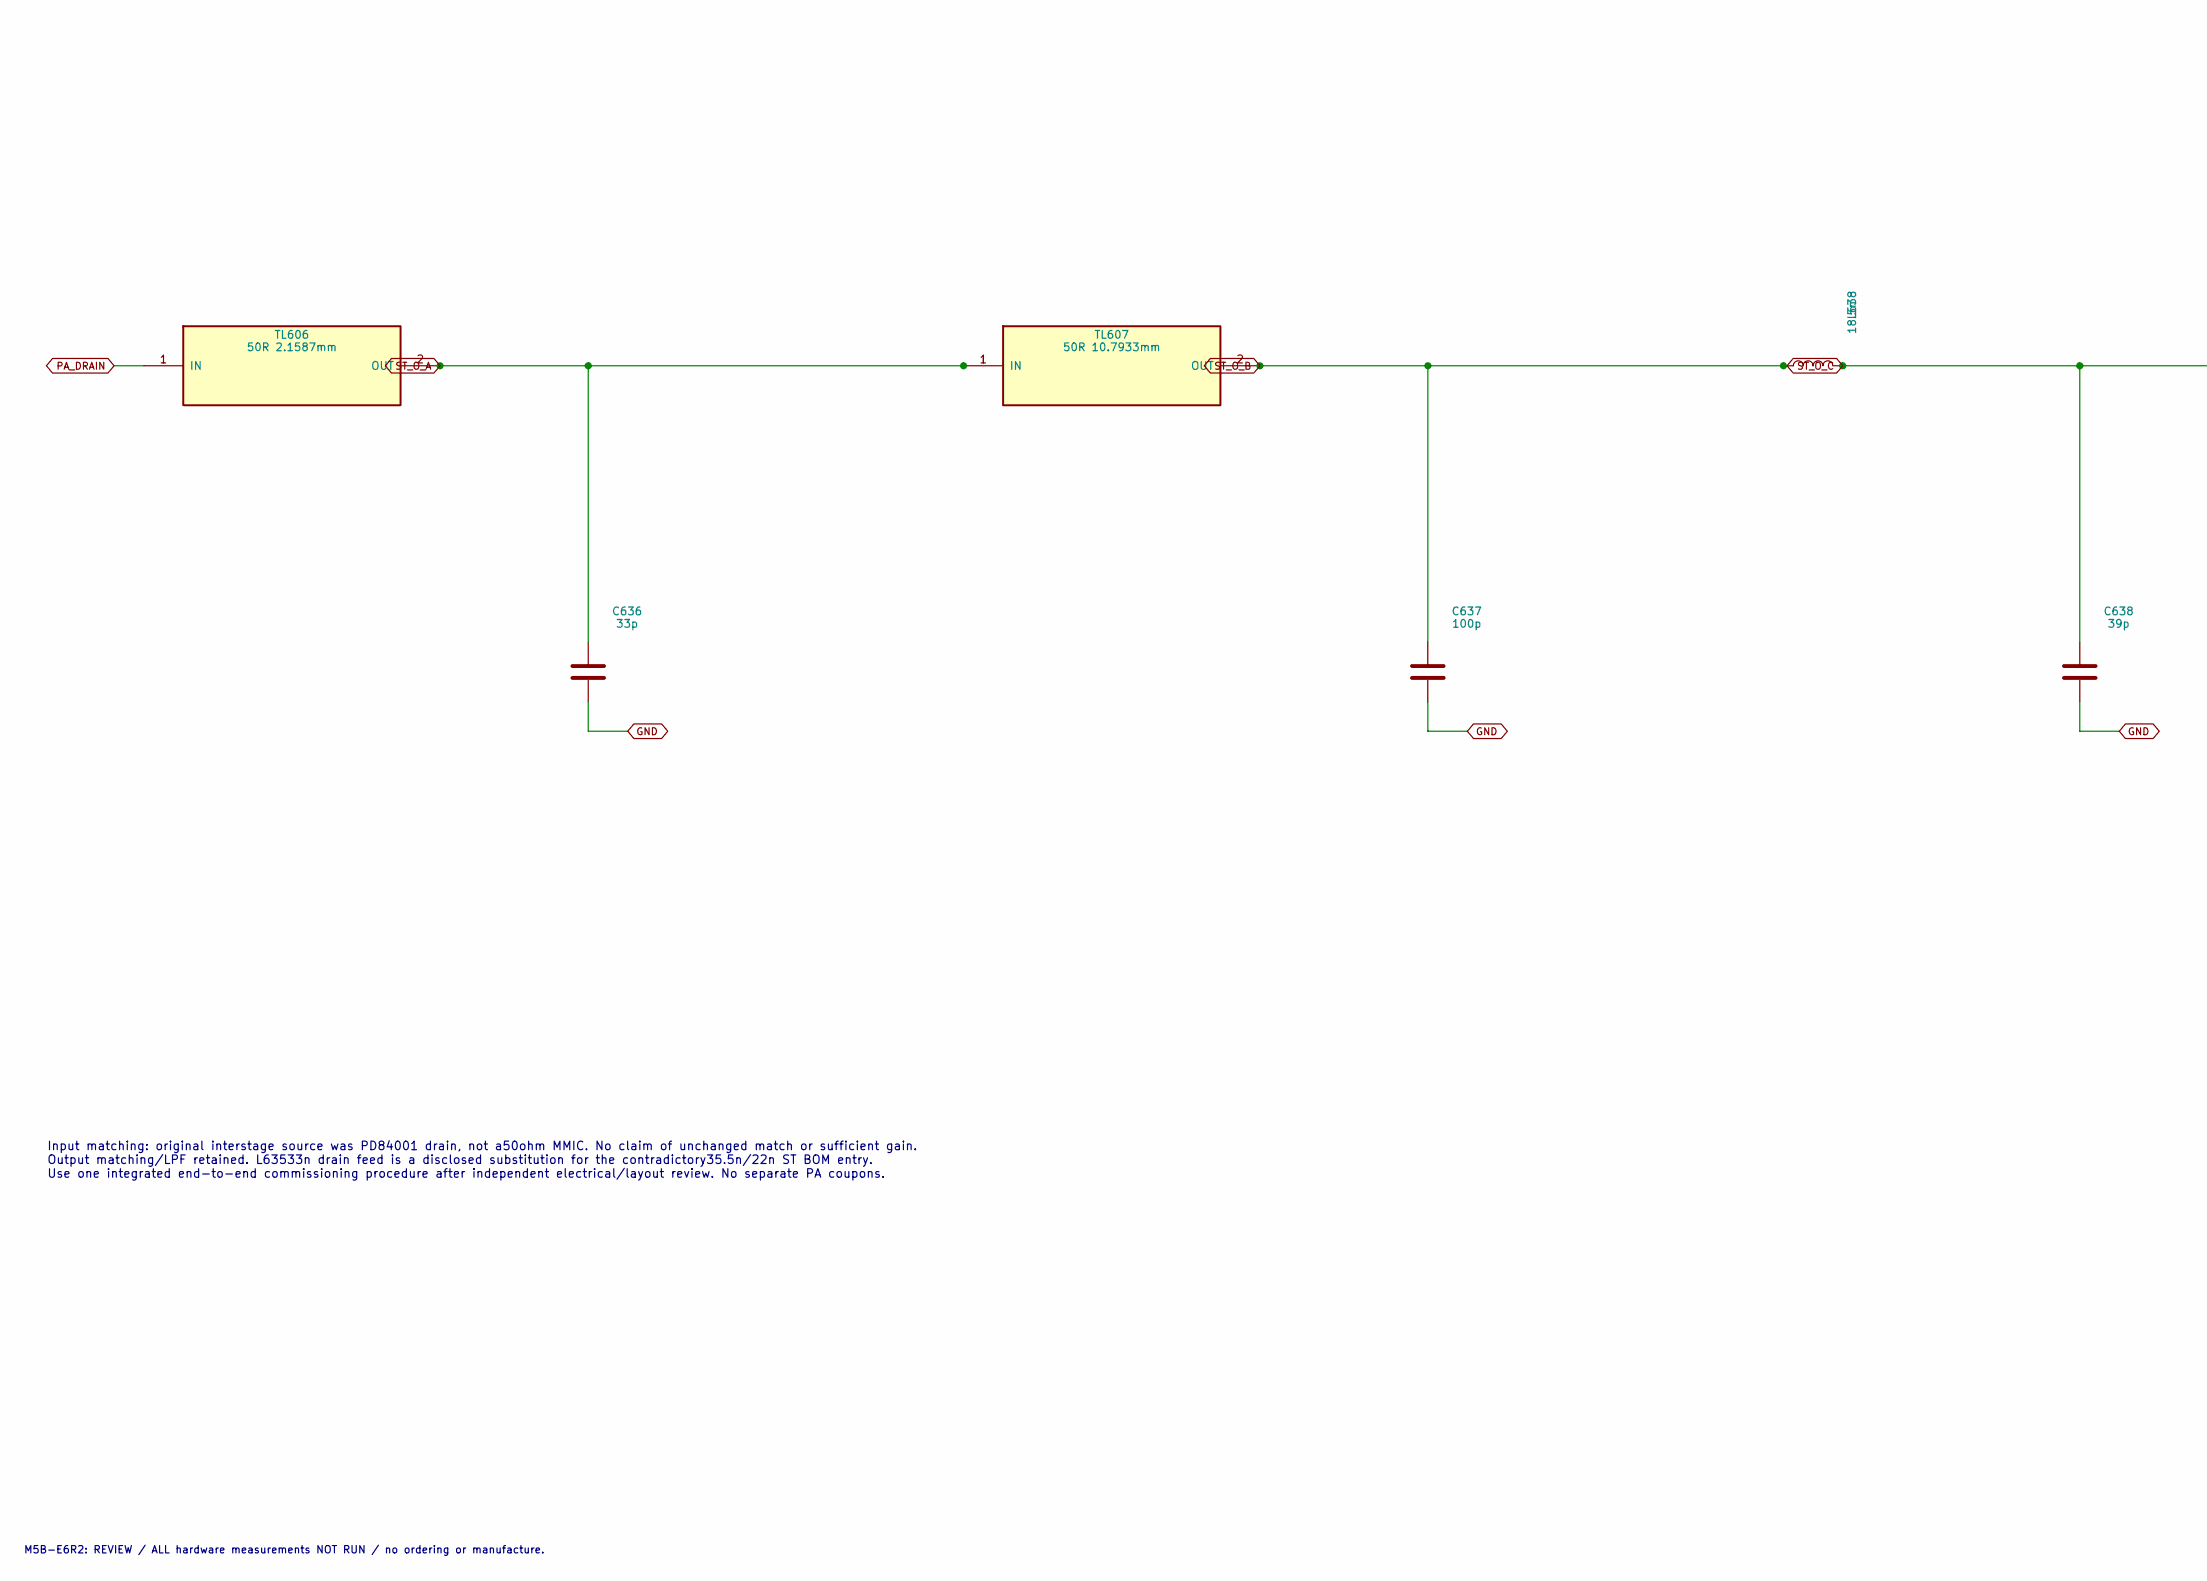
[picture p310: schematic 06b_st_matching.kicad_sch, 06b ST final-stage matching derivative, part in row 2, column 1]

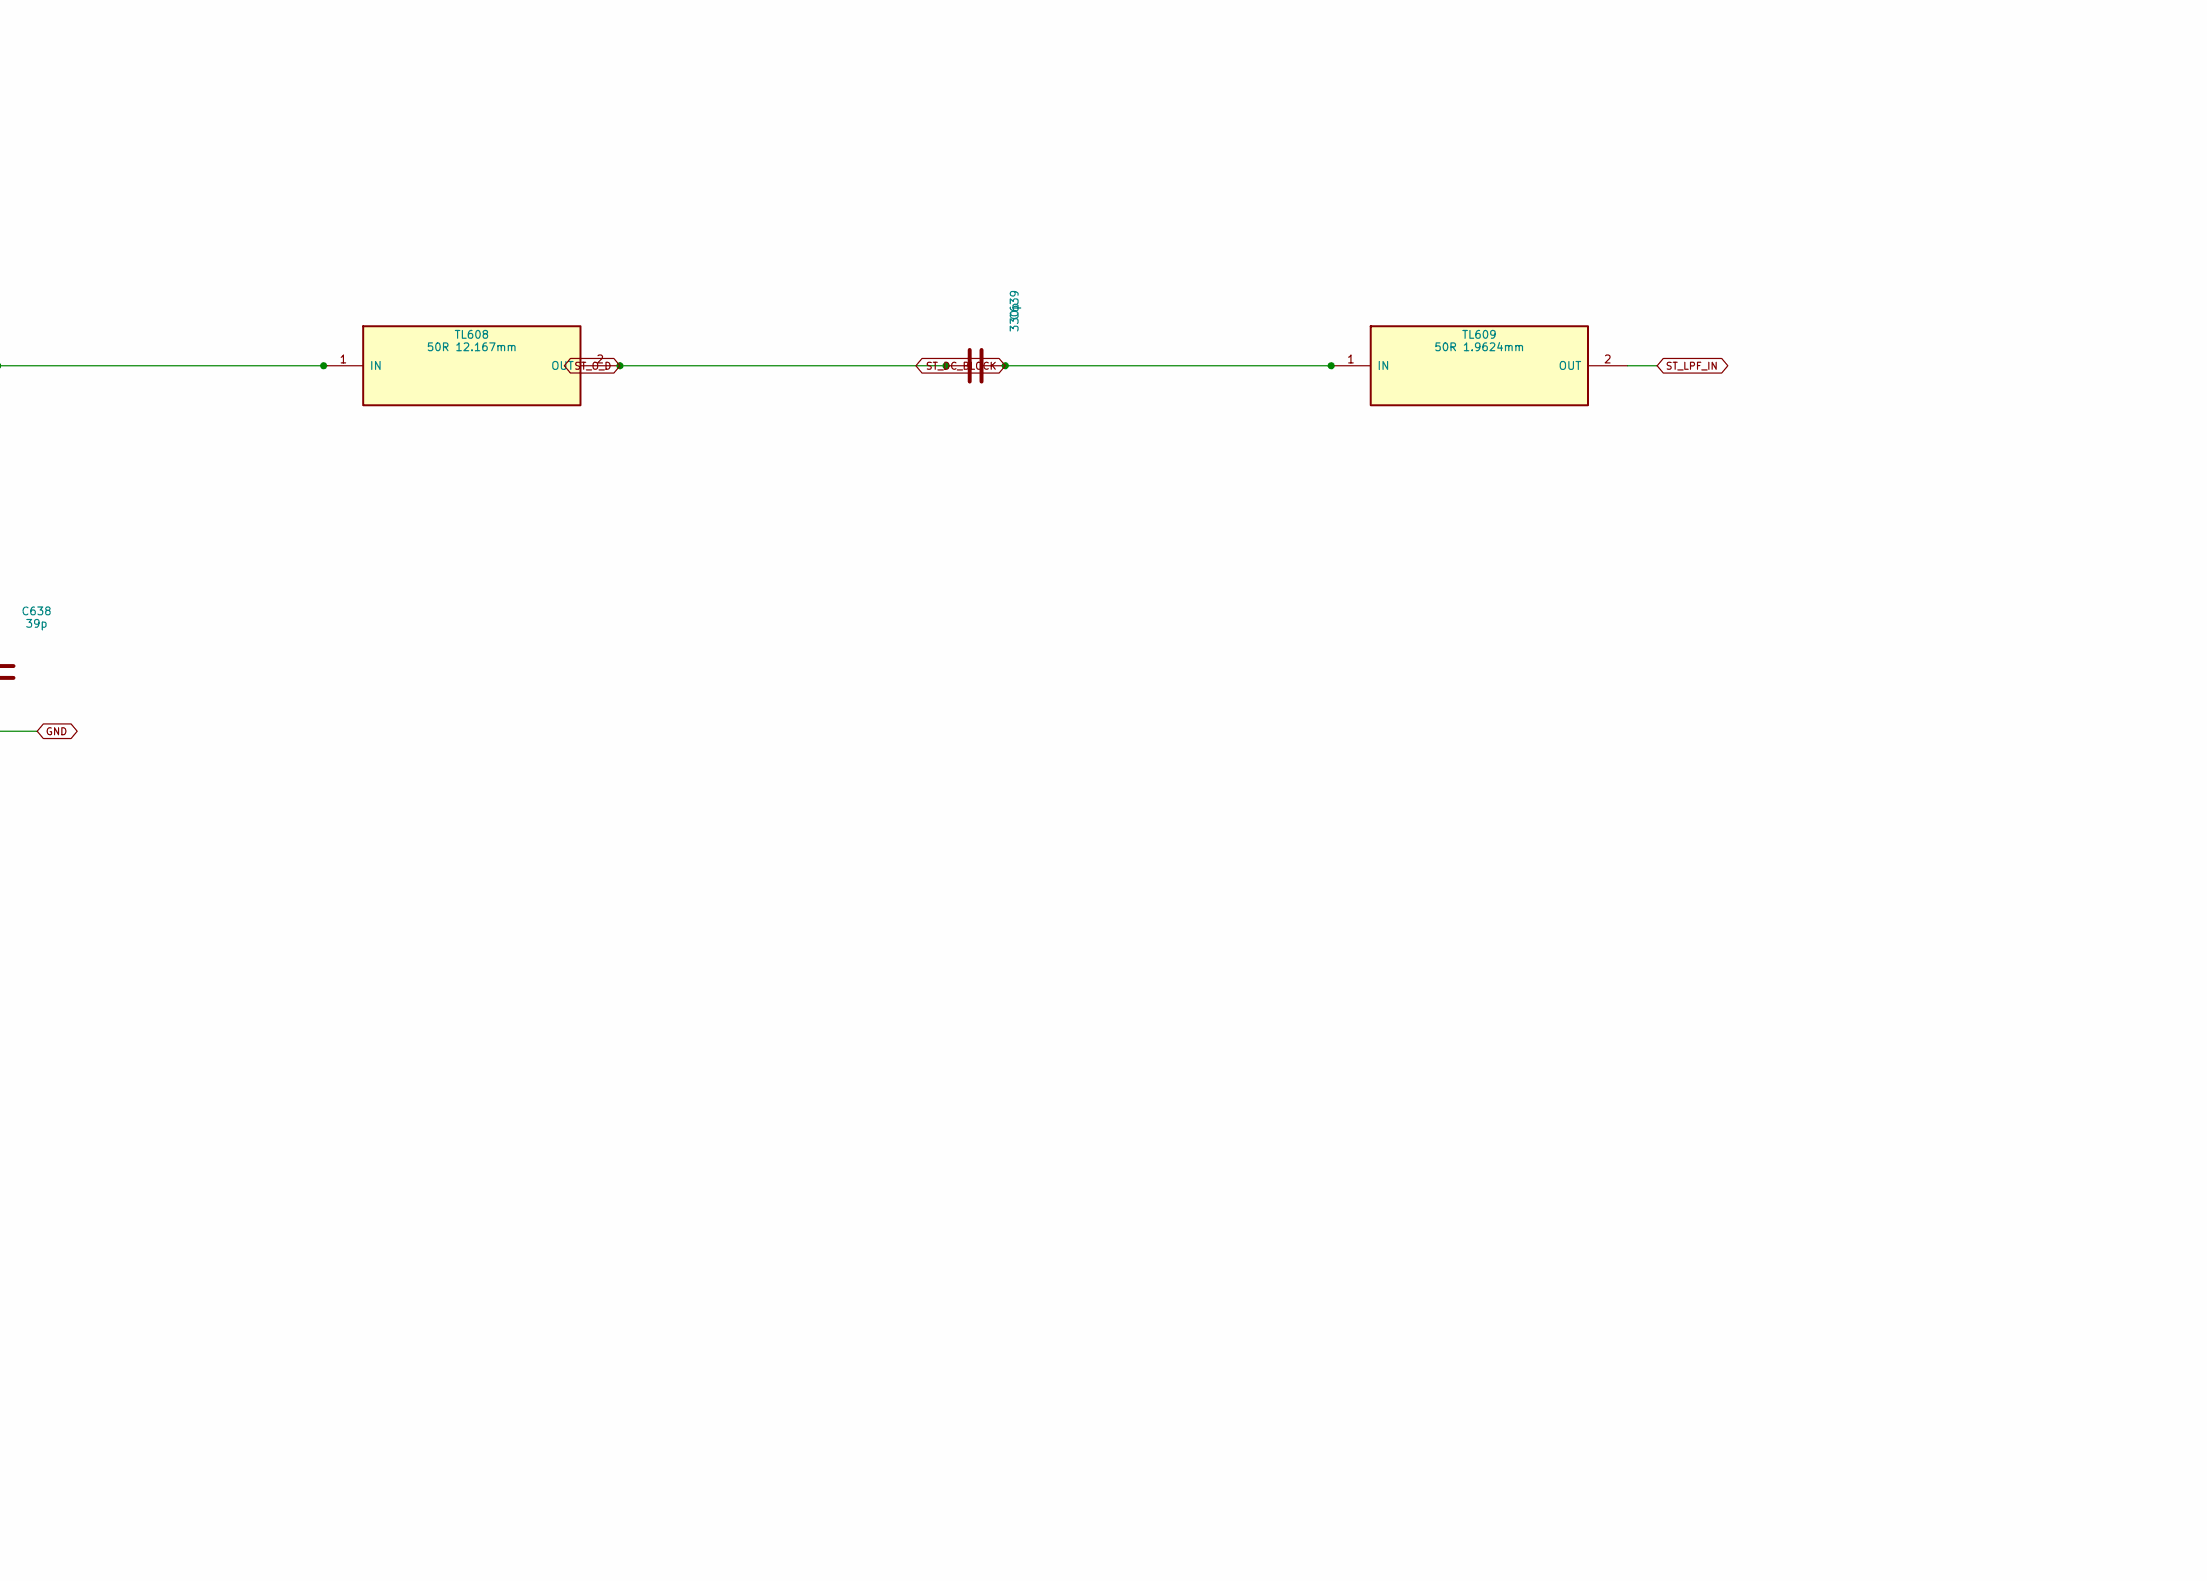
[picture p311: schematic 06b_st_matching.kicad_sch, 06b ST final-stage matching derivative, part in row 2, column 2]

Parts:
C631, C633: 22p; C_0603_1608Metric_E3; MPN GRM1885C1H220JA01D
C632, C634, C639: 330p; C_0603_1608Metric_E3; MPN GRM1885C1H331JA01D
C635: 1u; C_0603_1608Metric_E3; MPN GRM188R71E105KA12D
C636: 33p; C_0603_1608Metric_E3; MPN GRM1885C1H330JA01D
C637: 100p; C_0603_1608Metric_E3; MPN GRM1885C1H101JA01D
C638: 39p; C_0603_1608Metric_E3; MPN GRM1885C1H390JA01D
L634: 47n; Coilcraft_0603HC_Doc218; MPN 0603HC-47NXJRW
L635: 33n; Coilcraft_1812SMS_Doc184; MPN 1812SMS-33NJLC
L638: 18.5n; Coilcraft_A05T_Doc107; MPN A05TJLC
TL603: 50R 6.1129mm; TL50_E3_6p1129mm; MPN PCB microstrip feature
TL604: 50R 6.4956mm; TL50_E3_6p4956mm; MPN PCB microstrip feature
TL605: 50R 5.691mm; TL50_E3_5p691mm; MPN PCB microstrip feature
TL606: 50R 2.1587mm; TL50_E3_2p1587mm; MPN PCB microstrip feature
TL607: 50R 10.7933mm; TL50_E3_10p7933mm; MPN PCB microstrip feature
TL608: 50R 12.167mm; TL50_E3_12p167mm; MPN PCB microstrip feature
TL609: 50R 1.9624mm; TL50_E3_1p9624mm; MPN PCB microstrip feature

Connections:
GND: C631.2, C633.2, C634.2, C635.2, C636.2, C637.2, C638.2; also elsewhere on the board
MMIC_AC: TL603.1 (IN); also elsewhere on the board
PA_DRAIN: L635.2, TL606.1 (IN); also elsewhere on the board
PA_GATE: TL605.2 (OUT); also elsewhere on the board
ST_DC_BLOCK: C639.2, TL609.1 (IN)
ST_IS_A: C631.1, C632.1, TL603.2 (OUT)
ST_IS_B: C632.2, TL604.1 (IN)
ST_IS_C: C633.1, L634.1, TL604.2 (OUT)
ST_IS_D: L634.2, TL605.1 (IN)
ST_LPF_IN: TL609.2 (OUT); also elsewhere on the board
ST_O_A: C636.1, TL606.2 (OUT), TL607.1 (IN)
ST_O_B: C637.1, L638.1, TL607.2 (OUT)
ST_O_C: C638.1, L638.2, TL608.1 (IN)
ST_O_D: C639.1, TL608.2 (OUT)
VMOD: C635.1; also elsewhere on the board
VPA: C634.1, L635.1; also elsewhere on the board

Notes on the sheet:
06b ST final-stage matching derivative
ST DocID17343 Rev1 Figs16/17/14. Traced topology; changed MMIC drive and supplyAM remain UNQUALIFIED. TLine symbols are PCB microstrip lengths, NOT purchased components or zero-length wire. No hardware measurements exist.
Input matching: original interstage source was PD84001 drain, not a50ohm MMIC. No claim of unchanged match or sufficient gain. Output matching/LPF retained. L63533n drain feed is a disclosed substitution for the contradictory35.5n/22n ST BOM entry. Use one integrated end-to-end commissioning proced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
M5B-E6R2: REVIEW / ALL hardware measurements NOT RUN / no ordering or manufacture.

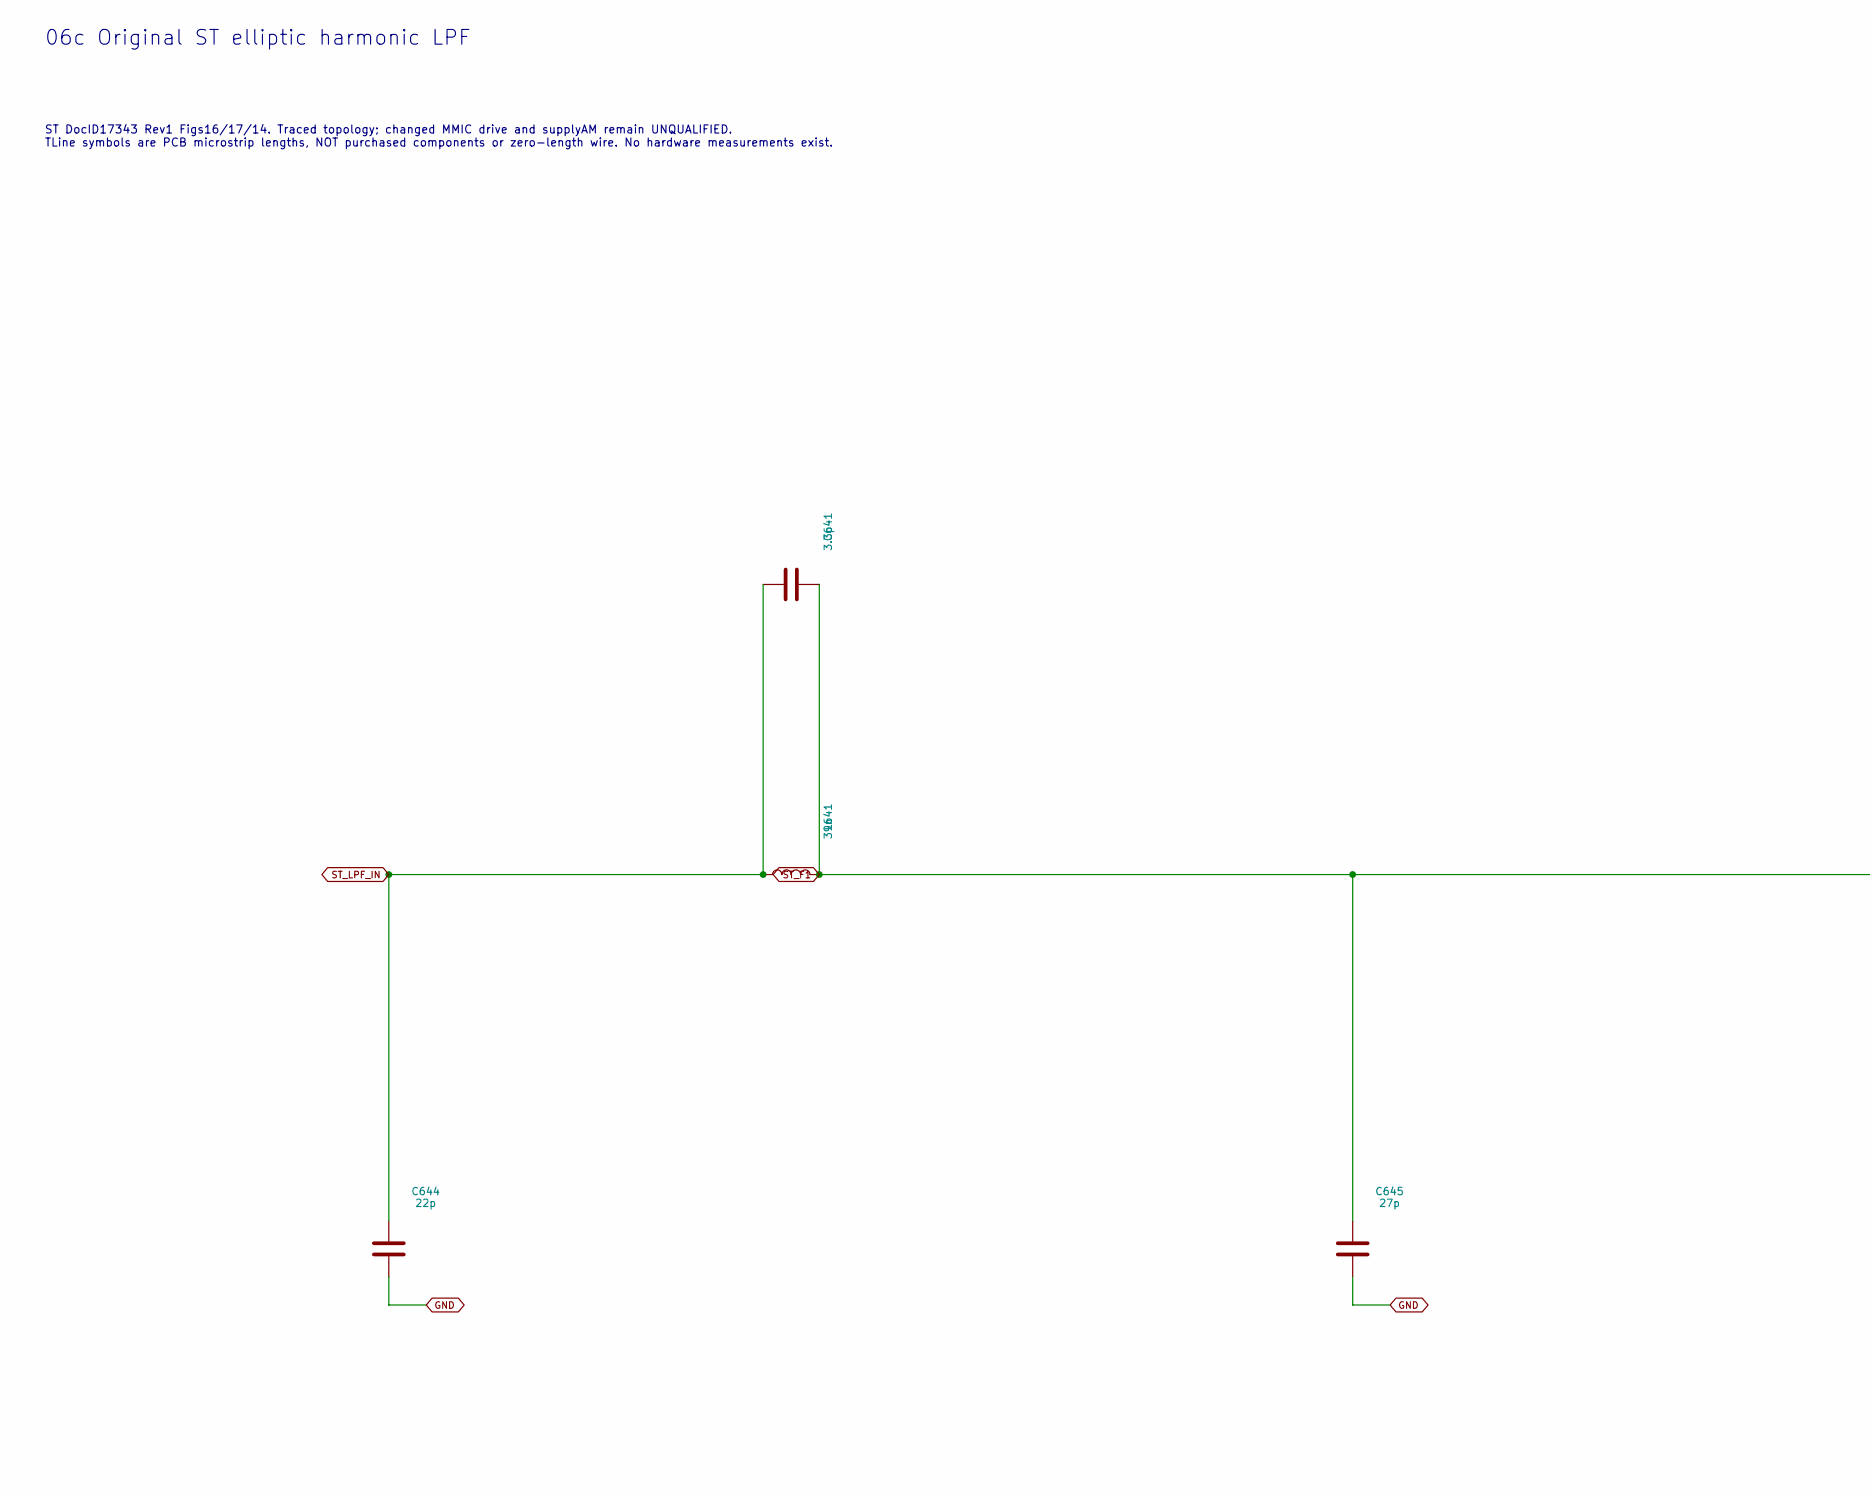
[picture p312: schematic 06c_st_lpf.kicad_sch, 06c Original ST elliptic harmonic LPF, part in row 1, column 1]

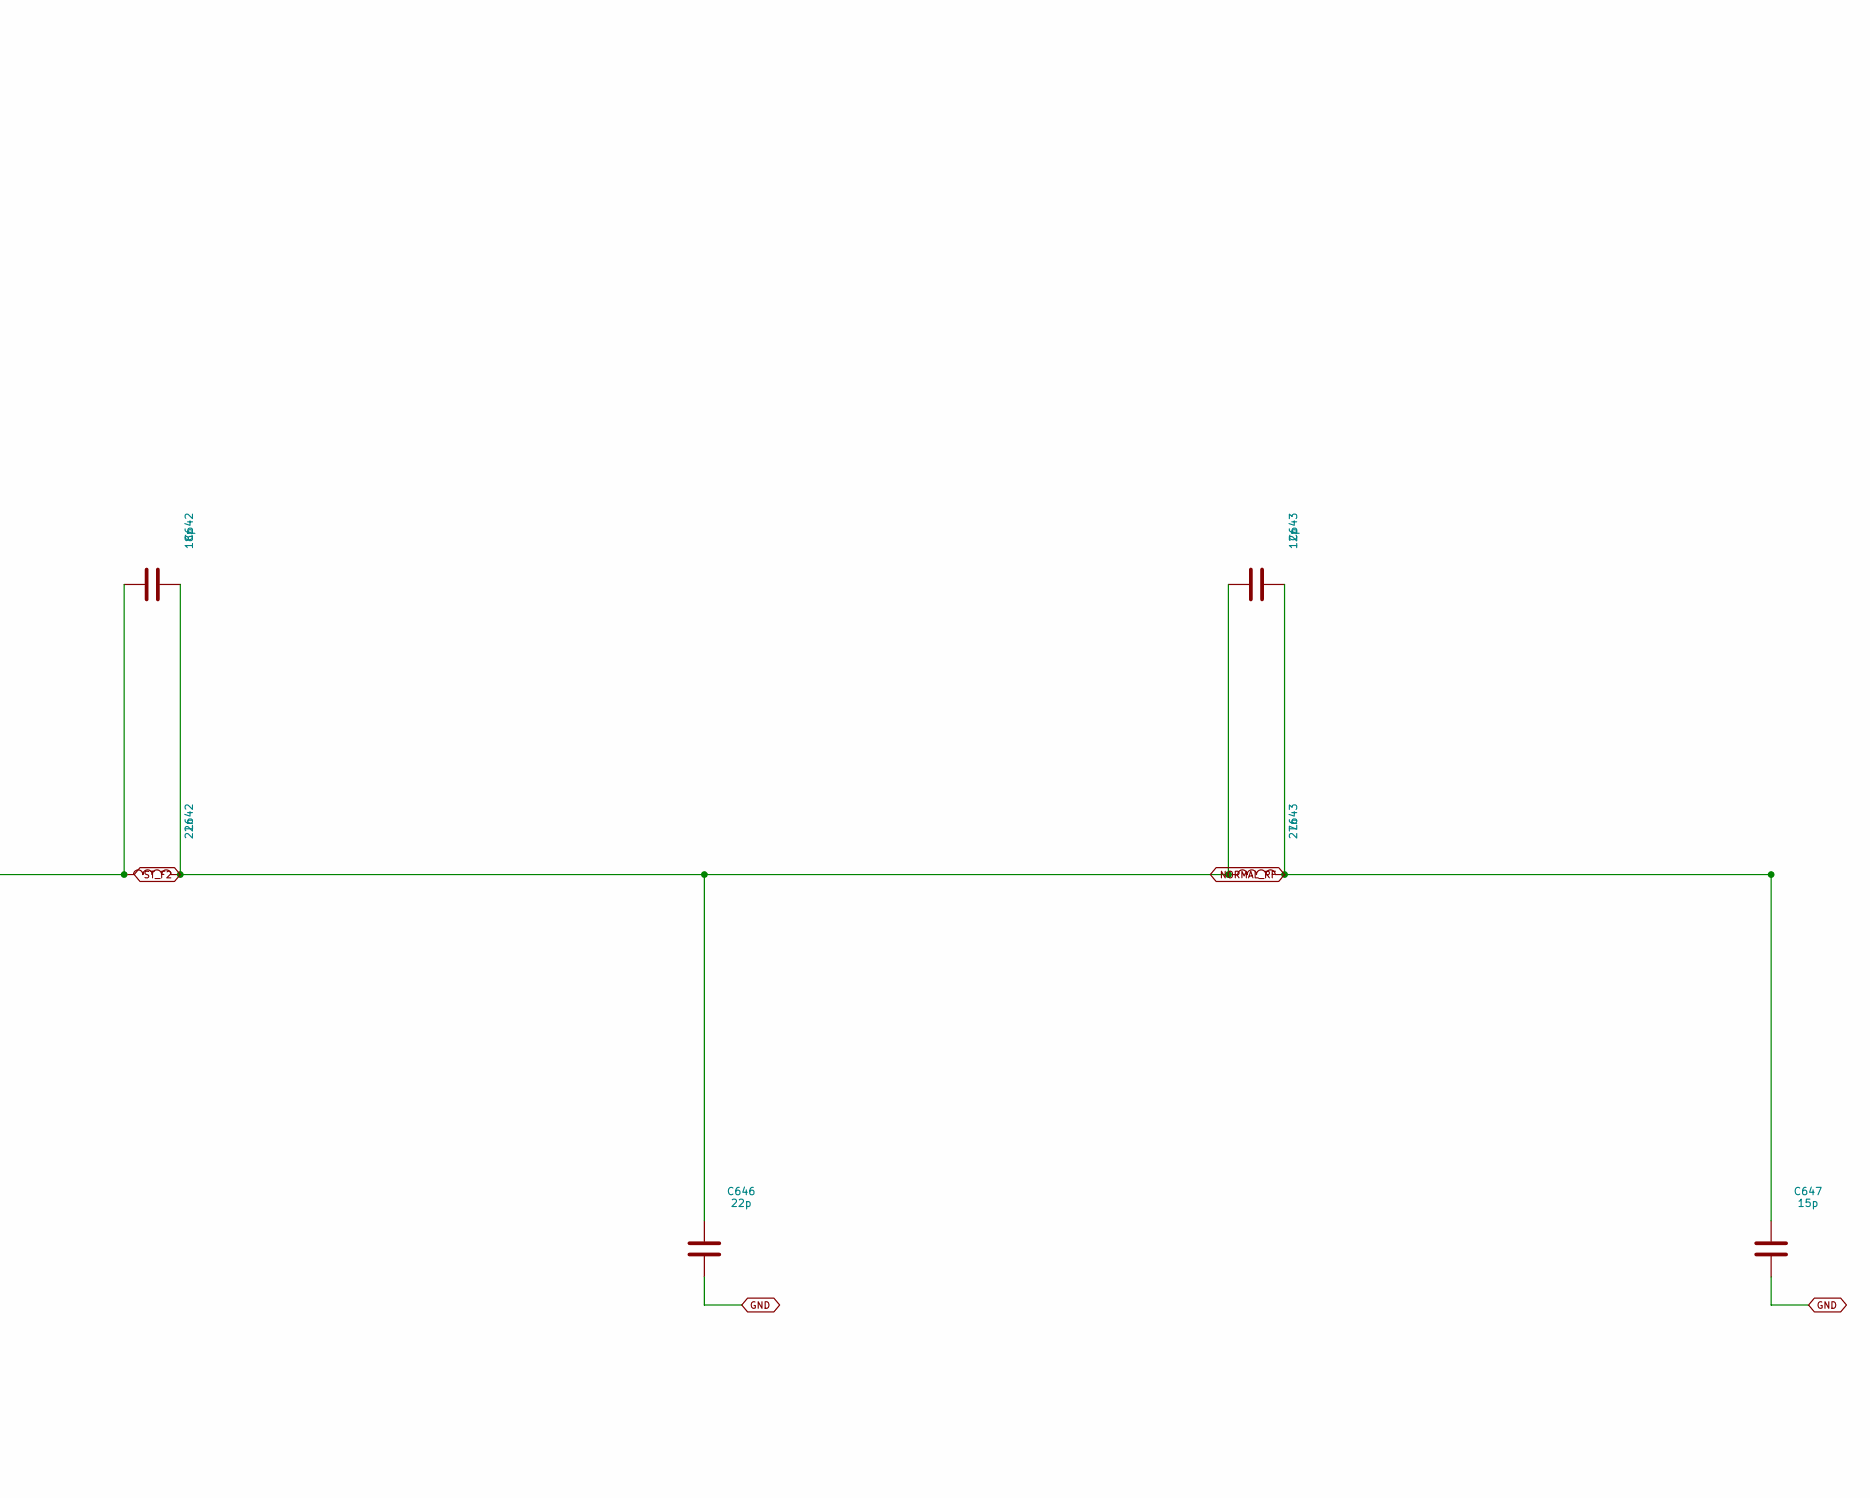
[picture p313: schematic 06c_st_lpf.kicad_sch, 06c Original ST elliptic harmonic LPF, part in row 1, column 2]

Parts:
C641: 3.3p; C_0603_1608Metric_E3; MPN GRM1885C1H3R3CA01D
C642: 18p; C_0603_1608Metric_E3; MPN GRM1885C1H180JA01D
C643: 12p; C_0603_1608Metric_E3; MPN GRM1885C1H120JA01D
C644, C646: 22p; C_0603_1608Metric_E3; MPN GRM1885C1H220JA01D
C645: 27p; C_0603_1608Metric_E3; MPN GRM1885C1H270JA01D
C647: 15p; C_0603_1608Metric_E3; MPN GRM1885C1H150JA01D
L641: 39n; Coilcraft_1008CS_Doc101; MPN 1008CS-390XJLC
L642: 22n; Coilcraft_1008CS_Doc101; MPN 1008CS-220XJLC
L643: 27n; Coilcraft_1008CS_Doc101; MPN 1008CS-270XJLC

Connections:
GND: C644.2, C645.2, C646.2, C647.2; also elsewhere on the board
NORMAL_RF: C643.2, C647.1, L643.2; also elsewhere on the board
ST_F1: C641.2, C642.1, C645.1, L641.2, L642.1
ST_F2: C642.2, C643.1, C646.1, L642.2, L643.1
ST_LPF_IN: C641.1, C644.1, L641.1; also elsewhere on the board

Notes on the sheet:
06c Original ST elliptic harmonic LPF
ST DocID17343 Rev1 Figs16/17/14. Traced topology; changed MMIC drive and supplyAM remain UNQUALIFIED. TLine symbols are PCB microstrip lengths, NOT purchased components or zero-length wire. No hardware measurements exist.
Input matching: original interstage source was PD84001 drain, not a50ohm MMIC. No claim of unchanged match or sufficient gain. Output matching/LPF retained. L63533n drain feed is a disclosed substitution for the contradictory35.5n/22n ST BOM entry. Use one integrated end-to-end commissioning proced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
M5B-E6R2: REVIEW / ALL hardware measurements NOT RUN / no ordering or manufacture.
