DD1SB/ARDF-TX/hardware/2m/RF2M.kicad_pcb

## KiCad design hardware/2m/RF2M.kicad_pcb (continued)

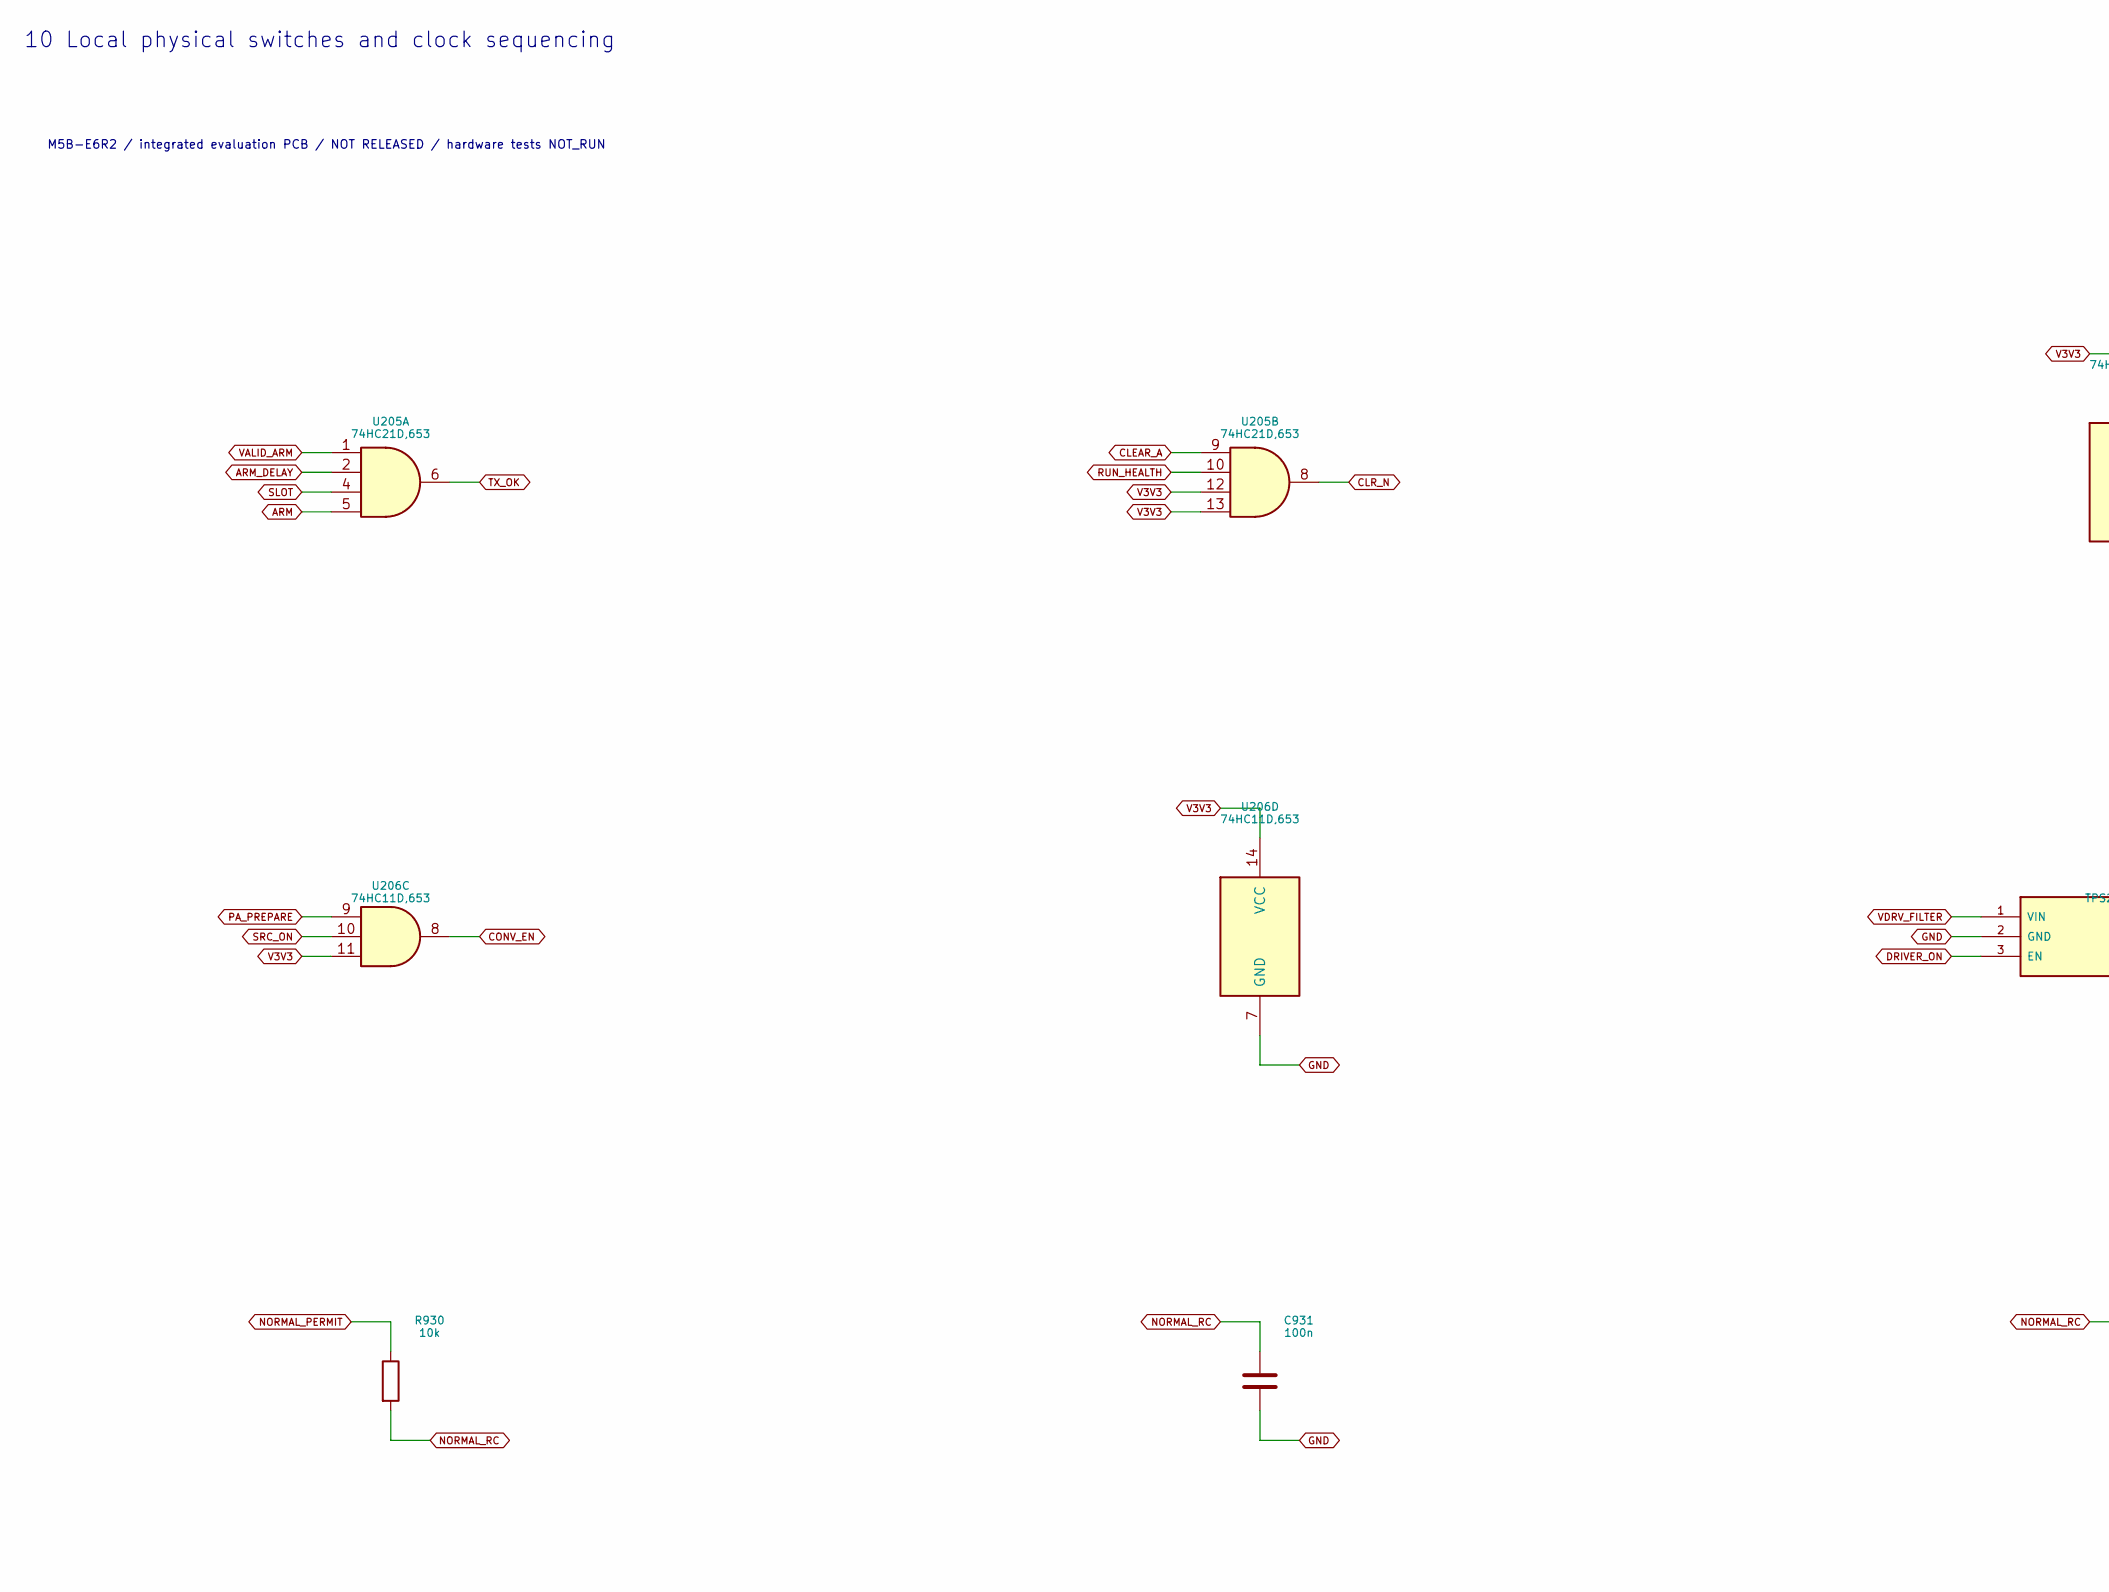
[picture p314: schematic 10_enable_detail.kicad_sch, 10 Local physical switches and clock sequencing, part in row 1, column 1]

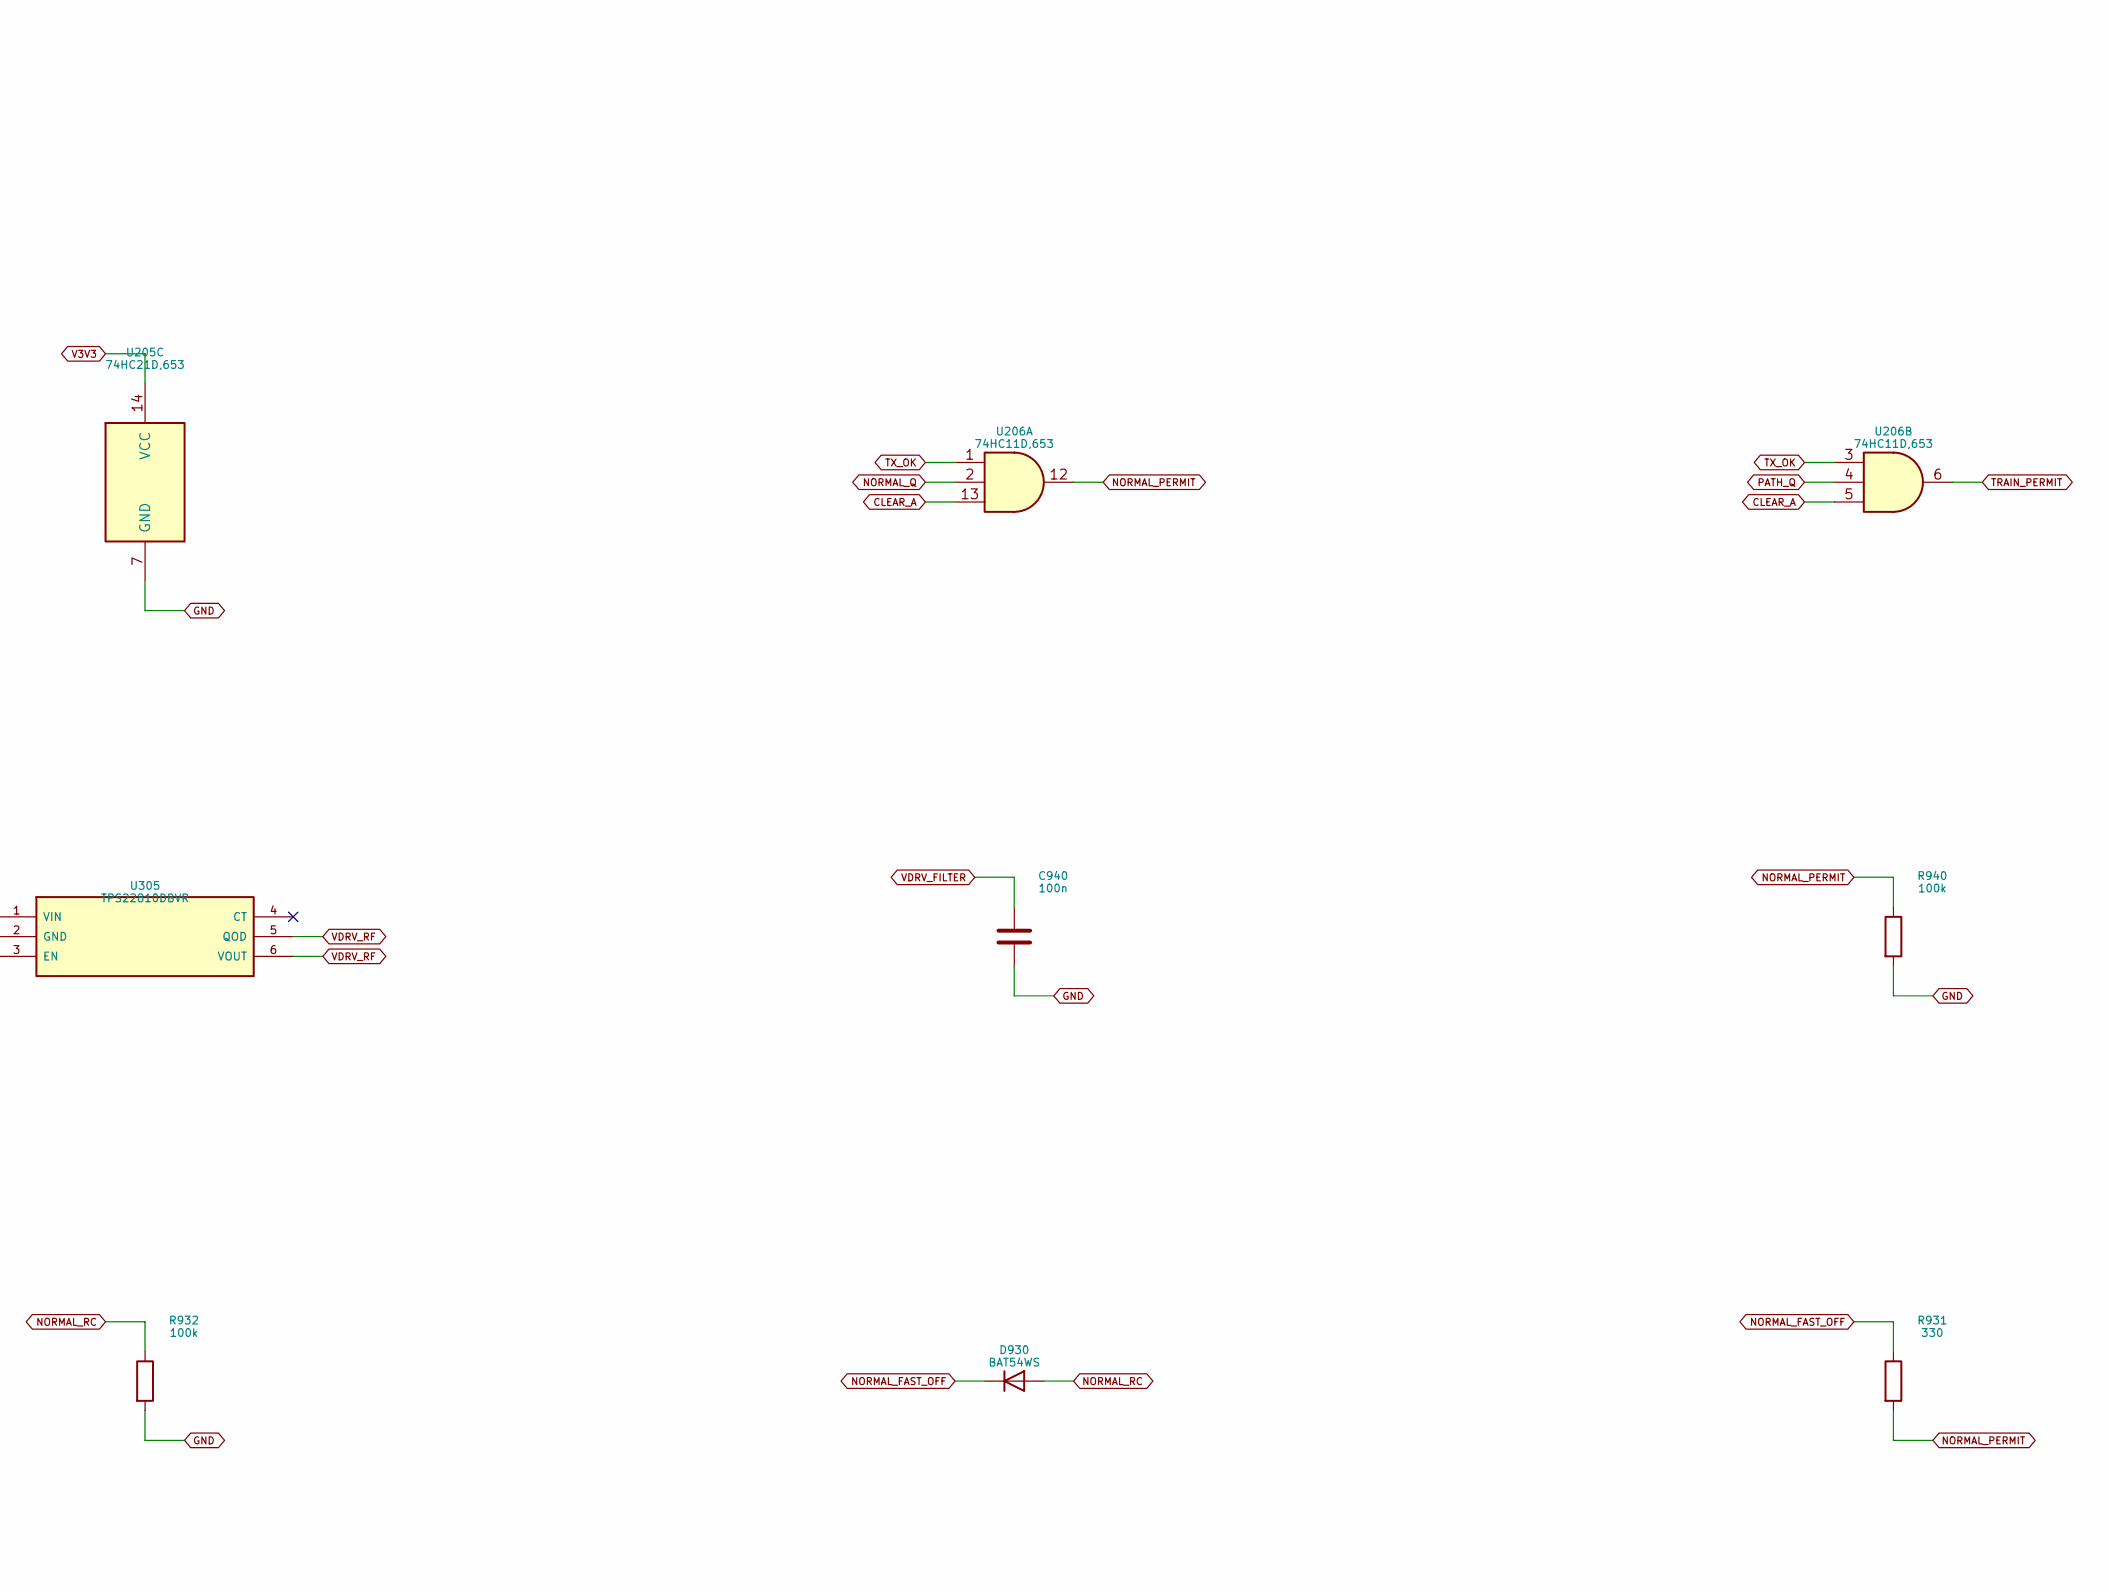
[picture p315: schematic 10_enable_detail.kicad_sch, 10 Local physical switches and clock sequencing, part in row 1, column 2]

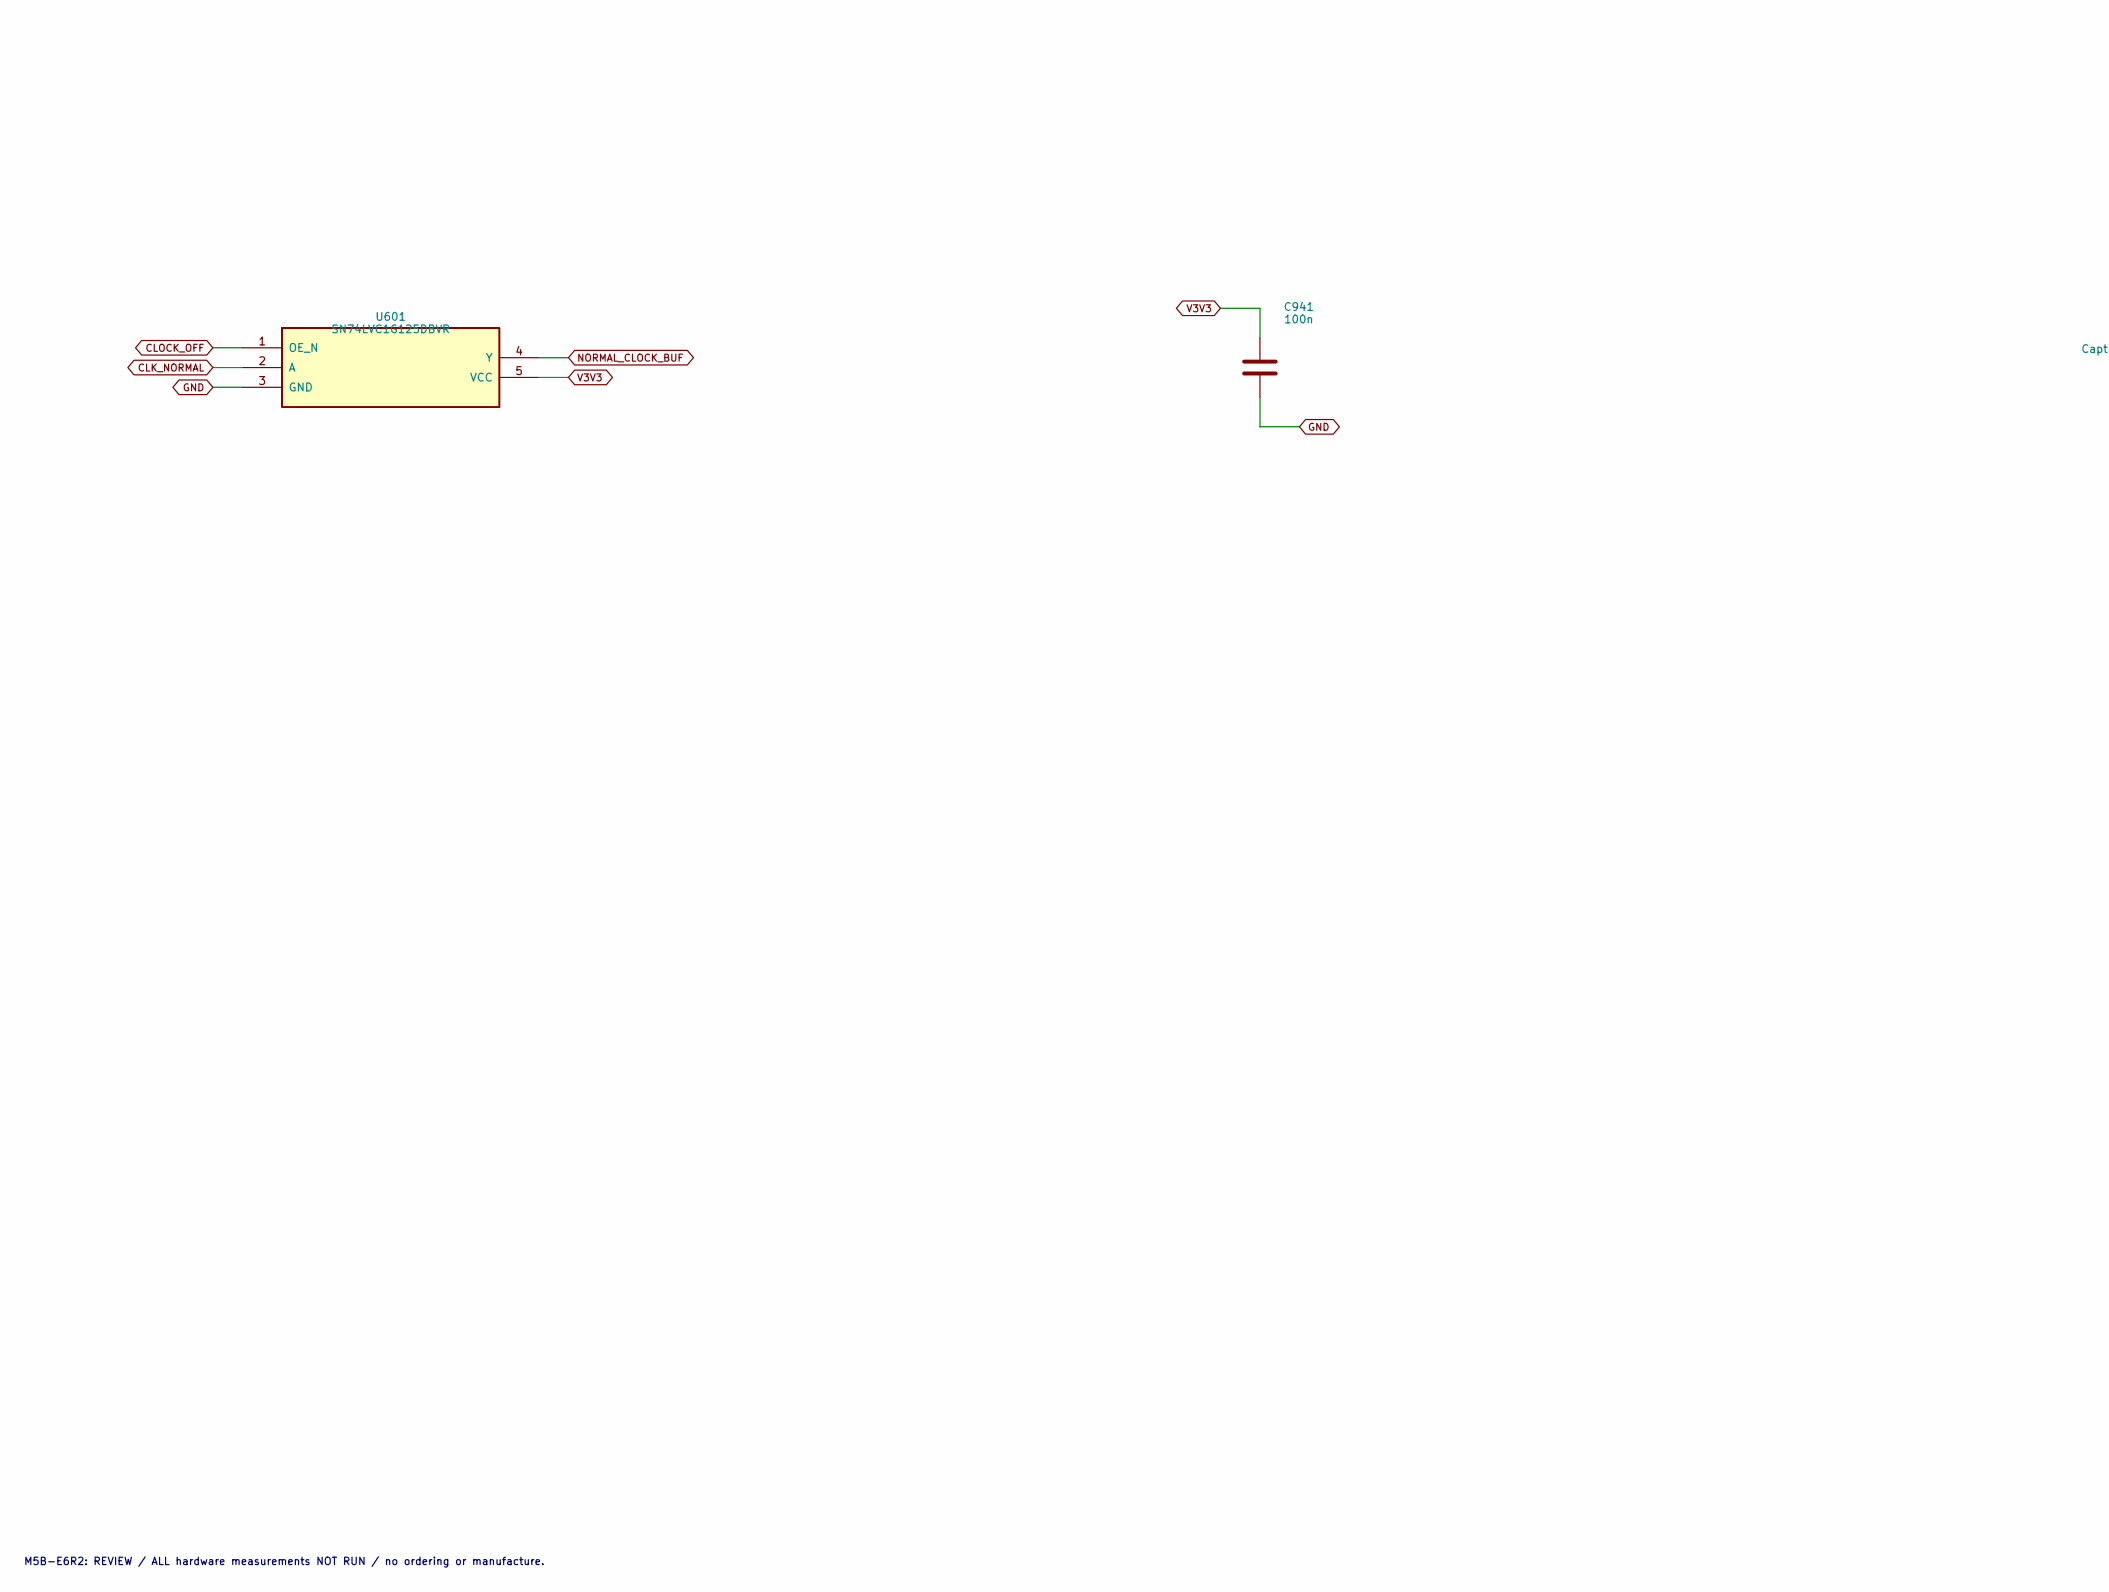
[picture p316: schematic 10_enable_detail.kicad_sch, 10 Local physical switches and clock sequencing, part in row 2, column 1]

Parts:
C931, C940, C941: 100n; C_0603_1608Metric_E3; MPN CC0603KRX7R8BB104
D930: BAT54WS; D_SOD-323_E3; MPN BAT54WS-7-F
R930: 10k; R_0603_1608Metric_E3; MPN RC0603FR-0710KL
R931: 330; R_0603_1608Metric_E3; MPN RC0603FR-07330RL
R932, R940: 100k; R_0603_1608Metric_E3; MPN RC0603FR-07100KL
TP940: Captured profile; TestPoint_Pad_D1.0mm_E3; MPN PCB feature
U205: 74HC21D,653; SOIC-14_3.9x8.7mm_P1.27mm_E3; MPN 74HC21D,653
U206: 74HC11D,653; SOIC-14_3.9x8.7mm_P1.27mm_E3; MPN 74HC11D,653
U305: TPS22810DBVR; SOT-23-6_E3; MPN TPS22810DBVR
U601: SN74LVC1G125DBVR; SOT-23-5_E3; MPN SN74LVC1G125DBVR

Connections:
ARM: U205.5; also elsewhere on the board
ARM_DELAY: U205.2; also elsewhere on the board
CLEAR_A: U205.9, U206.5, U206.13; also elsewhere on the board
CLK_NORMAL: U601.2 (A); also elsewhere on the board
CLOCK_OFF: U601.1 (OE_N); also elsewhere on the board
CLR_N: U205.8; also elsewhere on the board
CONV_EN: U206.8; also elsewhere on the board
DRIVER_ON: U305.3 (EN); also elsewhere on the board
GND: C931.2, C940.2, C941.2, R932.2, R940.2, U205.7 (GND), U206.7 (GND), U305.2 (GND), U601.3 (GND); also elsewhere on the board
NORMAL_CLOCK_BUF: U601.4 (Y); also elsewhere on the board
NORMAL_FAST_OFF: D930.1 (K), R931.1
NORMAL_PERMIT: R930.1, R931.2, R940.1, U206.12; also elsewhere on the board
NORMAL_Q: U206.2; also elsewhere on the board
NORMAL_RC: C931.1, D930.2 (A), R930.2, R932.1; also elsewhere on the board
PATH_Q: U206.4; also elsewhere on the board
PA_PREPARE: U206.9; also elsewhere on the board
PROFILE_Q: TP940.1; also elsewhere on the board
RUN_HEALTH: U205.10; also elsewhere on the board
SLOT: U205.4; also elsewhere on the board
SRC_ON: U206.10; also elsewhere on the board
TRAIN_PERMIT: U206.6; also elsewhere on the board
TX_OK: U205.6, U206.1, U206.3
V3V3: C941.1, U205.12, U205.13, U205.14 (VCC), U206.11, U206.14 (VCC), U601.5 (VCC); also elsewhere on the board
VALID_ARM: U205.1; also elsewhere on the board
VDRV_FILTER: C940.1, U305.1 (VIN); also elsewhere on the board
VDRV_RF: U305.5 (QOD), U305.6 (VOUT); also elsewhere on the board

Notes on the sheet:
10 Local physical switches and clock sequencing
M5B-E6R2 / integrated evaluation PCB / NOT RELEASED / hardware tests NOT_RUN
M5B-E6R2: REVIEW / ALL hardware measurements NOT RUN / no ordering or manufacture.

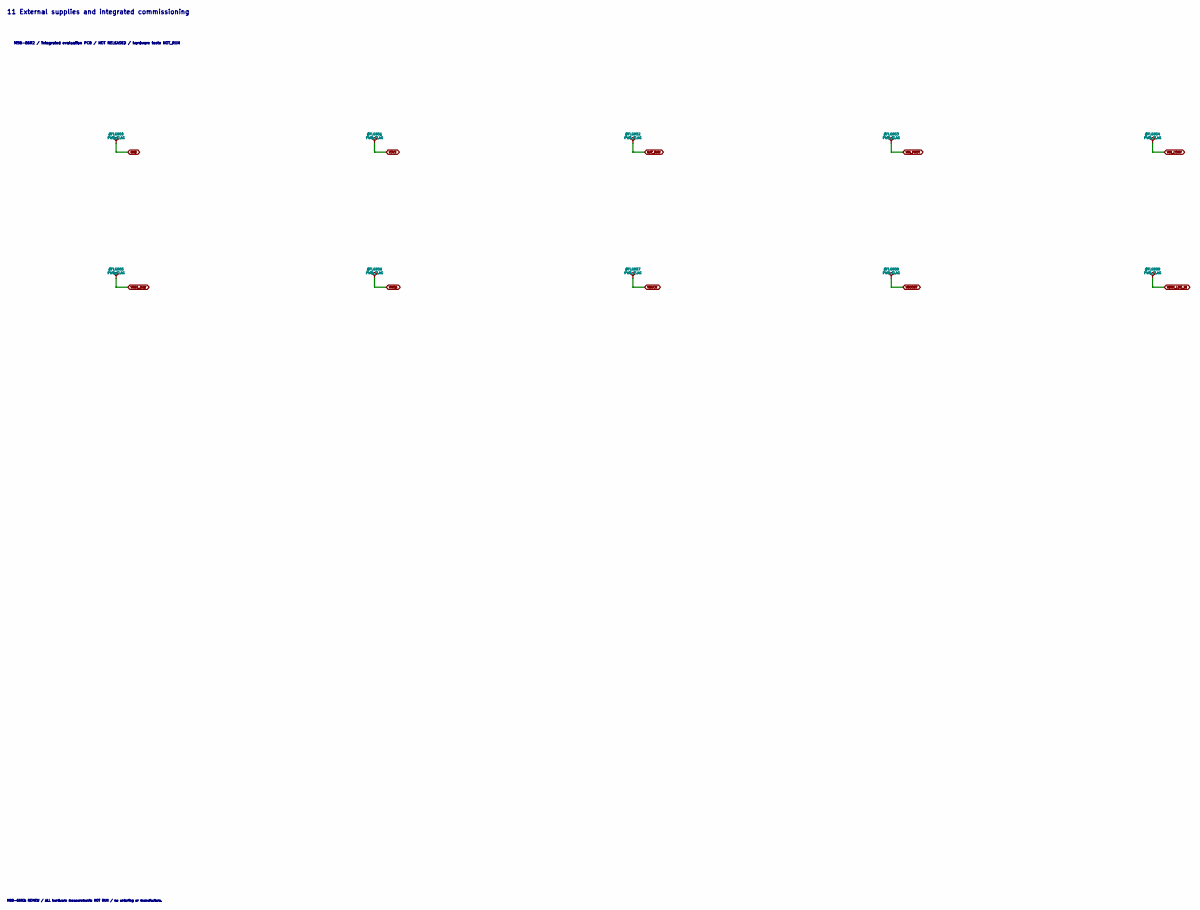
[picture p317: schematic 11_external_contract.kicad_sch, 11 External supplies and integrated commissioning]

Notes on the sheet:
11 External supplies and integrated commissioning
M5B-E6R2 / integrated evaluation PCB / NOT RELEASED / hardware tests NOT_RUN
M5B-E6R2: REVIEW / ALL hardware measurements NOT RUN / no ordering or manufacture.

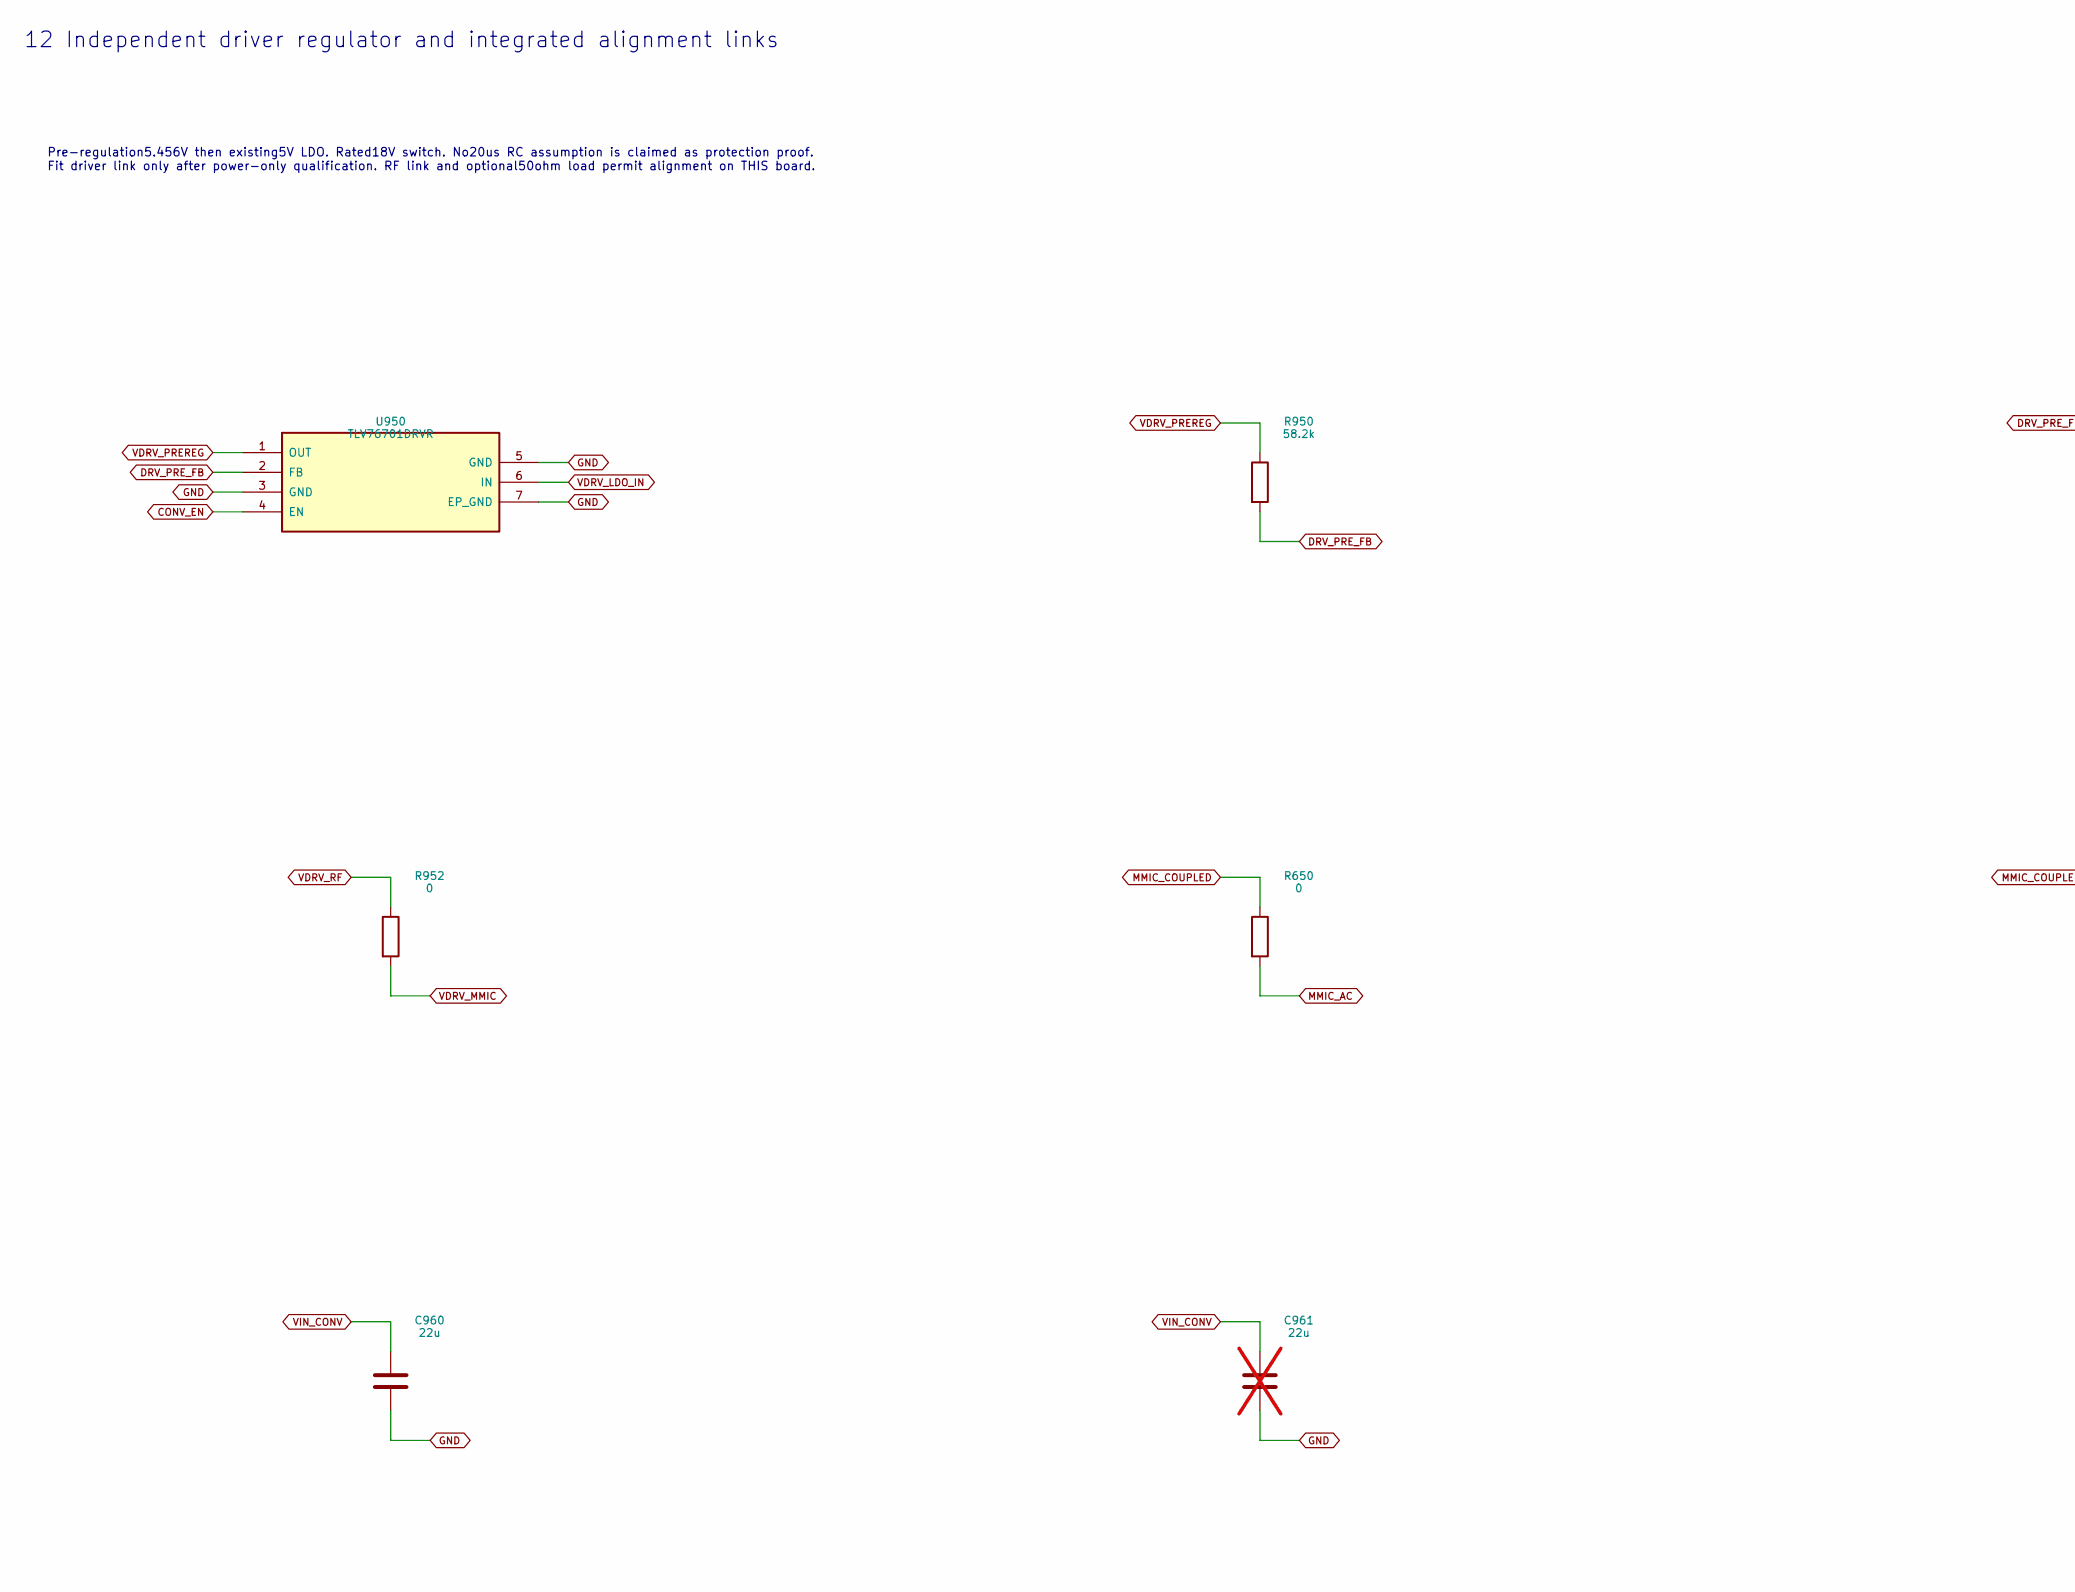
[picture p318: schematic 12_m5b_qualification.kicad_sch, 12 Independent driver regulator and integrated alignment li…, part in row 1, column 1]

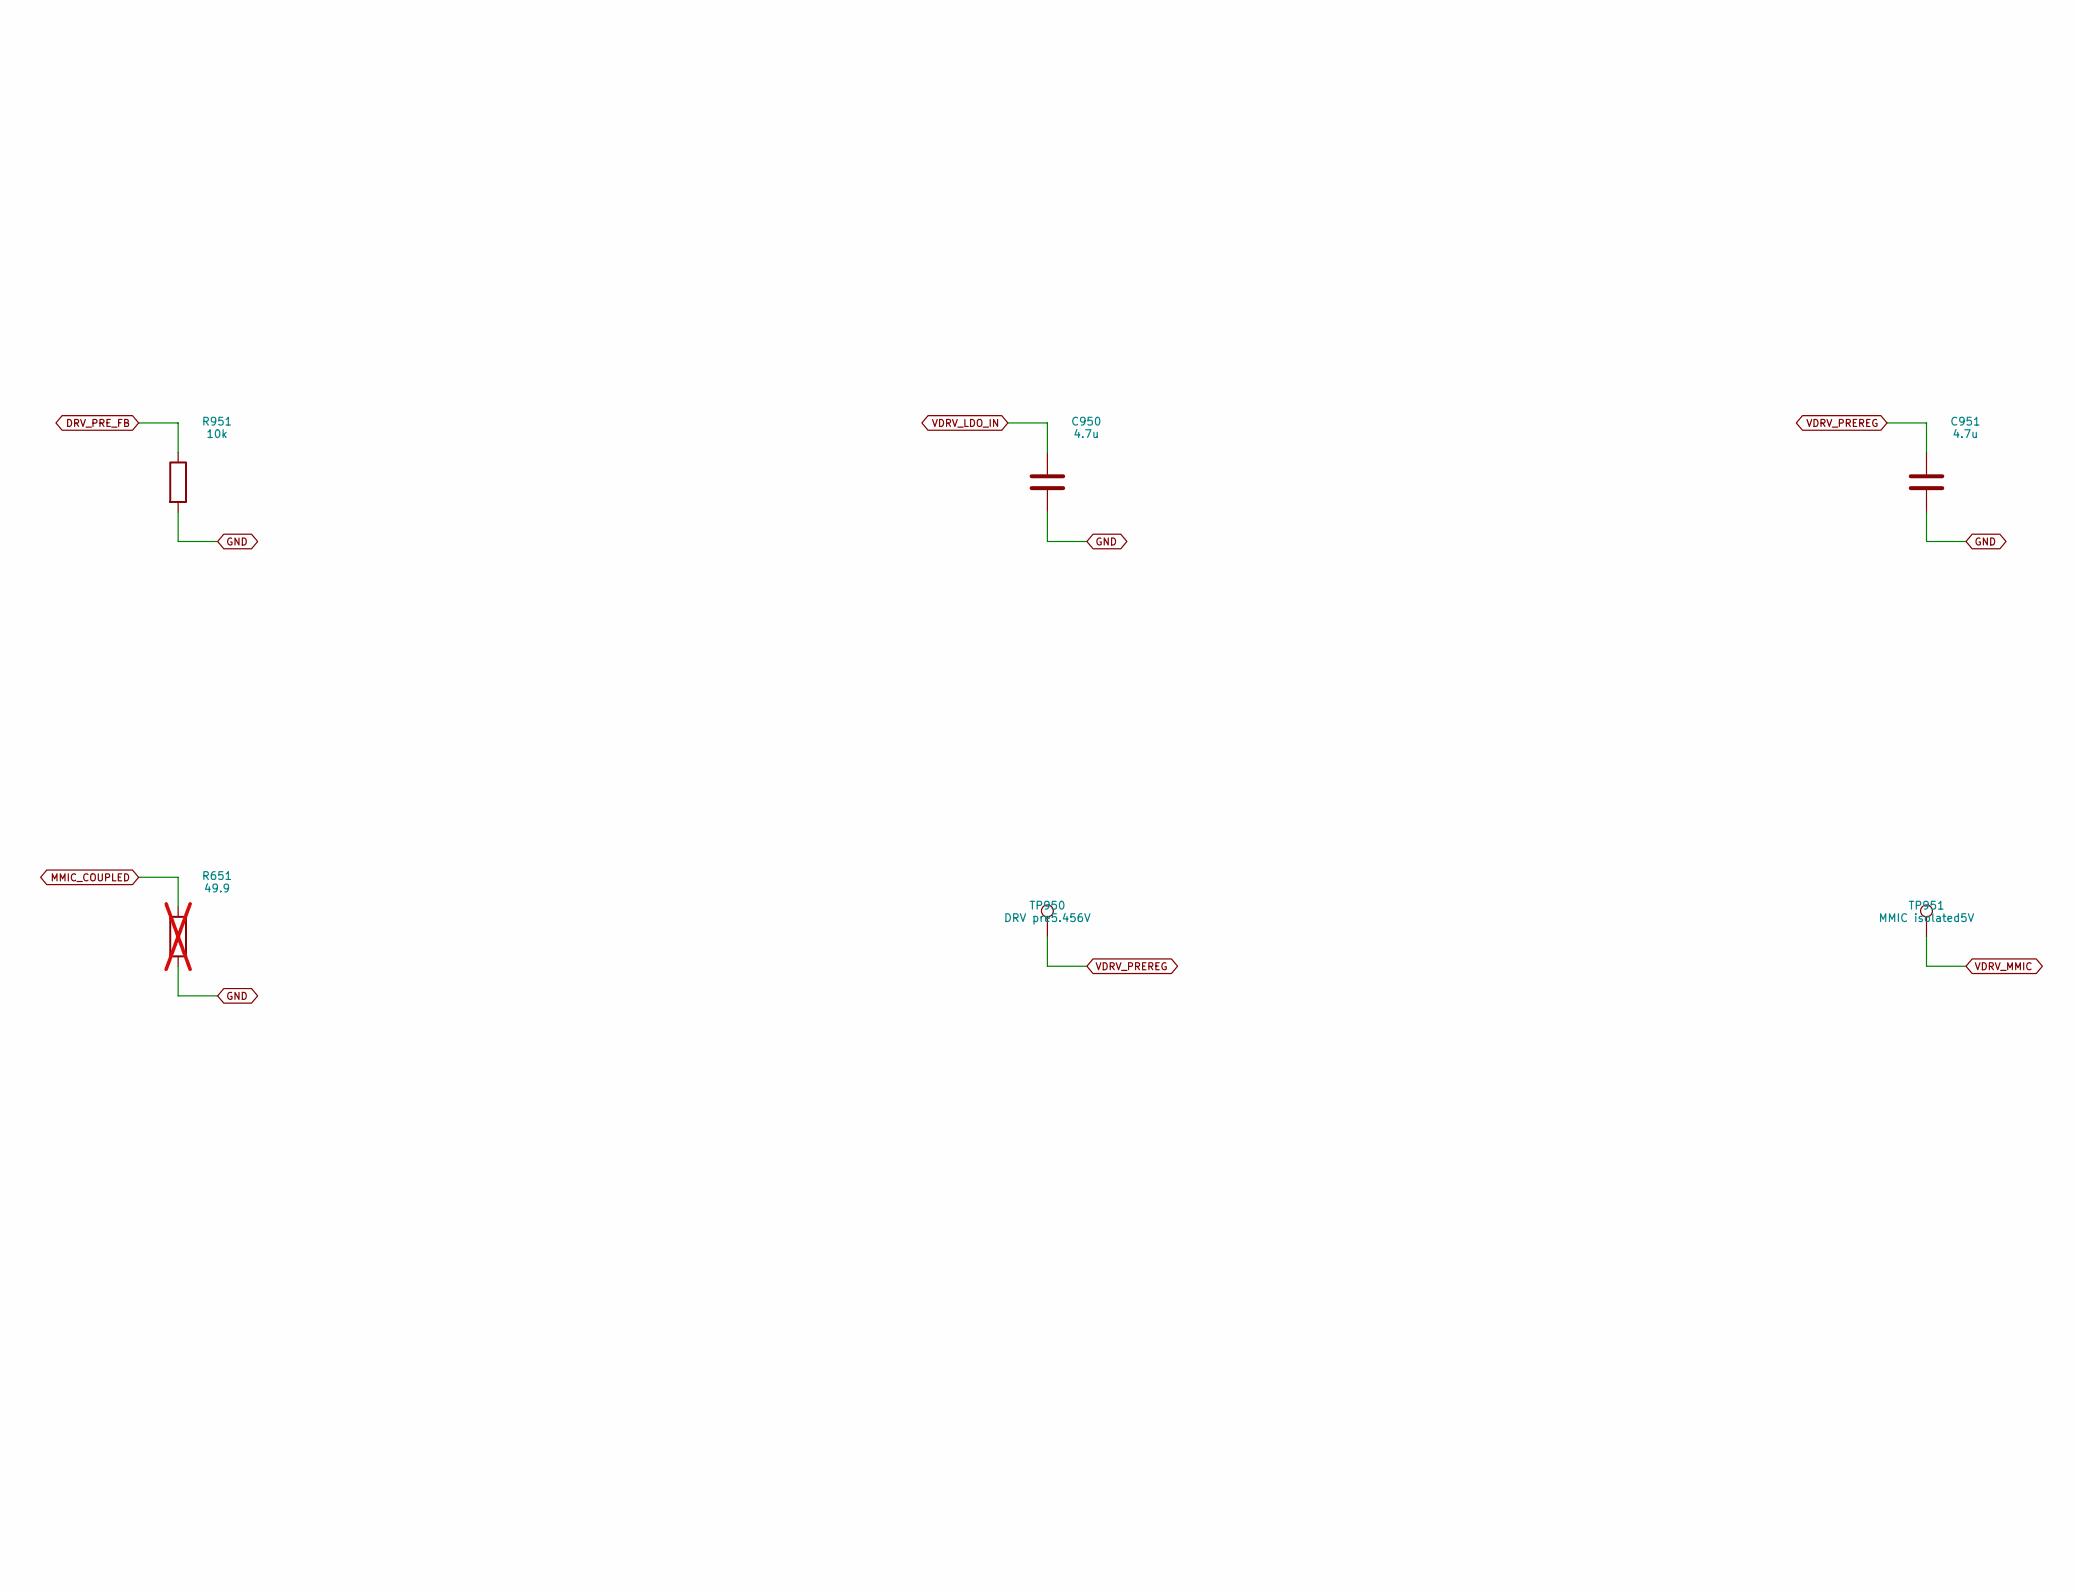
[picture p319: schematic 12_m5b_qualification.kicad_sch, 12 Independent driver regulator and integrated alignment li…, part in row 1, column 2]

Parts:
C950, C951: 4.7u; C_0805_2012Metric_E3; MPN GRM21BR71E475KA73L
C960: 22u; C_1210_3225Metric_E3; MPN GRM32ER71V226KE15L
C961: 22u; C_1210_3225Metric_E3; MPN GRM32ER71V226KE15L; not fitted
R650: 0; R_0603_1608Metric_E3; MPN RC0603JR-070RL
R651: 49.9; R_1206_3216Metric_E3; MPN RC1206FR-0749R9L; not fitted
R950: 58.2k; R_0603_1608Metric_E3; MPN RT0603BRD0758K2L
R951: 10k; R_0603_1608Metric_E3; MPN RT0603BRD0710KL
R952: 0; R_1206_3216Metric_E3; MPN RC1206JR-070RL
TP950: DRV pre5.456V; TestPoint_Pad_D1.0mm_E3; MPN PCB feature
TP951: MMIC isolated5V; TestPoint_Pad_D1.0mm_E3; MPN PCB feature
U950: TLV76701DRVR; WSON-6-1EP_2x2mm_P0.65mm_EP1x1.6mm_E3; MPN TLV76701DRVR

Connections:
CONV_EN: U950.4 (EN); also elsewhere on the board
DRV_PRE_FB: R950.2, R951.1, U950.2 (FB)
GND: C950.2, C951.2, C960.2, C961.2, R651.2, R951.2, U950.3 (GND), U950.5 (GND), U950.7 (EP_GND); also elsewhere on the board
MMIC_AC: R650.2; also elsewhere on the board
MMIC_COUPLED: R650.1, R651.1; also elsewhere on the board
VDRV_LDO_IN: C950.1, U950.6 (IN); also elsewhere on the board
VDRV_MMIC: R952.2, TP951.1; also elsewhere on the board
VDRV_PREREG: C951.1, R950.1, TP950.1, U950.1 (OUT); also elsewhere on the board
VDRV_RF: R952.1; also elsewhere on the board
VIN_CONV: C960.1, C961.1; also elsewhere on the board

Notes on the sheet:
12 Independent driver regulator and integrated alignment links
Pre-regulation5.456V then existing5V LDO. Rated18V switch. No20us RC assumption is claimed as protection proof. Fit driver link only after power-only qualification. RF link and optional50ohm load permit alignment on THIS board.
M5B-E6R2: REVIEW / ALL hardware measurements NOT RUN / no ordering or manufacture.
