DD1SB/ARDF-TX/hardware/2m/RF2M.kicad_pcb

## KiCad design hardware/2m/RF2M.kicad_pcb (continued)

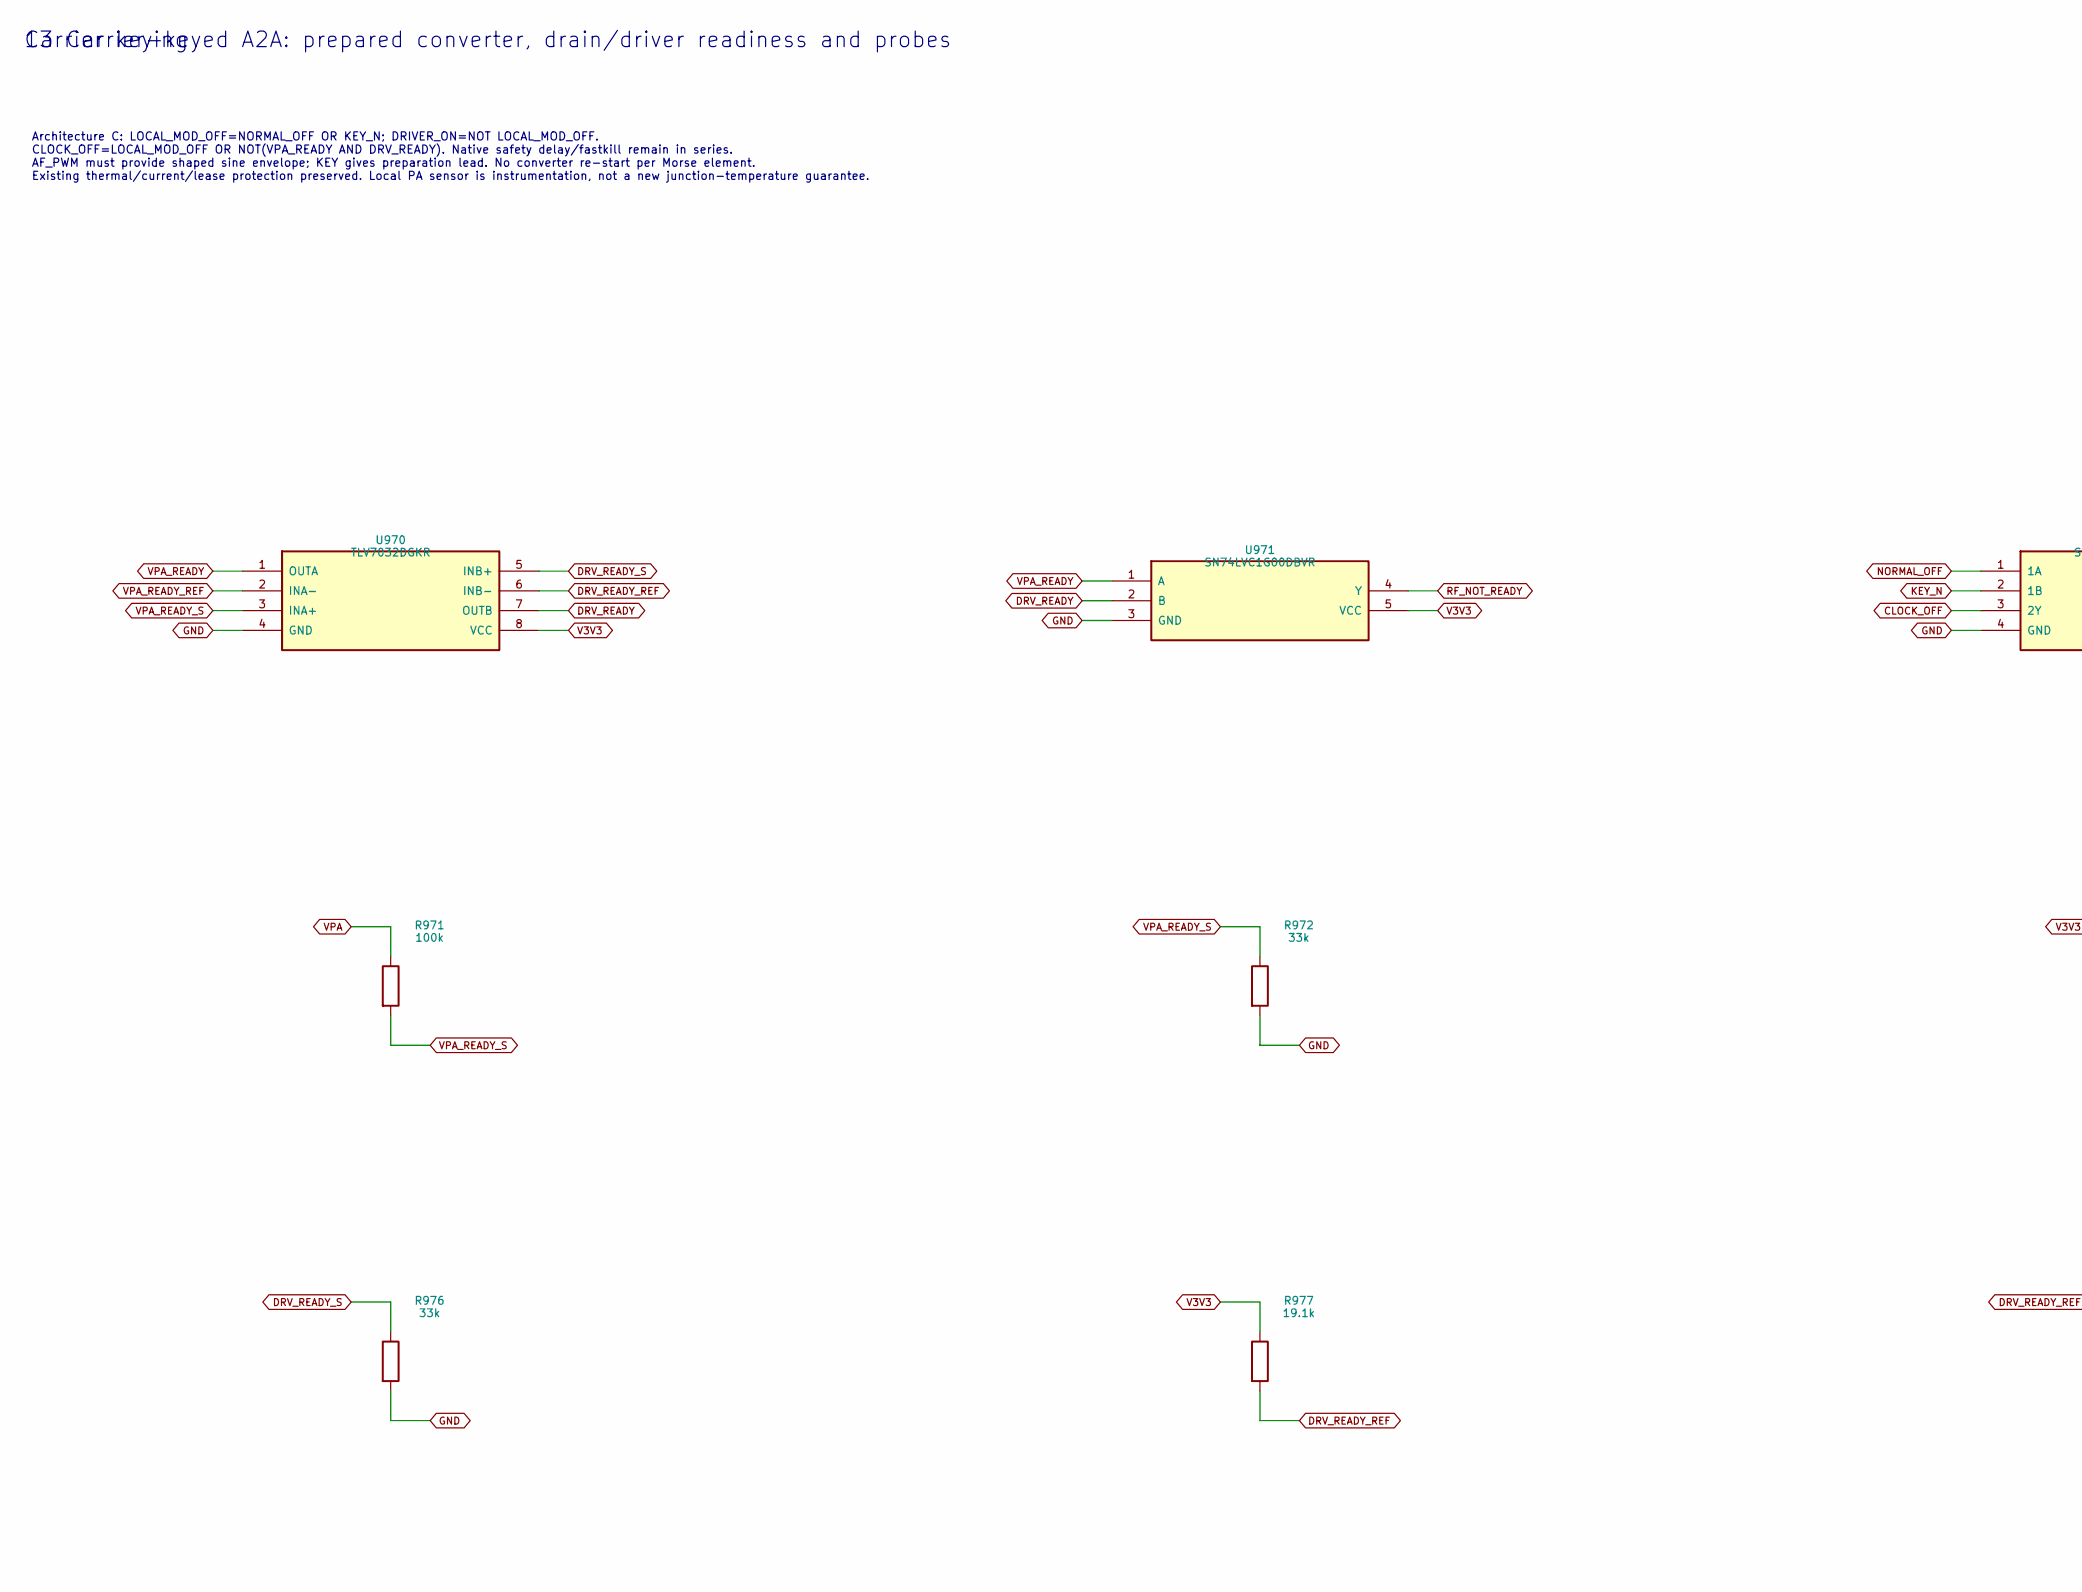
[picture p320: schematic 13_carrier_keying.kicad_sch, 13 Carrier-keyed A2A: prepared converter, drain/driver read…, part in row 1, column 1]

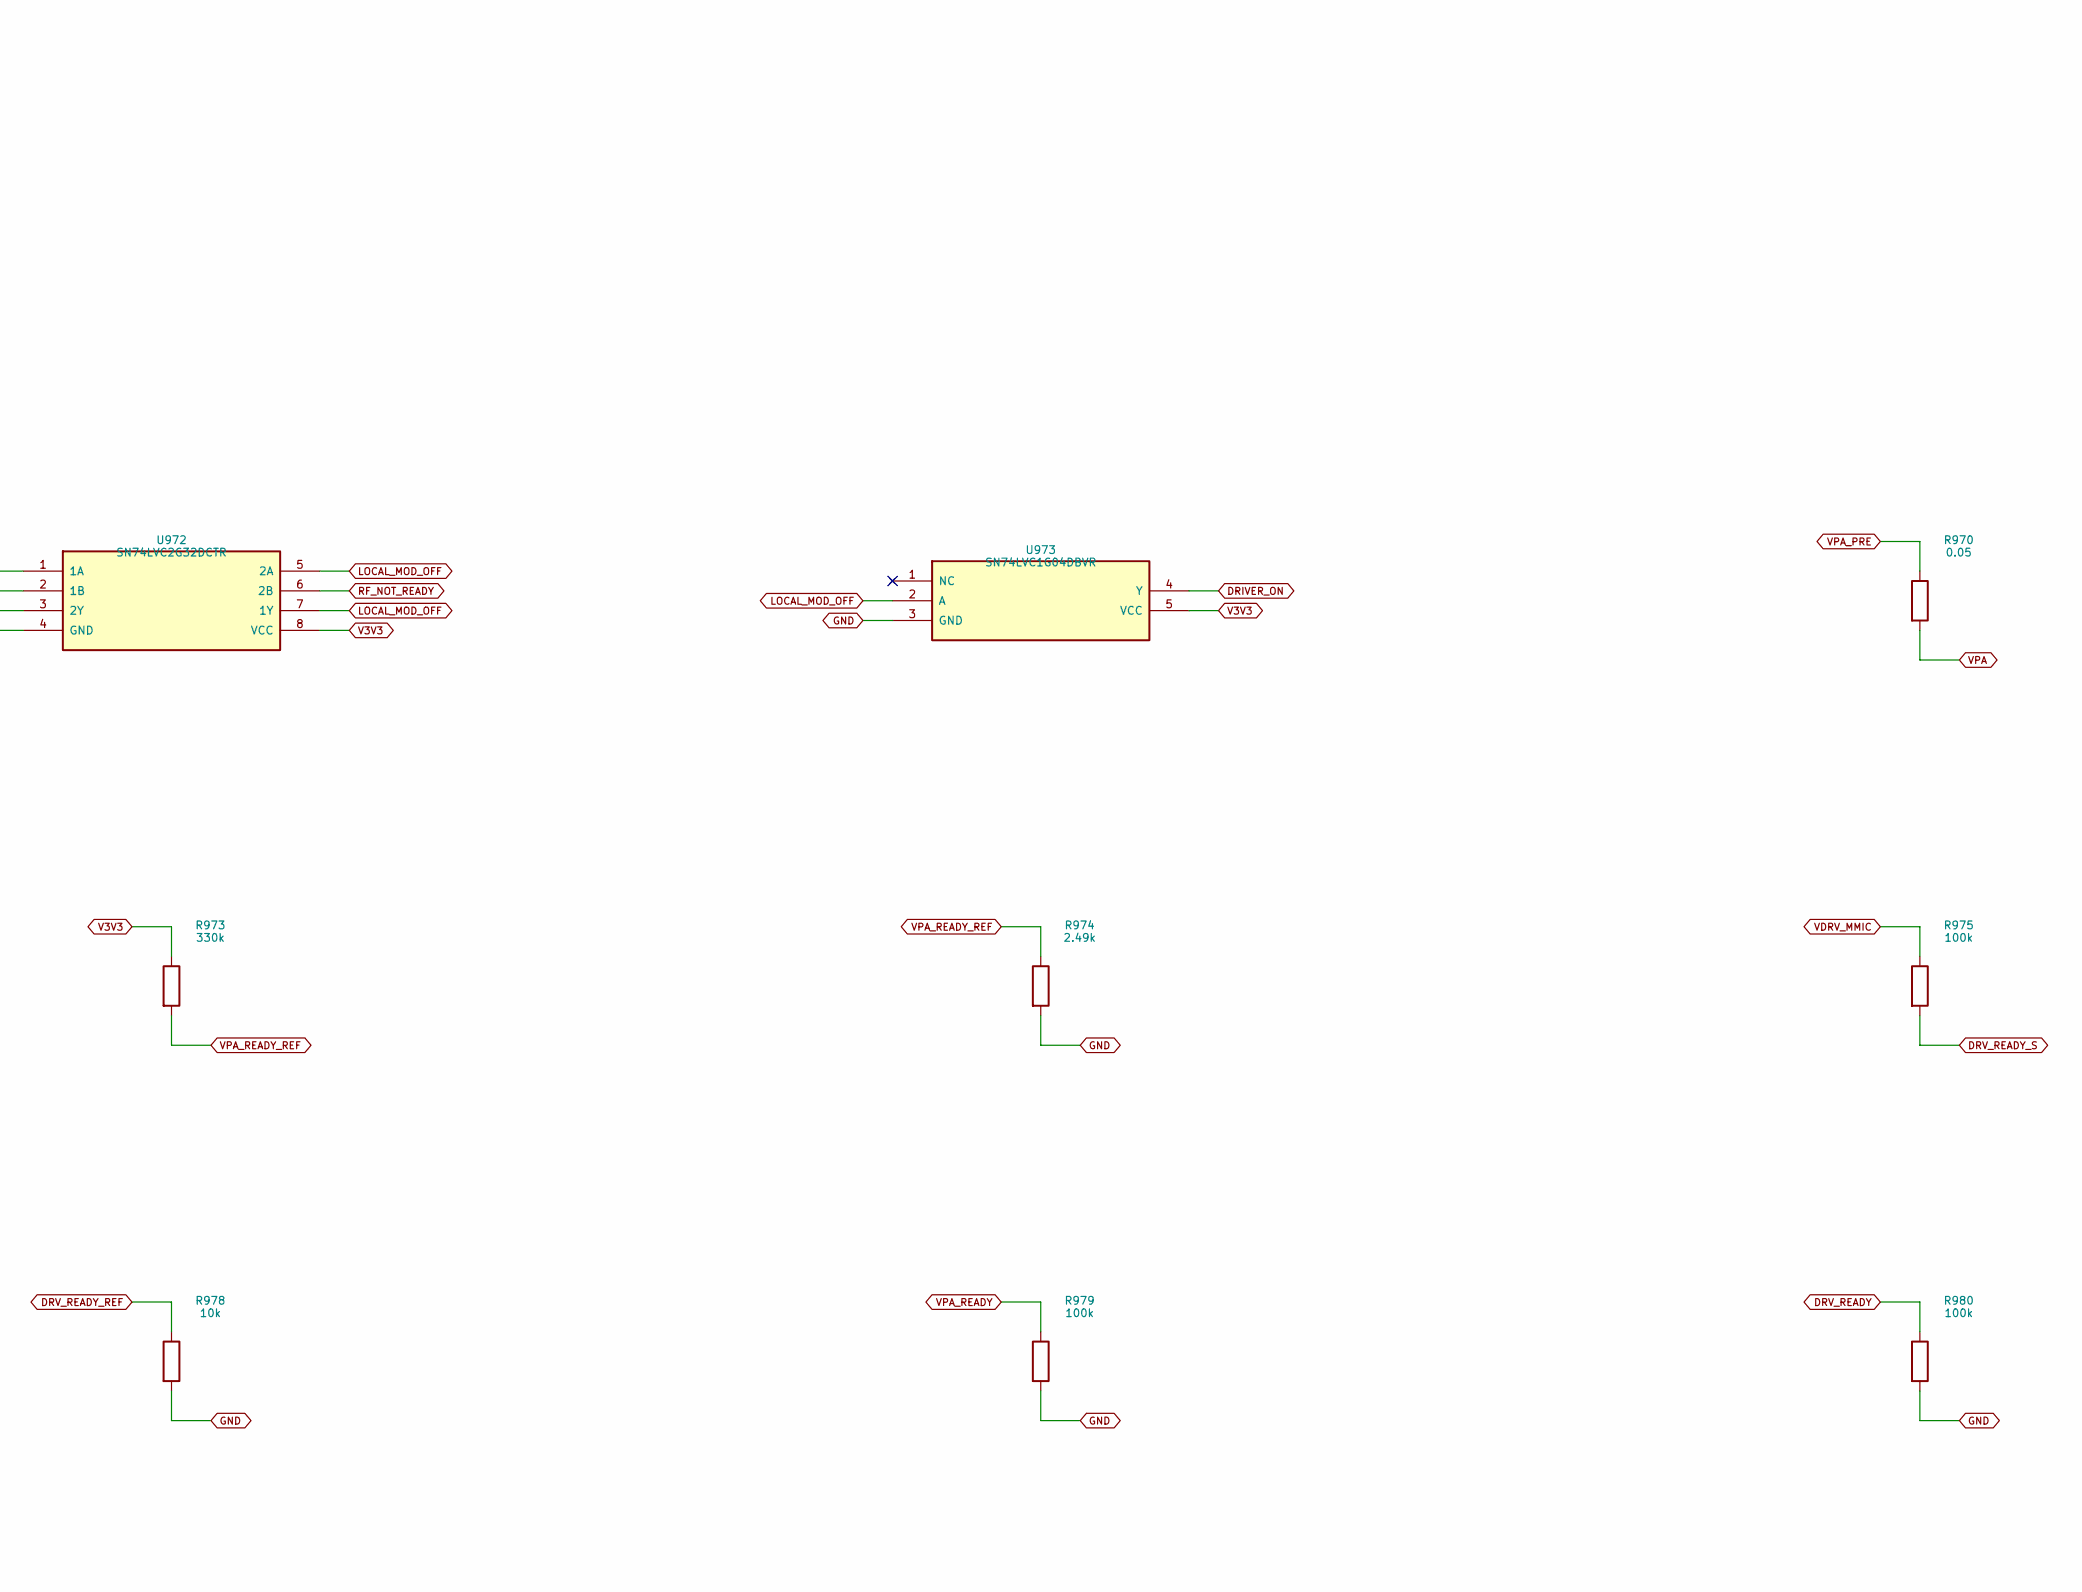
[picture p321: schematic 13_carrier_keying.kicad_sch, 13 Carrier-keyed A2A: prepared converter, drain/driver read…, part in row 1, column 2]

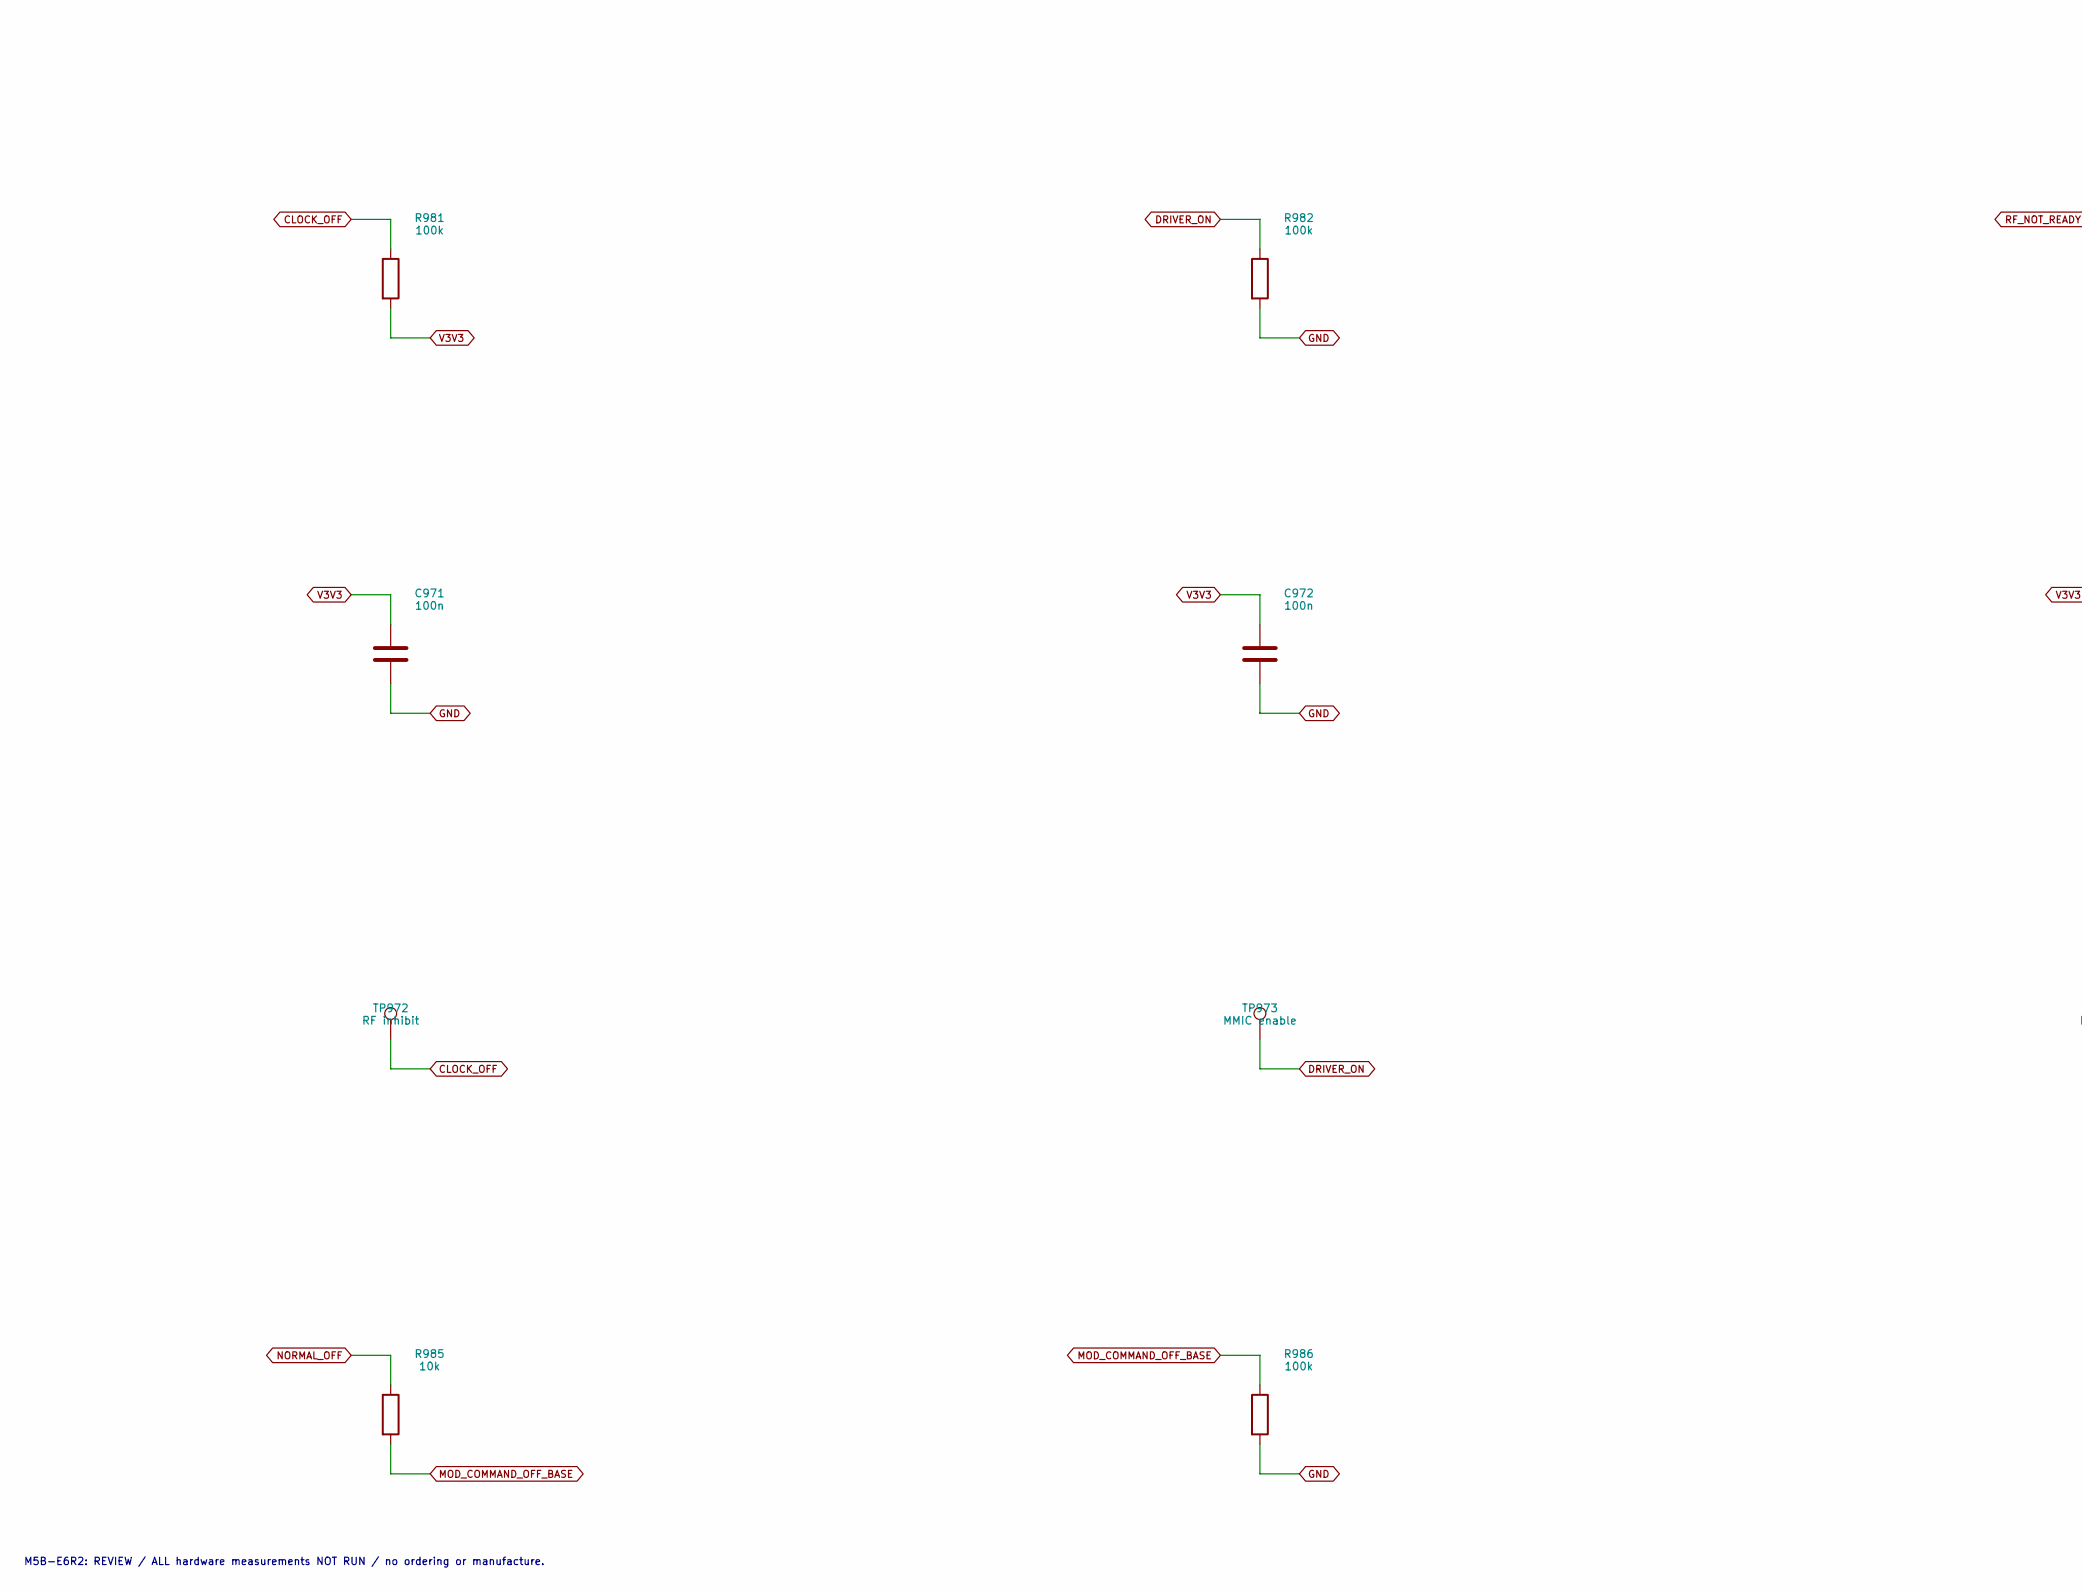
[picture p322: schematic 13_carrier_keying.kicad_sch, 13 Carrier-keyed A2A: prepared converter, drain/driver read…, part in row 2, column 1]

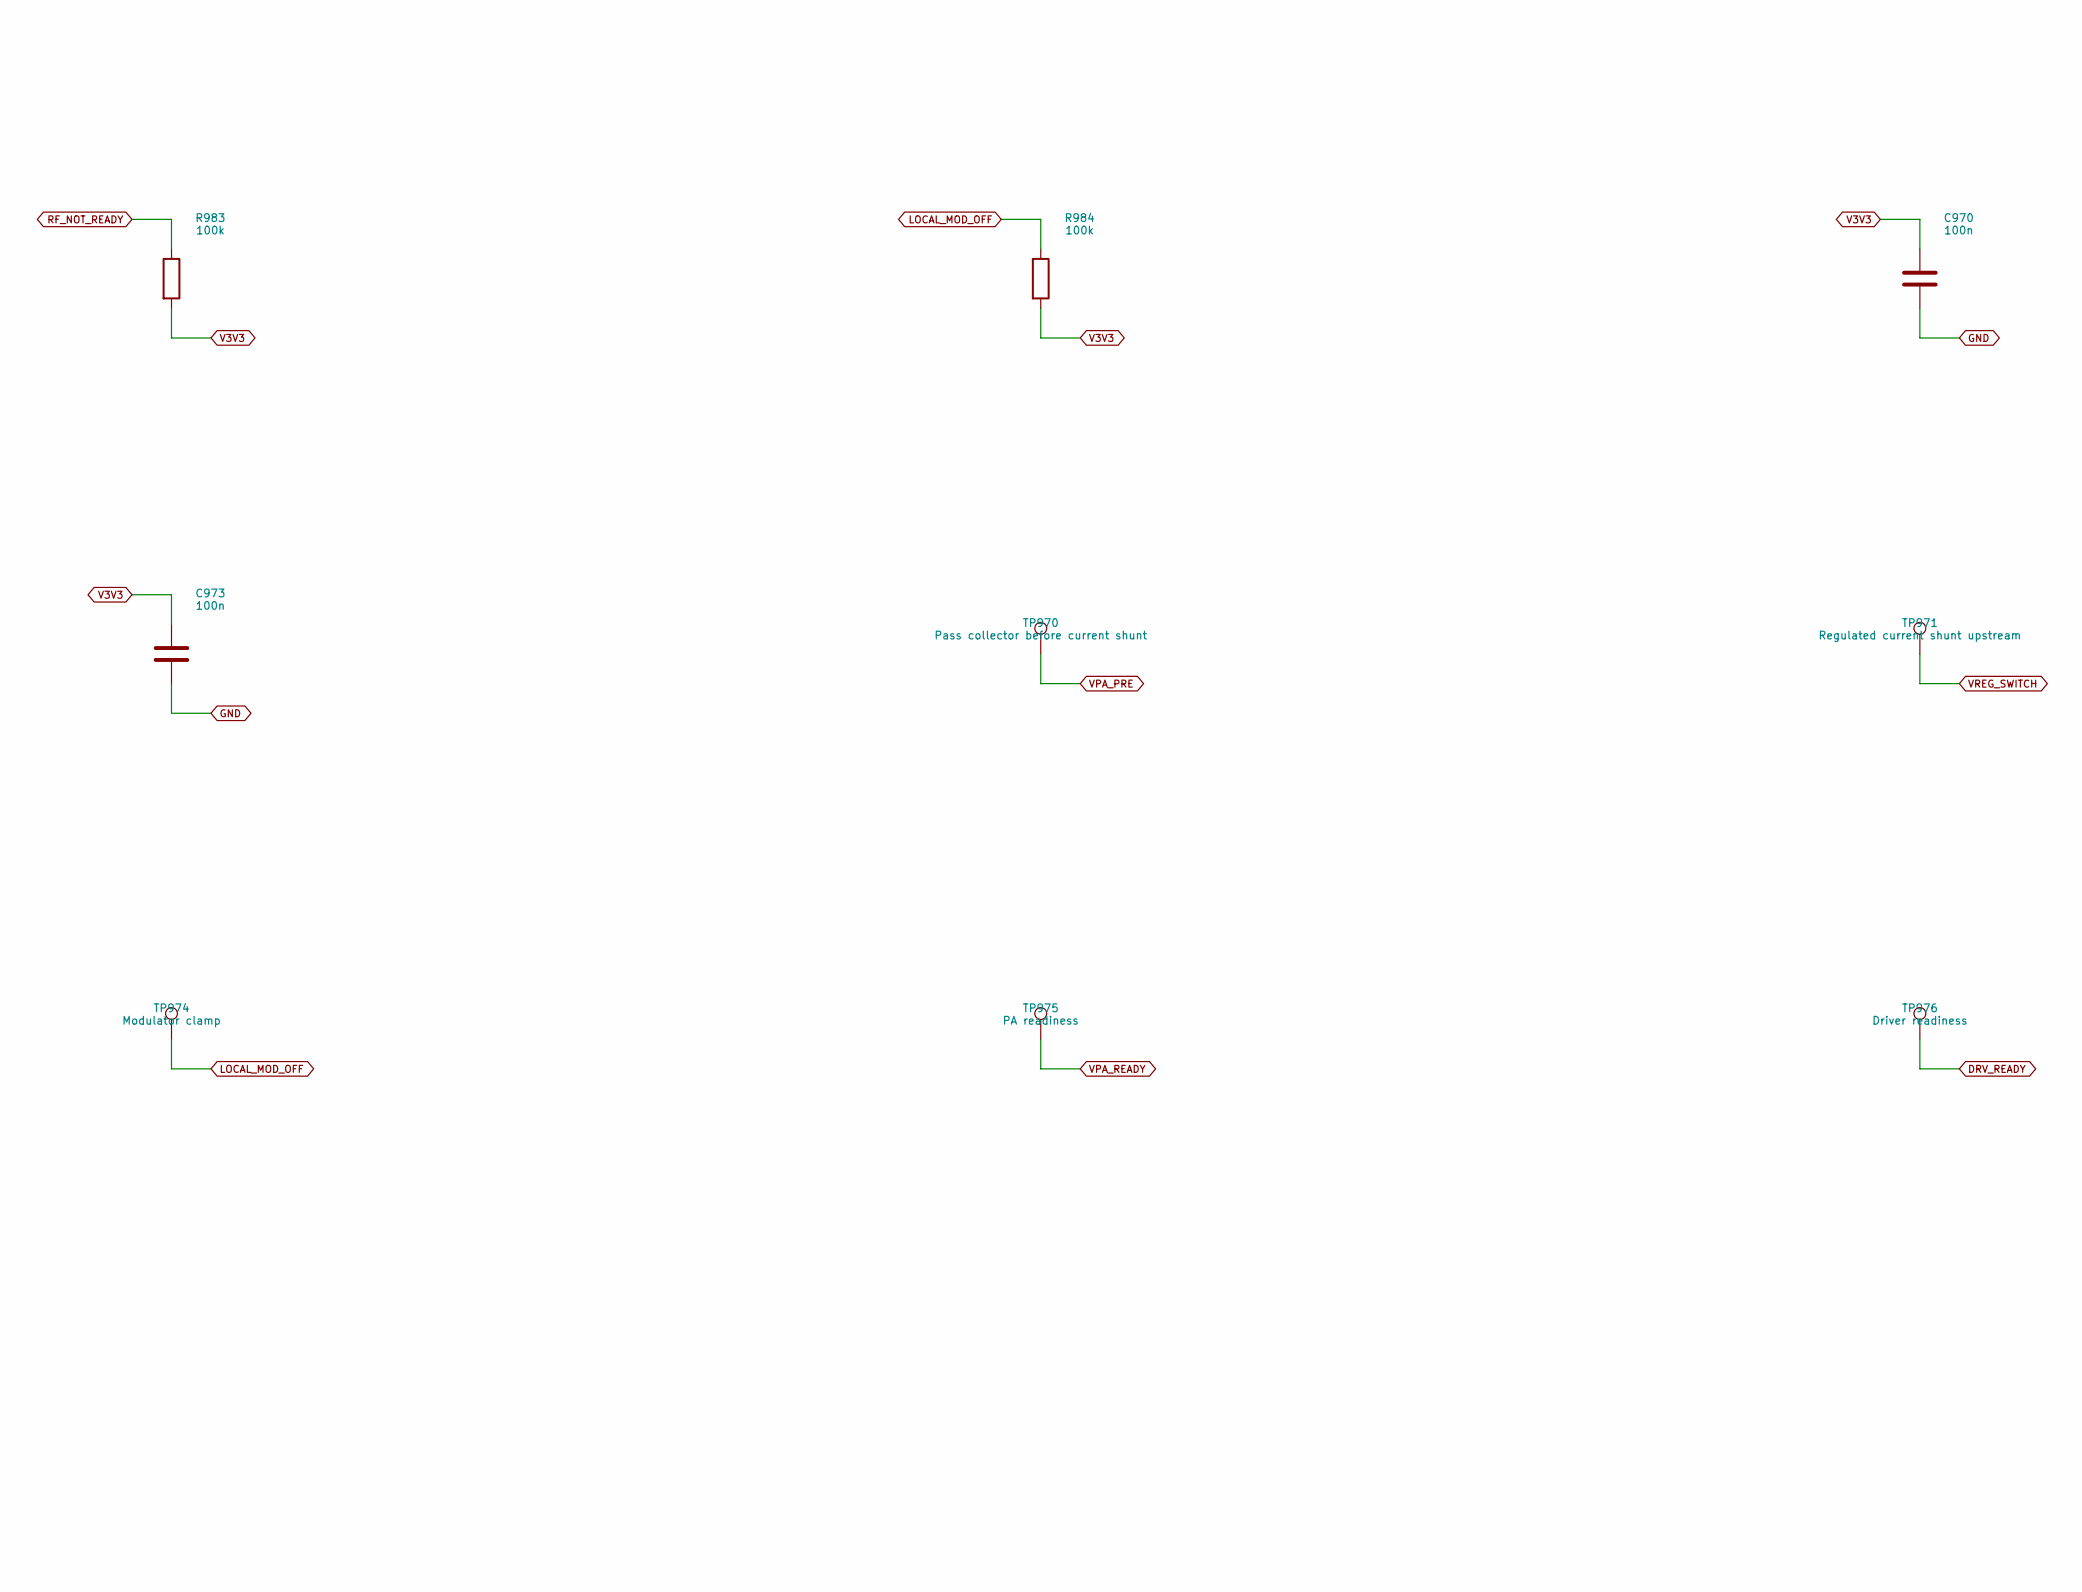
[picture p323: schematic 13_carrier_keying.kicad_sch, 13 Carrier-keyed A2A: prepared converter, drain/driver read…, part in row 2, column 2]

Parts:
C970, C971, C972, C973: 100n; C_0603_1608Metric_E3; MPN GRM188R71H104KA93D
R970: 0.05; R_2512_6332Metric_E3; MPN WSL2512R0500FEA
R971, R975, R979, R980, R981, R982, R983, R984, R986: 100k; R_0603_1608Metric_E3; MPN RT0603BRD07100KL
R972, R976: 33k; R_0603_1608Metric_E3; MPN RT0603BRD0733KL
R973: 330k; R_0603_1608Metric_E3; MPN RT0603BRD07330KL
R974: 2.49k; R_0603_1608Metric_E3; MPN RT0603BRD072K49L
R977: 19.1k; R_0603_1608Metric_E3; MPN RT0603BRD0719K1L
R978, R985: 10k; R_0603_1608Metric_E3; MPN RT0603BRD0710KL
TP970: Pass collector before current shunt; TestPoint_Pad_D1.0mm_E3; MPN PCB feature
TP971: Regulated current shunt upstream; TestPoint_Pad_D1.0mm_E3; MPN PCB feature
TP972: RF inhibit; TestPoint_Pad_D1.0mm_E3; MPN PCB feature
TP973: MMIC enable; TestPoint_Pad_D1.0mm_E3; MPN PCB feature
TP974: Modulator clamp; TestPoint_Pad_D1.0mm_E3; MPN PCB feature
TP975: PA readiness; TestPoint_Pad_D1.0mm_E3; MPN PCB feature
TP976: Driver readiness; TestPoint_Pad_D1.0mm_E3; MPN PCB feature
U970: TLV7032DGKR; TLV7032_DGK_E6R2; MPN TLV7032DGKR
U971: SN74LVC1G00DBVR; LVC1G00_DBV_E6R2; MPN SN74LVC1G00DBVR
U972: SN74LVC2G32DCTR; LVC2G32_DCT_E6R2; MPN SN74LVC2G32DCTR
U973: SN74LVC1G04DBVR; LVC1G04_DBV_E6R2; MPN SN74LVC1G04DBVR

Connections:
CLOCK_OFF: R981.1, TP972.1, U972.3 (2Y); also elsewhere on the board
DRIVER_ON: R982.1, TP973.1, U973.4 (Y); also elsewhere on the board
DRV_READY: R980.1, TP976.1, U970.7 (OUTB), U971.2 (B)
DRV_READY_REF: R977.2, R978.1, U970.6 (INB-)
DRV_READY_S: R975.2, R976.1, U970.5 (INB+)
GND: C970.2, C971.2, C972.2, C973.2, R972.2, R974.2, R976.2, R978.2, R979.2, R980.2, R982.2, R986.2, U970.4 (GND), U971.3 (GND), U972.4 (GND), U973.3 (GND); also elsewhere on the board
KEY_N: U972.2 (1B); also elsewhere on the board
LOCAL_MOD_OFF: R984.1, TP974.1, U972.5 (2A), U972.7 (1Y), U973.2 (A); also elsewhere on the board
MOD_COMMAND_OFF_BASE: R985.2, R986.1; also elsewhere on the board
NORMAL_OFF: R985.1, U972.1 (1A); also elsewhere on the board
RF_NOT_READY: R983.1, U971.4 (Y), U972.6 (2B)
V3V3: C970.1, C971.1, C972.1, C973.1, R973.1, R977.1, R981.2, R983.2, R984.2, U970.8 (VCC), U971.5 (VCC), U972.8 (VCC), U973.5 (VCC); also elsewhere on the board
VDRV_MMIC: R975.1; also elsewhere on the board
VPA: R970.2, R971.1; also elsewhere on the board
VPA_PRE: R970.1, TP970.1; also elsewhere on the board
VPA_READY: R979.1, TP975.1, U970.1 (OUTA), U971.1 (A)
VPA_READY_REF: R973.2, R974.1, U970.2 (INA-)
VPA_READY_S: R971.2, R972.1, U970.3 (INA+)
VREG_SWITCH: TP971.1; also elsewhere on the board

Notes on the sheet:
13 Carrier-keyed A2A: prepared converter, drain/driver readiness and probes
Architecture C: LOCAL_MOD_OFF=NORMAL_OFF OR KEY_N; DRIVER_ON=NOT LOCAL_MOD_OFF. CLOCK_OFF=LOCAL_MOD_OFF OR NOT(VPA_READY AND DRV_READY). Native safety delay/fastkill remain in series. AF_PWM must provide shaped sine envelope; KEY gives preparation lead. No converter re-start per Morse element. Exis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
M5B-E6R2: REVIEW / ALL hardware measurements NOT RUN / no ordering or manufacture.
Carrier keying

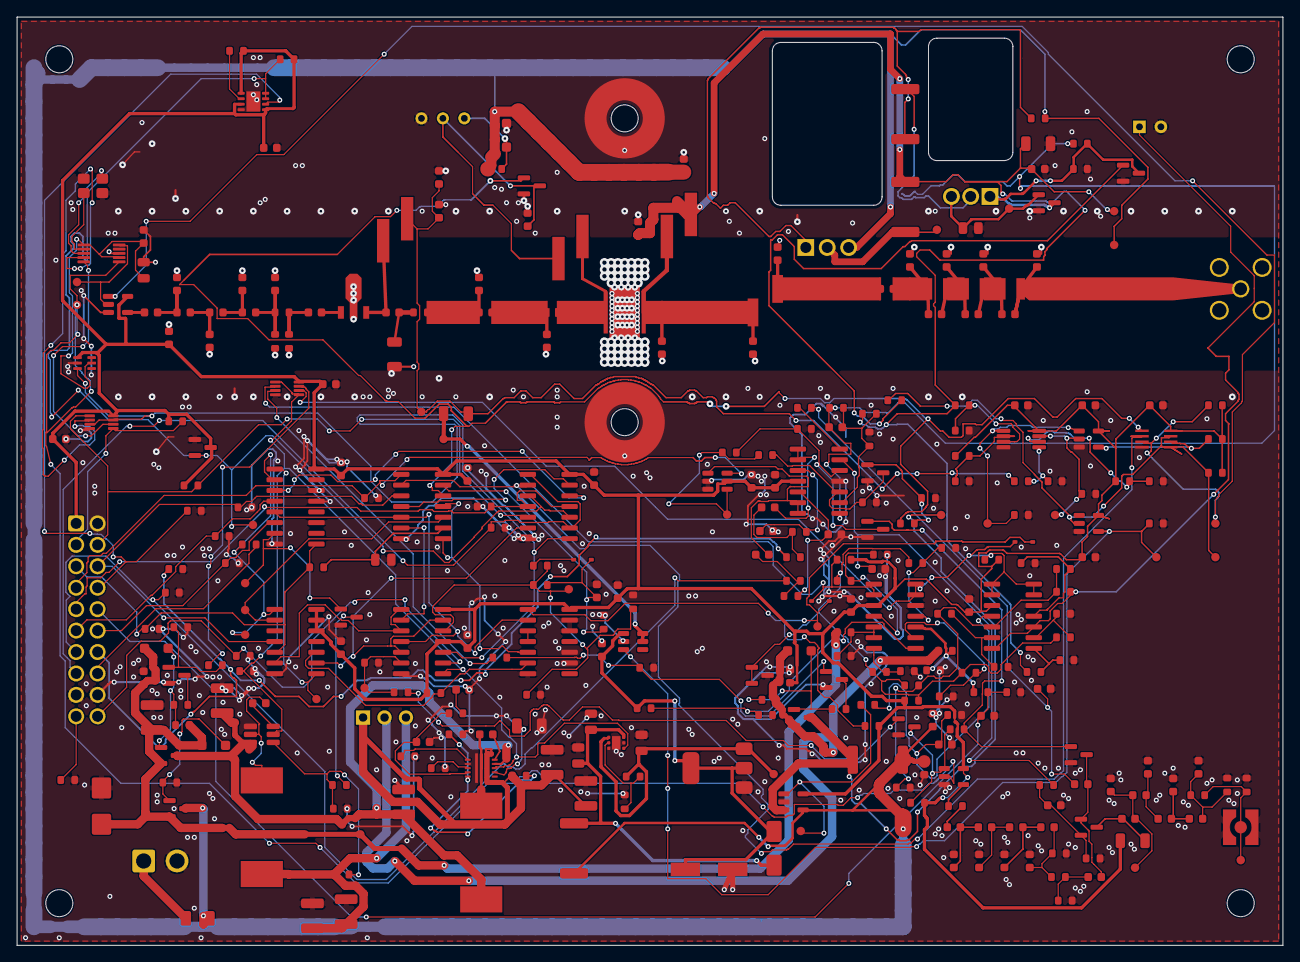
[picture p324: board RF2M.kicad_pcb from above]

Board: 2 copper layers, 150.0 x 110.0 mm, 358 parts (0 on the bottom side), 181 nets.

Other parts of the board:
H1, H2, H3, H4, H5, H6: MountingHole_3.2mm_M3; MountingHole_3.2mm_M3_E3
