DD1SB/ARDF-TX/hardware/controller/CTRL.kicad_pcb

## KiCad design hardware/controller/CTRL.kicad_pcb (2026-10-20)

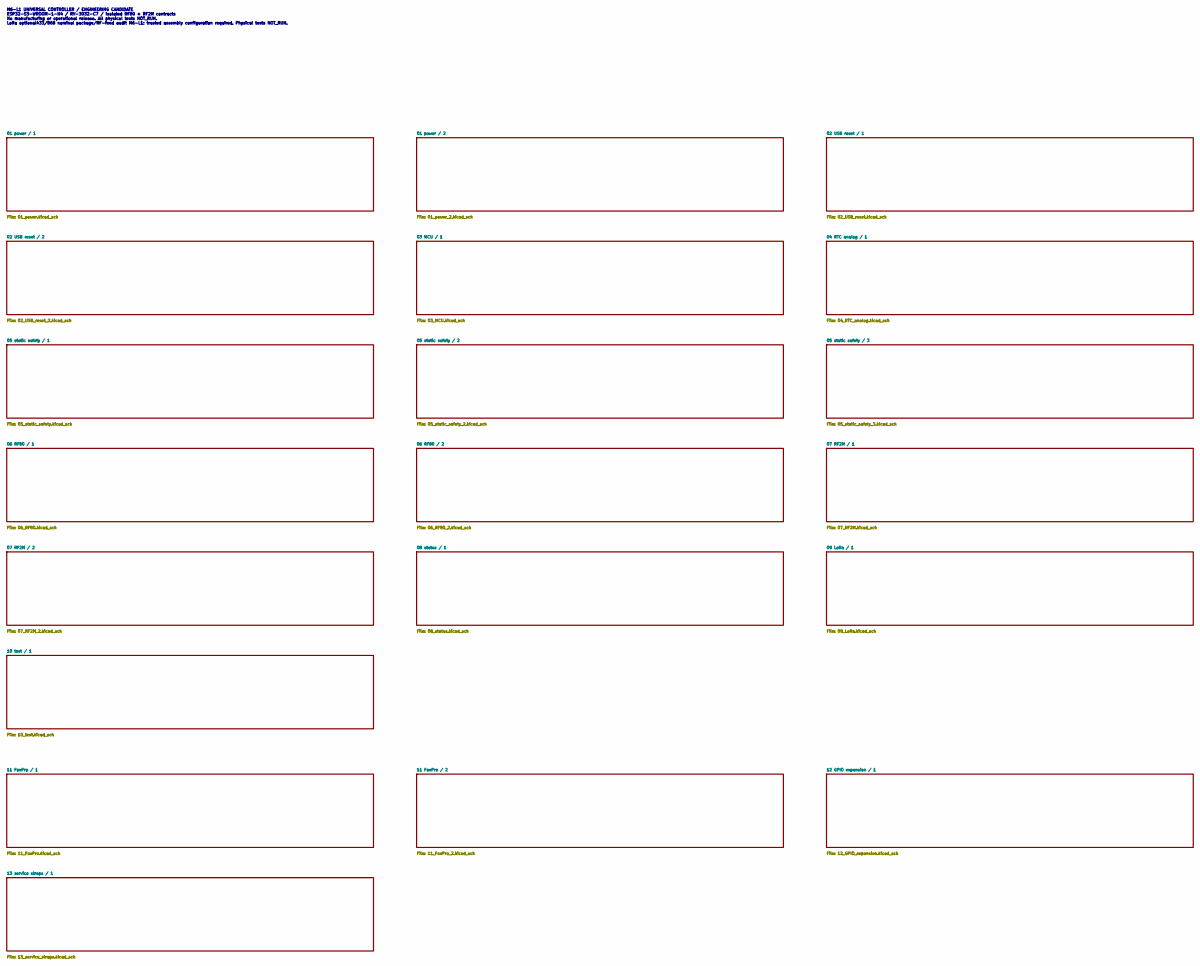
[picture p325: schematic CTRL.kicad_sch, ARDF-TX universal ESP32-S3 controller]

Notes on the sheet:
M6-L1 UNIVERSAL CONTROLLER / ENGINEERING CANDIDATE ESP32-S3-WROOM-1-N4 / RV-3032-C7 / isolated RF80 + RF2M contracts No manufacturing or operational release. All physical tests NOT_RUN. LoRa optional433/868 nominal package/RF-feed audit M6-L1; trusted assembly configuration required. Physical tests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
