DD1SB/ARDF-TX/hardware/controller/CTRL.kicad_pcb

## KiCad design hardware/controller/CTRL.kicad_pcb (continued)

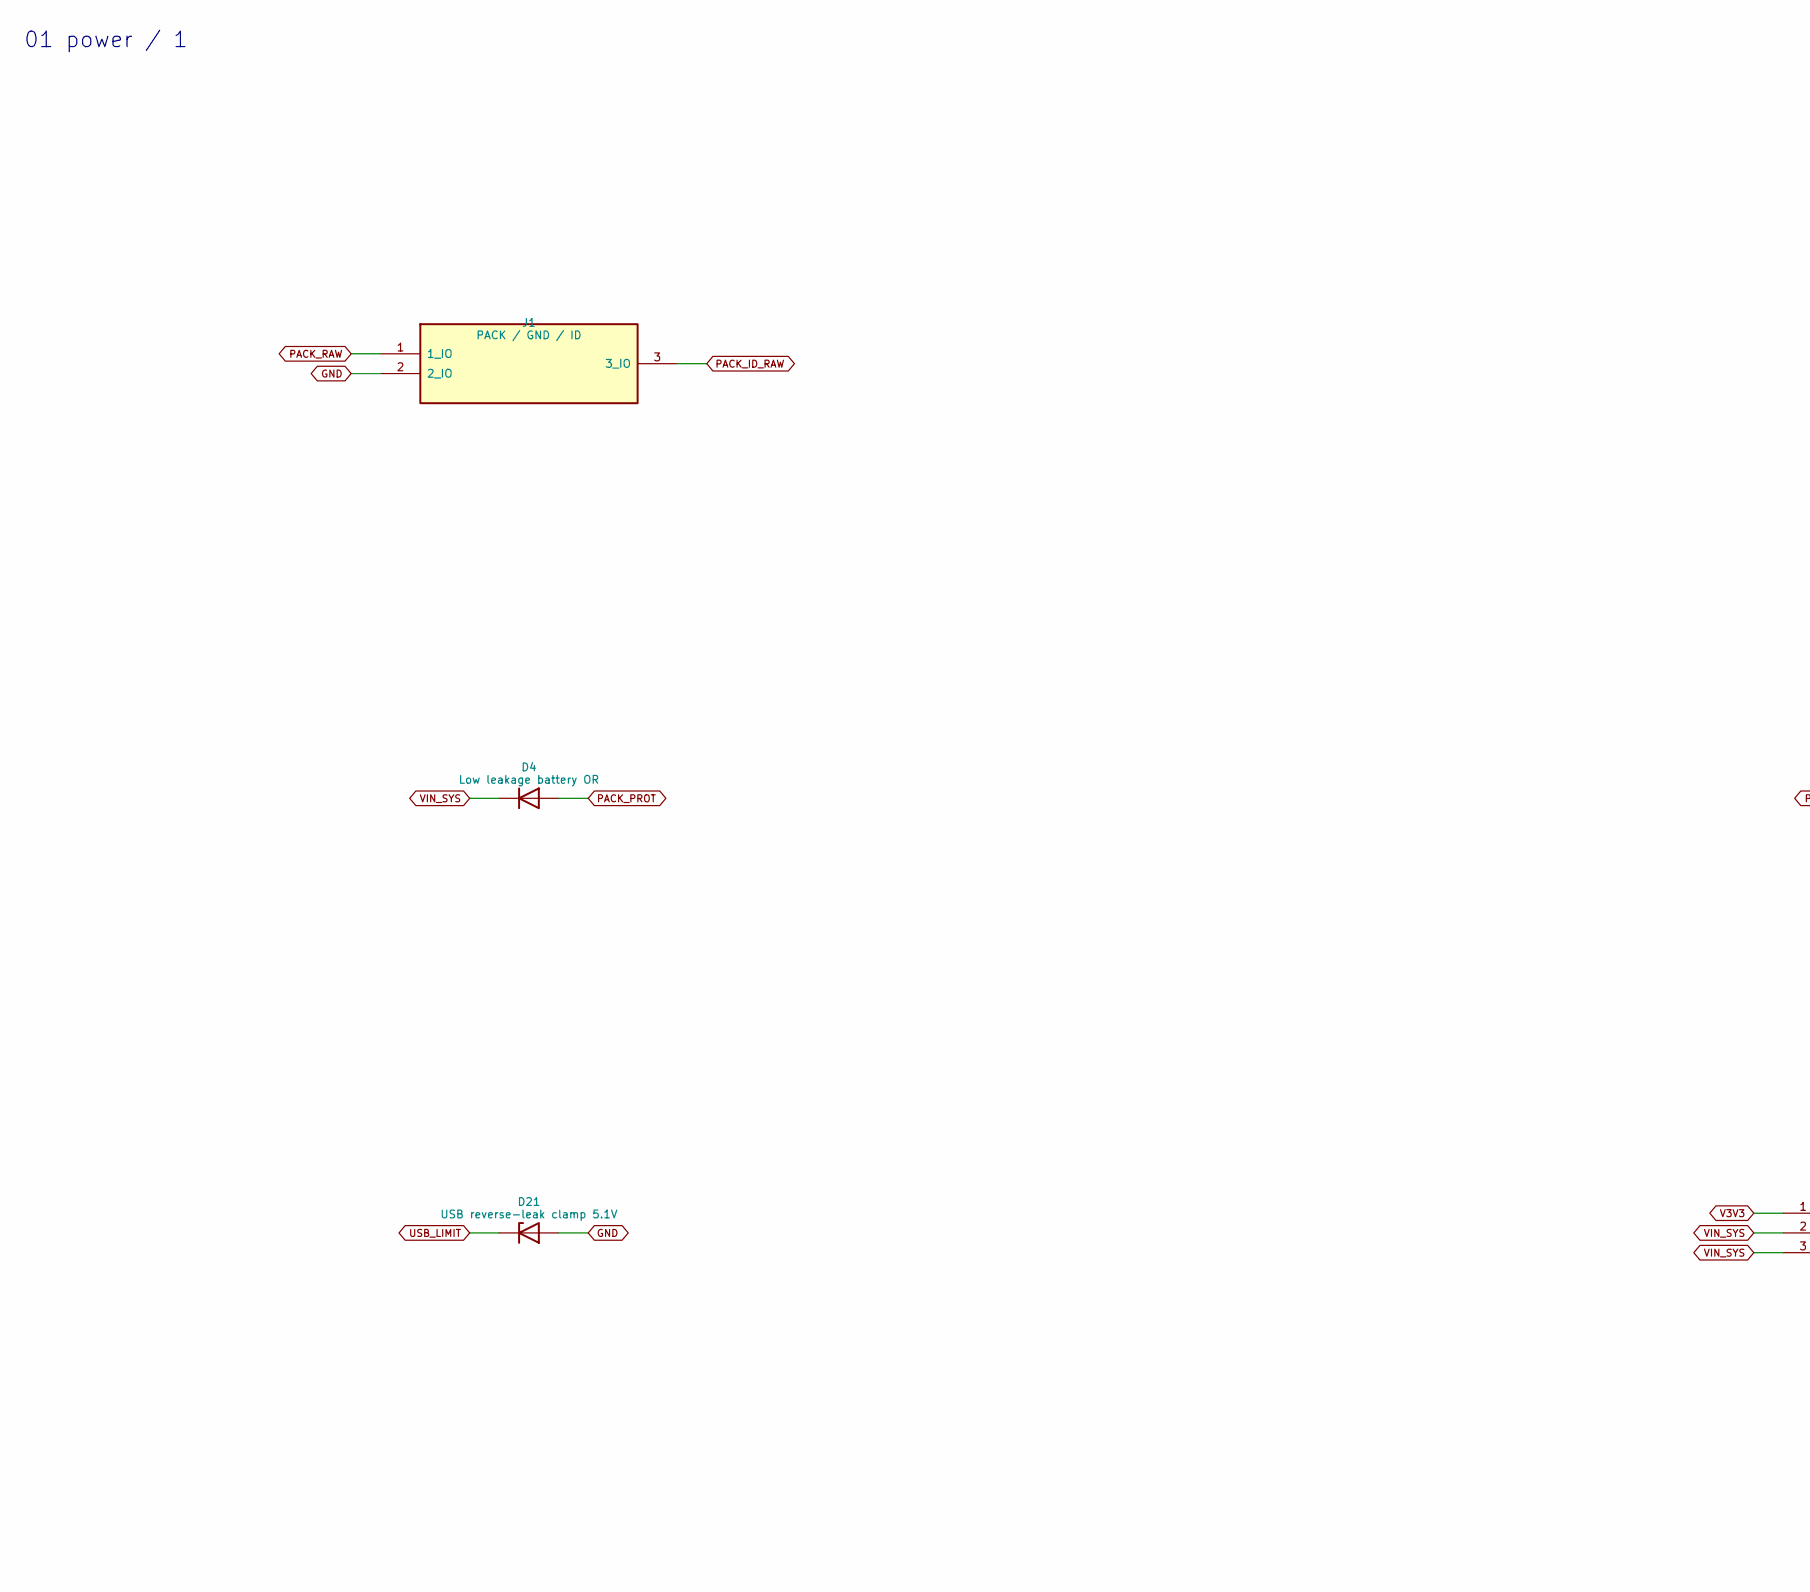
[picture p326: schematic 01_power.kicad_sch, 01 power / 1, part in row 1, column 1]

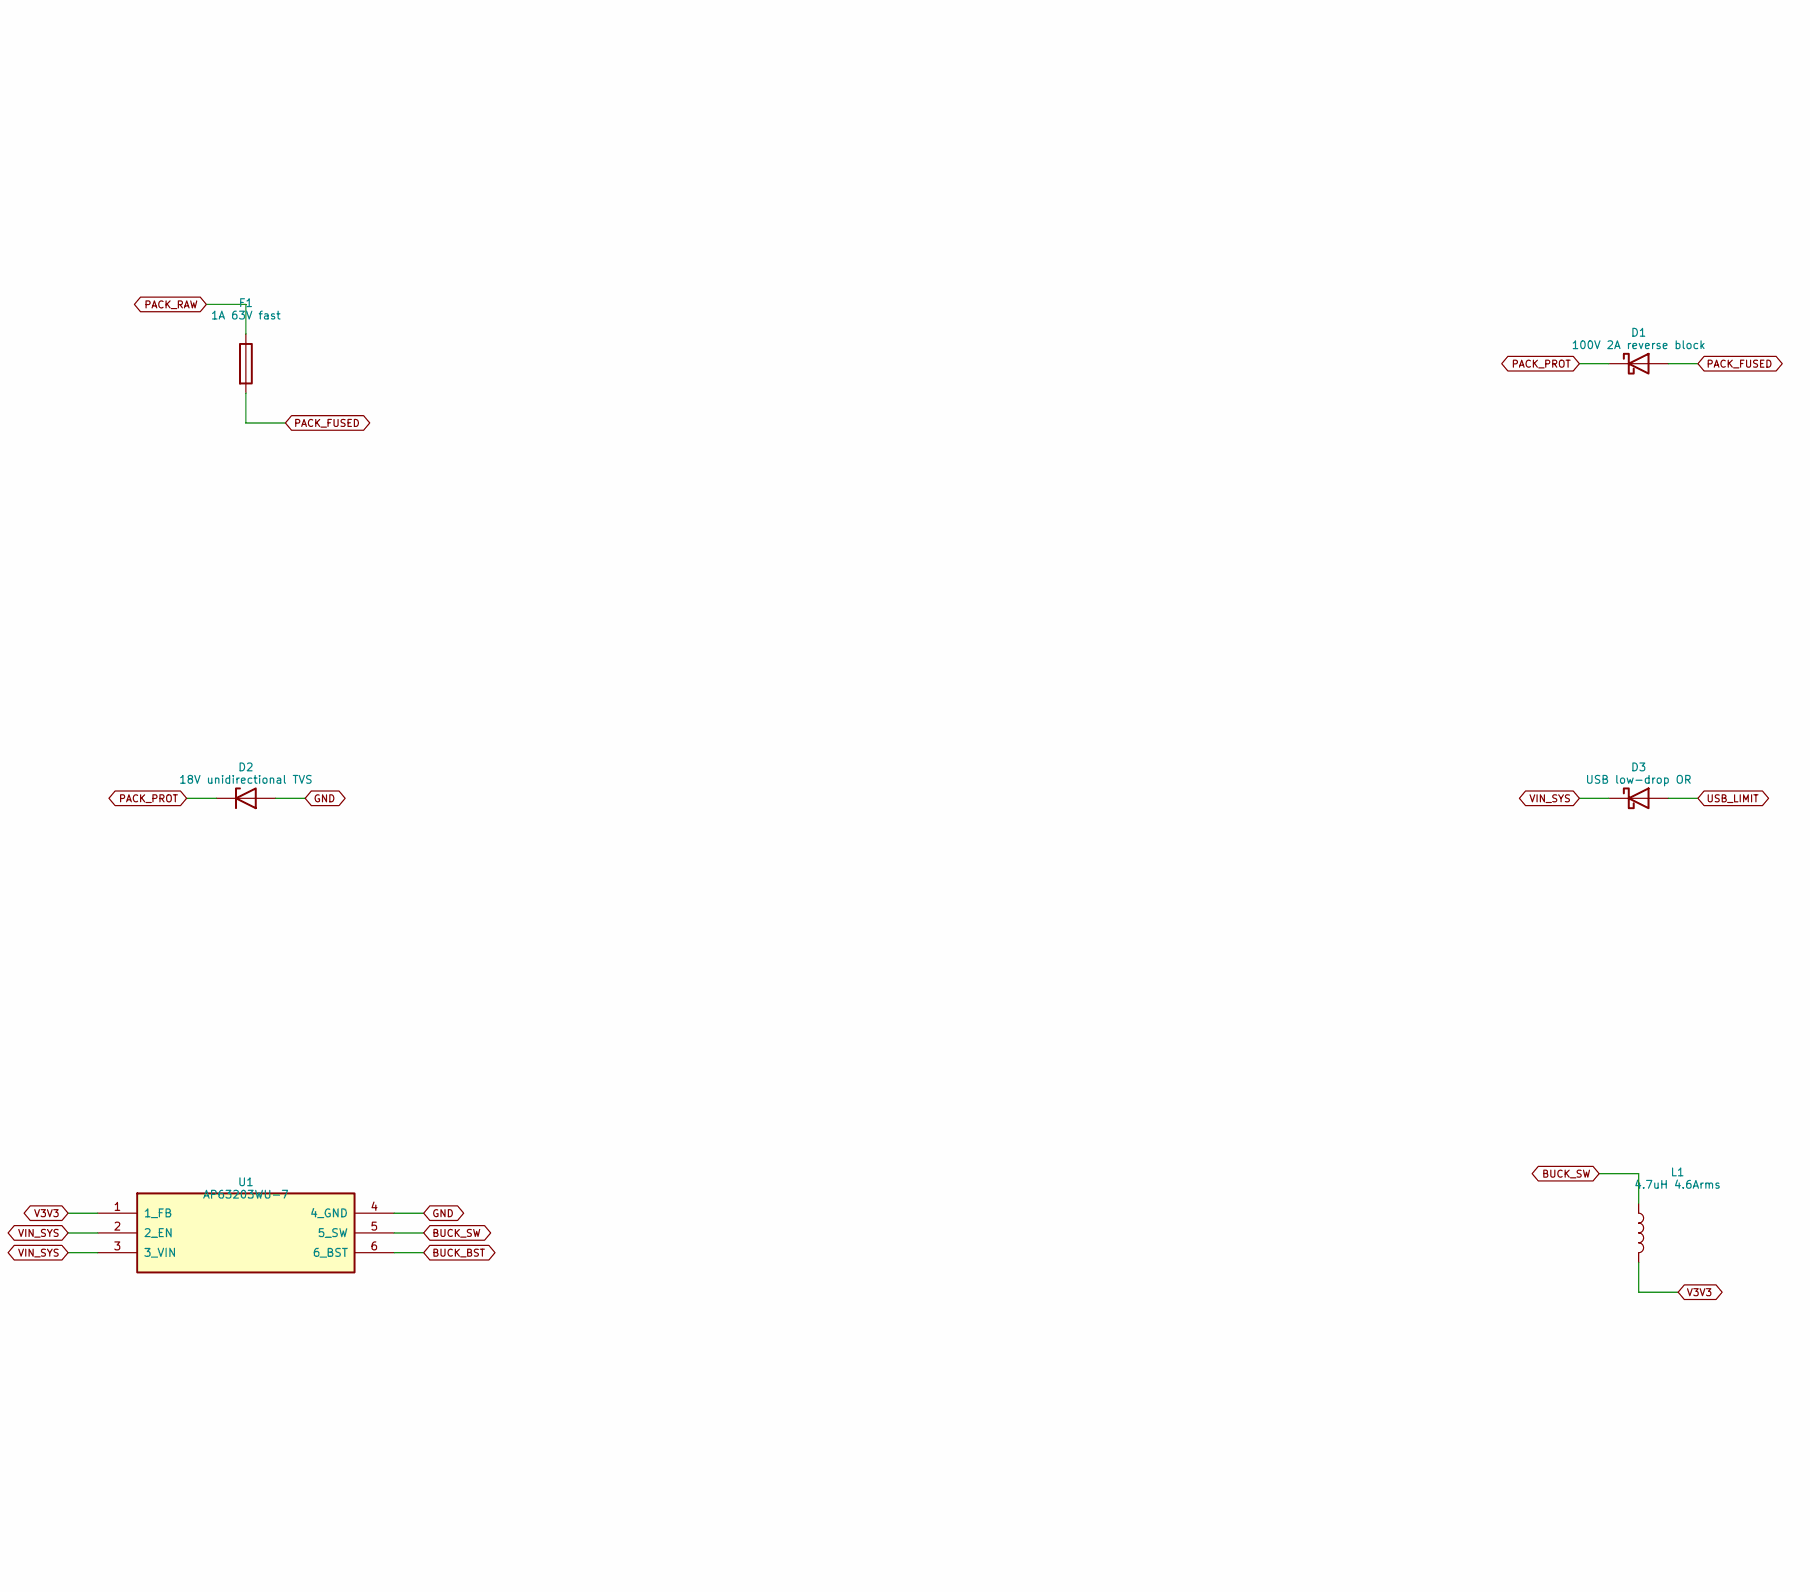
[picture p327: schematic 01_power.kicad_sch, 01 power / 1, part in row 1, column 2]

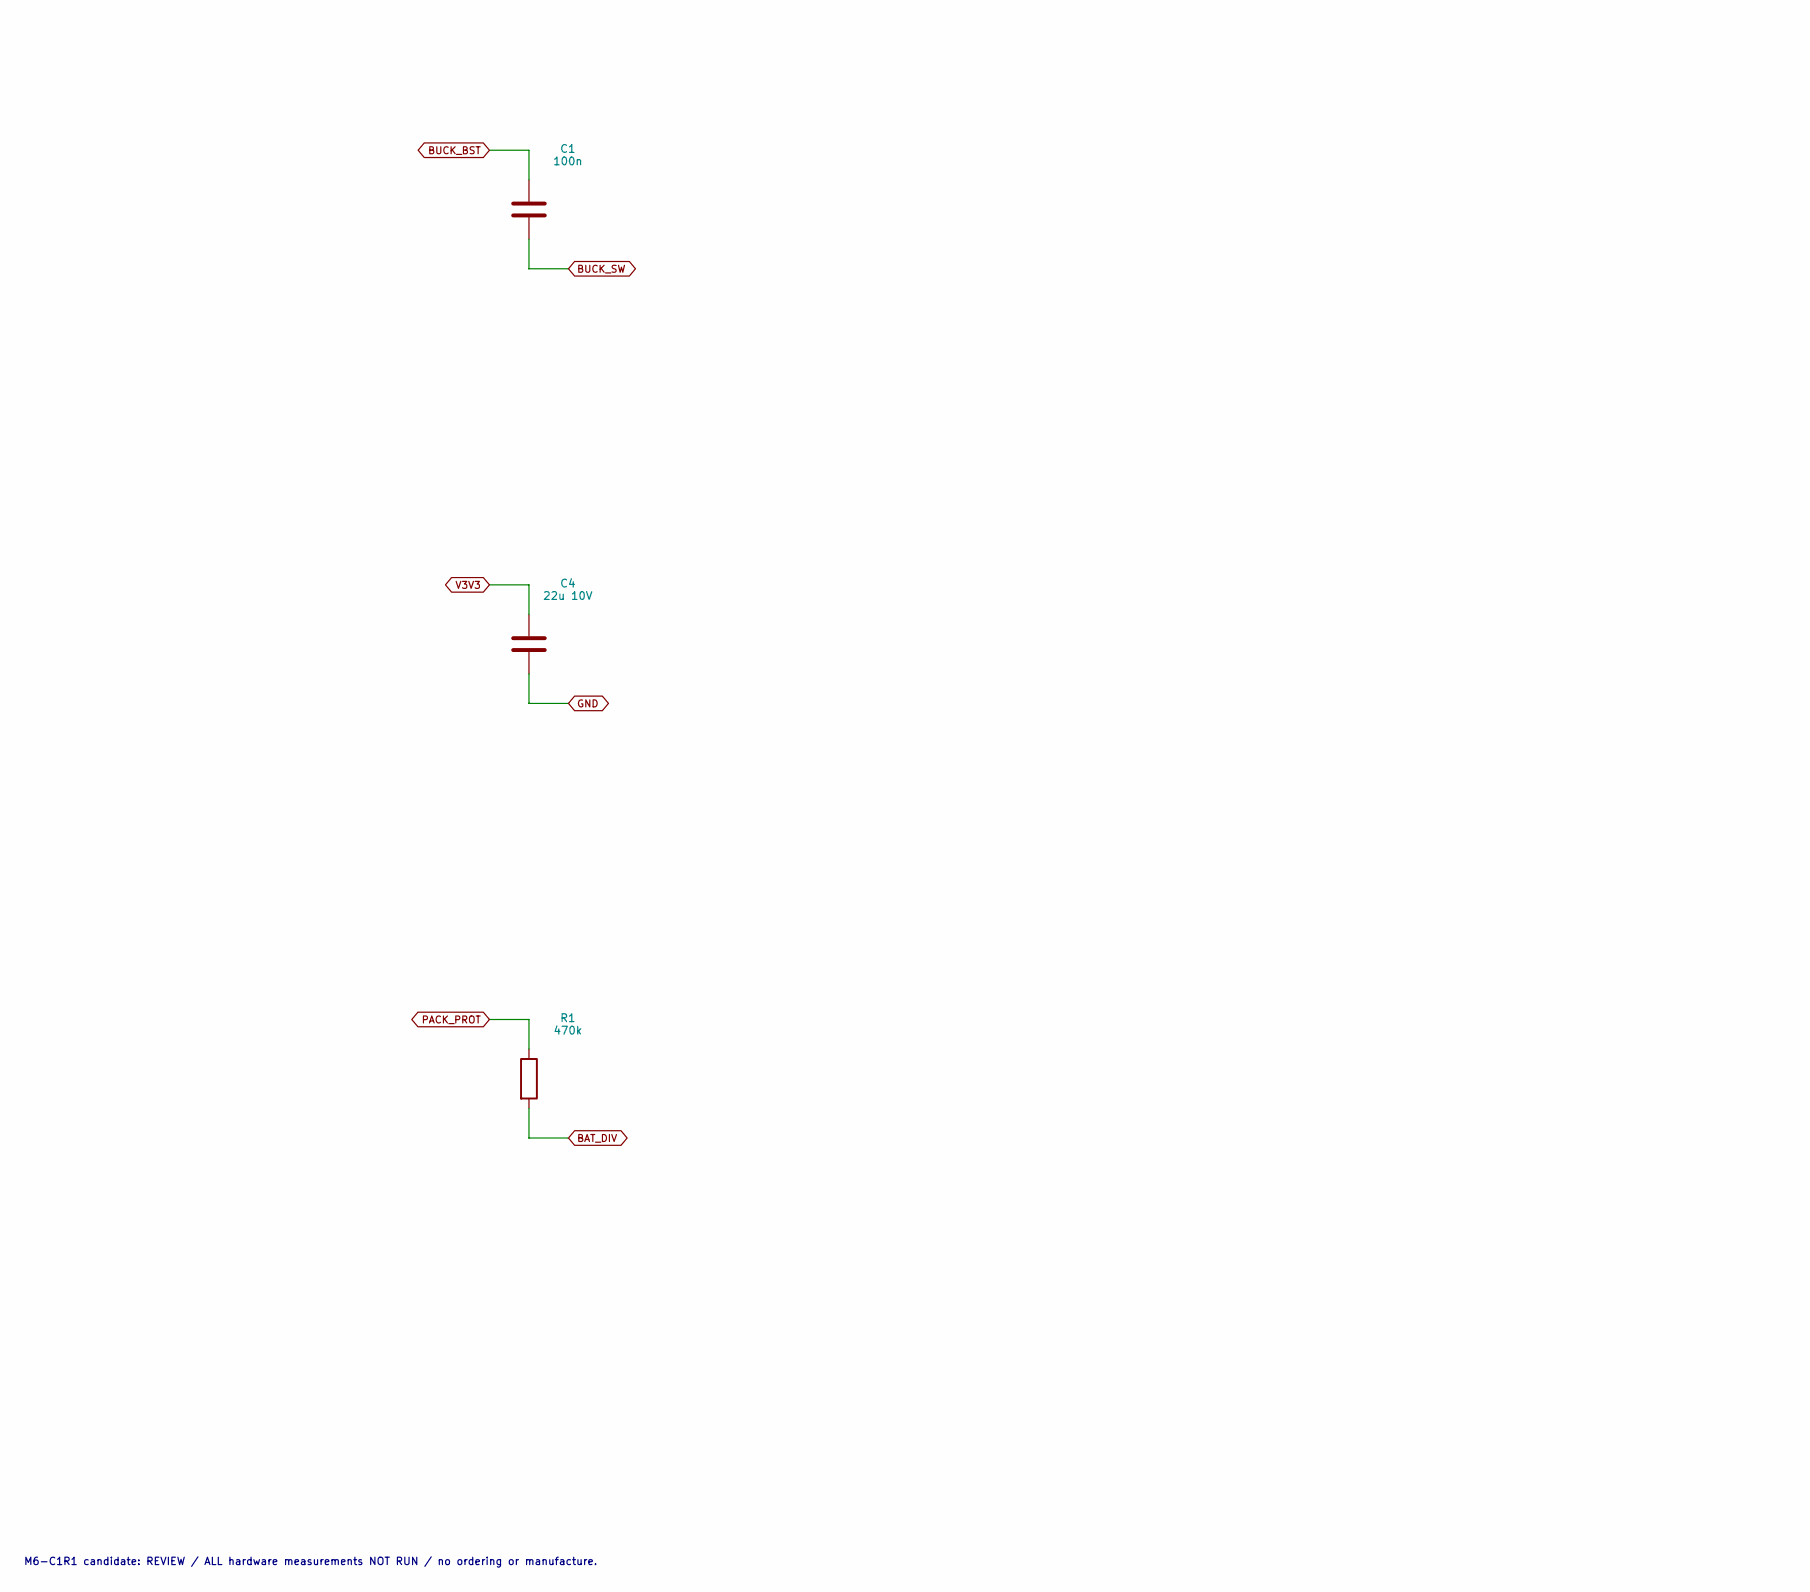
[picture p328: schematic 01_power.kicad_sch, 01 power / 1, part in row 2, column 1]

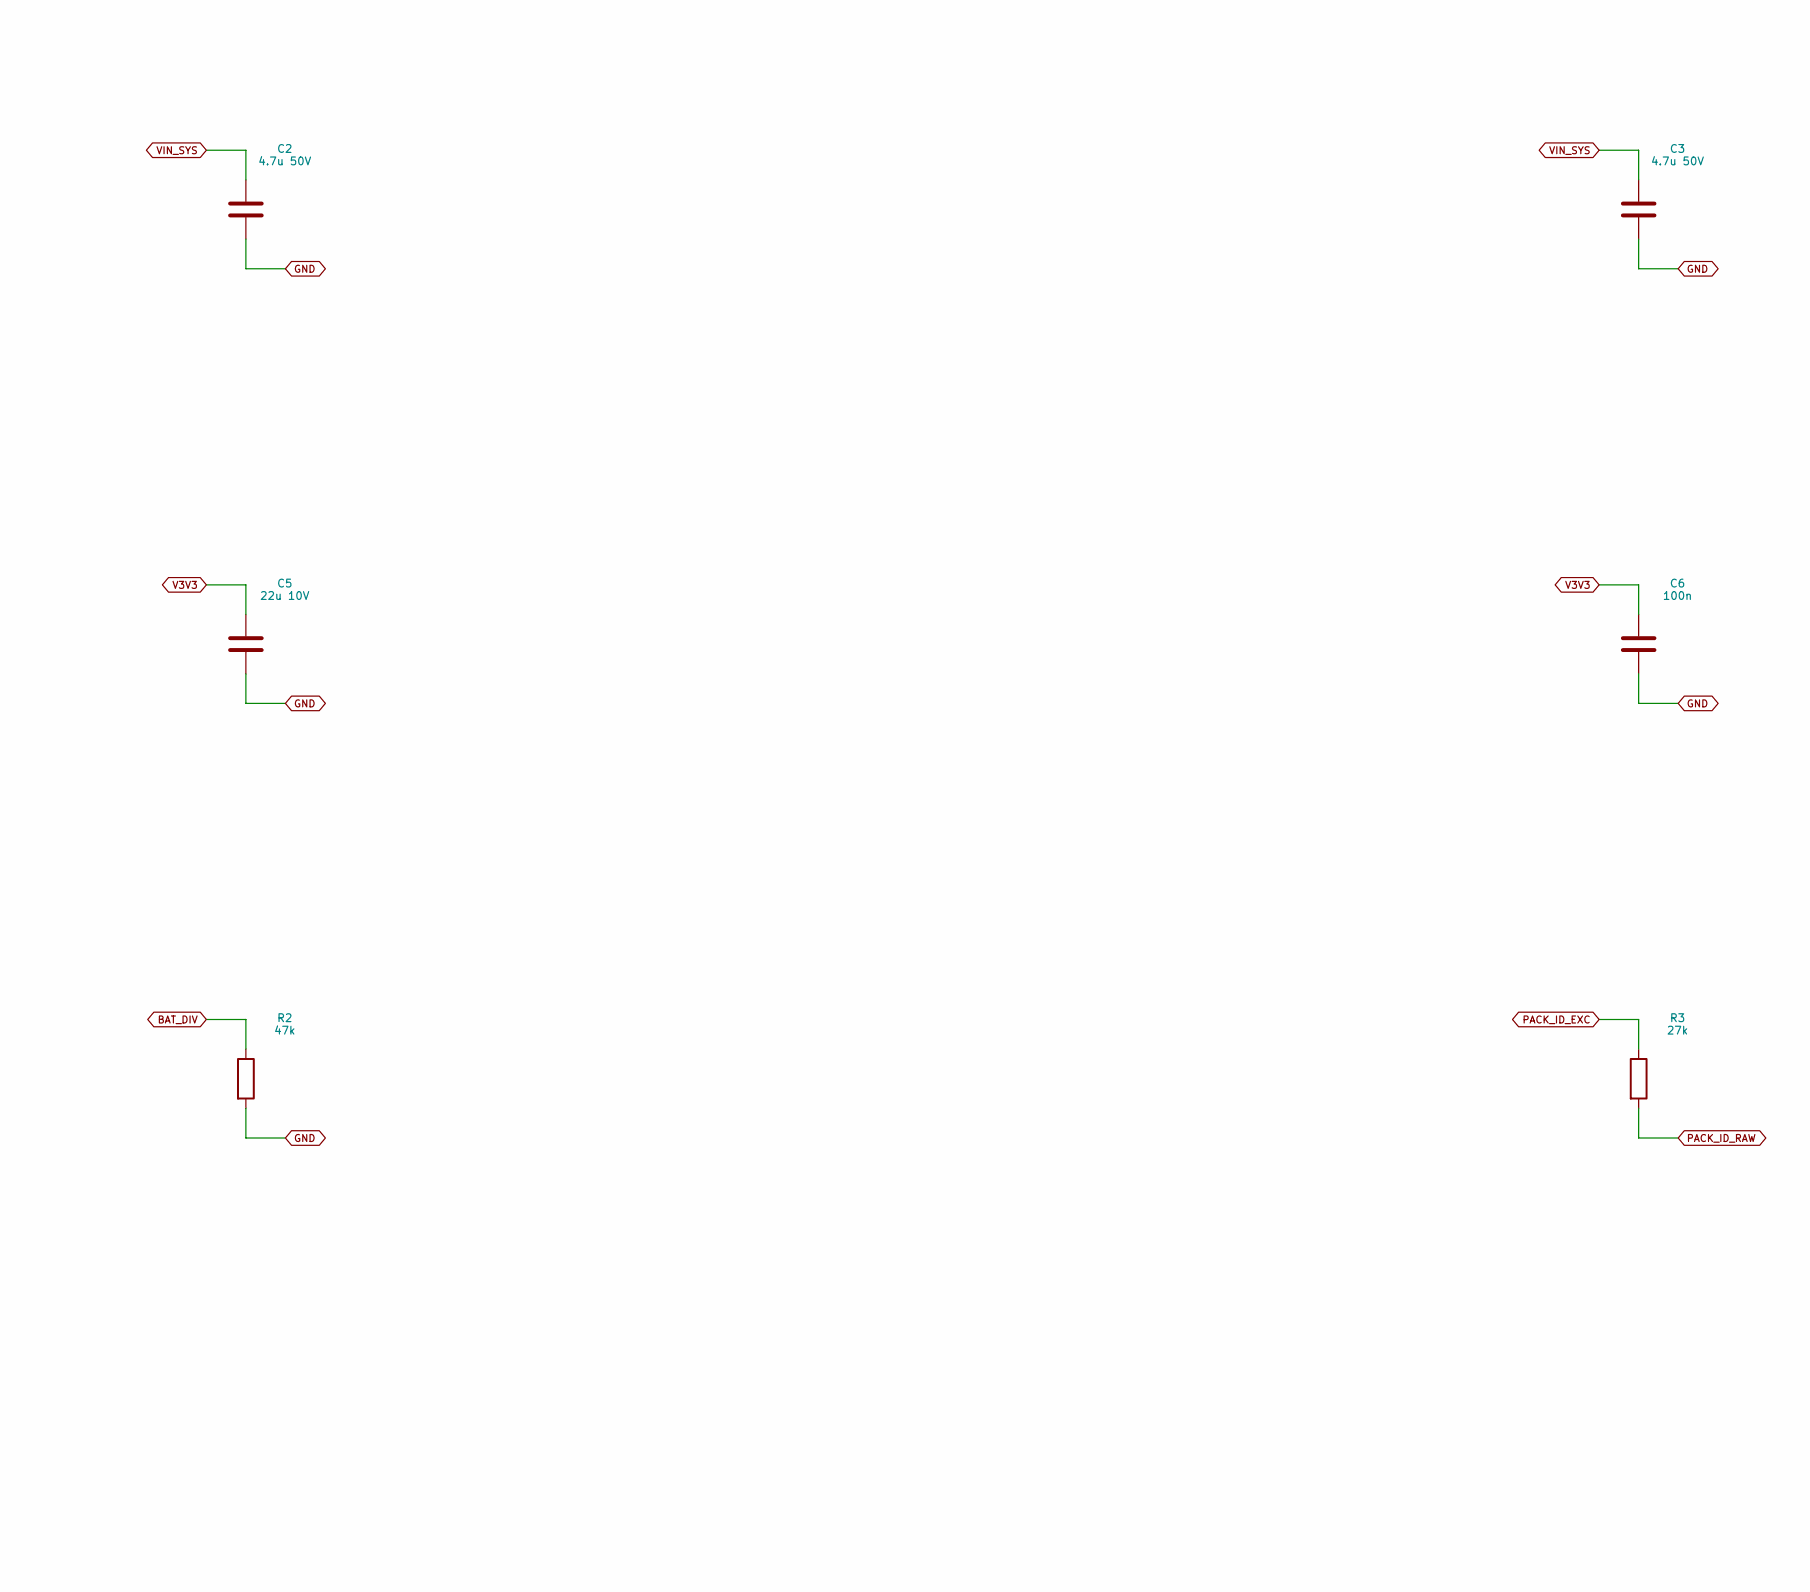
[picture p329: schematic 01_power.kicad_sch, 01 power / 1, part in row 2, column 2]

Parts:
C1, C6: 100n; C_0603_1608Metric_CTL; MPN CL10B104KB8NNNC
C2, C3: 4.7u 50V; C_1210_3225Metric_CTL; MPN GRM32ER71H475KA88L
C4, C5: 22u 10V; C_1206_3216Metric_CTL; MPN CL31A226KPHNNNE
D1: 100V 2A reverse block; D_SMA_CTL; MPN STPS2H100A
D2: 18V unidirectional TVS; D_SMB_CTL; MPN SMBJ18A
D3: USB low-drop OR; D_SMA_CTL; MPN STPS1L30A
D4: Low leakage battery OR; D_SMA_CTL; MPN S1M-E3/61T
D21: USB reverse-leak clamp 5.1V; D_SOD-123F_CTL; MPN BZT52H-B5V1,115
F1: 1A 63V fast; Fuse_Bourns_SF1206F; MPN SF-1206F100-2
J1: PACK / GND / ID; JST_XH_B3B_Standard; MPN B3B-XH-A(LF)(SN)
L1: 4.7uH 4.6Arms; L_Bourns_SRP5030T_CTL; MPN SRP5030T-4R7M
R1: 470k; R_0603_1608Metric_CTL; MPN RC0603FR-07470KL
R2: 47k; R_0603_1608Metric_CTL; MPN RC0603FR-0747KL
R3: 27k; R_0603_1608Metric_CTL; MPN RC0603FR-0727KL
U1: AP63203WU-7; TSOT-23-6_CTL; MPN AP63203WU-7

Connections:
BAT_DIV: R1.2, R2.1; also elsewhere on the board
BUCK_BST: C1.1, U1.6 (6_BST)
BUCK_SW: C1.2, L1.1, U1.5 (5_SW)
GND: C2.2, C3.2, C4.2, C5.2, C6.2, D2.2 (A), D21.2 (A), J1.2 (2_IO), R2.2, U1.4 (4_GND); also elsewhere on the board
PACK_FUSED: D1.2 (A), F1.2
PACK_ID_EXC: R3.1; also elsewhere on the board
PACK_ID_RAW: J1.3 (3_IO), R3.2; also elsewhere on the board
PACK_PROT: D1.1 (K), D2.1 (K), D4.2 (A), R1.1; also elsewhere on the board
PACK_RAW: F1.1, J1.1 (1_IO)
USB_LIMIT: D3.2 (A), D21.1 (K); also elsewhere on the board
V3V3: C4.1, C5.1, C6.1, L1.2, U1.1 (1_FB); also elsewhere on the board
VIN_SYS: C2.1, C3.1, D3.1 (K), D4.1 (K), U1.2 (2_EN), U1.3 (3_VIN); also elsewhere on the board

Notes on the sheet:
01 power / 1
M6-C1R1 candidate: REVIEW / ALL hardware measurements NOT RUN / no ordering or manufacture.

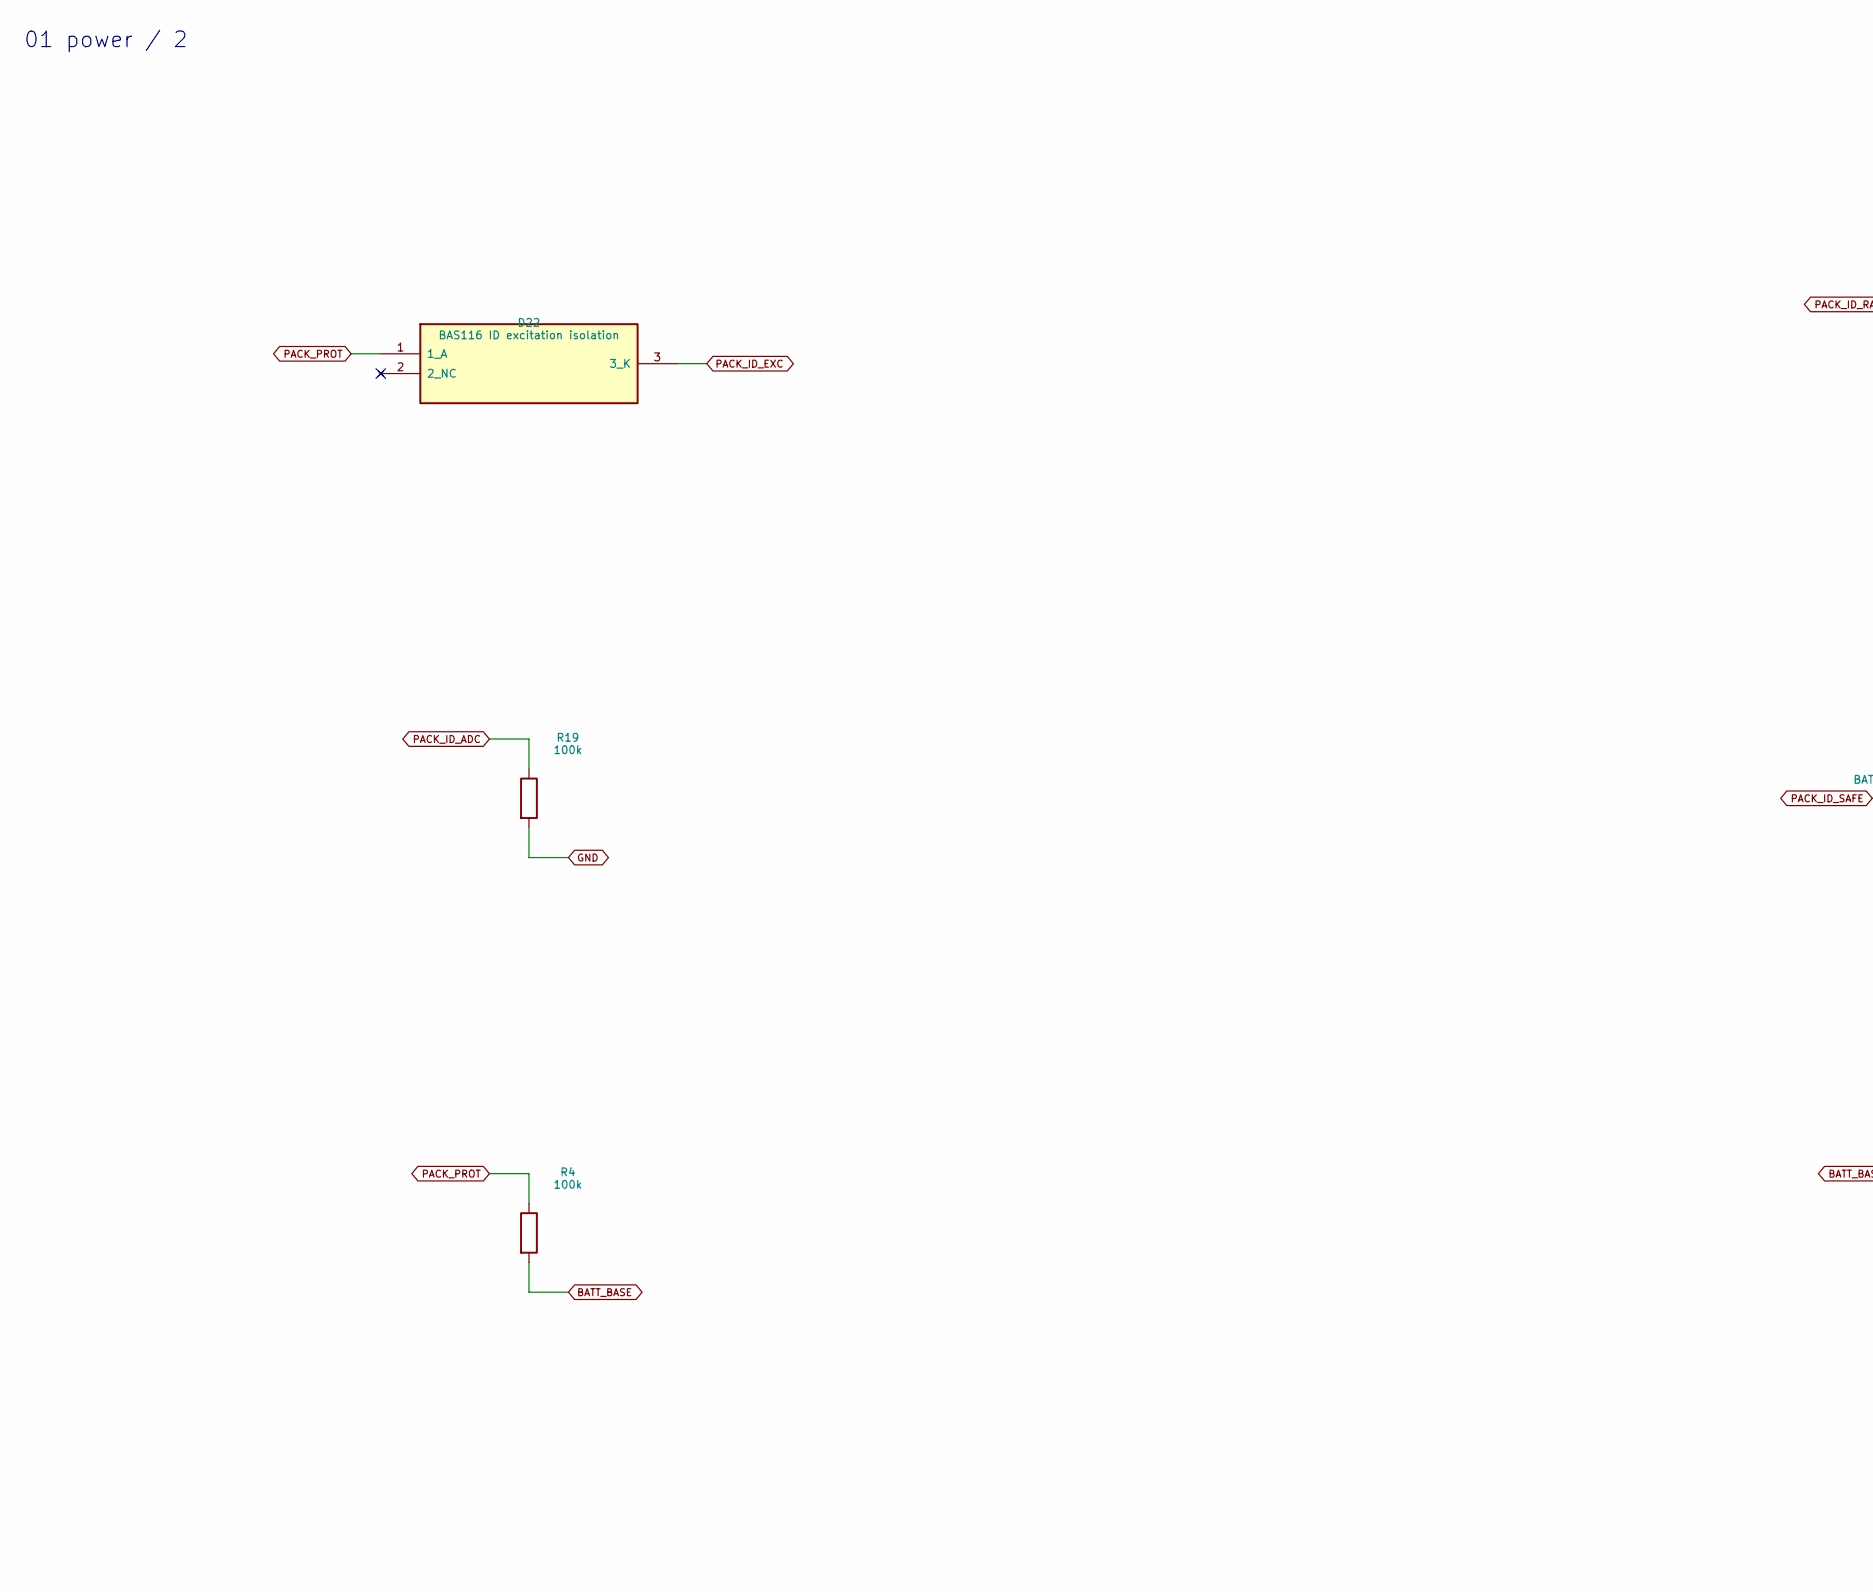
[picture p330: schematic 01_power_2.kicad_sch, 01 power / 2, part in row 1, column 1]

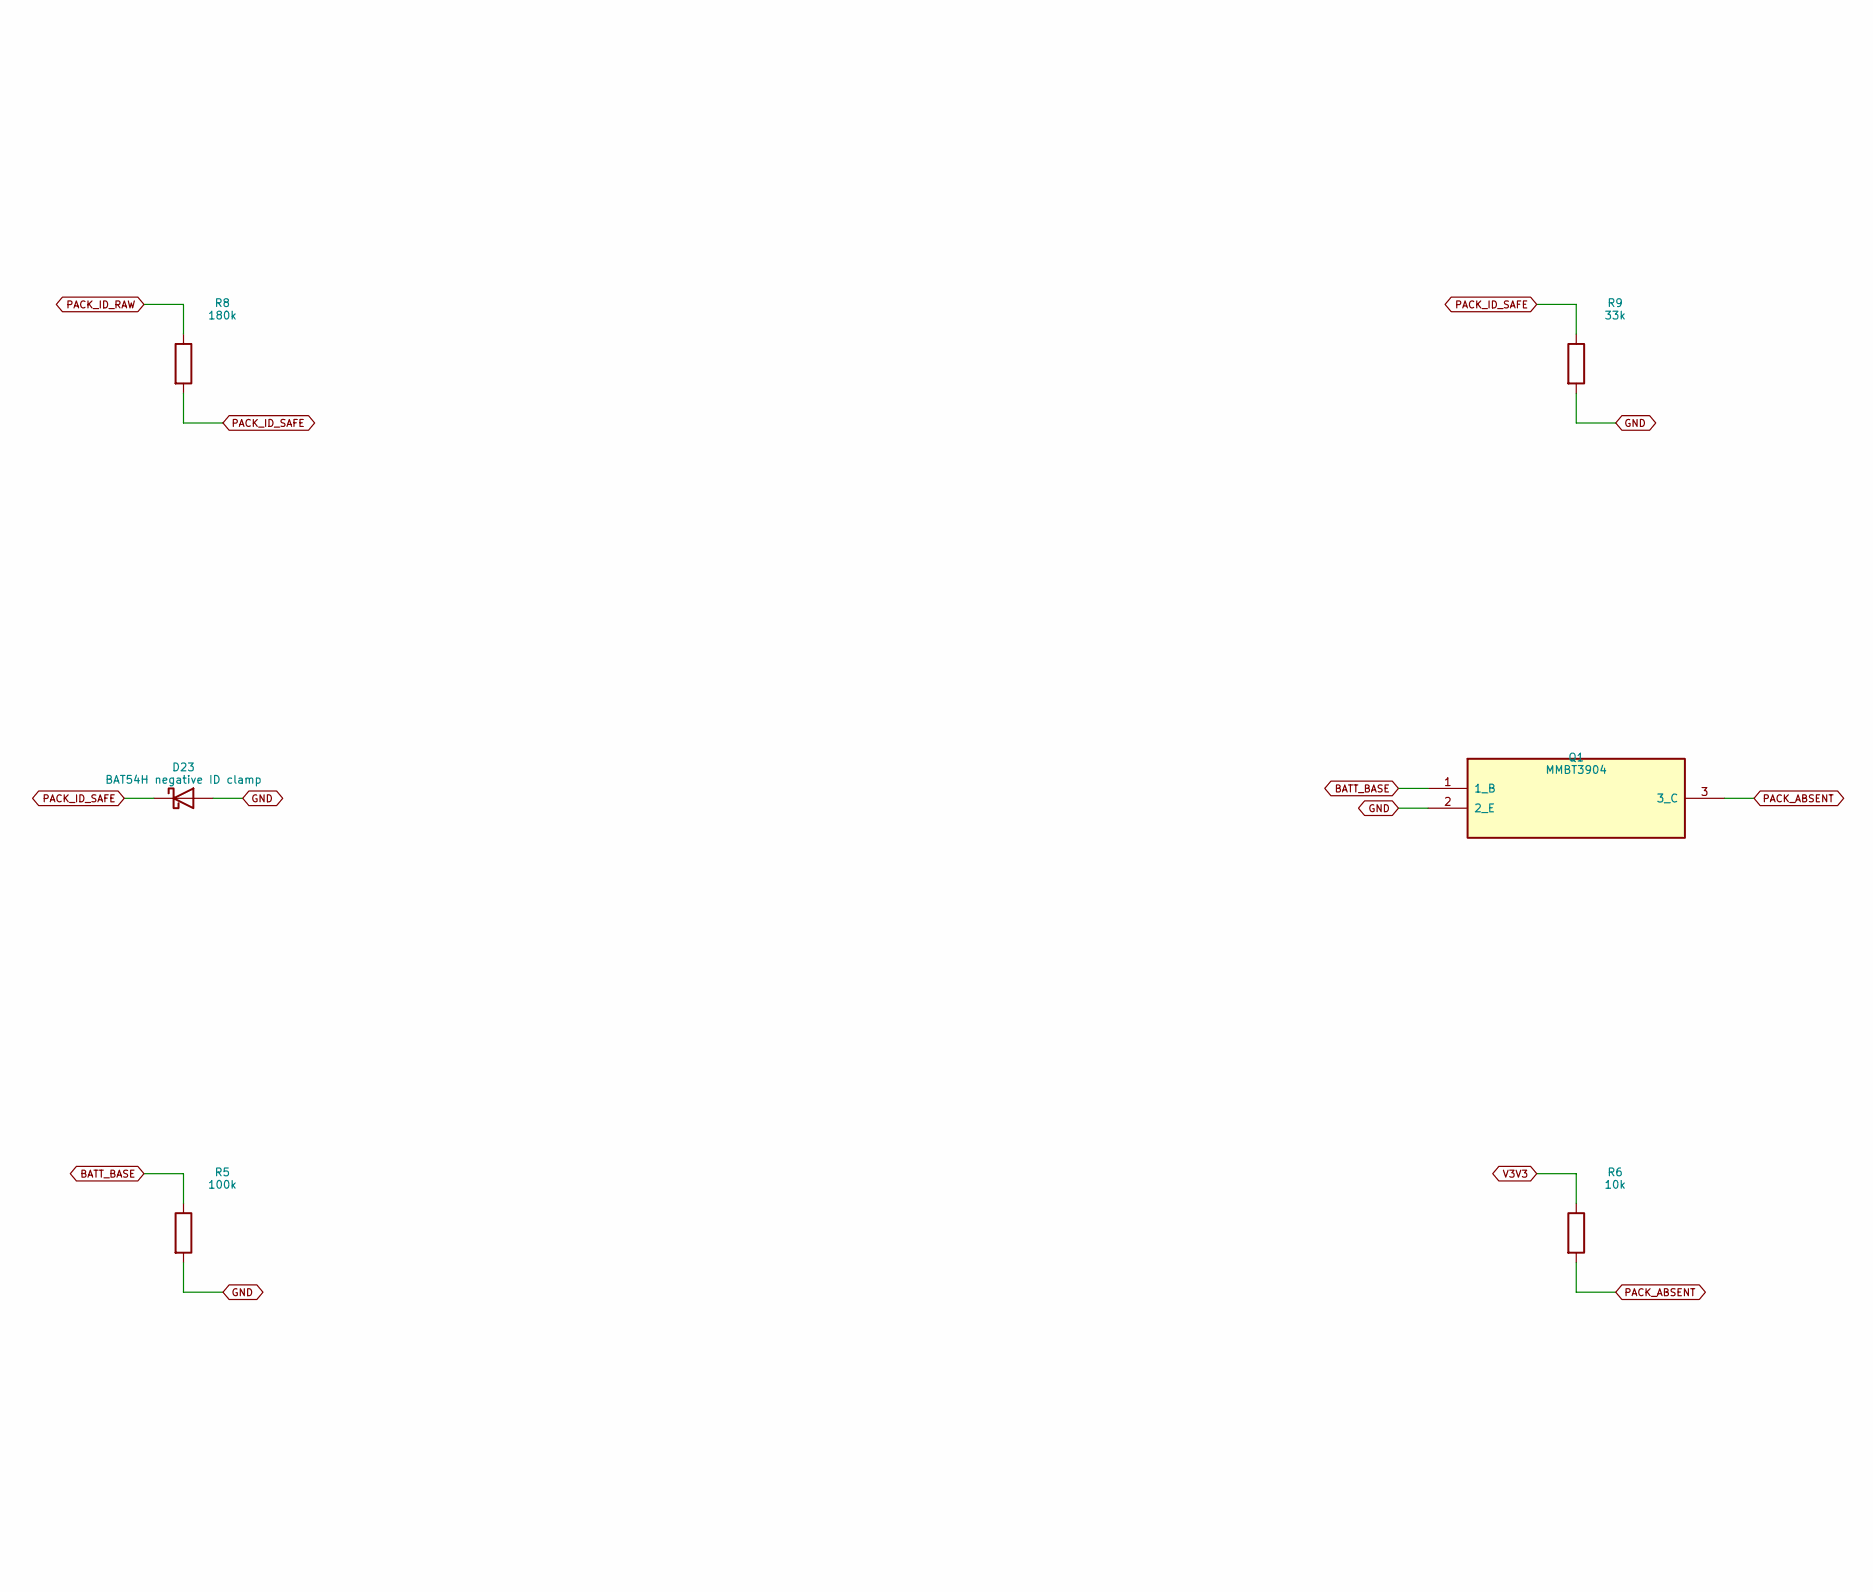
[picture p331: schematic 01_power_2.kicad_sch, 01 power / 2, part in row 1, column 2]

Parts:
D22: BAS116 ID excitation isolation; SOT-23_CTL; MPN BAS116,235
D23: BAT54H negative ID clamp; D_SOD-123F_CTL; MPN BAT54H,115
Q1: MMBT3904; SOT-23_CTL; MPN MMBT3904LT1G
R4, R5, R19: 100k; R_0603_1608Metric_CTL; MPN RC0603FR-07100KL
R6, R7: 10k; R_0603_1608Metric_CTL; MPN RC0603FR-0710KL
R8: 180k; R_0603_1608Metric_CTL; MPN RC0603FR-07180KL
R9: 33k; R_0603_1608Metric_CTL; MPN RC0603FR-0733KL

Connections:
BATT_BASE: Q1.1 (1_B), R4.2, R5.1
GND: D23.2 (A), Q1.2 (2_E), R5.2, R7.2, R9.2, R19.2; also elsewhere on the board
PACK_ABSENT: Q1.3 (3_C), R6.2; also elsewhere on the board
PACK_ID_ADC: R19.1; also elsewhere on the board
PACK_ID_EXC: D22.3 (3_K); also elsewhere on the board
PACK_ID_RAW: R8.1; also elsewhere on the board
PACK_ID_SAFE: D23.1 (K), R8.2, R9.1; also elsewhere on the board
PACK_PROT: D22.1 (1_A), R4.1, R7.1; also elsewhere on the board
V3V3: R6.1; also elsewhere on the board

Notes on the sheet:
01 power / 2
M6-C1R1 candidate: REVIEW / ALL hardware measurements NOT RUN / no ordering or manufacture.
