DD1SB/ARDF-TX/hardware/controller/CTRL.kicad_pcb

## KiCad design hardware/controller/CTRL.kicad_pcb (continued)

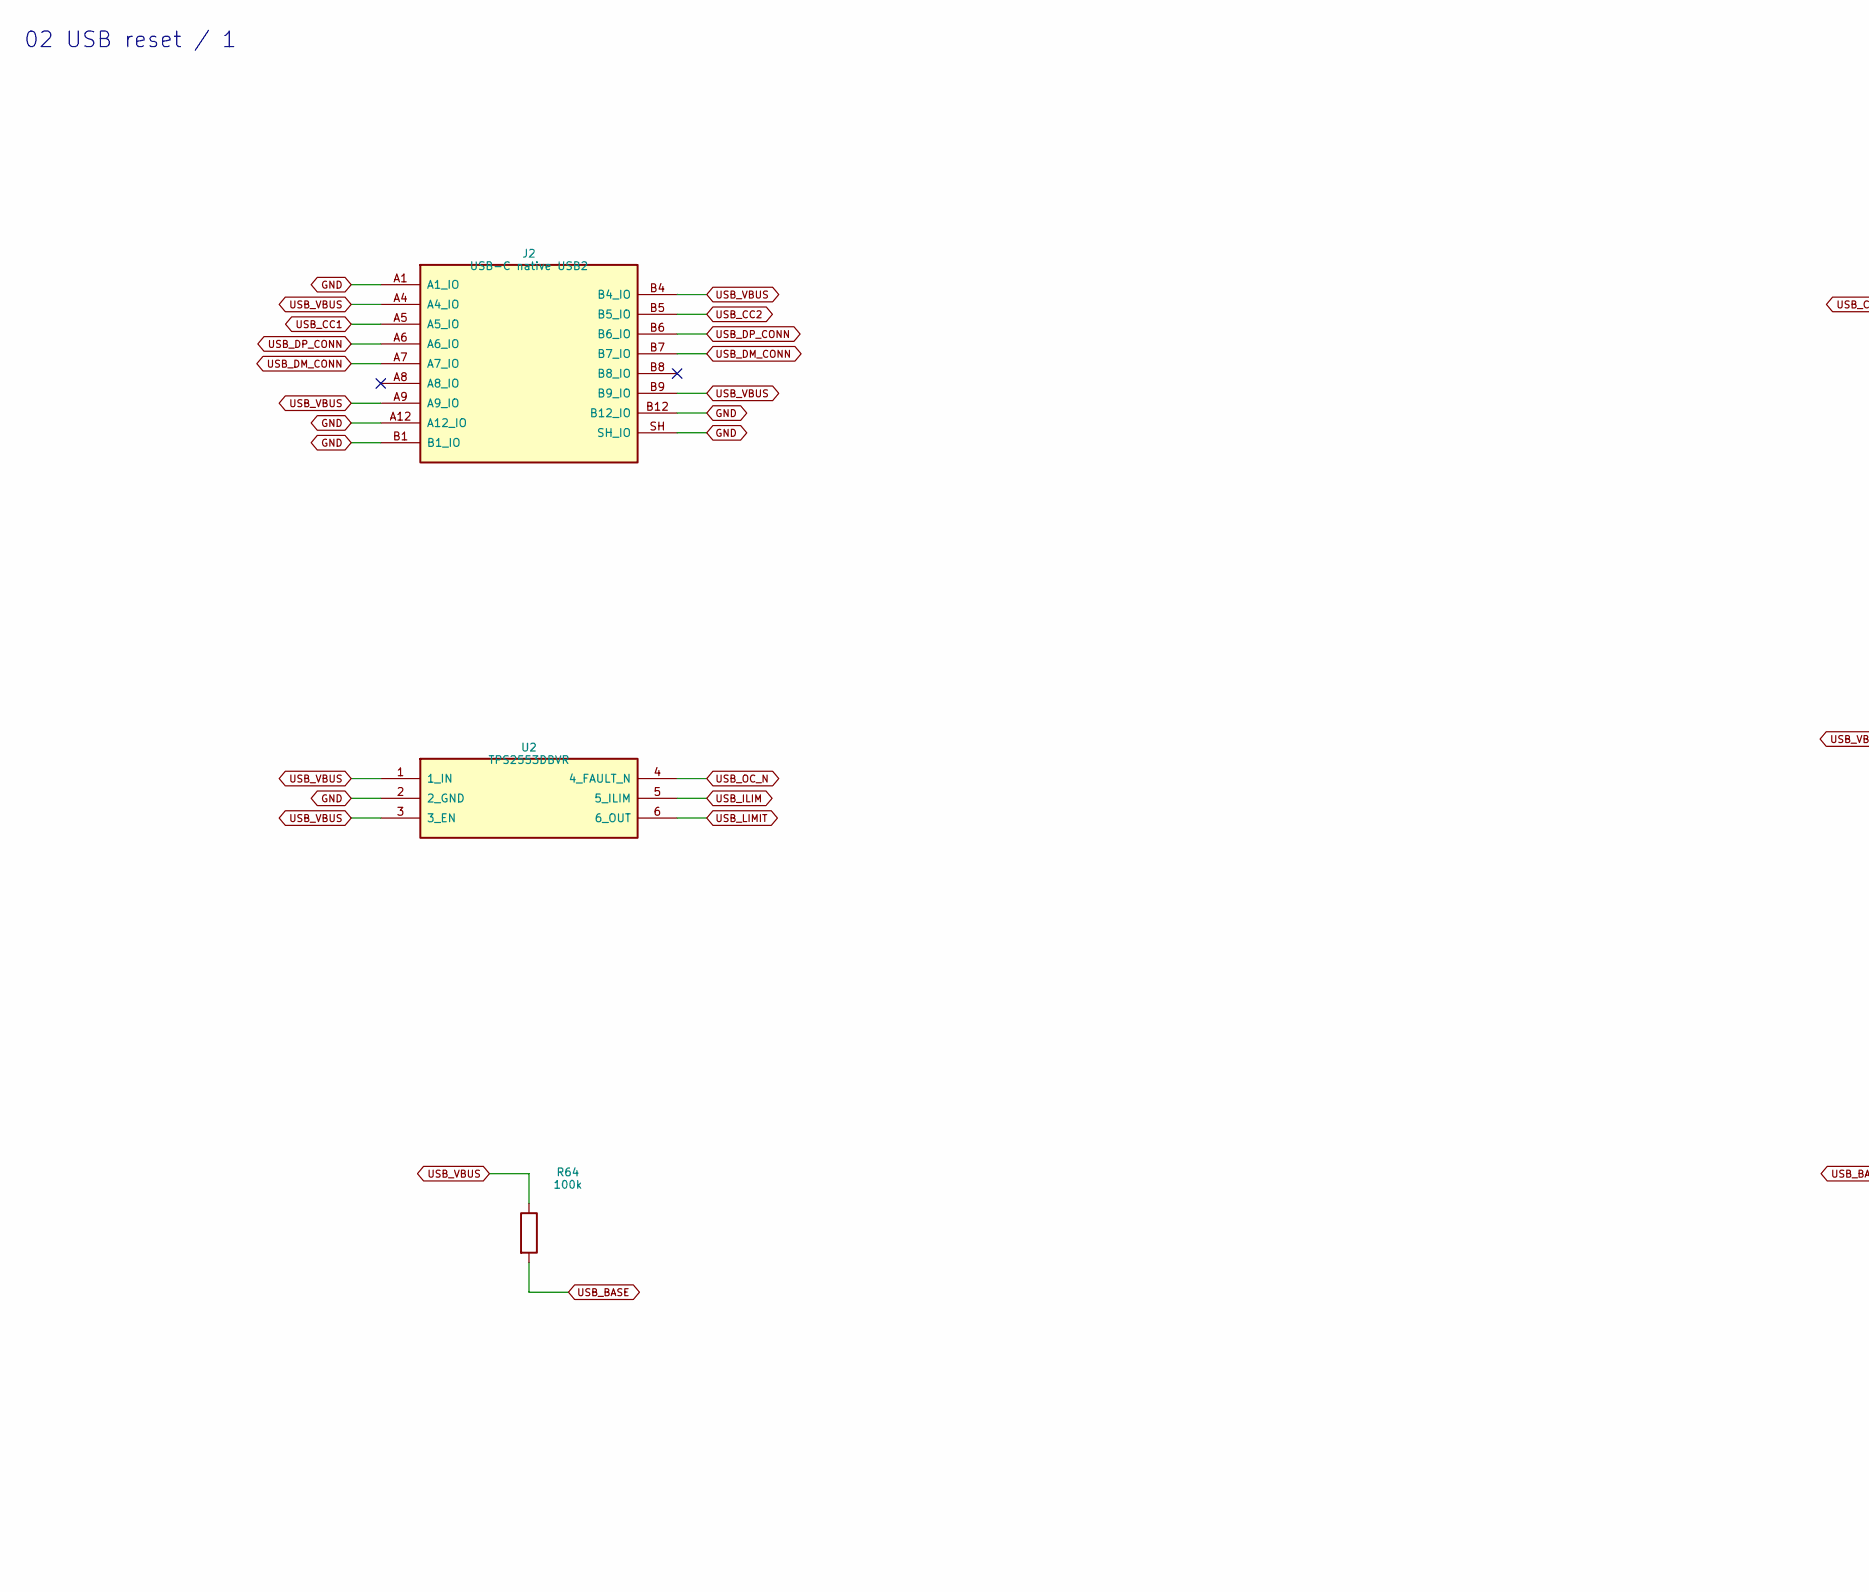
[picture p332: schematic 02_USB_reset.kicad_sch, 02 USB reset / 1, part in row 1, column 1]

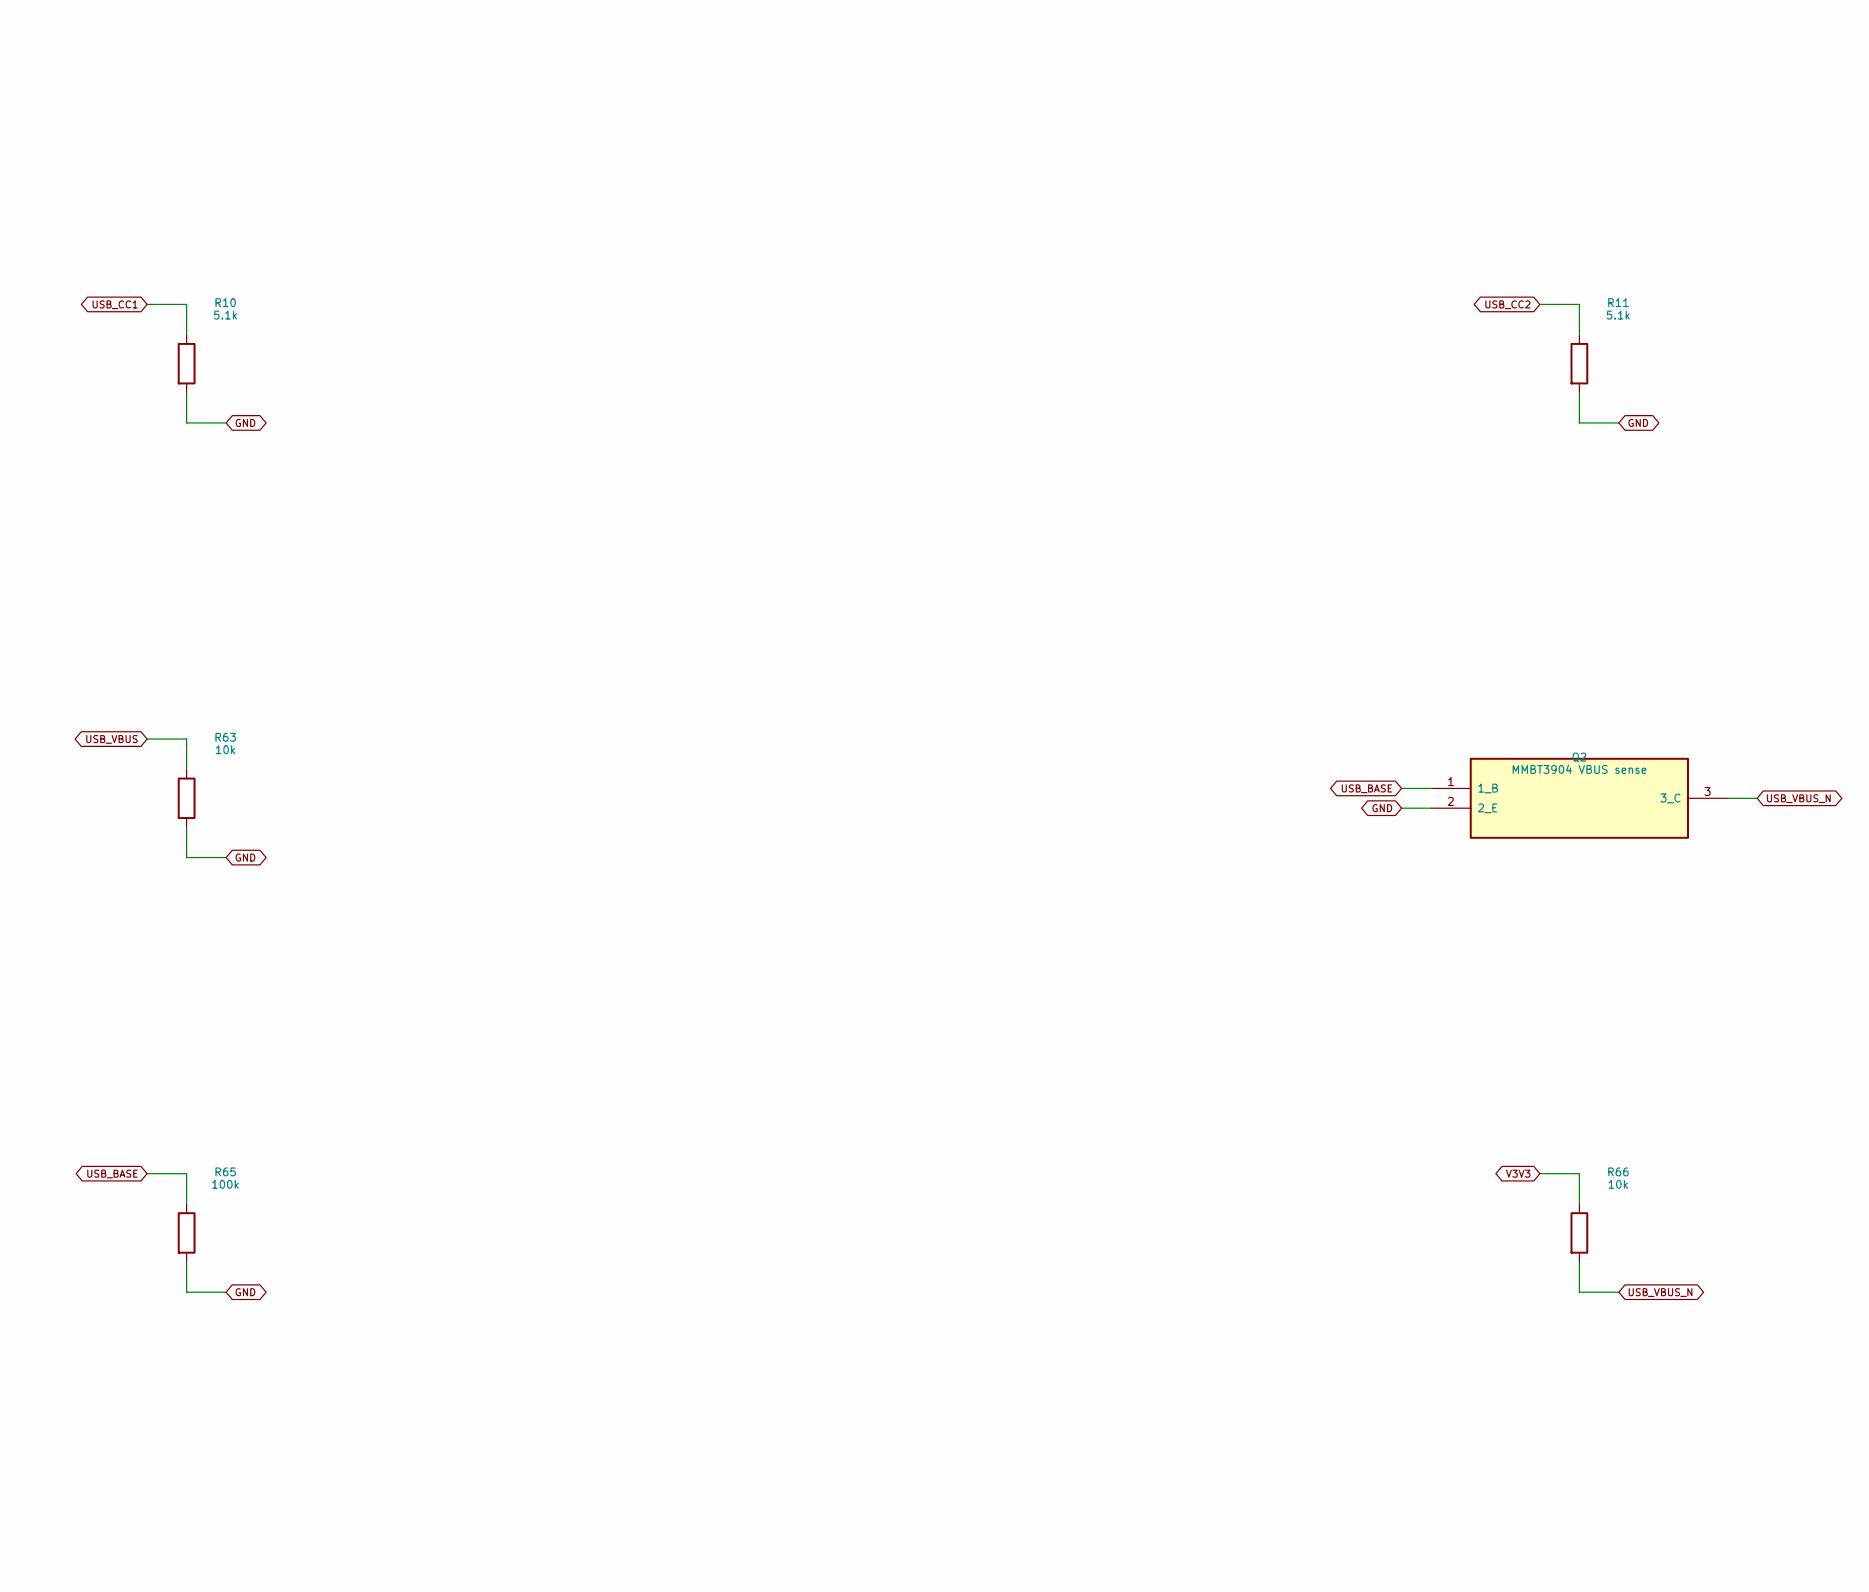
[picture p333: schematic 02_USB_reset.kicad_sch, 02 USB reset / 1, part in row 1, column 2]

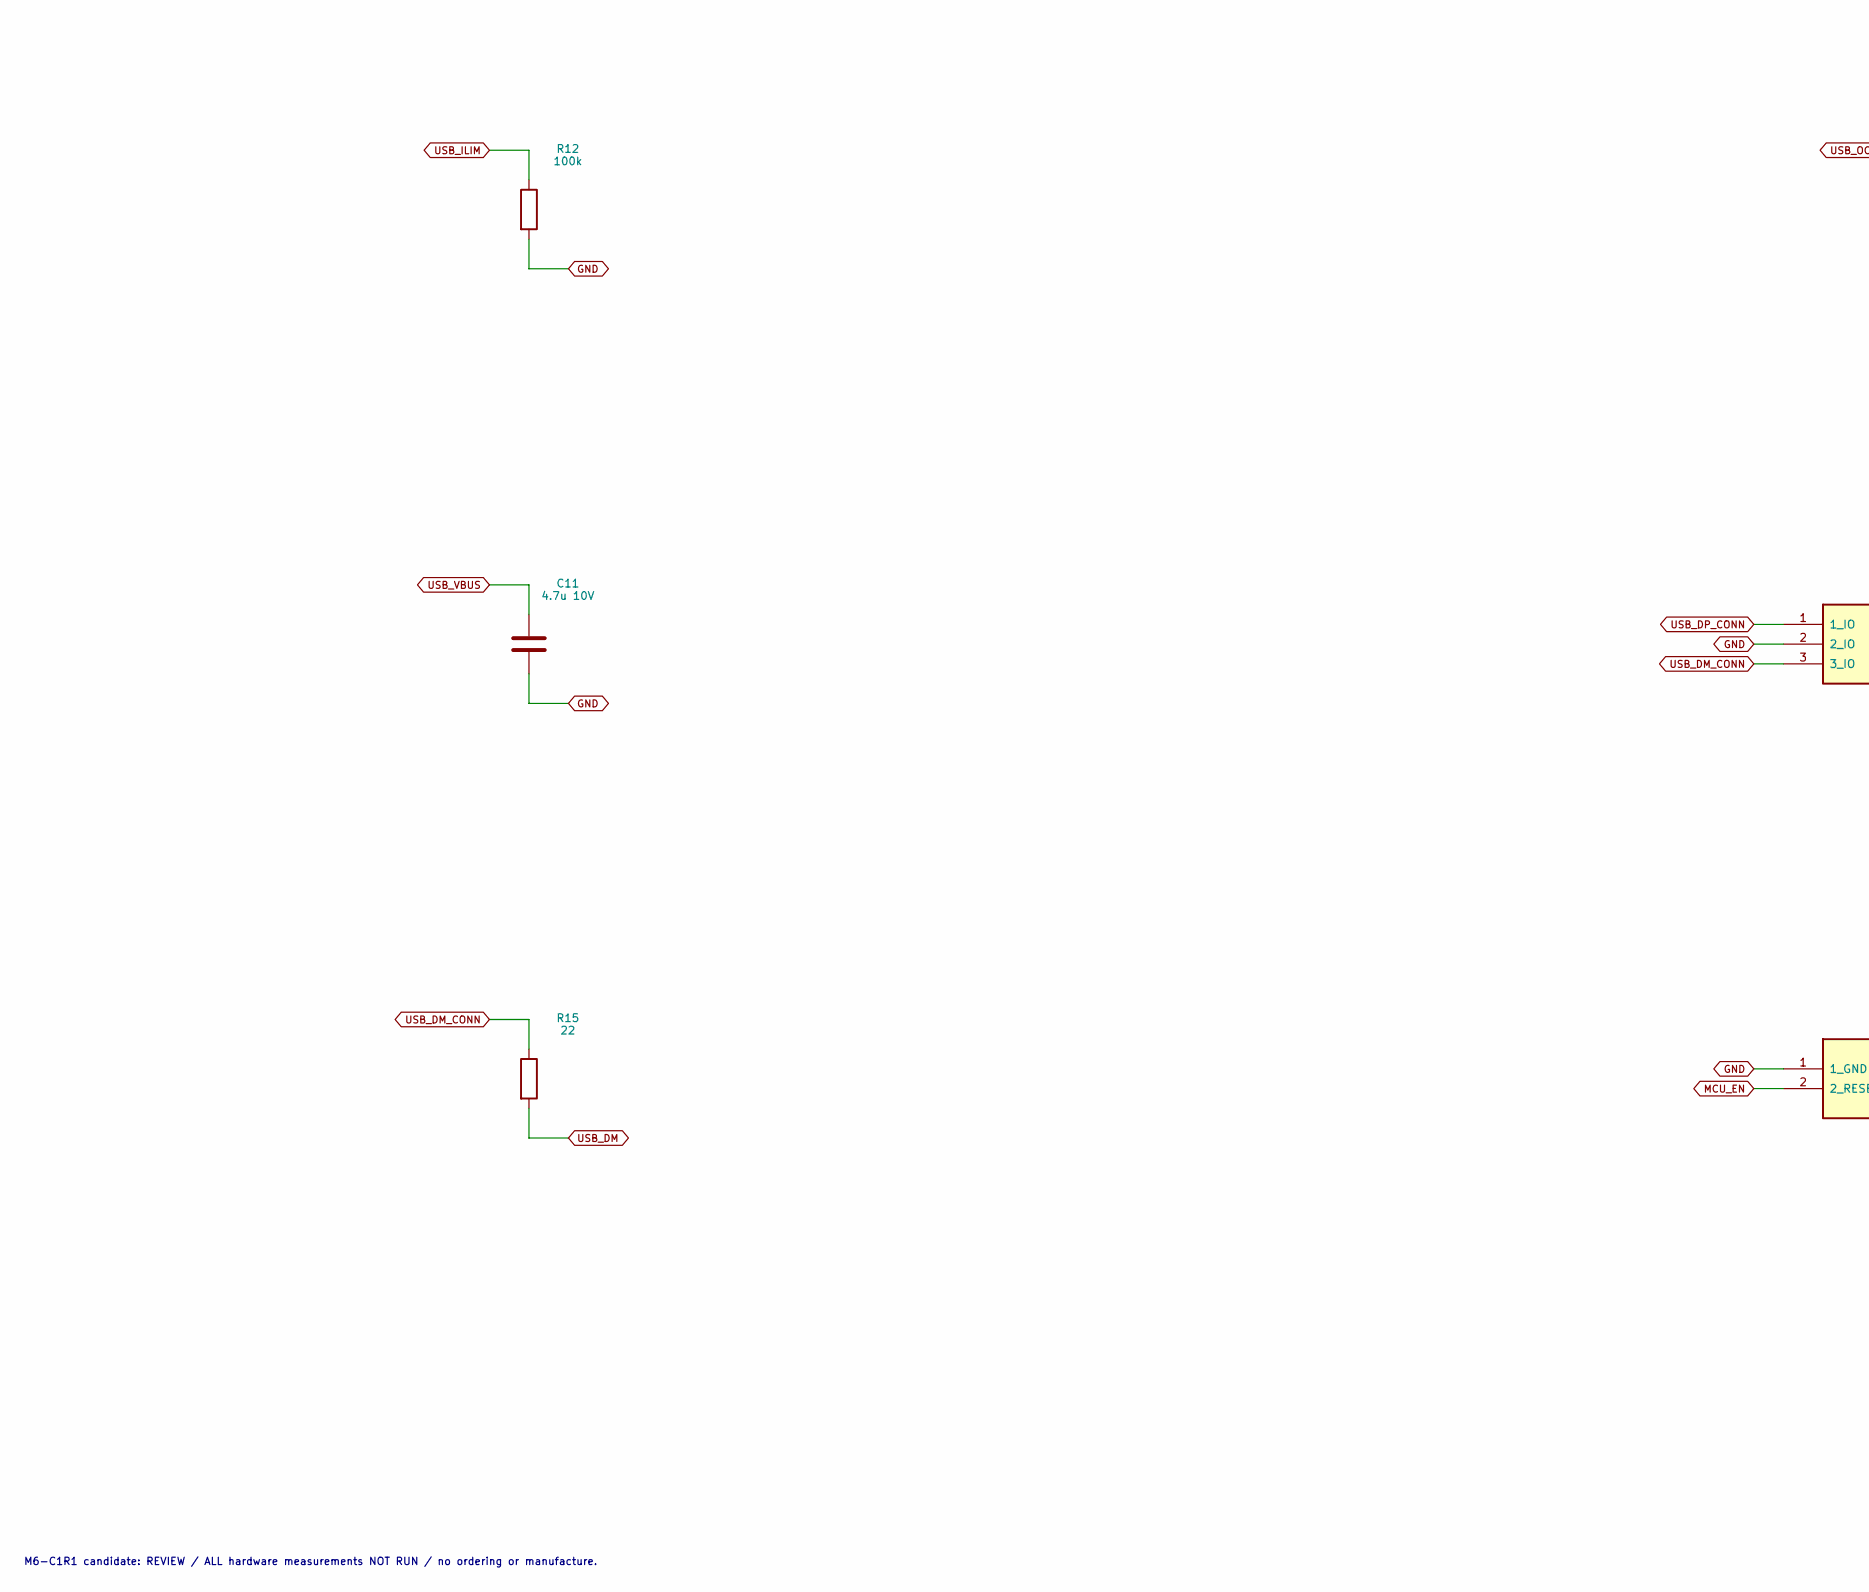
[picture p334: schematic 02_USB_reset.kicad_sch, 02 USB reset / 1, part in row 2, column 1]

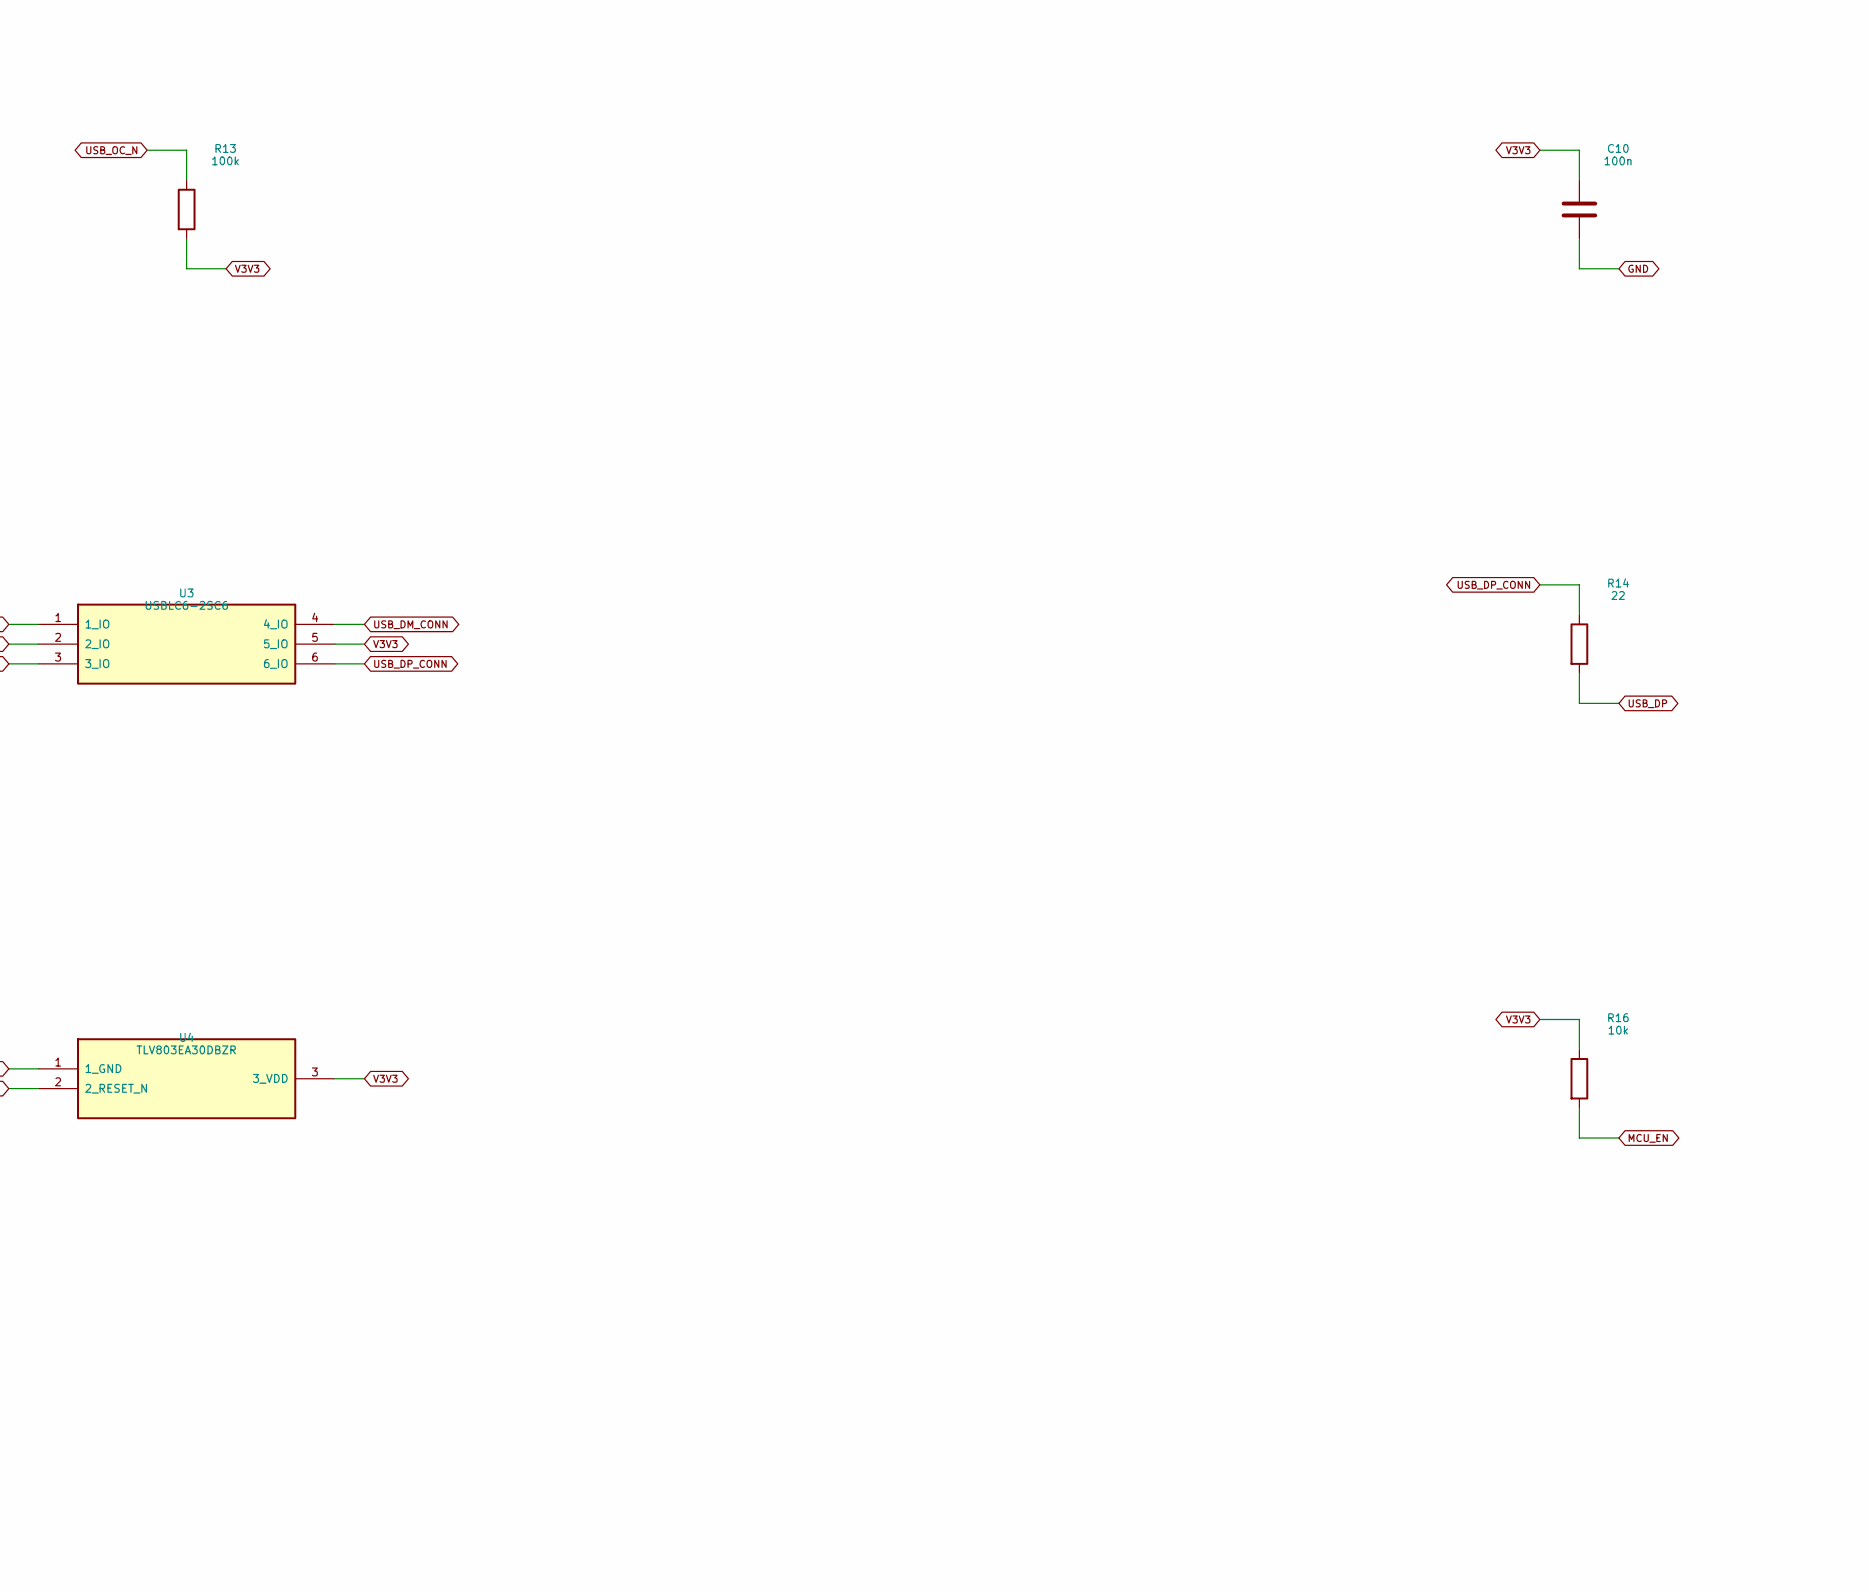
[picture p335: schematic 02_USB_reset.kicad_sch, 02 USB reset / 1, part in row 2, column 2]

Parts:
C10: 100n; C_0603_1608Metric_CTL; MPN CL10B104KB8NNNC
C11: 4.7u 10V; C_0603_1608Metric_CTL; MPN CL10A475KP8NNNC
J2: USB-C native USB2; USB4105_Standard; MPN USB4105-GF-A
Q2: MMBT3904 VBUS sense; SOT-23_CTL; MPN MMBT3904LT1G
R10, R11: 5.1k; R_0603_1608Metric_CTL; MPN RC0603FR-075K1L
R12, R13, R64, R65: 100k; R_0603_1608Metric_CTL; MPN RC0603FR-07100KL
R14, R15: 22; R_0603_1608Metric_CTL; MPN RC0603FR-0722RL
R16, R63, R66: 10k; R_0603_1608Metric_CTL; MPN RC0603FR-0710KL
U2: TPS2553DBVR; SOT-23-6_CTL; MPN TPS2553DBVR
U3: USBLC6-2SC6; SOT-23-6_CTL; MPN USBLC6-2SC6
U4: TLV803EA30DBZR; SOT-23_CTL; MPN TLV803EA30DBZR

Connections:
GND: C10.2, C11.2, J2.A1 (A1_IO), J2.A12 (A12_IO), J2.B1 (B1_IO), J2.B12 (B12_IO), J2.SH (SH_IO), Q2.2 (2_E), R10.2, R11.2, R12.2, R63.2, R65.2, U2.2 (2_GND), U3.2 (2_IO), U4.1 (1_GND); also elsewhere on the board
MCU_EN: R16.2, U4.2 (2_RESET_N); also elsewhere on the board
USB_BASE: Q2.1 (1_B), R64.2, R65.1
USB_CC1: J2.A5 (A5_IO), R10.1
USB_CC2: J2.B5 (B5_IO), R11.1
USB_DM: R15.2; also elsewhere on the board
USB_DM_CONN: J2.A7 (A7_IO), J2.B7 (B7_IO), R15.1, U3.3 (3_IO), U3.4 (4_IO)
USB_DP: R14.2; also elsewhere on the board
USB_DP_CONN: J2.A6 (A6_IO), J2.B6 (B6_IO), R14.1, U3.1 (1_IO), U3.6 (6_IO)
USB_ILIM: R12.1, U2.5 (5_ILIM)
USB_LIMIT: U2.6 (6_OUT); also elsewhere on the board
USB_OC_N: R13.1, U2.4 (4_FAULT_N)
USB_VBUS: C11.1, J2.A4 (A4_IO), J2.A9 (A9_IO), J2.B4 (B4_IO), J2.B9 (B9_IO), R63.1, R64.1, U2.1 (1_IN), U2.3 (3_EN)
USB_VBUS_N: Q2.3 (3_C), R66.2; also elsewhere on the board
V3V3: C10.1, R13.2, R16.1, R66.1, U3.5 (5_IO), U4.3 (3_VDD); also elsewhere on the board

Notes on the sheet:
02 USB reset / 1
M6-C1R1 candidate: REVIEW / ALL hardware measurements NOT RUN / no ordering or manufacture.

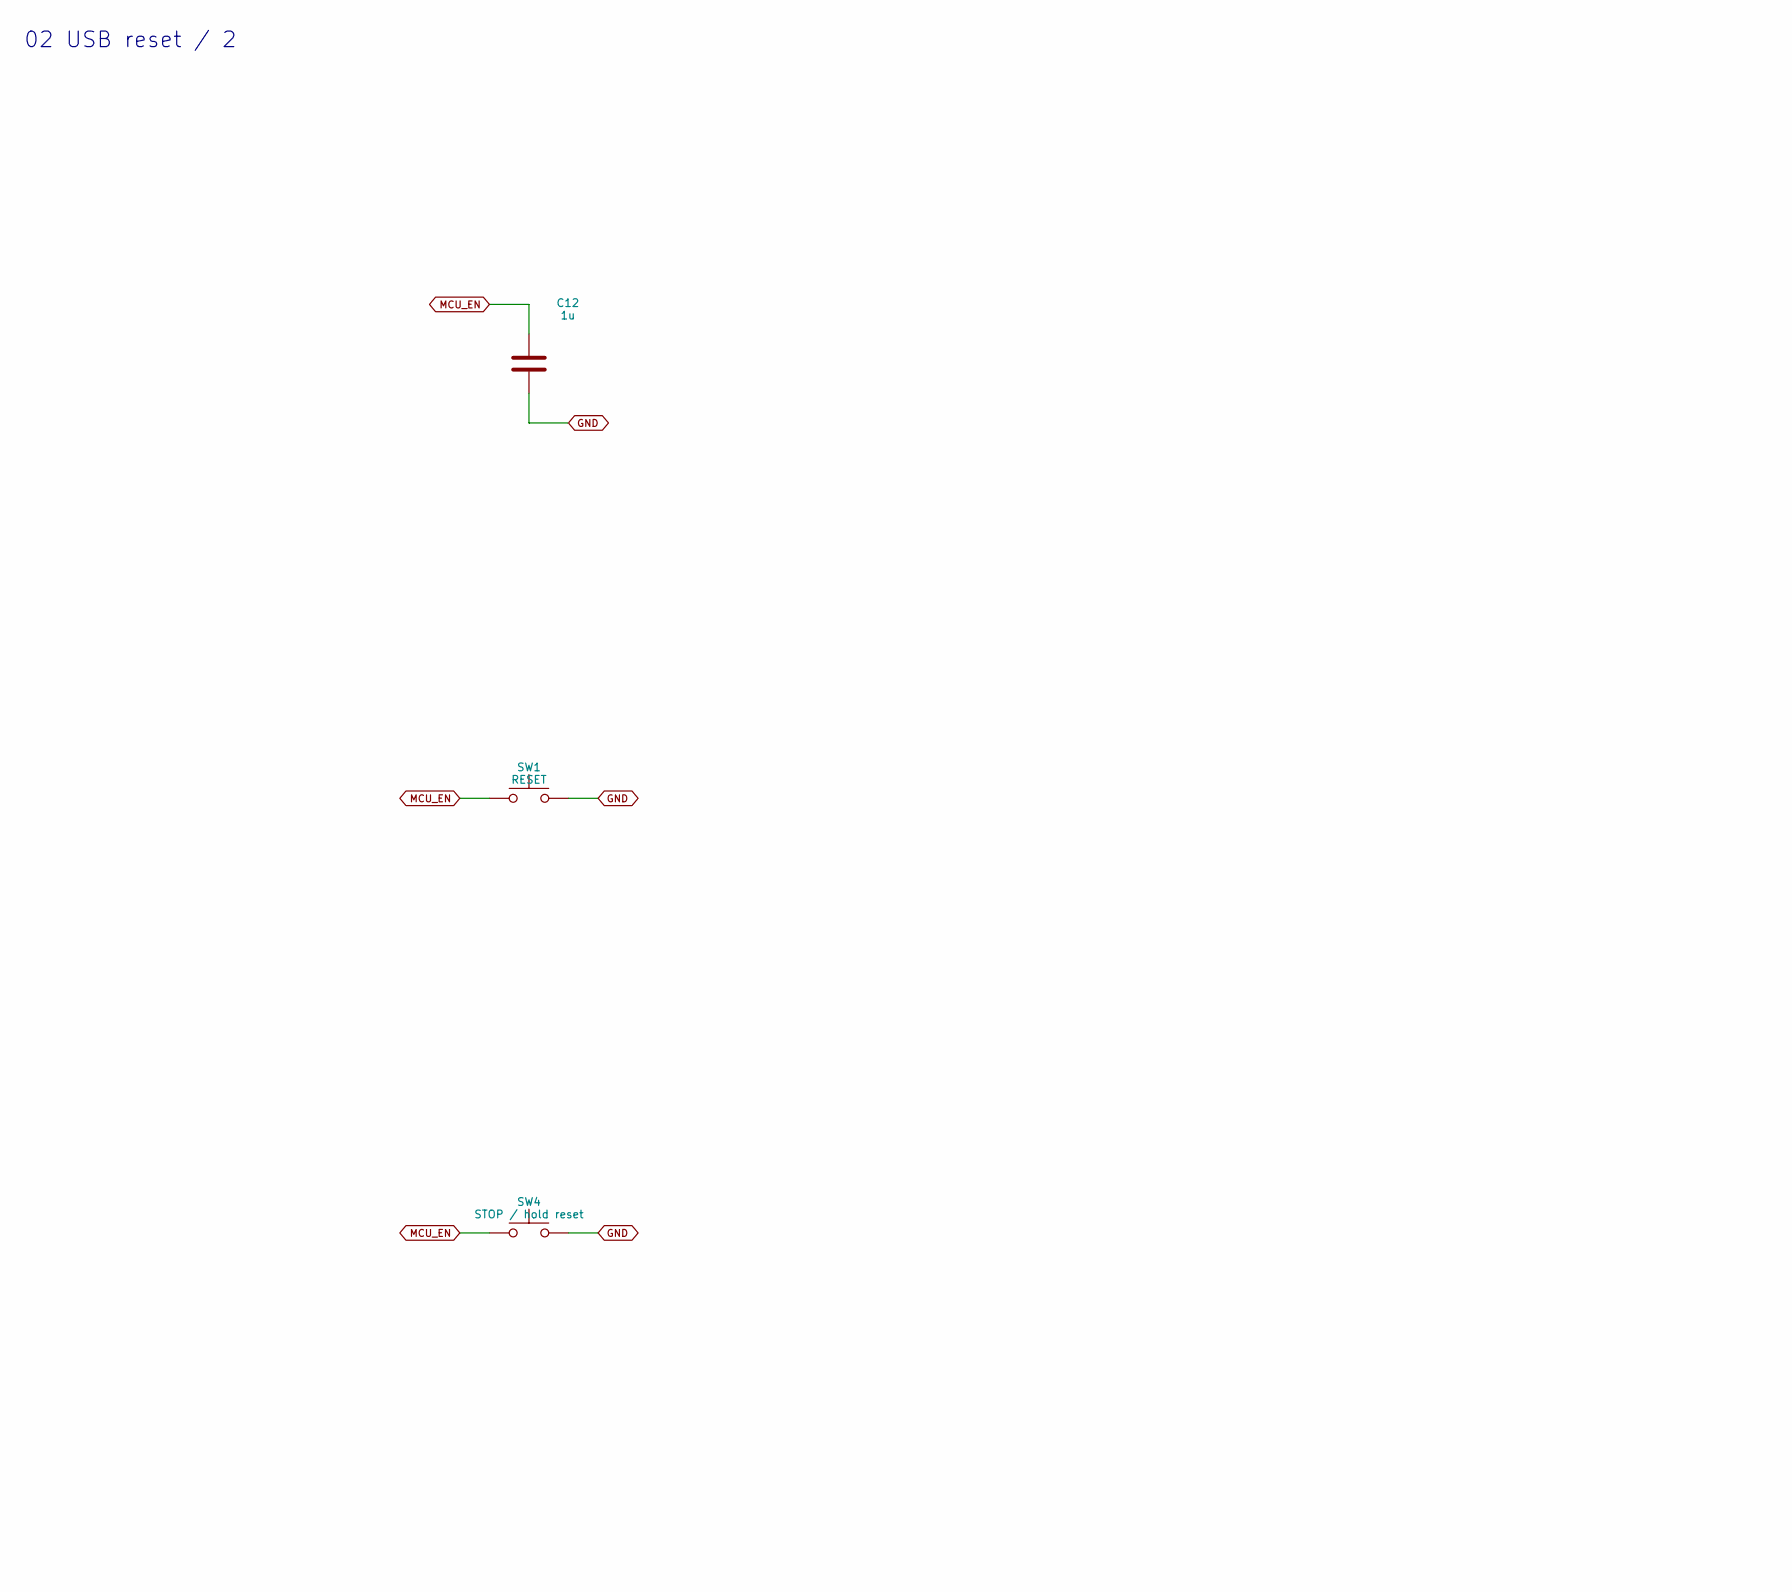
[picture p336: schematic 02_USB_reset_2.kicad_sch, 02 USB reset / 2, part in row 1, column 1]

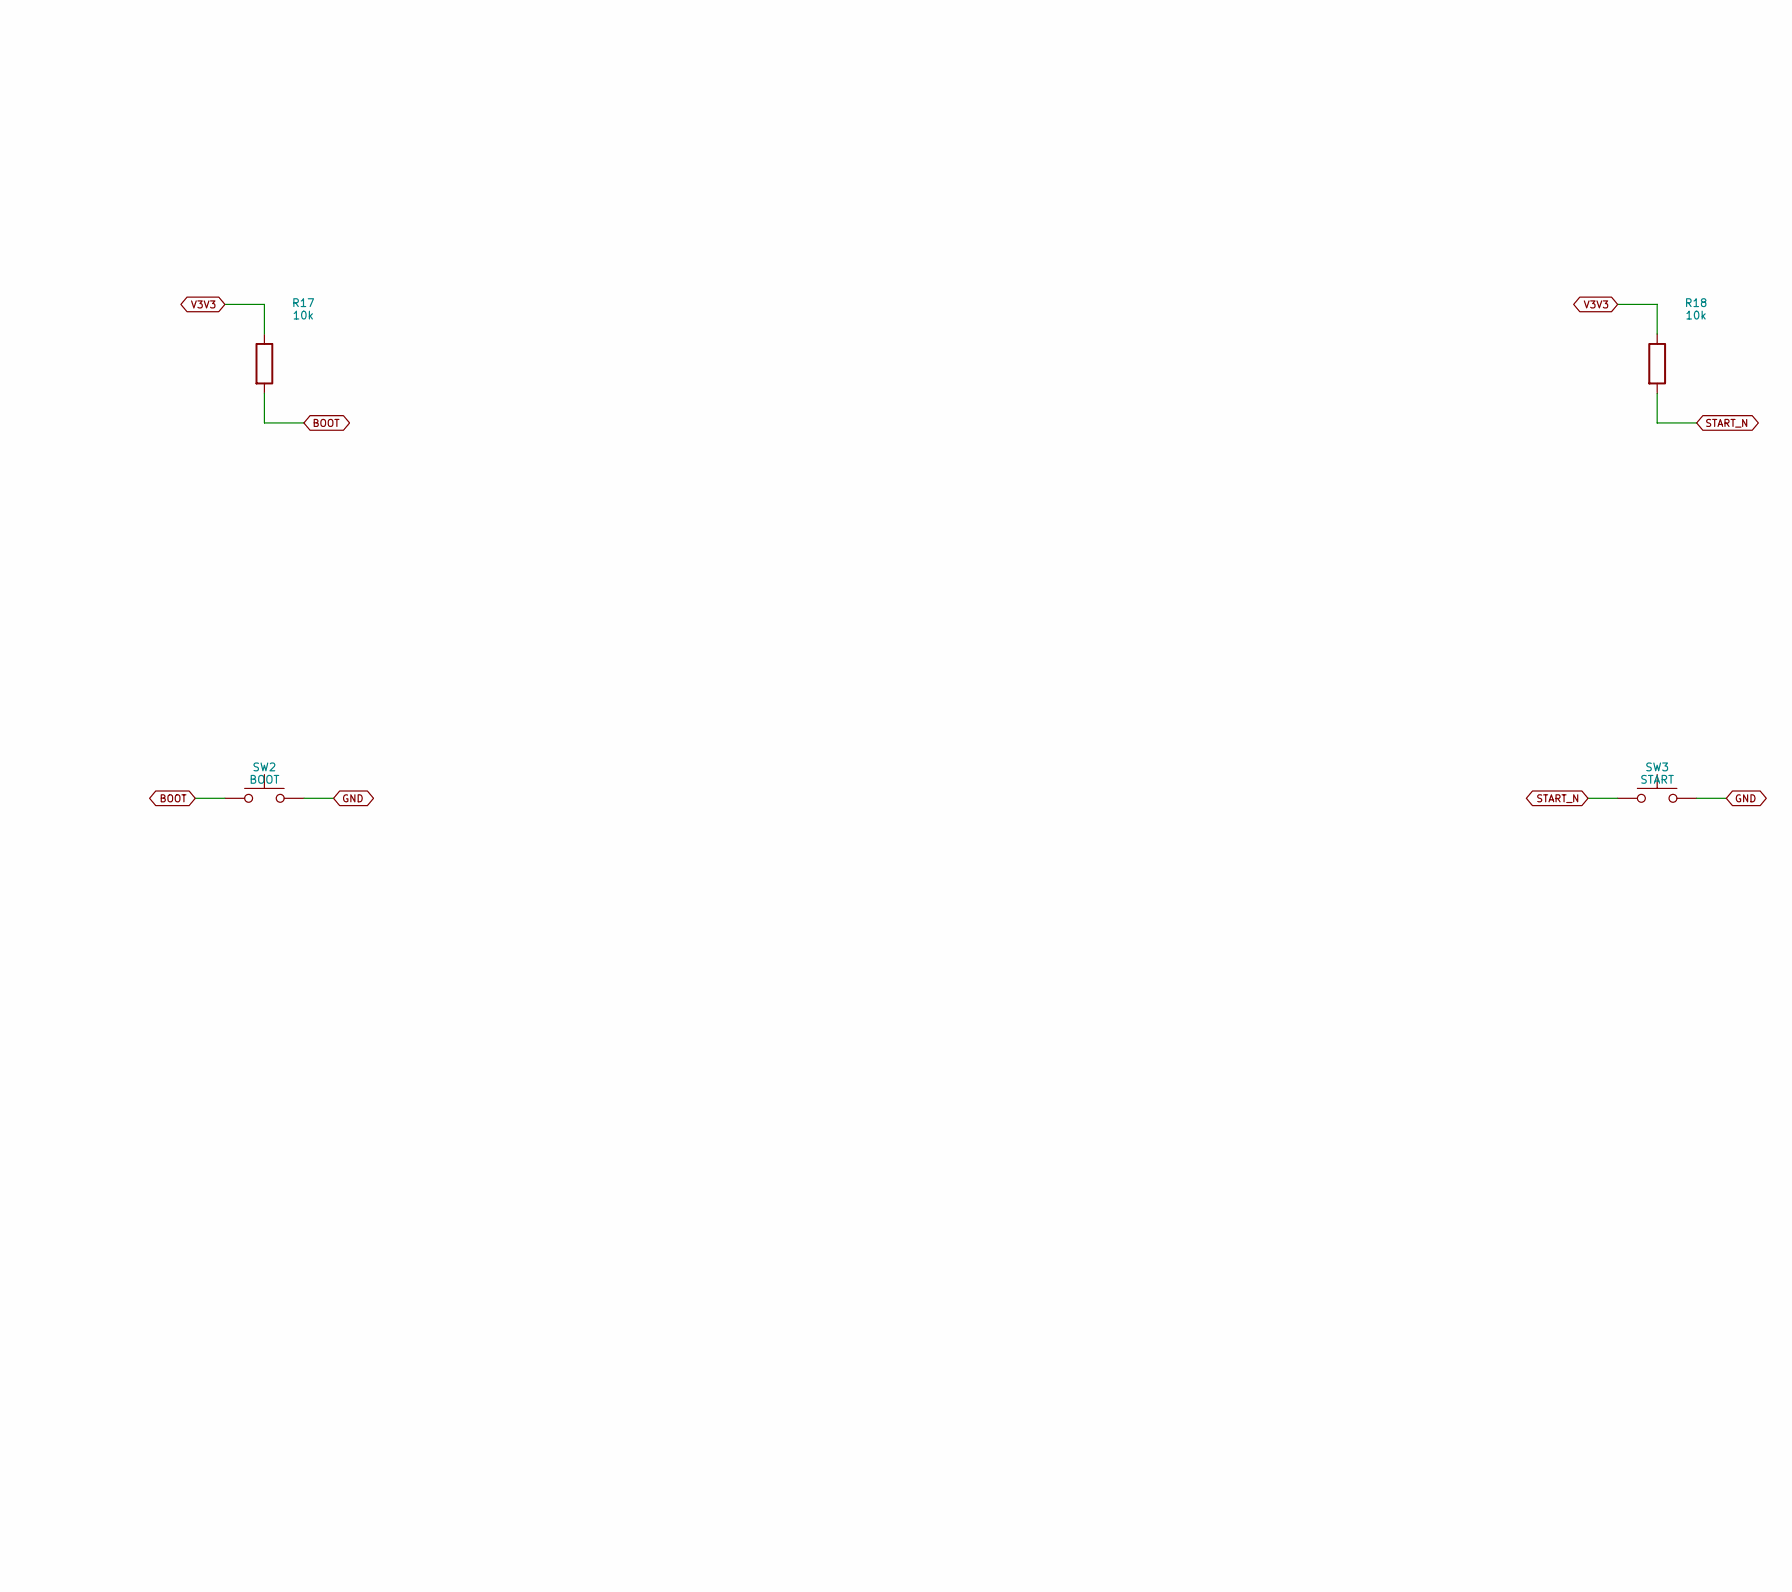
[picture p337: schematic 02_USB_reset_2.kicad_sch, 02 USB reset / 2, part in row 1, column 2]

Parts:
C12: 1u; C_0603_1608Metric_CTL; MPN CL10A105KB8NNNC
R17, R18: 10k; R_0603_1608Metric_CTL; MPN RC0603FR-0710KL
SW1: RESET; SW_SPST_TL3342_CTL; MPN TL3342F160QG
SW2: BOOT; SW_SPST_TL3342_CTL; MPN TL3342F160QG
SW3: START; SW_SPST_TL3342_CTL; MPN TL3342F160QG
SW4: STOP / hold reset; SW_SPST_TL3342_CTL; MPN TL3342F160QG

Connections:
BOOT: R17.2, SW2.1; also elsewhere on the board
GND: C12.2, SW1.2, SW2.2, SW3.2, SW4.2; also elsewhere on the board
MCU_EN: C12.1, SW1.1, SW4.1; also elsewhere on the board
START_N: R18.2, SW3.1; also elsewhere on the board
V3V3: R17.1, R18.1; also elsewhere on the board

Notes on the sheet:
02 USB reset / 2
M6-C1R1 candidate: REVIEW / ALL hardware measurements NOT RUN / no ordering or manufacture.
