DD1SB/ARDF-TX/hardware/controller/CTRL.kicad_pcb

## KiCad design hardware/controller/CTRL.kicad_pcb (continued)

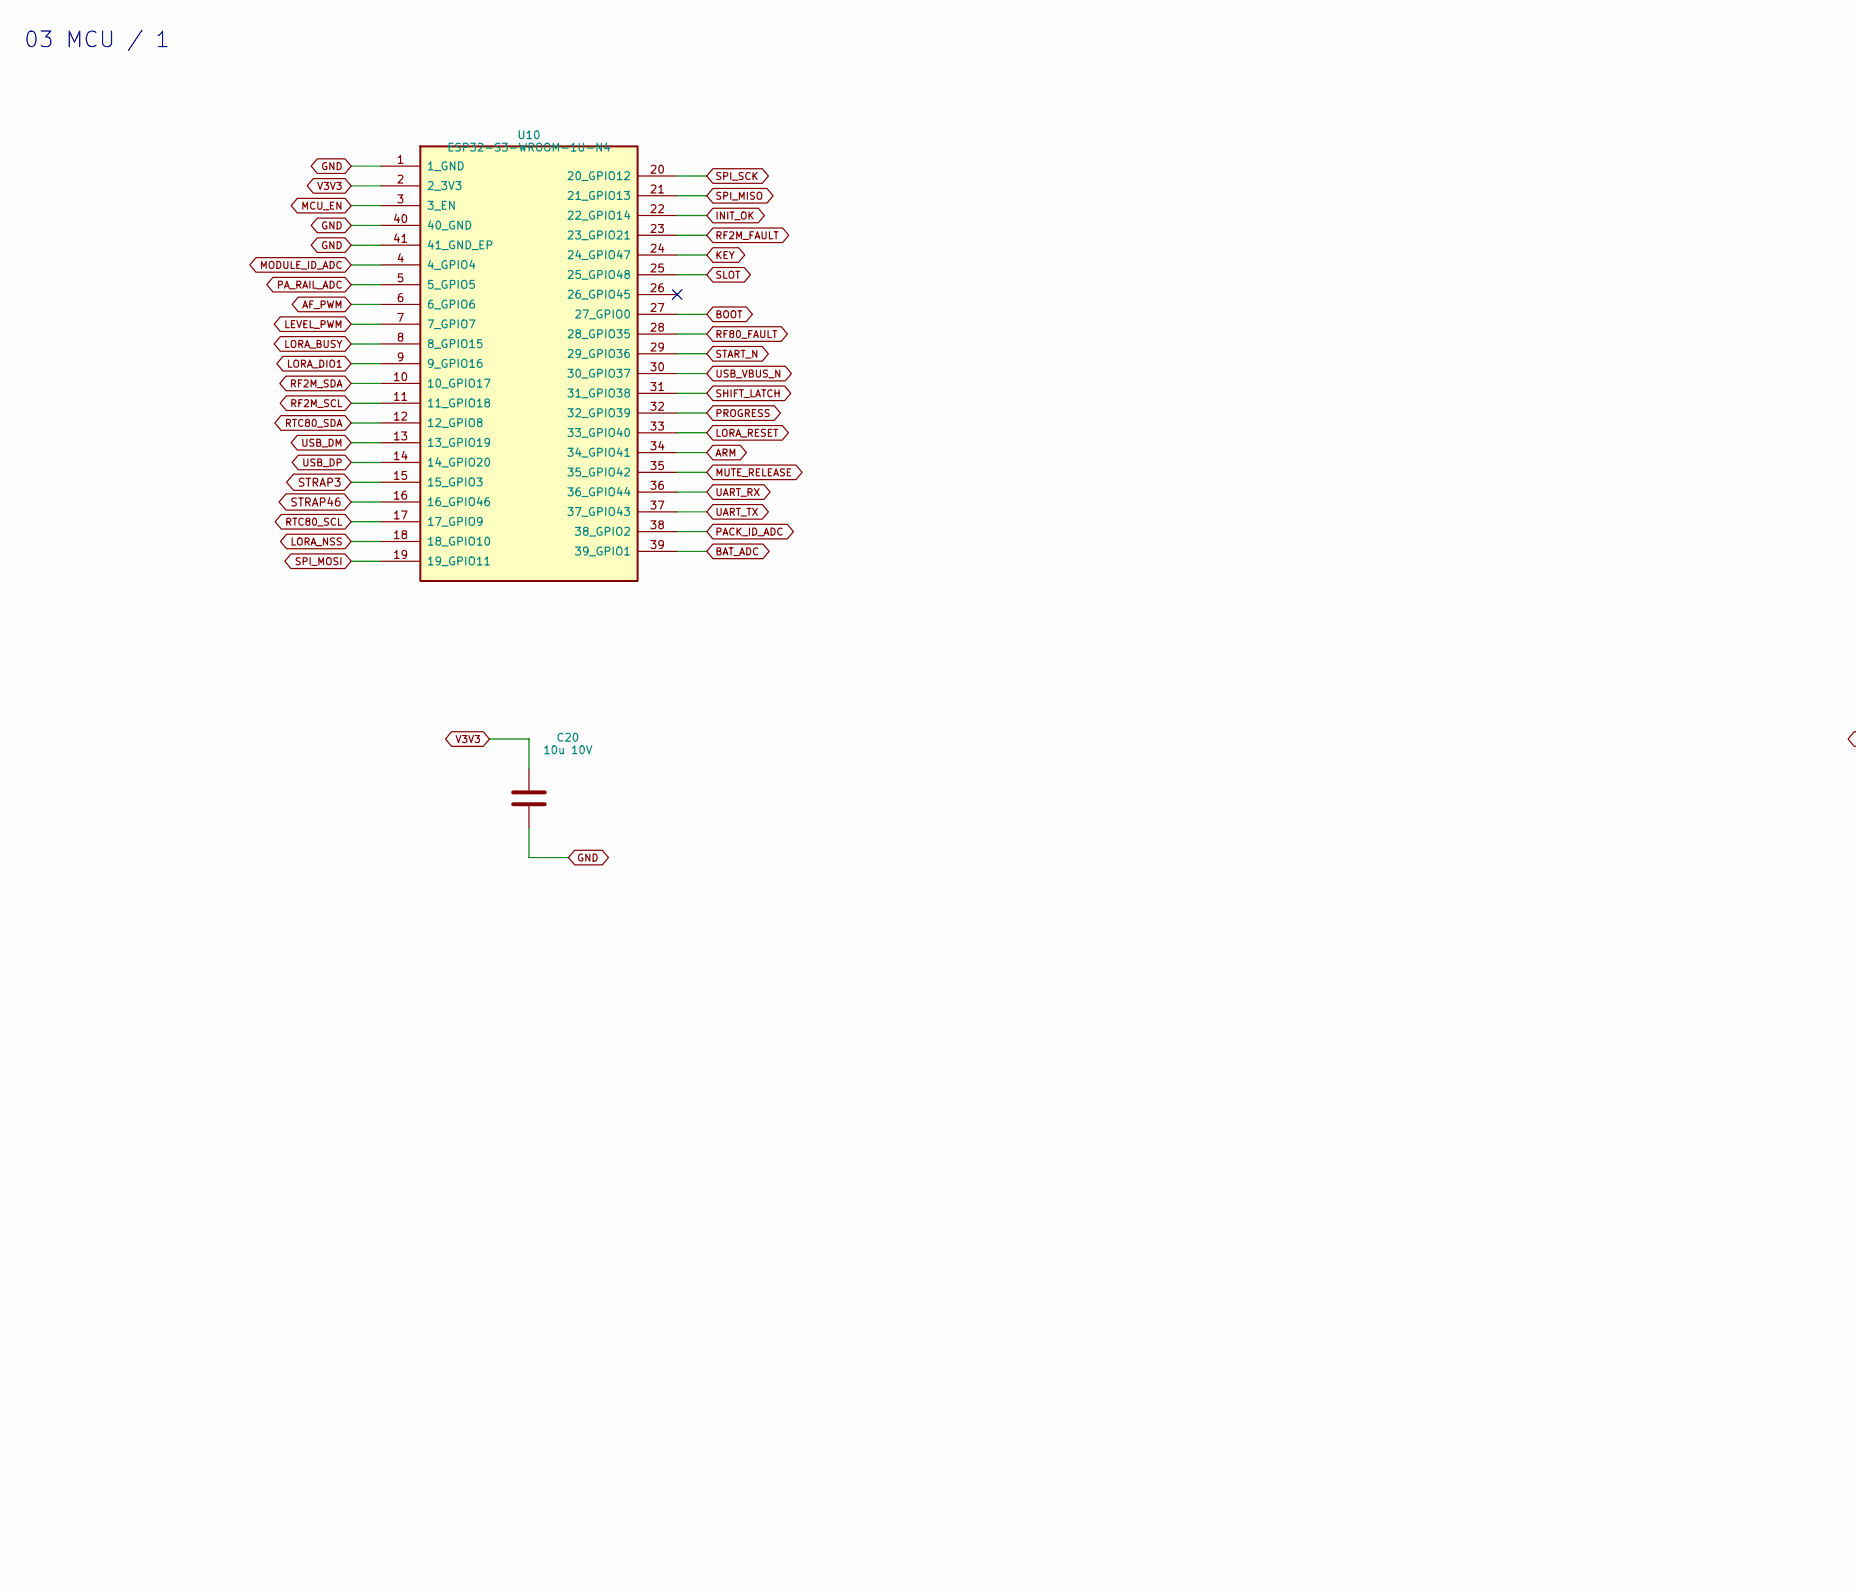
[picture p338: schematic 03_MCU.kicad_sch, 03 MCU / 1, part in row 1, column 1]

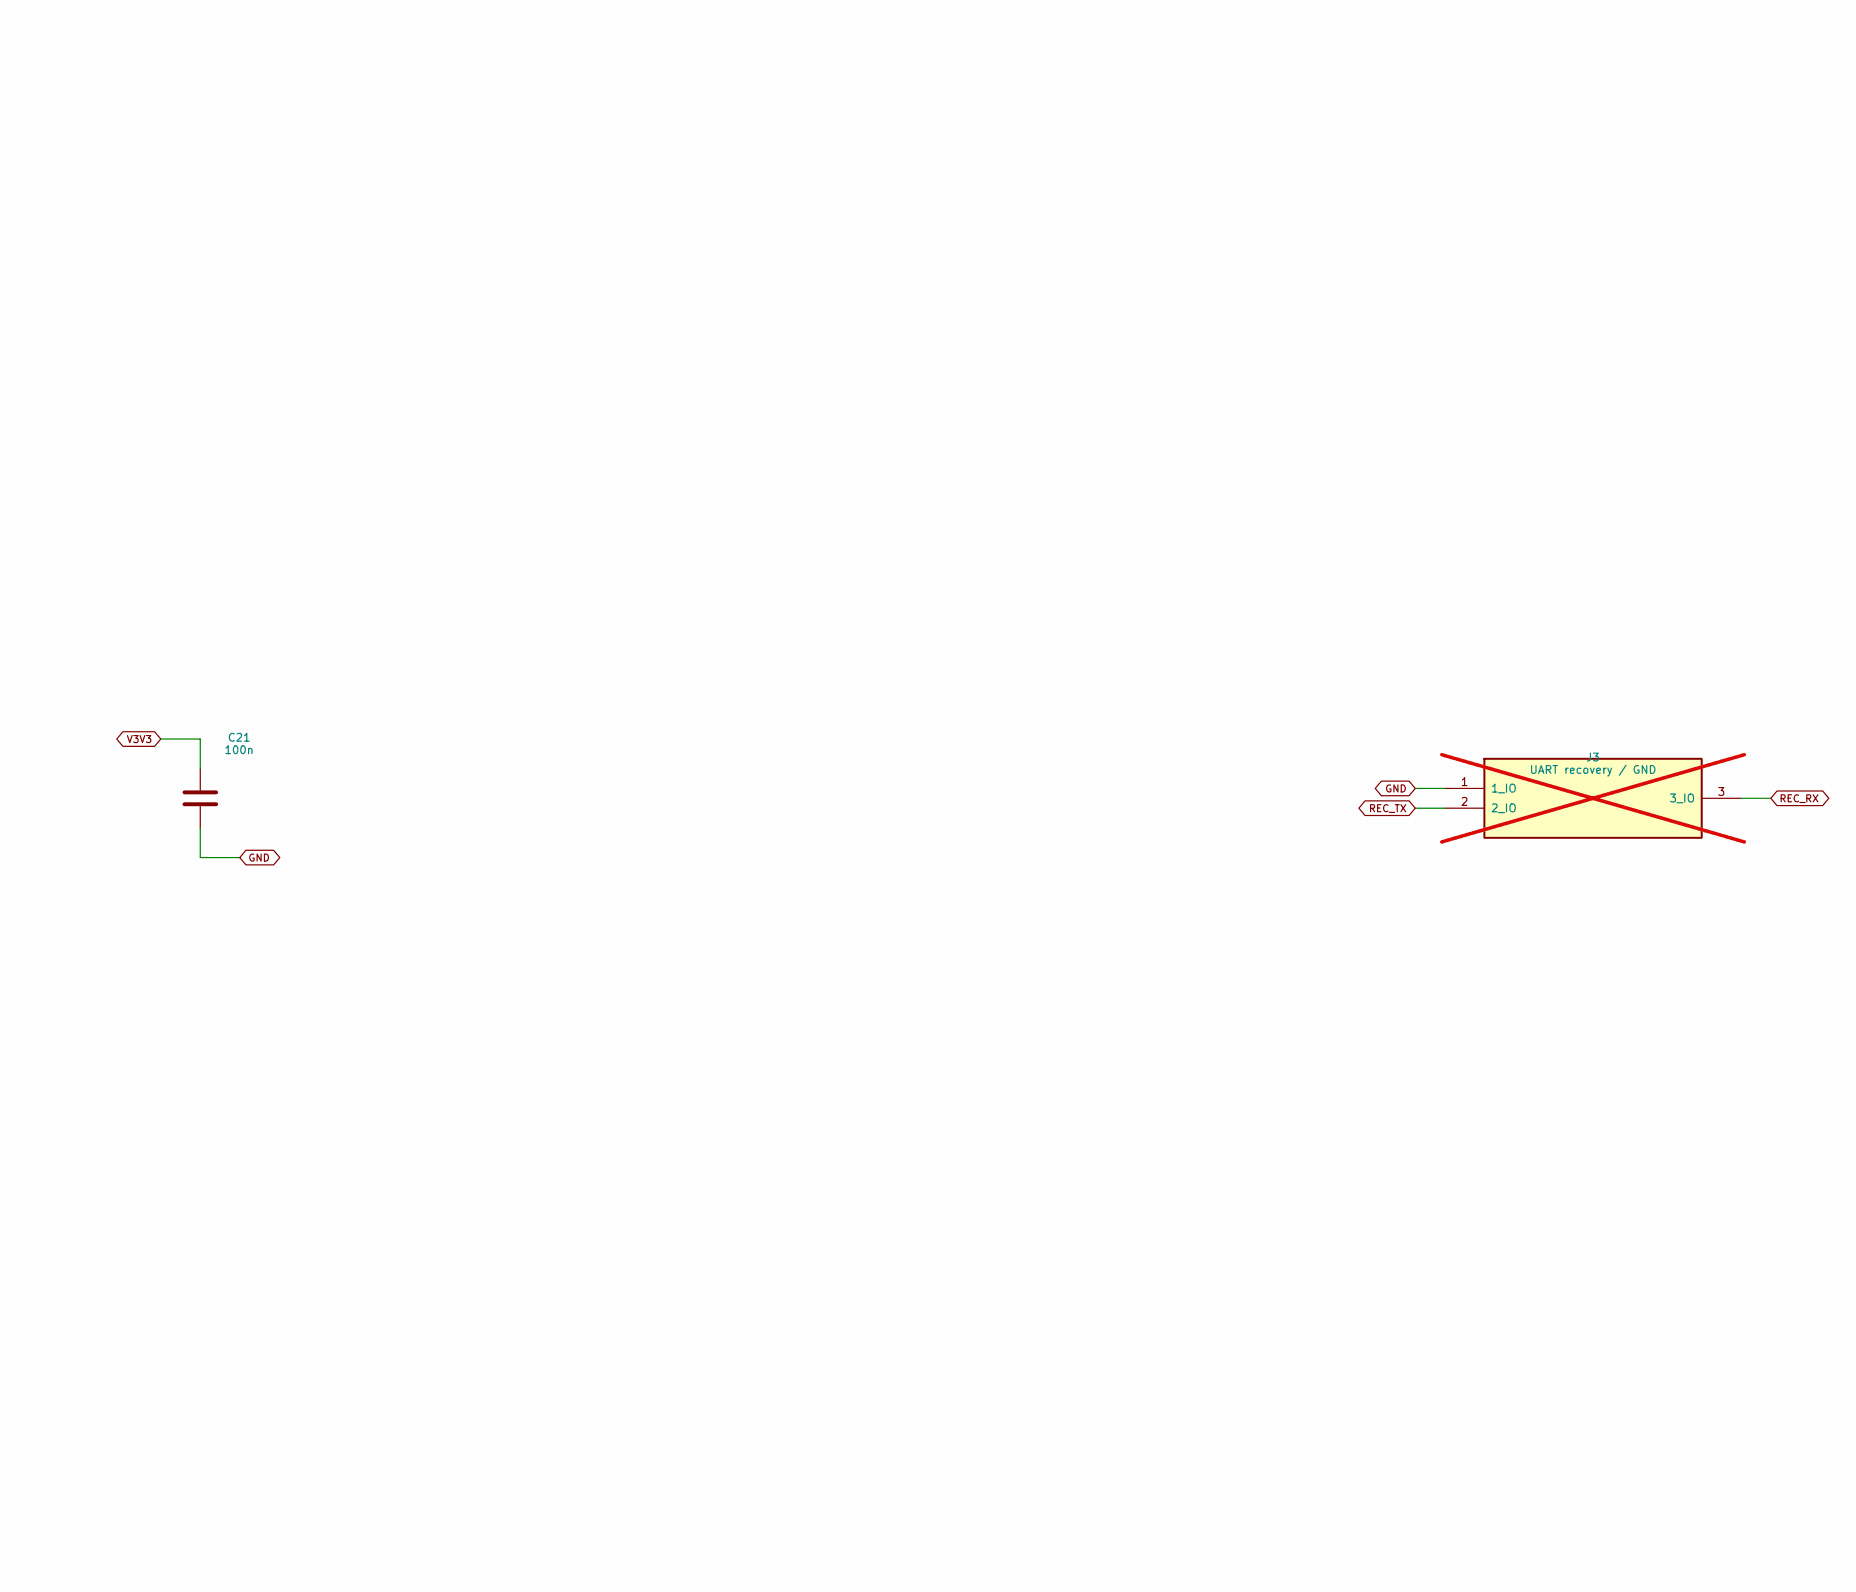
[picture p339: schematic 03_MCU.kicad_sch, 03 MCU / 1, part in row 1, column 2]

Parts:
C20: 10u 10V; C_0603_1608Metric_CTL; MPN CL10A106KP8NNNC
C21: 100n; C_0603_1608Metric_CTL; MPN CL10B104KB8NNNC
J3: UART recovery / GND; UART_61300311121; MPN 61300311121; not fitted
U10: ESP32-S3-WROOM-1U-N4; ESP32_S3_WROOM_1U_N4_L2; MPN ESP32-S3-WROOM-1U-N4

Connections:
AF_PWM: U10.6 (6_GPIO6); also elsewhere on the board
ARM: U10.34 (34_GPIO41); also elsewhere on the board
BAT_ADC: U10.39 (39_GPIO1); also elsewhere on the board
BOOT: U10.27 (27_GPIO0); also elsewhere on the board
GND: C20.2, C21.2, J3.1 (1_IO), U10.1 (1_GND), U10.40 (40_GND), U10.41 (41_GND_EP); also elsewhere on the board
INIT_OK: U10.22 (22_GPIO14); also elsewhere on the board
KEY: U10.24 (24_GPIO47); also elsewhere on the board
LEVEL_PWM: U10.7 (7_GPIO7); also elsewhere on the board
LORA_BUSY: U10.8 (8_GPIO15); also elsewhere on the board
LORA_DIO1: U10.9 (9_GPIO16); also elsewhere on the board
LORA_NSS: U10.18 (18_GPIO10); also elsewhere on the board
LORA_RESET: U10.33 (33_GPIO40); also elsewhere on the board
MCU_EN: U10.3 (3_EN); also elsewhere on the board
MODULE_ID_ADC: U10.4 (4_GPIO4); also elsewhere on the board
MUTE_RELEASE: U10.35 (35_GPIO42); also elsewhere on the board
PACK_ID_ADC: U10.38 (38_GPIO2); also elsewhere on the board
PA_RAIL_ADC: U10.5 (5_GPIO5); also elsewhere on the board
PROGRESS: U10.32 (32_GPIO39); also elsewhere on the board
REC_RX: J3.3 (3_IO); also elsewhere on the board
REC_TX: J3.2 (2_IO); also elsewhere on the board
RF2M_FAULT: U10.23 (23_GPIO21); also elsewhere on the board
RF2M_SCL: U10.11 (11_GPIO18); also elsewhere on the board
RF2M_SDA: U10.10 (10_GPIO17); also elsewhere on the board
RF80_FAULT: U10.28 (28_GPIO35); also elsewhere on the board
RTC80_SCL: U10.17 (17_GPIO9); also elsewhere on the board
RTC80_SDA: U10.12 (12_GPIO8); also elsewhere on the board
SHIFT_LATCH: U10.31 (31_GPIO38); also elsewhere on the board
SLOT: U10.25 (25_GPIO48); also elsewhere on the board
SPI_MISO: U10.21 (21_GPIO13); also elsewhere on the board
SPI_MOSI: U10.19 (19_GPIO11); also elsewhere on the board
SPI_SCK: U10.20 (20_GPIO12); also elsewhere on the board
START_N: U10.29 (29_GPIO36); also elsewhere on the board
STRAP3: U10.15 (15_GPIO3); also elsewhere on the board
STRAP46: U10.16 (16_GPIO46); also elsewhere on the board
UART_RX: U10.36 (36_GPIO44); also elsewhere on the board
UART_TX: U10.37 (37_GPIO43); also elsewhere on the board
USB_DM: U10.13 (13_GPIO19); also elsewhere on the board
USB_DP: U10.14 (14_GPIO20); also elsewhere on the board
USB_VBUS_N: U10.30 (30_GPIO37); also elsewhere on the board
V3V3: C20.1, C21.1, U10.2 (2_3V3); also elsewhere on the board

Notes on the sheet:
03 MCU / 1
M6-C1R1 candidate: REVIEW / ALL hardware measurements NOT RUN / no ordering or manufacture.

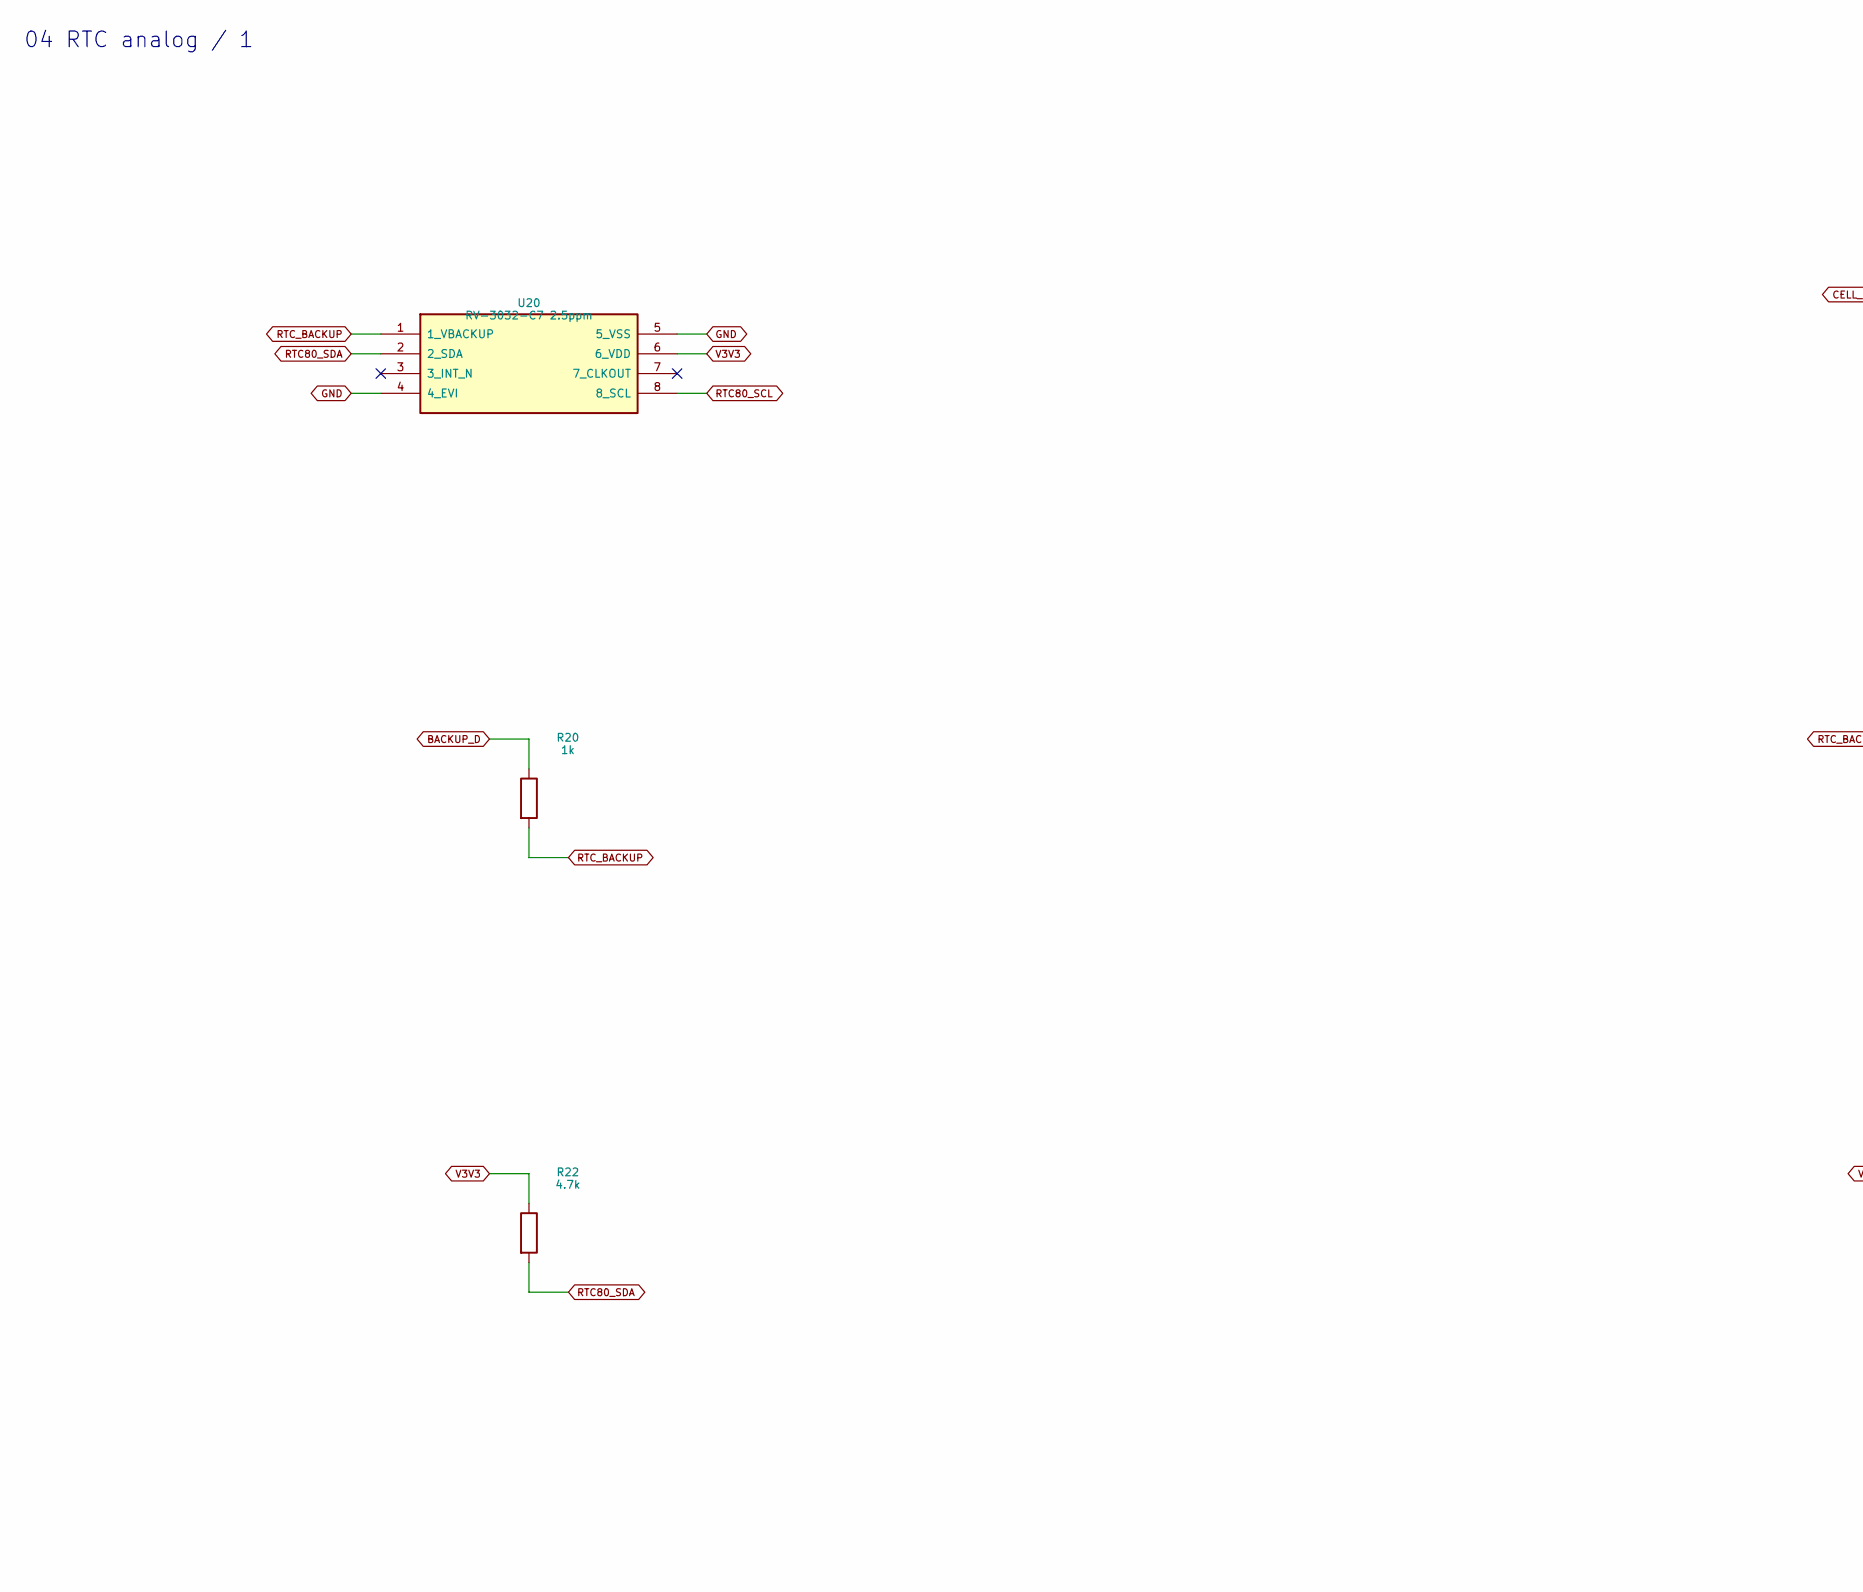
[picture p340: schematic 04_RTC_analog.kicad_sch, 04 RTC analog / 1, part in row 1, column 1]

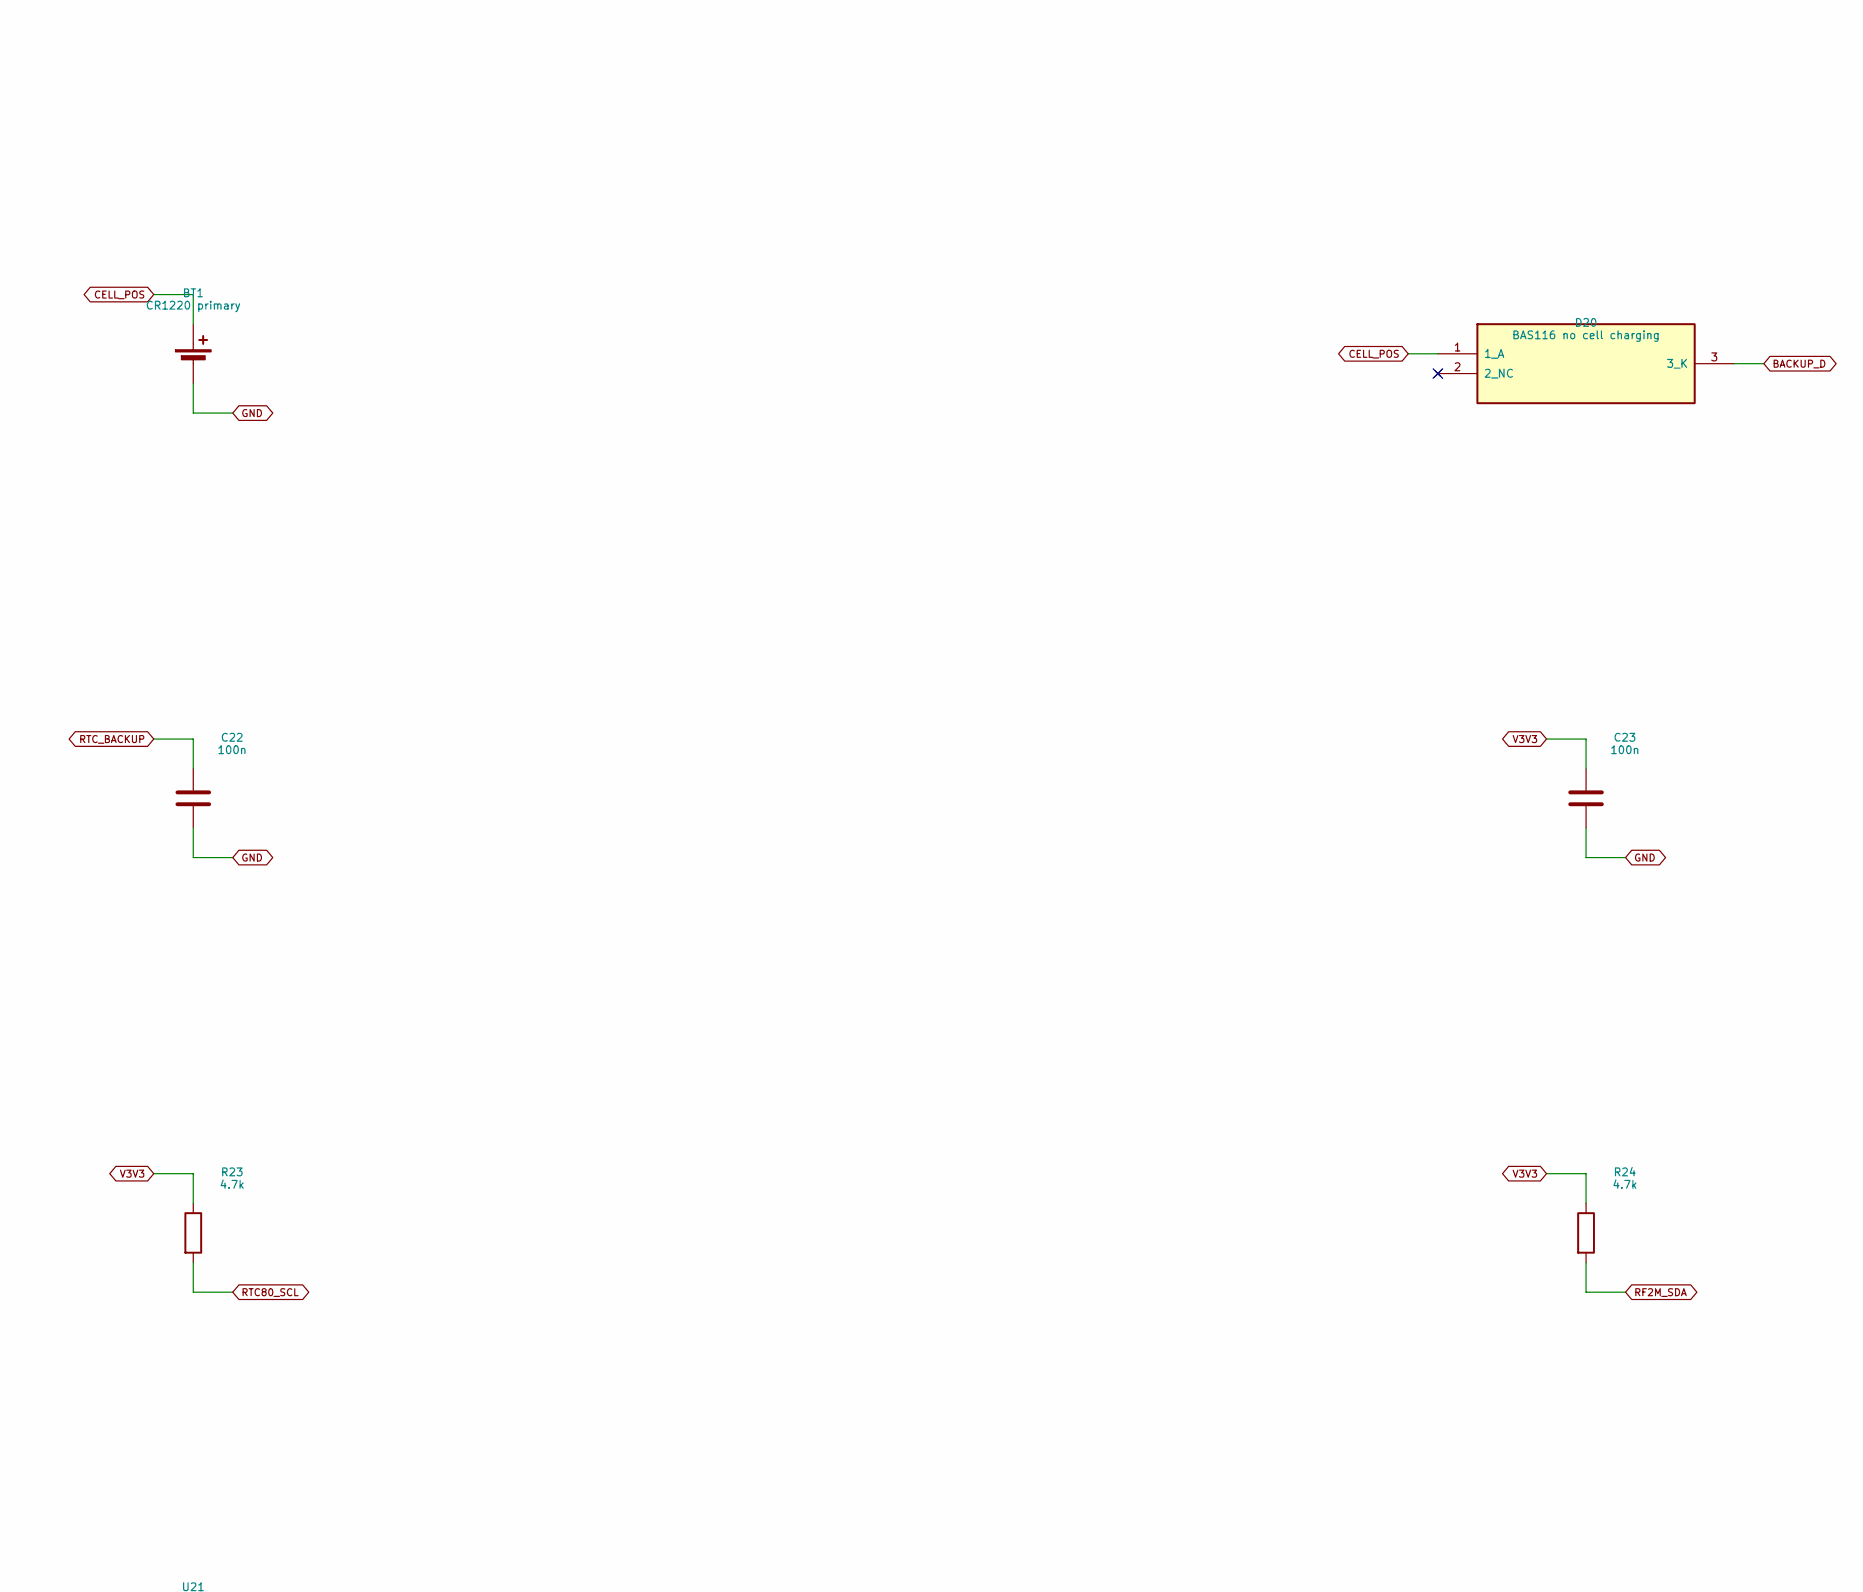
[picture p341: schematic 04_RTC_analog.kicad_sch, 04 RTC analog / 1, part in row 1, column 2]

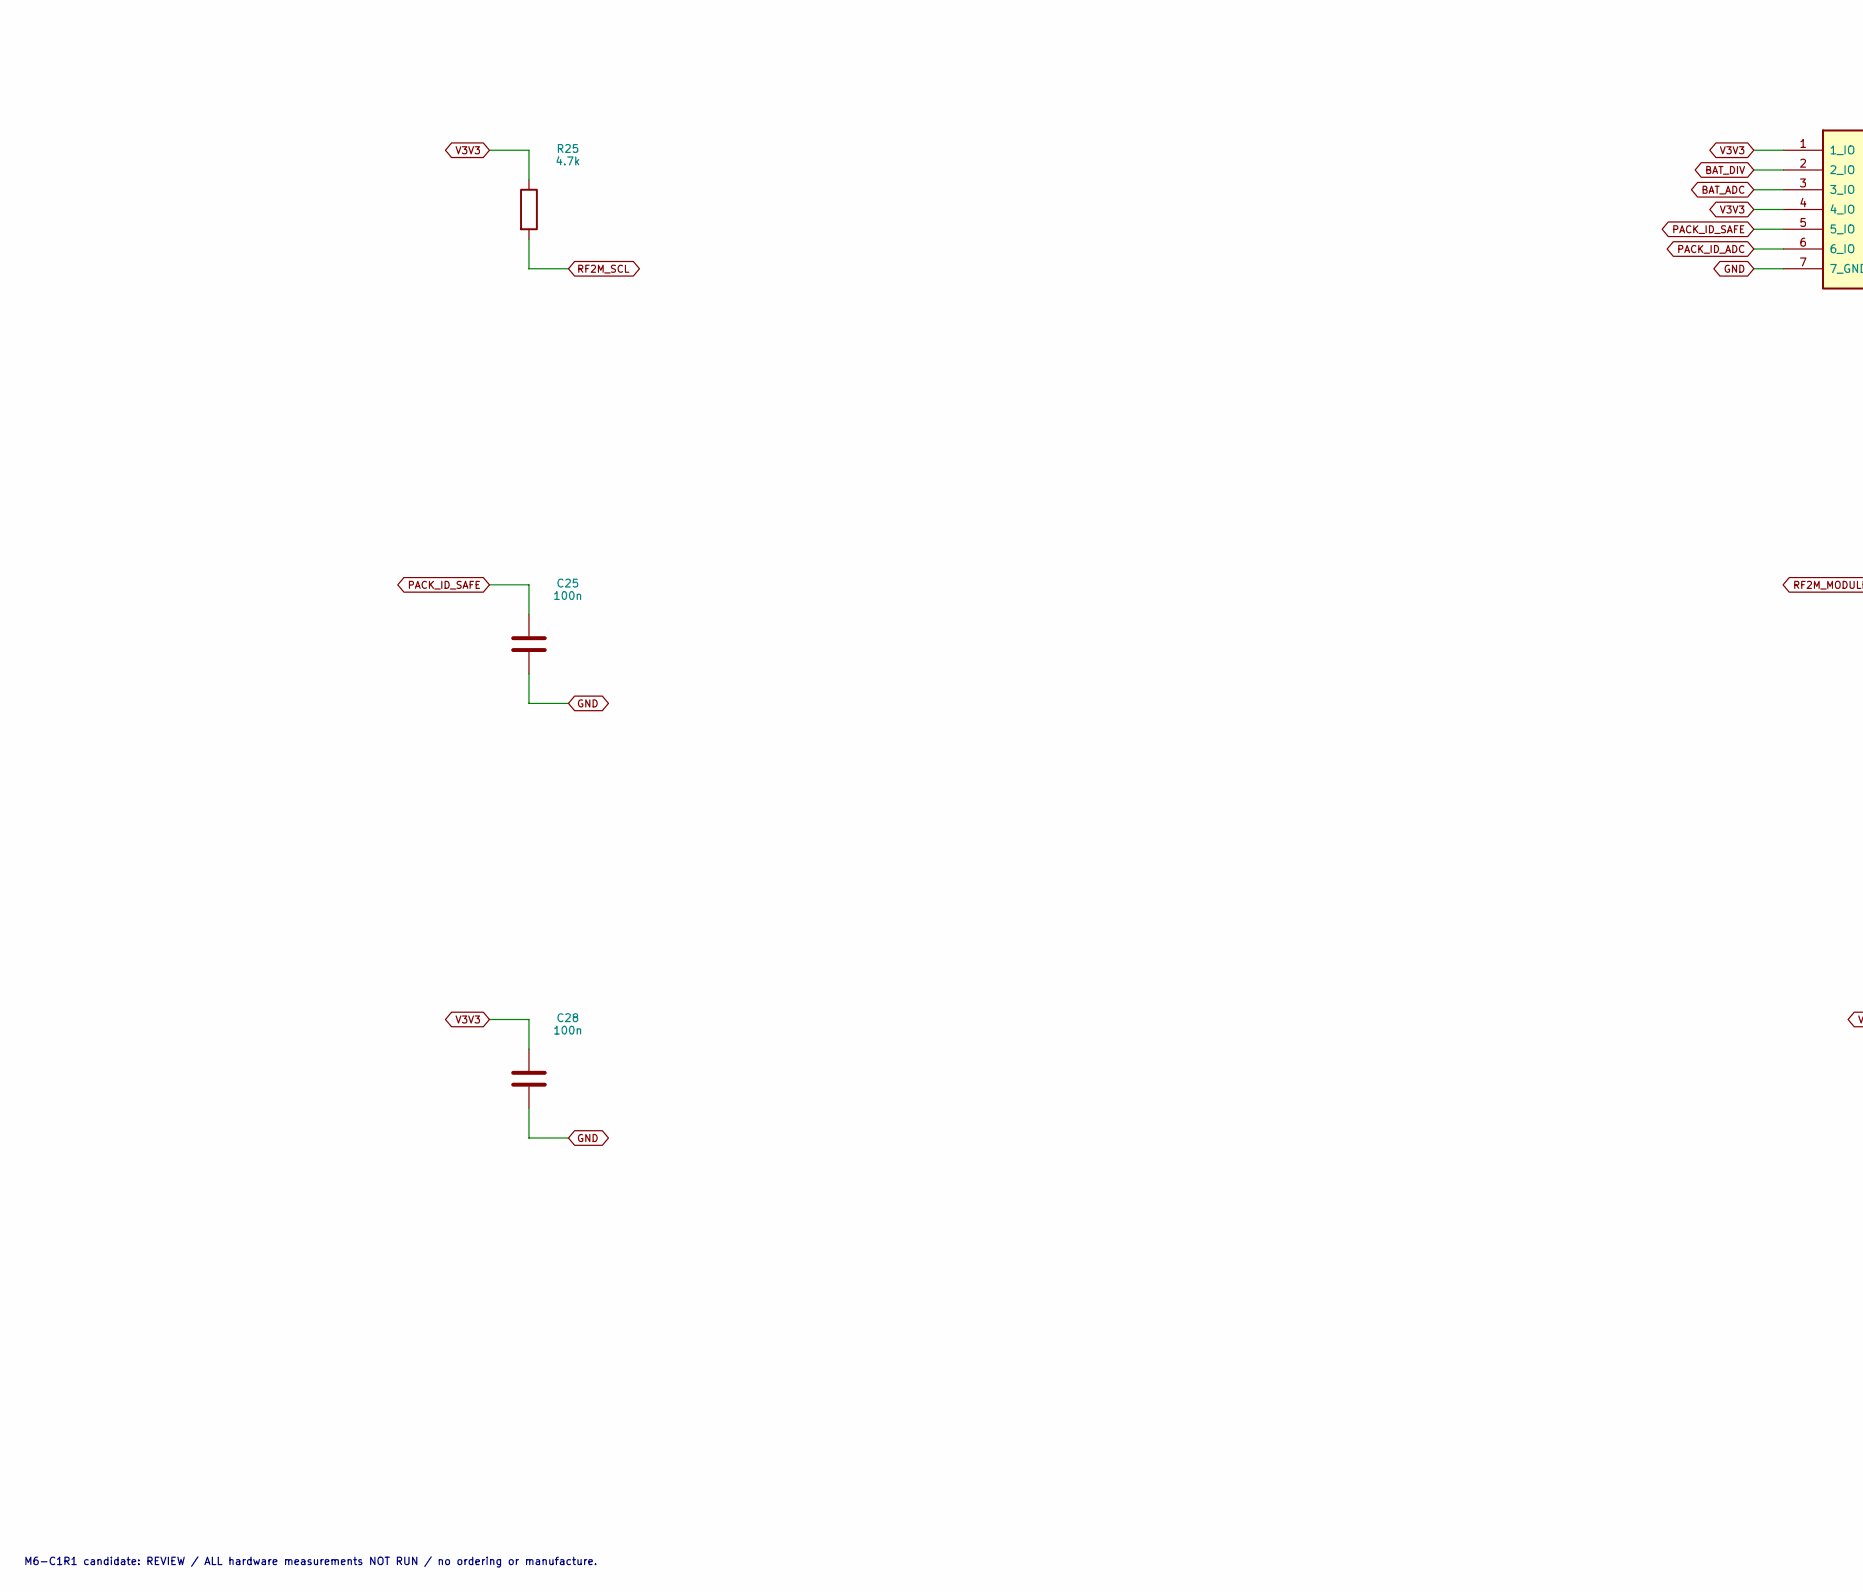
[picture p342: schematic 04_RTC_analog.kicad_sch, 04 RTC analog / 1, part in row 2, column 1]

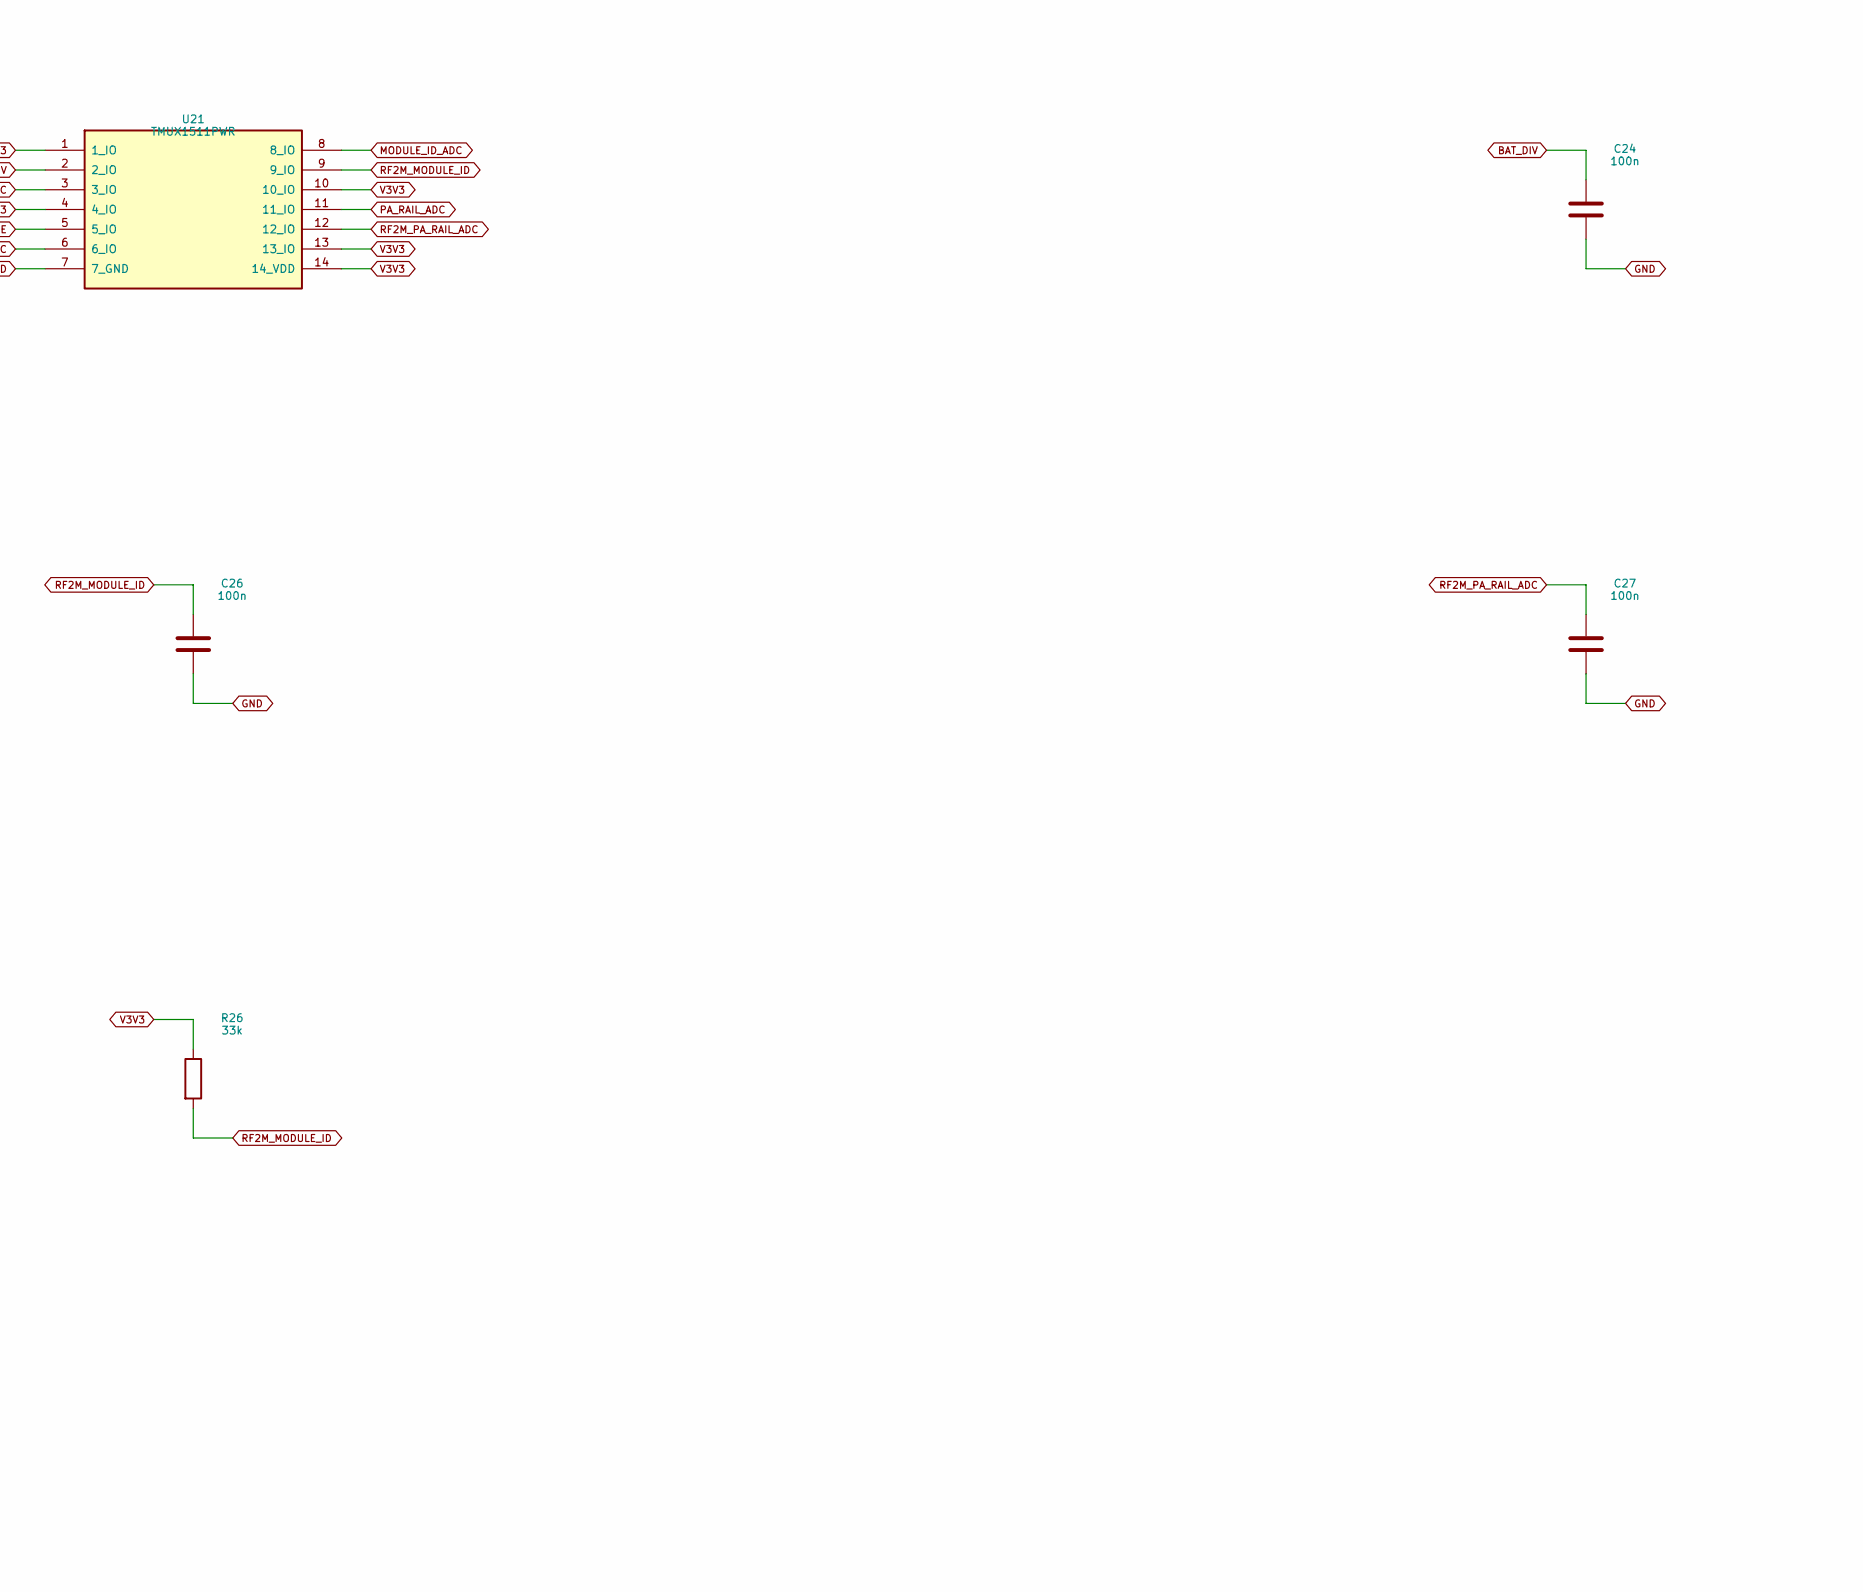
[picture p343: schematic 04_RTC_analog.kicad_sch, 04 RTC analog / 1, part in row 2, column 2]

Parts:
BT1: CR1220 primary; BatteryHolder_Keystone_3000_1x12mm_CTL; MPN 3000
C22, C23, C24, C25, C26, C27, C28: 100n; C_0603_1608Metric_CTL; MPN CL10B104KB8NNNC
D20: BAS116 no cell charging; SOT-23_CTL; MPN BAS116,115
R20: 1k; R_0603_1608Metric_CTL; MPN RC0603FR-071KL
R22, R23, R24, R25: 4.7k; R_0603_1608Metric_CTL; MPN RC0603FR-074K7L
R26: 33k; R_0603_1608Metric_CTL; MPN RC0603FR-0733KL
U20: RV-3032-C7 2.5ppm; RV3032_C7; MPN RV-3032-C7-32.768KHZ-2.5PPM-TA-QA
U21: TMUX1511PWR; TSSOP-14_4.4x5mm_P0.65mm_CTL; MPN TMUX1511PWR

Connections:
BACKUP_D: D20.3 (3_K), R20.1
BAT_ADC: U21.3 (3_IO); also elsewhere on the board
BAT_DIV: C24.1, U21.2 (2_IO); also elsewhere on the board
CELL_POS: BT1.1 (+), D20.1 (1_A)
GND: BT1.2 (-), C22.2, C23.2, C24.2, C25.2, C26.2, C27.2, C28.2, U20.4 (4_EVI), U20.5 (5_VSS), U21.7 (7_GND); also elsewhere on the board
MODULE_ID_ADC: U21.8 (8_IO); also elsewhere on the board
PACK_ID_ADC: U21.6 (6_IO); also elsewhere on the board
PACK_ID_SAFE: C25.1, U21.5 (5_IO); also elsewhere on the board
PA_RAIL_ADC: U21.11 (11_IO); also elsewhere on the board
RF2M_MODULE_ID: C26.1, R26.2, U21.9 (9_IO); also elsewhere on the board
RF2M_PA_RAIL_ADC: C27.1, U21.12 (12_IO); also elsewhere on the board
RF2M_SCL: R25.2; also elsewhere on the board
RF2M_SDA: R24.2; also elsewhere on the board
RTC80_SCL: R23.2, U20.8 (8_SCL); also elsewhere on the board
RTC80_SDA: R22.2, U20.2 (2_SDA); also elsewhere on the board
RTC_BACKUP: C22.1, R20.2, U20.1 (1_VBACKUP)
V3V3: C23.1, C28.1, R22.1, R23.1, R24.1, R25.1, R26.1, U20.6 (6_VDD), U21.1 (1_IO), U21.4 (4_IO), U21.10 (10_IO), U21.13 (13_IO), U21.14 (14_VDD); also elsewhere on the board

Notes on the sheet:
04 RTC analog / 1
M6-C1R1 candidate: REVIEW / ALL hardware measurements NOT RUN / no ordering or manufacture.
