DD1SB/ARDF-TX/hardware/controller/CTRL.kicad_pcb

## KiCad design hardware/controller/CTRL.kicad_pcb (continued)

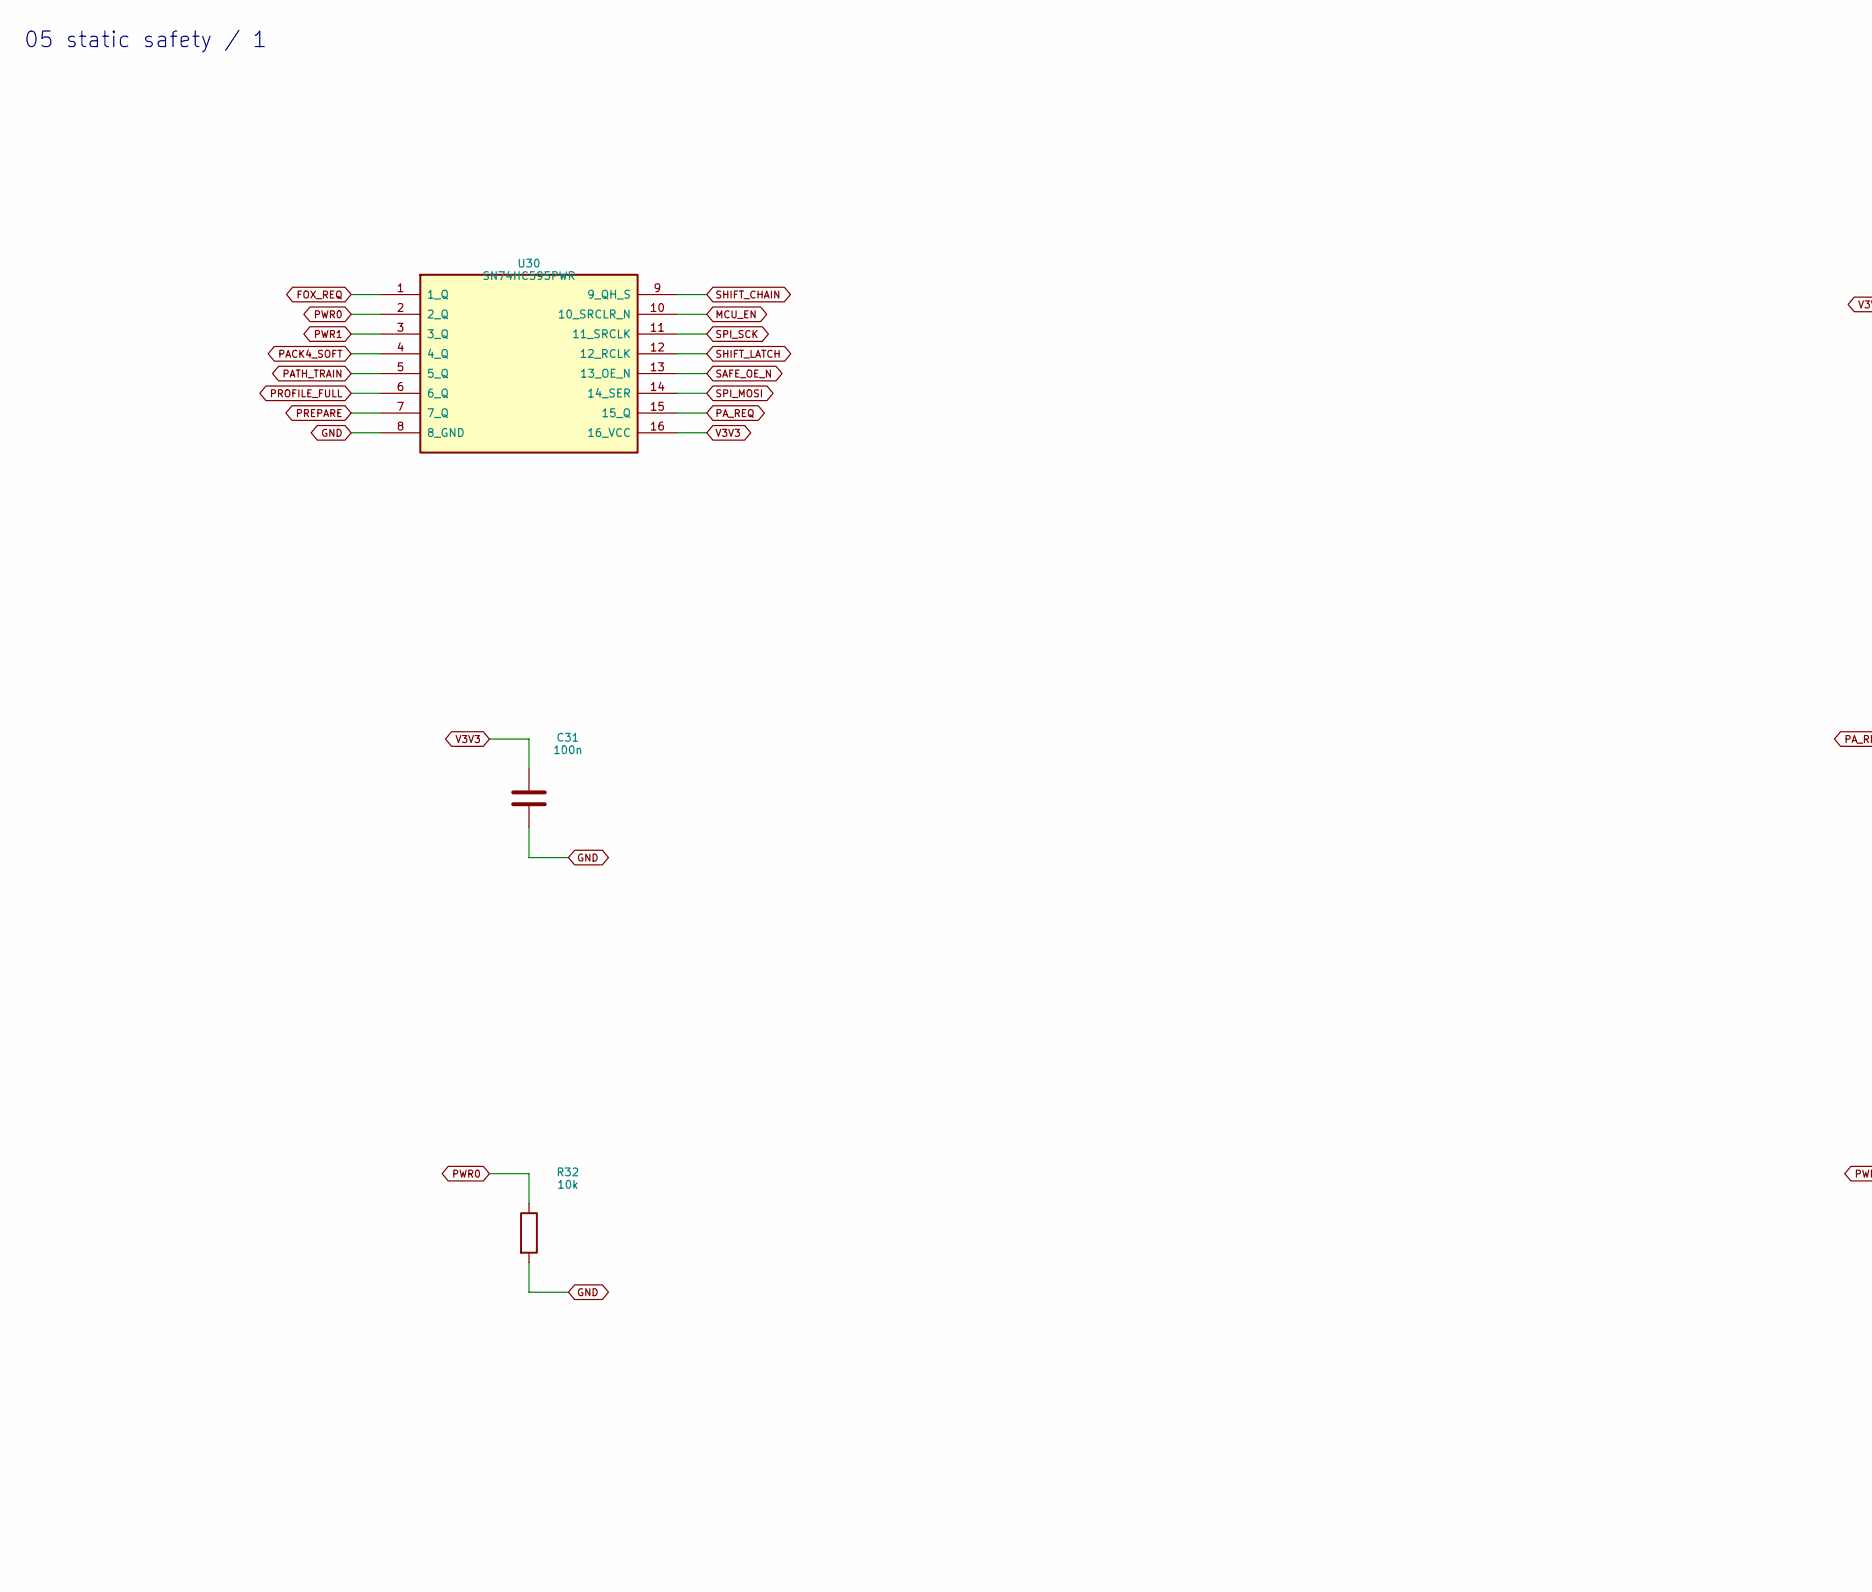
[picture p344: schematic 05_static_safety.kicad_sch, 05 static safety / 1, part in row 1, column 1]

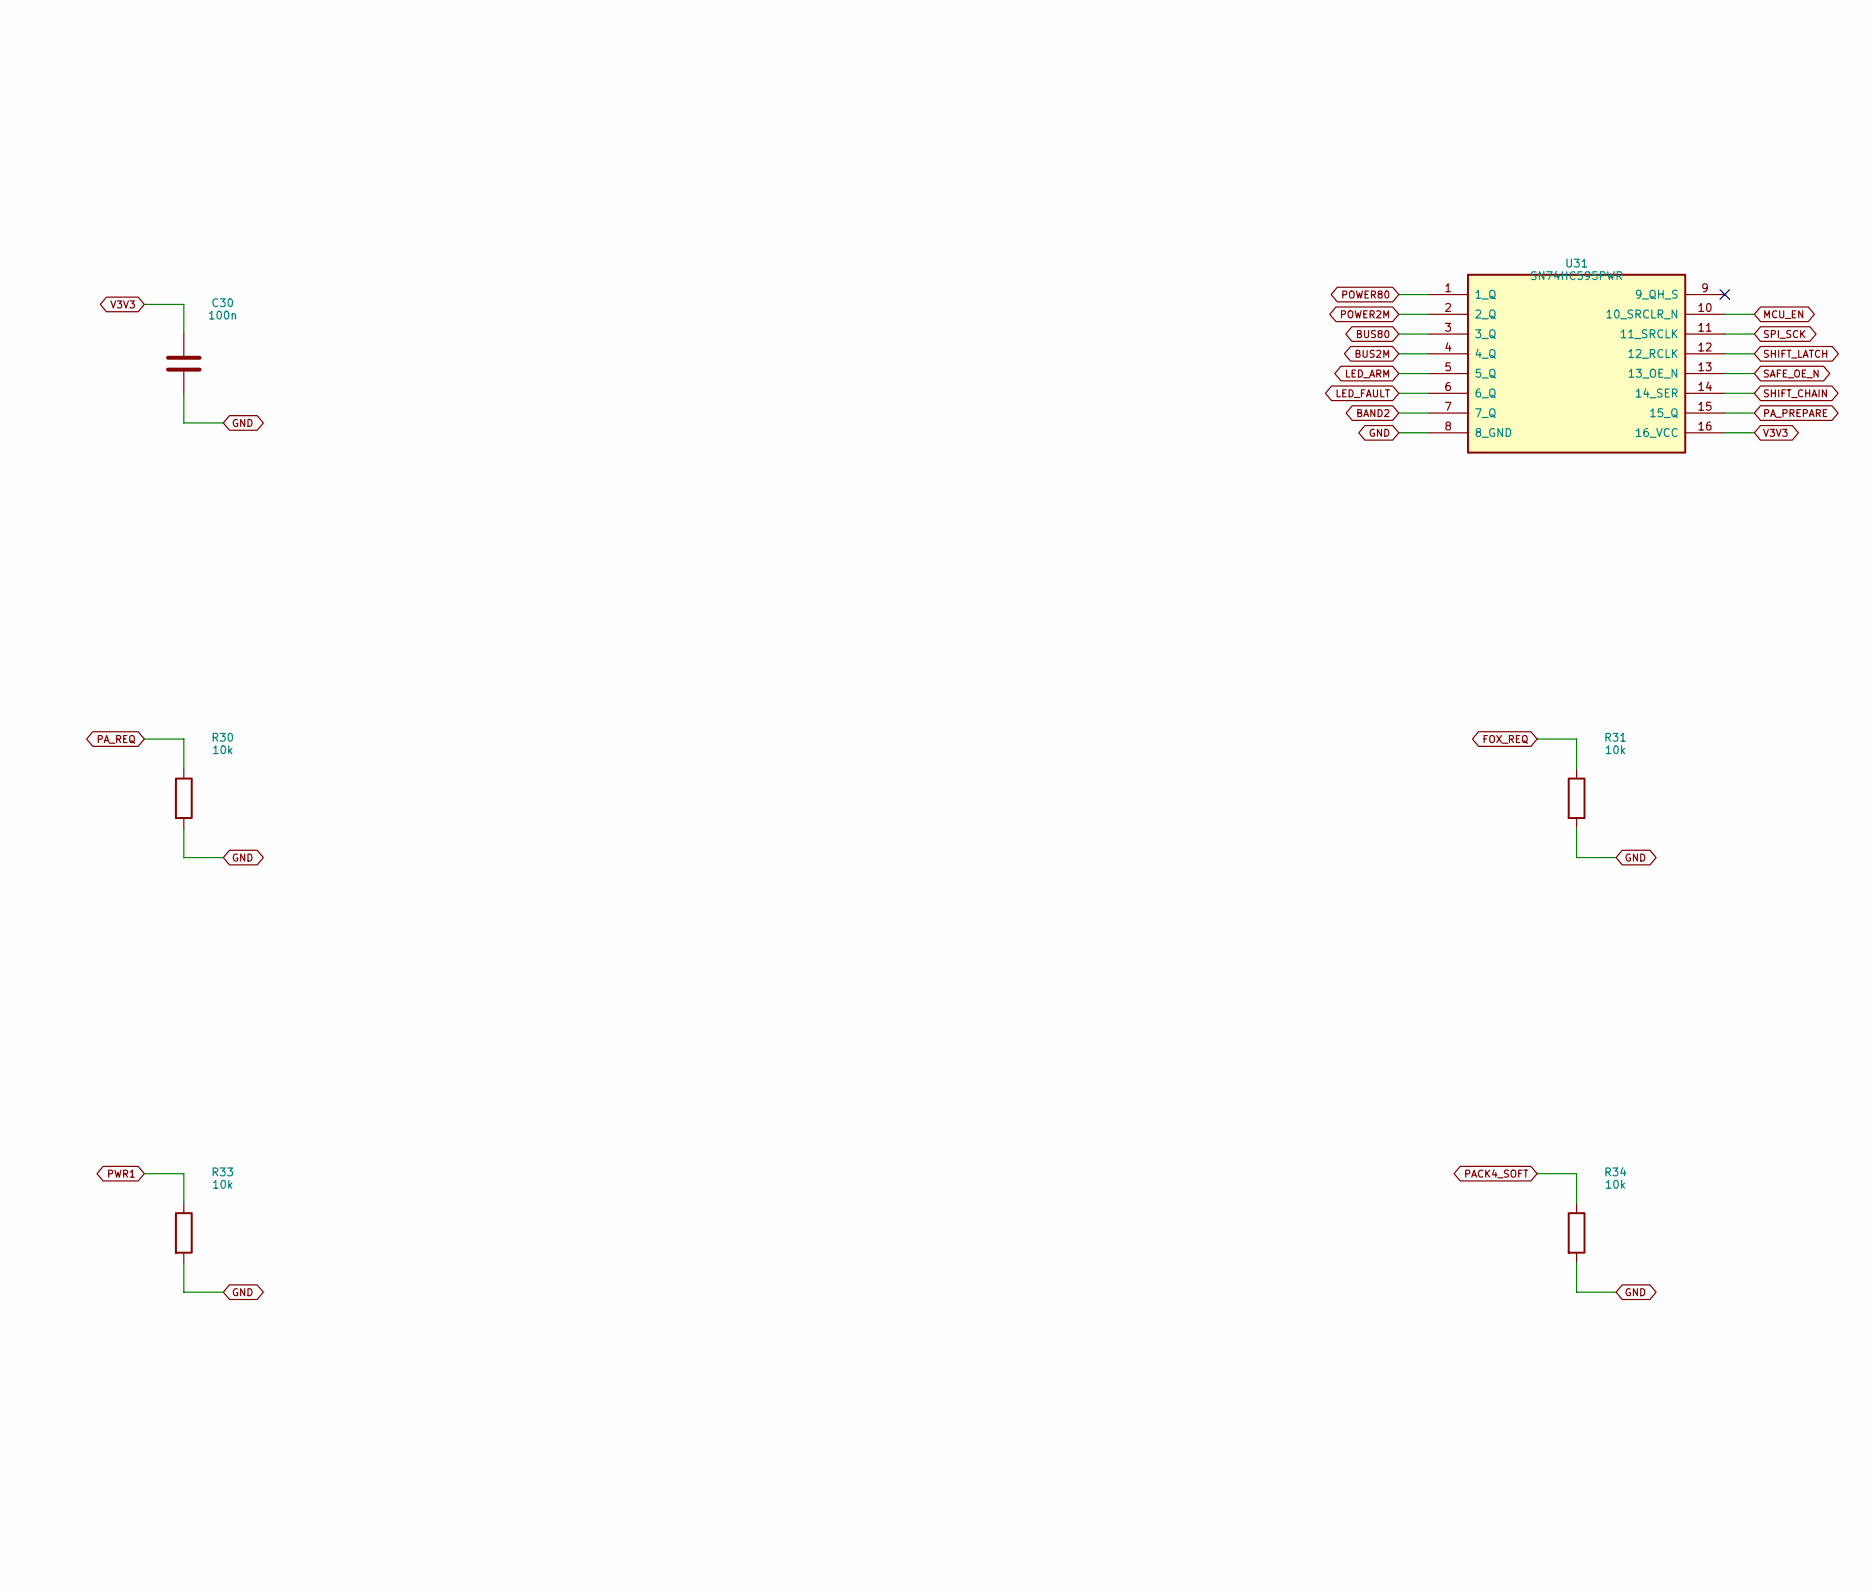
[picture p345: schematic 05_static_safety.kicad_sch, 05 static safety / 1, part in row 1, column 2]

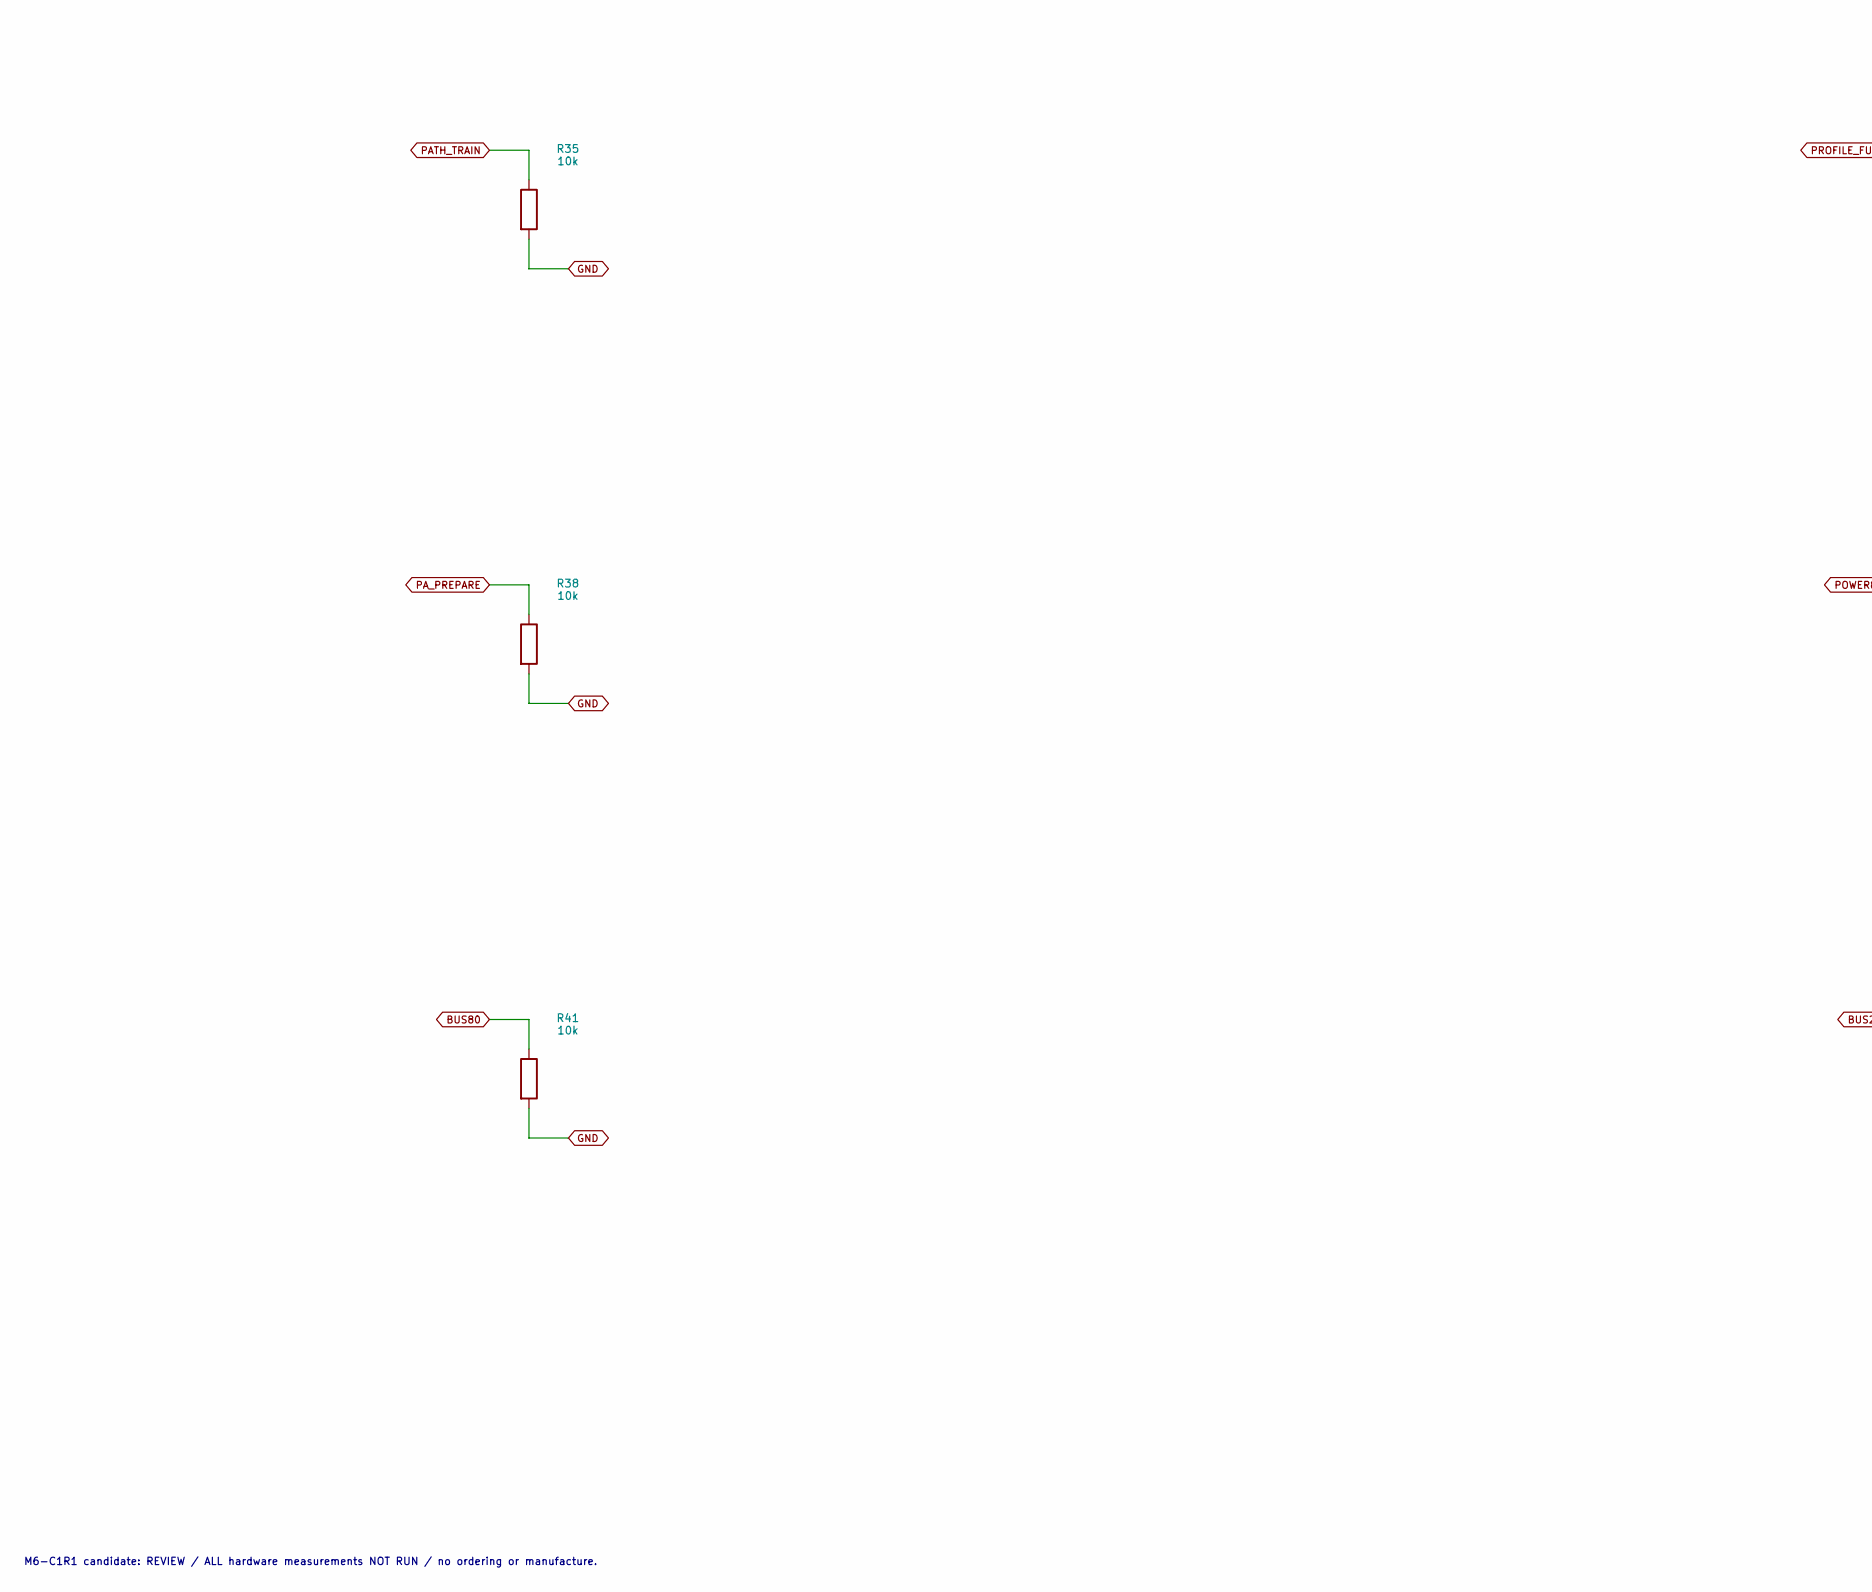
[picture p346: schematic 05_static_safety.kicad_sch, 05 static safety / 1, part in row 2, column 1]

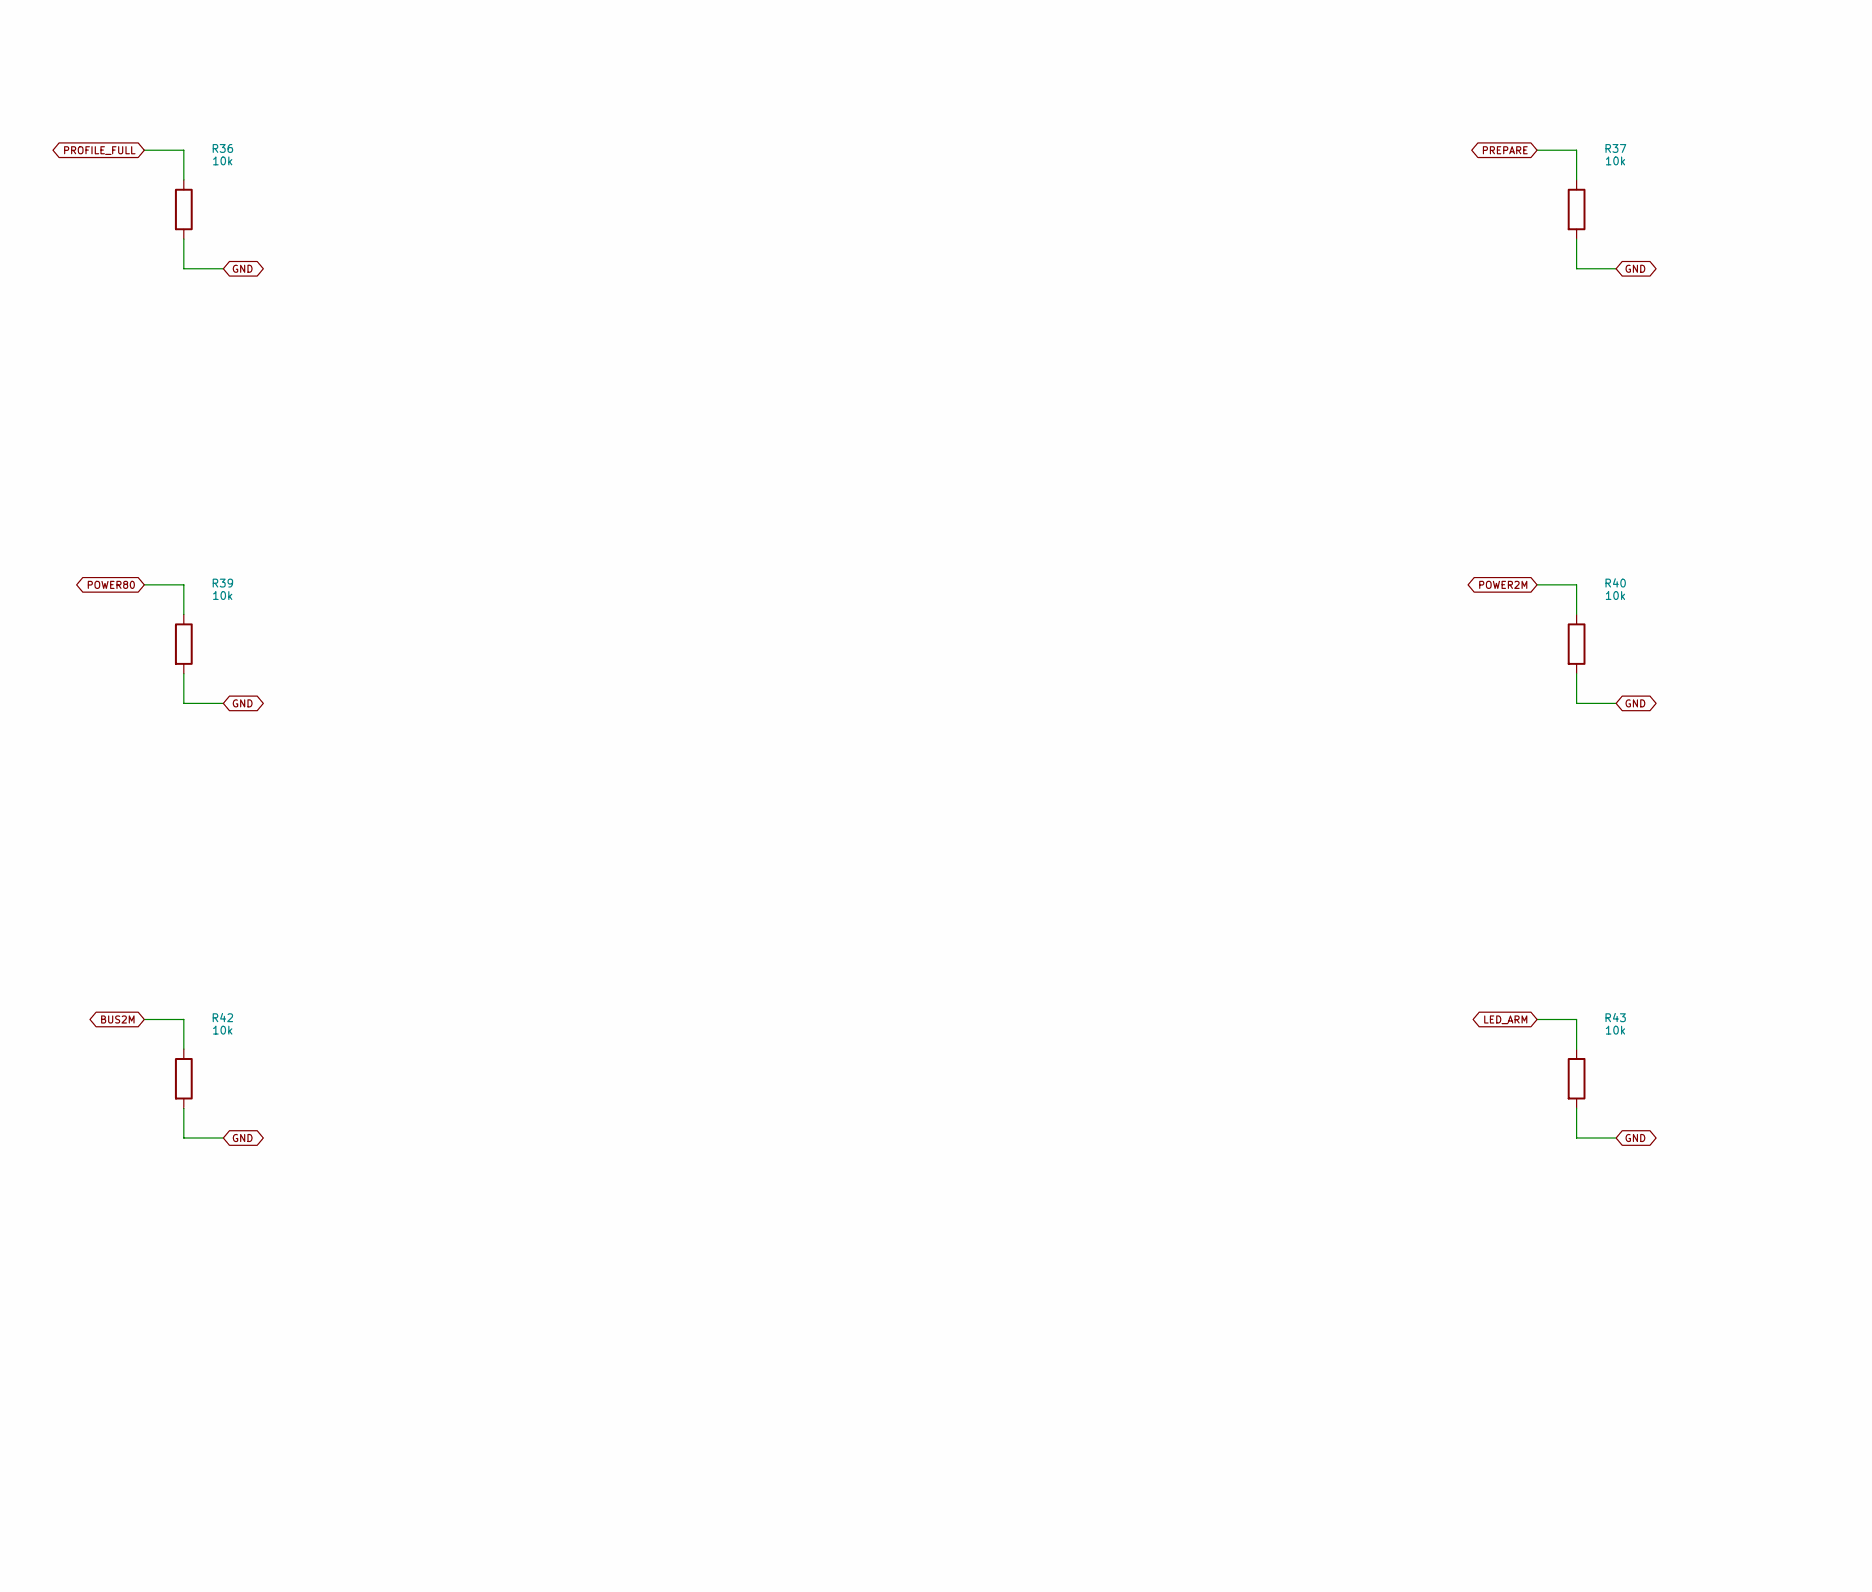
[picture p347: schematic 05_static_safety.kicad_sch, 05 static safety / 1, part in row 2, column 2]

Parts:
C30, C31: 100n; C_0603_1608Metric_CTL; MPN CL10B104KB8NNNC
R30, R31, R32, R33, R34, R35, R36, R37, R38, R39, R40, R41, R42, R43: 10k; R_0603_1608Metric_CTL; MPN RC0603FR-0710KL
U30, U31: SN74HC595PWR; TSSOP-16_4.4x5mm_P0.65mm_CTL; MPN SN74HC595PWR

Connections:
BAND2: U31.7 (7_Q); also elsewhere on the board
BUS2M: R42.1, U31.4 (4_Q); also elsewhere on the board
BUS80: R41.1, U31.3 (3_Q); also elsewhere on the board
FOX_REQ: R31.1, U30.1 (1_Q); also elsewhere on the board
GND: C30.2, C31.2, R30.2, R31.2, R32.2, R33.2, R34.2, R35.2, R36.2, R37.2, R38.2, R39.2, R40.2, R41.2, R42.2, R43.2, U30.8 (8_GND), U31.8 (8_GND); also elsewhere on the board
LED_ARM: R43.1, U31.5 (5_Q); also elsewhere on the board
LED_FAULT: U31.6 (6_Q); also elsewhere on the board
MCU_EN: U30.10 (10_SRCLR_N), U31.10 (10_SRCLR_N); also elsewhere on the board
PACK4_SOFT: R34.1, U30.4 (4_Q); also elsewhere on the board
PATH_TRAIN: R35.1, U30.5 (5_Q); also elsewhere on the board
PA_PREPARE: R38.1, U31.15 (15_Q); also elsewhere on the board
PA_REQ: R30.1, U30.15 (15_Q); also elsewhere on the board
POWER2M: R40.1, U31.2 (2_Q); also elsewhere on the board
POWER80: R39.1, U31.1 (1_Q); also elsewhere on the board
PREPARE: R37.1, U30.7 (7_Q); also elsewhere on the board
PROFILE_FULL: R36.1, U30.6 (6_Q); also elsewhere on the board
PWR0: R32.1, U30.2 (2_Q); also elsewhere on the board
PWR1: R33.1, U30.3 (3_Q); also elsewhere on the board
SAFE_OE_N: U30.13 (13_OE_N), U31.13 (13_OE_N); also elsewhere on the board
SHIFT_CHAIN: U30.9 (9_QH_S), U31.14 (14_SER)
SHIFT_LATCH: U30.12 (12_RCLK), U31.12 (12_RCLK); also elsewhere on the board
SPI_MOSI: U30.14 (14_SER); also elsewhere on the board
SPI_SCK: U30.11 (11_SRCLK), U31.11 (11_SRCLK); also elsewhere on the board
V3V3: C30.1, C31.1, U30.16 (16_VCC), U31.16 (16_VCC); also elsewhere on the board

Notes on the sheet:
05 static safety / 1
M6-C1R1 candidate: REVIEW / ALL hardware measurements NOT RUN / no ordering or manufacture.
