DD1SB/ARDF-TX/hardware/controller/CTRL.kicad_pcb

## KiCad design hardware/controller/CTRL.kicad_pcb (continued)

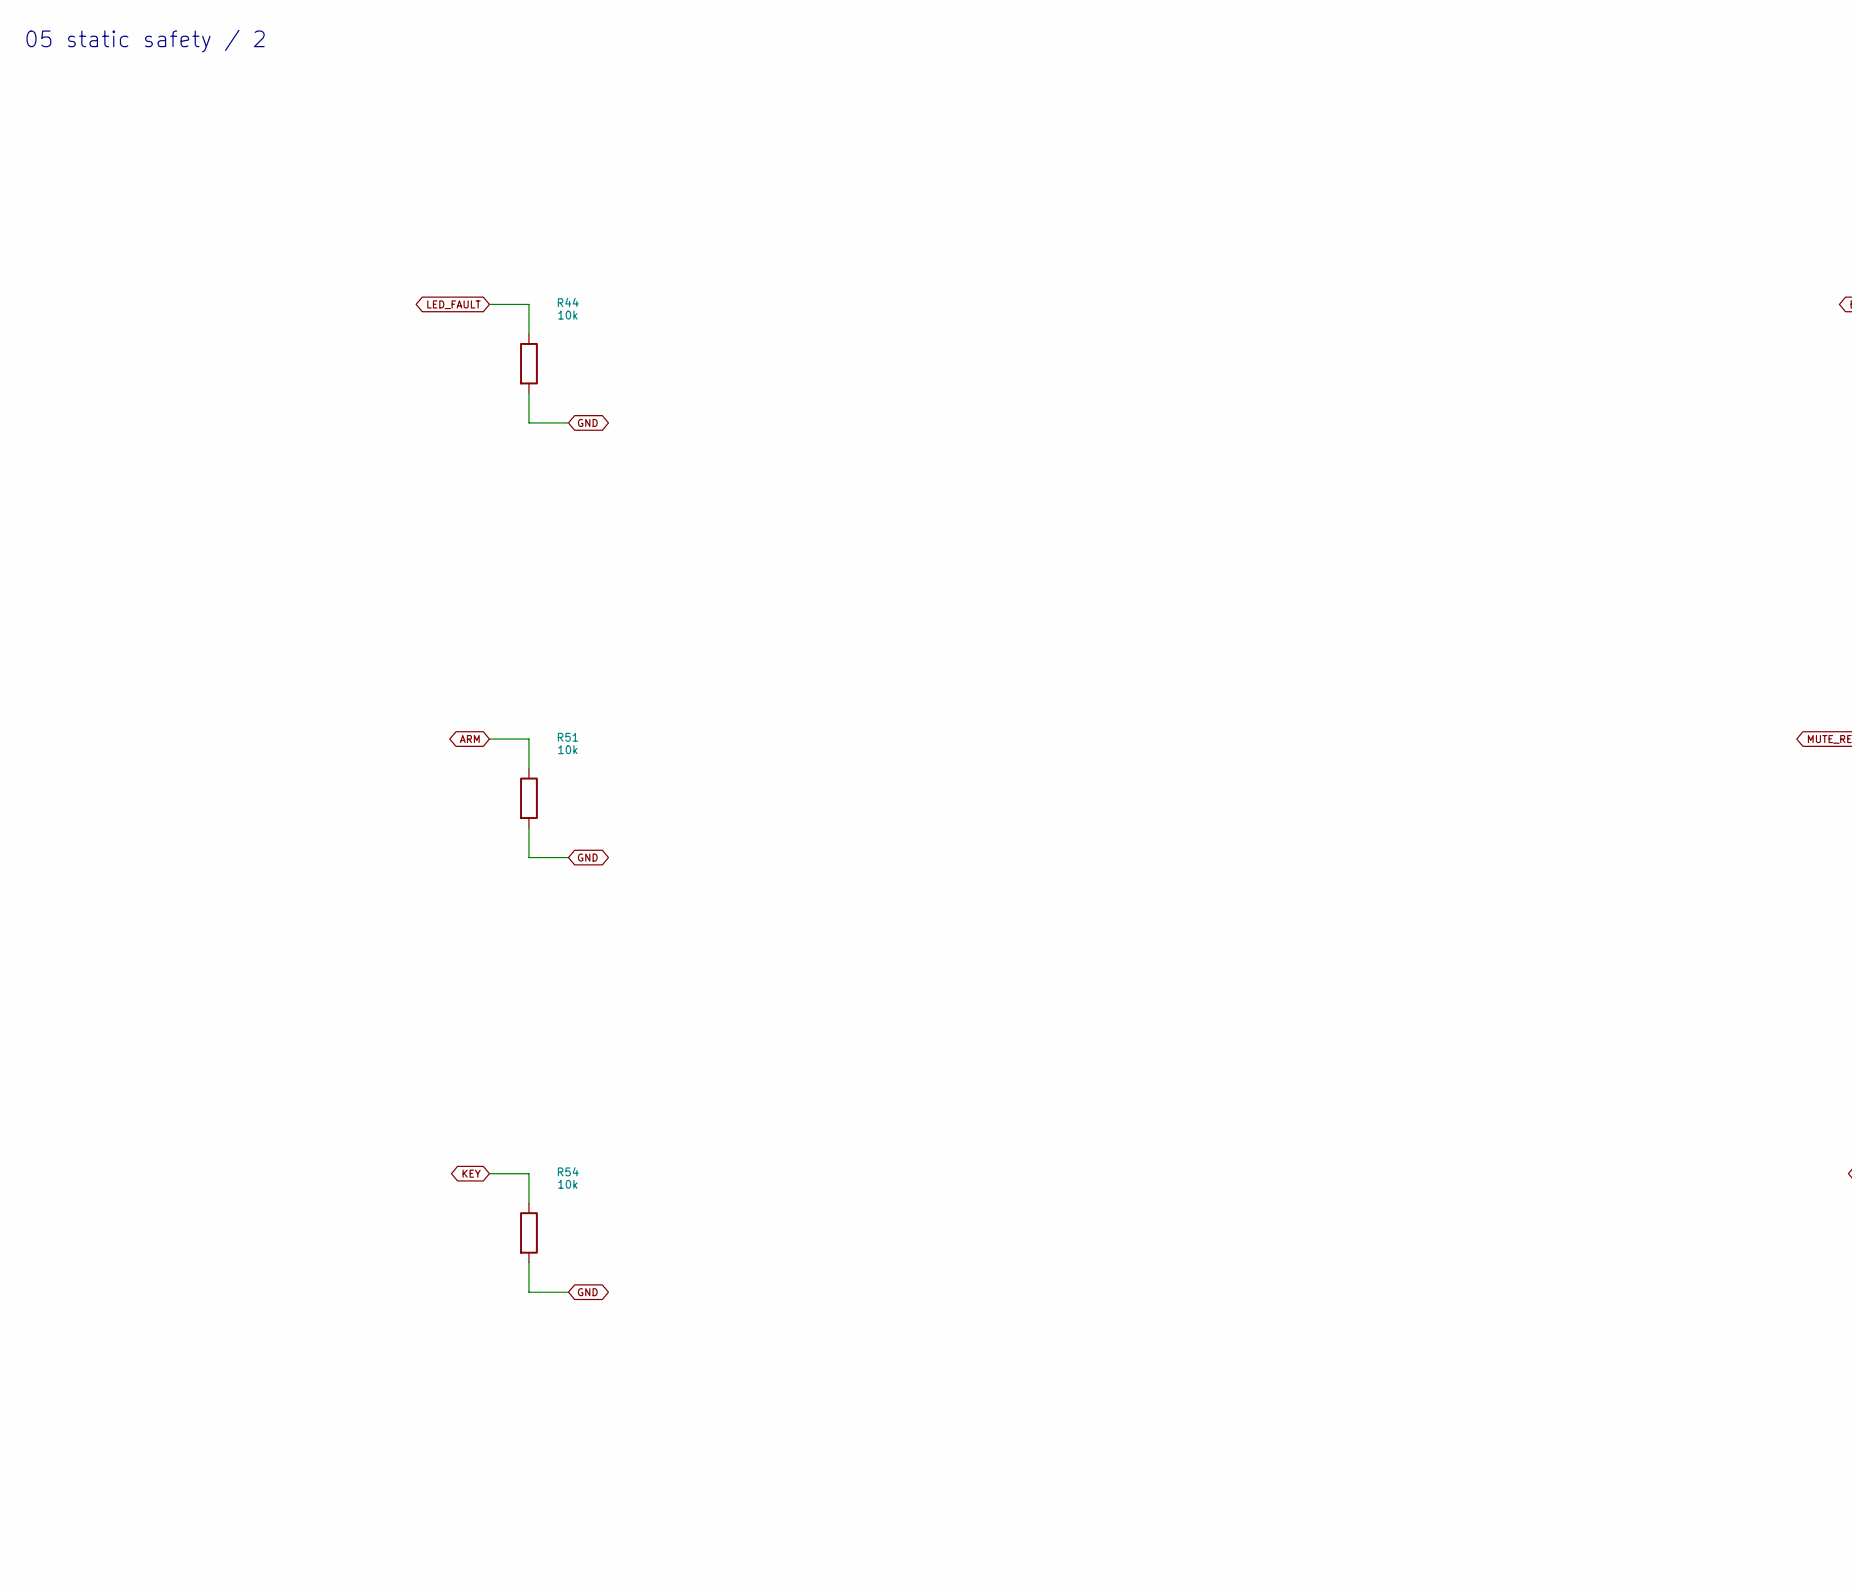
[picture p348: schematic 05_static_safety_2.kicad_sch, 05 static safety / 2, part in row 1, column 1]

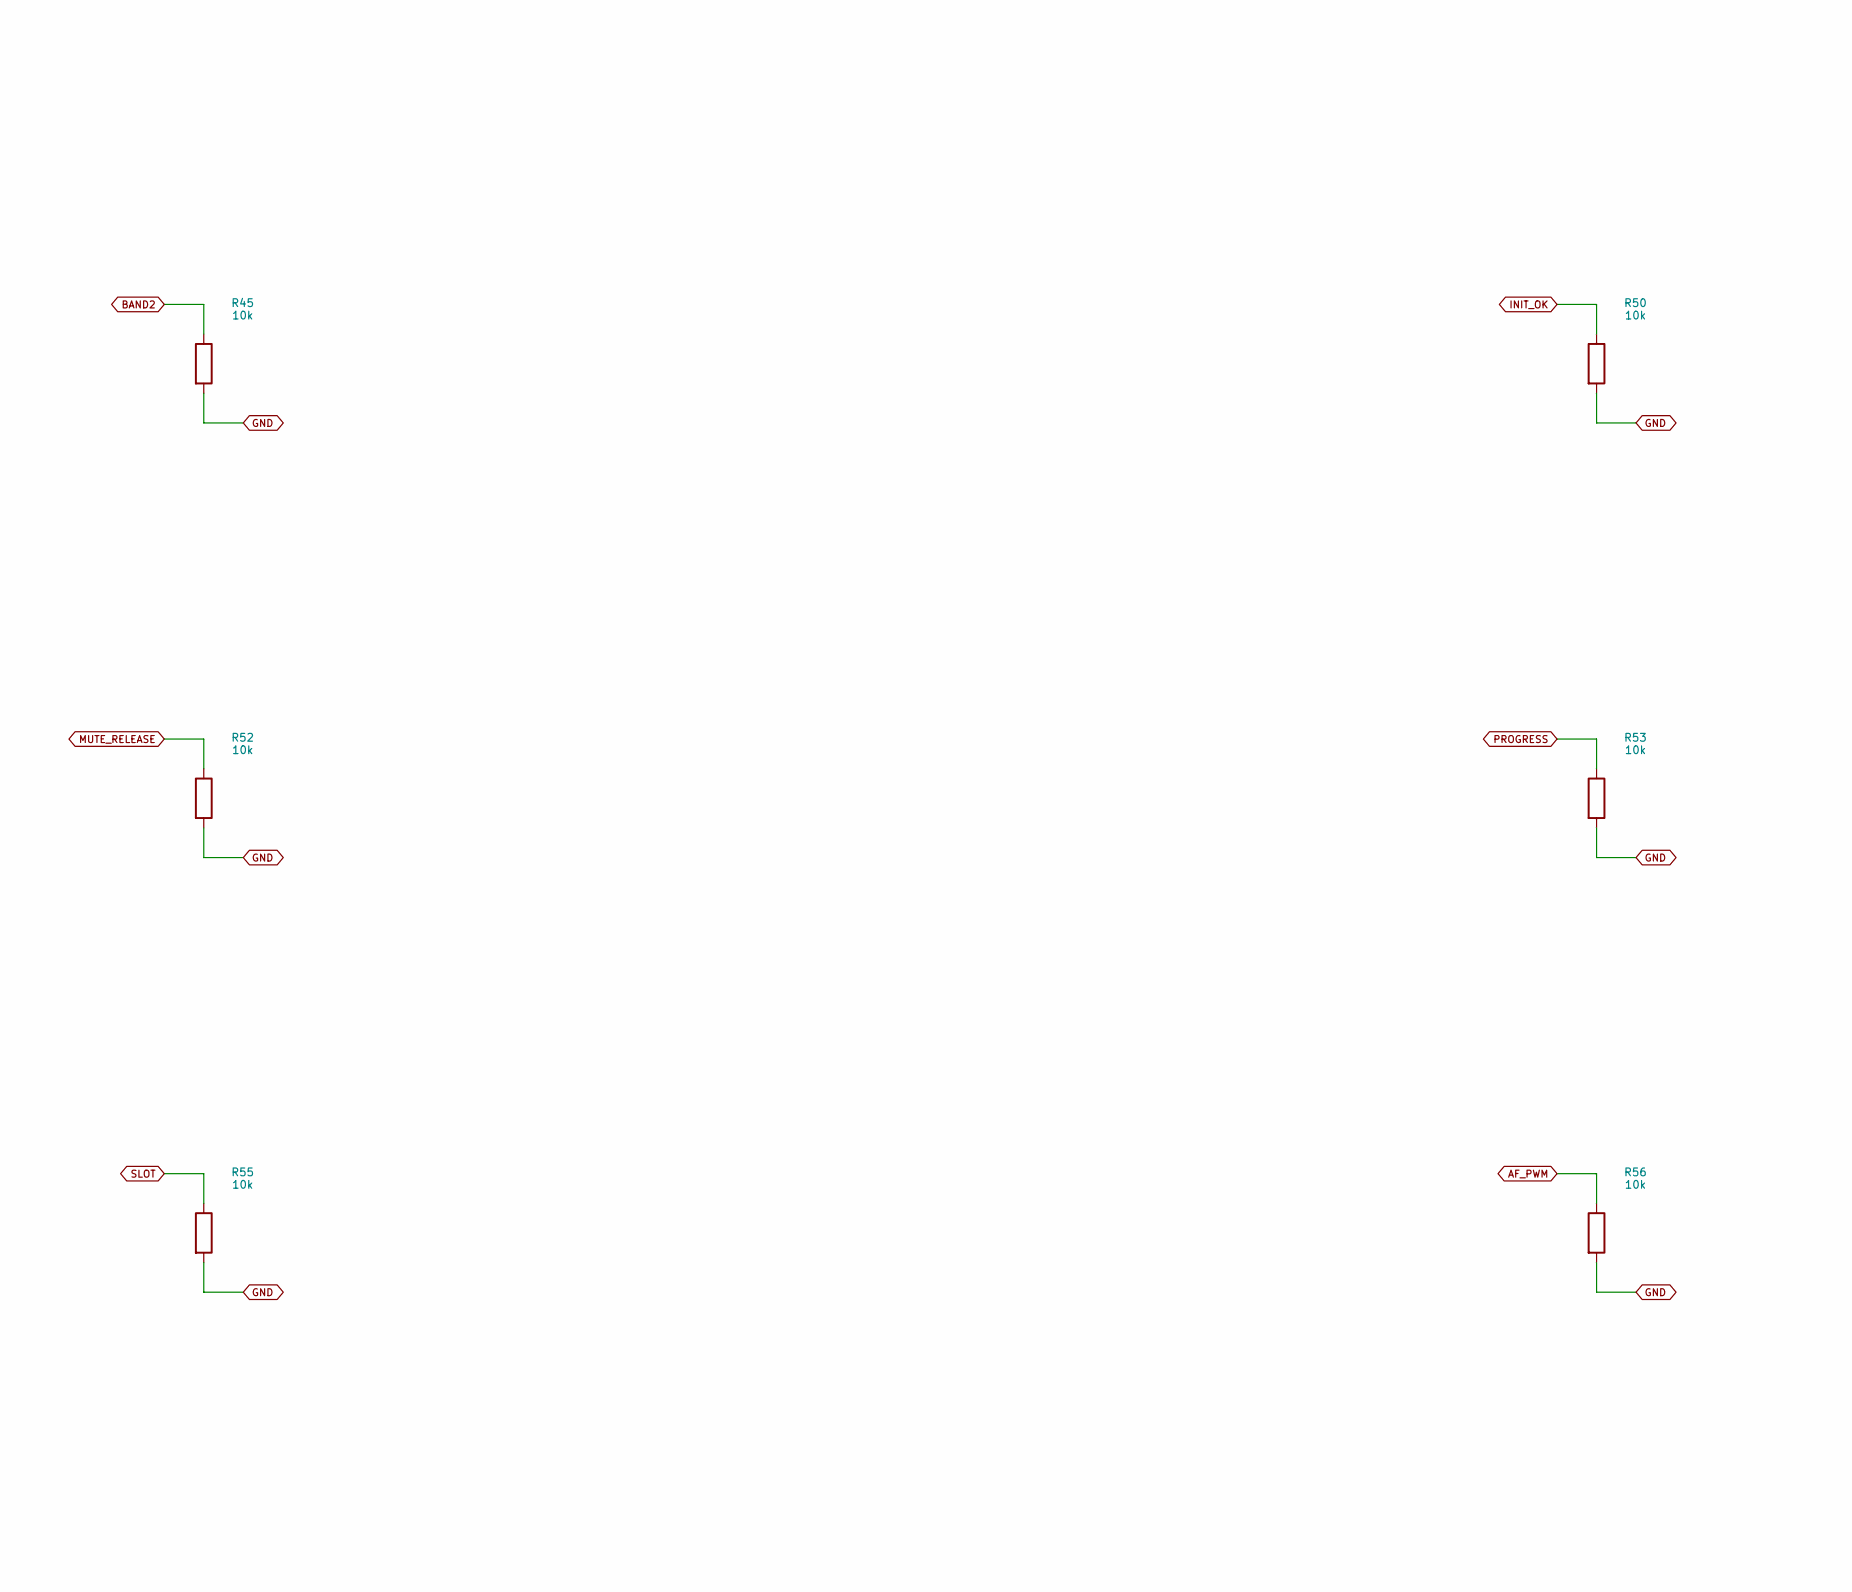
[picture p349: schematic 05_static_safety_2.kicad_sch, 05 static safety / 2, part in row 1, column 2]

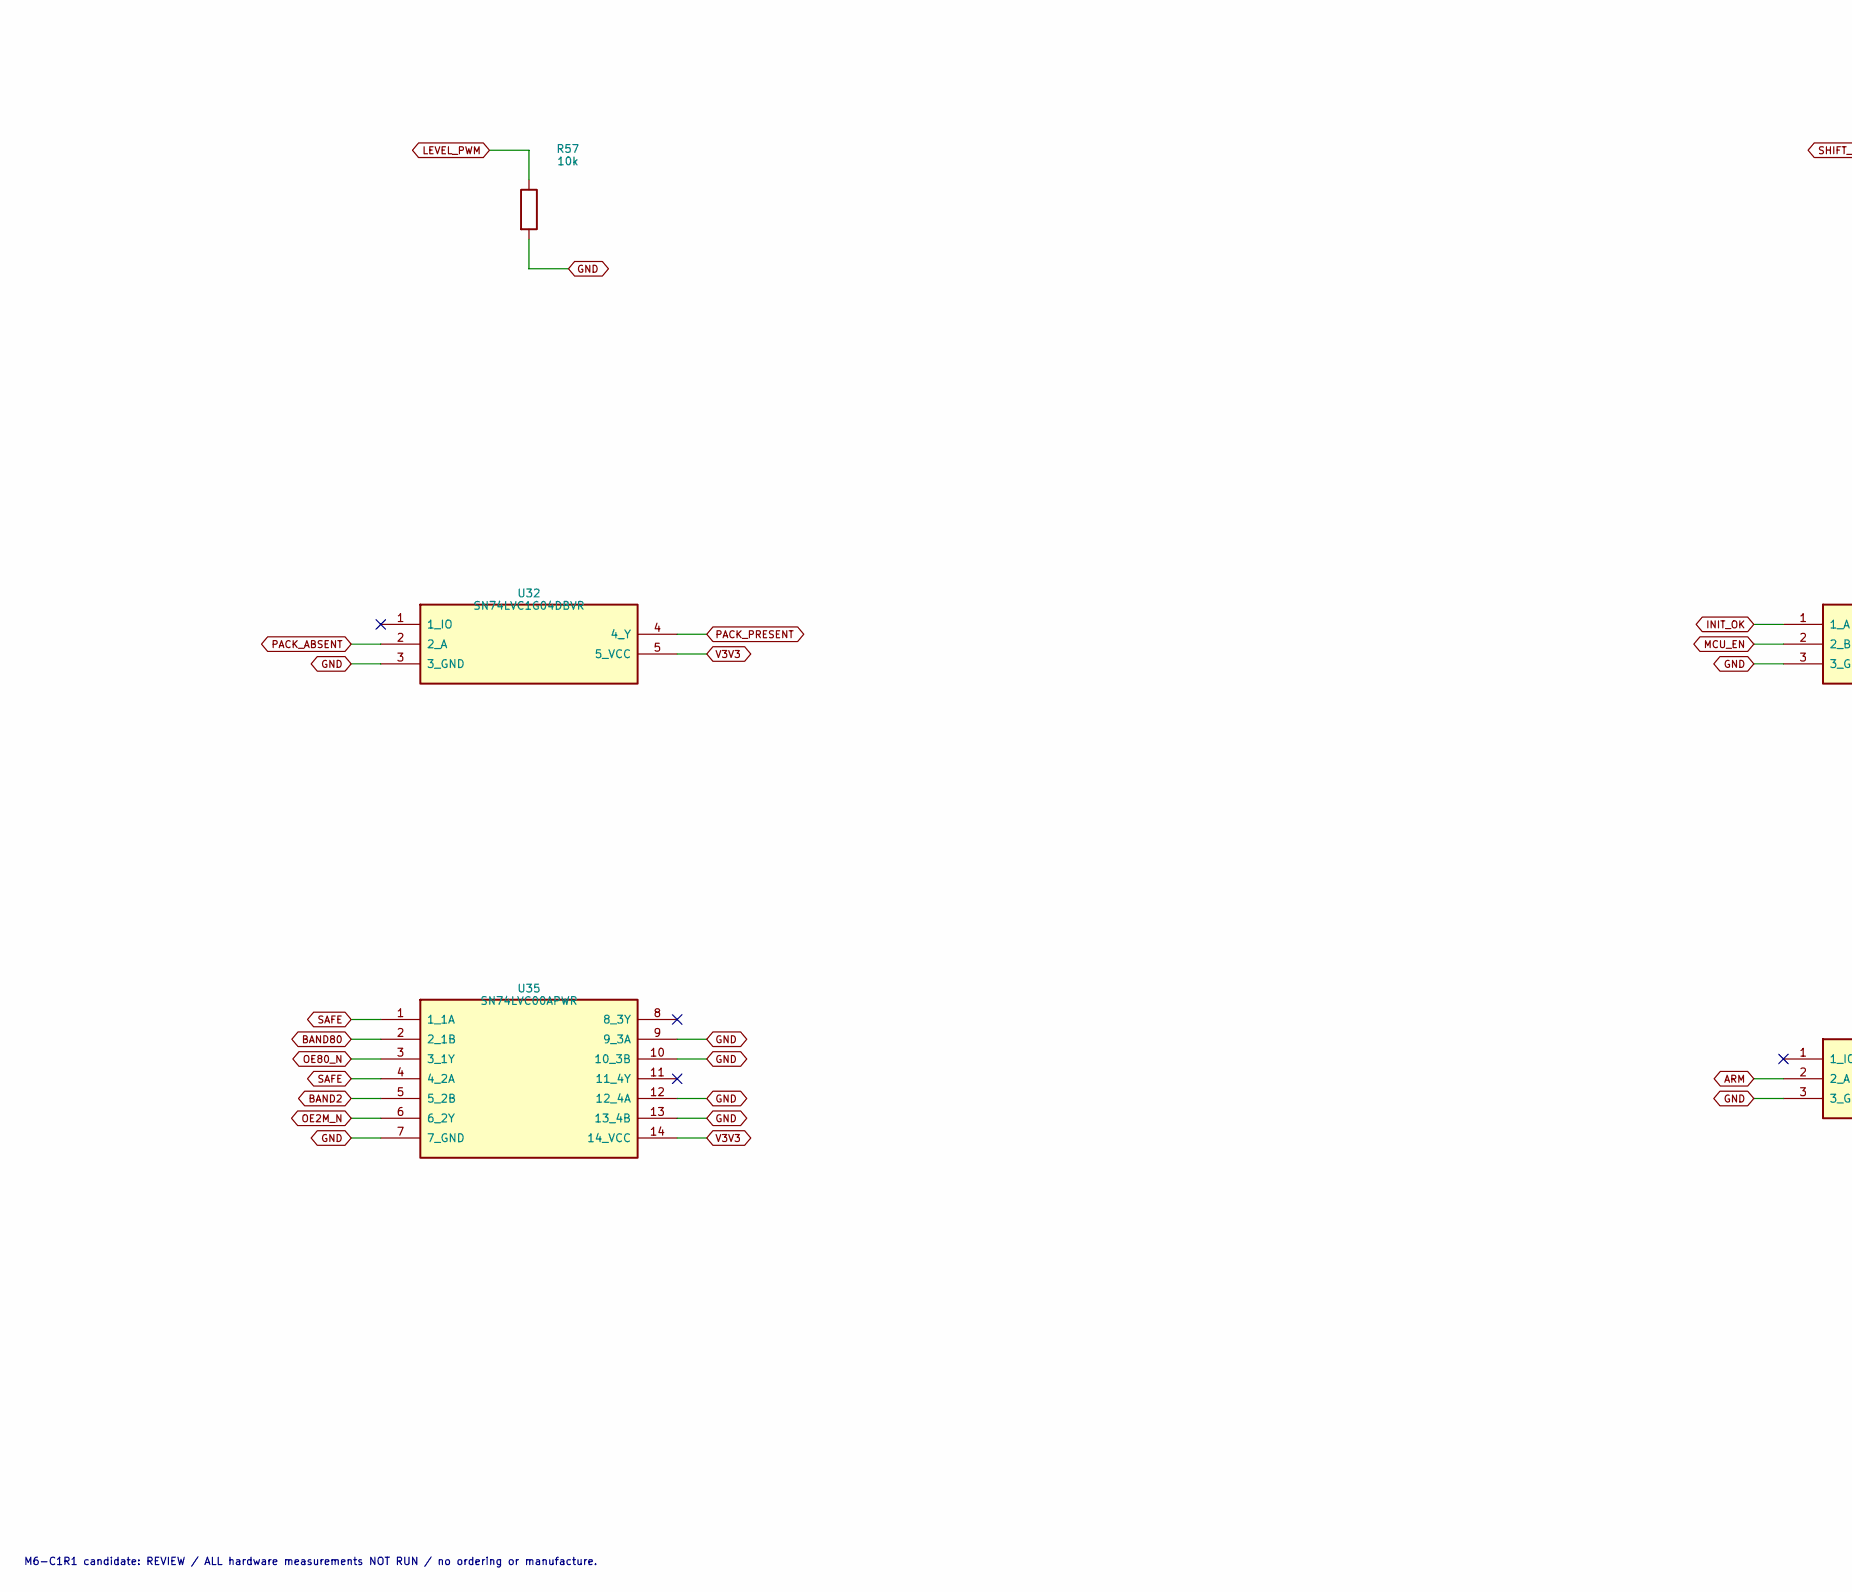
[picture p350: schematic 05_static_safety_2.kicad_sch, 05 static safety / 2, part in row 2, column 1]

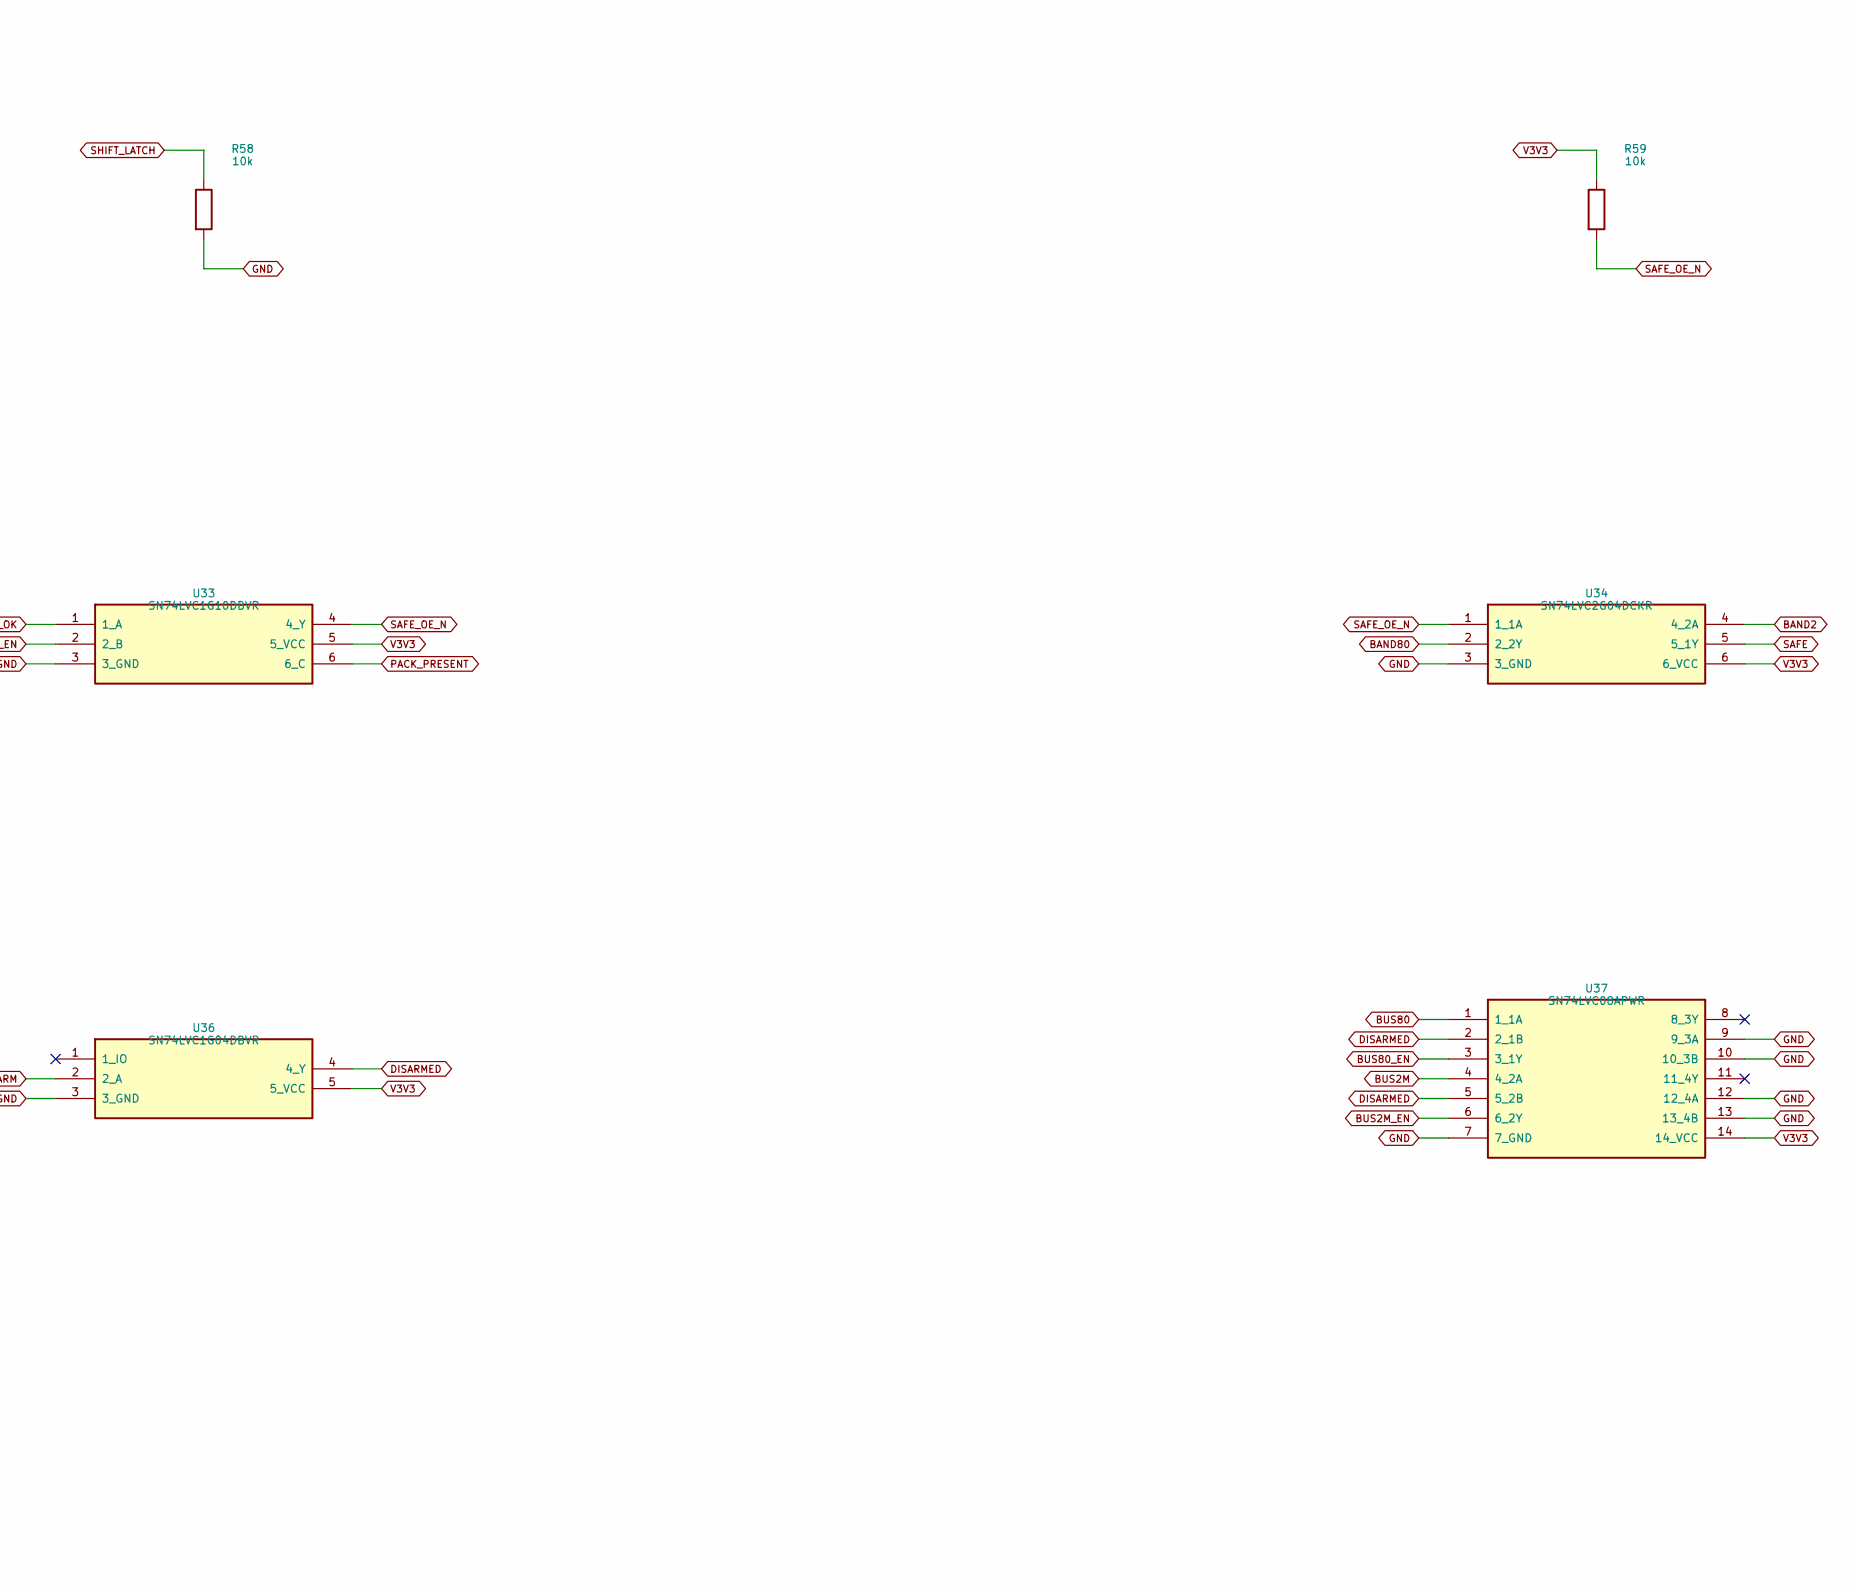
[picture p351: schematic 05_static_safety_2.kicad_sch, 05 static safety / 2, part in row 2, column 2]

Parts:
R44, R45, R50, R51, R52, R53, R54, R55, R56, R57, R58, R59: 10k; R_0603_1608Metric_CTL; MPN RC0603FR-0710KL
U32, U36: SN74LVC1G04DBVR; SOT-23-5_CTL; MPN SN74LVC1G04DBVR
U33: SN74LVC1G10DBVR; SOT-23-6_CTL; MPN SN74LVC1G10DBVR
U34: SN74LVC2G04DCKR; SOT-363_SC-70-6_CTL; MPN SN74LVC2G04DCKR
U35: SN74LVC00APWR; TSSOP-14_4.4x5mm_P0.65mm_CTL; MPN SN74LVC00APWR
U37: SN74LVC08APWR; TSSOP-14_4.4x5mm_P0.65mm_CTL; MPN SN74LVC08APWR

Connections:
AF_PWM: R56.1; also elsewhere on the board
ARM: R51.1, U36.2 (2_A); also elsewhere on the board
BAND2: R45.1, U34.4 (4_2A), U35.5 (5_2B); also elsewhere on the board
BAND80: U34.2 (2_2Y), U35.2 (2_1B)
BUS2M: U37.4 (4_2A); also elsewhere on the board
BUS2M_EN: U37.6 (6_2Y); also elsewhere on the board
BUS80: U37.1 (1_1A); also elsewhere on the board
BUS80_EN: U37.3 (3_1Y); also elsewhere on the board
DISARMED: U36.4 (4_Y), U37.2 (2_1B), U37.5 (5_2B)
GND: R44.2, R45.2, R50.2, R51.2, R52.2, R53.2, R54.2, R55.2, R56.2, R57.2, R58.2, U32.3 (3_GND), U33.3 (3_GND), U34.3 (3_GND), U35.7 (7_GND), U35.9 (9_3A), U35.10 (10_3B), U35.12 (12_4A), U35.13 (13_4B), U36.3 (3_GND), U37.7 (7_GND), U37.9 (9_3A), U37.10 (10_3B), U37.12 (12_4A), U37.13 (13_4B); also elsewhere on the board
INIT_OK: R50.1, U33.1 (1_A); also elsewhere on the board
KEY: R54.1; also elsewhere on the board
LED_FAULT: R44.1; also elsewhere on the board
LEVEL_PWM: R57.1; also elsewhere on the board
MCU_EN: U33.2 (2_B); also elsewhere on the board
MUTE_RELEASE: R52.1; also elsewhere on the board
OE2M_N: U35.6 (6_2Y); also elsewhere on the board
OE80_N: U35.3 (3_1Y); also elsewhere on the board
PACK_ABSENT: U32.2 (2_A); also elsewhere on the board
PACK_PRESENT: U32.4 (4_Y), U33.6 (6_C)
PROGRESS: R53.1; also elsewhere on the board
SAFE: U34.5 (5_1Y), U35.1 (1_1A), U35.4 (4_2A); also elsewhere on the board
SAFE_OE_N: R59.2, U33.4 (4_Y), U34.1 (1_1A); also elsewhere on the board
SHIFT_LATCH: R58.1; also elsewhere on the board
SLOT: R55.1; also elsewhere on the board
V3V3: R59.1, U32.5 (5_VCC), U33.5 (5_VCC), U34.6 (6_VCC), U35.14 (14_VCC), U36.5 (5_VCC), U37.14 (14_VCC); also elsewhere on the board

Notes on the sheet:
05 static safety / 2
M6-C1R1 candidate: REVIEW / ALL hardware measurements NOT RUN / no ordering or manufacture.

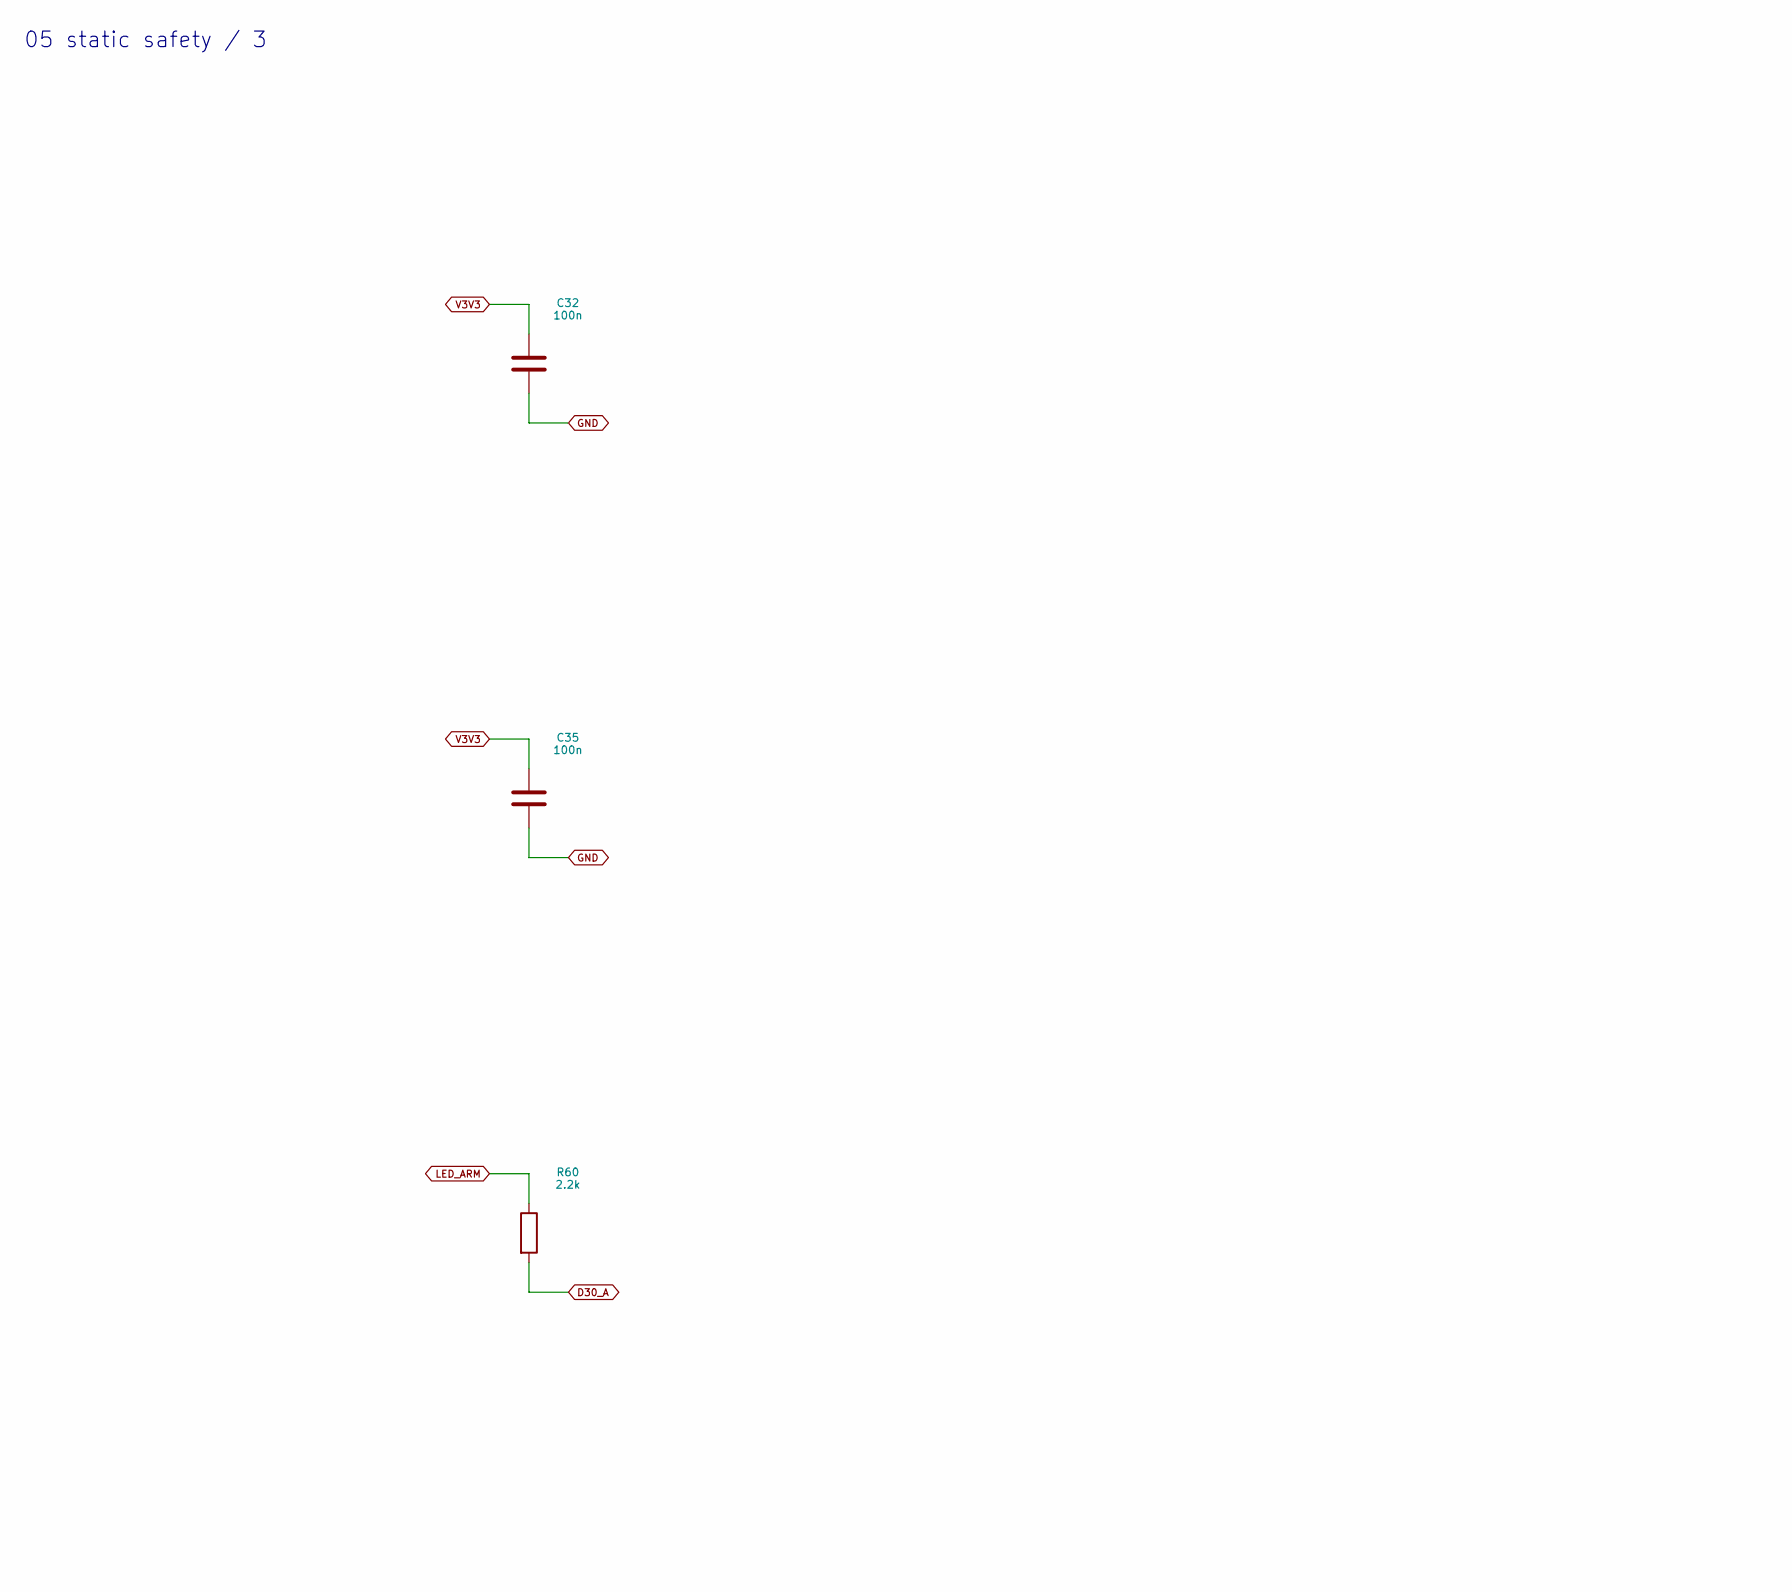
[picture p352: schematic 05_static_safety_3.kicad_sch, 05 static safety / 3, part in row 1, column 1]

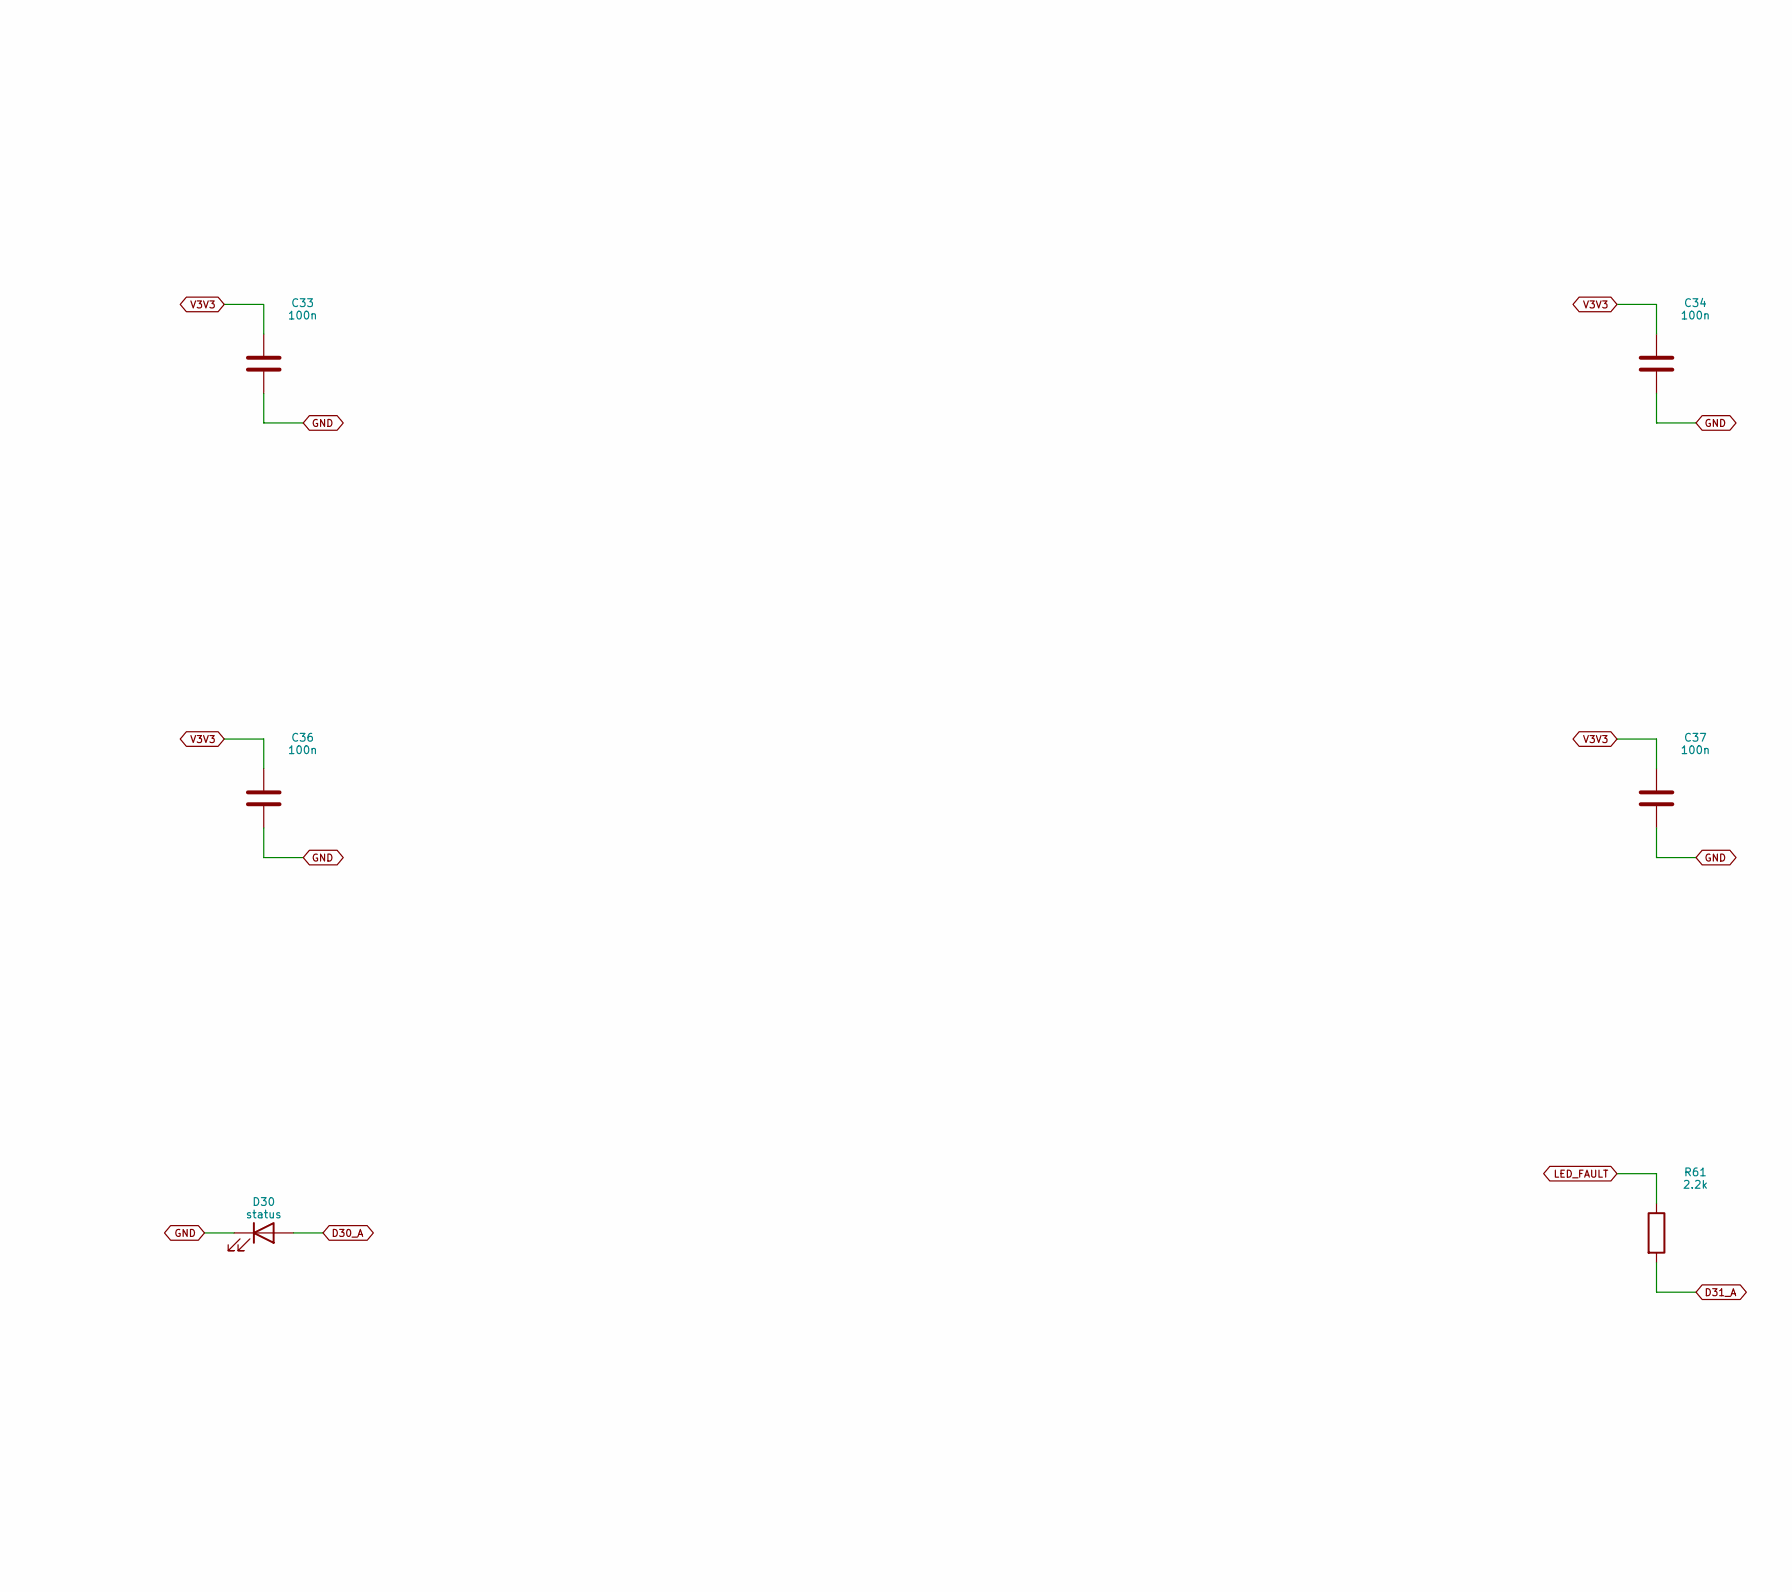
[picture p353: schematic 05_static_safety_3.kicad_sch, 05 static safety / 3, part in row 1, column 2]

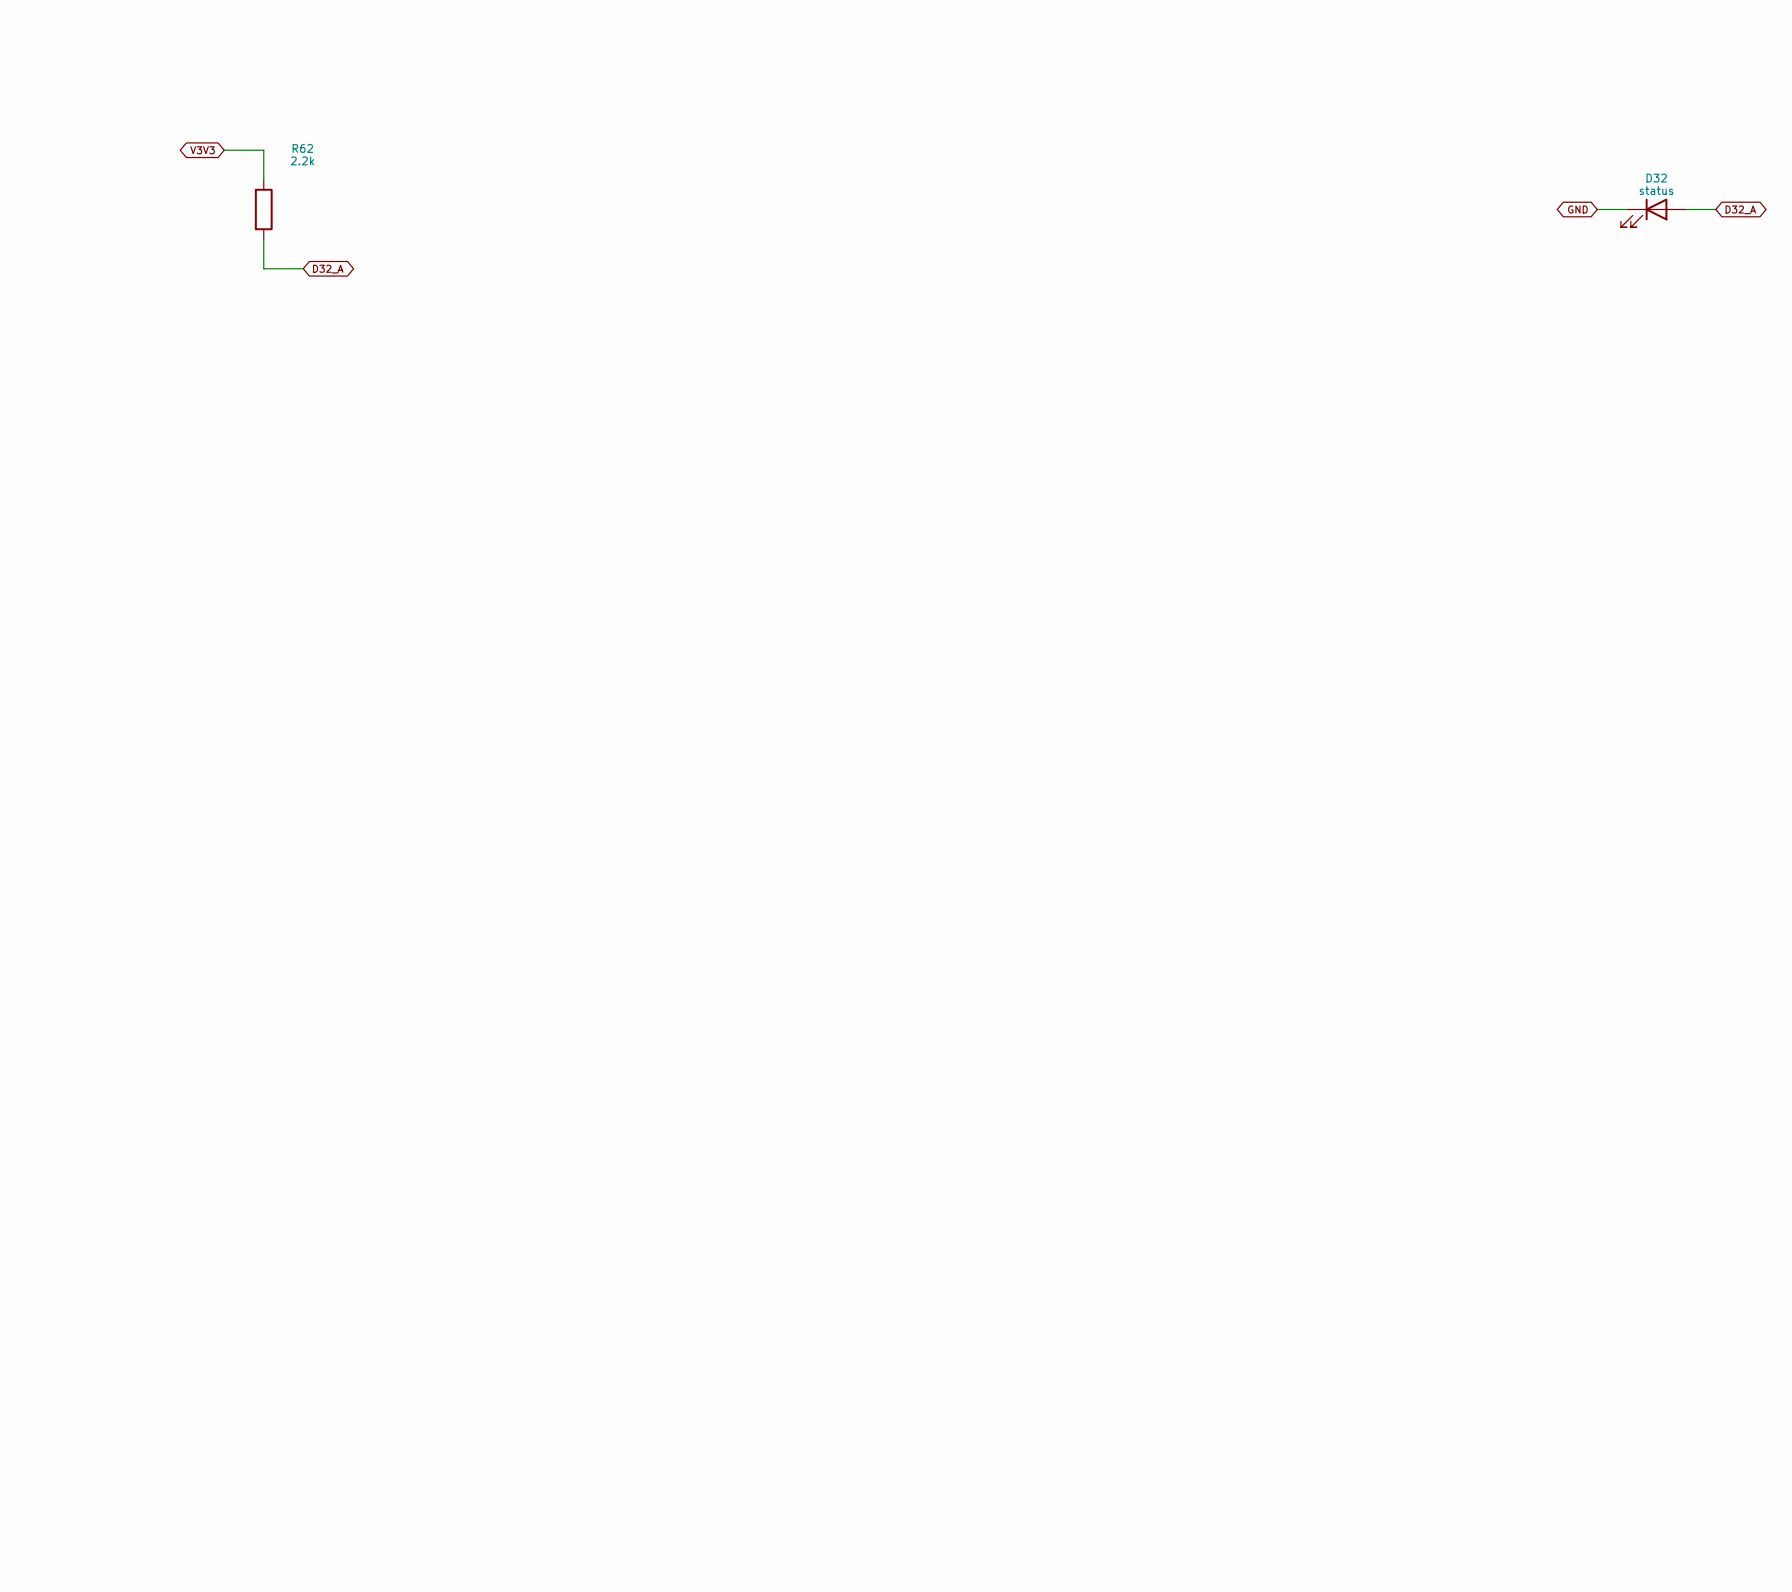
[picture p354: schematic 05_static_safety_3.kicad_sch, 05 static safety / 3, part in row 2, column 2]

Parts:
C32, C33, C34, C35, C36, C37: 100n; C_0603_1608Metric_CTL; MPN CL10B104KB8NNNC
D30, D32: status; LED_0603_1608Metric_CTL; MPN LTST-C190KGKT
D31: status; LED_0603_1608Metric_CTL; MPN LTST-C190KRKT
R60, R61, R62: 2.2k; R_0603_1608Metric_CTL; MPN RC0603FR-072K2L

Connections:
D30_A: D30.2 (A), R60.2
D31_A: D31.2 (A), R61.2
D32_A: D32.2 (A), R62.2
GND: C32.2, C33.2, C34.2, C35.2, C36.2, C37.2, D30.1 (K), D31.1 (K), D32.1 (K); also elsewhere on the board
LED_ARM: R60.1; also elsewhere on the board
LED_FAULT: R61.1; also elsewhere on the board
V3V3: C32.1, C33.1, C34.1, C35.1, C36.1, C37.1, R62.1; also elsewhere on the board

Notes on the sheet:
05 static safety / 3
M6-C1R1 candidate: REVIEW / ALL hardware measurements NOT RUN / no ordering or manufacture.
