DD1SB/ARDF-TX/hardware/controller/CTRL.kicad_pcb

## KiCad design hardware/controller/CTRL.kicad_pcb (continued)

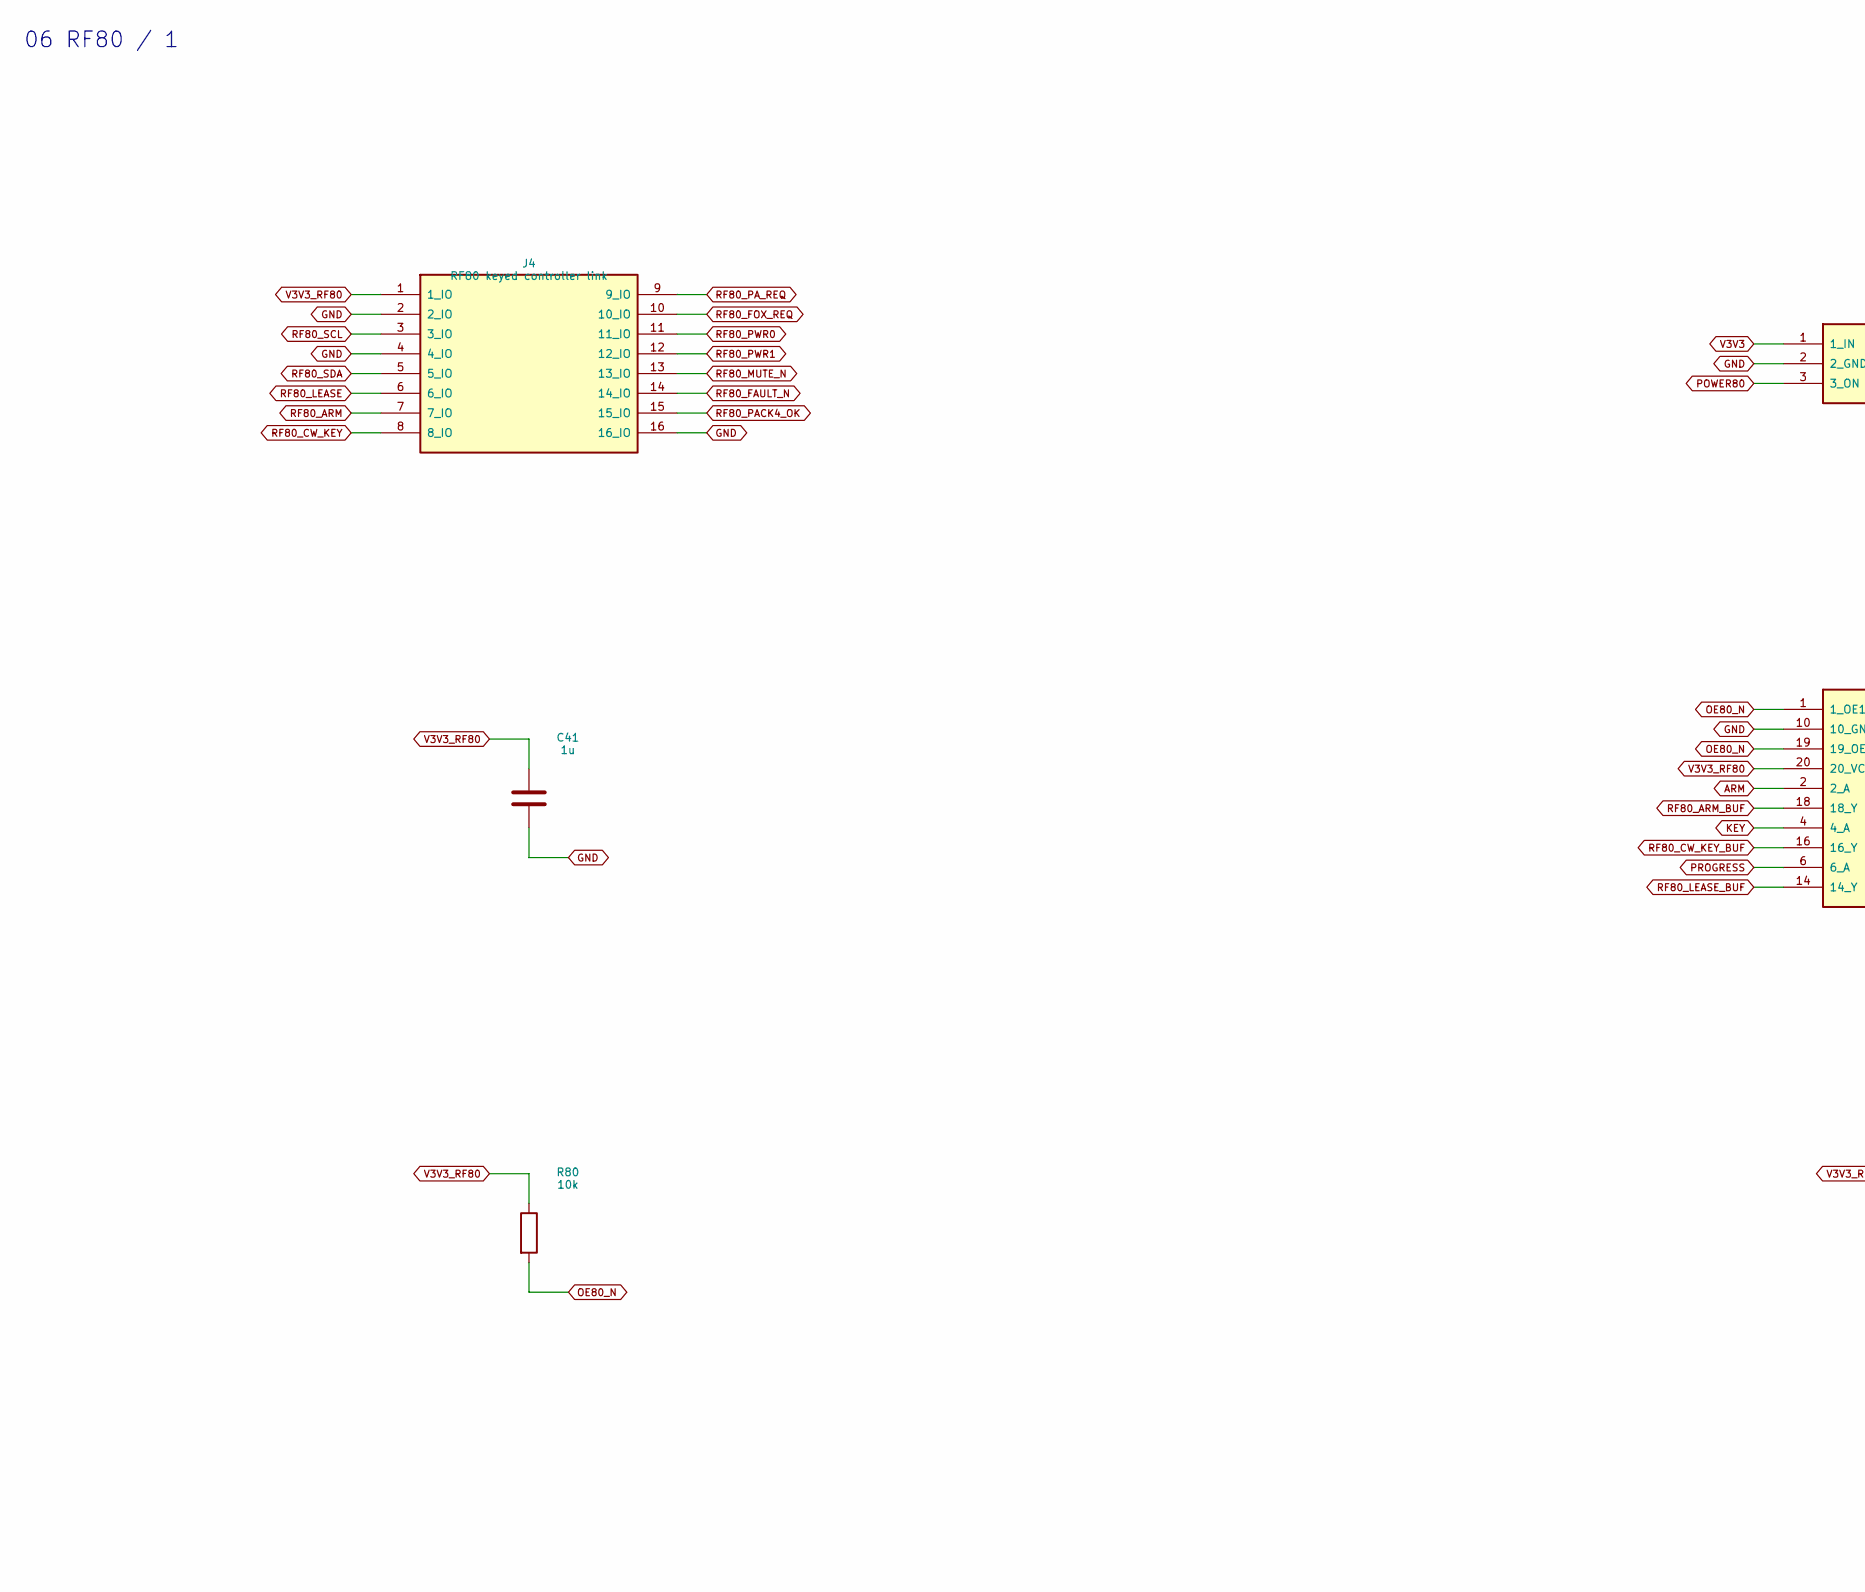
[picture p355: schematic 06_RF80.kicad_sch, 06 RF80 / 1, part in row 1, column 1]

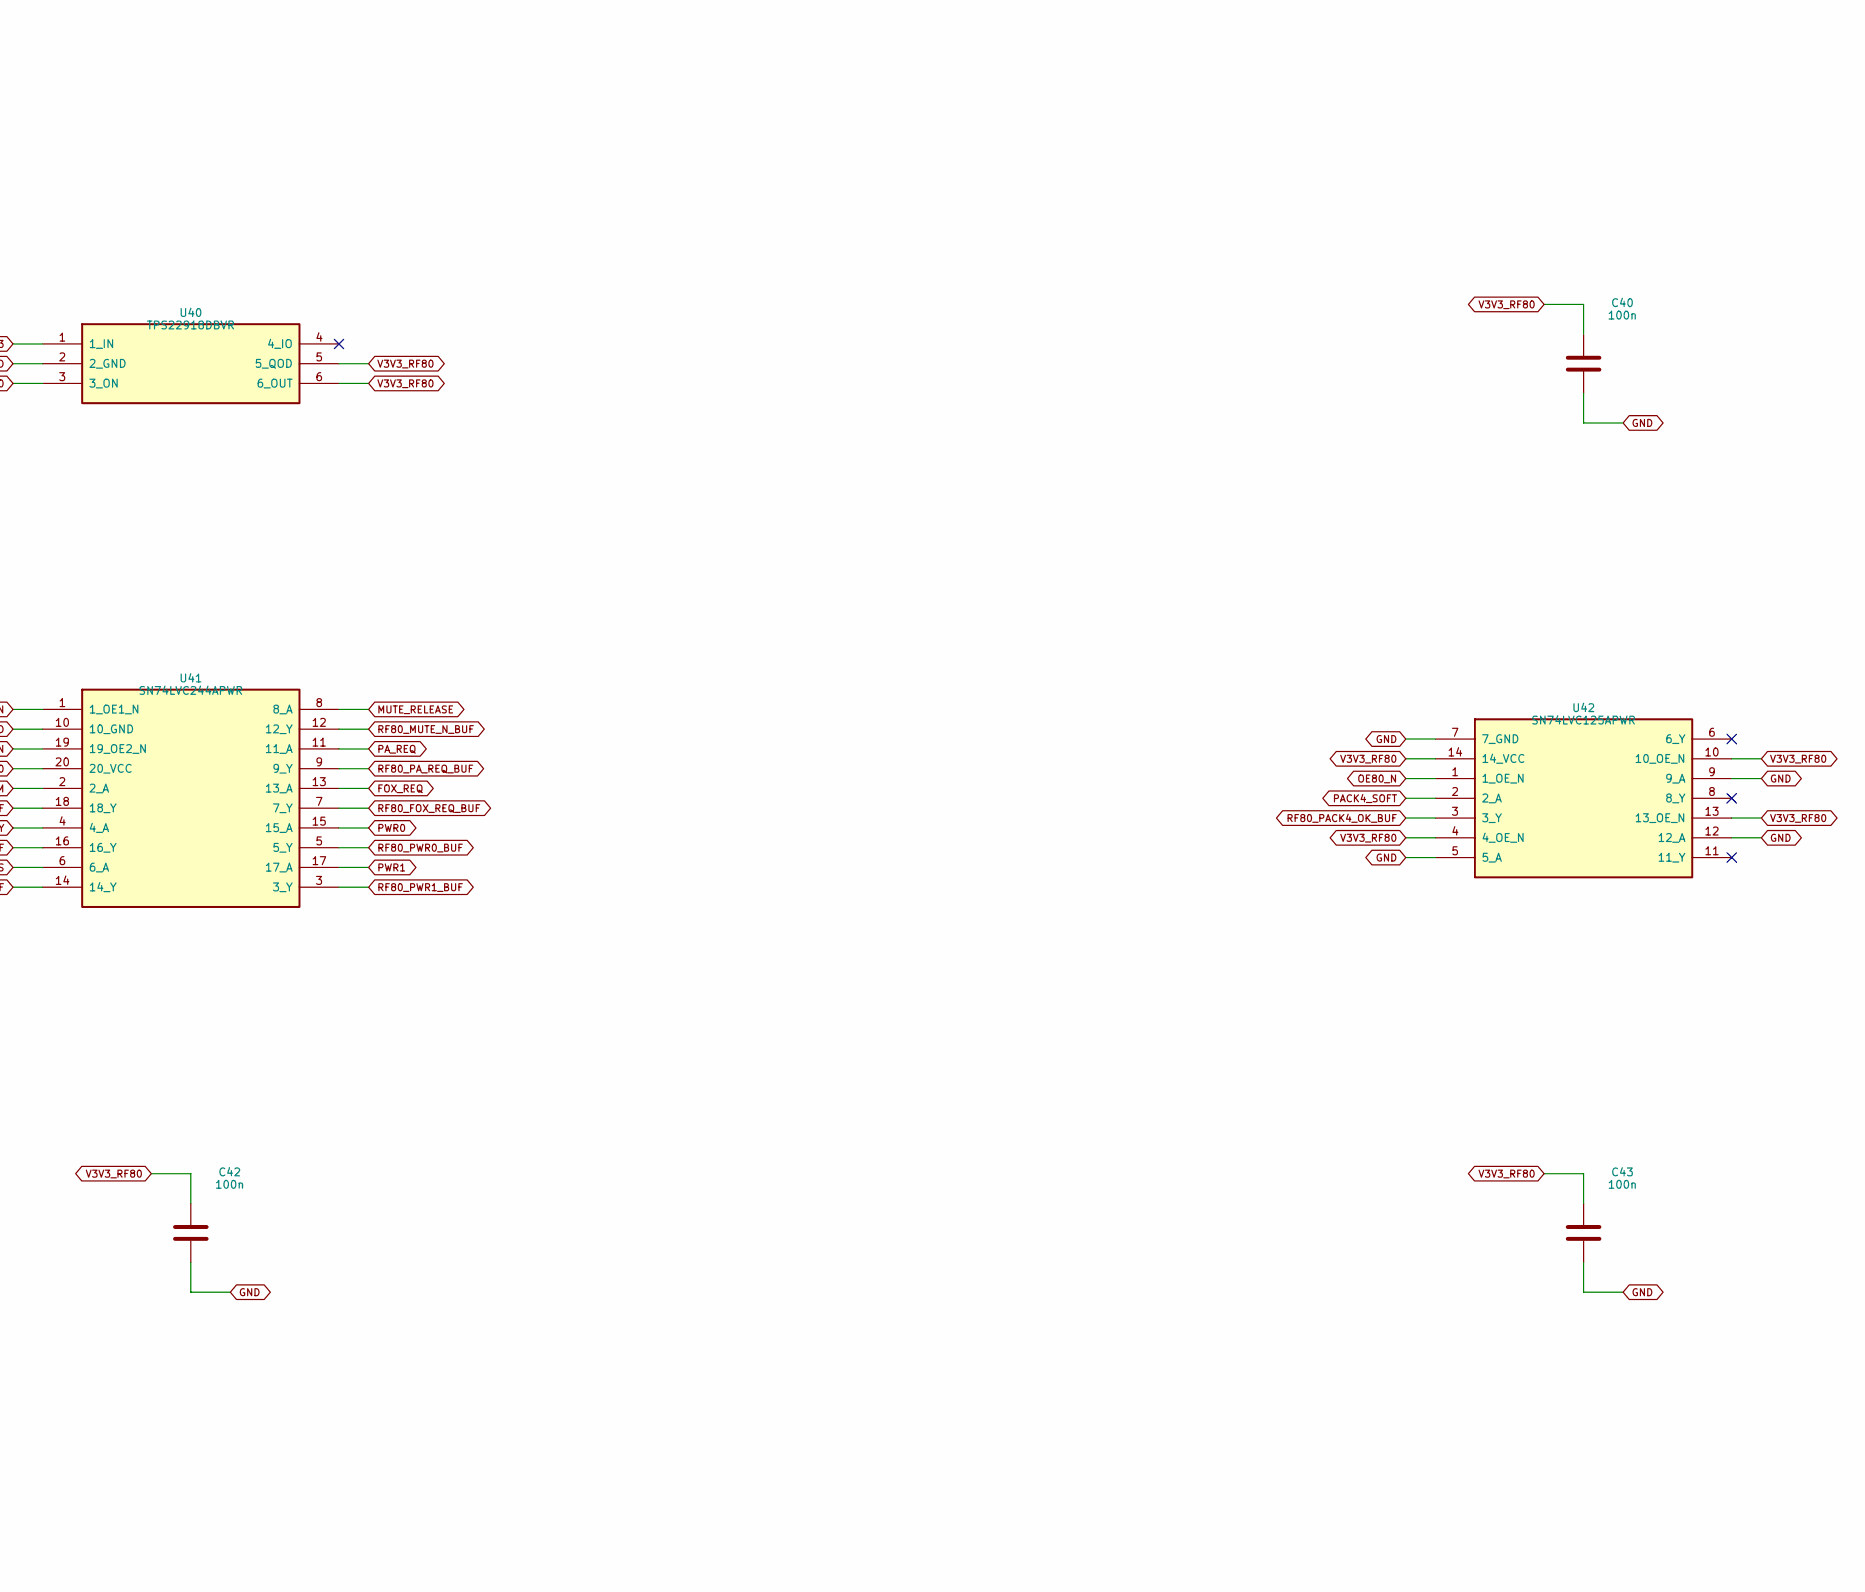
[picture p356: schematic 06_RF80.kicad_sch, 06 RF80 / 1, part in row 1, column 2]

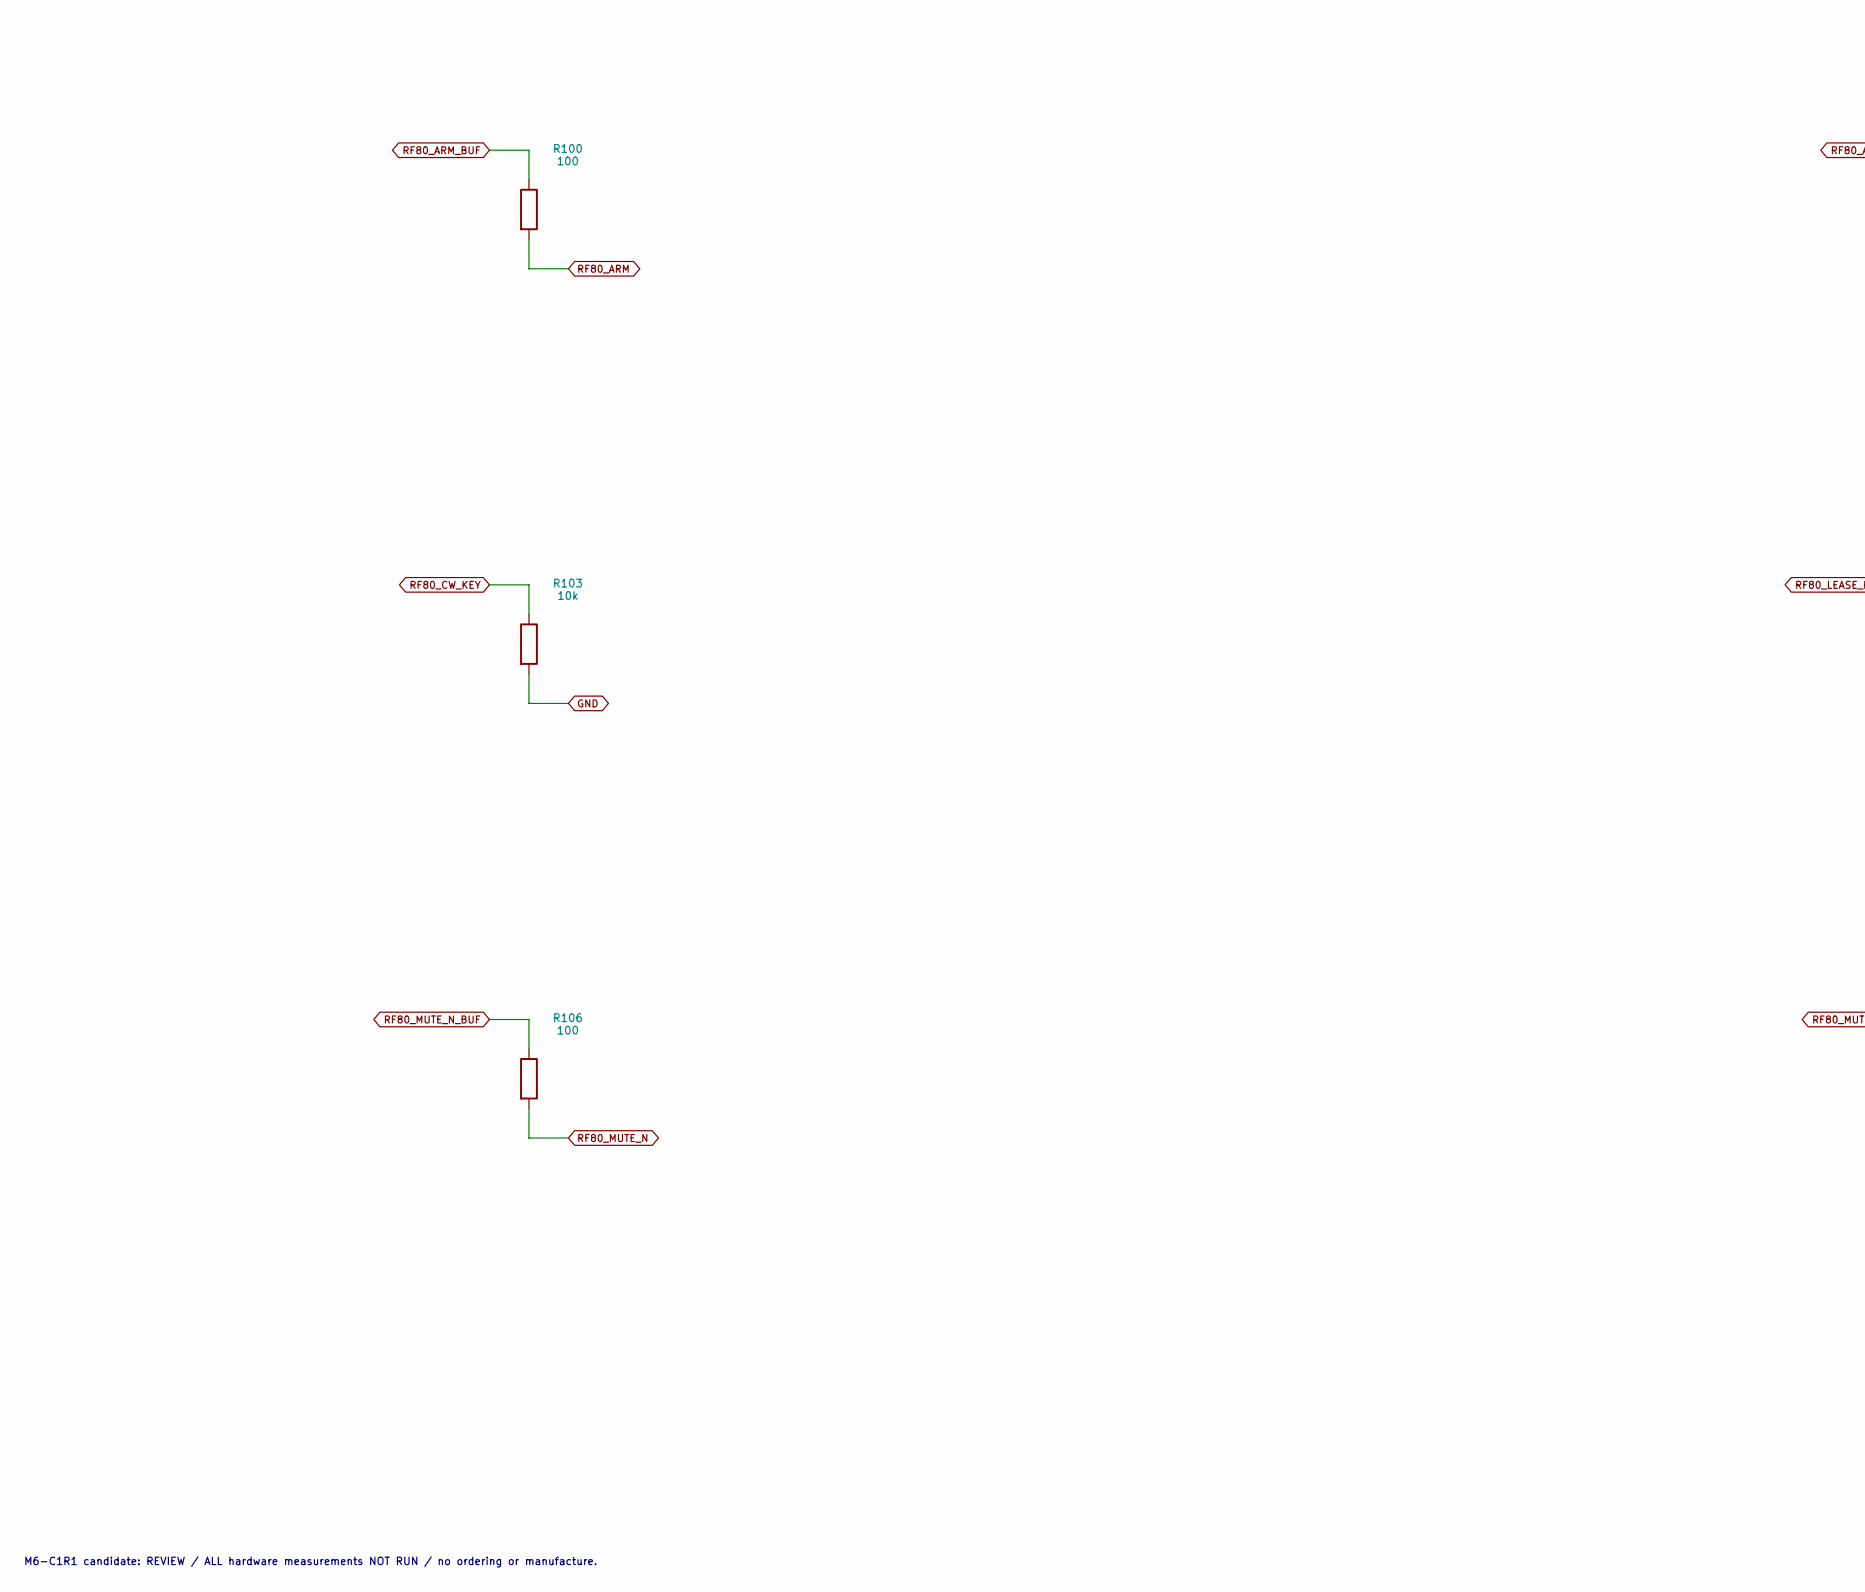
[picture p357: schematic 06_RF80.kicad_sch, 06 RF80 / 1, part in row 2, column 1]

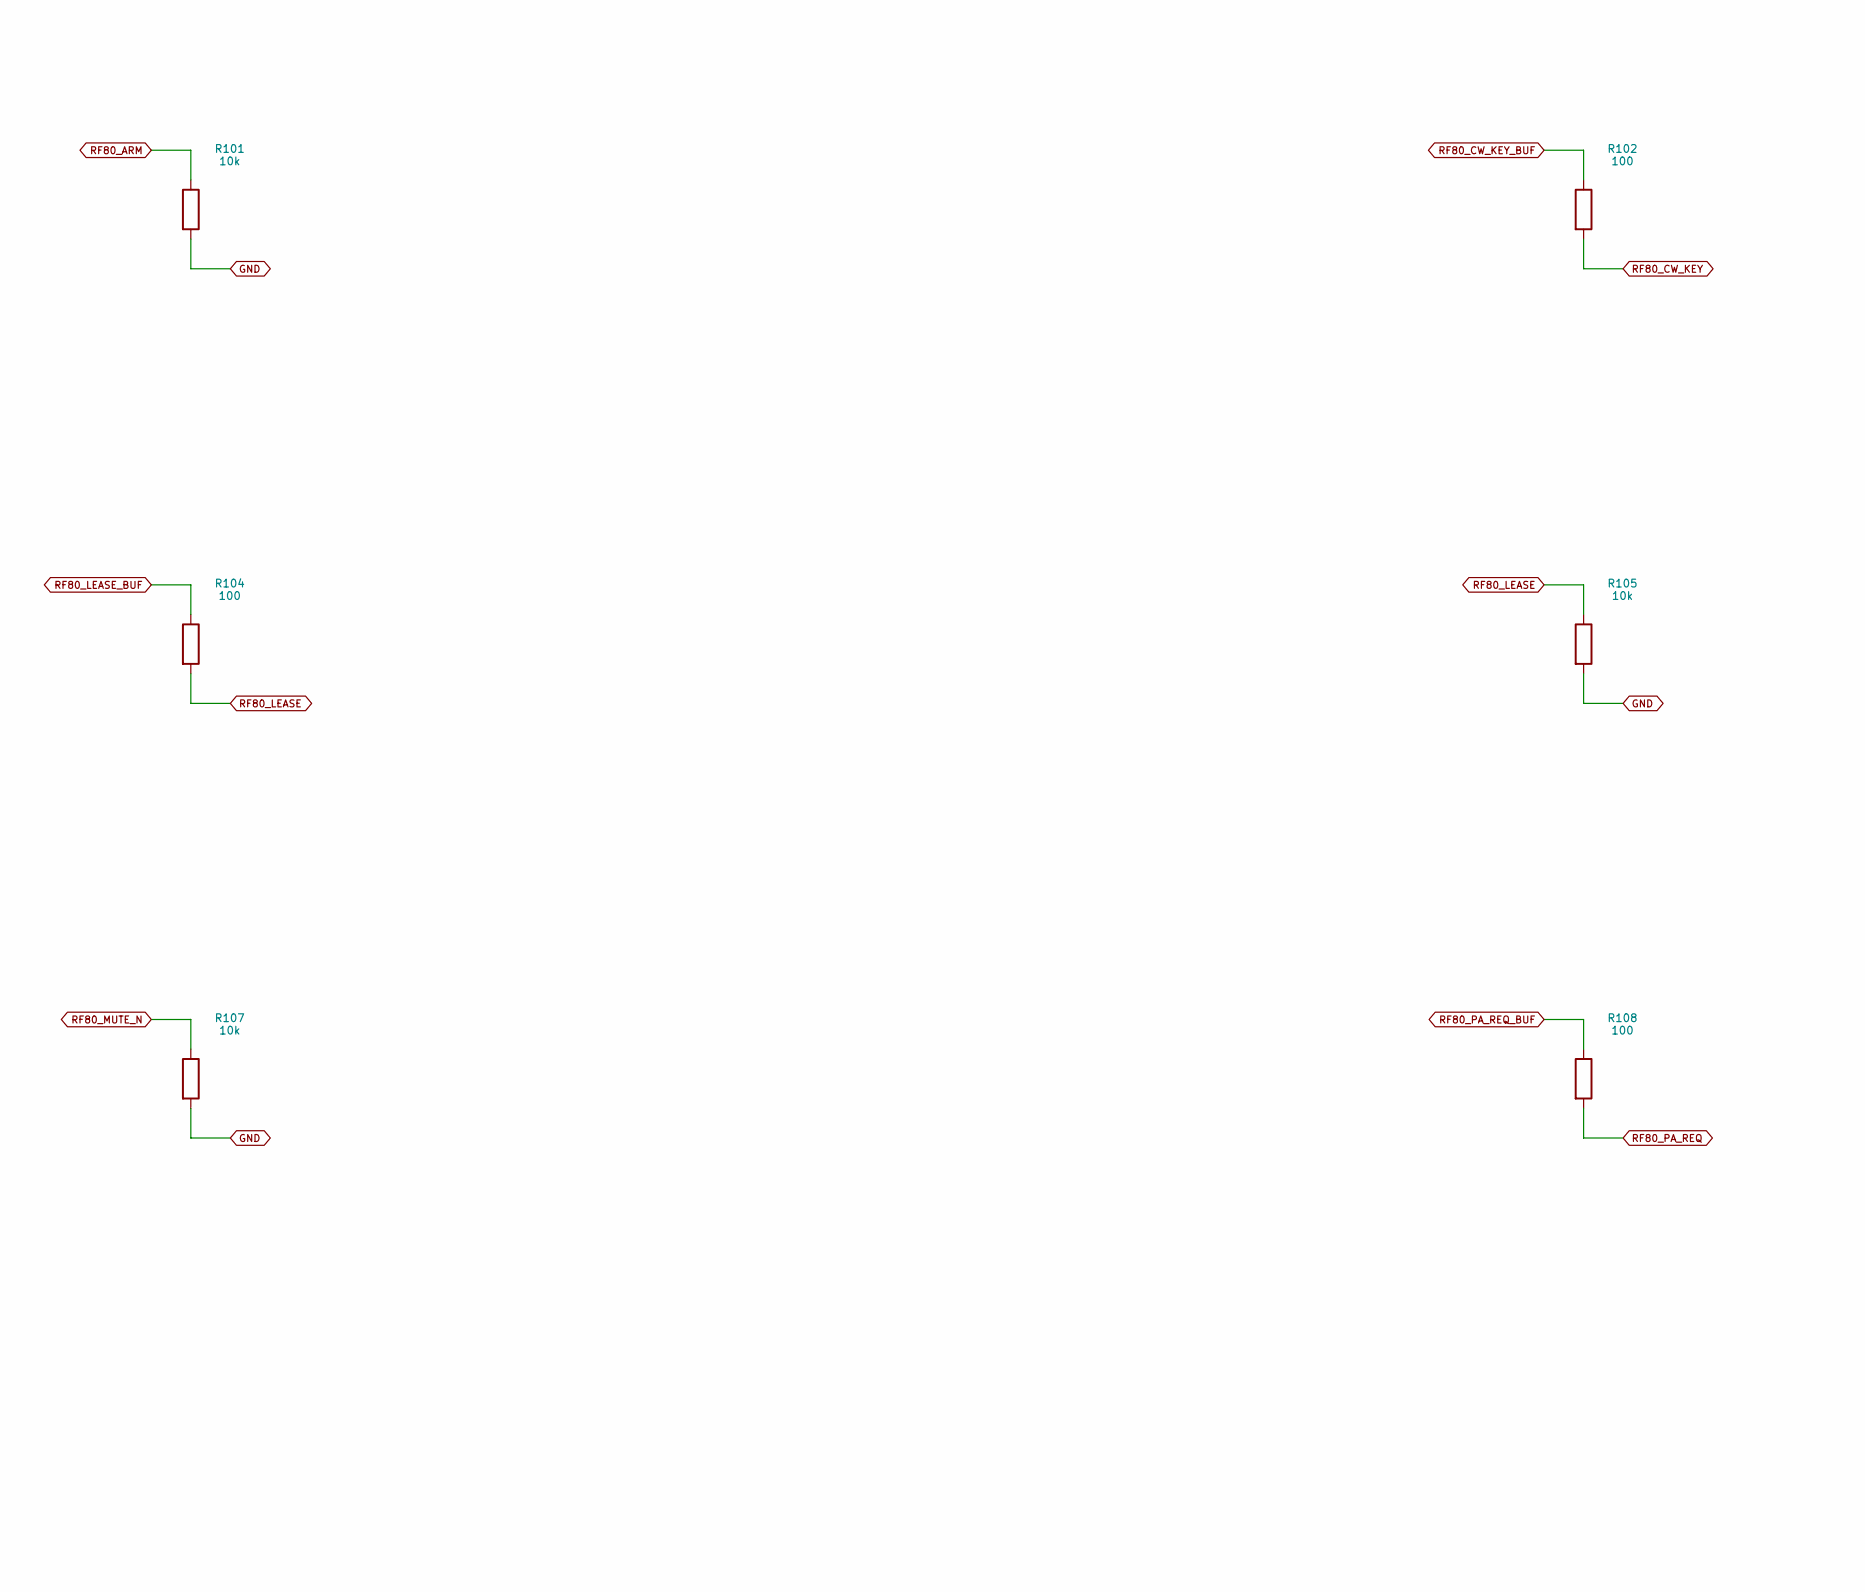
[picture p358: schematic 06_RF80.kicad_sch, 06 RF80 / 1, part in row 2, column 2]

Parts:
C40, C42, C43: 100n; C_0603_1608Metric_CTL; MPN CL10B104KB8NNNC
C41: 1u; C_0603_1608Metric_CTL; MPN CL10A105KB8NNNC
J4: RF80 keyed controller link; IDC16_61201621621; MPN 61201621621
R80, R101, R103, R105, R107: 10k; R_0603_1608Metric_CTL; MPN RC0603FR-0710KL
R100, R102, R104, R106, R108: 100; R_0603_1608Metric_CTL; MPN RC0603FR-07100RL
U40: TPS22918DBVR; SOT-23-6_CTL; MPN TPS22918DBVR
U41: SN74LVC244APWR; TSSOP-20_4.4x6.5mm_P0.65mm_CTL; MPN SN74LVC244APWR
U42: SN74LVC125APWR; TSSOP-14_4.4x5mm_P0.65mm_CTL; MPN SN74LVC125APWR

Connections:
ARM: U41.2 (2_A); also elsewhere on the board
FOX_REQ: U41.13 (13_A); also elsewhere on the board
GND: C40.2, C41.2, C42.2, C43.2, J4.2 (2_IO), J4.4 (4_IO), J4.16 (16_IO), R101.2, R103.2, R105.2, R107.2, U40.2 (2_GND), U41.10 (10_GND), U42.5 (5_A), U42.7 (7_GND), U42.9 (9_A), U42.12 (12_A); also elsewhere on the board
KEY: U41.4 (4_A); also elsewhere on the board
MUTE_RELEASE: U41.8 (8_A); also elsewhere on the board
OE80_N: R80.2, U41.1 (1_OE1_N), U41.19 (19_OE2_N), U42.1 (1_OE_N); also elsewhere on the board
PACK4_SOFT: U42.2 (2_A); also elsewhere on the board
PA_REQ: U41.11 (11_A); also elsewhere on the board
POWER80: U40.3 (3_ON); also elsewhere on the board
PROGRESS: U41.6 (6_A); also elsewhere on the board
PWR0: U41.15 (15_A); also elsewhere on the board
PWR1: U41.17 (17_A); also elsewhere on the board
RF80_ARM: J4.7 (7_IO), R100.2, R101.1
RF80_ARM_BUF: R100.1, U41.18 (18_Y)
RF80_CW_KEY: J4.8 (8_IO), R102.2, R103.1
RF80_CW_KEY_BUF: R102.1, U41.16 (16_Y)
RF80_FAULT_N: J4.14 (14_IO); also elsewhere on the board
RF80_FOX_REQ: J4.10 (10_IO); also elsewhere on the board
RF80_FOX_REQ_BUF: U41.7 (7_Y); also elsewhere on the board
RF80_LEASE: J4.6 (6_IO), R104.2, R105.1
RF80_LEASE_BUF: R104.1, U41.14 (14_Y)
RF80_MUTE_N: J4.13 (13_IO), R106.2, R107.1
RF80_MUTE_N_BUF: R106.1, U41.12 (12_Y)
RF80_PACK4_OK: J4.15 (15_IO); also elsewhere on the board
RF80_PACK4_OK_BUF: U42.3 (3_Y); also elsewhere on the board
RF80_PA_REQ: J4.9 (9_IO), R108.2; also elsewhere on the board
RF80_PA_REQ_BUF: R108.1, U41.9 (9_Y)
RF80_PWR0: J4.11 (11_IO); also elsewhere on the board
RF80_PWR0_BUF: U41.5 (5_Y); also elsewhere on the board
RF80_PWR1: J4.12 (12_IO); also elsewhere on the board
RF80_PWR1_BUF: U41.3 (3_Y); also elsewhere on the board
RF80_SCL: J4.3 (3_IO); also elsewhere on the board
RF80_SDA: J4.5 (5_IO); also elsewhere on the board
V3V3: U40.1 (1_IN); also elsewhere on the board
V3V3_RF80: C40.1, C41.1, C42.1, C43.1, J4.1 (1_IO), R80.1, U40.5 (5_QOD), U40.6 (6_OUT), U41.20 (20_VCC), U42.4 (4_OE_N), U42.10 (10_OE_N), U42.13 (13_OE_N), U42.14 (14_VCC); also elsewhere on the board

Notes on the sheet:
06 RF80 / 1
M6-C1R1 candidate: REVIEW / ALL hardware measurements NOT RUN / no ordering or manufacture.
