DD1SB/ARDF-TX/hardware/controller/CTRL.kicad_pcb

## KiCad design hardware/controller/CTRL.kicad_pcb (continued)

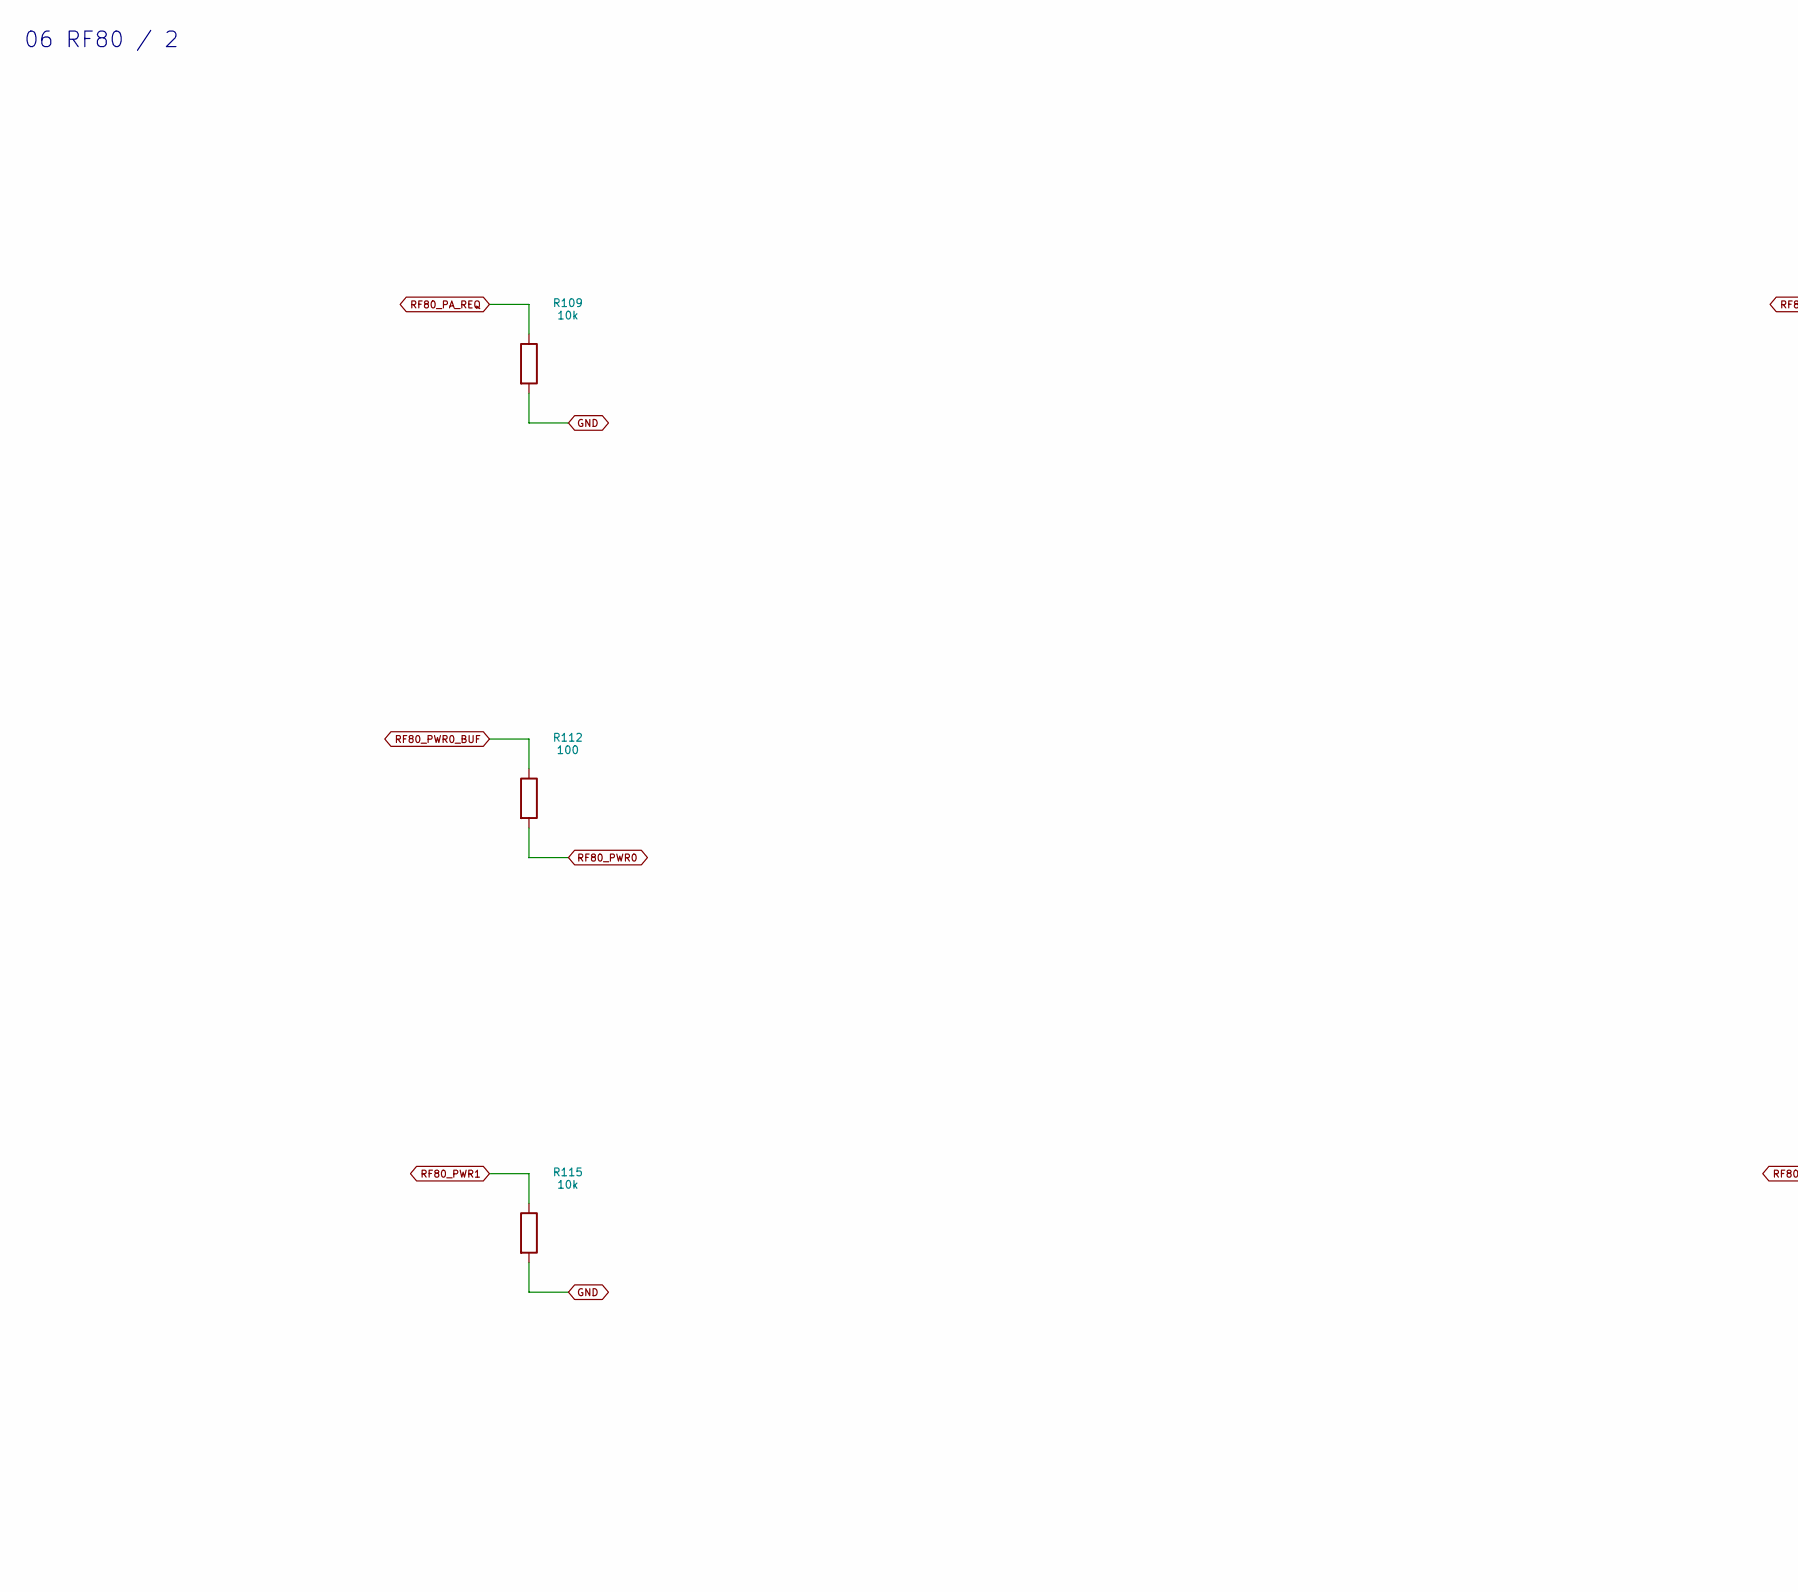
[picture p359: schematic 06_RF80_2.kicad_sch, 06 RF80 / 2, part in row 1, column 1]

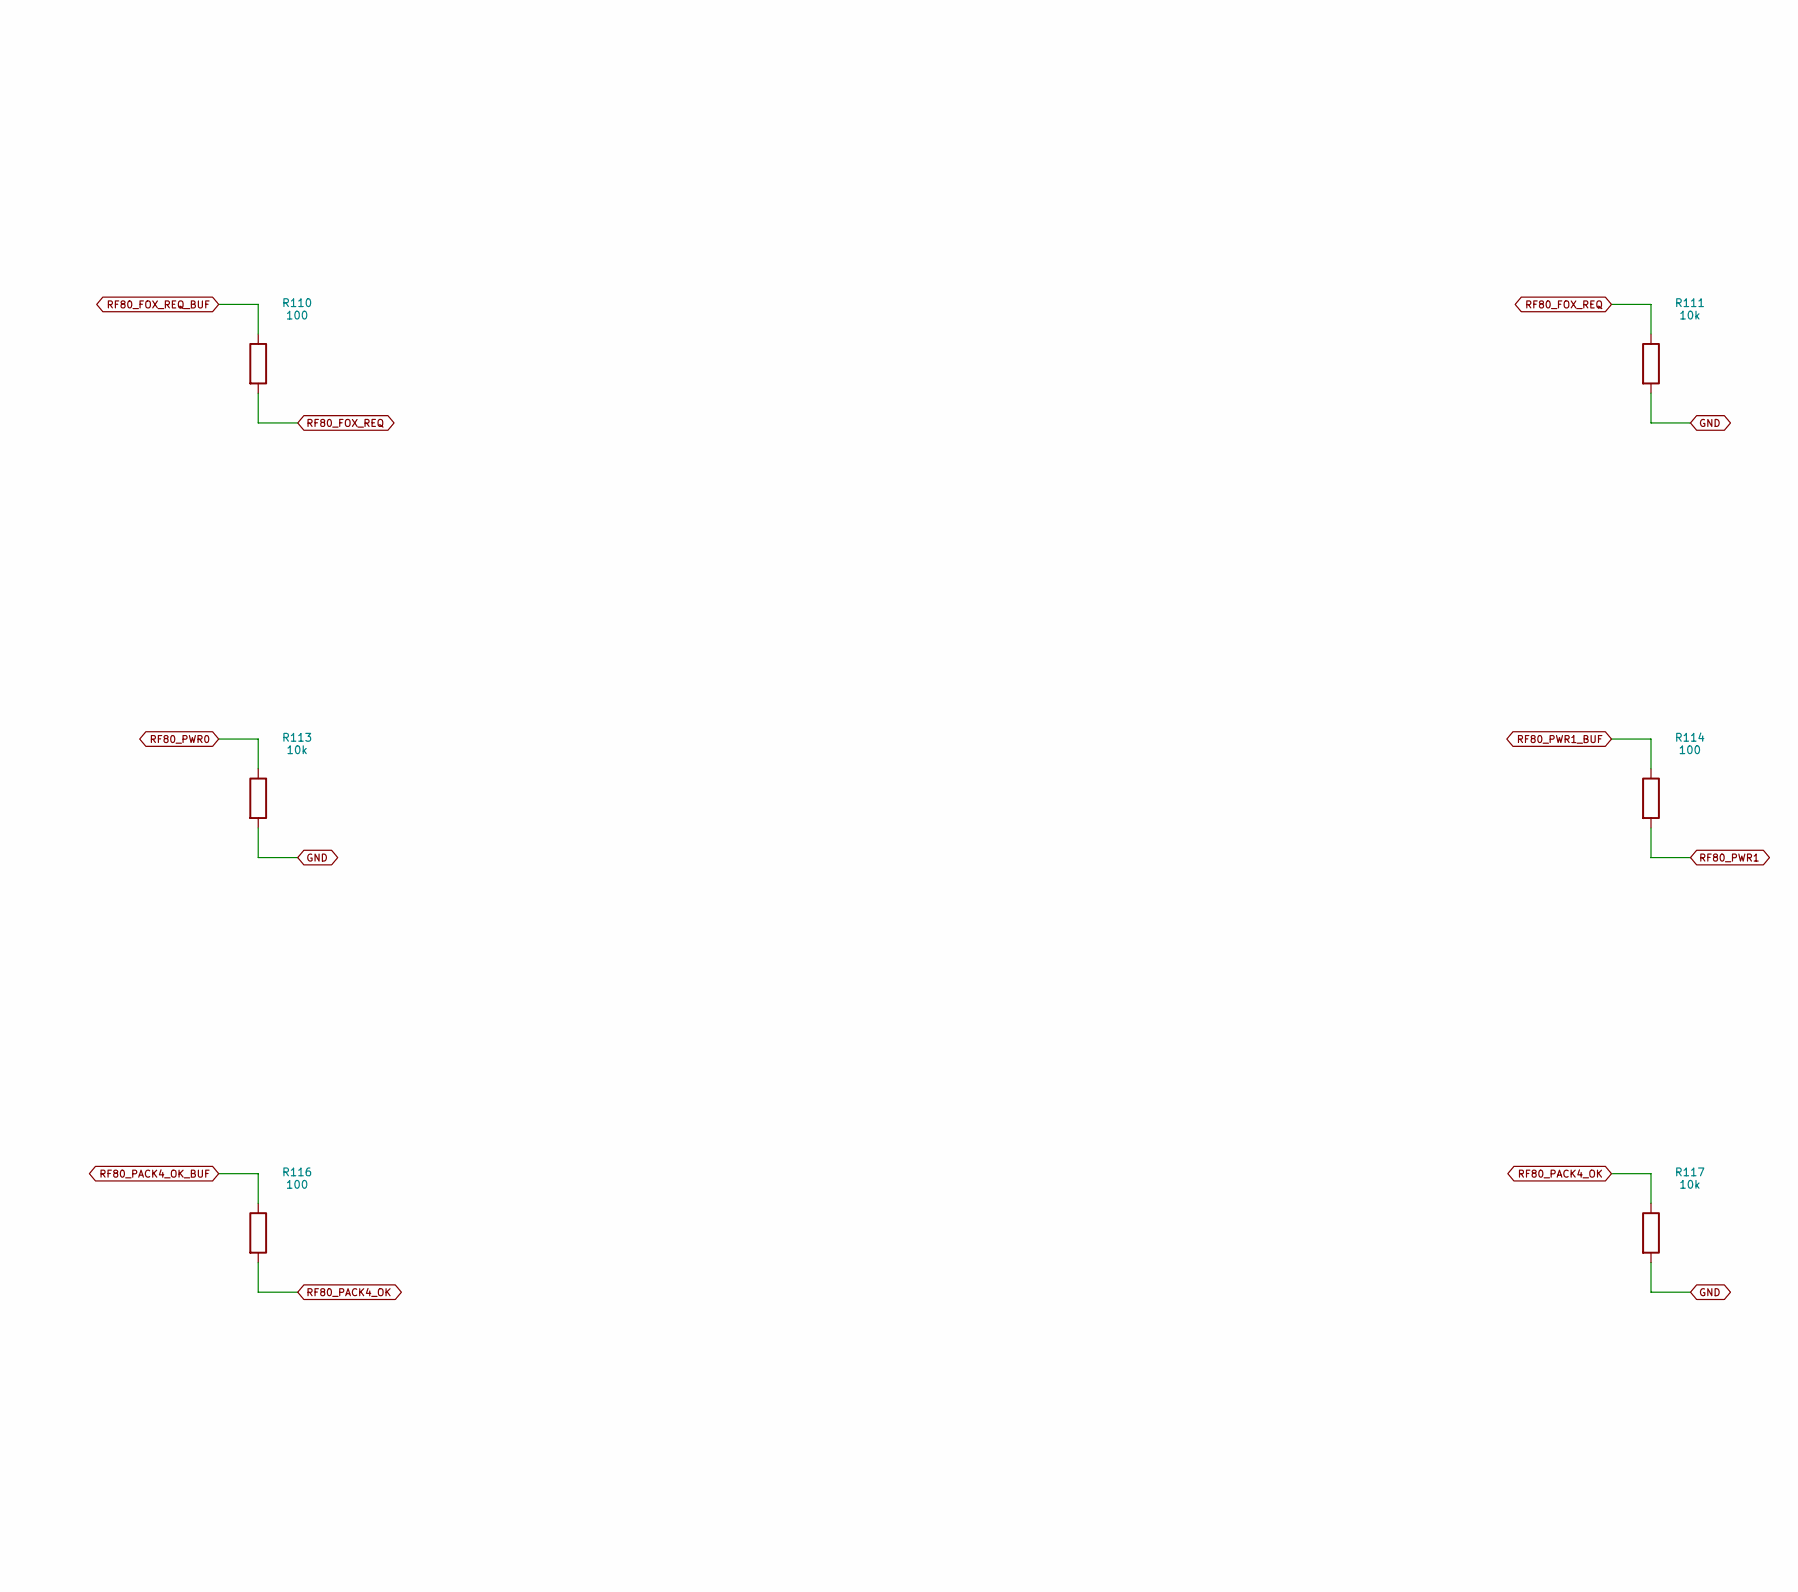
[picture p360: schematic 06_RF80_2.kicad_sch, 06 RF80 / 2, part in row 1, column 2]

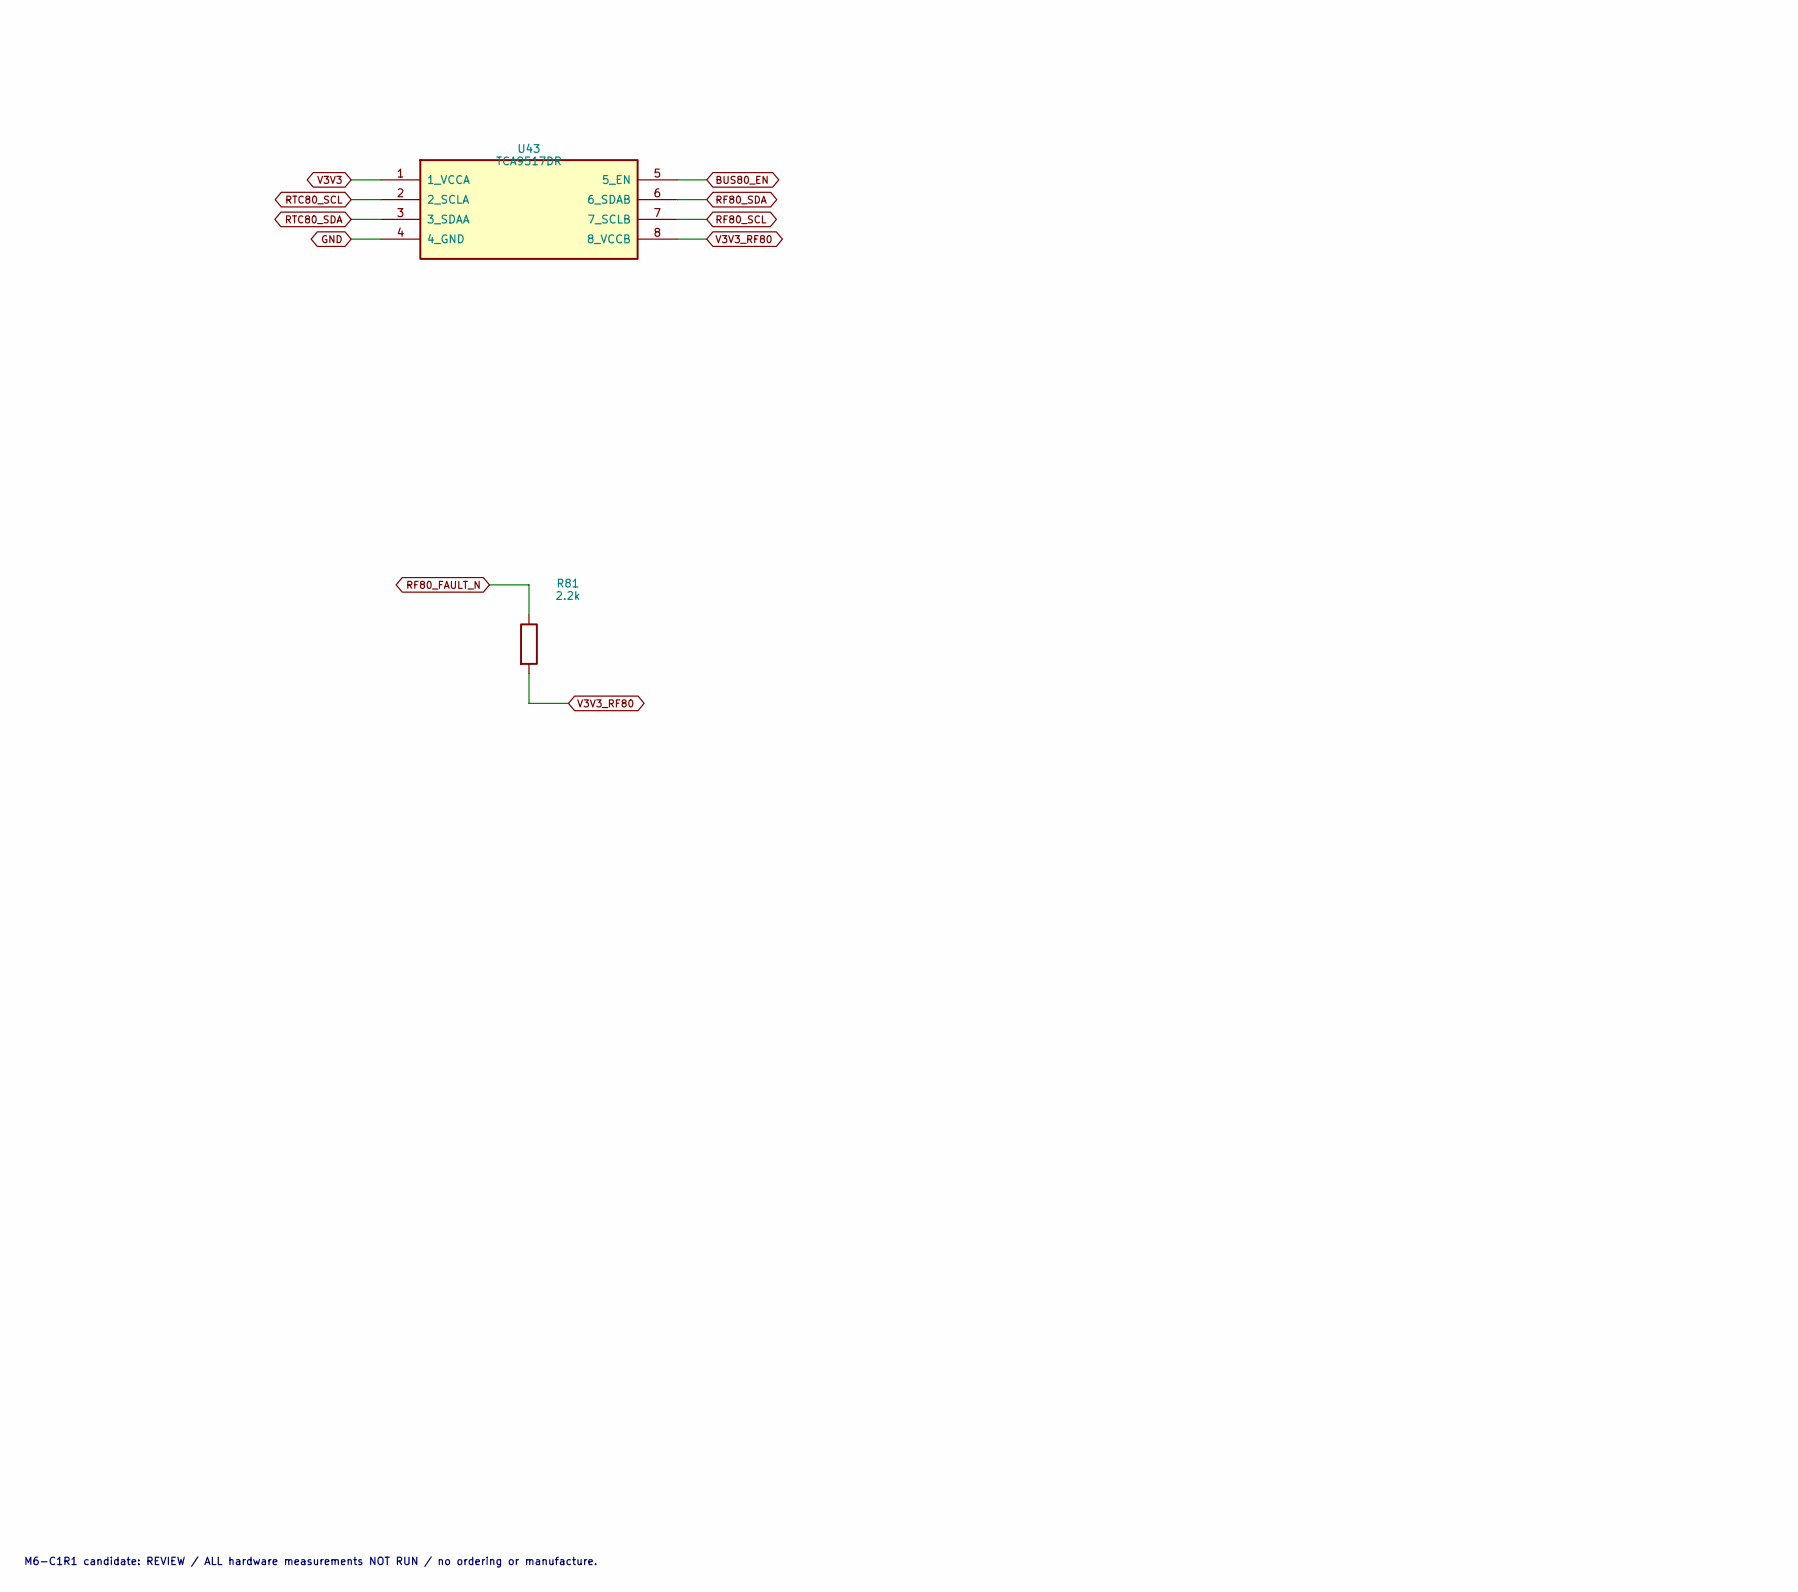
[picture p361: schematic 06_RF80_2.kicad_sch, 06 RF80 / 2, part in row 2, column 1]

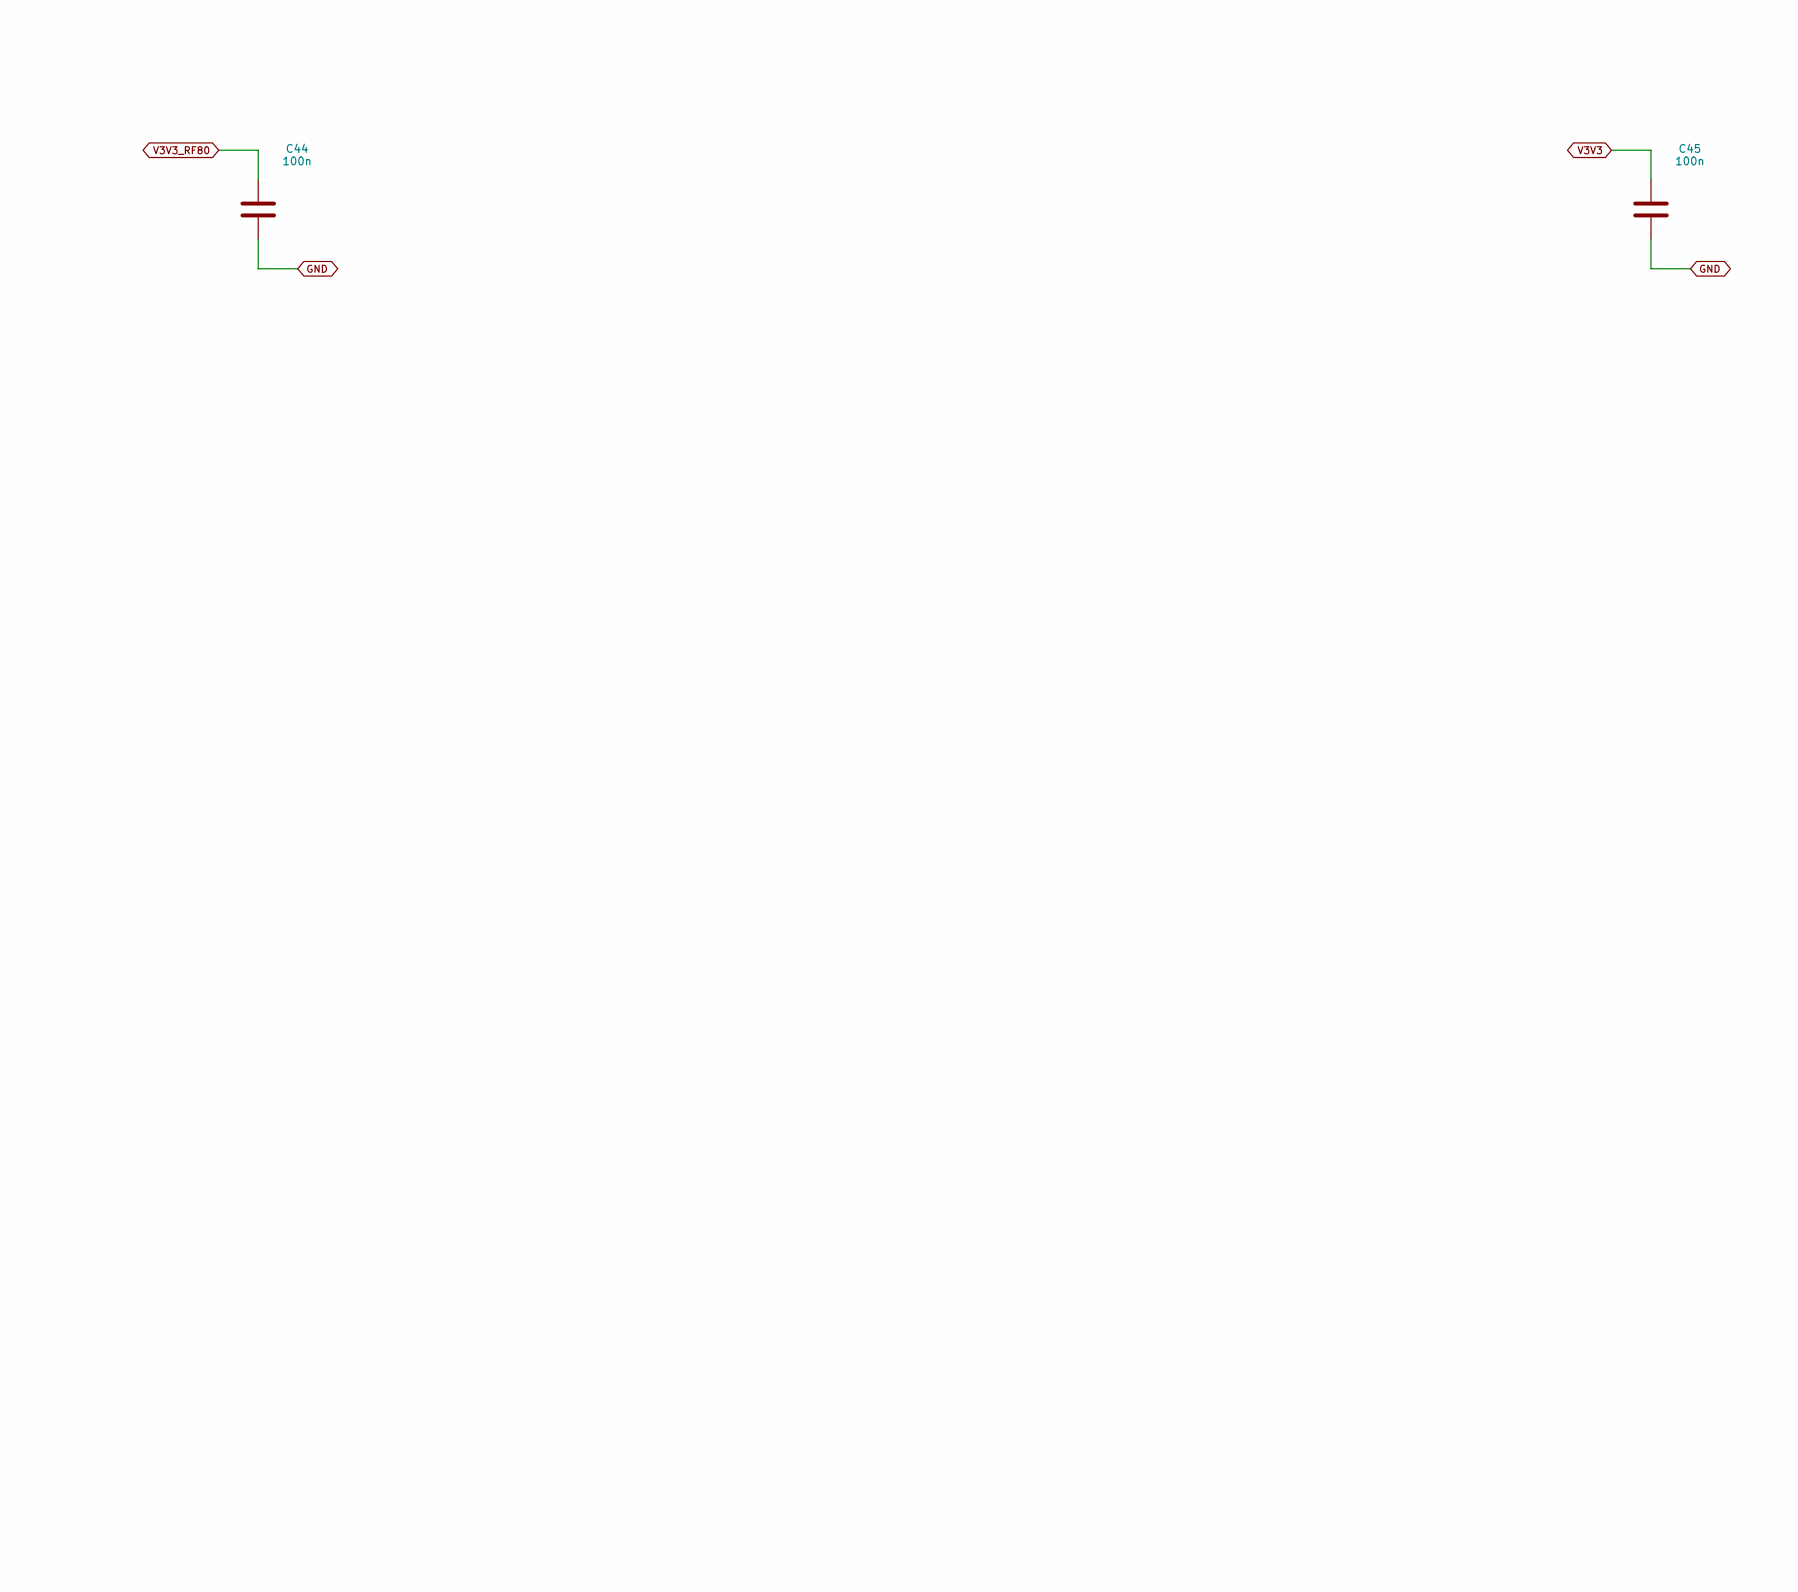
[picture p362: schematic 06_RF80_2.kicad_sch, 06 RF80 / 2, part in row 2, column 2]

Parts:
C44, C45: 100n; C_0603_1608Metric_CTL; MPN CL10B104KB8NNNC
R81: 2.2k; R_0603_1608Metric_CTL; MPN RC0603FR-072K2L
R109, R111, R113, R115, R117: 10k; R_0603_1608Metric_CTL; MPN RC0603FR-0710KL
R110, R112, R114, R116: 100; R_0603_1608Metric_CTL; MPN RC0603FR-07100RL
U43: TCA9517DR; SOIC-8_3.9x4.9mm_P1.27mm_CTL; MPN TCA9517DR

Connections:
BUS80_EN: U43.5 (5_EN); also elsewhere on the board
GND: C44.2, C45.2, R109.2, R111.2, R113.2, R115.2, R117.2, U43.4 (4_GND); also elsewhere on the board
RF80_FAULT_N: R81.1; also elsewhere on the board
RF80_FOX_REQ: R110.2, R111.1; also elsewhere on the board
RF80_FOX_REQ_BUF: R110.1; also elsewhere on the board
RF80_PACK4_OK: R116.2, R117.1; also elsewhere on the board
RF80_PACK4_OK_BUF: R116.1; also elsewhere on the board
RF80_PA_REQ: R109.1; also elsewhere on the board
RF80_PWR0: R112.2, R113.1; also elsewhere on the board
RF80_PWR0_BUF: R112.1; also elsewhere on the board
RF80_PWR1: R114.2, R115.1; also elsewhere on the board
RF80_PWR1_BUF: R114.1; also elsewhere on the board
RF80_SCL: U43.7 (7_SCLB); also elsewhere on the board
RF80_SDA: U43.6 (6_SDAB); also elsewhere on the board
RTC80_SCL: U43.2 (2_SCLA); also elsewhere on the board
RTC80_SDA: U43.3 (3_SDAA); also elsewhere on the board
V3V3: C45.1, U43.1 (1_VCCA); also elsewhere on the board
V3V3_RF80: C44.1, R81.2, U43.8 (8_VCCB); also elsewhere on the board

Notes on the sheet:
06 RF80 / 2
M6-C1R1 candidate: REVIEW / ALL hardware measurements NOT RUN / no ordering or manufacture.
