DD1SB/ARDF-TX/hardware/controller/CTRL.kicad_pcb

## KiCad design hardware/controller/CTRL.kicad_pcb (continued)

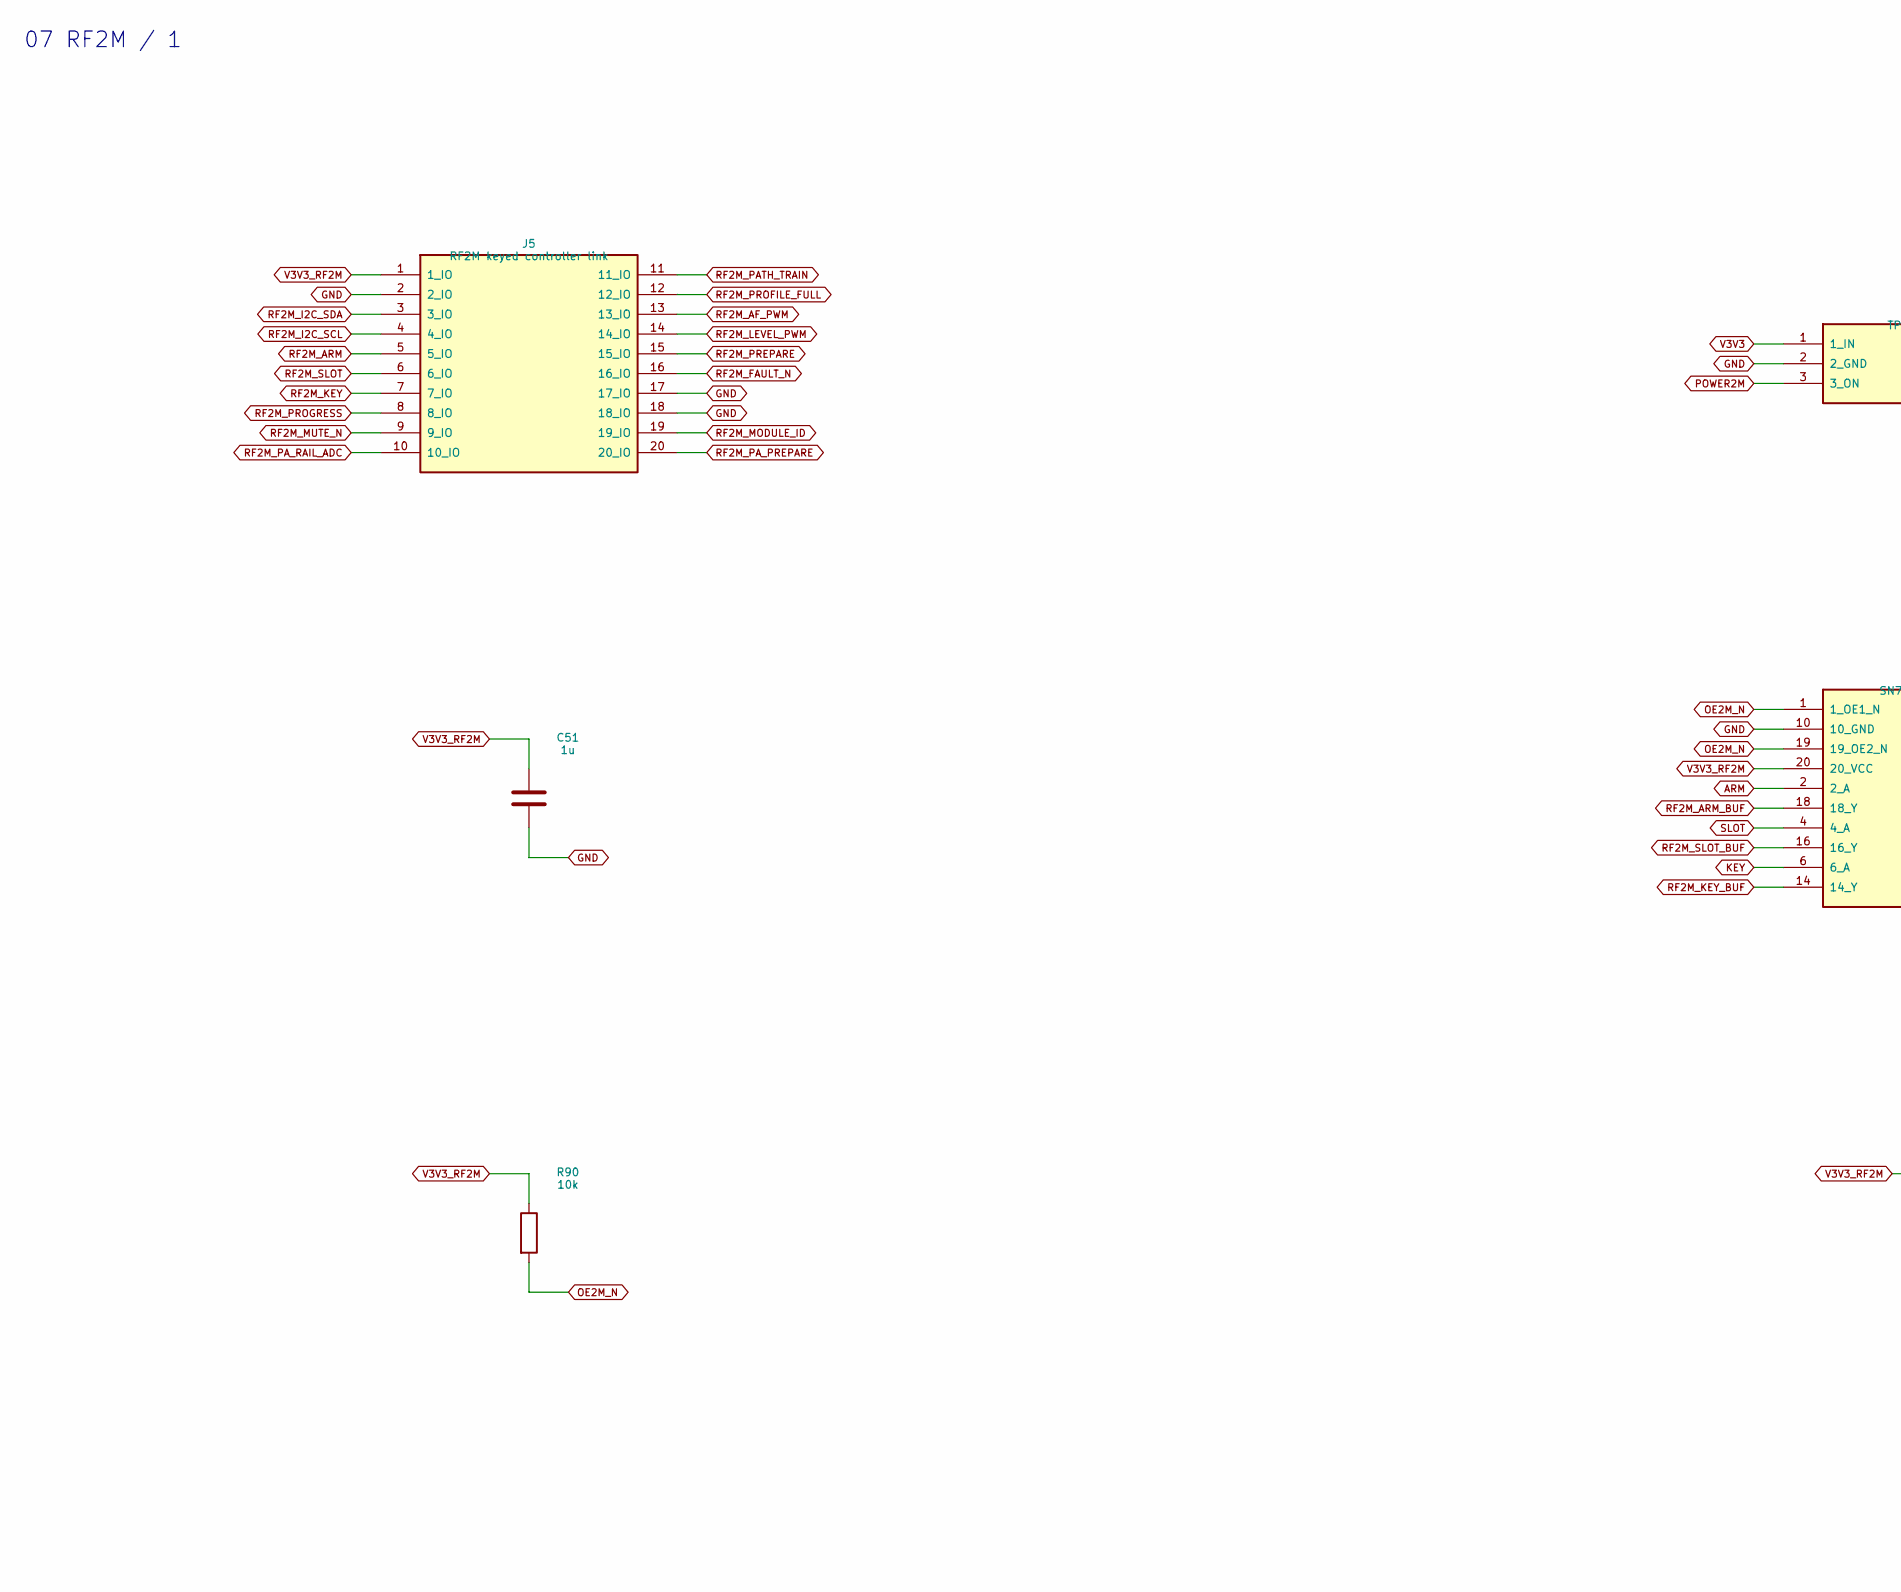
[picture p363: schematic 07_RF2M.kicad_sch, 07 RF2M / 1, part in row 1, column 1]

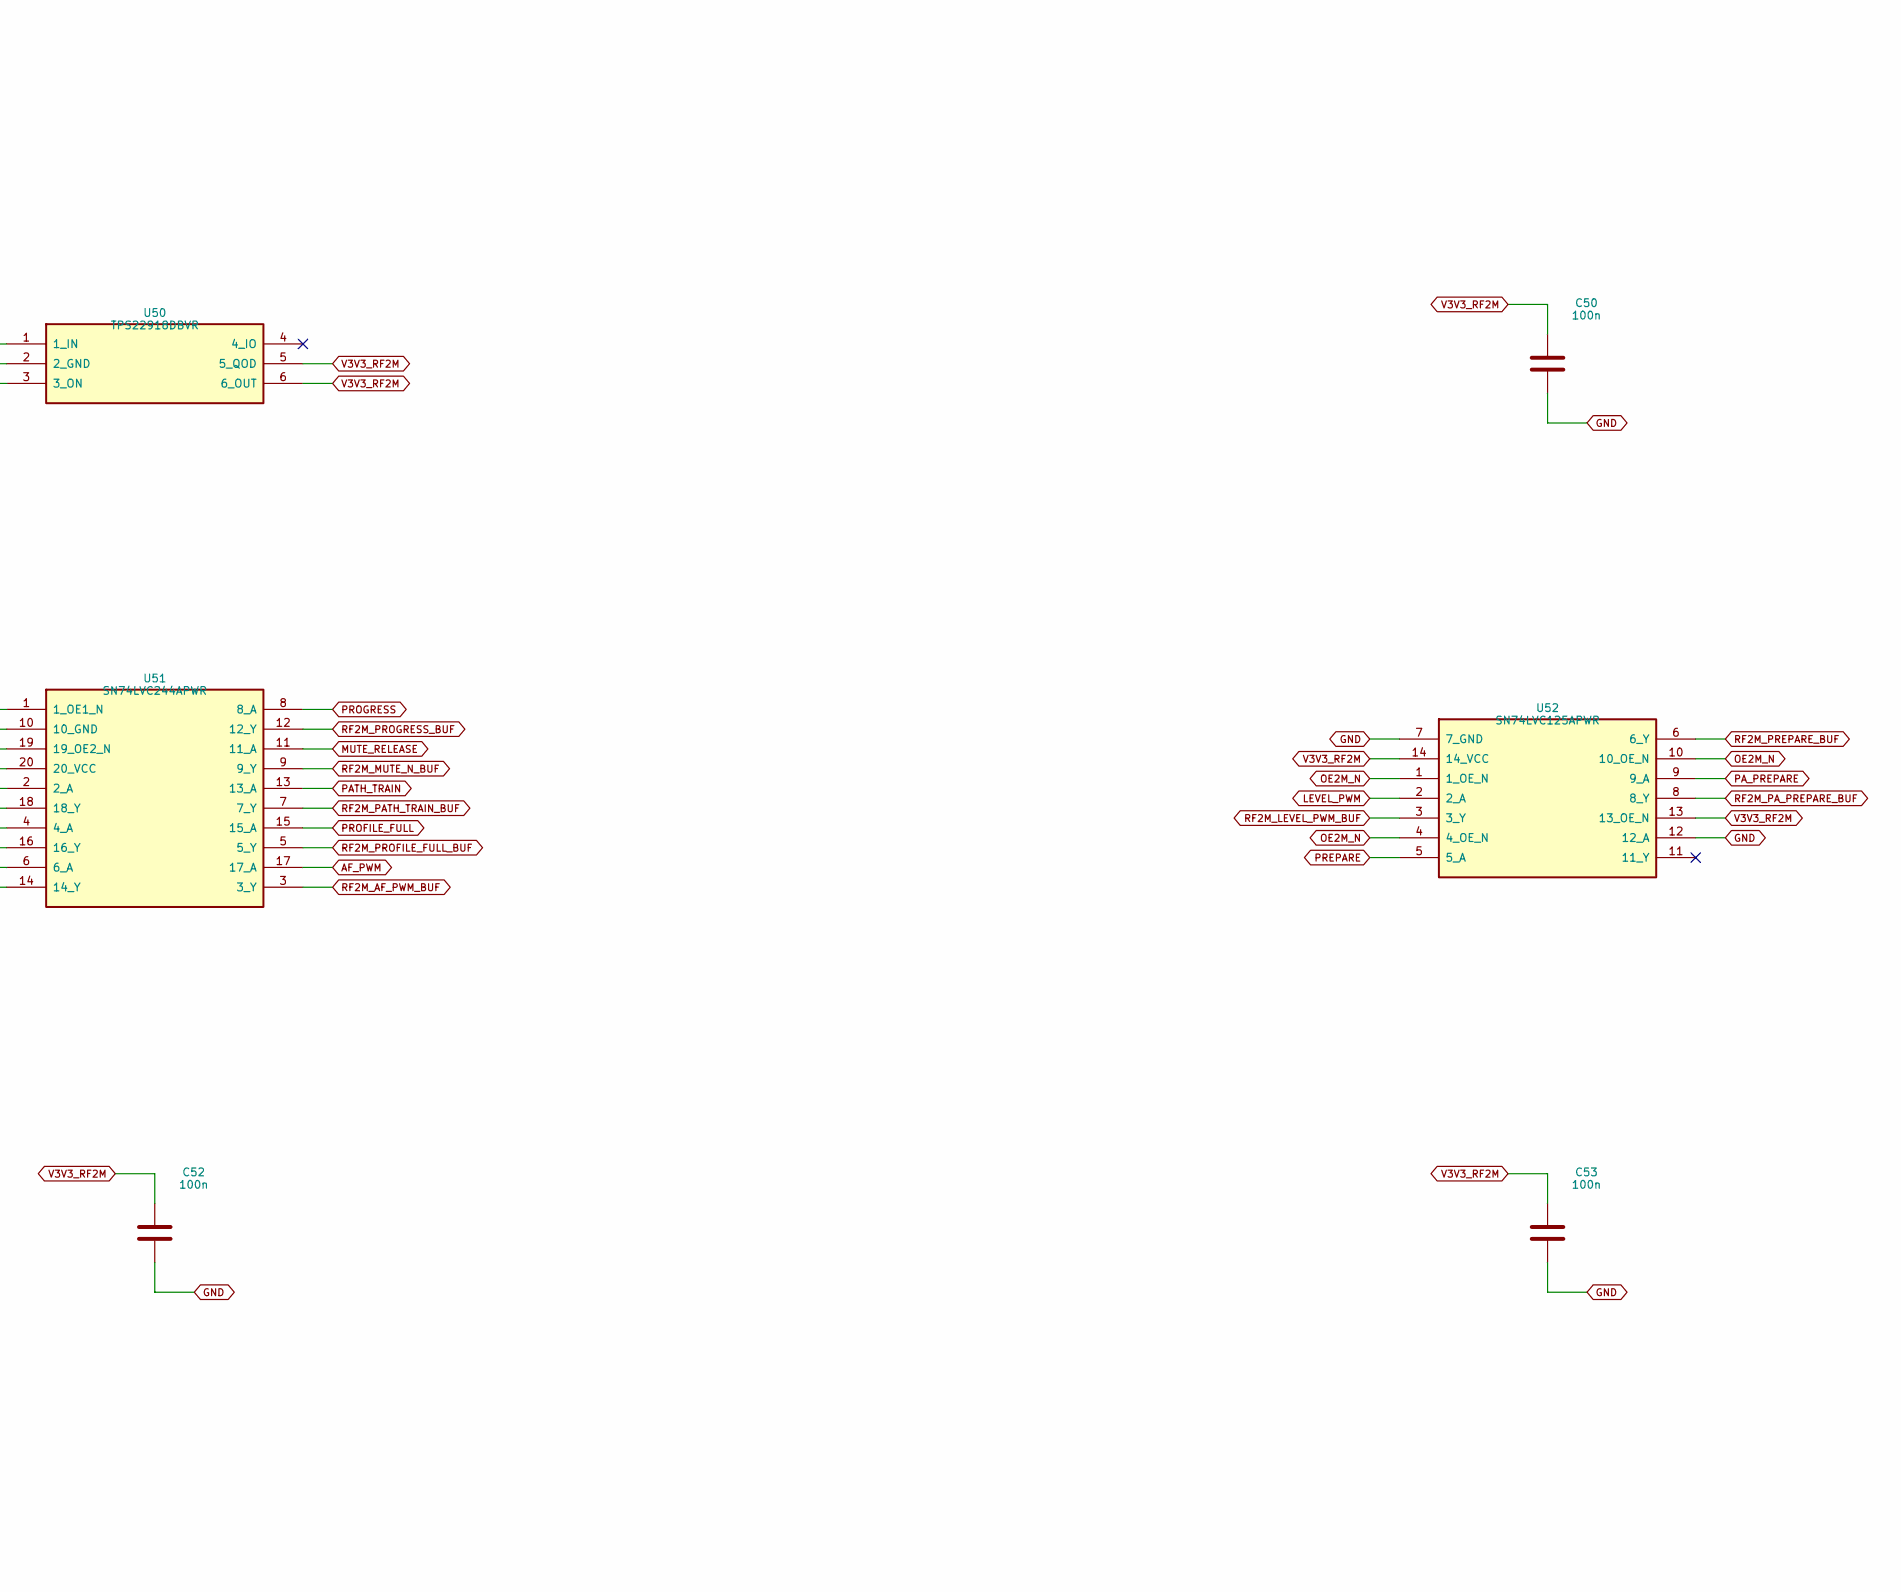
[picture p364: schematic 07_RF2M.kicad_sch, 07 RF2M / 1, part in row 1, column 2]

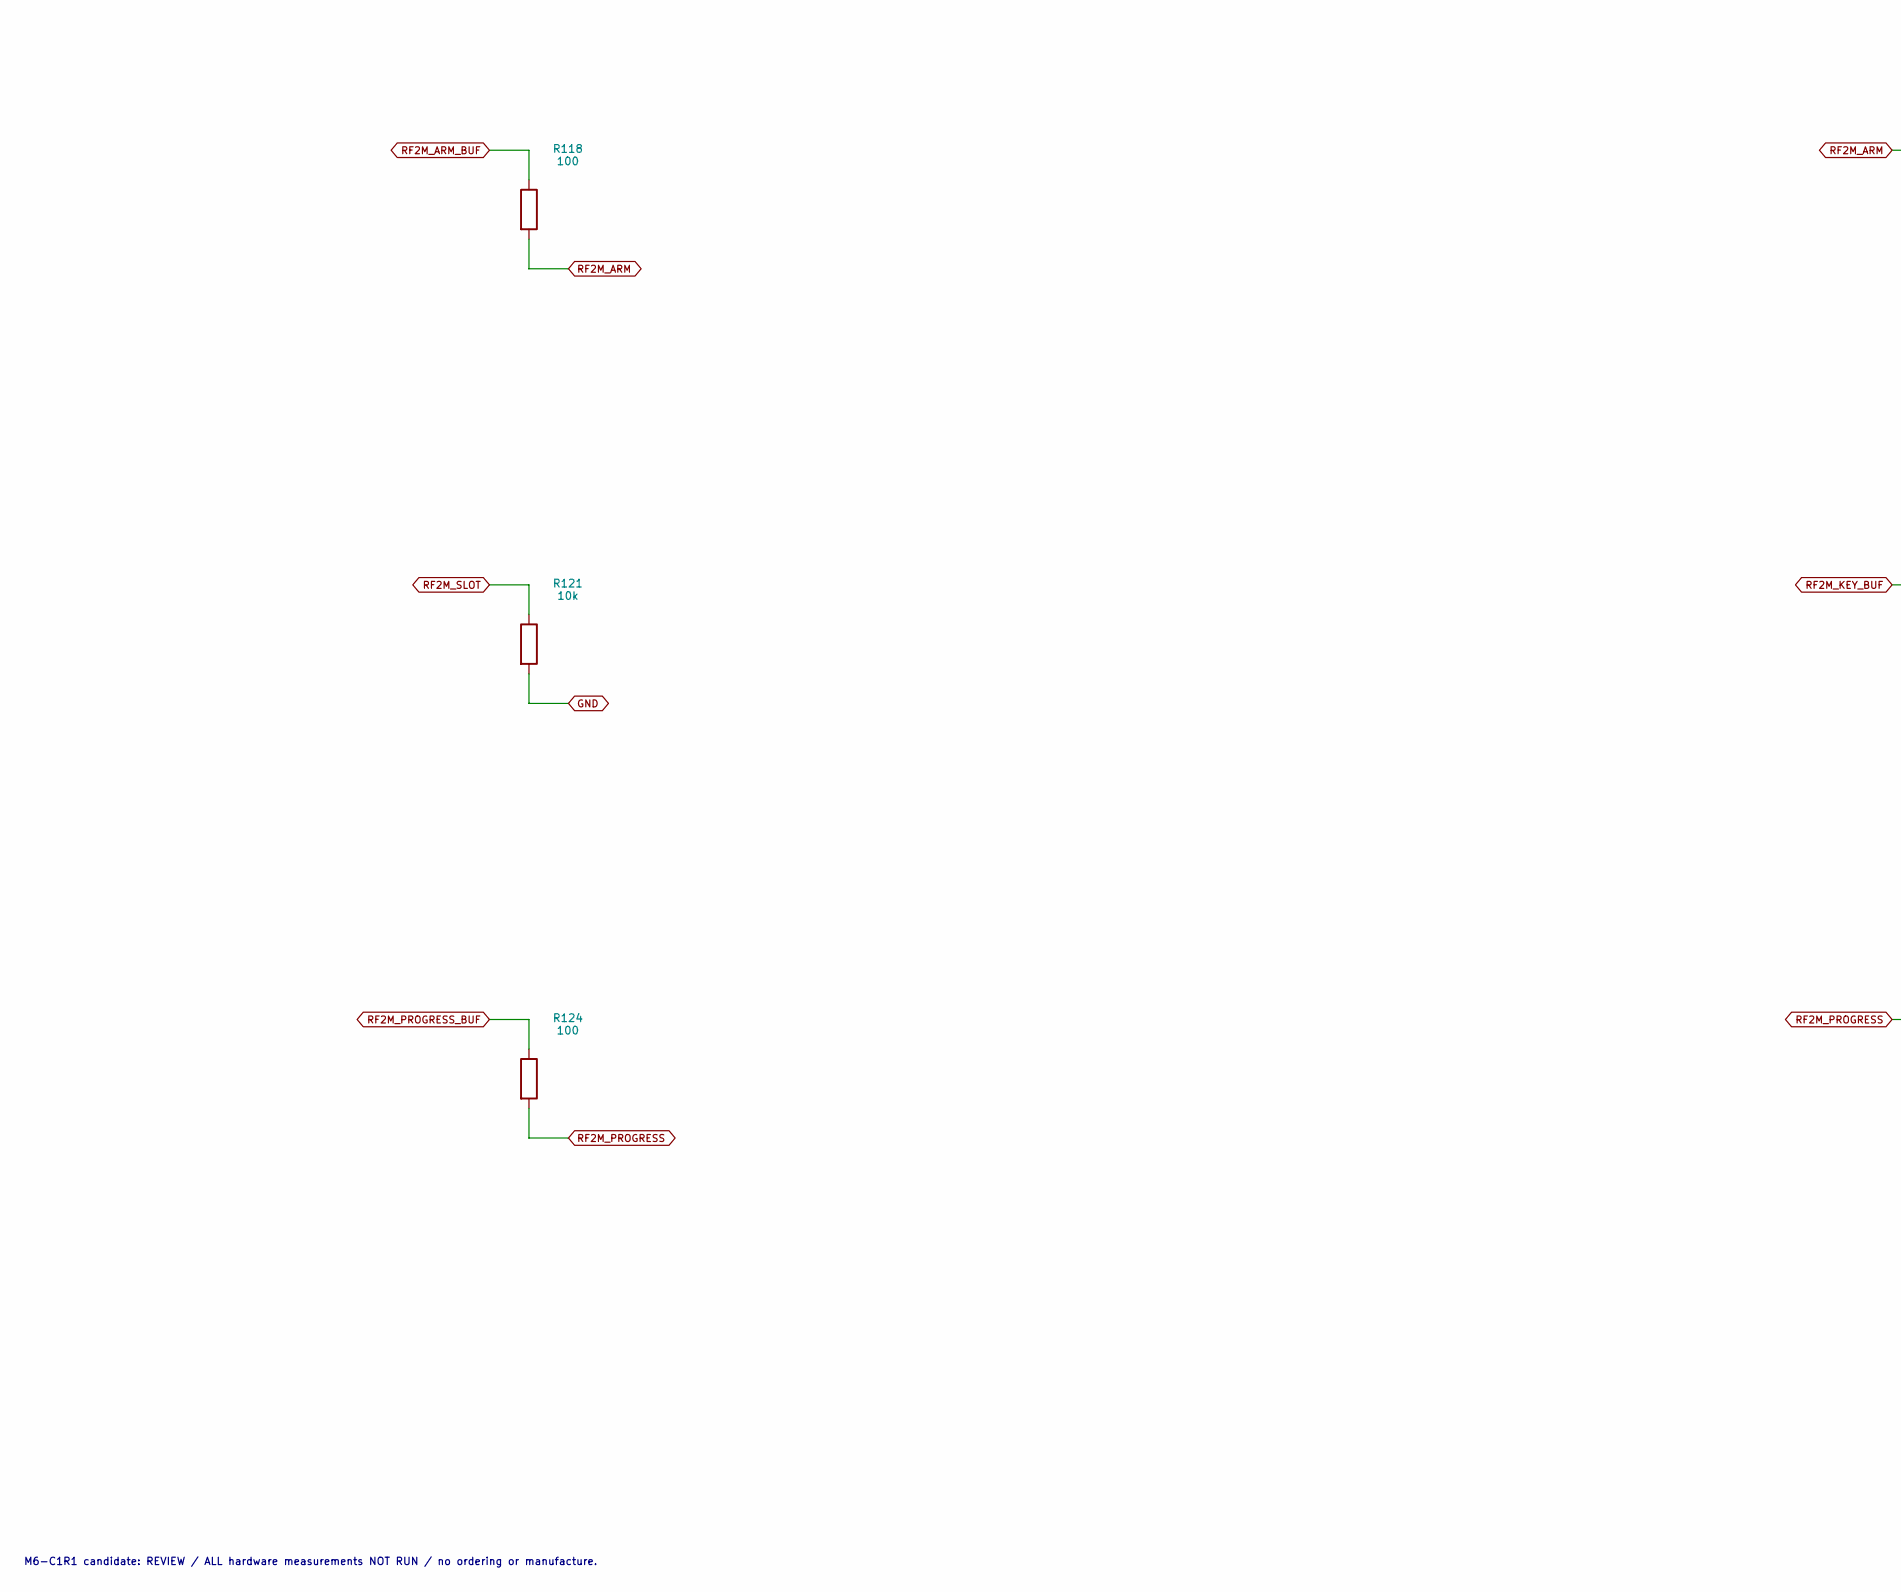
[picture p365: schematic 07_RF2M.kicad_sch, 07 RF2M / 1, part in row 2, column 1]

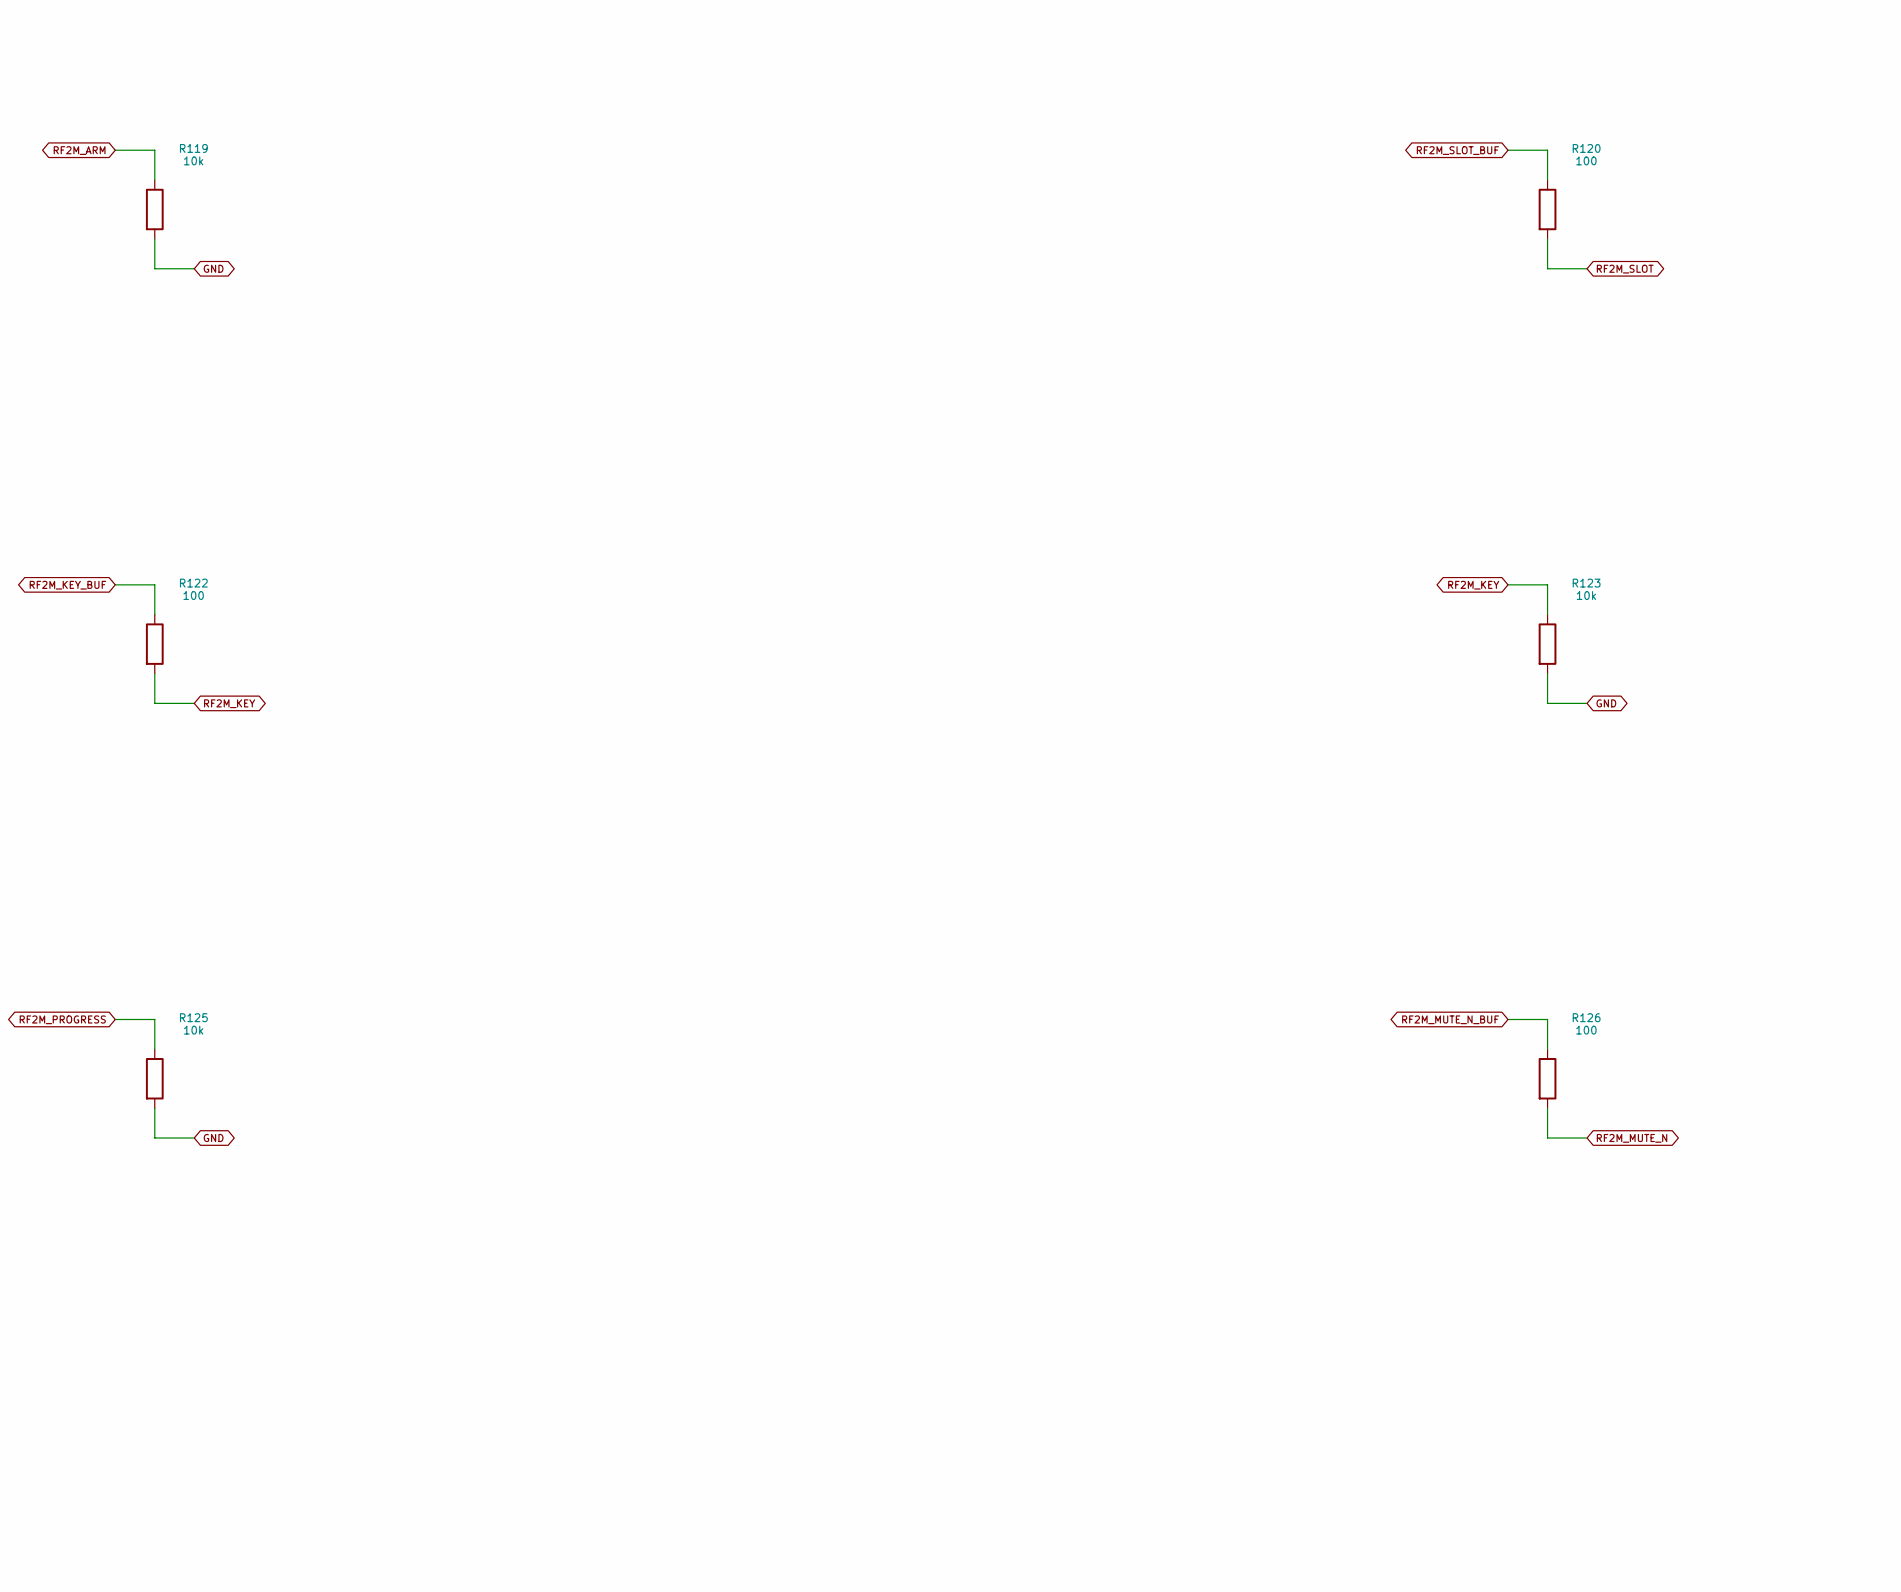
[picture p366: schematic 07_RF2M.kicad_sch, 07 RF2M / 1, part in row 2, column 2]

Parts:
C50, C52, C53: 100n; C_0603_1608Metric_CTL; MPN CL10B104KB8NNNC
C51: 1u; C_0603_1608Metric_CTL; MPN CL10A105KB8NNNC
J5: RF2M keyed controller link; IDC20_61202021621; MPN 61202021621
R90, R119, R121, R123, R125: 10k; R_0603_1608Metric_CTL; MPN RC0603FR-0710KL
R118, R120, R122, R124, R126: 100; R_0603_1608Metric_CTL; MPN RC0603FR-07100RL
U50: TPS22918DBVR; SOT-23-6_CTL; MPN TPS22918DBVR
U51: SN74LVC244APWR; TSSOP-20_4.4x6.5mm_P0.65mm_CTL; MPN SN74LVC244APWR
U52: SN74LVC125APWR; TSSOP-14_4.4x5mm_P0.65mm_CTL; MPN SN74LVC125APWR

Connections:
AF_PWM: U51.17 (17_A); also elsewhere on the board
ARM: U51.2 (2_A); also elsewhere on the board
GND: C50.2, C51.2, C52.2, C53.2, J5.2 (2_IO), J5.17 (17_IO), J5.18 (18_IO), R119.2, R121.2, R123.2, R125.2, U50.2 (2_GND), U51.10 (10_GND), U52.7 (7_GND), U52.12 (12_A); also elsewhere on the board
KEY: U51.6 (6_A); also elsewhere on the board
LEVEL_PWM: U52.2 (2_A); also elsewhere on the board
MUTE_RELEASE: U51.11 (11_A); also elsewhere on the board
OE2M_N: R90.2, U51.1 (1_OE1_N), U51.19 (19_OE2_N), U52.1 (1_OE_N), U52.4 (4_OE_N), U52.10 (10_OE_N); also elsewhere on the board
PATH_TRAIN: U51.13 (13_A); also elsewhere on the board
PA_PREPARE: U52.9 (9_A); also elsewhere on the board
POWER2M: U50.3 (3_ON); also elsewhere on the board
PREPARE: U52.5 (5_A); also elsewhere on the board
PROFILE_FULL: U51.15 (15_A); also elsewhere on the board
PROGRESS: U51.8 (8_A); also elsewhere on the board
RF2M_AF_PWM: J5.13 (13_IO); also elsewhere on the board
RF2M_AF_PWM_BUF: U51.3 (3_Y); also elsewhere on the board
RF2M_ARM: J5.5 (5_IO), R118.2, R119.1
RF2M_ARM_BUF: R118.1, U51.18 (18_Y)
RF2M_FAULT_N: J5.16 (16_IO); also elsewhere on the board
RF2M_I2C_SCL: J5.4 (4_IO); also elsewhere on the board
RF2M_I2C_SDA: J5.3 (3_IO); also elsewhere on the board
RF2M_KEY: J5.7 (7_IO), R122.2, R123.1
RF2M_KEY_BUF: R122.1, U51.14 (14_Y)
RF2M_LEVEL_PWM: J5.14 (14_IO); also elsewhere on the board
RF2M_LEVEL_PWM_BUF: U52.3 (3_Y); also elsewhere on the board
RF2M_MODULE_ID: J5.19 (19_IO); also elsewhere on the board
RF2M_MUTE_N: J5.9 (9_IO), R126.2; also elsewhere on the board
RF2M_MUTE_N_BUF: R126.1, U51.9 (9_Y)
RF2M_PATH_TRAIN: J5.11 (11_IO); also elsewhere on the board
RF2M_PATH_TRAIN_BUF: U51.7 (7_Y); also elsewhere on the board
RF2M_PA_PREPARE: J5.20 (20_IO); also elsewhere on the board
RF2M_PA_PREPARE_BUF: U52.8 (8_Y); also elsewhere on the board
RF2M_PA_RAIL_ADC: J5.10 (10_IO); also elsewhere on the board
RF2M_PREPARE: J5.15 (15_IO); also elsewhere on the board
RF2M_PREPARE_BUF: U52.6 (6_Y); also elsewhere on the board
RF2M_PROFILE_FULL: J5.12 (12_IO); also elsewhere on the board
RF2M_PROFILE_FULL_BUF: U51.5 (5_Y); also elsewhere on the board
RF2M_PROGRESS: J5.8 (8_IO), R124.2, R125.1
RF2M_PROGRESS_BUF: R124.1, U51.12 (12_Y)
RF2M_SLOT: J5.6 (6_IO), R120.2, R121.1
RF2M_SLOT_BUF: R120.1, U51.16 (16_Y)
SLOT: U51.4 (4_A); also elsewhere on the board
V3V3: U50.1 (1_IN); also elsewhere on the board
V3V3_RF2M: C50.1, C51.1, C52.1, C53.1, J5.1 (1_IO), R90.1, U50.5 (5_QOD), U50.6 (6_OUT), U51.20 (20_VCC), U52.13 (13_OE_N), U52.14 (14_VCC); also elsewhere on the board

Notes on the sheet:
07 RF2M / 1
M6-C1R1 candidate: REVIEW / ALL hardware measurements NOT RUN / no ordering or manufacture.
