DD1SB/ARDF-TX/hardware/controller/CTRL.kicad_pcb

## KiCad design hardware/controller/CTRL.kicad_pcb (continued)

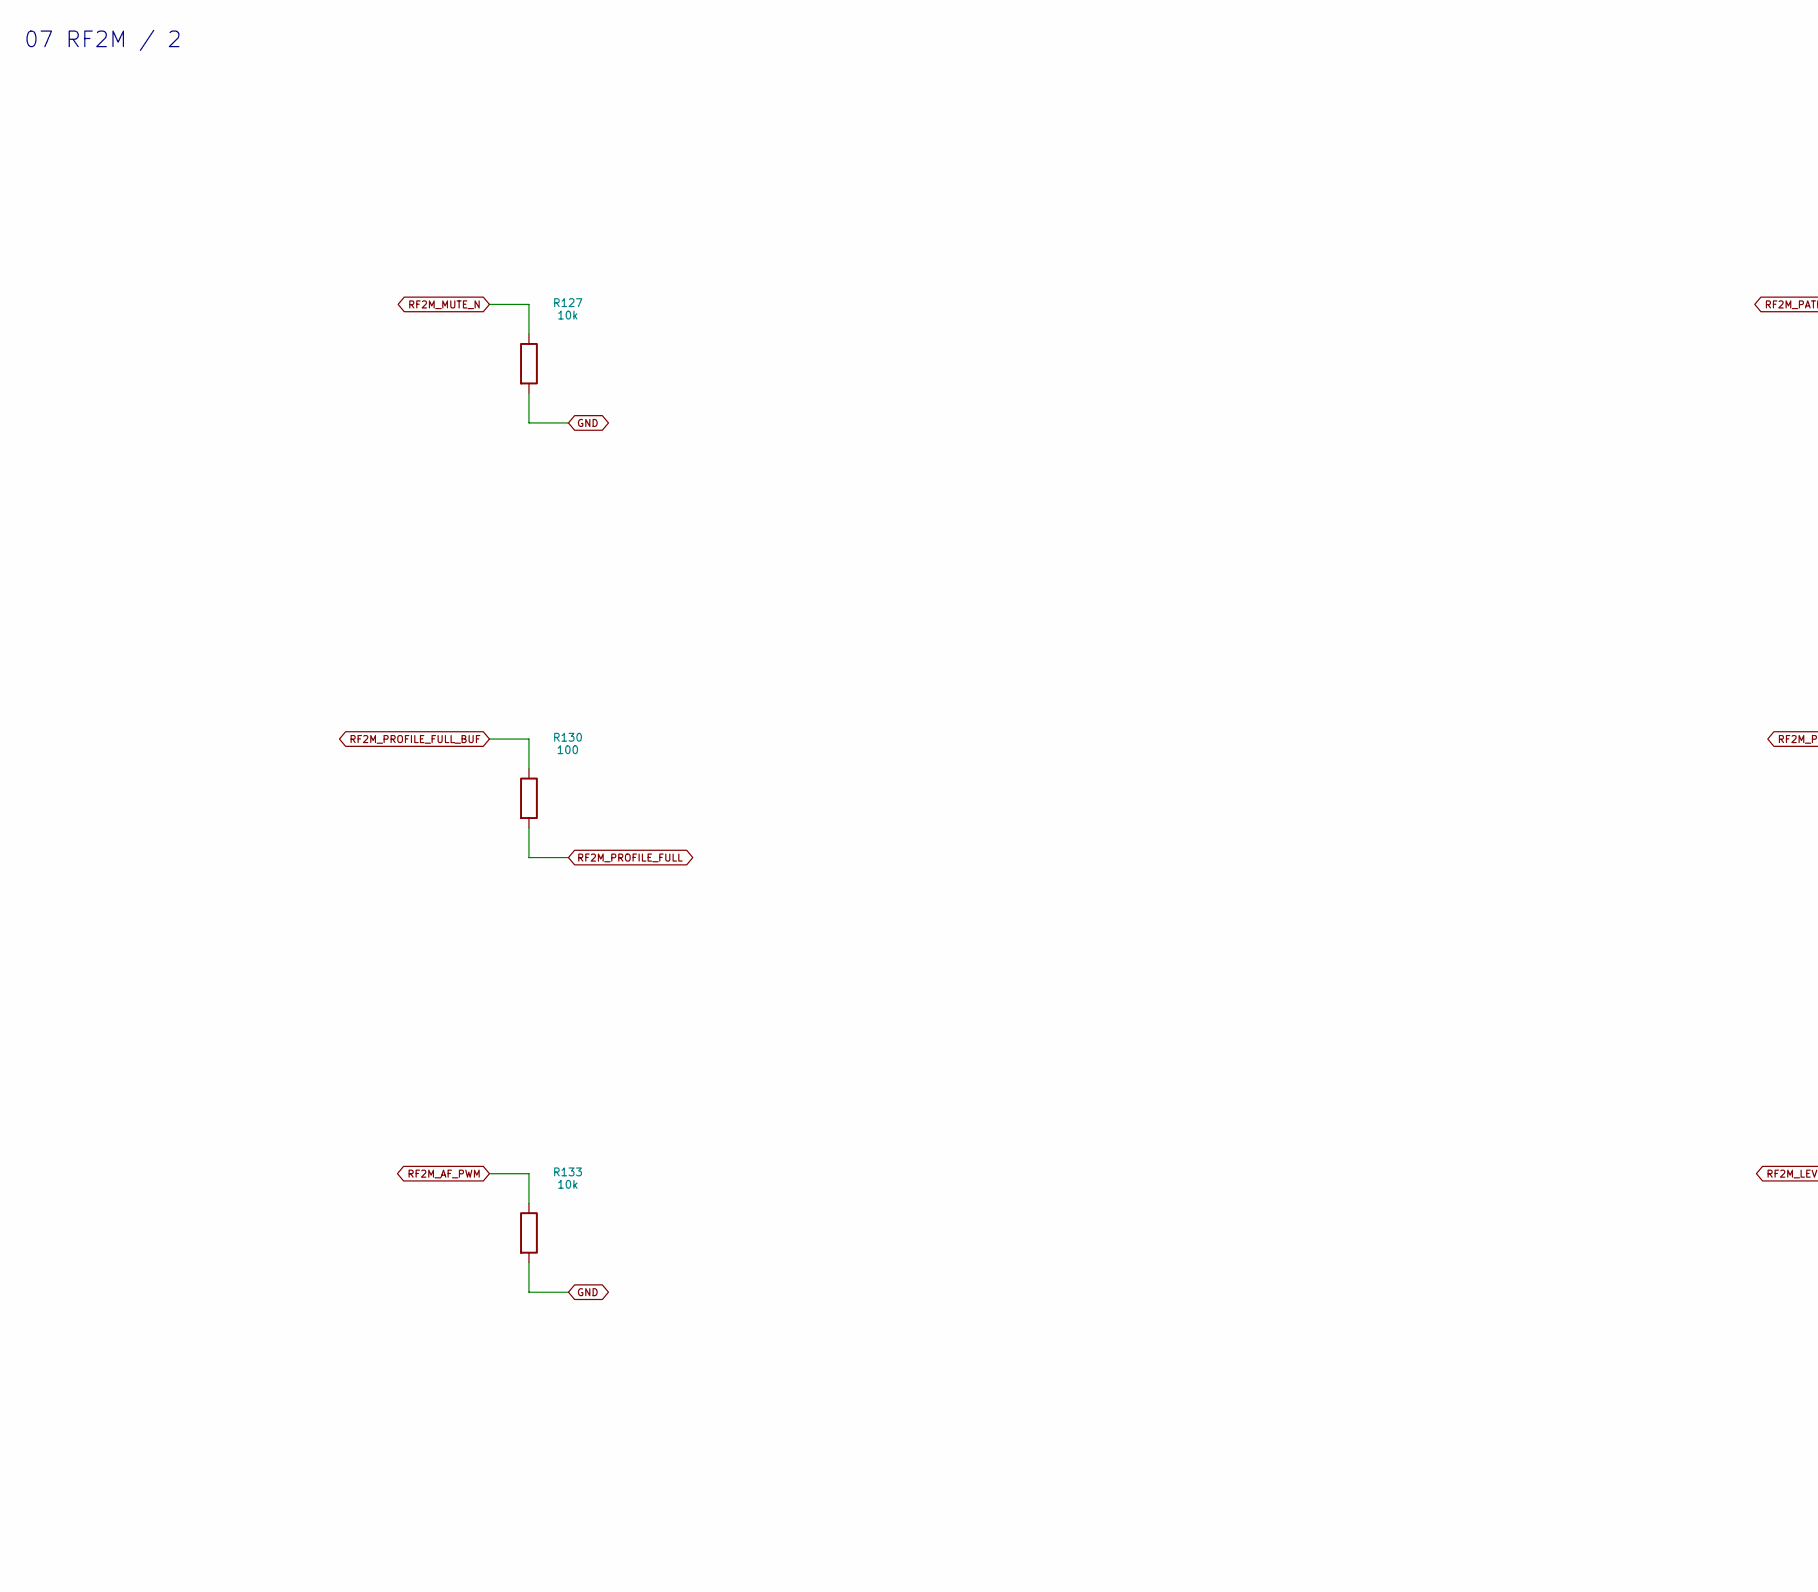
[picture p367: schematic 07_RF2M_2.kicad_sch, 07 RF2M / 2, part in row 1, column 1]

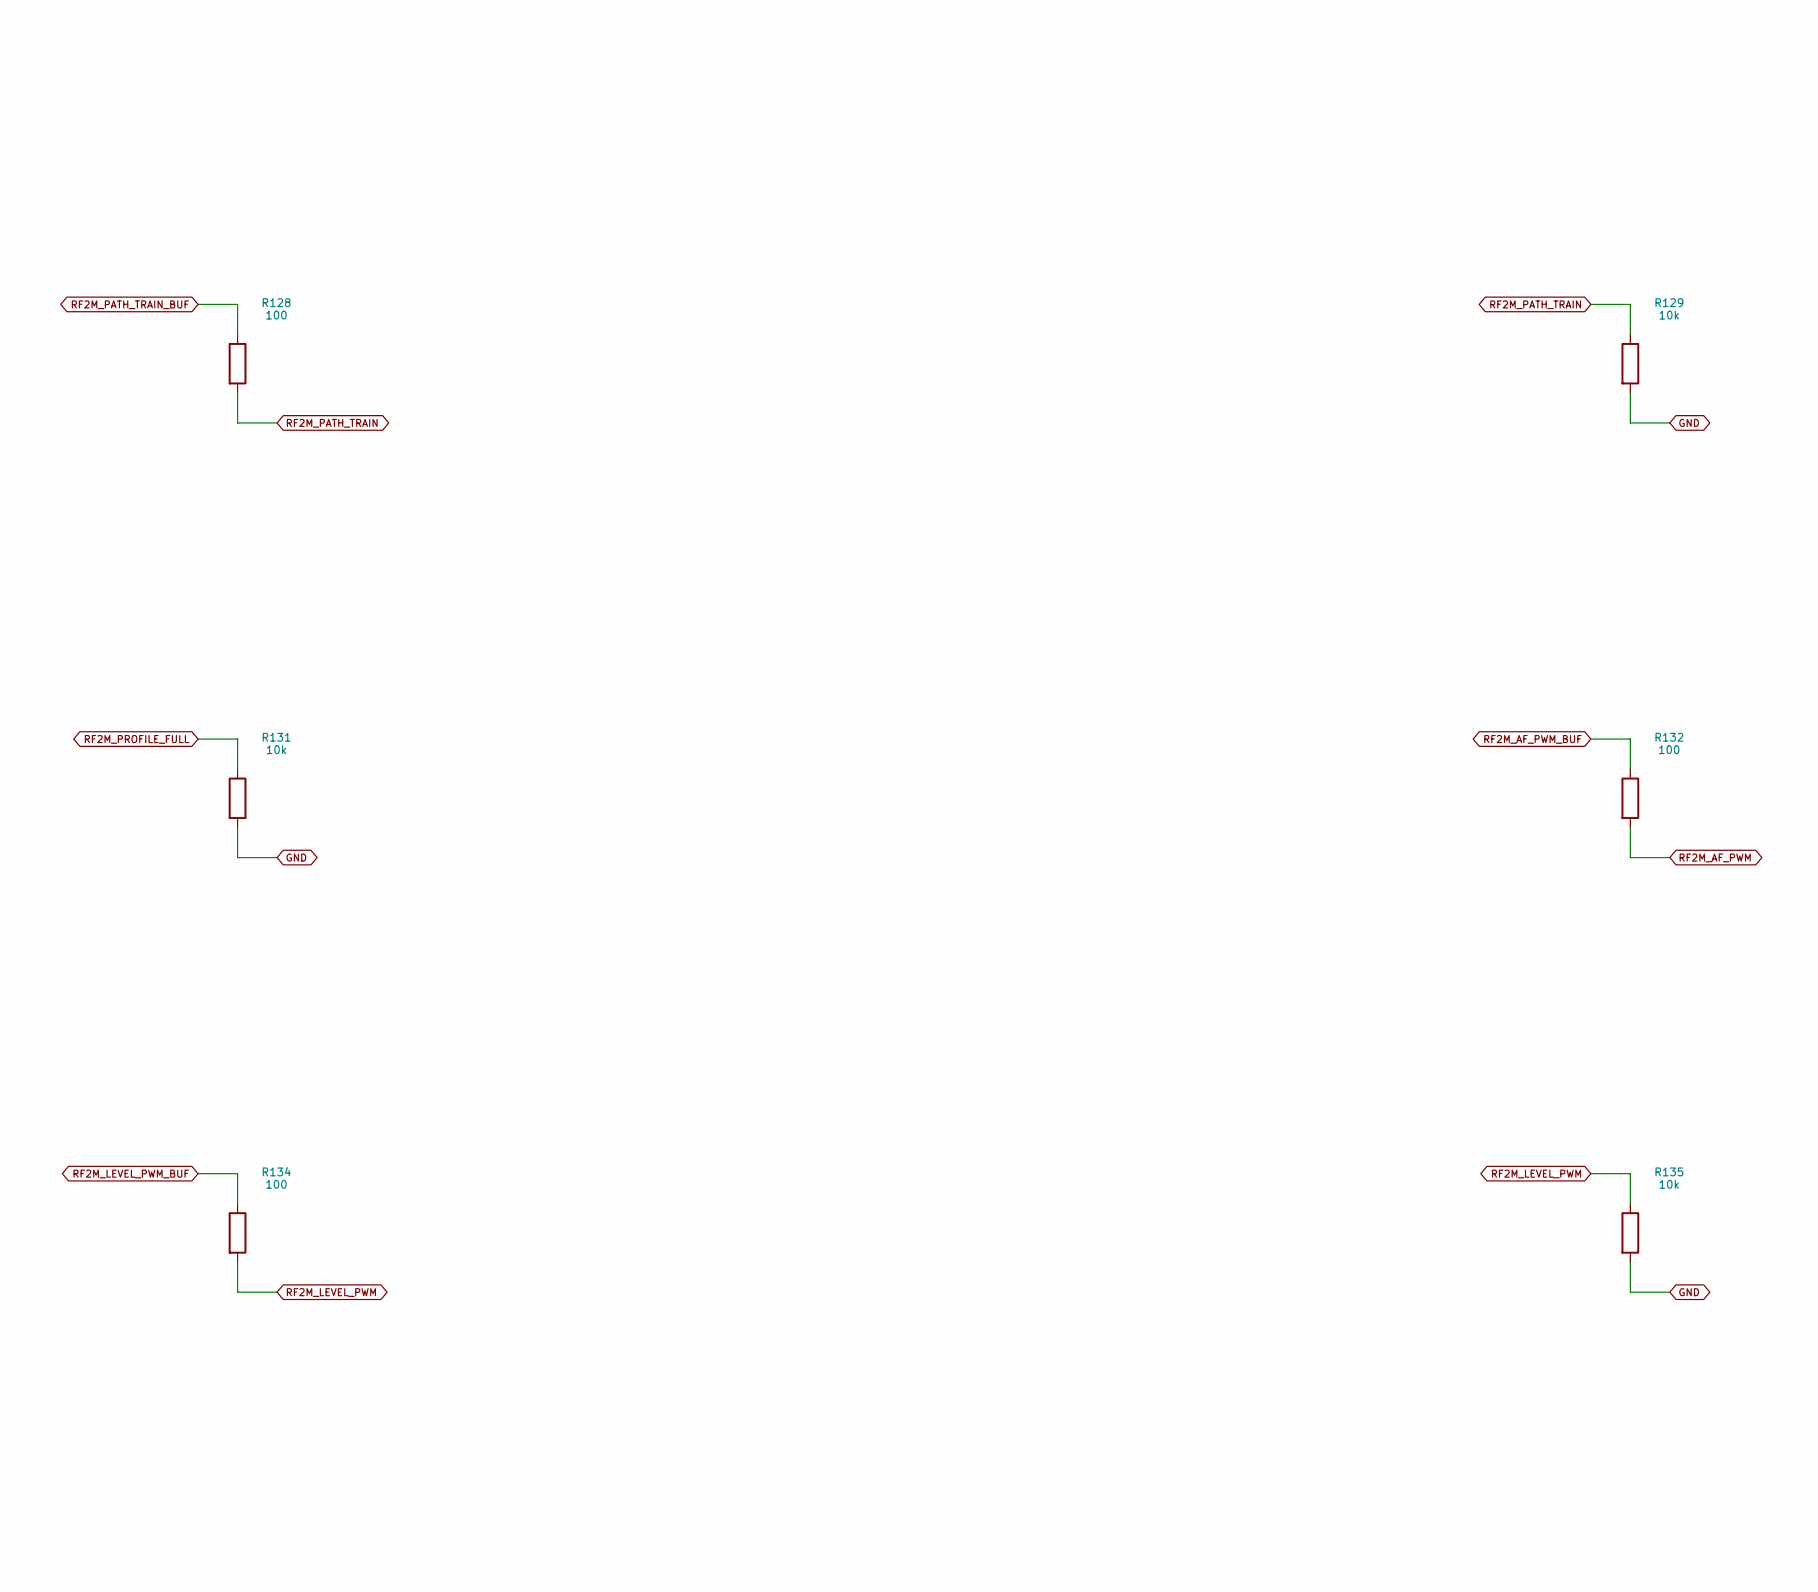
[picture p368: schematic 07_RF2M_2.kicad_sch, 07 RF2M / 2, part in row 1, column 2]

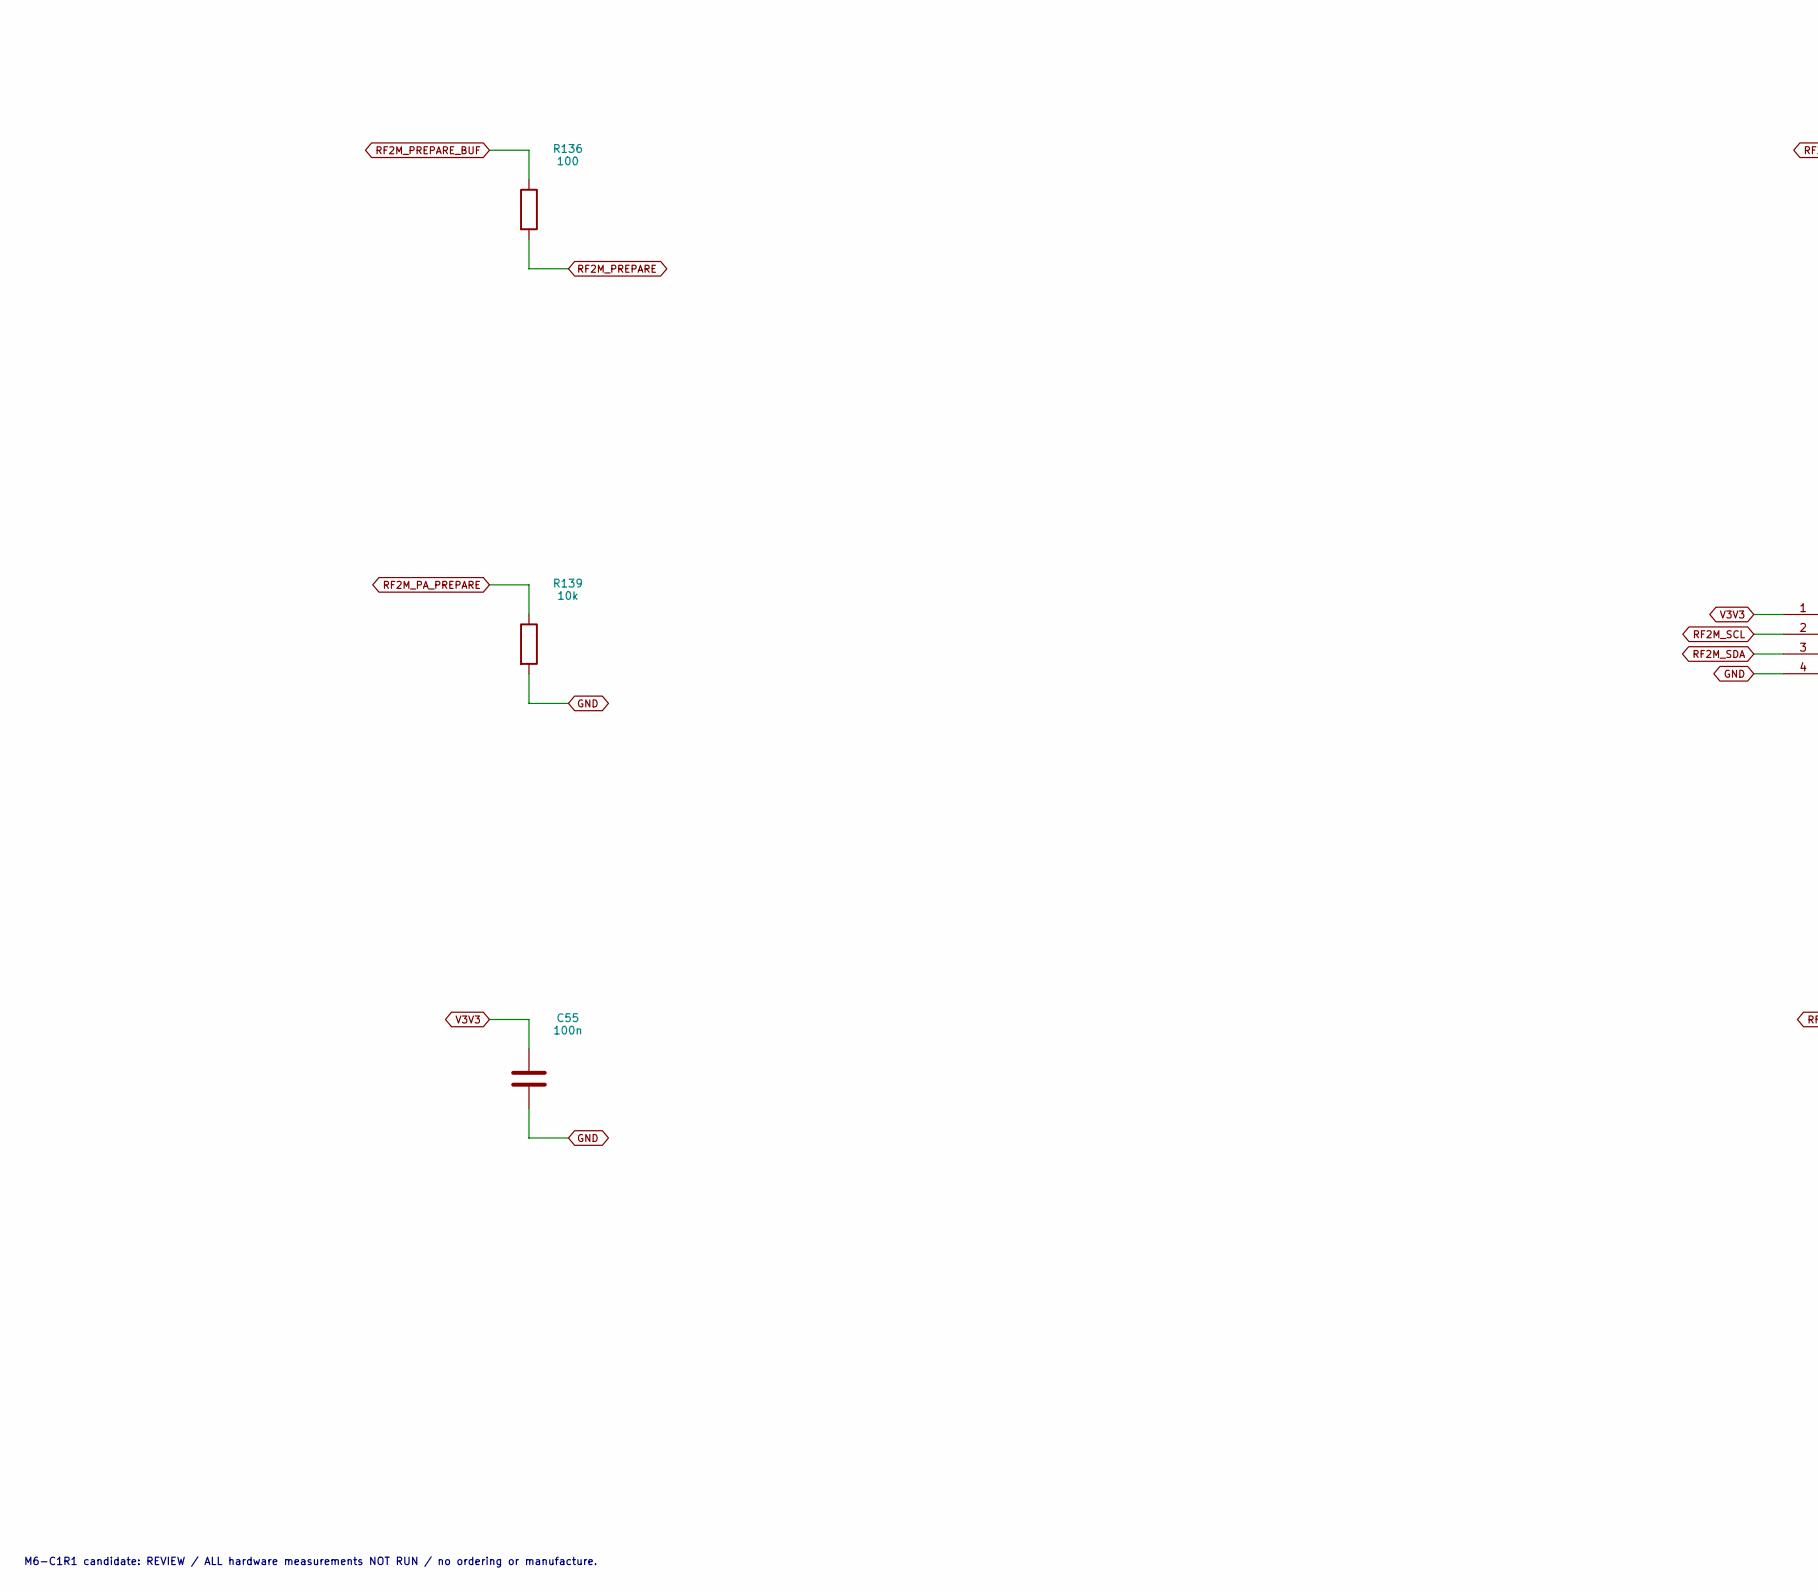
[picture p369: schematic 07_RF2M_2.kicad_sch, 07 RF2M / 2, part in row 2, column 1]

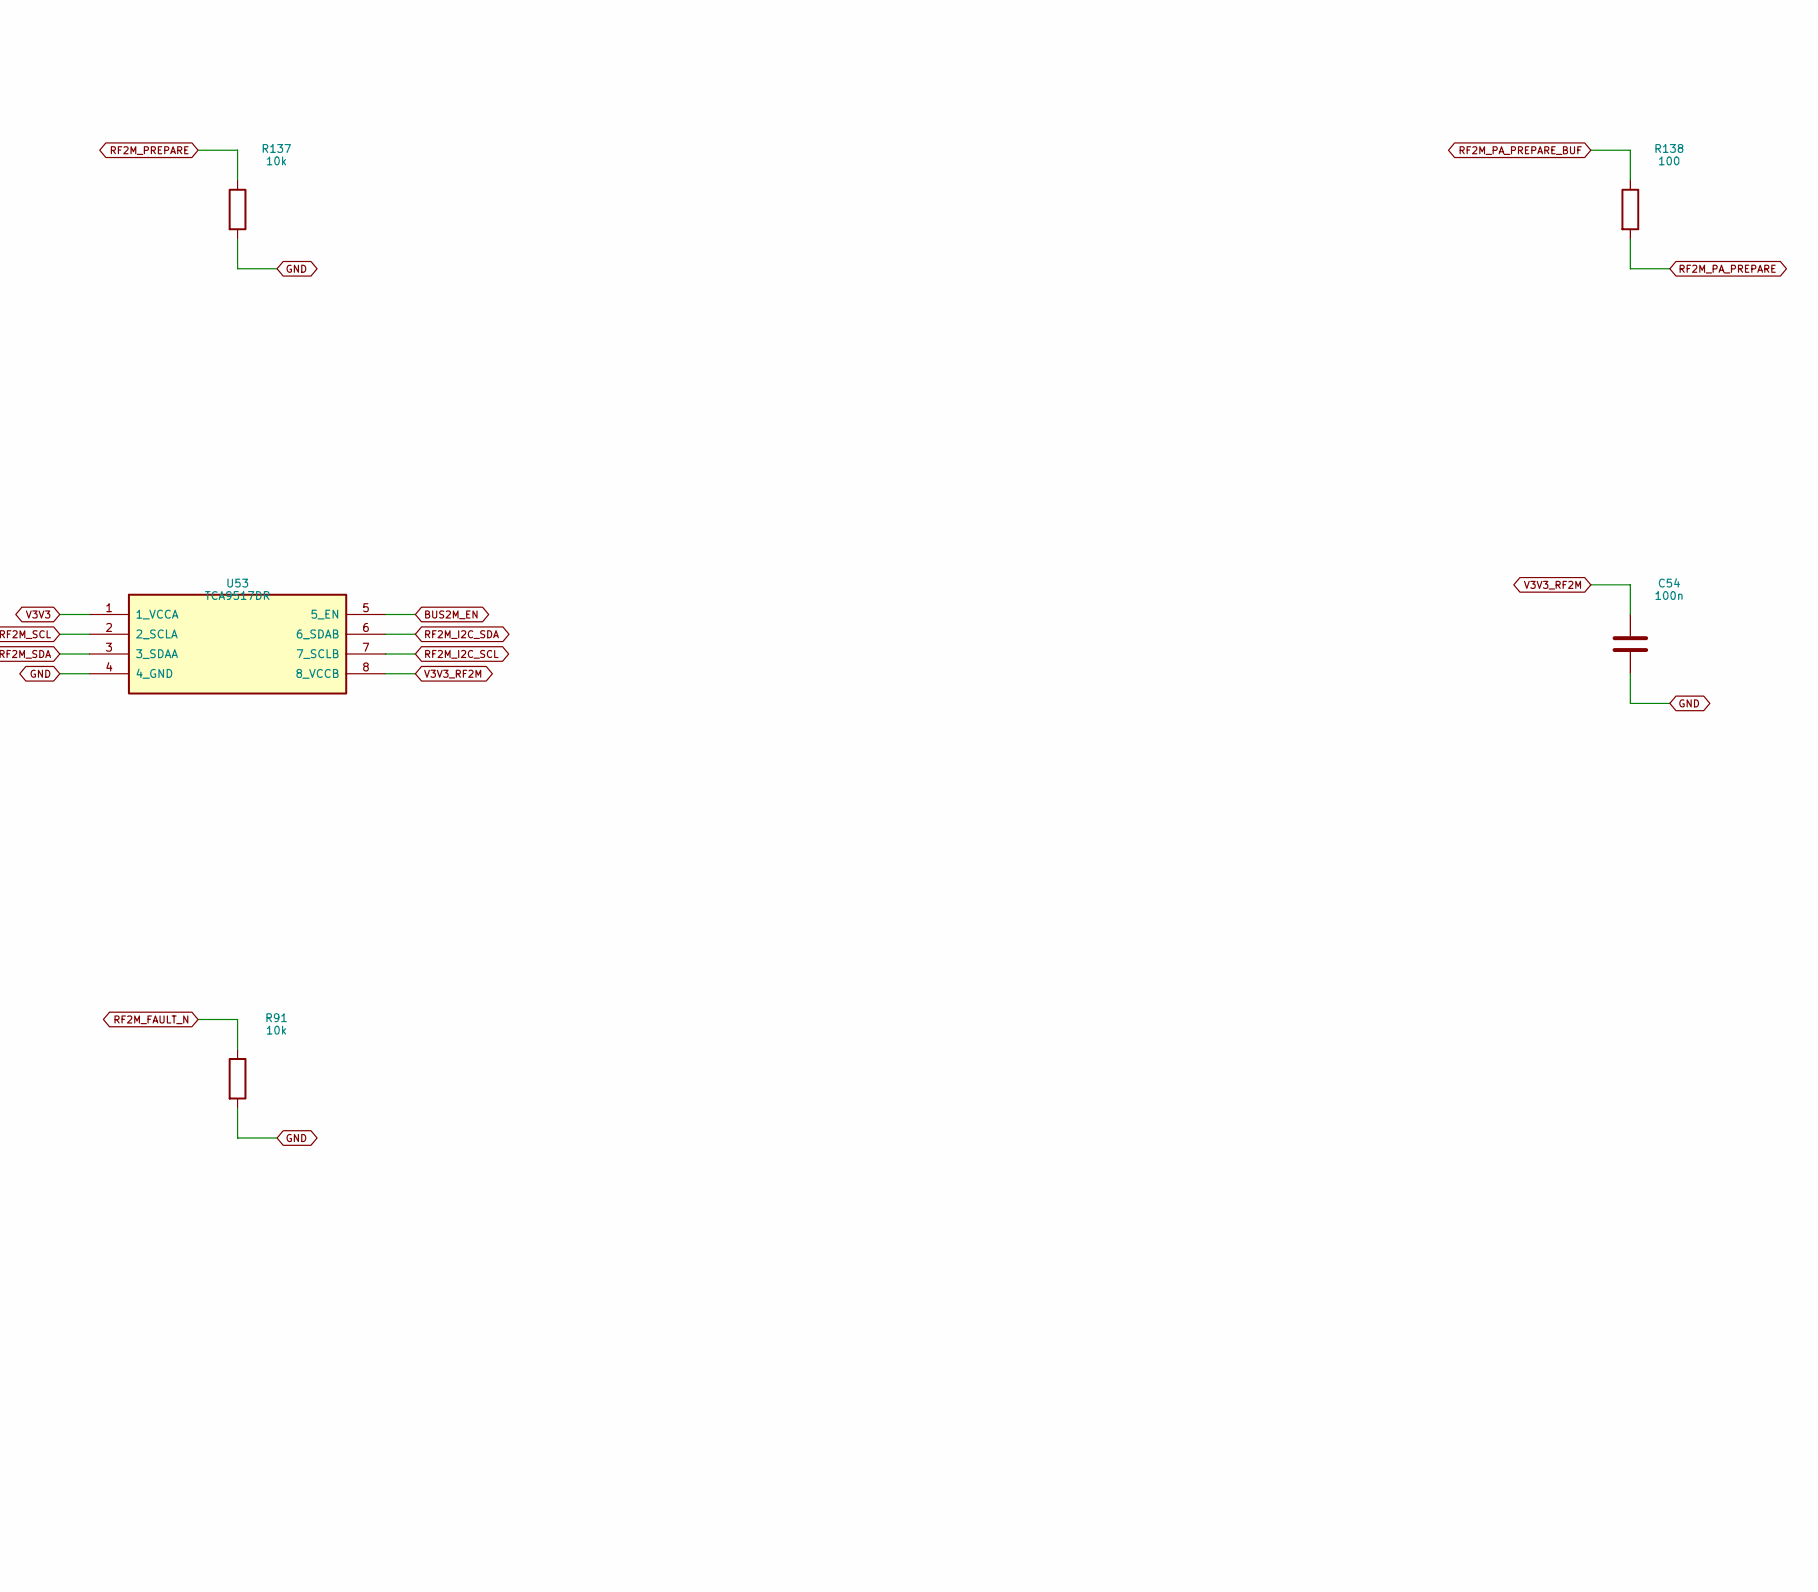
[picture p370: schematic 07_RF2M_2.kicad_sch, 07 RF2M / 2, part in row 2, column 2]

Parts:
C54, C55: 100n; C_0603_1608Metric_CTL; MPN CL10B104KB8NNNC
R91, R127, R129, R131, R133, R135, R137, R139: 10k; R_0603_1608Metric_CTL; MPN RC0603FR-0710KL
R128, R130, R132, R134, R136, R138: 100; R_0603_1608Metric_CTL; MPN RC0603FR-07100RL
U53: TCA9517DR; SOIC-8_3.9x4.9mm_P1.27mm_CTL; MPN TCA9517DR

Connections:
BUS2M_EN: U53.5 (5_EN); also elsewhere on the board
GND: C54.2, C55.2, R91.2, R127.2, R129.2, R131.2, R133.2, R135.2, R137.2, R139.2, U53.4 (4_GND); also elsewhere on the board
RF2M_AF_PWM: R132.2, R133.1; also elsewhere on the board
RF2M_AF_PWM_BUF: R132.1; also elsewhere on the board
RF2M_FAULT_N: R91.1; also elsewhere on the board
RF2M_I2C_SCL: U53.7 (7_SCLB); also elsewhere on the board
RF2M_I2C_SDA: U53.6 (6_SDAB); also elsewhere on the board
RF2M_LEVEL_PWM: R134.2, R135.1; also elsewhere on the board
RF2M_LEVEL_PWM_BUF: R134.1; also elsewhere on the board
RF2M_MUTE_N: R127.1; also elsewhere on the board
RF2M_PATH_TRAIN: R128.2, R129.1; also elsewhere on the board
RF2M_PATH_TRAIN_BUF: R128.1; also elsewhere on the board
RF2M_PA_PREPARE: R138.2, R139.1; also elsewhere on the board
RF2M_PA_PREPARE_BUF: R138.1; also elsewhere on the board
RF2M_PREPARE: R136.2, R137.1; also elsewhere on the board
RF2M_PREPARE_BUF: R136.1; also elsewhere on the board
RF2M_PROFILE_FULL: R130.2, R131.1; also elsewhere on the board
RF2M_PROFILE_FULL_BUF: R130.1; also elsewhere on the board
RF2M_SCL: U53.2 (2_SCLA); also elsewhere on the board
RF2M_SDA: U53.3 (3_SDAA); also elsewhere on the board
V3V3: C55.1, U53.1 (1_VCCA); also elsewhere on the board
V3V3_RF2M: C54.1, U53.8 (8_VCCB); also elsewhere on the board

Notes on the sheet:
07 RF2M / 2
M6-C1R1 candidate: REVIEW / ALL hardware measurements NOT RUN / no ordering or manufacture.

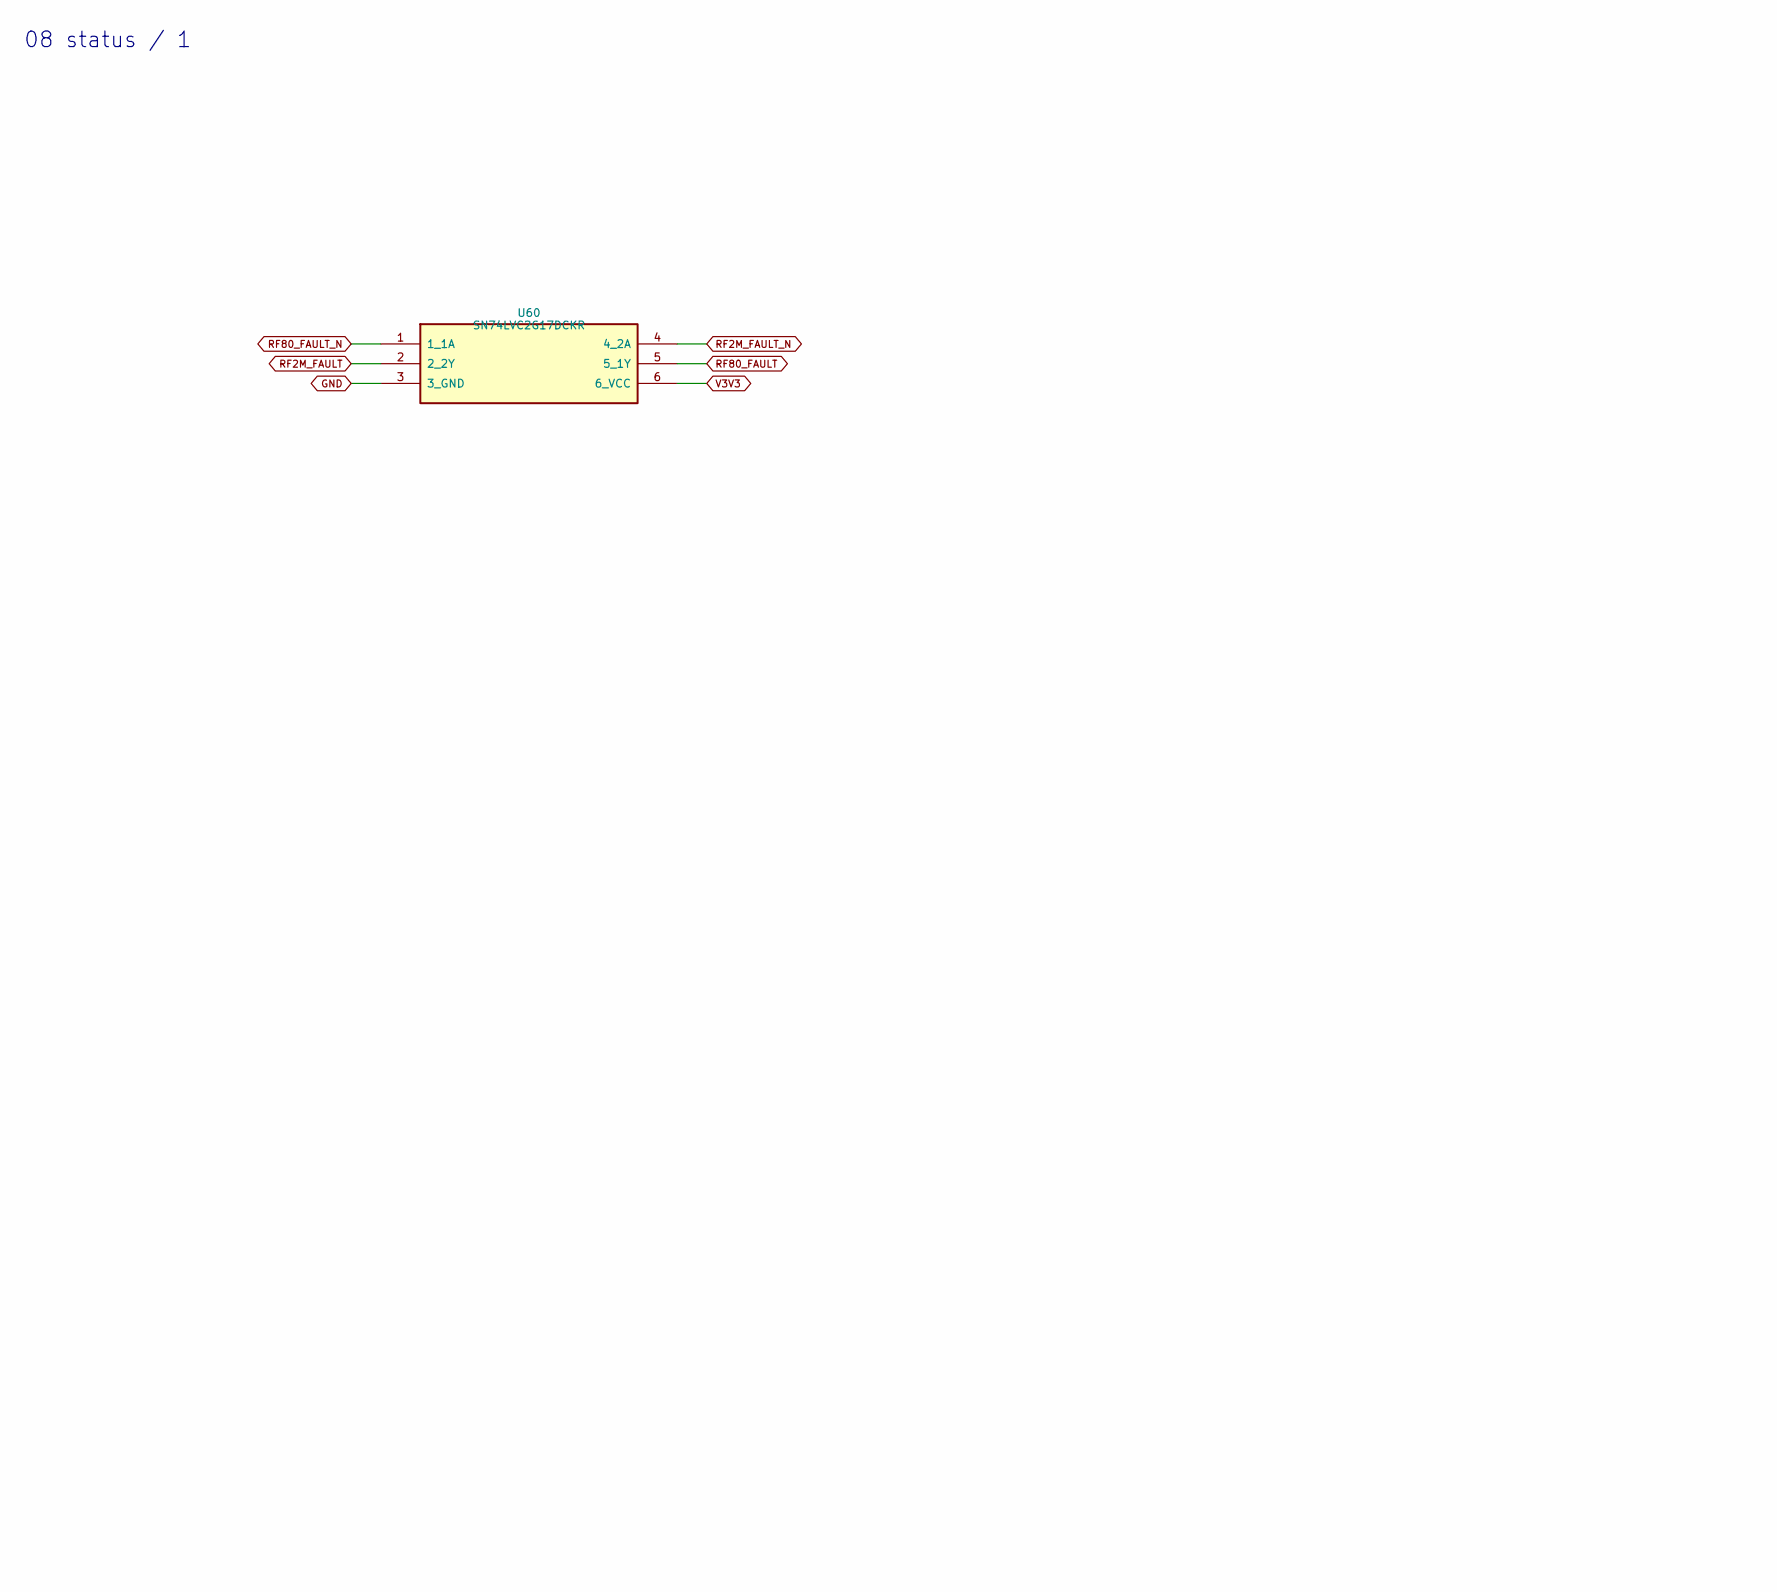
[picture p371: schematic 08_status.kicad_sch, 08 status / 1, part in row 1, column 1]

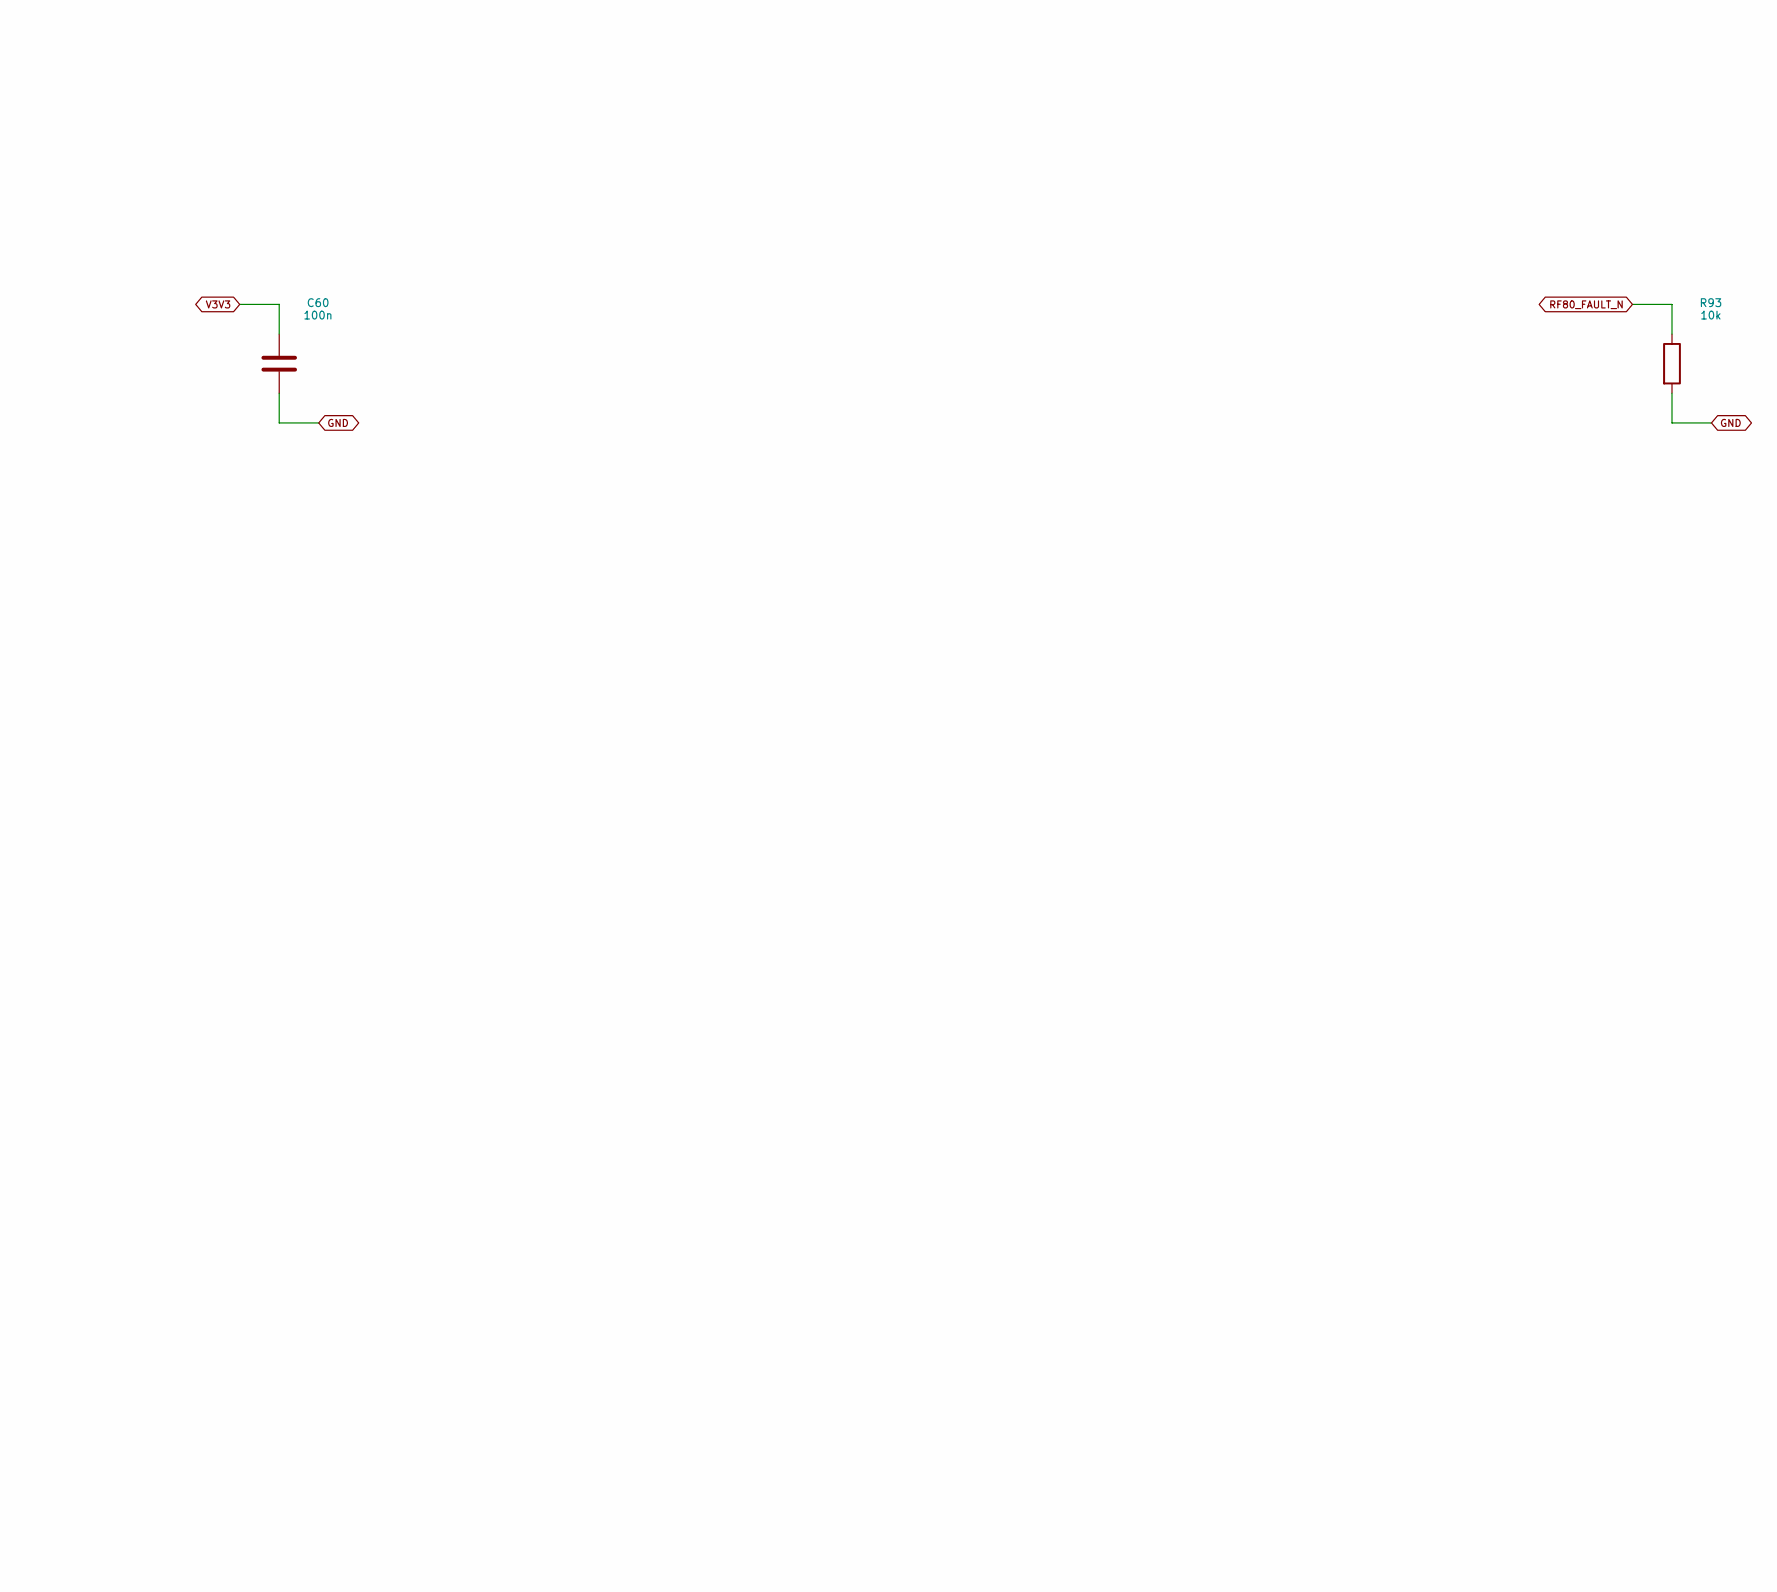
[picture p372: schematic 08_status.kicad_sch, 08 status / 1, part in row 1, column 2]

Parts:
C60: 100n; C_0603_1608Metric_CTL; MPN CL10B104KB8NNNC
R93: 10k; R_0603_1608Metric_CTL; MPN RC0603FR-0710KL
U60: SN74LVC2G17DCKR; SOT-363_SC-70-6_CTL; MPN SN74LVC2G17DCKR

Connections:
GND: C60.2, R93.2, U60.3 (3_GND); also elsewhere on the board
RF2M_FAULT: U60.2 (2_2Y); also elsewhere on the board
RF2M_FAULT_N: U60.4 (4_2A); also elsewhere on the board
RF80_FAULT: U60.5 (5_1Y); also elsewhere on the board
RF80_FAULT_N: R93.1, U60.1 (1_1A); also elsewhere on the board
V3V3: C60.1, U60.6 (6_VCC); also elsewhere on the board

Notes on the sheet:
08 status / 1
M6-C1R1 candidate: REVIEW / ALL hardware measurements NOT RUN / no ordering or manufacture.
