DD1SB/ARDF-TX/hardware/controller/CTRL.kicad_pcb

## KiCad design hardware/controller/CTRL.kicad_pcb (continued)

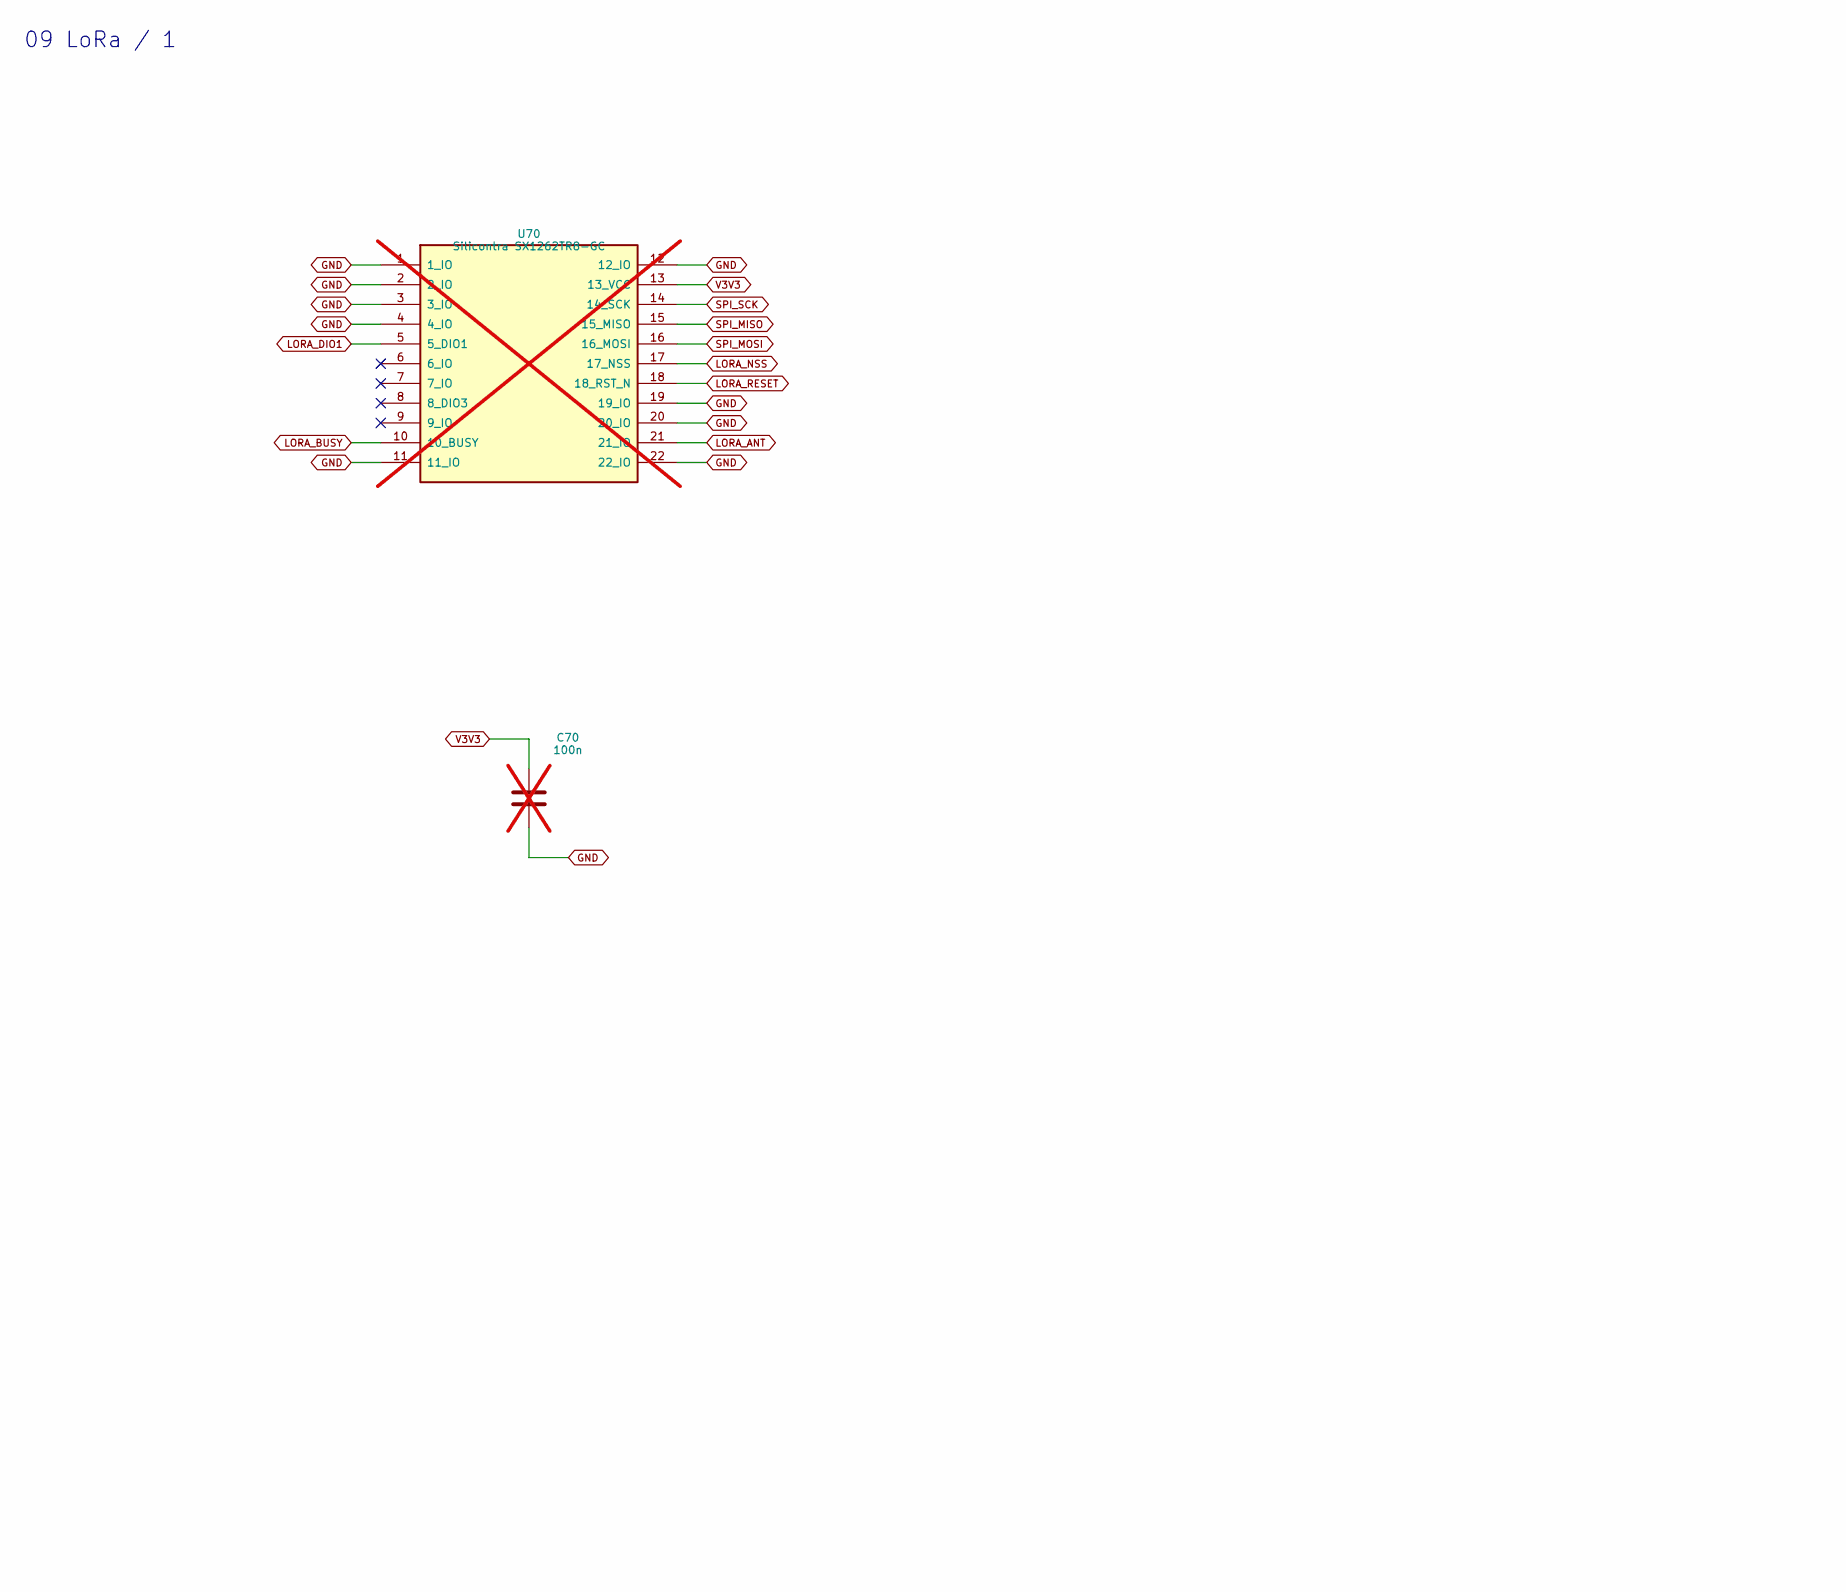
[picture p373: schematic 09_LoRa.kicad_sch, 09 LoRa / 1, part in row 1, column 1]

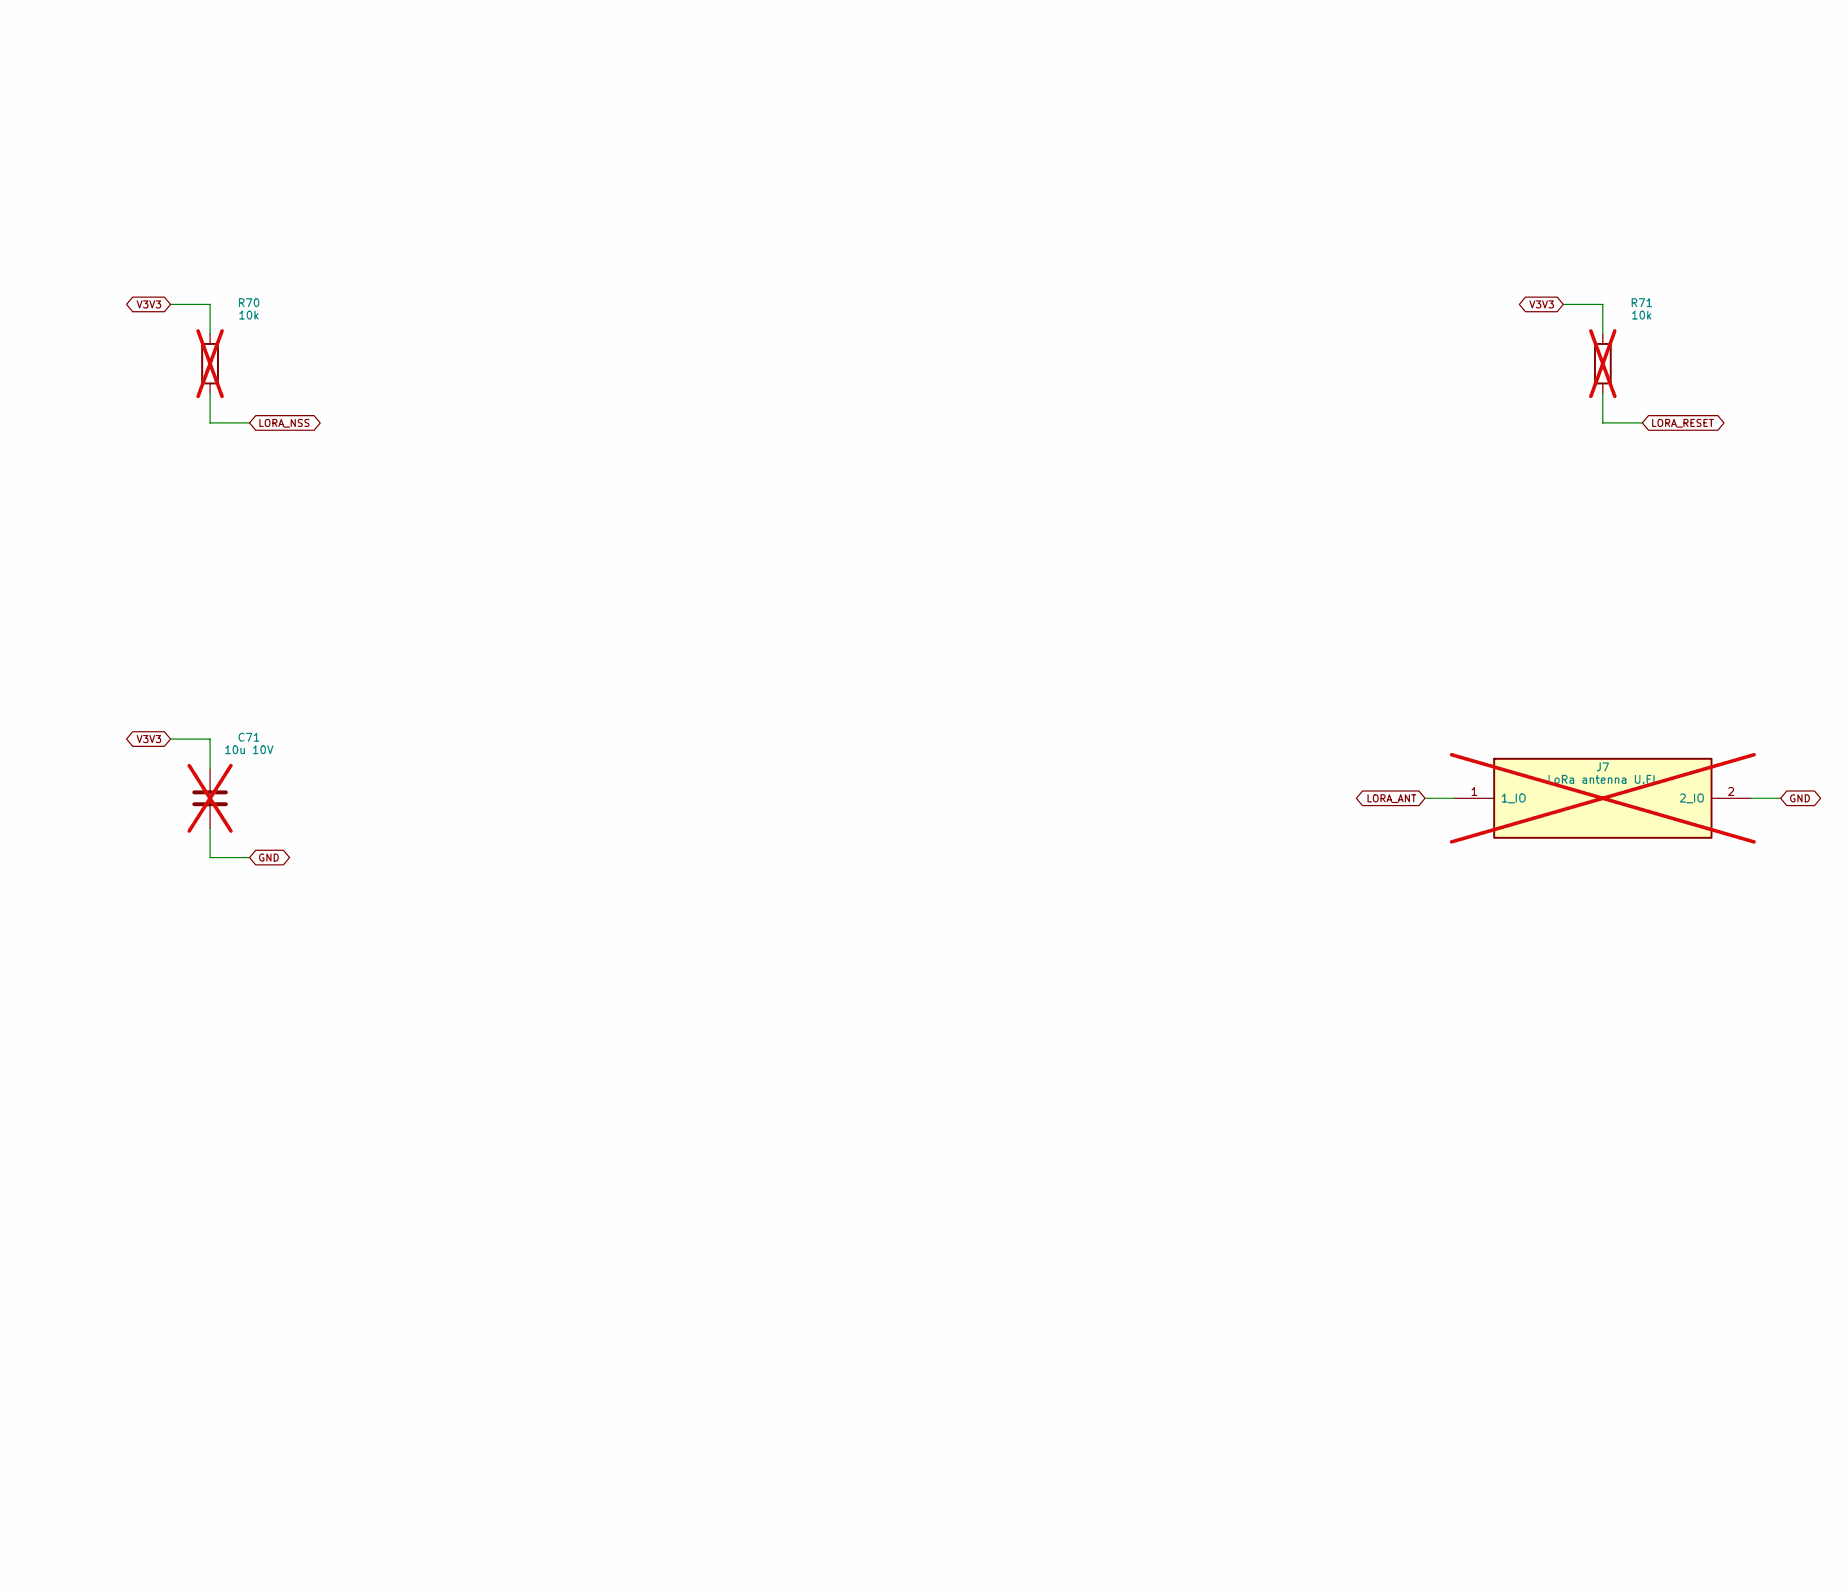
[picture p374: schematic 09_LoRa.kicad_sch, 09 LoRa / 1, part in row 1, column 2]

Parts:
C70: 100n; C_0603_1608Metric_CTL; MPN CL10B104KB8NNNC; not fitted
C71: 10u 10V; C_0603_1608Metric_CTL; MPN CL10A106KP8NNNC; not fitted
J7: LoRa antenna U.FL; UFL_Standard; MPN U.FL-R-SMT-1(10); not fitted
R70, R71: 10k; R_0603_1608Metric_CTL; MPN RC0603FR-0710KL; not fitted
U70: Silicontra SX1262TR8-GC; Silicontra_SX1262ZTR8_GC; MPN SX1262TR8-GC; not fitted

Connections:
GND: C70.2, C71.2, J7.2 (2_IO), U70.1 (1_IO), U70.2 (2_IO), U70.3 (3_IO), U70.4 (4_IO), U70.11 (11_IO), U70.12 (12_IO), U70.19 (19_IO), U70.20 (20_IO), U70.22 (22_IO); also elsewhere on the board
LORA_ANT: J7.1 (1_IO), U70.21 (21_IO)
LORA_BUSY: U70.10 (10_BUSY); also elsewhere on the board
LORA_DIO1: U70.5 (5_DIO1); also elsewhere on the board
LORA_NSS: R70.2, U70.17 (17_NSS); also elsewhere on the board
LORA_RESET: R71.2, U70.18 (18_RST_N); also elsewhere on the board
SPI_MISO: U70.15 (15_MISO); also elsewhere on the board
SPI_MOSI: U70.16 (16_MOSI); also elsewhere on the board
SPI_SCK: U70.14 (14_SCK); also elsewhere on the board
V3V3: C70.1, C71.1, R70.1, R71.1, U70.13 (13_VCC); also elsewhere on the board

Notes on the sheet:
09 LoRa / 1
M6-C1R1 candidate: REVIEW / ALL hardware measurements NOT RUN / no ordering or manufacture.

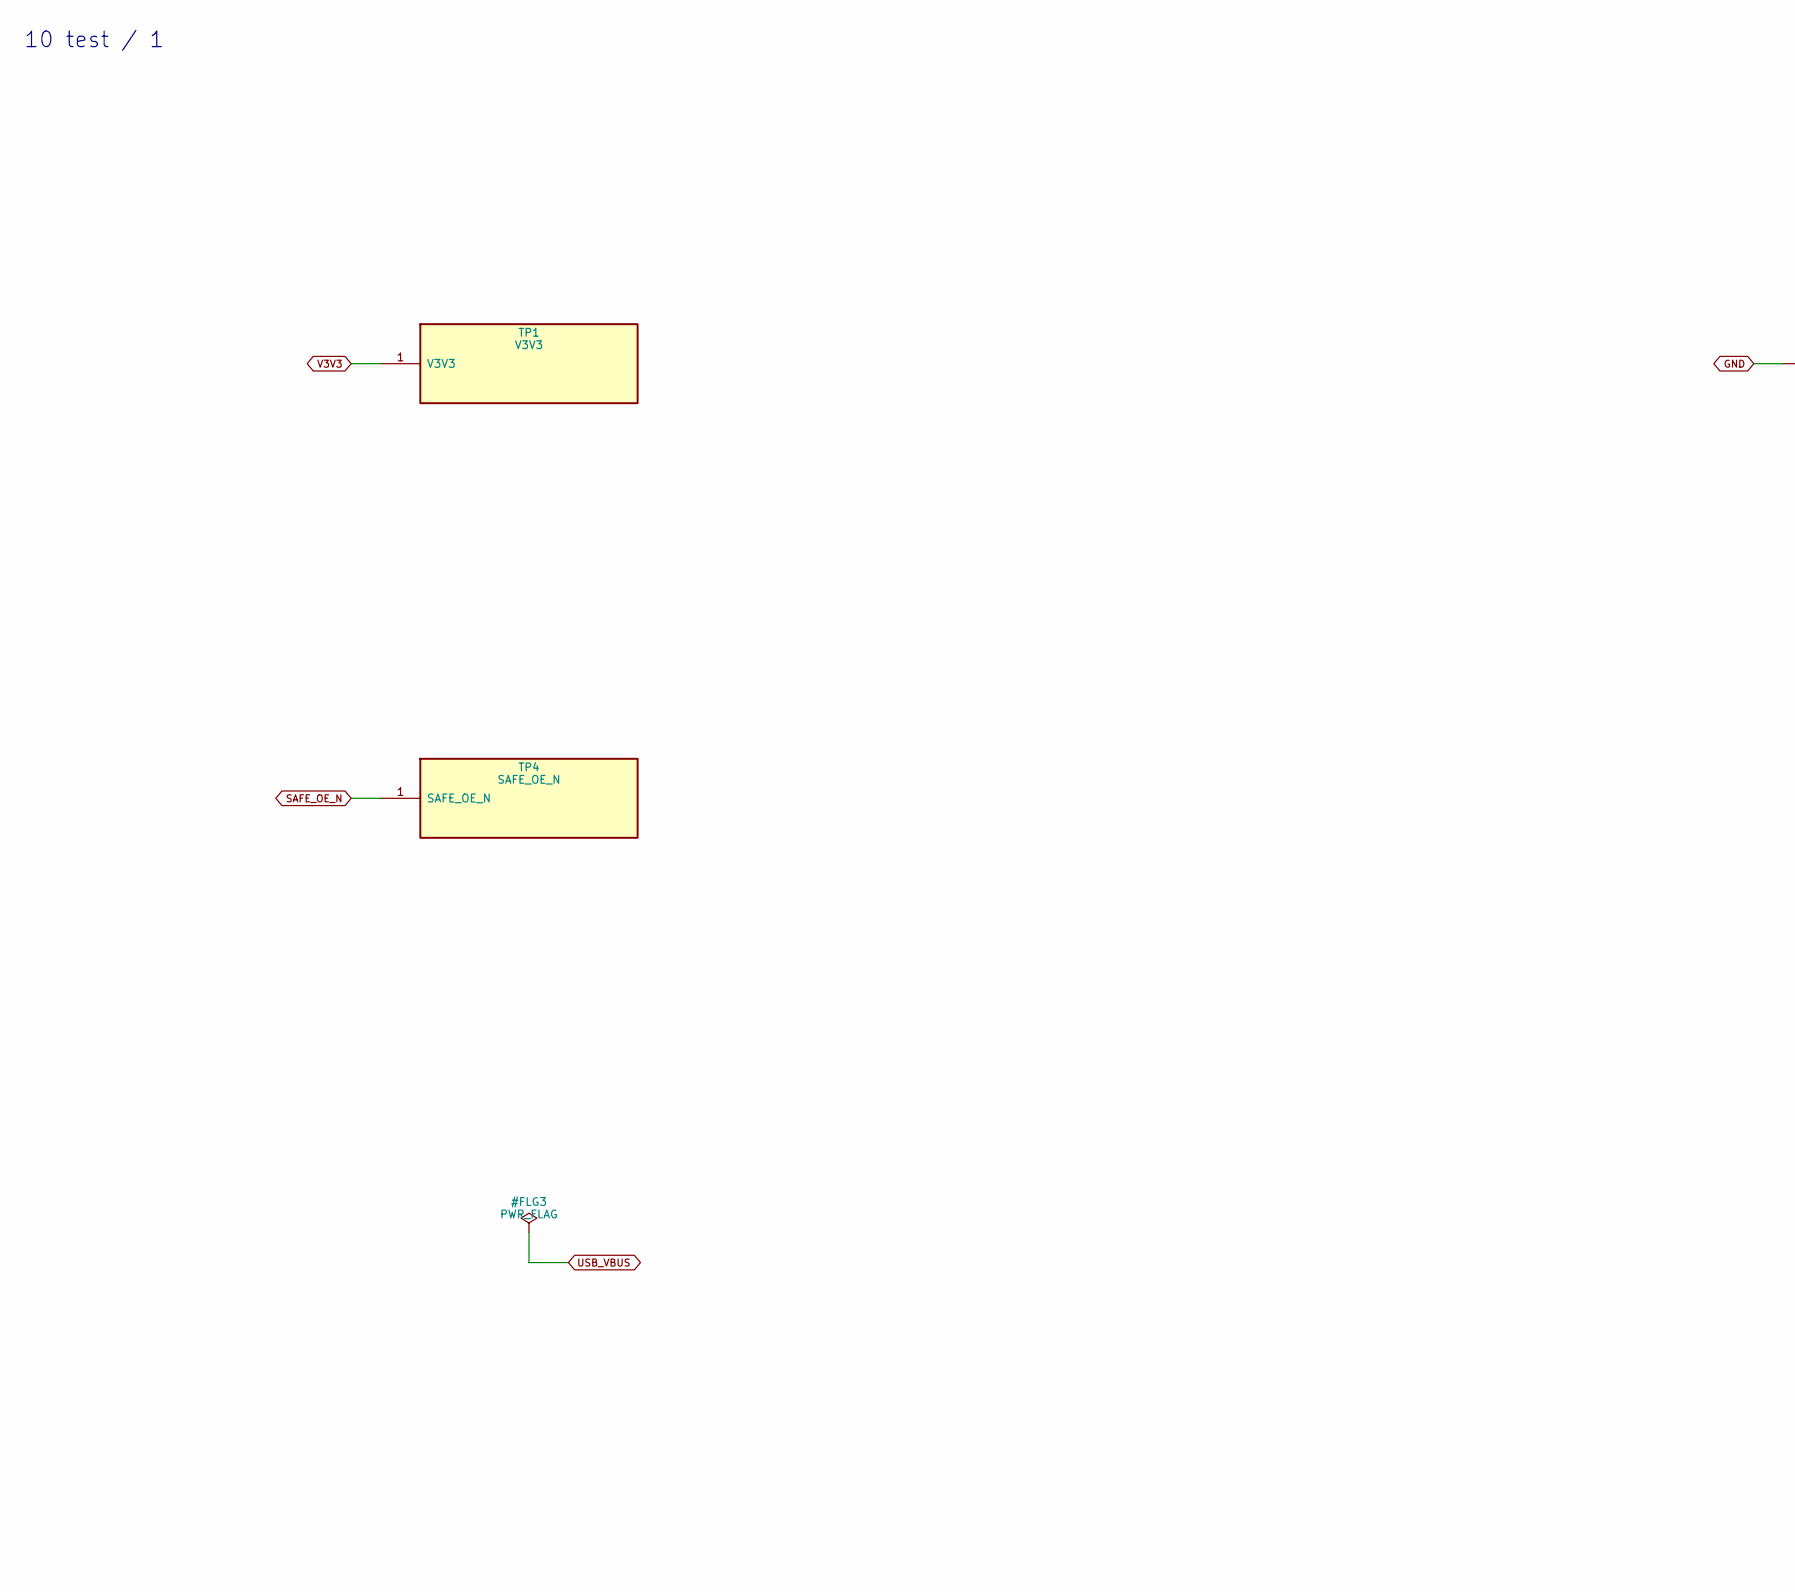
[picture p375: schematic 10_test.kicad_sch, 10 test / 1, part in row 1, column 1]

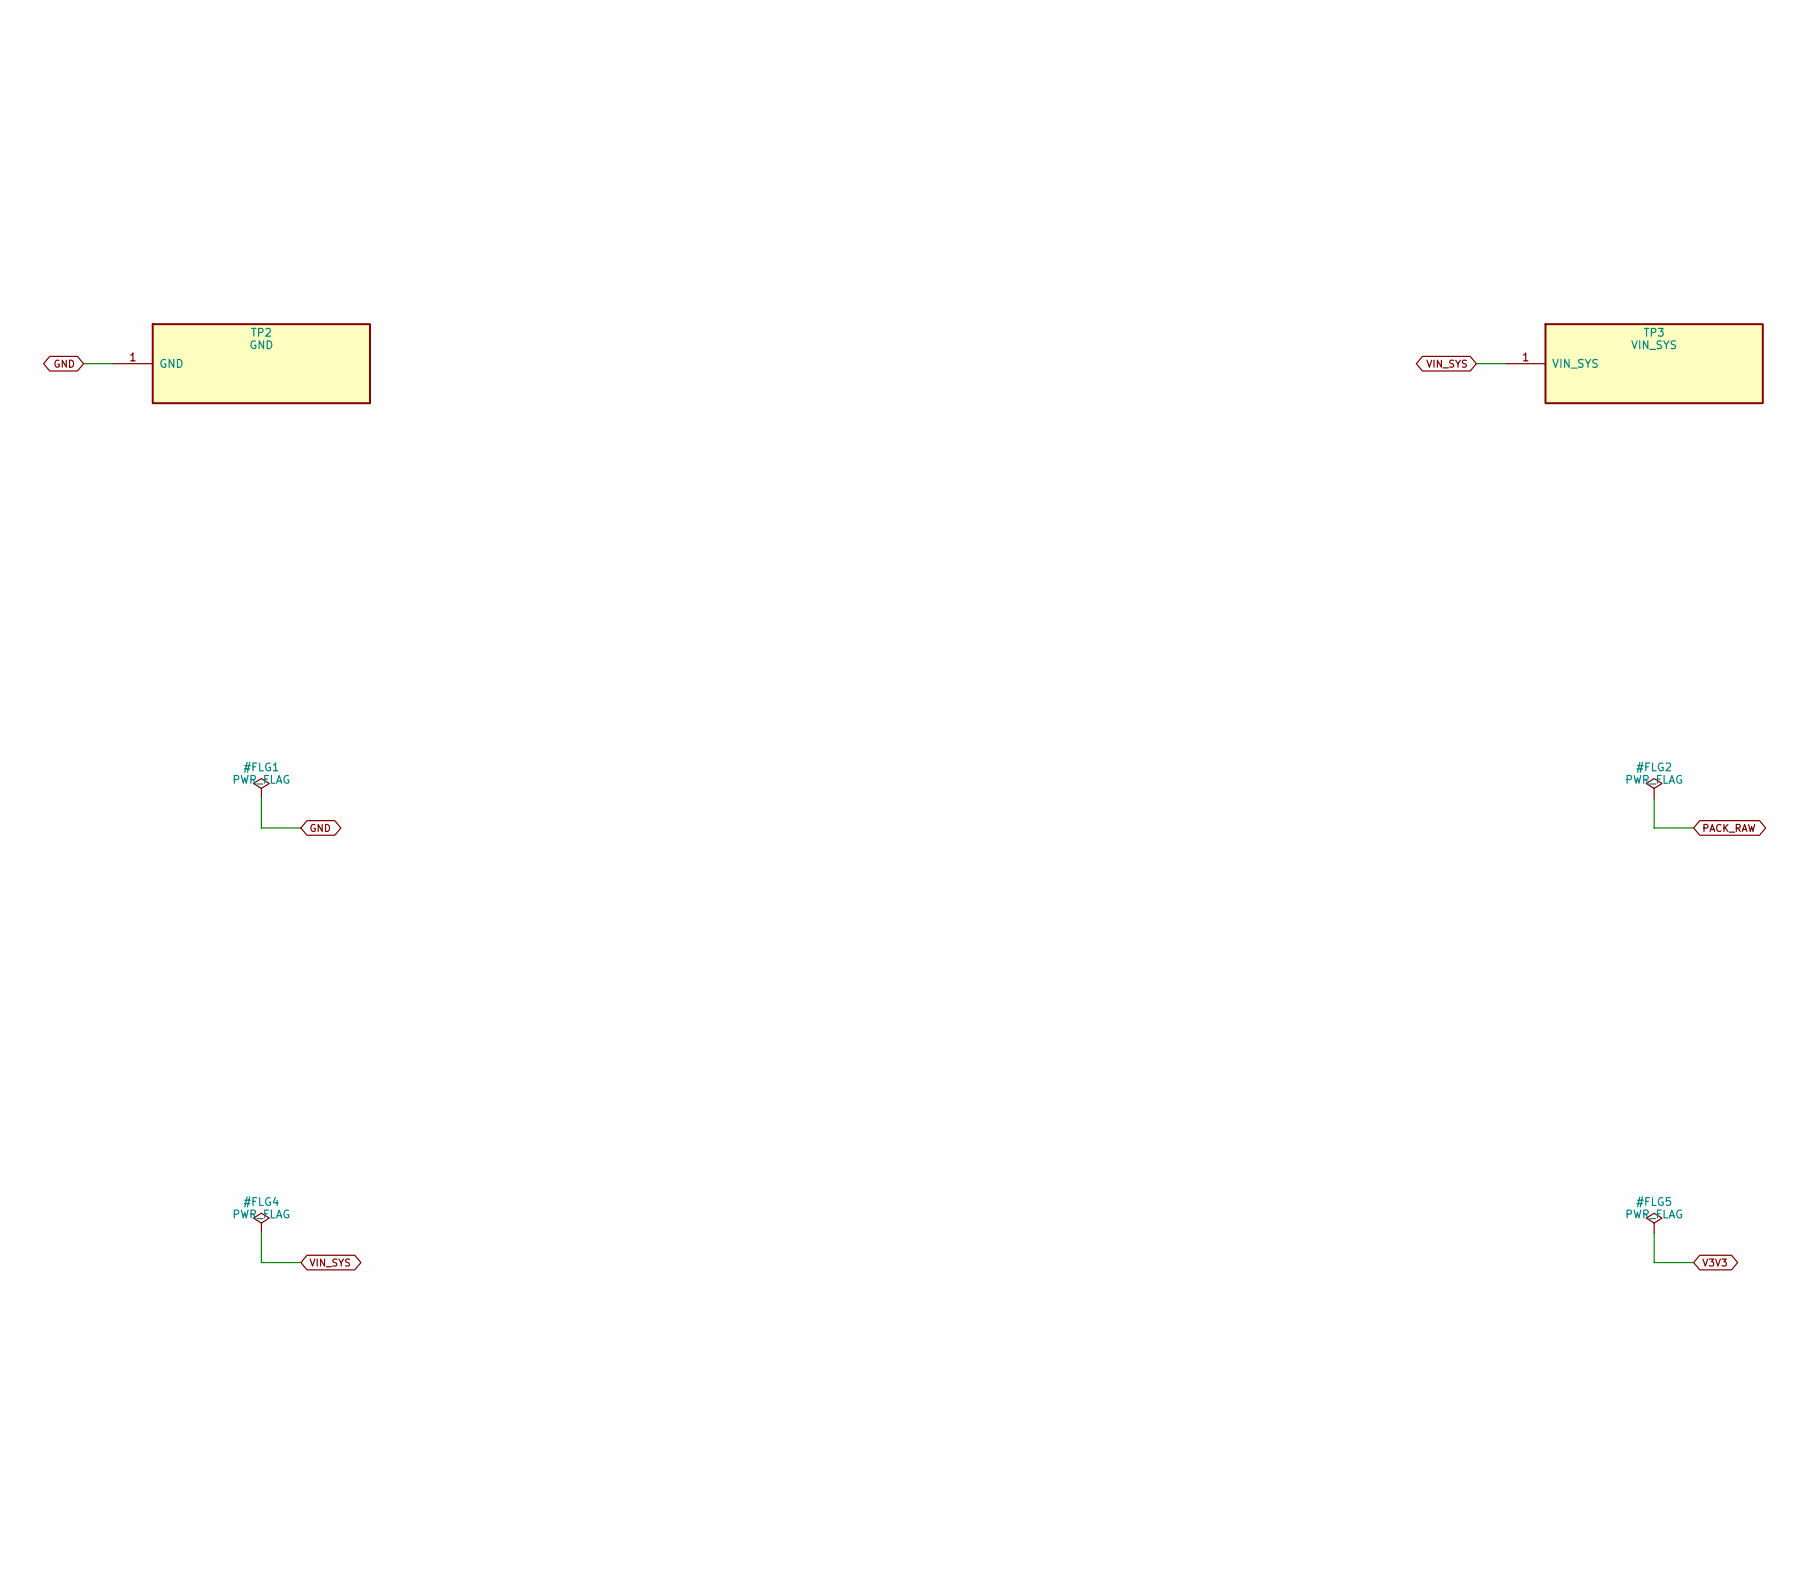
[picture p376: schematic 10_test.kicad_sch, 10 test / 1, part in row 1, column 2]

Parts:
TP1: V3V3; TestPoint_Pad_D1.0mm_CTL; MPN PCB_FEATURE
TP2: GND; TestPoint_Pad_D1.0mm_CTL; MPN PCB_FEATURE
TP3: VIN_SYS; TestPoint_Pad_D1.0mm_CTL; MPN PCB_FEATURE
TP4: SAFE_OE_N; TestPoint_Pad_D1.0mm_CTL; MPN PCB_FEATURE

Connections:
GND: TP2.1; also elsewhere on the board
SAFE_OE_N: TP4.1; also elsewhere on the board
V3V3: TP1.1; also elsewhere on the board
VIN_SYS: TP3.1; also elsewhere on the board

Notes on the sheet:
10 test / 1
M6-C1R1 candidate: REVIEW / ALL hardware measurements NOT RUN / no ordering or manufacture.
