DD1SB/ARDF-TX/hardware/controller/CTRL.kicad_pcb

## KiCad design hardware/controller/CTRL.kicad_pcb (continued)

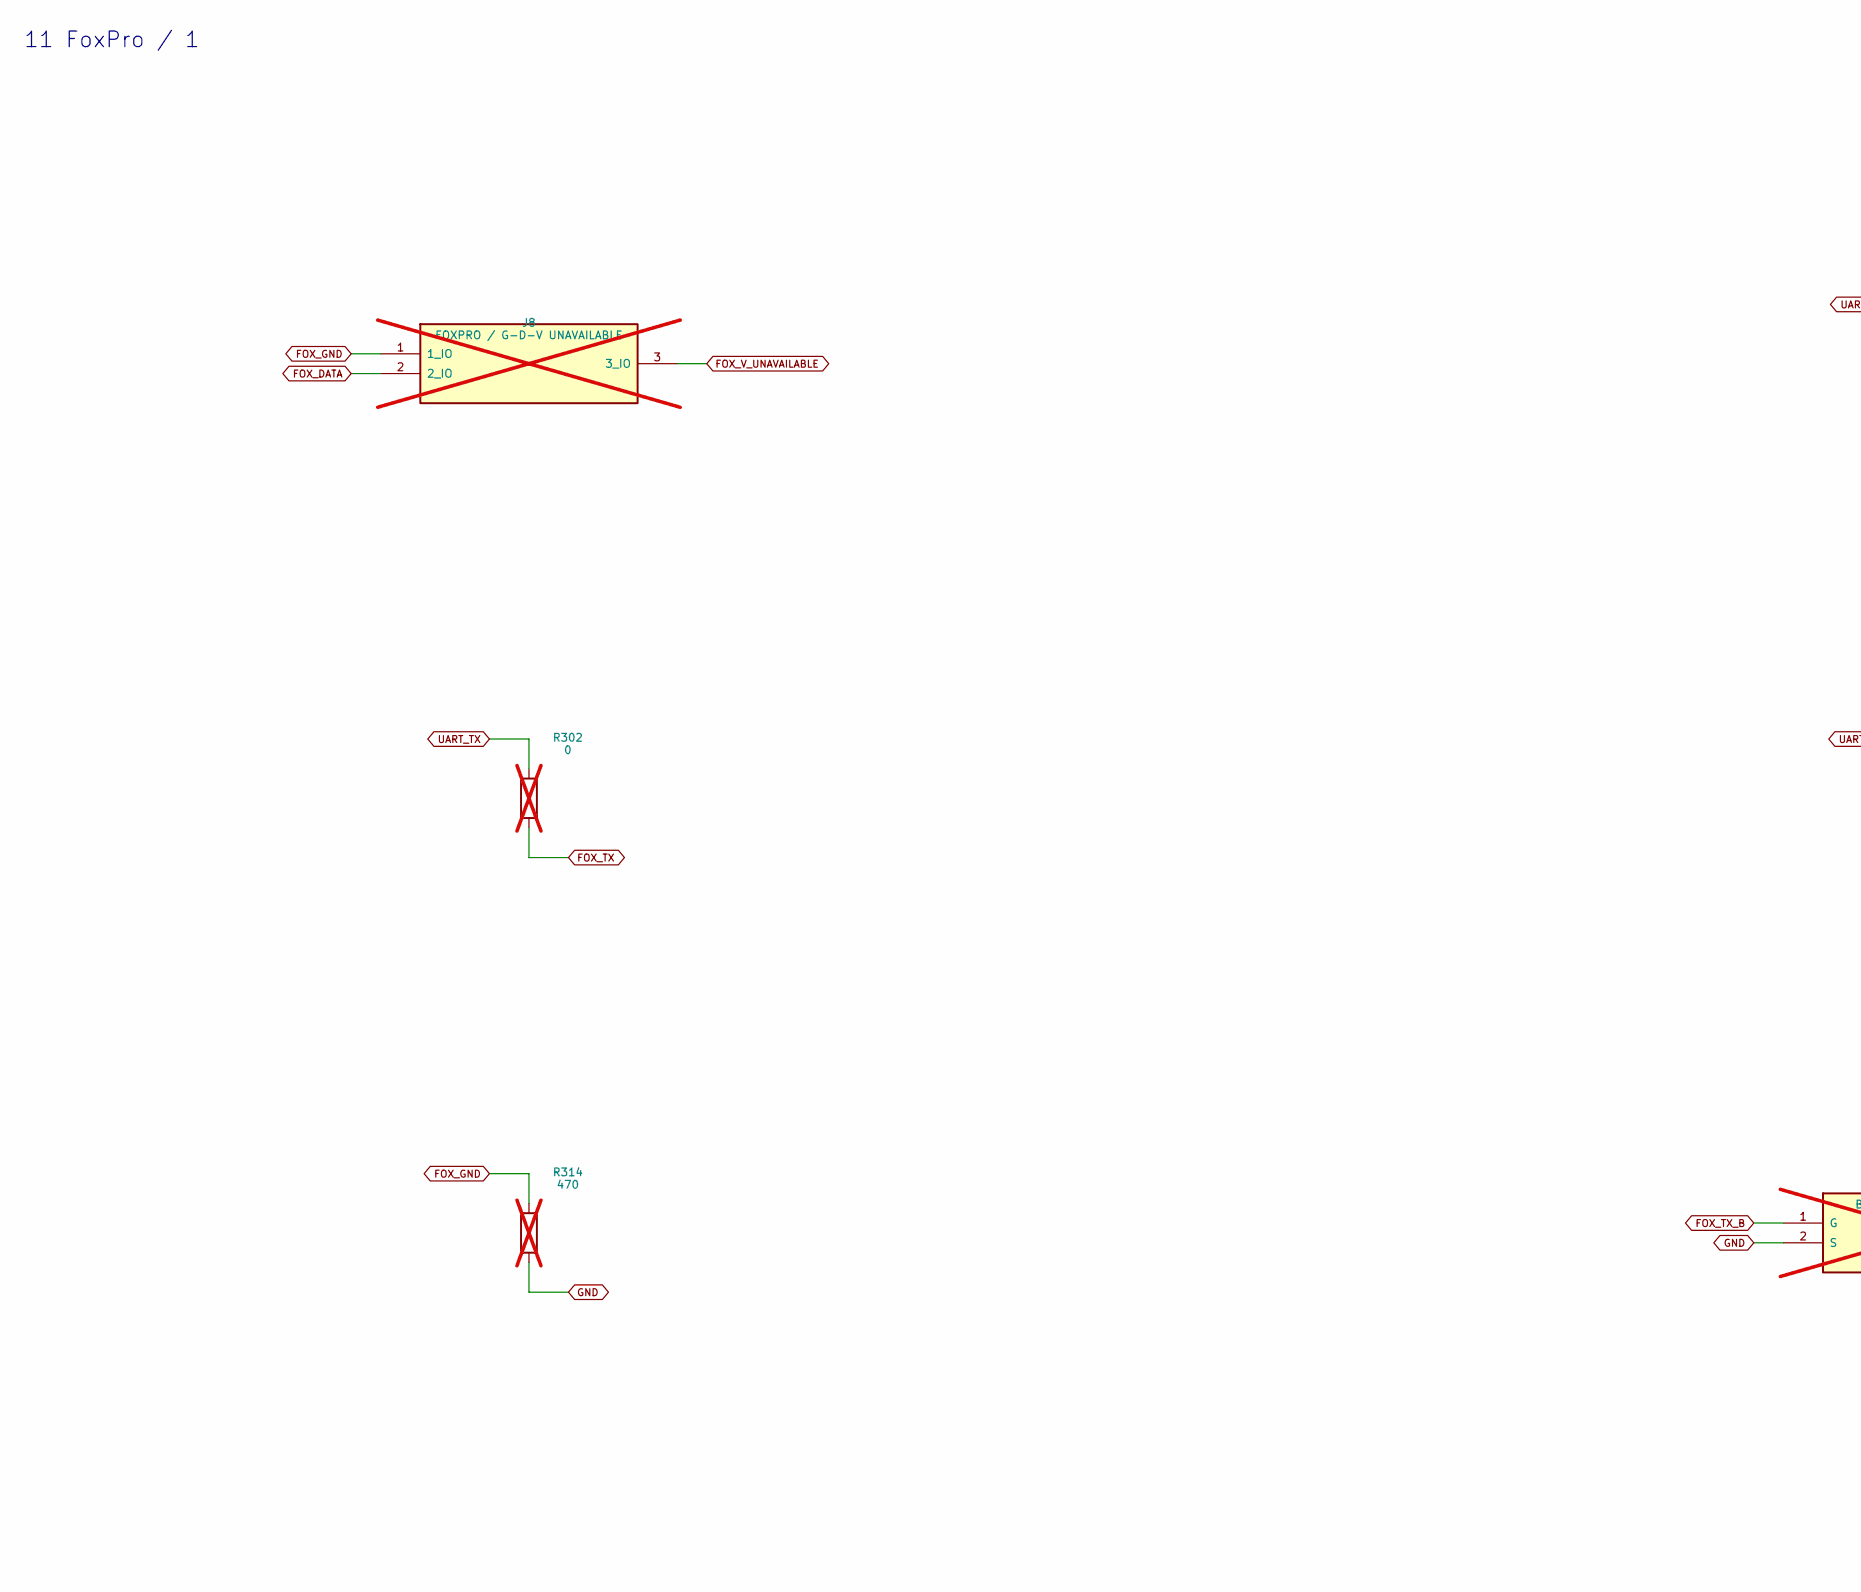
[picture p377: schematic 11_FoxPro.kicad_sch, 11 FoxPro / 1, part in row 1, column 1]

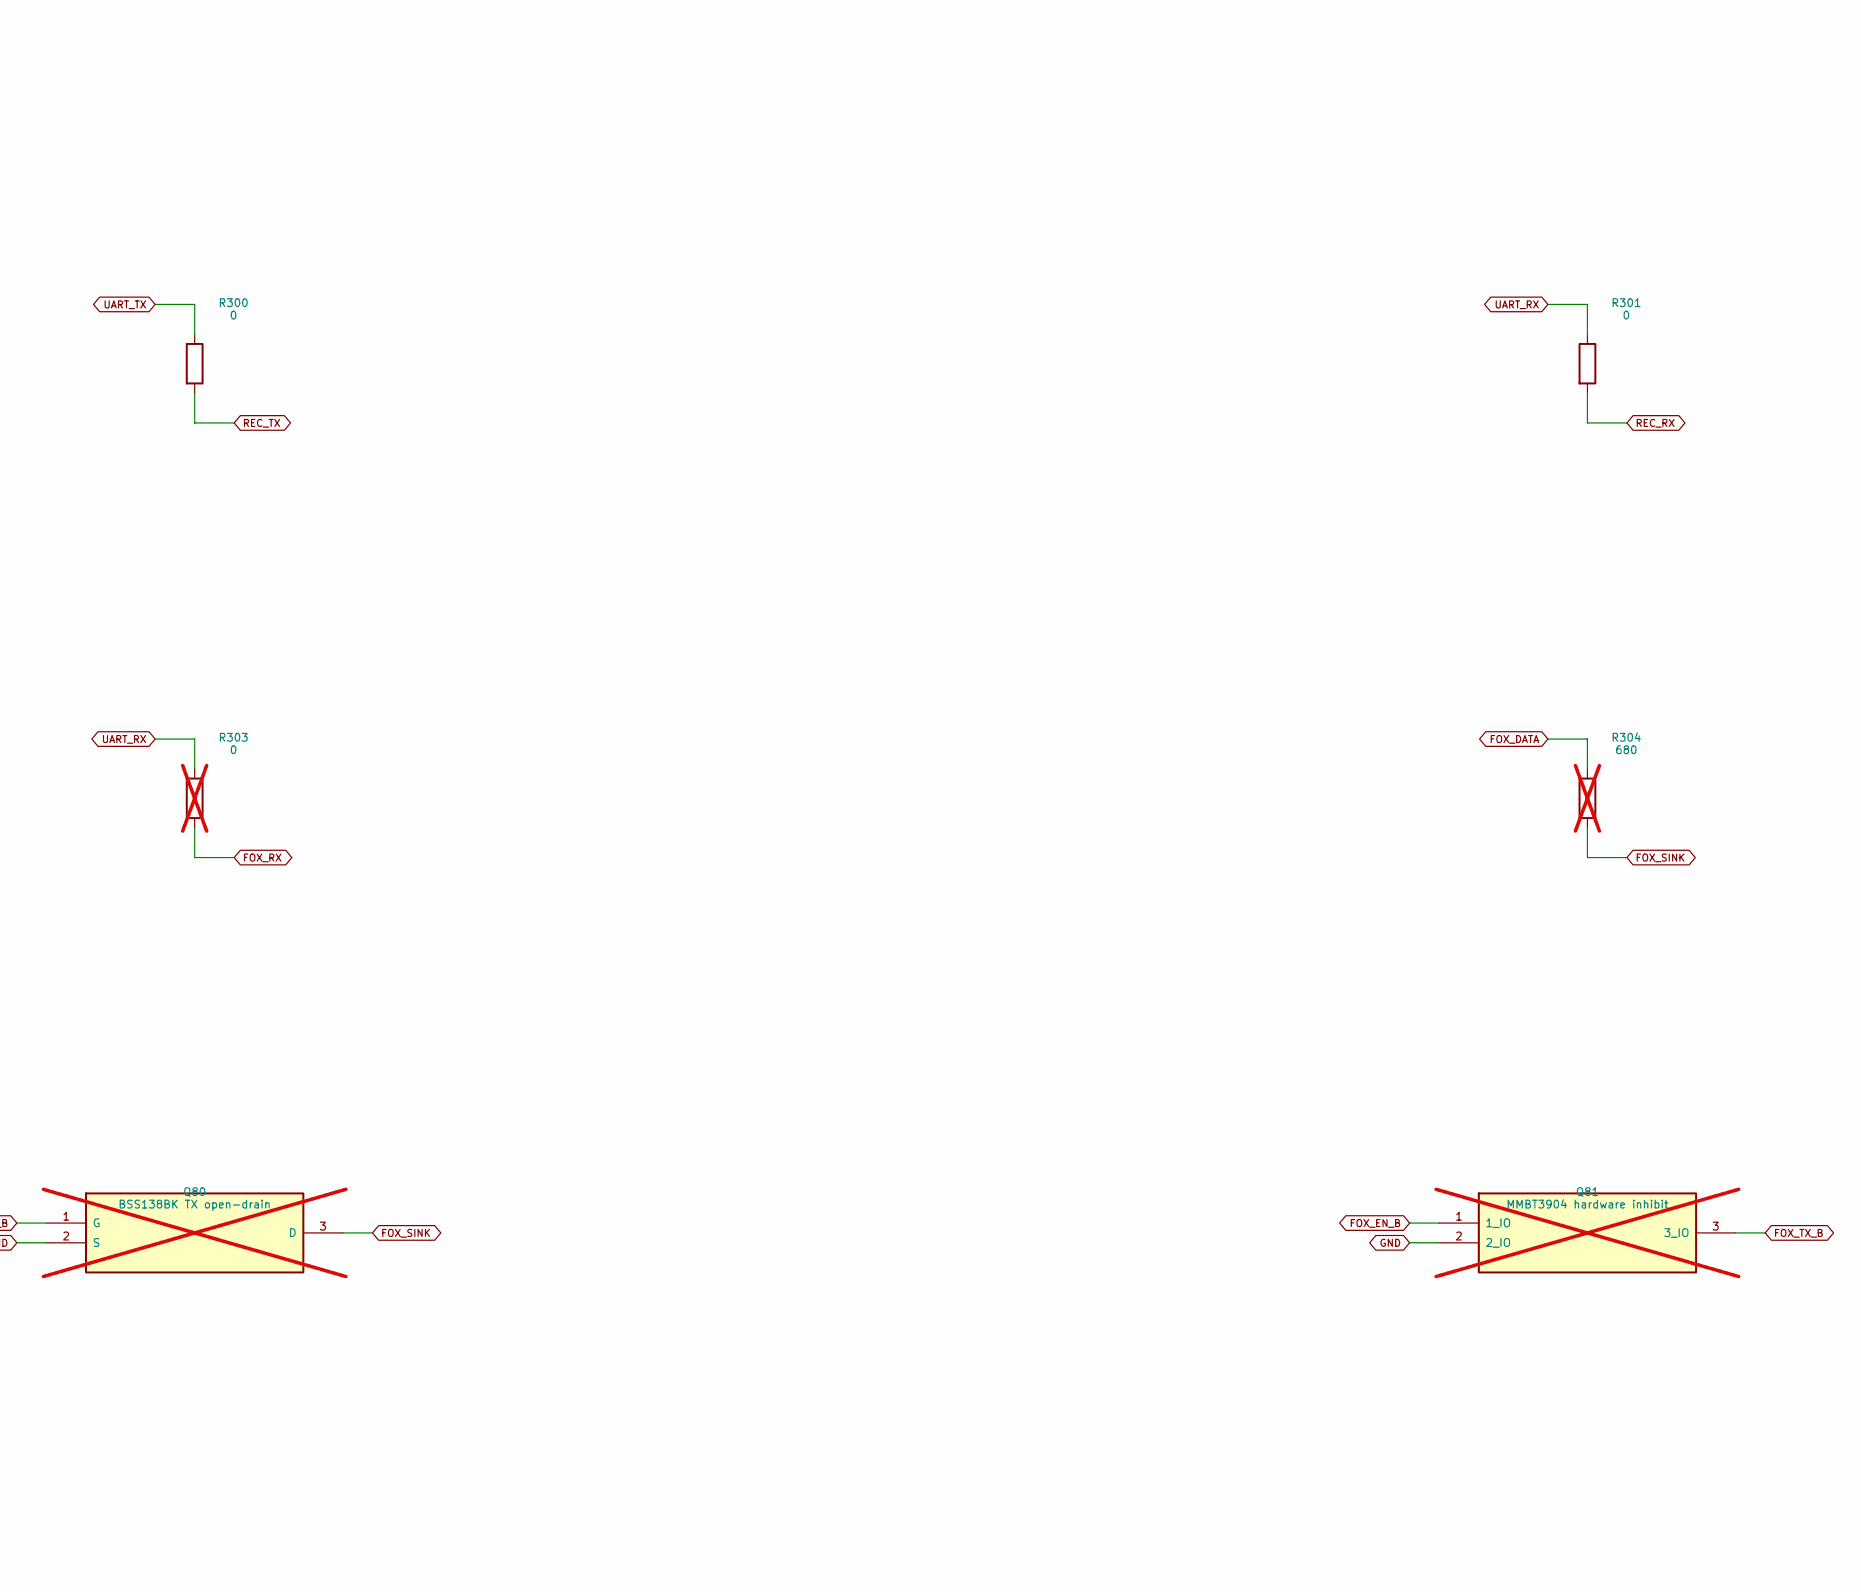
[picture p378: schematic 11_FoxPro.kicad_sch, 11 FoxPro / 1, part in row 1, column 2]

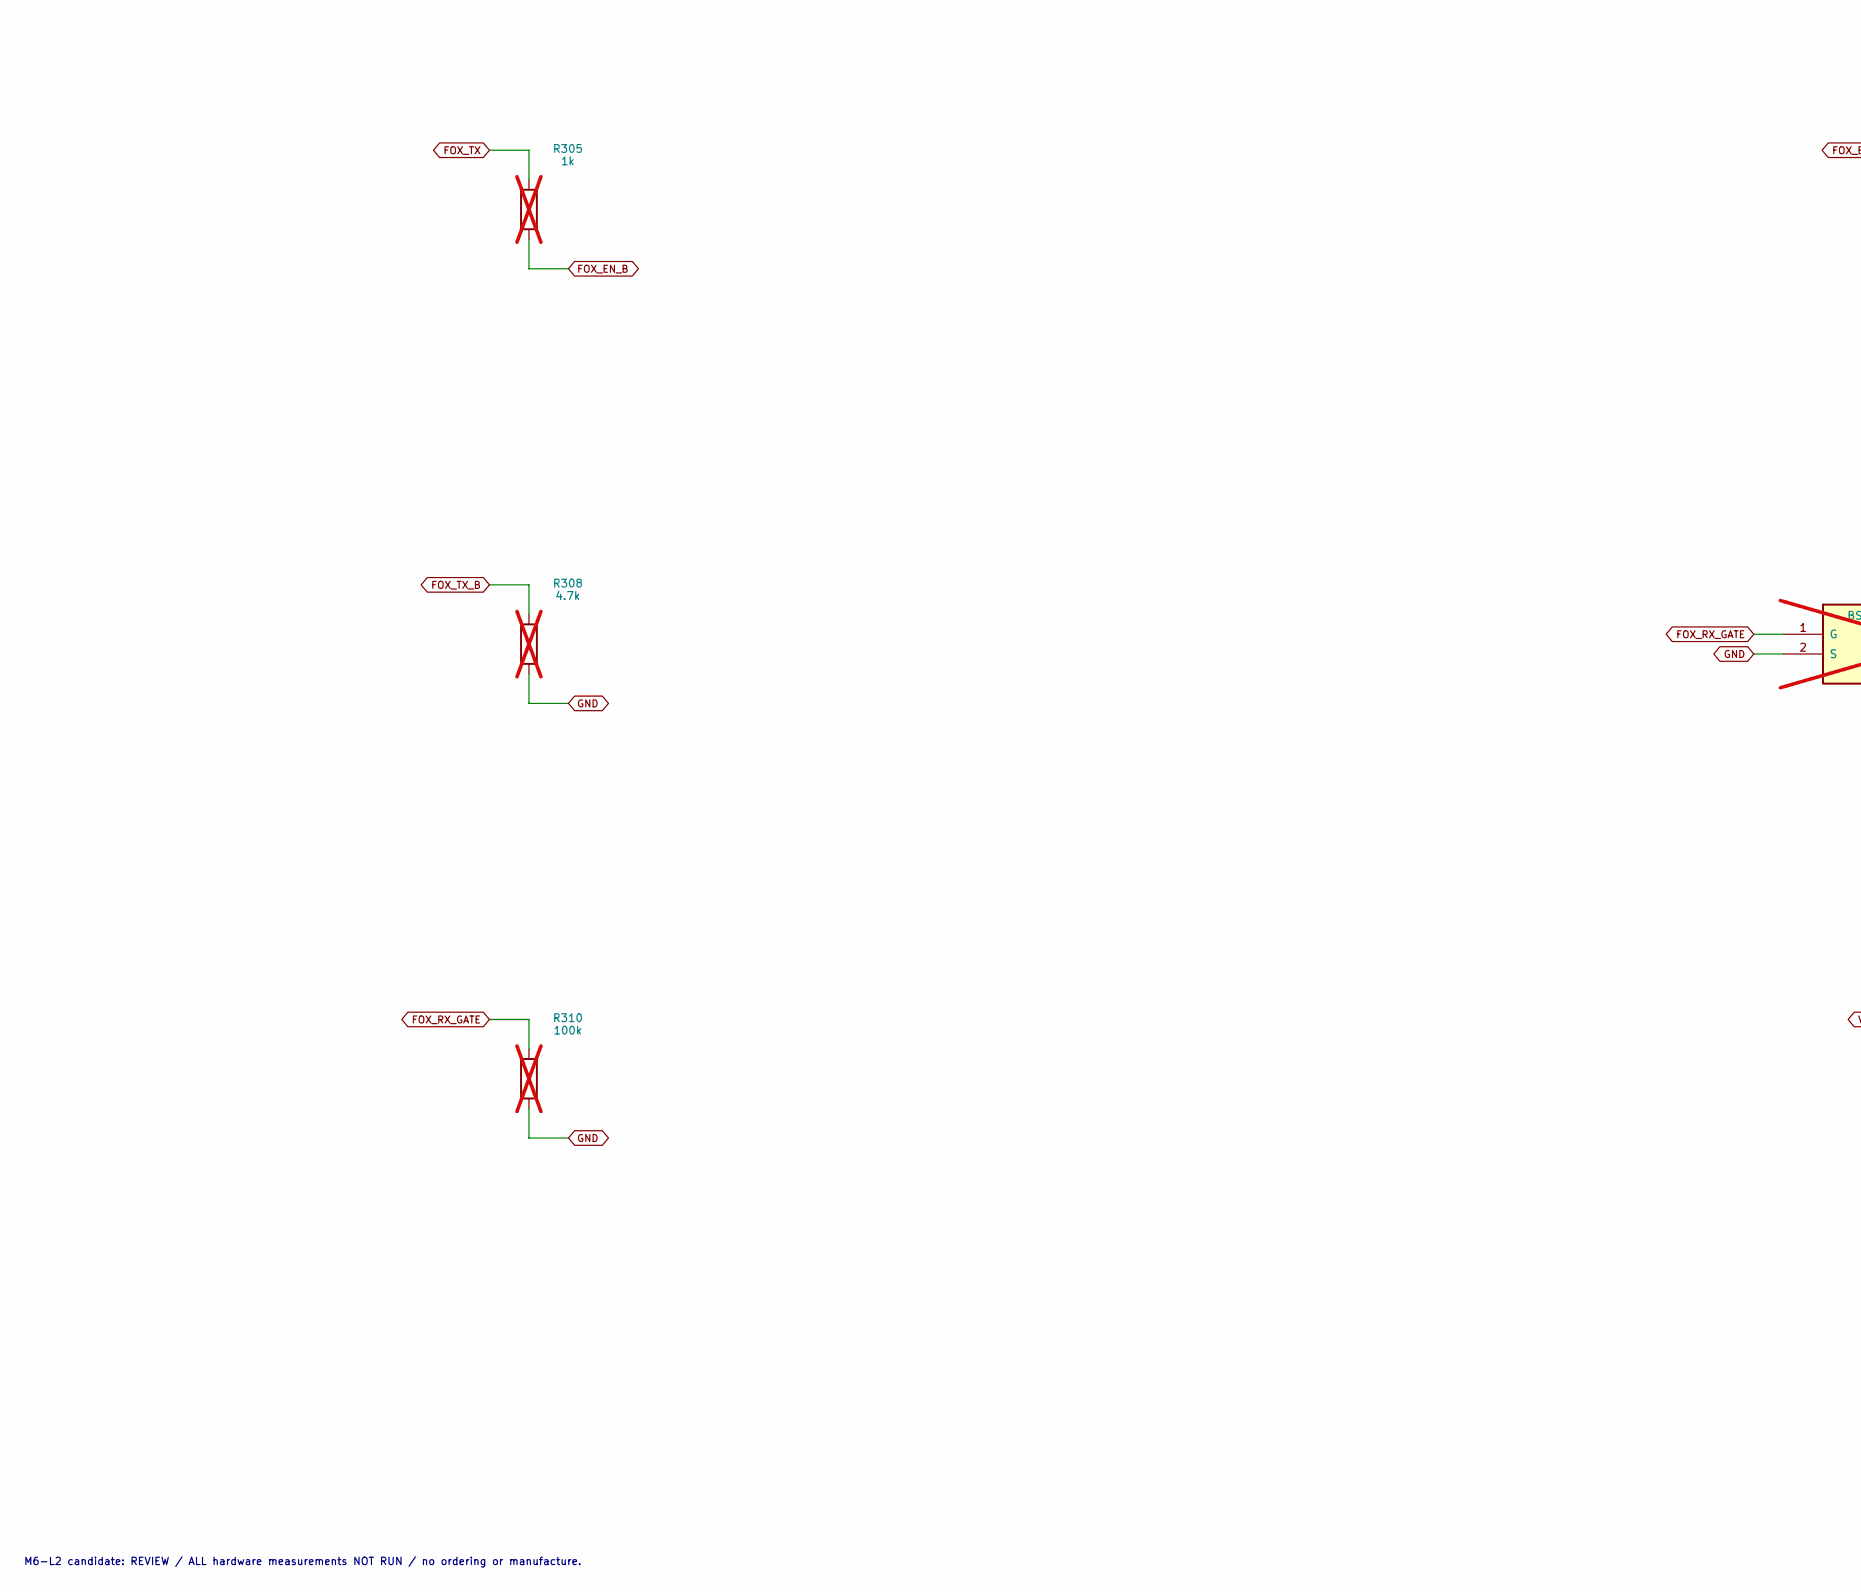
[picture p379: schematic 11_FoxPro.kicad_sch, 11 FoxPro / 1, part in row 2, column 1]

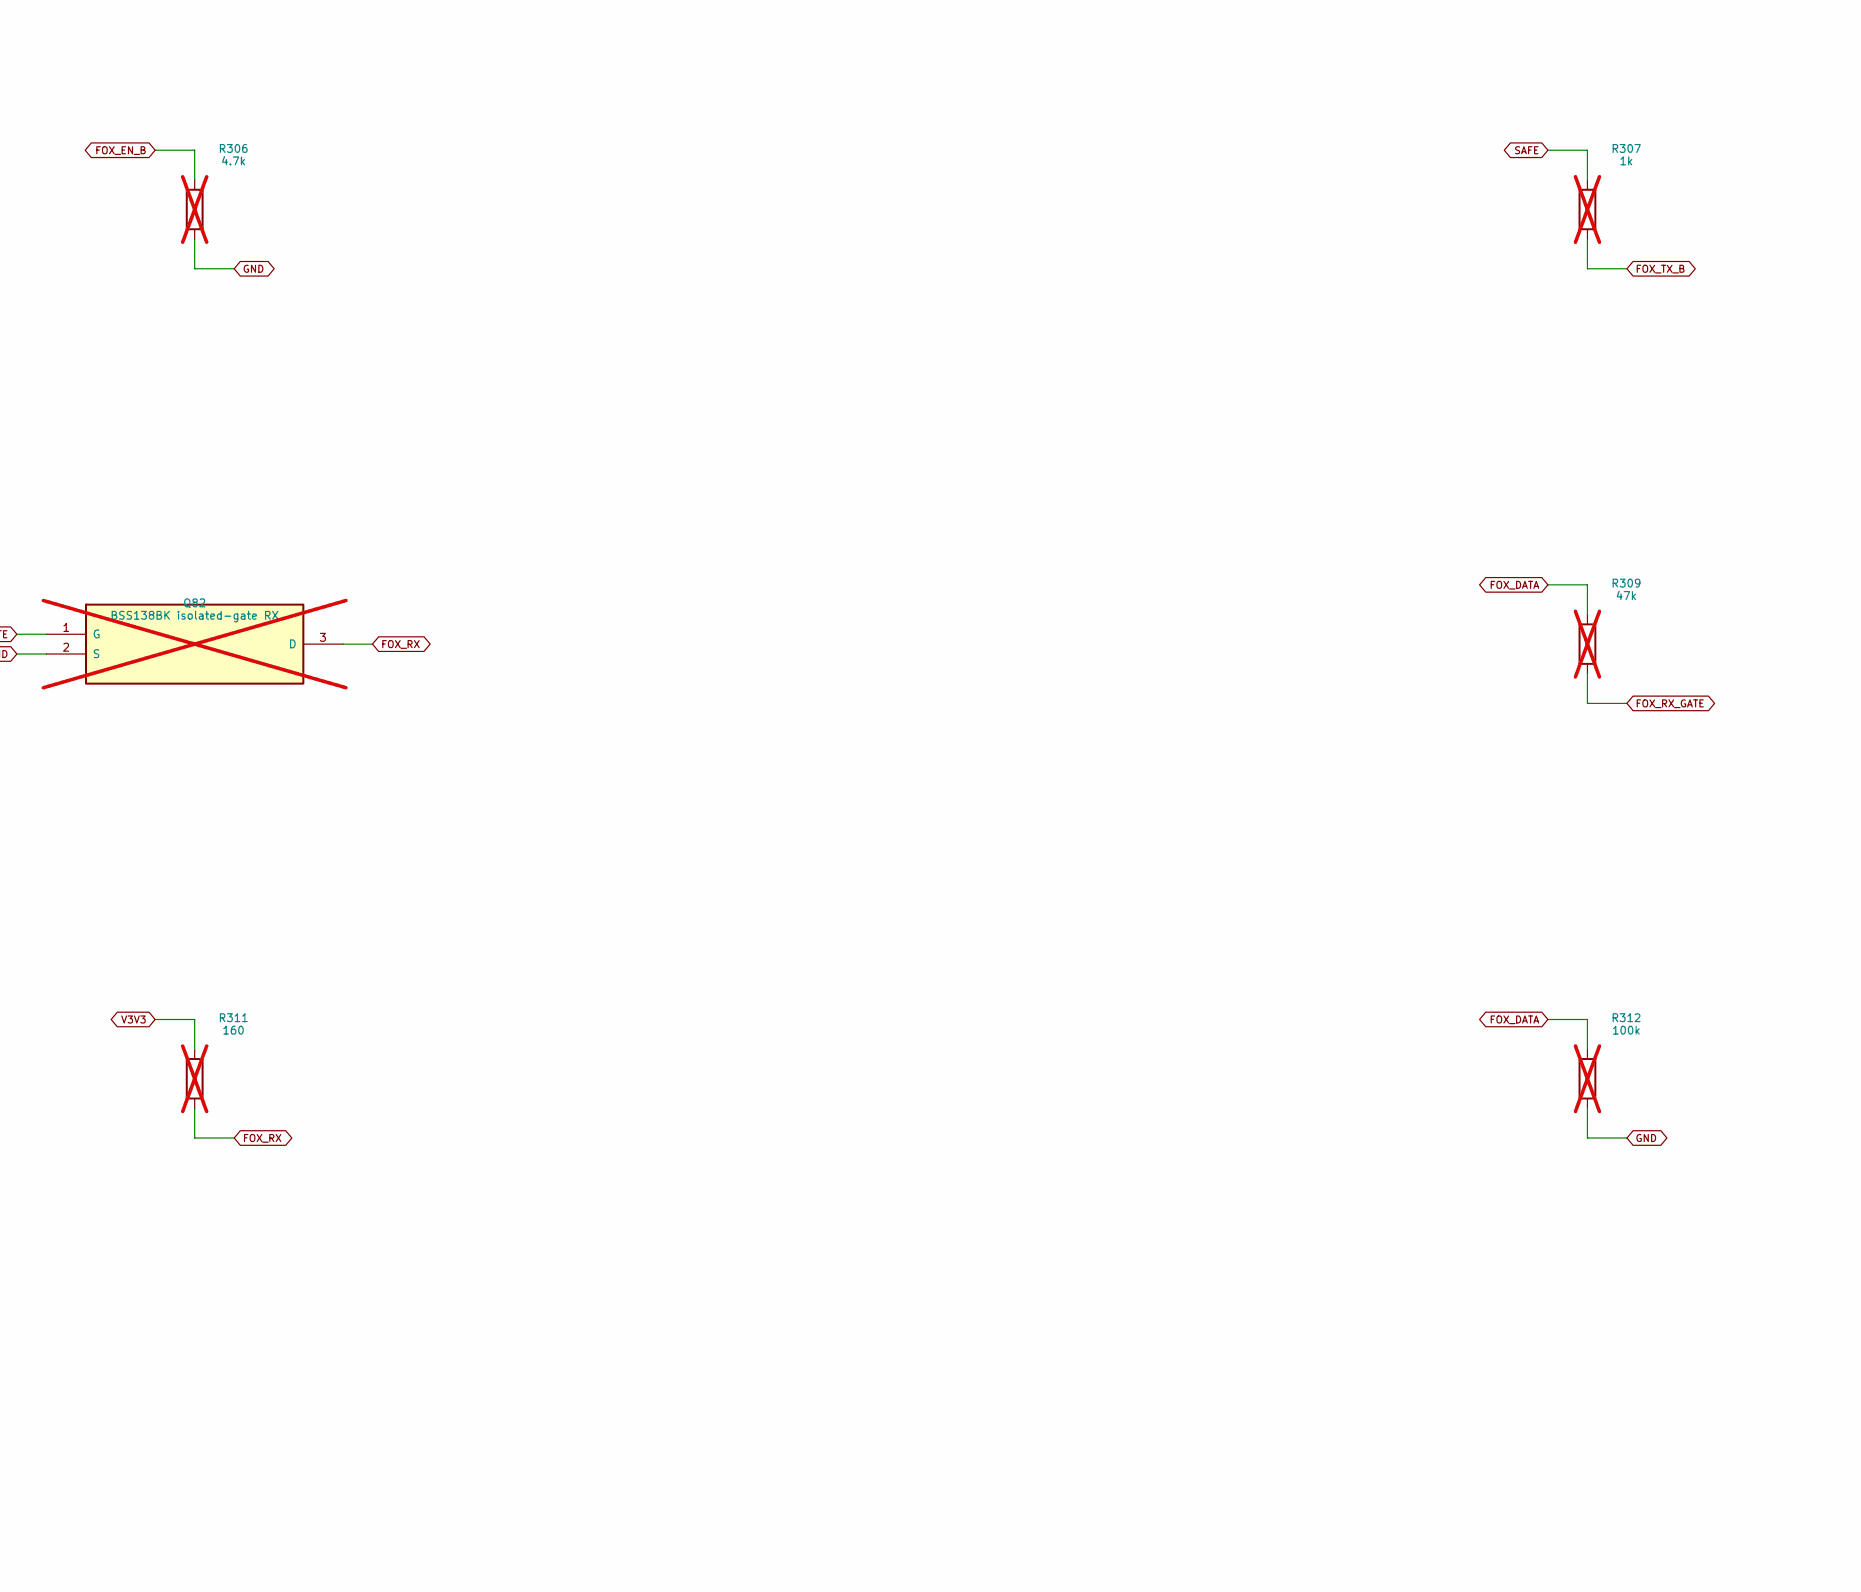
[picture p380: schematic 11_FoxPro.kicad_sch, 11 FoxPro / 1, part in row 2, column 2]

Parts:
J8: FOXPRO / G-D-V UNAVAILABLE; JST_PH_B3B-PH-K_1x03_P2.00mm_Vertical_L2; MPN B3B-PH-K-S(LF)(SN); not fitted
Q80: BSS138BK TX open-drain; SOT-23_CTL; MPN BSS138BK,215; not fitted
Q81: MMBT3904 hardware inhibit; SOT-23_CTL; MPN MMBT3904LT1G; not fitted
Q82: BSS138BK isolated-gate RX; SOT-23_CTL; MPN BSS138BK,215; not fitted
R300, R301: 0; R_0603_1608Metric_CTL; MPN RC0603JR-070RL
R302, R303: 0; R_0603_1608Metric_CTL; MPN RC0603JR-070RL; not fitted
R304: 680; R_2512_6332Metric_L2; MPN RC2512FK-07680RL; not fitted
R305, R307: 1k; R_0603_1608Metric_CTL; MPN RC0603FR-071KL; not fitted
R306, R308: 4.7k; R_0603_1608Metric_CTL; MPN RC0603FR-074K7L; not fitted
R309: 47k; R_0603_1608Metric_CTL; MPN RC0603FR-0747KL; not fitted
R310, R312: 100k; R_0603_1608Metric_CTL; MPN RC0603FR-07100KL; not fitted
R311: 160; R_0603_1608Metric_CTL; MPN RC0603FR-07160RL; not fitted
R314: 470; R_2512_6332Metric_L2; MPN RC2512FK-07470RL; not fitted

Connections:
FOX_DATA: J8.2 (2_IO), R304.1, R309.1, R312.1; also elsewhere on the board
FOX_EN_B: Q81.1 (1_IO), R305.2, R306.1
FOX_GND: J8.1 (1_IO), R314.1; also elsewhere on the board
FOX_RX: Q82.3 (D), R303.2, R311.2; also elsewhere on the board
FOX_RX_GATE: Q82.1 (G), R309.2, R310.1; also elsewhere on the board
FOX_SINK: Q80.3 (D), R304.2; also elsewhere on the board
FOX_TX: R302.2, R305.1
FOX_TX_B: Q80.1 (G), Q81.3 (3_IO), R307.2, R308.1; also elsewhere on the board
FOX_V_UNAVAILABLE: J8.3 (3_IO); also elsewhere on the board
GND: Q80.2 (S), Q81.2 (2_IO), Q82.2 (S), R306.2, R308.2, R310.2, R312.2, R314.2; also elsewhere on the board
REC_RX: R301.2; also elsewhere on the board
REC_TX: R300.2; also elsewhere on the board
SAFE: R307.1; also elsewhere on the board
UART_RX: R301.1, R303.1; also elsewhere on the board
UART_TX: R300.1, R302.1; also elsewhere on the board
V3V3: R311.1; also elsewhere on the board

Notes on the sheet:
11 FoxPro / 1
M6-L2 candidate: REVIEW / ALL hardware measurements NOT RUN / no ordering or manufacture.

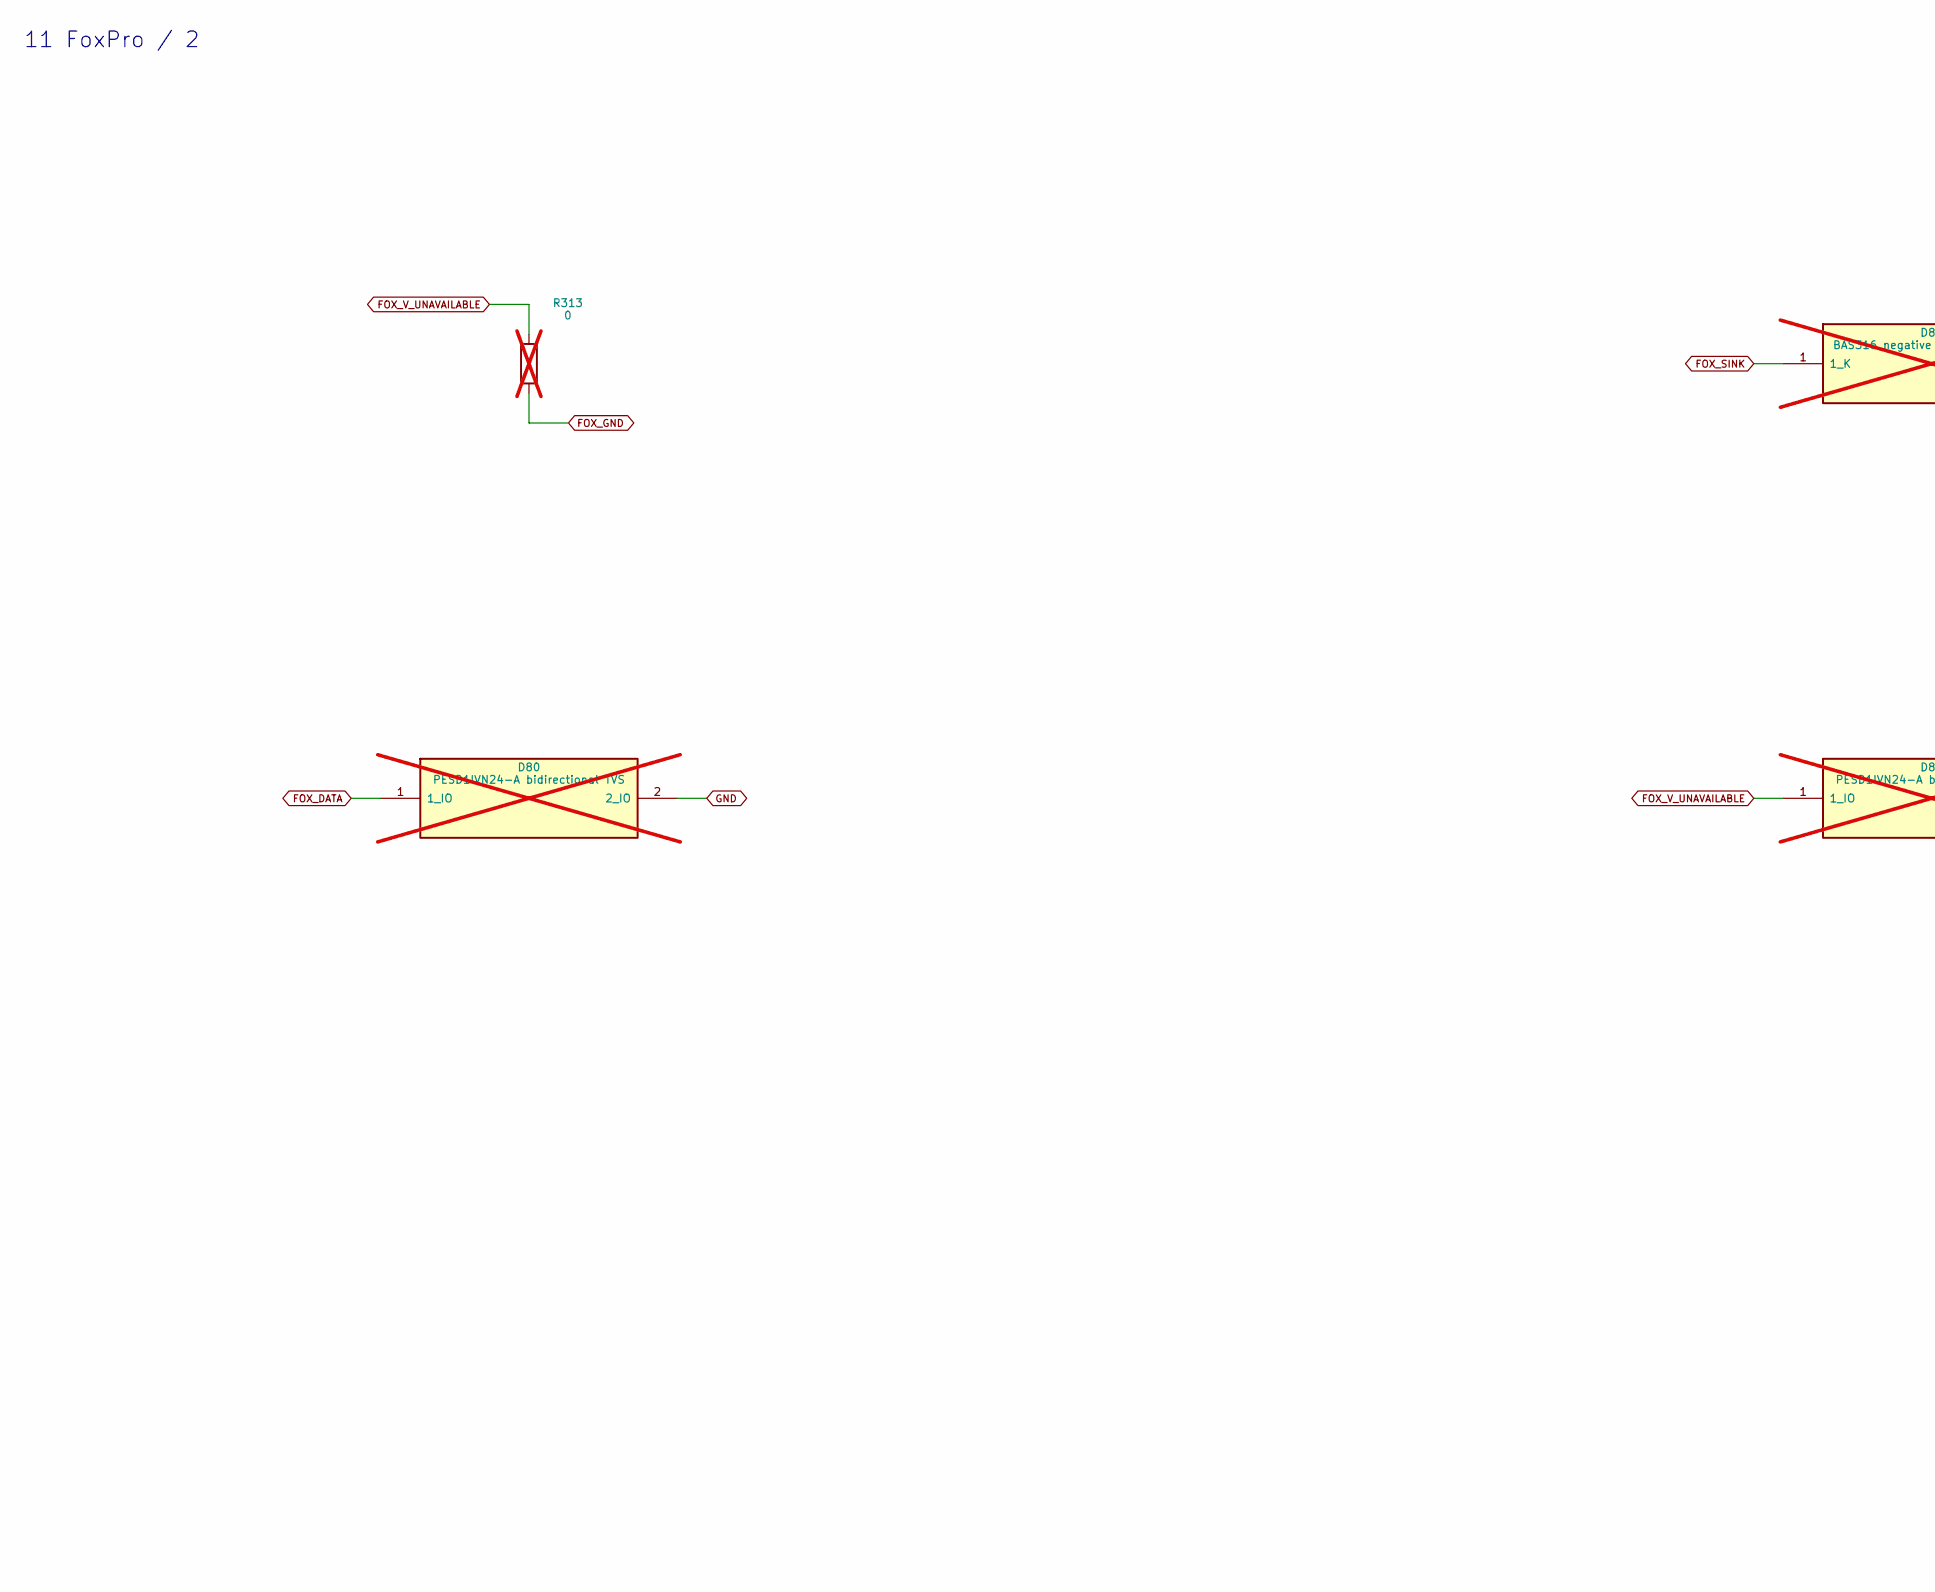
[picture p381: schematic 11_FoxPro_2.kicad_sch, 11 FoxPro / 2, part in row 1, column 1]

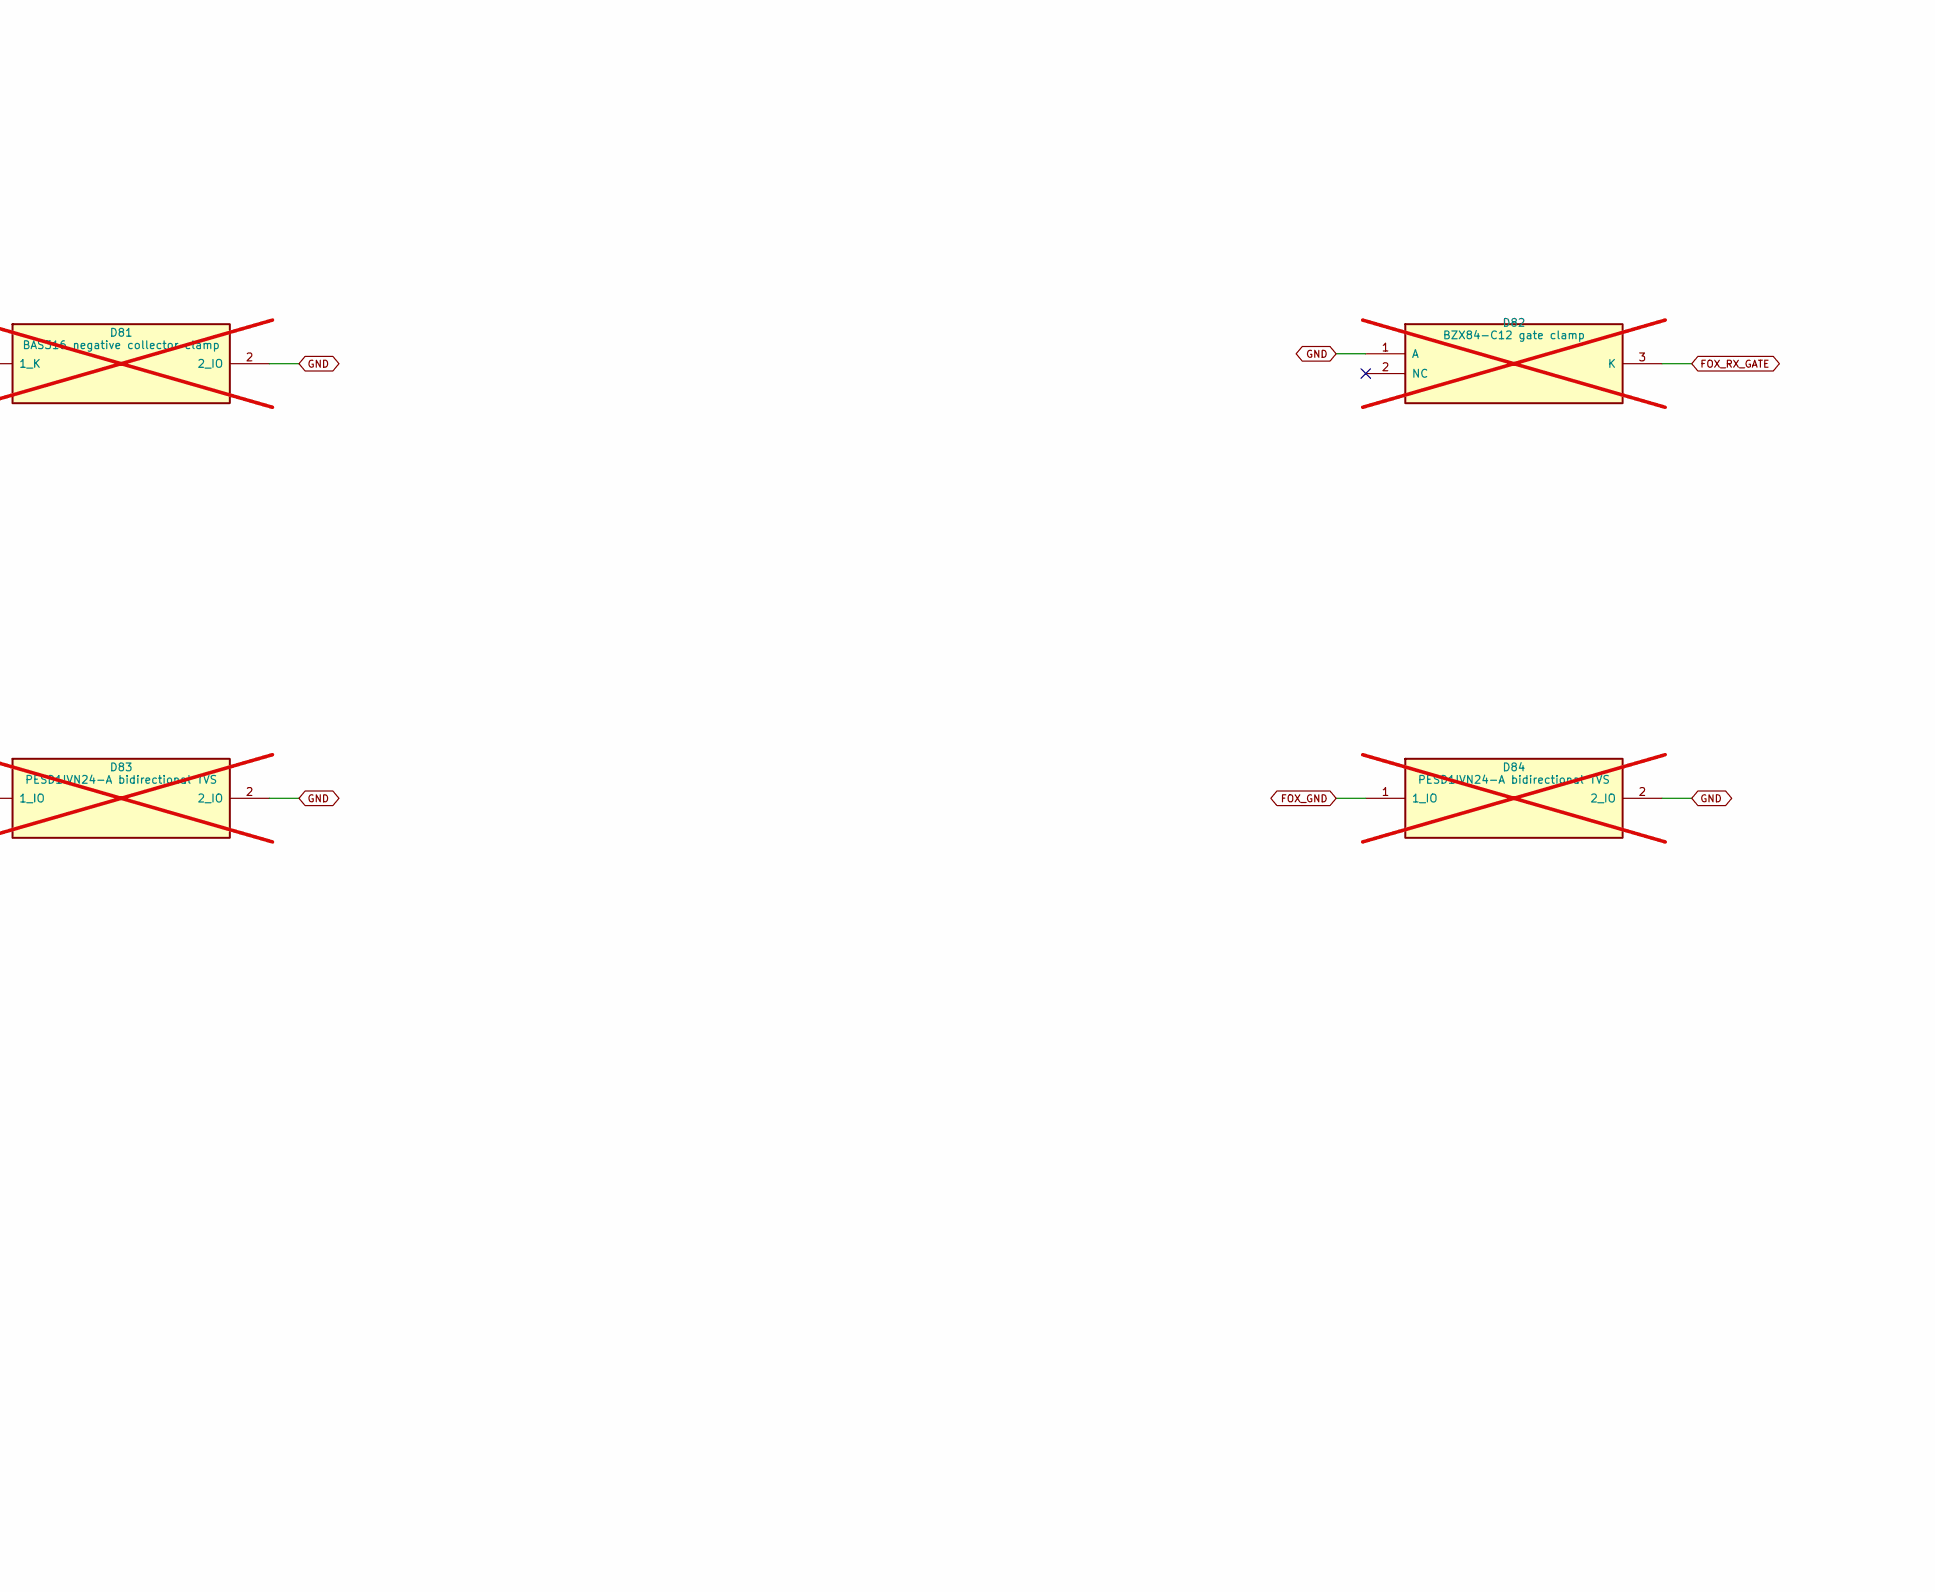
[picture p382: schematic 11_FoxPro_2.kicad_sch, 11 FoxPro / 2, part in row 1, column 2]

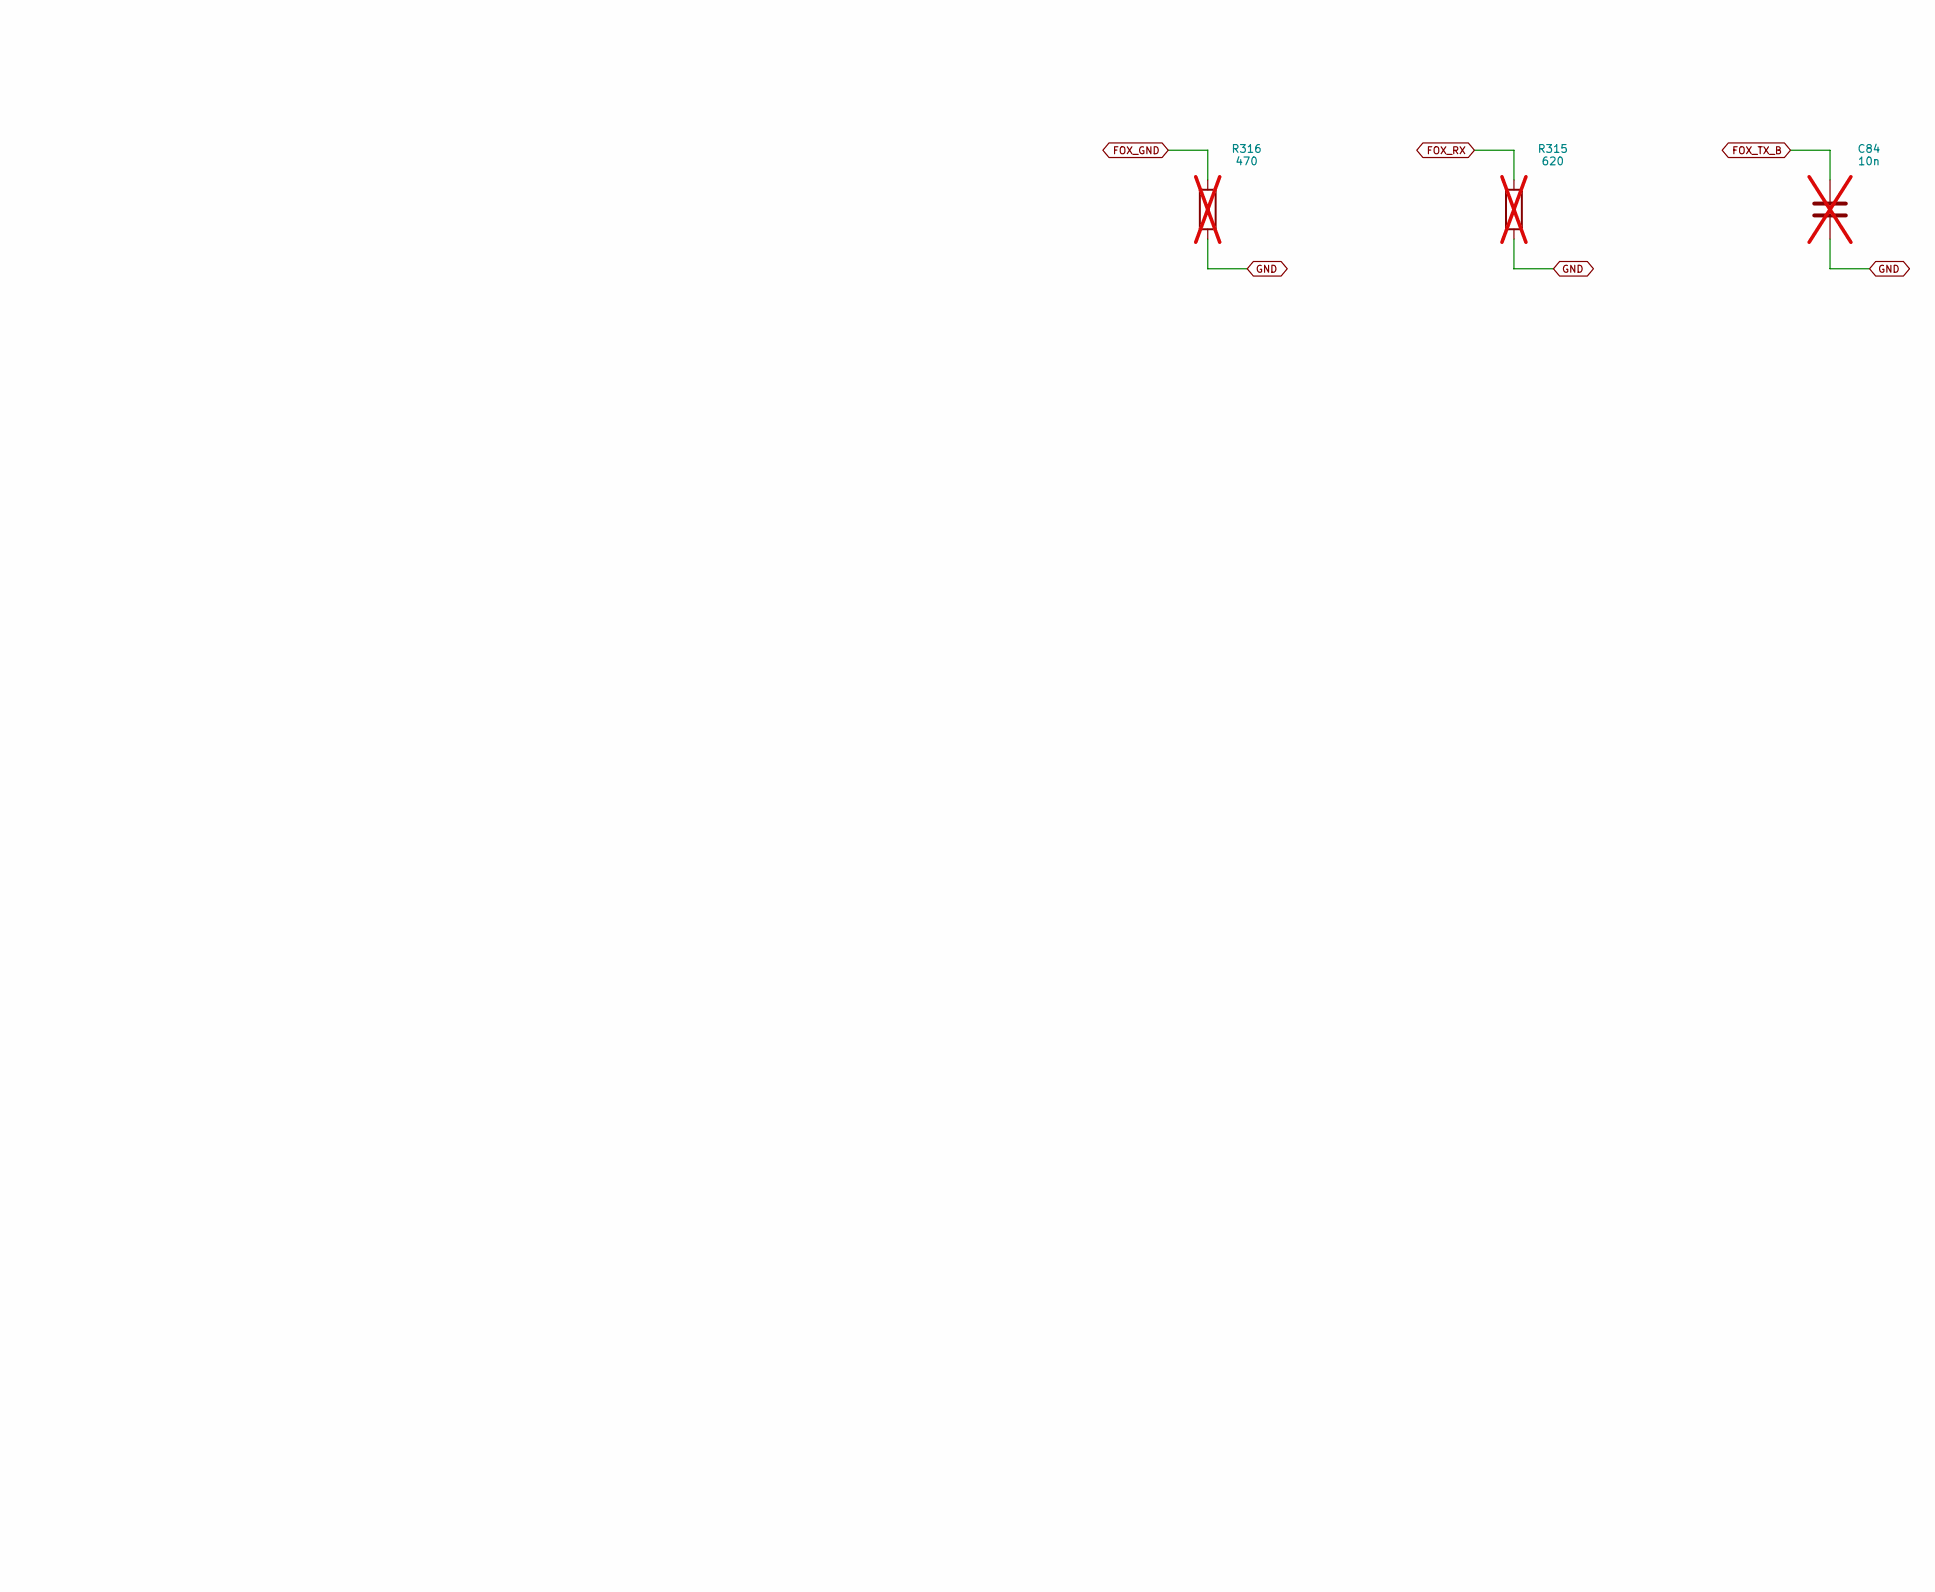
[picture p383: schematic 11_FoxPro_2.kicad_sch, 11 FoxPro / 2, part in row 2, column 2]

Parts:
C84: 10n; C_0603_1608Metric_CTL; MPN CL10B103KB8NNNC; not fitted
D80, D83, D84: PESD1IVN24-A bidirectional TVS; D_SOD-323_L2; MPN PESD1IVN24-AX; not fitted
D81: BAS316 negative collector clamp; D_SOD-323_L2; MPN BAS316,115; not fitted
D82: BZX84-C12 gate clamp; SOT-23_CTL; MPN BZX84-C12,215; not fitted
R313: 0; R_0603_1608Metric_CTL; MPN RC0603JR-070RL; not fitted
R315: 620; R_0603_1608Metric_CTL; MPN RC0603FR-07620RL; not fitted
R316: 470; R_2512_6332Metric_L2; MPN RC2512FK-07470RL; not fitted

Connections:
FOX_DATA: D80.1 (1_IO); also elsewhere on the board
FOX_GND: D84.1 (1_IO), R313.2, R316.1; also elsewhere on the board
FOX_RX: R315.1; also elsewhere on the board
FOX_RX_GATE: D82.3 (K); also elsewhere on the board
FOX_SINK: D81.1 (1_K); also elsewhere on the board
FOX_TX_B: C84.1; also elsewhere on the board
FOX_V_UNAVAILABLE: D83.1 (1_IO), R313.1; also elsewhere on the board
GND: C84.2, D80.2 (2_IO), D81.2 (2_IO), D82.1 (A), D83.2 (2_IO), D84.2 (2_IO), R315.2, R316.2; also elsewhere on the board

Notes on the sheet:
11 FoxPro / 2
M6-L2 candidate: REVIEW / ALL hardware measurements NOT RUN / no ordering or manufacture.
