DD1SB/ARDF-TX/hardware/controller/CTRL.kicad_pcb

## KiCad design hardware/controller/CTRL.kicad_pcb (continued)

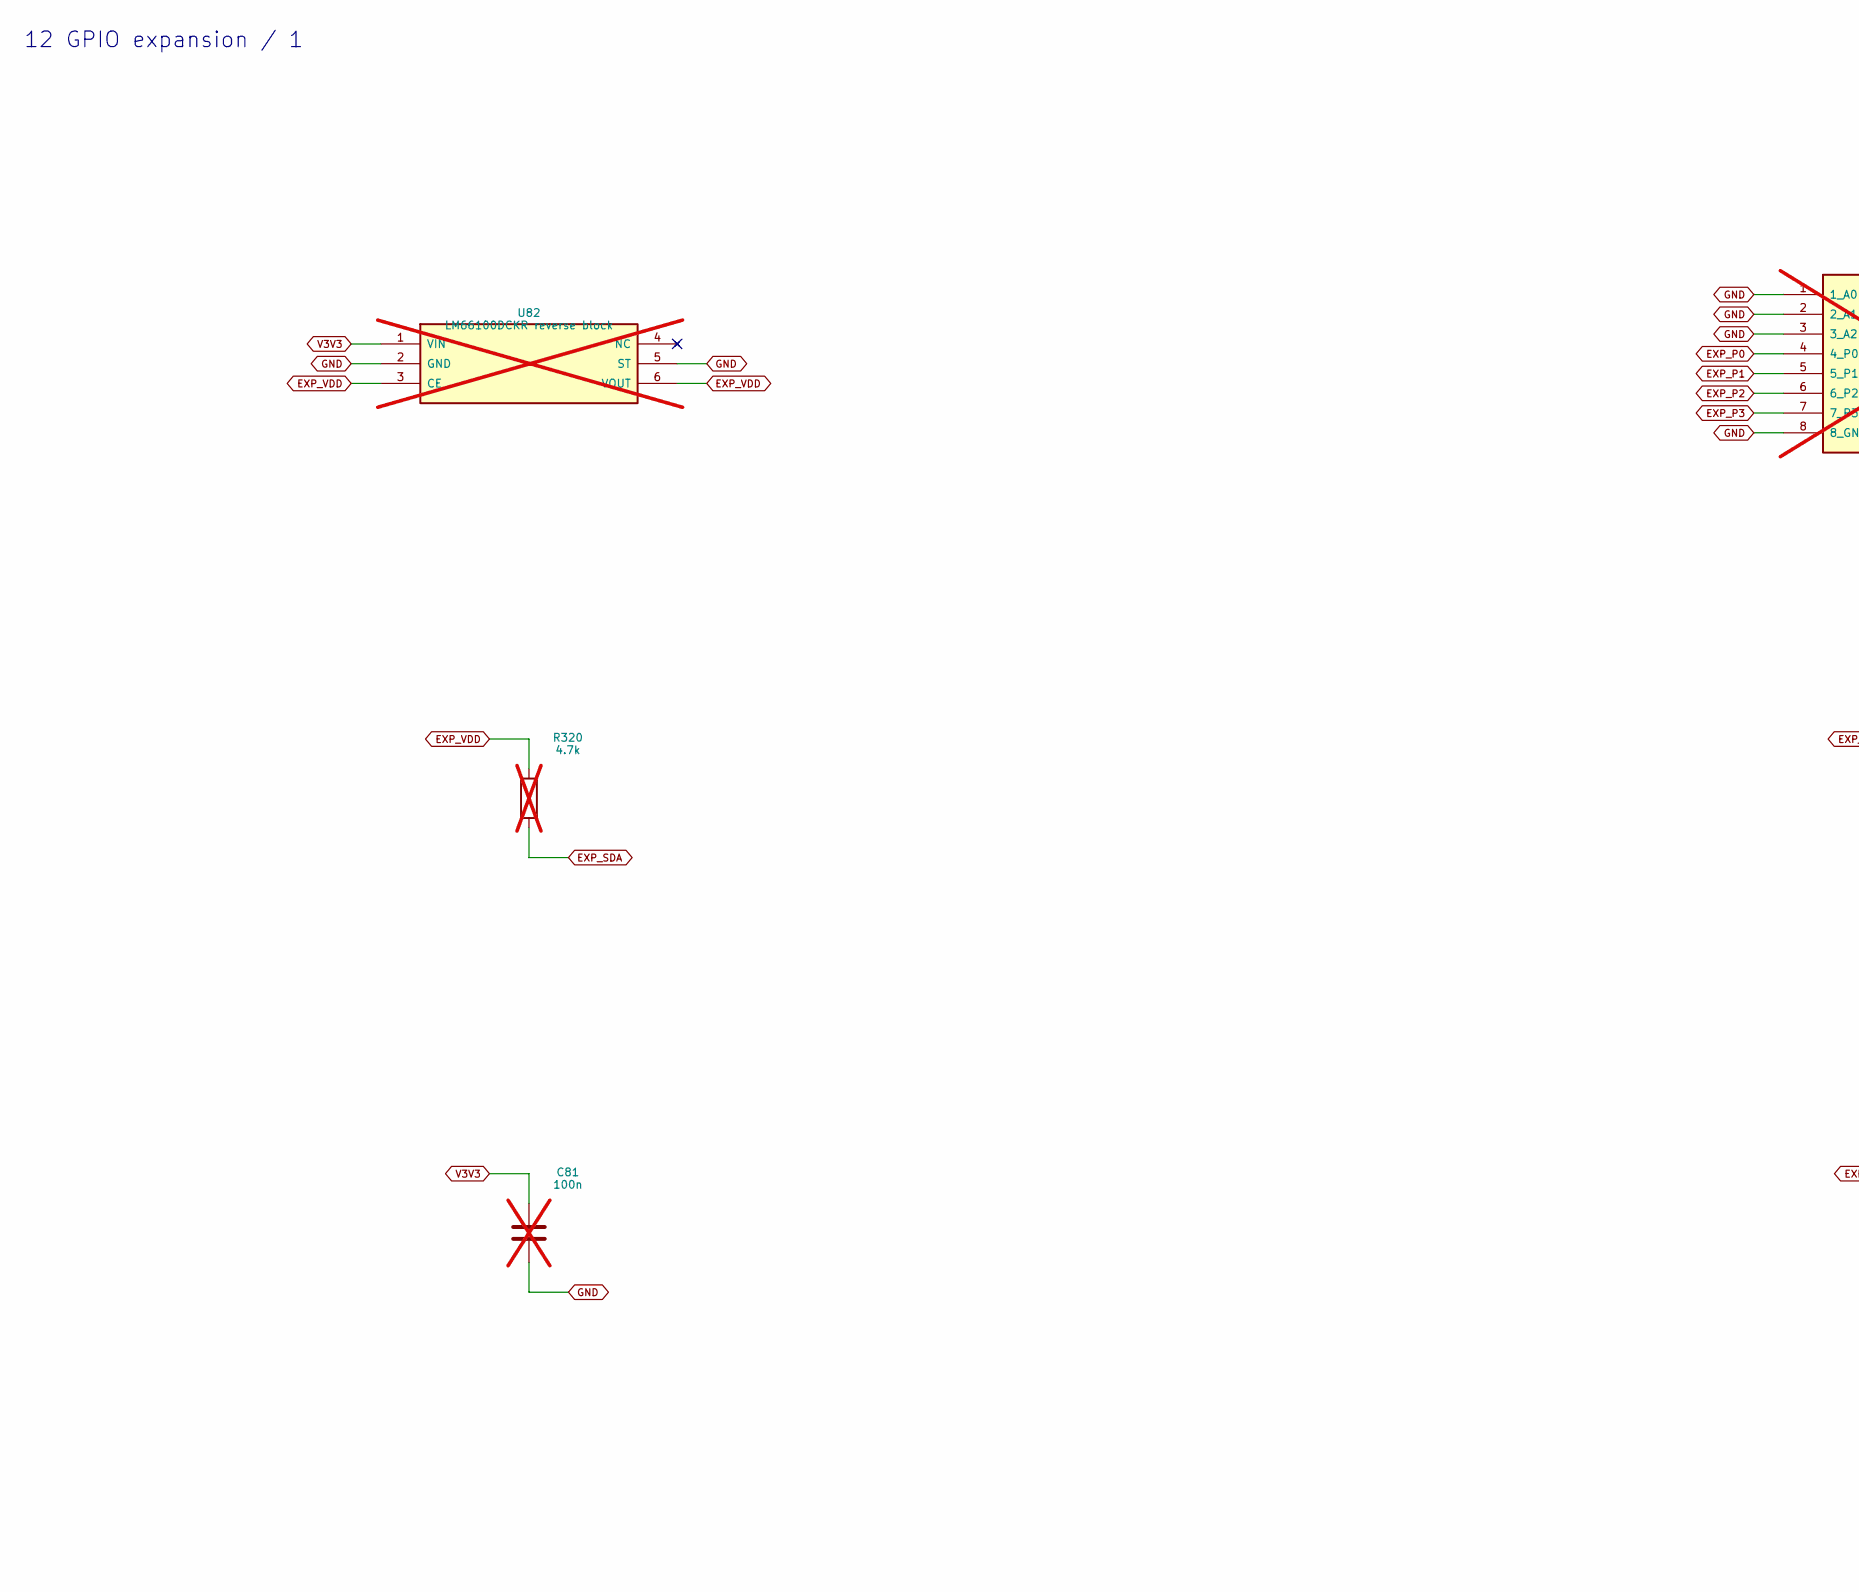
[picture p384: schematic 12_GPIO_expansion.kicad_sch, 12 GPIO expansion / 1, part in row 1, column 1]

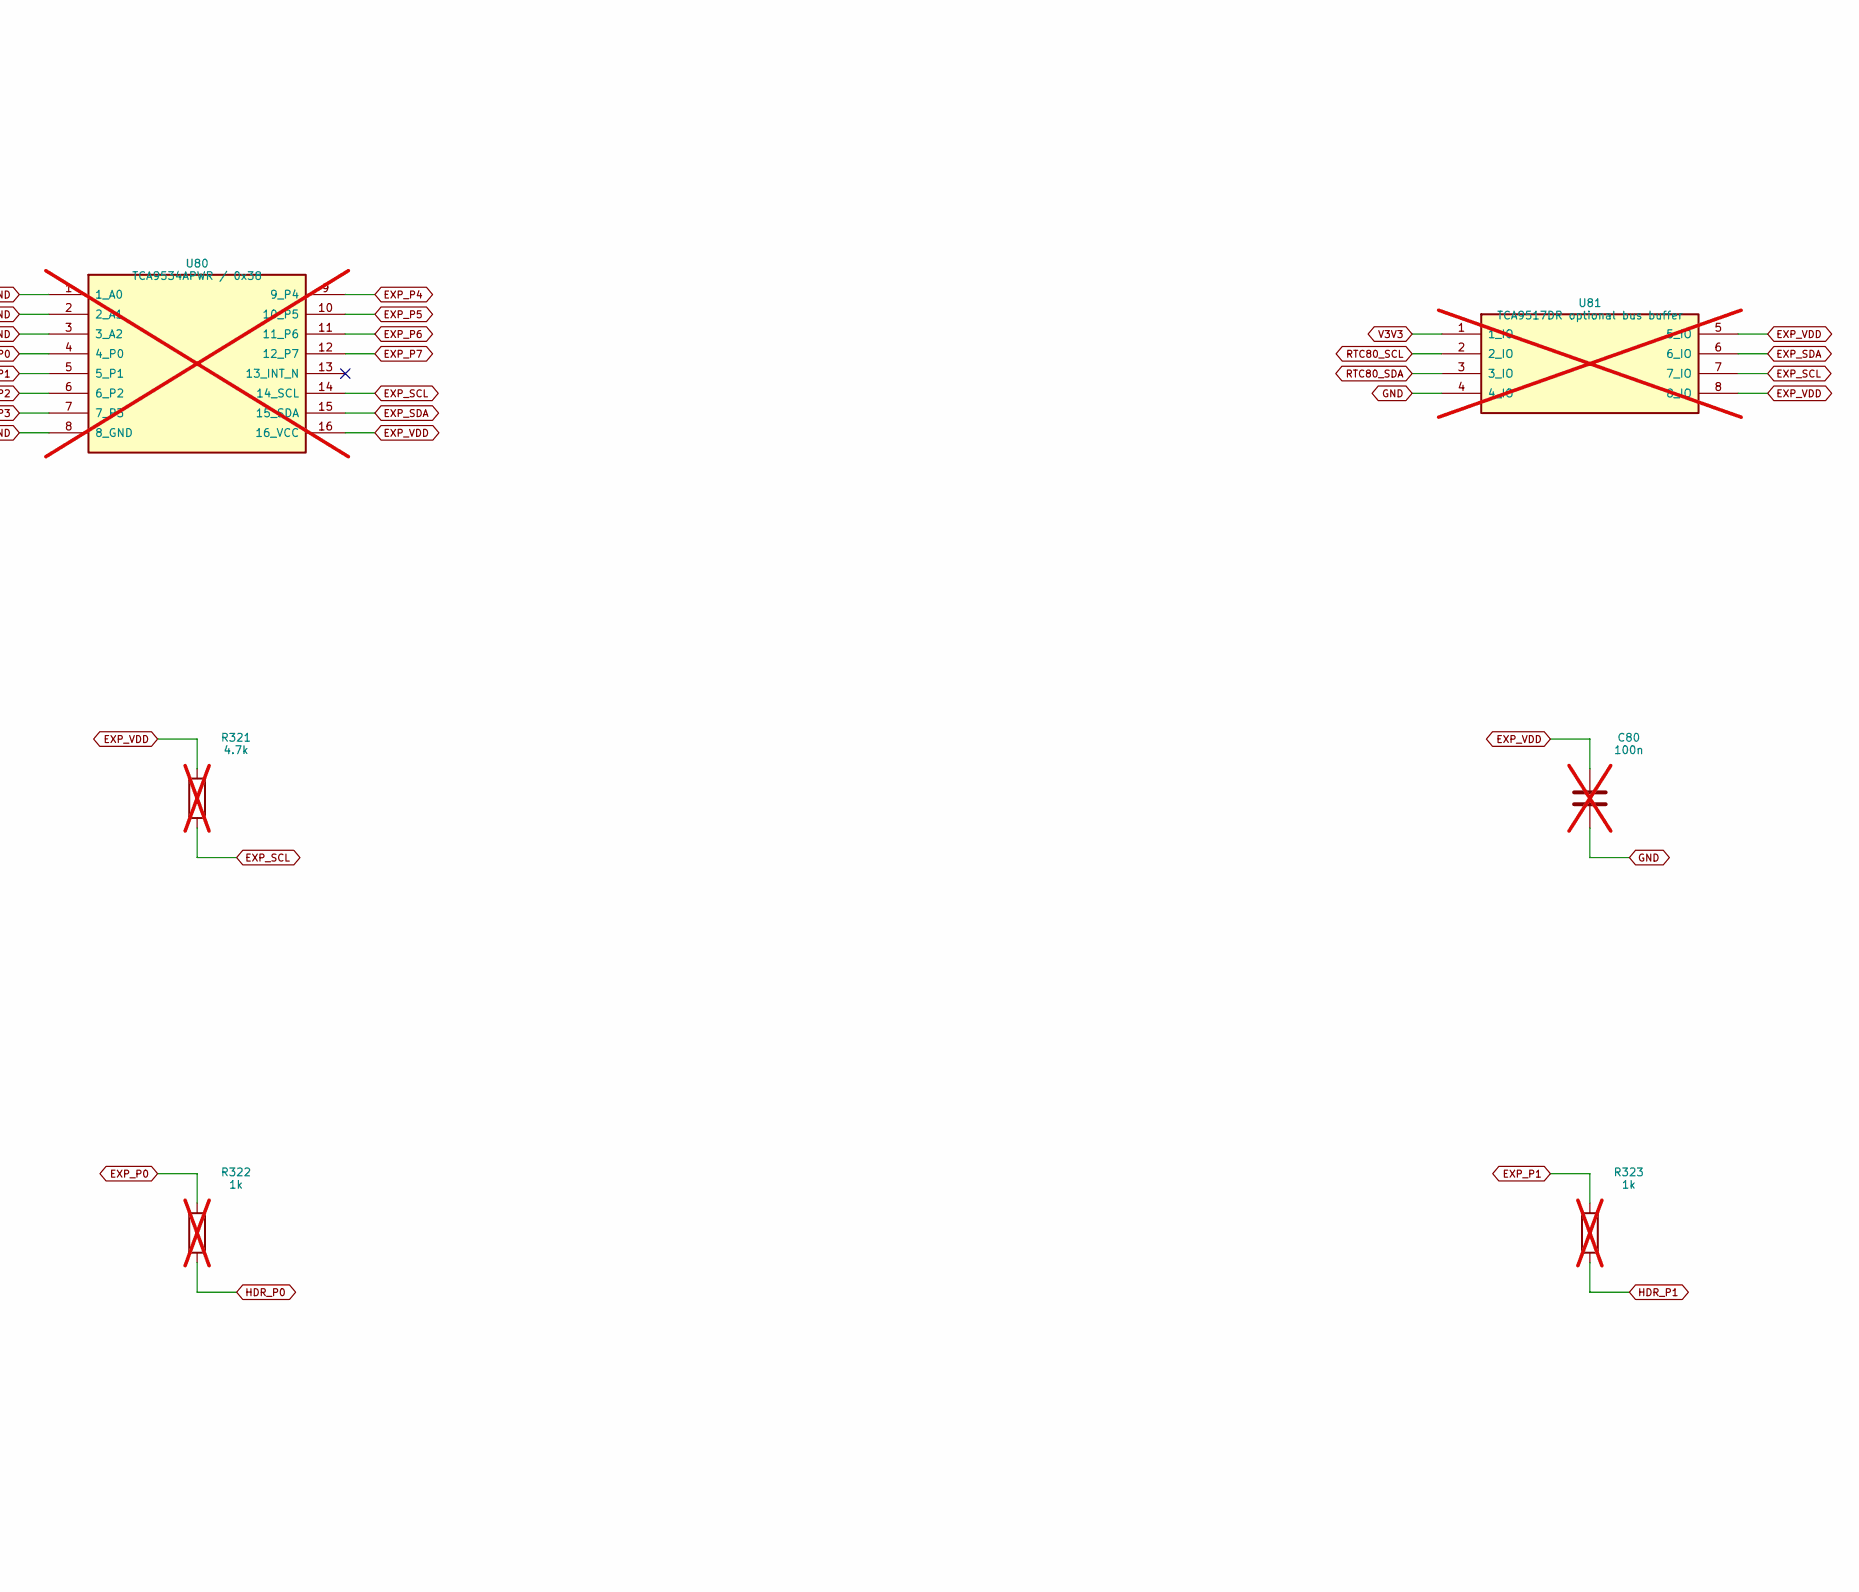
[picture p385: schematic 12_GPIO_expansion.kicad_sch, 12 GPIO expansion / 1, part in row 1, column 2]

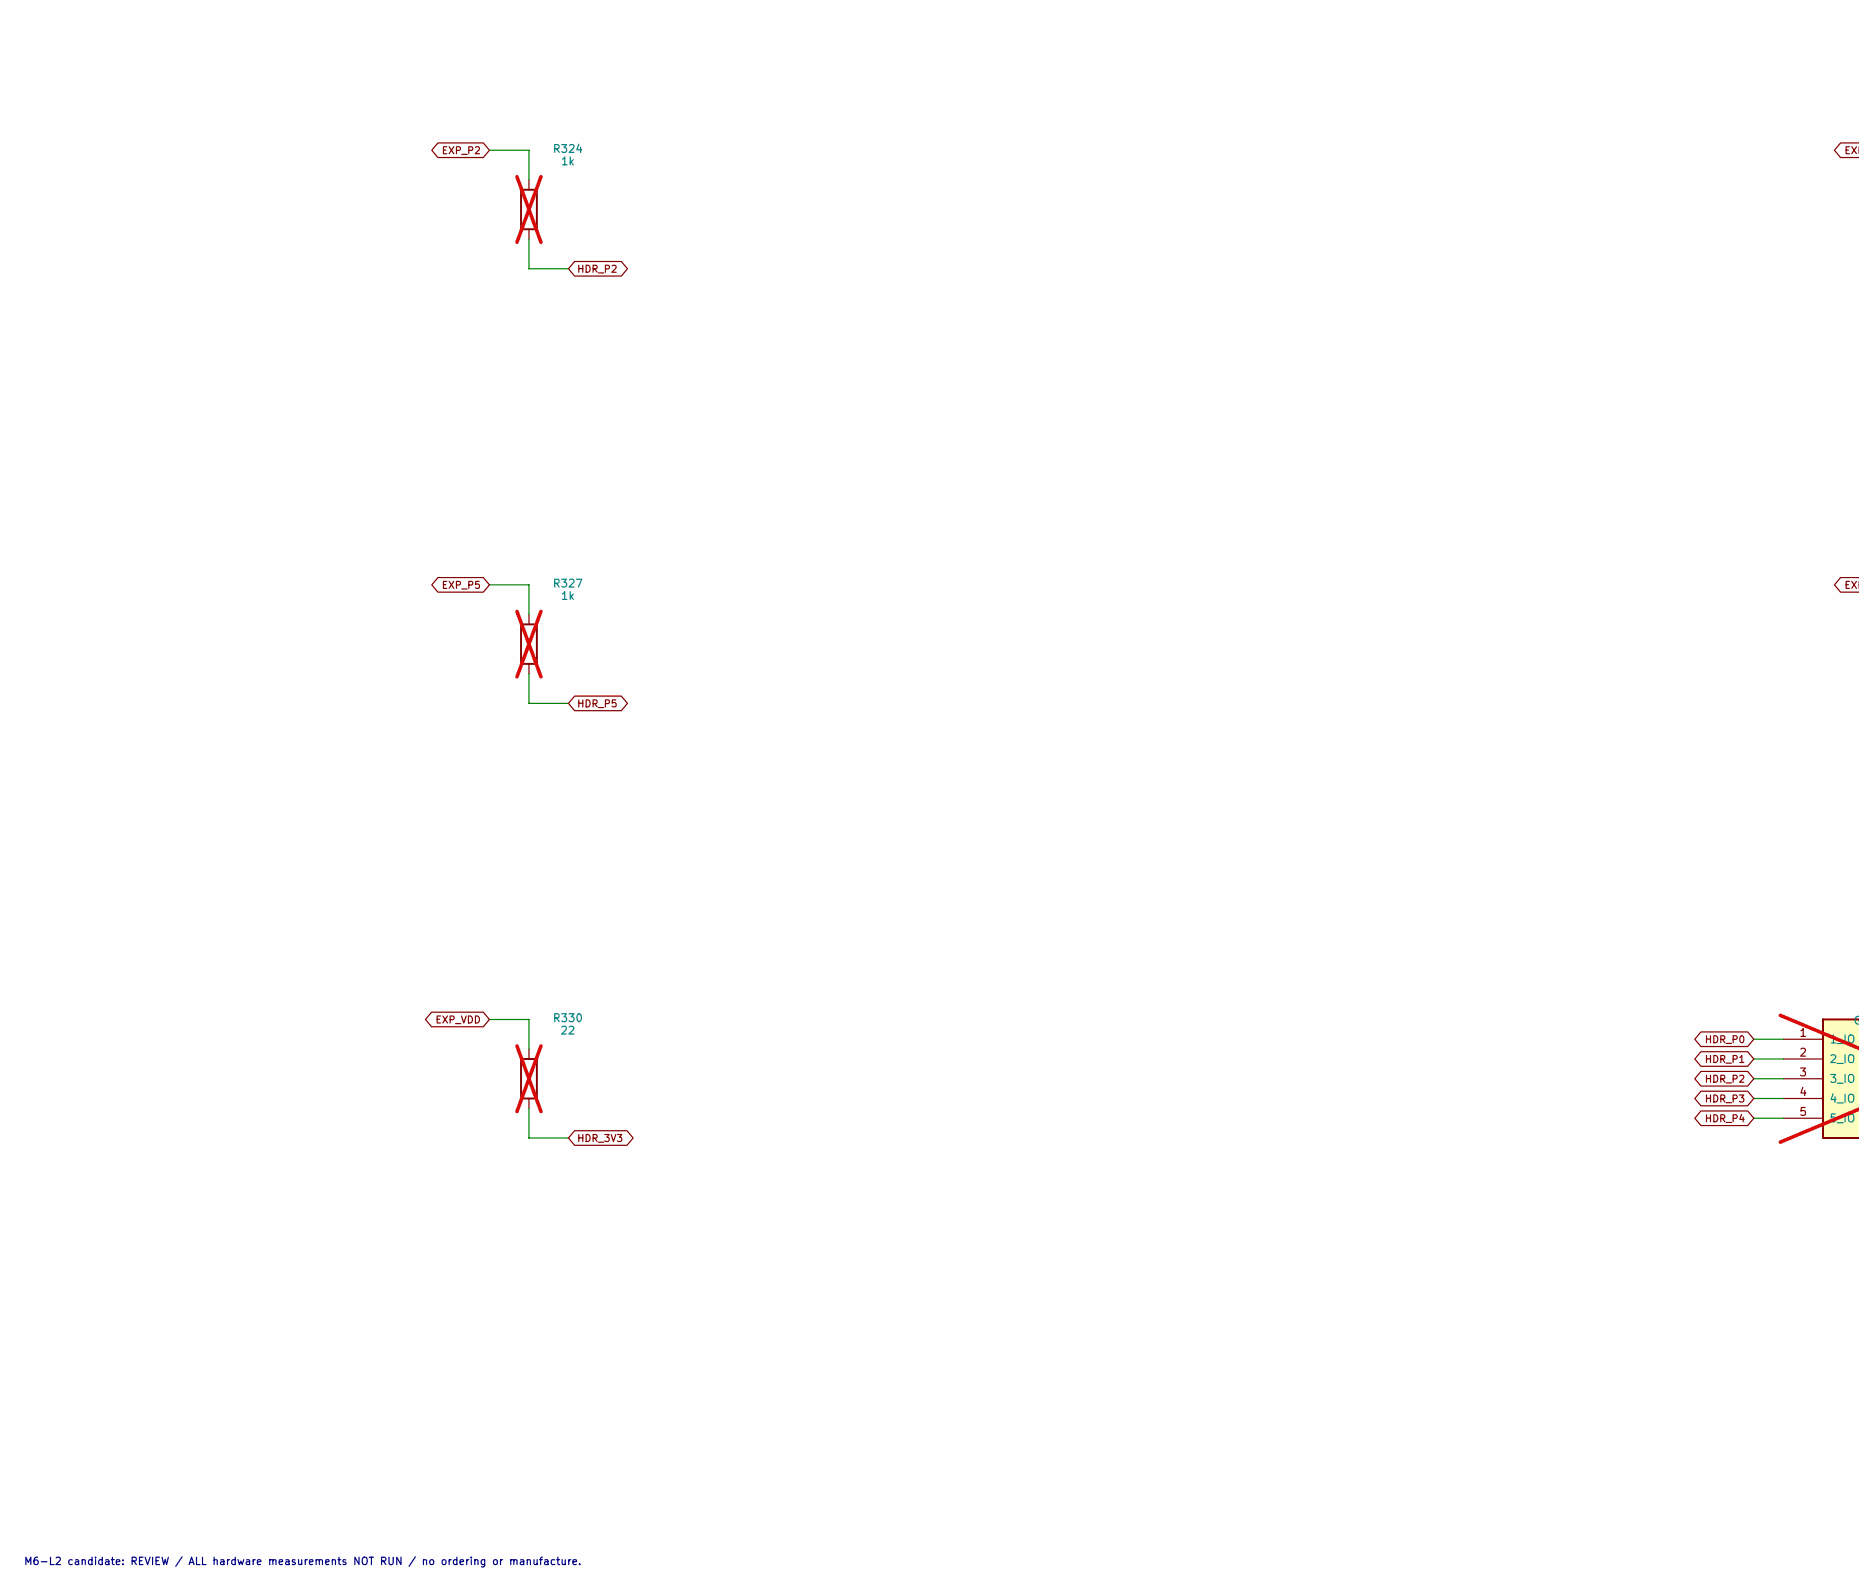
[picture p386: schematic 12_GPIO_expansion.kicad_sch, 12 GPIO expansion / 1, part in row 2, column 1]

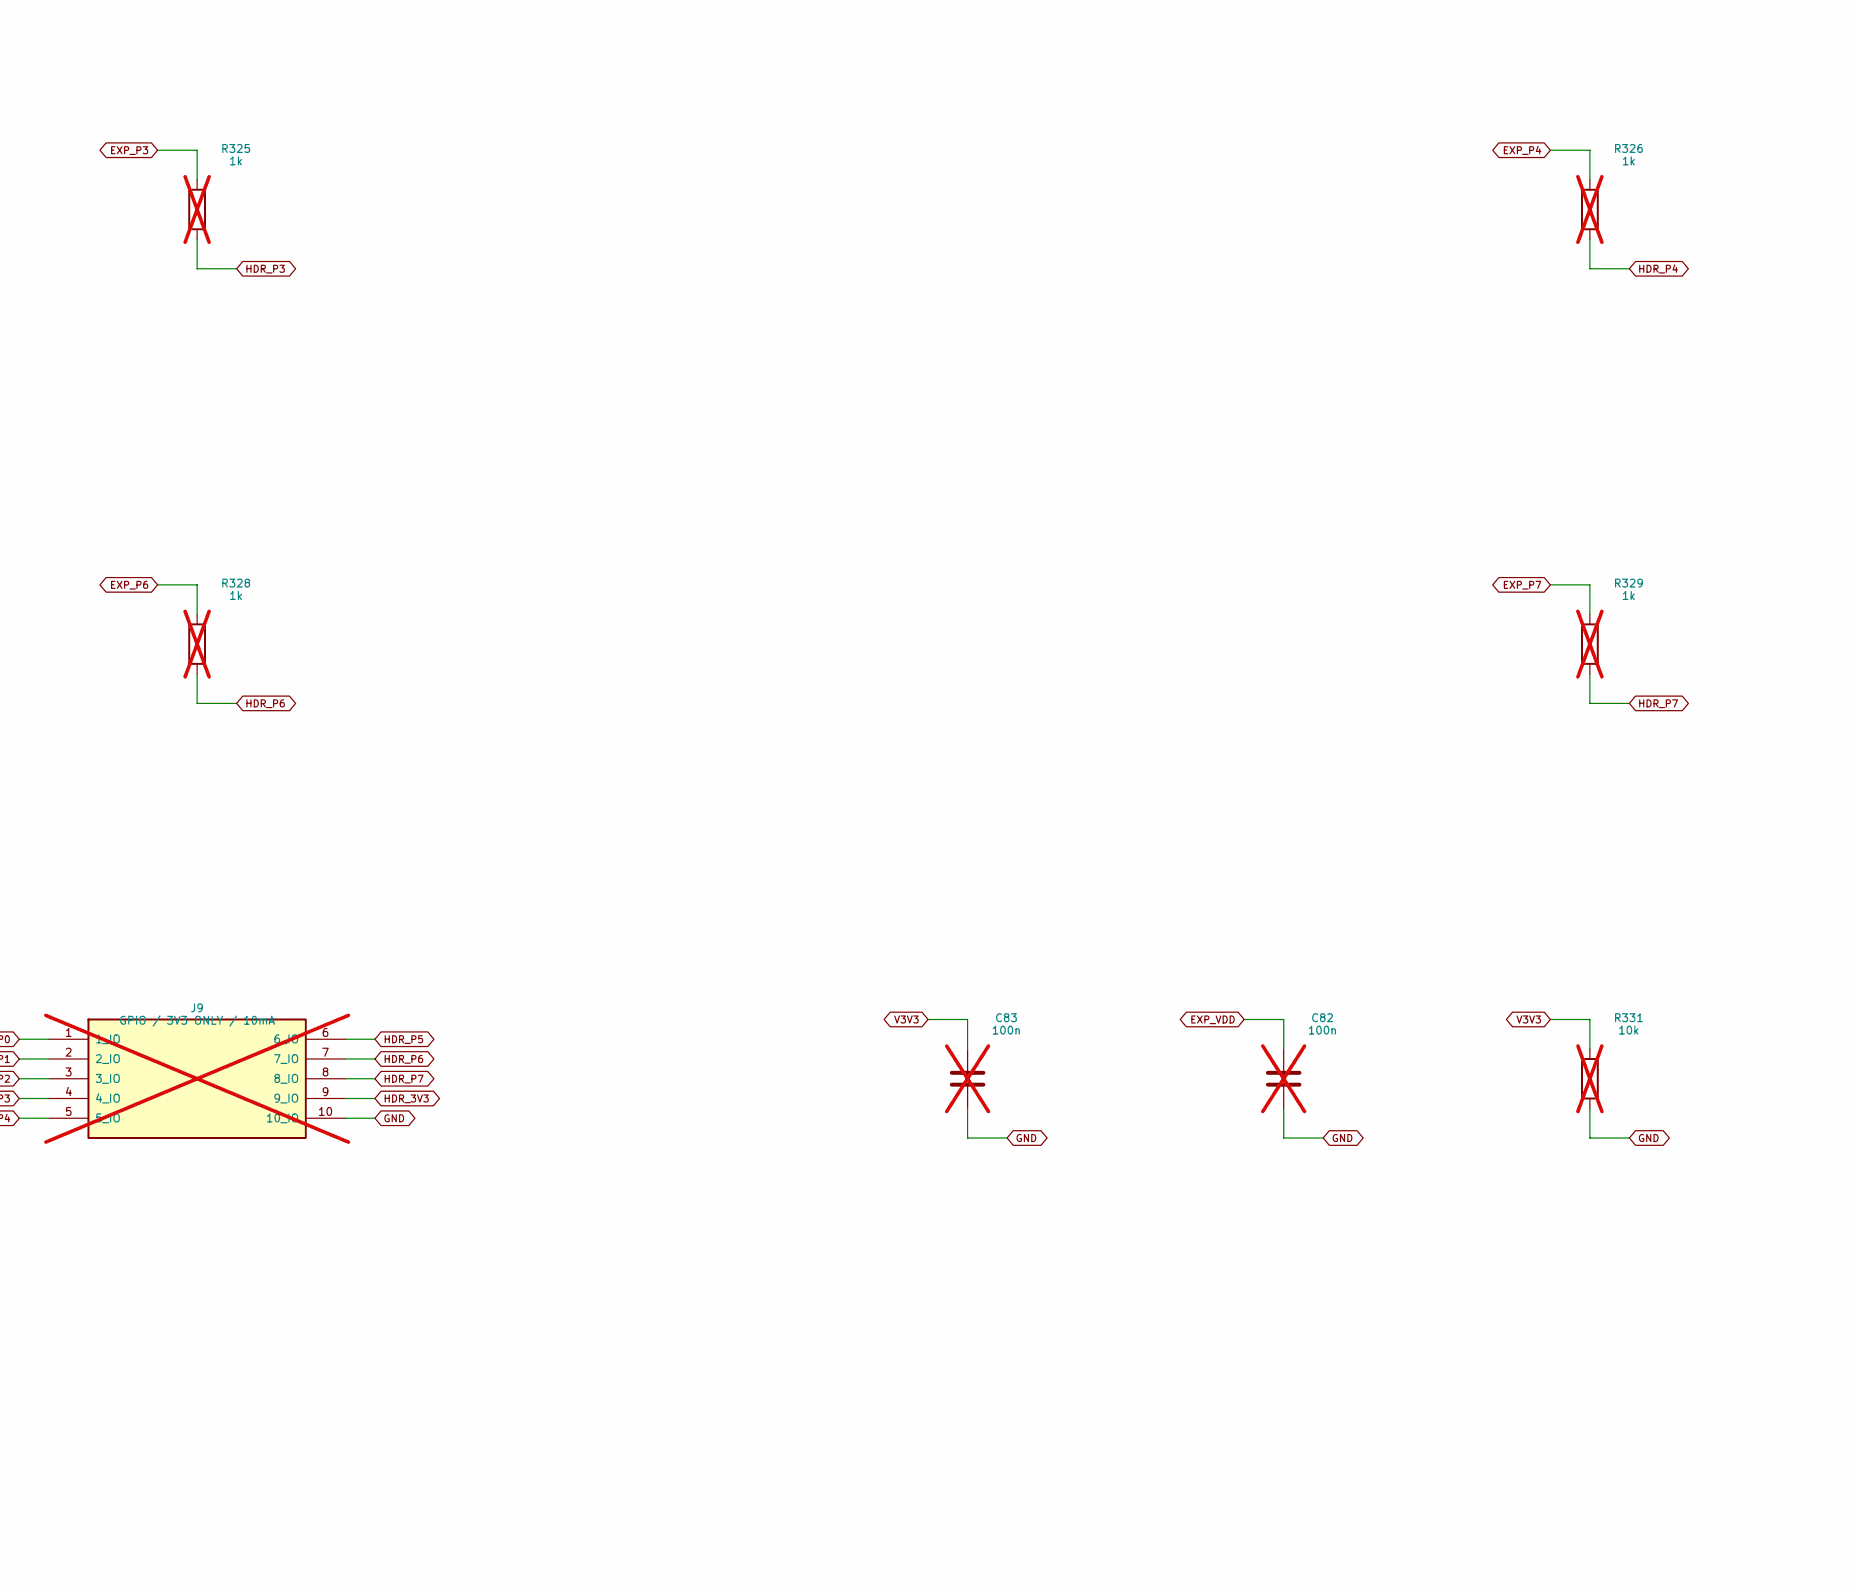
[picture p387: schematic 12_GPIO_expansion.kicad_sch, 12 GPIO expansion / 1, part in row 2, column 2]

Parts:
C80, C81, C82, C83: 100n; C_0603_1608Metric_CTL; MPN CL10B104KB8NNNC; not fitted
J9: GPIO / 3V3 ONLY / 10mA; PinHeader_2x05_P2.54mm_Vertical_L2; MPN 61301021121; not fitted
R320, R321: 4.7k; R_0603_1608Metric_CTL; MPN RC0603FR-074K7L; not fitted
R322, R323, R324, R325, R326, R327, R328, R329: 1k; R_0603_1608Metric_CTL; MPN RC0603FR-071KL; not fitted
R330: 22; R_2512_6332Metric_L2; MPN RC2512FK-0722RL; not fitted
R331: 10k; R_0603_1608Metric_CTL; MPN RC0603FR-0710KL; not fitted
U80: TCA9534APWR / 0x38; TSSOP-16_4.4x5mm_P0.65mm_CTL; MPN TCA9534APWR; not fitted
U81: TCA9517DR optional bus buffer; SOIC-8_3.9x4.9mm_P1.27mm_CTL; MPN TCA9517DR; not fitted
U82: LM66100DCKR reverse block; SOT-363_SC-70-6_CTL; MPN LM66100DCKR; not fitted

Connections:
EXP_P0: R322.1, U80.4 (4_P0)
EXP_P1: R323.1, U80.5 (5_P1)
EXP_P2: R324.1, U80.6 (6_P2)
EXP_P3: R325.1, U80.7 (7_P3)
EXP_P4: R326.1, U80.9 (9_P4)
EXP_P5: R327.1, U80.10 (10_P5)
EXP_P6: R328.1, U80.11 (11_P6)
EXP_P7: R329.1, U80.12 (12_P7)
EXP_SCL: R321.2, U80.14 (14_SCL), U81.7 (7_IO)
EXP_SDA: R320.2, U80.15 (15_SDA), U81.6 (6_IO)
EXP_VDD: C80.1, C82.1, R320.1, R321.1, R330.1, U80.16 (16_VCC), U81.5 (5_IO), U81.8 (8_IO), U82.3 (CE), U82.6 (VOUT)
GND: C80.2, C81.2, C82.2, C83.2, J9.10 (10_IO), R331.2, U80.1 (1_A0), U80.2 (2_A1), U80.3 (3_A2), U80.8 (8_GND), U81.4 (4_IO), U82.2 (GND), U82.5 (ST); also elsewhere on the board
HDR_3V3: J9.9 (9_IO), R330.2
HDR_P0: J9.1 (1_IO), R322.2
HDR_P1: J9.2 (2_IO), R323.2
HDR_P2: J9.3 (3_IO), R324.2
HDR_P3: J9.4 (4_IO), R325.2
HDR_P4: J9.5 (5_IO), R326.2
HDR_P5: J9.6 (6_IO), R327.2
HDR_P6: J9.7 (7_IO), R328.2
HDR_P7: J9.8 (8_IO), R329.2
RTC80_SCL: U81.2 (2_IO); also elsewhere on the board
RTC80_SDA: U81.3 (3_IO); also elsewhere on the board
V3V3: C81.1, C83.1, R331.1, U81.1 (1_IO), U82.1 (VIN); also elsewhere on the board

Notes on the sheet:
12 GPIO expansion / 1
M6-L2 candidate: REVIEW / ALL hardware measurements NOT RUN / no ordering or manufacture.

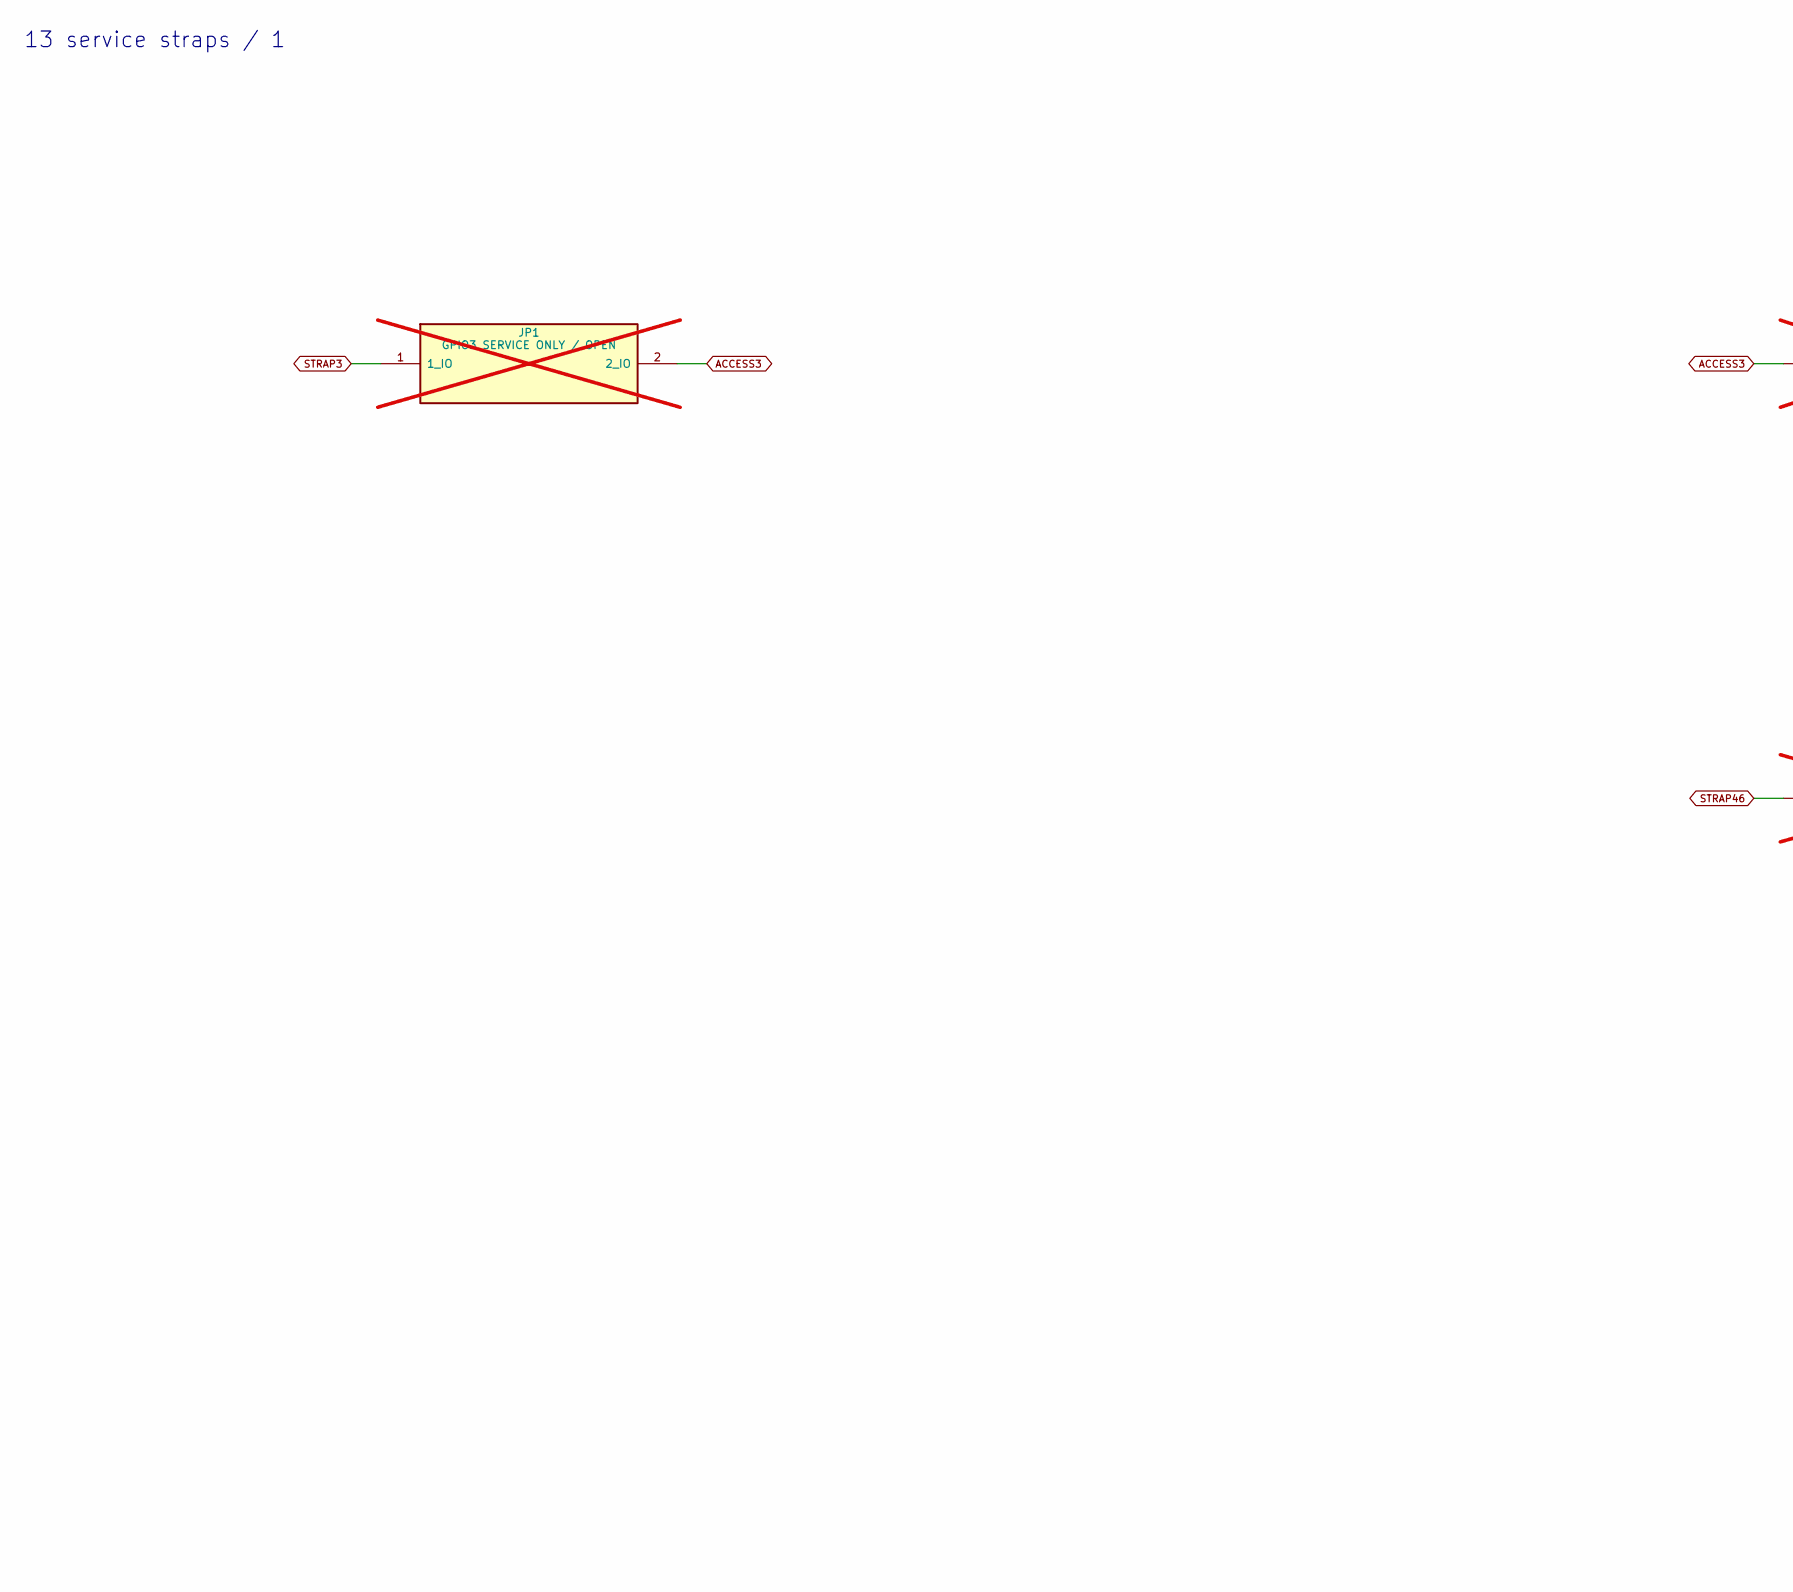
[picture p388: schematic 13_service_straps.kicad_sch, 13 service straps / 1, part in row 1, column 1]

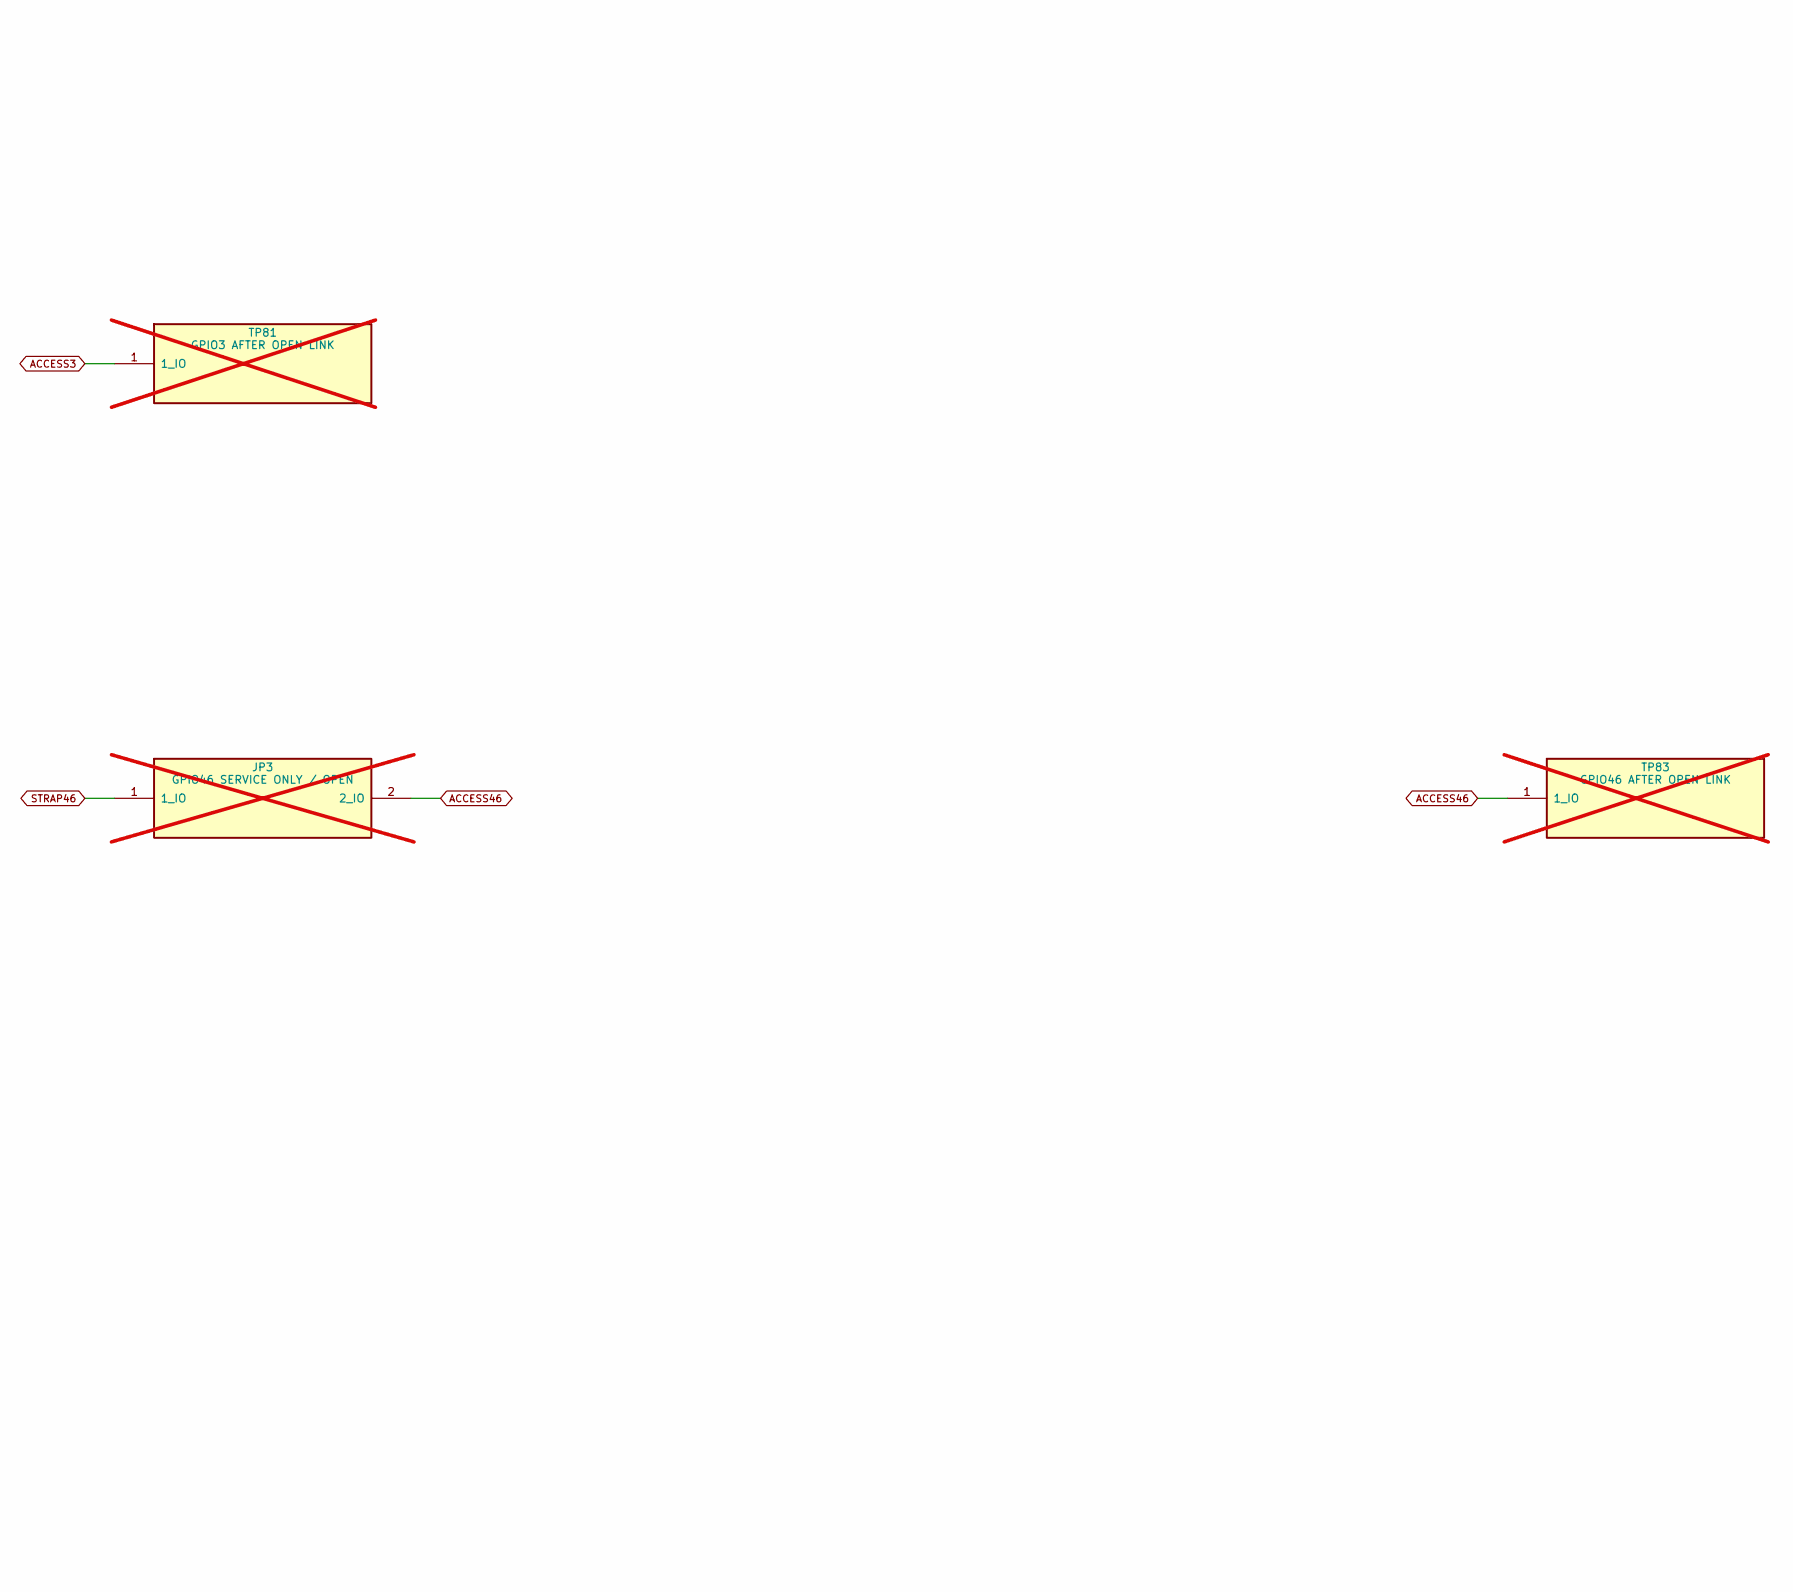
[picture p389: schematic 13_service_straps.kicad_sch, 13 service straps / 1, part in row 1, column 2]

Parts:
JP1: GPIO3 SERVICE ONLY / OPEN; SolderJumper-2_P1.3mm_Open_Pad1.0x1.5mm_L2; MPN PCB solder bridge (no purchased part); not fitted
JP3: GPIO46 SERVICE ONLY / OPEN; SolderJumper-2_P1.3mm_Open_Pad1.0x1.5mm_L2; MPN PCB solder bridge (no purchased part); not fitted
TP81: GPIO3 AFTER OPEN LINK; TestPoint_Pad_D1.0mm_CTL; MPN PCB pad (no purchased part); not fitted
TP83: GPIO46 AFTER OPEN LINK; TestPoint_Pad_D1.0mm_CTL; MPN PCB pad (no purchased part); not fitted

Connections:
ACCESS3: JP1.2 (2_IO), TP81.1
ACCESS46: JP3.2 (2_IO), TP83.1
STRAP3: JP1.1 (1_IO); also elsewhere on the board
STRAP46: JP3.1 (1_IO); also elsewhere on the board

Notes on the sheet:
13 service straps / 1
M6-L2 candidate: REVIEW / ALL hardware measurements NOT RUN / no ordering or manufacture.

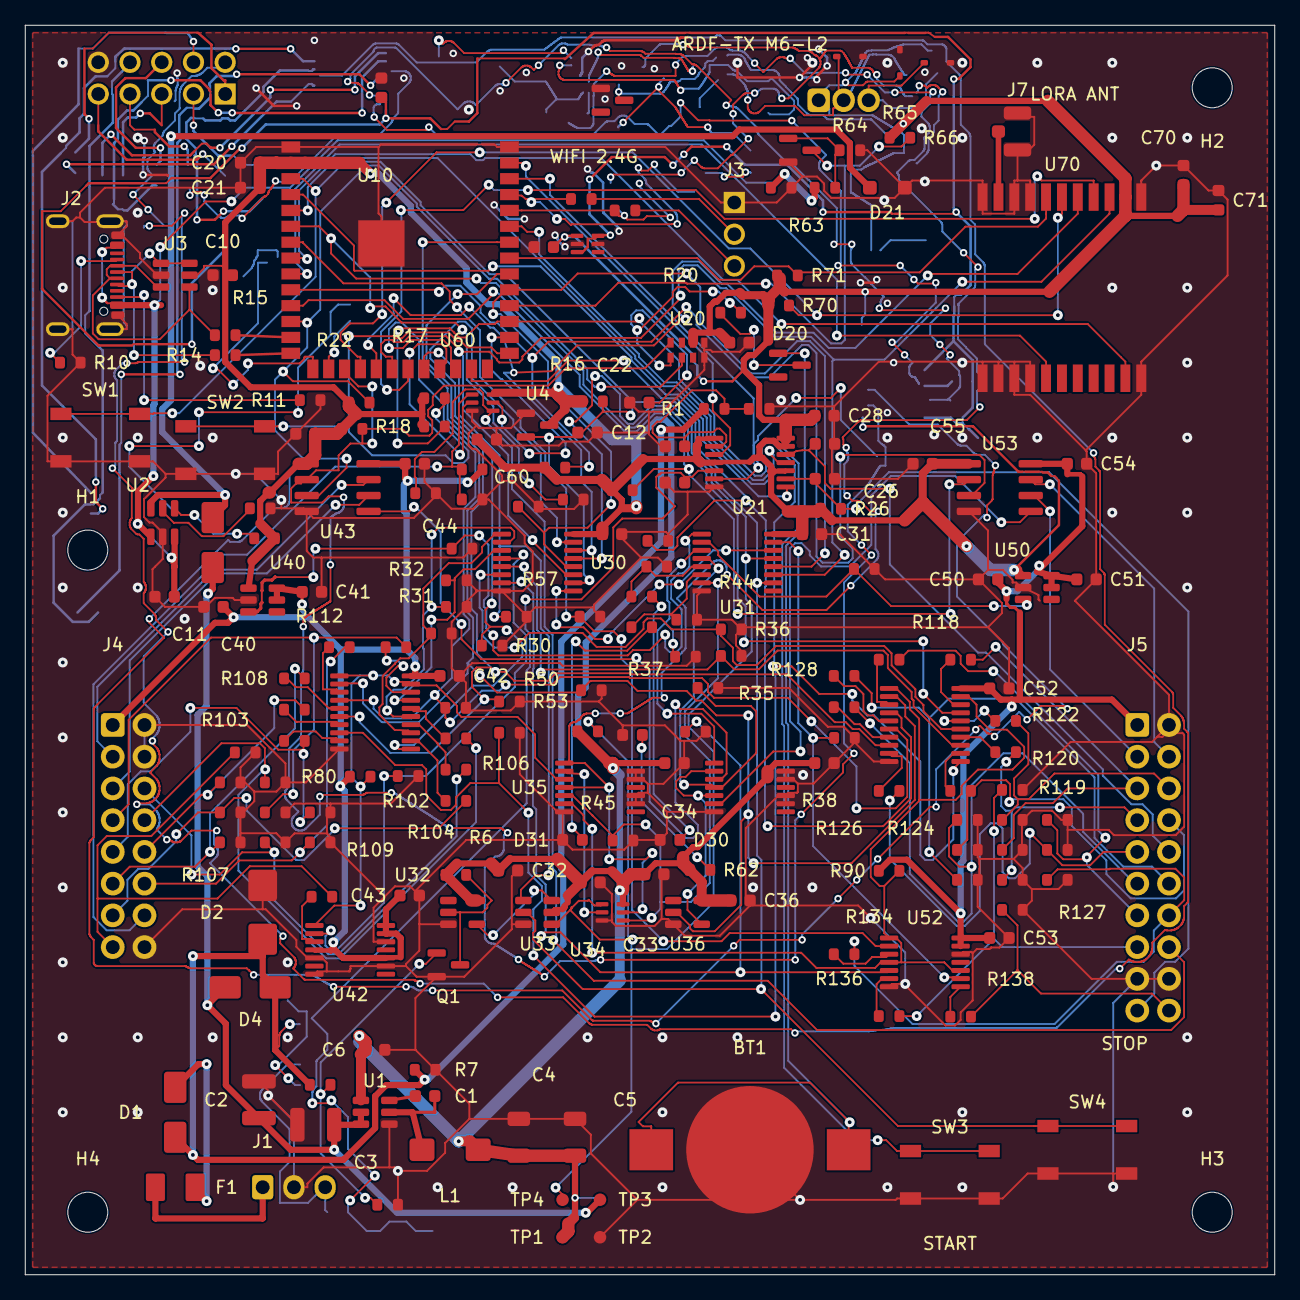
[picture p390: board CTRL.kicad_pcb from above]

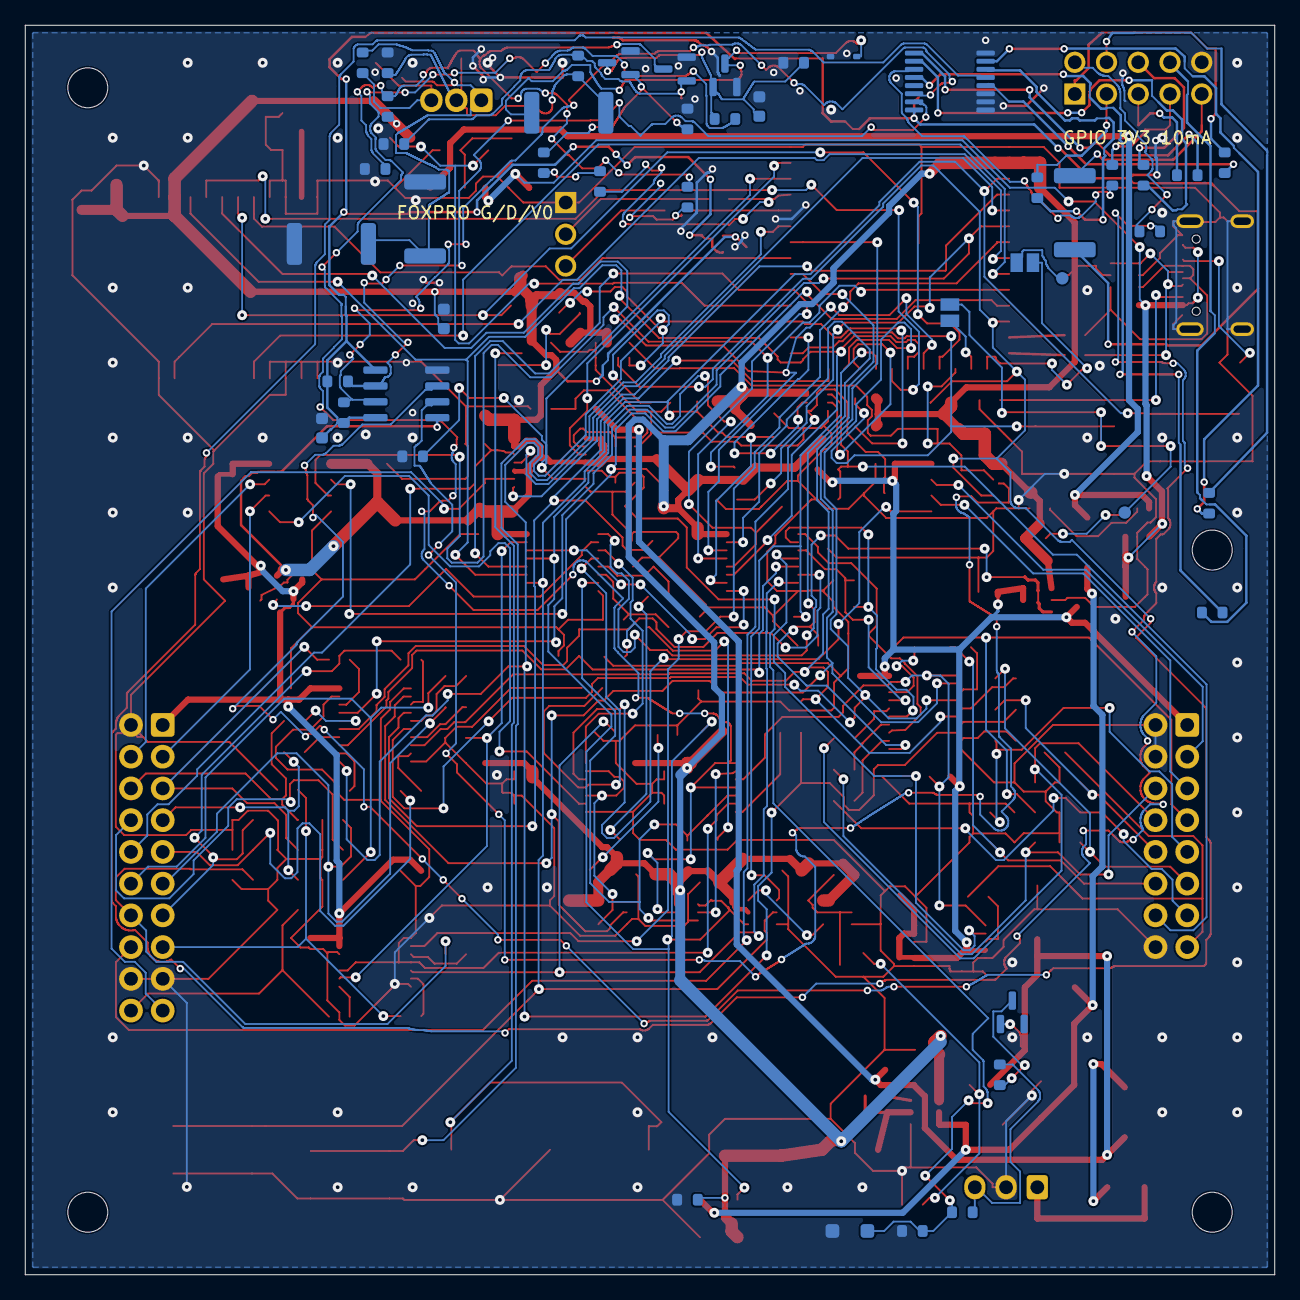
[picture p391: board CTRL.kicad_pcb from below]

Board: 2 copper layers, 100.0 x 100.0 mm, 256 parts (48 on the bottom side), 175 nets.

Other parts of the board:
H1, H2, H3, H4: MountingHole_3.2mm_M3; MountingHole_3.2mm_M3_CTL
