DD1SB/ARDF-TX/hardware/80m/production/RF80_V1.kicad_pcb

## KiCad design hardware/80m/production/RF80_V1.kicad_pcb (2026-10-18)

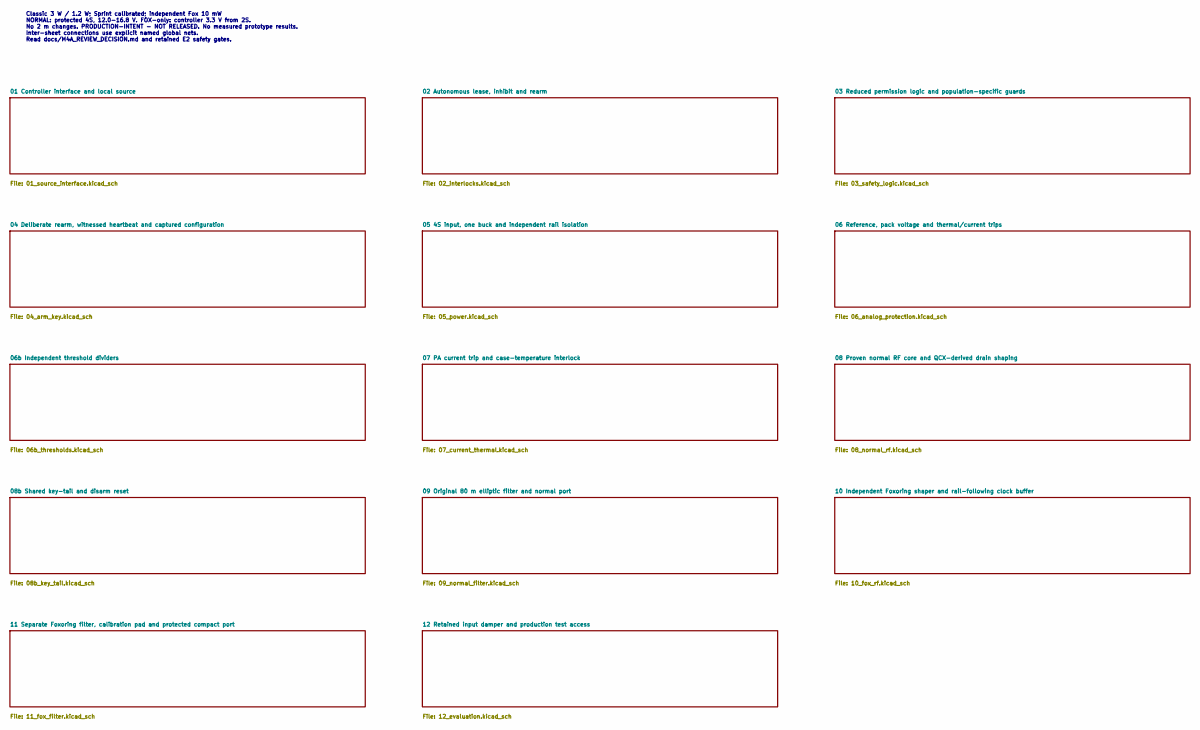
[picture p392: schematic RF80_V1.kicad_sch, RF80 V1 - production-intent, not released]

Notes on the sheet:
Classic 3 W / 1.2 W; Sprint calibrated; independent Fox 10 mW NORMAL: protected 4S, 12.0-16.8 V. FOX-only: controller 3.3 V from 2S. No 2 m changes. PRODUCTION-INTENT - NOT RELEASED. No measured prototype results. Inter-sheet connections use explicit named global nets. Read docs/M4A_REVIEW_DECISION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

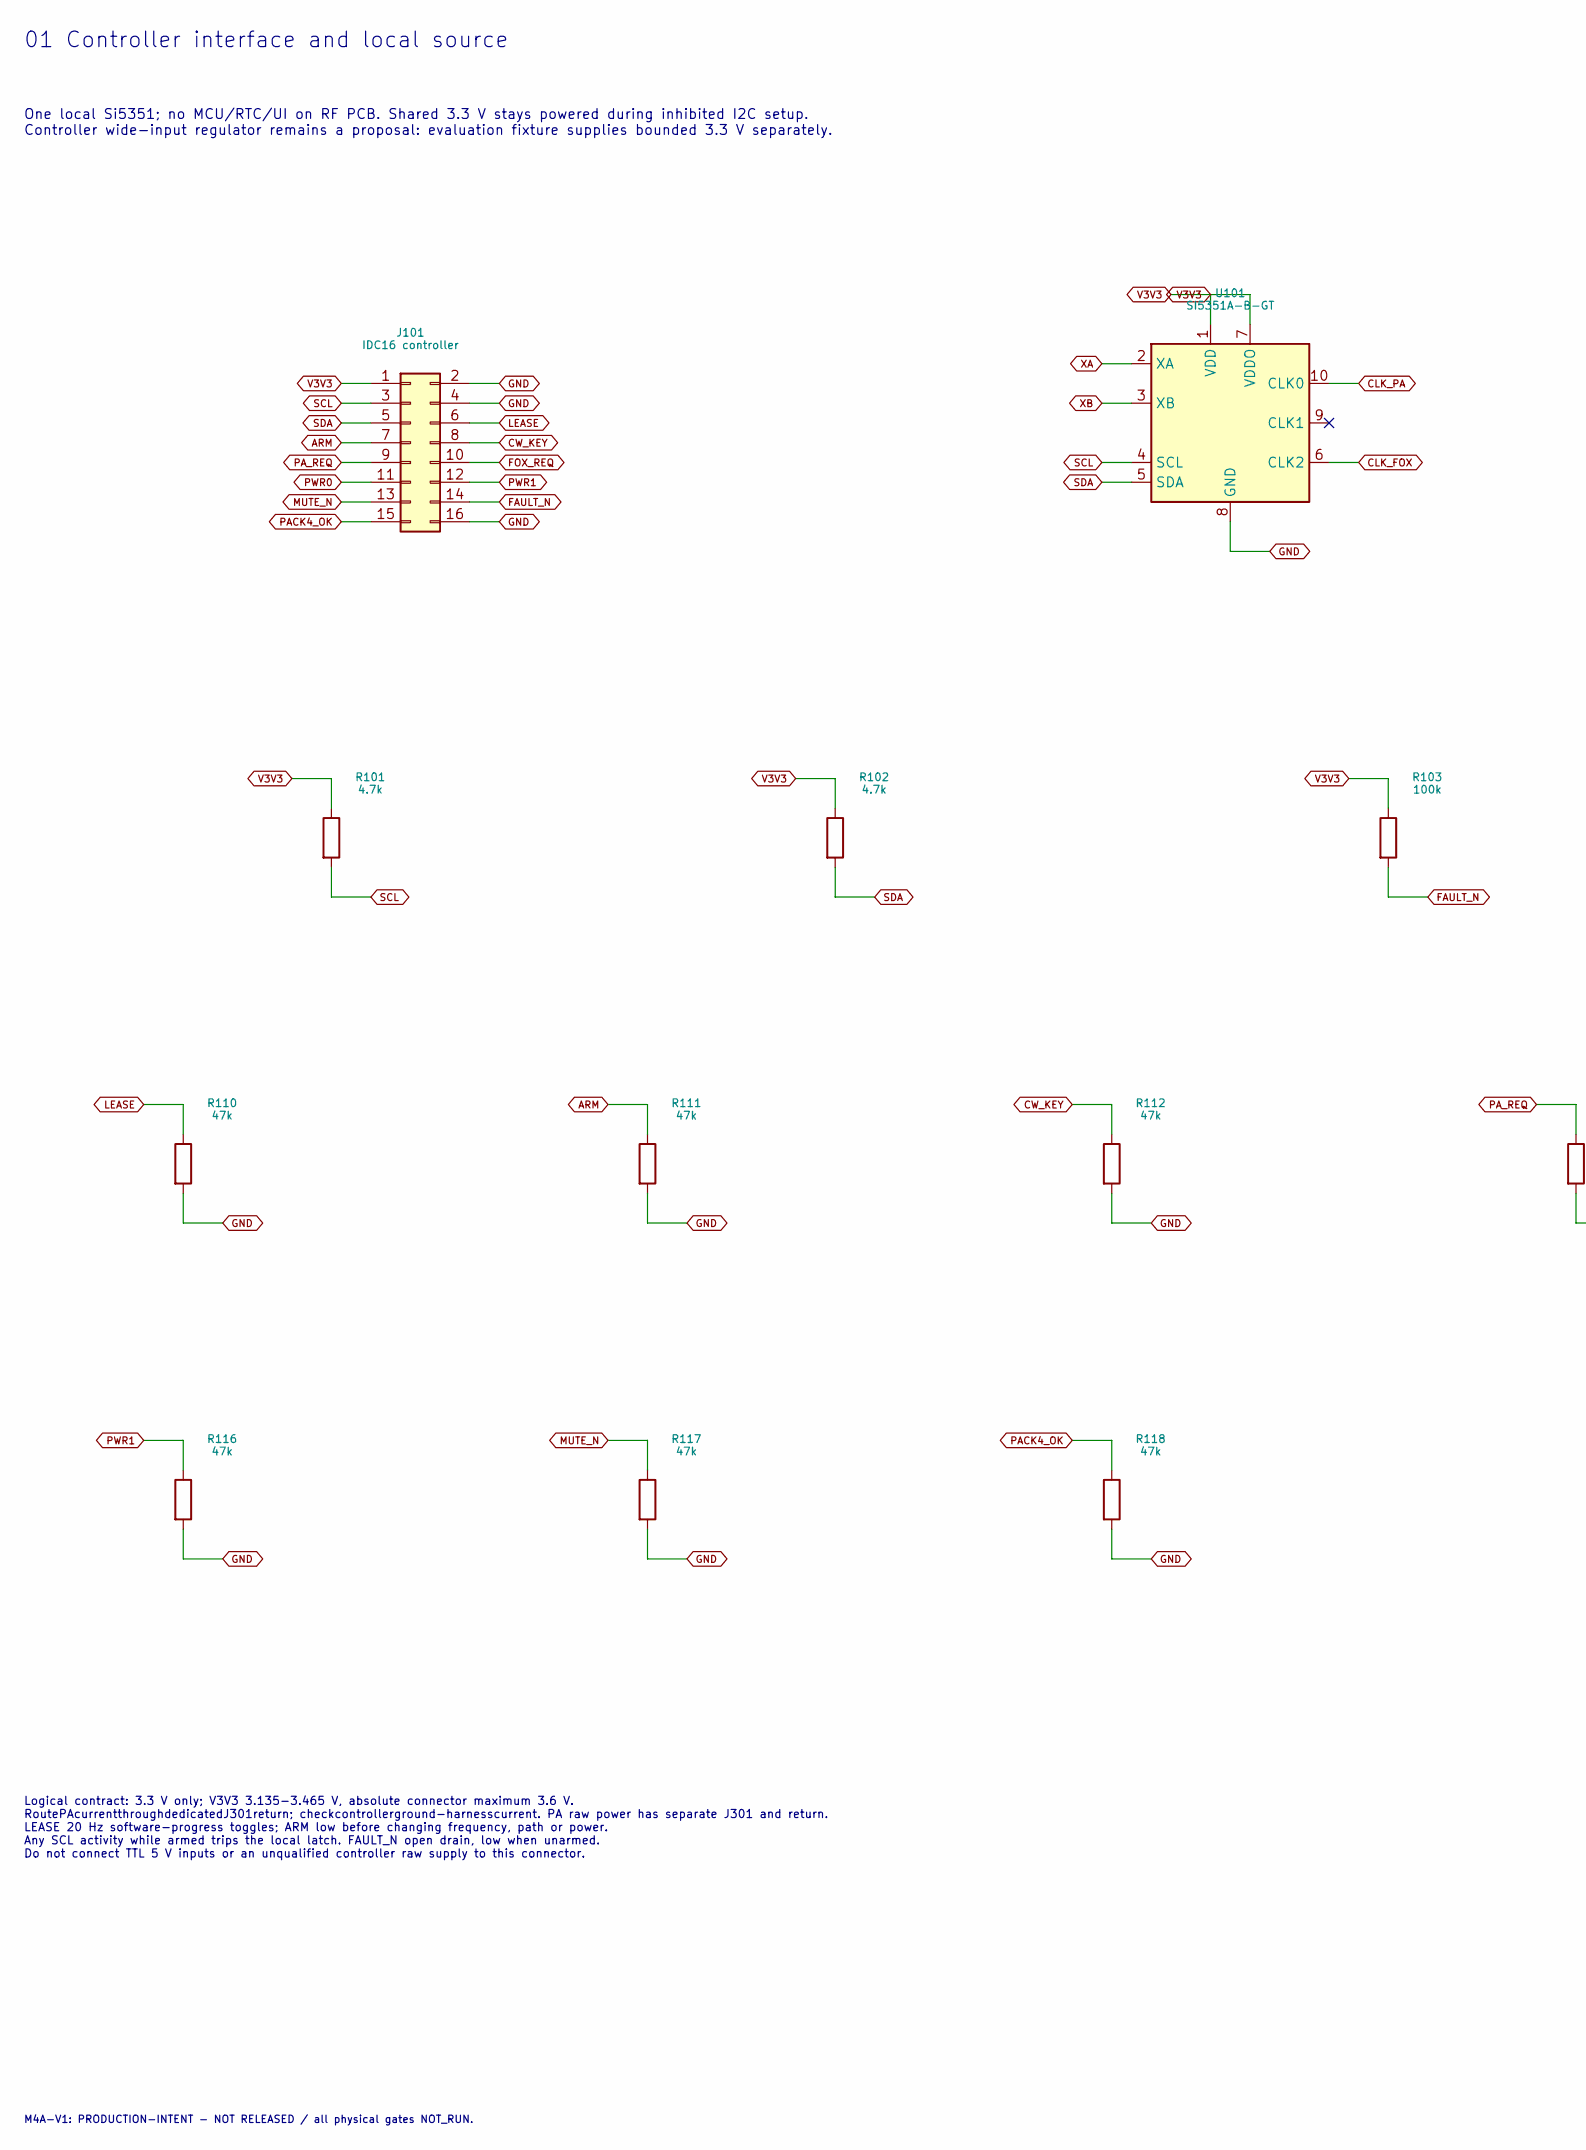
[picture p393: schematic 01_source_interface.kicad_sch, 01 Controller interface and local source, part in row 1, column 1]

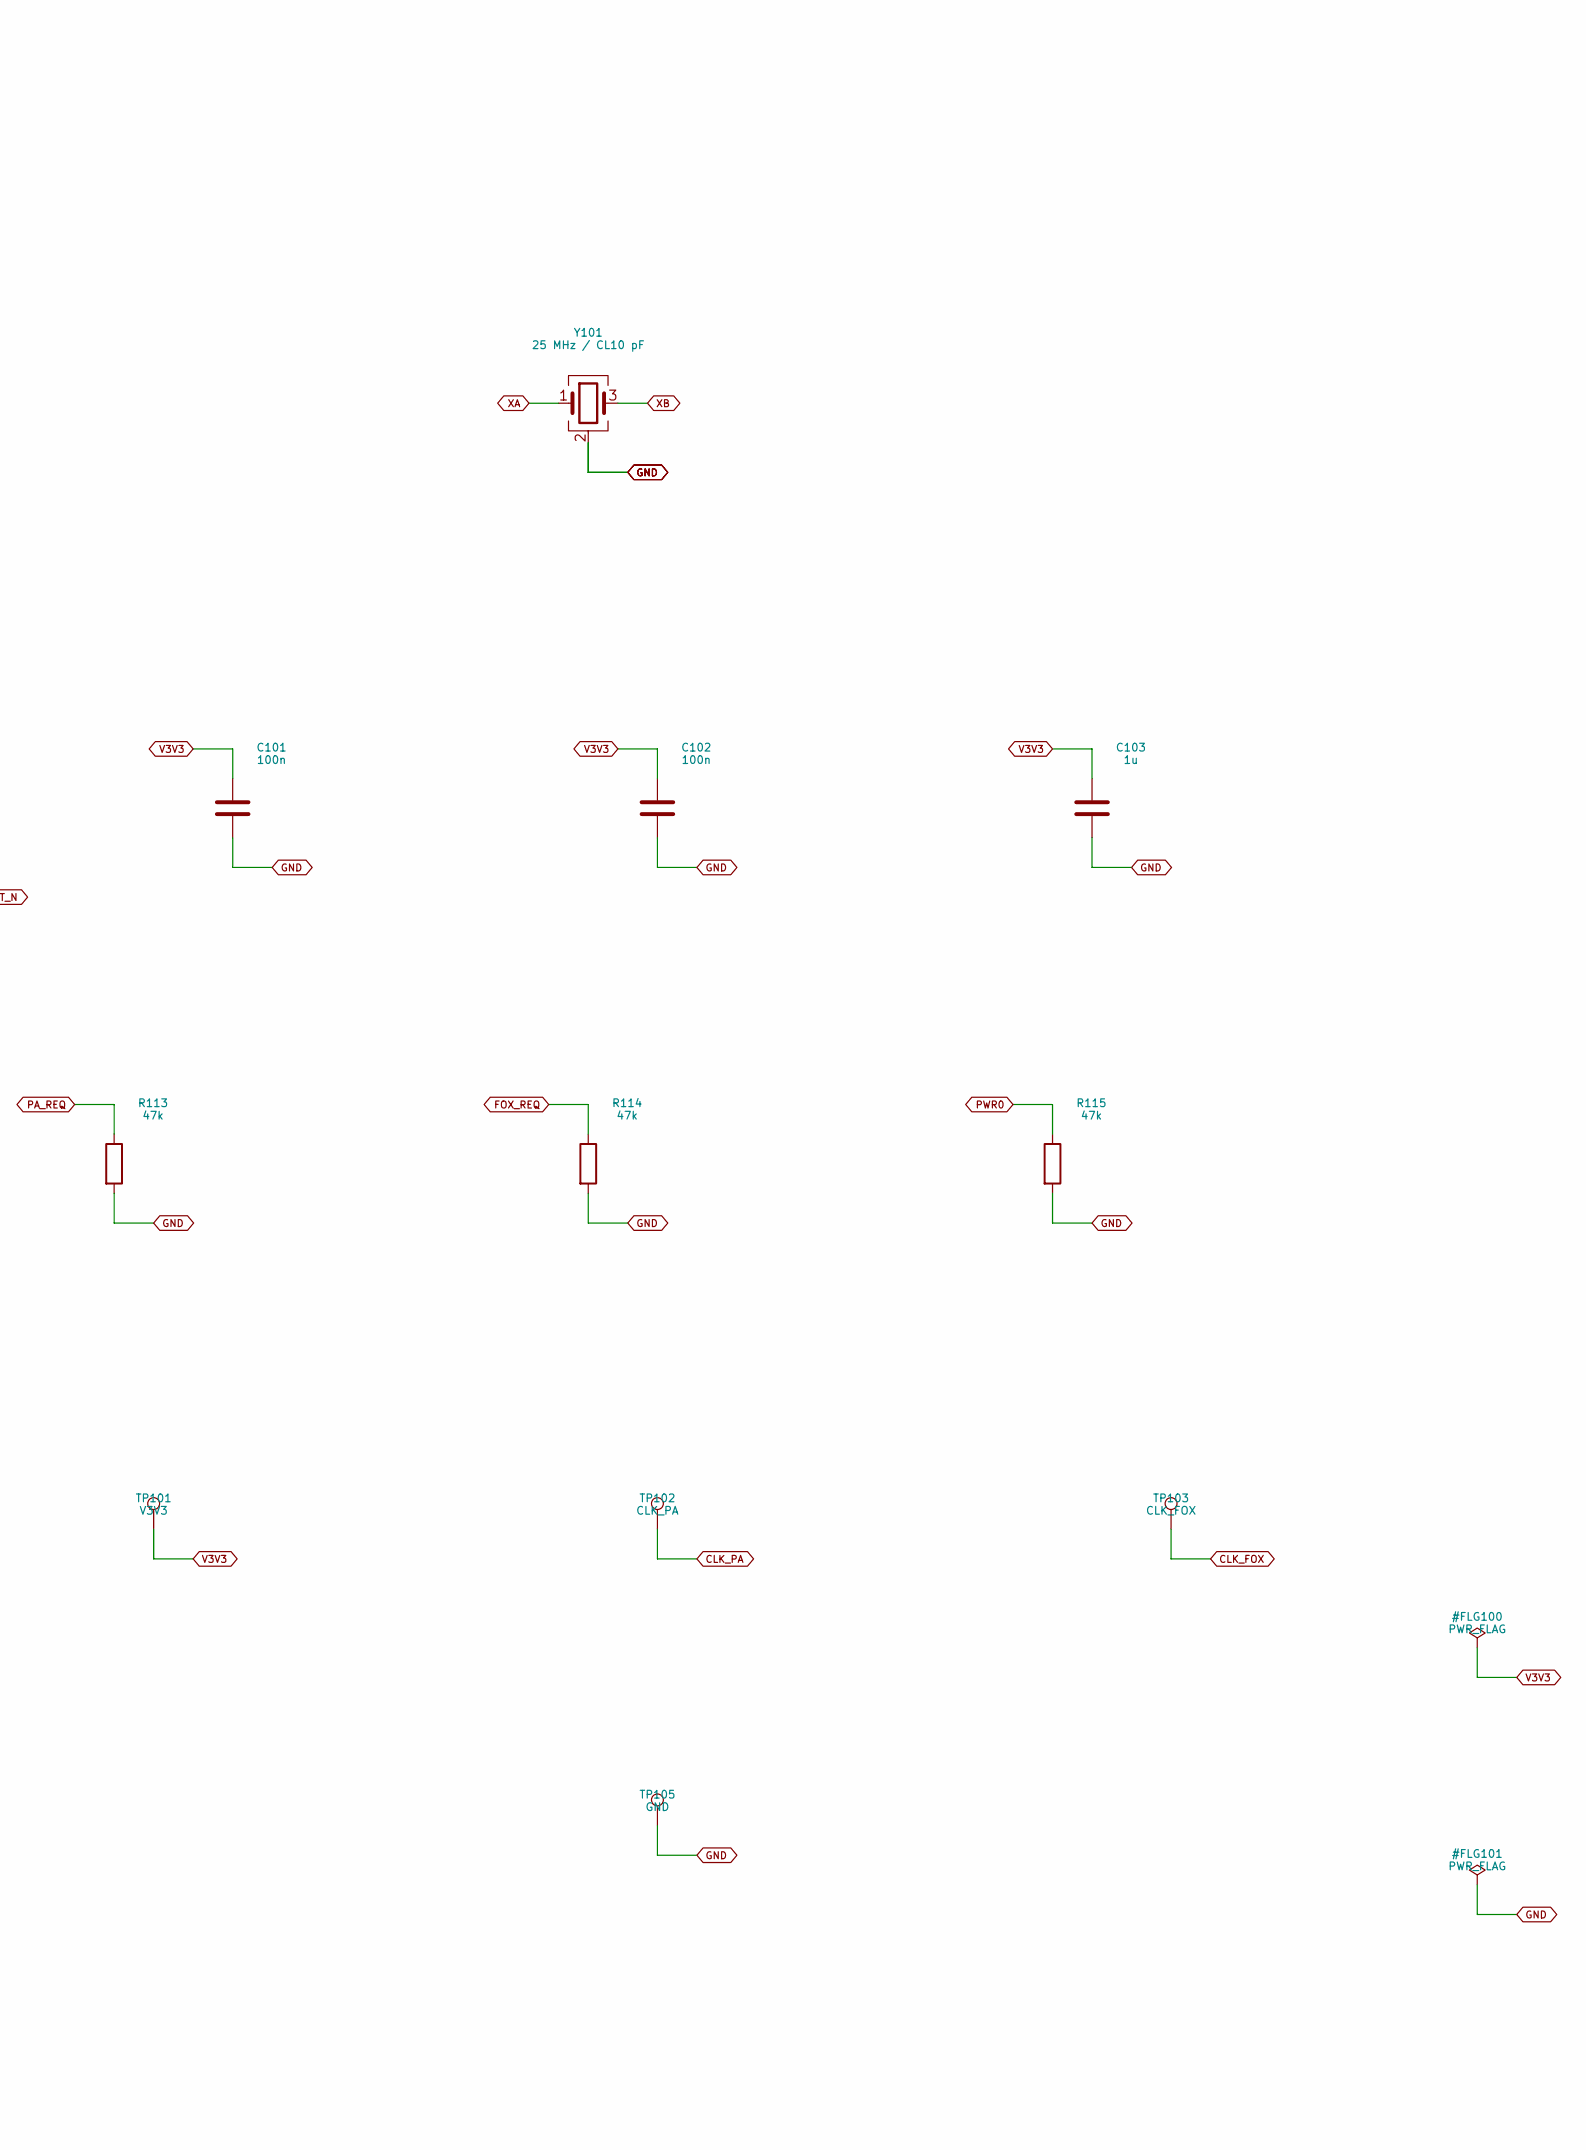
[picture p394: schematic 01_source_interface.kicad_sch, 01 Controller interface and local source, part in row 1, column 2]

Parts:
C101, C102: 100n; C_0603_1608Metric; MPN CC0603KRX7R8BB104
C103: 1u; C_0805_2012Metric; MPN CC0805KKX7R9BB105
J101: IDC16 controller; Wurth_61201621621; MPN Wurth 61201621621
R101, R102: 4.7k; R_0603_1608Metric; MPN RC0603FR-074K7L
R103: 100k; R_0603_1608Metric; MPN RC0603FR-07100KL
R110, R111, R112, R113, R114, R115, R116, R117, R118: 47k; R_0603_1608Metric; MPN RC0603FR-0747KL
TP101: V3V3; TestPoint_Pad_D1.0mm; MPN PCB pad / no purchased component
TP102: CLK_PA; TestPoint_Pad_D1.0mm; MPN PCB pad / no purchased component
TP103: CLK_FOX; TestPoint_Pad_D1.0mm; MPN PCB pad / no purchased component
TP105: GND; TestPoint_Pad_D1.0mm; MPN PCB pad / no purchased component
U101: SI5351A-B-GT; MSOP-10_3x3mm_P0.5mm; MPN SI5351A-B-GT
Y101: 25 MHz / CL10 pF; Crystal_SMD_5032-4Pin_5.0x3.2mm; MPN ABM3B-25.000MHZ-10-1-U-T

Connections:
ARM: J101.7, R111.1; also elsewhere on the board
CLK_FOX: TP103.1, U101.6 (CLK2); also elsewhere on the board
CLK_PA: TP102.1, U101.10 (CLK0); also elsewhere on the board
CW_KEY: J101.8, R112.1; also elsewhere on the board
FAULT_N: J101.14, R103.2; also elsewhere on the board
FOX_REQ: J101.10, R114.1; also elsewhere on the board
GND: C101.2, C102.2, C103.2, J101.2, J101.4, J101.16, R110.2, R111.2, R112.2, R113.2, R114.2, R115.2, R116.2, R117.2, R118.2, TP105.1, U101.8 (GND), Y101.2 (G), Y101.4 (G); also elsewhere on the board
LEASE: J101.6, R110.1; also elsewhere on the board
MUTE_N: J101.13, R117.1; also elsewhere on the board
PACK4_OK: J101.15, R118.1; also elsewhere on the board
PA_REQ: J101.9, R113.1; also elsewhere on the board
PWR0: J101.11, R115.1; also elsewhere on the board
PWR1: J101.12, R116.1; also elsewhere on the board
SCL: J101.3, R101.2, U101.4 (SCL); also elsewhere on the board
SDA: J101.5, R102.2, U101.5 (SDA); also elsewhere on the board
V3V3: C101.1, C102.1, C103.1, J101.1, R101.1, R102.1, R103.1, TP101.1, U101.1 (VDD), U101.7 (VDDO); also elsewhere on the board
XA: U101.2 (XA), Y101.1
XB: U101.3 (XB), Y101.3

Notes on the sheet:
01 Controller interface and local source
One local Si5351; no MCU/RTC/UI on RF PCB. Shared 3.3 V stays powered during inhibited I2C setup. Controller wide-input regulator remains a proposal: evaluation fixture supplies bounded 3.3 V separately.
Logical contract: 3.3 V only; V3V3 3.135-3.465 V, absolute connector maximum 3.6 V. RoutePAcurrentthroughdedicatedJ301return; checkcontrollerground-harnesscurrent. PA raw power has separate J301 and return. LEASE 20 Hz software-progress toggles; ARM low before changing frequency, path or power. Any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
M4A-V1: PRODUCTION-INTENT - NOT RELEASED / all physical gates NOT_RUN.

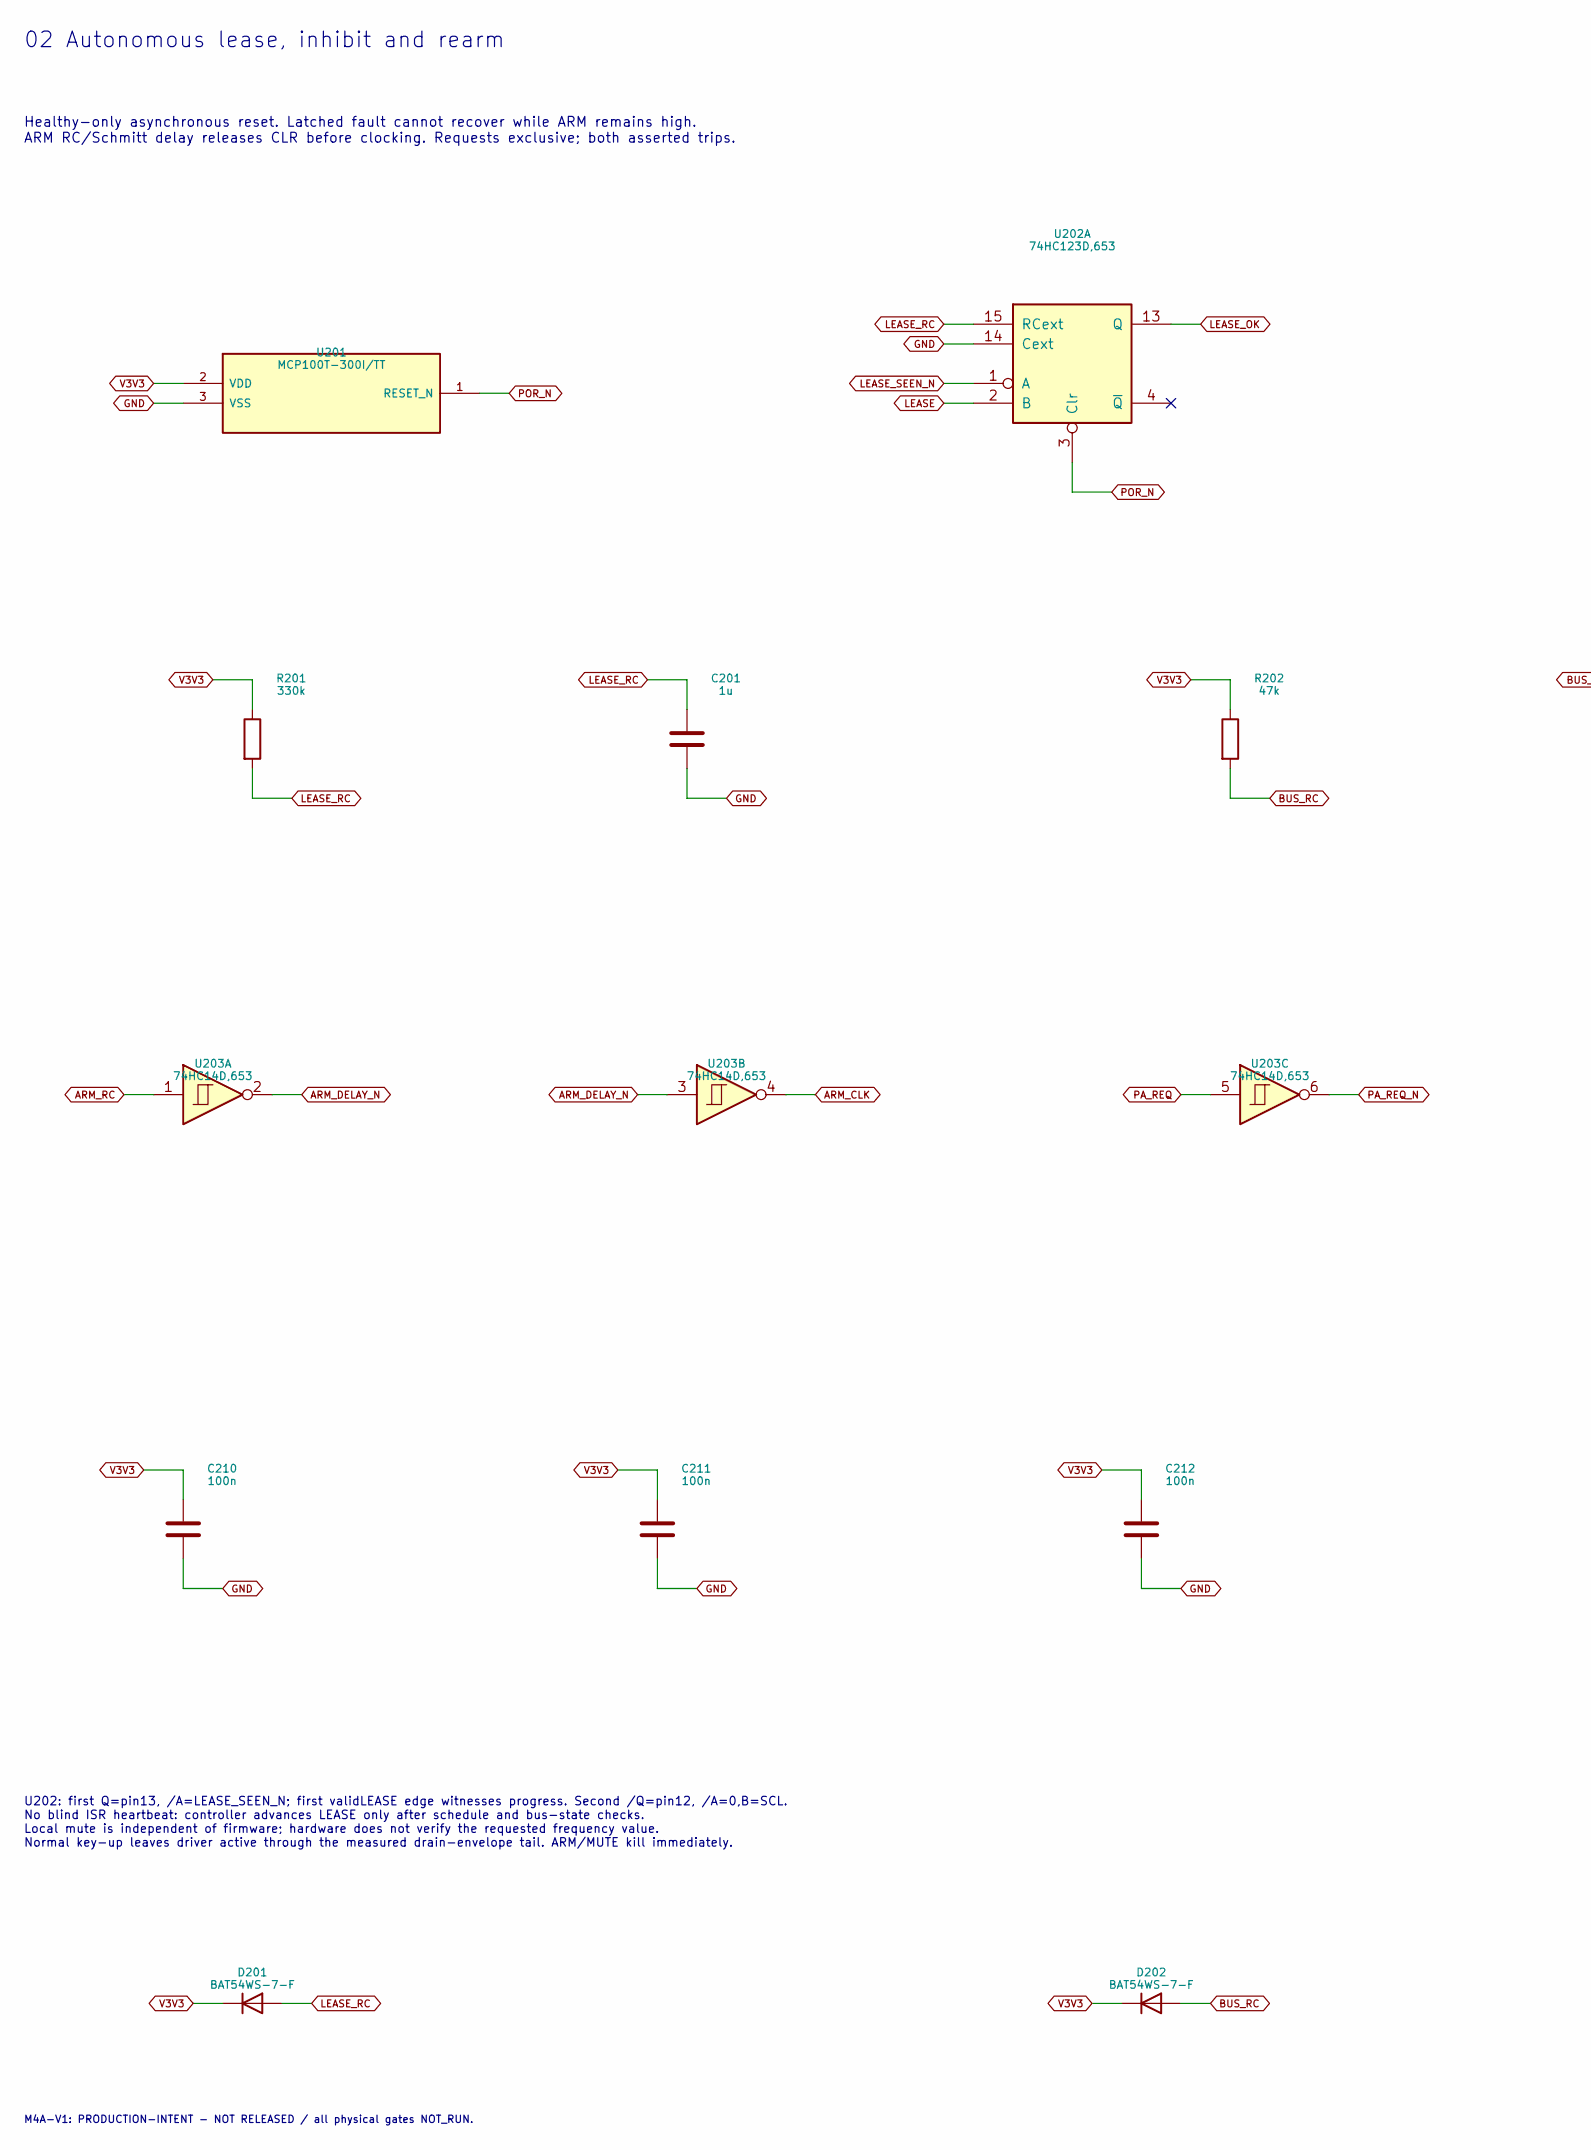
[picture p395: schematic 02_interlocks.kicad_sch, 02 Autonomous lease, inhibit and rearm, part in row 1, column 1]

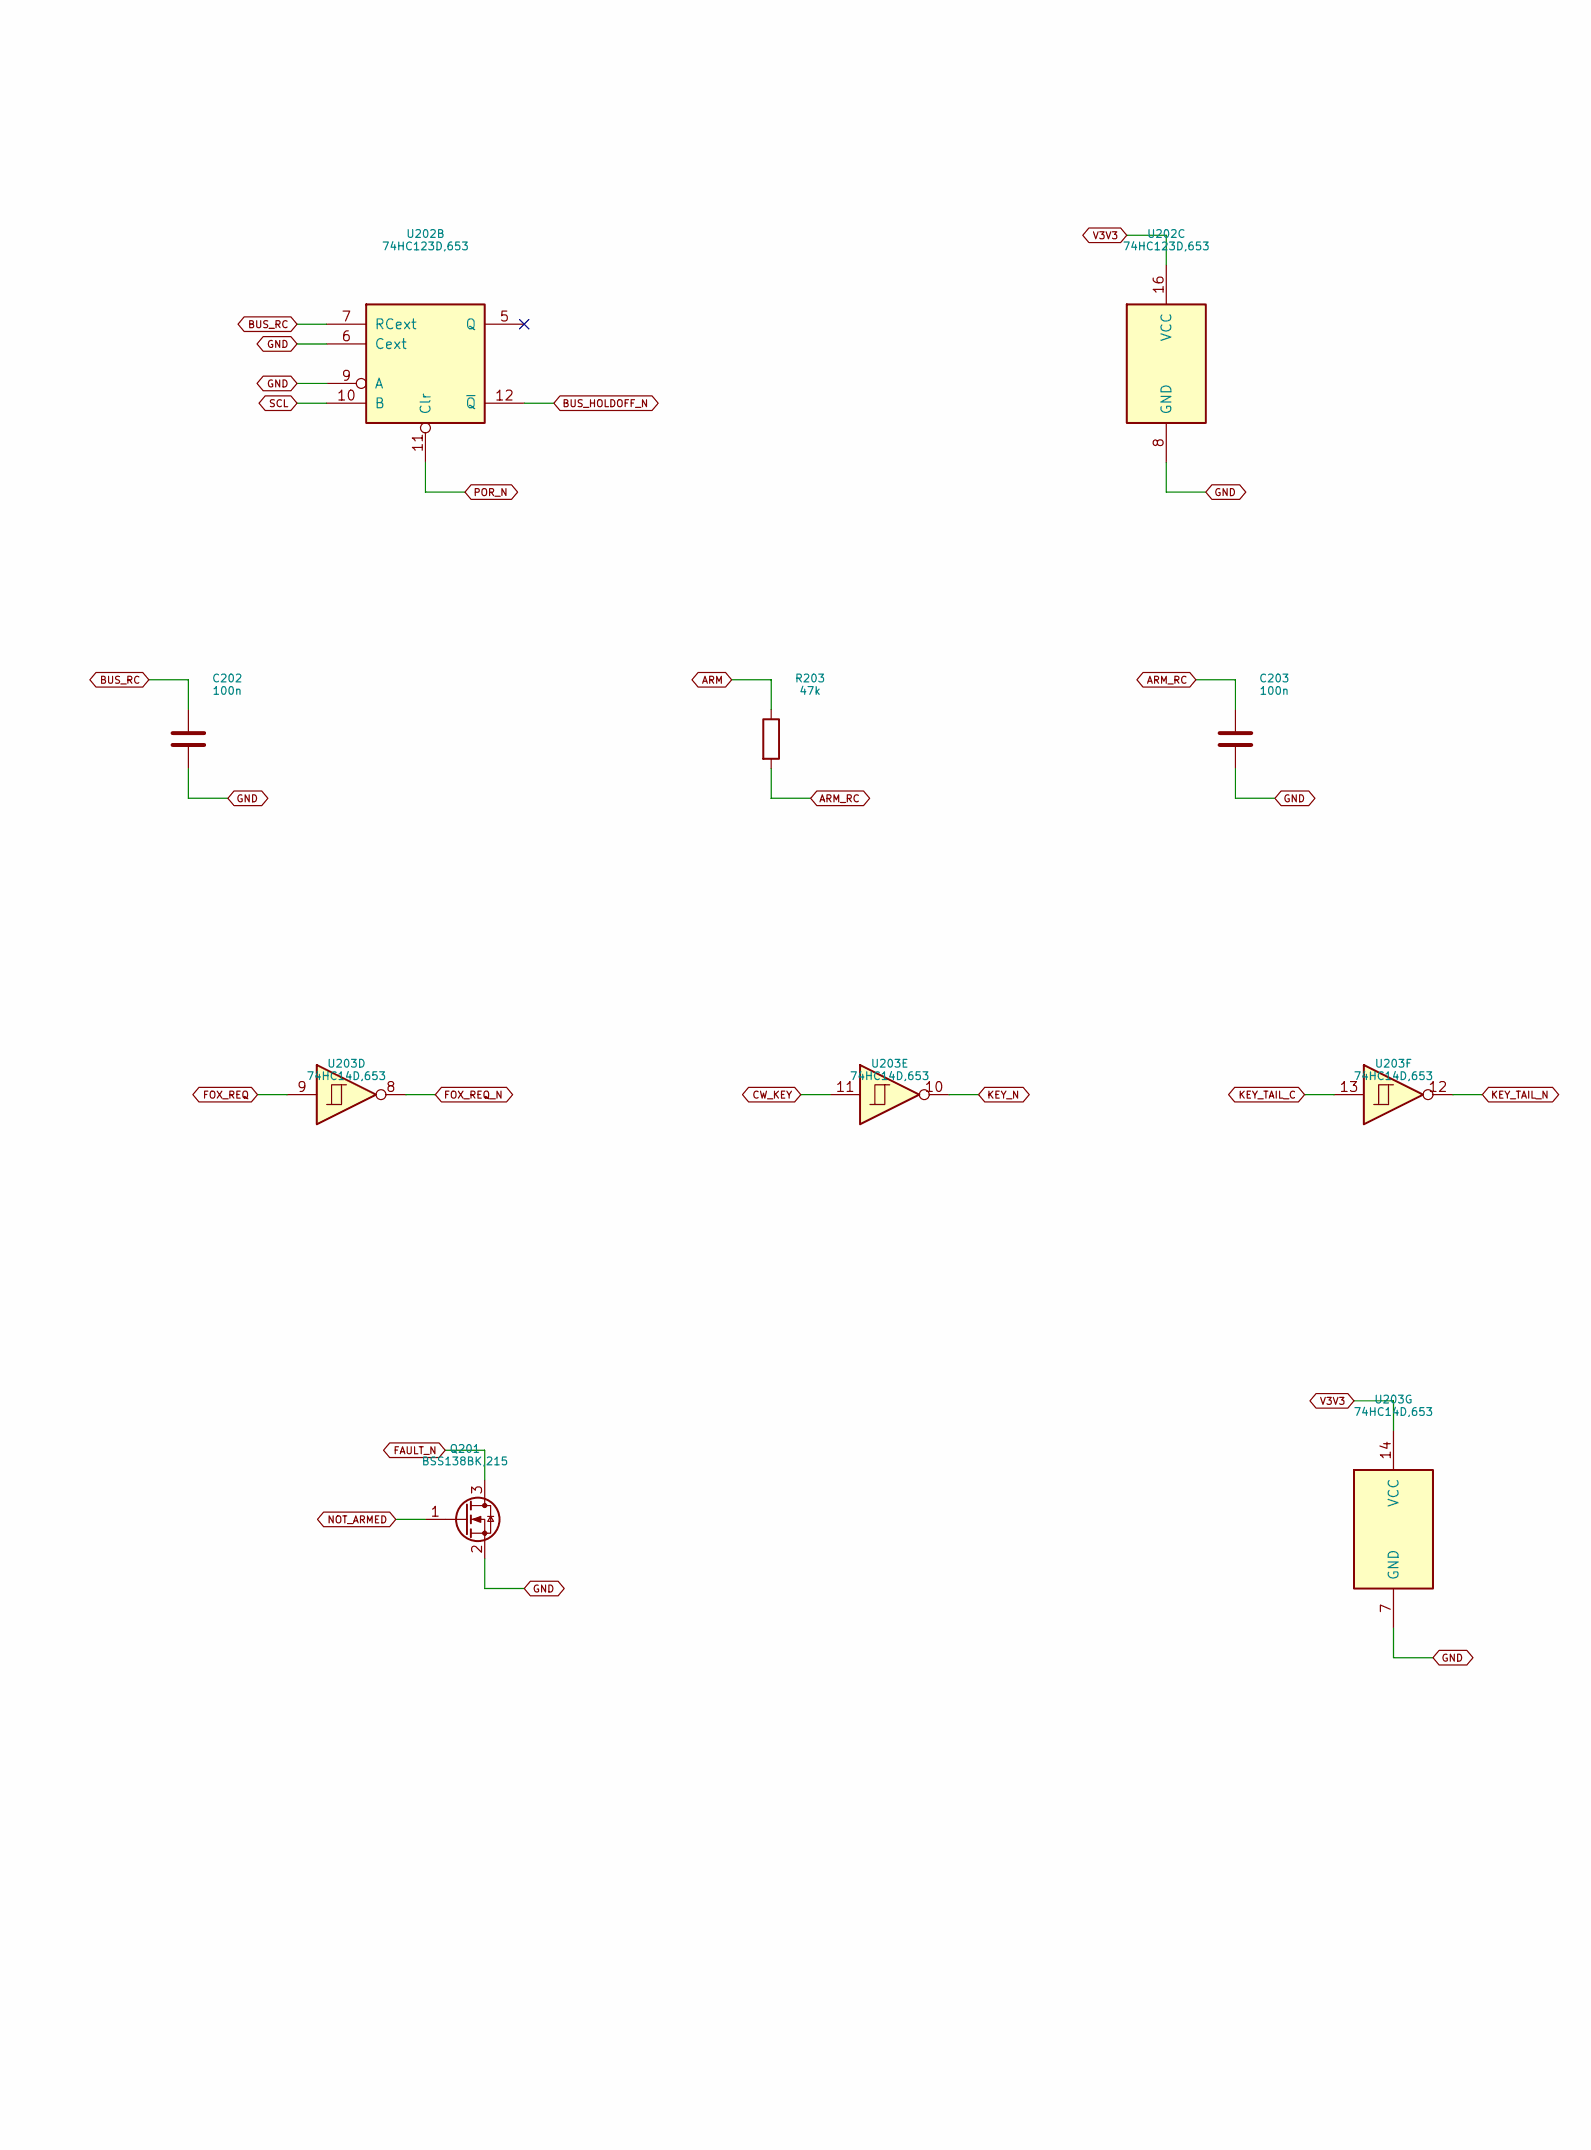
[picture p396: schematic 02_interlocks.kicad_sch, 02 Autonomous lease, inhibit and rearm, part in row 1, column 2]

Parts:
C201: 1u; C_0805_2012Metric; MPN CC0805KKX7R9BB105
C202, C203, C210, C211, C212: 100n; C_0603_1608Metric; MPN CC0603KRX7R8BB104
D201, D202: BAT54WS-7-F; D_SOD-323; MPN BAT54WS-7-F
Q201: BSS138BK,215; SOT-23; MPN BSS138BK,215
R201: 330k; R_0603_1608Metric; MPN RC0603FR-07330KL
R202, R203: 47k; R_0603_1608Metric; MPN RC0603FR-0747KL
U201: MCP100T-300I/TT; SOT-23; MPN MCP100T-300I/TT
U202: 74HC123D,653; SOIC-16_3.9x9.9mm_P1.27mm; MPN 74HC123D,653
U203: 74HC14D,653; SOIC-14_3.9x8.7mm_P1.27mm; MPN 74HC14D,653

Connections:
ARM: R203.1; also elsewhere on the board
ARM_CLK: U203.4; also elsewhere on the board
ARM_DELAY_N: U203.2, U203.3
ARM_RC: C203.1, R203.2, U203.1
BUS_HOLDOFF_N: U202.12 (~Q); also elsewhere on the board
BUS_RC: C202.1, D202.2 (A), R202.2, U202.7 (RCext)
CW_KEY: U203.11; also elsewhere on the board
FAULT_N: Q201.3 (D); also elsewhere on the board
FOX_REQ: U203.9; also elsewhere on the board
FOX_REQ_N: U203.8; also elsewhere on the board
GND: C201.2, C202.2, C203.2, C210.2, C211.2, C212.2, Q201.2 (S), U201.3 (VSS), U202.6 (Cext), U202.8 (GND), U202.9 (A), U202.14 (Cext), U203.7 (GND); also elsewhere on the board
KEY_N: U203.10; also elsewhere on the board
KEY_TAIL_C: U203.13; also elsewhere on the board
KEY_TAIL_N: U203.12; also elsewhere on the board
LEASE: U202.2 (B); also elsewhere on the board
LEASE_OK: U202.13 (Q); also elsewhere on the board
LEASE_RC: C201.1, D201.2 (A), R201.2, U202.15 (RCext)
LEASE_SEEN_N: U202.1 (A); also elsewhere on the board
NOT_ARMED: Q201.1 (G); also elsewhere on the board
PA_REQ: U203.5; also elsewhere on the board
PA_REQ_N: U203.6; also elsewhere on the board
POR_N: U201.1 (RESET_N), U202.3 (Clr), U202.11 (Clr); also elsewhere on the board
SCL: U202.10 (B); also elsewhere on the board
V3V3: C210.1, C211.1, C212.1, D201.1 (K), D202.1 (K), R201.1, R202.1, U201.2 (VDD), U202.16 (VCC), U203.14 (VCC); also elsewhere on the board

Notes on the sheet:
02 Autonomous lease, inhibit and rearm
Healthy-only asynchronous reset. Latched fault cannot recover while ARM remains high. ARM RC/Schmitt delay releases CLR before clocking. Requests exclusive; both asserted trips.
U202: first Q=pin13, /A=LEASE_SEEN_N; first validLEASE edge witnesses progress. Second /Q=pin12, /A=0,B=SCL. No blind ISR heartbeat: controller advances LEASE only after schedule and bus-state checks. Local mute is independent of firmware; hardware does not verify the requested frequency value. Nor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
M4A-V1: PRODUCTION-INTENT - NOT RELEASED / all physical gates NOT_RUN.
