DD1SB/ARDF-TX/hardware/80m/production/RF80_V1.kicad_pcb

## KiCad design hardware/80m/production/RF80_V1.kicad_pcb (continued)

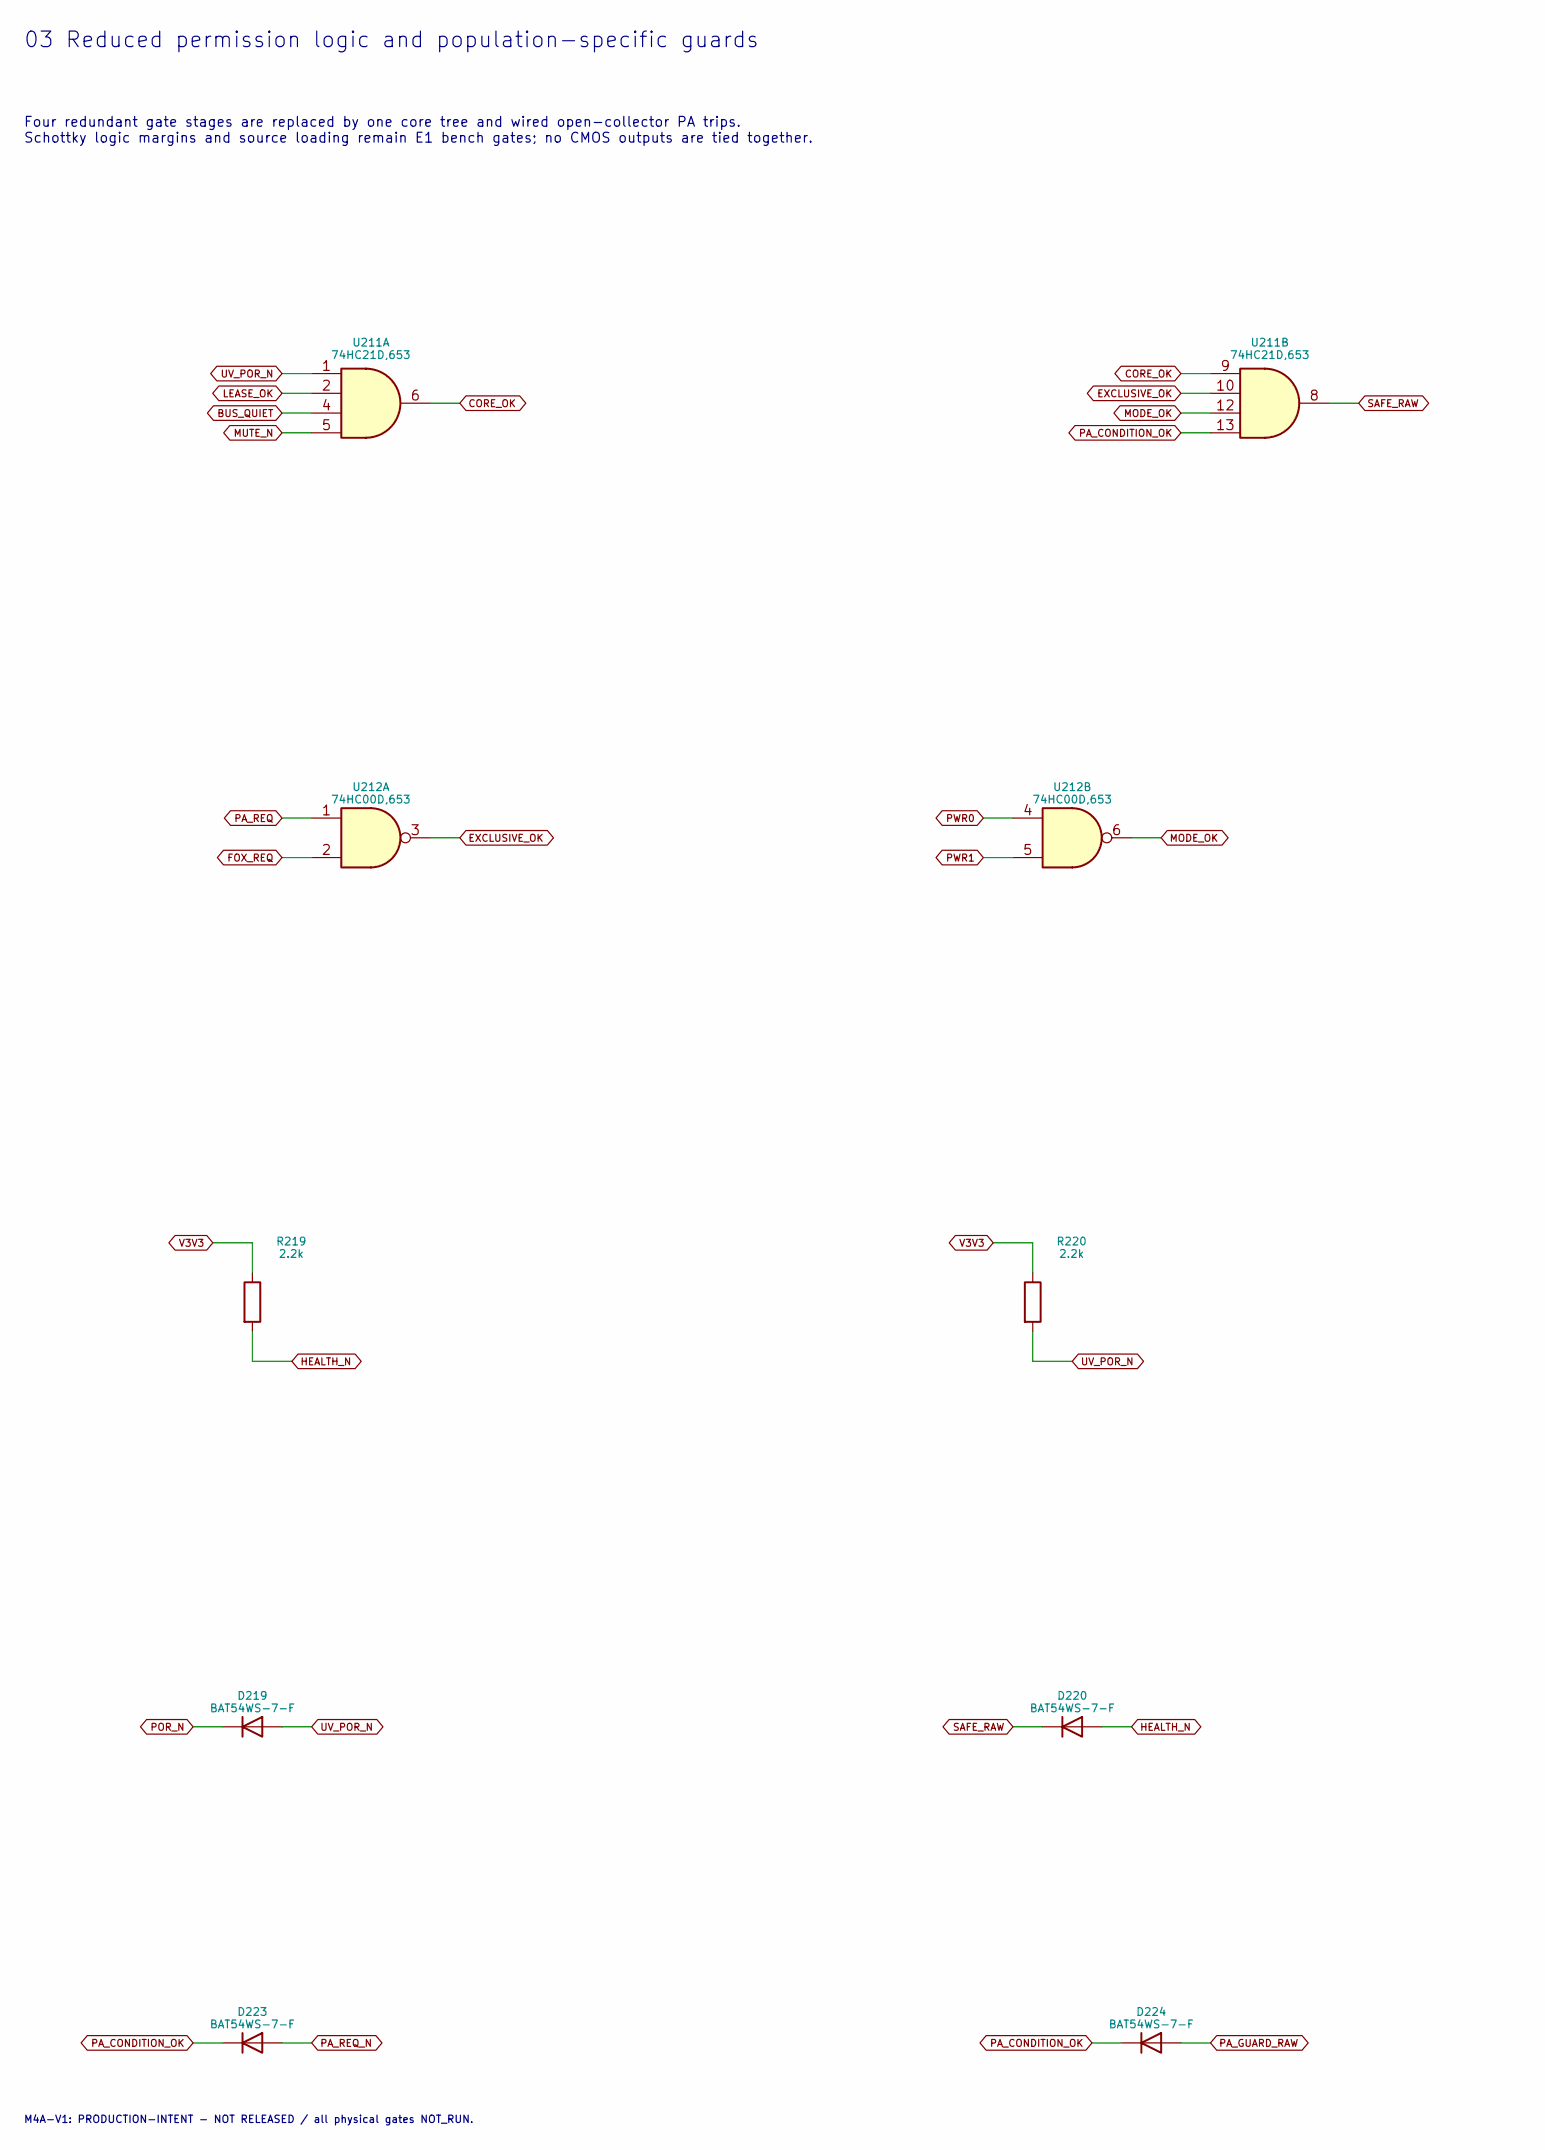
[picture p397: schematic 03_safety_logic.kicad_sch, 03 Reduced permission logic and population-specific guards, part in row 1, column 1]

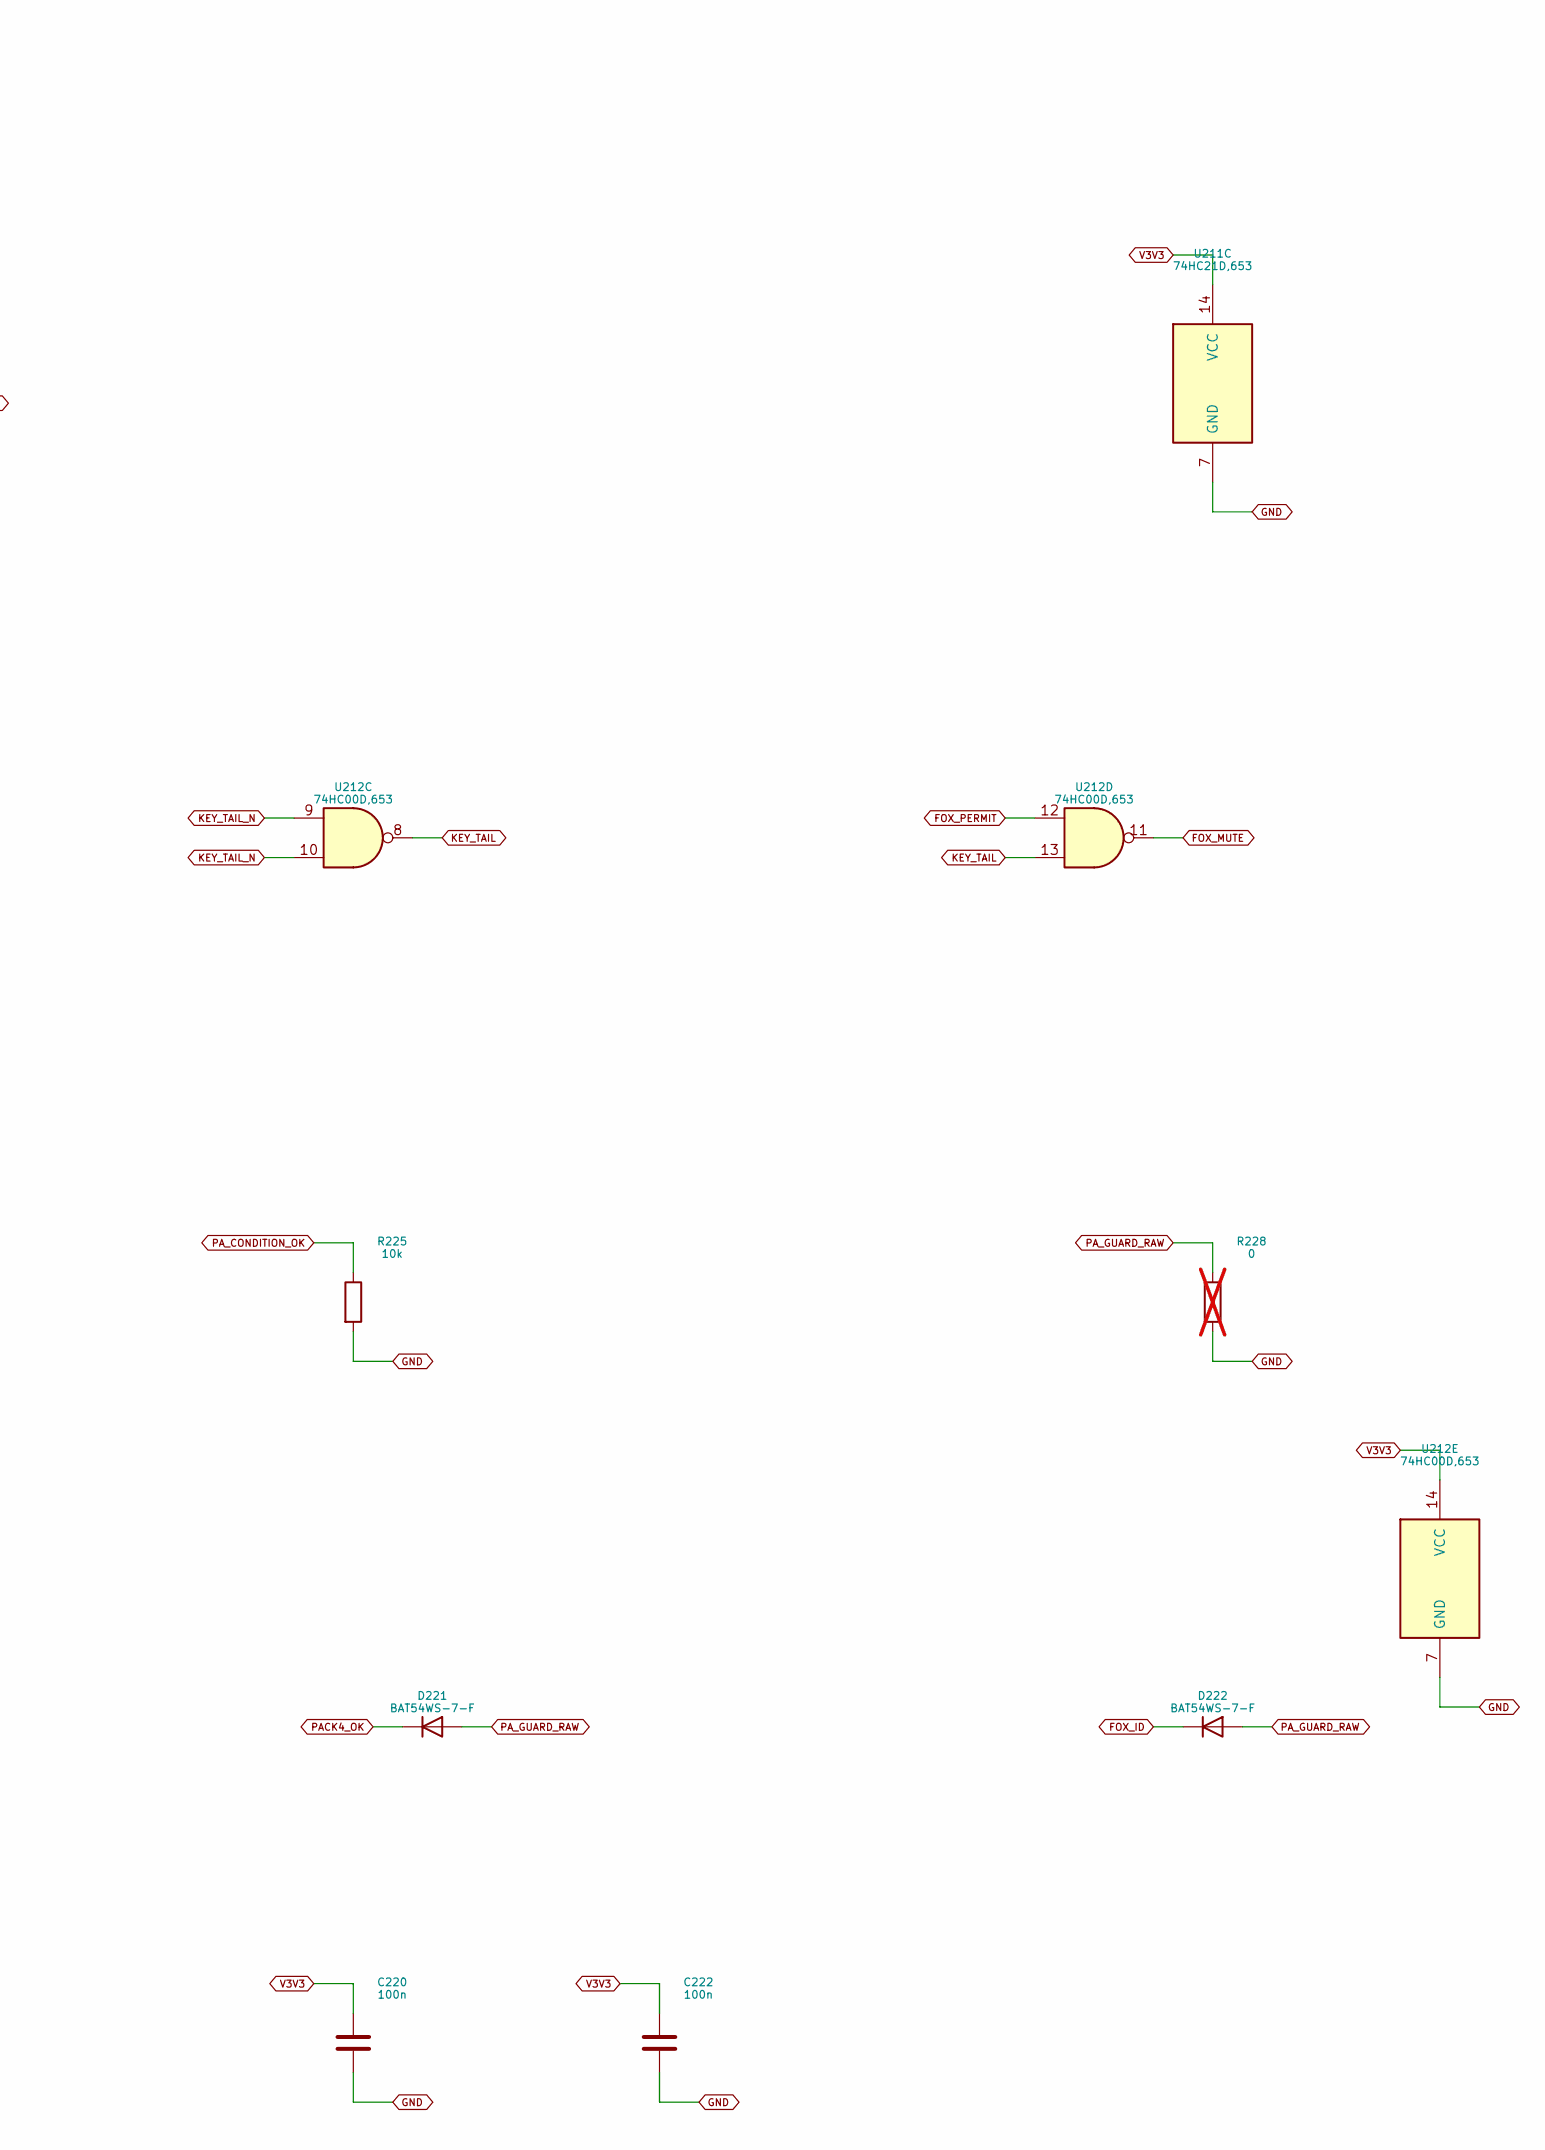
[picture p398: schematic 03_safety_logic.kicad_sch, 03 Reduced permission logic and population-specific guards, part in row 1, column 2]

Parts:
C220, C222: 100n; C_0603_1608Metric; MPN CC0603KRX7R8BB104
D219, D220, D221, D222, D223, D224: BAT54WS-7-F; D_SOD-323; MPN BAT54WS-7-F
R219, R220: 2.2k; R_0603_1608Metric; MPN RC0603FR-072K2L
R225: 10k; R_0603_1608Metric; MPN RC0603FR-0710KL
R228: 0; R_0603_1608Metric; MPN RC0603JR-070RL; not fitted
U211: 74HC21D,653; SOIC-14_3.9x8.7mm_P1.27mm; MPN 74HC21D,653
U212: 74HC00D,653; SOIC-14_3.9x8.7mm_P1.27mm; MPN 74HC00D,653

Connections:
BUS_QUIET: U211.4; also elsewhere on the board
CORE_OK: U211.6, U211.9
EXCLUSIVE_OK: U211.10, U212.3
FOX_ID: D222.1 (K); also elsewhere on the board
FOX_MUTE: U212.11; also elsewhere on the board
FOX_PERMIT: U212.12; also elsewhere on the board
FOX_REQ: U212.2; also elsewhere on the board
GND: C220.2, C222.2, R225.2, R228.2, U211.7 (GND), U212.7 (GND); also elsewhere on the board
HEALTH_N: D220.2 (A), R219.2; also elsewhere on the board
KEY_TAIL: U212.8, U212.13; also elsewhere on the board
KEY_TAIL_N: U212.9, U212.10; also elsewhere on the board
LEASE_OK: U211.2; also elsewhere on the board
MODE_OK: U211.12, U212.6
MUTE_N: U211.5; also elsewhere on the board
PACK4_OK: D221.1 (K); also elsewhere on the board
PA_CONDITION_OK: D223.1 (K), D224.1 (K), R225.1, U211.13
PA_GUARD_RAW: D221.2 (A), D222.2 (A), D224.2 (A), R228.1; also elsewhere on the board
PA_REQ: U212.1; also elsewhere on the board
PA_REQ_N: D223.2 (A); also elsewhere on the board
POR_N: D219.1 (K); also elsewhere on the board
PWR0: U212.4; also elsewhere on the board
PWR1: U212.5; also elsewhere on the board
SAFE_RAW: D220.1 (K), U211.8
UV_POR_N: D219.2 (A), R220.2, U211.1; also elsewhere on the board
V3V3: C220.1, C222.1, R219.1, R220.1, U211.14 (VCC), U212.14 (VCC); also elsewhere on the board

Notes on the sheet:
03 Reduced permission logic and population-specific guards
Four redundant gate stages are replaced by one core tree and wired open-collector PA trips. Schottky logic margins and source loading remain E1 bench gates; no CMOS outputs are tied together.
M4A-V1: PRODUCTION-INTENT - NOT RELEASED / all physical gates NOT_RUN.

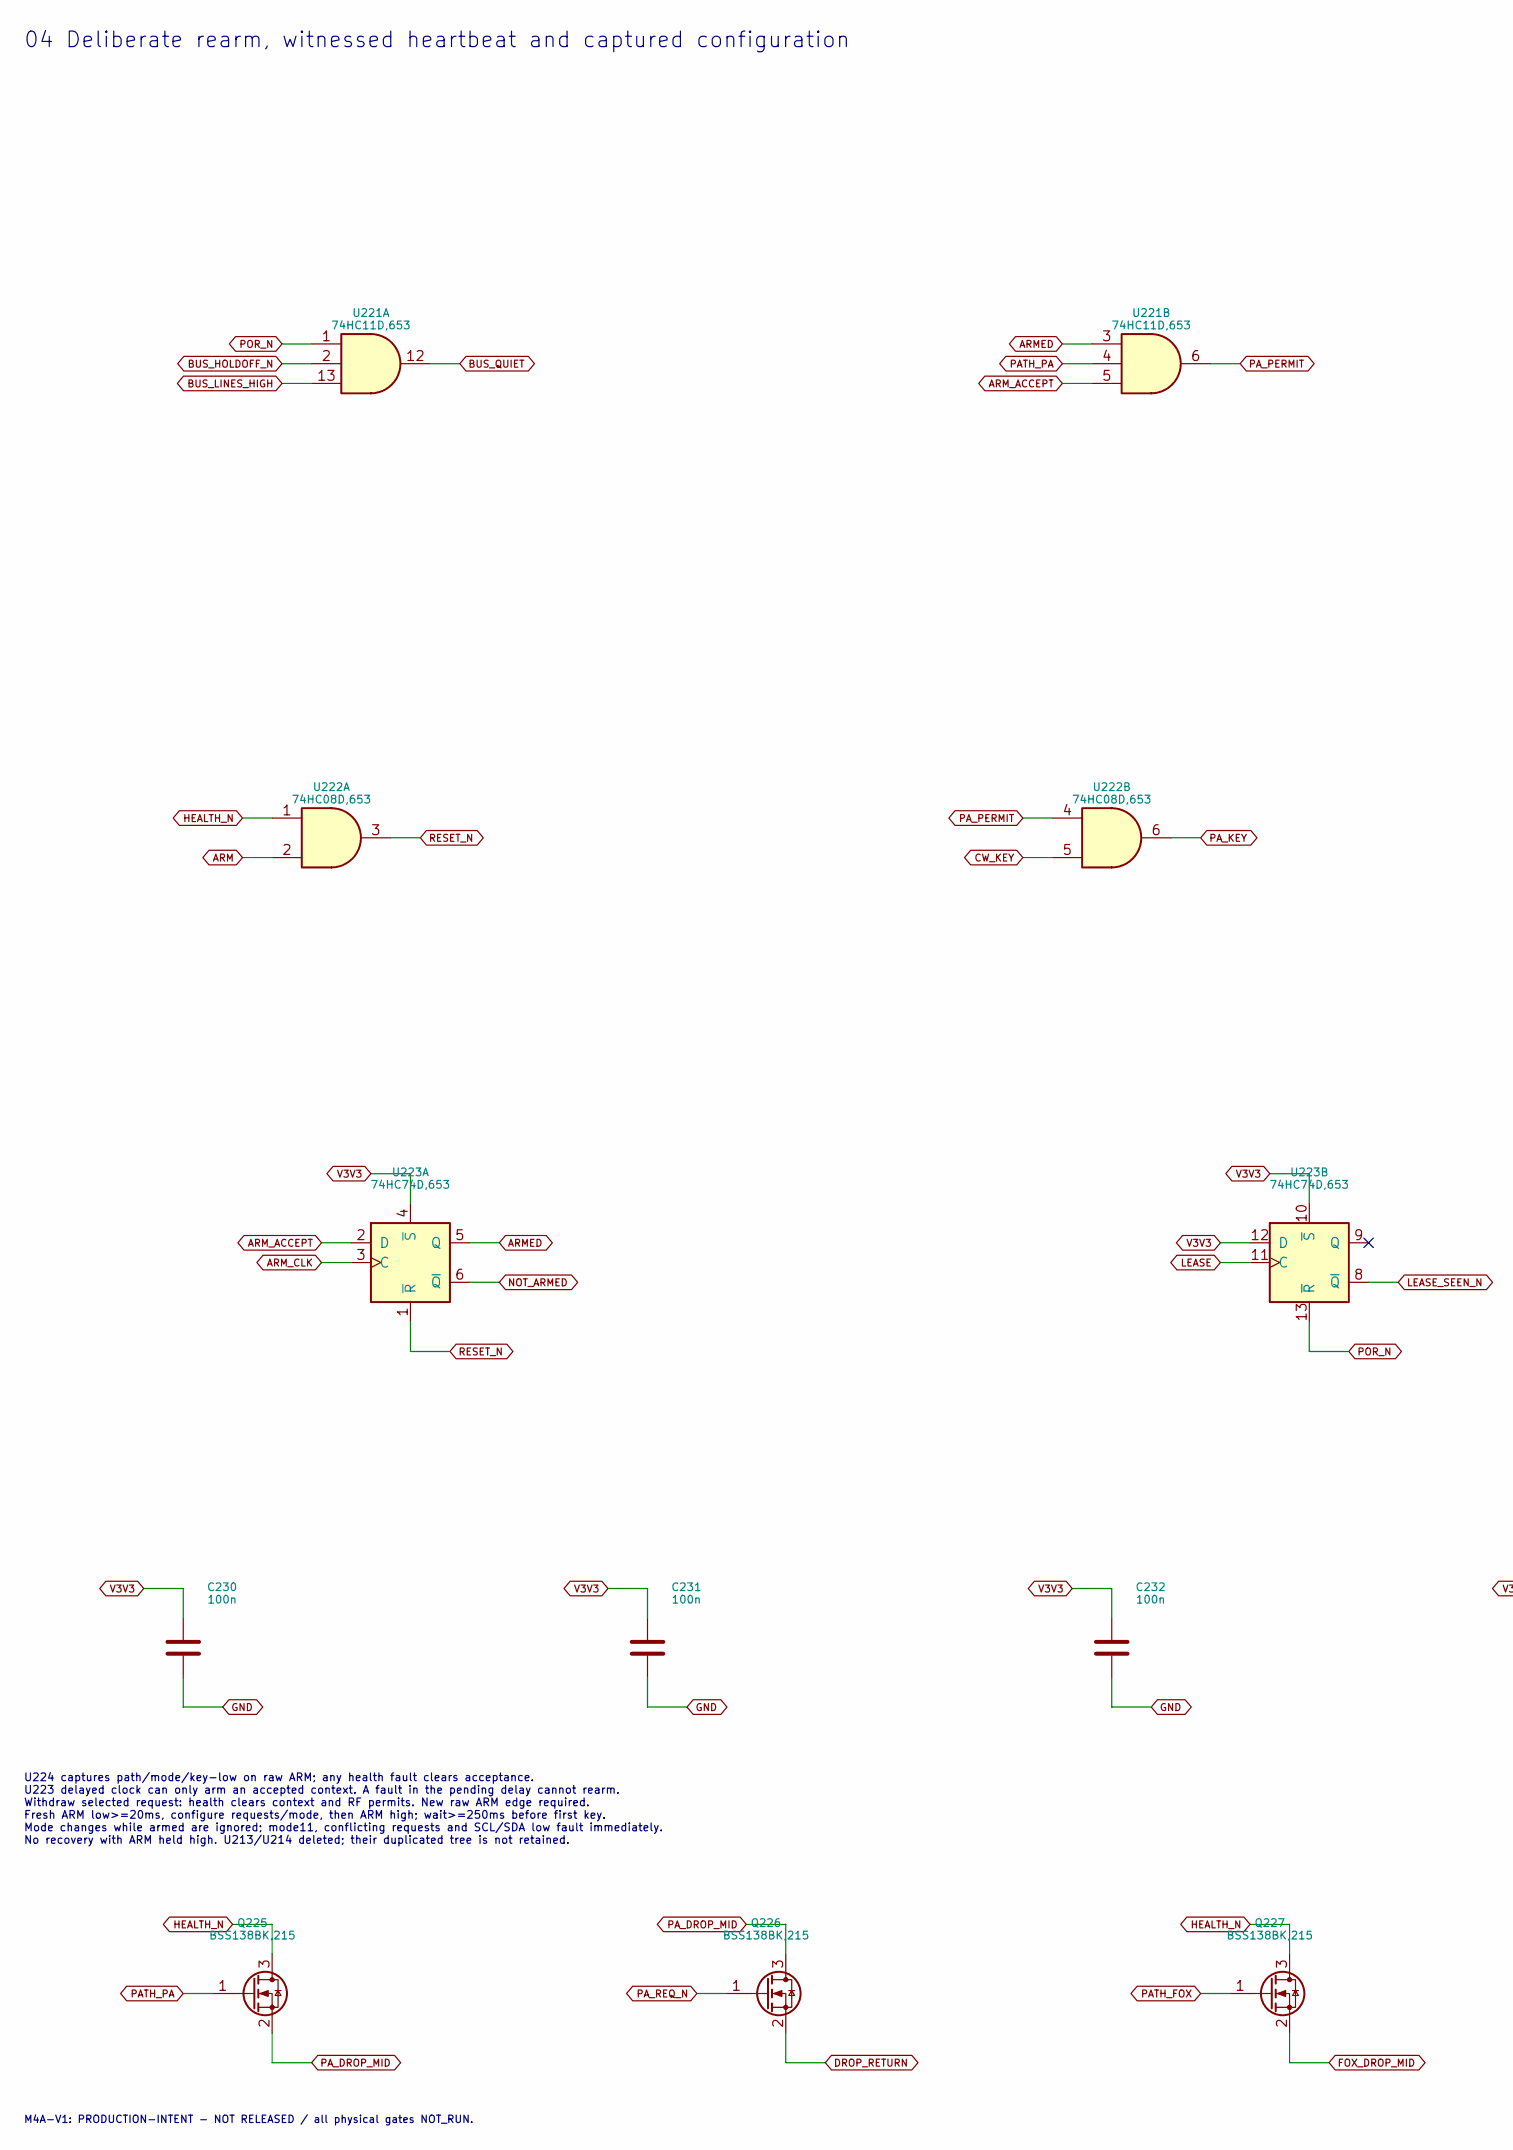
[picture p399: schematic 04_arm_key.kicad_sch, 04 Deliberate rearm, witnessed heartbeat and captured confi…, part in row 1, column 1]

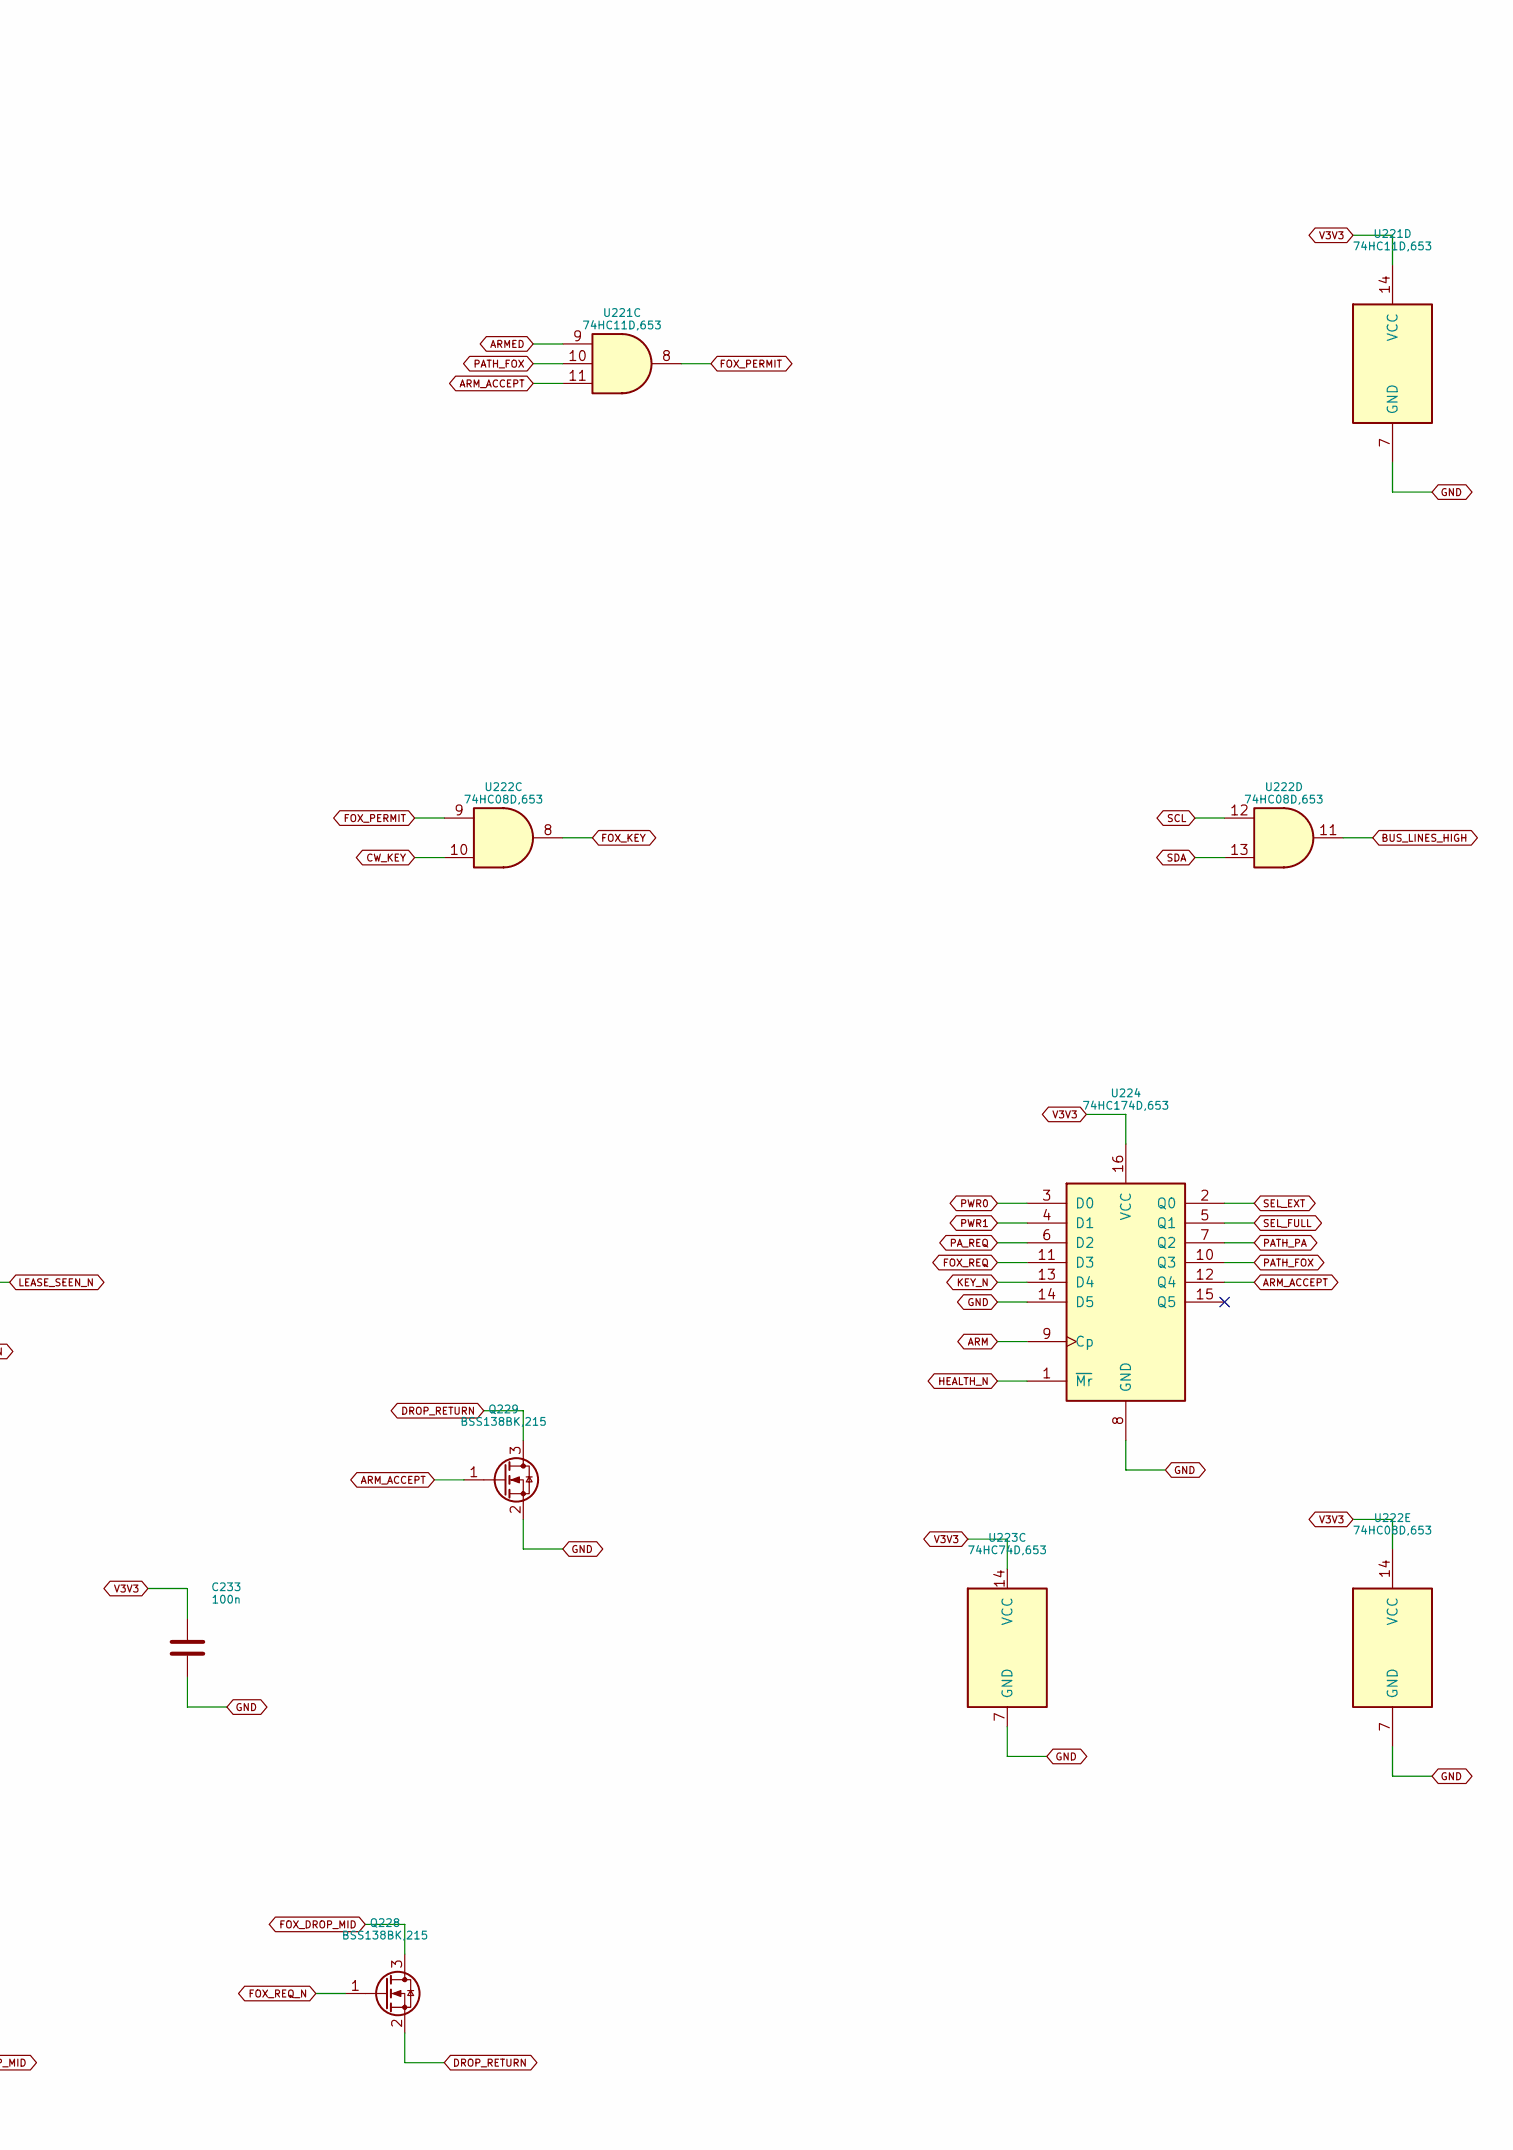
[picture p400: schematic 04_arm_key.kicad_sch, 04 Deliberate rearm, witnessed heartbeat and captured confi…, part in row 1, column 2]

Parts:
C230, C231, C232, C233: 100n; C_0603_1608Metric; MPN CC0603KRX7R8BB104
Q225, Q226, Q227, Q228, Q229: BSS138BK,215; SOT-23; MPN BSS138BK,215
U221: 74HC11D,653; SOIC-14_3.9x8.7mm_P1.27mm; MPN 74HC11D,653
U222: 74HC08D,653; SOIC-14_3.9x8.7mm_P1.27mm; MPN 74HC08D,653
U223: 74HC74D,653; SOIC-14_3.9x8.7mm_P1.27mm; MPN 74HC74D,653
U224: 74HC174D,653; SOIC-16_3.9x9.9mm_P1.27mm; MPN 74HC174D,653

Connections:
ARM: U222.2, U224.9 (Cp); also elsewhere on the board
ARMED: U221.3, U221.9, U223.5 (Q); also elsewhere on the board
ARM_ACCEPT: Q229.1 (G), U221.5, U221.11, U223.2 (D), U224.12 (Q4)
ARM_CLK: U223.3 (C); also elsewhere on the board
BUS_HOLDOFF_N: U221.2; also elsewhere on the board
BUS_LINES_HIGH: U221.13, U222.11
BUS_QUIET: U221.12; also elsewhere on the board
CW_KEY: U222.5, U222.10; also elsewhere on the board
DROP_RETURN: Q226.2 (S), Q228.2 (S), Q229.3 (D)
FOX_DROP_MID: Q227.2 (S), Q228.3 (D)
FOX_KEY: U222.8; also elsewhere on the board
FOX_PERMIT: U221.8, U222.9; also elsewhere on the board
FOX_REQ: U224.11 (D3); also elsewhere on the board
FOX_REQ_N: Q228.1 (G); also elsewhere on the board
GND: C230.2, C231.2, C232.2, C233.2, Q229.2 (S), U221.7 (GND), U222.7 (GND), U223.7 (GND), U224.8 (GND), U224.14 (D5); also elsewhere on the board
HEALTH_N: Q225.3 (D), Q227.3 (D), U222.1, U224.1 (~Mr); also elsewhere on the board
KEY_N: U224.13 (D4); also elsewhere on the board
LEASE: U223.11 (C); also elsewhere on the board
LEASE_SEEN_N: U223.8 (~Q); also elsewhere on the board
NOT_ARMED: U223.6 (~Q); also elsewhere on the board
PATH_FOX: Q227.1 (G), U221.10, U224.10 (Q3)
PATH_PA: Q225.1 (G), U221.4, U224.7 (Q2)
PA_DROP_MID: Q225.2 (S), Q226.3 (D)
PA_KEY: U222.6; also elsewhere on the board
PA_PERMIT: U221.6, U222.4; also elsewhere on the board
PA_REQ: U224.6 (D2); also elsewhere on the board
PA_REQ_N: Q226.1 (G); also elsewhere on the board
POR_N: U221.1, U223.13 (~R); also elsewhere on the board
PWR0: U224.3 (D0); also elsewhere on the board
PWR1: U224.4 (D1); also elsewhere on the board
RESET_N: U222.3, U223.1 (~R); also elsewhere on the board
SCL: U222.12; also elsewhere on the board
SDA: U222.13; also elsewhere on the board
SEL_EXT: U224.2 (Q0); also elsewhere on the board
SEL_FULL: U224.5 (Q1); also elsewhere on the board
V3V3: C230.1, C231.1, C232.1, C233.1, U221.14 (VCC), U222.14 (VCC), U223.4 (~S), U223.10 (~S), U223.12 (D), U223.14 (VCC), U224.16 (VCC); also elsewhere on the board

Notes on the sheet:
04 Deliberate rearm, witnessed heartbeat and captured configuration
U224 captures path/mode/key-low on raw ARM; any health fault clears acceptance. U223 delayed clock can only arm an accepted context. A fault in the pending delay cannot rearm. Withdraw selected request: health clears context and RF permits. New raw ARM edge required. Fresh ARM low>=20ms, configure 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
M4A-V1: PRODUCTION-INTENT - NOT RELEASED / all physical gates NOT_RUN.
