DD1SB/ARDF-TX/hardware/80m/production/RF80_V1.kicad_pcb

## KiCad design hardware/80m/production/RF80_V1.kicad_pcb (continued)

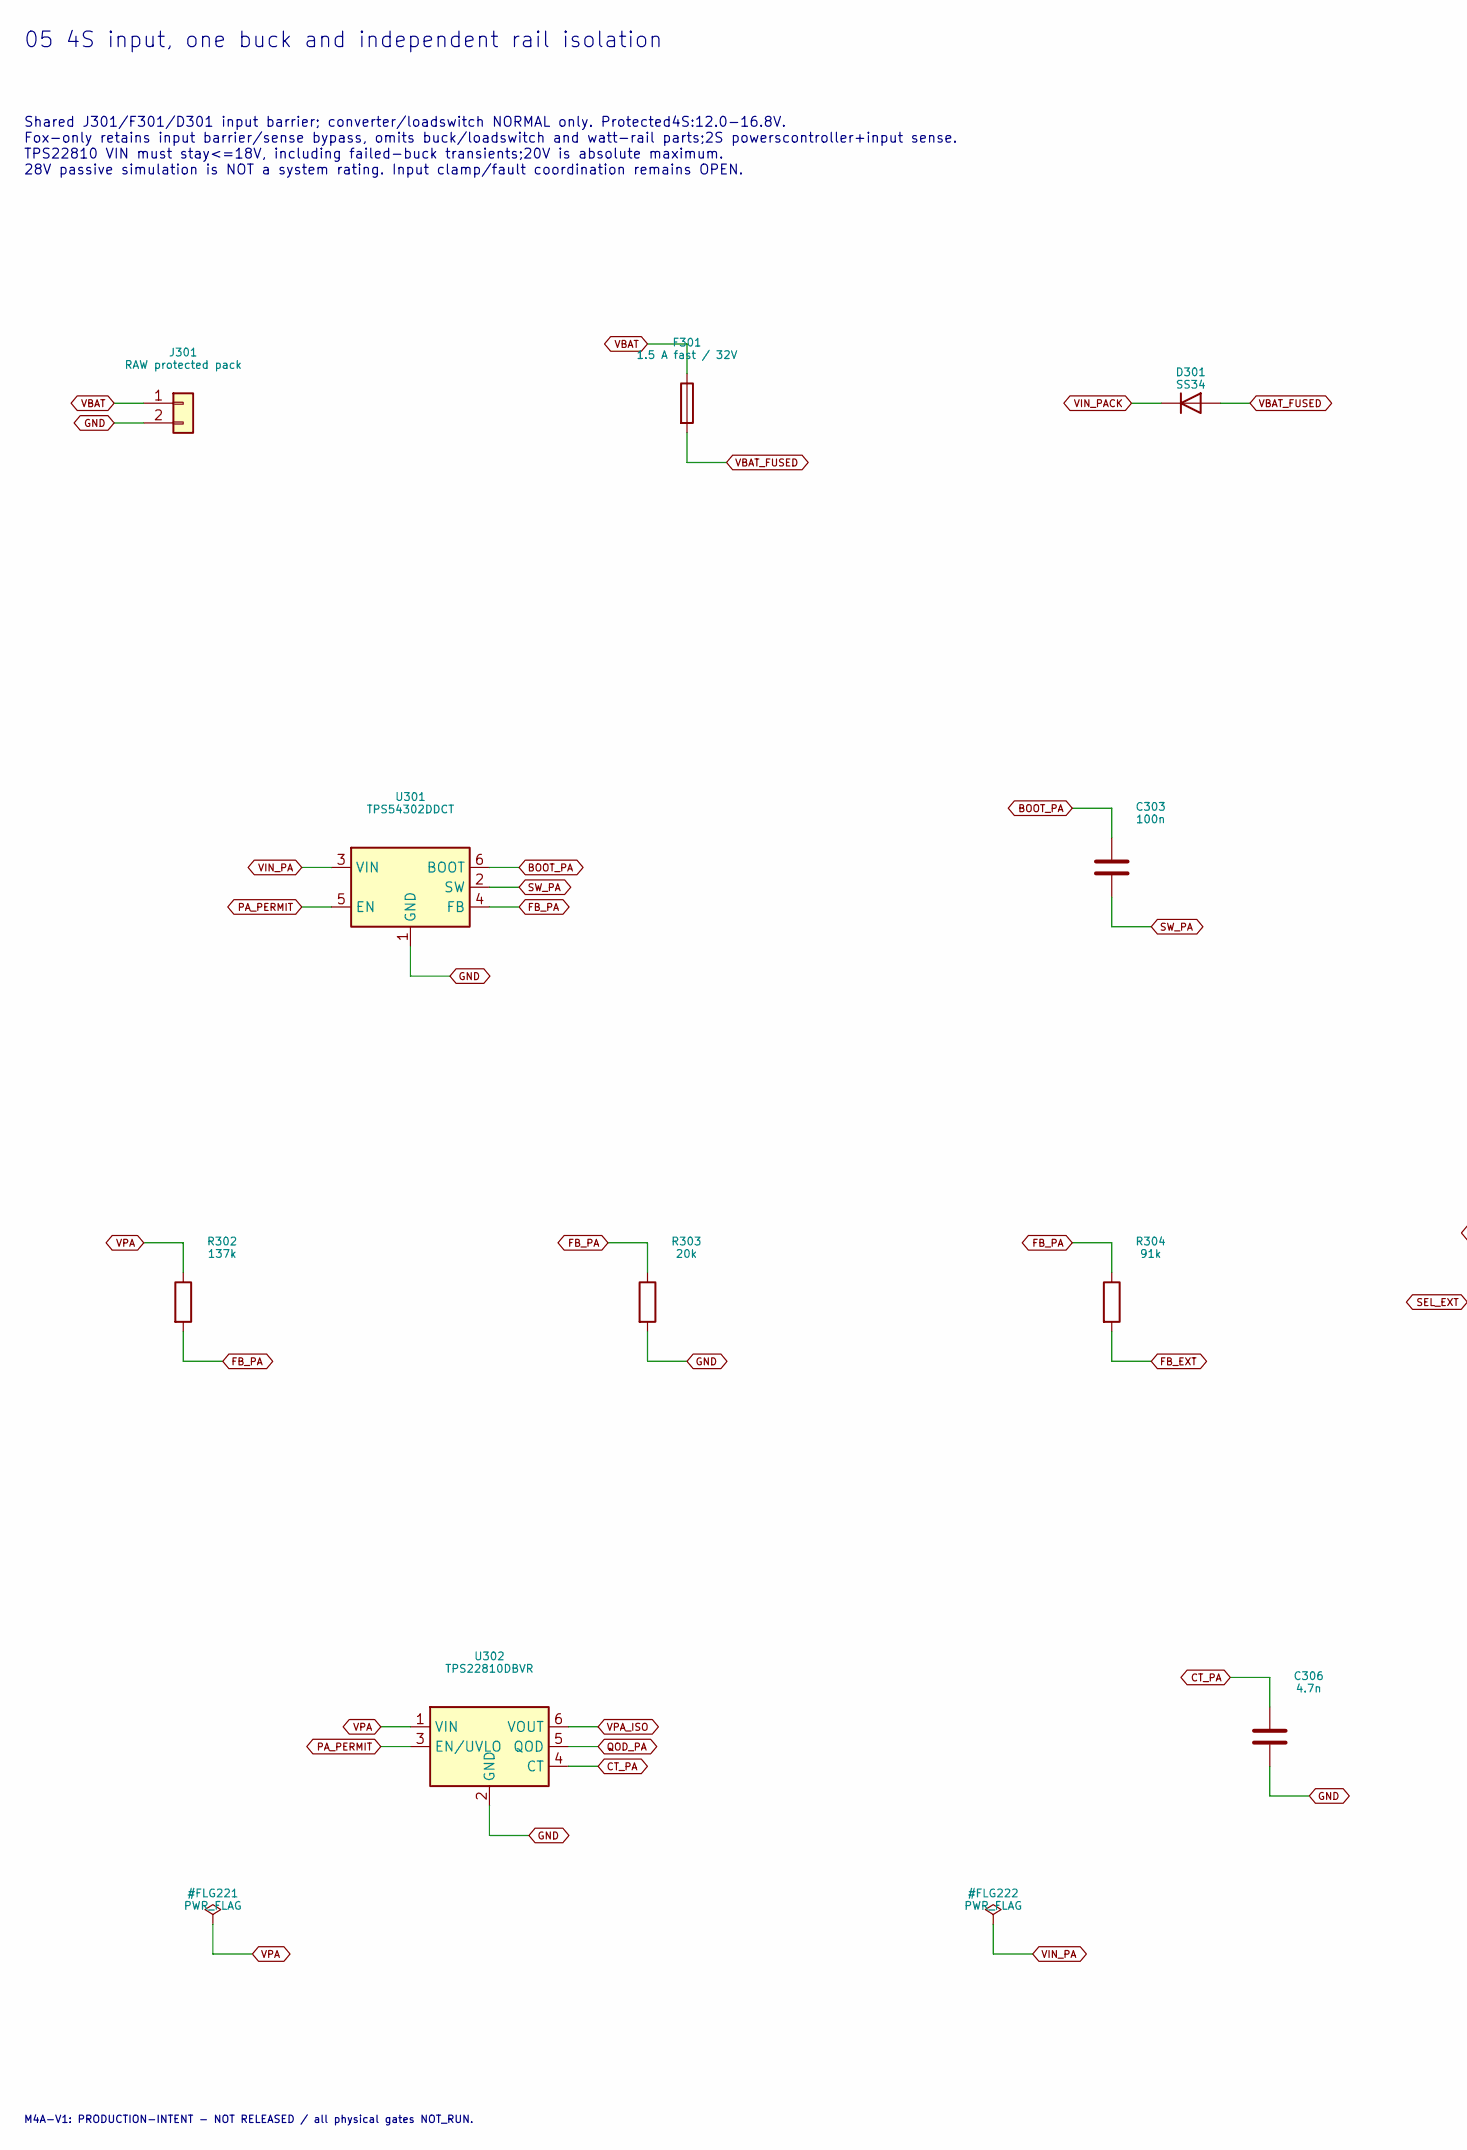
[picture p401: schematic 05_power.kicad_sch, 05 4S input, one buck and independent rail isolation, part in row 1, column 1]

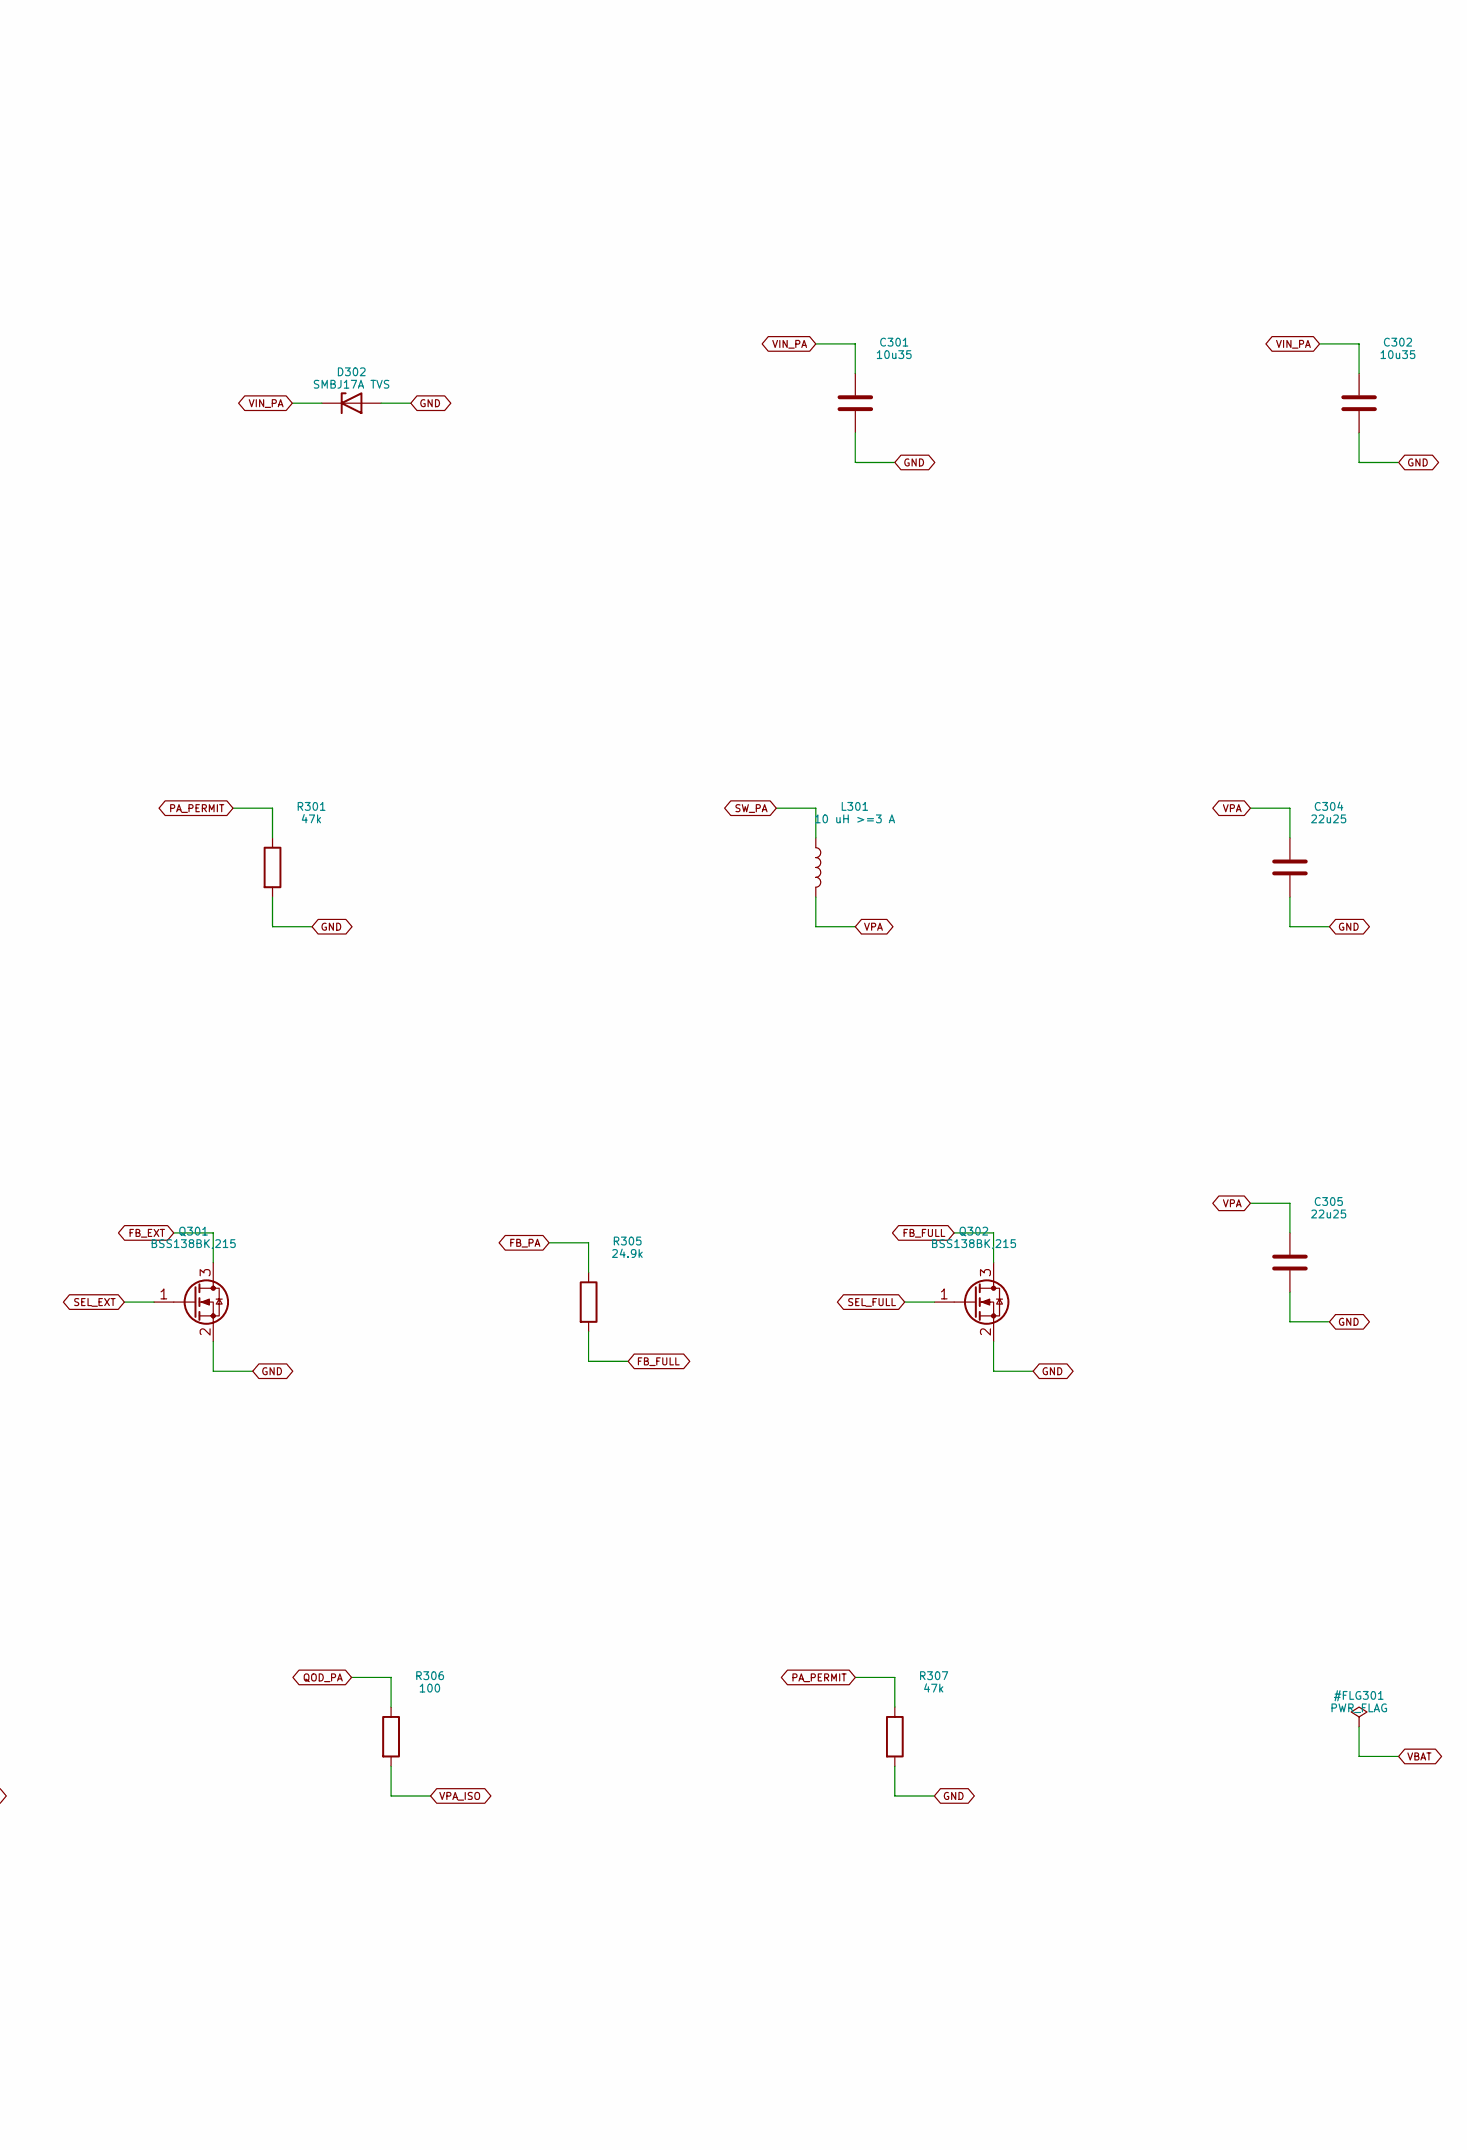
[picture p402: schematic 05_power.kicad_sch, 05 4S input, one buck and independent rail isolation, part in row 1, column 2]

Parts:
C301, C302: 10u35; C_1210_3225Metric; MPN C3225X7R1V106M250AC
C303: 100n; C_0603_1608Metric; MPN CC0603KRX7R8BB104
C304, C305: 22u25; C_1210_3225Metric; MPN GRM32ER71E226KE15L
C306: 4.7n; C_0603_1608Metric; MPN CC0603JRNPO9BN472
D301: SS34; D_SMC; MPN SS34-E3/57T
D302: SMBJ17A TVS; D_SMB; MPN SMBJ17A
F301: 1.5 A fast / 32V; Fuse_467_0603; MPN Littelfuse 046701.5NR
J301: RAW protected pack; JST_VH_B2P_StandardPTH; MPN B2P-VH(LF)(SN)
L301: 10 uH >=3 A; SRP7050TA; MPN SRP7050TA-100M
Q301, Q302: BSS138BK,215; SOT-23; MPN BSS138BK,215
R301, R307: 47k; R_0603_1608Metric; MPN RC0603FR-0747KL
R302: 137k; R_0603_1608Metric; MPN RC0603FR-07137KL
R303: 20k; R_0603_1608Metric; MPN RC0603FR-0720KL
R304: 91k; R_0603_1608Metric; MPN RC0603FR-0791KL
R305: 24.9k; R_0603_1608Metric; MPN RC0603FR-0724K9L
R306: 100; R_0603_1608Metric; MPN RC0603FR-07100RL
U301: TPS54302DDCT; TSOT-23-6; MPN TPS54302DDCT
U302: TPS22810DBVR; SOT-23-6; MPN TPS22810DBVR

Connections:
BOOT_PA: C303.1, U301.6 (BOOT)
CT_PA: C306.1, U302.4 (CT)
FB_EXT: Q301.3 (D), R304.2
FB_FULL: Q302.3 (D), R305.2
FB_PA: R302.2, R303.1, R304.1, R305.1, U301.4 (FB)
GND: C301.2, C302.2, C304.2, C305.2, C306.2, D302.2 (A), J301.2, Q301.2 (S), Q302.2 (S), R301.2, R303.2, R307.2, U301.1 (GND), U302.2 (GND); also elsewhere on the board
PA_PERMIT: R301.1, R307.1, U301.5 (EN), U302.3 (EN/UVLO); also elsewhere on the board
QOD_PA: R306.1, U302.5 (QOD)
SEL_EXT: Q301.1 (G); also elsewhere on the board
SEL_FULL: Q302.1 (G); also elsewhere on the board
SW_PA: C303.2, L301.1, U301.2 (SW)
VBAT: F301.1, J301.1
VBAT_FUSED: D301.2 (A), F301.2
VIN_PA: C301.1, C302.1, D302.1 (K), U301.3 (VIN); also elsewhere on the board
VIN_PACK: D301.1 (K); also elsewhere on the board
VPA: C304.1, C305.1, L301.2, R302.1, U302.1 (VIN); also elsewhere on the board
VPA_ISO: R306.2, U302.6 (VOUT); also elsewhere on the board

Notes on the sheet:
05 4S input, one buck and independent rail isolation
Shared J301/F301/D301 input barrier; converter/loadswitch NORMAL only. Protected4S:12.0-16.8V. Fox-only retains input barrier/sense bypass, omits buck/loadswitch and watt-rail parts;2S powerscontroller+input sense. TPS22810 VIN must stay<=18V, including failed-buck transients;20V is absolute maximu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
M4A-V1: PRODUCTION-INTENT - NOT RELEASED / all physical gates NOT_RUN.

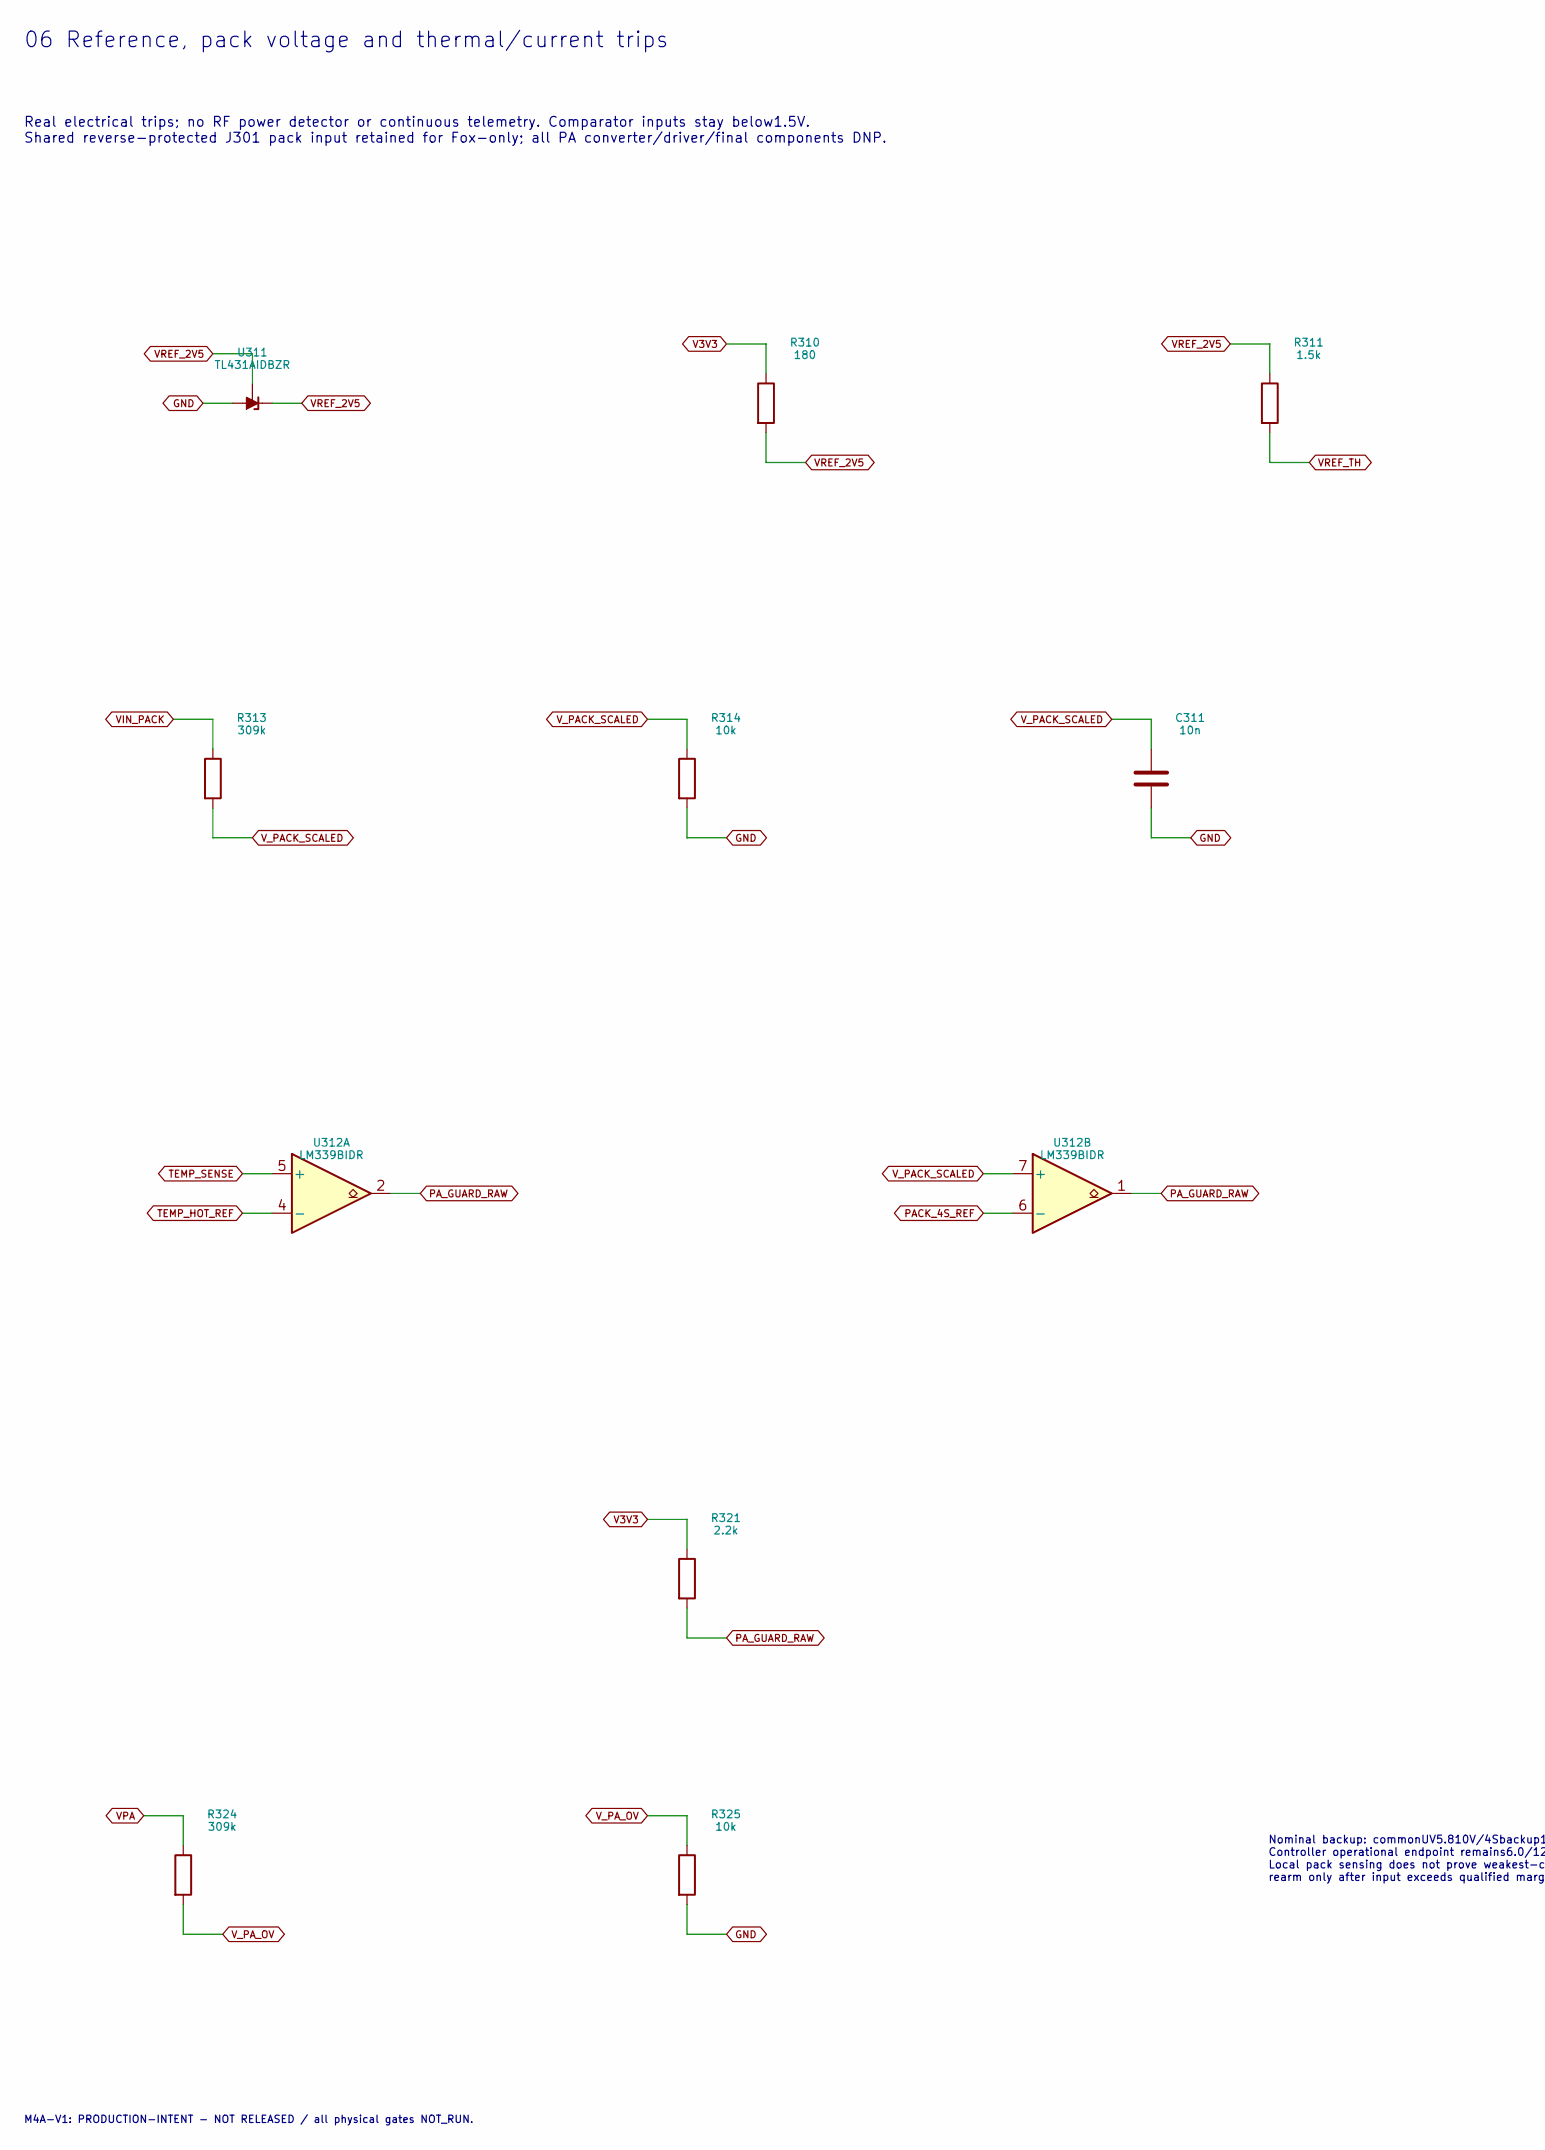
[picture p403: schematic 06_analog_protection.kicad_sch, 06 Reference, pack voltage and thermal/current trips, part in row 1, column 1]

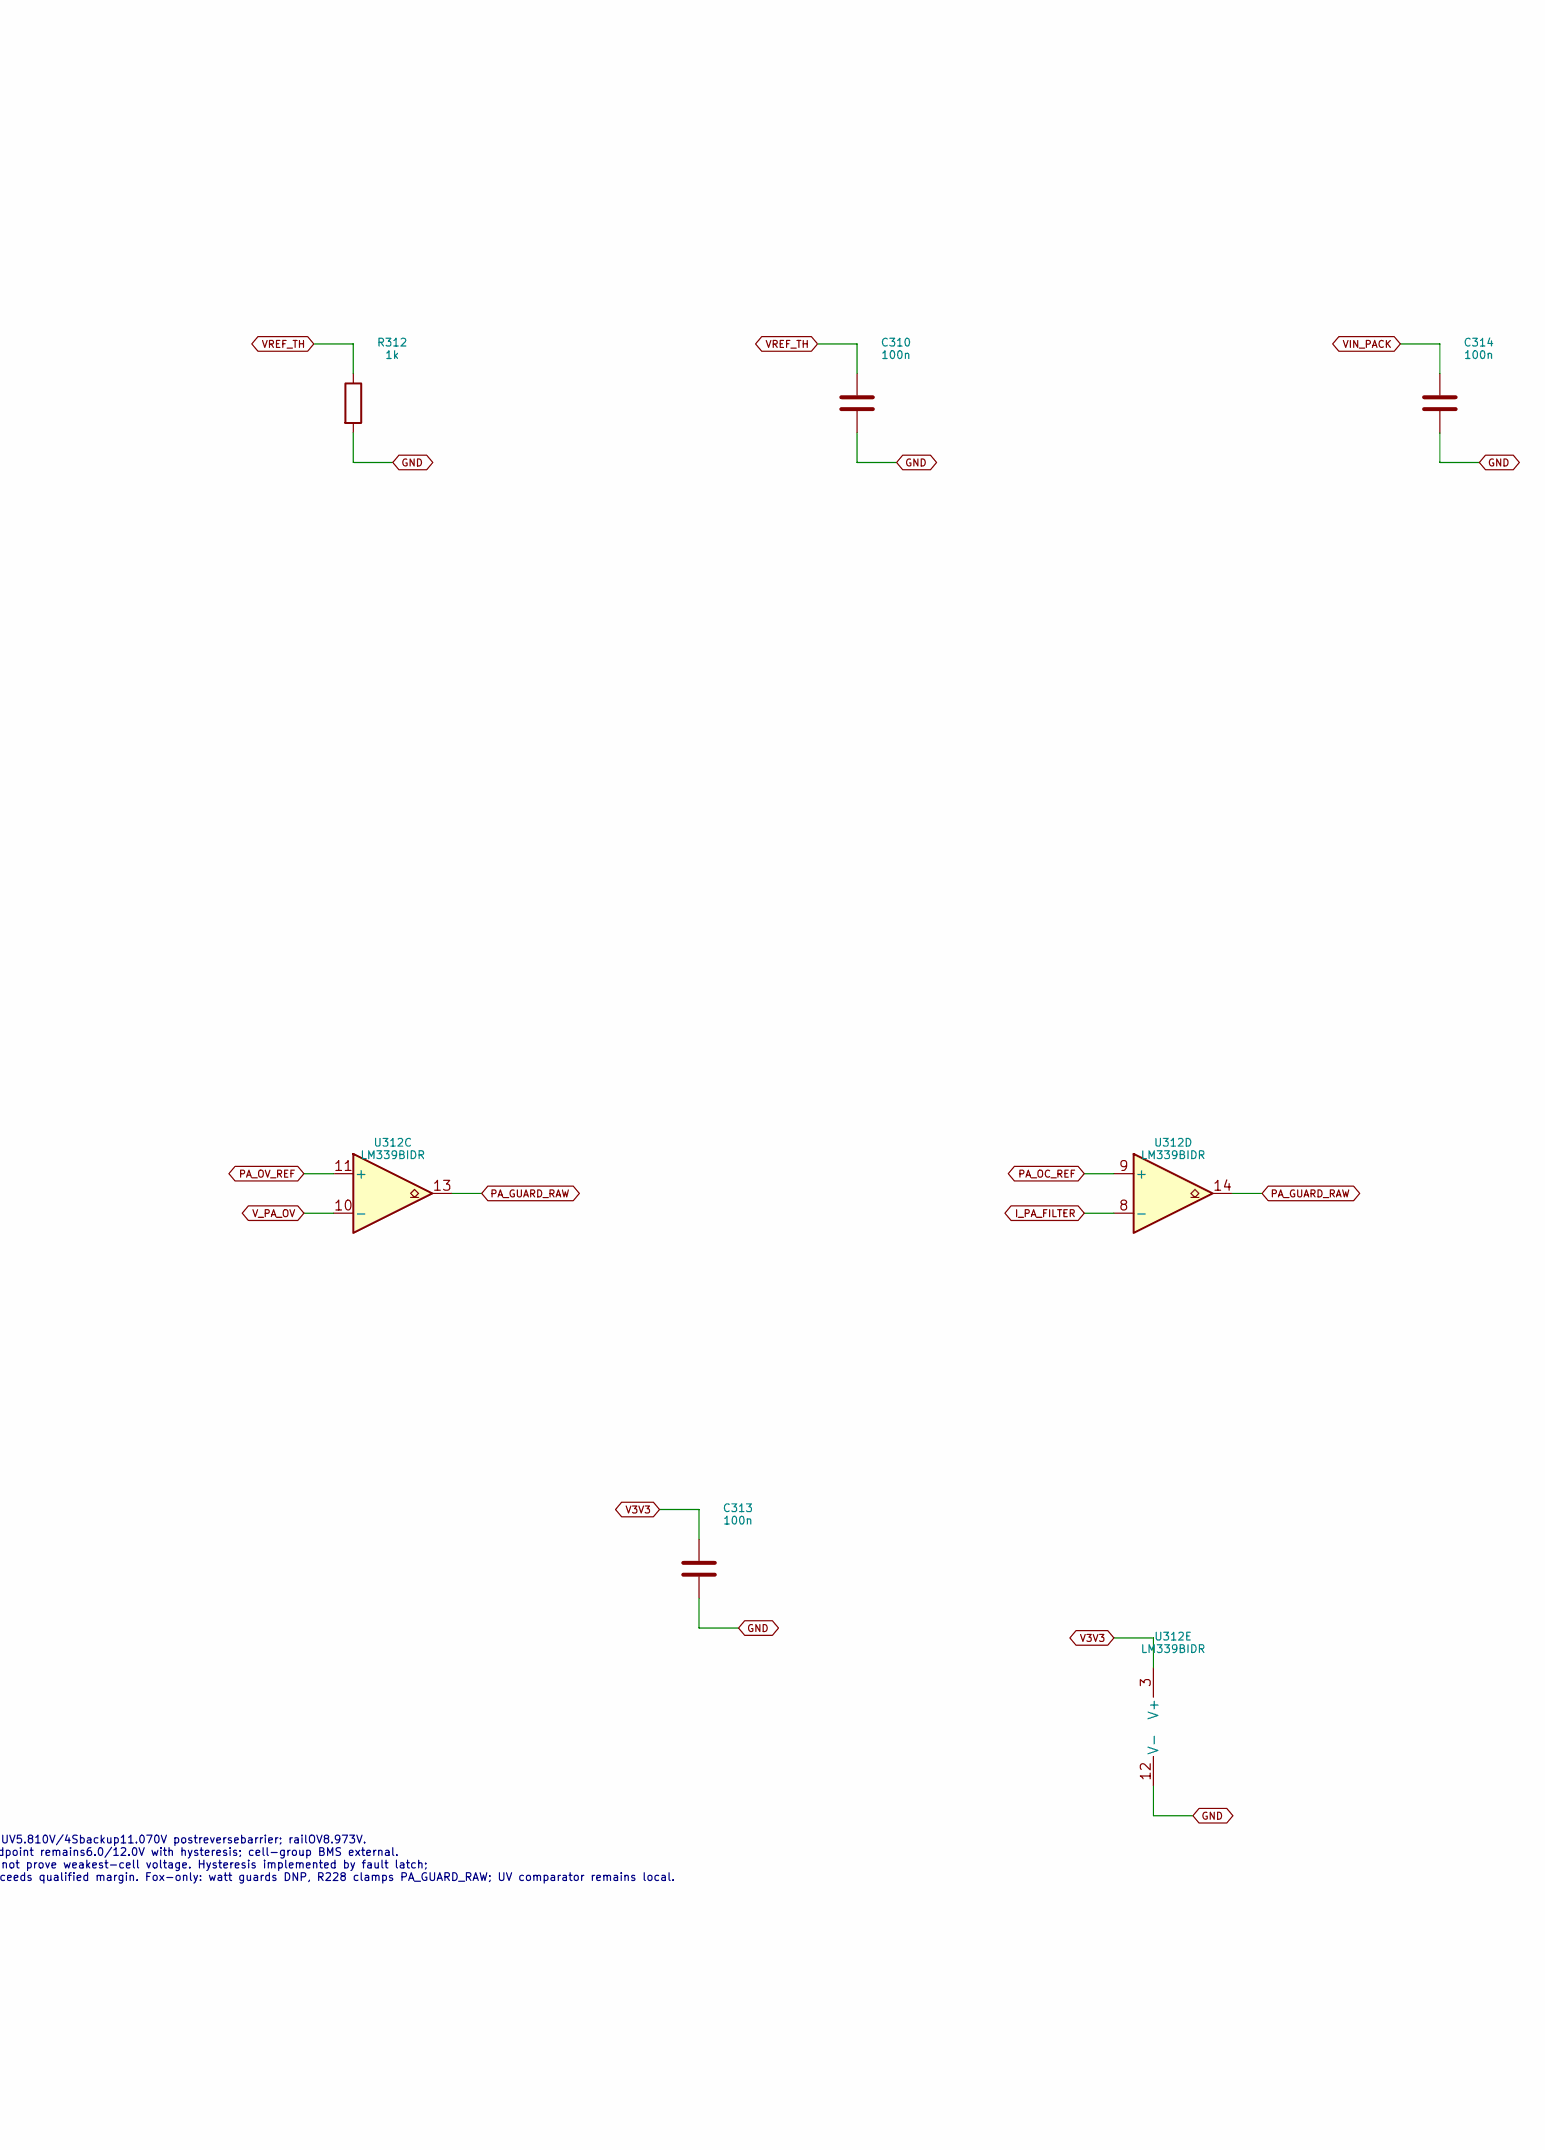
[picture p404: schematic 06_analog_protection.kicad_sch, 06 Reference, pack voltage and thermal/current trips, part in row 1, column 2]

Parts:
C310, C313: 100n; C_0603_1608Metric; MPN CC0603KRX7R8BB104
C311: 10n; C_0603_1608Metric; MPN CC0603KRX7R9BB103
C314: 100n; C_0603_1608Metric; MPN CC0603KRX7R9BB104
R310: 180; R_0603_1608Metric; MPN RC0603FR-07180RL
R311: 1.5k; R_0603_1608Metric; MPN RC0603FR-071K5L
R312: 1k; R_0603_1608Metric; MPN RC0603FR-071KL
R313, R324: 309k; R_0603_1608Metric; MPN RC0603FR-07309KL
R314, R325: 10k; R_0603_1608Metric; MPN RC0603FR-0710KL
R321: 2.2k; R_0603_1608Metric; MPN RC0603FR-072K2L
U311: TL431AIDBZR; SOT-23; MPN TL431AIDBZR
U312: LM339BIDR; SOIC-14_3.9x8.7mm_P1.27mm; MPN LM339BIDR

Connections:
GND: C310.2, C311.2, C313.2, C314.2, R312.2, R314.2, R325.2, U311.3 (A), U312.12 (V-); also elsewhere on the board
I_PA_FILTER: U312.8 (-); also elsewhere on the board
PACK_4S_REF: U312.6 (-); also elsewhere on the board
PA_GUARD_RAW: R321.2, U312.1, U312.2, U312.13, U312.14; also elsewhere on the board
PA_OC_REF: U312.9 (+); also elsewhere on the board
PA_OV_REF: U312.11 (+); also elsewhere on the board
TEMP_HOT_REF: U312.4 (-); also elsewhere on the board
TEMP_SENSE: U312.5 (+); also elsewhere on the board
V3V3: C313.1, R310.1, R321.1, U312.3 (V+); also elsewhere on the board
VIN_PACK: C314.1, R313.1; also elsewhere on the board
VPA: R324.1; also elsewhere on the board
VREF_2V5: R310.2, R311.1, U311.1 (K), U311.2 (REF); also elsewhere on the board
VREF_TH: C310.1, R311.2, R312.1; also elsewhere on the board
V_PACK_SCALED: C311.1, R313.2, R314.1, U312.7 (+); also elsewhere on the board
V_PA_OV: R324.2, R325.1, U312.10 (-)

Notes on the sheet:
06 Reference, pack voltage and thermal/current trips
Real electrical trips; no RF power detector or continuous telemetry. Comparator inputs stay below1.5V. Shared reverse-protected J301 pack input retained for Fox-only; all PA converter/driver/final components DNP.
Nominal backup: commonUV5.810V/4Sbackup11.070V postreversebarrier; railOV8.973V. Controller operational endpoint remains6.0/12.0V with hysteresis; cell-group BMS external. Local pack sensing does not prove weakest-cell voltage. Hysteresis implemented by fault latch; rearm only after input exceeds q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
M4A-V1: PRODUCTION-INTENT - NOT RELEASED / all physical gates NOT_RUN.

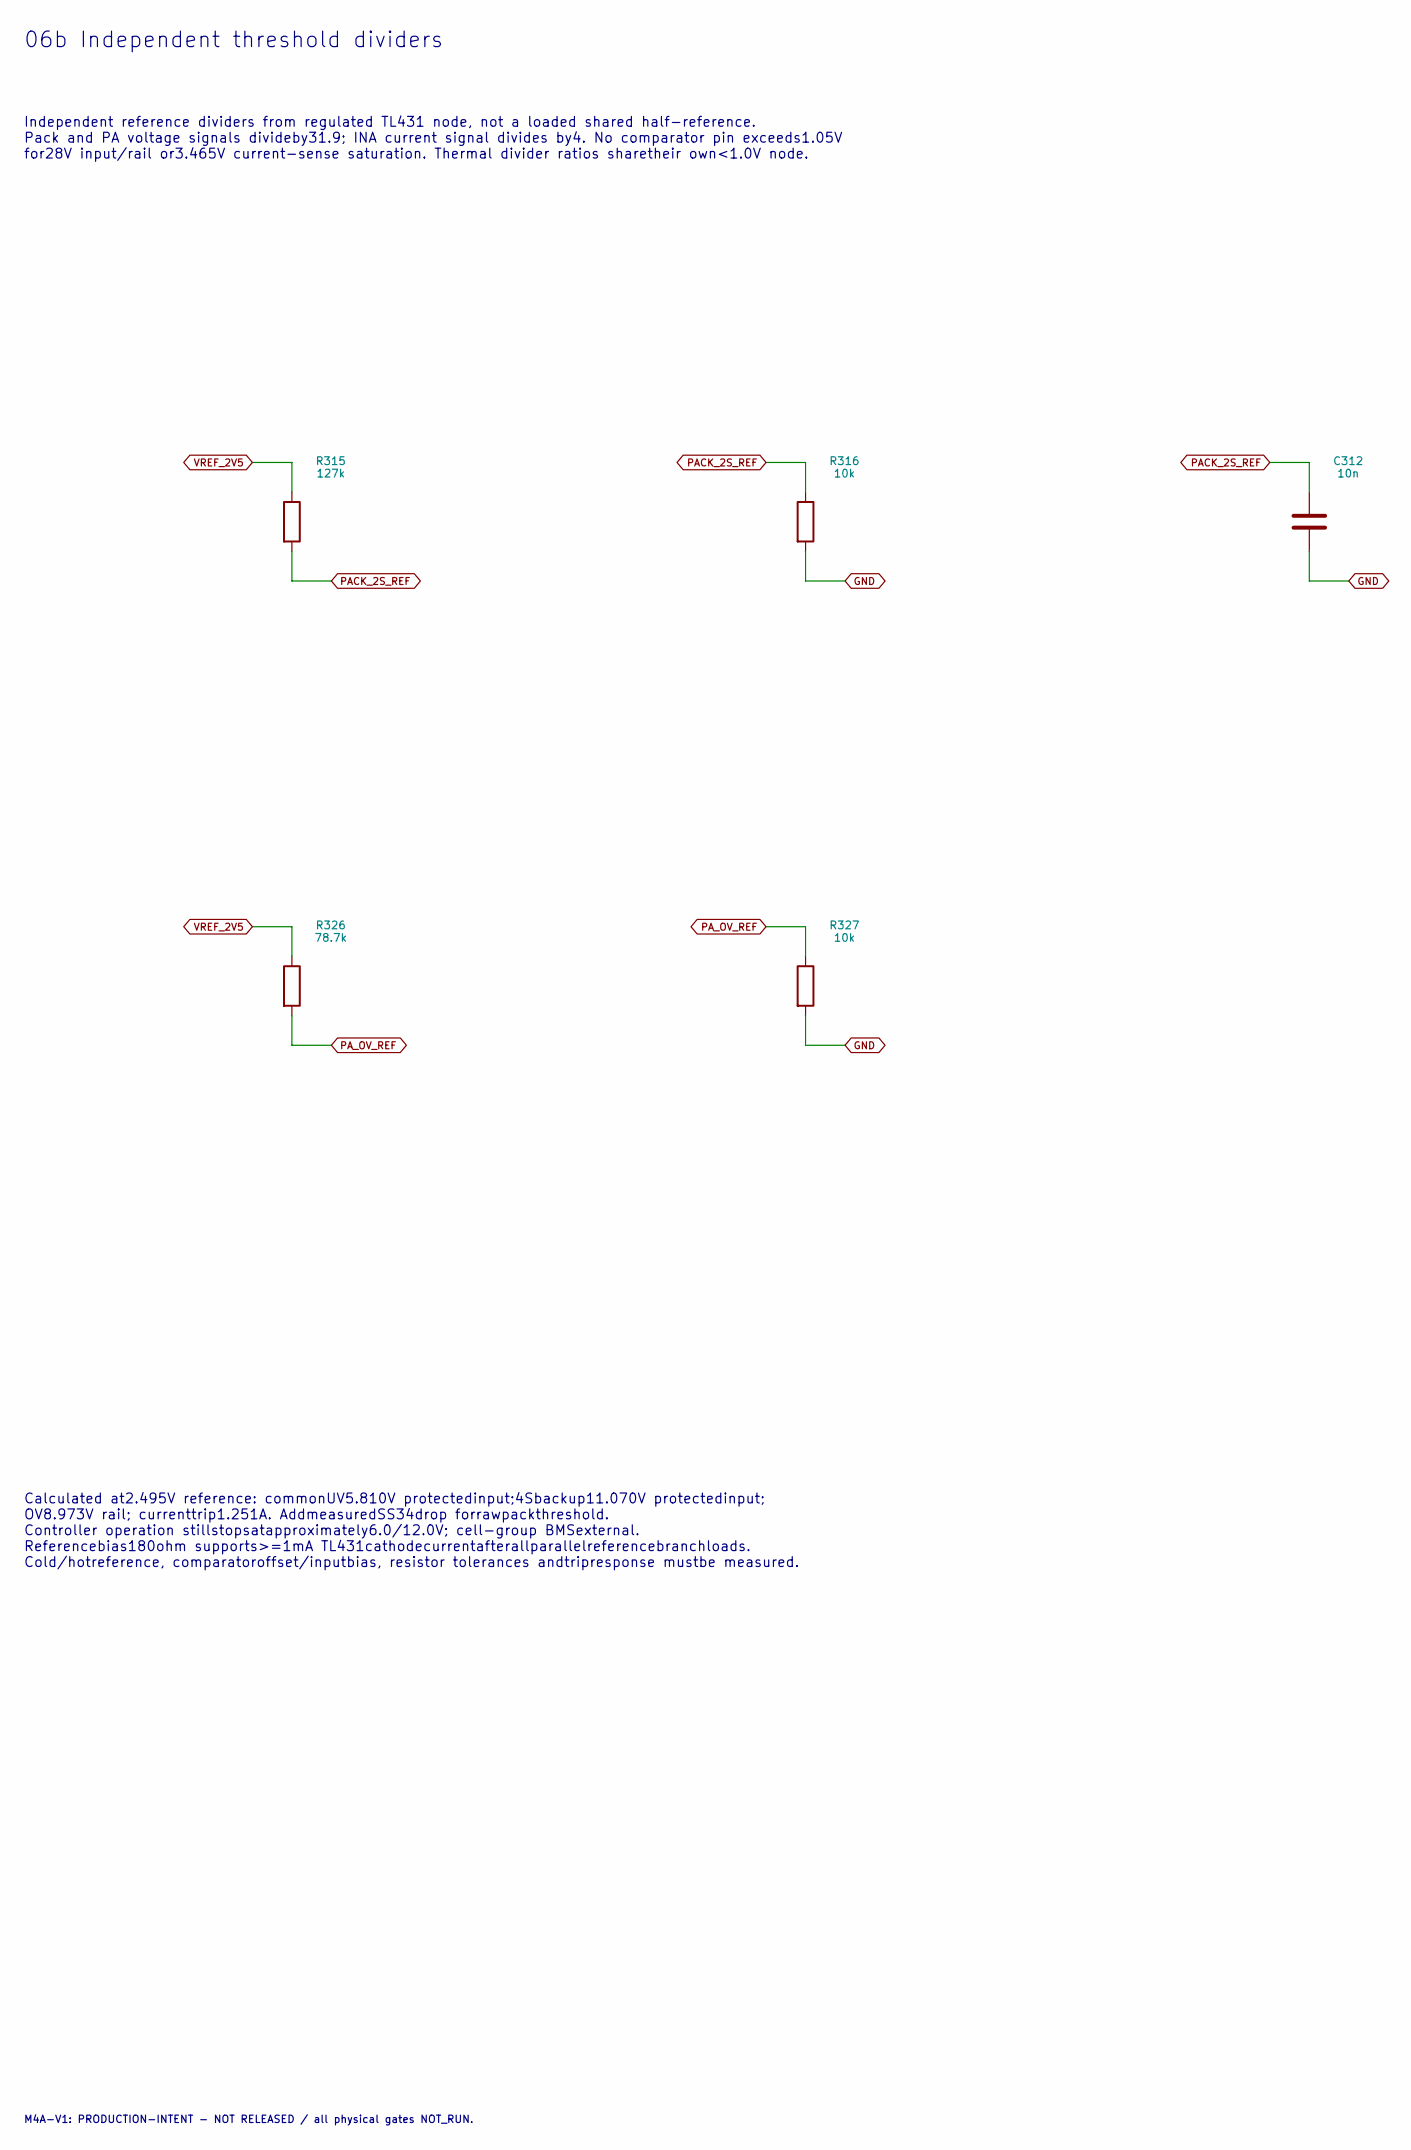
[picture p405: schematic 06b_thresholds.kicad_sch, 06b Independent threshold dividers, part in row 1, column 1]

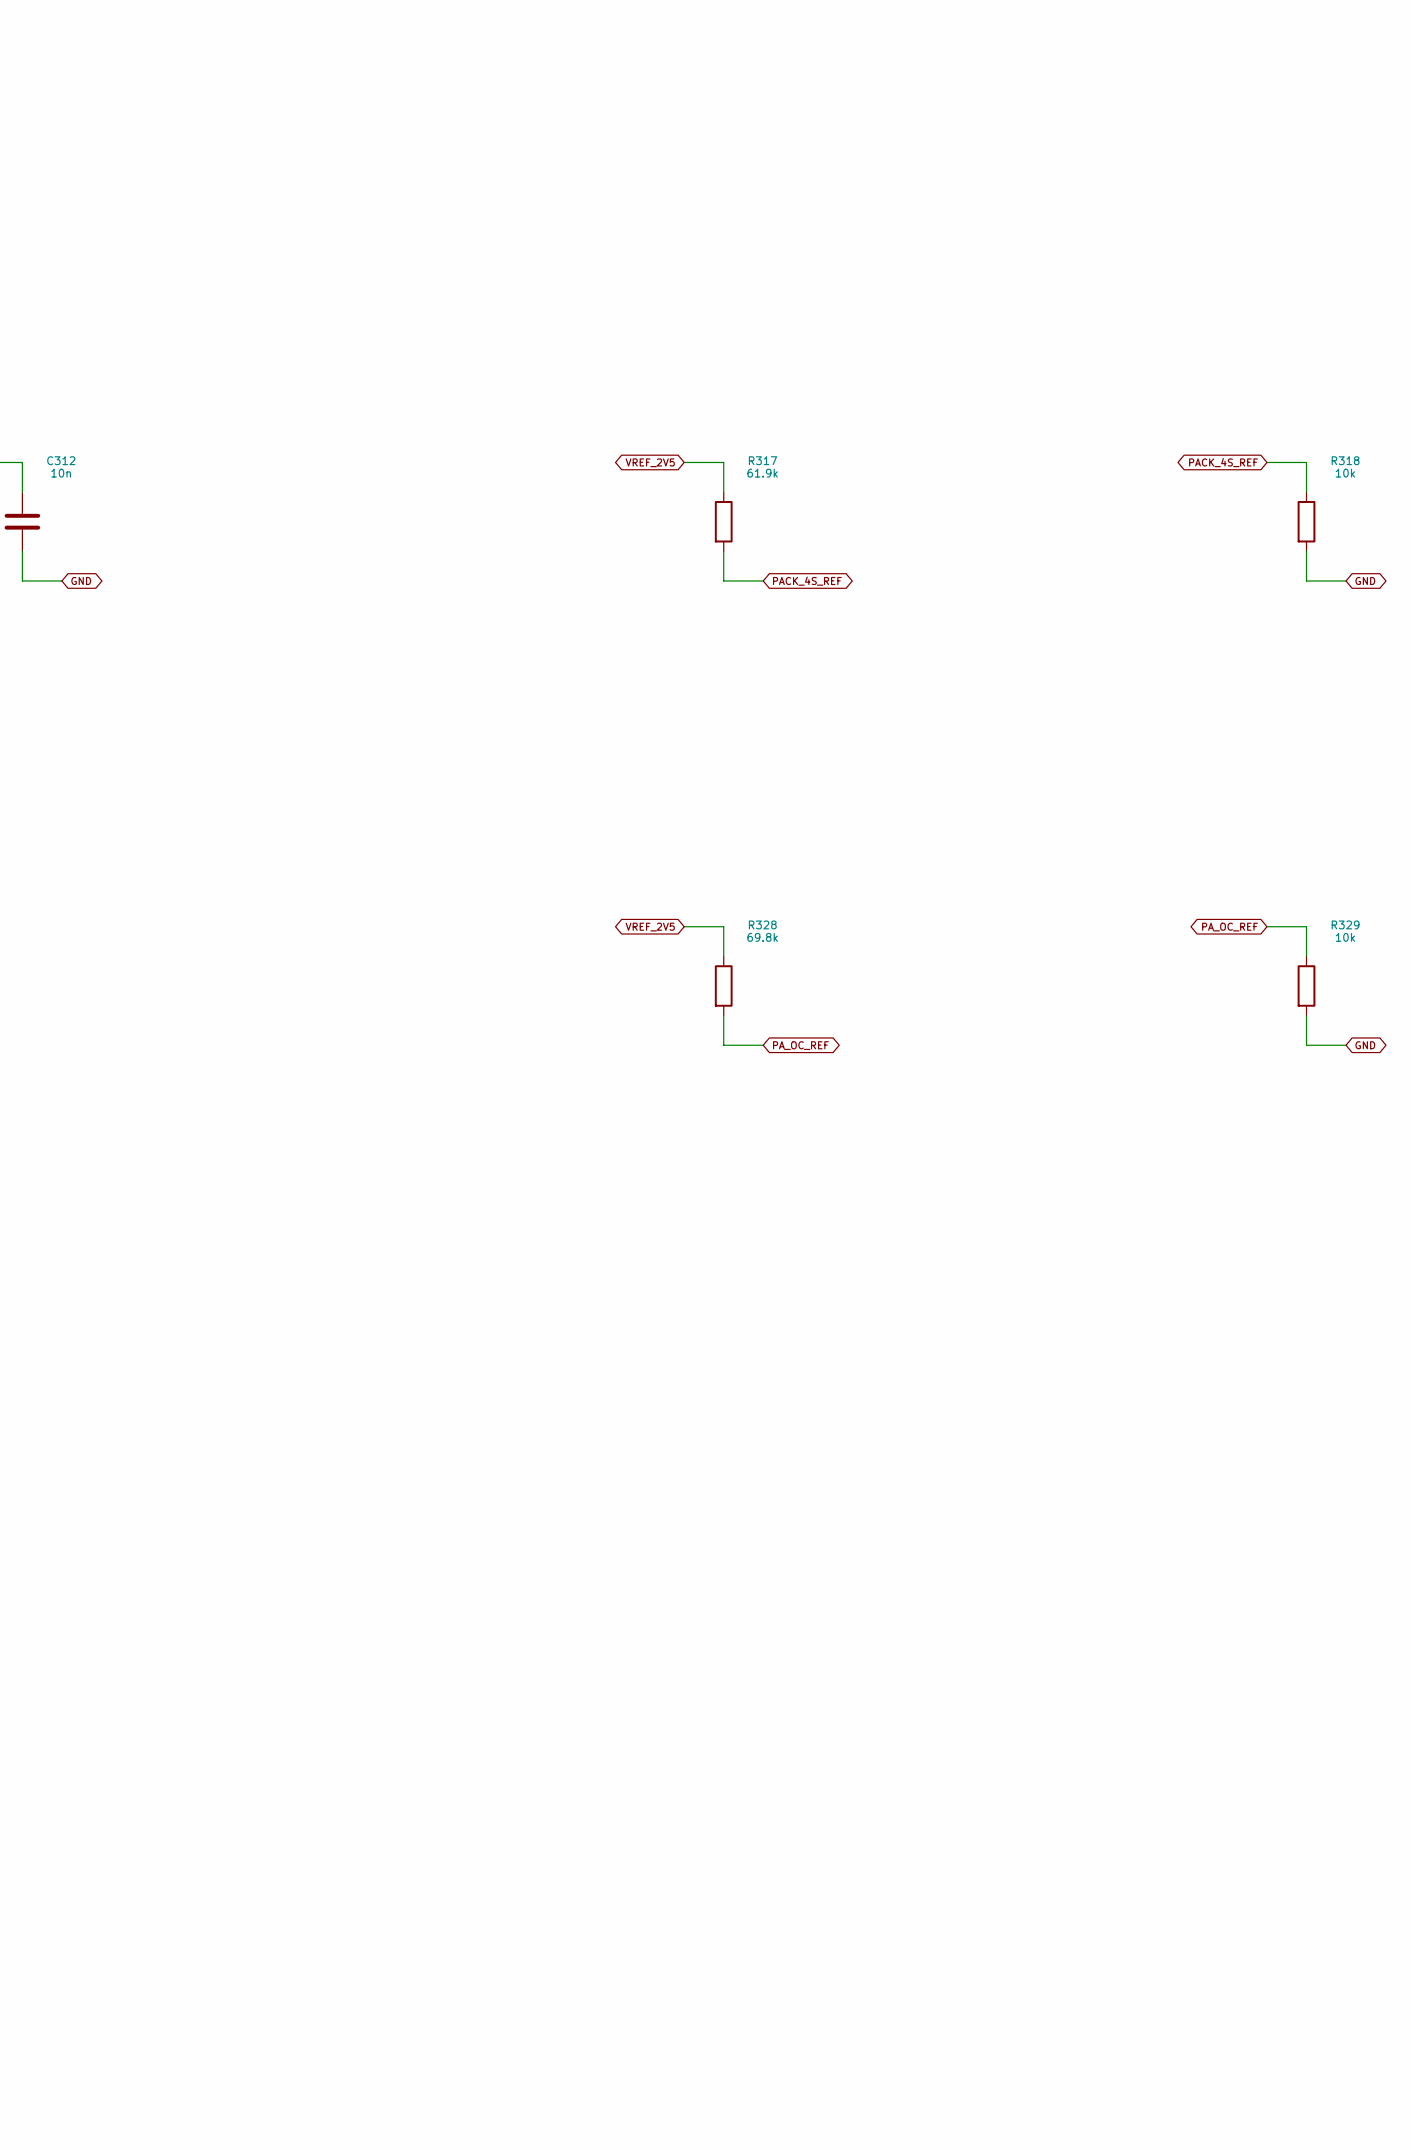
[picture p406: schematic 06b_thresholds.kicad_sch, 06b Independent threshold dividers, part in row 1, column 2]

Parts:
C312: 10n; C_0603_1608Metric; MPN CC0603KRX7R9BB103
R315: 127k; R_0603_1608Metric; MPN RC0603FR-07127KL
R316, R318, R327, R329: 10k; R_0603_1608Metric; MPN RC0603FR-0710KL
R317: 61.9k; R_0603_1608Metric; MPN RC0603FR-0761K9L
R326: 78.7k; R_0603_1608Metric; MPN RC0603FR-0778K7L
R328: 69.8k; R_0603_1608Metric; MPN RC0603FR-0769K8L

Connections:
GND: C312.2, R316.2, R318.2, R327.2, R329.2; also elsewhere on the board
PACK_2S_REF: C312.1, R315.2, R316.1; also elsewhere on the board
PACK_4S_REF: R317.2, R318.1; also elsewhere on the board
PA_OC_REF: R328.2, R329.1; also elsewhere on the board
PA_OV_REF: R326.2, R327.1; also elsewhere on the board
VREF_2V5: R315.1, R317.1, R326.1, R328.1; also elsewhere on the board

Notes on the sheet:
06b Independent threshold dividers
Independent reference dividers from regulated TL431 node, not a loaded shared half-reference. Pack and PA voltage signals divideby31.9; INA current signal divides by4. No comparator pin exceeds1.05V for28V input/rail or3.465V current-sense saturation. Thermal divider ratios sharetheir own<1.0V node.
Calculated at2.495V reference: commonUV5.810V protectedinput;4Sbackup11.070V protectedinput; OV8.973V rail; currenttrip1.251A. AddmeasuredSS34drop forrawpackthreshold. Controller operation stillstopsatapproximately6.0/12.0V; cell-group BMSexternal. Referencebias180ohm supports>=1mA TL431cathodecurr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
M4A-V1: PRODUCTION-INTENT - NOT RELEASED / all physical gates NOT_RUN.
