DD1SB/ARDF-TX/hardware/80m/production/RF80_V1.kicad_pcb

## KiCad design hardware/80m/production/RF80_V1.kicad_pcb (continued)

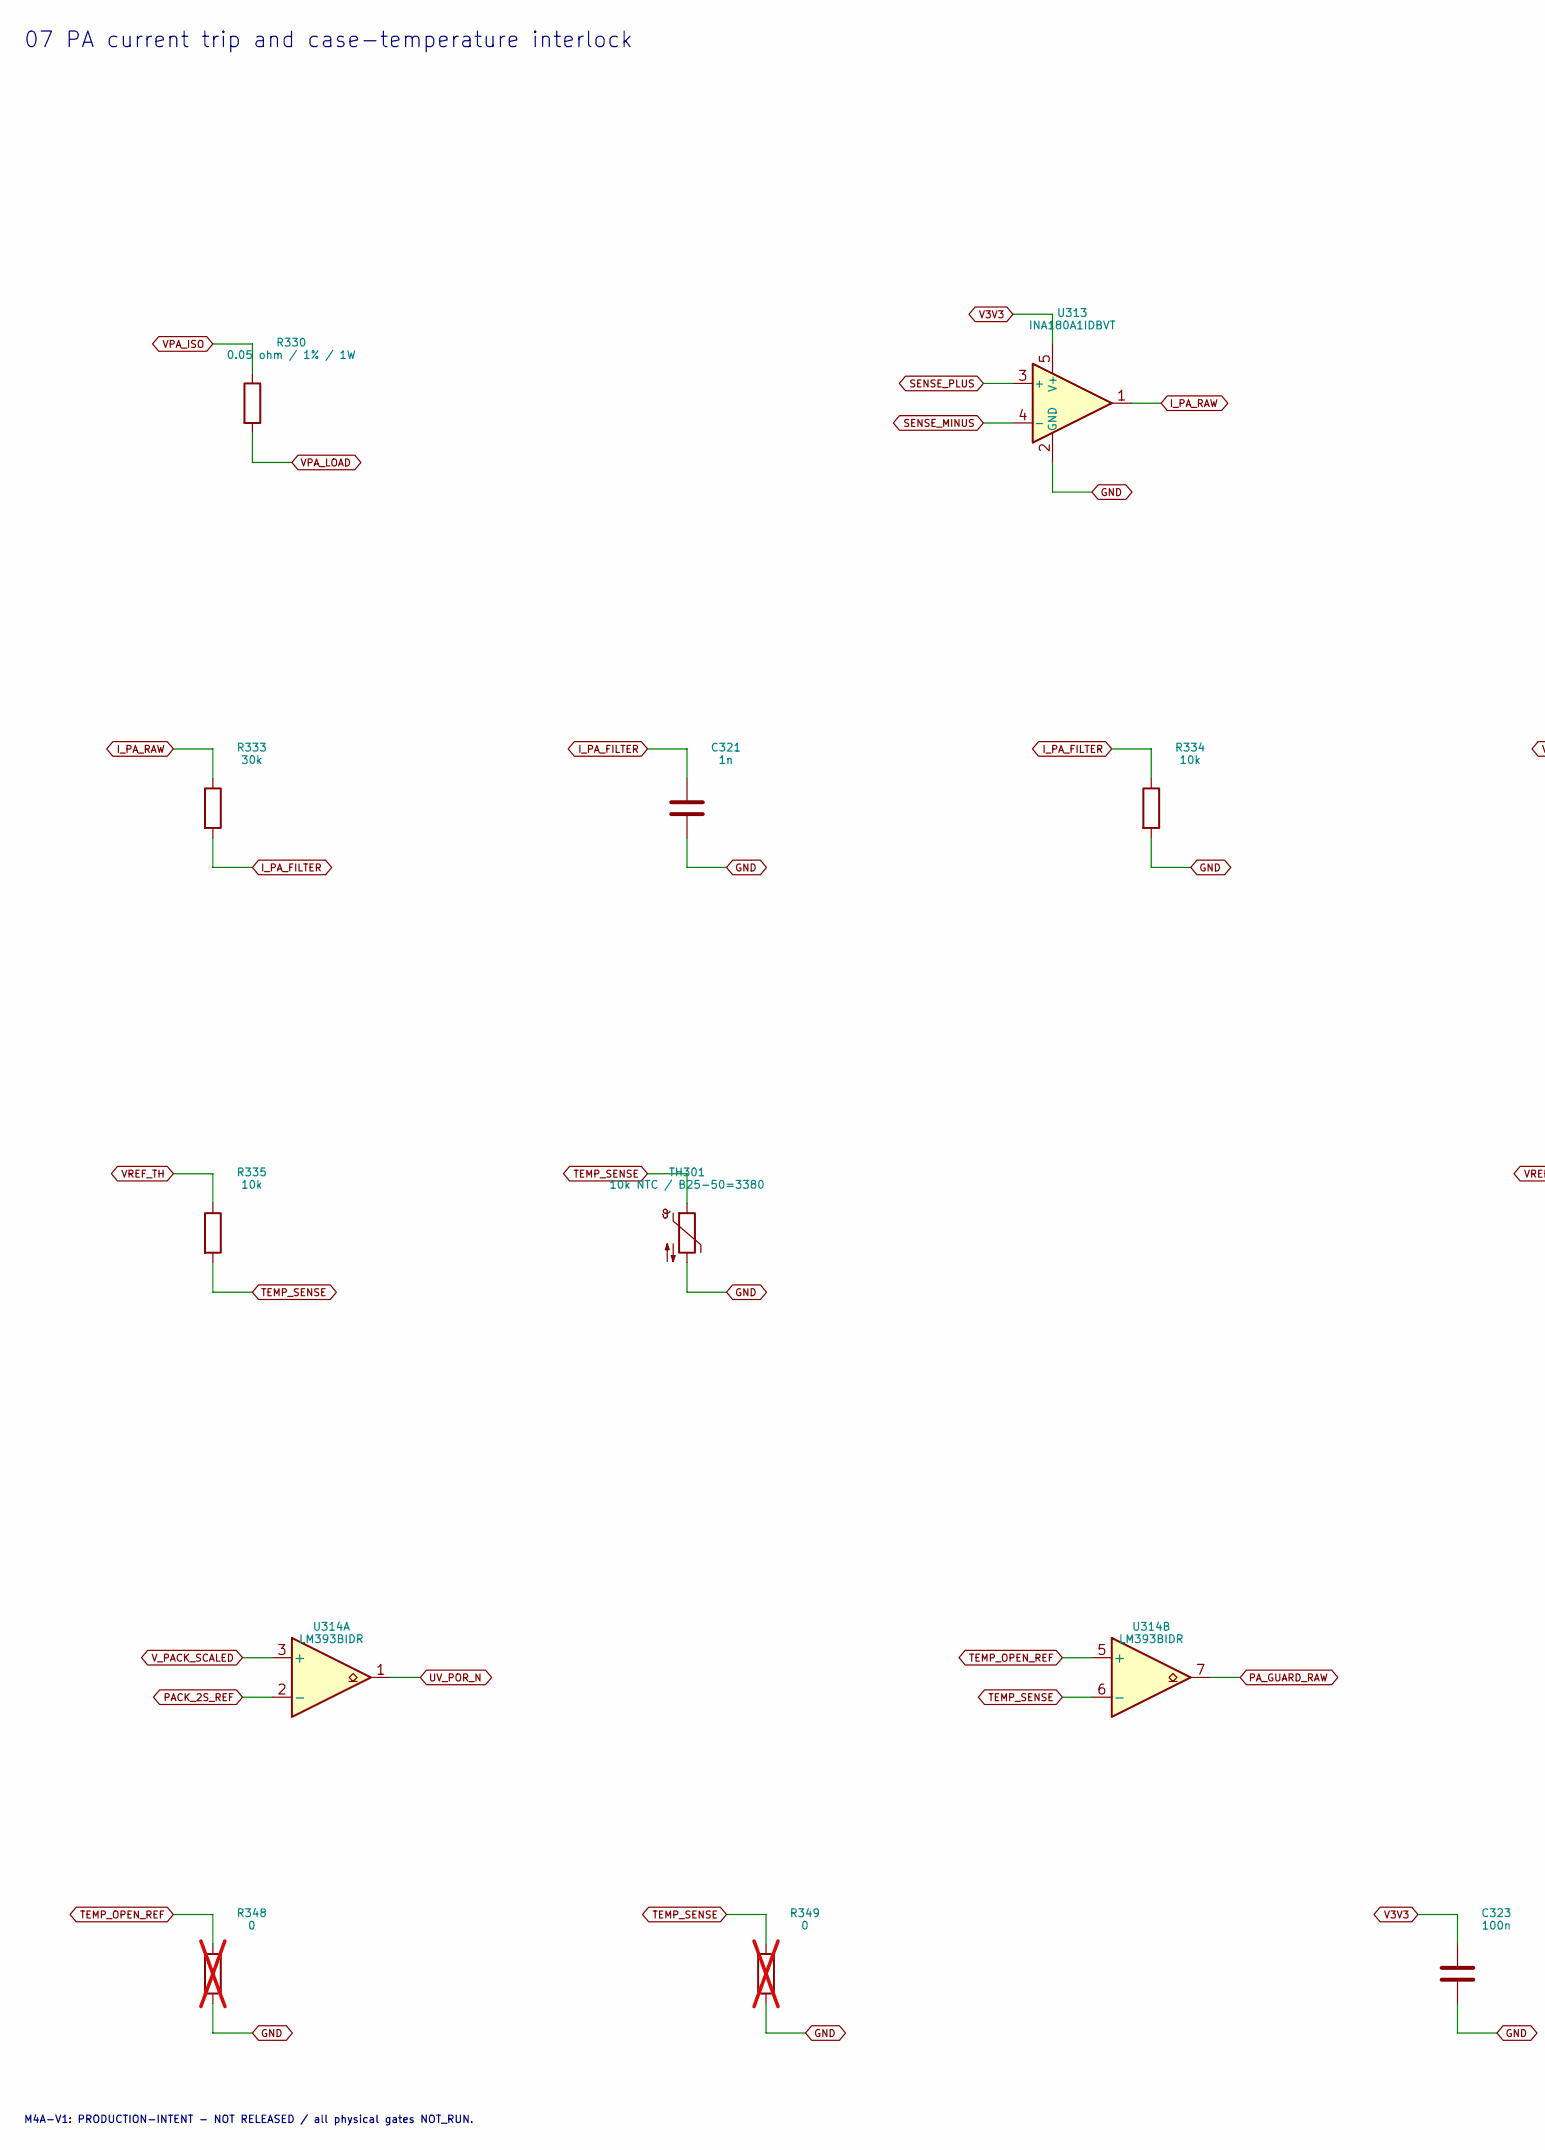
[picture p407: schematic 07_current_thermal.kicad_sch, 07 PA current trip and case-temperature interlock, part in row 1, column 1]

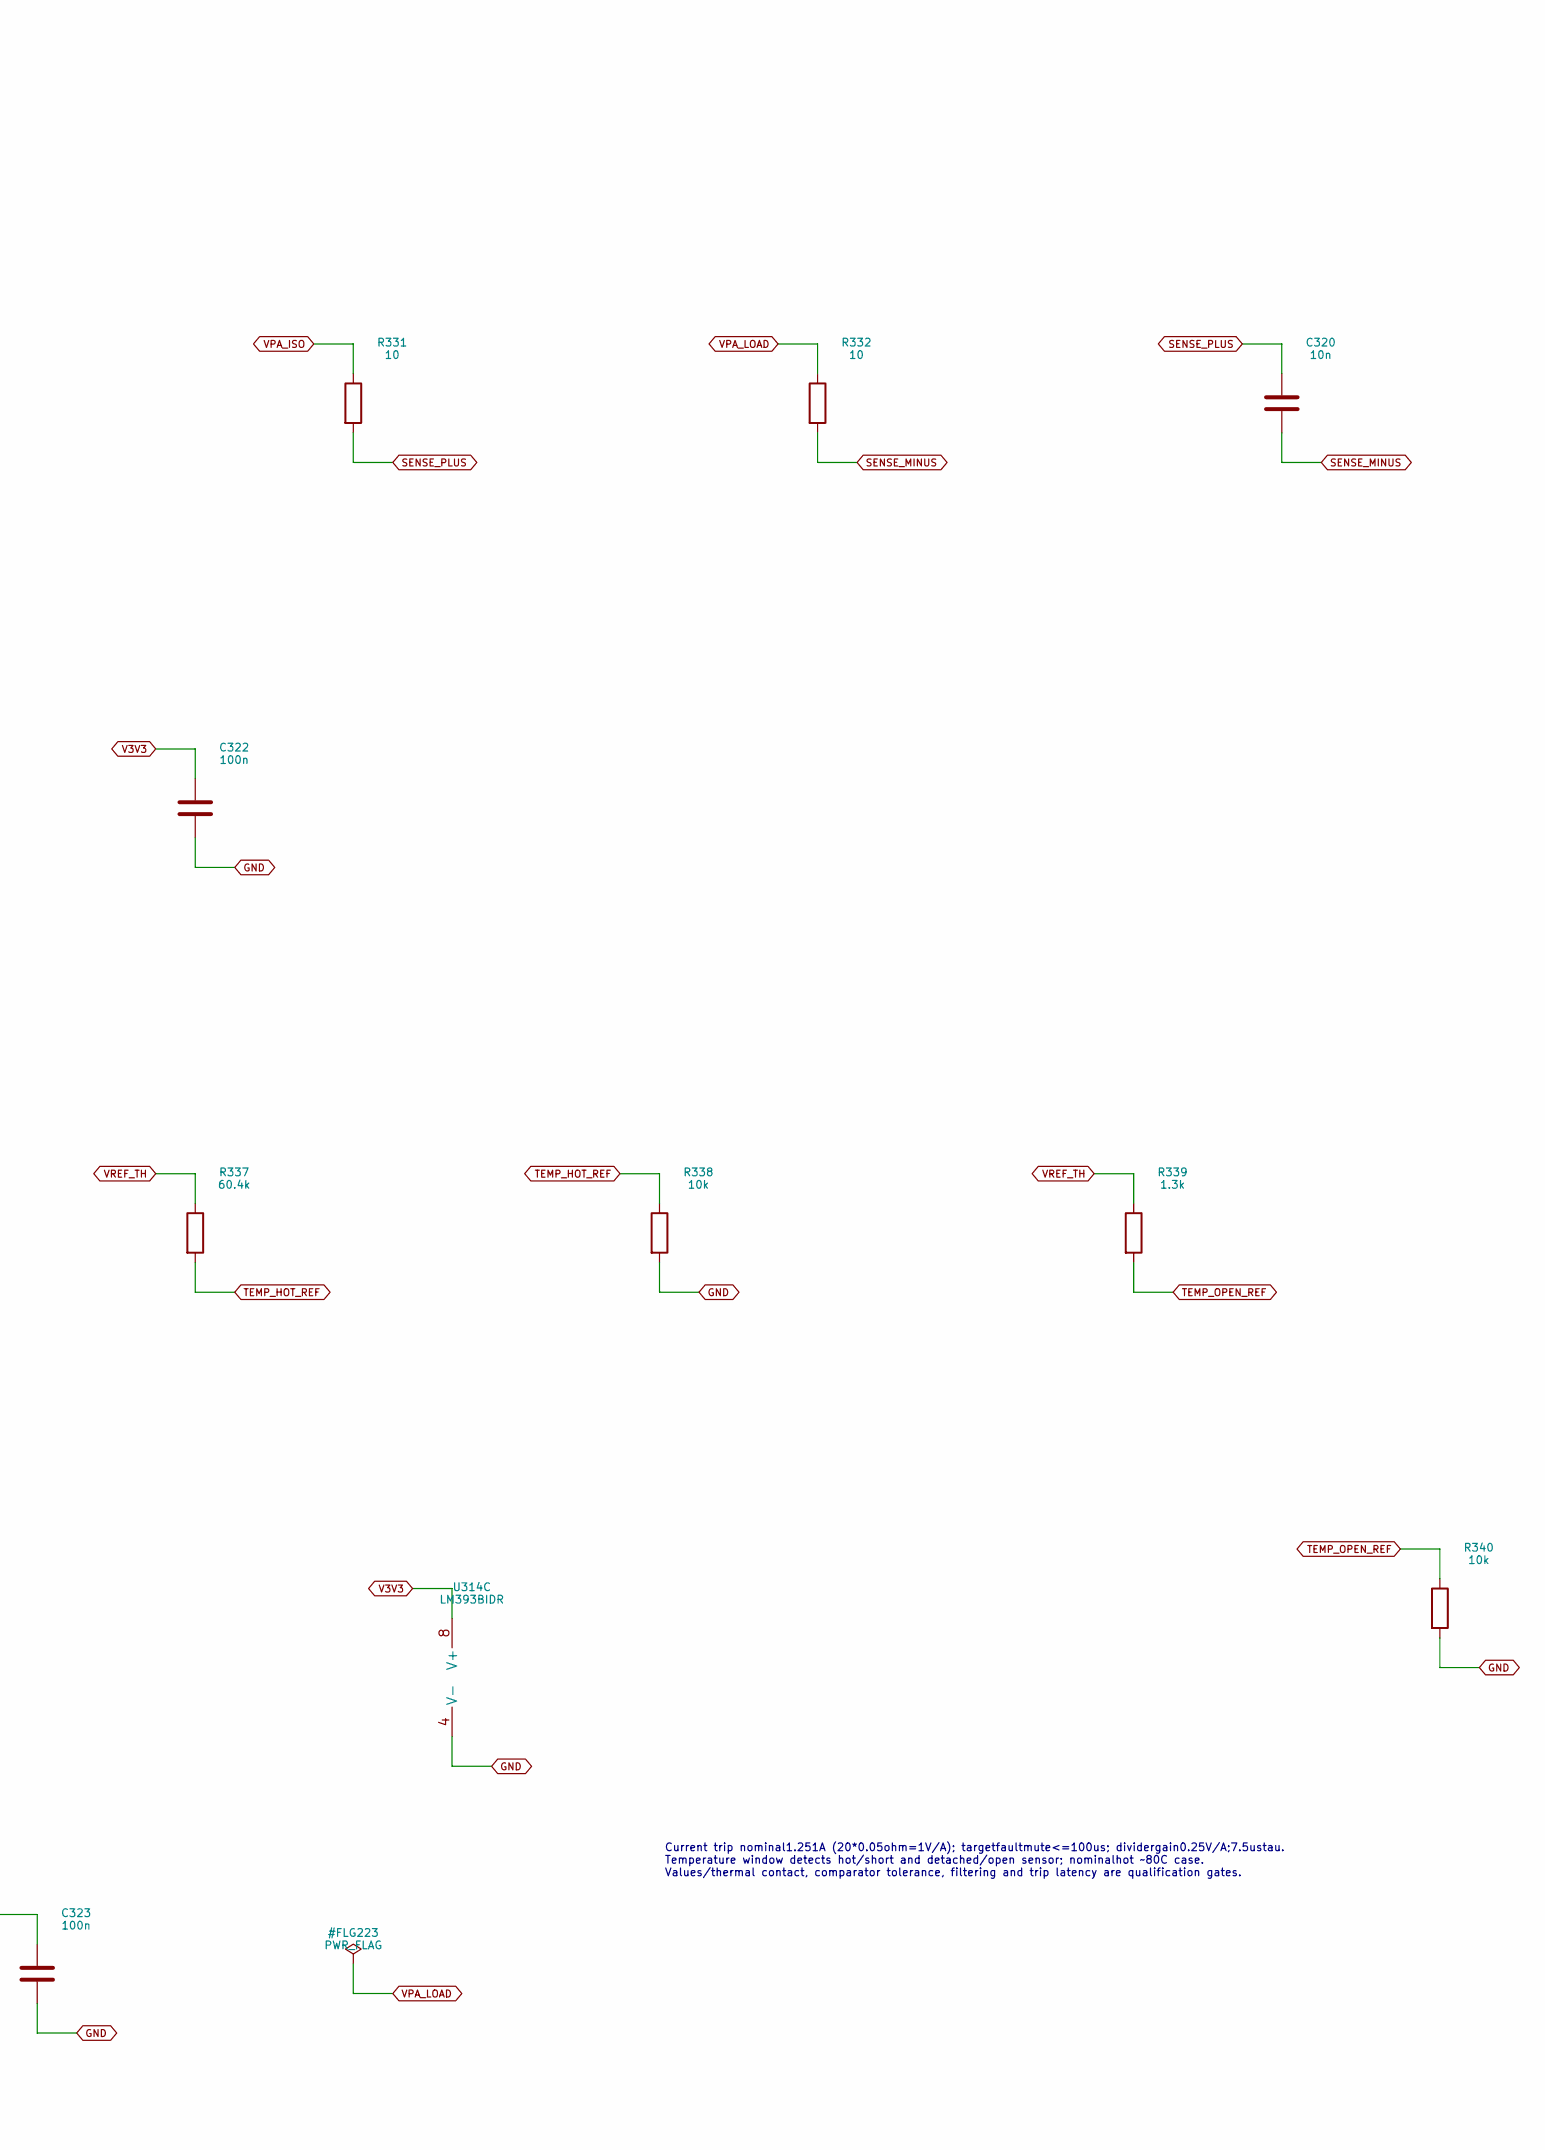
[picture p408: schematic 07_current_thermal.kicad_sch, 07 PA current trip and case-temperature interlock, part in row 1, column 2]

Parts:
C320: 10n; C_0603_1608Metric; MPN CC0603KRX7R9BB103
C321: 1n; C_0603_1608Metric; MPN CC0603JRNPO9BN102
C322, C323: 100n; C_0603_1608Metric; MPN CC0603KRX7R8BB104
R330: 0.05 ohm / 1% / 1W; R_2512_6332Metric; MPN WSL2512R0500FEA
R331, R332: 10; R_0603_1608Metric; MPN RC0603FR-0710RL
R333: 30k; R_0603_1608Metric; MPN RC0603FR-0730KL
R334, R335, R338, R340: 10k; R_0603_1608Metric; MPN RC0603FR-0710KL
R337: 60.4k; R_0603_1608Metric; MPN RC0603FR-0760K4L
R339: 1.3k; R_0603_1608Metric; MPN RC0603FR-071K3L
R348, R349: 0; R_0603_1608Metric; MPN RC0603JR-070RL; not fitted
TH301: 10k NTC / B25-50=3380; R_0603_1608Metric; MPN NCP18XH103F03RB
U313: INA180A1IDBVT; SOT-23-5; MPN INA180A1IDBVT
U314: LM393BIDR; SOIC-8_3.9x4.9mm_P1.27mm; MPN LM393BIDR

Connections:
GND: C321.2, C322.2, C323.2, R334.2, R338.2, R340.2, R348.2, R349.2, TH301.2, U313.2 (GND), U314.4 (V-); also elsewhere on the board
I_PA_FILTER: C321.1, R333.2, R334.1; also elsewhere on the board
I_PA_RAW: R333.1, U313.1
PACK_2S_REF: U314.2 (-); also elsewhere on the board
PA_GUARD_RAW: U314.7; also elsewhere on the board
SENSE_MINUS: C320.2, R332.2, U313.4 (-)
SENSE_PLUS: C320.1, R331.2, U313.3 (+)
TEMP_HOT_REF: R337.2, R338.1; also elsewhere on the board
TEMP_OPEN_REF: R339.2, R340.1, R348.1, U314.5 (+)
TEMP_SENSE: R335.2, R349.1, TH301.1, U314.6 (-); also elsewhere on the board
UV_POR_N: U314.1; also elsewhere on the board
V3V3: C322.1, C323.1, U313.5 (V+), U314.8 (V+); also elsewhere on the board
VPA_ISO: R330.1, R331.1; also elsewhere on the board
VPA_LOAD: R330.2, R332.1; also elsewhere on the board
VREF_TH: R335.1, R337.1, R339.1; also elsewhere on the board
V_PACK_SCALED: U314.3 (+); also elsewhere on the board

Notes on the sheet:
07 PA current trip and case-temperature interlock
Current trip nominal1.251A (20*0.05ohm=1V/A); targetfaultmute<=100us; dividergain0.25V/A;7.5ustau. Temperature window detects hot/short and detached/open sensor; nominalhot ~80C case. Values/thermal contact, comparator tolerance, filtering and trip latency are qualification gates.
M4A-V1: PRODUCTION-INTENT - NOT RELEASED / all physical gates NOT_RUN.

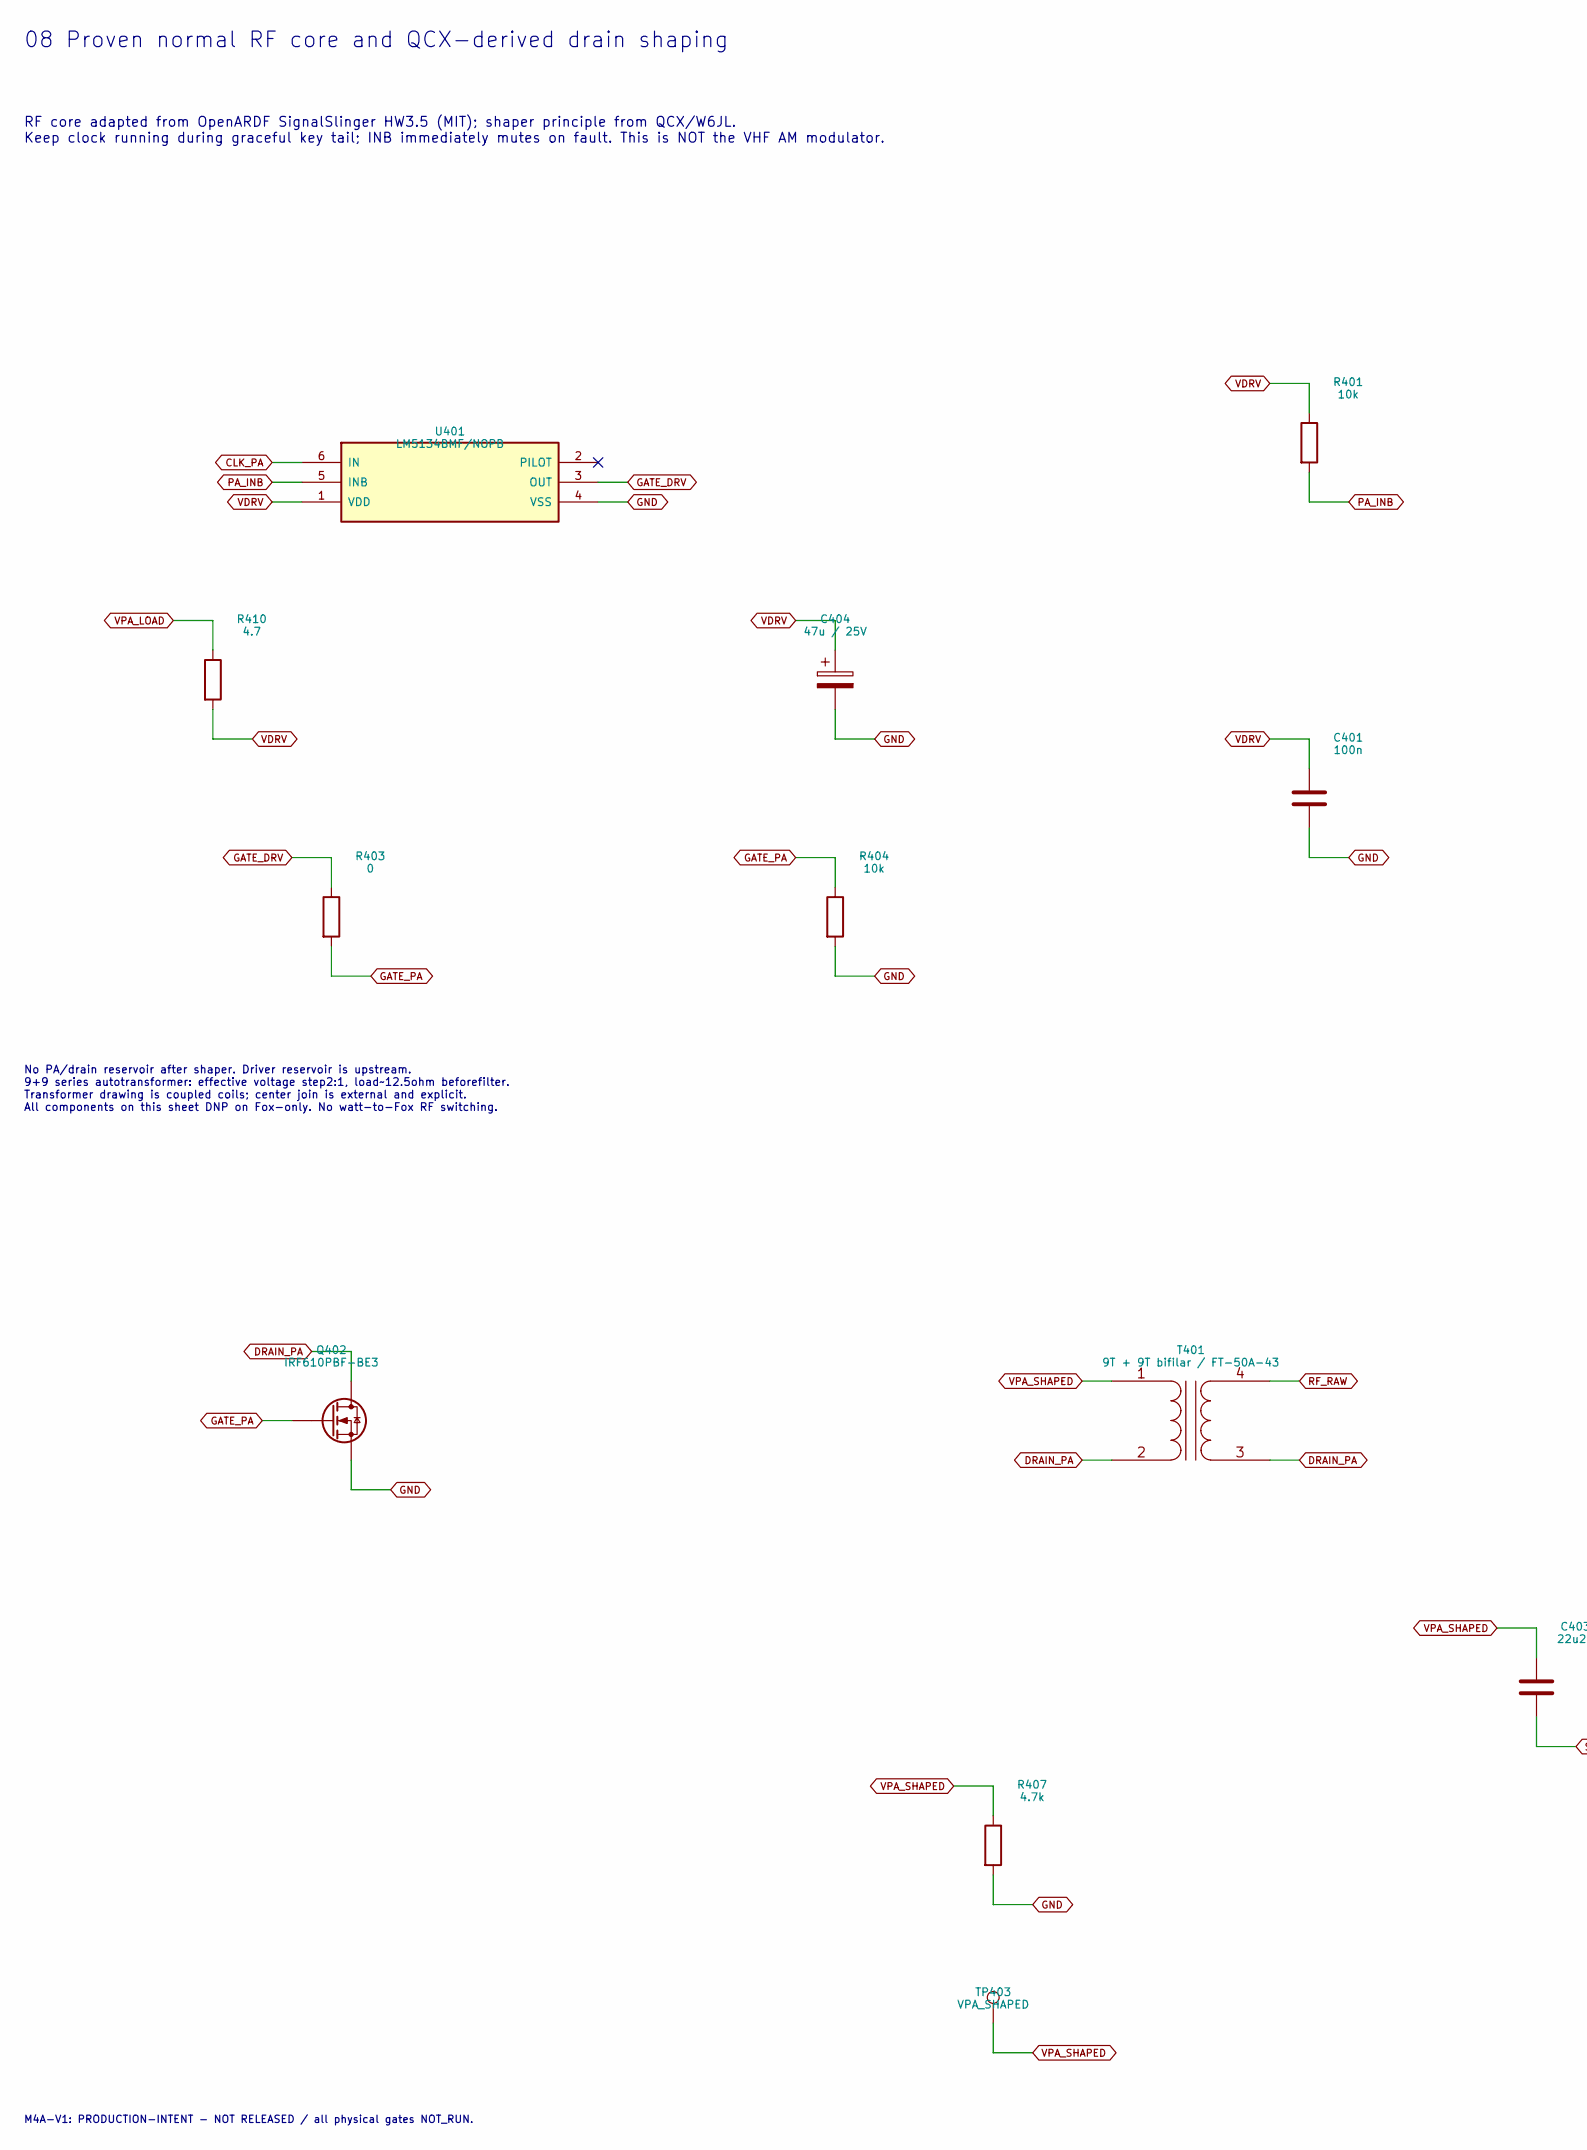
[picture p409: schematic 08_normal_rf.kicad_sch, 08 Proven normal RF core and QCX-derived drain shaping, part in row 1, column 1]

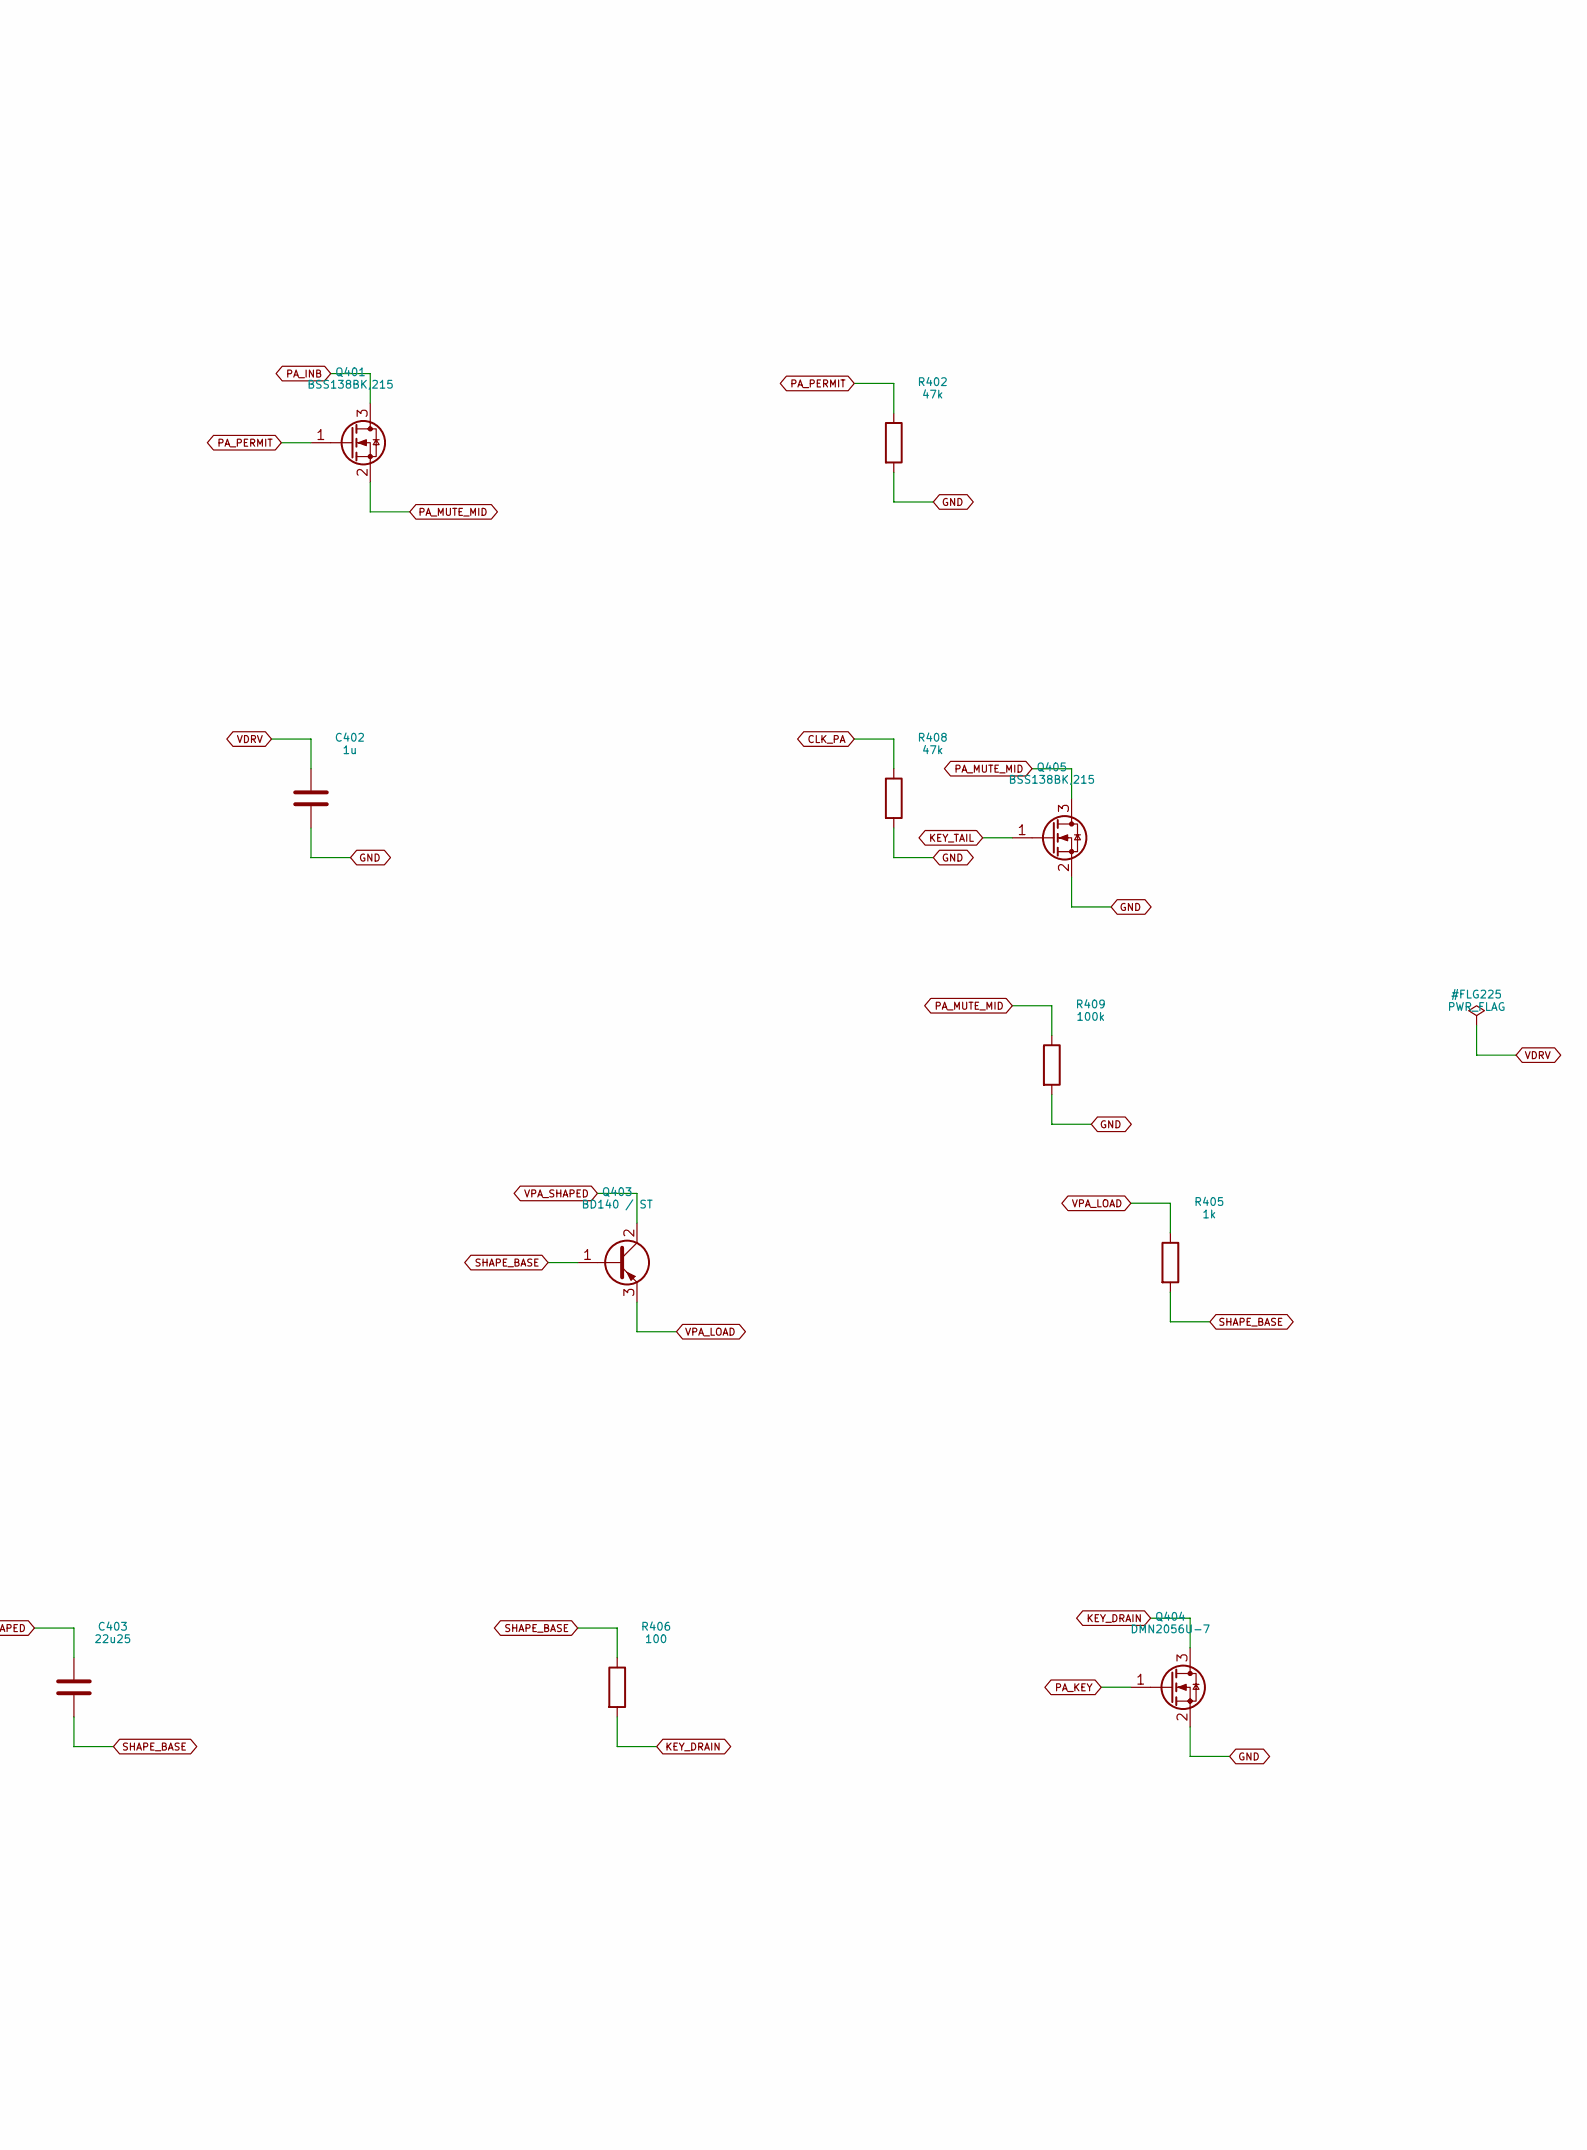
[picture p410: schematic 08_normal_rf.kicad_sch, 08 Proven normal RF core and QCX-derived drain shaping, part in row 1, column 2]

Parts:
C401: 100n; C_0603_1608Metric; MPN CC0603KRX7R8BB104
C402: 1u; C_0805_2012Metric; MPN CC0805KKX7R9BB105
C403: 22u25; C_1210_3225Metric; MPN GRM32ER71E226KE15L
C404: 47u / 25V; CP_Elec_6.3x5.9; MPN 25SVPF47M
Q401, Q405: BSS138BK,215; SOT-23; MPN BSS138BK,215
Q402: IRF610PBF-BE3; Vishay_IRF610_TO220_StandardPTH; MPN IRF610PBF-BE3
Q403: BD140 / ST; ST_BD140_SOT32_StandardPTH; MPN BD140
Q404: DMN2056U-7; SOT-23; MPN DMN2056U-7
R401, R404: 10k; R_0603_1608Metric; MPN RC0603FR-0710KL
R402, R408: 47k; R_0603_1608Metric; MPN RC0603FR-0747KL
R403: 0; R_0603_1608Metric; MPN RC0603JR-070RL
R405: 1k; R_0603_1608Metric; MPN RC0603FR-071KL
R406: 100; R_2512_6332Metric; MPN CRCW2512100RFKEG
R407: 4.7k; R_0603_1608Metric; MPN RC0603FR-074K7L
R409: 100k; R_0603_1608Metric; MPN RC0603FR-07100KL
R410: 4.7; R_2512_6332Metric; MPN CRCW25124R70FKEG
T401: 9T + 9T bifilar / FT-50A-43; FT50A43_Inline_4Terminal; MPN Amidon FT-50A-43 + AWG24 enamel Cu
TP403: VPA_SHAPED; TestPoint_Pad_D1.0mm; MPN PCB pad / no purchased component
U401: LM5134BMF/NOPB; SOT-23-6; MPN LM5134BMF/NOPB

Connections:
CLK_PA: R408.1, U401.6 (IN); also elsewhere on the board
DRAIN_PA: Q402.2 (D), T401.2 (AB), T401.3 (SA)
GATE_DRV: R403.1, U401.3 (OUT)
GATE_PA: Q402.1 (G), R403.2, R404.1
GND: C401.2, C402.2, C404.2, Q402.3 (S), Q404.2 (S), Q405.2 (S), R402.2, R404.2, R407.2, R408.2, R409.2, U401.4 (VSS); also elsewhere on the board
KEY_DRAIN: Q404.3 (D), R406.2
KEY_TAIL: Q405.1 (G); also elsewhere on the board
PA_INB: Q401.3 (D), R401.2, U401.5 (INB)
PA_KEY: Q404.1 (G); also elsewhere on the board
PA_MUTE_MID: Q401.2 (S), Q405.3 (D), R409.1
PA_PERMIT: Q401.1 (G), R402.1; also elsewhere on the board
RF_RAW: T401.4 (SB); also elsewhere on the board
SHAPE_BASE: C403.2, Q403.1 (B), R405.2, R406.1
VDRV: C401.1, C402.1, C404.1, R401.1, R410.2, U401.1 (VDD); also elsewhere on the board
VPA_LOAD: Q403.3 (E), R405.1, R410.1; also elsewhere on the board
VPA_SHAPED: C403.1, Q403.2 (C), R407.1, T401.1 (AA), TP403.1; also elsewhere on the board

Notes on the sheet:
08 Proven normal RF core and QCX-derived drain shaping
RF core adapted from OpenARDF SignalSlinger HW3.5 (MIT); shaper principle from QCX/W6JL. Keep clock running during graceful key tail; INB immediately mutes on fault. This is NOT the VHF AM modulator.
No PA/drain reservoir after shaper. Driver reservoir is upstream. 9+9 series autotransformer: effective voltage step2:1, load~12.5ohm beforefilter. Transformer drawing is coupled coils; center join is external and explicit. All components on this sheet DNP on Fox-only. No watt-to-Fox RF switching.
M4A-V1: PRODUCTION-INTENT - NOT RELEASED / all physical gates NOT_RUN.

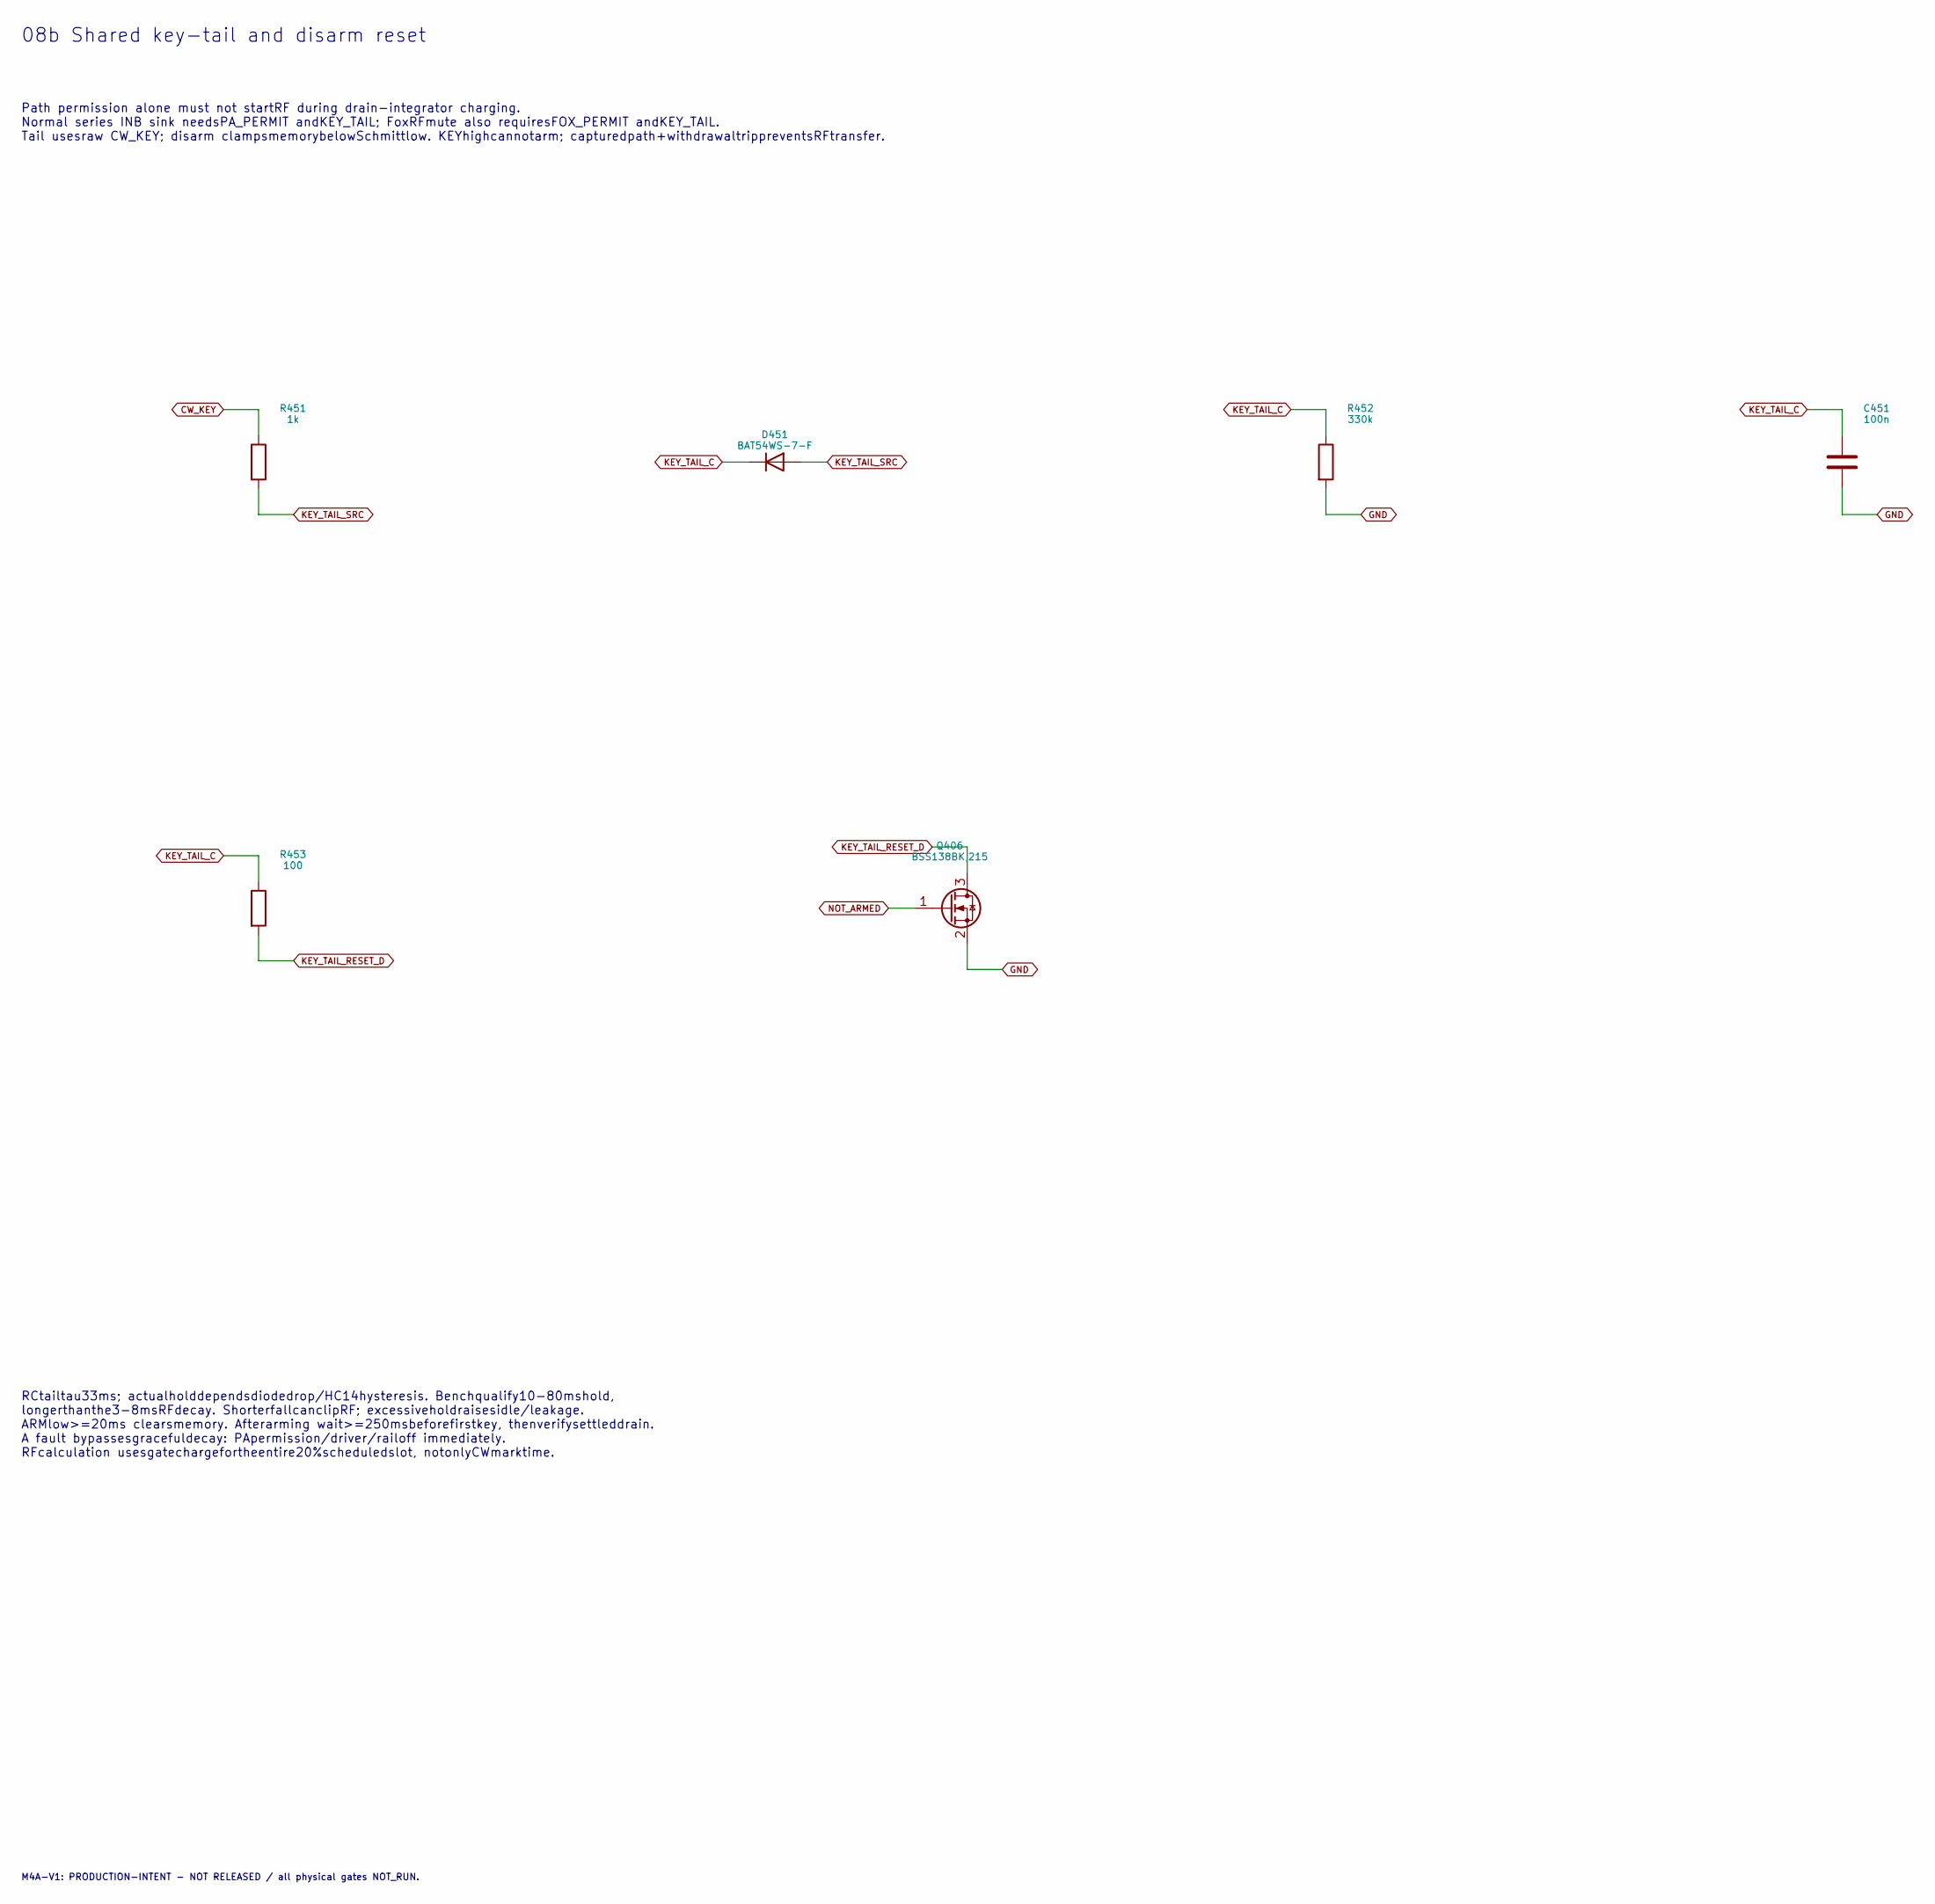
[picture p411: schematic 08b_key_tail.kicad_sch, 08b Shared key-tail and disarm reset]

Parts:
C451: 100n; C_0603_1608Metric; MPN CC0603KRX7R8BB104
D451: BAT54WS-7-F; D_SOD-323; MPN BAT54WS-7-F
Q406: BSS138BK,215; SOT-23; MPN BSS138BK,215
R451: 1k; R_0603_1608Metric; MPN RC0603FR-071KL
R452: 330k; R_0603_1608Metric; MPN RC0603FR-07330KL
R453: 100; R_0603_1608Metric; MPN RC0603FR-07100RL

Connections:
CW_KEY: R451.1; also elsewhere on the board
GND: C451.2, Q406.2 (S), R452.2; also elsewhere on the board
KEY_TAIL_C: C451.1, D451.1 (K), R452.1, R453.1; also elsewhere on the board
KEY_TAIL_RESET_D: Q406.3 (D), R453.2
KEY_TAIL_SRC: D451.2 (A), R451.2
NOT_ARMED: Q406.1 (G); also elsewhere on the board

Notes on the sheet:
08b Shared key-tail and disarm reset
Path permission alone must not startRF during drain-integrator charging. Normal series INB sink needsPA_PERMIT andKEY_TAIL; FoxRFmute also requiresFOX_PERMIT andKEY_TAIL. Tail usesraw CW_KEY; disarm clampsmemorybelowSchmittlow. KEYhighcannotarm; capturedpath+withdrawaltrippreventsRFtransfer.
RCtailtau33ms; actualholddependsdiodedrop/HC14hysteresis. Benchqualify10-80mshold, longerthanthe3-8msRFdecay. ShorterfallcanclipRF; excessiveholdraisesidle/leakage. ARMlow>=20ms clearsmemory. Afterarming wait>=250msbeforefirstkey, thenverifysettleddrain. A fault bypassesgracefuldecay: PApermission/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
M4A-V1: PRODUCTION-INTENT - NOT RELEASED / all physical gates NOT_RUN.
