DD1SB/ARDF-TX/hardware/80m/production/RF80_V1.kicad_pcb

## KiCad design hardware/80m/production/RF80_V1.kicad_pcb (continued)

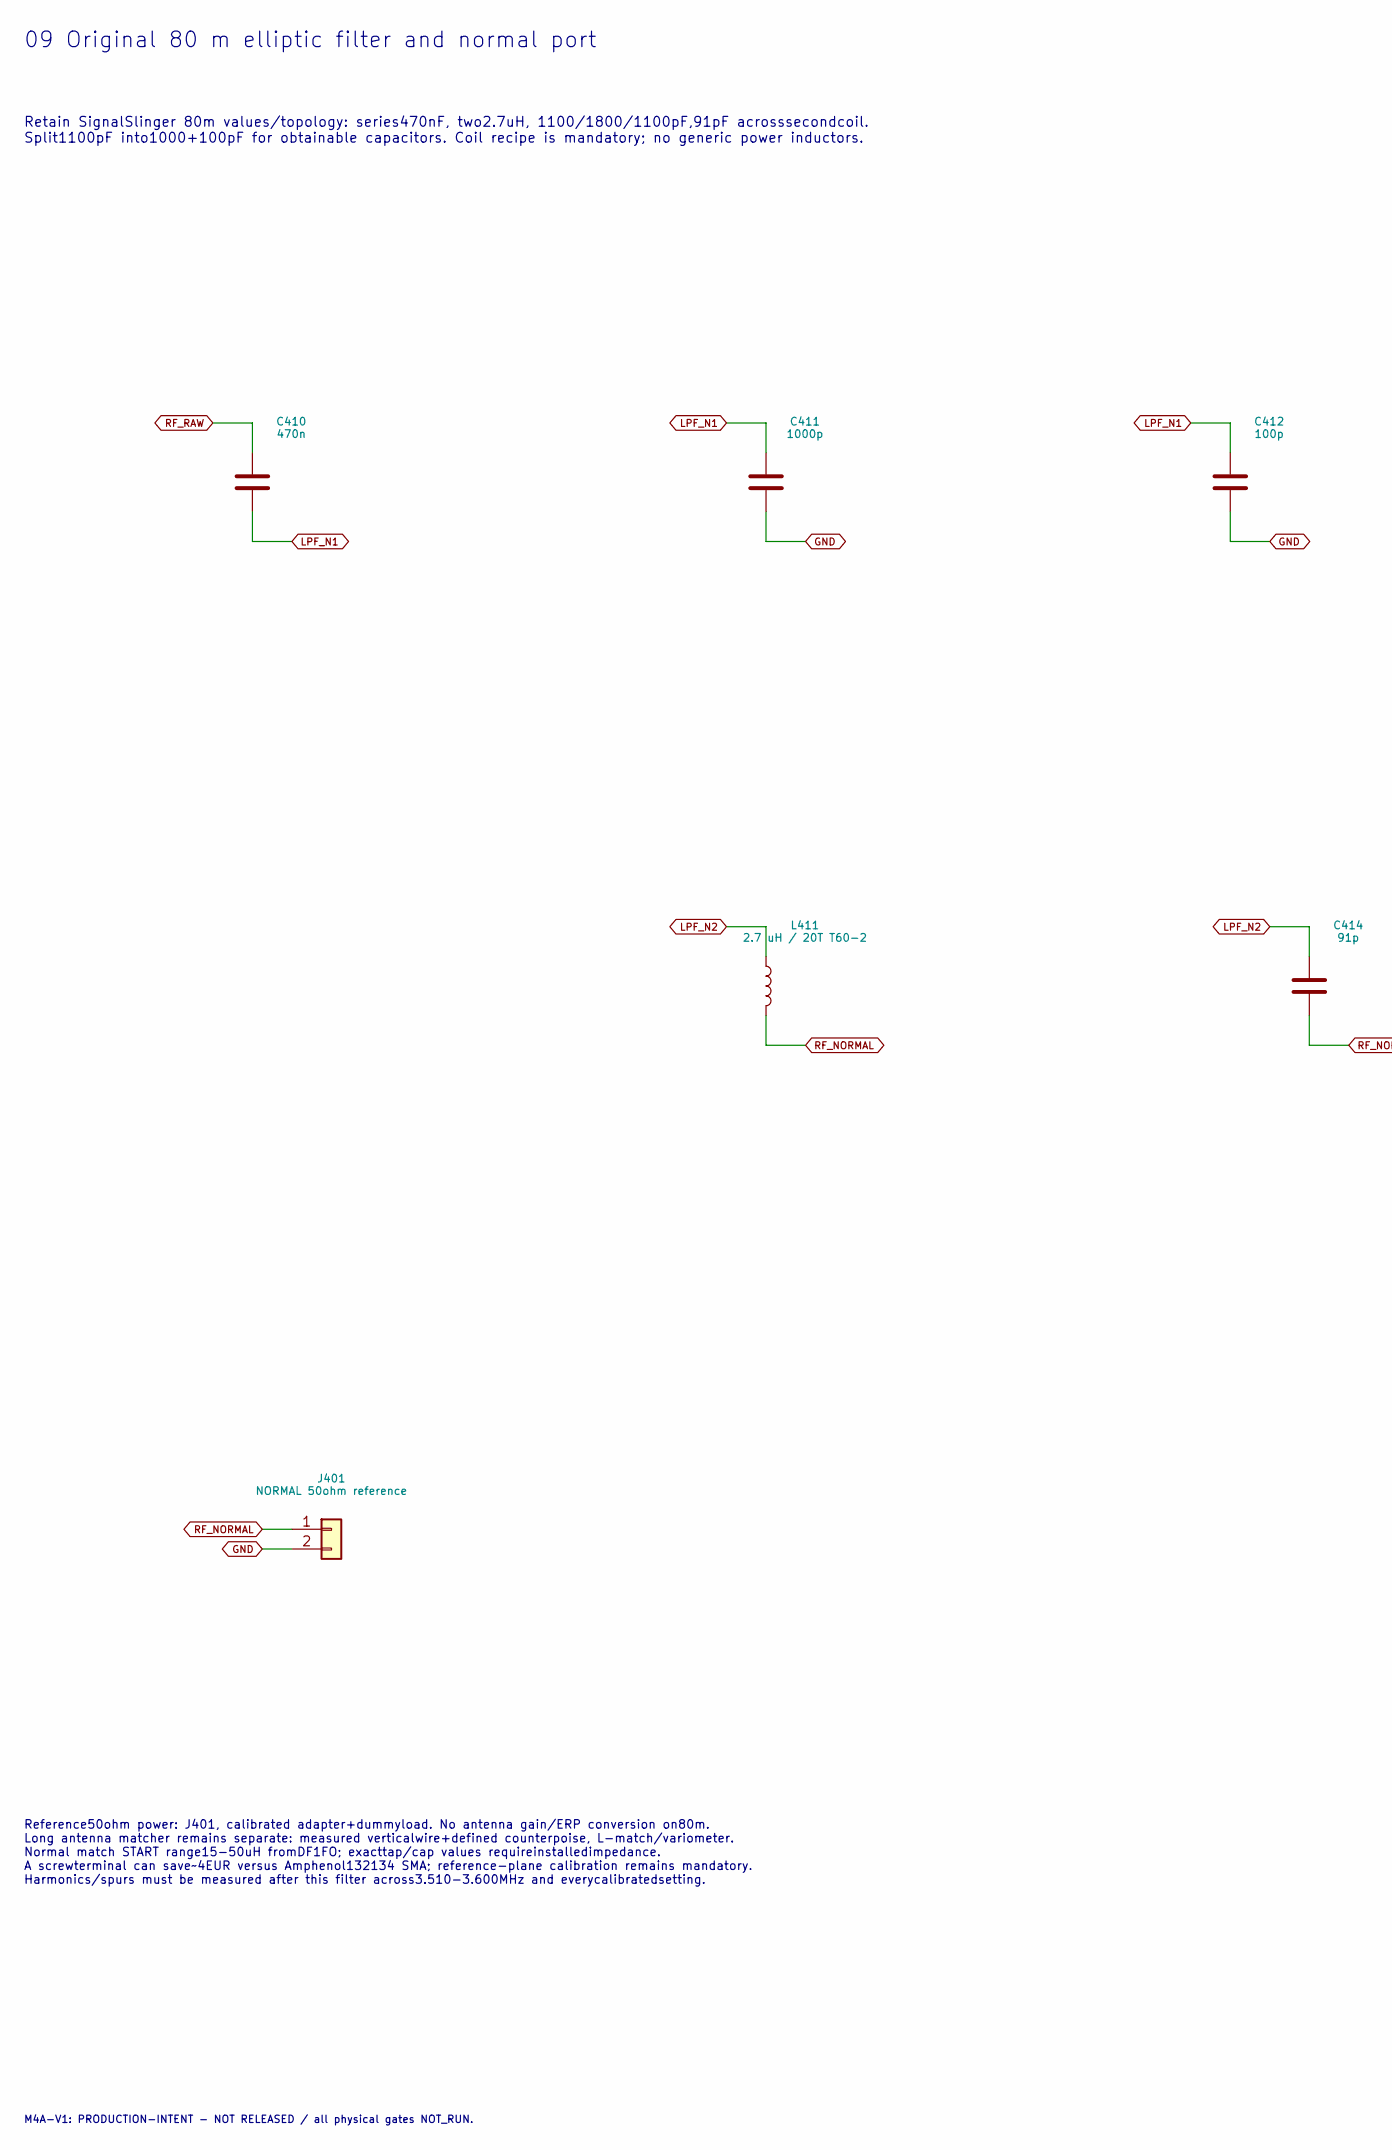
[picture p412: schematic 09_normal_filter.kicad_sch, 09 Original 80 m elliptic filter and normal port, part in row 1, column 1]

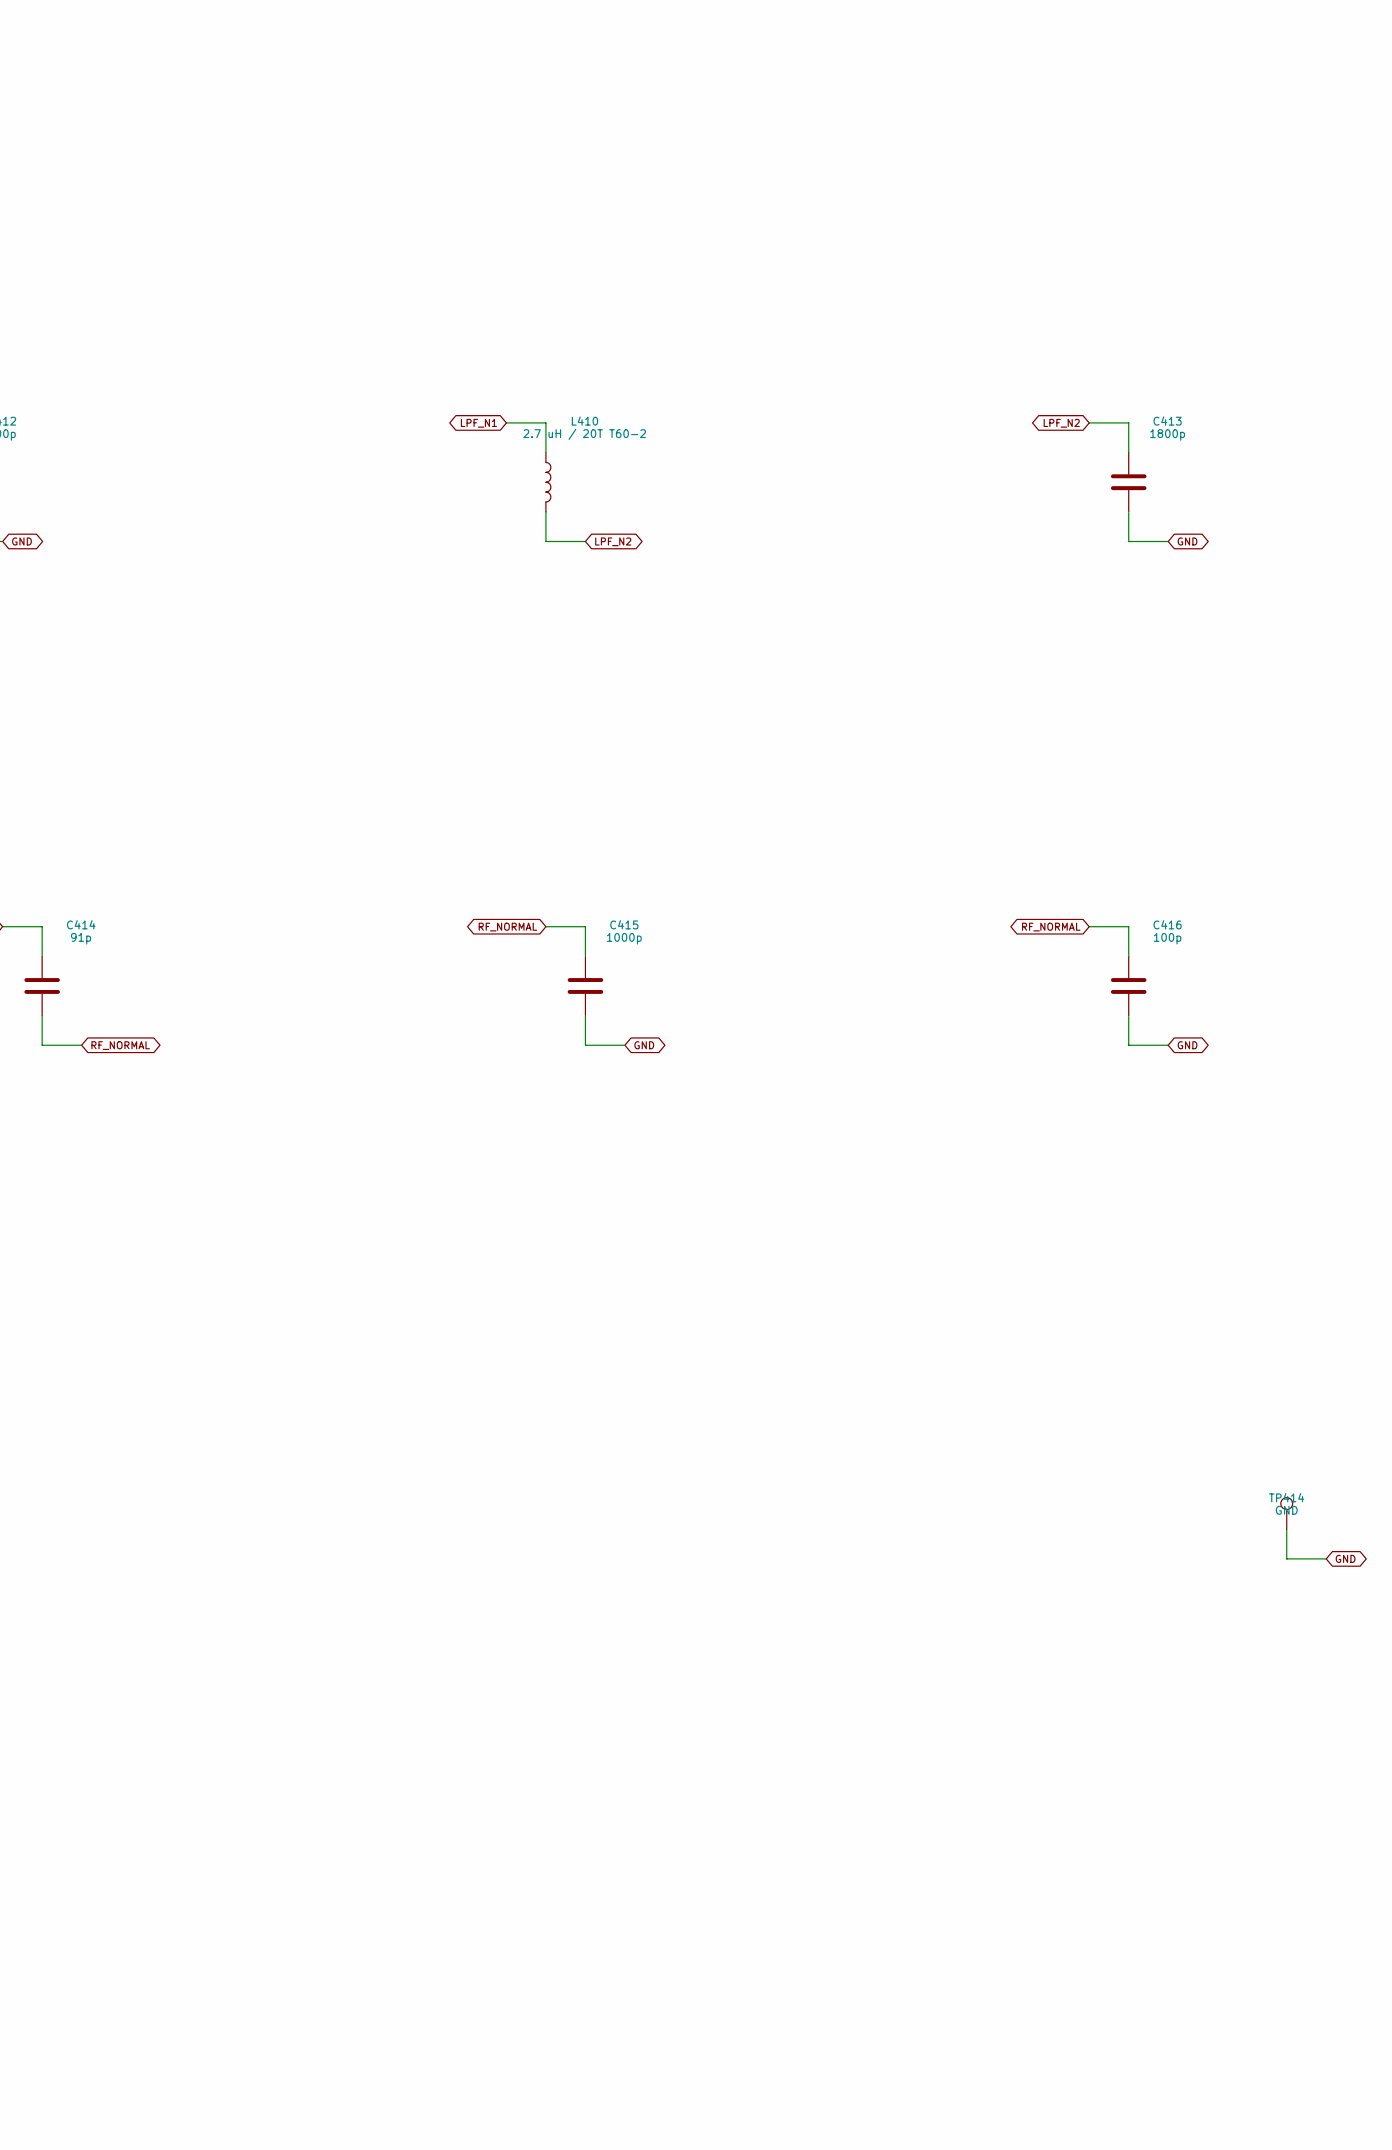
[picture p413: schematic 09_normal_filter.kicad_sch, 09 Original 80 m elliptic filter and normal port, part in row 1, column 2]

Parts:
C410: 470n; C_1206_3216Metric; MPN C3216X7R2A474K160AB
C411, C415: 1000p; C_0805_2012Metric; MPN C0805C102J1GACTU
C412, C416: 100p; C_0805_2012Metric; MPN C0805C101J1GACTU
C413: 1800p; C_0805_2012Metric; MPN C0805C182J1GACTU
C414: 91p; C_0805_2012Metric; MPN C0805C910J1GACTU
J401: NORMAL 50ohm reference; Phoenix_1727010_StandardPTH; MPN 1727010
L410, L411: 2.7 uH / 20T T60-2; T60_2_20T; MPN Micrometals T60-2 + AWG24 Cu
TP414: GND; TestPoint_Pad_D1.0mm; MPN PCB pad / no purchased component

Connections:
GND: C411.2, C412.2, C413.2, C415.2, C416.2, J401.2, TP414.1; also elsewhere on the board
LPF_N1: C410.2, C411.1, C412.1, L410.1
LPF_N2: C413.1, C414.1, L410.2, L411.1
RF_NORMAL: C414.2, C415.1, C416.1, J401.1, L411.2
RF_RAW: C410.1; also elsewhere on the board

Notes on the sheet:
09 Original 80 m elliptic filter and normal port
Retain SignalSlinger 80m values/topology: series470nF, two2.7uH, 1100/1800/1100pF,91pF acrosssecondcoil. Split1100pF into1000+100pF for obtainable capacitors. Coil recipe is mandatory; no generic power inductors.
Reference50ohm power: J401, calibrated adapter+dummyload. No antenna gain/ERP conversion on80m. Long antenna matcher remains separate: measured verticalwire+defined counterpoise, L-match/variometer. Normal match START range15-50uH fromDF1FO; exacttap/cap values requireinstalledimpedance. A screwter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
M4A-V1: PRODUCTION-INTENT - NOT RELEASED / all physical gates NOT_RUN.

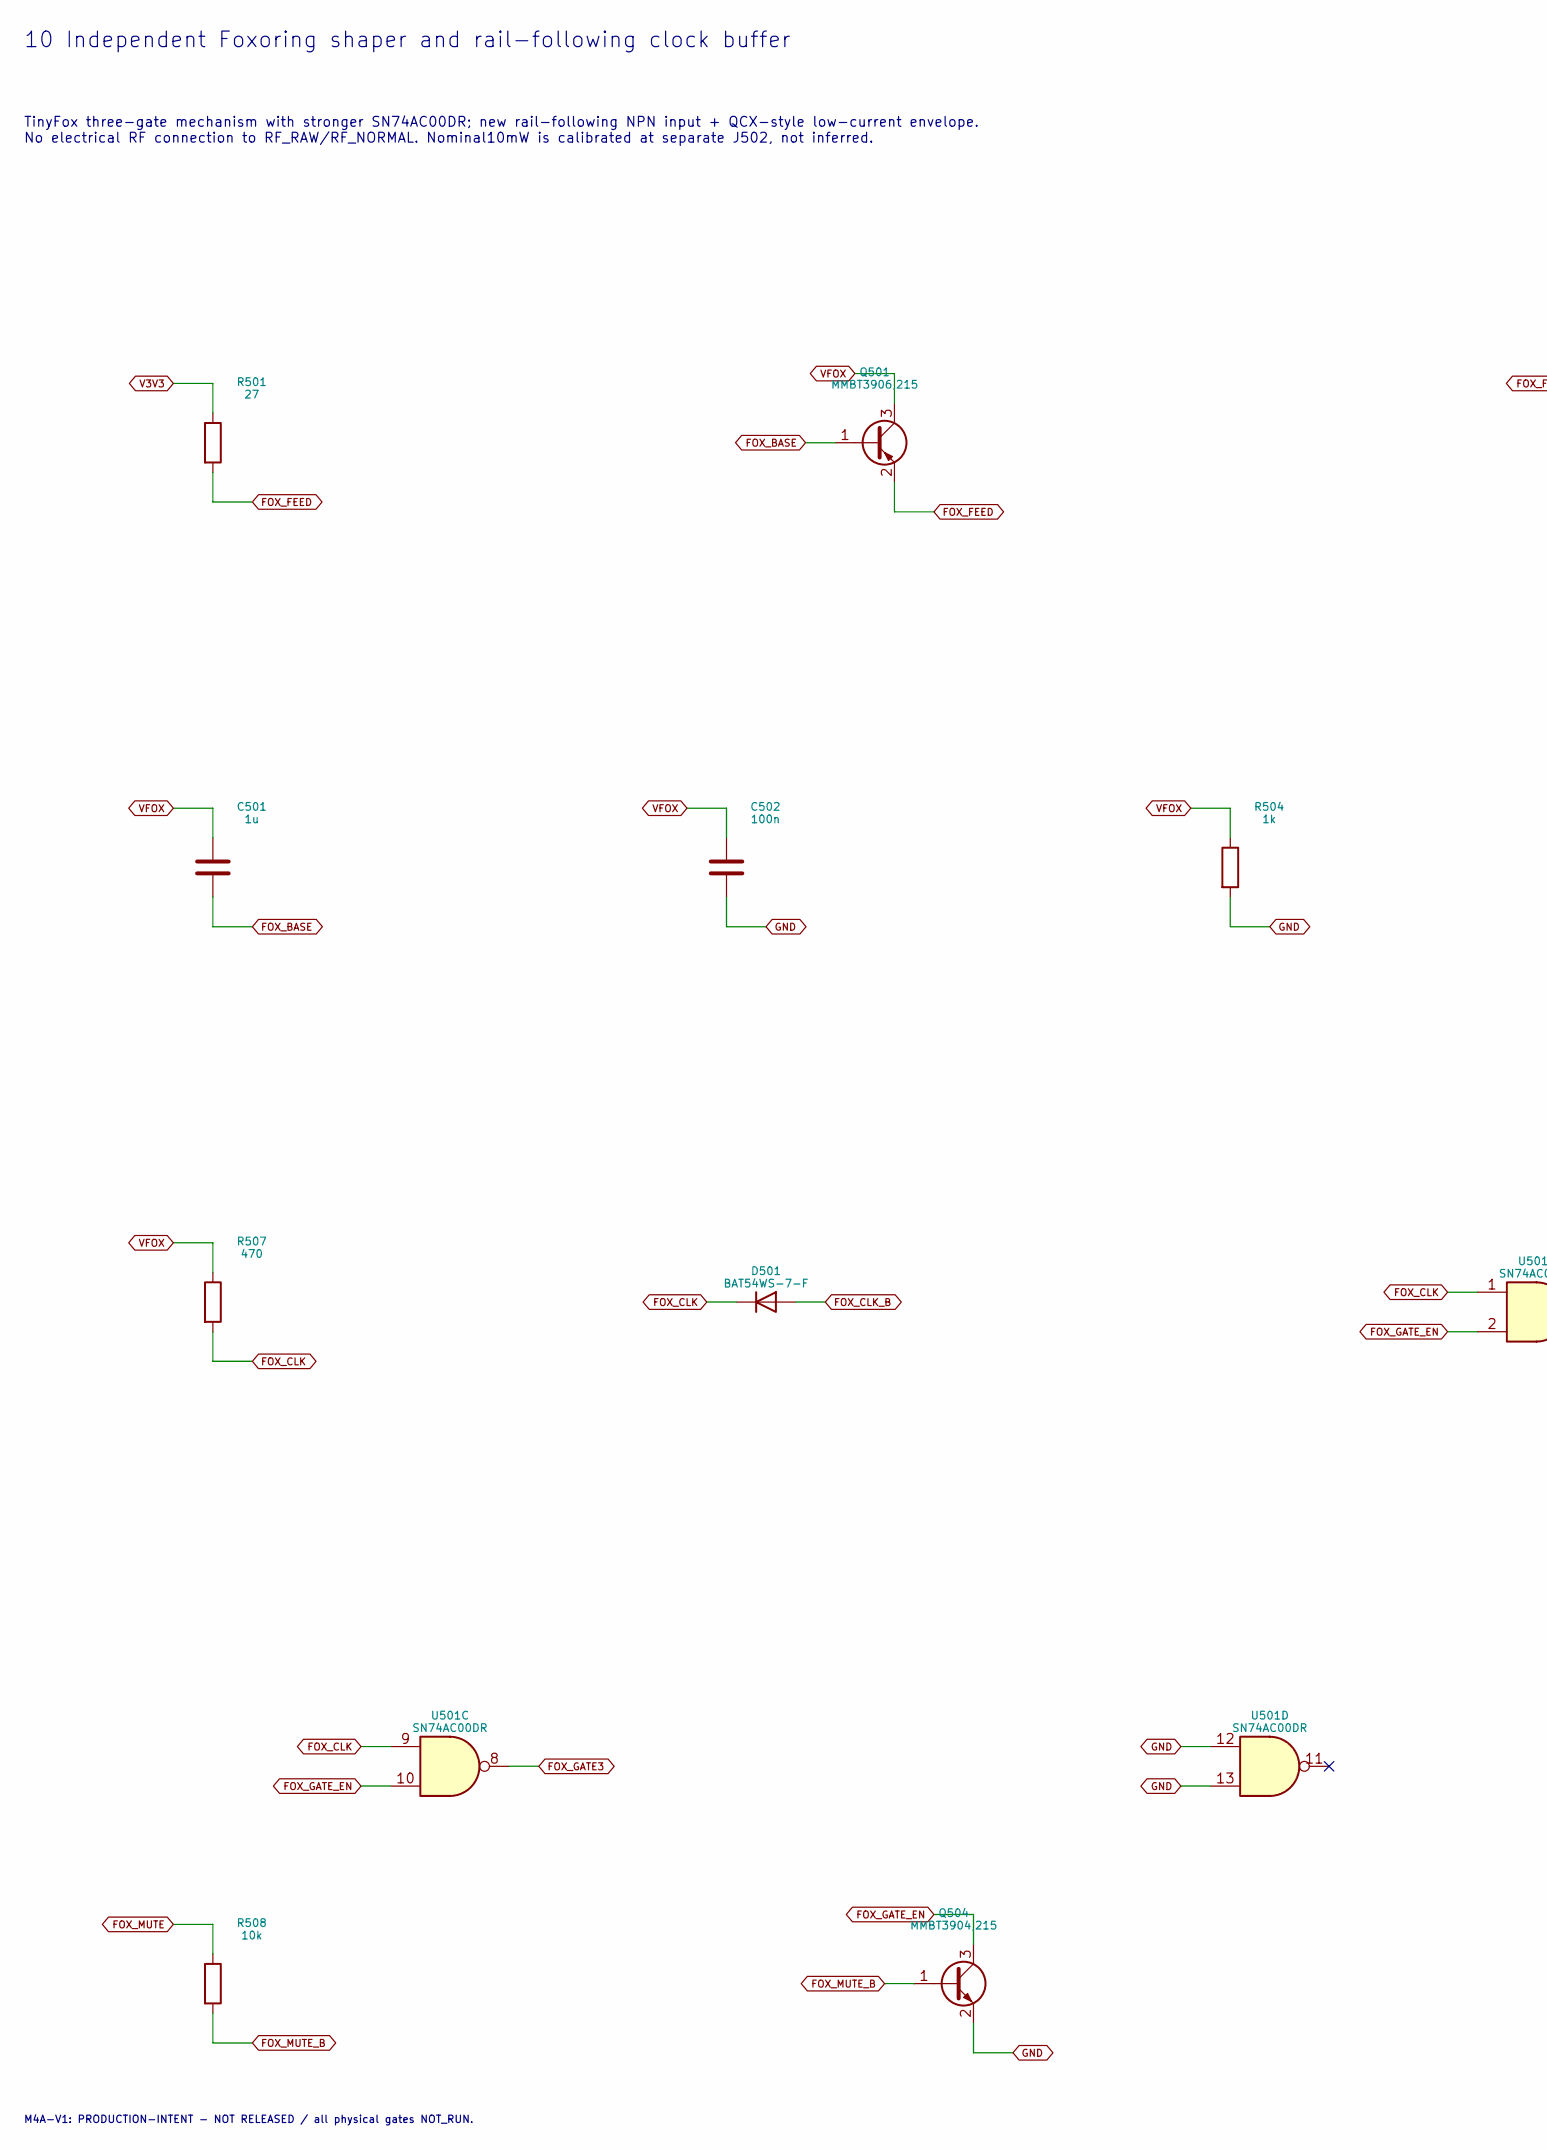
[picture p414: schematic 10_fox_rf.kicad_sch, 10 Independent Foxoring shaper and rail-following clock buf…, part in row 1, column 1]

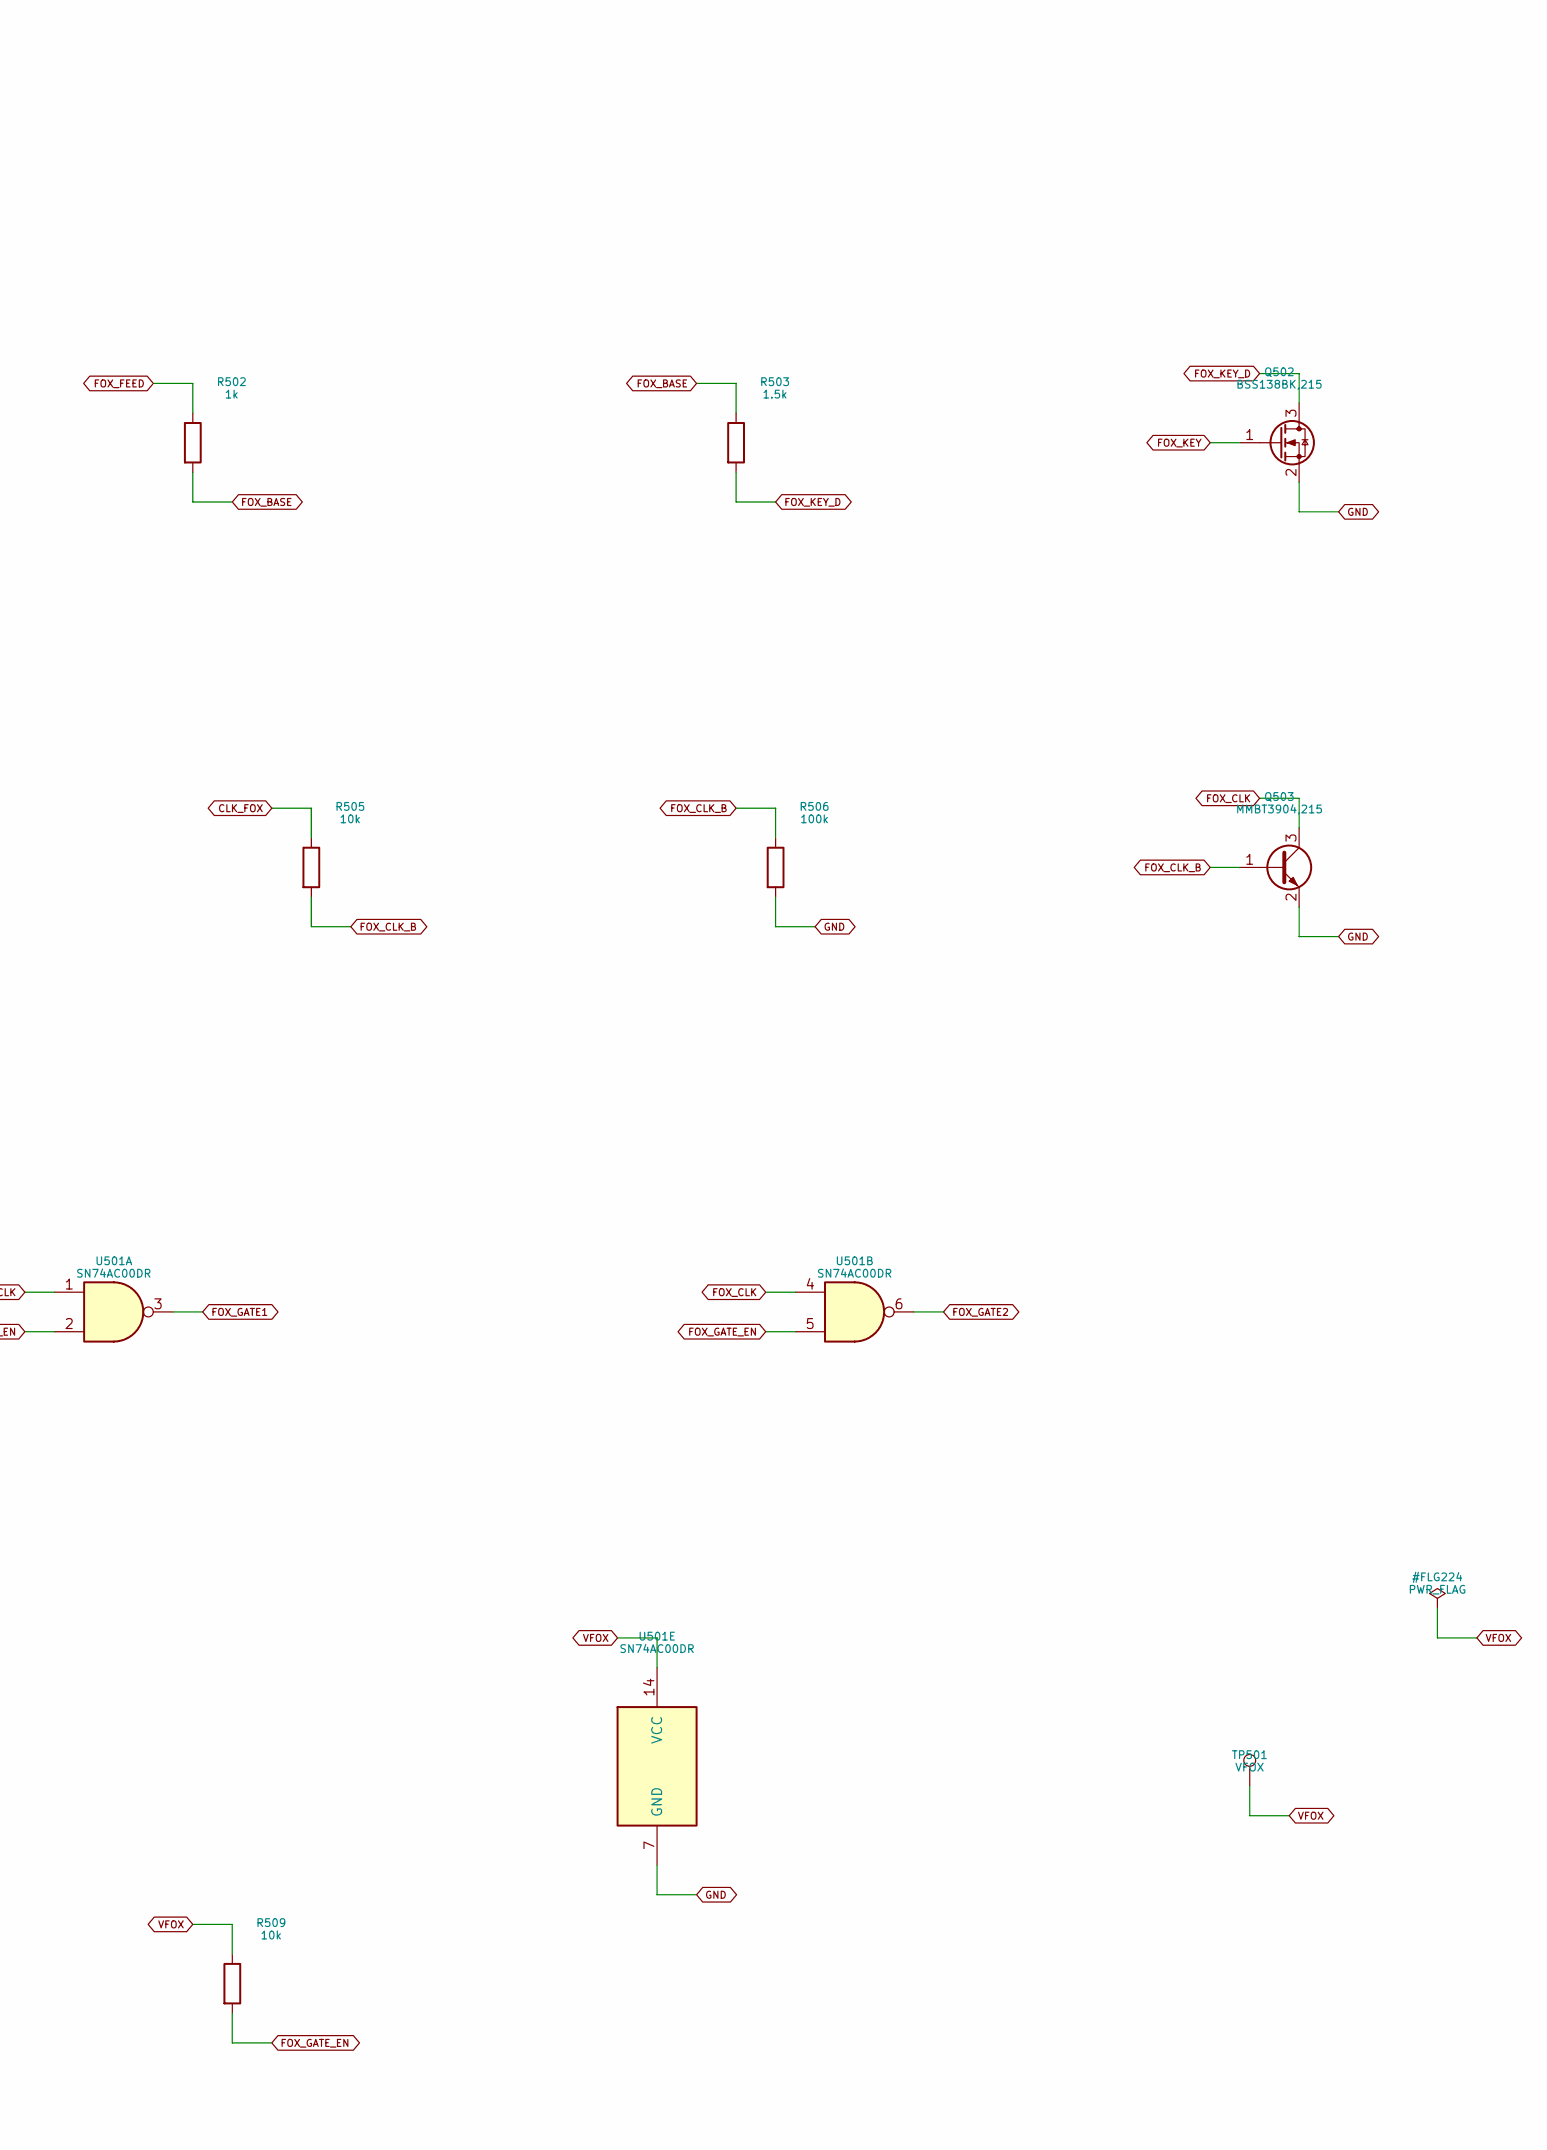
[picture p415: schematic 10_fox_rf.kicad_sch, 10 Independent Foxoring shaper and rail-following clock buf…, part in row 1, column 2]

Parts:
C501: 1u; C_0805_2012Metric; MPN CC0805KKX7R9BB105
C502: 100n; C_0603_1608Metric; MPN CC0603KRX7R8BB104
D501: BAT54WS-7-F; D_SOD-323; MPN BAT54WS-7-F
Q501: MMBT3906,215; SOT-23; MPN MMBT3906,215
Q502: BSS138BK,215; SOT-23; MPN BSS138BK,215
Q503, Q504: MMBT3904,215; SOT-23; MPN MMBT3904,215
R501: 27; R_2512_6332Metric; MPN RC2512FR-0727RL
R502, R504: 1k; R_0603_1608Metric; MPN RC0603FR-071KL
R503: 1.5k; R_0603_1608Metric; MPN RC0603FR-071K5L
R505, R508, R509: 10k; R_0603_1608Metric; MPN RC0603FR-0710KL
R506: 100k; R_0603_1608Metric; MPN RC0603FR-07100KL
R507: 470; R_0603_1608Metric; MPN RC0603FR-07470RL
TP501: VFOX; TestPoint_Pad_D1.0mm; MPN PCB pad / no purchased component
U501: SN74AC00DR; SOIC-14_3.9x8.7mm_P1.27mm; MPN SN74AC00DR

Connections:
CLK_FOX: R505.1; also elsewhere on the board
FOX_BASE: C501.2, Q501.1 (B), R502.2, R503.1
FOX_CLK: D501.1 (K), Q503.3 (C), R507.2, U501.1, U501.4, U501.9
FOX_CLK_B: D501.2 (A), Q503.1 (B), R505.2, R506.1
FOX_FEED: Q501.2 (E), R501.2, R502.1
FOX_GATE1: U501.3; also elsewhere on the board
FOX_GATE2: U501.6; also elsewhere on the board
FOX_GATE3: U501.8; also elsewhere on the board
FOX_GATE_EN: Q504.3 (C), R509.2, U501.2, U501.5, U501.10
FOX_KEY: Q502.1 (G); also elsewhere on the board
FOX_KEY_D: Q502.3 (D), R503.2
FOX_MUTE: R508.1; also elsewhere on the board
FOX_MUTE_B: Q504.1 (B), R508.2
GND: C502.2, Q502.2 (S), Q503.2 (E), Q504.2 (E), R504.2, R506.2, U501.7 (GND), U501.12, U501.13; also elsewhere on the board
V3V3: R501.1; also elsewhere on the board
VFOX: C501.1, C502.1, Q501.3 (C), R504.1, R507.1, R509.1, TP501.1, U501.14 (VCC)

Notes on the sheet:
10 Independent Foxoring shaper and rail-following clock buffer
TinyFox three-gate mechanism with stronger SN74AC00DR; new rail-following NPN input + QCX-style low-current envelope. No electrical RF connection to RF_RAW/RF_NORMAL. Nominal10mW is calibrated at separate J502, not inferred.
M4A-V1: PRODUCTION-INTENT - NOT RELEASED / all physical gates NOT_RUN.

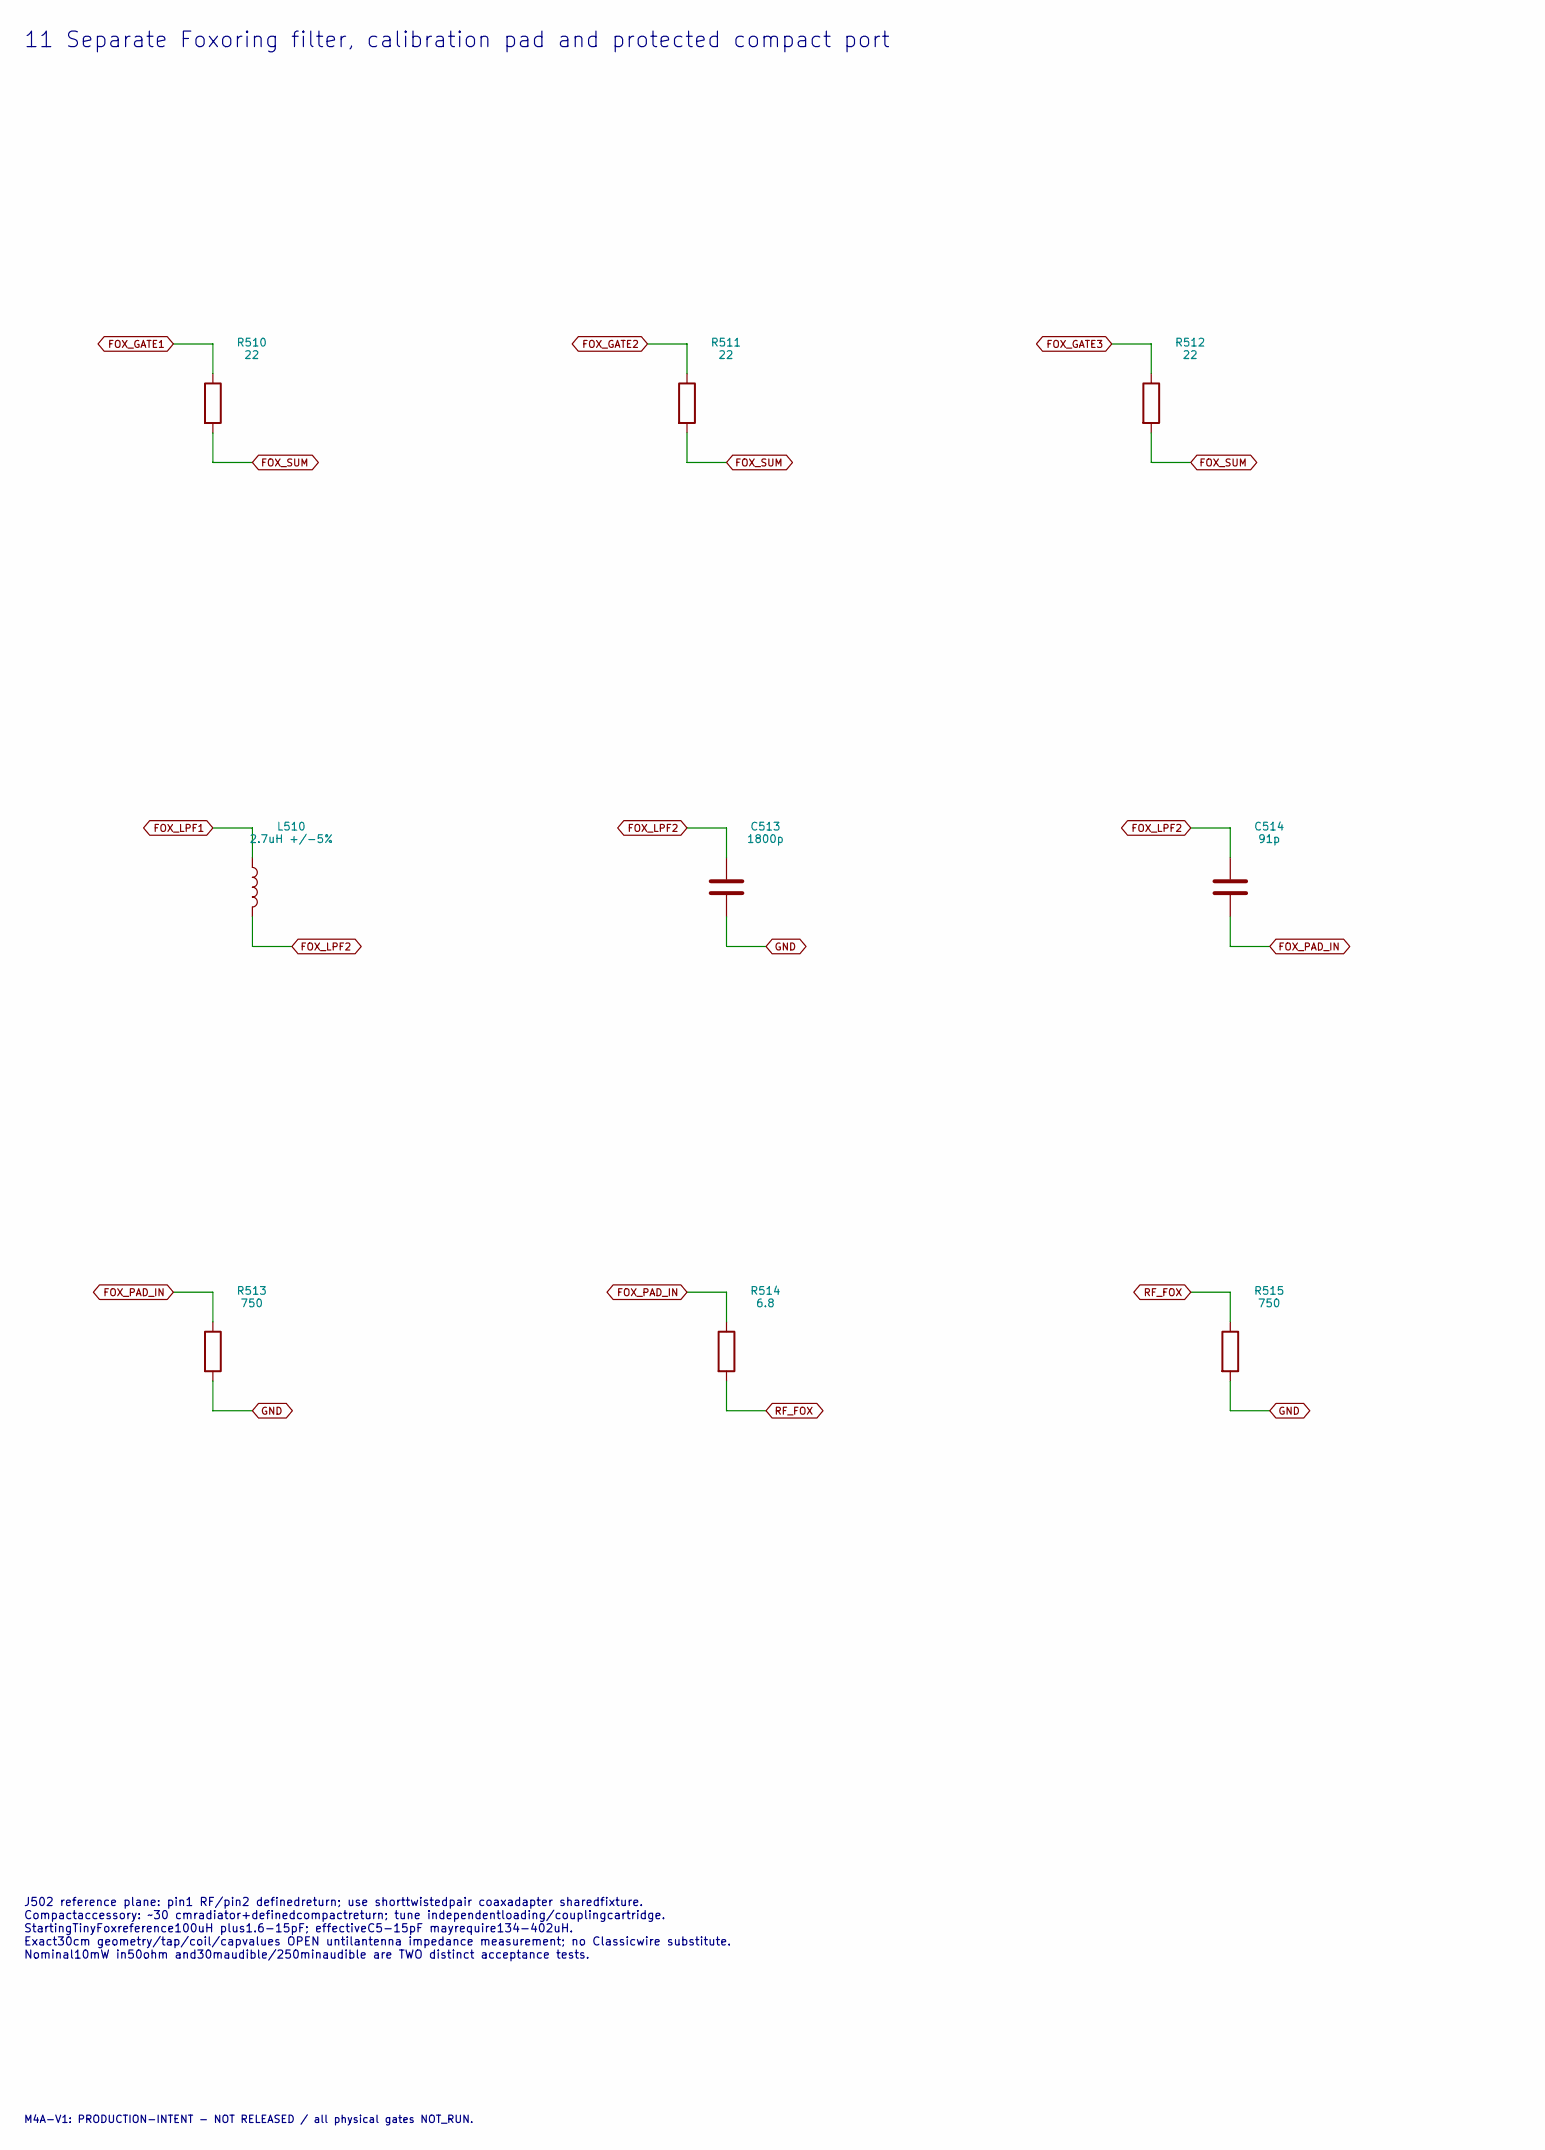
[picture p416: schematic 11_fox_filter.kicad_sch, 11 Separate Foxoring filter, calibration pad and protected …, part in row 1, column 1]

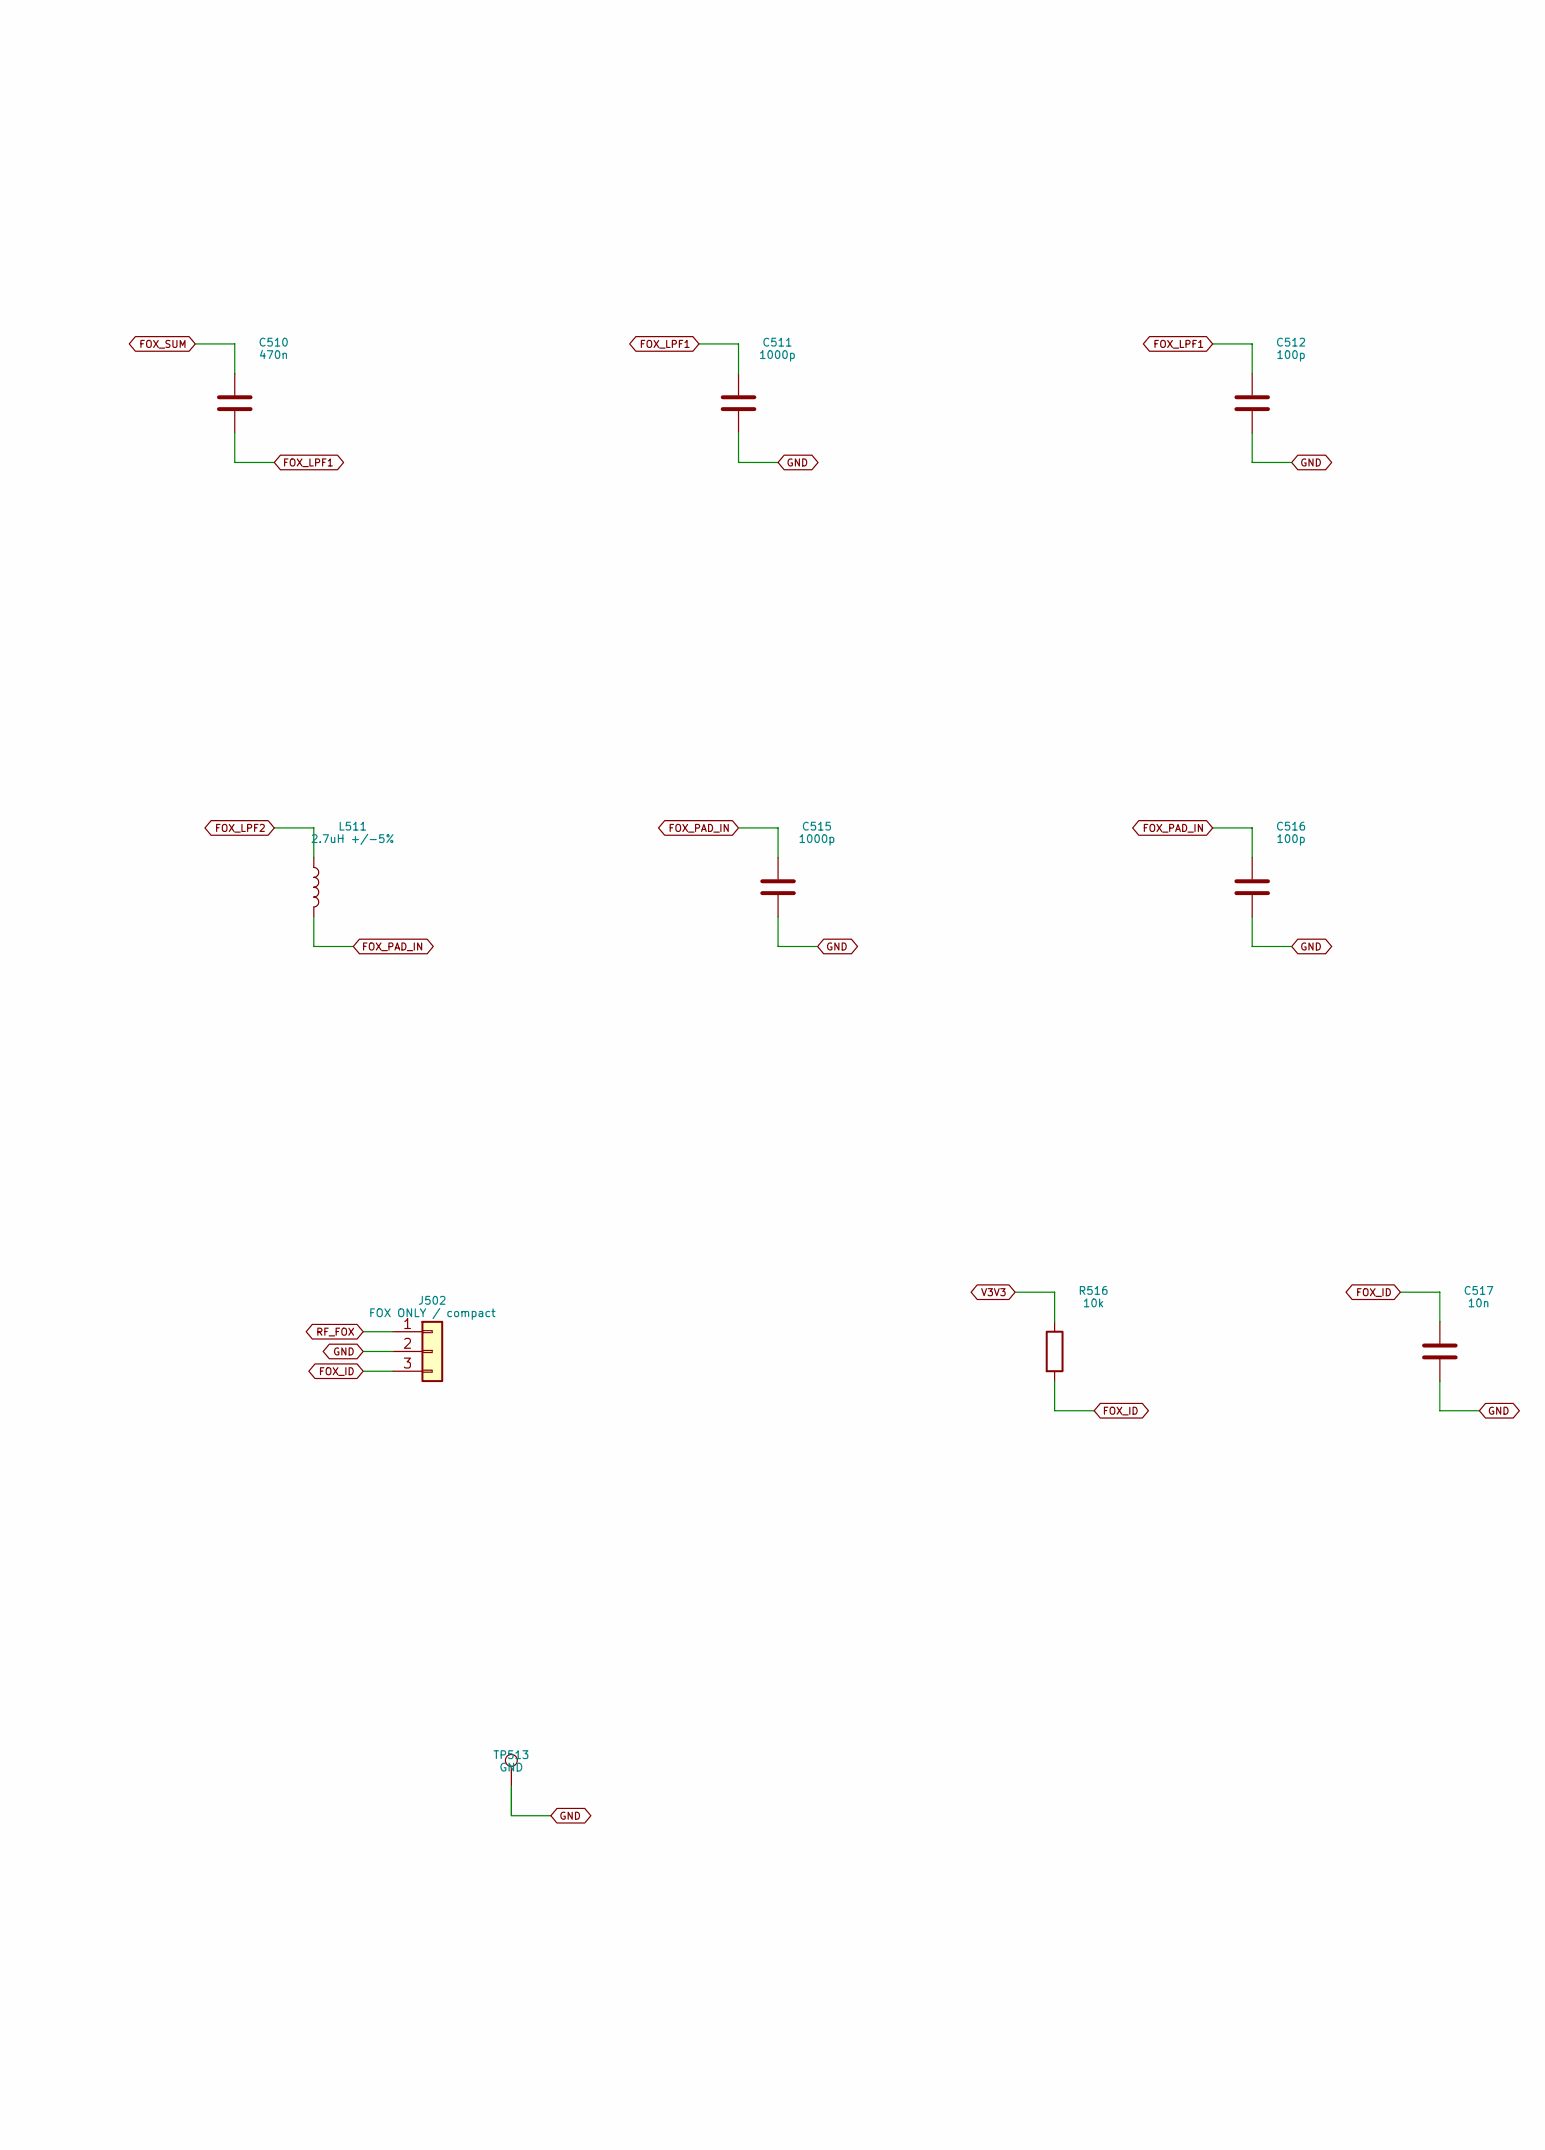
[picture p417: schematic 11_fox_filter.kicad_sch, 11 Separate Foxoring filter, calibration pad and protected …, part in row 1, column 2]

Parts:
C510: 470n; C_1206_3216Metric; MPN C3216X7R2A474K160AB
C511, C515: 1000p; C_0805_2012Metric; MPN C0805C102J1GACTU
C512, C516: 100p; C_0805_2012Metric; MPN C0805C101J1GACTU
C513: 1800p; C_0805_2012Metric; MPN C0805C182J1GACTU
C514: 91p; C_0805_2012Metric; MPN C0805C910J1GACTU
C517: 10n; C_0603_1608Metric; MPN CC0603KRX7R9BB103
J502: FOX ONLY / compact; JST_XH_B3B_StandardPTH; MPN B3B-XH-A(LF)(SN)
L510, L511: 2.7uH +/-5%; 78F_Axial; MPN 78F2R7J-RC
R510, R511, R512: 22; R_0603_1608Metric; MPN RC0603FR-0722RL
R513, R515: 750; R_0603_1608Metric; MPN RC0603FR-07750RL
R514: 6.8; R_0603_1608Metric; MPN RC0603FR-076R8L
R516: 10k; R_0603_1608Metric; MPN RC0603FR-0710KL
TP513: GND; TestPoint_Pad_D1.0mm; MPN PCB pad / no purchased component

Connections:
FOX_GATE1: R510.1; also elsewhere on the board
FOX_GATE2: R511.1; also elsewhere on the board
FOX_GATE3: R512.1; also elsewhere on the board
FOX_ID: C517.1, J502.3, R516.2; also elsewhere on the board
FOX_LPF1: C510.2, C511.1, C512.1, L510.1
FOX_LPF2: C513.1, C514.1, L510.2, L511.1
FOX_PAD_IN: C514.2, C515.1, C516.1, L511.2, R513.1, R514.1
FOX_SUM: C510.1, R510.2, R511.2, R512.2
GND: C511.2, C512.2, C513.2, C515.2, C516.2, C517.2, J502.2, R513.2, R515.2, TP513.1; also elsewhere on the board
RF_FOX: J502.1, R514.2, R515.1
V3V3: R516.1; also elsewhere on the board

Notes on the sheet:
11 Separate Foxoring filter, calibration pad and protected compact port
J502 reference plane: pin1 RF/pin2 definedreturn; use shorttwistedpair coaxadapter sharedfixture. Compactaccessory: ~30 cmradiator+definedcompactreturn; tune independentloading/couplingcartridge. StartingTinyFoxreference100uH plus1.6-15pF; effectiveC5-15pF mayrequire134-402uH. Exact30cm geometry/ta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
M4A-V1: PRODUCTION-INTENT - NOT RELEASED / all physical gates NOT_RUN.
