DD1SB/ARDF-TX/hardware/80m/production/RF80_V1.kicad_pcb

## KiCad design hardware/80m/production/RF80_V1.kicad_pcb (continued)

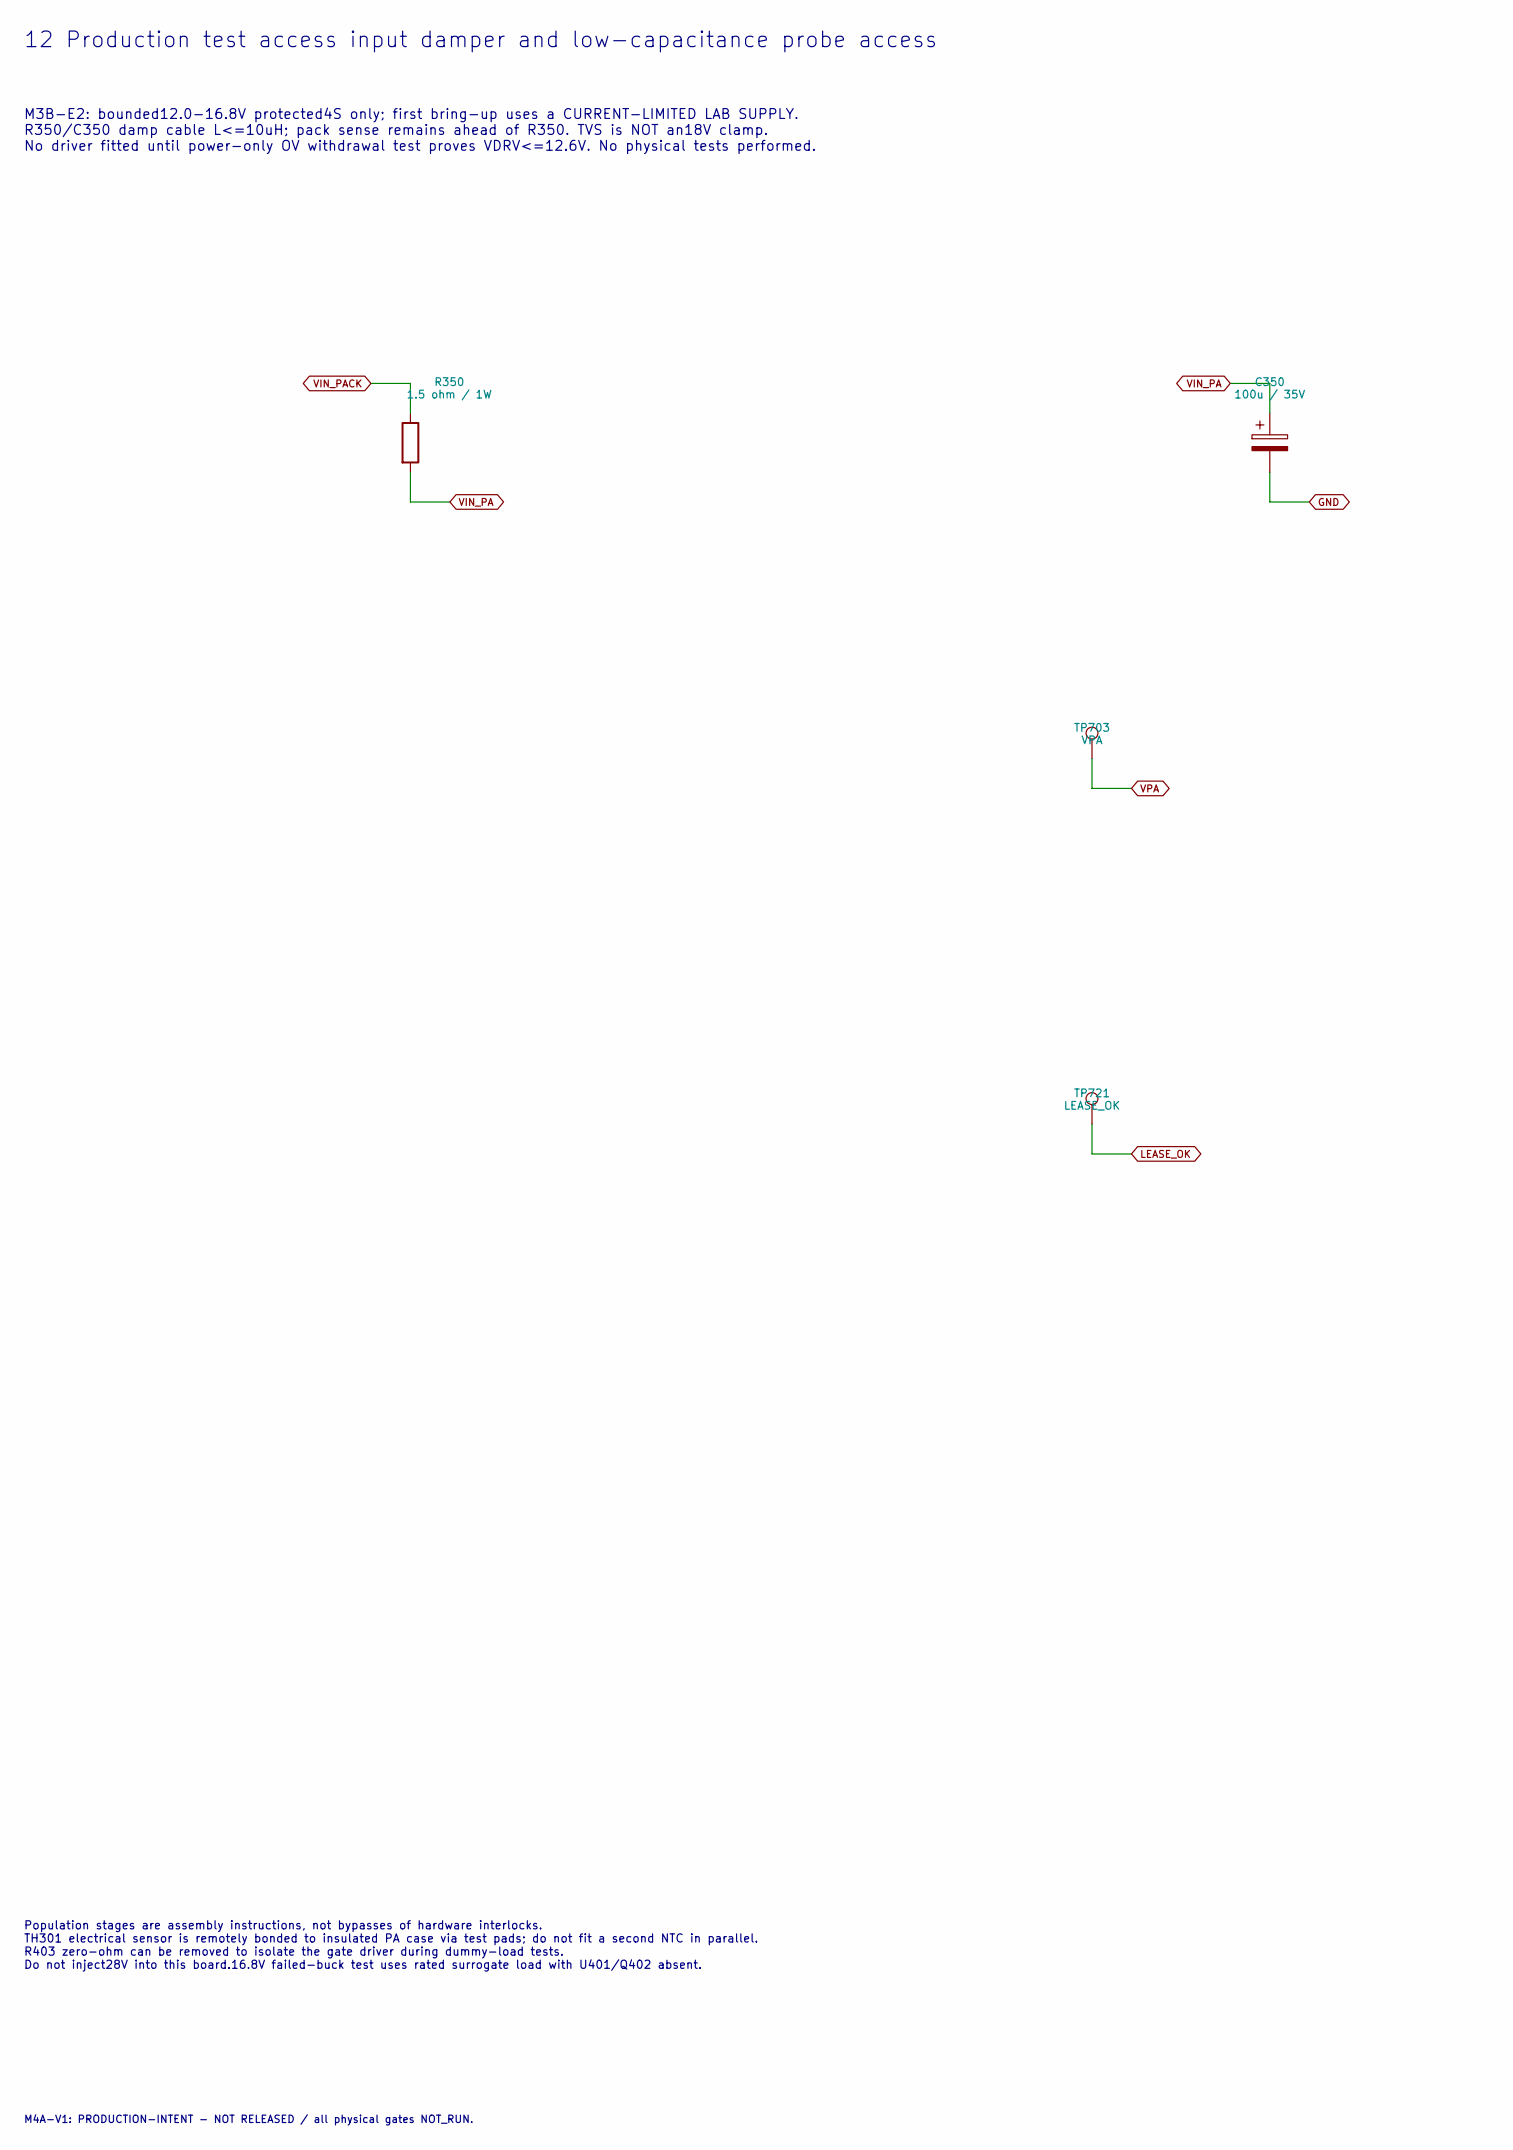
[picture p418: schematic 12_evaluation.kicad_sch, 12 Retained input damper and production test access, part in row 1, column 1]

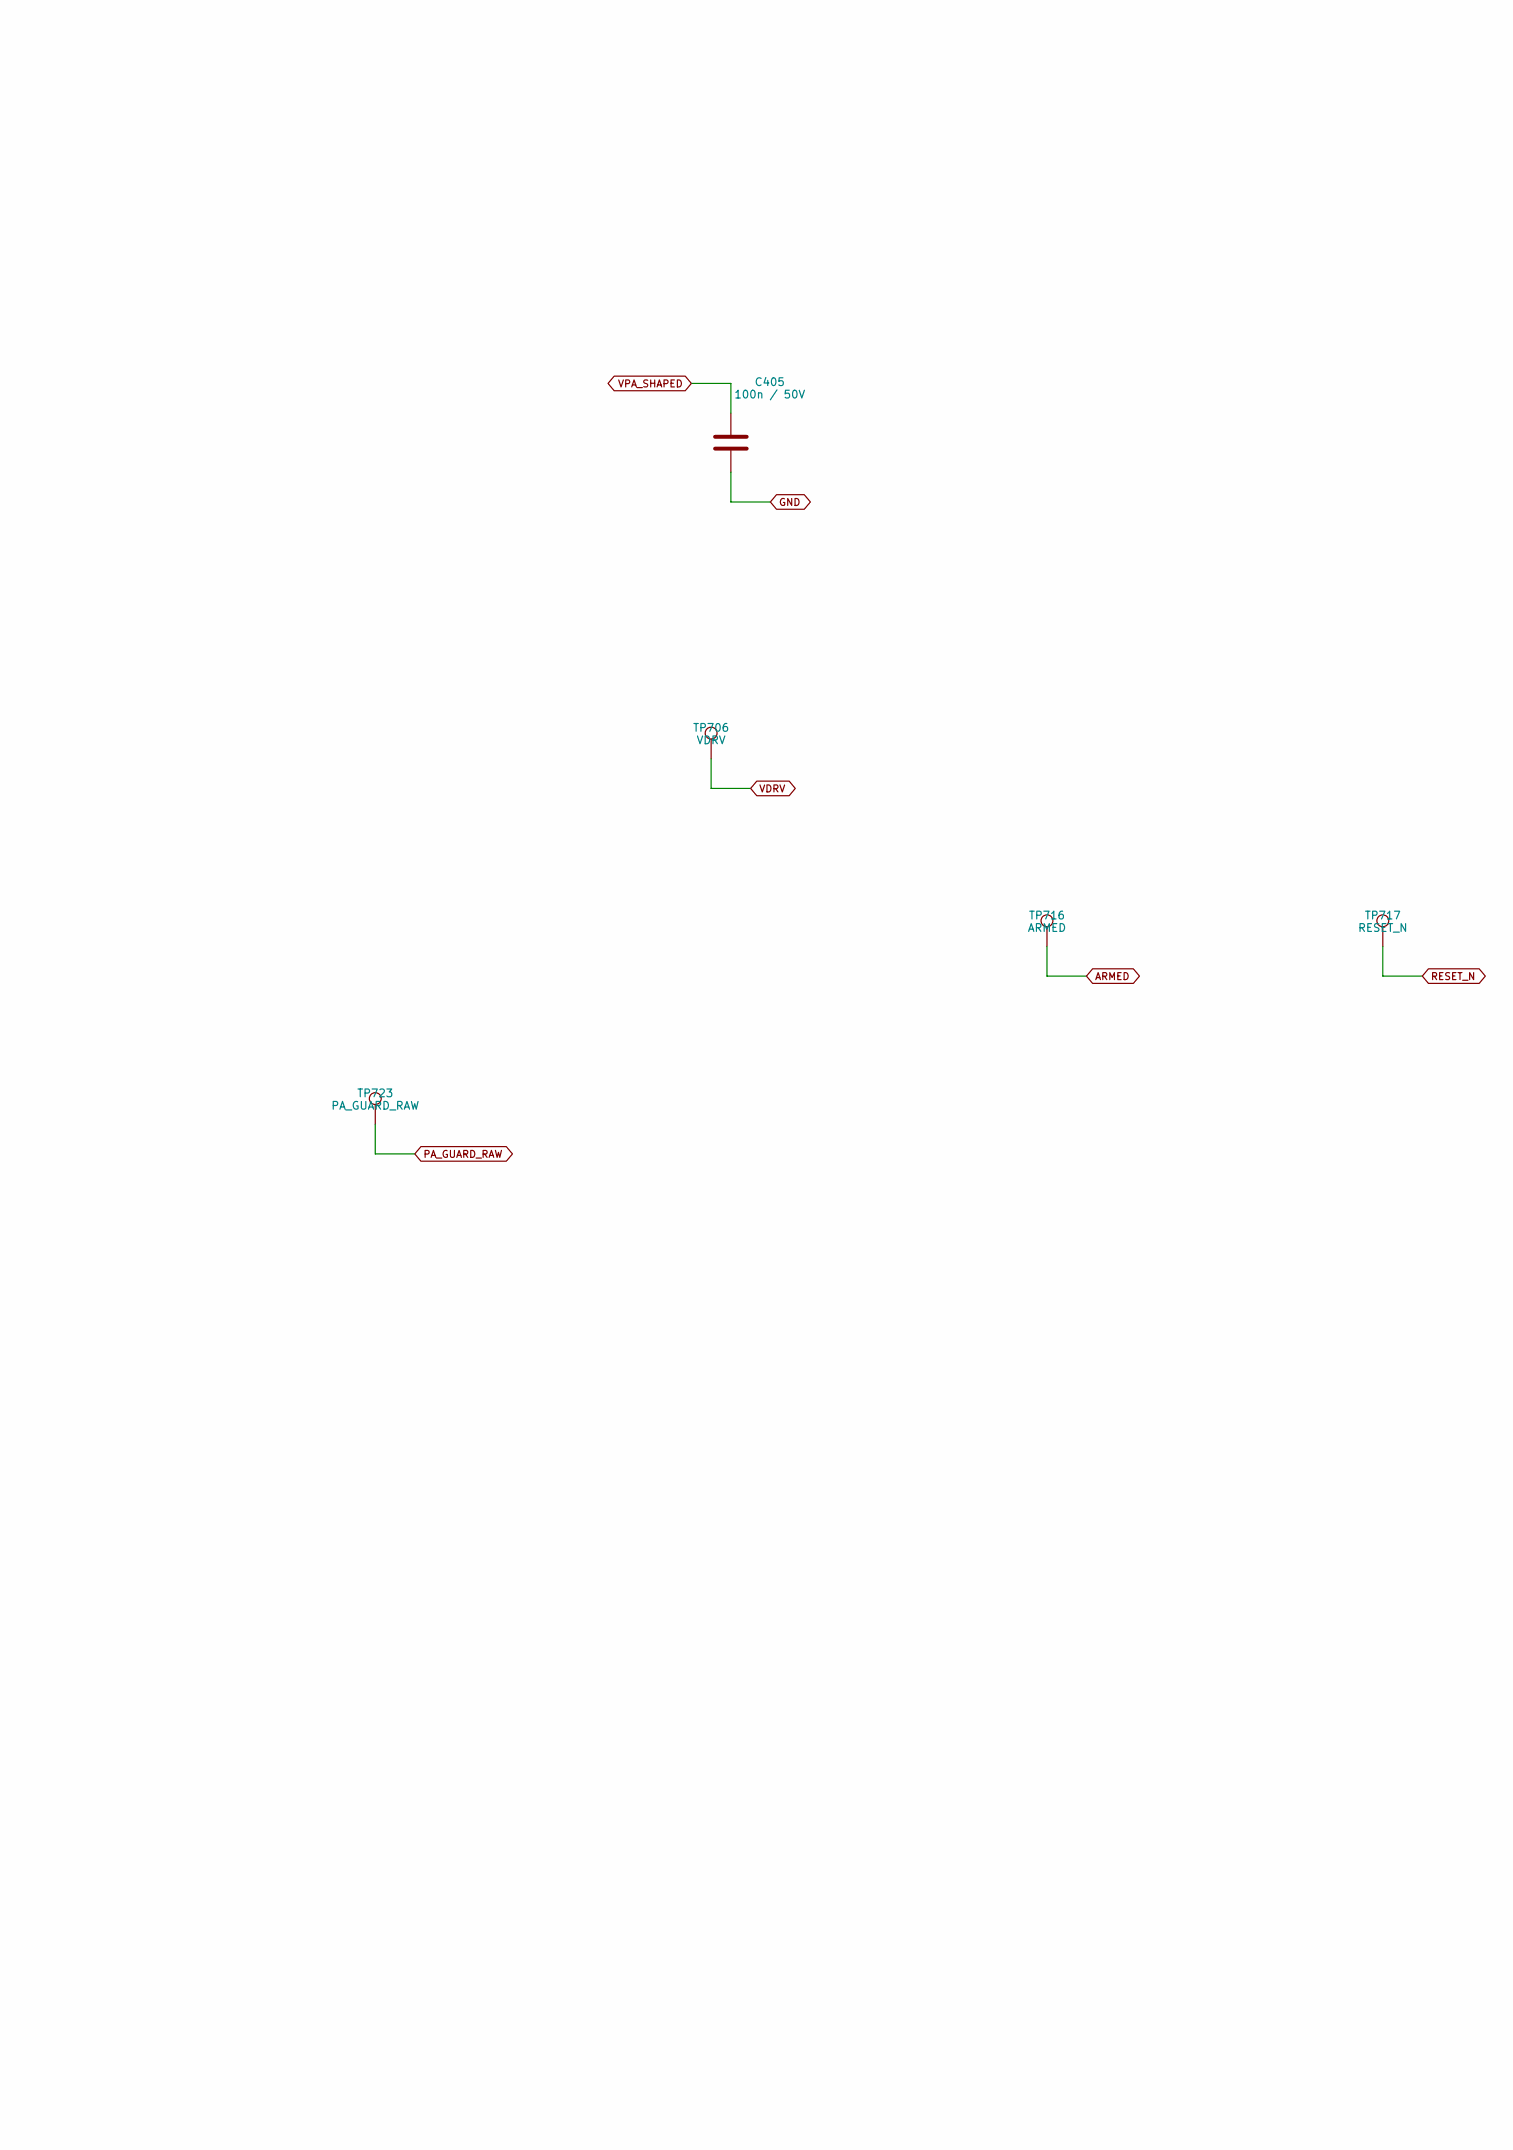
[picture p419: schematic 12_evaluation.kicad_sch, 12 Retained input damper and production test access, part in row 1, column 2]

Parts:
C350: 100u / 35V; CP_Radial_D8.0mm_P3.50mm; MPN EEUFR1V101
C405: 100n / 50V; C_0805_2012Metric; MPN GRM21BR71H104KA01L
R350: 1.5 ohm / 1W; R_2512_6332Metric; MPN CRCW25121R50FKEG
TP703: VPA; Probe_Pad_0p8; MPN PCB copper
TP706: VDRV; Probe_Pad_0p8; MPN PCB copper
TP716: ARMED; Probe_Pad_0p8; MPN PCB copper
TP717: RESET_N; Probe_Pad_0p8; MPN PCB copper
TP721: LEASE_OK; Probe_Pad_0p8; MPN PCB copper
TP723: PA_GUARD_RAW; Probe_Pad_0p8; MPN PCB copper

Connections:
ARMED: TP716.1; also elsewhere on the board
GND: C350.2, C405.2; also elsewhere on the board
LEASE_OK: TP721.1; also elsewhere on the board
PA_GUARD_RAW: TP723.1; also elsewhere on the board
RESET_N: TP717.1; also elsewhere on the board
VDRV: TP706.1; also elsewhere on the board
VIN_PA: C350.1, R350.2; also elsewhere on the board
VIN_PACK: R350.1; also elsewhere on the board
VPA: TP703.1; also elsewhere on the board
VPA_SHAPED: C405.1; also elsewhere on the board

Notes on the sheet:
12 Production test access input damper and low-capacitance probe access
M3B-E2: bounded12.0-16.8V protected4S only; first bring-up uses a CURRENT-LIMITED LAB SUPPLY. R350/C350 damp cable L<=10uH; pack sense remains ahead of R350. TVS is NOT an18V clamp. No driver fitted until power-only OV withdrawal test proves VDRV<=12.6V. No physical tests performed.
Population stages are assembly instructions, not bypasses of hardware interlocks. TH301 electrical sensor is remotely bonded to insulated PA case via test pads; do not fit a second NTC in parallel. R403 zero-ohm can be removed to isolate the gate driver during dummy-load tests. Do not inject28V int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
M4A-V1: PRODUCTION-INTENT - NOT RELEASED / all physical gates NOT_RUN.

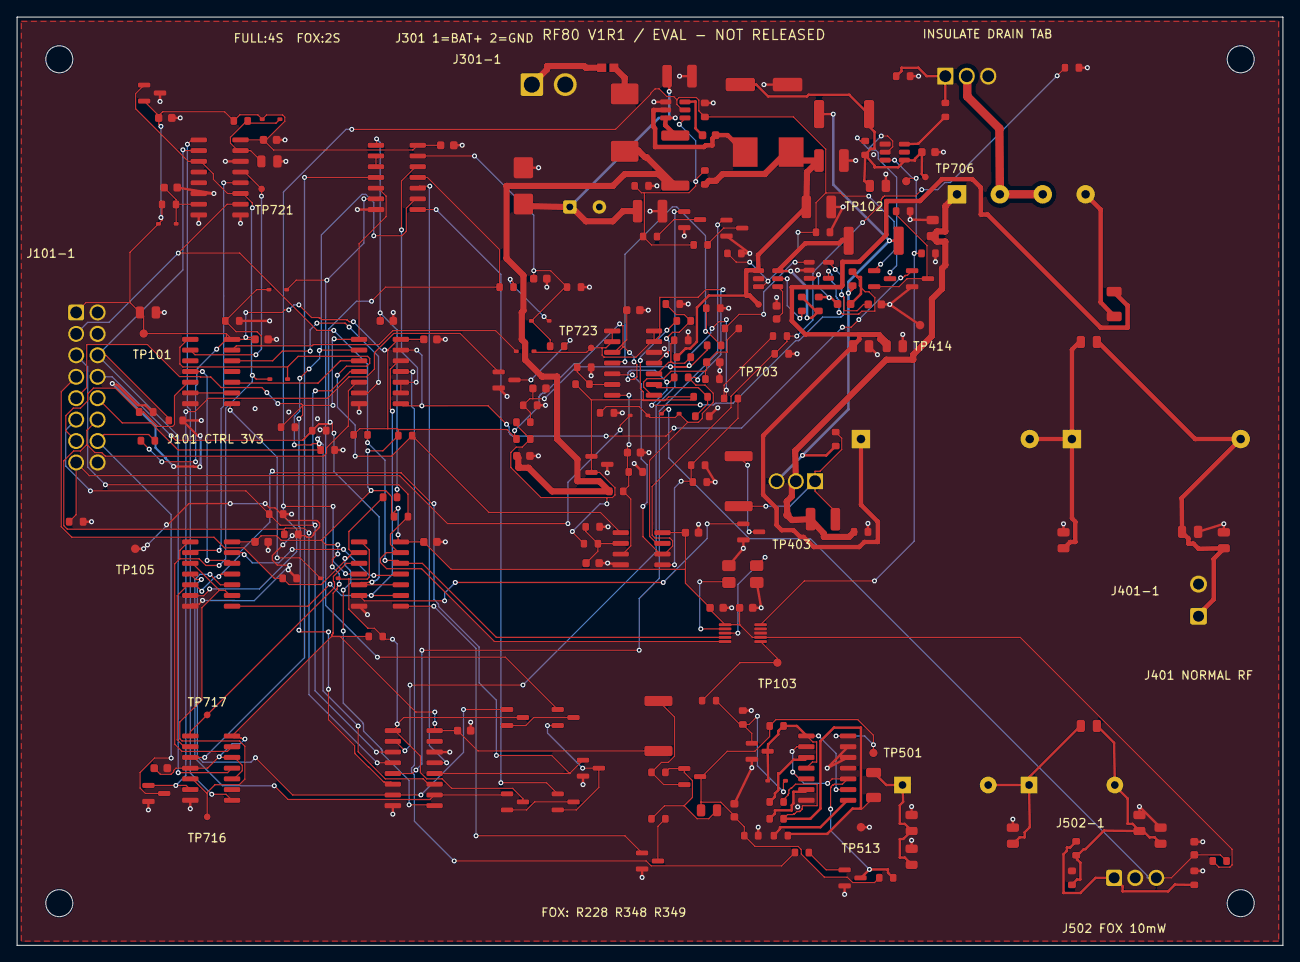
[picture p420: board RF80_V1.kicad_pcb from above]

Board: 2 copper layers, 150.0 x 110.0 mm, 217 parts (0 on the bottom side), 120 nets.

Other parts of the board:
H1, H2, H3, H4: MountingHole_3.2mm_M3
