DD1SB/ARDF-TX/firmware/controller_hw/pins.h

/* M6-C1R1: pack-ID decoder must use frontend revision2. */
#define CTL_HW_REV_M6_C1R1 1
#define CTL_PACK_ID_FRONTEND_REV 2
#define CTL_PACK_ID_PULLUP_OHM 27000
#define CTL_PACK_ID_ADC_ATTEN_MILLI_DB 2500
#define CTL_PACK_ID_ADC_VALID_MAX_MV 930
/* M6-C1 pin contract; physical validation NOT_RUN. No operating firmware. */
#pragma once
#define CTL_BOOT 0
#define CTL_BAT_ADC 1
#define CTL_PACK_ID_ADC 2
#define CTL_MODULE_ID_ADC 4
#define CTL_PA_RAIL_ADC 5
#define CTL_AF_PWM 6
#define CTL_LEVEL_PWM 7
#define CTL_RTC80_SDA 8
#define CTL_RTC80_SCL 9
#define CTL_LORA_NSS 10
#define CTL_SPI_MOSI 11
#define CTL_SPI_SCK 12
#define CTL_SPI_MISO 13
#define CTL_INIT_OK 14
#define CTL_LORA_BUSY 15
#define CTL_LORA_DIO1 16
#define CTL_RF2M_SDA 17
#define CTL_RF2M_SCL 18
#define CTL_USB_DM 19
#define CTL_USB_DP 20
#define CTL_RF2M_FAULT 21
#define CTL_RF80_FAULT 35
#define CTL_START_N 36
#define CTL_USB_VBUS_N 37
#define CTL_SHIFT_LATCH 38
#define CTL_PROGRESS 39
#define CTL_LORA_RESET 40
#define CTL_ARM 41
#define CTL_MUTE_RELEASE 42
#define CTL_UART_TX 43
#define CTL_UART_RX 44
#define CTL_KEY 47
#define CTL_SLOT 48
#define CTL_SHIFT_PA_REQ 0
#define CTL_SHIFT_FOX_REQ 1
#define CTL_SHIFT_PWR0 2
#define CTL_SHIFT_PWR1 3
#define CTL_SHIFT_PACK4_SOFT 4
#define CTL_SHIFT_PATH_TRAIN 5
#define CTL_SHIFT_PROFILE_FULL 6
#define CTL_SHIFT_PREPARE 7
#define CTL_SHIFT_PA_PREPARE 8
#define CTL_SHIFT_POWER80 9
#define CTL_SHIFT_POWER2M 10
#define CTL_SHIFT_BUS80 11
#define CTL_SHIFT_BUS2M 12
#define CTL_SHIFT_LED_ARM 13
#define CTL_SHIFT_LED_FAULT 14
#define CTL_SHIFT_BAND2 15
