DD1SB/ARDF-TX/tools/m5a_r4_models.py

#!/usr/bin/python3
"""Candidate basket accounting and transparent unmeasured RF/energy models."""
import collections,csv,itertools,json,math
from m5a_r4_design import ROOT,DEST,OUT
from m5a_r1_costs import effective,price

def write(name,obj):(OUT/name).write_text(json.dumps(obj,indent=2)+'\n')
def table(name,rows):
    with (OUT/name).open('w')as f:
        w=csv.DictWriter(f,fieldnames=list(rows[0]));w.writeheader();w.writerows(rows)
def purchased(p):return not p['ref'].startswith(('#','TP','TL'))
def costs():
    parts=json.loads((DEST/'RF2M.electrical.json').read_text())['parts'];rows=[];summ=[];delta=[]
    variants={'BOOST2S':{'ALL','NORMAL','BOOST2S'},'BUCK4S':{'ALL','NORMAL','BUCK4S'},'TRAIN_ONLY':{'ALL','TRAIN_ONLY'}}
    core={'source','source_filter','driver','pa','pa_match','bias','output_filter','am','modulator','driver_supply'}
    old=json.loads((DEST/'review/M5A-R3/costs.json').read_text())['summary'];r1=json.loads((DEST/'review/M5A-R1/costs.json').read_text())['summary']
    for var,pops in variants.items():
      ps=[p for p in parts if purchased(p)and p['population']in pops]
      for q in [6,10,20]:
        demand=collections.Counter(effective(p,var)[1]for p in ps);blocks=collections.defaultdict(float);classes=collections.defaultdict(float);cor=0;openamount=0
        for p in ps:
          value,mpn=effective(p,var);need=demand[mpn]*q;order=math.ceil(max(need,p['moq'])/p['multiple'])*p['multiple'];unit=max(price(x,order)for x in ps if effective(x,var)[1]==mpn);allocated=unit*order/need
          cls='CURRENT_INDEXED_OBSERVATION'if p['evidence'].startswith('OBSERVED_2026_10_16')else'HISTORICAL_INDEXED_OBSERVATION'if p['evidence'].startswith('OBSERVED')else'ESTIMATE'
          classes[cls]+=allocated;blocks[p['group']]+=allocated
          if p['group']in core:cor+=allocated
          if p['mpn'].startswith('OPEN')or not p['footprint']:openamount+=allocated
          rows.append(dict(variant=var,fleet=q,ref=p['ref'],value=value,MPN=mpn,footprint=p['footprint']or'OPEN',function=p['group'],quantity_per_board=1,pooled_demand=need,order_quantity=order,MOQ=p['moq'],multiple=p['multiple'],unit_net_EUR=unit,allocated_per_board_net_EUR=allocated,evidence=cls,supplier=p['supplier'],supplier_PN=p['supplier_part_number'],availability=p['availability'],source=p['source_url'],note=p['note']))
        x=dict(variant=var,fleet=q,physical_components=len(ps),IC_count=sum(p['ref'].startswith('U')for p in ps),component_net_EUR=sum(blocks.values()),RF_core_net_EUR=cor,blocks=dict(blocks),price_evidence=dict(classes),amount_with_OPEN_MPN_or_footprint_EUR=openamount,OPEN_MPN=[p['ref']for p in ps if p['mpn'].startswith('OPEN')],OPEN_footprint=[p['ref']for p in ps if not p['footprint']]);summ.append(x)
        o=next(z for z in old if z['variant']==var and z['fleet']==q);r=next(z for z in r1 if z['variant']==var and z['fleet']==q)
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
