DD1SB/ARDF-TX/(commit log)

2026-10-14 Preserve M3A-R0 electrical design and completed research baseline
    [01_source_interface.kicad_sch, 02_interlocks.kicad_sch, 03_safety_logic.kicad_sch, 04_arm_key.kicad_sch, 05_power.kicad_sch, 06_analog_protection.kicad_sch, 06b_thresholds.kicad_sch, 07_current_thermal.kicad_sch]
2026-10-14 Correct RF80 timer polarities and arming logic for M3A-R1 review
    [01_source_interface.kicad_sch, 02_interlocks.kicad_sch, 03_safety_logic.kicad_sch, 04_arm_key.kicad_sch, 05_power.kicad_sch, 06_analog_protection.kicad_sch, 06b_thresholds.kicad_sch, 07_current_thermal.kicad_sch]
2026-10-14 Preserve M3B-E1 evaluation PCB before independent-review corrections
    [01_source_interface.kicad_sch, 02_interlocks.kicad_sch, 03_safety_logic.kicad_sch, 04_arm_key.kicad_sch, 05_power.kicad_sch, 06_analog_protection.kicad_sch, 06b_thresholds.kicad_sch, 07_current_thermal.kicad_sch]
2026-10-14 Correct RF80 M3B-E2 physical pinouts and audit manufacturing readiness
    [01_source_interface.kicad_sch, 02_interlocks.kicad_sch, 03_safety_logic.kicad_sch, 04_arm_key.kicad_sch, 05_power.kicad_sch, 06_analog_protection.kicad_sch, 06b_thresholds.kicad_sch, 07_current_thermal.kicad_sch]
2026-10-15 Preserve RF2M M5A-R0 electrical evaluation candidate
    [01_interface_source.kicad_sch, 02_interlocks.kicad_sch, 02_interlocksb1.kicad_sch, 03_input_power.kicad_sch, 03_input_powerb1.kicad_sch, 04_boost_driver_supply.kicad_sch, 04_boost_driver_supplyb1.kicad_sch, 05_am.kicad_sch]
2026-10-15 Preserve M5A-R1 VHF electrical candidate and review evidence
    [01_interface_source.kicad_sch, 02_interlocks.kicad_sch, 02_interlocksb1.kicad_sch, 03_input_power.kicad_sch, 03_input_powerb1.kicad_sch, 04_boost_driver_supply.kicad_sch, 04_boost_driver_supplyb1.kicad_sch, 05_am.kicad_sch]
2026-10-15 Record M5A-R2 sourcing gate, AM review and reproducible cost/endurance analysis
    [accounting-bridge.csv, endurance.csv, operating-states.csv, rf-budget.csv, sensitivity.csv, source-power-bound.csv]
2026-10-15 Preserve M5A-R3 historical transmitter schematic and review
    [01_interface_source.kicad_sch, 02_interlocks.kicad_sch, 02_interlocksb1.kicad_sch, 03_input_power.kicad_sch, 03_input_powerb1.kicad_sch, 04_boost.kicad_sch, 04_boost_driver_supply.kicad_sch, 05_am.kicad_sch]
2026-10-16 Preserve M5A-R4 economical VHF electrical review baseline
    [01_interface_source.kicad_sch, 02_interlocks.kicad_sch, 02_interlocksb1.kicad_sch, 03_input_power.kicad_sch, 03_input_powerb1.kicad_sch, 04_boost.kicad_sch, 04_boost_driver_supply.kicad_sch, 05_am.kicad_sch]
2026-10-16 Preserve M5B-E1 integrated RF2M evaluation baseline
    [01_interface_source.kicad_sch, 02_interlocks.kicad_sch, 02_interlocksb1.kicad_sch, 03_input_power.kicad_sch, 03_input_powerb1.kicad_sch, 04_boost_driver_supply.kicad_sch, 05_am.kicad_sch, 05_amb1.kicad_sch]
2026-10-16 Correct RF2M copper geometry and prepare M5B-E2 manufacturing review
    [BOM_BOOST2S.csv, BOM_BUCK4S.csv, BOM_TRAIN_ONLY.csv, E1-E2-cost-delta.csv, R4-context-cost-delta.csv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]
2026-10-16 Implement M5B-E3 standard JLCPCB RF2M evaluation board
    Recalculate and implement 1.6 mm / 1 oz RF geometry, power copper, thermal vias, connector holes and manufacturing legend. Preserve electrical functions and population variants. Add native-geometry DFM, regression checks and fresh native/fabrication review archives. CAD milestone only; no manufacturing or operational release.
    [01_interface_source.kicad_sch, 02_interlocks.kicad_sch, 02_interlocksb1.kicad_sch, 03_input_power.kicad_sch, 03_input_powerb1.kicad_sch, 04_boost_driver_supply.kicad_sch, 05_am.kicad_sch, 05_amb1.kicad_sch]
2026-10-16 Implement M5B-E4 thermal candidate with source-joint assembly hold
    [01_interface_source.kicad_sch, 02_interlocks.kicad_sch, 02_interlocksb1.kicad_sch, 03_input_power.kicad_sch, 03_input_powerb1.kicad_sch, 04_boost_driver_supply.kicad_sch, 05_am.kicad_sch, 05_amb1.kicad_sch]
2026-10-17 Implement M5B-E4R1 source-joint prototype candidate
    Replace source mask islands with a controlled open-via hybrid and native-derived local stencil. Preserve standard JLCPCB and RF circuitry. Add assembly qualification, thermal convergence and adverse sensitivities, native DFM/mutation checks and fresh review exports. Conservative 110 C target is missed; 125 C physical gate stays open. No acceptance tag or manufacturing authorization.
    [01_interface_source.kicad_sch, 02_interlocks.kicad_sch, 02_interlocksb1.kicad_sch, 03_input_power.kicad_sch, 03_input_powerb1.kicad_sch, 04_boost_driver_supply.kicad_sch, 05_am.kicad_sch, 05_amb1.kicad_sch]
2026-10-18 M6-C1: implement universal ESP32-S3 controller CAD candidate
    Add the routed 100 x 100 mm standard-JLCPCB controller, isolated RF80/RF2M interfaces, battery-backed RTC, USB recovery and protected dual-voltage logic supply. Include population BOMs, host safety/timing fixtures, native geometry checks and regenerated manufacturing-review artifacts.
    ERC/DRC, connectivity, protocol and DFM checks pass. Optional Silicontra LoRa population remains on identity/landing HOLD. All physical qualification remains NOT_RUN; no acceptance tag or manufacturing release.
    [01_power.kicad_sch, 01_power_2.kicad_sch, 02_USB_reset.kicad_sch, 02_USB_reset_2.kicad_sch, 03_MCU.kicad_sch, 04_RTC_analog.kicad_sch, 05_static_safety.kicad_sch, 05_static_safety_2.kicad_sch]
2026-10-18 M6-C1R1: protect pack identity input and review USB ESD topology
    [01_power.kicad_sch, 01_power_2.kicad_sch, 02_USB_reset.kicad_sch, 02_USB_reset_2.kicad_sch, 03_MCU.kicad_sch, 04_RTC_analog.kicad_sch, 05_static_safety.kicad_sch, 05_static_safety_2.kicad_sch]
2026-10-18 M6-L1: close dual-band Silicontra footprint and RF feed review
    Verify TR4/TR8 supplier aliases and all 22 nominal module terminals; retain
    the common RF signal feed and Hirose lands. Remove a local ground-fill
    intrusion in the full U.FL underbody keep-out and correct the module body
    outline and unused DIO3 label.
    Add explicit no-radio/433/868 assembly records, fail-disabled band/policy
    fixtures, native-geometry mutations, tolerance RF calculations and fresh
    standard-JLCPCB fabrication/assembly exports with source-bound manifests.
    KiCad 10.0.6 ERC/DRC warnings/errors, unrouted and parity all zero. Preserve
    704 pad assertions, 36 RF pins, 4096 enable cases, R1 protection/DFM tests,
    46 host t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
    [09_LoRa.kicad_sch, BOM-FOX_MIN.csv, BOM-FOX_MIN_LORA_433.csv, BOM-FOX_MIN_LORA_868.csv, BOM-FOX_MIN_NO_LORA.csv, BOM-RF2M_FULL.csv, BOM-RF2M_FULL_LORA_433.csv, BOM-RF2M_FULL_LORA_868.csv]
2026-10-18 Preserve M4A-V1 compact RF80 engineering baseline before V1R1 closure
    [01_source_interface.kicad_sch, 02_interlocks.kicad_sch, 03_safety_logic.kicad_sch, 04_arm_key.kicad_sch, 05_power.kicad_sch, 06_analog_protection.kicad_sch, 06b_thresholds.kicad_sch, 07_current_thermal.kicad_sch]
2026-10-18 M4A-V1R1: close RF80 standard-JLCPCB prototype manufacturing candidate
    Correct manufacturer-specific component holes for ordinary PTH tolerances, move small artwork to assembly layers, and add native DFM and fit regressions. Preserve RF nets and routing, generate isolated five-board fabrication datasets, and propose the V1R1-first evaluation transition without changing historical approvals. Physical qualification remains NOT_RUN.
    [01_source_interface.kicad_sch, 02_interlocks.kicad_sch, 03_safety_logic.kicad_sch, 04_arm_key.kicad_sch, 05_power.kicad_sch, 06_analog_protection.kicad_sch, 06b_thresholds.kicad_sch, 07_current_thermal.kicad_sch]
2026-10-19 M5B-E5: compact RF2M to the shared 150x110 mm platform
    [01_interface_source.kicad_sch, 02_interlocks.kicad_sch, 02_interlocksb1.kicad_sch, 03_input_power.kicad_sch, 03_input_powerb1.kicad_sch, 04_boost_driver_supply.kicad_sch, 05_am.kicad_sch, 05_amb1.kicad_sch]
2026-10-19 M7: prepare public ARDF-TX repository, licensing and reproducibility audit
    [RF80-B_Cu.gbl, RF80-B_Mask.gbs, RF80-B_Paste.gbp, RF80-B_Silkscreen.gbo, RF80-Edge_Cuts.gm1, RF80-F_Cu.gtl, RF80-F_Mask.gts, RF80-F_Paste.gtp]
2026-10-20 M6-L2 — External antenna, FoxPro2 interface and GPIO expansion
    [03_MCU.kicad_sch, 11_FoxPro.kicad_sch, 11_FoxPro_2.kicad_sch, 12_GPIO_expansion.kicad_sch, 13_service_straps.kicad_sch, BOM-FOX_MIN__LORA_433__BASE.csv, BOM-FOX_MIN__LORA_433__BOTH.csv, BOM-FOX_MIN__LORA_433__FOXPRO.csv]
2026-10-20 M5B-E6: Power and transient thermal study; common-cooler HOLD
    [BOM_BOOST2S.csv, BOM_BUCK4S.csv, BOM_TRAIN_ONLY.csv, LPF-reference-model.csv, RF-tolerance-sweep.csv, RF2M_BOM.csv, SMA-taper.csv, component-fields.csv]
2026-10-21 M5B-E6R1: Carrier-keyed A2A and thermal-safety feasibility
    [energy-integrals.csv, morse-duty.csv]
2026-10-21 M5B-E6R2: Implement carrier-keyed RF2M and unified cooling
    [01_interface_source.kicad_sch, 02_interlocks.kicad_sch, 02_interlocksb1.kicad_sch, 03_input_power.kicad_sch, 03_input_powerb1.kicad_sch, 04_boost_driver_supply.kicad_sch, 05_am.kicad_sch, 05_amb1.kicad_sch]
2026-10-21 docs: introduce standalone Mini80 in root README
    Describe the independent Mini80 architecture, calculated MINI50/FOX10 profiles, M80-E1 hardware and M80-E2 five-board evaluation gate. Pin source, review and fabrication links to the published Mini80 review commit so the default README works without experimental hardware on main.
    Keep the existing controller, RF80 and RF2M manufacturing statuses and packages unchanged.
